ihsanakyrk/Eski-Versionlar-Ve-Siparisler/Movita_3568_AXV_Router_V3.0/MXVR CM3568 Yolların çekilmemiş hali/yollarının çekilmemiş hali/report.txt

Info: Processing symbol 'C1:Capacitor_SMD:C_0201_0603Metric'.
Info: Processing symbol 'C2:Capacitor_SMD:C_0201_0603Metric'.
Info: Processing symbol 'C3:Capacitor_SMD:C_0201_0603Metric'.
Info: Processing symbol 'C4:Capacitor_SMD:C_0201_0603Metric'.
Info: Processing symbol 'C5:SUPERCAP:CAPPRD508W154D1200H850'.
Info: Processing symbol 'C6:Capacitor_SMD:C_0201_0603Metric'.
Info: Processing symbol 'C7:Capacitor_SMD:C_0201_0603Metric'.
Info: Processing symbol 'C8:Capacitor_SMD:C_0402_1005Metric'.
Info: Processing symbol 'C9:Capacitor_SMD:C_0402_1005Metric'.
Info: Processing symbol 'C10:Capacitor_SMD:C_0201_0603Metric'.
Info: Processing symbol 'C11:Capacitor_SMD:C_0402_1005Metric'.
Info: Processing symbol 'C12:Capacitor_SMD:C_0201_0603Metric'.
Info: Processing symbol 'C13:Capacitor_SMD:C_0402_1005Metric'.
Info: Processing symbol 'C14:Capacitor_SMD:C_0402_1005Metric'.
Info: Processing symbol 'C15:Capacitor_SMD:C_0402_1005Metric'.
Info: Processing symbol 'C16:Capacitor_SMD:C_0402_1005Metric'.
Info: Processing symbol 'C17:Capacitor_SMD:C_0402_1005Metric'.
Info: Processing symbol 'C18:Capacitor_SMD:C_0402_1005Metric'.
Info: Processing symbol 'C19:Capacitor_SMD:C_0402_1005Metric'.
Info: Processing symbol 'C20:Capacitor_SMD:C_0402_1005Metric'.
Info: Processing symbol 'C21:Capacitor_SMD:C_0402_1005Metric'.
Info: Processing symbol 'C22:Capacitor_SMD:C_0402_1005Metric'.
Info: Processing symbol 'C23:Capacitor_SMD:C_0402_1005Metric'.
Info: Processing symbol 'C24:Capacitor_SMD:C_0402_1005Metric'.
Info: Processing symbol 'C25:Capacitor_SMD:C_0402_1005Metric'.
Info: Processing symbol 'C26:Capacitor_SMD:C_0402_1005Metric'.
Info: Processing symbol 'C27:Capacitor_SMD:C_0402_1005Metric'.
Info: Processing symbol 'C28:Capacitor_SMD:C_Elec_10x10.2'.
Info: Processing symbol 'C29:Capacitor_SMD:C_0603_1608Metric'.
Info: Processing symbol 'C30:Capacitor_SMD:C_0603_1608Metric'.
Info: Processing symbol 'C31:Capacitor_SMD:C_0201_0603Metric'.
Info: Processing symbol 'C32:Capacitor_SMD:C_Elec_8x10.2'.
Info: Processing symbol 'C35:Capacitor_SMD:C_0603_1608Metric'.
Info: Processing symbol 'C36:Capacitor_SMD:C_0603_1608Metric'.
Info: Processing symbol 'C37:Capacitor_SMD:C_0603_1608Metric'.
Info: Processing symbol 'C38:Capacitor_SMD:C_0603_1608Metric'.
Info: Processing symbol 'C39:Capacitor_SMD:C_0402_1005Metric'.
Info: Processing symbol 'C40:Capacitor_SMD:C_0603_1608Metric'.
Info: Processing symbol 'C41:Capacitor_SMD:C_0603_1608Metric'.
Info: Processing symbol 'C42:Capacitor_SMD:C_0603_1608Metric'.
Info: Processing symbol 'C43:Capacitor_SMD:C_0603_1608Metric'.
Info: Processing symbol 'C44:Capacitor_SMD:C_0603_1608Metric'.
Info: Processing symbol 'C45:Capacitor_SMD:C_0603_1608Metric'.
Info: Processing symbol 'C46:Capacitor_SMD:C_0603_1608Metric'.
Info: Processing symbol 'C47:Capacitor_SMD:C_0603_1608Metric'.
Info: Processing symbol 'C48:Capacitor_SMD:C_0603_1608Metric'.
Info: Processing symbol 'C49:Capacitor_SMD:C_0603_1608Metric'.
Info: Processing symbol 'C50:Capacitor_SMD:C_0603_1608Metric'.
Info: Processing symbol 'C51:Capacitor_SMD:C_0603_1608Metric'.
Info: Processing symbol 'C52:Capacitor_SMD:C_0603_1608Metric'.
Info: Processing symbol 'C53:Capacitor_SMD:C_0402_1005Metric'.
Info: Processing symbol 'C54:Capacitor_SMD:C_0603_1608Metric'.
Info: Processing symbol 'C55:Capacitor_SMD:C_0603_1608Metric'.
Info: Processing symbol 'C56:Capacitor_SMD:C_0603_1608Metric'.
Info: Processing symbol 'C57:Capacitor_SMD:C_0603_1608Metric'.
Info: Processing symbol 'C58:Capacitor_SMD:C_0603_1608Metric'.
Info: Processing symbol 'C59:Capacitor_SMD:C_0603_1608Metric'.
Info: Processing symbol 'C60:Capacitor_SMD:C_0603_1608Metric'.
Info: Processing symbol 'C61:Capacitor_SMD:C_0402_1005Metric'.
Info: Processing symbol 'C62:Capacitor_SMD:C_0402_1005Metric'.
Info: Processing symbol 'C63:Capacitor_SMD:C_0402_1005Metric'.
Info: Processing symbol 'C64:Capacitor_SMD:C_0402_1005Metric'.
Info: Processing symbol 'C65:Capacitor_SMD:C_0402_1005Metric'.
Info: Processing symbol 'C66:Capacitor_SMD:C_0402_1005Metric'.
Info: Processing symbol 'C67:Capacitor_SMD:C_0402_1005Metric'.
Info: Processing symbol 'C68:Capacitor_SMD:C_0402_1005Metric'.
Info: Processing symbol 'C69:Capacitor_SMD:C_0402_1005Metric'.
Info: Processing symbol 'C70:Capacitor_SMD:C_0402_1005Metric'.
Info: Processing symbol 'C71:Capacitor_SMD:C_0402_1005Metric'.
Info: Processing symbol 'C72:Capacitor_SMD:C_0402_1005Metric'.
Info: Processing symbol 'C73:Capacitor_SMD:C_0402_1005Metric'.
Info: Processing symbol 'C74:Capacitor_SMD:C_0603_1608Metric'.
Info: Processing symbol 'C75:Capacitor_SMD:C_0603_1608Metric'.
Info: Processing symbol 'C76:Capacitor_SMD:C_0402_1005Metric'.
Info: Processing symbol 'C77:Capacitor_SMD:C_0603_1608Metric'.
Info: Processing symbol 'C78:Capacitor_SMD:C_0402_1005Metric'.
Info: Processing symbol 'C79:Capacitor_SMD:C_0402_1005Metric'.
Info: Processing symbol 'C80:Capacitor_SMD:C_0402_1005Metric'.
Info: Processing symbol 'C81:Capacitor_SMD:C_0402_1005Metric'.
Info: Processing symbol 'C82:Capacitor_SMD:C_Elec_8x10.2'.
Info: Processing symbol 'C83:Capacitor_SMD:C_Elec_10x10.2'.
Info: Processing symbol 'C84:Capacitor_SMD:C_0603_1608Metric'.
Info: Processing symbol 'C85:Capacitor_SMD:C_0402_1005Metric'.
Info: Processing symbol 'C86:Capacitor_SMD:C_0402_1005Metric'.
Info: Processing symbol 'C87:Capacitor_SMD:C_0402_1005Metric'.
Info: Processing symbol 'C88:Capacitor_SMD:C_0402_1005Metric'.
Info: Processing symbol 'C89:Capacitor_SMD:C_0402_1005Metric'.
Info: Processing symbol 'C90:Capacitor_SMD:C_0402_1005Metric'.
Info: Processing symbol 'C91:Capacitor_SMD:C_0402_1005Metric'.
Info: Processing symbol 'C92:S102K33Y5PP63K5R:S102K33Y5PP63K5R'.
Info: Processing symbol 'Y4:Crystal:Crystal_SMD_3225-4Pin_3.2x2.5mm'.
Info: Processing symbol 'C93:S102K33Y5PP63K5R:S102K33Y5PP63K5R'.
Info: Processing symbol 'Y2:Crystal:Crystal_SMD_3225-4Pin_3.2x2.5mm'.
Info: Processing symbol 'C94:Capacitor_SMD:C_0603_1608Metric'.
Info: Processing symbol 'C95:Capacitor_SMD:C_0603_1608Metric'.
Info: Processing symbol 'C96:Capacitor_SMD:C_0603_1608Metric'.
Info: Processing symbol 'C97:Capacitor_SMD:C_0603_1608Metric'.
Info: Processing symbol 'C98:Capacitor_SMD:C_0603_1608Metric'.
Info: Processing symbol 'C99:Capacitor_SMD:C_0603_1608Metric'.
Info: Processing symbol 'C100:Capacitor_SMD:C_0603_1608Metric'.
Info: Processing symbol 'C101:Capacitor_SMD:C_0603_1608Metric'.
Info: Processing symbol 'C102:Capacitor_SMD:C_0603_1608Metric'.
Info: Processing symbol 'C103:Capacitor_SMD:C_0603_1608Metric'.
Info: Processing symbol 'C104:Capacitor_SMD:C_0603_1608Metric'.
Info: Processing symbol 'C105:Capacitor_SMD:C_0603_1608Metric'.
Info: Processing symbol 'C106:Capacitor_SMD:C_0603_1608Metric'.
Info: Processing symbol 'C107:Capacitor_SMD:C_0603_1608Metric'.
Info: Processing symbol 'C108:Capacitor_SMD:C_0603_1608Metric'.
Info: Processing symbol 'C109:Capacitor_SMD:C_0603_1608Metric'.
Info: Processing symbol 'C110:Capacitor_SMD:C_0603_1608Metric'.
Info: Processing symbol 'C111:Capacitor_SMD:C_0603_1608Metric'.
Info: Processing symbol 'C112:Capacitor_SMD:C_0402_1005Metric'.
Info: Processing symbol 'C113:Capacitor_SMD:C_0402_1005Metric'.
Info: Processing symbol 'C114:Capacitor_SMD:C_0402_1005Metric'.
Info: Processing symbol 'C115:Capacitor_SMD:C_0402_1005Metric'.
Info: Processing symbol 'C116:Capacitor_SMD:C_0603_1608Metric'.
Info: Processing symbol 'C117:Capacitor_SMD:C_0603_1608Metric'.
Info: Processing symbol 'C118:Capacitor_SMD:C_0603_1608Metric'.
Info: Processing symbol 'C119:Capacitor_SMD:C_0603_1608Metric'.
Info: Processing symbol 'C120:Capacitor_SMD:C_0603_1608Metric'.
Info: Processing symbol 'C121:Capacitor_SMD:C_0603_1608Metric'.
Info: Processing symbol 'C122:Capacitor_SMD:C_0603_1608Metric'.
Info: Processing symbol 'C123:Capacitor_SMD:C_0603_1608Metric'.
Info: Processing symbol 'C124:Capacitor_SMD:C_0603_1608Metric'.
Info: Processing symbol 'C125:Capacitor_SMD:C_0603_1608Metric'.
Info: Processing symbol 'C126:Capacitor_SMD:C_0603_1608Metric'.
Info: Processing symbol 'C127:Capacitor_SMD:C_0603_1608Metric'.
Info: Processing symbol 'C128:Capacitor_SMD:C_0402_1005Metric'.
Info: Processing symbol 'C129:Capacitor_SMD:C_0402_1005Metric'.
Info: Processing symbol 'C130:Capacitor_SMD:C_0402_1005Metric'.
Info: Processing symbol 'C131:Capacitor_SMD:C_0402_1005Metric'.
Info: Processing symbol 'C132:Capacitor_SMD:C_0402_1005Metric'.
Info: Processing symbol 'C133:Capacitor_SMD:C_0402_1005Metric'.
Info: Processing symbol 'C134:Capacitor_SMD:C_0402_1005Metric'.
Info: Processing symbol 'C135:Capacitor_SMD:C_0402_1005Metric'.
Info: Processing symbol 'C136:Capacitor_SMD:C_0402_1005Metric'.
Info: Processing symbol 'C137:Capacitor_SMD:C_0402_1005Metric'.
Info: Processing symbol 'C138:Capacitor_SMD:C_0402_1005Metric'.
Info: Processing symbol 'C139:Capacitor_SMD:C_0402_1005Metric'.
Info: Processing symbol 'C140:Capacitor_SMD:C_0402_1005Metric'.
Info: Processing symbol 'C141:Capacitor_SMD:C_0402_1005Metric'.
Info: Processing symbol 'C142:Capacitor_SMD:C_0402_1005Metric'.
Info: Processing symbol 'C143:Capacitor_SMD:C_0603_1608Metric'.
Info: Processing symbol 'C144:Capacitor_SMD:C_0603_1608Metric'.
Info: Processing symbol 'C145:Capacitor_SMD:C_01005_0402Metric'.
Info: Processing symbol 'C146:Capacitor_SMD:C_01005_0402Metric'.
Info: Processing symbol 'C147:Capacitor_SMD:C_01005_0402Metric'.
Info: Processing symbol 'C148:Capacitor_SMD:C_01005_0402Metric'.
Info: Processing symbol 'C149:Capacitor_SMD:C_01005_0402Metric'.
Info: Processing symbol 'C150:Capacitor_SMD:C_01005_0402Metric'.
Info: Processing symbol 'C151:Capacitor_SMD:C_01005_0402Metric'.
Info: Processing symbol 'C152:Capacitor_SMD:C_01005_0402Metric'.
Info: Processing symbol 'C153:Capacitor_SMD:C_01005_0402Metric'.
Info: Processing symbol 'C154:Capacitor_SMD:C_01005_0402Metric'.
Info: Processing symbol 'C155:Capacitor_SMD:C_01005_0402Metric'.
Info: Processing symbol 'C156:Capacitor_SMD:C_01005_0402Metric'.
Info: Processing symbol 'C157:Capacitor_SMD:C_01005_0402Metric'.
Info: Processing symbol 'C158:Capacitor_SMD:C_01005_0402Metric'.
Info: Processing symbol 'C159:Capacitor_SMD:C_01005_0402Metric'.
Info: Processing symbol 'C160:Capacitor_SMD:C_01005_0402Metric'.
Info: Processing symbol 'C161:Capacitor_SMD:C_01005_0402Metric'.
Info: Processing symbol 'C162:Capacitor_SMD:C_01005_0402Metric'.
Info: Processing symbol 'C163:Capacitor_SMD:C_01005_0402Metric'.
Info: Processing symbol 'C164:Capacitor_SMD:C_01005_0402Metric'.
Info: Processing symbol 'C165:Capacitor_SMD:C_01005_0402Metric'.
Info: Processing symbol 'C166:Capacitor_SMD:C_0603_1608Metric'.
Info: Processing symbol 'C169:Capacitor_SMD:C_0603_1608Metric'.
Info: Processing symbol 'C170:Capacitor_SMD:C_0603_1608Metric'.
Info: Processing symbol 'C171:Capacitor_SMD:C_0603_1608Metric'.
Info: Processing symbol 'C172:Capacitor_SMD:C_0603_1608Metric'.
Info: Processing symbol 'C174:Capacitor_SMD:C_0603_1608Metric'.
Info: Processing symbol 'C175:Capacitor_SMD:C_0603_1608Metric'.
Info: Processing symbol 'C176:Capacitor_SMD:C_0603_1608Metric'.
Info: Processing symbol 'C177:Capacitor_SMD:C_0603_1608Metric'.
Info: Processing symbol 'C178:Capacitor_SMD:C_0603_1608Metric'.
Info: Processing symbol 'C179:Capacitor_SMD:C_0603_1608Metric'.
Info: Processing symbol 'C180:Capacitor_SMD:C_0603_1608Metric'.
Info: Processing symbol 'C181:Capacitor_SMD:C_0603_1608Metric'.
Info: Processing symbol 'C182:Capacitor_SMD:C_0603_1608Metric'.
Info: Processing symbol 'C183:Capacitor_SMD:C_0603_1608Metric'.
Info: Processing symbol 'C184:Capacitor_SMD:CP_Elec_6.3x7.7'.
Info: Processing symbol 'D1:2SS100LW'.
Info: Processing symbol 'Y1:Crystal:Crystal_SMD_3225-4Pin_3.2x2.5mm'.
Info: Processing symbol 'D2:2SS100LW'.
Info: Processing symbol 'U19:Transformer_THT:RJ45_Transformer_2_Port'.
Info: Processing symbol 'D3:SS14:DIOM4325X250N'.
Info: Processing symbol 'D4:2SS100L-W:2SS100LW'.
Info: Processing symbol 'D5:2SS100LW'.
Info: Processing symbol 'U18:'.
Info: Processing symbol 'D6:ESD5341N:ESD5341N'.
Info: Processing symbol 'D7:2SS100LW'.
Info: Processing symbol 'U17:'.
Info: Processing symbol 'D8:2SS100LW'.
Info: Processing symbol 'U16:'.
Info: Processing symbol 'D9:2SS100LW'.
Info: Processing symbol 'U15:Package_TO_SOT_SMD:TO-263-5_TabPin3'.
Info: Processing symbol 'D10:DIOM5336X244N'.
Info: Processing symbol 'U13:Transformer_THT:RJ45_Transformer_2_Port'.
Info: Processing symbol 'D11:DIOM5336X244N'.
Info: Processing symbol 'U12:Transformer_THT:RJ45_Transformer_2_Port'.
Info: Processing symbol 'D12:ESD5341N:ESD5341N'.
Info: Processing symbol 'D13:ESD5341N:ESD5341N'.
Info: Processing symbol 'D14:Diode_SMD:D_SOD-123'.
Info: Processing symbol 'D15:Diode_SMD:D_SOD-123'.
Info: Processing symbol 'D16:Diode_SMD:D_SOD-123'.
Info: Processing symbol 'D17:Diode_SMD:D_SOD-123'.
Info: Processing symbol 'D18:Diode_SMD:D_SMA'.
Info: Processing symbol 'D19:Diode_SMD:D_SMA'.
Info: Processing symbol 'D20:Diode_SMD:D_SMA'.
Info: Processing symbol 'D21:Diode_SMD:D_SMA'.
Info: Processing symbol 'D22:ESD5451N:ESD5451N'.
Info: Processing symbol 'D23:DIOM5336X244N'.
Info: Processing symbol 'U11:SensorModules:module_mpu6050'.
Info: Processing symbol 'D24:DIOM5336X244N'.
Info: Processing symbol 'U10:Package_TO_SOT_SMD:TO-263-5_TabPin3'.
Info: Processing symbol 'D25:LED_SMD:LED_0603_1608Metric'.
Info: Processing symbol 'D26:Diode_SMD:D_0603_1608Metric'.
Info: Processing symbol 'D27:Diode_SMD:D_0603_1608Metric'.
Info: Processing symbol 'FB1:HI1206N101R-10:BEADC3216X130N'.
Info: Processing symbol 'FL1:DLW31SN900SQ2L:DLW31SH222SQ2L'.
Info: Processing symbol 'FL3:BLM18PG121SN1D:BLM18AG102BH1D'.
Info: Processing symbol 'FL4:BLM18PG121SN1D:BLM18AG102BH1D'.
Info: Processing symbol 'IC1:SN74LVC125APWR:SN74LVC125APWR'.
Info: Processing symbol 'IC2:Package_DFN_QFN:QFN-48-1EP_7x7mm_P0.5mm_EP5.6x5.6mm'.
Info: Processing symbol 'IC3:QFN50P900X900X90-65N-D'.
Info: Processing symbol 'U9:'.
Info: Processing symbol 'IC5:SOT95P285X100-6N'.
Info: Processing symbol 'U8:NL27WZU04DTT1G:SOP95P275X110-6N'.
Info: Processing symbol 'J1:Connector_PinSocket_2.54mm:PinSocket_2x07_P2.54mm_Vertical_etrafitemiz'.
Info: Processing symbol 'U7:Package_SO:SOIC-8_5.23x5.23mm_P1.27mm'.
Info: Processing symbol 'J2:AV_CONNECTOR:AV_CON'.
Info: Processing symbol 'J3:Connector_PinHeader_2.54mm:PinHeader_2x04_P2.54mm_Vertical_SMD'.
Info: Processing symbol 'J4:Connector_PinSocket_2.00mm:PinSocket_1x05_P2.00mm_Vertical'.
Info: Processing symbol 'J5:Connector_RJ:RJ45_Amphenol_54602-x08_Horizontal_etrafitemiz'.
Info: Processing symbol 'U6B1:Nextchip_N4:N4'.
Info: Processing symbol 'J6:Connector_PinHeader_1.27mm:PinHeader_2x20_P1.27mm_Vertical'.
Info: Processing symbol 'J7:Connector_PinHeader_2.54mm:PinHeader_1x02_P2.54mm_Vertical'.
Info: Processing symbol 'J8:TE_1-2199119-5'.
Info: Processing symbol 'U6A1:'.
Info: Processing symbol 'J9:'.
Info: Processing symbol 'U6:MAX485ESA_T:SOIC127P600X175-8N'.
Info: Processing symbol 'J10:'.
Info: Processing symbol 'U5:RP2040_minimal:RP2040-QFN-56'.
Info: Processing symbol 'J11:'.
Info: Processing symbol 'U4:Oscillator:Oscillator_SMD_EuroQuartz_XO32-4Pin_3.2x2.5mm'.
Info: Processing symbol 'J13:Connector_PinHeader_2.54mm:PinHeader_2x04_P2.54mm_Vertical_SMD'.
Info: Processing symbol 'J15:LED_4:LED_4_Block'.
Info: Processing symbol 'J16:LED_4:LED_4_Block'.
Info: Processing symbol 'J17:Connector_USB:USB_Micro-B_Wuerth_629105150521'.
Info: Processing symbol 'J18:AV_CONNECTOR:AV_CON'.
Info: Processing symbol 'J19:AV_CONNECTOR:AV_CON'.
Info: Processing symbol 'J20:AV_CONNECTOR:AV_CON'.
Info: Processing symbol 'J21:Connector_PinHeader_2.54mm:PinHeader_2x04_P2.54mm_Vertical_SMD'.
Info: Processing symbol 'J22:Connector_PinHeader_2.54mm:PinHeader_2x04_P2.54mm_Vertical_SMD'.
Info: Processing symbol 'J23:KF2EDGH:KF2EDGH-3.81'.
Info: Processing symbol 'J24:'.
Info: Processing symbol 'U3:Package_TO_SOT_SMD:SOT-23'.
Info: Processing symbol 'J25:Connector_PinHeader_2.54mm:PinHeader_2x02_P2.54mm_Vertical'.
Info: Processing symbol 'J26:AV_CONNECTOR:AV_CON'.
Info: Processing symbol 'J27:Connector_PinHeader_1.00mm:PinHeader_1x07_P1.00mm_Vertical'.
Info: Processing symbol 'K1:HF46F_5-HS1:HF46F5HS1'.
Info: Processing symbol 'K3:HF46F_5-HS1:HF46F5HS1'.
Info: Processing symbol 'L2:Inductor_SMD:L_Bourns_SRR1208_12.7x12.7mm'.
Info: Processing symbol 'L3:Inductor_SMD:L_Bourns_SRR1208_12.7x12.7mm'.
Info: Processing symbol 'L4:Inductor_SMD:L_0603_1608Metric'.
Info: Processing symbol 'L5:Inductor_SMD:L_0603_1608Metric'.
Info: Processing symbol 'L6:Inductor_SMD:L_0603_1608Metric'.
Info: Processing symbol 'L7:Inductor_SMD:L_0603_1608Metric'.
Info: Processing symbol 'L8:Inductor_SMD:L_Bourns_SRR1208_12.7x12.7mm'.
Info: Processing symbol 'L9:Inductor_SMD:L_0603_1608Metric'.
Info: Processing symbol 'PS2:RT9013-33gb:SOT94P279X130-5N'.
Info: Processing symbol 'PS3:TLV75712PDBVR:SOT95P280X145-5N'.
Info: Processing symbol 'Q1:Package_TO_SOT_THT:TO-92_Inline'.
Info: Processing symbol 'Q2:Package_TO_SOT_THT:TO-18-3'.
Info: Processing symbol 'Q3:Package_TO_SOT_THT:TO-18-3'.
Info: Processing symbol 'Q4:Package_TO_SOT_THT:TO-18-3'.
Info: Processing symbol 'Q5:Package_TO_SOT_THT:TO-18-3'.
Info: Processing symbol 'R1:Resistor_SMD:R_0603_1608Metric'.
Info: Processing symbol 'R2:Resistor_SMD:R_0603_1608Metric'.
Info: Processing symbol 'R3:Resistor_SMD:R_0603_1608Metric'.
Info: Processing symbol 'R4:Resistor_SMD:R_0603_1608Metric'.
Info: Processing symbol 'R5:Resistor_SMD:R_0603_1608Metric'.
Info: Processing symbol 'R6:Resistor_SMD:R_0603_1608Metric'.
Info: Processing symbol 'R7:Resistor_SMD:R_0603_1608Metric'.
Info: Processing symbol 'R8:Resistor_SMD:R_0603_1608Metric'.
Info: Processing symbol 'R9:Resistor_SMD:R_0603_1608Metric'.
Info: Processing symbol 'R10:Resistor_SMD:R_0603_1608Metric'.
Info: Processing symbol 'R11:Resistor_SMD:R_0603_1608Metric'.
Info: Processing symbol 'R12:Resistor_SMD:R_0603_1608Metric'.
Info: Processing symbol 'R13:Resistor_SMD:R_0603_1608Metric'.
Info: Processing symbol 'R14:Resistor_SMD:R_0603_1608Metric'.
Info: Processing symbol 'R15:Resistor_SMD:R_0603_1608Metric'.
Info: Processing symbol 'R16:Resistor_SMD:R_0603_1608Metric'.
Info: Processing symbol 'R17:Resistor_SMD:R_0603_1608Metric'.
Info: Processing symbol 'R18:Resistor_SMD:R_0603_1608Metric'.
Info: Processing symbol 'R19:Resistor_SMD:R_0603_1608Metric'.
Info: Processing symbol 'R20:Resistor_SMD:R_0603_1608Metric'.
Info: Processing symbol 'R21:Resistor_SMD:R_0603_1608Metric'.
Info: Processing symbol 'R22:Resistor_SMD:R_0603_1608Metric'.
Info: Processing symbol 'R23:Resistor_SMD:R_0603_1608Metric'.
Info: Processing symbol 'R24:Resistor_SMD:R_0603_1608Metric'.
Info: Processing symbol 'R25:Resistor_SMD:R_0603_1608Metric'.
Info: Processing symbol 'R27:Resistor_SMD:R_0603_1608Metric'.
Info: Processing symbol 'R28:Resistor_SMD:R_0603_1608Metric'.
Info: Processing symbol 'R30:Resistor_SMD:R_0402_1005Metric'.
Info: Processing symbol 'R31:Resistor_SMD:R_0402_1005Metric'.
Info: Processing symbol 'R32:Resistor_SMD:R_0402_1005Metric'.
Info: Processing symbol 'R33:Resistor_SMD:R_0402_1005Metric'.
Info: Processing symbol 'R34:Resistor_SMD:R_0402_1005Metric'.
Info: Processing symbol 'R35:Resistor_SMD:R_2512_6332Metric'.
Info: Processing symbol 'R36:Resistor_SMD:R_2512_6332Metric'.
Info: Processing symbol 'R37:Resistor_SMD:R_0603_1608Metric'.
Info: Processing symbol 'R38:Resistor_SMD:R_0603_1608Metric'.
Info: Processing symbol 'R39:Resistor_SMD:R_0603_1608Metric'.
Info: Processing symbol 'R40:Resistor_SMD:R_0603_1608Metric'.
Info: Processing symbol 'R41:Resistor_SMD:R_0603_1608Metric'.
Info: Processing symbol 'R42:Resistor_SMD:R_0603_1608Metric'.
Info: Processing symbol 'R43:Resistor_SMD:R_2512_6332Metric'.
Info: Processing symbol 'R44:Resistor_SMD:R_2512_6332Metric'.
Info: Processing symbol 'R45:Resistor_SMD:R_2512_6332Metric'.
Info: Processing symbol 'R46:Resistor_SMD:R_0603_1608Metric'.
Info: Processing symbol 'R47:Resistor_SMD:R_0603_1608Metric'.
Info: Processing symbol 'R48:Resistor_SMD:R_0603_1608Metric'.
Info: Processing symbol 'R49:Resistor_SMD:R_0603_1608Metric'.
Info: Processing symbol 'R50:Resistor_SMD:R_0603_1608Metric'.
Info: Processing symbol 'R51:Resistor_SMD:R_1206_3216Metric'.
Info: Processing symbol 'R52:Resistor_SMD:R_1206_3216Metric'.
Info: Processing symbol 'R53:Resistor_SMD:R_0603_1608Metric'.
Info: Processing symbol 'R54:Resistor_SMD:R_0603_1608Metric'.
Info: Processing symbol 'R55:Resistor_SMD:R_0603_1608Metric'.
Info: Processing symbol 'R56:Resistor_SMD:R_1206_3216Metric'.
Info: Processing symbol 'R57:Resistor_SMD:R_1206_3216Metric'.
Info: Processing symbol 'R58:Resistor_SMD:R_0603_1608Metric'.
Info: Processing symbol 'R59:Resistor_SMD:R_0603_1608Metric'.
Info: Processing symbol 'R60:Resistor_SMD:R_0603_1608Metric'.
Info: Processing symbol 'R61:Resistor_SMD:R_0603_1608Metric'.
Info: Processing symbol 'R62:Resistor_SMD:R_0603_1608Metric'.
Info: Processing symbol 'R63:Resistor_SMD:R_0603_1608Metric'.
Info: Processing symbol 'R64:Resistor_SMD:R_0603_1608Metric'.
Info: Processing symbol 'R65:Resistor_SMD:R_0603_1608Metric'.
Info: Processing symbol 'R66:Resistor_SMD:R_0603_1608Metric'.
Info: Processing symbol 'R67:Resistor_SMD:R_0603_1608Metric'.
Info: Processing symbol 'R68:Resistor_SMD:R_0603_1608Metric'.
Info: Processing symbol 'R69:Resistor_SMD:R_0603_1608Metric'.
Info: Processing symbol 'R70:Resistor_SMD:R_0603_1608Metric'.
Info: Processing symbol 'R71:Resistor_SMD:R_0603_1608Metric'.
Info: Processing symbol 'R72:Resistor_SMD:R_0603_1608Metric'.
Info: Processing symbol 'R73:Resistor_SMD:R_0603_1608Metric'.
Info: Processing symbol 'R74:Resistor_SMD:R_0603_1608Metric'.
Info: Processing symbol 'R75:Resistor_SMD:R_0603_1608Metric'.
Info: Processing symbol 'R76:Resistor_SMD:R_0603_1608Metric'.
Info: Processing symbol 'R77:Resistor_SMD:R_0603_1608Metric'.
Info: Processing symbol 'R78:Resistor_SMD:R_0603_1608Metric'.
Info: Processing symbol 'R79:Resistor_SMD:R_0603_1608Metric'.
Info: Processing symbol 'R80:Resistor_SMD:R_0603_1608Metric'.
Info: Processing symbol 'R81:Resistor_SMD:R_0603_1608Metric'.
Info: Processing symbol 'R82:Resistor_SMD:R_0603_1608Metric'.
Info: Processing symbol 'R83:Resistor_SMD:R_0603_1608Metric'.
Info: Processing symbol 'R84:Resistor_SMD:R_0603_1608Metric'.
Info: Processing symbol 'R85:Resistor_SMD:R_0603_1608Metric'.
Info: Processing symbol 'R86:Resistor_SMD:R_0603_1608Metric'.
Info: Processing symbol 'R87:Resistor_SMD:R_0603_1608Metric'.
Info: Processing symbol 'R88:Resistor_SMD:R_0603_1608Metric'.
Info: Processing symbol 'R89:Resistor_SMD:R_0603_1608Metric'.
Info: Processing symbol 'R90:Resistor_SMD:R_0603_1608Metric'.
Info: Processing symbol 'R91:Resistor_SMD:R_0603_1608Metric'.
Info: Processing symbol 'R92:Resistor_SMD:R_0603_1608Metric'.
Info: Processing symbol 'R93:Resistor_SMD:R_0603_1608Metric'.
Info: Processing symbol 'R94:Resistor_SMD:R_0603_1608Metric'.
Info: Processing symbol 'R95:Resistor_SMD:R_0603_1608Metric'.
Info: Processing symbol 'R96:Resistor_SMD:R_0603_1608Metric'.
Info: Processing symbol 'R97:Resistor_SMD:R_0603_1608Metric'.
Info: Processing symbol 'R98:Resistor_SMD:R_0603_1608Metric'.
Info: Processing symbol 'R99:Resistor_SMD:R_0603_1608Metric'.
Info: Processing symbol 'R100:Resistor_SMD:R_0603_1608Metric'.
Info: Processing symbol 'R101:Resistor_SMD:R_0603_1608Metric'.
Info: Processing symbol 'R102:Resistor_SMD:R_0603_1608Metric'.
Info: Processing symbol 'R103:Resistor_SMD:R_0603_1608Metric'.
Info: Processing symbol 'R104:Resistor_SMD:R_0603_1608Metric'.
Info: Processing symbol 'R105:Resistor_SMD:R_0603_1608Metric'.
Info: Processing symbol 'R106:Resistor_SMD:R_0603_1608Metric'.
Info: Processing symbol 'R107:Resistor_SMD:R_0603_1608Metric'.
Info: Processing symbol 'R108:Resistor_SMD:R_0603_1608Metric'.
Info: Processing symbol 'R109:Resistor_SMD:R_0603_1608Metric'.
Info: Processing symbol 'R110:Resistor_SMD:R_1206_3216Metric'.
Info: Processing symbol 'R111:Resistor_SMD:R_1206_3216Metric'.
Info: Processing symbol 'R112:Resistor_SMD:R_0603_1608Metric'.
Info: Processing symbol 'R113:Resistor_SMD:R_0603_1608Metric'.
Info: Processing symbol 'R114:Resistor_SMD:R_1206_3216Metric'.
Info: Processing symbol 'R115:Resistor_SMD:R_1206_3216Metric'.
Info: Processing symbol 'R116:Resistor_SMD:R_0603_1608Metric'.
Info: Processing symbol 'R117:Resistor_SMD:R_0402_1005Metric'.
Info: Processing symbol 'R118:Resistor_SMD:R_0402_1005Metric'.
Info: Processing symbol 'R119:Resistor_SMD:R_2512_6332Metric'.
Info: Processing symbol 'R120:Resistor_SMD:R_0402_1005Metric'.
Info: Processing symbol 'R121:Resistor_SMD:R_0402_1005Metric'.
Info: Processing symbol 'R122:Resistor_SMD:R_2512_6332Metric'.
Info: Processing symbol 'R123:Resistor_SMD:R_0603_1608Metric'.
Info: Processing symbol 'R124:Resistor_SMD:R_2512_6332Metric'.
Info: Processing symbol 'R125:Resistor_SMD:R_2512_6332Metric'.
Info: Processing symbol 'R126:Resistor_SMD:R_0603_1608Metric'.
Info: Processing symbol 'R127:Resistor_SMD:R_0603_1608Metric'.
Info: Processing symbol 'R128:Resistor_SMD:R_1206_3216Metric'.
Info: Processing symbol 'R129:Resistor_SMD:R_0402_1005Metric'.
Info: Processing symbol 'R130:Resistor_SMD:R_0402_1005Metric'.
Info: Processing symbol 'R131:Resistor_SMD:R_0402_1005Metric'.
Info: Processing symbol 'R132:Resistor_SMD:R_0402_1005Metric'.
Info: Processing symbol 'R133:Resistor_SMD:R_0402_1005Metric'.
Info: Processing symbol 'R134:Resistor_SMD:R_0402_1005Metric'.
Info: Processing symbol 'R135:Resistor_SMD:R_0402_1005Metric'.
Info: Processing symbol 'R136:Resistor_SMD:R_0402_1005Metric'.
Info: Processing symbol 'R137:Resistor_SMD:R_0402_1005Metric'.
Info: Processing symbol 'R138:Resistor_SMD:R_0402_1005Metric'.
Info: Processing symbol 'R139:Resistor_SMD:R_0402_1005Metric'.
Info: Processing symbol 'R140:Resistor_SMD:R_0603_1608Metric'.
Info: Processing symbol 'R141:Resistor_SMD:R_0603_1608Metric'.
Info: Processing symbol 'R142:Resistor_SMD:R_01005_0402Metric'.
Info: Processing symbol 'R143:Resistor_SMD:R_0402_1005Metric'.
Info: Processing symbol 'R144:Resistor_SMD:R_0603_1608Metric'.
Info: Processing symbol 'R145:Resistor_SMD:R_0603_1608Metric'.
Info: Processing symbol 'R146:Resistor_SMD:R_0603_1608Metric'.
Info: Processing symbol 'R147:Resistor_SMD:R_0603_1608Metric'.
Info: Processing symbol 'R148:Resistor_SMD:R_0603_1608Metric'.
Info: Processing symbol 'R149:Resistor_SMD:R_0603_1608Metric'.
Info: Processing symbol 'R150:Resistor_SMD:R_0603_1608Metric'.
Info: Processing symbol 'R151:Resistor_SMD:R_0603_1608Metric'.
Info: Processing symbol 'R152:Resistor_SMD:R_0603_1608Metric'.
Info: Processing symbol 'R153:Resistor_SMD:R_0603_1608Metric'.
Info: Processing symbol 'R154:Resistor_SMD:R_0603_1608Metric'.
Info: Processing symbol 'R155:Resistor_SMD:R_0603_1608Metric'.
Info: Processing symbol 'R156:Resistor_SMD:R_0603_1608Metric'.
Info: Processing symbol 'R157:Resistor_SMD:R_0603_1608Metric'.
Info: Processing symbol 'R158:Resistor_SMD:R_0603_1608Metric'.
Info: Processing symbol 'R159:Resistor_SMD:R_0603_1608Metric'.
Info: Processing symbol 'R160:Resistor_SMD:R_0603_1608Metric'.
Info: Processing symbol 'R161:Resistor_SMD:R_0603_1608Metric'.
Info: Processing symbol 'R162:Resistor_SMD:R_0603_1608Metric'.
Info: Processing symbol 'R163:Resistor_SMD:R_0603_1608Metric'.
Info: Processing symbol 'R164:Resistor_SMD:R_0603_1608Metric'.
Info: Processing symbol 'R165:Resistor_SMD:R_0603_1608Metric'.
Info: Processing symbol 'R166:Resistor_SMD:R_0603_1608Metric'.
Info: Processing symbol 'R168:Resistor_SMD:R_0603_1608Metric'.
Info: Processing symbol 'R169:Resistor_SMD:R_0603_1608Metric'.
Info: Processing symbol 'R170:Resistor_SMD:R_0603_1608Metric'.
Info: Processing symbol 'R171:Resistor_SMD:R_0603_1608Metric'.
Info: Processing symbol 'R172:Resistor_SMD:R_0603_1608Metric'.
Info: Processing symbol 'R173:Resistor_SMD:R_0603_1608Metric'.
Info: Processing symbol 'S1:SW_TL1015AF160QG'.
Info: Processing symbol 'U2:Package_TO_SOT_SMD:SOT-23'.
Info: Processing symbol 'U1:'.
Change D1 footprint from '2SS100L-W:2SS100LW' to '2SS100LW'.
Update U19 fields.
Change D2 footprint from '2SS100L-W:2SS100LW' to '2SS100LW'.
Change D5 footprint from '2SS100L-W:2SS100LW' to '2SS100LW'.
Change D7 footprint from '2SS100L-W:2SS100LW' to '2SS100LW'.
Change D8 footprint from '2SS100L-W:2SS100LW' to '2SS100LW'.
Change D9 footprint from '2SS100L-W:2SS100LW' to '2SS100LW'.
Update U13 fields.
Change D10 footprint from 'SS54B:DIOM5336X244N' to 'DIOM5336X244N'.
Update U12 fields.
Change D11 footprint from 'SS54B:DIOM5336X244N' to 'DIOM5336X244N'.
Change D23 footprint from 'SS54B:DIOM5336X244N' to 'DIOM5336X244N'.
Change D24 footprint from 'SS54B:DIOM5336X244N' to 'DIOM5336X244N'.
Warning: No net found for component A6 pad U6B1 (no pin A6 in symbol).
Warning: No net found for component A7 pad U6B1 (no pin A7 in symbol).
Warning: No net found for component A8 pad U6B1 (no pin A8 in symbol).
Warning: No net found for component A9 pad U6B1 (no pin A9 in symbol).
Warning: No net found for component A10 pad U6B1 (no pin A10 in symbol).
Warning: No net found for component B1 pad U6B1 (no pin B1 in symbol).
Warning: No net found for component B2 pad U6B1 (no pin B2 in symbol).
Warning: No net found for component B3 pad U6B1 (no pin B3 in symbol).
Warning: No net found for component B4 pad U6B1 (no pin B4 in symbol).
Warning: No net found for component B5 pad U6B1 (no pin B5 in symbol).
Warning: No net found for component B6 pad U6B1 (no pin B6 in symbol).
Warning: No net found for component B7 pad U6B1 (no pin B7 in symbol).
Warning: No net found for component B8 pad U6B1 (no pin B8 in symbol).
Warning: No net found for component B9 pad U6B1 (no pin B9 in symbol).
Warning: No net found for component B10 pad U6B1 (no pin B10 in symbol).
Warning: No net found for component B11 pad U6B1 (no pin B11 in symbol).
Warning: No net found for component C6 pad U6B1 (no pin C6 in symbol).
Warning: No net found for component C7 pad U6B1 (no pin C7 in symbol).
Warning: No net found for component C8 pad U6B1 (no pin C8 in symbol).
Warning: No net found for component C9 pad U6B1 (no pin C9 in symbol).
Warning: No net found for component C10 pad U6B1 (no pin C10 in symbol).
Warning: No net found for component C11 pad U6B1 (no pin C11 in symbol).
Warning: No net found for component D4 pad U6B1 (no pin D4 in symbol).
Warning: No net found for component D9 pad U6B1 (no pin D9 in symbol).
Warning: No net found for component D10 pad U6B1 (no pin D10 in symbol).
Warning: No net found for component 4 pad Y4 (no pin 4 in symbol).
Warning: No net found for component E4 pad U6B1 (no pin E4 in symbol).
Warning: No net found for component E9 pad U6B1 (no pin E9 in symbol).
Warning: No net found for component E10 pad U6B1 (no pin E10 in symbol).
Warning: No net found for component E11 pad U6B1 (no pin E11 in symbol).
Warning: No net found for component F9 pad U6B1 (no pin F9 in symbol).
Warning: No net found for component F10 pad U6B1 (no pin F10 in symbol).
Warning: No net found for component F11 pad U6B1 (no pin F11 in symbol).
Warning: No net found for component G8 pad U6B1 (no pin G8 in symbol).
Warning: No net found for component G9 pad U6B1 (no pin G9 in symbol).
Warning: No net found for component G10 pad U6B1 (no pin G10 in symbol).
Warning: No net found for component G11 pad U6B1 (no pin G11 in symbol).
Warning: No net found for component H9 pad U6B1 (no pin H9 in symbol).
Warning: No net found for component H10 pad U6B1 (no pin H10 in symbol).
Warning: No net found for component H11 pad U6B1 (no pin H11 in symbol).
Warning: No net found for component K10 pad U6B1 (no pin K10 in symbol).
Warning: No net found for component D11 pad U6B1 (no pin D11 in symbol).
Warning: No net found for component A2 pad U6B1 (no pin A2 in symbol).
Warning: No net found for component A3 pad U6B1 (no pin A3 in symbol).
Warning: No net found for component A4 pad U6B1 (no pin A4 in symbol).
Warning: No net found for component A5 pad U6B1 (no pin A5 in symbol).
Error: Cannot add U9 (no footprint assigned).
Error: Cannot add IC3 (footprint 'QFN50P900X900X90-65N-D' not found).
Error: Cannot add IC5 (footprint 'SOT95P285X100-6N' not found).
Error: Cannot add J5 (footprint 'Connector_RJ:RJ45_Amphenol_54602-x08_Horizontal_etrafitemiz' not found).
Error: Cannot add U6A1 (no footprint assigned).
Error: Cannot add J8 (footprint 'TE_1-2199119-5' not found).
Error: Cannot add J9 (no footprint assigned).
Error: Cannot add U16 (no footprint assigned).
Error: Cannot add J10 (no footprint assigned).
Error: Cannot add U17 (no footprint assigned).
Error: Cannot add J11 (no footprint assigned).
Error: Cannot add U18 (no footprint assigned).
Error: Cannot add J24 (no footprint assigned).
Error: Cannot add S1 (footprint 'SW_TL1015AF160QG' not found).
Error: Cannot add J1 (footprint 'Connector_PinSocket_2.54mm:PinSocket_2x07_P2.54mm_Vertical_etrafitemiz' not found).
Error: Cannot add C93 (footprint 'S102K33Y5PP63K5R:S102K33Y5PP63K5R' not found).
Error: Cannot add C92 (footprint 'S102K33Y5PP63K5R:S102K33Y5PP63K5R' not found).
Error: Cannot add U1 (no footprint assigned).

Info: Total warnings: 46, errors: 18.
