ihsanakyrk/Eski-Versionlar-Ve-Siparisler/[04.2025]/KSS_MD_V1.0(Nisan_2025)/KSS_MD_V1.0/3D.jpg

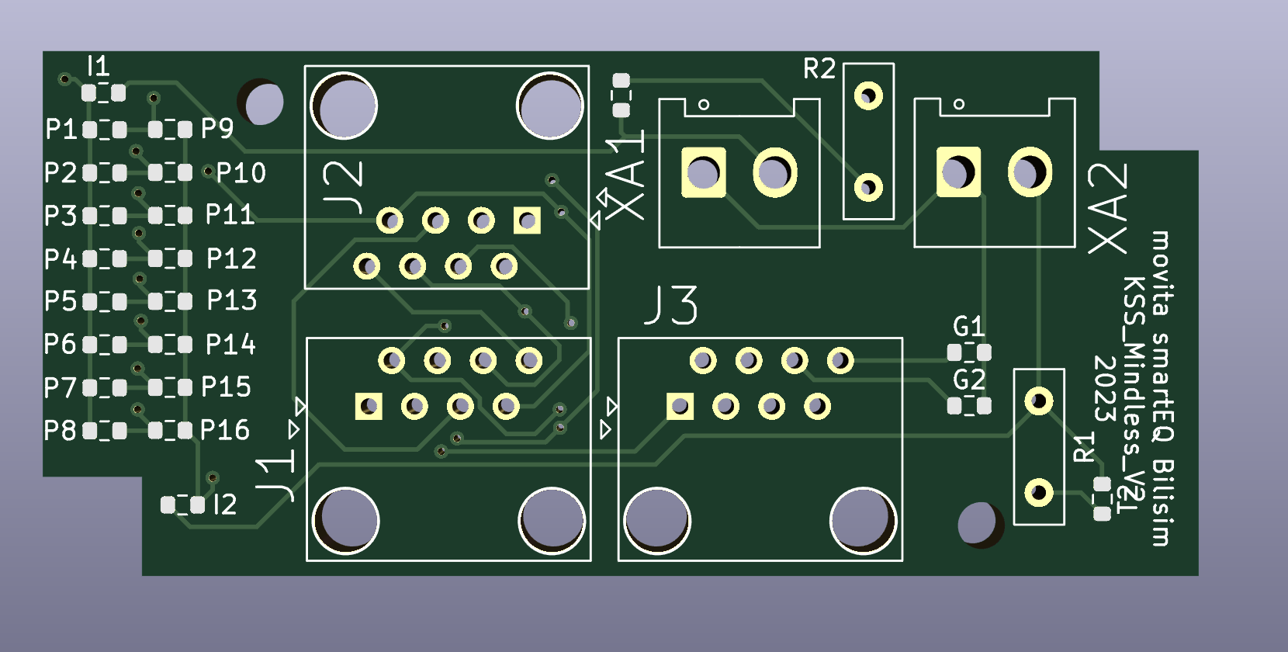
[04.2025]/KSS_MD_V1.0(Nisan_2025)/KSS_MD_V1.0/3D.jpg
