ihsanakyrk/Eski-Versionlar-Ve-Siparisler/Cam Tracker_3566/3566 PCB arka yüz.png

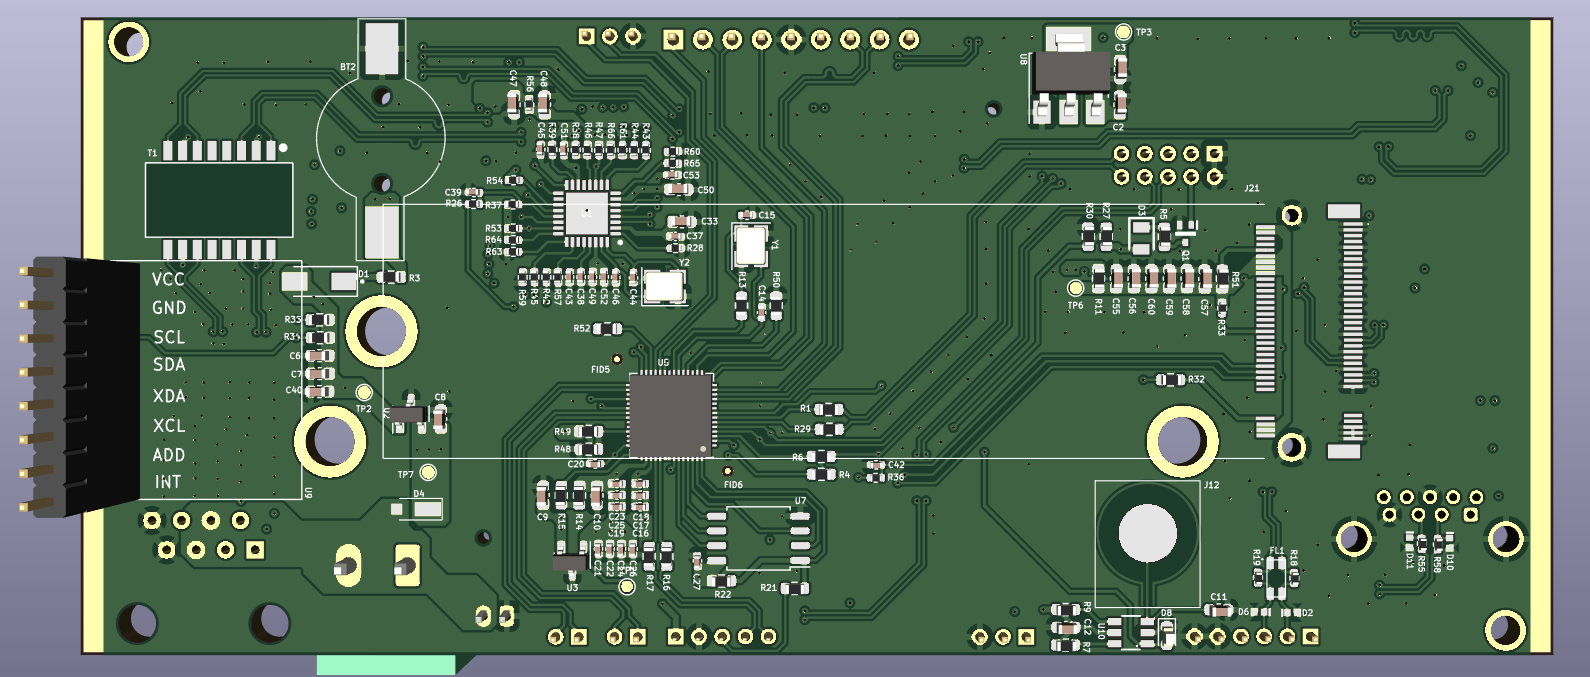
Cam Tracker_3566/3566 PCB arka yüz.png
