ihsanakyrk/Eski-Versionlar-Ve-Siparisler/KSS_Led_Panel_V1.0(Yeni nesil)/Screenshot 2024-08-16 at 16.59.08.png

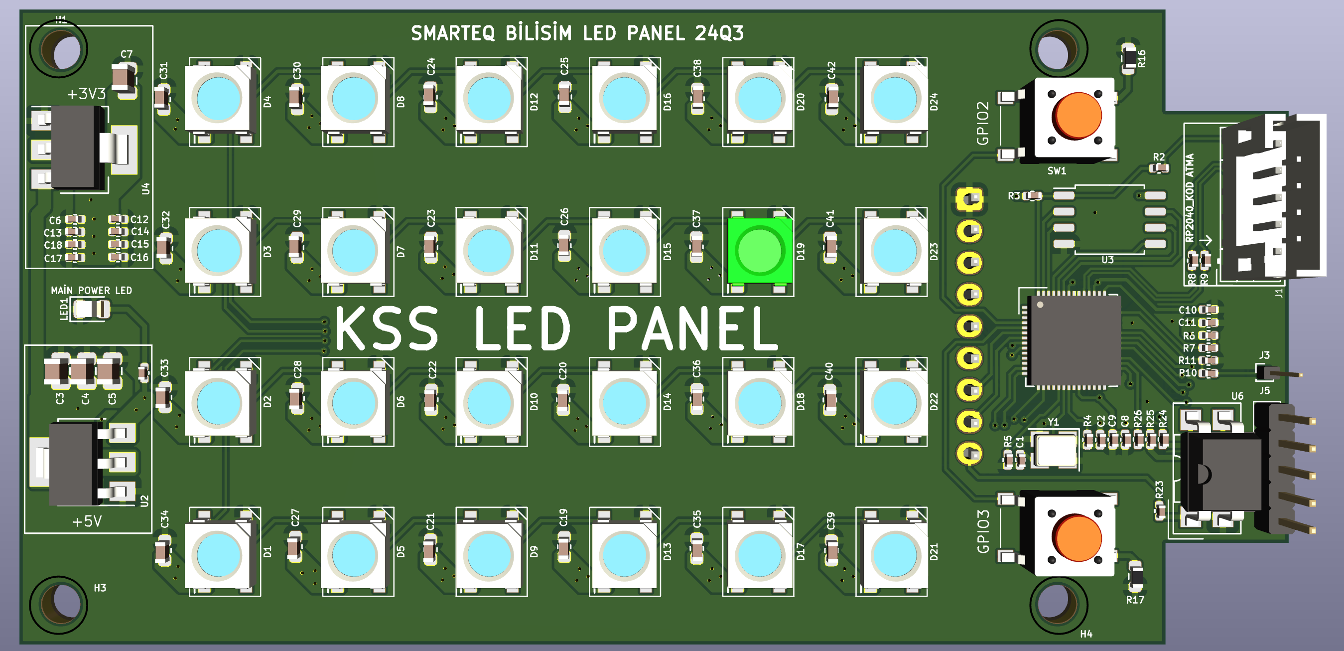
KSS_Led_Panel_V1.0(Yeni nesil)/Screenshot 2024-08-16 at 16.59.08.png
