ihsanakyrk/Eski-Versionlar-Ve-Siparisler/Movita_3566_AXV_Router_V3.1/Movita_3566_AXV_Router_V3.1(Normal_Analoglu)/MXVR_3566_V3.1 değiştirilenler .rtfd/Screen Shot 2024-08-07 at 14.11.45.png

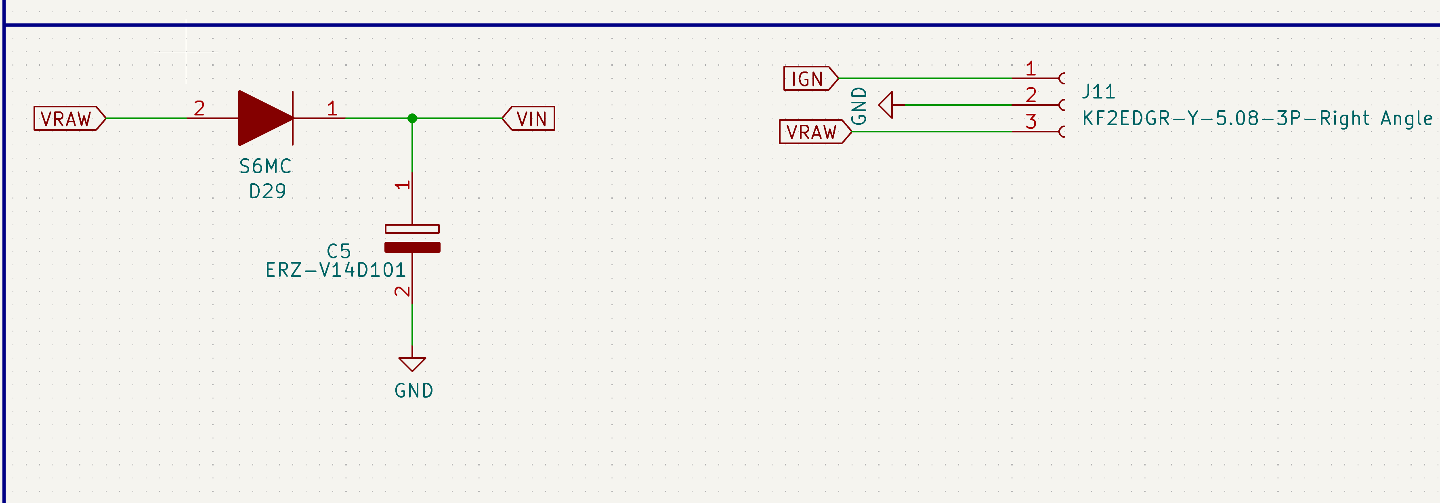
Movita_3566_AXV_Router_V3.1/Movita_3566_AXV_Router_V3.1(Normal_Analoglu)/MXVR_3566_V3.1 değiştirilenler .rtfd/Screen Shot 2024-08-07 at 14.11.45.png
