ihsanakyrk/Eski-Versionlar-Ve-Siparisler/Movita_3566_AXV_Router_V3.1/Movita_3566_AXV_Router_V3.1(Normal_Analoglu)/MXVR_3566_V3.1 değiştirilenler .rtfd/Screen Shot 2024-08-12 at 10.18.26.png

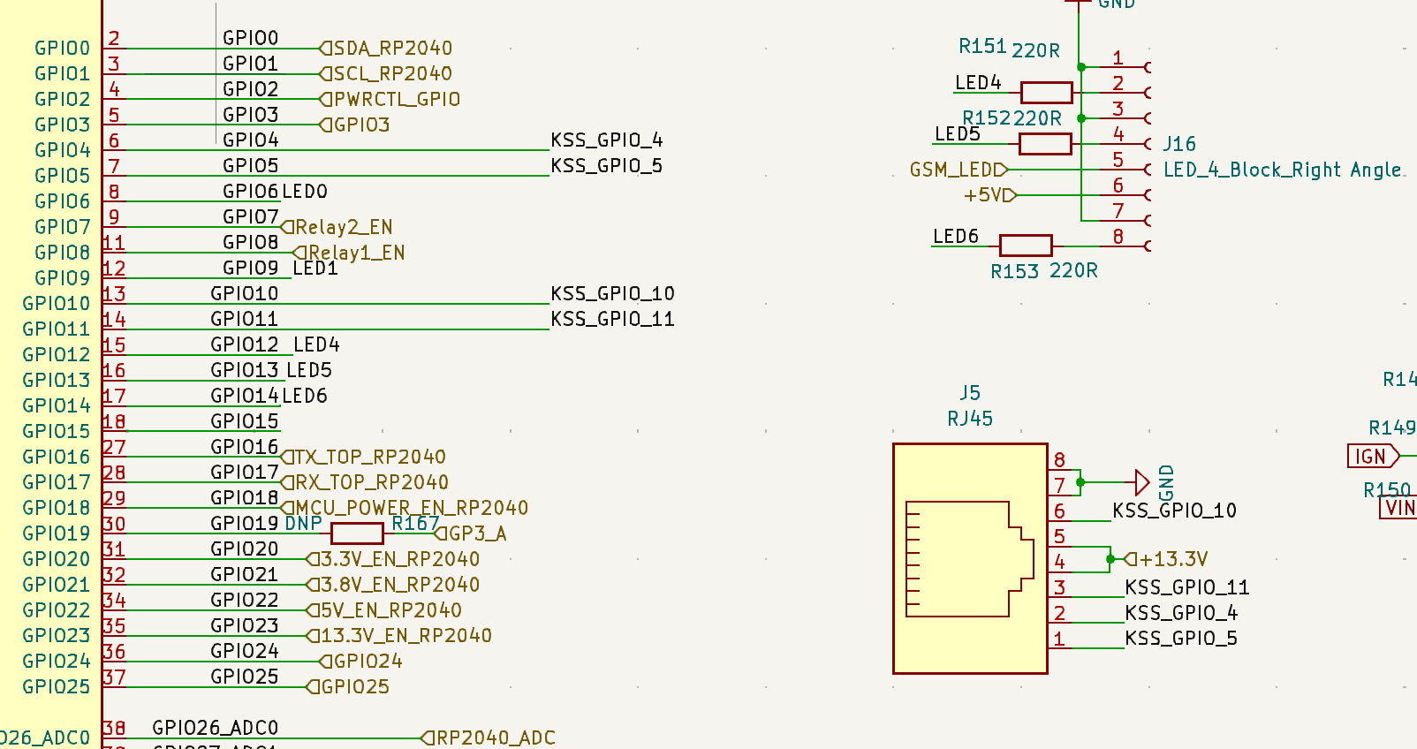
Movita_3566_AXV_Router_V3.1/Movita_3566_AXV_Router_V3.1(Normal_Analoglu)/MXVR_3566_V3.1 değiştirilenler .rtfd/Screen Shot 2024-08-12 at 10.18.26.png
