ihsanakyrk/Eski-Versionlar-Ve-Siparisler/Movita_3568_AXV_Router_V3.0/MXVR CM3568 Yolların çekilmemiş hali/IPEX Dimension.jpg

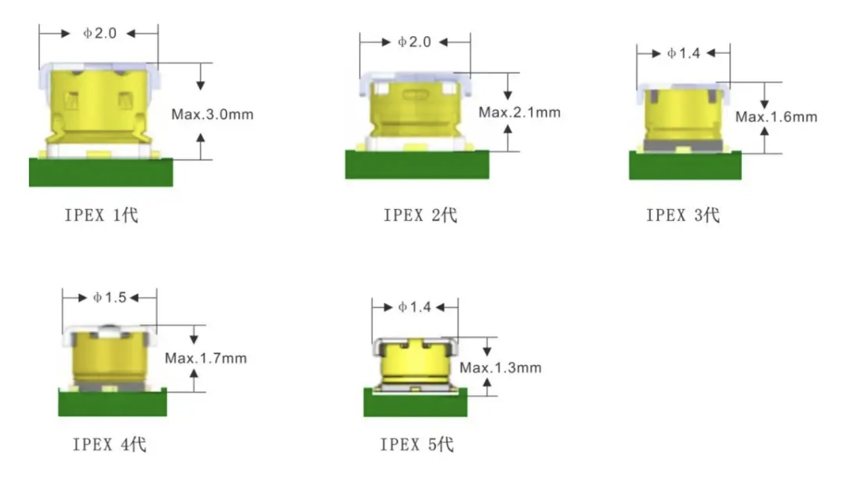
Movita_3568_AXV_Router_V3.0/MXVR CM3568 Yolların çekilmemiş hali/IPEX Dimension.jpg
