ihsanakyrk/Eski-Versionlar-Ve-Siparisler/Movita_3568_AXV_Router_V3.0/MXVR CM3568 Yolların çekilmemiş hali/M2 SSD 2210 delik boyutu.jpeg

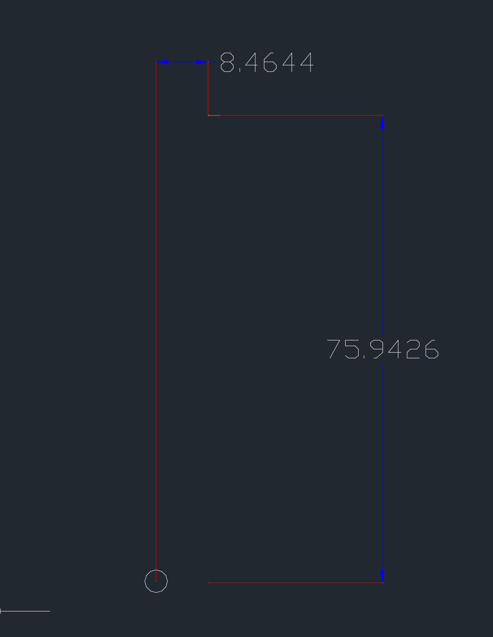
Movita_3568_AXV_Router_V3.0/MXVR CM3568 Yolların çekilmemiş hali/M2 SSD 2210 delik boyutu.jpeg
