ihsanakyrk/Eski-Versionlar-Ve-Siparisler/Movita_3568_AXV_Router_V3.0/MXVR CM3568 Yolların çekilmemiş hali/WhatsApp Image 2023-10-26 at 17.27.36.jpeg

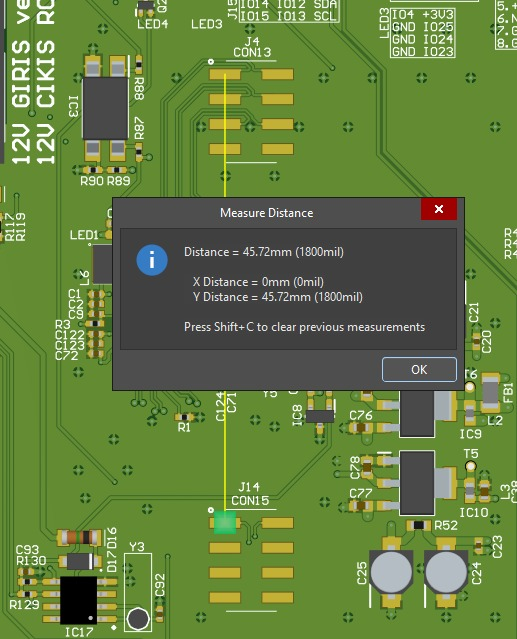
Movita_3568_AXV_Router_V3.0/MXVR CM3568 Yolların çekilmemiş hali/WhatsApp Image 2023-10-26 at 17.27.36.jpeg
