ihsanakyrk/Eski-Versionlar-Ve-Siparisler/Movita_3568_AXV_Router_V3.0/Screenshot 2024-09-03 at 12.05.06.png

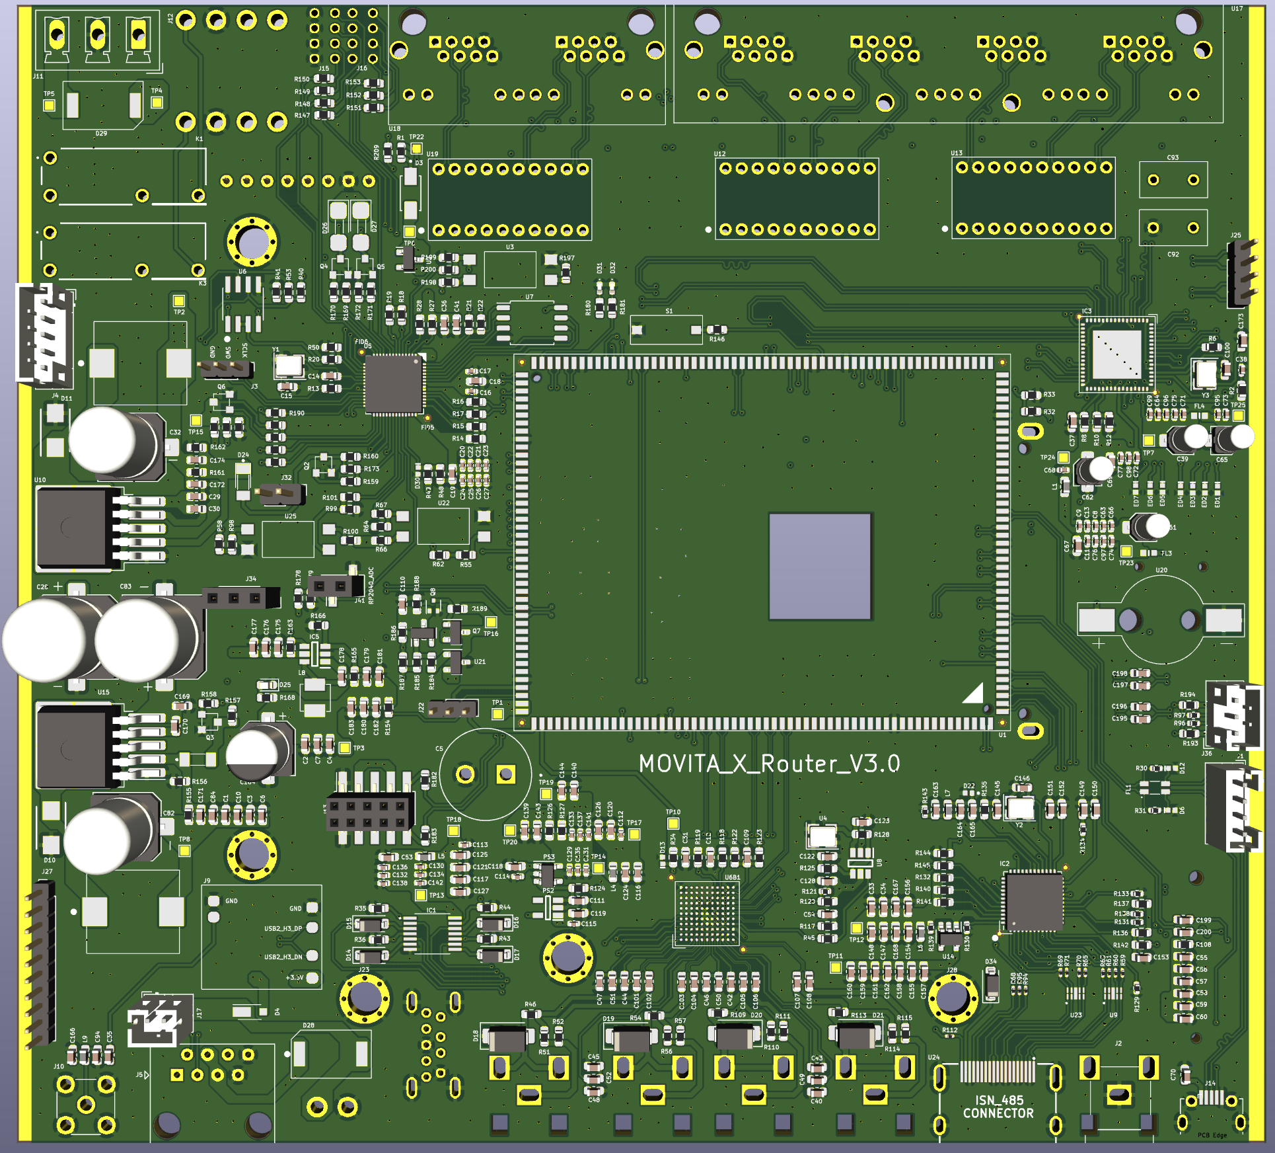
Movita_3568_AXV_Router_V3.0/Screenshot 2024-09-03 at 12.05.06.png
