ihsanakyrk/Eski-Versionlar-Ve-Siparisler/GSM_EC25_Modul_V2.0_Fabrication Outputs/Movita-MNVR Pro EC25-Rev02-BOM-15092021.xlsx

Designator | Comment | Description | Footprint | LibRef | Quantity
C1, C4 | 33pF | 33pF 0402 5% 16V MLCC | CAPC1005X55N | 885012005028 | 2
C2, C5 | 10pF | 10pF 0402 5% 16V MLCC | CAPC1005X55N | 885012005025 | 2
C3, C6, C7 | 0.1uF | 0.1 uF 0402 50V X8L 10%, 0.1uF 0402 20% 16V MLCC | CAPC1005X55N | GCM155L8EH104KE07D, 885012105016 | 3
C8 | 100pF | 100pF 0402 10% 50V MLCC | CAPC1005X55N | 885012205055 | 1
C9, C10, C11, C12, C13, C14 | DNP | Capacitor 0402, Do not populate | CAPC1005X55N | DNP-C | 6
C15, C16 | T490A107M006ATE500 | Capacitor Polarised | CAPPM3216X180N | T490A107M006ATE500 | 2
D1 | TPET05US3 | TVS Diode Array (Uni-directional), 5V, SOT23 | SOT23 | TPET05US3 | 1
FL1 | 90R Common Mode Choke | 90ohm@100MHz Tol 25% Common Mode Chokes / Filters 1206 | DLW31SH222SQ2L | DLW31SN900SQ2L | 1
IC1 | EC25-E | Integrated Circuit | EC21AU | EC25-E | 1
J1, J2 | Header_6Ways_2x54 | Header_6Ways_2x54 | HEADER_6WAYS_2x54 | Header_6Ways_2x54 | 2
J3, J4, J5 | IPEX | IPEX SMD RF Connector Alternatif MPN: 320110048 | RSP12281101 | RSP-122811-01 | 3
J6 | Header_3Ways_2x54 | Header_3Ways_2x54 | HEADER_3WAYS_2x54 | Header_3Ways_2x54 | 1
L1 | 47nH 5% | Fixed Inductors 47nH 5% Hi-Freq | LQG15WH0N7B02D | LQG15HS47NJ02D | 1
R1, R2, R4, R5 | 0R | 0R 0402 %5 | RESC1005X35N | RC0402JR-070RL | 4
R3 | 10R | 10R ohms 1% 0402 | RESC1005X35N | RC0402FR-0710RL | 1
T1 | AP_READY | TESTPOINT_1WAY_0.7x1mm_VIA | TESTPOINT_1WAY_0.7x1mm_VIA | TESTPOINT_1WAY_0.7x1mm_VIA | 1
T2 | RI | TESTPOINT_1WAY_0.7x1mm_VIA | TESTPOINT_1WAY_0.7x1mm_VIA | TESTPOINT_1WAY_0.7x1mm_VIA | 1
T3 | DTR | TESTPOINT_1WAY_0.7x1mm_VIA | TESTPOINT_1WAY_0.7x1mm_VIA | TESTPOINT_1WAY_0.7x1mm_VIA | 1
Z1, Z2 | TDZVTR5.1 | 500mW SOD-323HE TUMD2M Zener Diode | TDZVTR51 | TDZVTR5.1 | 2
