ihsanakyrk/Eski-Versionlar-Ve-Siparisler/MNVR_PRO/Movita-MNVR-Pro-Rev08-BOM-10062023.xlsx

Designator | Comment | Quantity | Description | Footprint | LibRef
BAT1 | CR2032 | 1 | CR2032 Battery Holder Horizontal Pitch: 20mm, Dia: 24.2mm | CR2032 Battery Holder - Horizontal | CR2032 Battery Holder_Horizontal
C1, C2 | 1000PF 2KV | 2 | 1000PF 2KV 10% | S102K33Y5PP63K5R | S102K33Y5PP63K5R
C3, C7, C8, C13, C14, C17, C18, C19, C20 | 0.1uF | 9 | 0.1 uF 0402 50V X8L 10% | CAPC1005X55N | GCM155L8EH104KE07D
C4, C5, C6 | 33pF | 3 | 33pF 0402 50V NPO 5% | CAPC1005X55N | CC0402JRNPO9BN330
C9, C10, C11, C12, C53, C79, C80, C98 | 100nF | 8 | 100nF 0402 25V X7R 10% | CAPC1005X55N | CC0402KRX7R8BB104
C15, C16, C26, C34, C99, C100 | 33pF | 6 | 33pF 0402 5% 16V MLCC | CAPC1005X55N | 885012005028
C21, C28, C35, C41 | 22uF | 4 | 22uF 0603 6.3volts *Derate Voltage/Temp | CAPC1608X90N | GRM188R60J226MEA0D
C22, C23, C24, C27, C29, C30, C31, C38, C39, C40, C43, C44, C47, C83, C84, C85, C86, C87, C88, C89, C90 | 0.1uF | 21 | 0.1uF 0402 20% 16V MLCC | CAPC1005X55N | 885012105016
C25 | 1uF | 1 | 1uF 0402 10V X5R 10% | CAPC1005X55N | CC0402KRX5R6BB105
C32 | 4.7uF | 1 | 4.7uF 0603 6.3V X5R+/-10% Gen Purp | CAPC1608X50N | JMK107BJ475KA-T
C33, C36 | 47uF | 2 | 47uF 0603 6.3volts X5R 20% | CAPC1608X90N | GRM188R60J476ME15D
C37, C42, C57, C101, C102, C103, C104, C106, C107, C108, C109, C110, C111, C112, C113, C116, C118 | 0.1uF | 17 | 0.1uF 0402 20% 10V MLCC | CAPC1005X55N | 885012105010
C45, C46, C48, C51 | 22uF | 4 | 22uF 10V %20 | CAPAE430X610N | EEE-FK1A220R
C49, C73 | 220pF | 2 | 220pF 0402 10% 25V | CAPC1005X55N | 885012205040
C50, C68, C77, C78 | 100uF | 4 | 100uF 10V Polarised Diameter:5 mm Length:5.5 mm Height:5.5 mm | CAPAE660X550N | UWR1A101MCL1GB
C52, C54 | 10uF | 2 | 10uF 0603 10% 10V | CAPC1608X100N | CC0603KRX5R6BB106
C55 | 10uF | 1 | 10uF 0402 6.3volts *Derate Voltage/Temp | CAPC1005X55N | GRM155C80J106ME11D
C56, C81, C82 | 10uF | 3 | 10uF 50V 1206 %10 X5R | CAPC3214X190N | UMK316BBJ106KL-T
C72 | 150pF | 1 | 150pF 0402 16volts X7R 10% | CAPC1005X55N | VJ0402Y151KXJCW1BC
C91 | 220uF/50V | 1 | 220uF 50volts Aluminium Electrolytic Capacitors - SMD AEC-Q200 | CAPAE1030X1050N | UWT1H221MNL1GS
C92 | 330uF/25V | 1 | 330uF 25volts Aluminium Electrolytic Capacitors - SMD AEC-Q200 | CAPAE830X1050N | UWT1E331MNL1GS
C93, C94, C95 | 1uF/50V | 3 | 1uF 0603 50V X5R +/-10% | INDC1608X90N | UMK107BJ105KA-T
C96 | .033uF 16V | 1 | .033uF 16V 10% MLCC - SMD/SMT .033uF X7R 0603 | CAPC1608X90N | 0603YC333KAT2A
C97 | 22pF | 1 | 22pF 0402 5% 16V | CAPC1005X55N | 885012005027
C105 | 22uF 16V | 1 | 22uF 1210 16V 10% 1210 ESR= 2.3 Ohm, Capacitor Polarised | CAPPM3528X210N | TAJB226K016RNJ
C117 | 0.01uF | 1 | 0.01uF 0402 10% 16V WCAP-CSGP | CAPC1005X55N | 885012205031
C119 | 2200pF | 1 | 2200pF 0402 50V X7R 10% | CAPC1005X56N | 04025C222KAT2A
C122 | 10pF | 1 | 10pF 0402 5% 16V MLCC | CAPC1005X55N | 885012005025
C123, C124 | DNP | 2 | Capacitor 0402, Do not populate | CAPC1005X55N | DNP-C
D1 | SMF05C.TCT | 1 | ESD Suppressors / TVS Diodes TVS, 5V, 5 LINE, ESD 6LD SC70 (Uni-directional) | SOT65P210X110-6N | SMF05C.TCT
D2, D5 | MRA4007T3G | 2 | Diode | DIOM5226X220N | MRA4007T3G
D3, D11 | SA6C | 2 | Schottky Diode SA6C Reverse Voltage - 50 to 1000 V Forward Current - 6 A | S6AC | SA6C
D4 | S1N-13-F | 1 | Vr - Reverse Voltage: 1200 V If - Forward Current: 1 A Vf - Forward Voltage: 0.94 V Max Surge Current: 30 A Ir - Reverse Current: 0.23 uA Rectifiers Standard Recovery Rectifier SMA T&R 5K | DIOM5226X240N | S1N-13-F
D6, D9, D10 | SS34FA | 3 | Schottky Diode | SODFL3618X143N | SS34FA
D7 | LXES15AAA1-133 | 1 | TVS Diode (Bi-directional) ESD Suppressors / TVS Diodes 15 VDC | DIONC1005X33N | LXES15AAA1-133
D8 | DA2S10100L | 1 | 80V 100mA, Silicon Junction Diode, 2-Pin SMini2 F5 B, Panasonic | SODFL1608X65N | DA2S10100L
D12 | SS54B | 1 | Rectifier Diode, Schottky, 1 Phase, 1 Element, 5A, 40V V(RRM), Silicon, SMB | DIOM5336X244N | SS54B
D13, D15 | LL4148 | 2 | Diode | FDLL4448 | LL4148
D14 | SS14 | 1 | SS14, Schottky Diode, 40V 1.0A, Vf:05V | SODFL3617X108N | SS14
D16, D19, D20, D21, D22 | 2SS100L-W | 5 | 100V 2A, SOD-123FL-2 SM SCHOTTKY Barrier Rectifier | 2SS100LW | 2SS100L-W
F1 | MF-MSMF125-2 | 1 | PPTC 1.25A 6V - Resettable Fuses - 0.035ohm AEC-Q200 | FUSC4632X85N | MF-MSMF125-2
FB1 | HI1206N101R-10 | 1 | Ferrite Bead | BEADC3216X130N | HI1206N101R-10
FB2 | BLM18EG221SZ1D | 1 | 220ohms 0603 2000mA Ferrite Beads Auto Infotainment | BEADC1608X95N | BLM18EG221SZ1D
FB3, FB4 | BKP1005HM121-T | 2 | Ferrite Bead | BEADC1005X55N | BKP1005HM121-T
H1, H3 | Hole_M3_Plated | 2 | Mounting Hole with many stitching vias 3.4mm x 7mm with vias | MountingHole_3_4mmx7mm_with_vias | MountingHole_3_4mmx7mm_with_vias
IC | PCF8563 | 1 | Real Time Clock _RTC_ IC Clock/Calendar IÂ²C, 2-Wire Serial 8-SOIC _0.154, 3.90mm Width_ | SO8 | PCF8563
IC1, IC20 | ORPC-817S | 2 | Opto-coupler If - Forward Current: 50 mA Vr - Reverse Voltage: 6 V | SOP254P960X420-4N | ORPC-817S
IC2 | TLV76033DBZT | 1 | Power Supply | SOT95P237X95-3N | TLV76033DBZT
IC3 | Raspberry_Pi_Zero_W__v1.3_ | 1 | Integrated Circuit | RASPBERRYPIZEROWV13 | Raspberry_Pi_Zero_W__v1.3_
IC4 | RTL8306E-CG | 1 | SINGLE-CHIP 6-PORT 10/100MBPS ETHERNET SWITCH CONTROLLER WITH DUAL MII/RMII INTERFACES | QFP50P1720X2320X340-128N | RTL8306E-CG
IC5 | LAN9514-JZX | 1 | USB Interface IC USB 4 Port Hub Int 10/100 Ethernet | QFN50P900X900X100-65N-D | LAN9514-JZX
IC6 | MAX485ESA+T | 1 | RS-422/RS-485 Interface IC Low-Power, Slew-Rate-Limited RS-485/RS-422 Transceivers | SOIC127P600X175-8N | MAX485ESA+T
IC7, IC11, IC12 | MP1584EN-LF-Z | 3 | Integrated Circuit | SOIC127P600X170-9N | MP1584EN-LF-Z
IC8 | AMS1117-1.8 | 1 | 1.8V 1A LOW DROPOUT VOLTAGE REGULATOR, SOT223 | SOT229P700X180-4N | AMS1117-1.8
IC10, IC13, IC18 | MMBT2222ALT1G | 3 | Integrated Circuit | SOT96P237X111-3N | MMBT2222ALT1G
IC14 | XL4015 | 1 | The XL4015 is a 180 KHz fixed frequency PWM buck (step-down) DC/DC converter, capable of driving a 5A load with high efficiency, low ripple and excellent line and load regulation. | XL4015 - TO263-5L | XL4015
IC15 | RTL8201CP-VD-LF | 1 | Integrated Circuit | QFP50P900X900X170-48N | RTL8201CP-VD-LF
IC17 | MPU-6050 | 1 | MPU-6050 Input Voltage: 2.3 - 3.4V Chipset: Invensense MPU-6050 Supply :3-5V (internal regulator) Communication modes: I2C Chip built-in 16-bit AD Converter Data Output - 16 Bit Gyroscope range: ± 250 500 1000 2000 ° / s Acceleration range: ± 2 ± 4 ± 8 ± 16g | QFN50P400X400X95-25N | MPU-6050
J1 | KF2EDGR-Y-5.08-03P-1 B | 1 | Connector 3P 5.08 Degson Electronics Co Ltd Description: Strip Terminal Block, 15A, 1 Row(s), 1 Deck(s), | KF2EDGR-Y-5.08-03P-1 B | KF2EDGR-Y-5.08-03P-1 B
J2 | RJ45 4 ports block | 1 | 48 pins RJ45 4 ports block PCB mount through-hole connector with 8 LED's. | RJHSE538504 | RJ45 4 ports
J3 | 15EDGK-3.81 | 1 | 15EDGK-3.81 15EDGRH-3.5_3.81-6P-1Y-00A | 15EDGK-3.81-6P-1Y-00A | 15EDGK-3.81
J4 | BOKTECH-AV | 1 | Phono _RCA_ Jack Mono Connector Solder (Boktech advise) | BOKTECH-AV-SOCKET | BOKTECH-AV
J5, J7 | Header_6Ways_female_2x54 | 2 | Header_6Ways_female_2x54 | HEADER_6WAYS_female_2x54 | Header_6Ways_female_2x54
J6 | RJ45 Molex | 1 | RJ45 PCB Connector, Right angle | MOLEX-95501-2881 | 95501-2881
J8 | KF2EDGR-3.81-02P | 1 | KF2EDGR-3.81-02P or 1803277 from Phoenix Contacts | SHDR2W100P0X381_1X2_910X920X725P | KF2EDGR-3.81-02P
J9 |  | 1 | Jumper pads 2 ways | JumperPads2Ways | Jumper pads 2 ways
J10, J11, J12, J13, J23, J24, J27 | Header_2Ways_2x54 | 7 | Header_2Ways_2x54 | HEADER_2WAYS_2x54 | Header_2Ways_2x54
J14 | Header_1Way_2x54 | 1 | Header_1Way_2x54 | HEADER_1WAY_2x54 | Header_1Way_2x54
J15 | BoardEdgePushButton - 1 | 1 | BoardEdgePushButton | BoardEdgePushButton | BoardEdgePushButton
J16 | 87520-0010BLF | 1 | USB 2.0 Type A receptacle white, Amphenol | 875200010BLF | 87520-0010BLF
J17 | THTPad_2Ways_2x54 | 1 | THTPad_2Ways_2x54 | THTPAD_2WAYS_2x54 | THTPad_2Ways_2x54
J18 | S4B-PH-SM4-TB_LF__SN__1 | 1 | Wire-To-Board Connector, Right Angle, 2 mm, 4 Contacts, Header, PH Series, Surface Mount, 1 Rows | S4B-PH-SM4-TB | S4B-PH-SM4-TB_LF__SN__1
J19 | 91228-3002 | 1 | 2.54mm Pitch ChipSIM Connector with Ejector, 6 Circuits, with Pegs, Black Button | 912283002 | 91228-3002
J21 | KF2EDGV-3.5-3.81 | 1 | Connector | SHDR2W120P0X381_1X2_842X700X920P | KF2EDGV-3.5-3.81
J22 | Header_2Ways_Female_2x54 | 1 | Header_2Ways_Female_2x54 | HEADER_2WAYS_FEMALE_2x54 | Header_2Ways_Female_2x54
J26 | B2B-PH-K-S_LF__SN_ | 1 | Connector Header, PH Series, 2 Position, 2.00mm, Through Hole, Press-Fit, Solder, Natural | SHDR2W50P0X200_1X2_590X450X600P | B2B-PH-K-S_LF__SN_
J28 | JP 2ways | 1 | Jumper pads 2 ways | JumperPads2Ways | Jumper pads 2 ways
J29 | XH-4AWT | 1 | XH-2.5mm Header top entry 4 way 2.5mm Pitch 4 Way 1 Row Straight PCB Header | XH-4AWT | XH-4AWT
J99 | PCB.SMAFRA.HT | 1 | SMA RA PCB MOUNT JACK RF Series: SMA Gender: Jack (Socket) Impedance: 50 Ohms Maximum Frequency: 6 GHz Termination Style: Solder Pin Orientation: Right Angle Polarity: Standard Mounting Style: Through Hole Cable Type: - IP Rating: - Board Thickness: 0.4 mm Body Finish: Gold Body Material: Brass Body Style: Right Angle Brand: Taoglas Contact Material: Brass Contact Plating: Gold Contact Termination: Solder Coupling Mechanism: Threaded Frequency: DC to 6 GHz Insulation Resistance: 1 GOhms Isolation: Non-Isolated | PCBSMAFRAHT | PCB.SMAFRA.HT
L1 | BLM31KN121SZ1L | 1 | Ferrite Beads 1206 120ohms 6A AEC-Q200 Infotainmnt | BEADC3216X180N | BLM31KN121SZ1L
L2, L3, L4, L6 | BLM18PG121SN1D | 4 | Ferrite Beads 0603 120 OHM | BEADC1608X95N | BLM18PG121SN1D
L5 | DNP - BLM18PG121SN1D | 1 | DNP - Ferrite Beads 0603 120 OHM | BEADC1608X95N | BLM18PG121SN1D
L7, L9, L10 | 10uH | 3 | 10uH %20 1.84A 7.5 x 7.5 x 4mm | CDRH74NP100MCB | CDRH74NP-100MC-B
L11 | 47uH 5A | 1 | Fixed Inductors 47uH 5A | INDPM120120X800N | 470MC 5A
L12 | 2.7nH | 1 | 2.7nH +/-0.3 Hi-Freq | LQG15WH0N7B02D | LQG15HS2N7S02D
LED1 | LED GREEN | 1 | LED GREEN 570 nm 40 mcd Water Clear If: 20 mA Vf: 2 V | LEDC2012X80N | 150080VS75000
LED2, LED11 | THT 4x LED | 2 | 4 LED with different colors, Boktech recommends | THT4xLED | THT4xLED
LED3 | Green | 1 | WL-SMCD SMD MonoChip 0603 BrtGrn 575nm | LEDM168X50N | 150060VS55040
Q1 | DTC043ZEBTL | 1 | Pre-Biased NPN Digital Transtr w/built in resistors | SOTFL50P160X85-3N | DTC043ZEBTL
Q3 | 2SB1188 | 1 | PNP 2A 32V SOT-89(SOT-89-3) PNP-Silicon General use Transistors | SOT-89-3 | 2SB1188
Q4, Q8, Q11, Q12 | MMBT3904-7-F | 4 | Transistor BJT NPN | SOT96P240X110-3N | MMBT3904-7-F
R1 | 1.5K 1% | 1 | 1.5 kOhms 62.5mW 0402 1% | RESC1005X40N | RC0402FR-071K5L
R2, R3, R5, R7, R41, R47, R72, R112, R148 | 1K | 9 | 1K OHM 0402 5% | RESC1005X35N | RC0402JR-071KL
R4, R6, R8, R9, R12, R13, R104, R106, R107, R108, R109 | 220R | 11 | 220 Ohms 0402 5% | RESC1005X40N | RC0402JR-13220RL
R10, R33, R37, R40, R52, R53, R90, R91, R93, R95, R96, R97, R98, R99, R143, R149 | 10K | 16 | 10K OHM 0402 5% | RESC1005X35N | RC0402JR-0710KL
R11, R50, R63, R67, R110, R147 | 2.2K | 6 | 2.2K OHM 0402 5%, 2.2K 0402 5% | RESC1005X40N, RESC1005X35N | RC0402JR-072K2L
R14, R15, R16, R17 | 75R | 4 | 75 OHM 0402 `% | RESC1005X35N | RC0402FR-0775RL
R18, R103 | 33R | 2 | 33ohms 0402 1% Commercial Use | RESC1005X35N | CRCW040233R0FKEDC
R19 | 15K | 1 | 15Kohms 1% 0402 | RESC1005X35N | RC0402FR-0715KL
R20 | 51K | 1 | 51Kohms 0402 5% AEC-Q200 | RESC1005X40N | ERJ-2GEJ513X
R21, R42 | 1K | 2 | 1K 0805 5% | RESC2012X50N | CRCW08051K00JNEB
R22, R43 | 10K | 2 | 10K 0805 1% | RESC2012X60N | CRCW080510K0FKEAC
R23, R24, R25, R26, R74, R75, R76, R77, R78, R79, R80, R81, R82, R83, R84, R85, R86, R87, R88, R89, R135, R136, R137, R138 | 49.9R | 24 | 49.9 OHM 0402 1% | RESC1005X40N | RC0402FR-0749R9L
R27 | 1M | 1 | 1 Mohms 0402 1% Commercial Use | RESC1005X35N | CRCW04021M00FKEDC
R28 | 270R | 1 | 270ohms 0402 1% AEC-Q200 | RESC1005X40N | ERJ-2RKF2700X
R29, R113 | 1.69K | 2 | 1.69Kohms 0402 1% AEC-Q200 | RESC1005X40N | ERJ-2RKF1691X
R30, R34 | DNP-470R | 2 | 470 ohm 5% 50V General Purpose | RESC1005X40N | RC0402JR-13470RL
R31 | 0R | 1 | 0R 0402 %5 | RESC1005X35N | RC0402JR-070RL
R32 | 12.4K | 1 | 12.4Kohms 0402 1% AEC-Q200 | RESC1005X35N | ERJ-2RKF1242X
R35, R94 | 12K | 2 | 12Kohms 0402 5% AEC-Q200 | RESC1005X40N | ERJ-2GEJ123X
R36 | 1.24K 1% | 1 | 1.24KOHM 1/16WATT 1% | RESC1005X40N | CR0402-FX-1241GLF
R38 | 10K | 1 | 10K OHM 0603 1% | RESC1608X55N | RC0603FR-0710KL
R39, R54, R105, R114, R115, R116, R118, R119, R120, R121, R122, R123, R124, R125, R126, R127, R128, R129, R130, R139, R140, R141, R150 | 4.7K | 23 | 4.7K OHM 0402 5% | RESC1005X35N | RC0402JR-074K7L
R44 | DNP - 0R | 1 | DNP - 0R 0603 10% | RESC1608X55N | CRCW06030000Z0EAC
R45, R111 | 0R | 2 | 0R 0603 10% | RESC1608X55N | CRCW06030000Z0EAC
R46, R60 | 68.1K | 2 | 68.1K ohm 0402 1% 50V | RESC1005X40N | RC0402FR-1368K1L
R48 | 124K | 1 | 124Kohms 0402 1% | RESC1005X40N | CRCW0402124KFKED
R49, R62, R66 | 40.2K | 3 | 40.2Kohms 0402 1% | RESC1005X35N | RC0402FR-0740K2L
R51, R59, R64, R68, R70 | 100K | 5 | 100Kohms 0402 1% | RESC1005X35N | RC0402FR-07100KL
R55, R71 | 200K | 2 | 200K OHM 0402 1% | RESC1005X40N | RC0402FR-07200KL
R56 | 3.9K | 1 | 3.9KOHM 0402 5% | RESC1005X35N | RC0402JR-073K9L
R57 | 1.5K | 1 | 1.5K 0402 1% | RESC1005X35N | CRCW04021K50FKEDC
R58 | 0R 1/4W | 1 | 0ohm Jumper | RESC3216X75N | CR1206-J_-000ELF
R61 | 210K | 1 | 210Kohms 0402 1% AEC-Q200 | RESC1005X40N | ERJ-2RKF2103X
R65 | 150K | 1 | 150K 0402 1% SMD Resistor | RESC1005X35N | CRGP0402F150K
R69, R92 | 20K | 2 | 20 kOhms 62.5mW 0402 1% | RESC1005X40N | RC0402FR0720KL
R73 | 120R | 1 | 120R 0402 1% | RESC1005X40N | CRG0402F120R
R117 | 2K 1% | 1 | 2Kohms 0402 1% Tol AEC-Q200 | RESC1005X35N | ERJ-2RKF2001X
R131, R132, R133, R134 | 50R 1% | 4 | 50ohms 0603 1% Non Std Qt Req'd | RESC1608X50N | CRCW060350R0FKEA
R142 | 470R | 1 | 470 ohm 5% 50V General Purpose | RESC1005X40N | RC0402JR-13470RL
R144, R145, R146 | 22R | 3 | 22ohms 0402 1% | RESC1005X35N | RC0402FR-0722RL
Relay1, Relay3 | SRD-05VDC-SL-C | 2 | Relay 5V | SRD-05VDC-SL-C | SRD-05VDC-SL-C_1
T1 | H1164NL | 1 | Transformer | H1164NL | H1164NL
T2, T3, T5, T6, T7, T8 | TESTPOINT_1WAY_0.7x1mm_VIA | 6 | TESTPOINT_1WAY_0.7x1mm_VIA | TESTPOINT_1WAY_0.7x1mm_VIA | TESTPOINT_1WAY_0.7x1mm_VIA
U1 | RTL8188EUS | 1 | RTL8188EUS, 150Mbps 802.11 b/g/n Single side WiFi Module Model: UM12BS | RTL8188EUS | RTL8188EUS
Y1, Y2, Y4 | 25MHz | 3 | Crystal 25MHZ 18 pF +/-20ppm | ABM3B | ABM3B-25.000MHZ-B2-T
Y3 | 32.768 KHz | 1 | Crystals 32.768 KHz 12.5pF CYLINDER CRYSTAL | CFS20632768DZFB | CFS-20632768DZFB
Z1 | ZM4735A-GS08 | 1 | Zener Diode | ZMY4V3GS18 | ZM4735A-GS08
