ihsanakyrk/Eski-Versionlar-Ve-Siparisler/EC25_Adapter Panel/EC25_Adapter Panel_Fabrication Outputs/BOM/EC25_module.xlsx

Reference | Qty | Value | Footprint
J1,J2,J3 | 3 | DNP | Footprint Library:Castelled 5
J4 | 1 | DNP | Footprint Library:castelled 6
U1 | 1 | EC25 | EC25:XCVR_EC25
