ihsanakyrk/Eski-Versionlar-Ve-Siparisler/[03.2025]-Entronom/GSM_CT_V1.0/BOM/GSM_CT_V1.0.xlsx

Reference | Qty | Value | MPN | Footprint
C20,C21 | 2 | 0R |  | Capacitor_SMD:C_0603_1608Metric
R1,R15,R16 | 3 | 0R |  | Resistor_SMD:R_0603_1608Metric
R39 | 1 | 0R |  | Resistor_SMD:R_0402_1005Metric
C5,C6 | 2 | 10pF |  | Capacitor_SMD:C_0603_1608Metric
C3,C4,C10,C11,C12 | 5 | 33pF |  | Capacitor_SMD:C_0603_1608Metric
C16,C28 | 2 | 33pF | CL10C330JB8NNNC | Capacitor_SMD:C_0603_1608Metric
C25 | 1 | 100pF |  | Capacitor_SMD:C_0603_1608Metric
C15 | 1 | 220pF |  | Capacitor_SMD:C_0603_1608Metric
C7,C8,C9,C17 | 4 | 0.1uF |  | Capacitor_SMD:C_0603_1608Metric
C14 | 1 | 100nF |  | Capacitor_SMD:C_0603_1608Metric
C29,C35,C38,C39,C40,C41,C42,C43,C44,C45,C46,C47,C48,C49,C50,C51,C52 | 17 | 100nF | CC0402KRX7R7BB104 | Capacitor_SMD:C_0402_1005Metric
C13 | 1 | 10uF |  | Capacitor_SMD:C_1206_3216Metric
L1 | 1 | 10uH | CDRH74NP-100MC-B | Inductor_SMD:L_7.3x7.3_H3.5
C36,C37 | 2 | 22uF | CL10A226MQ8NRNC | Capacitor_SMD:C_0603_1608Metric
C27 | 1 | 100uF | HGC1206R5107M100NSPJ | Capacitor_SMD:C_1206_3216Metric
R2,R3,R6,R13 | 4 | 22R |  | Resistor_SMD:R_0603_1608Metric
R17,R20,R21,R41 | 4 | 470R | 0603WAF4700T5E | Resistor_SMD:R_0603_1608Metric
R14 | 1 | 1K |  | Resistor_SMD:R_0603_1608Metric
R38 | 1 | 1K | 0603WAF1001T5E | Resistor_SMD:R_0603_1608Metric
R36,R40 | 2 | 2.49K | 0603WAF2491T5E | Resistor_SMD:R_0603_1608Metric
R5 | 1 | 15K |  | Resistor_SMD:R_0603_1608Metric
R7 | 1 | 24.9K |  | Resistor_SMD:R_0603_1608Metric
R11 | 1 | 40.2K |  | Resistor_SMD:R_0603_1608Metric
R4 | 1 | 51K |  | Resistor_SMD:R_0603_1608Metric
R10 | 1 | 68.1K |  | Resistor_SMD:R_0603_1608Metric
R8 | 1 | 100K |  | Resistor_SMD:R_0603_1608Metric
R12 | 1 | 150K |  | Resistor_SMD:R_0603_1608Metric
R9 | 1 | 200K |  | Resistor_SMD:R_0603_1608Metric
C30,C31,C32,C33,C34 | 5 | 16V 10uF X5R ±20% | CL10A106MO8NQNC | Capacitor_SMD:C_0603_1608Metric
L2 | 1 | 47nH 5% | SDCL1608C47NJTDF | Inductor_SMD:L_0603_1608Metric
J2 | 1 | 91228-3002 | 91228-3002 | KiCad:912283002
FL1 | 1 | ACM3225-2P-900TF | ACM3225-2P-900TF | Footprint Library:ACM3225-2P-900TF
FL2,FL3 | 2 | BLM18PG121SN1D | BLM18PG121SN1D | Footprint Library:BLM18PG121SN1D
L3 | 1 | CBW160808U101T | CBW160808U101T | Inductor_SMD:L_0603_1608Metric
C18,C19,C22,C23,C24,C26 | 6 | DNP |  | Capacitor_SMD:C_0603_1608Metric
FID1,FID2 | 2 | DNP |  | Fiducial:Fiducial_0.5mm_Mask1mm
H1,H2 | 2 | DNP |  | Footprint Library:Screw Terminal Shinbo
H3,H4,H5,H6 | 4 | DNP |  | Footprint Library:Screw Terminal Shinbo_2
R18,R19,R22,R23,R24,R25,R26,R27,R28,R29,R30,R31,R32,R33,R34,R35,R37 | 17 | DNP |  | Resistor_SMD:R_0603_1608Metric
U2 | 1 | DNP |  | Library:GSM_Castelled
D3 | 1 | ESDA6V1-5SC6 | ESDA6V1-5SC6 | Library:ESDA6V1-5SC6
J3,J4,J5 | 3 | IPEX1-3-TXZ 214 | IPEX1-3-TXZ 214 | Footprint Library:IPEX1-3-TXZ 214
J7,J8,J9 | 3 | JST_1x8-1MP_P1.25mm_Vertical |  | Footprint Library:JST_1x8_1MP_P1.25mm_Vertical
D6,D7,D8,D9 | 4 | LED_YELLOW | 0603 翠绿色 LED | LED_SMD:LED_0603_1608Metric
IC1 | 1 | MP1584EN-LF-Z | MP1584EN-LF-Z | Footprint Library:MP1584EN-LF-Z
J6 | 1 | PinSocket_2x04_P2.00mm_Vertical_SMD_FEMALE | PinHeader_2x04_P2.00mm_Vertical_FEMALE | Connector_PinSocket_2.00mm:PinSocket_2x04_P2.00mm_Vertical_SMD
J1 | 1 | PinSocket_2x05_P2.00mm_Vertical_SMD_FEMALE |  | Connector_PinSocket_2.00mm:PinSocket_2x05_P2.00mm_Vertical_SMD
D5 | 1 | RED LED |  | LED_SMD:LED_0805_2012Metric
IC2 | 1 | RTL8309N-CG | RTL8309N-CG | Footprint Library:RTL8309N
D4 | 1 | SS34FA | SS34FA | Library:SS4FA
C1,C2 | 2 | T490A107M006ATE500 | T490A107M006ATE500 | KiCad:T490A
D1,D2 | 2 | TDZVTR5.1 | TDZVTR5.1 | Library:TDZVTR5.1
U1 | 1 | TPET05US3 | TPET05US3 | Library:TPET05US3
Y1 | 1 | X322525MSB4SI | X322525MSB4SI | Crystal:Crystal_SMD_3225-4Pin_3.2x2.5mm
