ihsanakyrk/Eski-Versionlar-Ve-Siparisler/[03.2025]-Entronom/IMX219_V2.0/BOM/IMX219_V2.0.xlsx

Reference | Qty | Value | MPN | Footprint
R4,R7 | 2 | 0R | RC-02000FT | Resistor_SMD:R_0402_1005Metric
R6,R11 | 2 | 0R |  | Resistor_SMD:R_0402_1005Metric
C8 | 1 | 220nF | 0402B224K160NT | Capacitor_SMD:C_0402_1005Metric
C1,C2,C3,C4,C6,C11 | 6 | 1uF | CL05A105KP5NNNC | Capacitor_SMD:C_0402_1005Metric
C9,C10 | 2 | 2.2uF | CL05A225MQ5NSNC | Capacitor_SMD:C_0402_1005Metric
C5 | 1 | 4.7uF | CL10A475KO8NNNC | Capacitor_SMD:C_0603_1608Metric
C7 | 1 | 10uF | CL21A106KAYNNNE | Capacitor_SMD:C_0805_2012Metric
R3 | 1 | 22R | 0402WGF220JTCE | Resistor_SMD:R_0402_1005Metric
R1,R2 | 2 | 2.2K | 0402WGF2201TCE | Resistor_SMD:R_0402_1005Metric
L1 | 1 | 1.8A 2.2uH | IFSC1008ABER2R2M01 | Inductor_SMD:L_1008_2520Metric
FB1,FB2 | 2 | 600Ω@100MHz 380mΩ | BLM18AG601SN1D | Footprint Library:BLM18SP221SN1B
FL1,FL2,FL3 | 3 | 90Ω@100MHz 1.88Ω | DLP11SN900HL2L | Footprint Library:DLP11SN900HL2L
IC1 | 1 | AP7331-18WG-7 | AP7331-18WG-7 | Footprint Library:AP7331
IC2 | 1 | AP7331-28WG-7 | AP7331-28WG-7 | Footprint Library:AP7331
IC3 | 1 | DMG1024UV - 7 | DMG1024UV - 7 | Package_TO_SOT_SMD:SOT-563
R5,R8,R9,R10 | 4 | DNP | DNP | Resistor_SMD:R_0402_1005Metric
U3,U4,U5,U6,U7,U8 | 6 | DNP | DNP | Footprint Library:Screw Terminal Shinbo_2
J1 | 1 | JST_1x15-1MP_P1.25mm_Vertical | 1.25mm间距 立贴 1*15p | IMX219:JST_1x15-1MP_P1.25mm_Vertical
J2 | 1 | JST_1x2-1MP_P1.25mm_Vertical | p=1.25 1*3p | Footprint Library:Con_2Ways_1.25mm
U1 | 1 | PAM2301CAAB120 | PAM2301CAAB120 | Package_TO_SOT_SMD:SOT-23-5
U2 | 1 | SBP08047 | SBP08047 | IMX219:SBP08047
Y1 | 1 | OT2EL4C4JI-111OLP-24M | OT2EL4C4JI-111OLP-24M | Footprint Library:OT2EL4C4JI-111OLP-24M
