ihsanakyrk/Eski-Versionlar-Ve-Siparisler/[03.2025]-Entronom/KSS_MD_V1.0/BOM/KSS_MD_V1.0_1.xlsx

Reference | Qty | Value | Footprint
B1,B2,B3 | 3 | 74LVC1G125 | Package_TO_SOT_SMD:SOT-353_SC-70-5
C1 | 1 | 10nF | Capacitor_SMD:C_0603_1608Metric
C2 | 1 | 330nF | Capacitor_SMD:C_0603_1608Metric
C3 | 1 | 100nF | Capacitor_SMD:C_0603_1608Metric
C4 | 1 | 1uF | Capacitor_SMD:C_0603_1608Metric
J1,J2 | 2 | RJ45 | Connector_RJ:RJ45_OST_PJ012-8P8CX_Vertical
L1 | 1 | BLM31PG330SN1L | Inductor_SMD:L_1206_3216Metric
LED1 | 1 | GREEN LED | LED_SMD:LED_0805_2012Metric
LED2 | 1 | RED LED | LED_SMD:LED_0805_2012Metric
R1,R3,R5 | 3 | 1K | Resistor_SMD:R_0603_1608Metric
R2,R4,R6,R7,R8,R9 | 6 | 4.7K | Resistor_SMD:R_0603_1608Metric
R10 | 1 | 6.98K | Resistor_SMD:R_0603_1608Metric
U1 | 1 | SN74LS165ADR | Package_SO:SOIC-16_3.9x9.9mm_P1.27mm
U3 | 1 | LM1117-3.3 | Package_TO_SOT_SMD:SOT-223-3_TabPin2
XA1,XA2 | 2 | B2P-VH(LF)(SN) right Angle | Connector_Hirose:Hirose_DF63M-2P-3.96DSA_1x02_P3.96mm_Vertical
XA3,XA4 | 2 | DNP | Connector_Hirose:Hirose_DF63M-2P-3.96DSA_1x02_P3.96mm_Vertical
