ihsanakyrk/Eski-Versionlar-Ve-Siparisler/[03.2025]-Entronom/Movita_CM4_CT_Router_V1.0/BOM/Movita_CM4_CT_Router_V1.0.xlsx

Reference | Qty | MPN | Value | Footprint | Adet fiyatı | kart Fiyatı | STOK | EKLENEN
R11,R12,R40,R51,R54,R55,R60,R61,R62 | 9 |  | 0R | Resistor_SMD:R_0603_1608Metric | 0.0000 | 0.0000 | VAR
R22 | 1 |  | 0R | Resistor_SMD:R_0402_1005Metric | 0.0000 | 0.0000 | VAR
C43,C50 | 2 |  | 22pF | Capacitor_SMD:C_0603_1608Metric | 0.0000 | 0.0000 | VAR
C22,C23 | 2 |  | 27pF | Capacitor_SMD:C_0603_1608Metric | 0.0000 | 0.0000 | VAR
C26,C27 | 2 |  | 27pF | Capacitor_SMD:C_0402_1005Metric | 0.0009 | 0.0019 | YOK
C2 | 1 | CL10C330JB8NNNC | 33pF | Capacitor_SMD:C_0603_1608Metric | 0.0000 | 0.0000 | VAR
C7 | 1 |  | 150pF | Capacitor_SMD:C_0603_1608Metric | 0.0027 | 0.0027 | YOK
C44 | 1 |  | 1000pF | Capacitor_SMD:C_0603_1608Metric | 0.0021 | 0.0021 | YOK
C41,C42 | 2 |  | 0.01uF | Capacitor_SMD:C_0603_1608Metric | 0.0021 | 0.0042 | YOK
C3,C4,C11,C12,C15,C16,C17,C18,C19,C20,C21,C24,C28,C34 | 14 |  | 100nF | Capacitor_SMD:C_0402_1005Metric | 0.0000 | 0.0000 | VAR
C5,C6,C25,C29,C32,C35,C36,C37,C38,C39,C40,C45,C49,C53,C54 | 15 |  | 100nF | Capacitor_SMD:C_0603_1608Metric | 0.0000 | 0.0000 | VAR
C13,C14 | 2 |  | 1uF | Capacitor_SMD:C_0402_1005Metric | 0.0000 | 0.0000 | VAR
C1,C10,C33,C46,C47,C48 | 6 |  | 10uF | Capacitor_SMD:C_0603_1608Metric | 0.0000 | 0.0000 | VAR
C30,C31 | 2 |  | 10uF | Capacitor_SMD:C_0402_1005Metric | 0.0000 | 0.0000 | VAR
C51,C52 | 2 | CL10A226MQ8NRNC | 22uF | Capacitor_SMD:C_0603_1608Metric |  | 0.0000 | YOK
C9 | 1 | HGC1206R5107M100NSPJ | 100uF | Footprint Library:C_1206_3216Metric | 0.0123 | 0.0123 | YOK
C55 | 1 | RVT220UF16V67RV0015 | 220uF | Capacitor_SMD:CP_Elec_6.3x5.4 |  | 0.0000 | YOK
R9,R10,R13,R14,R72,R73,R74,R75 | 8 |  | 10mR | Resistor_SMD:R_1206_3216Metric | 0.0055 | 0.0439 | YOK
R24 | 1 |  | 1R | Resistor_SMD:R_0402_1005Metric | 0.0005 | 0.0005 | YOK
R26,R27 | 2 |  | 27R | Resistor_SMD:R_0603_1608Metric | 0.0000 | 0.0000 | VAR
R4,R42 | 2 |  | 75R | Resistor_SMD:R_0603_1608Metric | 0.0007 | 0.0014 | VAR
R43 | 1 |  | 150R | Resistor_SMD:R_0603_1608Metric | 0.0000 | 0.0000 | VAR
R23 | 1 |  | 200R | Resistor_SMD:R_0402_1005Metric | 0.0004 | 0.0004 | YOK
R38,R39 | 2 |  | 470R | Resistor_SMD:R_0603_1608Metric | 0.0007 | 0.0014 | YOK
R2,R29,R31 | 3 | 0603WAF1001T5E | 1K | Resistor_SMD:R_0603_1608Metric | 0.0000 | 0.0000 | VAR
R25,R41,R57,R65 | 4 |  | 1K | Resistor_SMD:R_0402_1005Metric | 0.0004 | 0.0017 | YOK
R8 | 1 |  | 2.2K | Resistor_SMD:R_0603_1608Metric | 0.0000 | 0.0000 | VAR
R37 | 1 |  | 2.7K | Resistor_SMD:R_0603_1608Metric | 0.0007 | 0.0007 | YOK
R20,R21,R44,R45,R69 | 5 |  | 4.7K | Resistor_SMD:R_0603_1608Metric | 0.0000 | 0.0000 | VAR
R1,R16,R32,R46,R64 | 5 |  | 10K | Resistor_SMD:R_0603_1608Metric | 0.0000 | 0.0000 | VAR
R3,R28 | 2 |  | 10K | Resistor_SMD:R_0402_1005Metric | 0.0000 | 0.0000 | VAR
R5,R18 | 2 |  | 40.2K | Resistor_SMD:R_0603_1608Metric | 0.0010 | 0.0020 | YOK
R33,R36 | 2 |  | 47K | Resistor_SMD:R_0603_1608Metric | 0.0007 | 0.0014 | YOK
R71 | 1 | 0603WAF5102T5E | 51K | Resistor_SMD:R_0603_1608Metric |  | 0.0000 | YOK
R7,R17,R34,R35 | 4 |  | 100K | Resistor_SMD:R_0603_1608Metric | 0.0000 | 0.0000 | VAR
R6 | 1 |  | 124K | Resistor_SMD:R_0603_1608Metric | 0.0010 | 0.0010 | YOK
R15 | 1 |  | 200K | Resistor_SMD:R_0603_1608Metric | 0.0007 | 0.0007 | YOK
R19 | 1 |  | 210K | Resistor_SMD:R_0603_1608Metric | 0.0010 | 0.0010 | YOK
R70 | 1 | FRC0603F2323TS | 232K | Resistor_SMD:R_0603_1608Metric |  | 0.0000 | YOK
R58,R59 | 2 |  | 2.2K 1% | Resistor_SMD:R_0402_1005Metric | 0.0005 | 0.0011 | YOK
D1 | 1 | 2SS100L-W | 2SS100L-W | Footprint Library:2SS100LW | 0.2880 | 0.2880 | YOK
C8 | 1 |  | 4.7uF/50V | Capacitor_SMD:C_0603_1608Metric | 0.0465 | 0.0465 | YOK
U8 | 1 | 74LVC1G07SE-7 | 74LVC1G07SE-7 | Footprint Library:SOT-353_SC-70-5 | 0.0592 | 0.0592 | YOK
J5 | 1 | NGFF 67P连接器 M.2 SSD插槽 4+5 H3.2 | APCI0079-P002A J8900 M.2 M Key | Footprint Library:121992306 | 0.0000 | 0.0000 | VAR
IC1 | 1 | BL9342 | BL9342 | Package_TO_SOT_SMD:SOT-23-6 | 0.1606 | 0.1606 | YOK
FL1 | 1 | BLM21BB050SN1D | BLM21BB050SN1D | Footprint Library:BLM21BB050SH1D | 0.0164 | 0.0164 | YOK
L1 | 1 | CDRH74NP-100MC-B | CDRH74NP-100MC-B | Footprint Library:CDRH74NP100MCB | 0.1132 | 0.1132 | YOK
Y1 | 1 | CF4012M00020001 | CF4012M00020001 | Crystal:Crystal_SMD_3225-4Pin_3.2x2.5mm | 0.0181 | 0.0181 | YOK
Y2 | 1 | CF4012M00020001 | CRYSTAL 12MHz | Crystal:Crystal_SMD_3225-4Pin_3.2x2.5mm | 0.0181 | 0.0181 | YOK
Y3 | 1 | CFS20632768DZFB | CRYSTAL 32.7680KHZ 12.5PF TH | Crystal:Crystal_AT310_D3.0mm_L10.0mm_Horizontal | 0.0376 | 0.0376 | YOK
U9 | 1 | DF40C-100DS-0.4V(51) | DF40C-100DS-0.4V | Footprint Library:MODULE_CM4102008 | 0.0000 | 0.0000 | VAR
J13 | 1 |  | DNP | Connector_PinSocket_2.00mm:PinSocket_1x03_P2.00mm_Vertical | 0.0000 | 0.0000 | DNP
R30,R47,R48,R49,R50,R52,R53,R56,R68 | 9 |  | DNP | Resistor_SMD:R_0603_1608Metric | 0.0000 | 0.0000 | DNP
TP1 | 1 |  | DNP | TestPoint:TestPoint_Pad_1.0x1.0mm | 0.0000 | 0.0000 | DNP
TP2,TP3,TP4,TP5 | 4 |  | DNP | TestPoint:TestPoint_Pad_D1.0mm | 0.0000 | 0.0000 | DNP
Q1 | 1 | DTC043ZEBTL | DTC043ZEBTL | Package_TO_SOT_SMD:SOT-416 | 0.0000 | 0.0000 | VAR
U5 | 1 | FE1.1S-BSOP28BCN | FE1.1s | Package_SO:SSOP-28_3.9x9.9mm_P0.635mm | 0.0000 | 0.0000 | VAR
T1 | 1 | H1102NLT | H1102NL | Footprint Library:H1102NL | 0.0000 | 0.0000 | VAR
L3 | 1 | HA42-4R7MT | HA42-4R7MT | Footprint Library:Inductor_0402_4.7uH |  | 0.0000 | YOK
J10,J11 | 2 |  | JST_1x15-1MP_P1.25mm_Vertical | Footprint Library:JST_1x15-1MP_P1.25mm_Vertical | 0.0000 | 0.0000 | VAR
J15 | 1 |  | JST_1x8-1MP_P1.25mm_Vertical | Footprint Library:JST_1x8_1MP_P1.25mm_Vertical | 0.0256 | 0.0256 | YOK
J1,J2 | 2 | JST_PH_B2B-PH-K_1x02_P2.00mm_Vertical | JST_PH_B2B-PH-K_1x02_P2.00mm_Vertical | Connector_JST:JST_PH_B2B-PH-K_1x02_P2.00mm_Vertical | 0.0256 | 0.0512 | YOK
LED1,LED2,LED3 | 3 | LED Green | LED Green | LED_SMD:LED_0805_2012Metric | 0.0034 | 0.0101 | YOK
D12,D13 | 2 |  | LED Red | LED_SMD:LED_0603_1608Metric | 0.0019 | 0.0038 | YOK
D2,D6,D7,D11 | 4 | 0603 翠绿色 LED | LED_WHITE | LED_SMD:LED_0603_1608Metric | 0.0021 | 0.0085 | YOK
L2 | 1 | LQM21PN2R2MC0D | LQM21PN2R2MC0D | Inductor_SMD:L_0805_2012Metric | 0.0507 | 0.0507 | YOK
J6 | 1 | SMTSO-M3-3ET | M3x*0.5 L=3 | Footprint Library:Screw Terminal Shinbo | 0.0000 | 0.0000 | VAR
J7,J8 | 2 | SMTSO-M3-8ET | M3x*0.5 L=8 | Footprint Library:Screw Terminal Shinbo | 0.0000 | 0.0000 | VAR
Q2 | 1 | MMBT2222A | MMBT2222ALT1G | Footprint Library:MMBT2222ALT1G | 0.0000 | 0.0000 | VAR
IC2 | 1 | MP1584EN | MP1584EN | Footprint Library:MP1584N | 0.0000 | 0.0000 | VAR
U6 | 1 | PCF8563T/5,518 | PCF8563T | Package_SO:SOIC-8_3.9x4.9mm_P1.27mm | 0.0000 | 0.0000 | VAR
J12 | 1 | PinHeader_2x04_P2.00mm_Vertical_MALE | PinHeader_2x04_P2.00mm_Vertical_MALE | Connector_PinHeader_2.00mm:PinHeader_2x04_P2.00mm_Vertical |  |  | YOK
J9 | 1 | PinHeader_2x05_P2.00mm_Vertical_MALE | PinHeader_2x05_P2.00mm_Vertical_MALE | Connector_PinHeader_2.00mm:PinHeader_2x05_P2.00mm_Vertical |  |  | YOK
U3 | 1 | RP2040 | RP2040 | Footprint Library:RP2040-QFN-56 | 0.0000 | 0.0000 | VAR
J3 | 1 | SHOU HAN MICRO XNJ ZB | SHOU HAN MICRO XNJ ZB | Footprint Library:Micro-B SMD | 0.0148 | 0.0148 | YOK
S1 | 1 |  | SKRPANE010 | Footprint Library:SKRPANE010 | 0.0532 | 0.0532 | YOK
D5,D8,D9,D10 | 4 |  | SS14 | Footprint Library:SS14 | 0.0000 | 0.0000 | VAR
D4 | 1 | SS34FA | SS34FA | Footprint Library:SS34FA | 0.0275 | 0.0275 | VAR
IC3 | 1 | SY8113BADC | SY8113B | Footprint Library:SY8113B |  |  | YOK
P1 | 1 |  | TYPE-C 6P(073) | Footprint Library:TYPE-C 6P(073) | 0.0148 | 0.0148 | YOK
J4 | 1 |  | USB-A Female SMD connector | Connector_USB:USB_A_Stewart_SS-52100-001_Horizontal | 0.0121 | 0.0121 | YOK
U4 | 1 | W25Q16JVSIQ | W25Q16JVSIQ | Package_SO:SOIC-8_5.23x5.23mm_P1.27mm | 1.0563 | 1.0563 | YOK
