ihsanakyrk/Eski-Versionlar-Ve-Siparisler/[03.2025]-Entronom/MXVR_3566_V4.1_Fabrication Outputs/BOM/Movita_3566_HXV_Router_V4.1.xlsx

Reference | Qty | Value | MPN | Footprint
R6,R7,R8,R13,R123,R257 | 6 | 0R | 0402WGF0000TCE | Resistor_SMD:R_0402_1005Metric
R35,R84,R91,R93,R94,R96,R100,R104,R133,R239 | 10 | 0R | 0603WAF0000T5E | Resistor_SMD:R_0603_1608Metric
C183,C184,C185 | 3 | 10pF | CC0603JRNPO9BN100 | Capacitor_SMD:C_0603_1608Metric
C120,C204 | 2 | 15pF | 0402CG150J500NT | Capacitor_SMD:C_0402_1005Metric
C1,C2,C38,C67 | 4 | 22pF | CL10C220JB8NNNC | Capacitor_SMD:C_0603_1608Metric
C49,C50 | 2 | 27pF | 0603CG270J500NT | Capacitor_SMD:C_0603_1608Metric
C80,C153,C155 | 3 | 33pF | CL10C330JB8NNNC | Capacitor_SMD:C_0603_1608Metric
C23 | 1 | 100pF | 0603B101K500NT | Capacitor_SMD:C_0603_1608Metric
C25 | 1 | 220pF | CL10B221KB8NNNC | Capacitor_SMD:C_0603_1608Metric
C9 | 1 | 10nF | CC0603KRX7R9BB103 | Capacitor_SMD:C_0603_1608Metric
C119 | 1 | 10nF | CC0402KRX7R9BB103 | Capacitor_SMD:C_0402_1005Metric
C3,C4,C6,C8,C11,C12,C14,C16,C17,C18,C19,C20,C21,C22,C35,C43,C46,C48,C66,C70,C71,C124,C125,C126,C127,C128,C129,C176 | 28 | 100nF | 0603B104K500NT | Capacitor_SMD:C_0603_1608Metric
C51,C52,C55,C56,C57,C58,C59,C60,C61,C62,C121,C122,C130,C135,C139,C140,C141,C142,C143,C144,C145,C146,C147,C148,C149,C150,C151,C152,C154,C157,C158,C159,C160,C202,C210,C211,C213,C214,C215,C216,C217,C218,C219 | 43 | 100nF | CC0402KRX7R7BB104 | Capacitor_SMD:C_0402_1005Metric
C44,C45 | 2 | 330nF | 0603B334K250NT | Capacitor_SMD:C_0603_1608Metric
C53,C54 | 2 | 1uF | CL10A105KB8NNNC | Capacitor_SMD:C_0603_1608Metric
C5,C10,C13,C179,C207,C209,C212 | 7 | 4.7uF | CL10A475KO8NNNC | Capacitor_SMD:C_0603_1608Metric
C7,C15,C26,C27,C30,C63,C64,C65,C81,C131,C181,C201,C208 | 13 | 10uF | CL10A106MO8NQNC | Capacitor_SMD:C_0603_1608Metric
C41,C42,C68,C69,C137,C138 | 6 | 22uF | CL10A226MQ8NRNC | Capacitor_SMD:C_0603_1608Metric
C47,C72 | 2 | 220uF | RVT220UF16V67RV0015 | Capacitor_SMD:CP_Elec_6.3x7.7
R38,R39,R40,R42,R46,R56,R58,R60,R66,R67,R72,R73,R75,R76,R77,R83,R99 | 17 | 10mR |  | Resistor_SMD:R_1206_3216Metric
R52 | 1 | 1R | 0603WAF100KT5E | Resistor_SMD:R_0603_1608Metric
R195,R196 | 2 | 2.2R | 0402WGF220KTCE | Resistor_SMD:R_0402_1005Metric
R205,R206 | 2 | 10R | 0402WGF100JTCE | Resistor_SMD:R_0402_1005Metric
R16,R240,R241,R242,R243,R244,R245,R246 | 8 | 22R | 0603WAF220JT5E | Resistor_SMD:R_0603_1608Metric
R248,R249,R250,R251,R252,R253,R254 | 7 | 22R | 0402WGF220JTCE | Resistor_SMD:R_0402_1005Metric
R53,R54 | 2 | 27R | 0603WAF270JT5E | Resistor_SMD:R_0603_1608Metric
R41,R212,R215 | 3 | 33R | 0603WAF330JT5E | Resistor_SMD:R_0603_1608Metric
R17 | 1 | 75R | 0402WGF750JTCE | Resistor_SMD:R_0402_1005Metric
R157,R158,R159,R160,R161,R162 | 6 | 75R | 0603WAF750JT5E | Resistor_SMD:R_0603_1608Metric
R203 | 1 | 100R | 0603WAF1000T5E | Resistor_SMD:R_0603_1608Metric
R201 | 1 | 150R | 0603WAF1500T5E | Resistor_SMD:R_0603_1608Metric
R51 | 1 | 200R | 0603WAF2000T5E | Resistor_SMD:R_0603_1608Metric
R62,R63,R64,R68,R69,R97 | 6 | 220R | 0603WAF2200T5E | Resistor_SMD:R_0603_1608Metric
R9,R90,R92,R101,R102,R103,R105 | 7 | 330R | 0603WAF3300T5E | Resistor_SMD:R_0603_1608Metric
R24,R26,R112 | 3 | 470R | 0603WAF4700T5E | Resistor_SMD:R_0603_1608Metric
R5,R19,R44,R50,R55,R61,R85,R95,R148,R153,R154,R155,R156,R163,R165,R192,R194,R214,R216 | 19 | 1K | 0603WAF1001T5E | Resistor_SMD:R_0603_1608Metric
R127 | 1 | 1K | 0402WGF1001TCE | Resistor_SMD:R_0402_1005Metric
R255 | 1 | 1.5K | 0402WGF1501TCE | Resistor_SMD:R_0402_1005Metric
R30 | 1 | 1.6K | 0603WAF1601T5E | Resistor_SMD:R_0603_1608Metric
R14,R15,R98 | 3 | 2.2K | 0603WAF2201T5E | Resistor_SMD:R_0603_1608Metric
R128,R144 | 2 | 2.49K | 0603WAF2491T5E | Resistor_SMD:R_0603_1608Metric
R247 | 1 | 2.49K | 0402WGF2491TCE | Resistor_SMD:R_0402_1005Metric
R32,R34,R74,R208,R209 | 5 | 3.3K | 0603WAF3301T5E | Resistor_SMD:R_0603_1608Metric
R33,R47,R81,R111,R197,R198 | 6 | 4.7K | 0603WAF4701T5E | Resistor_SMD:R_0603_1608Metric
R256,R258,R259,R260,R261,R262,R263,R264,R265,R268 | 10 | 4.7K | 0402WGF4701TCE | Resistor_SMD:R_0402_1005Metric
R4,R126,R202,R204 | 4 | 10K |  | Resistor_SMD:R_0402_1005Metric
R10,R11,R20,R22,R23,R31,R36,R43,R48,R57,R59,R70,R71,R82,R107,R108,R109,R110,R191,R193,R211,R213 | 22 | 10K | 0603WAF1002T5E | Resistor_SMD:R_0603_1608Metric
R29 | 1 | 15K | 0603WAF1502T5E | Resistor_SMD:R_0603_1608Metric
R45 | 1 | 40.2K |  | Resistor_SMD:R_0603_1608Metric
R28,R80 | 2 | 51K | 0603WAF5102T5E | Resistor_SMD:R_0603_1608Metric
R18 | 1 | 100K | 0603WAF1003T5E | Resistor_SMD:R_0603_1608Metric
R37 | 1 | 124K |  | Resistor_SMD:R_0603_1608Metric
R27,R79 | 2 | 232K | FRC0603F2323TS | Resistor_SMD:R_0603_1608Metric
C156,C173 | 2 | 1000PF 2KV | Y5P102K2KV16CC0224 | Capacitor_THT:S102K33Y5PP63K5R
C123 | 1 | 100nF X7R 16V | CC0402KRX7R7BB104 | Capacitor_SMD:C_0402_1005Metric
C75,C76,C77,C78,C82,C83,C84,C85 | 8 | 16V 10uF X5R ±20% | CL10A106MO8NQNC | Capacitor_SMD:C_0603_1608Metric
C31,C32,C33,C34,C36,C37 | 6 | 1uF/50V | CL10A105KB8NNNC | Capacitor_SMD:C_0603_1608Metric
C28,C29 | 2 | 220uF/50V | RVT1H221M1010 | Capacitor_SMD:C_Elec_10x10.2
D7,D8,D20,D21,D22,D23,D24,D25 | 8 | 2SS100L-W | 2SS100L-W | 2SS100L-W:2SS100LW
C39,C40 | 2 | 330uF/25V | RVT1E331M0810 | Capacitor_SMD:C_Elec_8x10.2
U21 | 1 | 36-3034-ND | 36-3034-ND | Footprint Library:BatteryHolder_Keystone_3034_1x20mm
C79 | 1 | 4.7uF/50V |  | Capacitor_SMD:C_0603_1608Metric
FL3 | 1 | APCW3216-900P2T | APCW3216-900P2T | DLW31SN900SQ2L:DLW31SH222SQ2L
L15 | 1 | AWL3225FP2R2MTF | AWL3225FP2R2MTF | Footprint Library:AWL3225FP2R2MTF
IC5 | 1 | BL9342 | BL9342 | Package_TO_SOT_SMD:SOT-23-6
FL1,FL2 | 2 | BLM18PG121SN1D | BLM18PG121SN1D | BLM18PG121SN1D:BLM18AG102BH1D
D33 | 1 | BZT52C3V6 | BZT52C3V6 | Diode_SMD:D_SOD-123
L13 | 1 | CBW160808U101T | CBW160808U101T | Inductor_SMD:L_0603_1608Metric
Y2 | 1 | CF4012M00020001 | CF4012M00020001 | Crystal:Crystal_SMD_3225-4Pin_3.2x2.5mm
U22 | 1 | CM3566 | CM3566 | Footprint Library:SMX66
J16 | 1 | DC3-6P MALE Connector | DC3-6P MALE Connector | Footprint Library:Analog power connector
J3 | 1 | DC3-10P MALE Connector | DC3-10P MALE Connector | Footprint Library:GSM connector
J14 | 1 | DC3-14P MALE Connector | DC3-14P MALE Connector | Footprint Library:Analog signal connector
C24 | 1 | DNP |  | Capacitor_SMD:C_0603_1608Metric
C73 | 1 | DNP | ERZV14D270 | Footprint Library:ERZV14D220
C74 | 1 | DNP |  | Footprint Library:SuperCapacitor
C203,C205,C206 | 3 | DNP |  | Capacitor_SMD:C_0402_1005Metric
FID1,FID2,FID5,FID6,FID7,FID8,FID11,FID12 | 8 | DNP |  | Fiducial:Fiducial_0.5mm_Mask1mm
J4 | 1 | DNP | 莲花座AV1-8.4-5A 黑色 | Footprint Library:AV_CON
J8 | 1 | DNP |  | Footprint Library:Screw Terminal Shinbo
J19 | 1 | DNP | NGFF 67P连接器 M.2 SSD插槽 4+5 H3.2 | Library:APCI0079-P002A J8900 M.2 M Key
J22 | 1 | DNP |  | Footprint:Screw Terminal Shinbo
J28 | 1 | DNP |  | Connector_PinSocket_2.00mm:PinSocket_1x03_P2.00mm_Vertical
R1,R2,R21,R25,R49,R65,R78,R86,R87,R88,R89,R106,R125,R129,R130,R131,R132,R134,R135,R136,R137,R138,R139,R140,R141,R142,R143,R145,R146,R147,R149,R150,R151,R152,R164,R166 | 36 | DNP |  | Resistor_SMD:R_0603_1608Metric
R3,R12,R124,R266,R267 | 5 | DNP |  | Resistor_SMD:R_0402_1005Metric
TP1,TP2,TP3,TP5,TP6,TP8,TP18 | 7 | DNP |  | TestPoint:TestPoint_Pad_1.0x1.0mm
TP4,TP7,TP9,TP10,TP11 | 5 | DNP |  | TestPoint:TestPoint_Pad_D1.0mm
TP19,TP20,TP21 | 3 | DNP |  | TestPoint_Pad_1.0x1.0mm
Q3 | 1 | DTC043ZEBTL | DTC043ZEBTL | Package_TO_SOT_SMD:SOT-416
D11,D15,D28,D29,D30 | 5 | ESD5341N | ESD5341N | Footprint Library:ESD5341N
ED1,ED2,ED3,ED4,ED5,ED6,ED7 | 7 | ESD5341N | ESD5341N | Footprint Library:ESD5341N
D1 | 1 | ESD5451N | ESD5451N | ESD5451N:ESD5451N
P1 | 1 | G-Switch GT-USB-7010ASV | G-Switch GT-USB-7010ASV | Footprint Library:G-Switch GT-USB-7010ASV
L5,L6 | 2 | HA42-4R7MT | HA42-4R7MT | Pro V3:Inductor_0402_4.7uH
K1,K2 | 2 | HF46F_5-HS1 | HF46F_5-HS1 | Footprint Library:HF46F5HS1
L3,L4 | 2 | HX CYA1050-47UH | HX CYA1050-47UH | CYA1050-47UH:L_Bourns_SRR1208_12.7x12.7mm
J6 | 1 | JST_PH_B2B-PH-K_1x02_P2.00mm_Vertical | JST_PH_B2B-PH-K_1x02_P2.00mm_Vertical | Connector_JST:JST_PH_B2B-PH-K_1x02_P2.00mm_Vertical
J24 | 1 | JST_PH_B3B-PH-K_1x03_P2.00mm_Vertical | JST_PH_B3B-PH-K_1x03_P2.00mm_Vertical | Connector_JST:JST_PH_B3B-PH-K_1x03_P2.00mm_Vertical
J10,J21 | 2 | JST_PH_S4B-PH-K_1x04_P2.00mm_Horizontal | JST_PH_S4B-PH-K_1x04_P2.00mm_Horizontal | Connector_JST:JST_PH_S4B-PH-K_1x04_P2.00mm_Horizontal
J7 | 1 | KF2EDGH-3.81-2P- Right Angle | KF2EDGV-3.81 2p 直针 | Footprint Library:KF2EDGH-3.81-2P
J27 | 1 | KF2EDGH-3.81_8P-Right Angle | 15EDGK-3.81 双层 2*4p | KF2EDGH:KF2EDGH-3.81_8P
J9 | 1 | KF2EDGR-Y-5.08-3P-Right Angle | KF2EDG -3P 5.08 封口 弯 | KF2EDGH:KF2EDGR-Y-5.08-3P-Right Angle
J11,J13 | 2 | LED_4_Block_Right Angle | 3mm四孔灯座带灯 | LED_4:LED_4_Block
D34 | 1 | LED_RED | 0603 翠绿色 LED | LED_SMD:LED_0603_1608Metric
D6,D12,D13,D14,D18 | 5 | LED_WHITE | 0603 翠绿色 LED | LED_SMD:LED_0603_1608Metric
D40 | 1 | LED_YELLOW | 0603 翠绿色 LED | LED_SMD:LED_0603_1608Metric
D4,D5 | 2 | LL4148 | LL4148 | Pro V3:LL4148
L7 | 1 | LQM21PN2R2MC0D | LQM21PN2R2MC0D | Inductor_SMD:L_0805_2012Metric
J18 | 1 | M3x*0.5 L=3 | SMTSO-M3-3ET | Footprint Library:Screw Terminal Shinbo
J1,J2 | 2 | M3x*0.5 L=6 | SMTSO-M3-6ET | Footprint Library:Screw Terminal Shinbo
J17,J20 | 2 | MICRO XNJ ZB | SHOU HAN MICRO XNJ ZB | Footprint Library:Micro-B SMD
L2 | 1 | MLI1608F-1R2KT | MLI1608F-1R2KT | Inductor_SMD:L_0603_1608Metric
Q1,Q2,Q4,Q6,Q7 | 5 | MMBT2222ALT1G | MMBT2222A | HDMI 2.0 TX:MMBT2222ALT1G
D26,D27 | 2 | MRA4007T3G | MRA4007T3G | Library:MRA4007T3G
IC1 | 1 | MS1836S_QFN48-7x7 | MS1836S | Package_DFN_QFN:QFN-48-1EP_7x7mm_P0.5mm_EP5.6x5.6mm
U5,U23,U24 | 3 | PC817C | PC817C_4PIN_SMD | HDMI 2.0 TX:PC817
J12 | 1 | RJ45 | 黑色 RJ45 8P | Connector_RJ:RJ45_Amphenol_54602-x08_Horizontal
U19 | 1 | RJ45-2-Block | RJ45 56 1*2 带灯 | Connector_RJ:2_Block_RJ45
U15 | 1 | RJ45-4-Block | RJ45 56 1*4 带灯 | Library:4_Block_RJ45
U7 | 1 | RP2040 | RP2040 | RP2040_minimal:RP2040-QFN-56
U1 | 1 | RT9013-12GB | RT9013-12GB | Package_TO_SOT_SMD:SOT-23-5
J25 | 1 | RTL8188EU | RTL8188EUS 模块 | Footprint Library:RTL8188EU
U14 | 1 | RTL8211F-CG | RTL8211F-CG | Footprint Library:RTL8211F-CG
IC3 | 1 | RTL8309N-VB-CG | RTL8309N-VB-CG | RTL8309N:RTL8309N
D9 | 1 | S6MC | S6MC | Diode_SMD:S6MC
U20 | 1 | SAF-8ASC-2132M | SAF-8ASC-2132M | SATA_Connector:SATA_Connector_5622-1200-ML
L14 | 1 | SDCL1608C2N7STDF | SDCL1608C2N7STDF | Inductor_SMD:L_0603_1608Metric
J5 | 1 | SHOU HAN MSS12C02LS-HB2.0 | SHOU HAN MSS12C02LS-HB2.0 | Footprint Library:SHOU HAN MSS12C02LS-HB2.0
S2,S3 | 2 | SKRPANE010 | SKRPANE010 | Footprint Library:SKRPANE010
J26 | 1 | SMA Connetor_inner_pin | SMA-KWE 内针 | Footprint Library:SMA_Connector_inner_pin_right_angle
D10,D16,D17,D19,D31,D32,D35,D36,D37,D38,D39 | 11 | SS14 | SS14 SOD-123FL | Footprint Library:SS14
D2,D3 | 2 | SS54B | SS54B | Library:SS54B
IC2,IC4 | 2 | SY8113B | SY8113BADC | footprint:SY8113B
Y1 | 1 | TAXM27M4RFBCCT2T | TAXM27M4RFBCCT2T | Crystal:Crystal_SMD_3225-4Pin_3.2x2.5mm
U16,U17,U18 | 3 | TF-218DG | TF-218DG | Transformer_THT:RJ45_Transformer_2_Port
J30 | 1 | TF-CARD H1.8 | TF 卡座 铜壳 | HDMI 2.0 TX:TF-CARD H1.8
U4 | 1 | TLV76033DBZT | TLV76033DBZT | Package_TO_SOT_SMD:SOT-23
L1 | 1 | UPZ1608E101-3R0TF | UPZ1608E101-3R0TF | Inductor_SMD:L_0603_1608Metric
U9 | 1 | W25Q16JVSIQ | W25Q16JVSIQ | Package_SO:SOIC-8_5.23x5.23mm_P1.27mm
Y3,Y5 | 2 | X322525MSB4SI | X322525MSB4SI | Crystal:Crystal_SMD_3225-4Pin_3.2x2.5mm
U2,U3 | 2 | XL4015 | XL4015 | Package_TO_SOT_SMD:TO-263-5_TabPin3
FB1 | 1 | YI321611U101-4R0T | YI321611U101-4R0T | HI1206N101R-10:BEADC3216X130N
