ihsanakyrk/Eski-Versionlar-Ve-Siparisler/CamTracker_CM4_V3.1/CamTracker_CM4_Outputs/BOM/CamTracker_CM4.xlsx

Reference | Qty | Value | MPN | Link | Footprint
BT1 | 1 | MYOUNG BS-12-B3AA003 | MYOUNG BS-12-B3AA003 | https://www.lcsc.com/product-detail/Battery-Connectors_span-style-background-color-ff0-MYOUNG-span-BS-12-B3AA003_C964723.html | Camtrack:BS-12-B3AA003
C1,C45 | 2 | 10uF |  |  | Capacitor_SMD:C_0402_1005Metric
C2,C3,C7,C8,C9,C10,C34,C48 | 8 | 10uF |  |  | Capacitor_SMD:C_0603_1608Metric
C4 | 1 | 22pF |  |  | Capacitor_SMD:C_0603_1608Metric
C5,C31 | 2 | 100nF X5R 10V |  |  | Capacitor_SMD:C_0603_1608Metric
C6,C35 | 2 | 100nF |  |  | Capacitor_SMD:C_0603_1608Metric
C11 | 1 | 30pF |  |  | Capacitor_SMD:C_0603_1608Metric
C12 | 1 | 1uF |  |  | Capacitor_SMD:C_0603_1608Metric
C13,C32,C40,C46,C47,C55,C56,C57,C58,C59,C60 | 11 | 0.1uF |  |  | Capacitor_SMD:C_0603_1608Metric
C14,C15,C42,C43 | 4 | 27pF |  |  | Capacitor_SMD:C_0402_1005Metric
C16,C17,C20,C21,C22,C23,C24,C25,C26,C27 | 10 | 100nF |  |  | Capacitor_SMD:C_0402_1005Metric
C18,C19 | 2 | 1uF |  |  | Capacitor_SMD:C_0402_1005Metric
C28,C29 | 2 | 0.01uF |  |  | Capacitor_SMD:C_0603_1608Metric
C30 | 1 | 1000pF |  |  | Capacitor_SMD:C_0603_1608Metric
C33 | 1 | 100nF X5R 16V |  |  | Capacitor_SMD:C_0603_1608Metric
C36 | 1 | 150pF |  |  | Capacitor_SMD:C_0603_1608Metric
C41 | 1 | 100uF |  |  | Cam_Tracker_V3.1:CAPAE660X550N
C44 | 1 | 0.1uF |  |  | Capacitor_SMD:C_0402_1005Metric
D1,D8 | 2 | LED Green | SZYY0603YG | https://www.lcsc.com/product-detail/Light-Emitting-Diodes-span-style-background-color-ff0-LED-span_Yongyu-Photoelectric-SZYY0603YG_C434423.html | LED_SMD:LED_0603_1608Metric
D2 | 1 | LED Red | D-060306R1/SS2/L | https://www.lcsc.com/product-detail/Light-Emitting-Diodes-span-style-background-color-ff0-LED-span_ARKLED-Wuxi-ARK-Tech-Elec-D-060306R1-SS2-L_C118330.html | LED_SMD:LED_0603_1608Metric
D3 | 1 | LED Green | 150080VS75000 | https://www.digikey.com/en/products/detail/würth-elektronik/150080VS75000/4489924 | 150080VS75000:LEDC2012X80N
D4 | 1 | 2SS100L-W | 2SS100L-W | https://www.mouser.com.tr/ProductDetail/Rectron/2SS100L-W?qs=5aG0NVq1C4wsv0OtzLcEnw%3D%3D | 2SS100L-W:2SS100LW
D5 | 1 | SS34FA | SS34FA | https://www.lcsc.com/product-detail/Schottky-Barrier-Diodes-SBD_onsemi-SS34FA_C719833.html | Cam_Tracker_V3.1:SODFL3618X143N
D6 | 1 | SS14 | SS14 | https://www.lcsc.com/product-detail/Schottky-Barrier-Diodes-SBD_MDD-Microdiode-Electronics-SS14_C2480.html | SS14:DIOM4325X250N
FID1,FID2,FID3,FID4,FID5,FID6 | 6 | DNP | Fiducial |  | Fiducial:Fiducial_0.5mm_Mask1mm
FL1 | 1 | BLM21BB050SN1D | BLM21BB050SN1D | https://www.lcsc.com/product-detail/Ferrite-Beads_Murata-Electronics-BLM21BB050SN1D_C113035.html | BLM21BB050SN1D:BLM21BB050SH1D
IC3 | 1 | MP1584EN | MP1584EN |  | Cam_Tracker_V3.1:SOIC127P600X170-9N
J1 | 1 | USB-A Female SMD connector |  |  | Connector_USB:USB_A_CNCTech_1001-011-01101_Horizontal
J2 | 1 | DNP | MSTBA 2,5/ 2-G-5,08 | https://www.phoenixcontact.com/en-pc/products/printed-circuit-board-connector-mstba-25-2-g-508-1757242 | Connector_Phoenix_MSTB:PhoenixContact_MSTBA_2,5_2-G-5,08_1x02_P5.08mm_Horizontal
J3 | 1 | APCI0079-P002A J8900 M.2 M Key | 1-2199230-6 | https://www.lcsc.com/product-detail/Card-Edge-Connectors_TE-Connectivity-1-2199230-6_C4710843.html | Cam_Tracker_V3.1:121992306
J4 | 1 | DNP | MALE 1x05_P2.00mm Through Hole PinHeader |  | Connector_PinSocket_2.00mm:PinSocket_1x05_P2.00mm_Vertical
J6 | 1 | DNP | RJ45_Amphenol_54602-x08_Horizontal |  | Connector_RJ:RJ45_Amphenol_54602-x08_Horizontal
J7 | 1 | JST_PH_B2B-PH-K_1x02_P2.00mm_Vertical | B2B -PH-K-S | https://www.lcsc.com/product-detail/Wire-To-Board-Wire-To-Wire-Connector_JST-Sales-America-B2B-PH-K-S-LF-SN_C131337.html | Connector_JST:JST_PH_B2B-PH-K_1x02_P2.00mm_Vertical
J8,J10 | 2 | M3x*0.5 L=8 | M3x*0.5 L=8 |  | Screw_terminal:Screw_terminal_shinbo
J9 | 1 | JST_GH_BM08B-GHS-TBT_1x08-1MP_P1.25mm_Vertical | BM08B-GHS-TBT | https://www.digikey.com/en/products/detail/jst-sales-america-inc/BM08B-GHS-TBT/807806 | Cam_Tracker_V3.1:JST_GH_BM08B-GHS-TBT_1x08-1MP_P1.25mm_Vertical
J11 | 1 | M3x*0.5 L=3 | M3x*0.5 L=3 |  | Cam_Tracker_V3.1:Screw_terminal_shinbo
J12 | 1 | DNP |  |  | RP2040_minimal:Touch Pad
J13 | 1 | MALE Through Hole PinHeader | MALE 2x05_P2.00mm Through Hole PinHeader |  | Connector_PinHeader_2.00mm:PinHeader_2x05_P2.00mm_Vertical
J16 | 1 | DNP | MALE 1x08_P2.54mm Through Hole PinHeader |  | Connector_PinHeader_2.54mm:PinHeader_1x08_P2.54mm_Vertical
J100,J101 | 2 | JST_1x15-1MP_P1.25mm_Vertical |  |  | Cam_Tracker_V3.1:JST_1x15-1MP_P1.25mm_Vertical
L2 | 1 | CDRH74NP-100MC-B | CDRH74NP-100MC-B | https://www.lcsc.com/product-detail/Power-Inductors_Sumida-CDRH74NP-100MC-B_C879412.html | Cam_Tracker_V3.1:CDRH74NP100MCB
LED1,LED2,LED3 | 3 | LED Green | 150080VS75000 | https://www.digikey.com/en/products/detail/würth-elektronik/150080VS75000/4489924 | 150080VS75000:LEDC2012X80N
Q1 | 1 | DTC043ZEBTL | DTC043ZEBTL | https://www.lcsc.com/product-detail/Digital-Transistors_ROHM-Semicon-DTC043ZEBTL_C96459.html | Cam_Tracker_V3.1:SOTFL50P160X85-3N
R1,R7,R9,R10,R12,R19,R22,R50,R51,R52,R65 | 11 | DNP |  |  | Resistor_SMD:R_0603_1608Metric
R2 | 1 | 150R |  |  | Resistor_SMD:R_0603_1608Metric
R3,R4 | 2 | 4.7K |  |  | Resistor_SMD:R_0603_1608Metric
R5,R75 | 2 | 2.2K |  |  | Resistor_SMD:R_0603_1608Metric
R6,R8,R11,R18,R23,R24,R27,R63,R64 | 9 | 0R |  |  | Resistor_SMD:R_0603_1608Metric
R13,R21,R48 | 3 | 1K |  |  | Resistor_SMD:R_0603_1608Metric
R14 | 1 | 200R |  |  | Resistor_SMD:R_0603_1608Metric
R15 | 1 | 1R |  |  | Resistor_SMD:R_0603_1608Metric
R16,R17 | 2 | 27R |  |  | Resistor_SMD:R_0603_1608Metric
R20,R31,R32,R76,R78 | 5 | 100K |  |  | Resistor_SMD:R_0603_1608Metric
R25,R34,R49 | 3 | 10K |  |  | Resistor_SMD:R_0603_1608Metric
R26 | 1 | 1K 5% |  |  | Resistor_SMD:R_0402_1005Metric
R29,R30 | 2 | 47K |  |  | Resistor_SMD:R_0603_1608Metric
R33 | 1 | 2.7K |  |  | Resistor_SMD:R_0603_1608Metric
R35,R36 | 2 | 470R |  |  | Resistor_SMD:R_0603_1608Metric
R40,R41 | 2 | 75R |  |  | Resistor_SMD:R_0603_1608Metric
R55,R58 | 2 | 2.2K 1% |  |  | Resistor_SMD:R_0402_1005Metric
R62,R73 | 2 | 1K |  |  | Resistor_SMD:R_0402_1005Metric
R77 | 1 | 200K |  |  | Resistor_SMD:R_0603_1608Metric
R79 | 1 | 40.2K |  |  | Resistor_SMD:R_0603_1608Metric
R80 | 1 | 210K |  |  | Resistor_SMD:R_0603_1608Metric
T1 | 1 | H1102NL | H1102NLT | https://www.lcsc.com/product-detail/RJ45-Transformer_Pulse-Elec-H1102NLT_C18584.html | H1102NL:H1102NL
TP1,TP2,TP4 | 3 | DNP | Test Point |  | TestPoint:TestPoint_Pad_D1.0mm
U1 | 1 | DF40C-100DS-0.4V | DF40C-100DS-0.4V(51) | https://www.lcsc.com/product-detail/Mezzanine-Connectors-Board-to-Board_HRS-Hirose-DF40C-100DS-0-4V-51_C597931.html | CM4_UnitB:DF40C-100DS-0.4V_CM4_Unit_B
U2,U3 | 2 | TLV76033DBZT | TLV76033DBZT | https://www.lcsc.com/product-detail/Linear-Voltage-Regulators-LDO_Texas-Instruments-TLV76033DBZT_C133791.html | Package_TO_SOT_SMD:SOT-23
U4 | 1 | FE1.1s | FE1.1S-BSOP28BCN | https://www.lcsc.com/product-detail/USB-ICs_Terminus-Tech-FE1-1S-BSOP28BCN_C9359.html | Package_SO:SSOP-28_3.9x9.9mm_P0.635mm
U5 | 1 | RP2040 | RP2040 | https://www.lcsc.com/product-detail/Microcontroller-Units-MCUs-MPUs-SOCs_Raspberry-Pi-RP2040_C2040.html | RP2040_minimal:RP2040-QFN-56
U6 | 1 | PCF8563T | PCF8563T/5,518 | https://www.lcsc.com/product-detail/Real-time-Clocks-RTC_NXP-Semicon-PCF8563T-5-518_C7440.html | Package_SO:SOIC-8_3.9x4.9mm_P1.27mm
U7 | 1 | W25Q128JVS | W25Q128JVSIQ | https://www.lcsc.com/product-detail/NOR-FLASH_Winbond-Elec-W25Q128JVSIQ_C97521.html | Package_SO:SOIC-8_5.23x5.23mm_P1.27mm
U8 | 1 | AMS1117-3.3 | AMS1117-3.3 | https://www.lcsc.com/product-detail/Linear-Voltage-Regulators-LDO_UMW-Youtai-Semiconductor-Co-Ltd-AMS1117-3-3_C347222.html | Package_TO_SOT_SMD:SOT-223-3_TabPin2
U9 | 1 | DNP | Module_mpu6050 |  | SensorModules:module_mpu6050
U10 | 1 | TTP223 | TTP223E-BA6 | https://www.lcsc.com/product-detail/Touch-Sensors_Tontek-Design-Tech-TTP223E-BA6_C129457.html | RP2040_minimal:TTP223
U11 | 1 | DF40C-100DS-0.4V | DF40C-100DS-0.4V(51) | https://www.lcsc.com/product-detail/Mezzanine-Connectors-Board-to-Board_HRS-Hirose-DF40C-100DS-0-4V-51_C597931.html | CM4_UnitA:DF40C-100DS-0.4V_CM4_Unit_A
U13 | 1 | 74LVC1G07SE-7 | 74LVC1G07SE-7 | https://www.digikey.com/en/products/detail/diodes-incorporated/74LVC1G07SE-7/2356534 | Package_TO_SOT_SMD:SOT-353_SC-70-5
U14,U15 | 2 | INMP441 | INMP441 | https://www.digikey.com/en/products/detail/tdk-invensense/INMP441ACEZ-R7/2793284 | Cam_Tracker_V3.1:INMP441
Y1,Y3 | 2 | CRYSTAL 12MHz | CF4012M00020001 | https://www.lcsc.com/product-detail/Crystals_huaxindianzi-CF4012M00020001_C7294551.html | Crystal:Crystal_SMD_3225-4Pin_3.2x2.5mm
Y2 | 1 | CRYSTAL 32.7680KHZ 12.5PF TH | CFS20632768DZFB | https://www.digikey.com/en/products/detail/citizen-finedevice-co-ltd/CFS-20632768DZFB/283736 | Crystal:Crystal_AT310_D3.0mm_L10.0mm_Horizontal
