ihsanakyrk/Eski-Versionlar-Ve-Siparisler/GSM_A7602E-H_Modul_V1.0/A7602E-H (GSM) Output/BOM/A7602E-H (GSM).xlsx

Id | Designator | Footprint | Quantity | Designation | Supplier and ref
1 | U1 | A7602EH | 1 | A7602E-H
2 | J4 | Castelled Pin Header 1x6 Ways 2.54 | 1 | DNP
3 | J1,J2,J3 | Castelled Pin Header 1x5 Ways 2.54 | 3 | DNP
