ihsanakyrk/Eski-Versionlar-Ve-Siparisler/Movita_3566_XV_Router_V3.2/Movita_3566_XV_Router_V3.2_Fabrication Outputs/BOM/Movita_3566_XV_Router_V3.2.xlsx

Reference | Qty | Value | MPN | Footprint
R204 | 1 | 0R | 0402WGF0000TCE | Resistor_SMD:R_0402_1005Metric
R5 | 1 | 0R |  | Resistor_SMD:R_0603_1608Metric
R29,R241,R242 | 3 | 0R | 0603WAF0000T5E | Resistor_SMD:R_0603_1608Metric
R131,R133,R134,R139,R216 | 5 | 0R | 0402WGF0000TCE | Resistor_SMD:R_0402_1005Metric
C35,C94,C166 | 3 | 10pF | CC0603JRNPO9BN100 | Capacitor_SMD:C_0603_1608Metric
C186,C188 | 2 | 15pF | 0402CG150J500NT | Capacitor_SMD:C_0402_1005Metric
C145,C146,C179 | 3 | 22pF | CL10C220JB8NNNC | Capacitor_SMD:C_0603_1608Metric
C14,C15 | 2 | 27pF | 0603CG270J500NT | Capacitor_SMD:C_0603_1608Metric
C39,C61 | 2 | 33pF | CL10C330JB8NNNC | Capacitor_SMD:C_0603_1608Metric
C163 | 1 | 100pF | 0603B101K500NT | Capacitor_SMD:C_0603_1608Metric
C165 | 1 | 220pF | CL10B221KB8NNNC | Capacitor_SMD:C_0603_1608Metric
C153 | 1 | 10nF | CC0603KRX7R9BB103 | Capacitor_SMD:C_0603_1608Metric
C185 | 1 | 10nF | CC0402KRX7R9BB103 | Capacitor_SMD:C_0402_1005Metric
C195,C198,C199 | 3 | 100nF | CC0402KRX7R7BB104 | Capacitor_SMD:C_0402_1005Metric
C1,C2,C3,C34,C36,C41,C55,C56,C57,C58,C59,C60,C147,C148,C150,C152,C156,C157,C158,C159,C160,C161,C162,C167,C168,C178,C182,C183,C208 | 29 | 100nF | 0603B104K500NT | Capacitor_SMD:C_0603_1608Metric
C197,C207,C210,C211 | 4 | 100nF | CC0402KRX7R7BB104 | Capacitor_SMD:C_0402_1005Metric
C8,C9,C11,C13,C16,C17,C20,C21,C22,C23,C24,C25,C26,C27,C38,C63,C64,C65,C66,C67,C68,C71,C72,C73,C75,C77,C95,C96,C97,C98,C111,C194,C200,C201,C202,C203 | 36 | 100nF | CC0402KRX7R7BB104 | Capacitor_SMD:C_0402_1005Metric
C171,C174 | 2 | 330nF | 0603B334K250NT | Capacitor_SMD:C_0603_1608Metric
C18,C19 | 2 | 1uF | CL10A105KB8NNNC | Capacitor_SMD:C_0603_1608Metric
C4,C6,C33,C149,C154,C191,C193,C196 | 8 | 4.7uF | CL10A475KO8NNNC | Capacitor_SMD:C_0603_1608Metric
C7,C10,C37,C151,C155,C192 | 6 | 10uF | CL10A106MO8NQNC | Capacitor_SMD:C_0603_1608Metric
C206 | 1 | 10uF | CL10A106MO8NQNC | Capacitor_SMD:C_0603_1608Metric
C74,C76,C99,C100 | 4 | 10uF | UWX1C100MCL2GB | Capacitor_SMD:C_Elec_3x5.4
C175,C176,C177 | 3 | 10uF | CL10A106MO8NQNC | Capacitor_SMD:C_0603_1608Metric
C62,C69,C180,C181 | 4 | 22uF | CL10A226MQ8NRNC | Capacitor_SMD:C_0603_1608Metric
C184 | 1 | 220uF | RVT220UF16V67RV0015 | Capacitor_SMD:CP_Elec_6.3x7.7
R15 | 1 | 1R | 0603WAF100KT5E | Resistor_SMD:R_0603_1608Metric
R30,R31 | 2 | 2.2R | 0402WGF220KTCE | Resistor_SMD:R_0402_1005Metric
R202,R203 | 2 | 10R | 0402WGF100JTCE | Resistor_SMD:R_0402_1005Metric
R142,R243,R244,R245,R246,R247,R248,R249 | 8 | 22R | 0603WAF220JT5E | Resistor_SMD:R_0603_1608Metric
R207,R208,R209,R210,R211,R212,R213 | 7 | 22R | 0402WGF220JTCE | Resistor_SMD:R_0402_1005Metric
R16,R17 | 2 | 27R | 0603WAF270JT5E | Resistor_SMD:R_0603_1608Metric
R237,R255,R267 | 3 | 33R | 0603WAF330JT5E | Resistor_SMD:R_0603_1608Metric
R73,R74,R75,R76,R102,R103 | 6 | 75R | 0603WAF750JT5E | Resistor_SMD:R_0603_1608Metric
R143 | 1 | 75R | 0402WGF750JTCE | Resistor_SMD:R_0402_1005Metric
R200 | 1 | 100R | 0603WAF1000T5E | Resistor_SMD:R_0603_1608Metric
R1 | 1 | 150R | 0603WAF1500T5E | Resistor_SMD:R_0603_1608Metric
R179 | 1 | 180R | 0603WAF1800T5E | Resistor_SMD:R_0603_1608Metric
R14 | 1 | 200R | 0603WAF2000T5E | Resistor_SMD:R_0603_1608Metric
R151,R152,R153 | 3 | 220R | 0603WAF2200T5E | Resistor_SMD:R_0603_1608Metric
R135 | 1 | 330R | 0603WAF3300T5E | Resistor_SMD:R_0603_1608Metric
R147,R148 | 2 | 470R | 0603WAF2200T5E | Resistor_SMD:R_0603_1608Metric
R157,R160 | 2 | 470R | 0603WAF4700T5E | Resistor_SMD:R_0603_1608Metric
R4 | 1 | 1K |  | Resistor_SMD:R_0603_1608Metric
R10,R13,R21,R23,R37,R39,R48,R72,R77,R78,R79,R80,R81,R82,R83,R84,R87,R88,R104,R105,R106,R107,R132,R145,R170,R172,R233,R238,R250,R251,R257,R268,R269 | 33 | 1K | 0603WAF1001T5E | Resistor_SMD:R_0603_1608Metric
R263 | 1 | 1K | 0402WGF1001TCE | Resistor_SMD:R_0402_1005Metric
R214 | 1 | 1.5K | 0402WGF1501TCE | Resistor_SMD:R_0402_1005Metric
R162 | 1 | 1.6K | 0603WAF1601T5E | Resistor_SMD:R_0603_1608Metric
R168,R178 | 2 | 2K | 0603WAF2001T5E | Resistor_SMD:R_0603_1608Metric
R140,R141,R228,R264 | 4 | 2.2K | 0603WAF2201T5E | Resistor_SMD:R_0603_1608Metric
R6,R8 | 2 | 2.49K | 0603WAF2491T5E | Resistor_SMD:R_0603_1608Metric
R206 | 1 | 2.49K | 0402WGF2491TCE | Resistor_SMD:R_0402_1005Metric
R156,R254 | 2 | 3.3K | 0603WAF3301T5E | Resistor_SMD:R_0603_1608Metric
R27,R28,R32,R33,R34 | 5 | 4.7K | 0603WAF4701T5E | Resistor_SMD:R_0603_1608Metric
R215,R217,R218,R219,R220,R221,R222,R223,R224,R227 | 10 | 4.7K | 0402WGF4701TCE | Resistor_SMD:R_0402_1005Metric
R149 | 1 | 7K |  | Resistor_SMD:R_0603_1608Metric
R49,R136,R137,R150,R155,R158,R159,R164,R169,R171,R235,R256,R266 | 13 | 10K | 0603WAF1002T5E | Resistor_SMD:R_0603_1608Metric
R130,R199,R201,R262 | 4 | 10K | RC0402FR-0710KL | Resistor_SMD:R_0402_1005Metric
R161 | 1 | 15K | 0603WAF1502T5E | Resistor_SMD:R_0603_1608Metric
R166 | 1 | 51K | 0603WAF5102T5E | Resistor_SMD:R_0603_1608Metric
R144,R252,R253 | 3 | 100K | 0603WAF1003T5E | Resistor_SMD:R_0603_1608Metric
R165 | 1 | 232K | FRC0603F2323TS | Resistor_SMD:R_0603_1608Metric
C92,C93 | 2 | 1000PF 2KV | Y5P102K2KV16CC0224 | Capacitor_THT:S102K33Y5PP63K5R
C209 | 1 | 100nF X7R 16V | CC0402KRX7R7BB104 | Capacitor_SMD:C_0402_1005Metric
C29,C30,C84,C169,C170,C172 | 6 | 1uF/50V | CL10A105KB8NNNC | Capacitor_SMD:C_0603_1608Metric
C28,C83 | 2 | 220uF/50V | RVT1H221M1010 | Capacitor_SMD:C_Elec_10x10.2
D1,D2,D4,D5,D7,D8,D9 | 7 | 2SS100L-W | 2SS100L-W | 2SS100L-W:2SS100LW
C32,C82 | 2 | 330uF/25V | RVT1E331M0810 | Capacitor_SMD:C_Elec_8x10.2
C140 | 1 | 5.5V 0.22F |  | Footprint Library:SuperCapacitor
J8 | 1 | APCI0079-P002A J8900 M.2 M Key | NGFF 67P连接器 M.2 SSD插槽 4+5 H3.2 | Library:APCI0079-P002A J8900 M.2 M Key
FL1 | 1 | APCW3216-900P2T | APCW3216-900P2T | DLW31SN900SQ2L:DLW31SH222SQ2L
L14 | 1 | AWL3225FP2R2MTF | AWL3225FP2R2MTF | Library:AWL3225FP2R2MTF
D31 | 1 | BAT54 | BAT54 | Package_TO_SOT_SMD:SOT-23
FL3,FL4 | 2 | BLM18PG121SN1D | BLM18PG121SN1D | BLM18PG121SN1D:BLM18AG102BH1D
U20 | 1 | BS-2 | MYOUNG BS-02-A1AJ010 | MYOUNG BS-02-A1AJ010:BS-02-A1AJ010
L15 | 1 | CBW160808U101T | CBW160808U101T | Inductor_SMD:L_0603_1608Metric
Y1 | 1 | CF4012M00020001 | CF4012M00020001 | Crystal:Crystal_SMD_3225-4Pin_3.2x2.5mm
U22 | 1 | CM3566 | CM3566 | Library:CM3566
Q9 | 1 | DMG1012T | DMG1012T | Package_TO_SOT_SMD:SOT-523
Q8 | 1 | DMG2305UX | DMG2305UX | Package_TO_SOT_SMD:SOT-23
C70,C78,C79,C80,C81,C85,C86,C87,C88,C89,C90,C91,C187,C189,C190 | 15 | DNP |  | Capacitor_SMD:C_0402_1005Metric
C164 | 1 | DNP |  | Capacitor_SMD:C_0603_1608Metric
FID1,FID2,FID5,FID6,FID7,FID8,FID9,FID10,FID11,FID12 | 10 | DNP |  | Fiducial:Fiducial_0.5mm_Mask1mm
J2 | 1 | DNP | 莲花座AV1-8.4-5A 黑色 | Footprint Library:AV_CON
J25 | 1 | DNP |  | Connector_PinHeader_2.54mm:PinHeader_2x02_P2.54mm_Vertical_SMD
J30 | 1 | DNP | SMTSO-M3-6ET | Footprint:Screw Terminal Shinbo
J34 | 1 | DNP | 1*3p 2.54 贴片排母 | Connector_PinSocket_2.54mm:PinSocket_1x03_P2.54mm_Vertical_SMD_Pin1Left
J37 | 1 | DNP | USB3.0 侧插 | footprint:CP-USB-3015
J40 | 1 | DNP |  | Connector_PinSocket_2.00mm:PinSocket_1x04_P2.00mm_Vertical
J41 | 1 | DNP |  | Connector_PinSocket_2.00mm:PinSocket_1x02_P2.00mm_Vertical
R12,R22,R24,R26,R38,R42,R47,R55,R58,R59,R60,R61,R62,R63,R64,R65,R66,R67,R68,R69,R70,R71,R85,R86,R89,R90,R91,R92,R93,R94,R95,R96,R97,R98,R99,R100,R101,R163,R167,R173,R174,R175,R176,R177,R240,R258,R259,R260,R261,R265 | 50 | DNP |  | Resistor_SMD:R_0603_1608Metric
R129,R138,R205,R225,R226 | 5 | DNP |  | Resistor_SMD:R_0402_1005Metric
TP2,TP21,TP22,TP23,TP24 | 5 | DNP |  | Connector_Pin:Pin_D1.0mm_L10.0mm
TP9,TP11,TP12,TP25,TP26,TP27 | 6 | DNP |  | TestPoint:TestPoint_Pad_1.0x1.0mm
U11 | 1 | DNP |  | SensorModules:module_mpu6050
J32 | 1 | DNP |  | Connector_PinHeader_2.54mm:PinHeader_1x02_P2.54mm_Vertical
Q1 | 1 | DTC043ZEBTL | DTC043ZEBTL | Package_TO_SOT_SMD:SOT-416
C5 | 1 | ERZ-V14D101 | ERZ-V14D101 | Footprint Library:ERZV14D101
D6,D12,D13,D30,D32 | 5 | ESD5341N | ESD5341N | Footprint Library:ESD5341N
ED1,ED2,ED3,ED4,ED5,ED6,ED7 | 7 | ESD5341N | ESD5341N | Footprint Library:ESD5341N
D22 | 1 | ESD5451N | ESD5451N | ESD5451N:ESD5451N
L8 | 1 | HA42-4R7MT | HA42-4R7MT | Pro V3:Inductor_0402_4.7uH
K1,K3 | 2 | HF46F_5-HS1 | HF46F_5-HS1 | Footprint Library:HF46F5HS1
L2,L3 | 2 | HX CYA1050-47UH | HX CYA1050-47UH | CYA1050-47UH:L_Bourns_SRR1208_12.7x12.7mm
J3 | 1 | JST_PH_B4B-PH-K_1x04_P2.00mm_Vertical |  | Connector_JST:JST_PH_B4B-PH-K_1x04_P2.00mm_Vertical
J4 | 1 | JST_PH_B5B-PH-K_1x05_P2.00mm_Vertical |  | Connector_JST:JST_PH_B5B-PH-K_1x05_P2.00mm_Vertical
J1 | 1 | KF2EDGH-3.81-2P- Vertical |  | Library:KF2EDGH-3.81-2P-Vertical
J7 | 1 | KF2EDGH-3.81-2P- Right Angle | KF2EDGV-3.81 2p 直针 | KF2EDGH:KF2EDGH-3.81-2P
J12 | 1 | KF2EDGH-3.81_8P-Right Angle | 15EDGK-3.81 双层 2*4p | KF2EDGH:KF2EDGH-3.81_8P
J11 | 1 | KF2EDGR-Y-5.08-3P-Right Angle | KF2EDG -3P 5.08 封口 弯 | KF2EDGH:KF2EDGR-Y-5.08-3P-Right Angle
J15,J16 | 2 | LED_4_Block_Right Angle | 3mm四孔灯座带灯 | LED_4:LED_4_Block
D25 | 1 | LED_GREEN | 0603 翠绿色 LED | LED_SMD:LED_0603_1608Metric
D23,D24 | 2 | LL4148 | LL4148 | Pro V3:LL4148
J35 | 1 | M3x*0.5 L=3 | SMTSO-M3-3ET | Footprint:Screw Terminal Shinbo
J23,J28 | 2 | M3x*0.5 L=6 | SMTSO-M3-6ET | Footprint:Screw Terminal Shinbo
J13 | 1 | MALE SMD Pin Header | 2.0mm 2*5p 贴片排针 | Connector_PinSocket_2.00mm:PinSocket_2x05_P2.00mm_Vertical_SMD
J43 | 1 | MALE Through Hole Pin Header | 1*3p 2.0 排针 | Connector_PinHeader_2.00mm:PinHeader_1x03_P2.00mm_Vertical
L7 | 1 | MLI1608F-1R2KT | MLI1608F-1R2KT | Inductor_SMD:L_0603_1608Metric
Q2,Q3,Q4,Q5,Q6 | 5 | MMBT2222ALT1G | MMBT2222A | HDMI 2.0 TX:MMBT2222ALT1G
D26,D27 | 2 | MRA4007T3G | MRA4007T3G | Library:MRA4007T3G
IC2 | 1 | MS1836S_QFN48-7x7 | MS1836S | Package_DFN_QFN:QFN-48-1EP_7x7mm_P0.5mm_EP5.6x5.6mm
U24,U25,U26 | 3 | PC817C | PC817C_4PIN_SMD | HDMI 2.0 TX:PC817
J5 | 1 | RJ45 | 黑色 RJ45 8P | Connector_RJ:RJ45_Amphenol_54602-x08_Horizontal
U18 | 1 | RJ45-2-Block | RJ45 56 1*2 带灯 | Connector_RJ:2_Block_RJ45
U17 | 1 | RJ45-4-Block | RJ45 56 1*4 带灯 | Library:4_Block_RJ45
U5 | 1 | RP2040 | RP2040 | RP2040_minimal:RP2040-QFN-56
U14 | 1 | RT9013-12GB | RT9013-12GB | Package_TO_SOT_SMD:SOT-23-5
J9 | 1 | RTL8188EU | RTL8188EUS 模块 | RTL8188EU:RTL8188EU
U23 | 1 | RTL8211F-CG | RTL8211F-CG | Library:RTL8211F-CG
IC3 | 1 | RTL8309N | RTL8309N-VB-CG | RTL8309N:RTL8309N
D28,D29 | 2 | S6MC | S6MC | Diode_SMD:S6MC
U16 | 1 | SAF-8ASC-2132M | SAF-8ASC-2132M | SATA_Connector:SATA_Connector_5622-1200-ML
L9 | 1 | SDCL1608C2N7STDF | SDCL1608C2N7STDF | Inductor_SMD:L_0603_1608Metric
J10 | 1 | SMA Connetor_inner_pin | SMA-KWE 内针 | Connector_Coaxial:SMA_Connector_inner_pin_right_angle
D3 | 1 | SS14 | SS14 SOD-123FL | SS14:DIOM4325X250N
D10,D11 | 2 | SS54B | SS54B | Library:SS54B
IC5 | 1 | SY8113B | SY8113BADC | Library:SY8113B
Y2 | 1 | TAXM27M4RFBCCT2T | TAXM27M4RFBCCT2T | Crystal:Crystal_SMD_3225-4Pin_3.2x2.5mm
U12,U13,U19 | 3 | TF-218DG | TF-218DG | Transformer_THT:RJ45_Transformer_2_Port
J24 | 1 | TF-CARD H1.8 | TF 卡座 铜壳 | HDMI 2.0 TX:TF-CARD H1.8
U2,U3 | 2 | TLV76033DBZT | TLV76033DBZT | Package_TO_SOT_SMD:SOT-23
S1 | 1 | TS-1101-C-W | 6*3.6*2.5mm 立贴 轻触开关 | Library:TS-1101-C-W
L6 | 1 | UPZ1608E101-3R0TF | UPZ1608E101-3R0TF | Inductor_SMD:L_0603_1608Metric
U7 | 1 | W25Q128JVSIQ | W25Q128JVSIQ | Package_SO:SOIC-8_5.23x5.23mm_P1.27mm
Y3,Y4 | 2 | X322525MSB4SI | X322525MSB4SI | Crystal:Crystal_SMD_3225-4Pin_3.2x2.5mm
U10,U15 | 2 | XL4015 | XL4015 | Package_TO_SOT_SMD:TO-263-5_TabPin3
FB1 | 1 | YI321611U101-4R0T | YI321611U101-4R0T | HI1206N101R-10:BEADC3216X130N
