ihsanakyrk/Eski-Versionlar-Ve-Siparisler/Movita_3568_AXV_Router_V3.0/MXVR_3568_V3.0_Fabrication_Outputs/BOM/MNVR_3.0_.xlsx

Reference | Qty | Value | MPN | Footprint | Important
C1,C2,C3,C31,C34,C40,C41,C42,C43,C44,C45,C46,C47,C48,C49,C50,C51,C52,C54,C55,C56,C57,C58,C59,C60,C101,C102,C103,C104,C105,C106,C107,C108,C109,C110,C116,C117,C118,C119,C120,C121,C124,C125,C126,C127,C143,C144,C147,C148,C150,C152,C156,C157,C158,C159,C160,C161,C162,C167,C168,C182,C183,C199,C200 | 64 | 0.1uF |  | Capacitor_SMD:C_0603_1608Metric
C4,C6,C12,C33,C149,C154 | 6 | 4.7uF | CL10A475KO8NNNC | Capacitor_SMD:C_0603_1608Metric
C5 | 1 | DNP |  | RP2040_minimal:FYD0H473ZF
C7,C10,C37,C70,C151,C155,C175,C176,C177 | 9 | 10uF | CL10A106MO8NQNC | Capacitor_SMD:C_0603_1608Metric
C8,C9,C11,C13,C16,C17,C20,C21,C22,C23,C24,C25,C26,C27 | 14 | 100nF | CC0402KRX7R7BB104 | Capacitor_SMD:C_0402_1005Metric
C14,C15 | 2 | 27pF | 0603CG270J500NT | Capacitor_SMD:C_0603_1608Metric
C18,C19,C29,C30,C53,C84,C128,C139,C140,C169,C170,C172 | 12 | 1uF | CL10A105KB8NNNC | Capacitor_SMD:C_0603_1608Metric
C28,C83 | 2 | 220uF | RVT1H221M1010 | Capacitor_SMD:C_Elec_10x10.2
C32,C82 | 2 | 330uF | RVT1E331M0810 | Capacitor_SMD:C_Elec_8x10.2
C35,C94,C166 | 3 | 10pF | CC0603JRNPO9BN100 | Capacitor_SMD:C_0603_1608Metric
C36,C111,C178 | 3 | 100nF | 0603B104K500NT | Capacitor_SMD:C_0603_1608Metric
C38,C63,C64,C66,C68,C71,C72,C73,C74,C75,C76,C77,C95,C96,C97,C98,C99 | 17 | 0.1uF |  | Capacitor_SMD:C_0402_1005Metric
C39,C61,C62,C65 | 4 | 10uF | UWX1C100MCL2GB | Capacitor_SMD:C_Elec_3x5.4
C67,C69,C180,C181 | 4 | 22uF | CL10A226MQ8NRNC | Capacitor_SMD:C_0603_1608Metric
C92,C93 | 2 | 1000PF 2KV | Y5P102K2KV16CC0224 | Capacitor_THT:S102K33Y5PP63K5R
C100,C173 | 2 | 33pF | CL10C330JB8NNNC | Capacitor_SMD:C_0603_1608Metric
C112,C113,C129,C130,C131,C132,C133,C134,C135,C136,C137,C138,C141,C142 | 14 | 10uF | CL05A106MQ5NUNC | Capacitor_SMD:C_0402_1005Metric
C114,C115 | 2 | 4.7uF | CL05A475KP5NRNC | Capacitor_SMD:C_0402_1005Metric
C122,C123 | 2 | 8pF | 0603CG8R0C500NT | Capacitor_SMD:C_0603_1608Metric
C145,C146,C179 | 3 | 22pF | CL10C220JB8NNNC | Capacitor_SMD:C_0603_1608Metric
C153,C195,C196,C197,C198 | 5 | 10nF | CL10C220JB8NNNC | Capacitor_SMD:C_0603_1608Metric
C163 | 1 | 100pF | 0603B101K500NT | Capacitor_SMD:C_0603_1608Metric
C164 | 1 | DNP |  | Capacitor_SMD:C_0603_1608Metric
C165 | 1 | 220pF | CL10B221KB8NNNC | Capacitor_SMD:C_0603_1608Metric
C171,C174 | 2 | 0.33uF |  | Capacitor_SMD:C_0603_1608Metric
C184 | 1 | 220uF | RVT220UF16V67RV0015 | Capacitor_SMD:CP_Elec_6.3x7.7
C185 | 1 | 10uF | CL10A106MO8NQNC | Capacitor_SMD:C_0603_1608Metric
C186 | 1 | 100nF | CC0402KRX7R7BB104 | Capacitor_SMD:C_0402_1005Metric
D1,D2,D5,D7,D8,D9 | 6 | 2SS100L-W | 2SS100L-W | Footprint:2SS100LW
D3 | 1 | SS14 | SS14 SOD-123FL | SS14:DIOM4325X250N
D4 | 1 | 2SS100L-W | 2SS100L-W | 2SS100L-W:2SS100LW
D6,D12,D13,D30 | 4 | ESD5341N | ESD5341N | ESD5341N:ESD5341N
D10,D11 | 2 | SS54B | SS54B | Library:SS54B
D14,D15,D16,D17,D34 | 5 | B5819W | B5819W | Footprint:D_SOD-123
D18,D19,D20,D21 | 4 | SMAJ30CA | SMAJ30CA | Diode_SMD:D_SMA
D22 | 1 | ESD5451N | ESD5451N | Footprint:ESD5451N
D23,D24 | 2 | LL4148 | LL4148 | Pro V3:LL4148
D25 | 1 | LED | 0603 翠绿色 LED | LED_SMD:LED_0603_1608Metric
D26,D27 | 2 | MRA4007T3G | MRA4007T3G | Library:MRA4007T3G
D28,D29 | 2 | S6MC | S6MC | Diode_SMD:S6MC
D31,D32 | 2 | LED |  | LED_SMD:LED_0402_1005Metric
D33 | 1 | BAT54 | BAT54 | Package_TO_SOT_SMD:SOT-23
ED1,ED2,ED3,ED4,ED5,ED6,ED7 | 7 | ESD5341N | ESD5341N | Footprint:ESD5341N
FB1 | 1 | HI1206N101R-10 | HI1206N101R-10 | HI1206N101R-10:BEADC3216X130N
FID1,FID2,FID5,FID6,FID9,FID10,FID13,FID14,FID17,FID18,FID19,FID20 | 12 | DNP |  | Fiducial:Fiducial_0.5mm_Mask1mm
FL1 | 1 | APV APCW3216-900P2T | APV APCW3216-900P2T | DLW31SN900SQ2L:DLW31SH222SQ2L
FL3,FL4 | 2 | BLM18PG121SN1D | BLM18PG121SN1D | Footprint:BLM18PG121SN1D
IC1 | 1 | SN74LVC125APWR | SN74LVC125APWR | SN74LVC125APWR:SN74LVC125APWR
IC2 | 1 | MS1836S_QFN48-7x7 | MS1836S_QFN48-7x7 | Package_DFN_QFN:QFN-48-1EP_7x7mm_P0.5mm_EP5.6x5.6mm
IC3 | 1 | RTL8309N | RTL8309N-VB-CG | RTL8309N:RTL8309N
IC5 | 1 | SY8113B | SY8113B | Library:SY8113B
J1 | 1 | JST_PH_B4B-PH-K_1x04_P2.00mm_Vertical | JST_PH_B4B-PH-K_1x04_P2.00mm_Vertical | Connector_JST:JST_PH_B4B-PH-K_1x04_P2.00mm_Vertical
J2,J18,J19,J20,J26 | 5 | DNP |  | AV_CONNECTOR:AV_CON | Will not be assembled. It will be sent separately by ship.
J3,J22 | 2 | DNP |  | Connector_PinHeader_2.00mm:PinHeader_1x03_P2.00mm_Vertical
J4 | 1 | JST_PH_B5B-PH-K_1x05_P2.00mm_Vertical | JST_PH_B5B-PH-K_1x05_P2.00mm_Vertical | Connector_JST:JST_PH_B5B-PH-K_1x05_P2.00mm_Vertical
J5 | 1 | RJ45 | 黑色 RJ45 8P | Connector_RJ:RJ45_Amphenol_54602-x08_Horizontal
J6 | 1 | TF-CARD H1.8 | TF 卡座 铜壳 | Footprint:TF-CARD H1.8
J7 | 1 | KF2EDGH-3.81-2P- Right Angle | KF2EDGV-3.81 2p 直针 | KF2EDGH:KF2EDGH-3.81-2P
J8 | 1 | APCI0079-P002A J8900 M.2 M Key | APCI0079-P002A J8900 M.2 M Key | Library:APCI0079-P002A J8900 M.2 M Key
J9 | 1 | RTL8188EU | RTL8188EUS 模块 | RTL8188EU:RTL8188EU
J10 | 1 | SMA Connetor_inner_pin | SMA-KWE 内针 | Connector_Coaxial:SMA_Connector_inner_pin_right_angle
J11 | 1 | KF2EDGR-Y-5.08-3P-Right Angle | KF2EDG -3P 5.08 封口 弯 | Footprint:KF2EDGR-Y-5.08-3P-Right Angle
J12 | 1 | KF2EDGH-3.81_8P-Right Angle | 15EDGK-3.81 双层 2*4p | KF2EDGH:KF2EDGH-3.81_8P
J13 | 1 | MALE SMD Pin Header | 2.0mm 2*5p 贴片排针 | Connector_PinSocket_2.00mm:PinSocket_2x05_P2.00mm_Vertical_SMD
J14 | 1 | SHOU HAN MICRO XNJ ZB | SHOU HAN MICRO XNJ ZB | footprint:Micro-B SMD
J15,J16 | 2 | LED_4_Block | 3mm四孔灯座带灯 | LED_4:LED_4_Block
J17 | 1 | JST_PH_B2B-PH-K_1x02_P2.00mm_Vertical | PH2.0 2P 直针 | Connector_JST:JST_PH_B2B-PH-K_1x02_P2.00mm_Vertical
J23,J28 | 2 | M3x*0.5 L=8 | SMTSO-M3-8ET | Footprint:Screw Terminal Shinbo
J24 | 1 | USB 3.0 AF | USB3.0 侧插 | Connector_USB:CP-USB-3015
J25 | 1 | DNP |  | Connector_PinHeader_2.00mm:PinHeader_1x04_P2.00mm_Vertical
J27 | 1 | DNP |  | Connector_PinHeader_2.00mm:PinHeader_1x10_P2.00mm_Vertical
J29,J30 | 2 | M3x*0.5 L=6 | SMTSO-M3-6ET | Footprint:Screw Terminal Shinbo
J32 | 1 | DNP |  | Connector_PinHeader_2.54mm:PinHeader_1x02_P2.54mm_Vertical
J34 | 1 | FEMALE SMD Pin Header | 1*3p 2.54 贴片排母 | Connector_PinSocket_2.54mm:PinSocket_1x03_P2.54mm_Vertical
J35 | 1 | M3x*0.5 L=3 | SMTSO-M3-3ET | Footprint:Screw Terminal Shinbo
J36 | 1 | JST_PH_B2B-PH-K_1x03_P2.00mm_Vertical | JST_PH_B2B-PH-K_1x03_P2.00mm_Vertical | Connector_JST:JST_PH_B3B-PH-K_1x03_P2.00mm_Vertical
J41 | 1 | DNP |  | Connector_PinSocket_2.54mm:PinSocket_1x02_P2.54mm_Vertical_SMD_Pin1Left
K1,K3 | 2 | HF46F_5-HS1 | HF46F_5-HS1 | HF46F_5-HS1:HF46F5HS1
L1 | 1 | 100ohm@100MHZ | CBW160808U101T | Inductor_SMD:L_0603_1608Metric
L2,L3 | 2 | FXL1040-470-M | HX CYA1050-47UH | CYA1050-47UH:L_Bourns_SRR1208_12.7x12.7mm
L4,L5 | 2 | FB/100R | CBW160808U101T | Inductor_SMD:L_0603_1608Metric
L6 | 1 | UPZ1608E101-3R0TF | UPZ1608E101-3R0TF | Inductor_SMD:L_0603_1608Metric
L7 | 1 | MLI1608F-1R2KT | MLI1608F-1R2KT | Inductor_SMD:L_0603_1608Metric
L8 | 1 | HA42-4R7MT | HA42-4R7MT | Pro V3:Inductor_0402_4.7uH
L9 | 1 | 2.7nH | SDCL1608C2N7STDF | Inductor_SMD:L_0603_1608Metric
PS2 | 1 | RT9013-33GB | RT9013-33GB | RT9013-33gb:SOT94P279X130-5N
PS3 | 1 | RT9013-12GB | RT9013-12GB | Package_TO_SOT_SMD:SOT-23-5
Q2,Q3,Q4,Q5,Q6 | 5 | MMBT2222ALT1G | MMBT2222A | Pro V3:MMBT2222ALT1G
Q7 | 1 | DMG2305UX | DMG2305UX | Package_TO_SOT_SMD:SOT-23
Q8 | 1 | DMG1012T | DMG1012T | Package_TO_SOT_SMD:SOT-523
R1 | 1 | 150R | 0603WAF1500T5E | Resistor_SMD:R_0603_1608Metric
R2,R3,R46,R54,R58,R62,R109,R113,R123,R126,R127,R175 | 12 | 0R | 0603WAF0000T5E | Resistor_SMD:R_0603_1608Metric
R4,R5,R7,R9,R11,R13,R25,R45,R142,R196 | 10 | 22R | 0603WAF220JT5E | Resistor_SMD:R_0603_1608Metric
R6 | 1 | 2.49K | 0603WAF2491T5E | Resistor_SMD:R_0603_1608Metric
R8,R18,R19,R20,R35,R36,R40,R41,R43,R44,R49,R64,R99,R119,R122,R124,R136,R137,R155,R158,R159,R164,R169,R171,R193,R194,R199 | 27 | 10K | 0603WAF1002T5E | Resistor_SMD:R_0603_1608Metric
R10,R21,R23,R37,R39,R48,R67,R72,R77,R78,R79,R80,R81,R82,R83,R84,R87,R88,R101,R104,R105,R106,R107,R132,R145,R170,R172,R184,R186,R200 | 30 | 1K | 0603WAF1001T5E | Resistor_SMD:R_0603_1608Metric
R12,R22,R24,R26,R29,R38,R42,R47,R50,R53,R85,R86,R89,R90,R91,R92,R93,R108,R154,R163,R167,R173,R174,R176,R182,R183,R185,R187,R190 | 29 | DNP |  | Resistor_SMD:R_0603_1608Metric
R14 | 1 | 200R | 0603WAF2000T5E | Resistor_SMD:R_0603_1608Metric
R15 | 1 | 1R | 0603WAF100KT5E | Resistor_SMD:R_0603_1608Metric
R16,R17 | 2 | 27R | 0603WAF270JT5E | Resistor_SMD:R_0603_1608Metric
R27,R28,R32,R33,R34,R117,R118,R120 | 8 | 4.7K | 0603WAF270JT5E | Resistor_SMD:R_0603_1608Metric
R30,R31 | 2 | 2.2R | 0402WGF220KTCE | Resistor_SMD:R_0402_1005Metric
R51,R52,R56,R57,R73,R74,R75,R76,R102,R103,R110,R111,R114,R115 | 14 | 75R | 0603WAF750JT5E | Resistor_SMD:R_0603_1608Metric
R55,R98,R156,R197 | 4 | 3.3K | 0603WAF3301T5E | Resistor_SMD:R_0603_1608Metric
R59,R60,R61,R63,R65,R68,R69,R70,R71,R94,R95,R112 | 12 | DNP |  | Resistor_SMD:R_0201_0603Metric
R66,R100,R198 | 3 | 33R | 0603WAF330JT5E | Resistor_SMD:R_0603_1608Metric
R96,R97 | 2 | 10R | 0402WGF100JTCE | Resistor_SMD:R_0402_1005Metric
R121,R129,R138 | 3 | DNP |  | Resistor_SMD:R_0402_1005Metric
R125,R146,R180,R181 | 4 | 100R | 0603WAF1000T5E | Resistor_SMD:R_0603_1608Metric
R128 | 1 | 560K | 0603WAF5603T5E | Resistor_SMD:R_0603_1608Metric
R130 | 1 | 10K | RC0402FR-0710KL | Resistor_SMD:R_0402_1005Metric
R131,R133,R134,R139 | 4 | 0R |  | Resistor_SMD:R_0402_1005Metric
R135 | 1 | 330R | 0603WAF3300T5E | Resistor_SMD:R_0603_1608Metric
R140,R141 | 2 | 2.2K | 0603WAF2201T5E | Resistor_SMD:R_0603_1608Metric
R143 | 1 | 75R | 0603WAF750JT5E | Resistor_SMD:R_0402_1005Metric
R144,R188,R189 | 3 | 100K | 0603WAF1003T5E | Resistor_SMD:R_0603_1608Metric
R147,R148,R149,R150,R151,R152,R153,R209 | 8 | 220R | 0603WAF2200T5E | Resistor_SMD:R_0603_1608Metric
R157,R160 | 2 | 470R | 0603WAF4700T5E | Resistor_SMD:R_0603_1608Metric
R161 | 1 | 15K | 0603WAF1502T5E | Resistor_SMD:R_0603_1608Metric
R162 | 1 | 1.6K | 0603WAF1601T5E | Resistor_SMD:R_0603_1608Metric
R165 | 1 | 232K | FRC0603F2323TS | Resistor_SMD:R_0603_1608Metric
R166 | 1 | 51K | 0603WAF5102T5E | Resistor_SMD:R_0603_1608Metric
R168 | 1 | 2K | 0603WAF2001T5E | Resistor_SMD:R_0603_1608Metric
R178 | 1 | 1.5K | 0603WAF1501T5E | Resistor_SMD:R_0603_1608Metric
R179 | 1 | 180R | 0603WAF1800T5E | Resistor_SMD:R_0603_1608Metric
S1 | 1 | TS-1101-C-W | 6*3.6*2.5mm 立贴 轻触开关 | Button_Switch_SMD:TS-1101-C-W
TP1,TP2,TP3,TP4,TP5,TP6,TP7,TP8,TP10,TP11,TP12,TP13,TP14,TP15,TP16,TP17,TP18,TP19,TP20,TP22,TP23,TP24,TP25 | 23 | DNP |  | TestPoint:TestPoint_Pad_1.0x1.0mm
U1 | 1 | CM3568 | CM3568 | Rockchip:CM3568
U2,U21 | 2 | TLV76033DBZT | TLV76033DBZT | Package_TO_SOT_SMD:SOT-23
U3,U22,U25 | 3 | PC817C | PC817C_4PIN_SMD | Footprint:PC817
U4 | 1 | X322527MSB4SI | X322527MSB4SI | Crystal:Crystal_SMD_3225-4Pin_3.2x2.5mm
U5 | 1 | RP2040 | RP2040 | RP2040_minimal:RP2040-QFN-56
U6 | 1 | MAX485E | MAX485ESA | MAX485ESA_T:SOIC127P600X175-8N
U6B1 | 1 | Nextchip N4 | Nextchip N4 | Nextchip_N4:N4
U7 | 1 | W25Q128JVS | W25Q128JVSIQ | Package_SO:SOIC-8_5.23x5.23mm_P1.27mm
U8 | 1 | NL27WZU04DTT1G | NL27WZU04DTT1G | NL27WZU04DTT1G:SOP95P275X110-6N
U9,U23 | 2 | ESD5344D | ESD5344D | HDMI 2.0 TX:ESD5344D
U10,U15 | 2 | XL4015 | XL4015 | Package_TO_SOT_SMD:TO-263-5_TabPin3
U11 | 1 | DNP |  | SensorModules:module_mpu6050
U12,U13,U19 | 3 | TF-218DG | TF-218DG | Transformer_THT:RJ45_Transformer_2_Port
U14 | 1 | RT9013-12GB | RT9013-12GB | Package_TO_SOT_SMD:SOT-23-5
U16 | 1 | SAF-8ASC-2132M | SAF-8ASC-2132M | Footprint:SATA_Connector_5622-1200-ML
U17 | 1 | RJ45-4-Block | RJ45 56 1*4 带灯 | Library:4_Block_RJ45
U18 | 1 | RJ45-2-Block | RJ45 56 1*2 带灯 | Connector_RJ:2_Block_RJ45
U20 | 1 | MYOUNG BS-12-B3AA003 | MYOUNG BS-12-B3AA003 | footprint:BS-12-B3AA003
U24 | 1 | DNP |  | HDMI 2.0 TX:HDMI 19PIN | Will not be assembled. It will be sent separately by ship.
Y1 | 1 | X322512MSB4SI | X322512MSB4SI | Crystal:Crystal_SMD_3225-4Pin_3.2x2.5mm
Y2 | 1 | X322527MSB4SI | X322527MSB4SI | Crystal:Crystal_SMD_3225-4Pin_3.2x2.5mm
Y3 | 1 | X322525MSB4SI | X322525MSB4SI | Crystal:Crystal_SMD_3225-4Pin_3.2x2.5mm
