ihsanakyrk/Eski-Versionlar-Ve-Siparisler/Movita_CM4_CT_Router_V3.1/Movita_CM4_CT_Router_V3.1_Fabrication_Outputs/BOM/Movita_CM4_CT_Router_V3.1.xlsx

Reference | Qty | Value | MPN | Footprint
C1 | 1 | SE-5R5 D224VYV (C-Type) |  | Footprint Library:SuperCapacitor
C2 | 1 | 10u |  | Capacitor_SMD:C_0805_2012Metric
C4 | 1 | 22pF |  | Capacitor_SMD:C_0603_1608Metric
C6,C35 | 2 | 100nF |  | Capacitor_SMD:C_0603_1608Metric
C7,C8,C9,C10,C34 | 5 | 10uF |  | Capacitor_SMD:C_0603_1608Metric
C14,C15 | 2 | 27pF |  | Capacitor_SMD:C_0402_1005Metric
C16,C17,C20,C21,C22,C23,C24,C25,C26,C27 | 10 | 100nF |  | Capacitor_SMD:C_0402_1005Metric
C18,C19 | 2 | 1uF |  | Capacitor_SMD:C_0402_1005Metric
C28,C29 | 2 | 0.01uF |  | Capacitor_SMD:C_0603_1608Metric
C30 | 1 | 1000pF |  | Capacitor_SMD:C_0603_1608Metric
C36 | 1 | 150pF |  | Capacitor_SMD:C_0603_1608Metric
C41 | 1 | 100uF |  | Footprint Library:CAPAE660X550N
D1 | 1 | LED Green | SZYY0603YG | LED_SMD:LED_0603_1608Metric
D2 | 1 | LED Red | D-060306R1/SS2/L | LED_SMD:LED_0603_1608Metric
D4 | 1 | 2SS100L-W | 2SS100L-W | Footprint Library:2SS100LW
D5 | 1 | SS34FA | SS34FA | Footprint Library:SS34FA
D6 | 1 | SS14 | SS14 | Footprint Library:SS14
IC3 | 1 | MP1584EN | MP1584EN | Footprint Library:MP1584N
J1 | 1 | JST_PH_S4B-PH-SM4-TB_1x04-1MP_P2.00mm_Horizontal_Right Angle |  | Connector_JST:JST_PH_S4B-PH-SM4-TB_1x04-1MP_P2.00mm_Horizontal
J2 | 1 | Micro_SD_Card_Det |  | Footprint Library:SDCARD_MOLEX_503398-1892
J4 | 1 | JST_PH_B5B-PH-K_1x05_P2.00mm_Vertical |  | Connector_JST:JST_PH_B5B-PH-K_1x05_P2.00mm_Vertical
J9 | 1 | JST_1x15-1MP_P1.25mm_Vertical |  | Footprint Library:JST_1x8-1MP_P1.25mm_Horizontal
J100,J101 | 2 | JST_1x15-1MP_P1.25mm_Vertical |  | Cam_Tracker_V3.1:JST_1x15-1MP_P1.25mm_Horizontal
L2 | 1 | CDRH74NP-100MC-B | CDRH74NP-100MC-B | Footprint Library:CDRH74NP100MCB
P1 | 1 | TYPE-C 6P(073) |  | Footprint Library:TYPE-C 6P(073)
R1,R6,R8,R11,R18,R20,R24,R64 | 8 | 0R |  | Resistor_SMD:R_0603_1608Metric
R2 | 1 | 150R |  | Resistor_SMD:R_0603_1608Metric
R3,R4 | 2 | 4.7K |  | Resistor_SMD:R_0603_1608Metric
R5,R9,R19,R22,R23,R25,R65 | 7 | DNP |  | Resistor_SMD:R_0603_1608Metric
R7,R10 | 2 | DNP |  | Resistor_SMD:R_0402_1005Metric
R12 | 1 | 12K 1% |  | Resistor_SMD:R_0402_1005Metric
R13,R21,R48 | 3 | 1K |  | Resistor_SMD:R_0603_1608Metric
R14 | 1 | 200R |  | Resistor_SMD:R_0603_1608Metric
R15 | 1 | 1R |  | Resistor_SMD:R_0603_1608Metric
R16,R17 | 2 | 27R |  | Resistor_SMD:R_0603_1608Metric
R40,R41 | 2 | 75R |  | Resistor_SMD:R_0603_1608Metric
R49 | 1 | 10K |  | Resistor_SMD:R_0603_1608Metric
R55,R58 | 2 | 2.2K 1% |  | Resistor_SMD:R_0402_1005Metric
R62,R73 | 2 | 1K |  | Resistor_SMD:R_0402_1005Metric
R75 | 1 | 2.2K |  | Resistor_SMD:R_0603_1608Metric
R76,R78 | 2 | 100K |  | Resistor_SMD:R_0603_1608Metric
R77 | 1 | 200K |  | Resistor_SMD:R_0603_1608Metric
R79 | 1 | 40.2K |  | Resistor_SMD:R_0603_1608Metric
R80 | 1 | 210K |  | Resistor_SMD:R_0603_1608Metric
T1 | 1 | H1102NL | H1102NLT | H1102NL:H1102NL
U1 | 1 | DF40C-100DS-0.4V | DF40C-100DS-0.4V(51) | CM4_UnitB:DF40C-100DS-0.4V_CM4_Unit_B
U2,U3 | 2 | TLV76033DBZT | TLV76033DBZT | Package_TO_SOT_SMD:SOT-23
U4 | 1 | RT9742GGJ5 |  | Package_TO_SOT_SMD:SOT-23-5
U5 | 1 | RP2040 | RP2040 | RP2040_minimal:RP2040-QFN-56
U6 | 1 | PCF8563T | PCF8563T/5,518 | Package_SO:SOIC-8_3.9x4.9mm_P1.27mm
U7 | 1 | W25Q128JVS | W25Q128JVSIQ | Package_SO:SOIC-8_5.23x5.23mm_P1.27mm
U11 | 1 | DF40C-100DS-0.4V | DF40C-100DS-0.4V(51) | CM4_UnitA:DF40C-100DS-0.4V_CM4_Unit_A
U13 | 1 | 74LVC1G07SE-7 | 74LVC1G07SE-7 | Package_TO_SOT_SMD:SOT-353_SC-70-5
Y1 | 1 | CRYSTAL 12MHz | CF4012M00020001 | Crystal:Crystal_SMD_3225-4Pin_3.2x2.5mm
Y2 | 1 | CRYSTAL 32.7680KHZ 12.5PF TH | CFS20632768DZFB | Crystal:Crystal_AT310_D3.0mm_L10.0mm_Horizontal
