ihsanakyrk/Eski-Versionlar-Ve-Siparisler/[09.2025]_ÇİN/GSM_SMA_V1.0/GSM_SMA_V1.0_FB/BOM/GSM_PCBSMAFRAHT.xlsx

Reference | Qty | Value | MPN | Footprint
C3,C4,C10,C11,C12 | 5 | 33pF |  | Capacitor_SMD:C_0603_1608Metric
C5,C6 | 2 | 10pF |  | Capacitor_SMD:C_0603_1608Metric
C7,C8,C9,C17 | 4 | 0.1uF |  | Capacitor_SMD:C_0603_1608Metric
C14 | 1 | 100nF |  | Capacitor_SMD:C_0603_1608Metric
C15 | 1 | 220pF |  | Capacitor_SMD:C_0603_1608Metric
C18,C19,C22,C23,C24,C26 | 6 | DNP |  | Capacitor_SMD:C_0603_1608Metric
C25 | 1 | 100pF |  | Capacitor_SMD:C_0603_1608Metric
C13 | 1 | 10uF |  | Capacitor_SMD:C_1206_3216Metric
C16 | 1 | 100uF ±20% 10V SMD | KNSCHA 189RV188 | Capacitor_SMD:CP_Elec_5x4.5
J1 | 1 | FEMALE Through Hole Pin Header |  | Connector_PinHeader_2.00mm:PinHeader_2x05_P2.00mm_Vertical
FID1,FID2,FID3,FID4 | 4 | DNP |  | Fiducial:Fiducial_0.5mm_Mask1.5mm
U2 | 1 | DNP |  | Footprint Library:GSM_Castelled
H1,H2 | 2 | DNP |  | footprint:Screw_Terminal_1x1
L2 | 1 | 47nH 5% | LQG15HS47NJ02D | Inductor_SMD:L_0402_1005Metric
L1 | 1 | 10uH | CDRH74NP-100MC-B | Inductor_SMD:L_7.3x7.3_H3.5
J2 | 1 | 91228-3002 | 91228-3002 | KiCad:912283002
C1,C2 | 2 | T490A107M006ATE500 | T490A107M006ATE500 | KiCad:T490A
D5 | 1 | RED LED |  | LED_SMD:LED_0805_2012Metric
FL1 | 1 | ACM2012-900-2P-T002 | ACM2012-900-2P-T002 | Library:ACM2012-900-2P-T002
D3 | 1 | ESDA6V1-5SC6 | ESDA6V1-5SC6 | Library:ESDA6V1-5SC6
IC1 | 1 | MP1584EN-LF-Z | MP1584EN-LF-Z | Library:MP1584EN-LF-Z
J3,J4,J5 | 3 | PCB.SMAFRA.HT | Right angle SMA inner Hole | Library:PCB.SMAFRA.HT
D4 | 1 | SS34FA | SS34FA | Library:SS4FA
D1,D2 | 2 | TDZVTR5.1 | TDZVTR5.1 | Library:TDZVTR5.1
U1 | 1 | TPET05US3 | TPET05US3 | Library:TPET05US3
R1,R14,R15 | 3 | 0R |  | Resistor_SMD:R_0603_1608Metric
R2,R3,R6 | 3 | 22R |  | Resistor_SMD:R_0603_1608Metric
R4 | 1 | 51K |  | Resistor_SMD:R_0603_1608Metric
R5 | 1 | 15K |  | Resistor_SMD:R_0603_1608Metric
R7 | 1 | 24.9K |  | Resistor_SMD:R_0603_1608Metric
R8 | 1 | 100K |  | Resistor_SMD:R_0603_1608Metric
R9 | 1 | 200K |  | Resistor_SMD:R_0603_1608Metric
R10 | 1 | 68.1K |  | Resistor_SMD:R_0603_1608Metric
R11 | 1 | 40.2K |  | Resistor_SMD:R_0603_1608Metric
R12 | 1 | 150K |  | Resistor_SMD:R_0603_1608Metric
R13 | 1 | 10R |  | Resistor_SMD:R_0603_1608Metric
R16,R17 | 2 | DNP |  | Resistor_SMD:R_0603_1608Metric
R18 | 1 | 1K |  | Resistor_SMD:R_0603_1608Metric
