ihsanakyrk/Eski-Versionlar-Ve-Siparisler/[09.2025]_ÇİN/OV24_RV_V1.0/OV24-RV_V1.0_FB/BOM/OV24-RV_V1.0.xlsx

Reference | Qty | Value | MPN | Footprint
R10,R58,R59,R60 | 4 | 0R |  | Resistor_SMD:R_0603_1608Metric
C1,C2,C3,C4,C5,C6 | 6 | 10uF |  | Capacitor_SMD:C_0805_2012Metric
R1,R2,R3 | 3 | 5K |  | Resistor_SMD:R_0603_1608Metric
J18 | 1 | DNP | DNP | Connector_PinHeader_2.00mm:PinHeader_2x04_P2.00mm_Vertical
J61 | 1 | FFC SOCKET DR_BOTTOM 0.5MM -24P | F32R-1A7H1-11024 | Footprint Library:F32R1A7H111024
J39 | 1 | FFC SOCKET DR_TOP 0.5MM -20P | SAMTEC_ZF5S-20-02-T-WT | Footprint Library:SAMTEC_ZF5S-20-02-T-WT
U1 | 1 | RT9080-12GJ5 | RT9080-12GJ5 | Package_TO_SOT_SMD:SOT-23-5
U2 | 1 | RT9080-18GJ5 | RT9080-18GJ5 | Package_TO_SOT_SMD:SOT-23-5
U3 | 1 | RT9080-28GJ5 | RT9080-28GJ5 | Package_TO_SOT_SMD:SOT-23-5
