ihsanakyrk/Eski-Versionlar-Ve-Siparisler/[04.2025]/SMX_66_V1.00 (Nisan_2025)/SMX66_V1.0_Fab/BOM/SMX66_V1.0.xlsx

Reference | Qty | Value | Footprint
C1,C2,C5 | 3 | 100nF | C0402
Y2200 | 1 | 32.768KHz | Crystal:Crystal_SMD_3215-2Pin_3.2x1.5mm
C1005,C1012,C1017,C1100,C1101,C1102,C1105,C1106,C1107,C1203,C1205,C1207,C1209,C1210,C1212,C1213,C1300,C1301,C1401,C1402,C1403,C1404,C1405,C1406,C1407,C1408,C1508,C1509,C1510,C1517,C1600,C1601,C1604,C1700,C1701,C1704,C1705,C1716,C1717,C1718,C1721,C1722,C1800,C1900 | 44 | 100nF | Footprint Library:C0201
C3,C4,C7,C8,C9,C13,C1001,C1004,C1011,C1016,C1020,C2253,C3801,C3828 | 14 | 22uF | Footprint Library:C0402
C10,C18,C35,C1010,C1015,C1019,C1104,C2250,C3802,C3803,C3823,C3829,C3830 | 13 | 10uF | Footprint Library:C0402
C11,C14,C21,C25,C30,C34,C36,C37,C40,C41,C1200,C1400,C2206,C2251,C2254,C3805,C3806,C3807,C3808,C3809,C3810,C3811,C3812,C3813,C3814,C3815,C3816,C3817,C3818,C3819,C3820,C3821,C3822,C3824,C3825,C3826,C3832,C3833,C3834,C3835,C3836,C3837,C3838,C3839,C3840,C3841,C3842,C3843,C3844,C3845,C3846,C3854,C4000,C4001,C4002,C4003,C4004,C4006,C4007 | 59 | 100nF | Footprint Library:C0402
C12,C2252 | 2 | 100pF | Footprint Library:C0402
C17,C24,C1204,C1206,C1208,C1211,C1214,C1602,C1603,C1702,C1703,C1706,C1707,C1719,C1720,C3804,C3827,C3831 | 18 | 1uF | Footprint Library:C0402
C19 | 1 | 10nF | Footprint Library:C0402
C20,C29,C1000,C1002,C1006,C1007,C1008,C1013,C1103,C1108,C1109,C1409,C1410,C1723,C1724,C3847,C4009 | 17 | 4.7uF | Footprint Library:C0402
C31,C38 | 2 | 47pF | Footprint Library:C0402
C1201,C1202 | 2 | 18pF | Footprint Library:C0402
C1500,C3800 | 2 | 1nF | Footprint Library:C0402
C2200 | 1 | 12pF | Footprint Library:C0402
C2201,C3852 | 2 | DNP | Footprint Library:C0402
C6 | 1 | 47uF | Footprint Library:C0603
C15,C16,C22,C23,C32,C39,C1003,C1009,C1014,C1018 | 10 | 22uF | Footprint Library:C0603
C33,C42 | 2 | 10uF | Footprint Library:C0603
C2301,C4005,C4008 | 3 | 4.7uF | Footprint Library:C0603
U1 | 1 | DNP | Footprint Library:CM3566_1
Y1200 | 1 | 24MHz | Footprint Library:CRY-3225
U4000 | 1 | EMMC_B153_2L | Footprint Library:EMMC
U2201 | 1 | HYM8563TS | Footprint Library:HYM8563TS
L1 | 1 | 0.24uH | Footprint Library:IND_252012
L2,L2210 | 2 | 2.2uH | Footprint Library:IND_404026
L3 | 1 | 1uH | Footprint Library:IND_404026
U3800 | 1 | LPDDR4_200p | Footprint Library:LPDDR
R1713 | 1 | 1.62K | Footprint Library:R0201
R1,R2,R1205,R1206,R1213,R1214 | 6 | 2.2K | Footprint Library:R0402
R3 | 1 | 9K | Footprint Library:R0402
R4 | 1 | 51K | Footprint Library:R0402
R5,R6,R7,R1200 | 4 | 22R | Footprint Library:R0402
R8,R12 | 2 | 1.3K | Footprint Library:R0402
R9 | 1 | 100R | Footprint Library:R0402
R10,R1209 | 2 | 0R | Footprint Library:R0402
R11 | 1 | 0.01R | Footprint Library:R0402
R13 | 1 | 1K | Footprint Library:R0402
R14,R18,R19,R23,R29,R1500,R2205,R2206,R2250,R2251,R2252,R2301,R3802,R4003,R4004,R4005 | 16 | 10K | Footprint Library:R0402
R15 | 1 | 2K | Footprint Library:R0402
R16,R25,R31 | 3 | 100K | Footprint Library:R0402
R17 | 1 | 7.87K | Footprint Library:R0402
R24,R30 | 2 | 50K | Footprint Library:R0402
R1100 | 1 | 120R | Footprint Library:R0402
R1201,R1669 | 2 | DNP | Footprint Library:R0402
R1202 | 1 | 1M | Footprint Library:R0402
R1670 | 1 | 0.1R | Footprint Library:R0402
R2302,R2305 | 2 | 0.05R | Footprint Library:R0402
R2303 | 1 | 4.7K | Footprint Library:R0402
R3800,R3801 | 2 | 240R | Footprint Library:R0402
R4006 | 1 | 47K | Footprint Library:R0402
U1000 | 1 | RK3566 | Footprint Library:RK3566
U2 | 1 | TCS4525 | Footprint Library:TCS4525
L4 | 1 | 1uH | IND_404026
D1 | 1 | LED_RED | LED_SMD:LED_0603_1608Metric
U3,U2210 | 2 | SY8089AAAC | Package_TO_SOT_SMD:SOT-23-5
U4,U3801 | 2 | PT5108E23E-18 | Package_TO_SOT_SMD:SOT-23-5
U5,U6 | 2 | ETA3448S2F | Package_TO_SOT_SMD:SOT-23-5
U7 | 1 | TLV75509PDBVR | Package_TO_SOT_SMD:SOT-23-5
