ihsanakyrk/Eski-Versionlar-Ve-Siparisler/KSS_mindless_v3(Eski akılsız)/KSS/gerber/Production/BOM_5.xlsx

KSS
Id | Designator | Footprint | Quantity | Designation | Supplier and ref
1 | J1, J2 | RJ45_OST_PJ012-8P8CX_Right_angle | 2 | RJ45
2 | G2, P16, P8 | R_0603_1608Metric | 3 | 0R
3 | I2 | R_0603_1608Metric | 1 | 47K
4 | I1 | R_0603_1608Metric | 1 | 22K
5 | XA1,XA2 | Hirose_DF63M-2P-3.96DSA_1x02_P3.96mm_Right Angle | 2 | B2P-VH(LF)(SN) right Angle
