ihsanakyrk/Eski-Versionlar-Ve-Siparisler/[01.2024]/MXVR_3566_V1.0_(Ocak_2024)/MXVR_3566_V1.0_(18.01.2024)/MXVR_3566_V1.0_Fabrication Outputs/BOM/MXVR_3566_V1.0_BOM.xlsx

Reference | Qty | Value | MPN | Footprint
Y3,Y4 | 2 | X322525MSB4SI | X322525MSB4SI | Crystal:Crystal_SMD_3225-4Pin_3.2x2.5mm
Y2 | 1 | TAXM27M4RFBCCT2T | TAXM27M4RFBCCT2T | Crystal:Crystal_SMD_3225-4Pin_3.2x2.5mm
Y1 | 1 | CF4012M00020001 | CF4012M00020001 | Crystal:Crystal_SMD_3225-4Pin_3.2x2.5mm
U24,U25 | 2 | PC817C_4PIN_SMD | PC817C | HDMI 2.0 TX:PC817
U23 | 1 | RTL8211F-CG | RTL8211F-CG | Library:RTL8211F-CG
U22 | 1 | CM3566 | CM3566 | Library:CM3566
U21 | 1 | TP5108E23E-18 | TP5108E23E-18 | SOT-23-5
U20 | 1 | BS-2 | MYOUNG BS-02-A1AJ010 | MYOUNG BS-02-A1AJ010:BS-02-A1AJ010
U18 | 1 | RJ45-2-Block | RJ45 56 1*2 带灯 | Connector_RJ:2_Block_RJ45
U17 | 1 | RJ45-4-Block | RJ45 56 1*4 带灯 | Library:4_Block_RJ45
U16 | 1 | SAF-8ASC-2132M | SAF-8ASC-2132M | SATA_Connector:SATA_Connector_5622-1200-ML
U14 | 1 | RT9013-12GB | RT9013-12GB | Package_TO_SOT_SMD:SOT-23-5
U12,U13,U19 | 3 | TF-218DG | TF-218DG | Transformer_THT:RJ45_Transformer_2_Port
U11 | 1 | DNP |  | SensorModules:module_mpu6050
U10,U15 | 2 | XL4015 | XL4015 | Package_TO_SOT_SMD:TO-263-5_TabPin3
U9 | 1 | DNP |  | HDMI 2.0 TX:HDMI
U8 | 1 | NL27WZU04DTT1G | NL27WZU04DTT1G | Library:NL27WZU04DTT1G
U7 | 1 | W25Q128JVSIQ | W25Q128JVSIQ | Package_SO:SOIC-8_5.23x5.23mm_P1.27mm
U6 | 1 | MAX485ESA | MAX485ESA | MAX485ESA_T:SOIC127P600X175-8N
U5 | 1 | RP2040 | RP2040 | RP2040_minimal:RP2040-QFN-56
U4 | 1 | CF4027M00010 | CF4027M00010 | Crystal:Crystal_SMD_3225-4Pin_3.2x2.5mm
U2,U3 | 2 | TLV76033DBZT | TLV76033DBZT | Package_TO_SOT_SMD:SOT-23
U1 | 1 | TP2855 | TP2855 | Library:TP2815
TP6,TP7,TP25,TP26,TP27 | 5 | DNP |  | TestPoint:TestPoint_Pad_1.0x1.0mm
TP1,TP2,TP3,TP4,TP5,TP8,TP9,TP10,TP11,TP12,TP13,TP14,TP15,TP16,TP17,TP18,TP19,TP20,TP21,TP22,TP23,TP24 | 22 | DNP |  | Connector_Pin:Pin_D1.0mm_L10.0mm
S1 | 1 | TS-1101-C-W | 6*3.6*2.5mm 立贴 轻触开关 | Library:TS-1101-C-W
R263 | 1 | 1K | 0402WGF1001TCE | Resistor_SMD:R_0402_1005Metric
R237,R255 | 2 | 33R | 0603WAF330JT5E | Resistor_SMD:R_0603_1608Metric
R232,R234 | 2 | DNP |  | Resistor_THT:R_Axial_DIN0204_L3.6mm_D1.6mm_P1.90mm_Vertical
R215,R217,R218,R219,R220,R221,R222,R223,R224,R227 | 10 | 4.7K | 0402WGF4701TCE | Resistor_SMD:R_0402_1005Metric
R214 | 1 | 1.5K | 0402WGF1501TCE | Resistor_SMD:R_0402_1005Metric
R206 | 1 | 2.49K | 0402WGF2491TCE | Resistor_SMD:R_0402_1005Metric
R204 | 1 | 0R | 0402WGF0000TCE | Resistor_SMD:R_0402_1005Metric
R202,R203 | 2 | 10R | 0402WGF100JTCE | Resistor_SMD:R_0402_1005Metric
R197,R198 | 2 | 100K | 0402WGF1003TCE | Resistor_SMD:R_0402_1005Metric
R196 | 1 | 51K | 0402WGF5102TCE | Resistor_SMD:R_0402_1005Metric
R193,R194 | 2 | 2.2K | 0402WGF2201TCE | Resistor_SMD:R_0402_1005Metric
R181,R182,R183,R184 | 4 | 47R | 0603WAF470JT5E | Resistor_SMD:R_0603_1608Metric
R179 | 1 | 180R | 0603WAF1800T5E | Resistor_SMD:R_0603_1608Metric
R178 | 1 | 1.5K | 0603WAF1501T5E | Resistor_SMD:R_0603_1608Metric
R166 | 1 | 51K | 0603WAF5102T5E | Resistor_SMD:R_0603_1608Metric
R165 | 1 | 232K | FRC0603F2323TS | Resistor_SMD:R_0603_1608Metric
R162 | 1 | 1.6K | 0603WAF1601T5E | Resistor_SMD:R_0603_1608Metric
R161 | 1 | 15K | 0603WAF1502T5E | Resistor_SMD:R_0603_1608Metric
R157,R160 | 2 | 470R | 0603WAF4700T5E | Resistor_SMD:R_0603_1608Metric
R156,R254 | 2 | 3.3K | 0603WAF3301T5E | Resistor_SMD:R_0603_1608Metric
R154,R180 | 2 | 150K | 0603WAF1503T5E | Resistor_SMD:R_0603_1608Metric
R147,R148,R149,R150,R151,R152,R153 | 7 | 220R | 0603WAF2200T5E | Resistor_SMD:R_0603_1608Metric
R144,R252,R253 | 3 | 100K | 0603WAF1003T5E | Resistor_SMD:R_0603_1608Metric
R143 | 1 | 75R | 0402WGF750JTCE | Resistor_SMD:R_0402_1005Metric
R140,R141,R228 | 3 | 2.2K | 0603WAF2201T5E | Resistor_SMD:R_0603_1608Metric
R135 | 1 | 330R | 0603WAF3300T5E | Resistor_SMD:R_0603_1608Metric
R131,R133,R134,R139,R216 | 5 | 0R | 0402WGF0000TCE | Resistor_SMD:R_0402_1005Metric
R130,R195,R199,R201,R262 | 5 | 10K | RC0402FR-0710KL | Resistor_SMD:R_0402_1005Metric
R129,R138,R205,R225,R226 | 5 | DNP |  | Resistor_SMD:R_0402_1005Metric
R128 | 1 | 560K | 0603WAF5603T5E | Resistor_SMD:R_0603_1608Metric
R117,R118,R119,R120,R121,R122,R123,R126,R127,R146,R207,R208,R209,R210,R211,R212,R213 | 17 | 22R | 0402WGF220JTCE | Resistor_SMD:R_0402_1005Metric
R113,R114,R168 | 3 | 2K | 0603WAF2001T5E | Resistor_SMD:R_0603_1608Metric
R112,R142,R185,R186,R187,R188,R243,R244,R245,R246,R247,R248,R249 | 13 | 22R | 0603WAF220JT5E | Resistor_SMD:R_0603_1608Metric
R73,R74,R75,R76,R102,R103,R189,R190,R191,R192 | 10 | 75R | 0603WAF750JT5E | Resistor_SMD:R_0603_1608Metric
R51,R110,R111,R125,R200,R231,R236 | 7 | 100R | 0603WAF1000T5E | Resistor_SMD:R_0603_1608Metric
R47,R55,R58,R59,R60,R61,R62,R63,R64,R65,R66,R67,R68,R69,R70,R71,R94,R95,R96,R97,R98,R99,R100,R101 | 24 | DNP | 0603WAF1002T5E | Resistor_SMD:R_0603_1608Metric | ilk 5 adet baskı için DNP (test edilecek)
R30,R31 | 2 | 2.2R | 0402WGF220KTCE | Resistor_SMD:R_0402_1005Metric
R27,R28,R32,R33,R34,R56,R108 | 7 | 4.7K | 0603WAF4701T5E | Resistor_SMD:R_0603_1608Metric
R18,R19,R20,R40,R41,R49,R124,R136,R137,R155,R158,R159,R164,R169,R171,R235,R239,R256 | 18 | 10K | 0603WAF1002T5E | Resistor_SMD:R_0603_1608Metric
R16,R17 | 2 | 27R | 0603WAF270JT5E | Resistor_SMD:R_0603_1608Metric
R15 | 1 | 1R | 0603WAF100KT5E | Resistor_SMD:R_0603_1608Metric
R14 | 1 | 200R | 0603WAF2000T5E | Resistor_SMD:R_0603_1608Metric
R12,R24,R38,R42,R85,R87,R89,R90,R91,R92,R93 | 11 | DNP | 0603WAF1001T5E | Resistor_SMD:R_0603_1608Metric | ilk 5 adet baskı için DNP (test edilecek)
R11,R22,R26,R50,R52,R57,R109,R116,R163,R167,R173,R174,R175,R176,R177,R240,R258,R259,R260 | 19 | DNP |  | Resistor_SMD:R_0603_1608Metric
R10,R13,R21,R23,R37,R39,R48,R72,R77,R78,R79,R80,R81,R82,R83,R84,R86,R88,R104,R105,R106,R107,R132,R145,R170,R172,R238,R250,R251,R257 | 30 | 1K | 0603WAF1001T5E | Resistor_SMD:R_0603_1608Metric
R6,R8 | 2 | 2.49K | 0603WAF2491T5E | Resistor_SMD:R_0603_1608Metric
R4,R5,R7,R9,R25,R29,R53,R54,R115,R229,R230,R233,R241,R242,R261 | 15 | 0R | 0603WAF0000T5E | Resistor_SMD:R_0603_1608Metric
R3,R36,R44,R46 | 4 | 510K | 0402WGF5103TCE | Resistor_SMD:R_0402_1005Metric
R2,R35,R43,R45 | 4 | 1M | 0402WGF1004TCE | Resistor_SMD:R_0402_1005Metric
R1 | 1 | 150R | 0603WAF1500T5E | Resistor_SMD:R_0603_1608Metric
Q9 | 1 | DMG1012T | DMG1012T | Package_TO_SOT_SMD:SOT-523
Q8 | 1 | DMG2305UX | DMG2305UX | Package_TO_SOT_SMD:SOT-23
Q7 | 1 | SI2305 | SI2305 | Package_TO_SOT_SMD:SOT-23
Q2,Q3,Q4,Q5,Q6 | 5 | MMBT2222ALT1G | MMBT2222A | HDMI 2.0 TX:MMBT2222ALT1G
Q1 | 1 | S8050 | S8050 | Package_TO_SOT_SMD:SOT-23
PS3 | 1 | ETA3448S2F | ETA3448S2F | Package_TO_SOT_SMD:SOT-23-5
PS2 | 1 | RT9013-33GB | RT9013-33GB | SOT-23-5
L14 | 1 | AWL3225FP2R2MTF | AWL3225FP2R2MTF | Library:AWL3225FP2R2MTF
L11,L15 | 2 | CBW160808U101T | CBW160808U101T | Inductor_SMD:L_0603_1608Metric
L10,L12,L13 | 3 | YI201209U101-3R0T | YI201209U101-3R0T | Inductor_SMD:L_0805_2012Metric
L9 | 1 | SDCL1608C2N7STDF | SDCL1608C2N7STDF | Inductor_SMD:L_0603_1608Metric
L8 | 1 | HA42-4R7MT | HA42-4R7MT | Pro V3:Inductor_0402_4.7uH
L7 | 1 | MLI1608F-1R2KT | MLI1608F-1R2KT | Inductor_SMD:L_0603_1608Metric
L6 | 1 | UPZ1608E101-3R0TF | UPZ1608E101-3R0TF | Inductor_SMD:L_0603_1608Metric
L5 | 1 | YSPI0420-1R0M | YSPI0420-1R0M | HDMI 2.0 TX:HCM0420-1R0M
L2,L3 | 2 | HX CYA1050-47UH | HX CYA1050-47UH | CYA1050-47UH:L_Bourns_SRR1208_12.7x12.7mm
L1,L4 | 2 | 742792651 | 742792651 | Inductor_SMD:L_0603_1608Metric
K1,K3 | 2 | HF46F_5-HS1 | HF46F_5-HS1 | HF46F_5-HS1:HF46F5HS1
J43 | 1 | MALE Through Hole Pin Header | 1*3p 2.0 排针 | Connector_PinHeader_2.00mm:PinHeader_1x03_P2.00mm_Vertical
J41 | 1 | DNP |  | Connector_PinSocket_2.00mm:PinSocket_1x02_P2.00mm_Vertical
J40 | 1 | DNP |  | Connector_PinSocket_2.00mm:PinSocket_1x04_P2.00mm_Vertical
J37 | 1 | USB 3.0 AF | USB3.0 侧插 | footprint:CP-USB-3015
J36 | 1 | JST_1x15-1MP_P1.25mm_Vertical | 1.25 1*15P 立贴 | Library:JST_1x15-1MP_P1.25mm_Vertical
J35,J38,J39 | 3 | M3x*0.5 L=3 | SMTSO-M3-3ET | HDMI 2.0 TX:Screw Terminal Shinbo
J34 | 1 | FEMALE SMD Pin Header | 1*3p 2.54 贴片排母 | Connector_PinSocket_2.54mm:PinSocket_1x03_P2.54mm_Vertical_SMD_Pin1Left
J33 | 1 | FEMALE SMD Pin Header | 2.54 2*2p 贴片排母 | Connector_PinSocket_2.54mm:PinSocket_2x02_P2.54mm_Vertical_SMD
J32 | 1 | DNP |  | Connector_PinHeader_2.54mm:PinHeader_1x02_P2.54mm_Vertical
J31 | 1 | FEMALE Through Hole Pin Header | 2.54 2*2p 插件排母 | Connector_PinSocket_2.54mm:PinSocket_2x02_P2.54mm_Vertical
J29,J30 | 2 | M3x*0.5 L=6 | SMTSO-M3-6ET | HDMI 2.0 TX:Screw Terminal Shinbo
J27 | 1 | DNP |  | Connector_PinHeader_1.00mm:PinHeader_1x07_P1.00mm_Vertical
J25 | 1 | DNP |  | Connector_PinHeader_2.54mm:PinHeader_2x02_P2.54mm_Vertical_SMD
J24 | 1 | TF-CARD H1.8 | TF 卡座 铜壳 | HDMI 2.0 TX:TF-CARD H1.8
J23,J28 | 2 | M3x*0.5 L=8 | SMTSO-M3-8ET | HDMI 2.0 TX:Screw Terminal Shinbo
J18,J19,J20,J26 | 4 | Phono RCA Jack Mono Connector Solder (Boktech advise) | 莲花座AV1-8.4-5A 黑色 | Library:AV_CON
J17 | 1 | JST_PH_B2B-PH-K_1x02_P2.00mm_Vertical | PH2.0 2P 直针 | Connector_JST:JST_PH_B2B-PH-K_1x02_P2.00mm_Vertical
J15,J16 | 2 | LED_4_Block_Right Angle | 3mm四孔灯座带灯 | LED_4:LED_4_Block
J14 | 1 | DNP |  | Connector_PinSocket_2.00mm:PinSocket_1x06_P2.00mm_Vertical
J13 | 1 | MALE SMD Pin Header | 2.0mm 2*5p 贴片排针 | Connector_PinSocket_2.00mm:PinSocket_2x05_P2.00mm_Vertical_SMD
J12 | 1 | KF2EDGH-3.81_8P-Right Angle | 15EDGK-3.81 双层 2*4p | KF2EDGH:KF2EDGH-3.81_8P
J11 | 1 | KF2EDGR-Y-5.08-3P-Right Angle | KF2EDG -3P 5.08 封口 弯 | KF2EDGH:KF2EDGR-Y-5.08-3P-Right Angle
J10 | 1 | SMA Connetor_inner_pin | SMA-KWE 内针 | Connector_Coaxial:SMA_Connector_inner_pin_right_angle
J9 | 1 | RTL8188EU | RTL8188EUS 模块 | RTL8188EU:RTL8188EU
J8 | 1 | APCI0079-P002A J8900 M.2 M Key | NGFF 67P连接器 M.2 SSD插槽 4+5 H3.2 | Library:APCI0079-P002A J8900 M.2 M Key
J7 | 1 | KF2EDGH-3.81-2P- Right Angle | KF2EDGV-3.81 2p 直针 | KF2EDGH:KF2EDGH-3.81-2P
J6 | 1 | MALE SMD Pin Header | 2*20 1.27mm 插件排针 | Connector_PinHeader_1.27mm:PinHeader_2x20_P1.27mm_Vertical
J5 | 1 | RJ45 | 黑色 RJ45 8P | Connector_RJ:RJ45_Amphenol_54602-x08_Horizontal
J4 | 1 | DNP |  | Connector_PinSocket_2.00mm:PinSocket_1x05_P2.00mm_Vertical
J3,J21,J22 | 3 | FEMALE SMD Pin Header | 贴片排母 2.54 2*4p | Connector_PinSocket_2.54mm:PinSocket_2x04_P2.54mm_Vertical_SMD
J2 | 1 | Phono RCA Jack Mono Connector Solder (Boktech advise) | 莲花座AV1-8.4-5A 黑色 | AV_CONNECTOR:AV_CON
J1 | 1 | FEMALE Through Hole Pin Header | 2.54 2*7p 插件排针 | Connector_PinSocket_2.54mm:PinSocket_2x07_P2.54mm_Vertical
IC5 | 1 | SY8113B | SY8113BADC | Library:SY8113B
IC3 | 1 | RTL8309N | RTL8309N-VB-CG | RTL8309N:RTL8309N
IC2 | 1 | MS1836S_QFN48-7x7 | MS1836S | Package_DFN_QFN:QFN-48-1EP_7x7mm_P0.5mm_EP5.6x5.6mm
FL3,FL4 | 2 | BLM18PG121SN1D | BLM18PG121SN1D | BLM18PG121SN1D:BLM18AG102BH1D
FL1 | 1 | APCW3216-900P2T | APCW3216-900P2T | DLW31SN900SQ2L:DLW31SH222SQ2L
FID1,FID2,FID3,FID4,FID5,FID6,FID7,FID8,FID9,FID10,FID11,FID12 | 12 | DNP | Fiducial Marker | Fiducial:Fiducial_0.5mm_Mask1mm
FB1 | 1 | YI321611U101-4R0T | YI321611U101-4R0T | HI1206N101R-10:BEADC3216X130N
ED1,ED2,ED3,ED4,ED5,ED6,ED7 | 7 | ESD5341N | ESD5341N | HDMI 2.0 TX:ESD5341N
D31 | 1 | BAT54 | BAT54 | Package_TO_SOT_SMD:SOT-23
D28,D29 | 2 | S6MC | S6MC | Diode_SMD:S6MC
D26,D27 | 2 | MRA4007T3G | MRA4007T3G | Library:MRA4007T3G
D25 | 1 | LED_GREEN | 0603 翠绿色 LED | LED_SMD:LED_0603_1608Metric
D23,D24 | 2 | LL4148 | LL4148 | Pro V3:LL4148
D22 | 1 | ESD5451N | ESD5451N | ESD5451N:ESD5451N
D18,D19,D20,D21 | 4 | SMAJ30CA | SMAJ30CA | Diode_SMD:D_SMA
D14,D15,D16,D17 | 4 | EZJZ800AA | EZJZ800AA | Diode_SMD:D_0402_1005Metric
D10,D11 | 2 | SS54B | SS54B | Library:SS54B
D6,D12,D13,D30 | 4 | ESD5341N | ESD5341N | ESD5341N:ESD5341N
D3 | 1 | SS14 | SS14 SOD-123FL | SS14:DIOM4325X250N
D1,D2,D4,D5,D7,D8,D9 | 7 | 2SS100L-W | 2SS100L-W | 2SS100L-W:2SS100LW
C206 | 1 | 10uF | CL10A106MO8NQNC | Capacitor_SMD:C_0603_1608Metric
C204 | 1 | 10uF | CL21A106KAYNNNE | Capacitor_SMD:C_0805_2012Metric
C197,C207,C210,C211 | 4 | 100nF | CC0402KRX7R7BB104 | Capacitor_SMD:C_0402_1005Metric
C195,C198,C199 | 3 | 100nF | CC0402KRX7R7BB104 | Capacitor_SMD:C_0402_1005Metric
C187,C189,C190 | 3 | DNP |  | Capacitor_SMD:C_0402_1005Metric
C186,C188 | 2 | 15pF | 0402CG150J500NT | Capacitor_SMD:C_0402_1005Metric
C185 | 1 | 10nF | CC0402KRX7R9BB103 | Capacitor_SMD:C_0402_1005Metric
C184 | 1 | 220uF | RVT220UF16V67RV0015 | Capacitor_SMD:CP_Elec_6.3x7.7
C175,C176,C177 | 3 | 10uF | CL10A106MO8NQNC | Capacitor_SMD:C_0603_1608Metric
C171,C174 | 2 | 330nF | 0603B334K250NT | Capacitor_SMD:C_0603_1608Metric
C165 | 1 | 220pF | CL10B221KB8NNNC | Capacitor_SMD:C_0603_1608Metric
C164 | 1 | DNP |  | Capacitor_SMD:C_0603_1608Metric
C163 | 1 | 100pF | 0603B101K500NT | Capacitor_SMD:C_0603_1608Metric
C153 | 1 | 10nF | CC0603KRX7R9BB103 | Capacitor_SMD:C_0603_1608Metric
C145,C146,C179 | 3 | 22pF | CL10C220JB8NNNC | Capacitor_SMD:C_0603_1608Metric
C144 | 1 | 10uF X5R 6.3V | CL05A106MQ5NUNC | Capacitor_SMD:C_0402_1005Metric
C143,C173,C209 | 3 | 100nF X7R 16V | CC0402KRX7R7BB104 | Capacitor_SMD:C_0402_1005Metric
C140 | 1 | 1uF X5R 10V | CL05A105KP5NNNC | Capacitor_SMD:C_0402_1005Metric
C130,C131,C133 | 3 | 10uF | CL05A106MQ5NUNC | Capacitor_SMD:C_0402_1005Metric
C129 | 1 | 100pF | 0402CG101J500NT | Capacitor_SMD:C_0402_1005Metric
C122,C123 | 2 | 8pF | 0603CG8R0C500NT | Capacitor_SMD:C_0603_1608Metric
C102,C132,C135 | 3 | 4.7uF | CL05A475KP5NRNC | Capacitor_SMD:C_0402_1005Metric
C92,C93 | 2 | 1000PF 2KV | Y5P102K2KV16CC0224 | Capacitor_THT:S102K33Y5PP63K5R
C74,C76,C99,C100 | 4 | 10uF | UWX1C100MCL2GB | Capacitor_SMD:C_Elec_3x5.4
C70,C78,C79,C80,C81,C85,C86,C87,C88,C89,C90,C91 | 12 | DNP | CC0402KRX7R7BB104 | Capacitor_SMD:C_0402_1005Metric | ilk 5 adet için basılıp test edilecek switch
C62,C69,C180,C181 | 4 | 22uF | CL10A226MQ8NRNC | Capacitor_SMD:C_0603_1608Metric
C46 | 1 | 56pF | 0402CG560J500NT | Capacitor_SMD:C_0402_1005Metric
C44 | 1 | 1nF | CC0603KRX7R9BB102 | Capacitor_SMD:C_0603_1608Metric
C39,C61 | 2 | 33pF | CL10C330JB8NNNC | Capacitor_SMD:C_0603_1608Metric
C35,C94,C166 | 3 | 10pF | CC0603JRNPO9BN100 | Capacitor_SMD:C_0603_1608Metric
C32,C82 | 2 | 330uF/25V | RVT1E331M0810 | Capacitor_SMD:C_Elec_8x10.2
C29,C30,C84,C169,C170,C172 | 6 | 1uF/50V | CL10A105KB8NNNC | Capacitor_SMD:C_0603_1608Metric
C28,C83 | 2 | 220uF/50V | RVT1H221M1010 | Capacitor_SMD:C_Elec_10x10.2
C18,C19,C128 | 3 | 1uF | CL10A105KB8NNNC | Capacitor_SMD:C_0603_1608Metric
C14,C15 | 2 | 27pF | 0603CG270J500NT | Capacitor_SMD:C_0603_1608Metric
C8,C9,C11,C13,C16,C17,C20,C21,C22,C23,C24,C25,C26,C27,C38,C40,C42,C43,C45,C47,C48,C49,C50,C51,C52,C53,C54,C63,C64,C65,C66,C67,C68,C71,C72,C73,C75,C77,C95,C96,C97,C98,C101,C103,C104,C105,C106,C107,C108,C109,C110,C111,C112,C113,C116,C117,C120,C121,C124,C125,C126,C127,C134,C136,C137,C138,C139,C141,C142,C194,C200,C201,C202,C203,C205 | 75 | 100nF | CC0402KRX7R7BB104 | Capacitor_SMD:C_0402_1005Metric
C7,C10,C37,C114,C115,C151,C155,C192 | 8 | 10uF | CL10A106MO8NQNC | Capacitor_SMD:C_0603_1608Metric
C5 | 1 | DNP |  | RP2040_minimal:FYD0H473ZF
C4,C6,C12,C33,C149,C154,C191,C193,C196 | 9 | 4.7uF | CL10A475KO8NNNC | Capacitor_SMD:C_0603_1608Metric
C1,C2,C3,C31,C34,C36,C41,C55,C56,C57,C58,C59,C60,C118,C119,C147,C148,C150,C152,C156,C157,C158,C159,C160,C161,C162,C167,C168,C178,C182,C183,C208 | 32 | 100nF | 0603B104K500NT | Capacitor_SMD:C_0603_1608Metric
