ihsanakyrk/Eski-Versionlar-Ve-Siparisler/[04.2025]/ST_Board_V1.0 (Nisan_2025)/ST_Board_V1.0_Fab/ST_Board_V1.0/BOM/ST_Board_V1.0.xlsx

Reference | Qty | Value | MPN | Footprint
C1,C2,C3,C4,C5 | 5 | GRC-2R7-Y505A | GRC-2R7-Y505A | Footprint Library:GRC-2R7-Y505A
J1 | 1 | JST_PH_B2B-PH-K_1x02_P2.00mm_Vertical_MALE | B2B-PH-K-S(LF)(SN) | Connector_JST:JST_PH_B2B-PH-K_1x02_P2.00mm_Vertical
J2 | 1 | DNP | DNP | Footprint Library:Screw Terminal Shinbo
