ihsanakyrk/Eski-Versionlar-Ve-Siparisler/CamTracker_CM4_V3.1/CamTracker_CM4_V3.0_Outputs Price/CamTracker - BokTech quote 20231123.xlsx

Id | Designator | Footprint | Quantity | Designation | 10pcs |  | 490pcs
1 | J6 | RJ45_Amphenol_54602-x08_Horizontal | 1 | DNP
2 | R64,R6,R11,R8,R27,R63 | R_0603_1608Metric | 6 | 0R | 0.0007352941176 | 0.004411764706 | 0.0007352941176 | 0.004411764706
3 | U6 | SOIC-8_3.9x4.9mm_P1.27mm | 1 | PCF8563T | 0.3264705882 | 0.3264705882 | 0.3264705882 | 0.3264705882
4 | R10,R12,R65,R7,R51,R22,R1,R52,R9,R50,R18,R19 | R_0603_1608Metric | 12 | DNP | 0 | 0 | 0 | 0
5 | C29,C28 | C_0603_1608Metric | 2 | 0.01uF | 0.002941176471 | 0.005882352941 | 0.002941176471 | 0.005882352941
6 | C30,C31 | C_0603_1608Metric | 2 | 1000pF | 0.002941176471 | 0.005882352941 | 0.002941176471 | 0.005882352941
7 | D6 | DIOM4325X250N | 1 | SS14 | 0.01029411765 | 0.01029411765 | 0.01029411765 | 0.01029411765
8 | R40,R41 | R_0603_1608Metric | 2 | 75R | 0.001176470588 | 0.002352941176 | 0.001176470588 | 0.002352941176
9 | Y2 | Crystal_AT310_D3.0mm_L10.0mm_Horizontal | 1 | 32.768 KHz | 0.07352941176 | 0.07352941176 | 0.07352941176 | 0.07352941176
10 | R75,R5 | R_0603_1608Metric | 2 | 2.2K | 0.0007352941176 | 0.001470588235 | 0.0007352941176 | 0.001470588235
11 | C41 | CAPAE660X550N | 1 | 100uF | 0.02205882353 | 0.02205882353 | 0.02205882353 | 0.02205882353
12 | T1 | H1102NL | 1 | H1102NL | 0.2735294118 | 0.2735294118 | 0.2735294118 | 0.2735294118
13 | D1 | LED_0603_1608Metric | 1 | LED Green | 0.01470588235 | 0.01470588235 | 0.01470588235 | 0.01470588235
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
 |  | 4 layer board of 50x127mm ENIG | 1 |  | 0.6617647059 | 0.6617647059 | 0.6617647059 | 0.6617647059
 |  |  |  |  |  | 11.9005 |  | 8.665205882
 |  |  |  |  | #20231123
 |  |  |  |  | Product | CamTracker PCBA (ENIG)
 |  |  |  |  | QTY | 10 | 490
 |  |  |  |  | Material cost | 11.9005 | 8.665205882
 |  |  |  |  | Assemby fee | 1.058823529 | 1.058823529
 |  |  |  |  | Overhead | 0.6479661765 | 0.4862014706
 |  |  |  |  | Profit | 1.943898529 | 1.458604412
 |  |  |  |  | Total USD/pcs | 15.55118824 | 11.66883529
 |  |  |  |  | NOTE | Including U14,U15 | Not Included U14,U15
 |  |  |  |  | #20231123
 |  |  |  |  | Product | CamTracker PCBA (ENIG)
 |  |  |  |  | QTY | 10 | 490
 |  |  |  |  | Unit price | 15.55 | 11.66
 |  |  |  |  | Set up fee | 30
 |  |  |  |  | Total USD | 5898.9
 |  |  |  |  | Lead time | 4~5wks
 |  |  |  |  | NOTE | Including U14,U15 | Not Included U14,U15
 |  |  |  |  | NOTE | Order 500pcs PCBs together and do 10pcs FA sample to check firstly.
