ihsanakyrk/Eski-Versionlar-Ve-Siparisler/IO_Board/IO_Board_Outputs Price/IO_Board - BokTech Quote 20231220.xlsx

Reference | Qty | DNP | Value | MPN | Footprint | Datasheet | 300PCS
R5,R6,R53 | 3 |  | 0R |  | Resistor_SMD:R_0603_1608Metric |  | 0.001176470588 | 0.003529411765
R41,R42,R49,R50 | 4 |  | 0R |  | Resistor_SMD:R_0805_2012Metric |  | 0.001176470588 | 0.004705882353
C23 | 1 |  | 22pF |  | Capacitor_SMD:C_0603_1608Metric |  | 0.007352941176 | 0.007352941176
C10,C11 | 2 |  | 27pF |  | Capacitor_SMD:C_0603_1608Metric |  | 0.007352941176 | 0.01470588235
C4 | 1 |  | 150pF |  | Capacitor_SMD:C_0603_1608Metric |  | 0.007352941176 | 0.007352941176
C26,C27 | 2 |  | 1000pF |  | Capacitor_SMD:C_0603_1608Metric |  | 0.007352941176 | 0.01470588235
C9 | 1 |  | 1nF |  | Capacitor_SMD:C_0603_1608Metric |  | 0.007352941176 | 0.007352941176
C24,C25 | 2 |  | 0.01uF |  | Capacitor_SMD:C_0603_1608Metric |  | 0.007352941176 | 0.01470588235
C8 | 1 |  | s |  | Capacitor_SMD:C_0603_1608Metric |  | 0.007352941176 | 0.007352941176
C3,C12,C13,C16,C17,C18,C19,C20,C21,C22 | 10 |  | 100nF |  | Capacitor_SMD:C_0603_1608Metric |  | 0.007352941176 | 0.07352941176
C14,C15 | 2 |  | 1uF |  | Capacitor_SMD:C_0603_1608Metric |  | 0.007352941176 | 0.01470588235
L1 | 1 |  | 10uH | YPRH0704-100M | Inductor_SMD:L_7.3x7.3_H3.5 |  | 0.1279411765 | 0.1279411765
C1,C2 | 2 |  | 10uF |  | Capacitor_SMD:C_0603_1608Metric |  | 0.007352941176 | 0.01470588235
C7 | 1 |  | 22uF |  | Capacitor_SMD:C_0603_1608Metric |  | 0.007352941176 | 0.007352941176
C6 | 1 |  | 100uF |  | Capacitor_SMD:CP_Elec_5x5.4 |  | 0.007352941176 | 0.007352941176
R32 | 1 |  | 1R |  | Resistor_SMD:R_0603_1608Metric |  | 0.001176470588 | 0.001176470588
R26,R27,R28,R29,R30,R33,R34 | 7 |  | 27R |  | Resistor_SMD:R_0603_1608Metric |  | 0.001176470588 | 0.008235294118
R58,R60 | 2 |  | 75R |  | Resistor_SMD:R_0603_1608Metric |  | 0.001176470588 | 0.002352941176
R9,R10,R15,R16 | 4 |  | 100R |  | Resistor_SMD:R_0603_1608Metric |  | 0.001176470588 | 0.004705882353
R31 | 1 |  | 200R |  | Resistor_SMD:R_0603_1608Metric |  | 0.001176470588 | 0.001176470588
R12,R14 | 2 |  | 220R |  | Resistor_SMD:R_0603_1608Metric |  | 0.001176470588 | 0.002352941176
R57 | 1 |  | 275R |  | Resistor_SMD:R_0603_1608Metric |  | 0.001176470588 | 0.001176470588
R56 | 1 |  | 725R |  | Resistor_SMD:R_0603_1608Metric |  | 0.001176470588 | 0.001176470588
R1,R2,R3,R4,R25 | 5 |  | 1K |  | Resistor_SMD:R_0603_1608Metric |  | 0.001176470588 | 0.005882352941
R43,R62 | 2 |  | 1K |  | Resistor_SMD:R_0402_1005Metric | https://fscdn.rohm.com/en/products/databook/datasheet/passive/resistor/chip_resistor/mcr-e.pdf | 0.001176470588 | 0.002352941176
R47,R52 | 2 |  | 1K |  | Resistor_SMD:R_0805_2012Metric |  | 0.001176470588 | 0.002352941176
R11,R13 | 2 |  | 1.78K |  | Resistor_SMD:R_0603_1608Metric |  | 0.001176470588 | 0.002352941176
R17 | 1 |  | 2.2K |  | Resistor_SMD:R_0603_1608Metric |  | 0.001176470588 | 0.001176470588
R35 | 1 |  | 4.7K |  | Resistor_SMD:R_0603_1608Metric |  | 0.001176470588 | 0.001176470588
R24 | 1 |  | 10K |  | Resistor_SMD:R_0603_1608Metric |  | 0.001176470588 | 0.001176470588
R46,R51 | 2 |  | 10K |  | Resistor_SMD:R_0805_2012Metric |  | 0.001176470588 | 0.002352941176
R21 | 1 |  | 40.2K |  | Resistor_SMD:R_0603_1608Metric |  | 0.001176470588 | 0.001176470588
R18,R19,R20 | 3 |  | 100K |  | Resistor_SMD:R_0603_1608Metric |  | 0.001176470588 | 0.003529411765
R22 | 1 |  | 210K |  | Resistor_SMD:R_0603_1608Metric |  | 0.001176470588 | 0.001176470588
R59,R61 | 2 |  | 2.2K 1% |  | Resistor_SMD:R_0402_1005Metric | https://fscdn.rohm.com/en/products/databook/datasheet/passive/resistor/chip_resistor/mcr-e.pdf | 0.001176470588 | 0.002352941176
R36,R37 | 2 |  | 4.7K %5 |  | Resistor_SMD:R_0603_1608Metric |  | 0.001176470588 | 0.002352941176
U8 | 1 |  | 74LVC1G07SE-7 | 74LVC1G07SE-7 | Package_TO_SOT_SMD:SOT-353_SC-70-5 | https://www.diodes.com/assets/Datasheets/74LVC1G07.pdf | 0.03382352941 | 0.03382352941
C5 | 1 | DNP | DNP |  | Capacitor_SMD:C_0603_1608Metric |  | 0 | 0
J1 | 1 |  | FEMALE Through Hole Pin Header | FEMALE Through Hole Pin Header | Library:PinHeader_2x20_P2.54mm_Vertical |  | 0.04411764706 | 0.04411764706
J2,J3 | 2 | DNP | DNP |  | Connector_PinHeader_2.54mm:PinHeader_1x02_P2.54mm_Vertical |  | 0 | 0
J7 | 1 | DNP | DNP |  | Connector_PinHeader_2.54mm:PinHeader_1x06_P2.54mm_Vertical |  | 0 | 0
R7,R8,R23,R55 | 4 | DNP | DNP |  | Resistor_SMD:R_0603_1608Metric |  | 0 | 0
R38,R39,R44,R45 | 4 | DNP | DNP |  | Resistor_THT:R_Axial_DIN0204_L3.6mm_D1.6mm_P1.90mm_Vertical |  | 0 | 0
R40,R48 | 2 | DNP | DNP |  | Resistor_SMD:R_0805_2012Metric |  | 0 | 0
R54,R63,R64 | 3 | DNP | DNP |  | Resistor_SMD:R_0402_1005Metric | https://fscdn.rohm.com/en/products/databook/datasheet/passive/resistor/chip_resistor/mcr-e.pdf | 0 | 0
U7 | 1 | DNP | DNP | CM4 | Library:Raspberry-Pi-4-Compute-Module |  | 0 | 0
Y2 | 1 |  | ECS-3X8X | ECS-3X8X | Library:ECS-3X8X |  | 0.1073529412 | 0.1073529412
J5 | 1 |  | FEMALE Through Hole Pin Header | FEMALE Through Hole Pin Header | Connector_PinHeader_2.54mm:PinHeader_1x02_P2.54mm_Vertical |  | 0.01470588235 | 0.01470588235
J12 | 1 |  | FEMALE Through Hole Pin Header | FEMALE Through Hole Pin Header | Connector_PinSocket_2.00mm:PinSocket_2x04_P2.00mm_Vertical |  | 0.02205882353 | 0.02205882353
J13 | 1 |  | FEMALE Through Hole Pin Header | FEMALE Through Hole Pin Header | Connector_PinHeader_2.54mm:PinHeader_1x05_P2.54mm_Vertical |  | 0.01470588235 | 0.01470588235
T1 | 1 |  | H1102NL | H1102NL | Library:H1102NL |  | 0.2720588235 | 0.2720588235
K1,K2 | 2 | DNP | DNP | HF46F_5-HS1 | Library:HF46F_5-HS1 |  | 0 | 0
J4 | 1 |  | JST_PH_B2B-PH-K_1x02_P2.00mm_Vertical | JST_PH_B2B-PH-K_1x02_P2.00mm_Vertical | Connector_JST:JST_PH_B2B-PH-K_1x02_P2.00mm_Vertical |  | 0.02205882353 | 0.02205882353
J6,J8,J14,J15 | 4 |  | KF2EDGR-Y-5.08-2P-Right Angle | KF2EDGR-Y-5.08-2P-Right Angle | Library:KF2EDGR-Y-5.08-2P-Right Angle |  | 0.05147058824 | 0.2058823529
D5 | 1 |  | LED Green |  | LED_SMD:LED_0603_1608Metric | http://optoelectronics.liteon.com/upload/download/DS22-2000-226/LTST-S270KGKT.pdf | 0.01470588235 | 0.01470588235
D7 | 1 |  | LED Red |  | LED_SMD:LED_0603_1608Metric | http://optoelectronics.liteon.com/upload/download/DS22-2000-210/LTST-S270KRKT.pdf | 0.01470588235 | 0.01470588235
U3 | 1 |  | LM1117S-3.3 | LM1117S-3.3 | Package_TO_SOT_SMD:SOT-223 | http://www.ti.com/lit/ds/symlink/lm317.pdf | 0.09705882353 | 0.09705882353
J10,J11 | 2 |  | M3x*0.5 L=8 | M3x*0.5 L=8 | Library:Screw_terminal_shinbo |  | 0.07352941176 | 0.1470588235
Q1,Q2 | 2 |  | MMBT2222ALT1G | MMBT2222ALT1G | Library:MMBT2222ALT1G | http://www.onsemi.com/pub_link/Collateral/2N3055-D.PDF | 0.01926470588 | 0.03852941176
IC1 | 1 |  | MP1584EN | MP1584EN | Library:MP1584 |  | 0.2941176471 | 0.2941176471
D3,D4 | 2 |  | MRA4007T3G | MRA4007T3G | Library:MRA4007T3G | http://www.mouser.com/ds/2/149/1N4148WT-461550.pdf | 0.06911764706 | 0.1382352941
J9 | 1 |  | MYOUNG BS-02-A1AJ010 | MYOUNG BS-02-A1AJ010 | Library:MYOUNG BS-02-A1AJ010 |  | 0.04117647059 | 0.04117647059
U1,U2 | 2 |  | PC817C_4PIN_SMD | PC817C_4PIN_SMD | Library:PC817C SMD 4pin |  | 0.02205882353 | 0.04411764706
U6 | 1 |  | PCF8563 | PCF8563 | Library:PCF8563 |  | 0.3911764706 | 0.3911764706
J16 | 1 |  | RJ45 | RJ45 | Connector_RJ:RJ45_Amphenol_54602-x08_Horizontal |  | 0.07352941176 | 0.07352941176
U5 | 1 |  | RP2040 | RP2040 | Library:RP20400 |  | 0.6897058824 | 0.6897058824
D6 | 1 |  | S6MC | S6MC | Library:S6MC |  | 0.03382352941 | 0.03382352941
D2 | 1 |  | SS14 | SS14 | Library:DIOM4325X250N |  | 0.01323529412 | 0.01323529412
D1 | 1 |  | SS34FA | SS34FA | Library:SS34FA |  | 0.2 | 0.2
Y1 | 1 |  | TAXM12M4RLBDDT2T | TAXM12M4RLBDDT2T | Library:TAXM12M4RLBDDT2T |  | 0.03529411765 | 0.03529411765
U4 | 1 |  | W25Q128JVSIQ | W25Q128JVSIQ | Library:W25Q128JVS |  | 0.3632352941 | 0.3632352941
 | 1 |  | PCB 2 layer board of 103.11x156mm |  |  |  | 0.8676470588 | 0.8676470588
 |  |  |  |  |  |  |  | 4.613235294
 |  |  |  |  |  |  | #20231220
 |  |  |  |  |  |  | Product | IO_Board PCBA
 |  |  |  |  |  |  | QTY | 300
 |  |  |  |  |  |  | Materials cost | 4.613235294
 |  |  |  |  |  |  | Assembly cost | 0.8823529412
 |  |  |  |  |  |  | Overhead | 0.2857705882
 |  |  |  |  |  |  | Profit | 0.8233470588
 |  |  |  |  |  |  | Total Unit price USD/pcs | 6.604705882
 |  |  |  |  |  |  | PCB specification | Blue, 1.0mm thickness, HASL-RoHS, 1oz.
 |  |  |  |  |  |  | #20231220
 |  |  |  |  |  |  | Product | IO_Board PCBA
 |  |  |  |  |  |  | QTY | 300
 |  |  |  |  |  |  | Unit price | 6.6
 |  |  |  |  |  |  | Set up fee | 30
 |  |  |  |  |  |  | Total USD | 2010
 |  |  |  |  |  |  | PCB specification | Blue, 1.0mm thickness, HASL-RoHS, 1oz.
