ihsanakyrk/Eski-Versionlar-Ve-Siparisler/KSS_Bağlantı kutusu_V2.0(Eski nesil hub)/Production/RP2040_minimal.xlsx

RP2040_minimal
Id | Designator | Footprint | Quantity | Designation | Supplier and ref
1 | R1,R2,R4,R5 | R_0603_1608Metric | 4 | 10K
2 | J3,J2 | KF2EDGR-Y-5.08-03P-1 B | 2 | Conn_01x03_Pin
3 | D1,D2 | D_SMA | 2 | MRA4007T3G
4 | IC1,IC2 | SOT96P237X111-3N | 2 | MMBT2222ALT1G
5 | R7 | R_0603_1608Metric | 1 | 3.3K
6 | J1 | JST_XH_S8B-XH-A_1x08_P2.50mm_Horizontal | 1 | Conn_01x08_Socket
7 | K2,K1 | RELAY_SRD-05VDC-SL-C | 2 | SRD-12VDC-SL-C
8 | J7 | RJ45_Amphenol_54602-x08_Horizontal | 1 | 8P8C
9 | J4 | PinHeader_1x01_P1.00mm_Horizontal | 1 | DNP
10 | LED1 | LED_0805_2012Metric | 1 | NCD0805R1
11 | R3,R6 | R_0603_1608Metric | 2 | 0R
