ihsanakyrk/Eski-Versionlar-Ve-Siparisler/MXVR_3566_V2.0/MXVR_3566_V2.0_(15.04.2024)/Document/ssd_connector.dxf

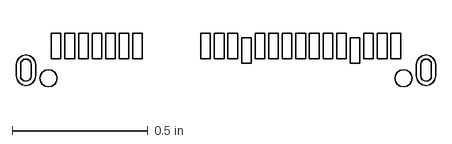
[picture p20: CAD file, 2025-09-01, an earlier design]
MXVR_3566_V2.0/MXVR_3566_V2.0_(15.04.2024)/Document/ssd_connector.dxf
1.54 x 0.197 in
