ihsanakyrk/Eski-Versionlar-Ve-Siparisler/GSM_A7602E-H_Modul_V1.0/GSM.pdf

# J1 CastellatedHoles_5Ways_2_54mm 1

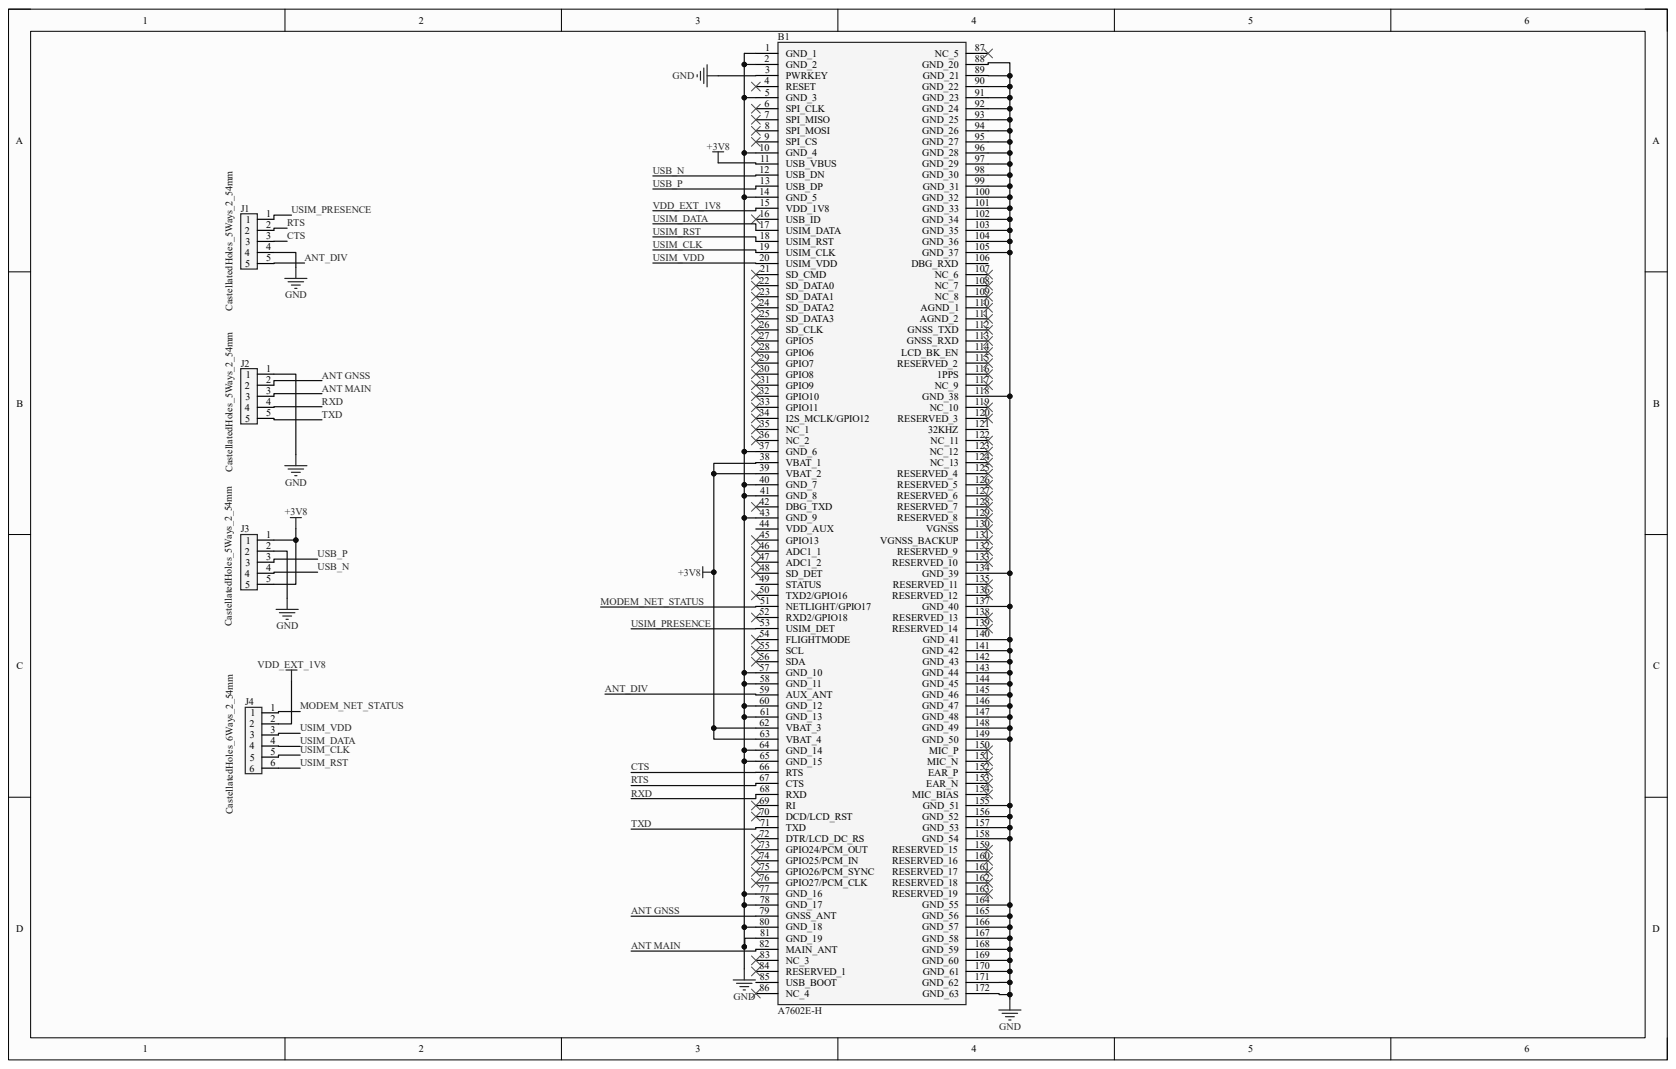
[picture p21: page 1]
GND_1; GND_2; PWRKEY; RESET; GND_3; SPI_CLK; SPI_MISO; SPI_MOSI; SPI_CS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

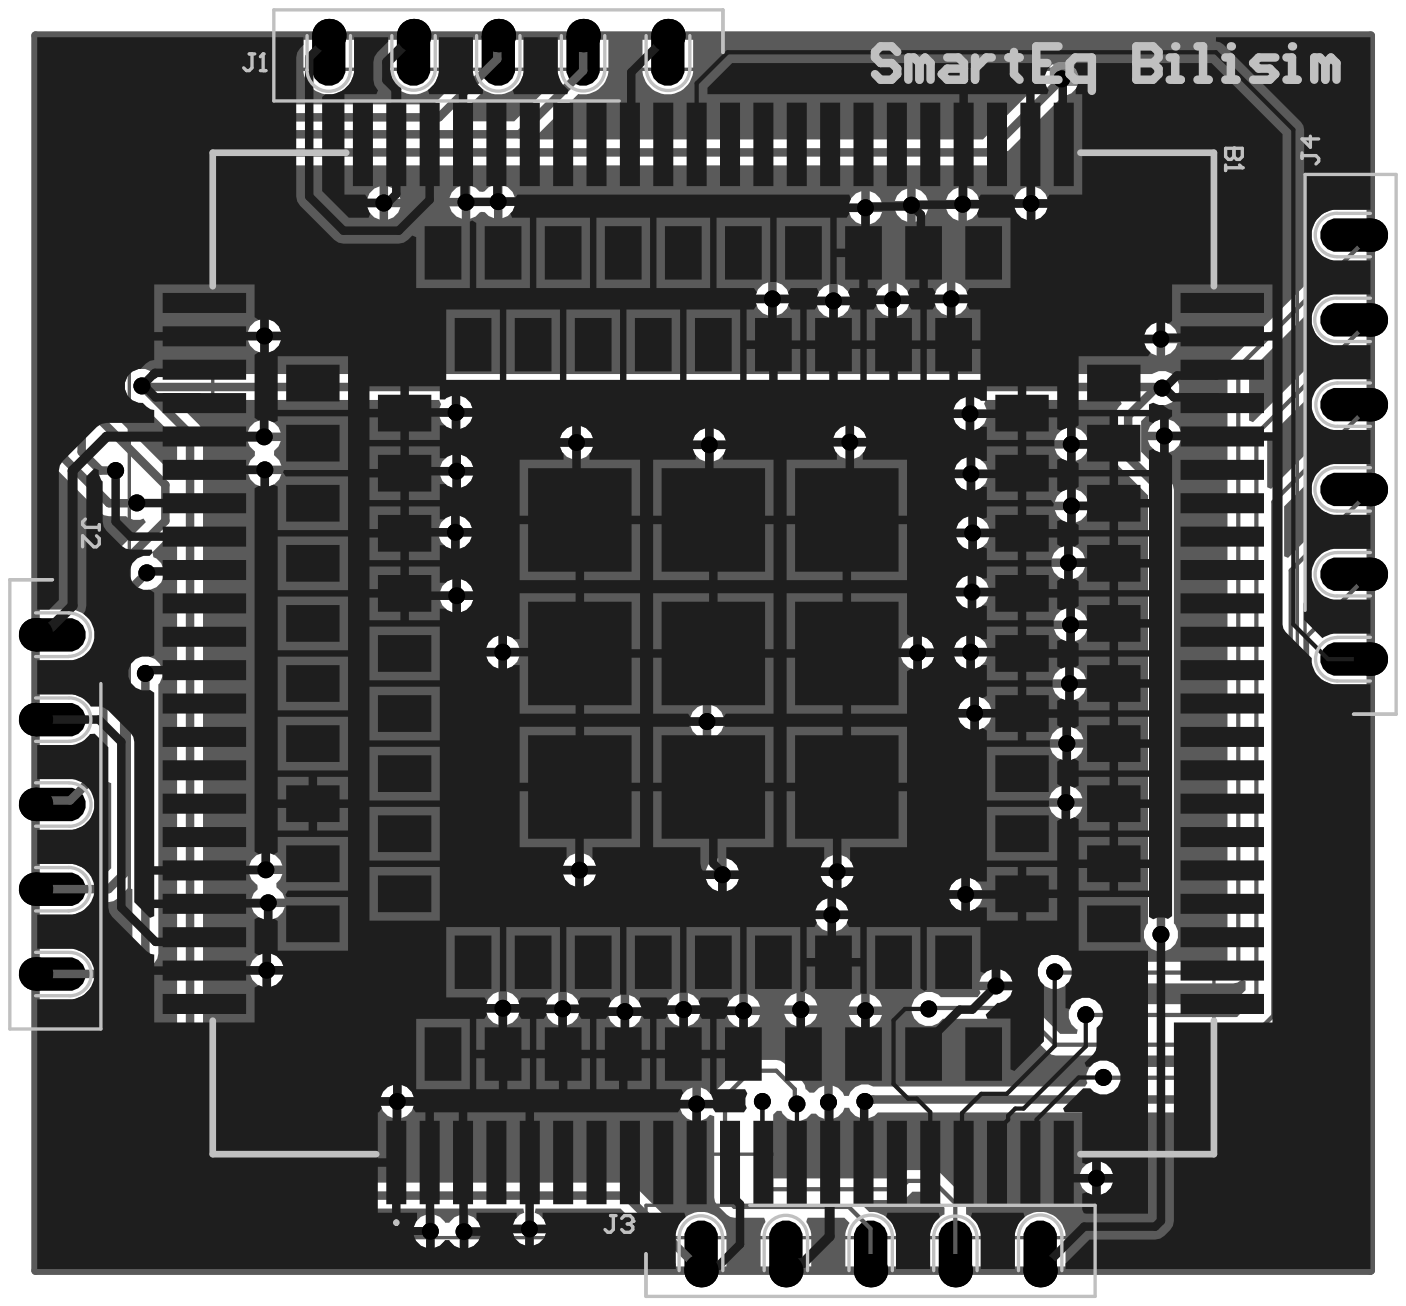
[picture p22: page 2]

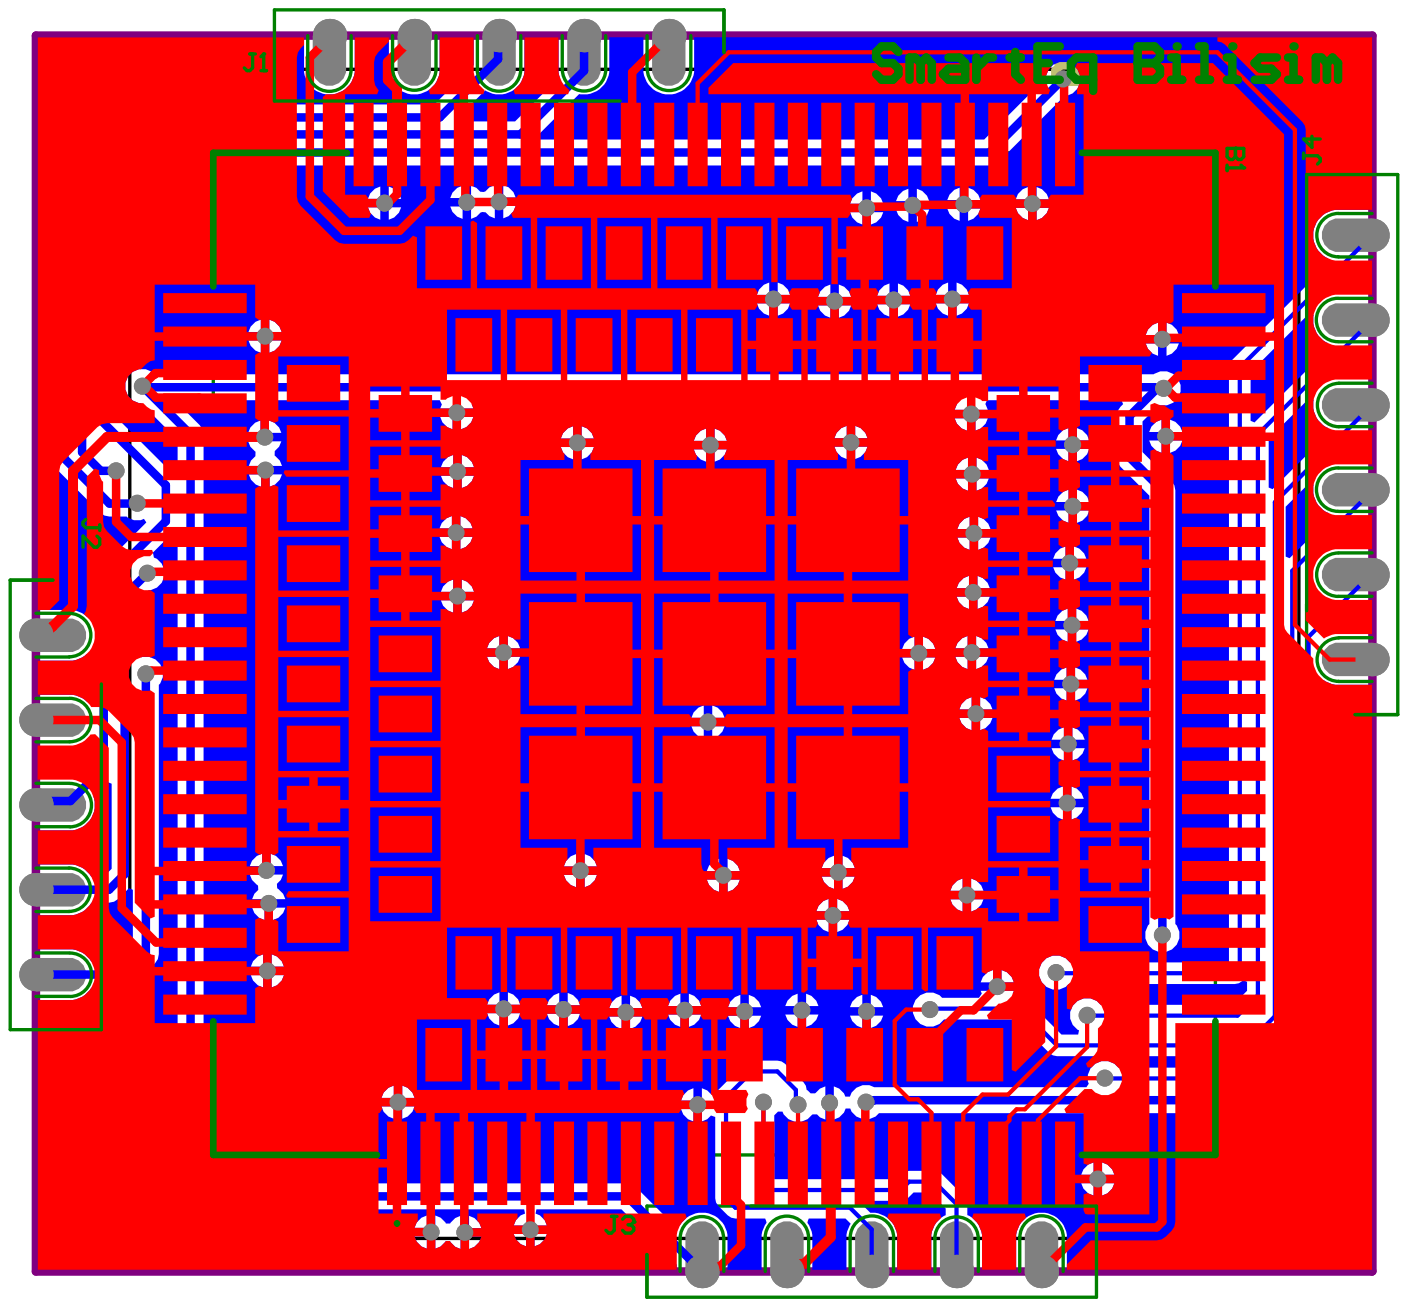
[picture p23: page 3]

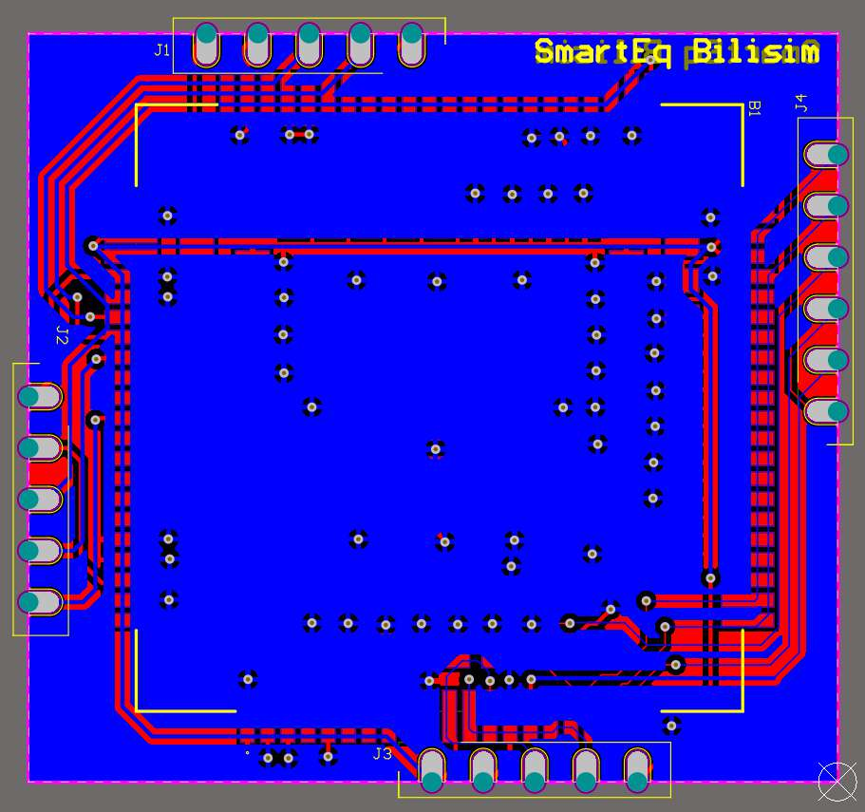
[picture p24: page 4]
