ihsanakyrk/Eski-Versionlar-Ve-Siparisler/Movita_3568_AXV_Router_V3.0/Document/EM3568-TU_RV1SCH.pdf

D | D
Version | Date | By | Change Dsecription | Approved

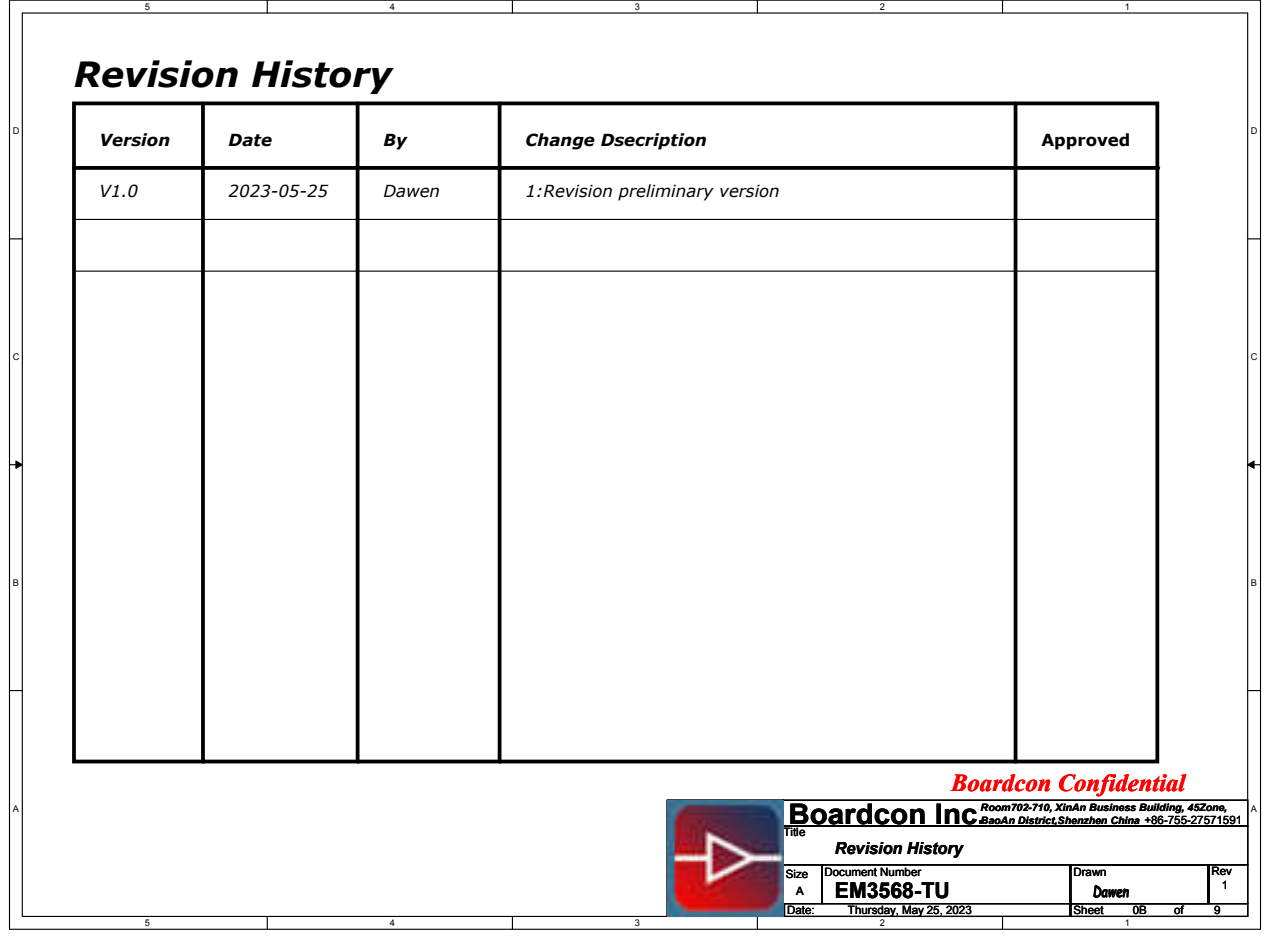
[picture p25: page 1]
Dawen; Revision History; 1:Revision preliminary version; Title; Size; Document Number; Rev; Date:; Sheet; Drawn; Thursday, May 25, 2023; Boardcon Confidential

Boardcon Inc.BaoAn District,Shenzhen China

Room702-710, XinAn Business Building, 45Zone,

# EM3568-TU Block Diagram

# ETHERNET0

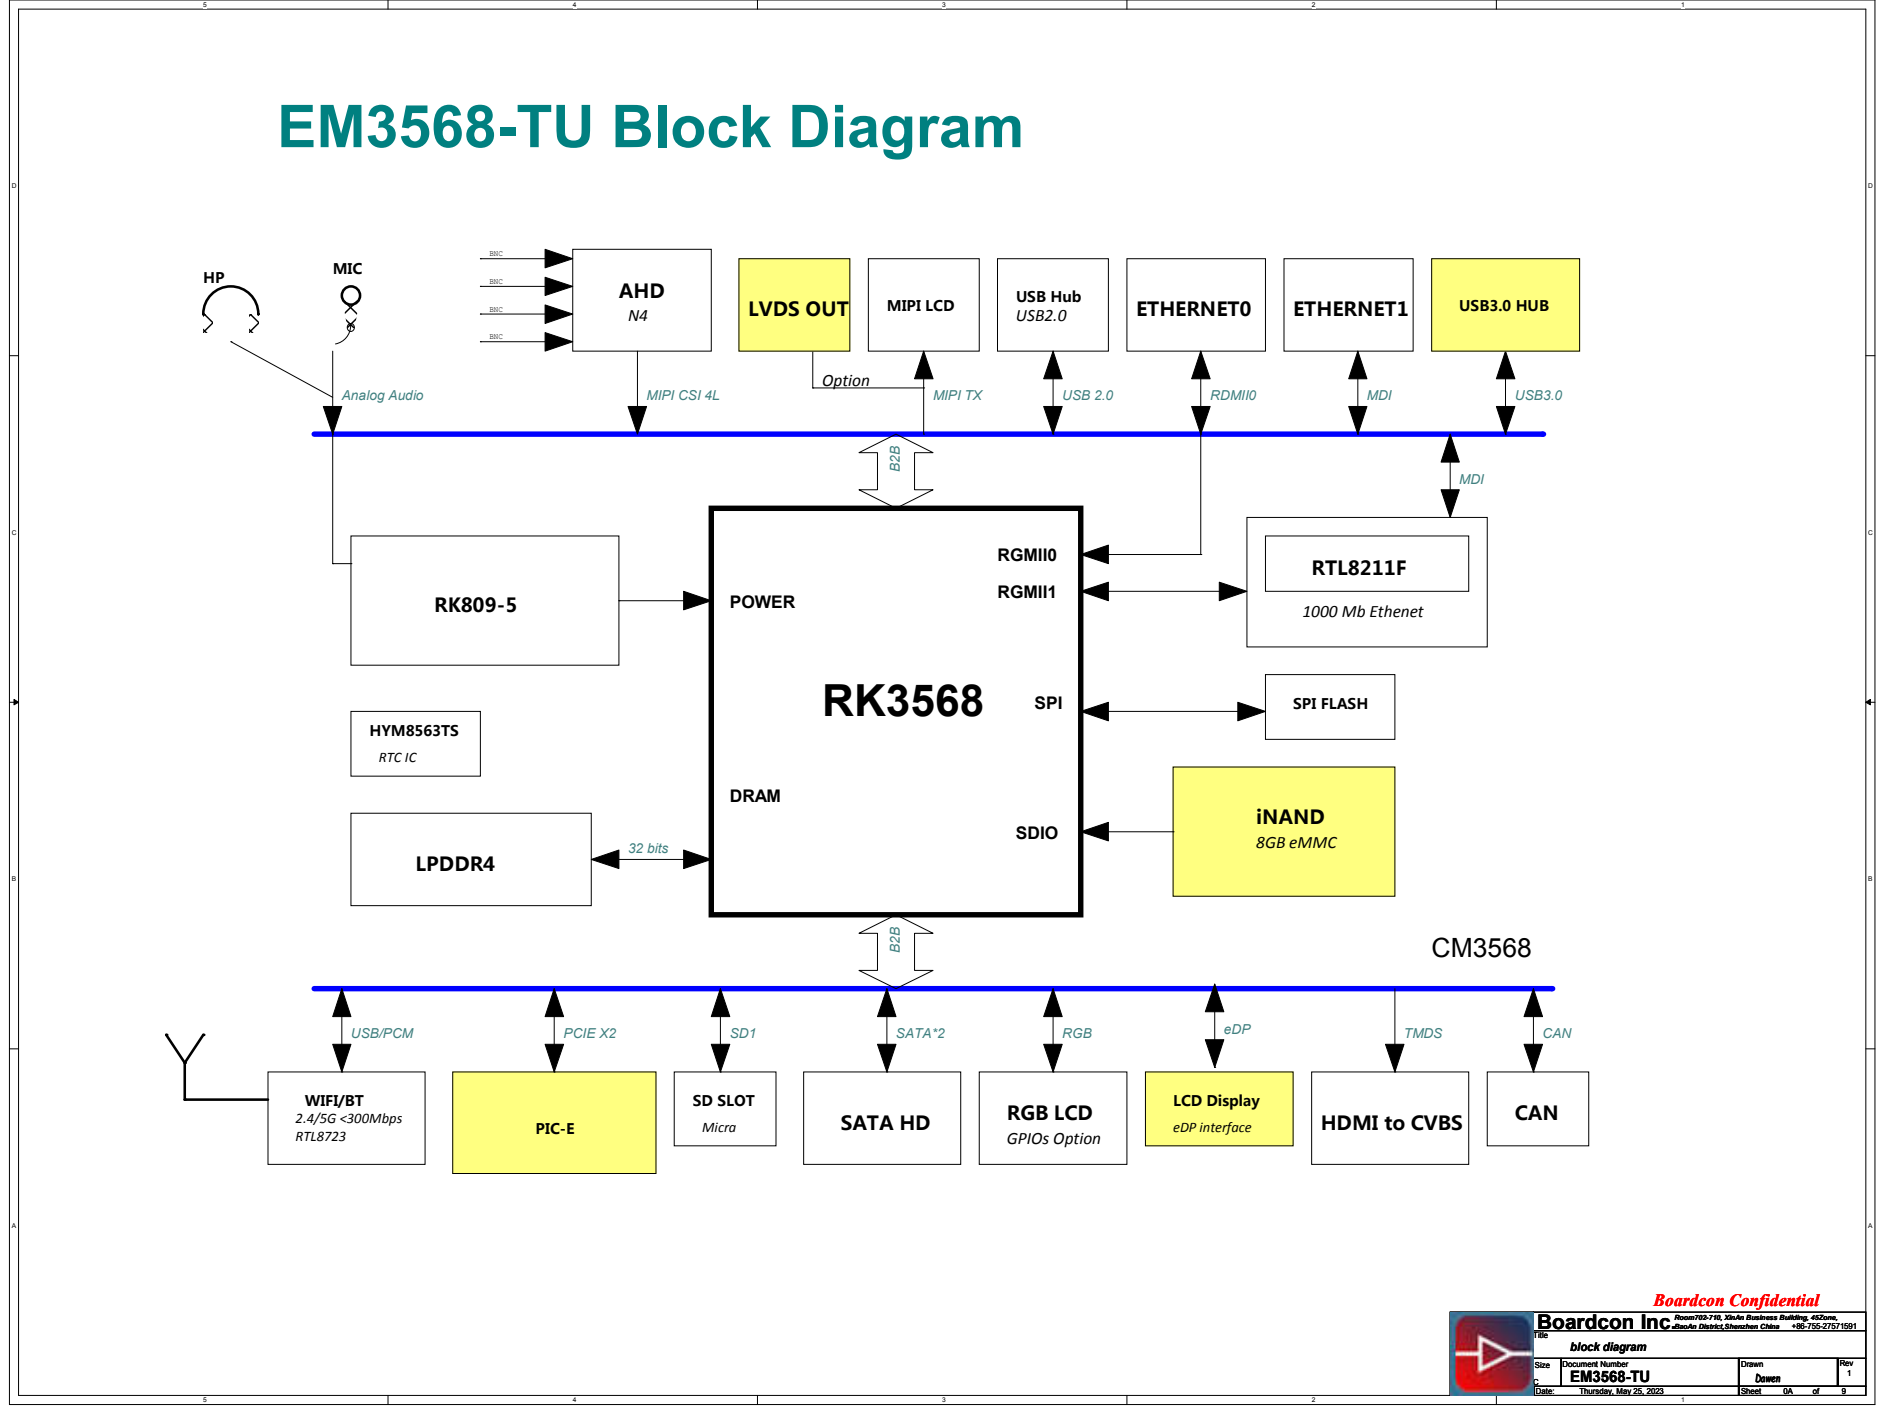
[picture p26: page 2]
POWER; DRAM; RGMII1; RTL8211F; SATA HD; RGB LCD; GPIOs Option; MIC; WIFI/BT; RTL8723; LCD Display; eDP interface; USB3.0 HUB; LPDDR4; MIPI LCD; USB Hub; PIC-E; SD SLOT; Micra; MIPI CSI 4L; MIPI TX; USB 2.0; RDMII0; USB3.0; USB/PCM; PCIE X2; SATA*2; RGB; eDP; 32 bits; 1000 Mb Ethenet; 8GB eMMC; iNAND; SDIO; USB2.0; TMDS; 2.4/5G <300Mbps; LVDS OUT; Option; MDI; RGMII0; Analog Audio; ETHERNET1; AHD; HYM8563TS; RTC IC; SPI; SPI FLASH; CAN; BNC; Title; Thursday, May 25, 2023; block diagram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

HDMI to CVBS

Boardcon Inc.BaoAn District,Shenzhen China

Room702-710, XinAn Business Building, 45Zone,

# SOM Connector

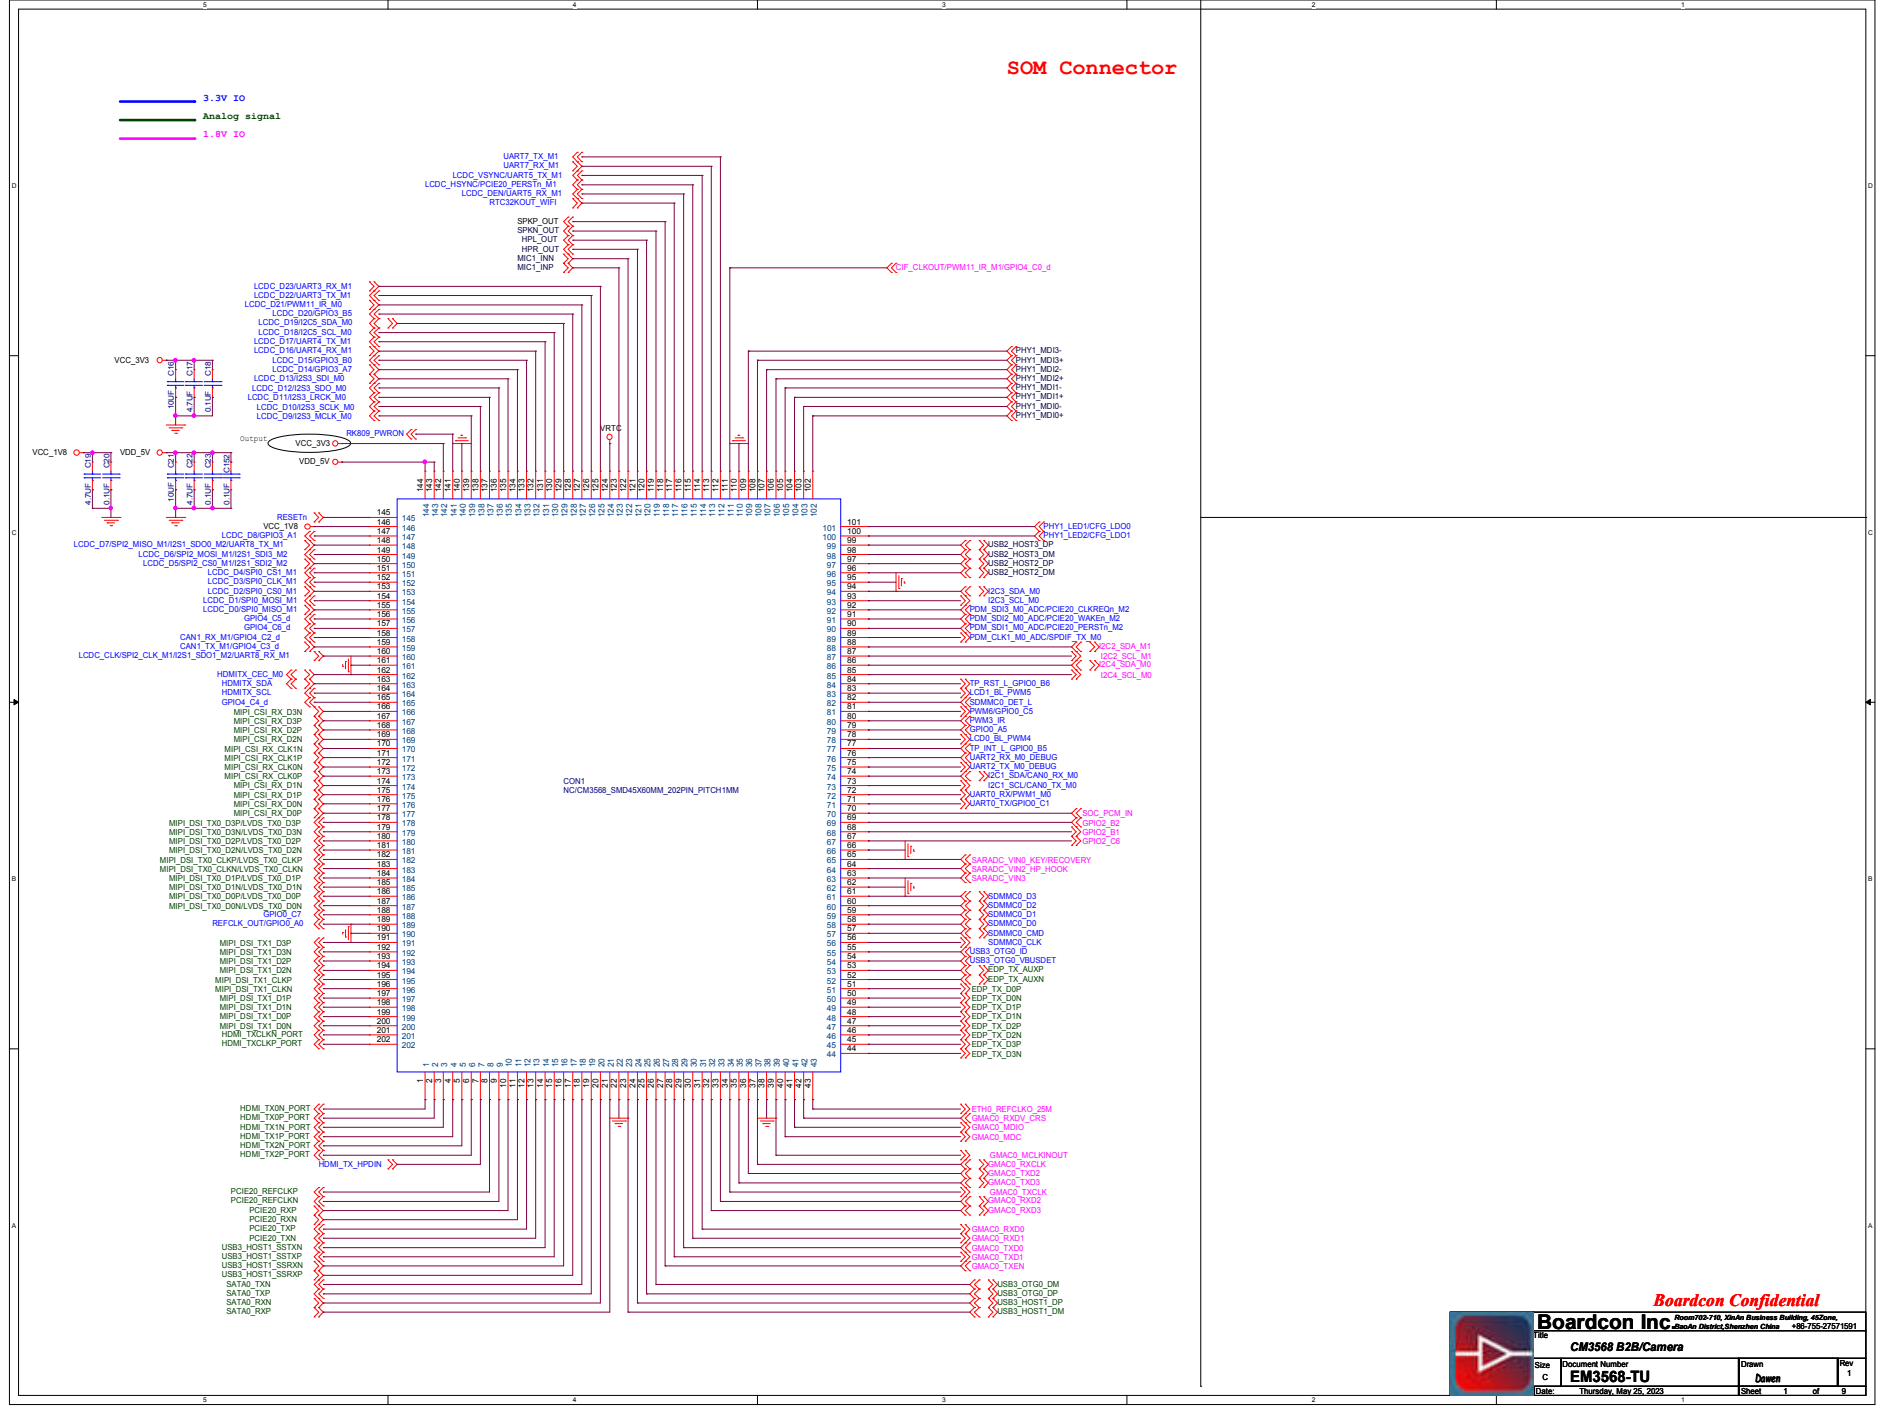
[picture p27: page 3]

# MAIN 3.3V

# MAIN 5V

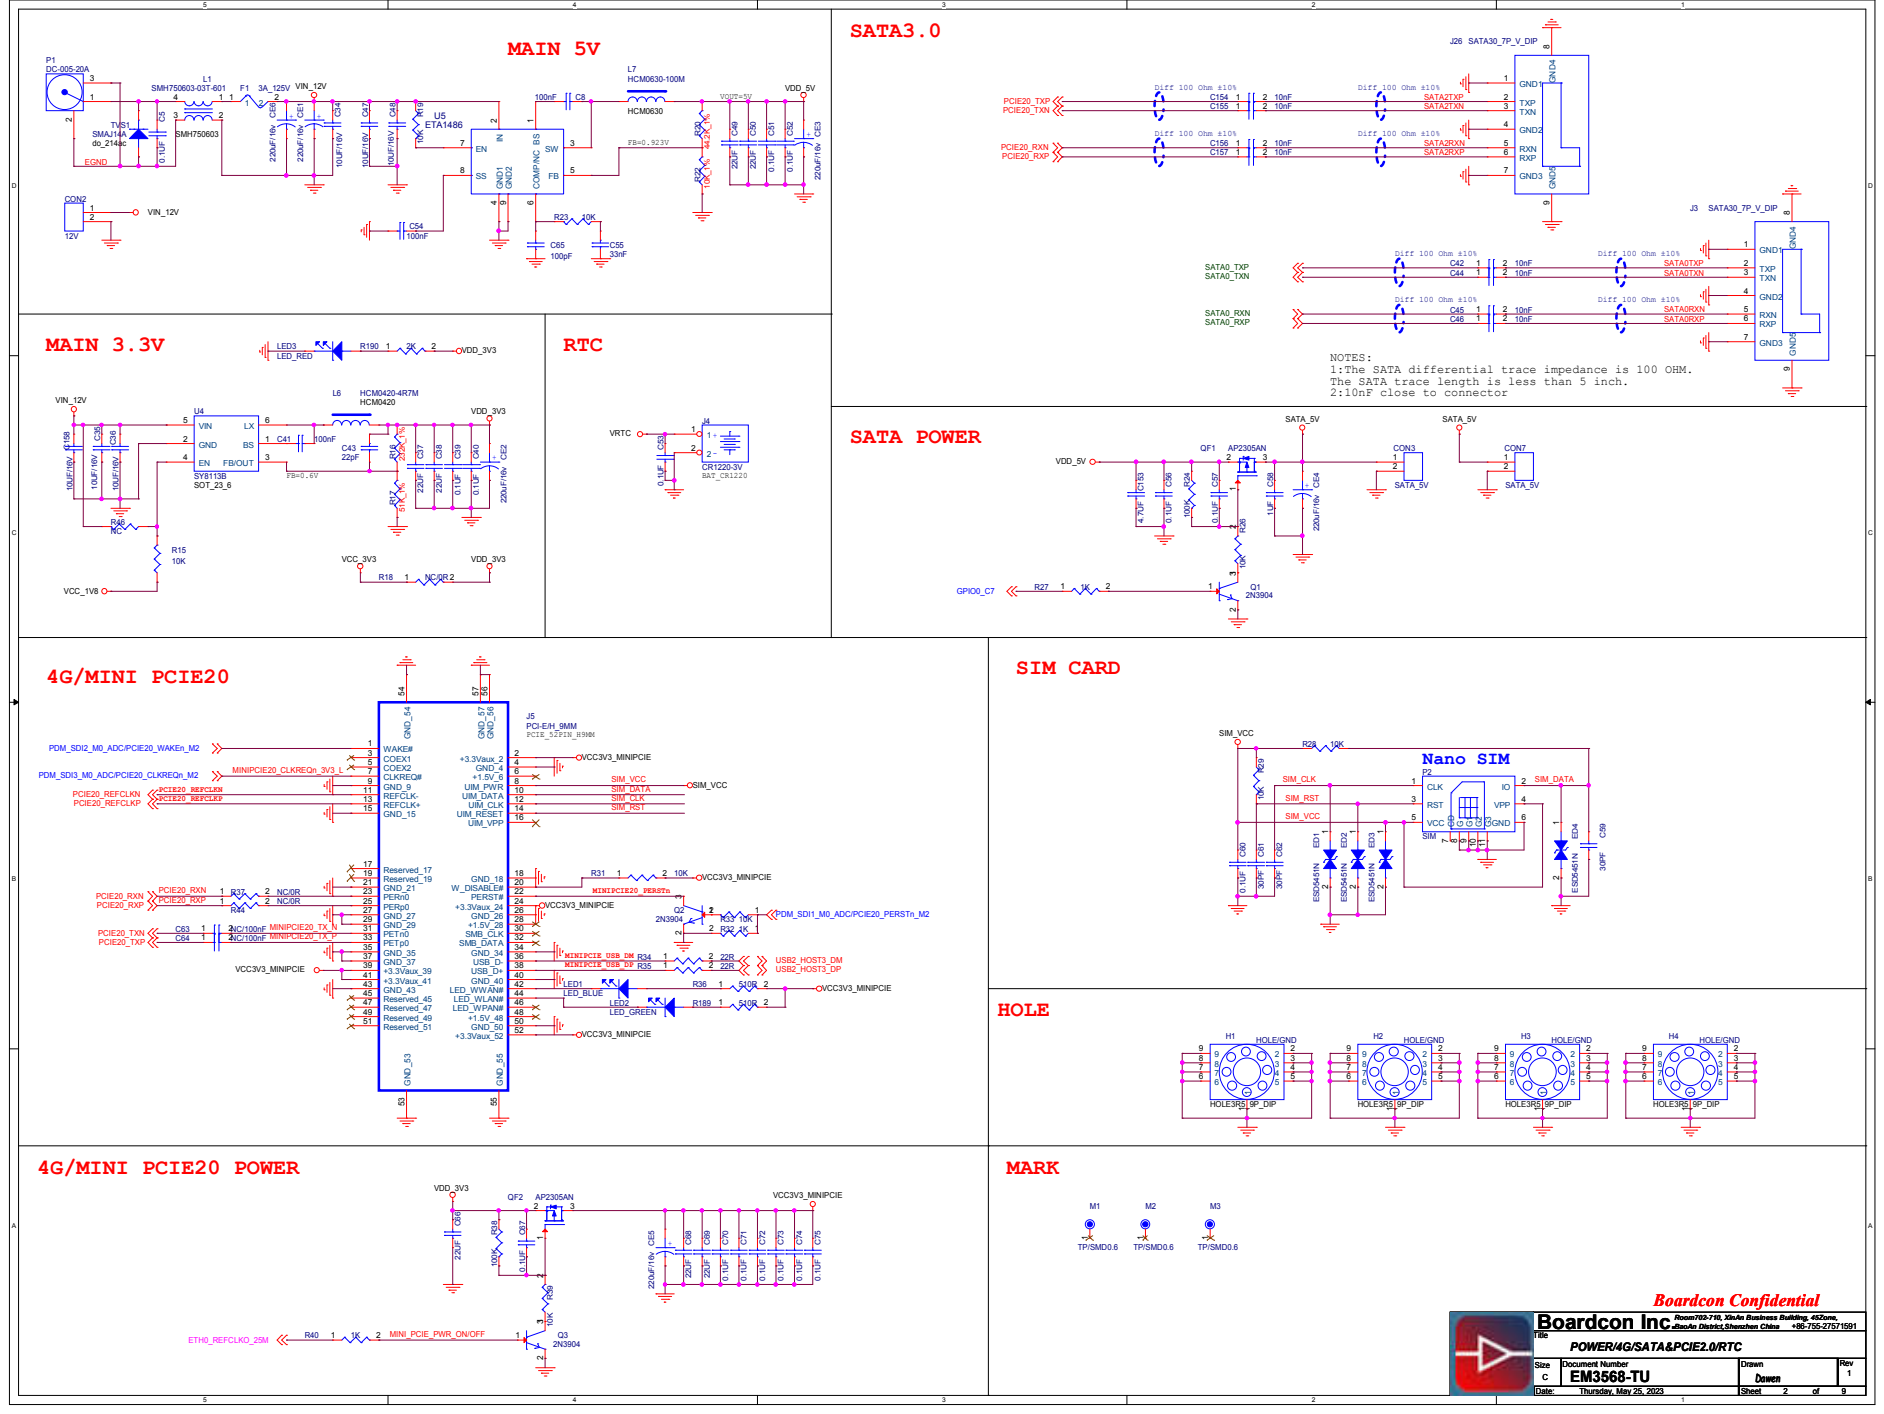
[picture p28: page 4]

NOTES:
1:The SATA differential trace impedance is 100 OHM.
The SATA trace length is less than 5 inch.
2:10nF close to connector

Debug UART2 | RECOVER KEY

# PowerOn/OFF_Key

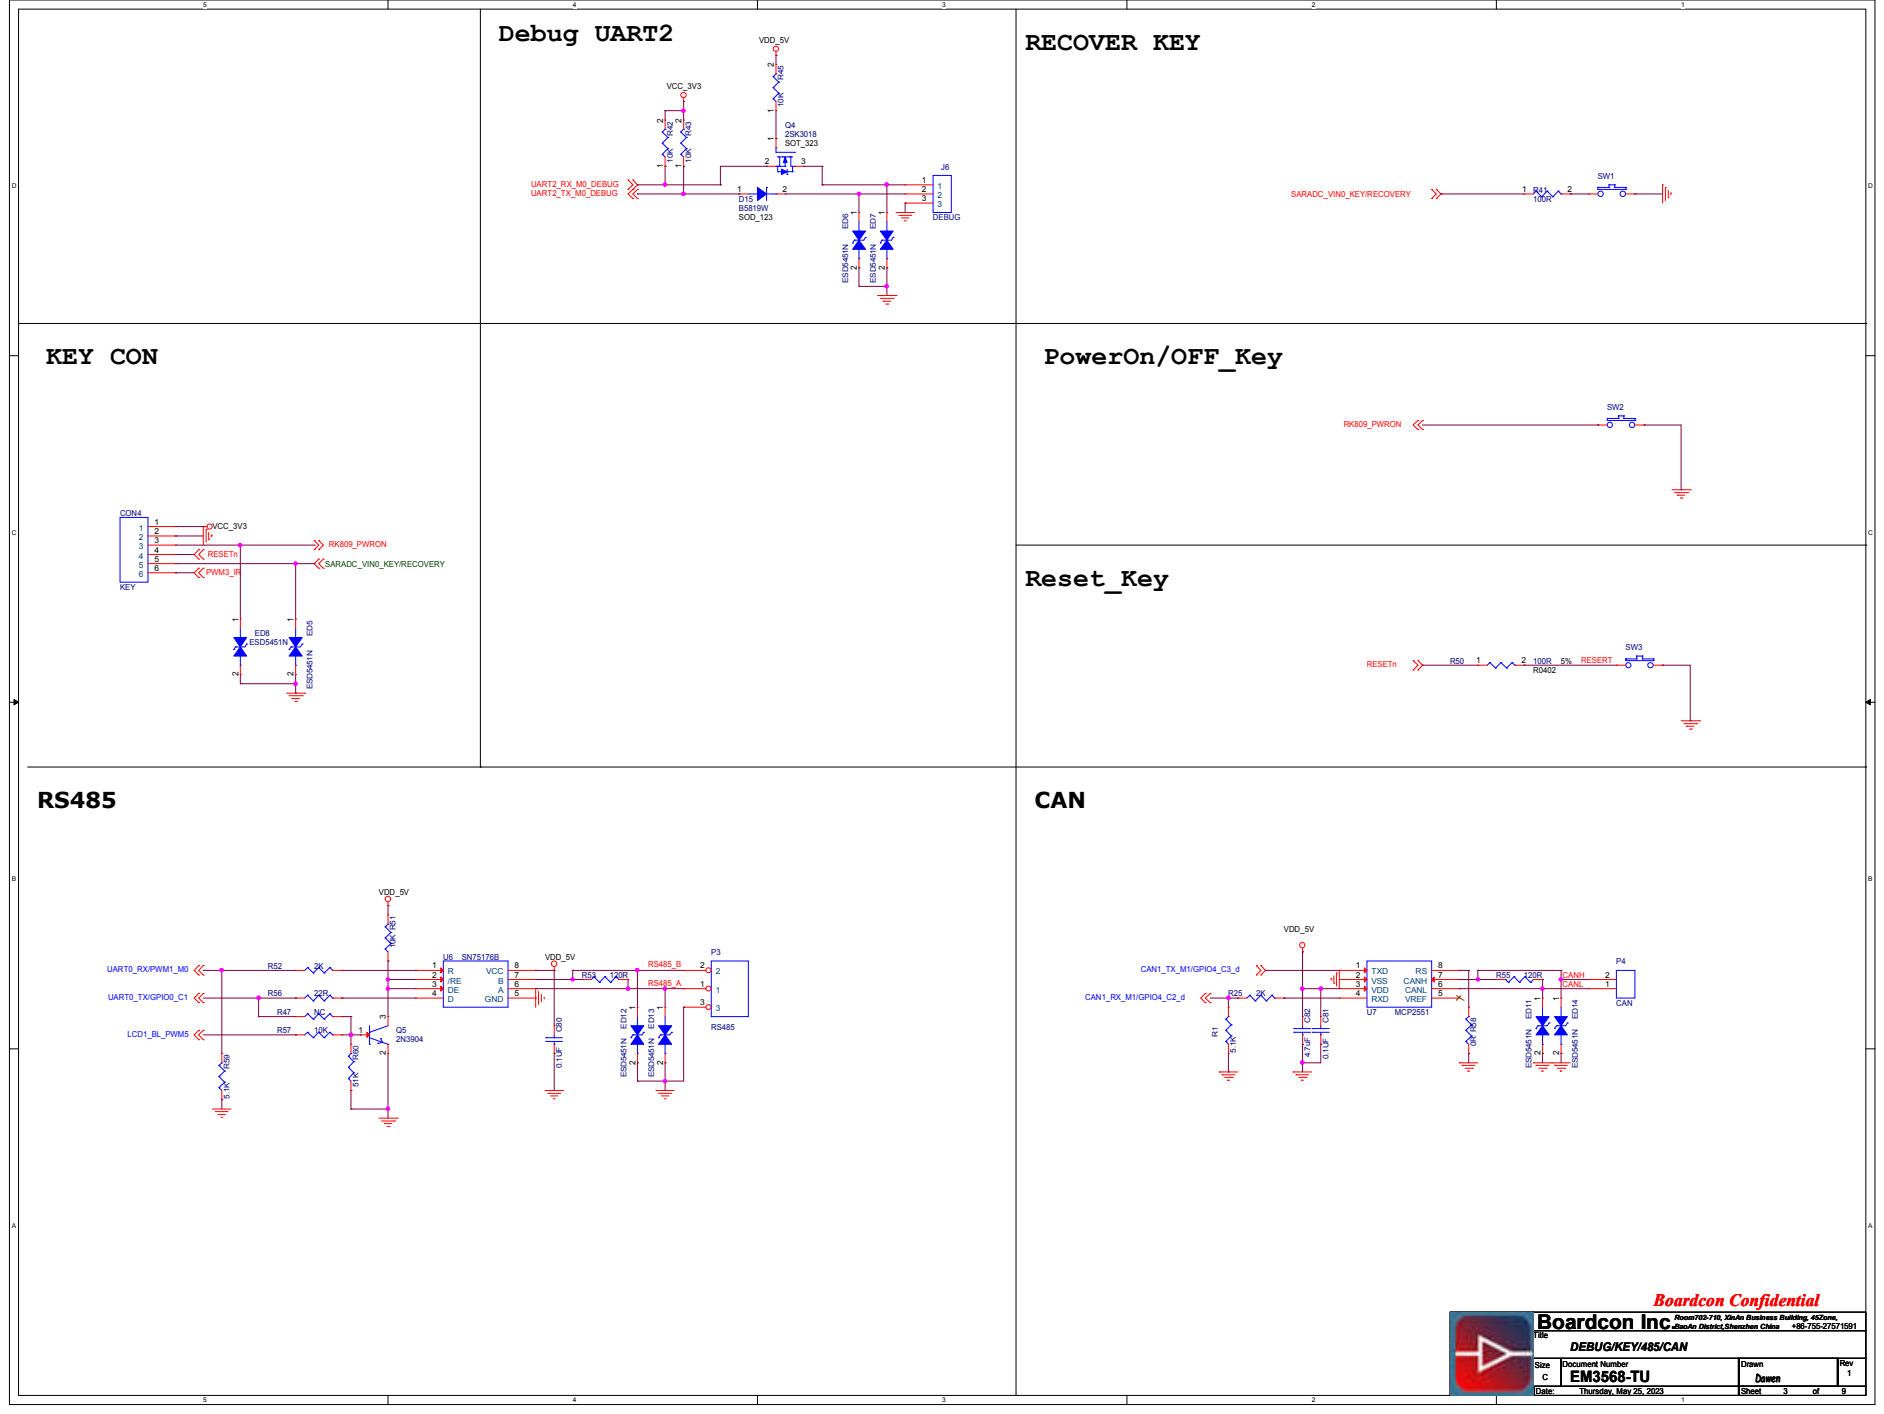
[picture p29: page 5]

# MicroSD Card

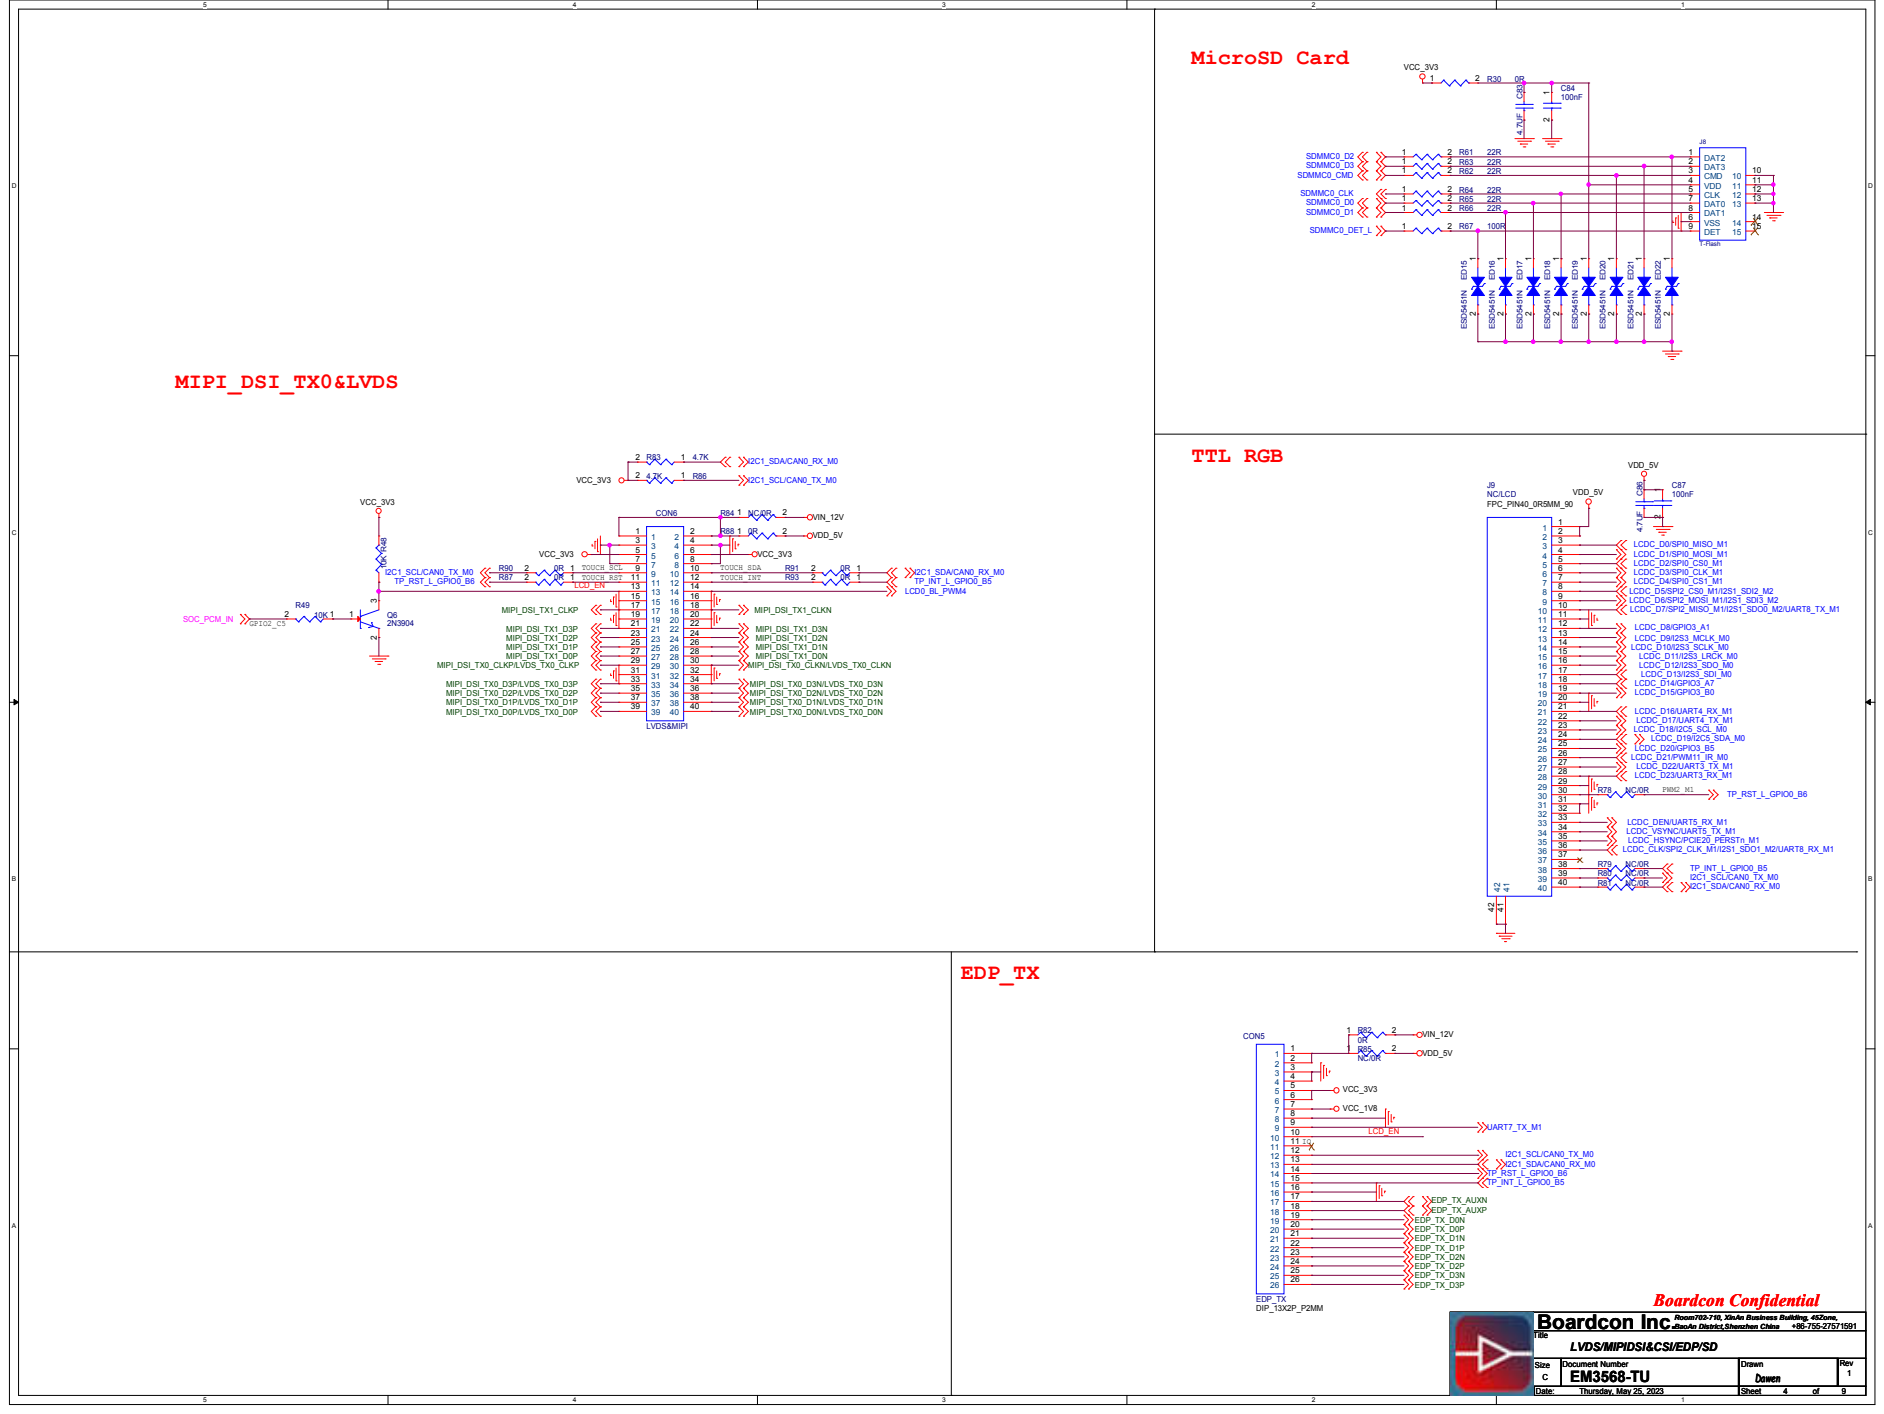
[picture p30: page 6]

LVDS/MIPIDSI&CSI/EDP/SD

# USB2.0 OTG

## Note:

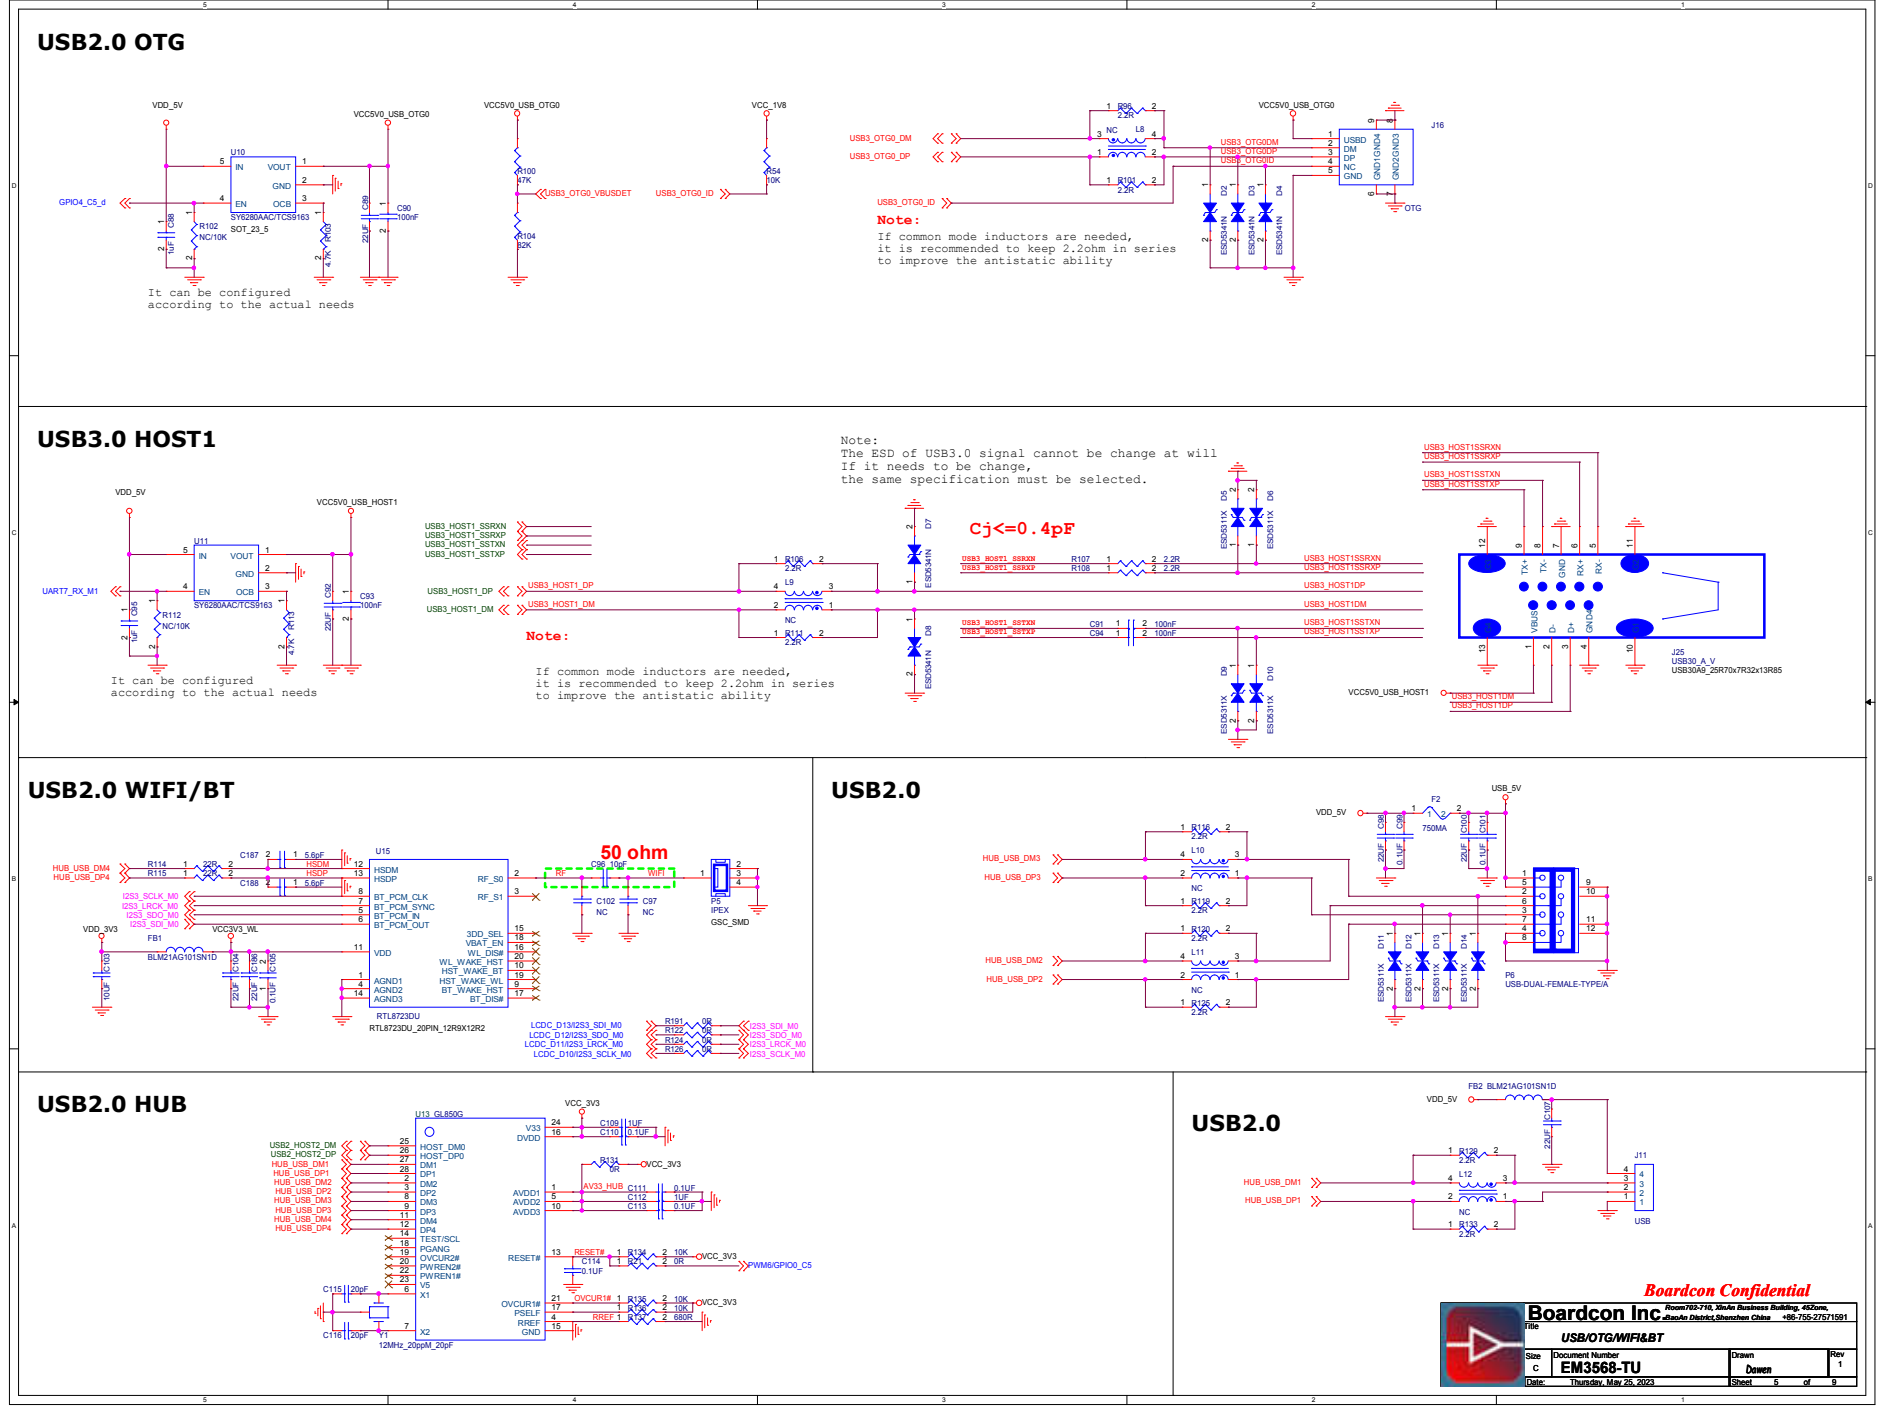
[picture p31: page 7]

If common mode inductors are needed,
it is recommended to keep 2.2ohm in series
to improve the antistatic ability

It can be configured
according to the actual needs

Note:
The ESD of USB3.0 signal cannot be change at will
If it needs to be change,
the same specification must be selected.

6 | 11
4 | 12

USB-DUAL-FEMALE-TYPE/A

USB/OTG/WIFI&BT

Giga PHY0 GMAC0_TXD0 GMAC0_TXD1 GMAC0_TXD2 GMAC0_TXD3 GMAC0_TXEN GMAC0_TXCLK GMAC0_RXD0 GMAC0_RXD1 GMAC0_RXD2 GMAC0_RXD3 GMAC0_RXDV_CRS GMAC0_RXCLK GMAC0_MCLKINOUT GMAC0_MDC GMAC0_MDIO GMAC0_RSTn GPIO0_A5 GMAC0_INT/PMEB REFCLK_OUT/GPIO0_A0 | Y2 | JP2 HR911130C PHY0_MDI1+ MDI1+ 4 PHY0_MDI1-MDI1- 7 PHY0_MDI2+ MDI2+ 5 PHY0_MDI2-MDI2- 6 PHY0_MDI3+ MDI3+ 8 12 LINK0 PHY0_MDI3-R142 510R PHY0_LED2/CFG_LDO1 MDI3- 9 GLEDK 11 GLEDA VDD_3V3

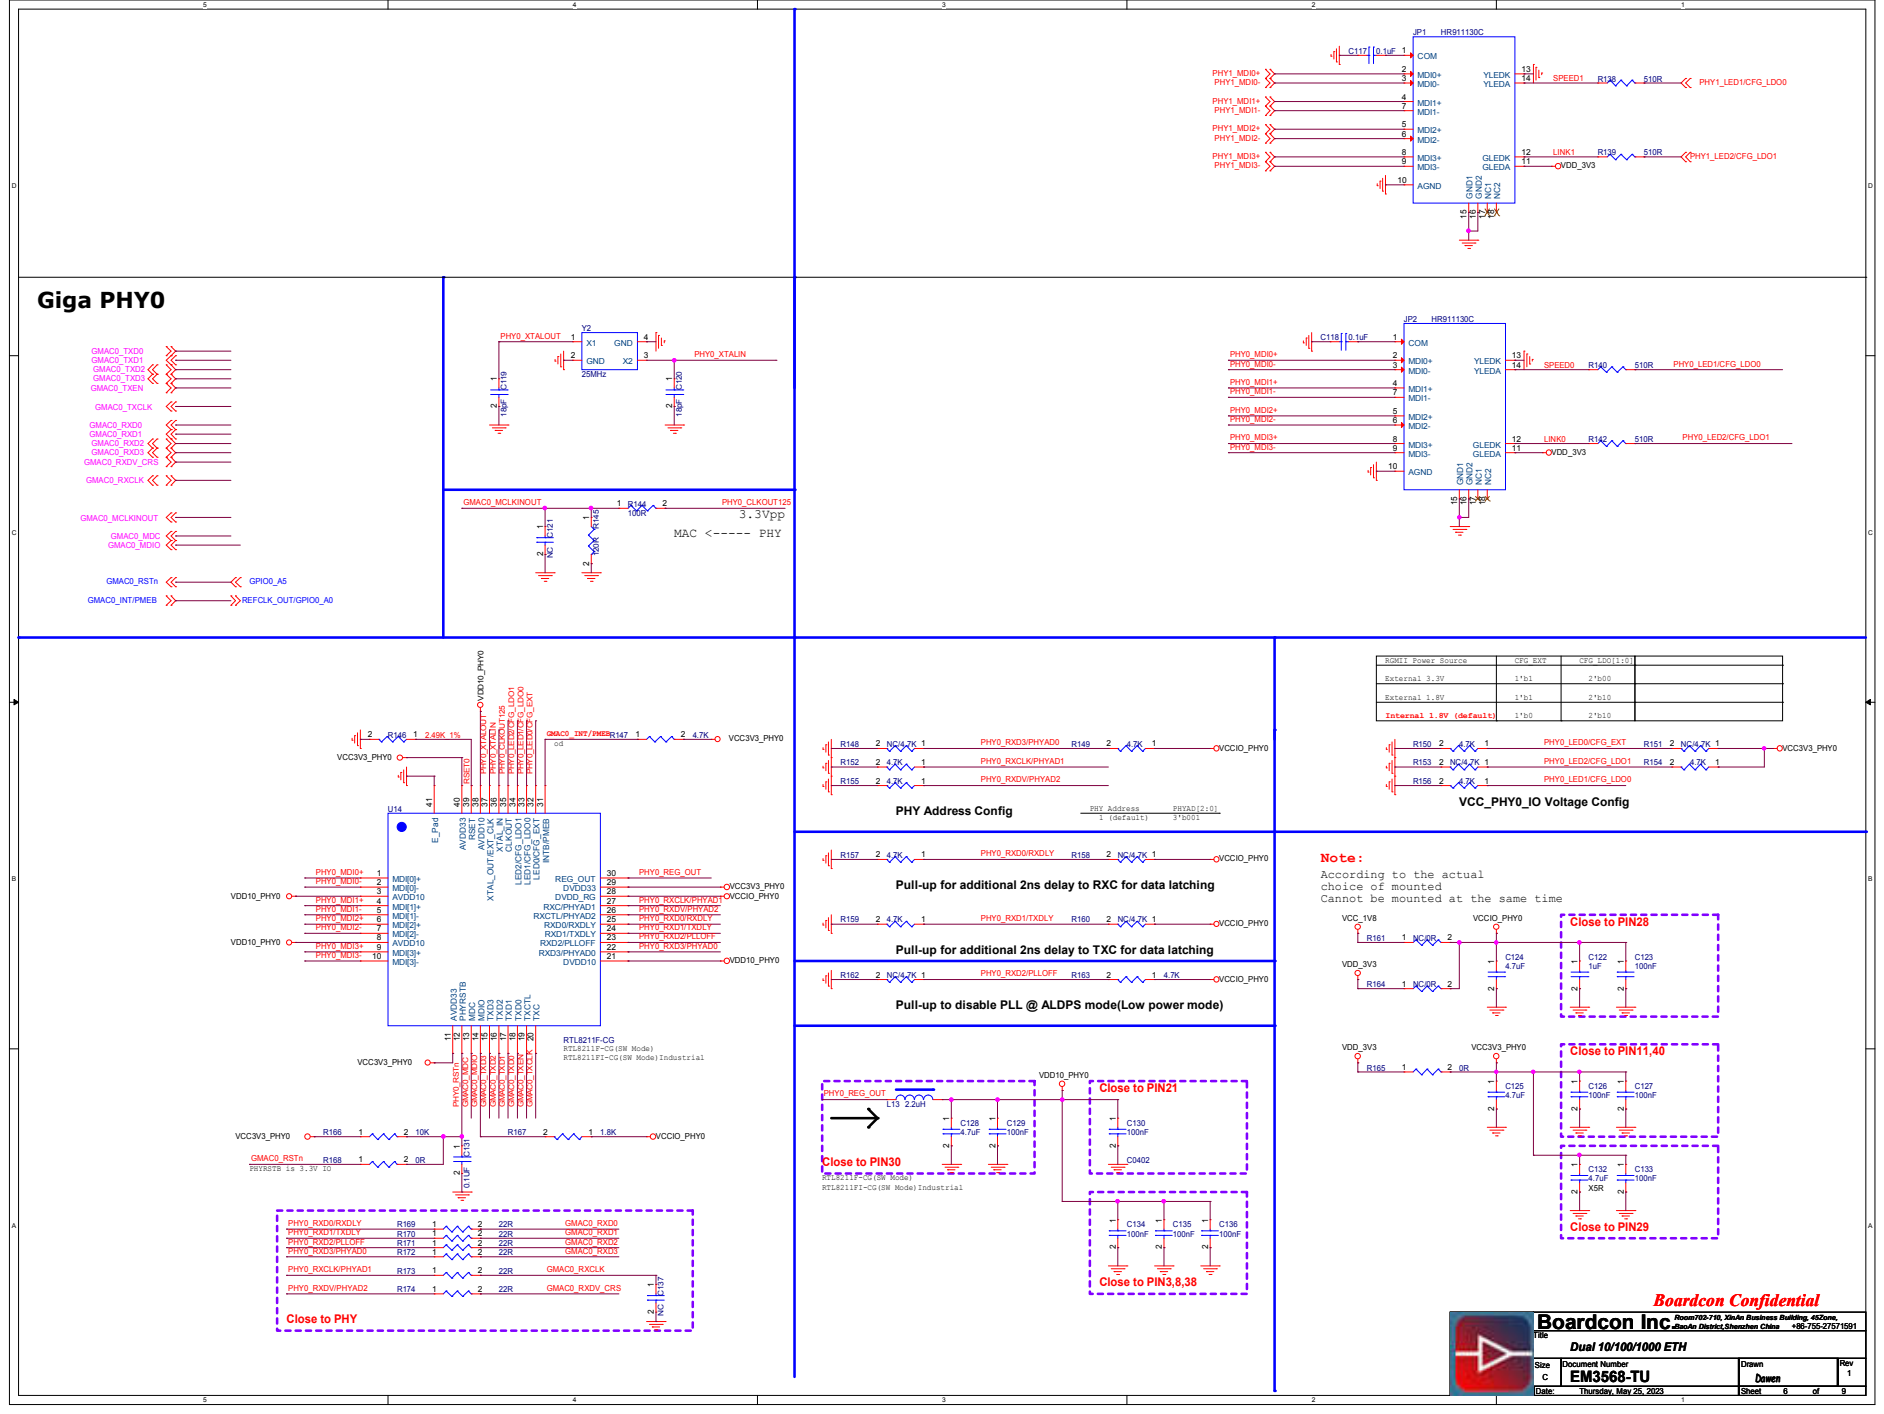
[picture p32: page 8]

GMAC0_MCLKINOUT | 1 R144 2 PHY0_CLKOUT125 MAC <----- PHY

PHY Address Config PHY Address PHYAD[2:0] 1 (default) 3'b001 | VCC_PHY0_IO Voltage Config

Note:
According to the actual
choice of mounted
Cannot be mounted at the same time

Pull-up for additional 2ns delay to RXC for data latching Pull-up for additional 2ns delay to TXC for data latching | Close to PIN28

Pull-up to disable PLL @ ALDPS mode(Low power mode)

RTL8211F-CG
RTL8211F-CG(SW Mode)
RTL8211FI-CG(SW Mode)Industrial

### L+R+G+V

# Headphone

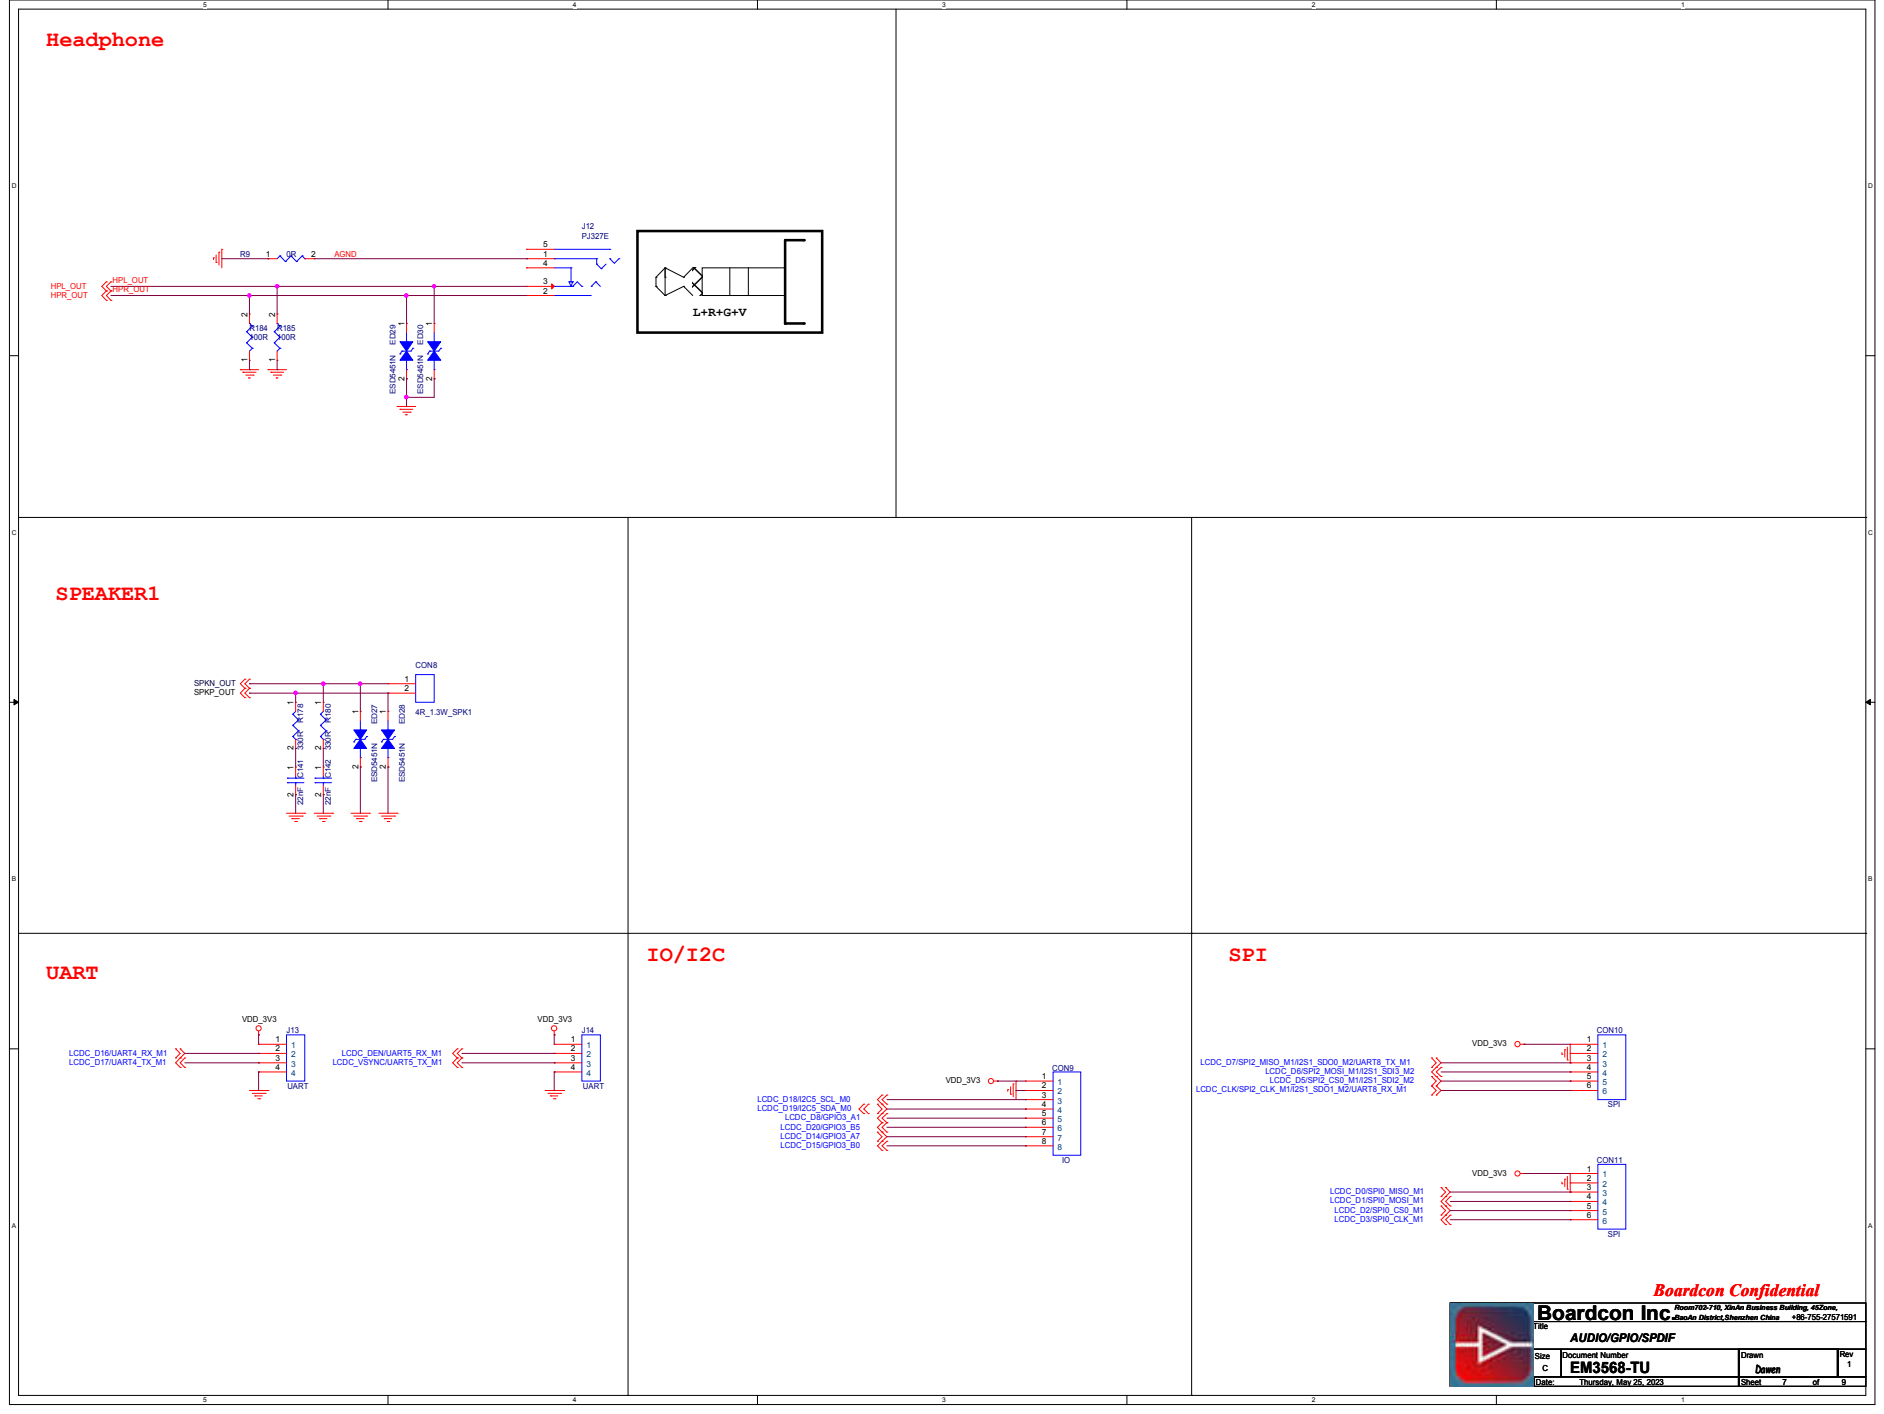
[picture p33: page 9]

### XIN 1

GND2 2 | XOUT | 3

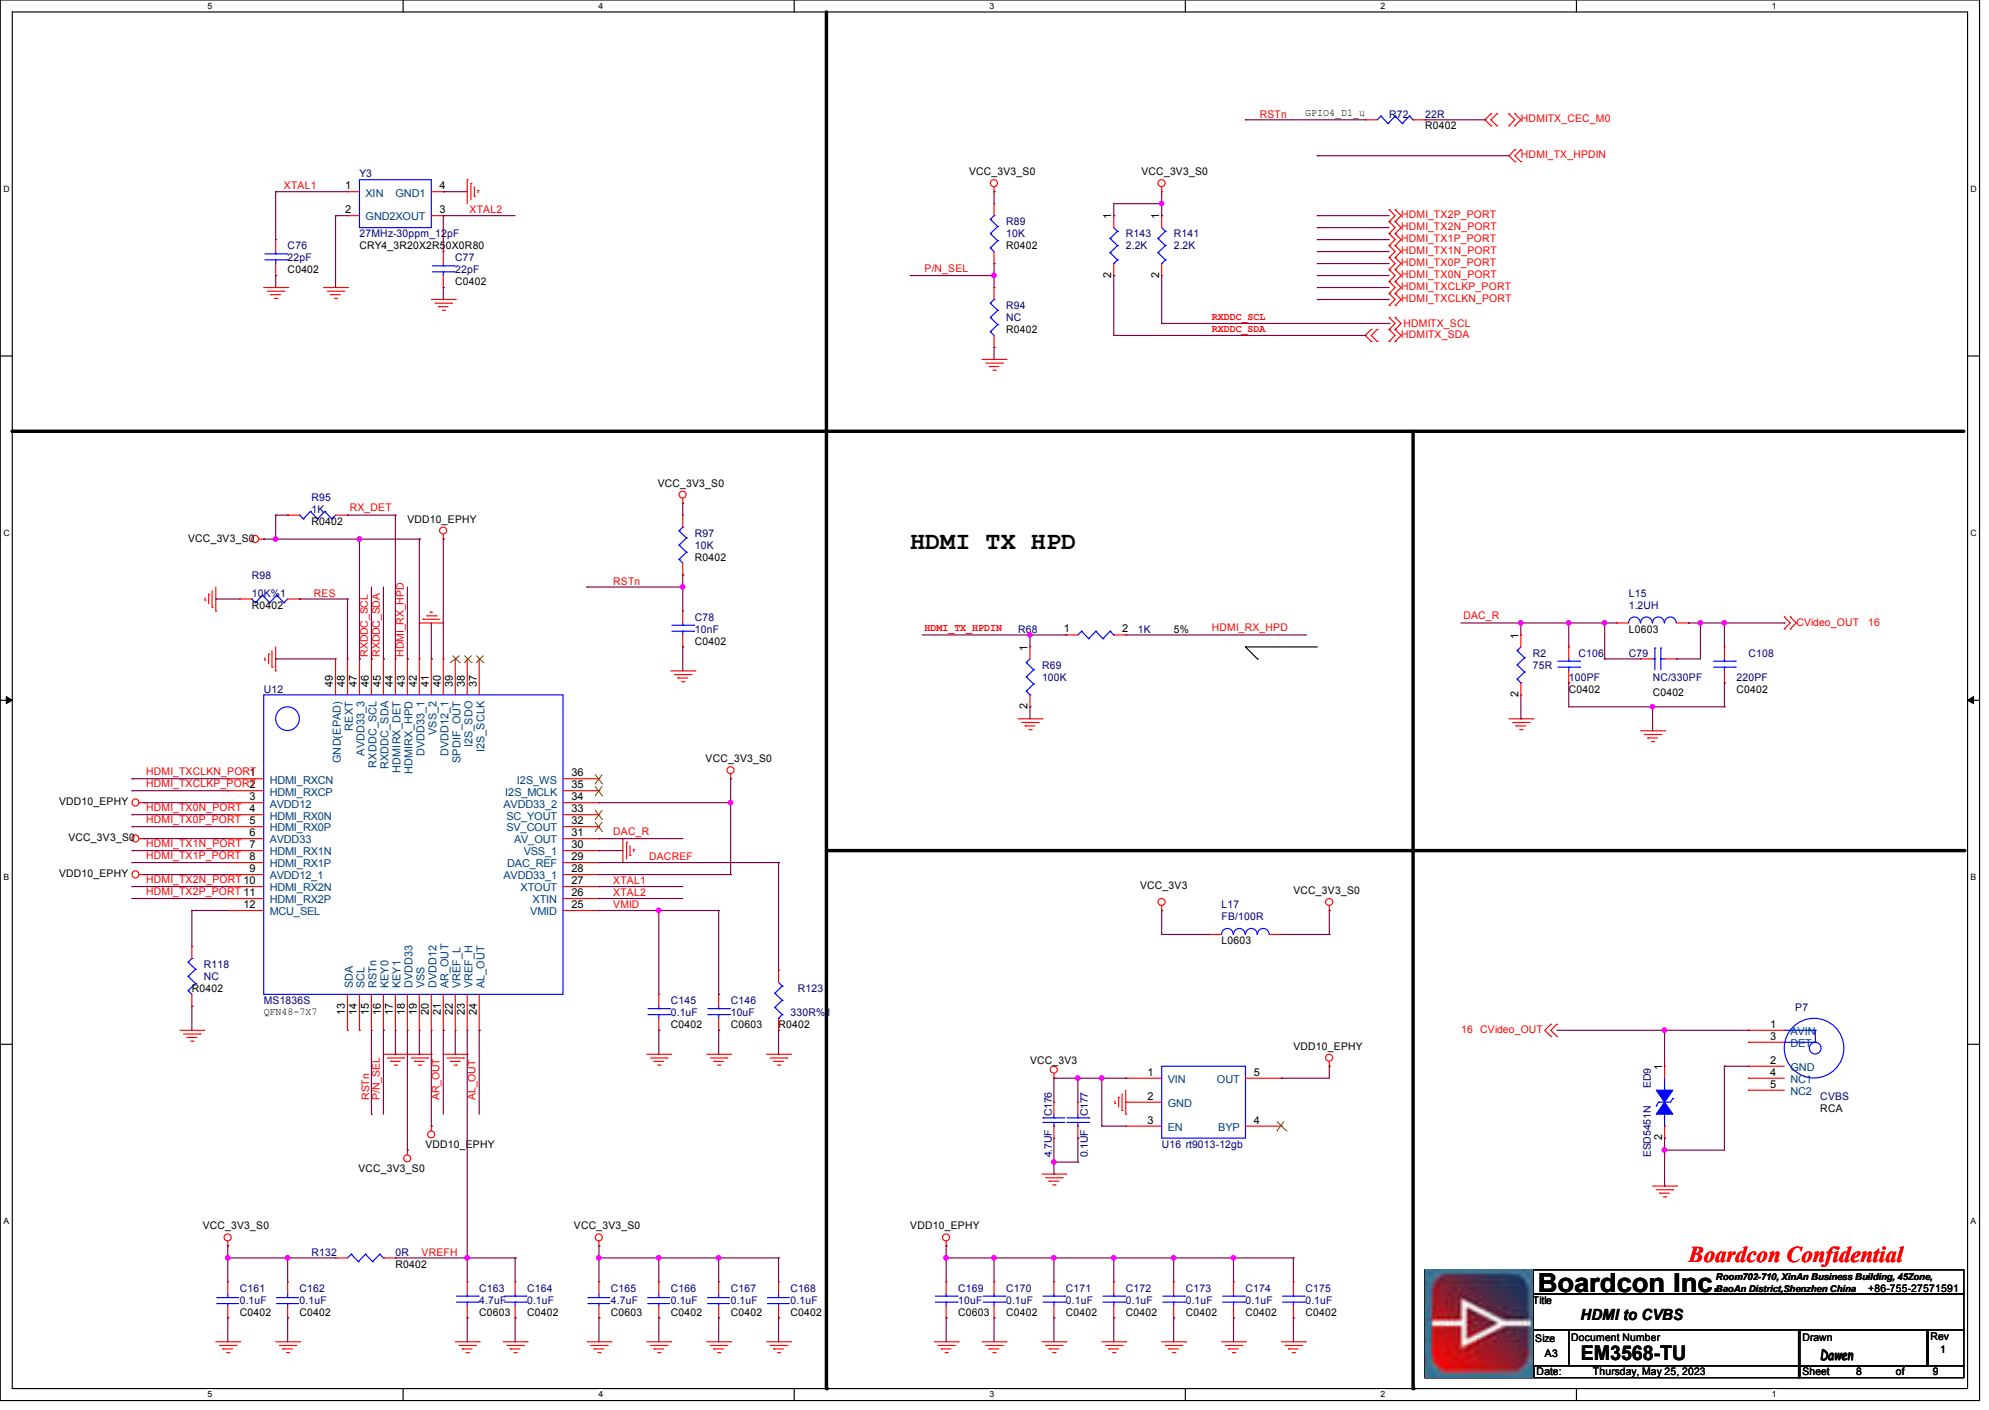
[picture p34: page 10]

Y3 | VCC_3V3_S0 10K R0402 | VCC_3V3_S0 | RSTn GPIO4_D1_u R72 22R HDMITX_CEC_M0 R0402 HDMI_TX_HPDIN R141 HDMI_TX1P_PORT 2.2K

R95 | HDMI TX HPD HDMI_TX_HPDIN HDMI_RX_HPD R68 1 2 1K 5% R69 100K | L15 1.2UH DAC_R

Boardcon Inc.BaoAn District,Shenzhen China

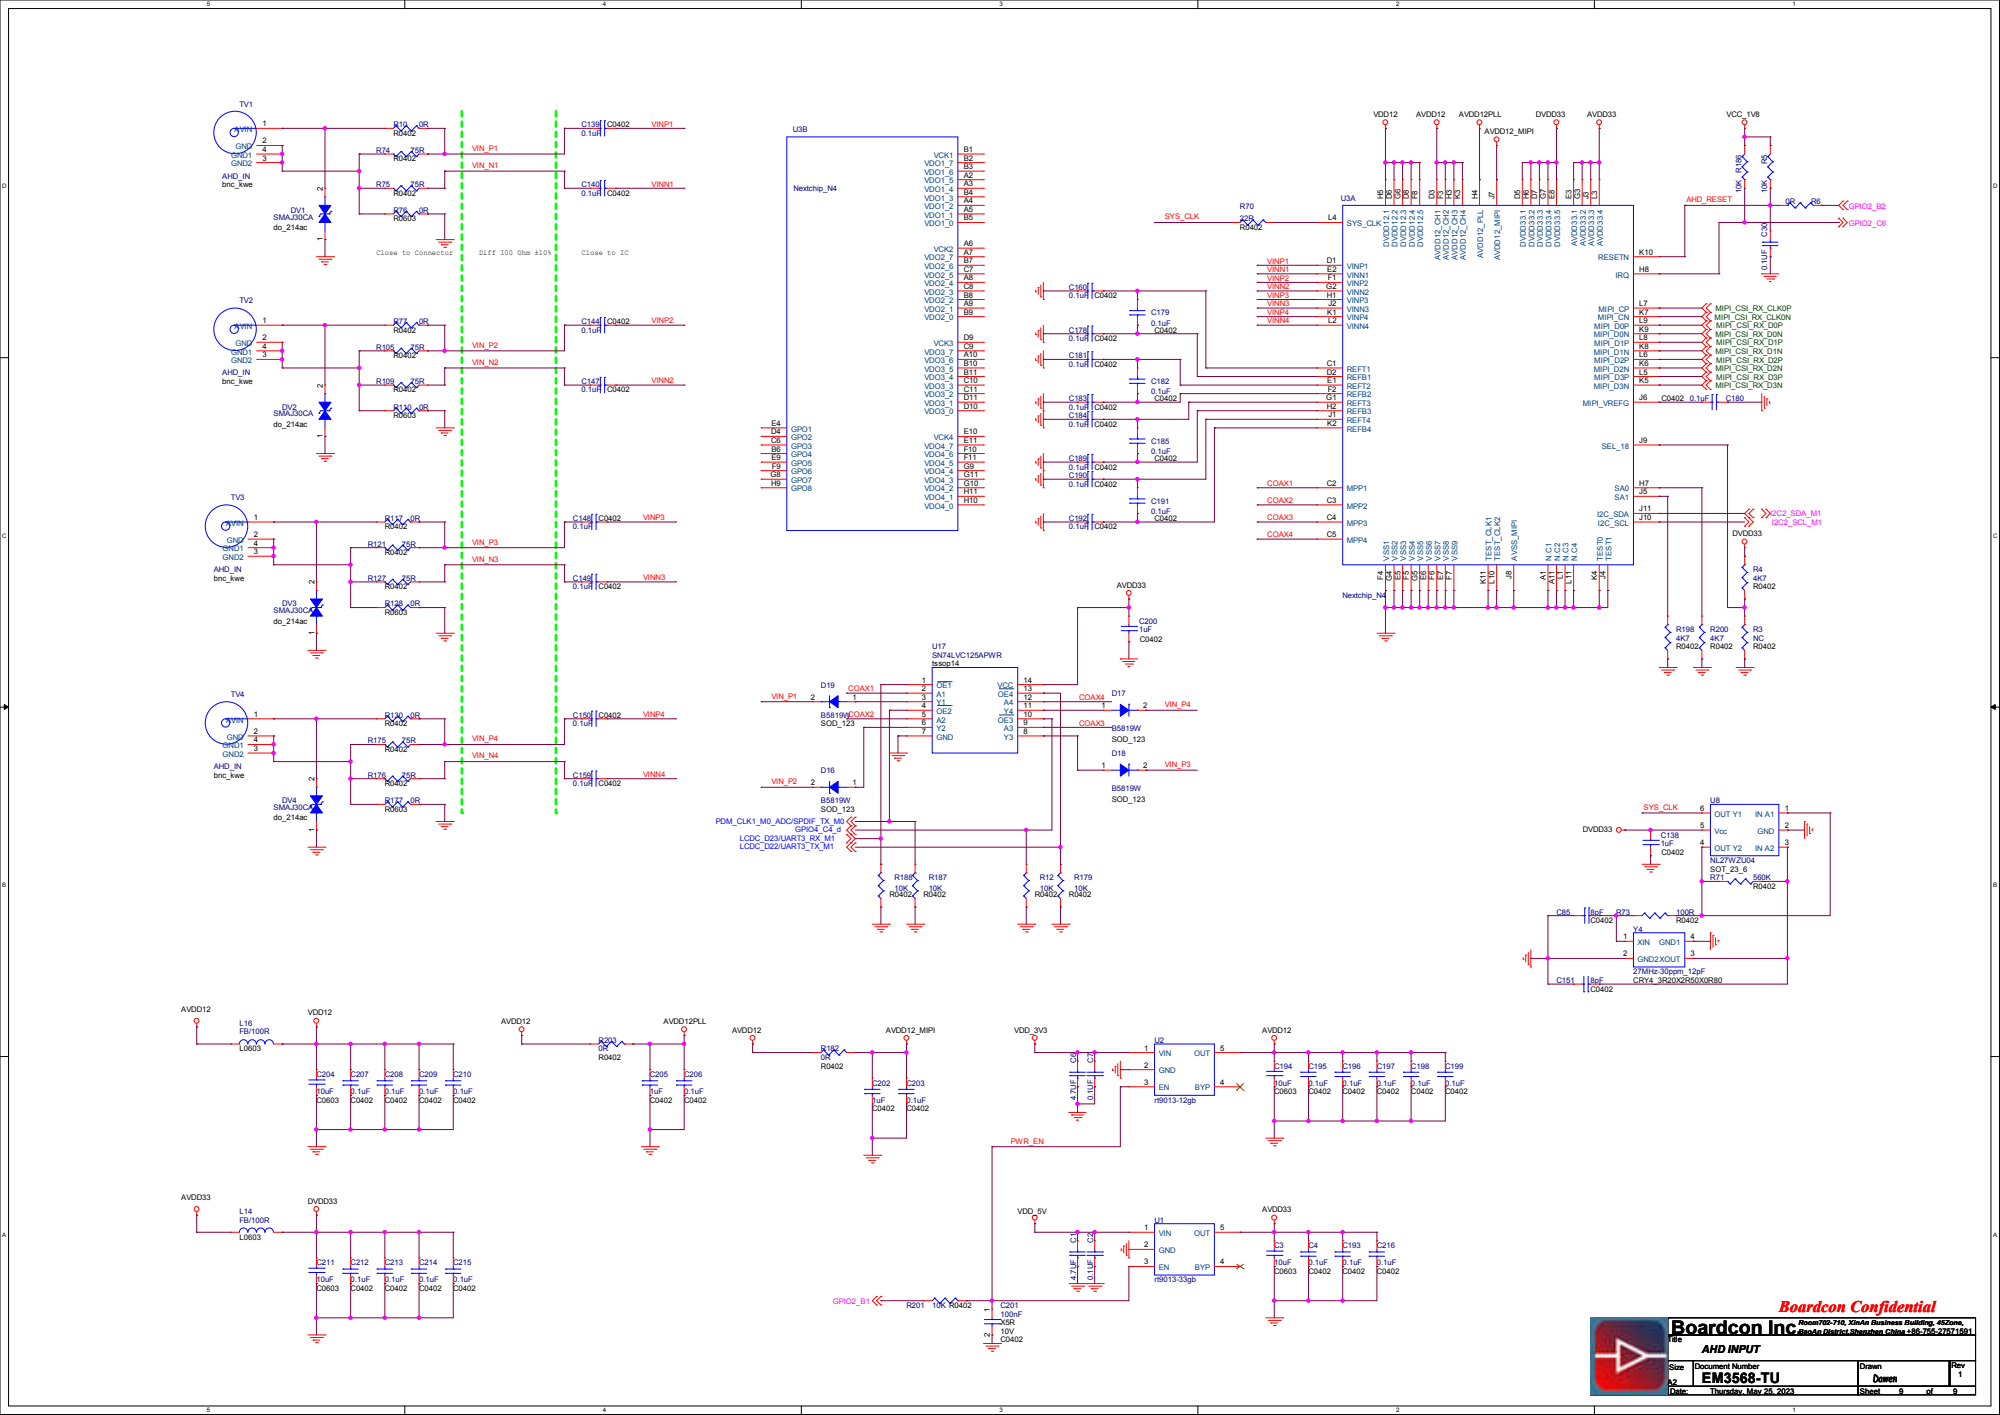
[picture p35: page 11]
