ihsanakyrk/Eski-Versionlar-Ve-Siparisler/RK3566/Document/em3566_v3sch.pdf

# EM3566 Block Diagram

# OTG

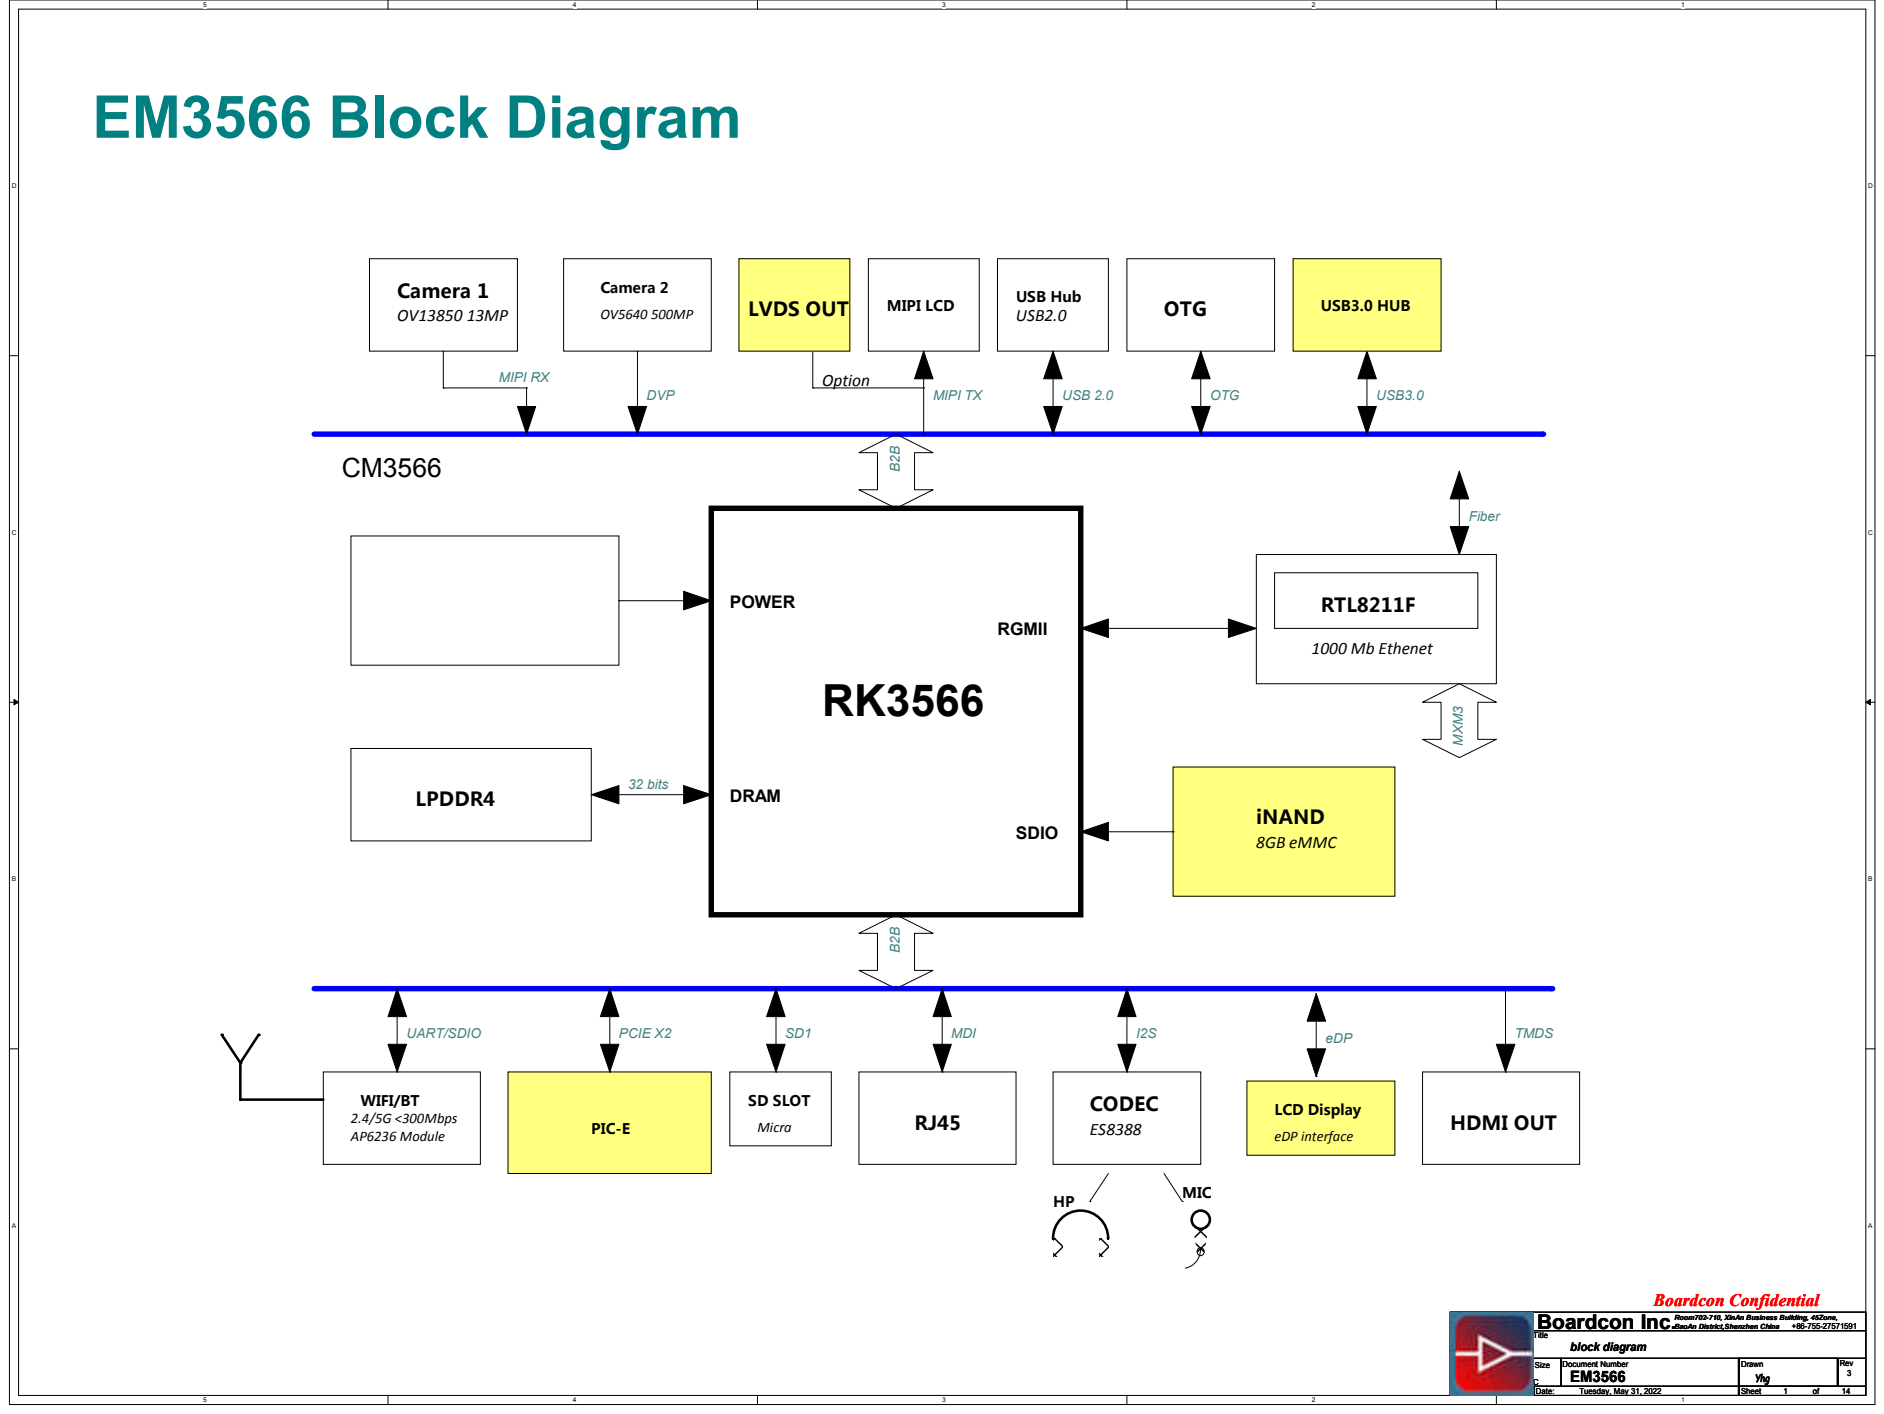
[picture p36: page 1]
POWER; DRAM; RGMII; RTL8211F; CODEC ES8388; MIC; WIFI/BT; AP6236 Module; LCD Display; eDP interface; USB3.0 HUB; Camera 1 OV13850 13MP; LPDDR4; Camera 2; MIPI LCD; USB Hub; PIC-E; SD SLOT; Micra; MIPI RX; DVP; MIPI TX; USB 2.0; OTG; USB3.0; UART/SDIO; PCIE X2; MDI; eDP; 32 bits; 1000 Mb Ethenet; 8GB eMMC; iNAND; SDIO; USB2.0; MXM3; HDMI OUT; TMDS; 2.4/5G <300Mbps; LVDS OUT; Option; Fiber; Title; Size; Document Number; Rev; Date:; Sheet; Drawn; Tuesday, May 31, 2022; block diagram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

Boardcon Inc.BaoAn District,Shenzhen China

Room702-710, XinAn Business Building, 45Zone,

D | D
Port | Pin name | Domain | Bus name | Pull-up

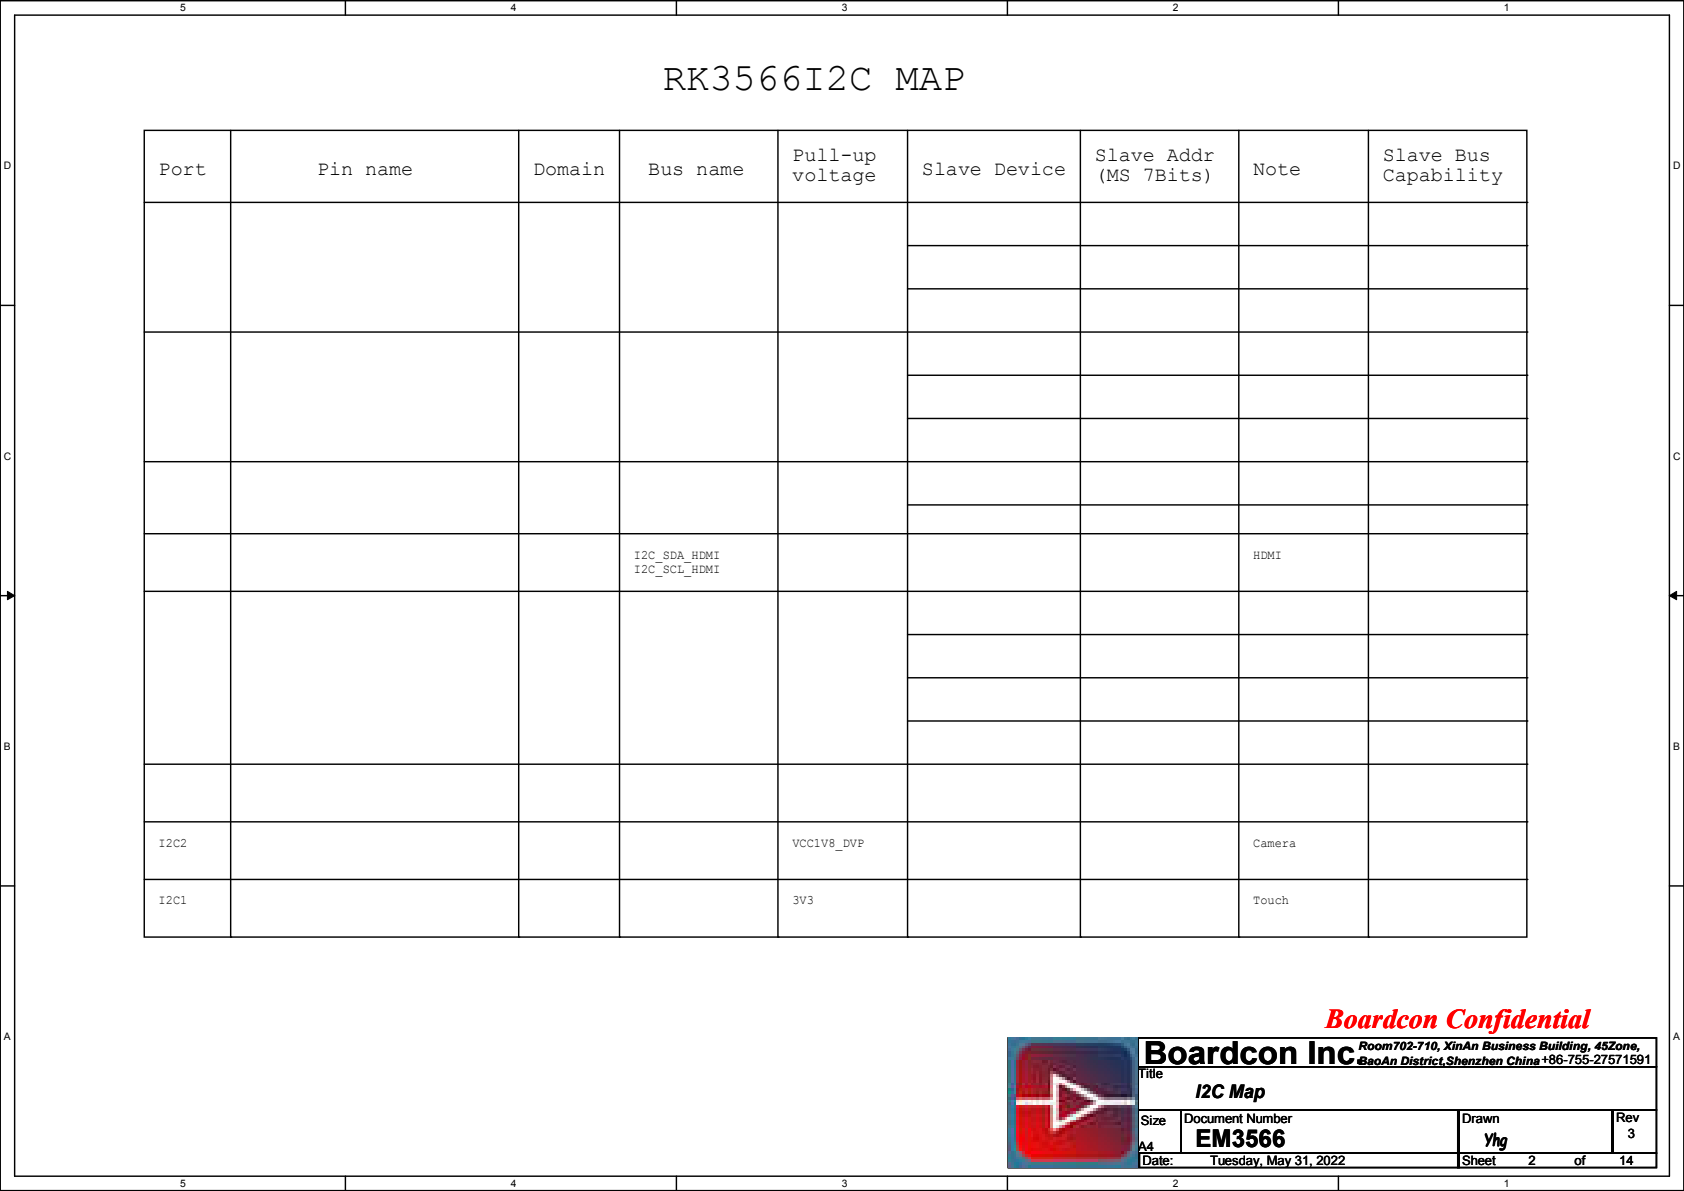
[picture p37: page 2]
voltage; Slave Device; I2C_SCL_HDMI; I2C_SDA_HDMI; Slave Addr; (MS 7Bits); Note; Slave Bus Capability; RK3566I2C MAP; VCC1V8_DVP; Camera; HDMI; Touch; Title; Tuesday, May 31, 2022; I2C Map; Boardcon Confidential

Boardcon Inc.BaoAn District,Shenzhen China

Room702-710, XinAn Business Building, 45Zone,

# Main Power

# DC=12V 3A

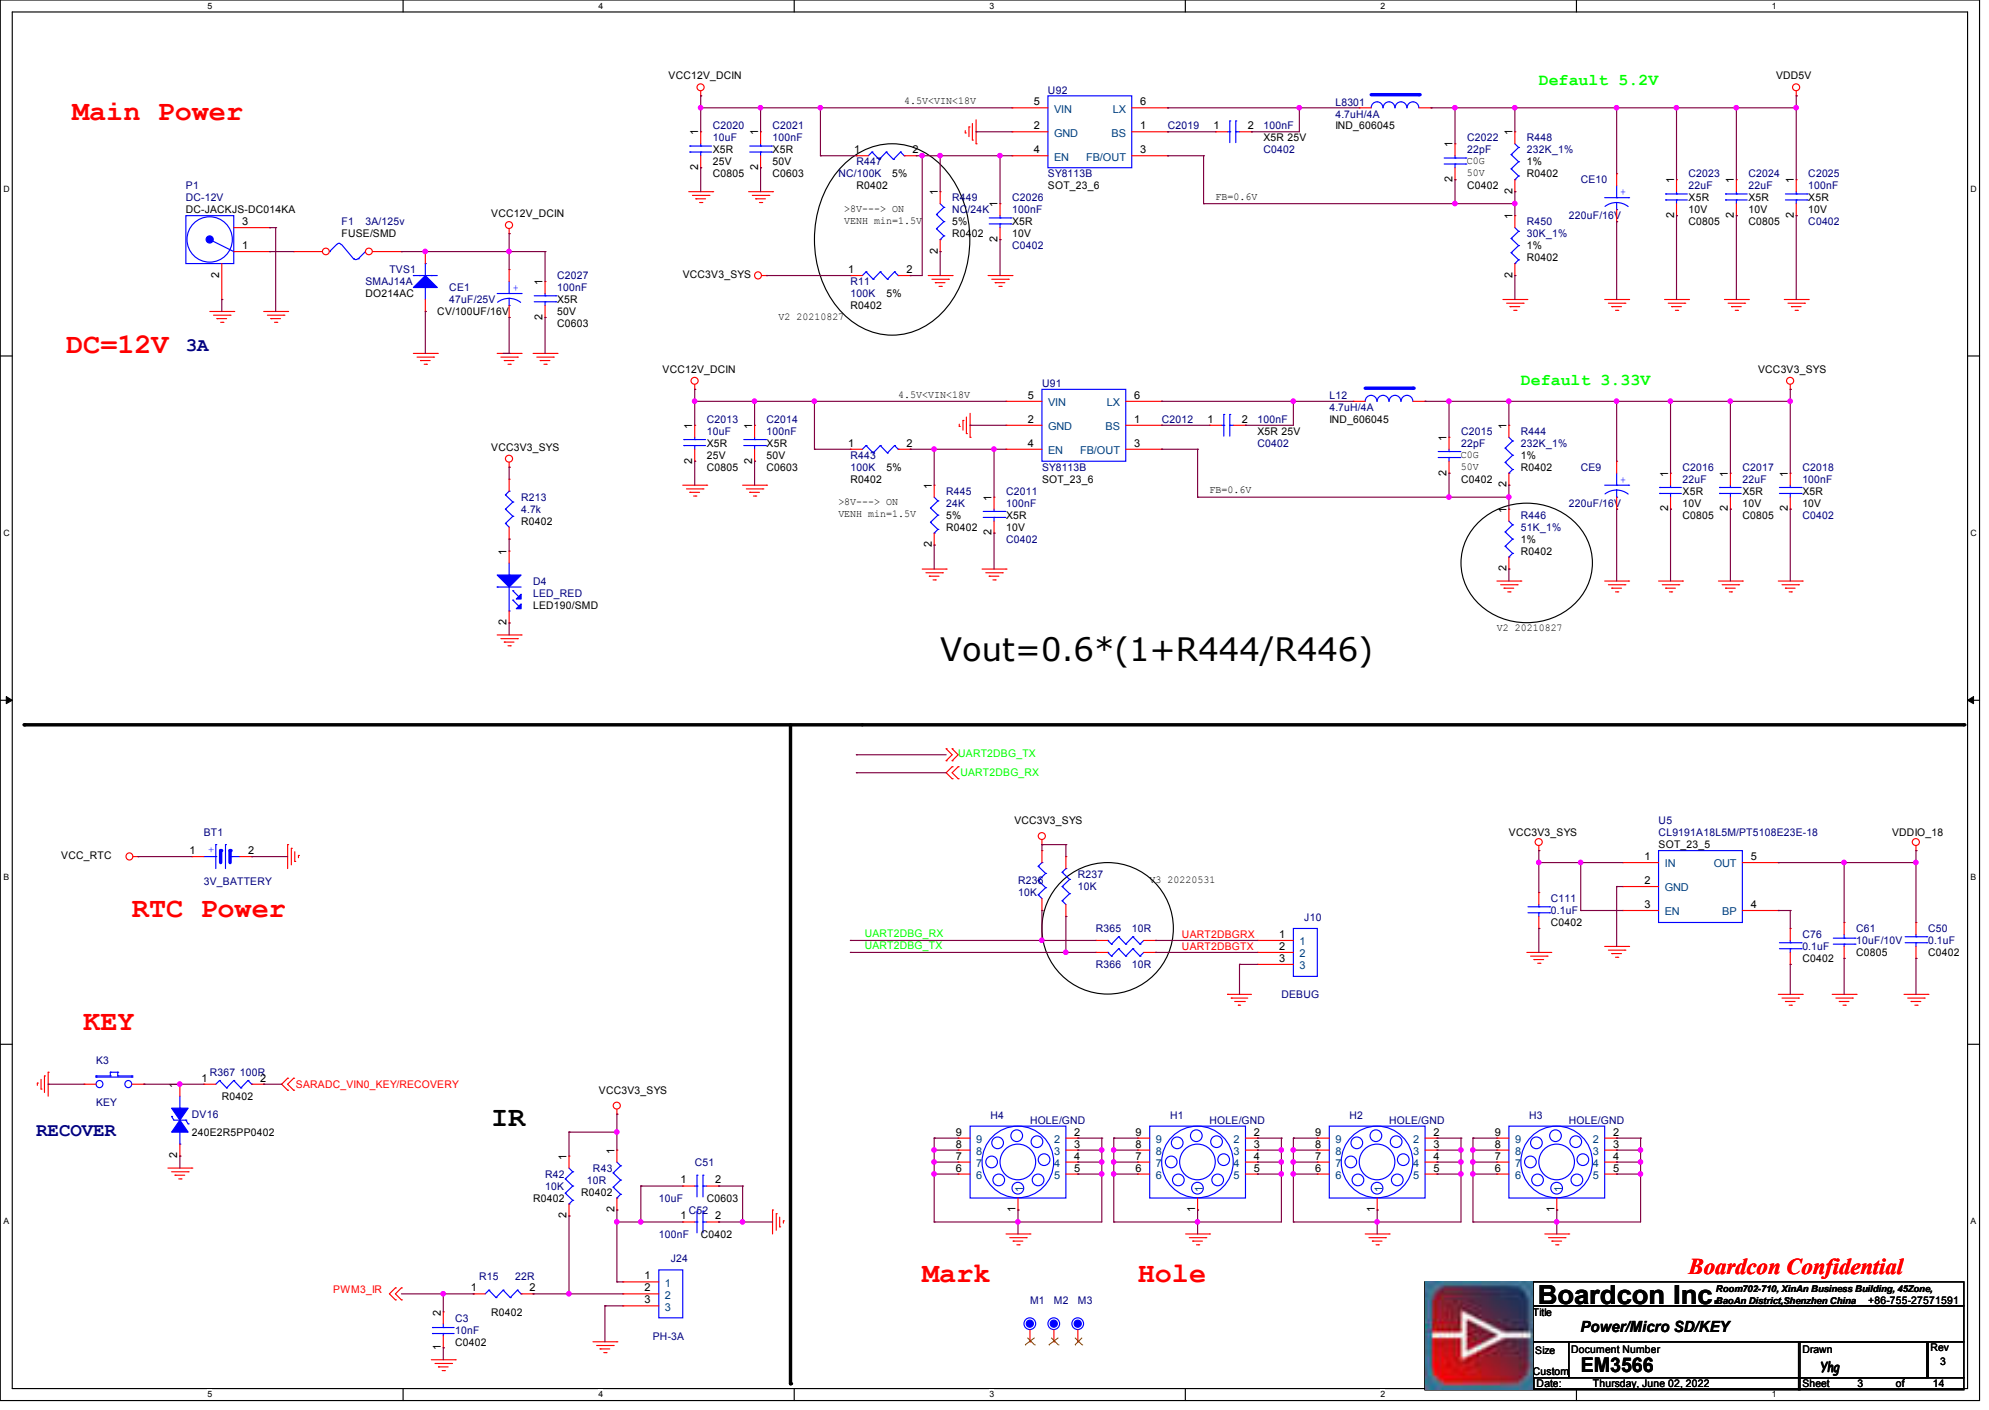
[picture p38: page 3]

Boardcon Inc.BaoAn District,Shenzhen China

Power/Micro SD/KEY

## IO 1.8V

## eDP

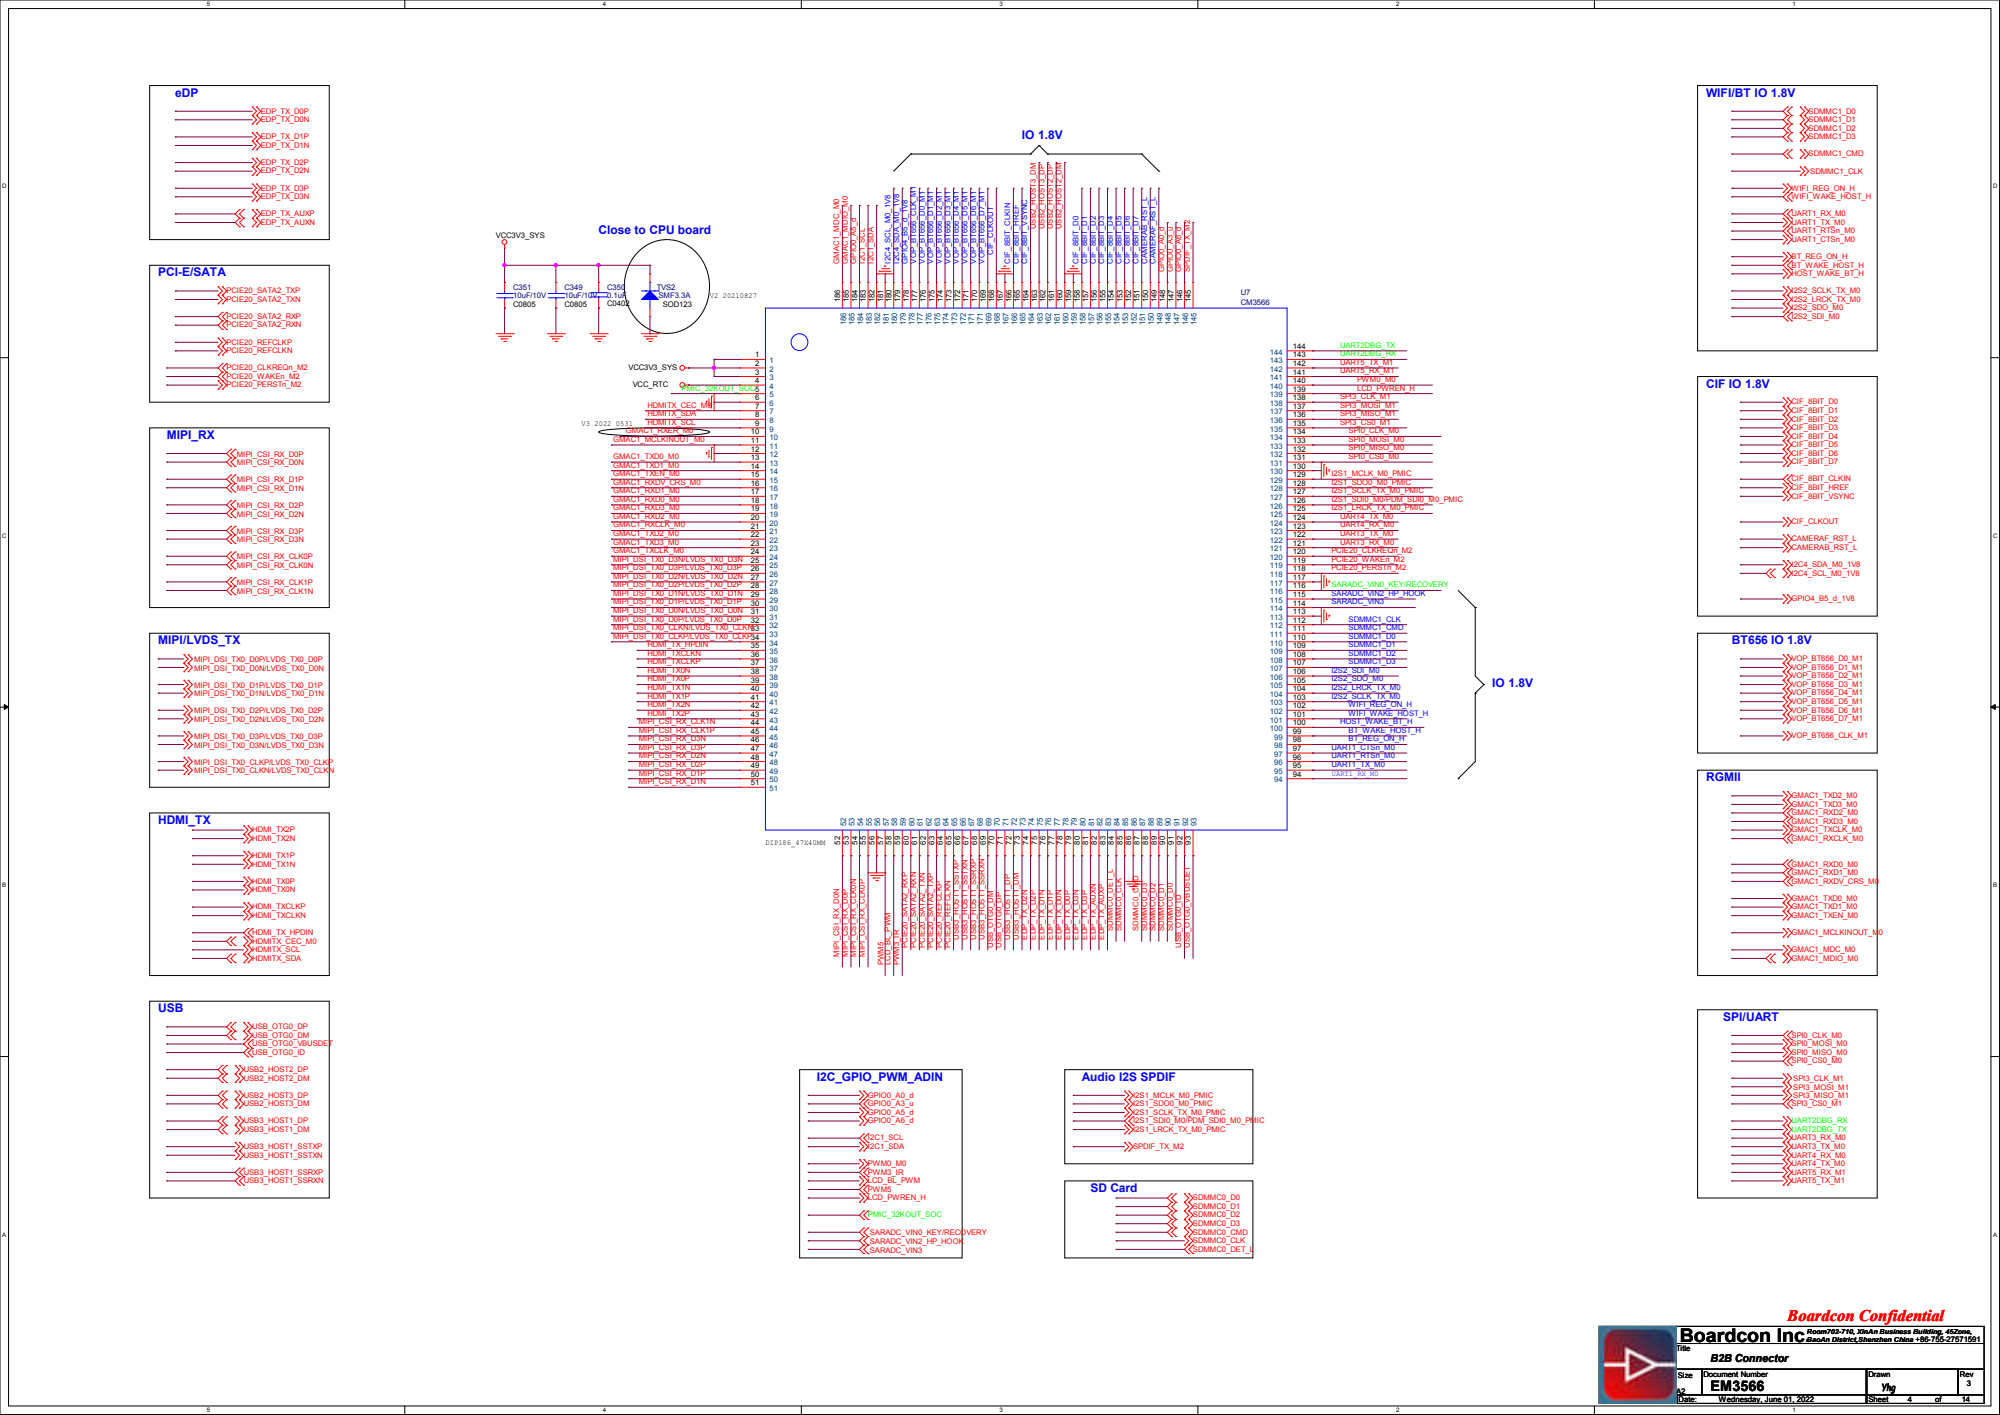
[picture p39: page 4]
MIPI_RX; MIPI/LVDS_TX; CIF IO 1.8V; RGMII; SPI/UART; SD Card; I2C_GPIO_PWM_ADIN; PCI-E/SATA; Audio I2S SPDIF; HDMI_TX; USB; VCC3V3_SYS; VCC_RTC; USB_OTG0_DP USB_OTG0_DM; USB_OTG0_ID; USB3_HOST1_DP USB3_HOST1_DM; USB3_HOST1_SSTXP USB3_HOST1_SSTXN; USB3_HOST1_SSRXP USB3_HOST1_SSRXN; PCIE20_SATA2_TXP PCIE20_SATA2_TXN; PCIE20_SATA2_RXP PCIE20_SATA2_RXN; PCIE20_REFCLKP PCIE20_REFCLKN; USB2_HOST2_DP USB2_HOST2_DM; USB2_HOST3_DP USB2_HOST3_DM; SARADC_VIN0_KEY/RECOVERY SARADC_VIN2_HP_HOOK SARADC_VIN3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

WIFI/BT IO 1.8V

Close to CPU board

# HDMI

## HDMI_VCC

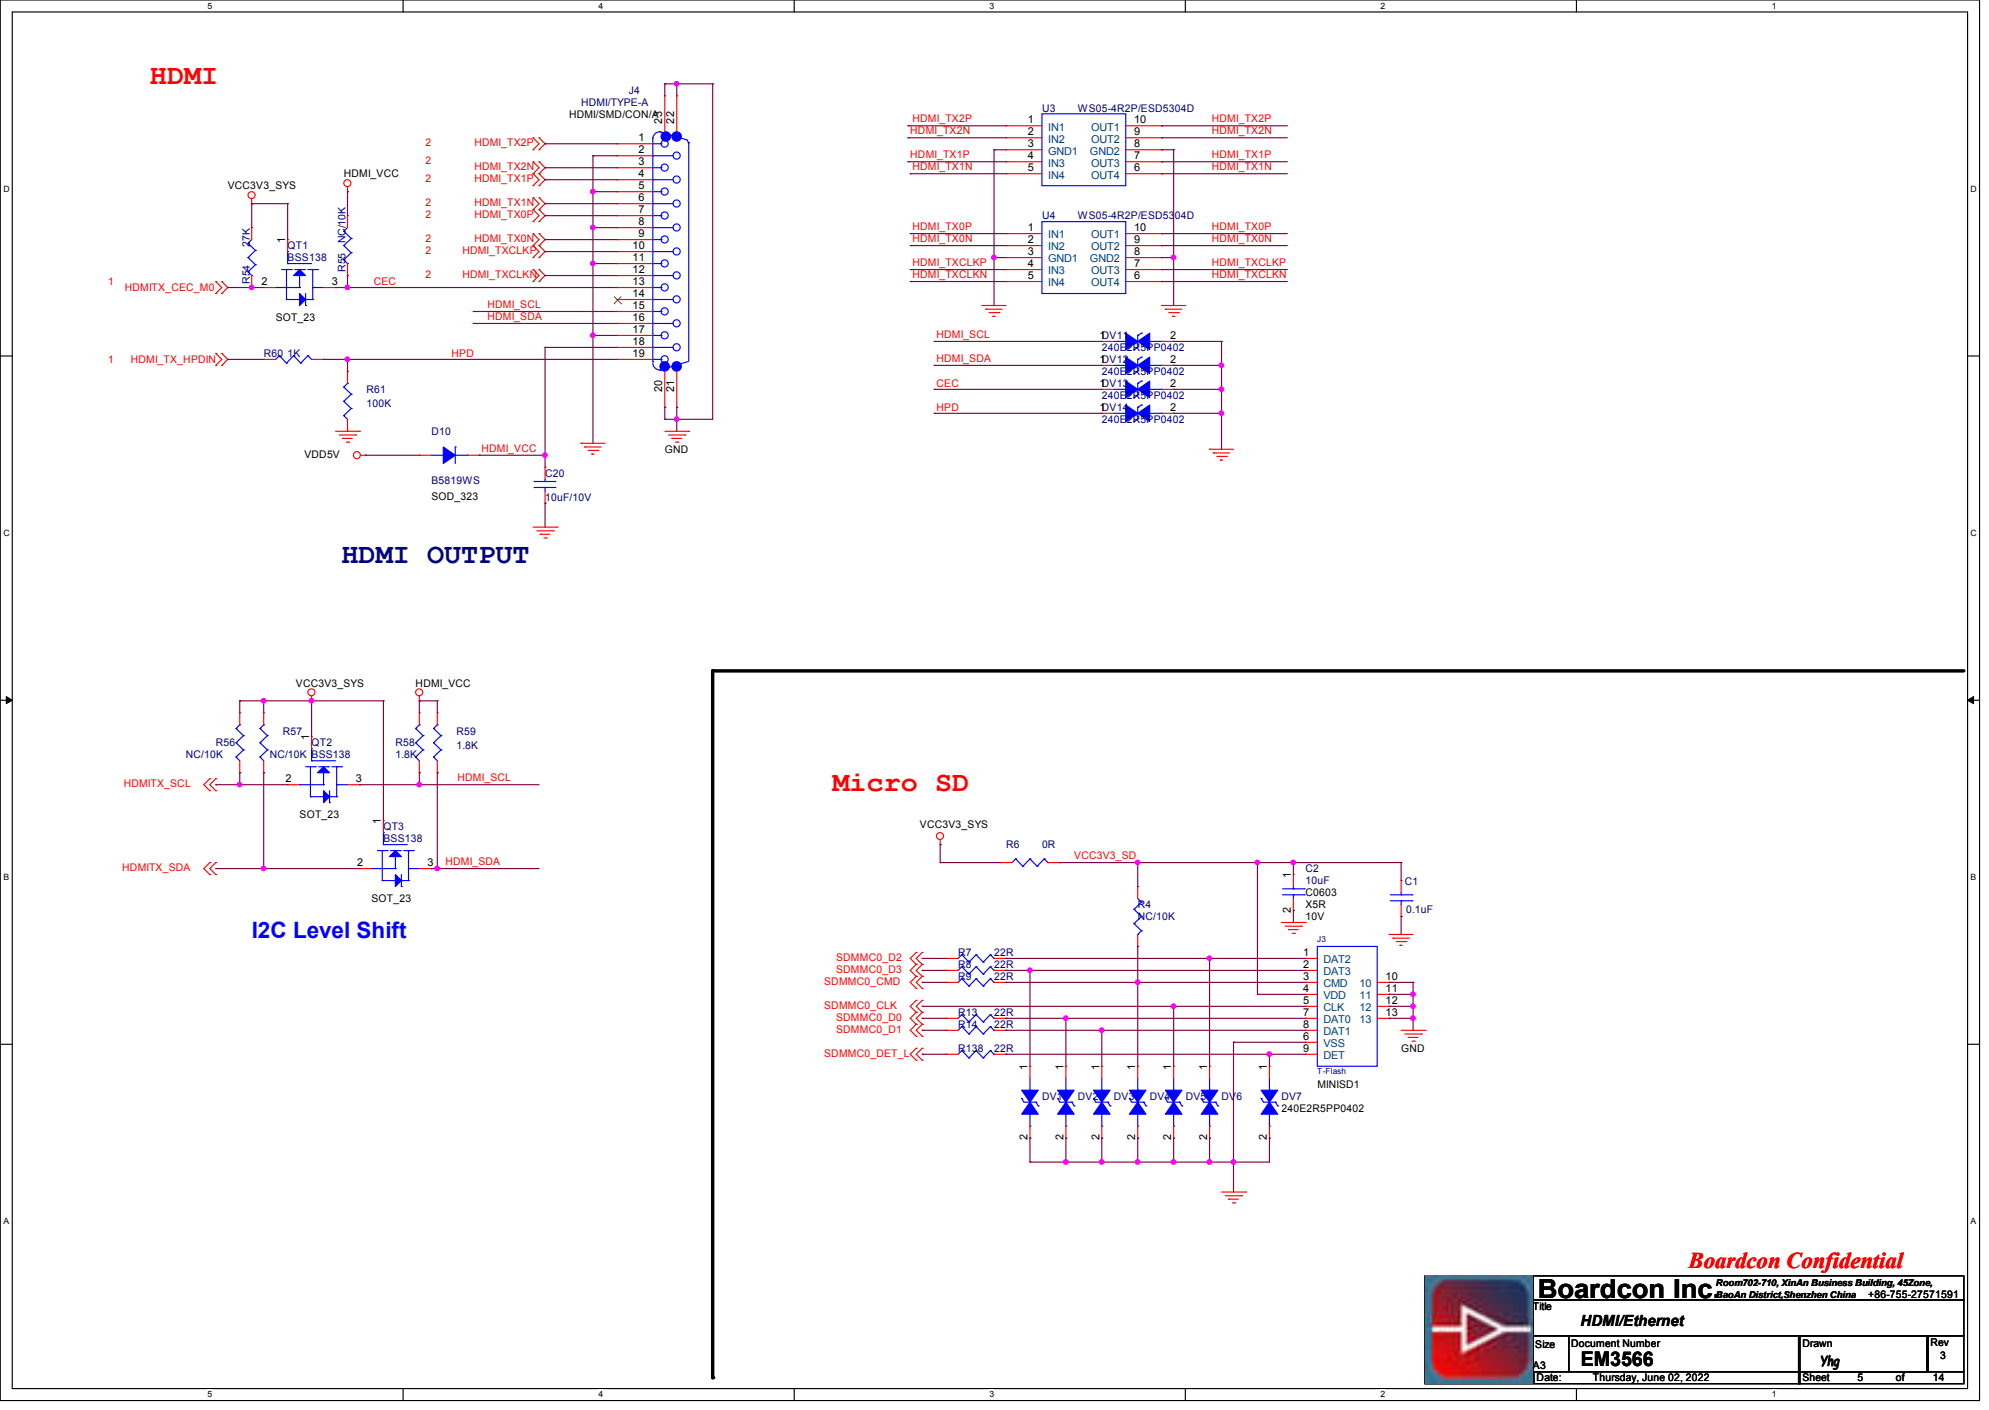
[picture p40: page 5]

C | HDMI OUTPUT | C

Boardcon Inc.BaoAn District,Shenzhen China

# WIFI/BT MODULE

## VCCIO_WL

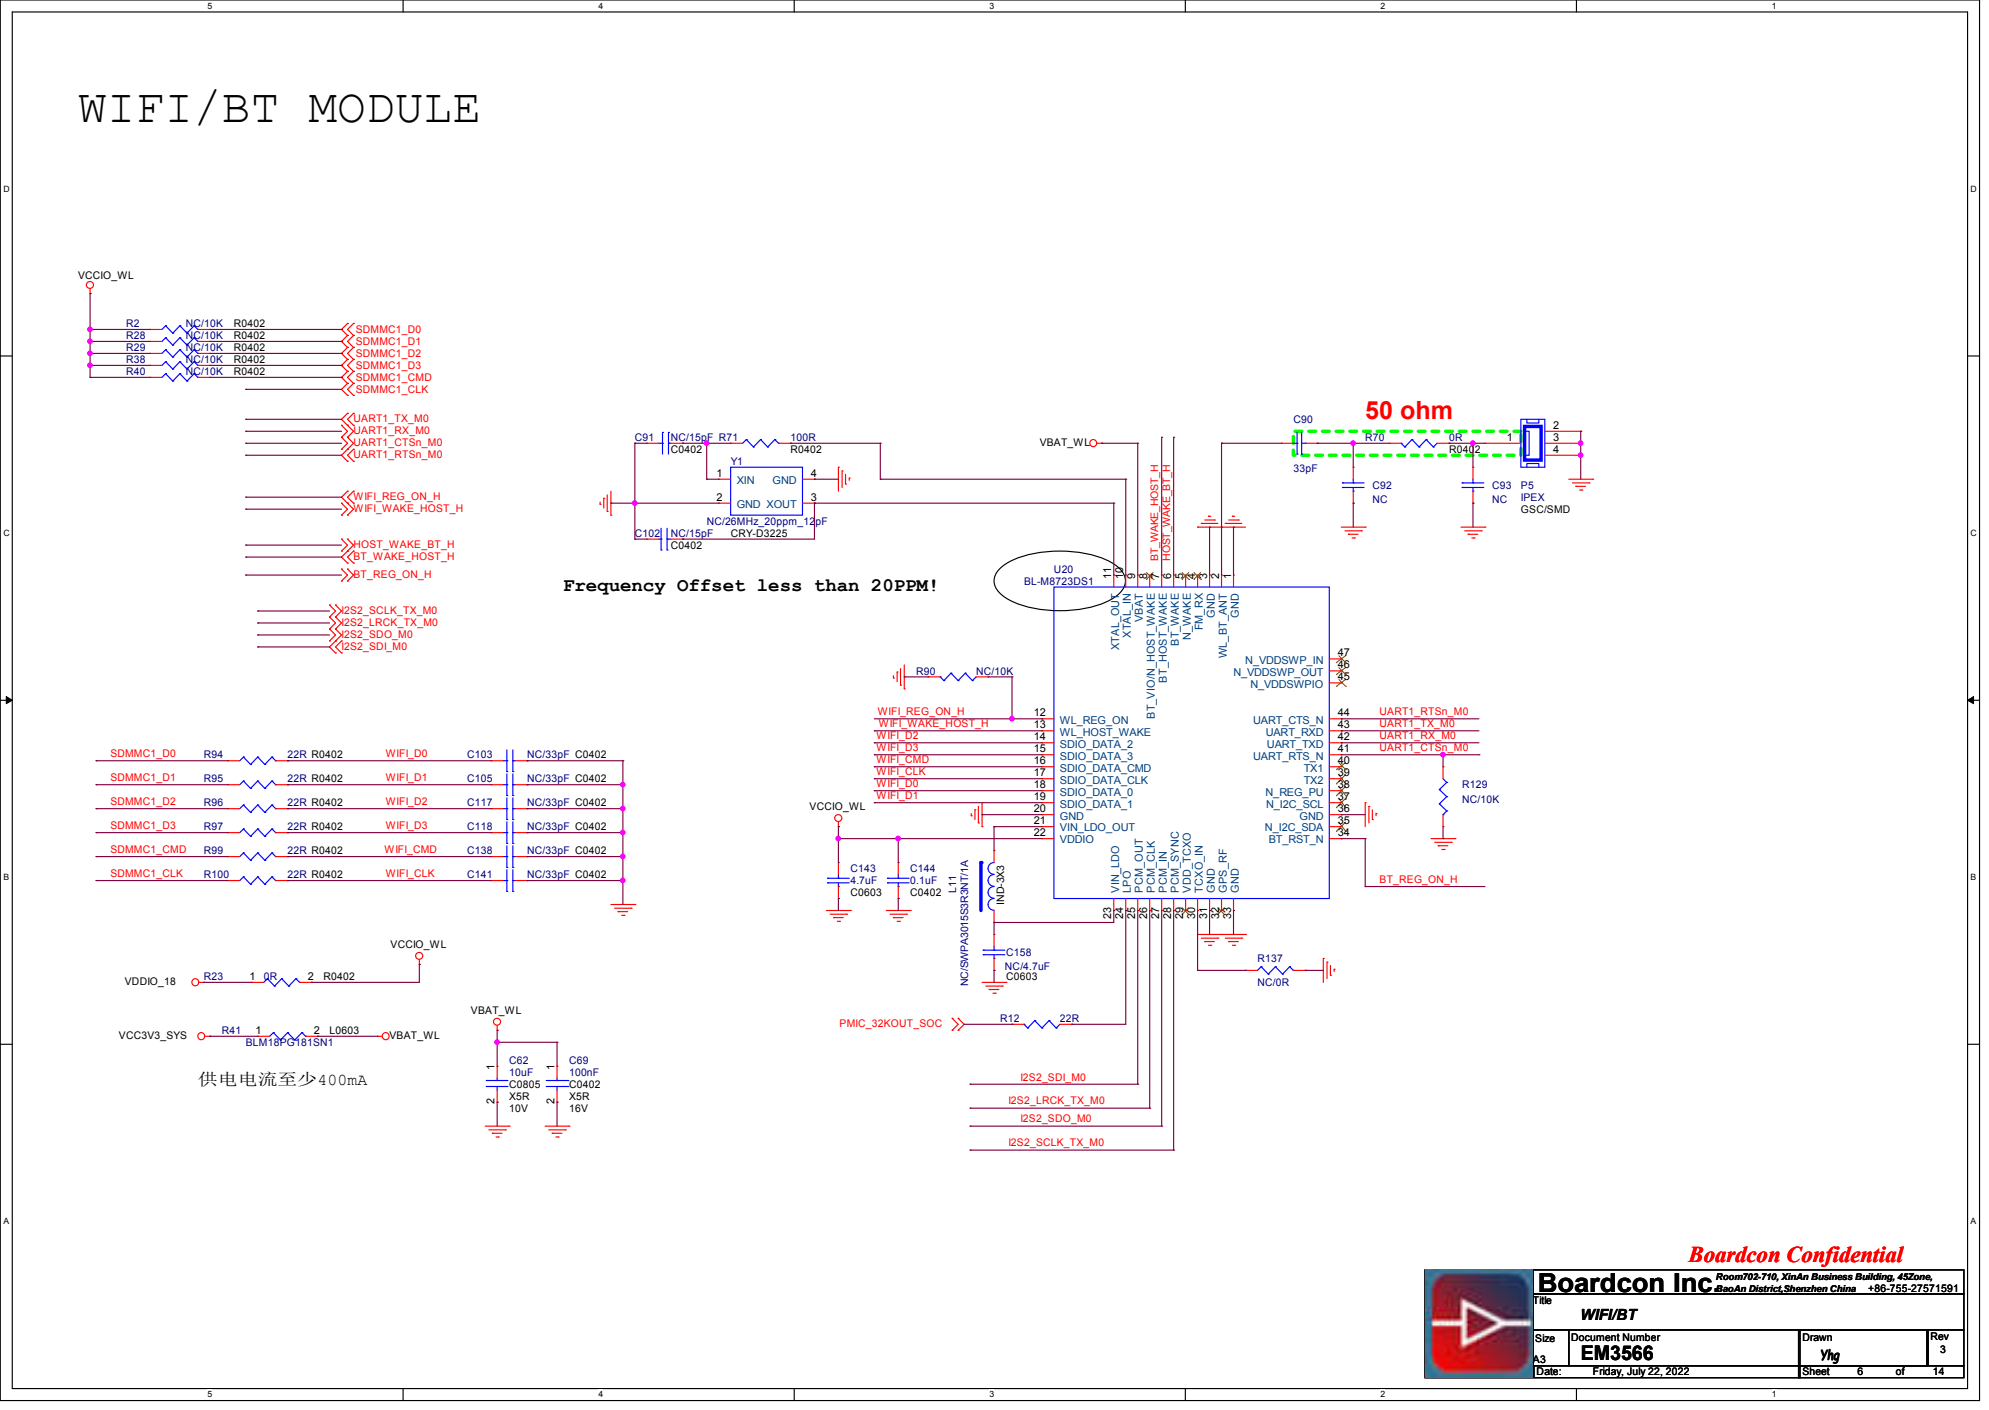
[picture p41: page 6]

Frequency Offset less than 20PPM!

Boardcon Inc.BaoAn District,Shenzhen China

# Audio Codec EARPHONE

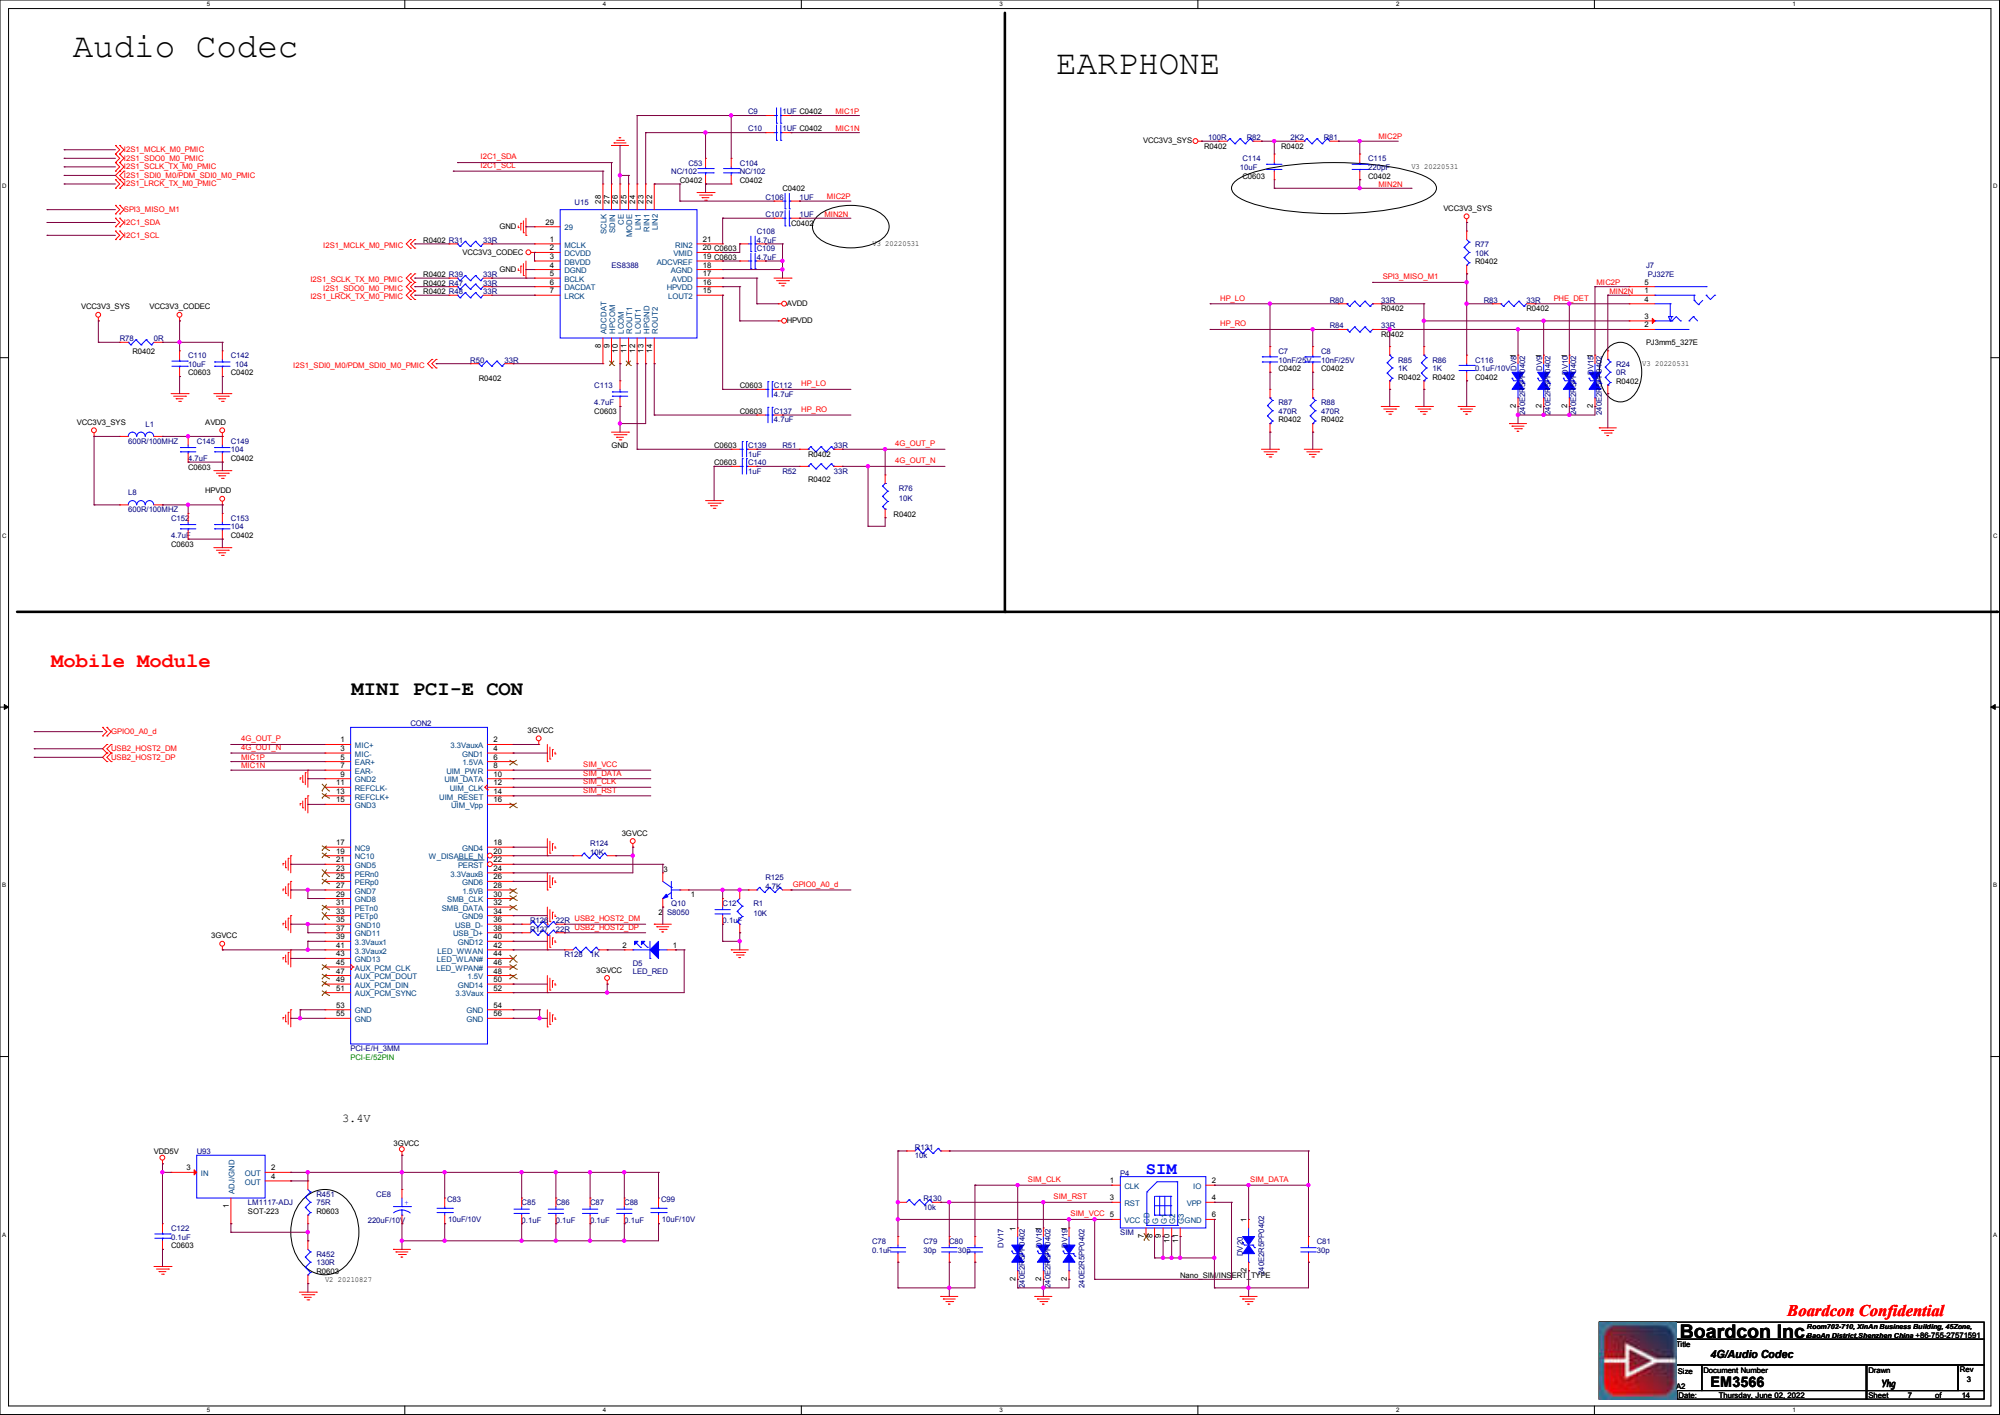
[picture p42: page 7]

24 MODE 25 CE 26 SDIN 27 SCLK 28

# PCI.Express

## PCIE_3V3

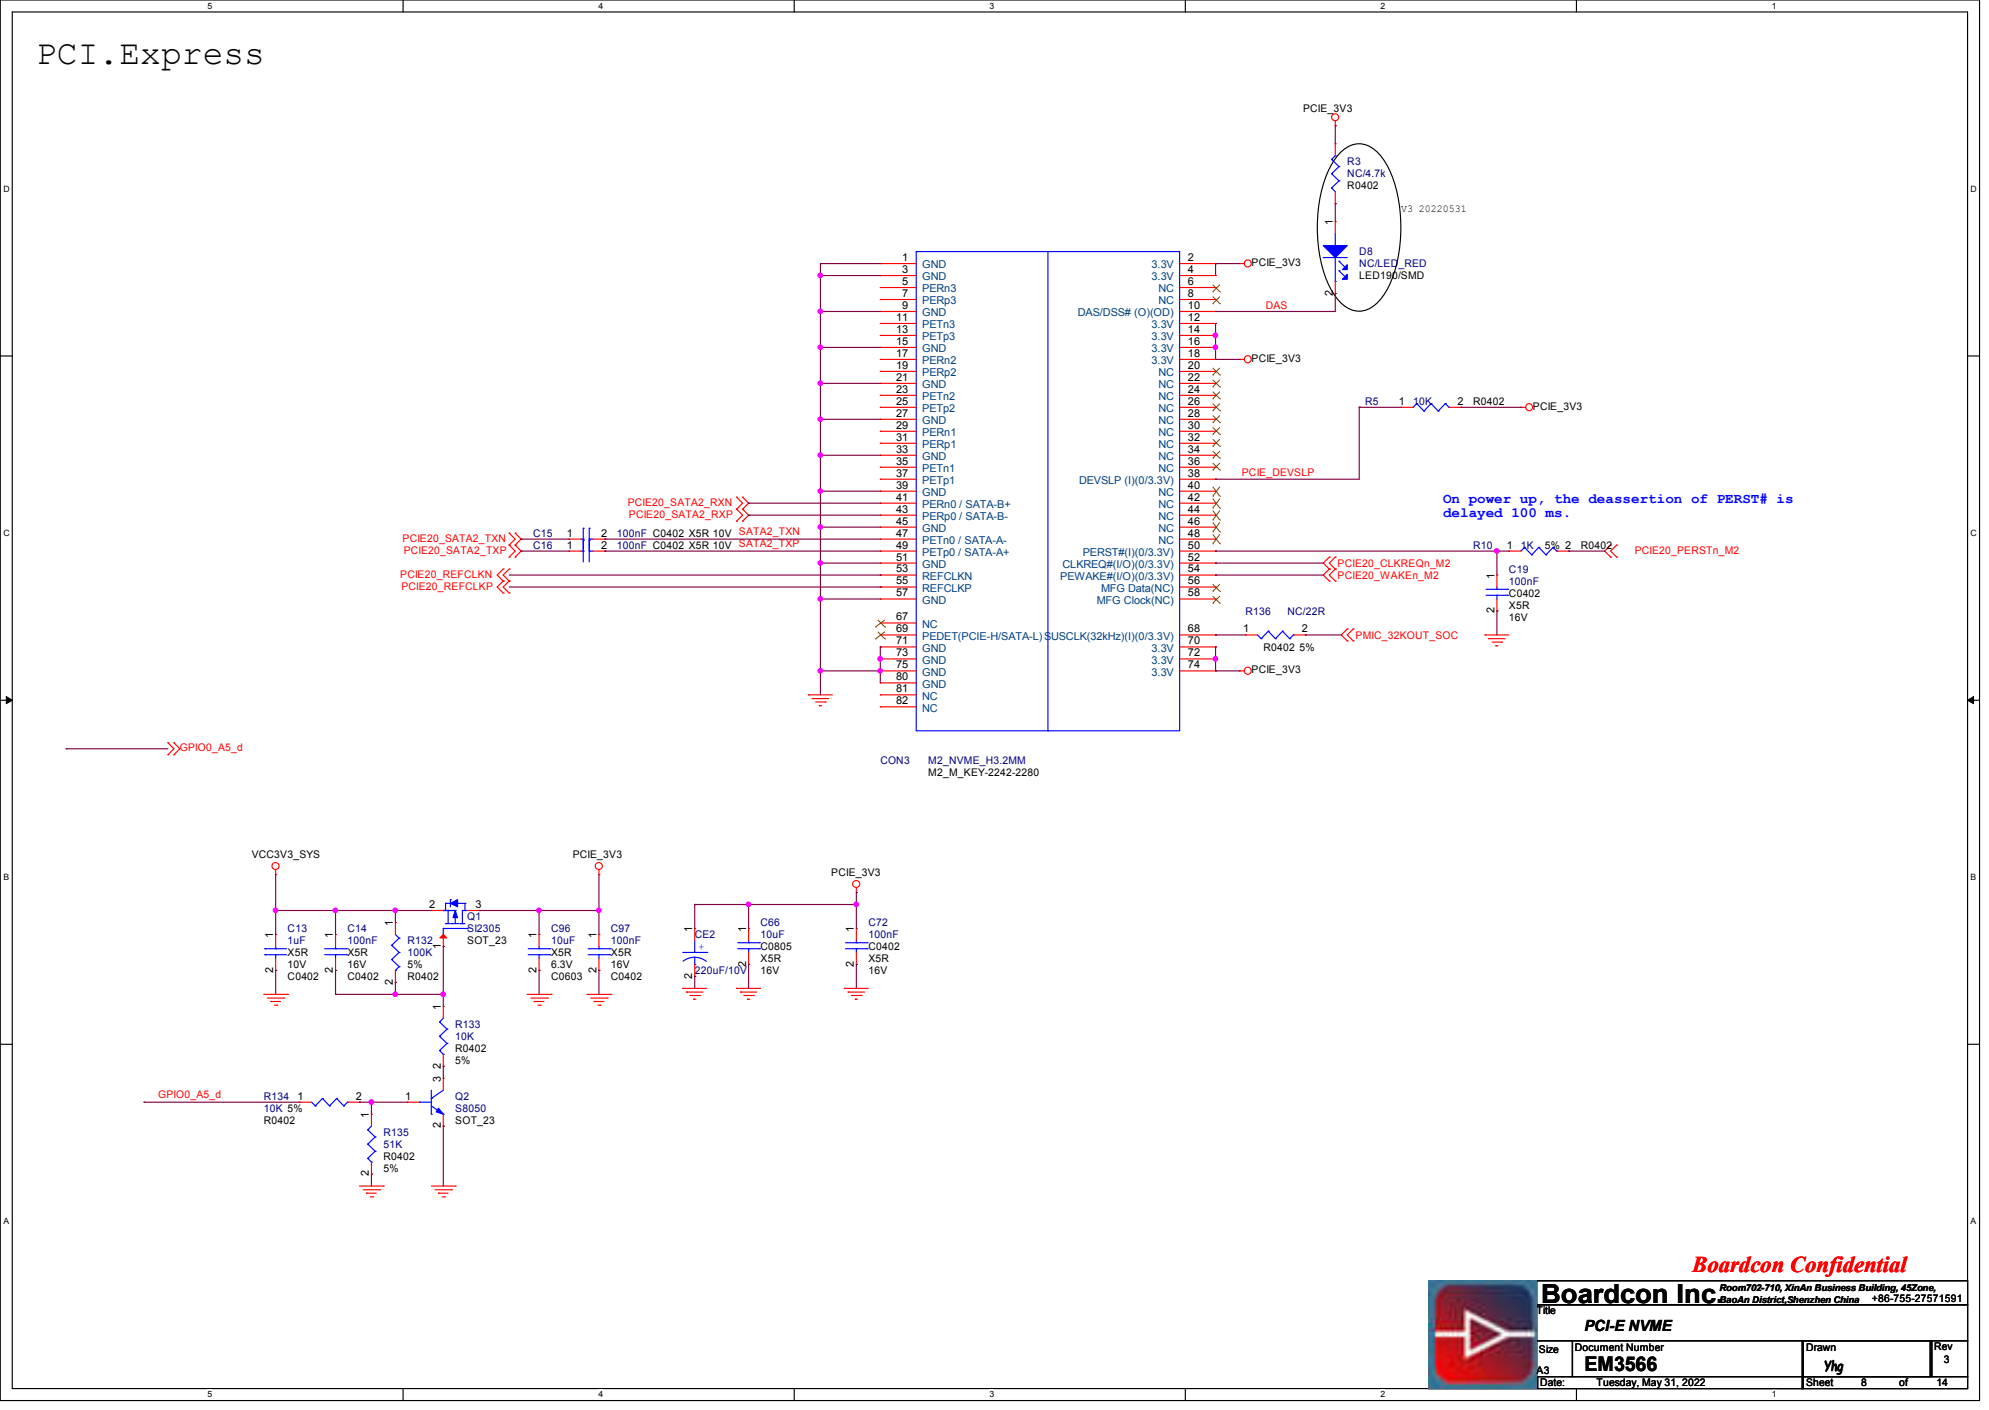
[picture p43: page 8]

On power up, the deassertion of PERST# is
delayed 100 ms.

Boardcon Inc.BaoAn District,Shenzhen China

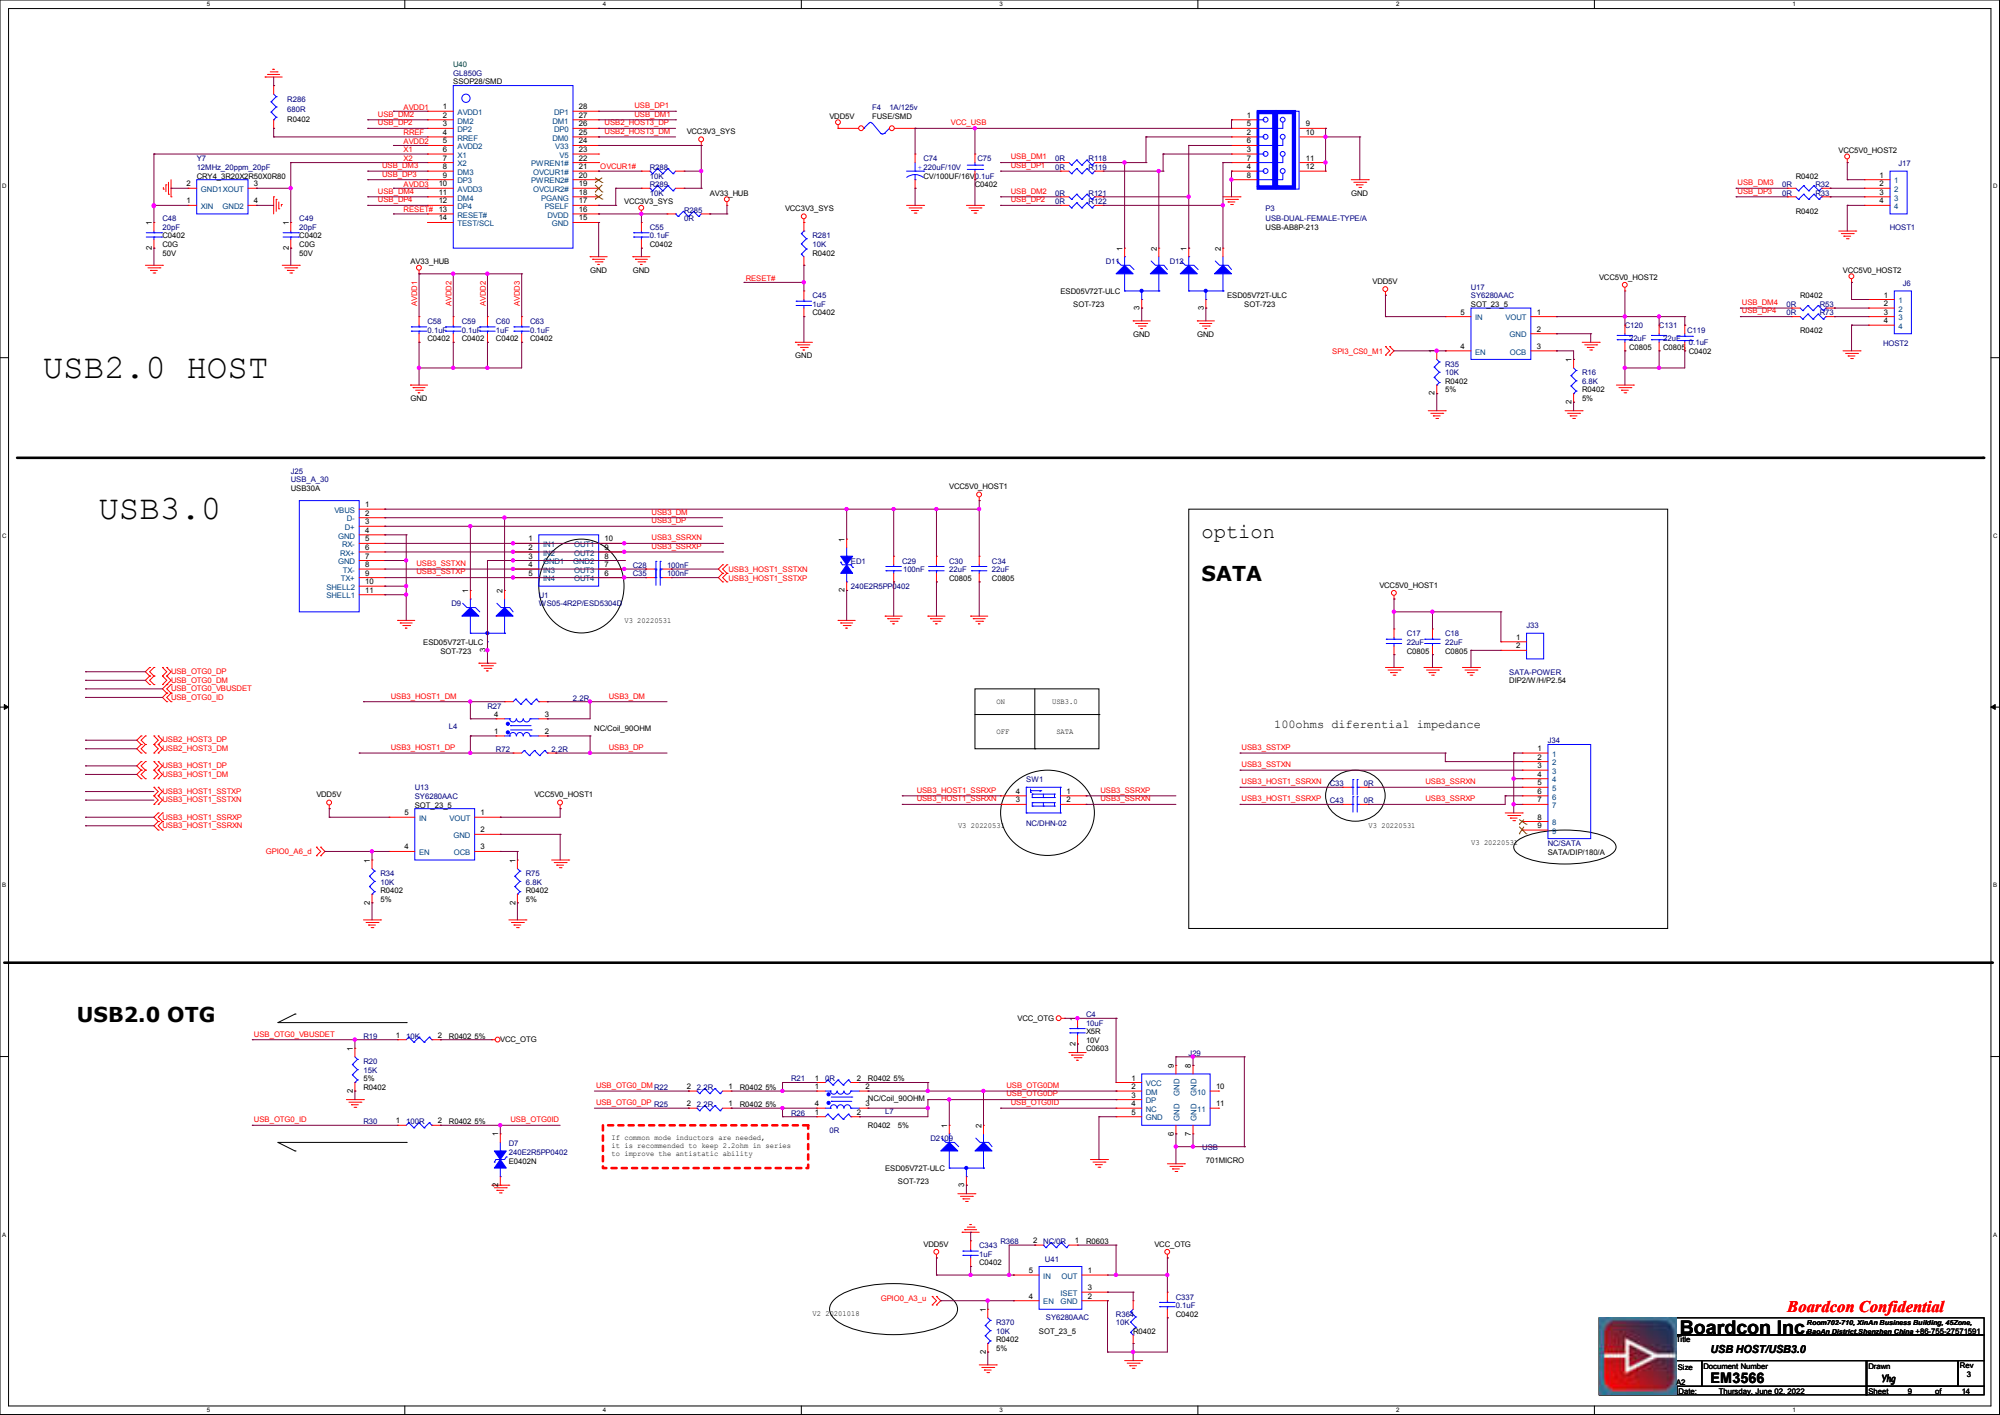
[picture p44: page 9]

If common mode inductors are needed,
it is recommended to keep 2.2ohm in series
to improve the antistatic ability

# MIPI Camera

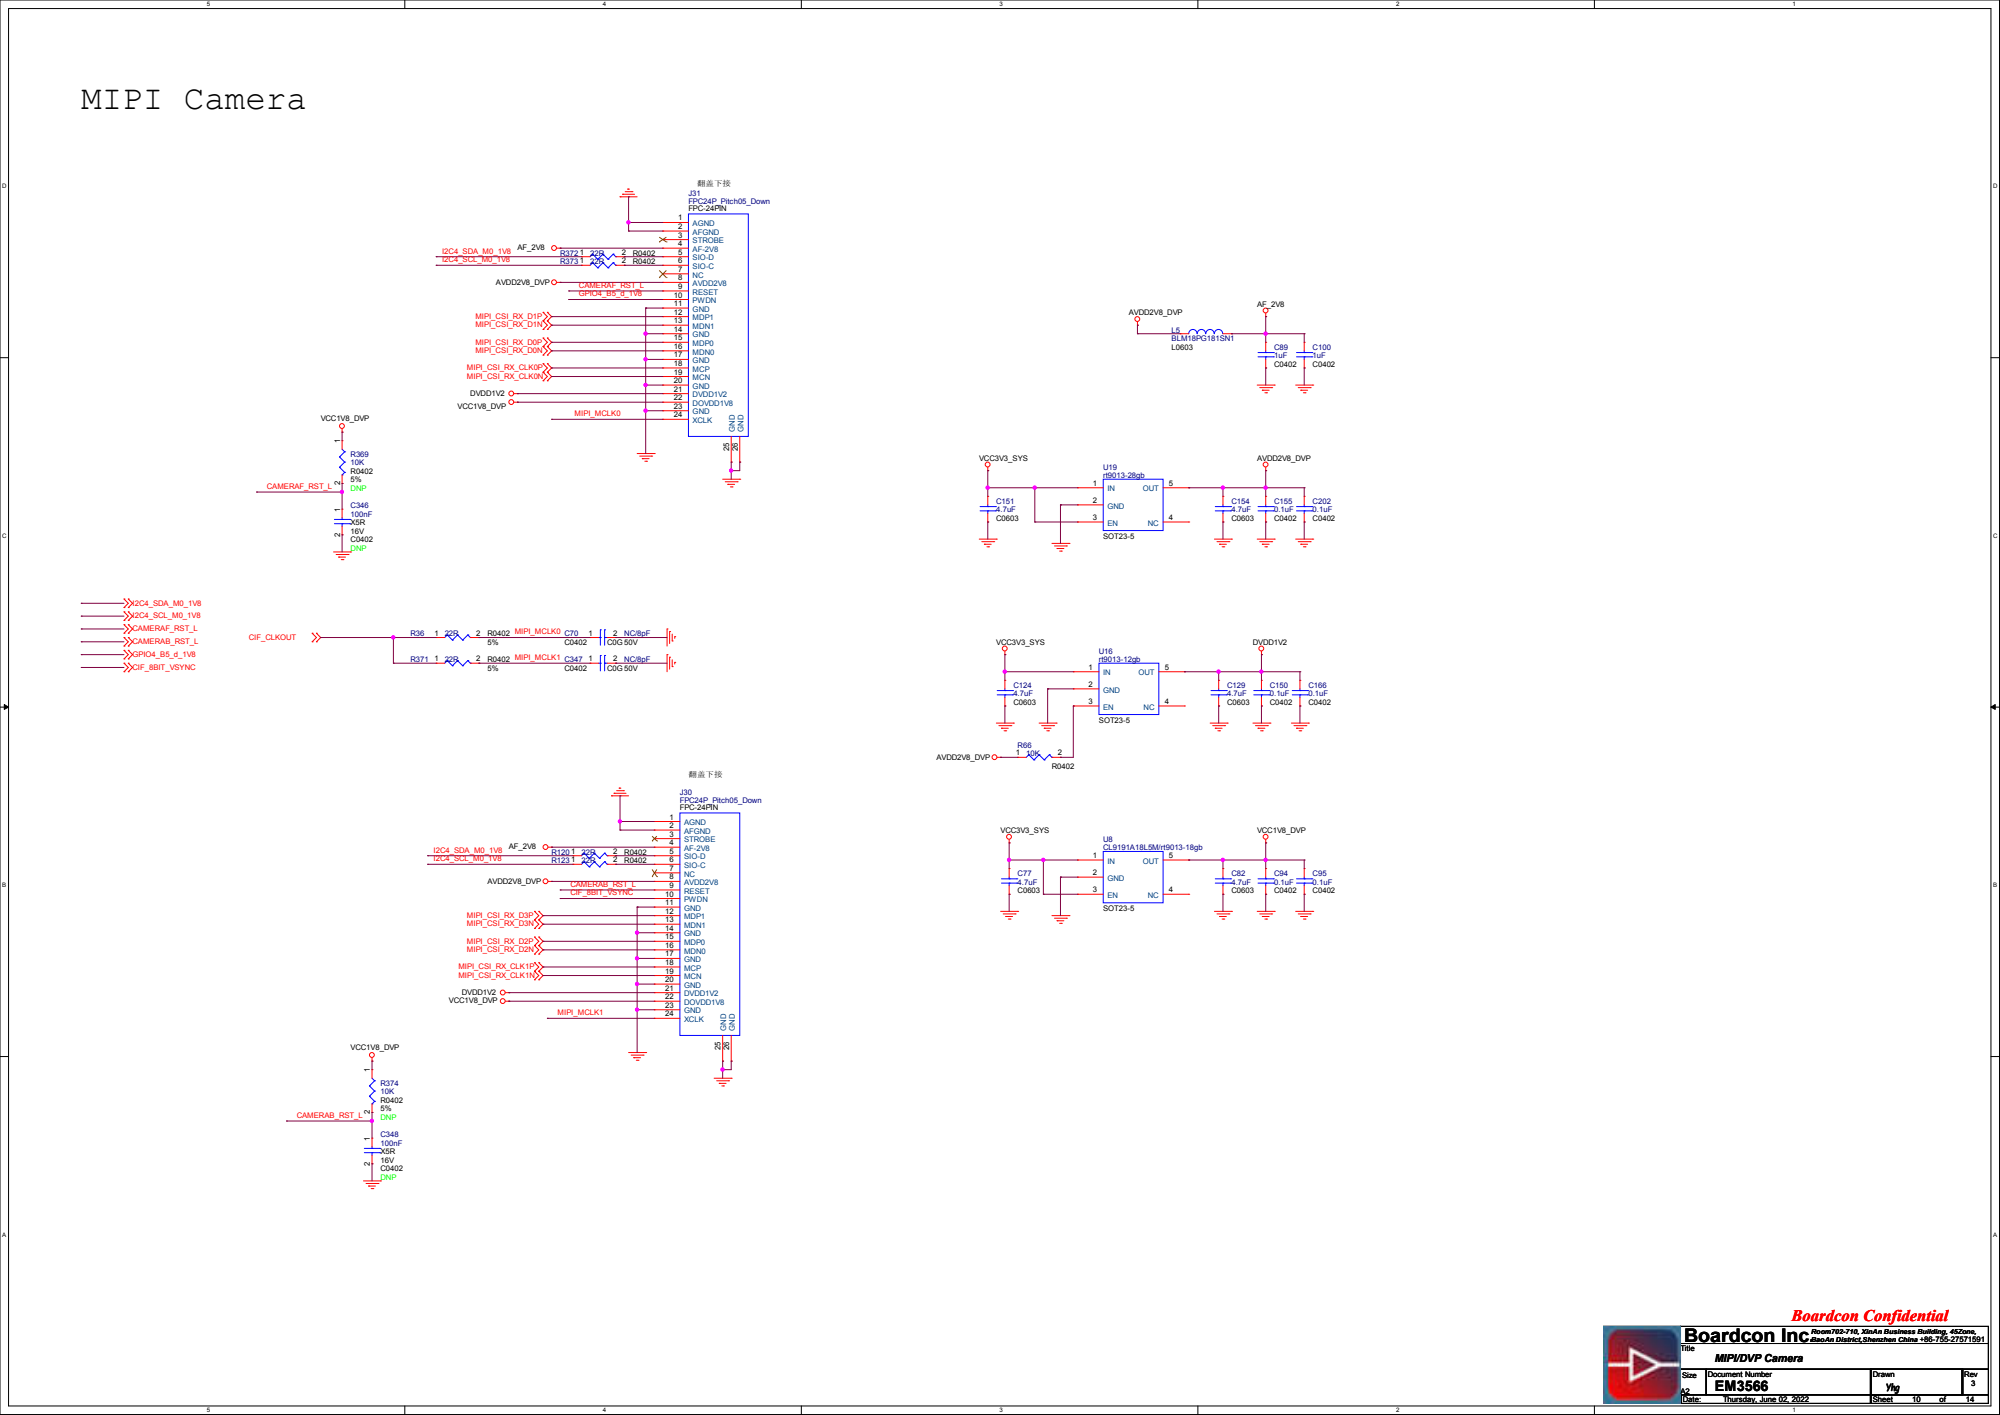
[picture p45: page 10]

VDD5V | VDD5V

## VDD5V

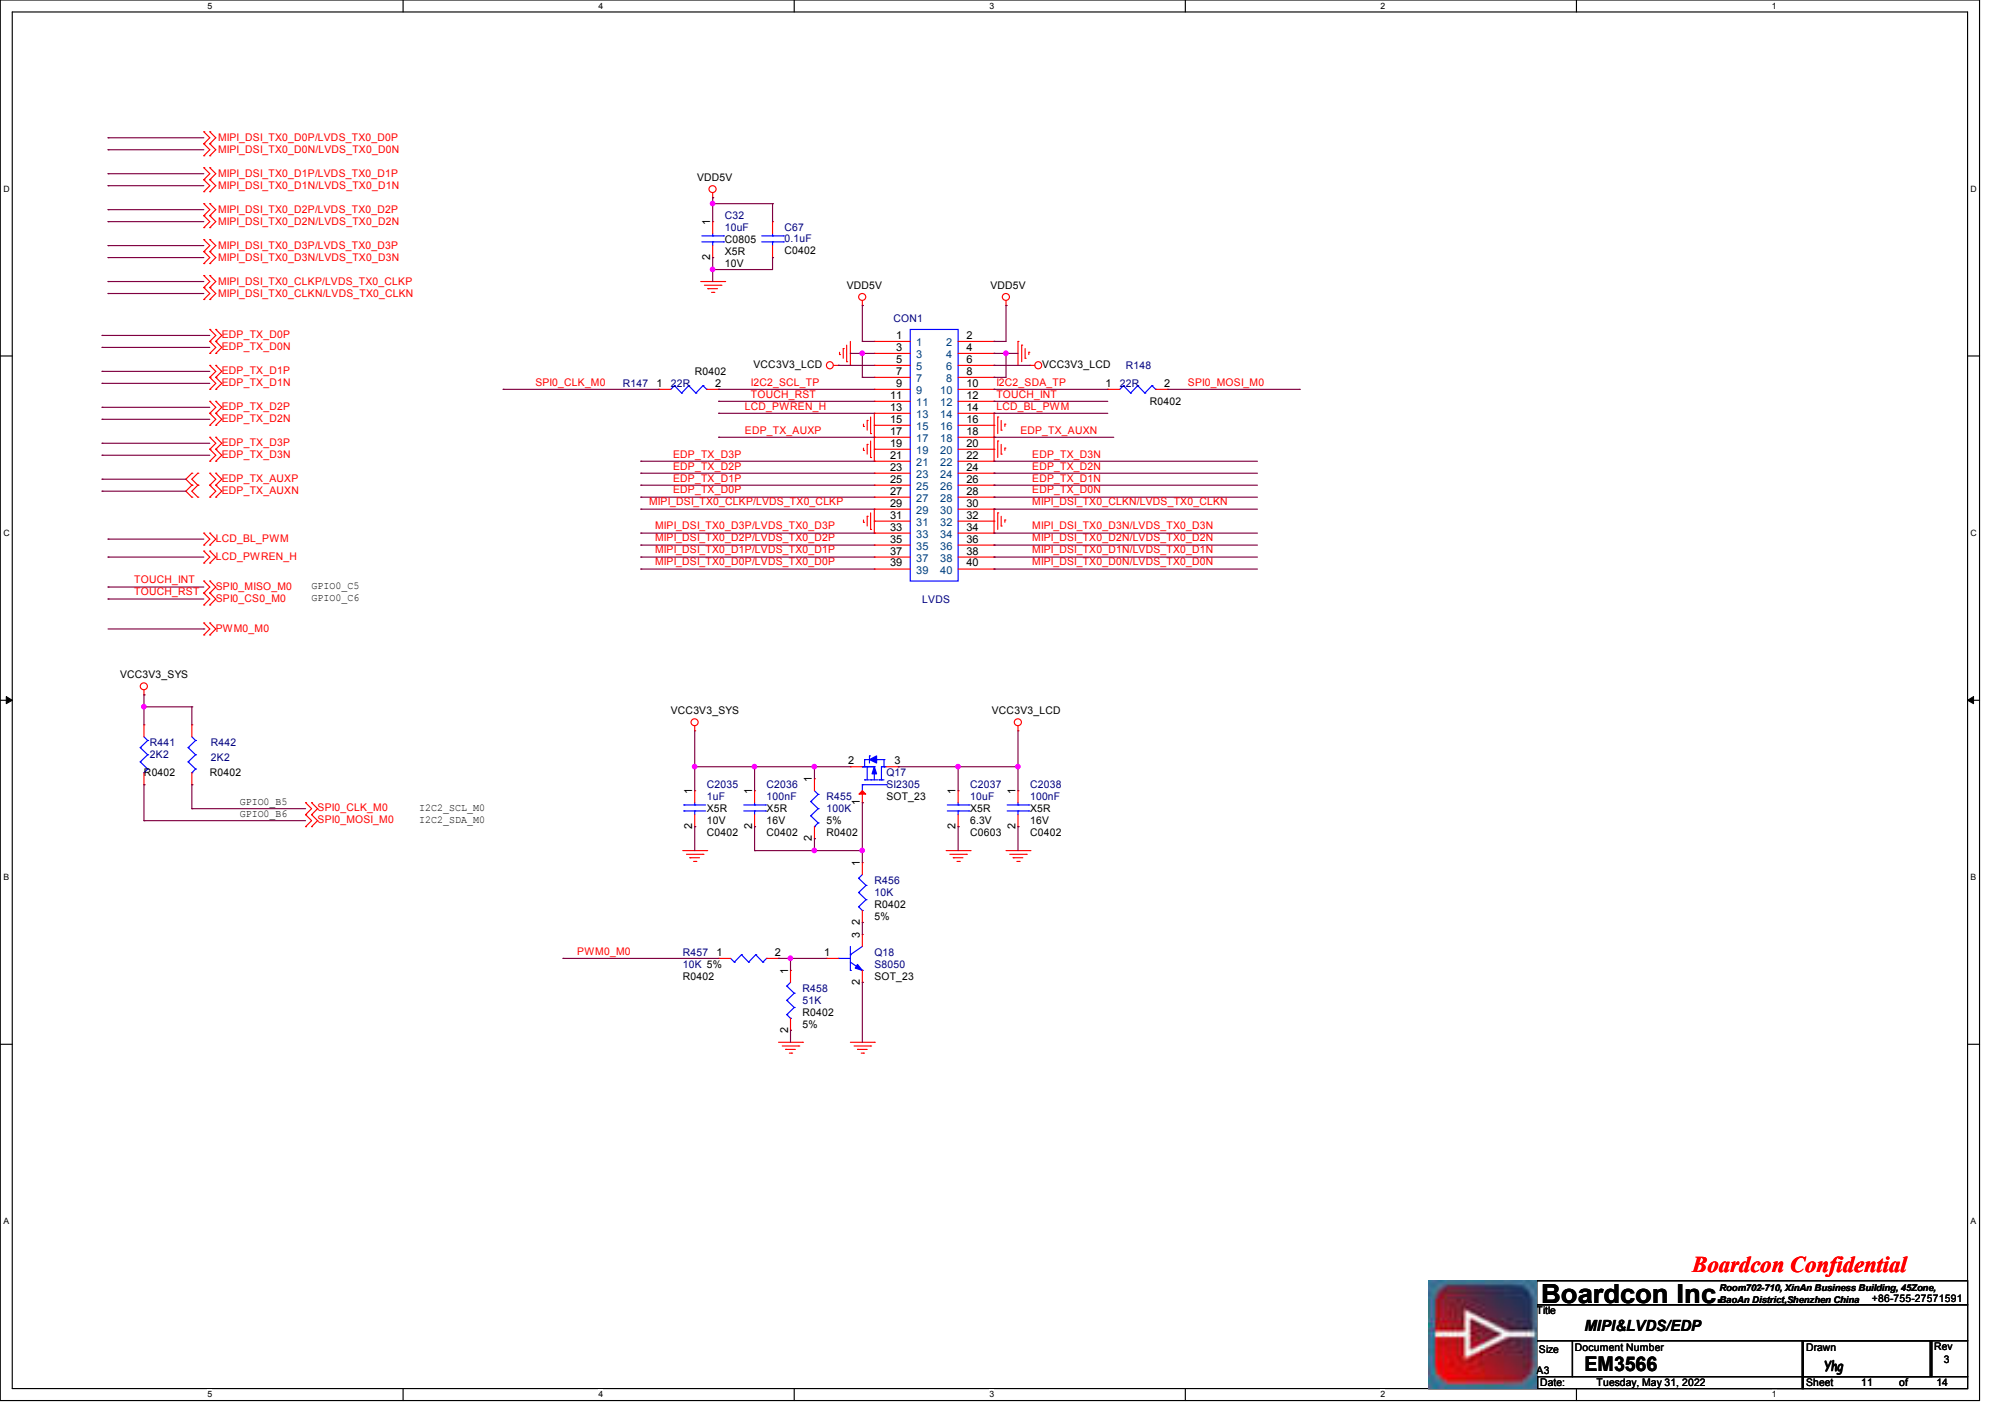
[picture p46: page 11]

Boardcon Inc.BaoAn District,Shenzhen China

# ADC

# 1V8 GPIO

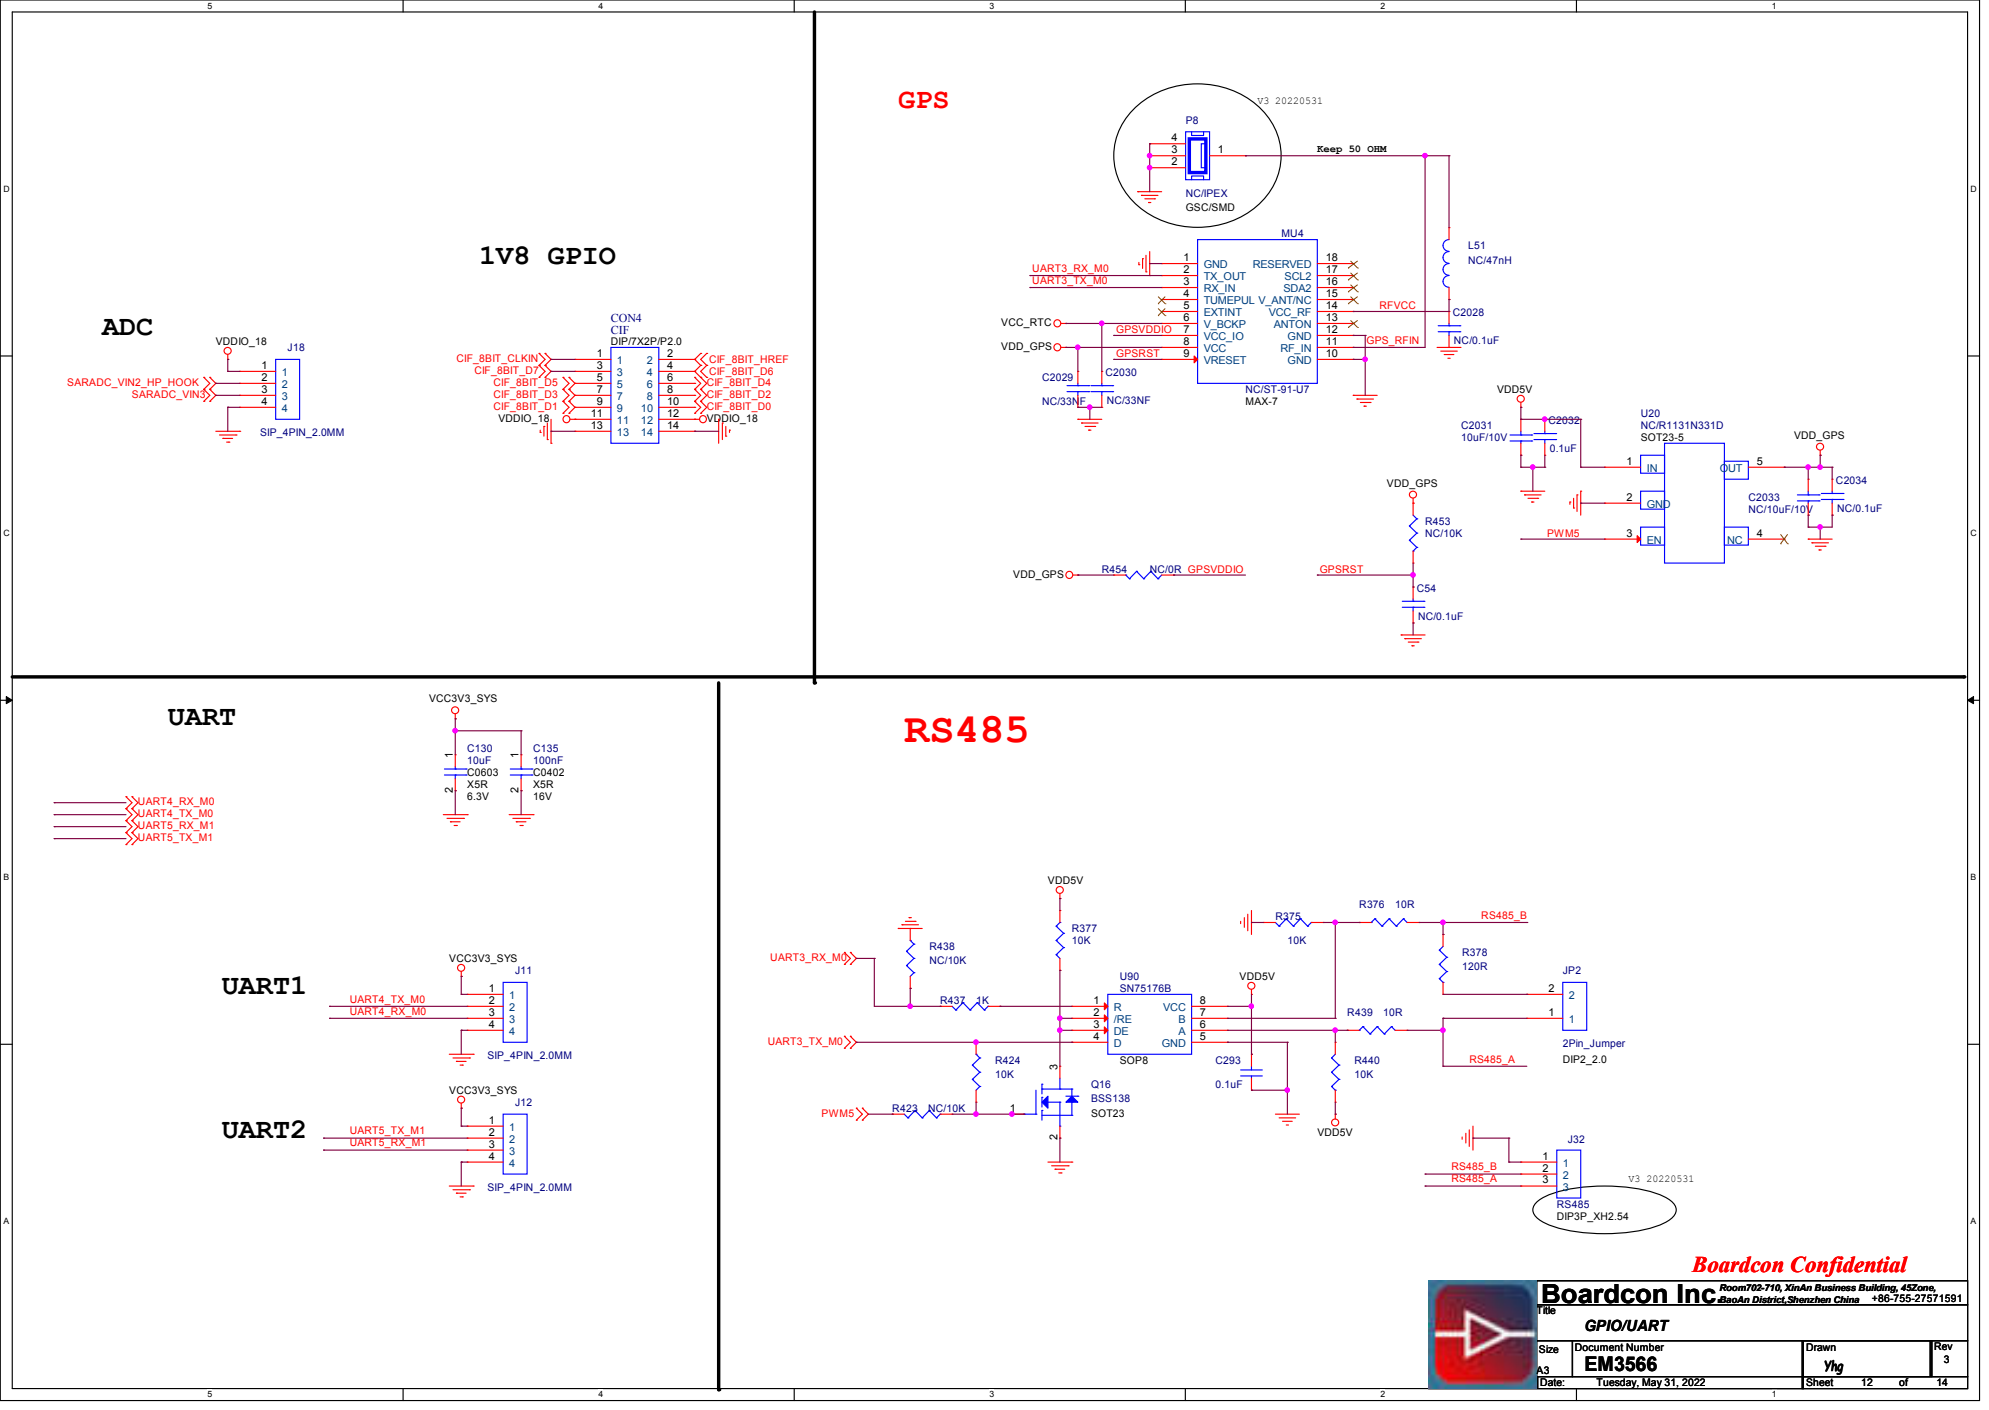
[picture p47: page 12]

Boardcon Inc.BaoAn District,Shenzhen China

## If use external clock then the XTAL2 need

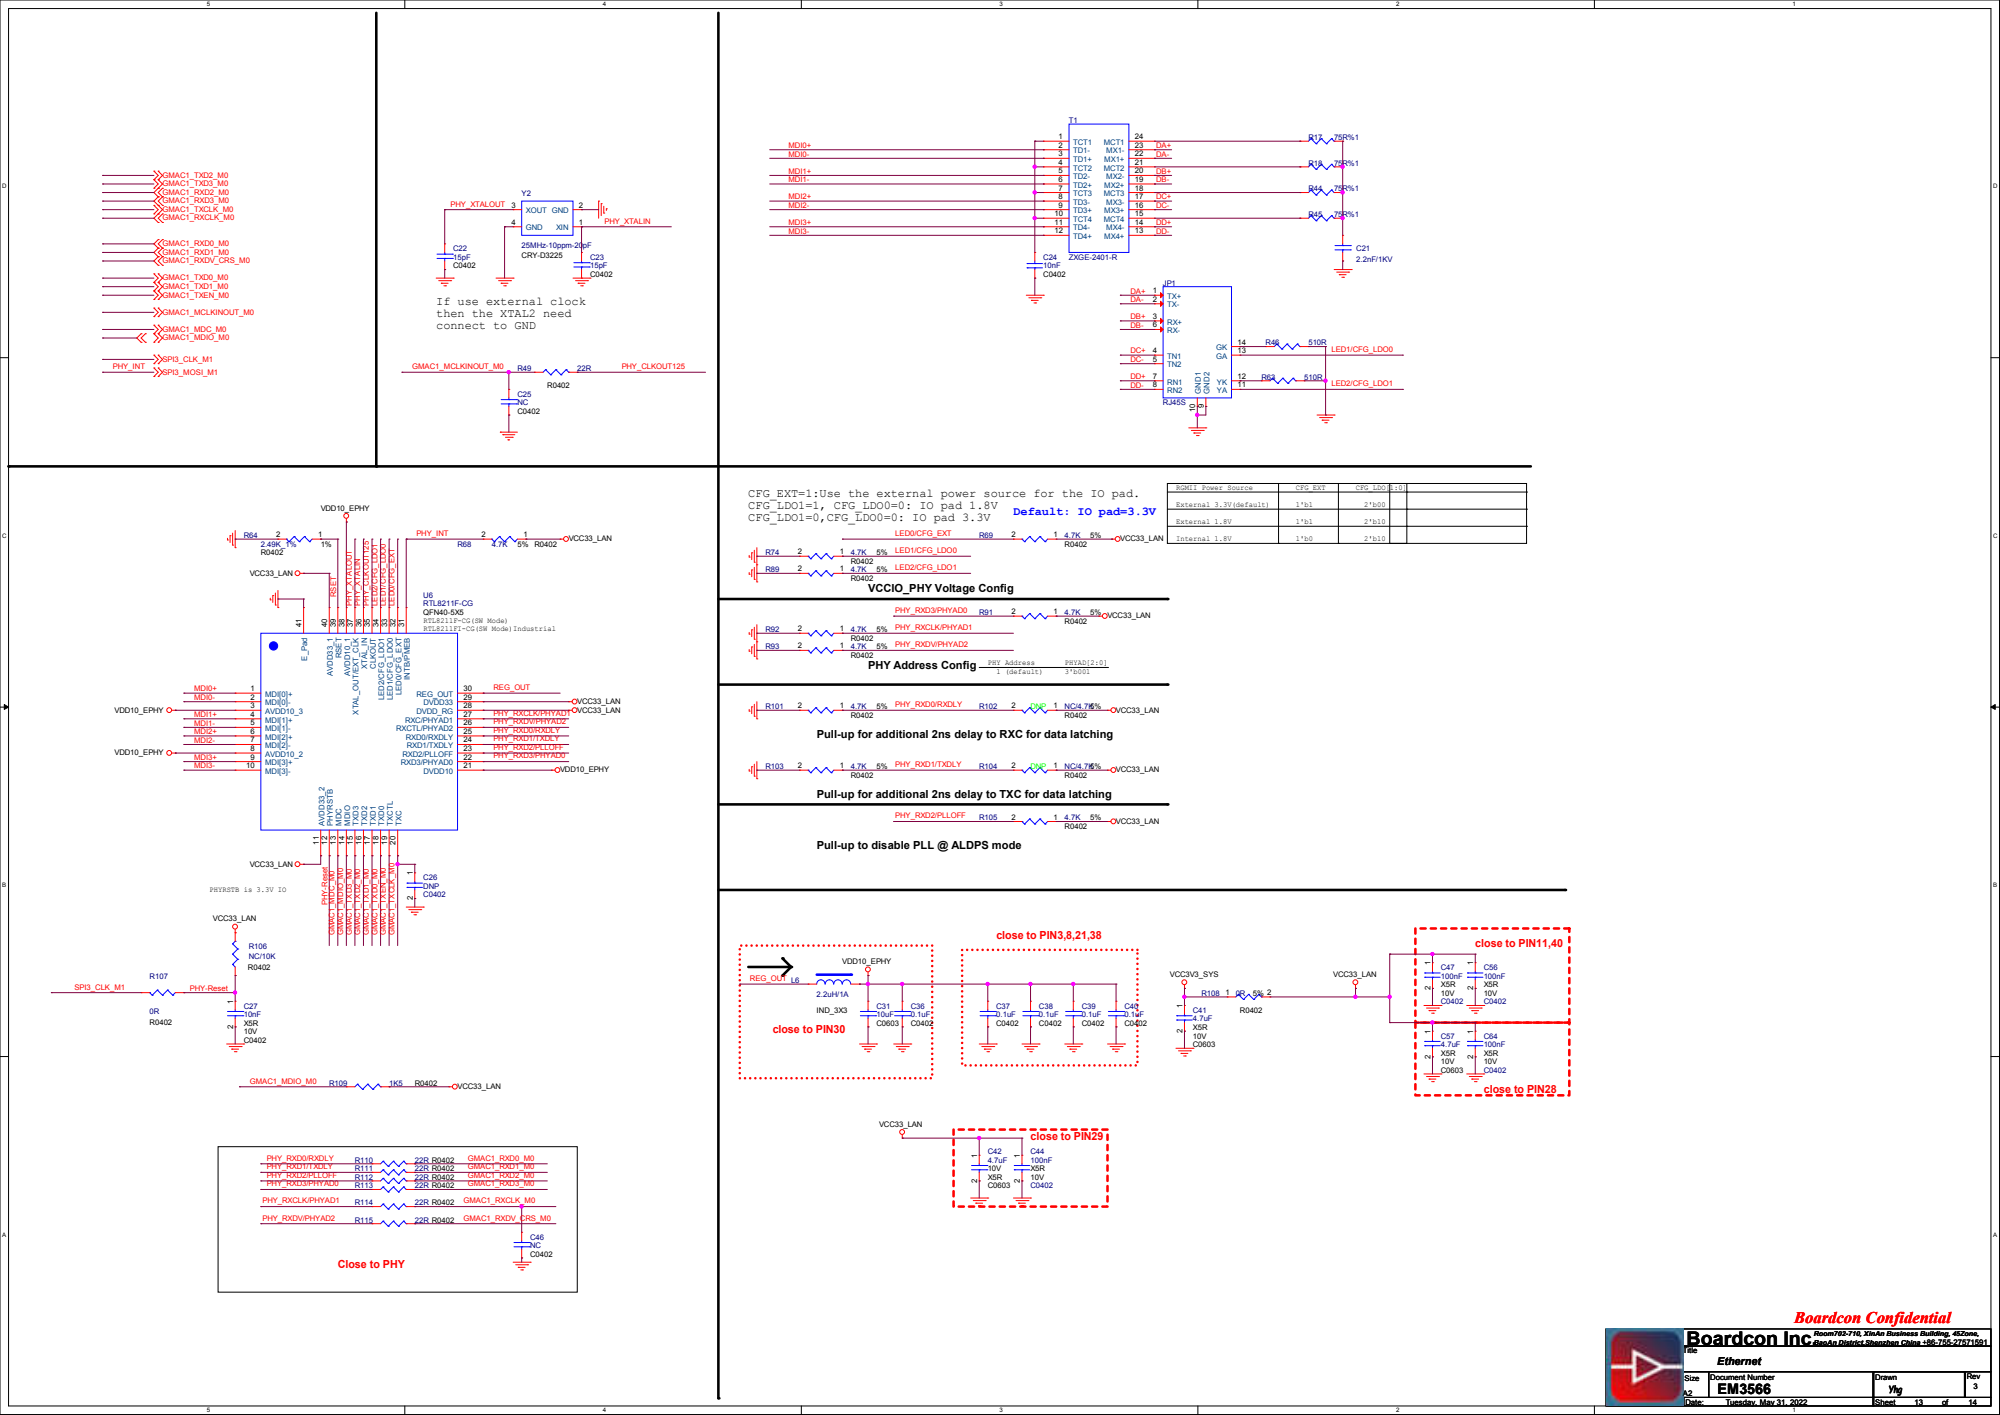
[picture p48: page 13]

CFG_EXT=1:Use the external power source for the IO pad.
CFG_LDO1=1, CFG_LDO0=0: IO pad 1.8V

Pull-up for additional 2ns delay to RXC for data latching

Pull-up for additional 2ns delay to TXC for data latching

Pull-up to disable PLL @ ALDPS mode

# SPDIF-OUT

## SPDIF_TX_M2

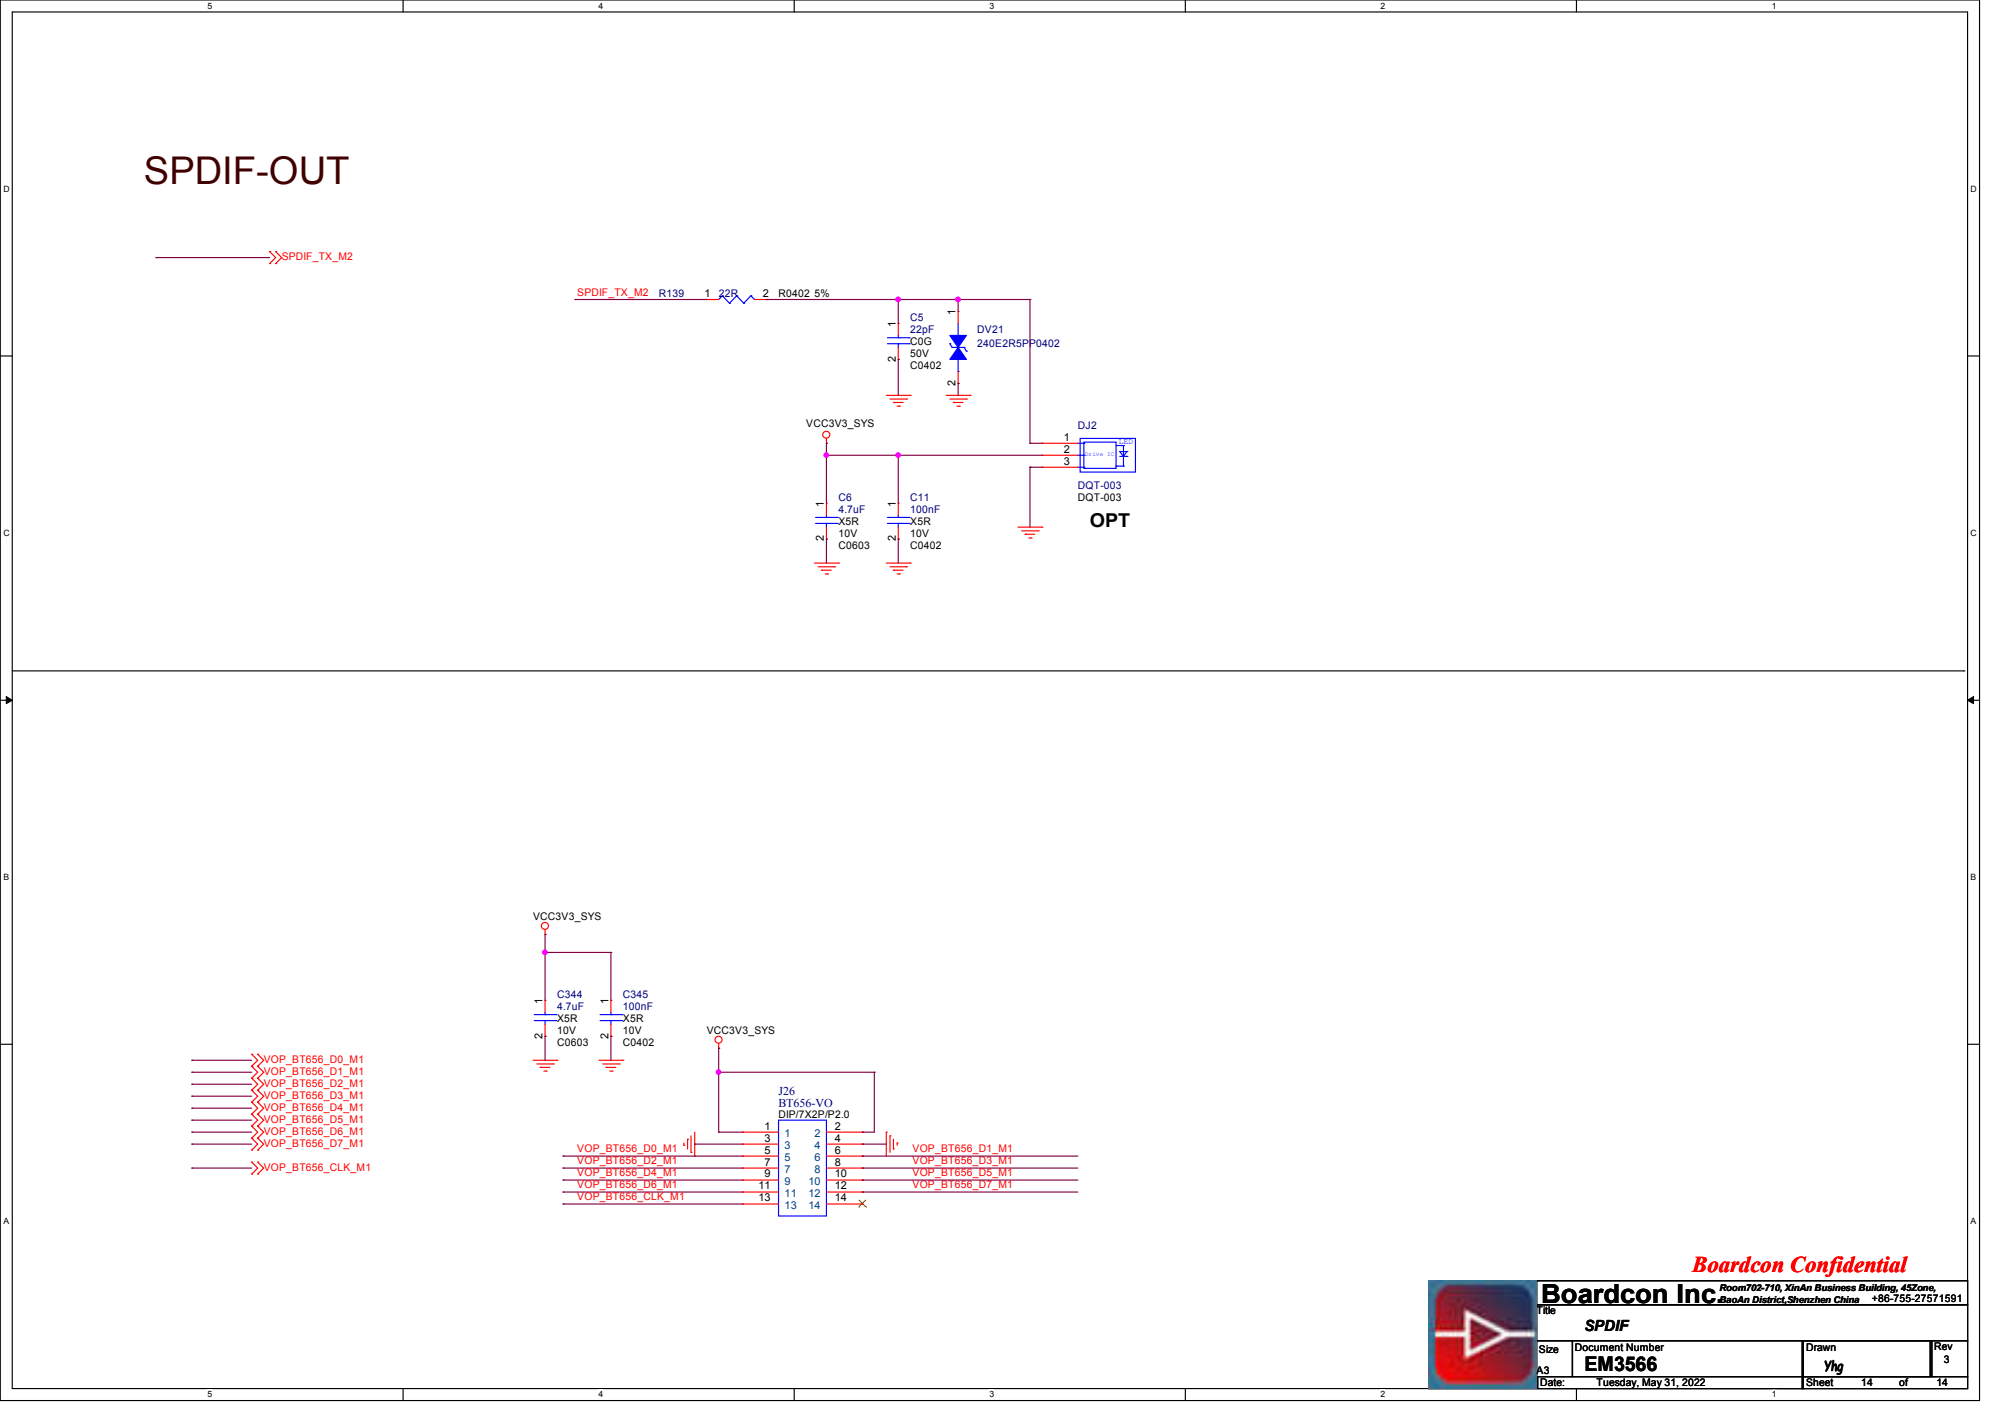
[picture p49: page 14]

Boardcon Inc.BaoAn District,Shenzhen China
