ihsanakyrk/Eski-Versionlar-Ve-Siparisler/[04.2025]/IMX_219_V2.0(Nisan_2025)/IMX_219_V2.0/IMX219_V2.0.pdf

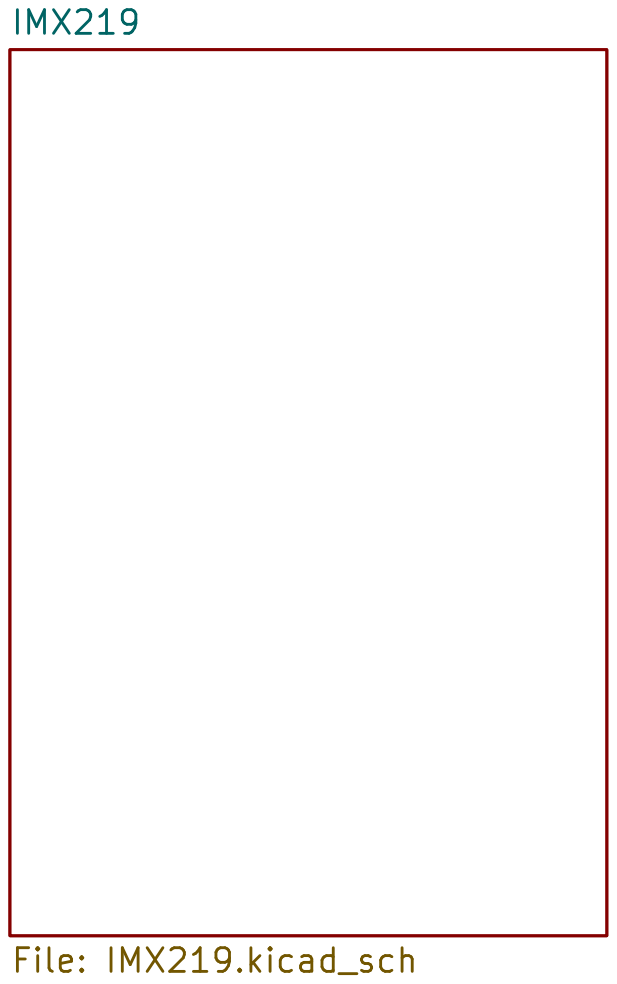
[picture p50: page 1]

Id: 1/2 Title: File: IMX219_V2.0.kicad_sch Sheet: /

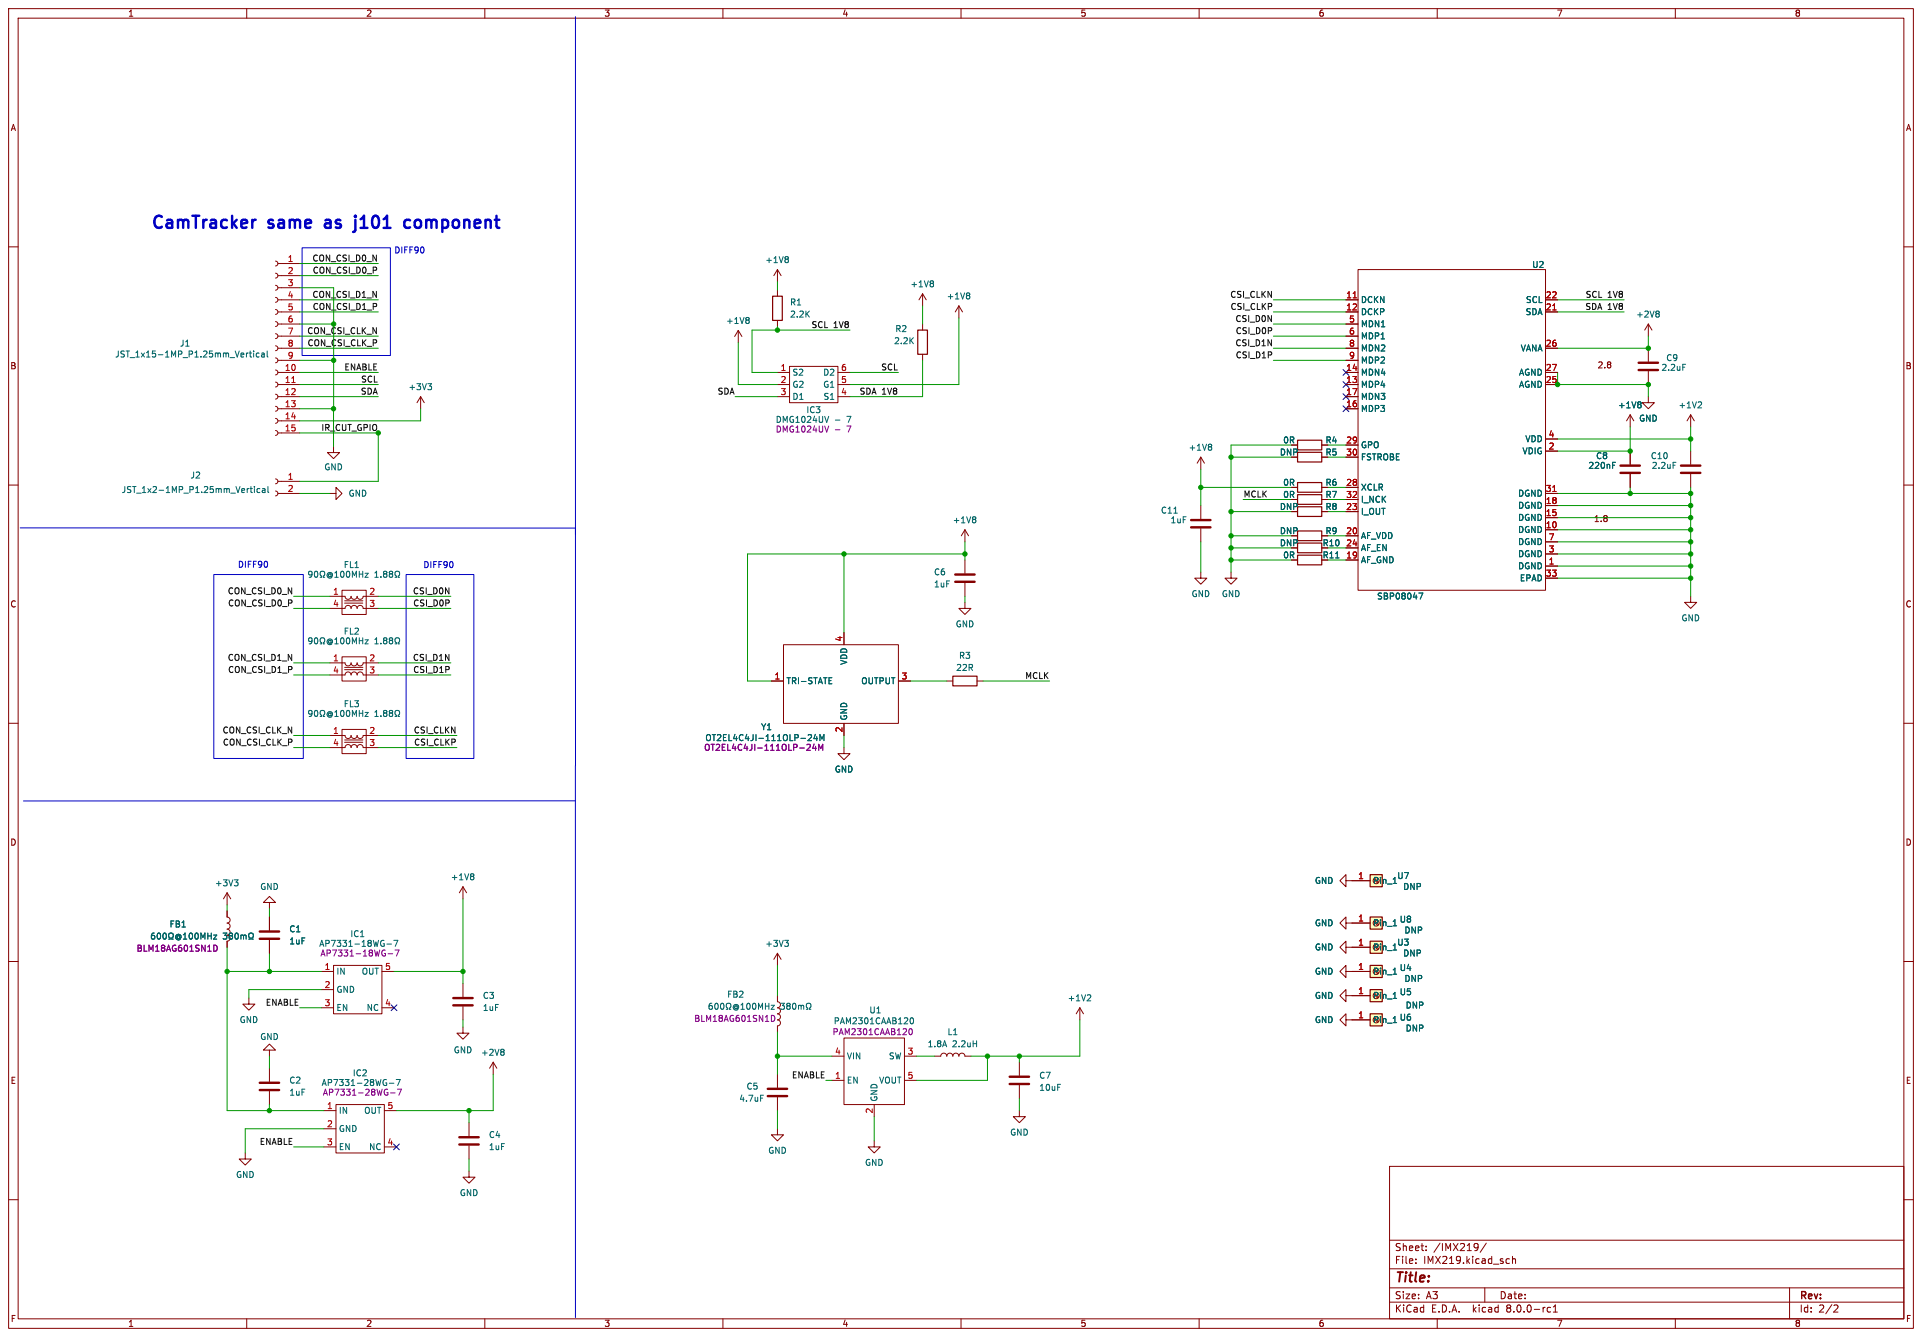
[picture p51: page 2]
