ihsanakyrk/Eski-Versionlar-Ve-Siparisler/GSM_A7602E-H_Modul_V1.0/Movita-Pro-V2_1-GSM-EC25-Schematic-12012023 (8).pdf

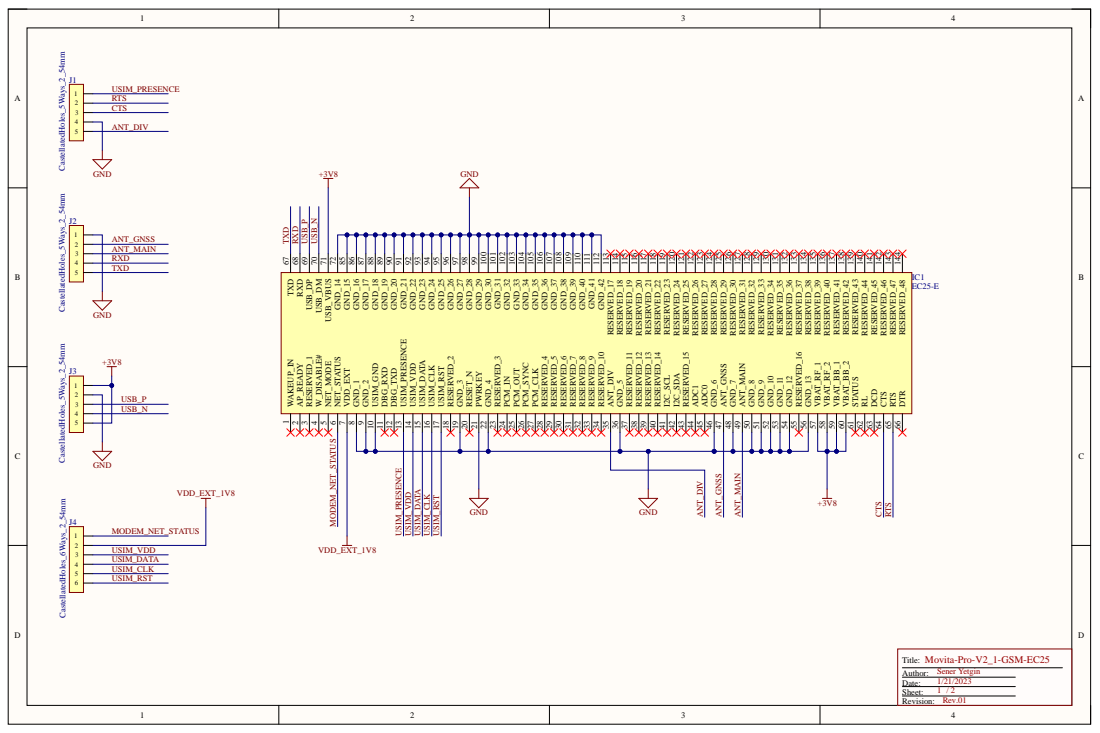
[picture p52: page 1]

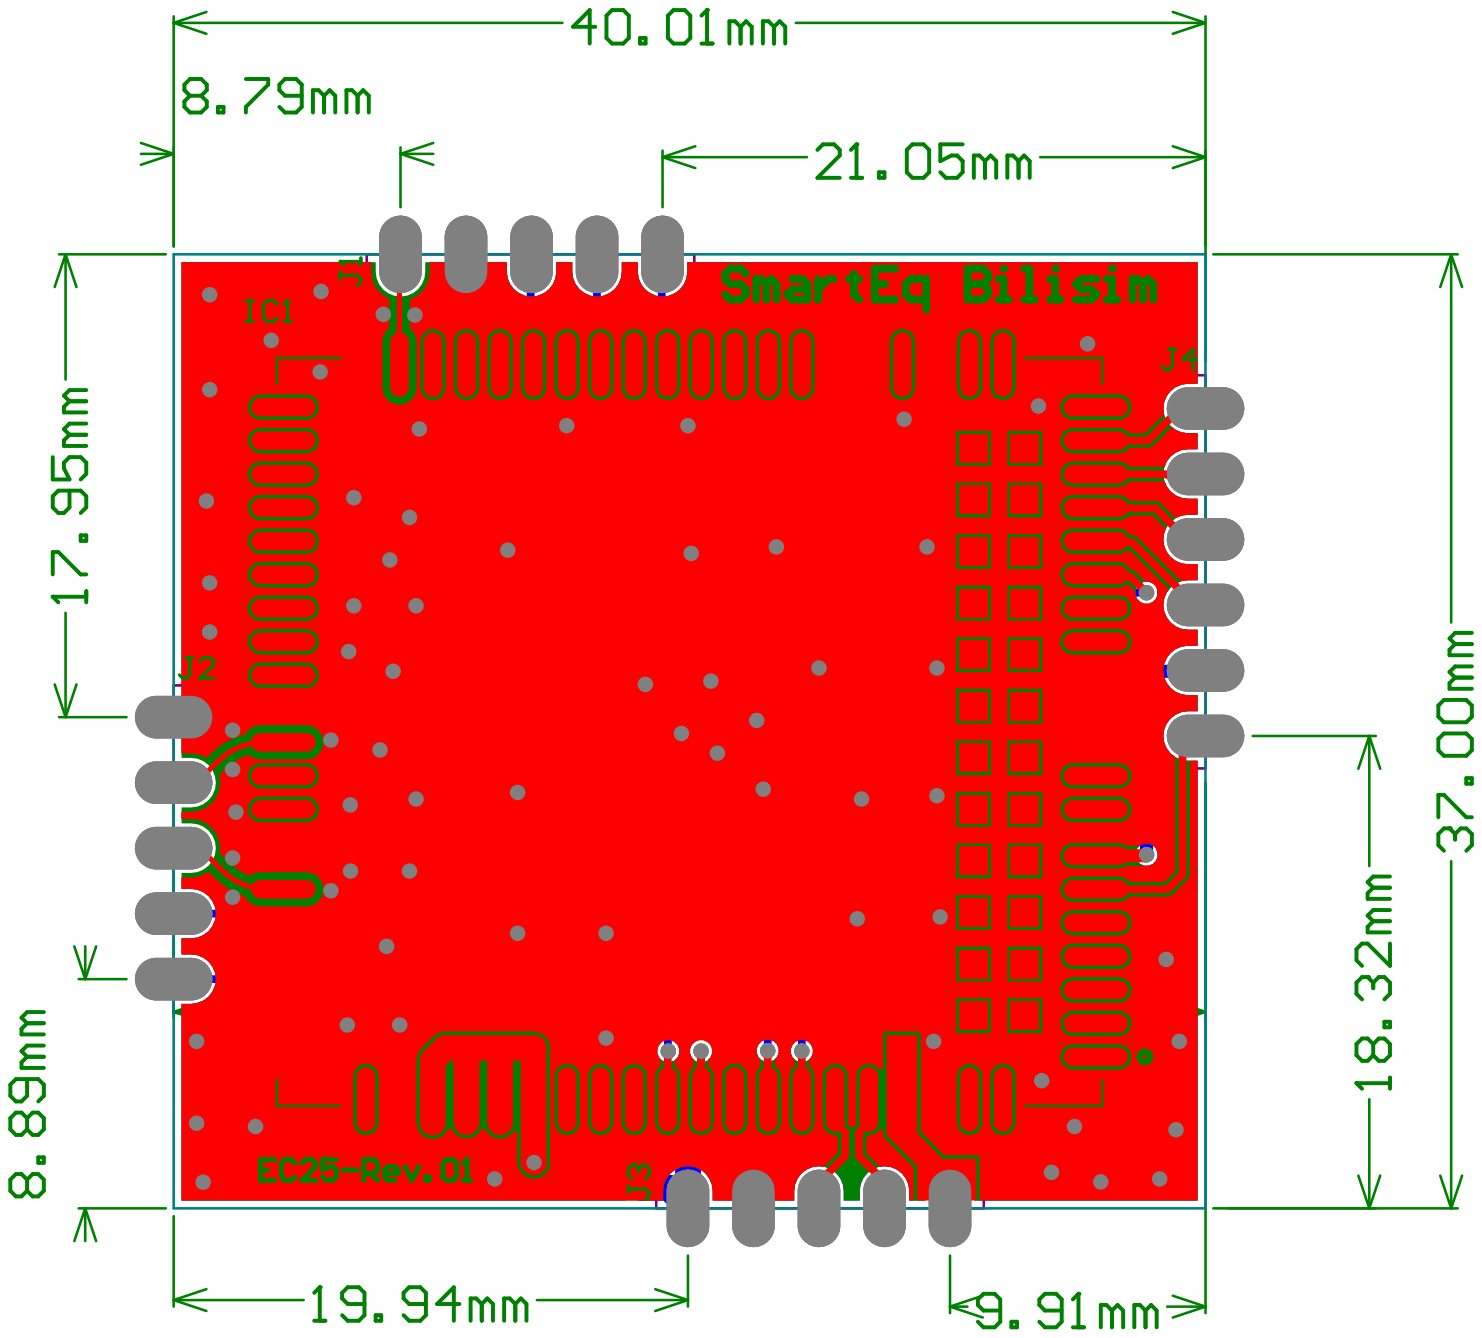
[picture p53: page 2]
