ihsanakyrk/Eski-Versionlar-Ve-Siparisler/[11.2023]/Anchor(Kasım_2023)/Anchor_V1.0_(28.11.2023)/Schematic pdf.pdf

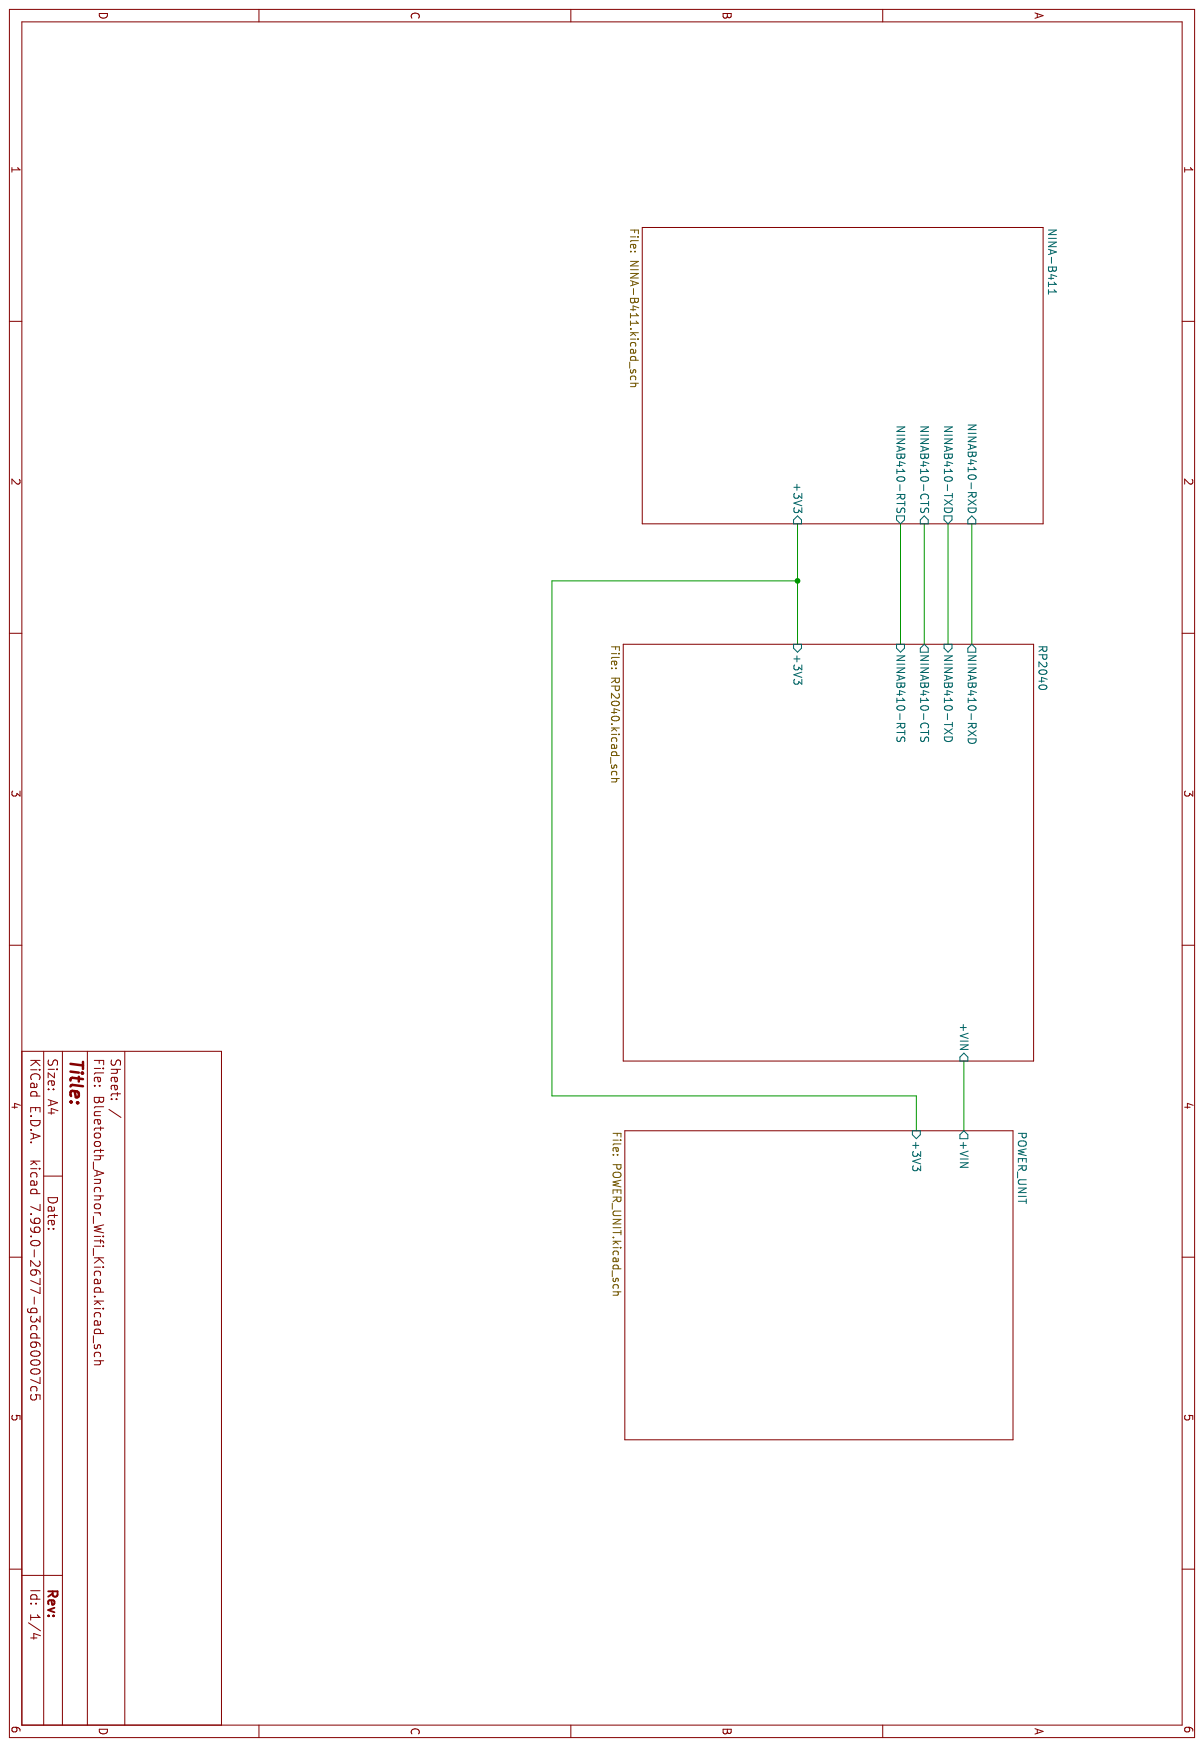
[picture p54: page 1]

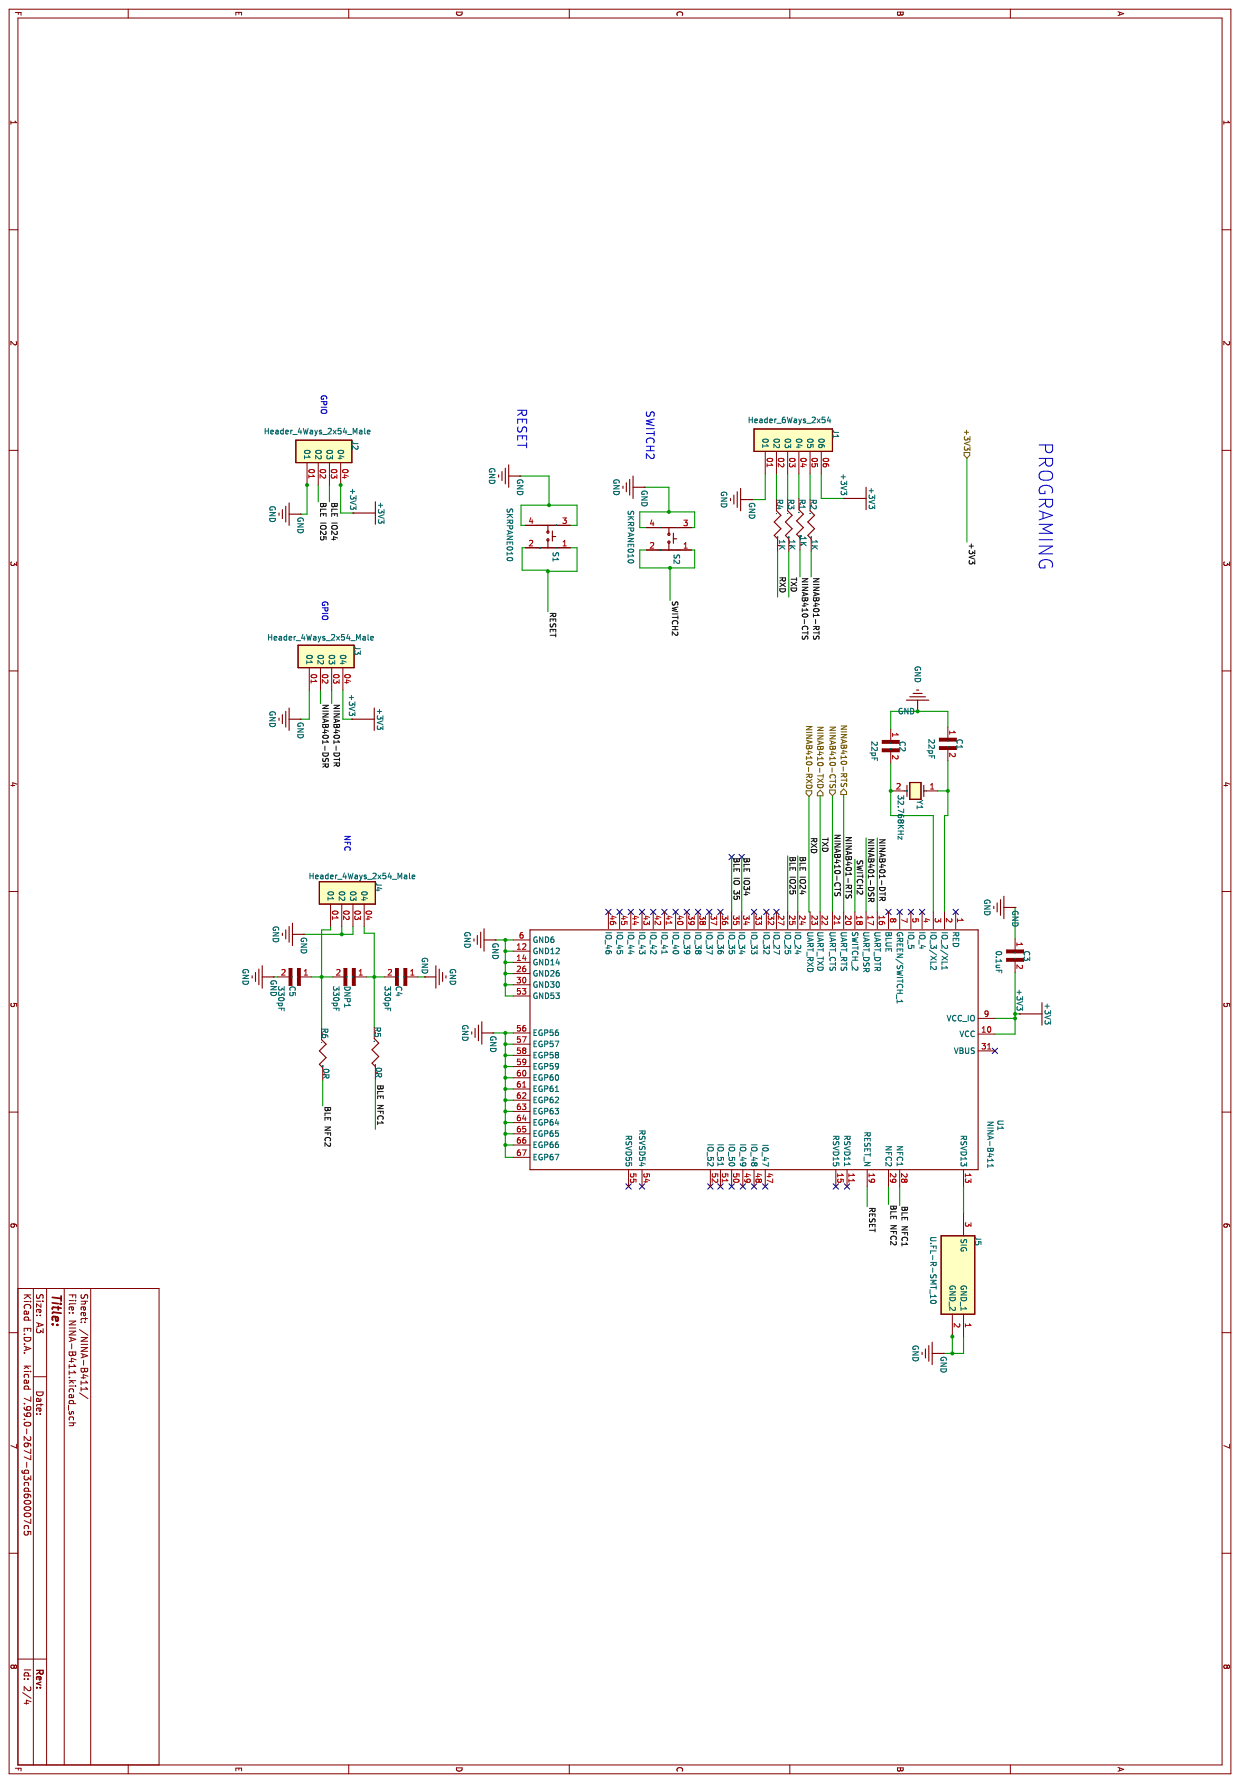
[picture p55: page 2]

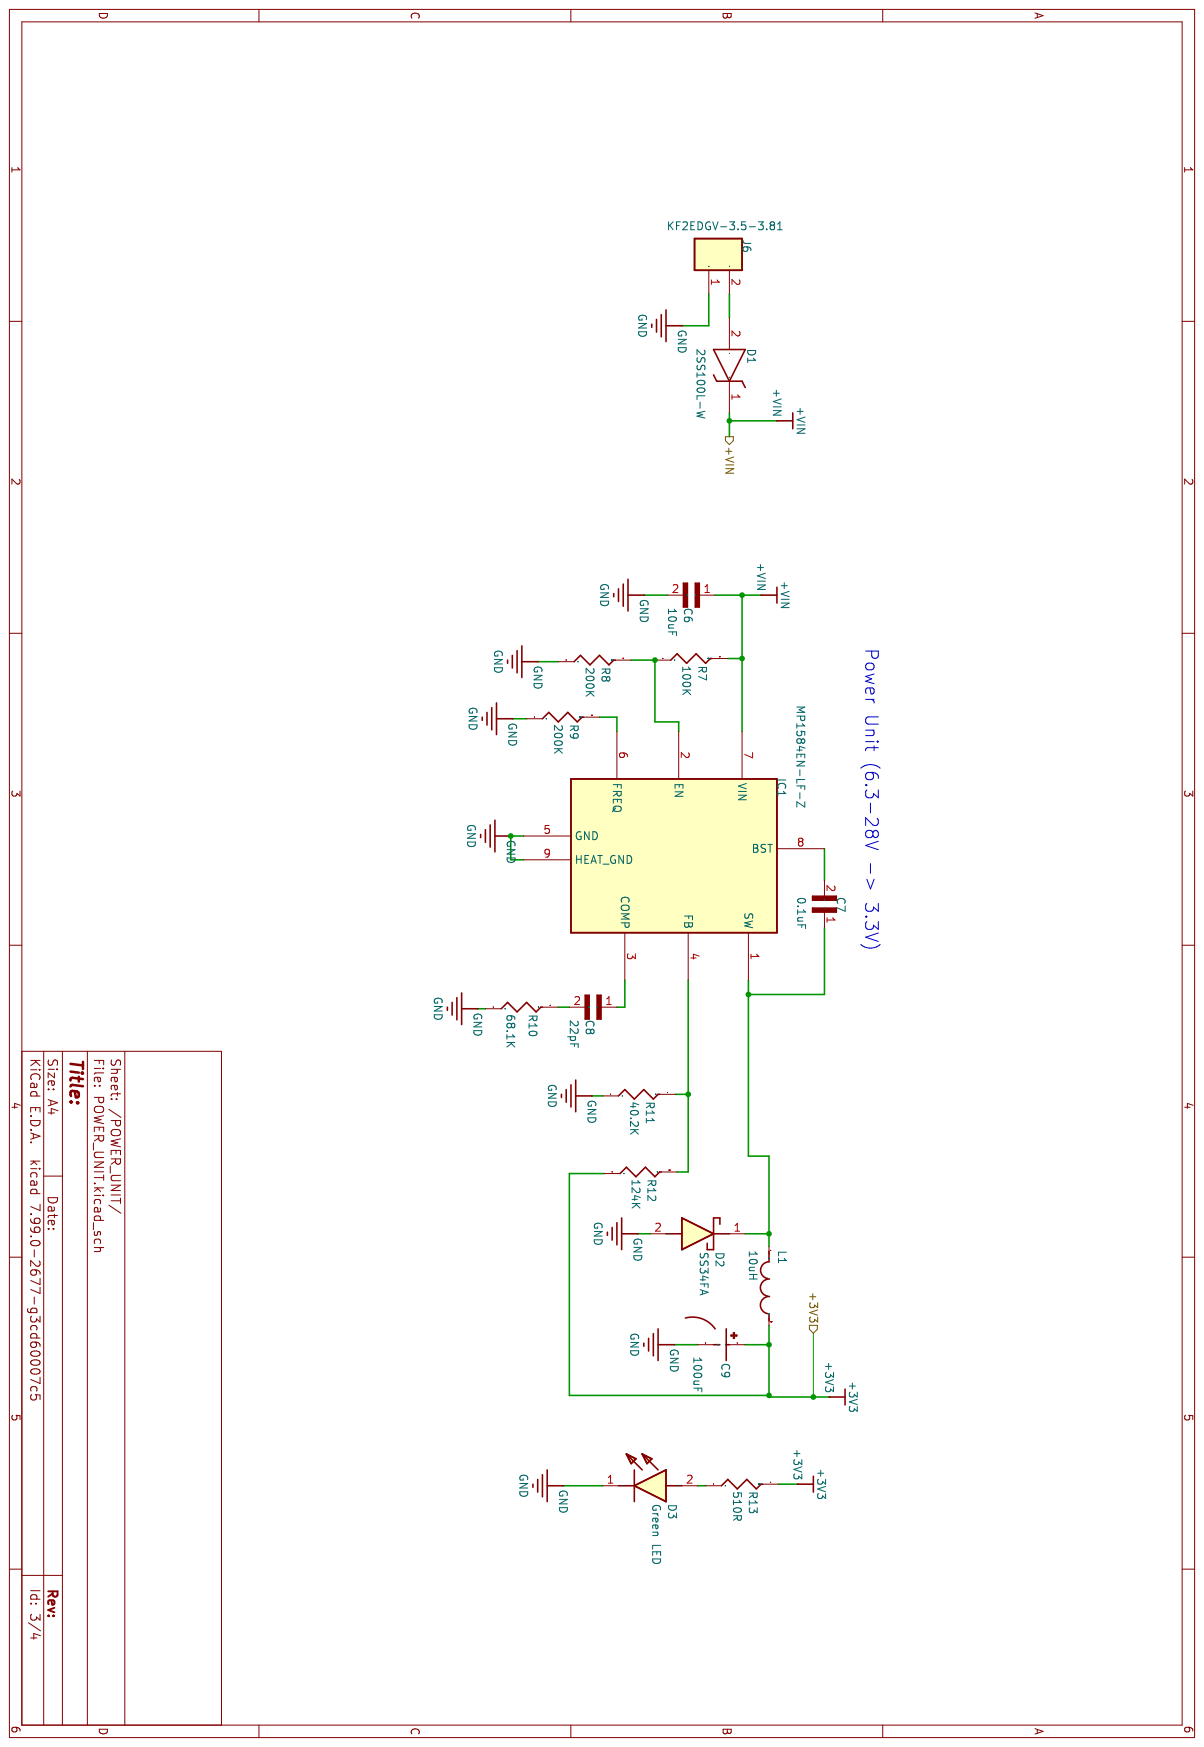
[picture p56: page 3]

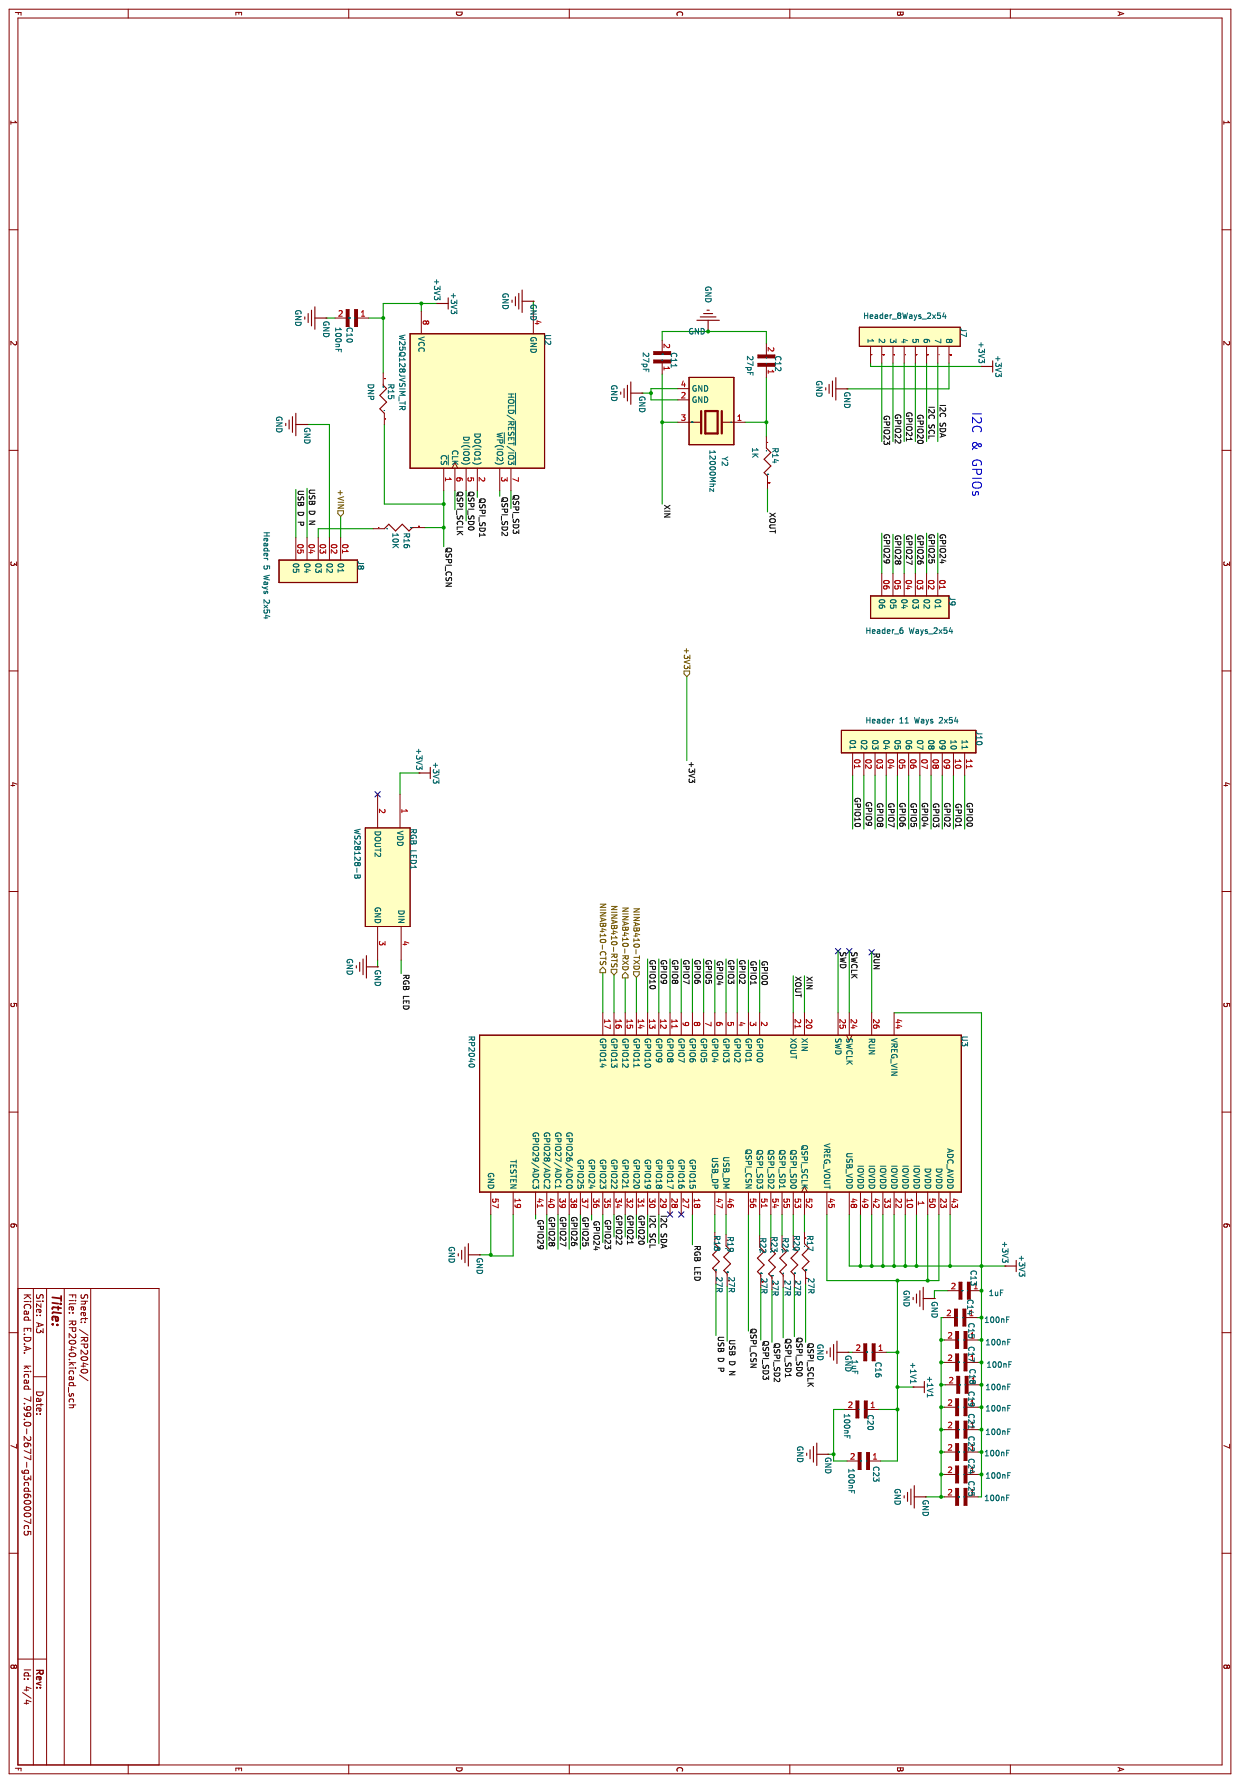
[picture p57: page 4]
