ihsanakyrk/Eski-Versionlar-Ve-Siparisler/KSS_Led_Panel_V1.0(Yeni nesil)/KSS_LP_V1.0.pdf

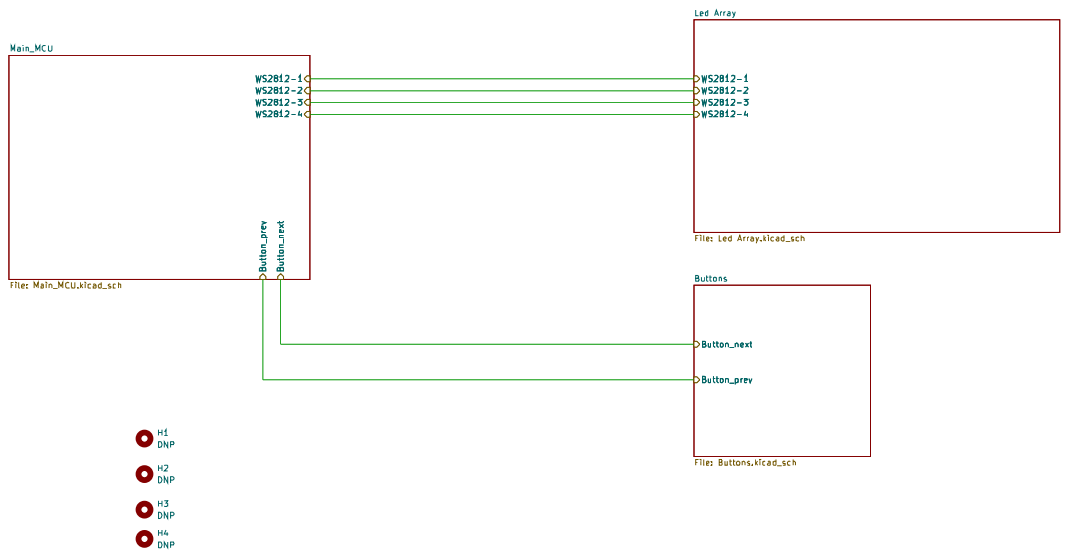
[picture p58: page 1]

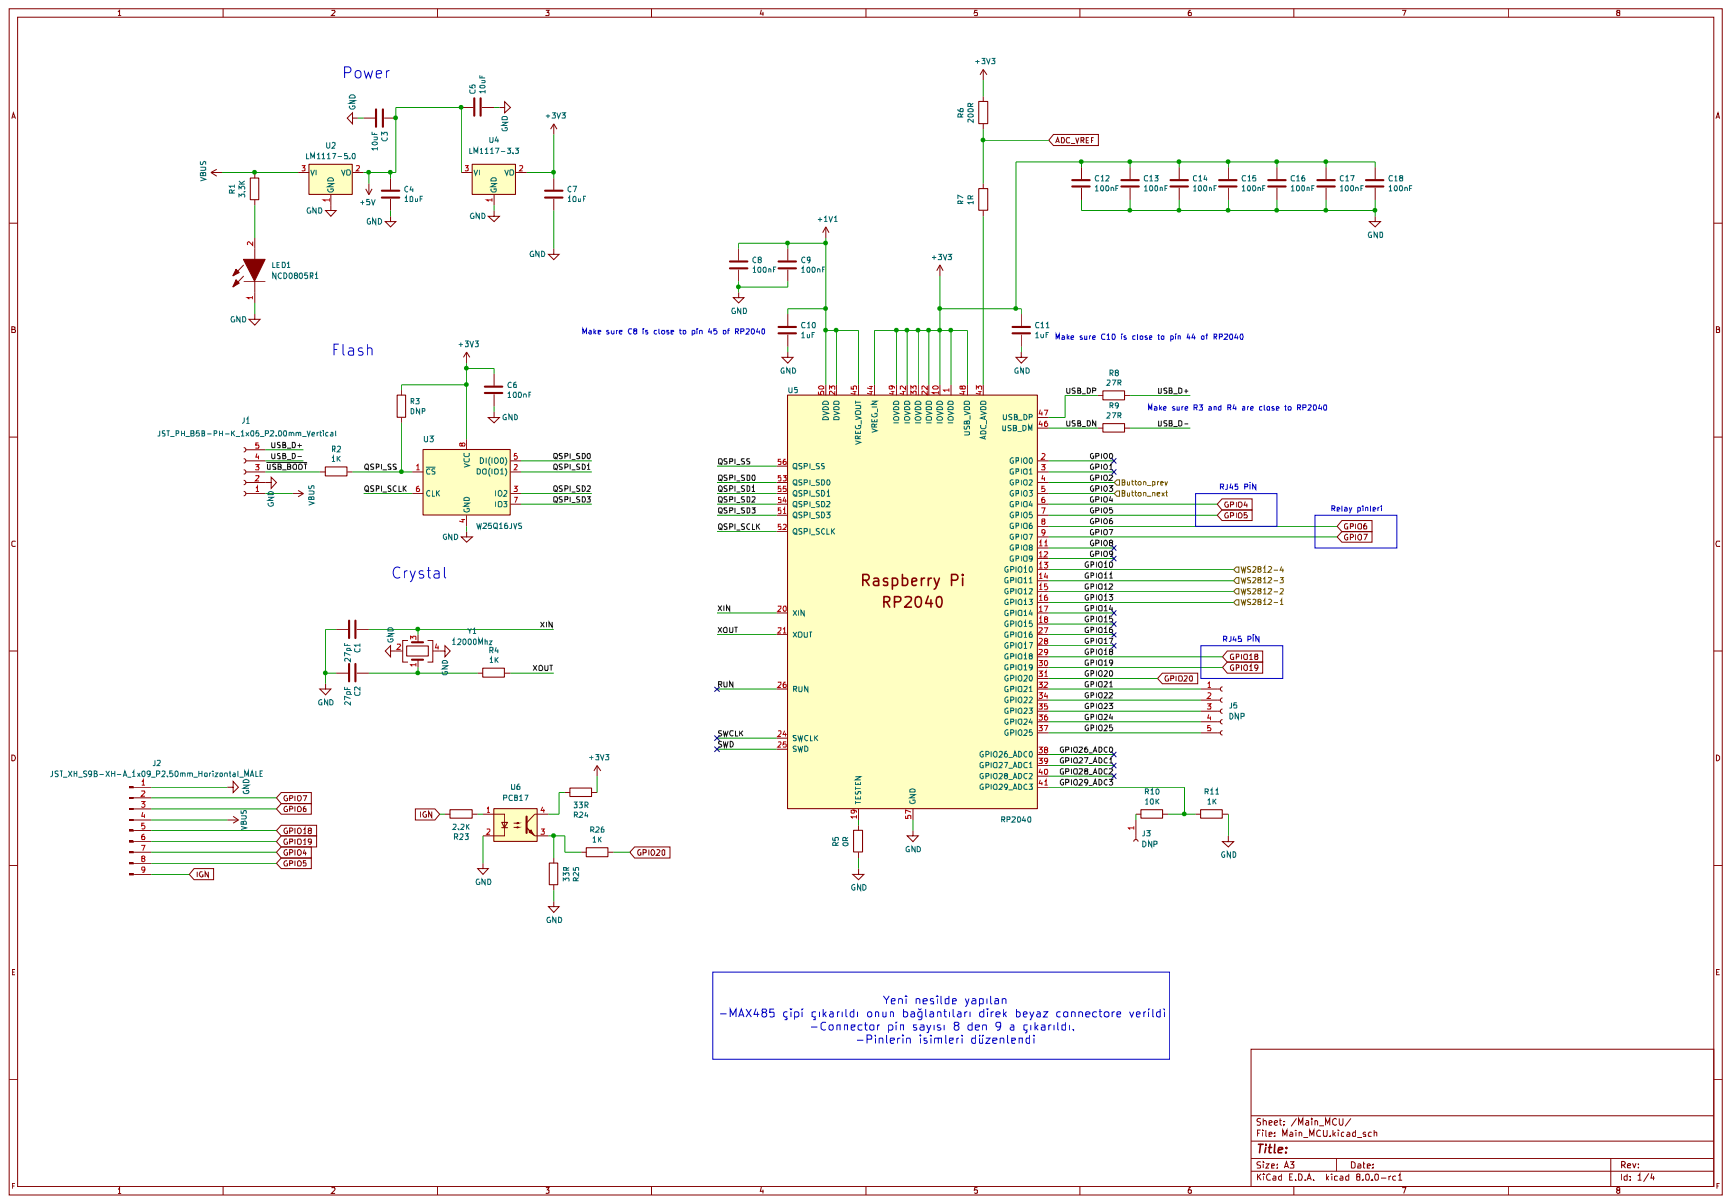
[picture p59: page 2]

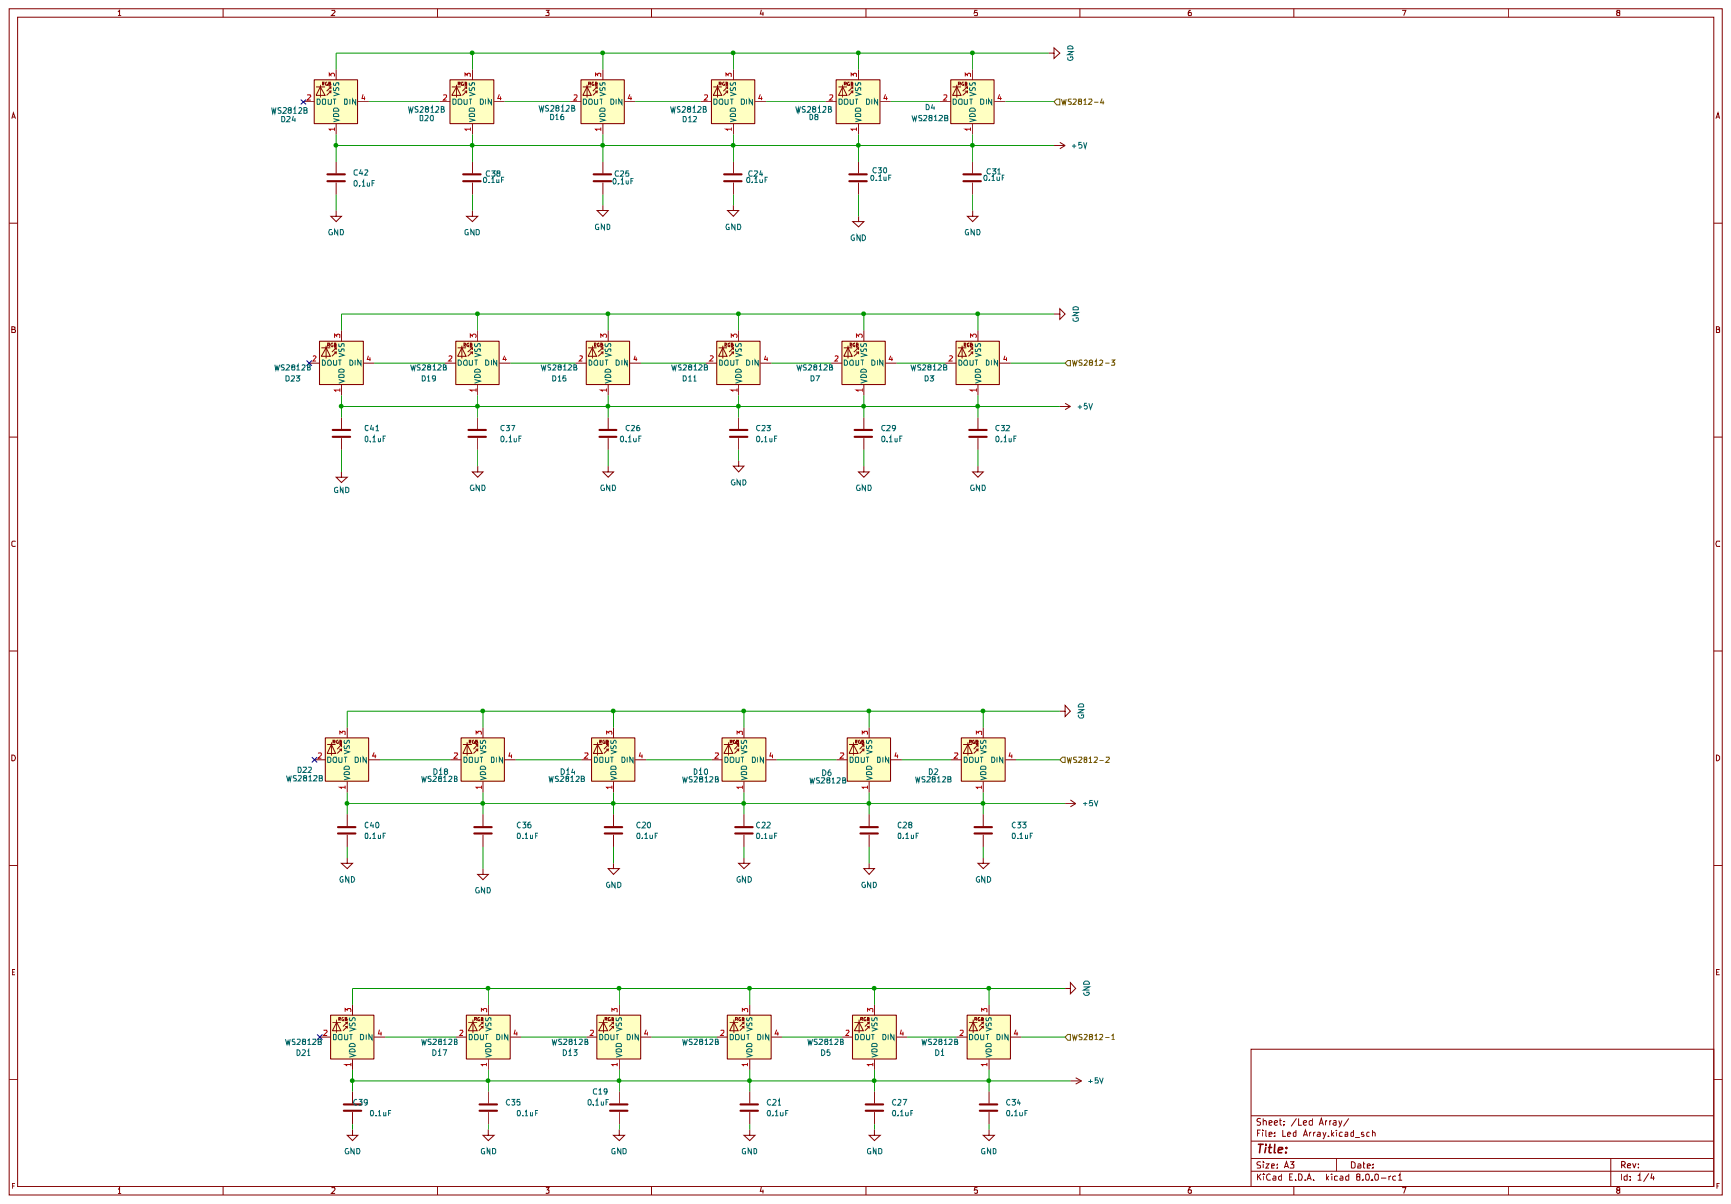
[picture p60: page 3]

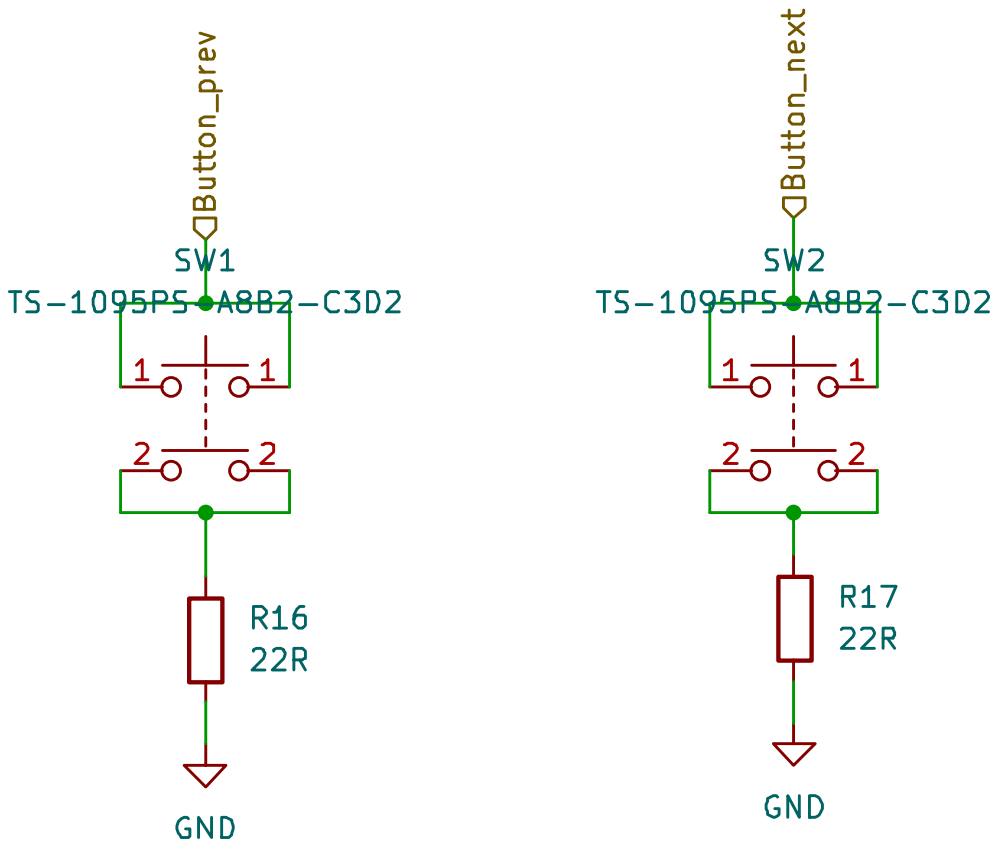
[picture p61: page 4]
