ihsanakyrk/Eski-Versionlar-Ve-Siparisler/Movita_3568_AXV_Router_V3.0/MXVR_3568_V3.0.pdf

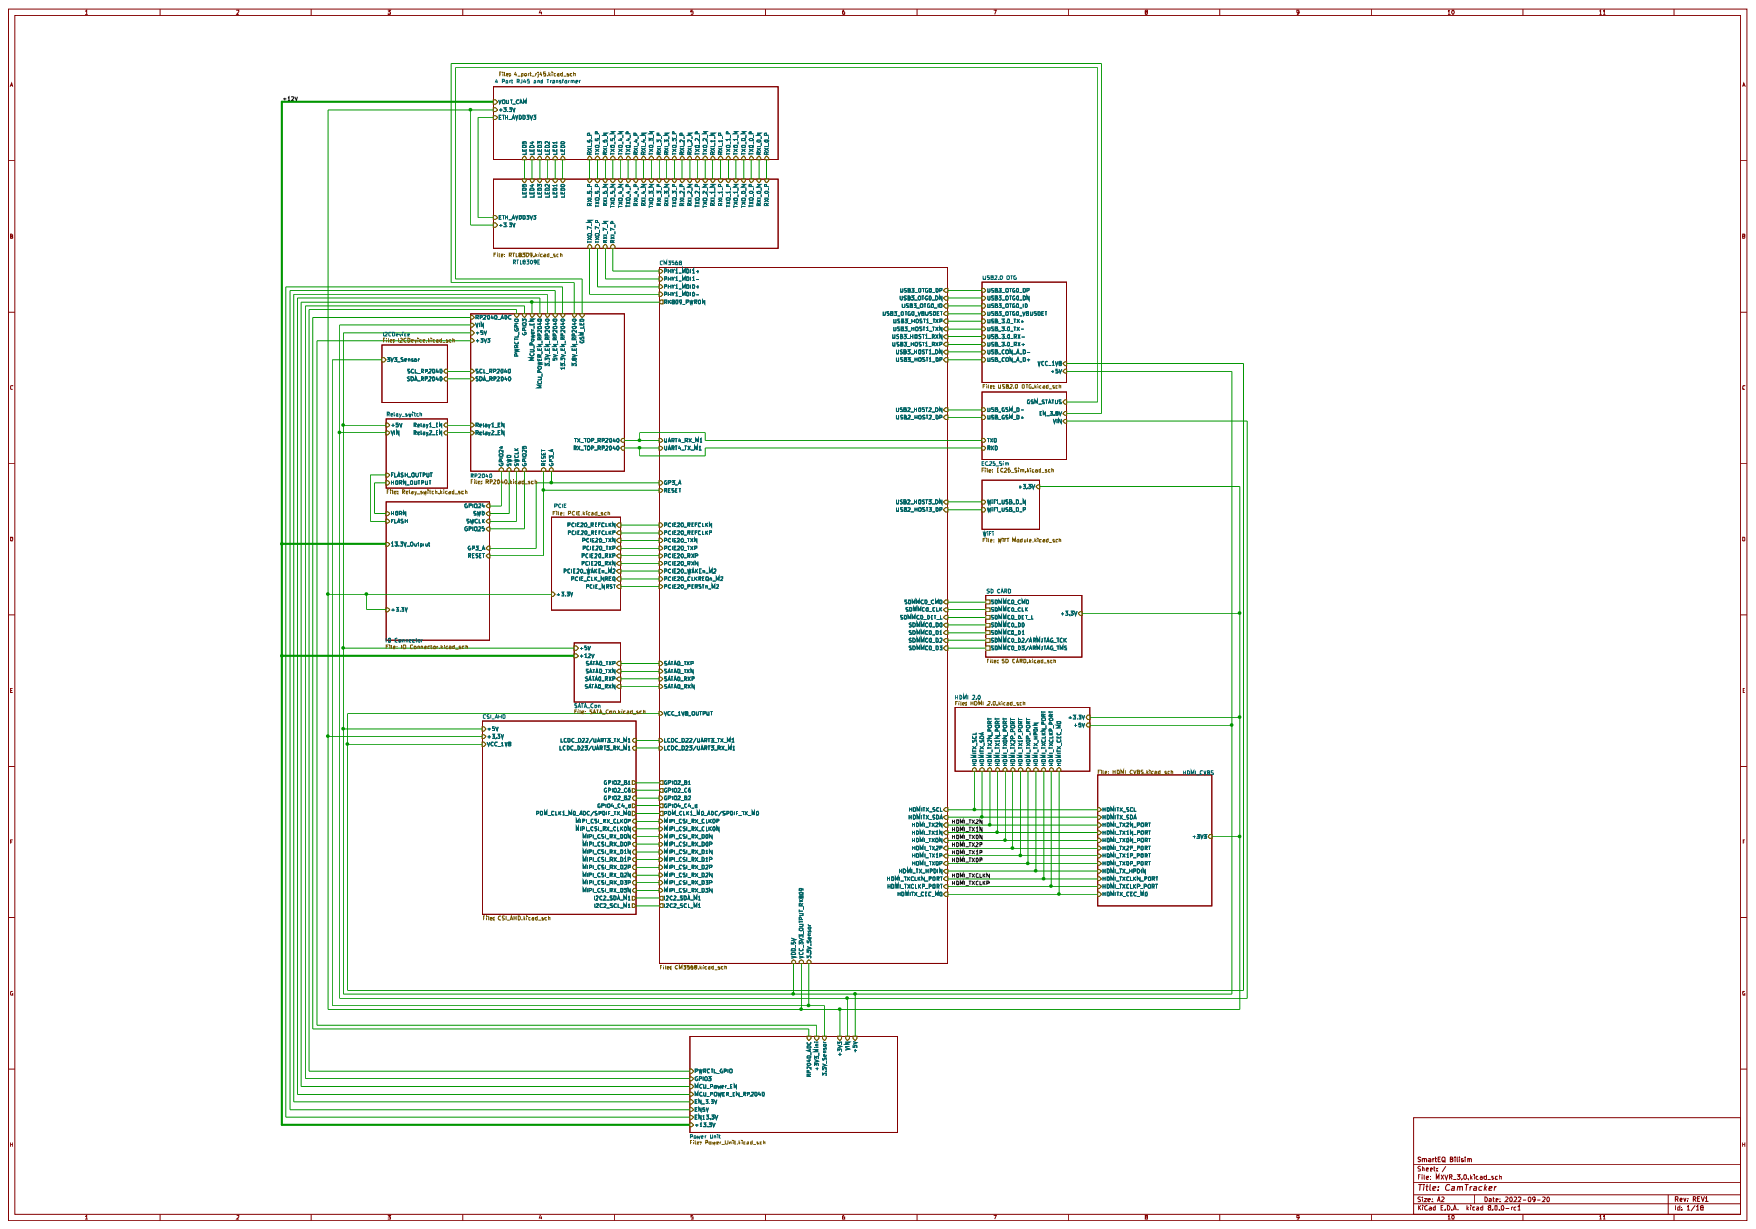
[picture p62: page 1]

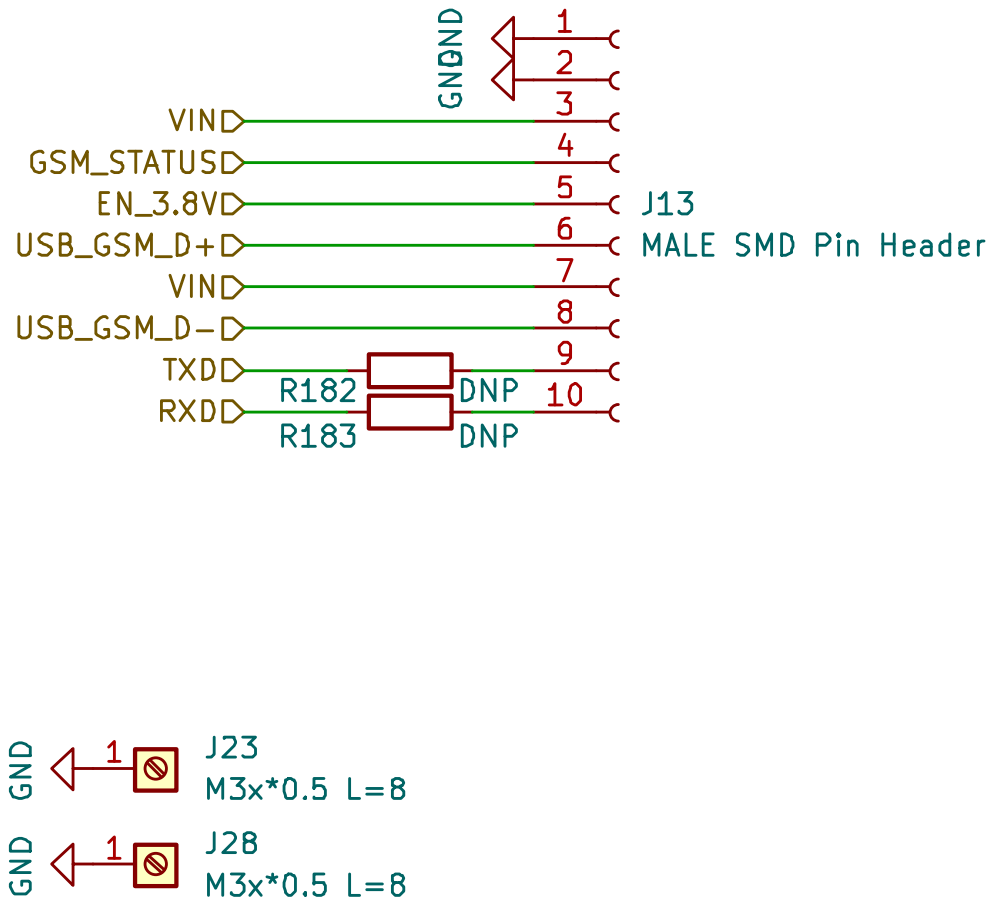
[picture p63: page 2]

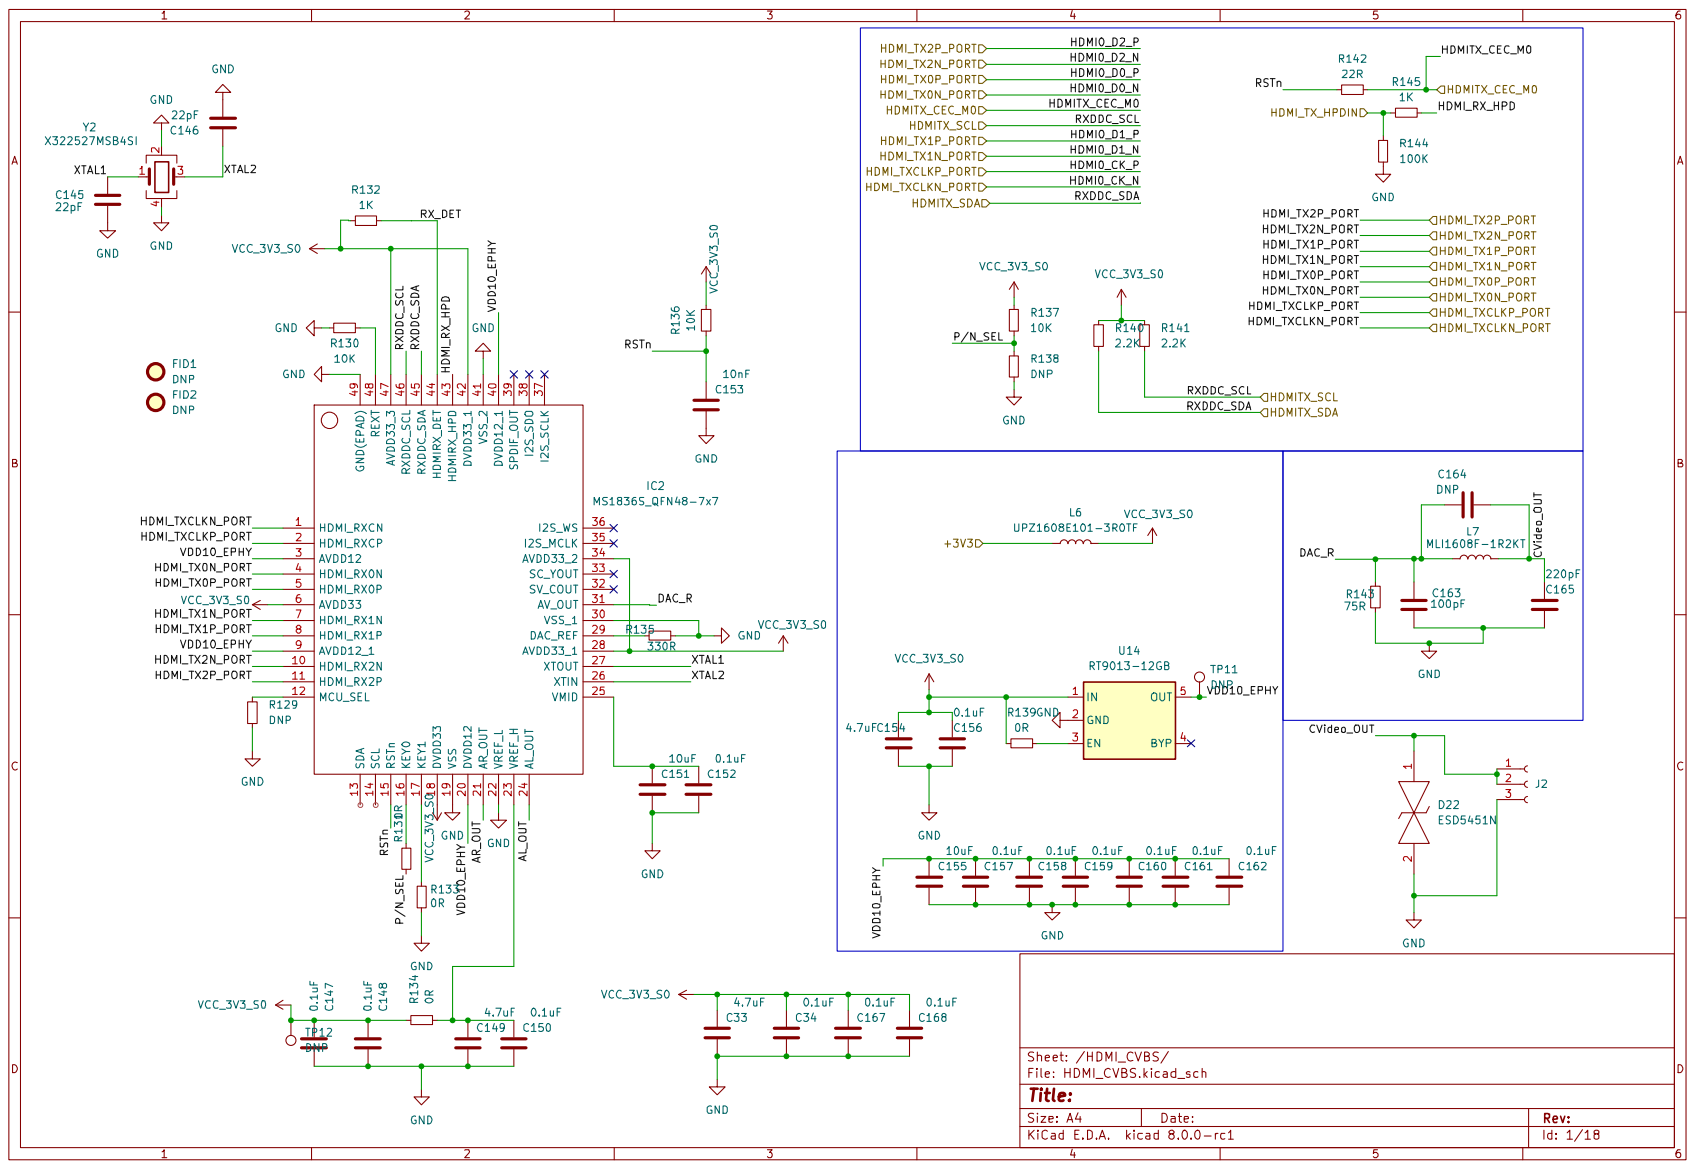
[picture p64: page 3]

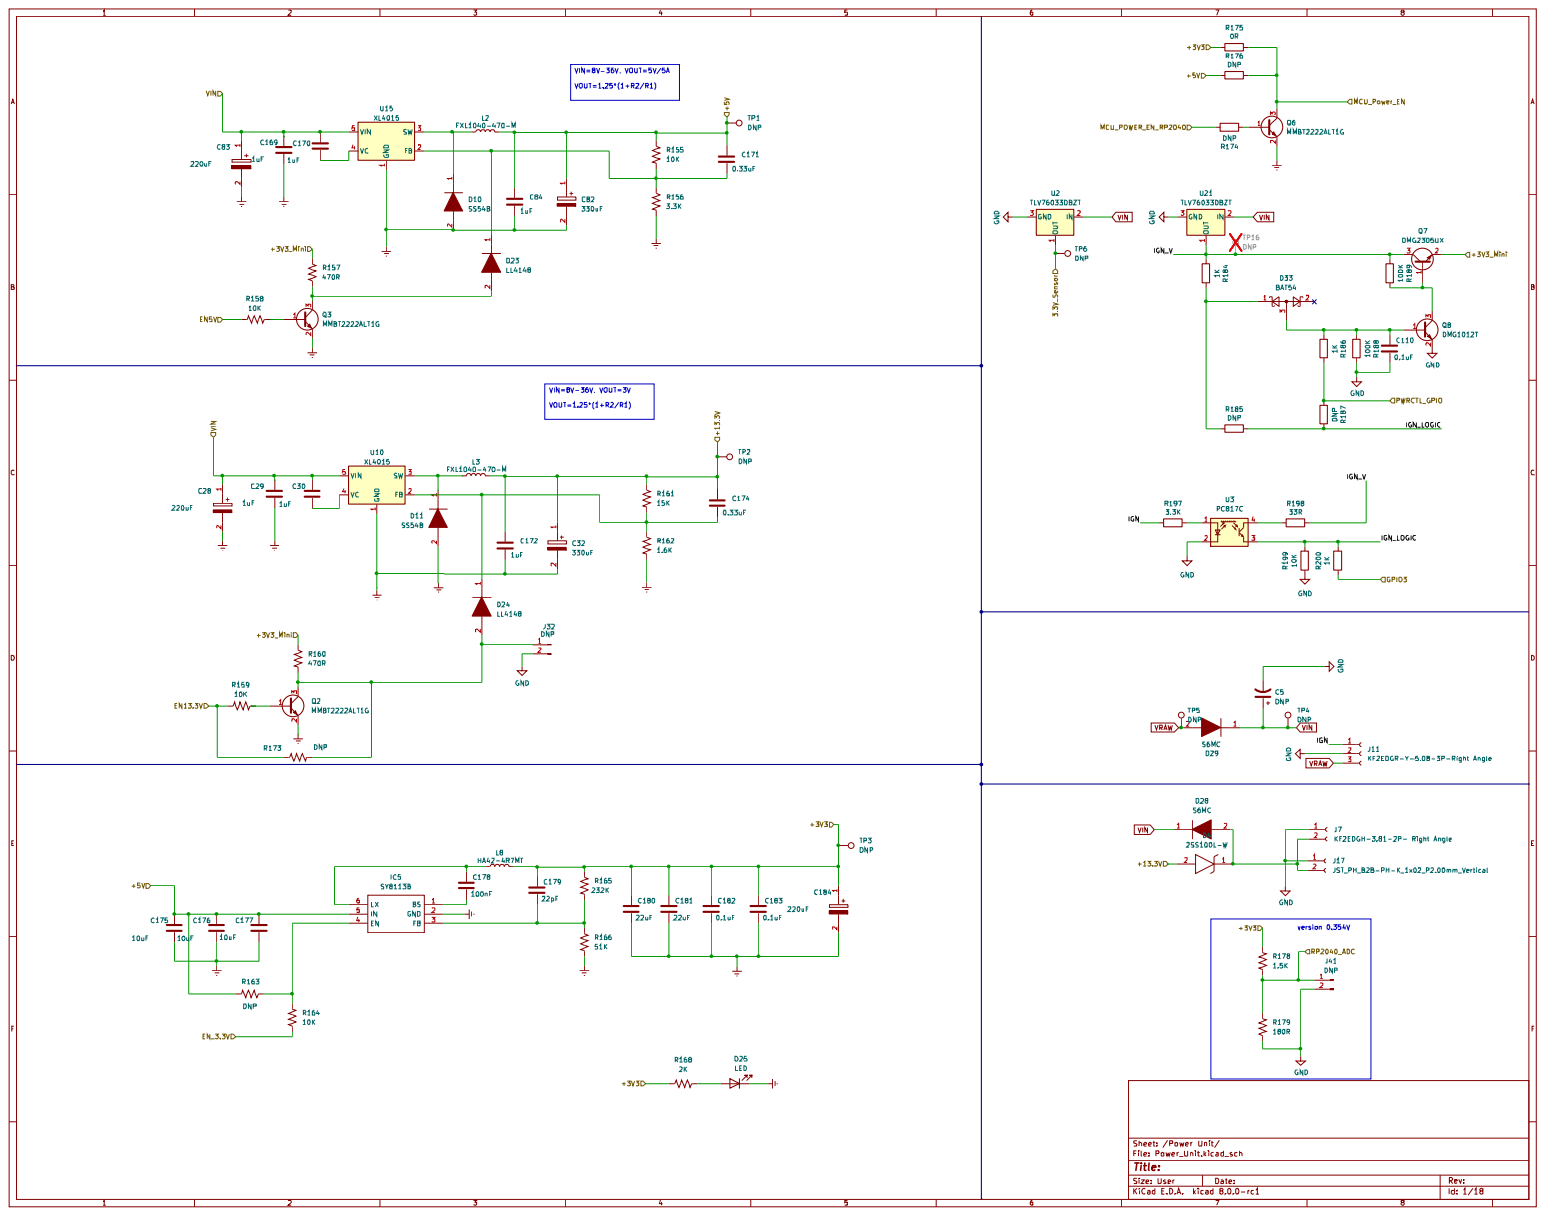
[picture p65: page 4]

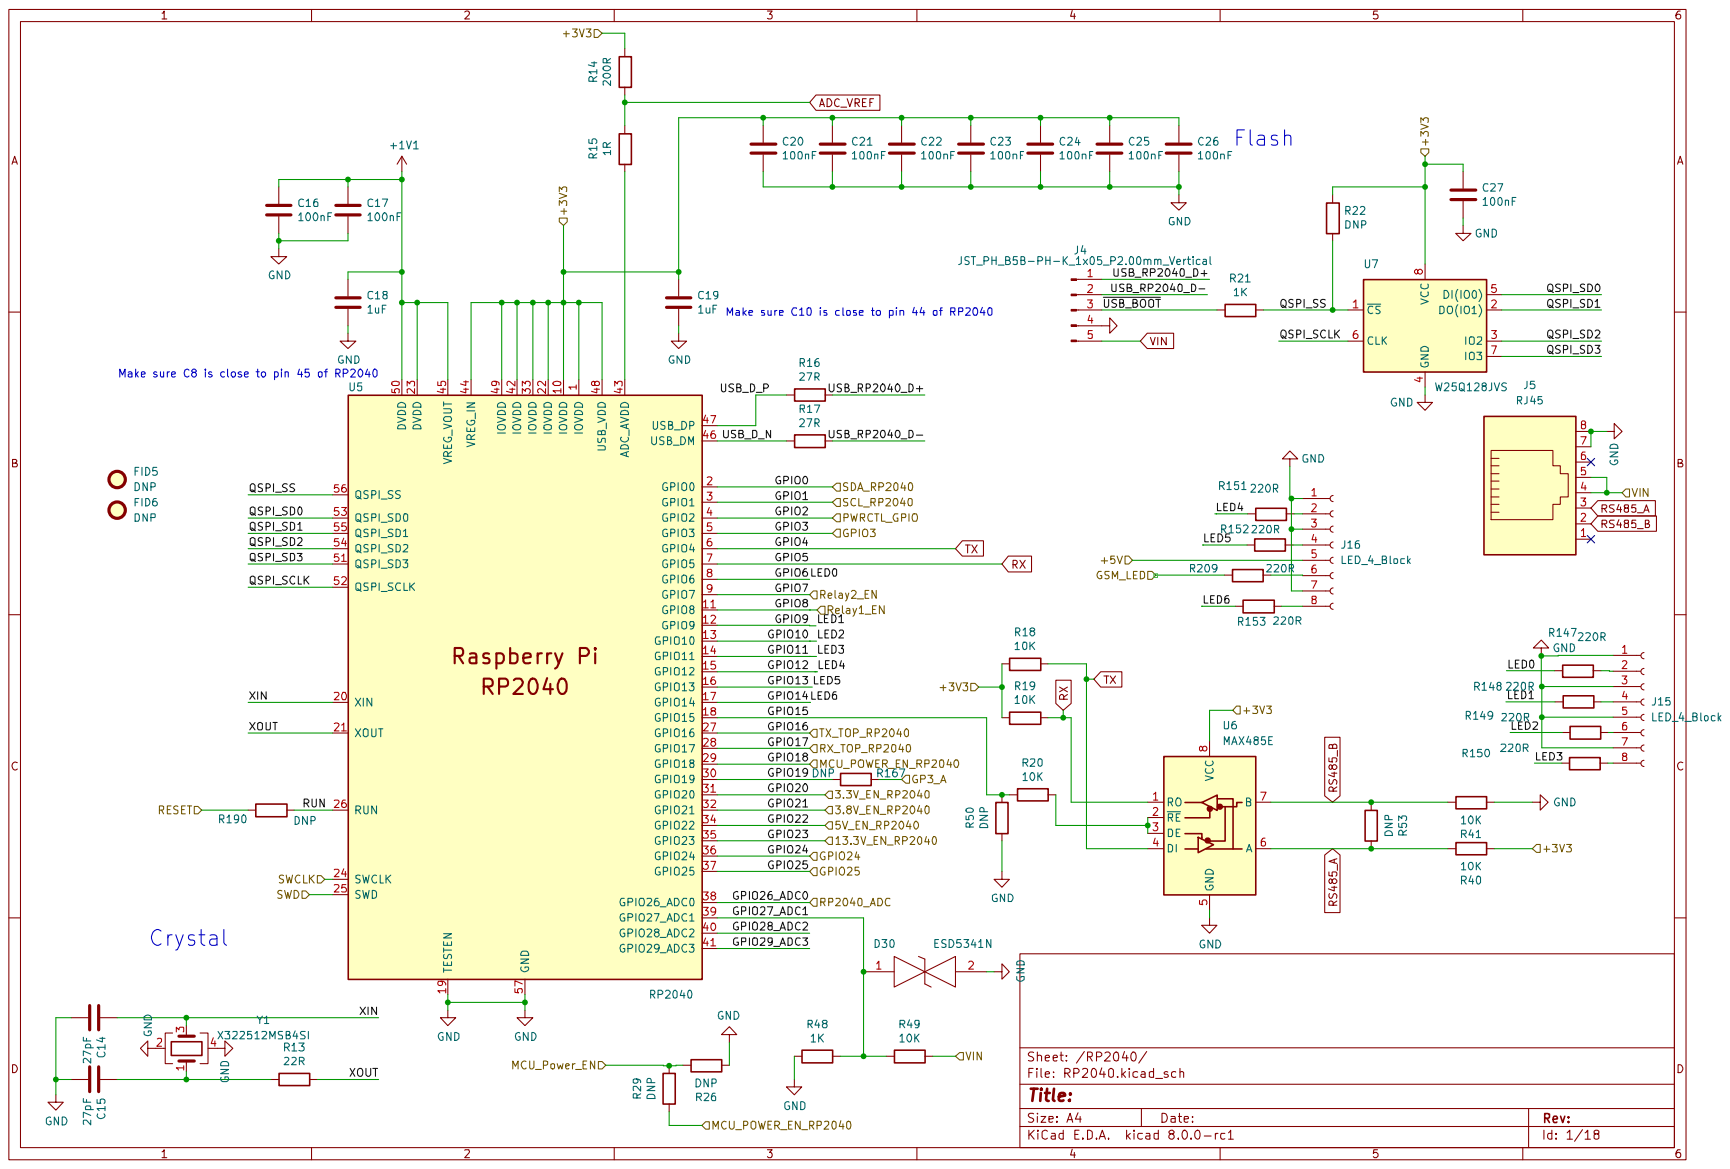
[picture p66: page 5]

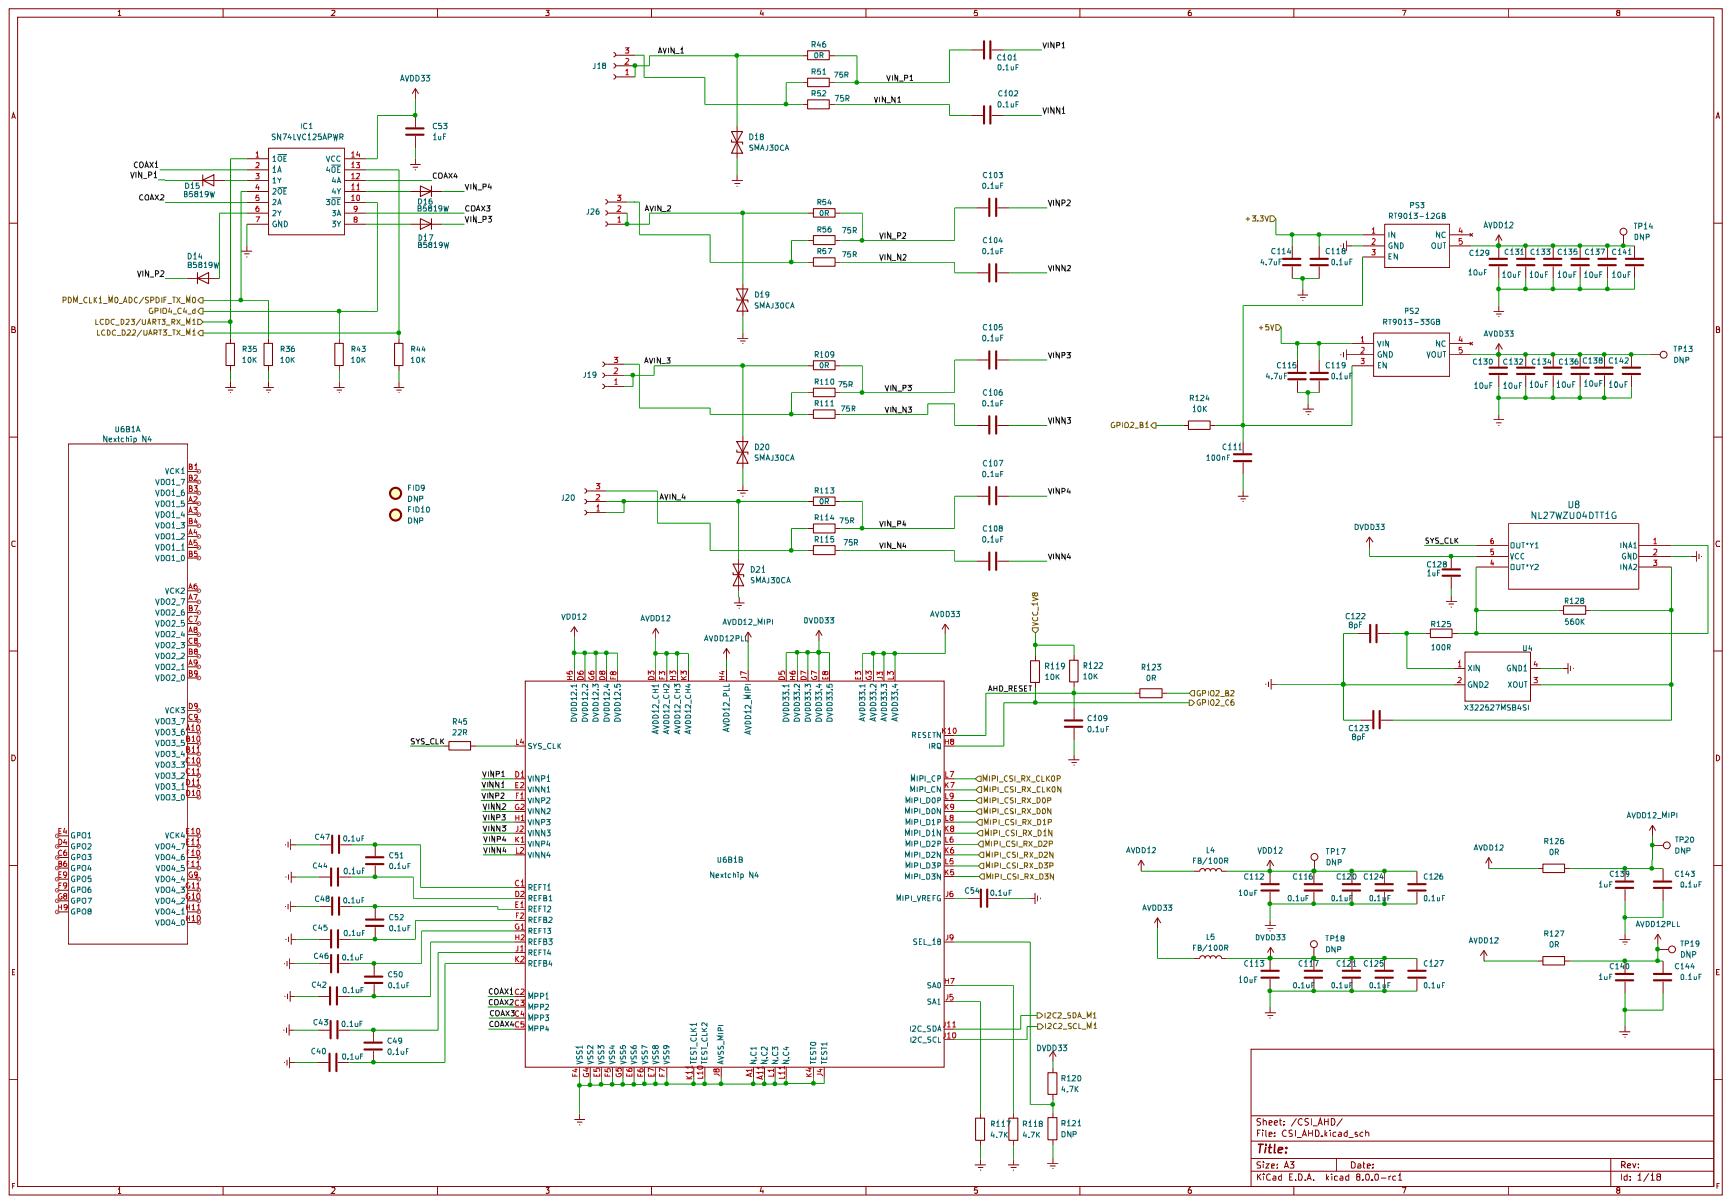
[picture p67: page 6]

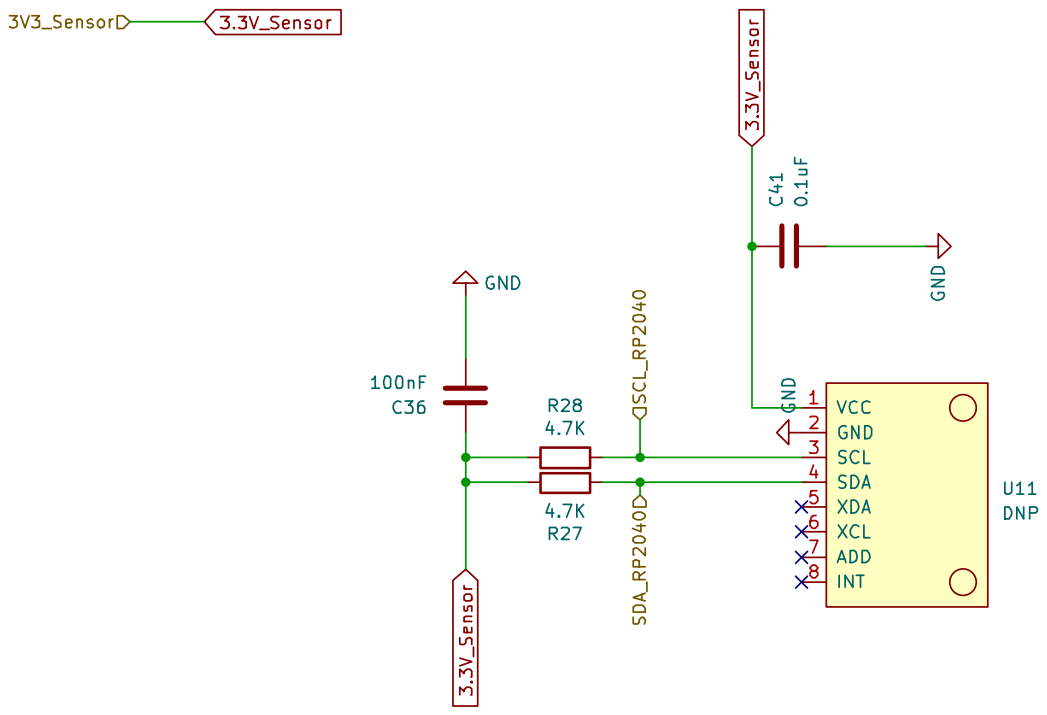
[picture p68: page 7]

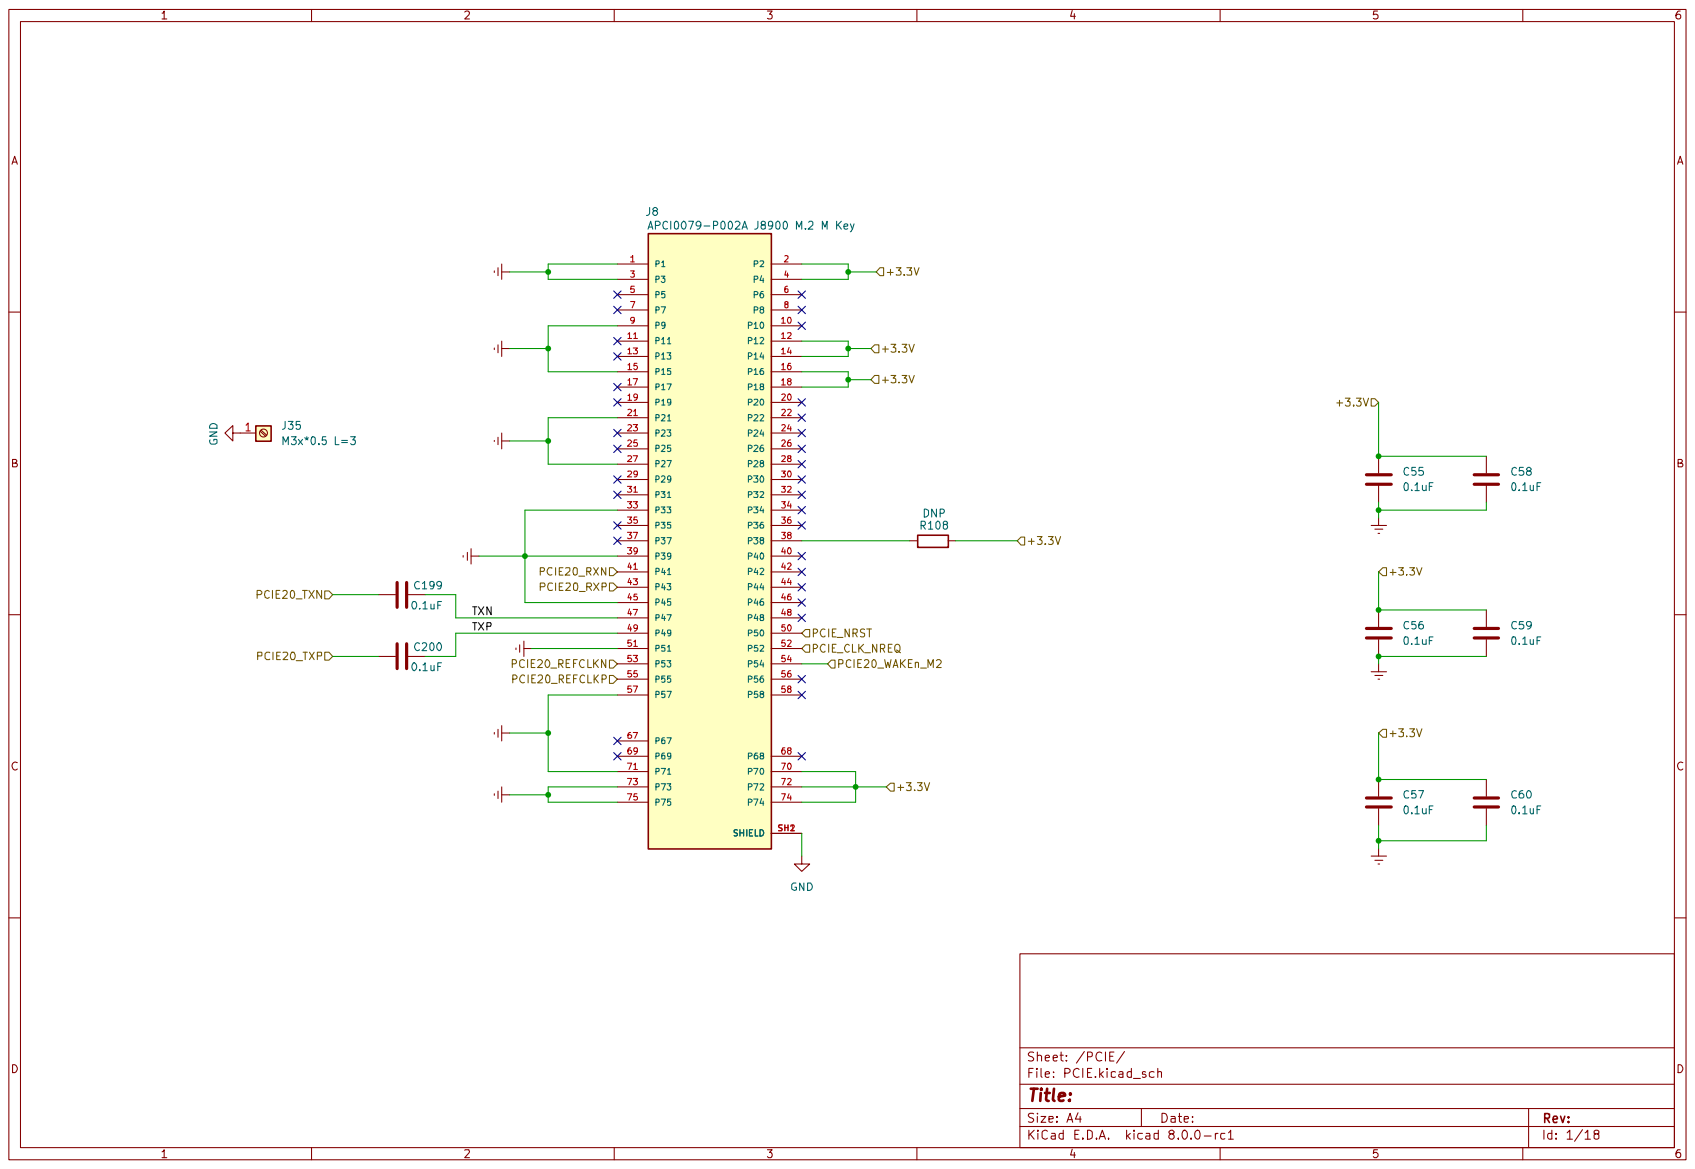
[picture p69: page 8]

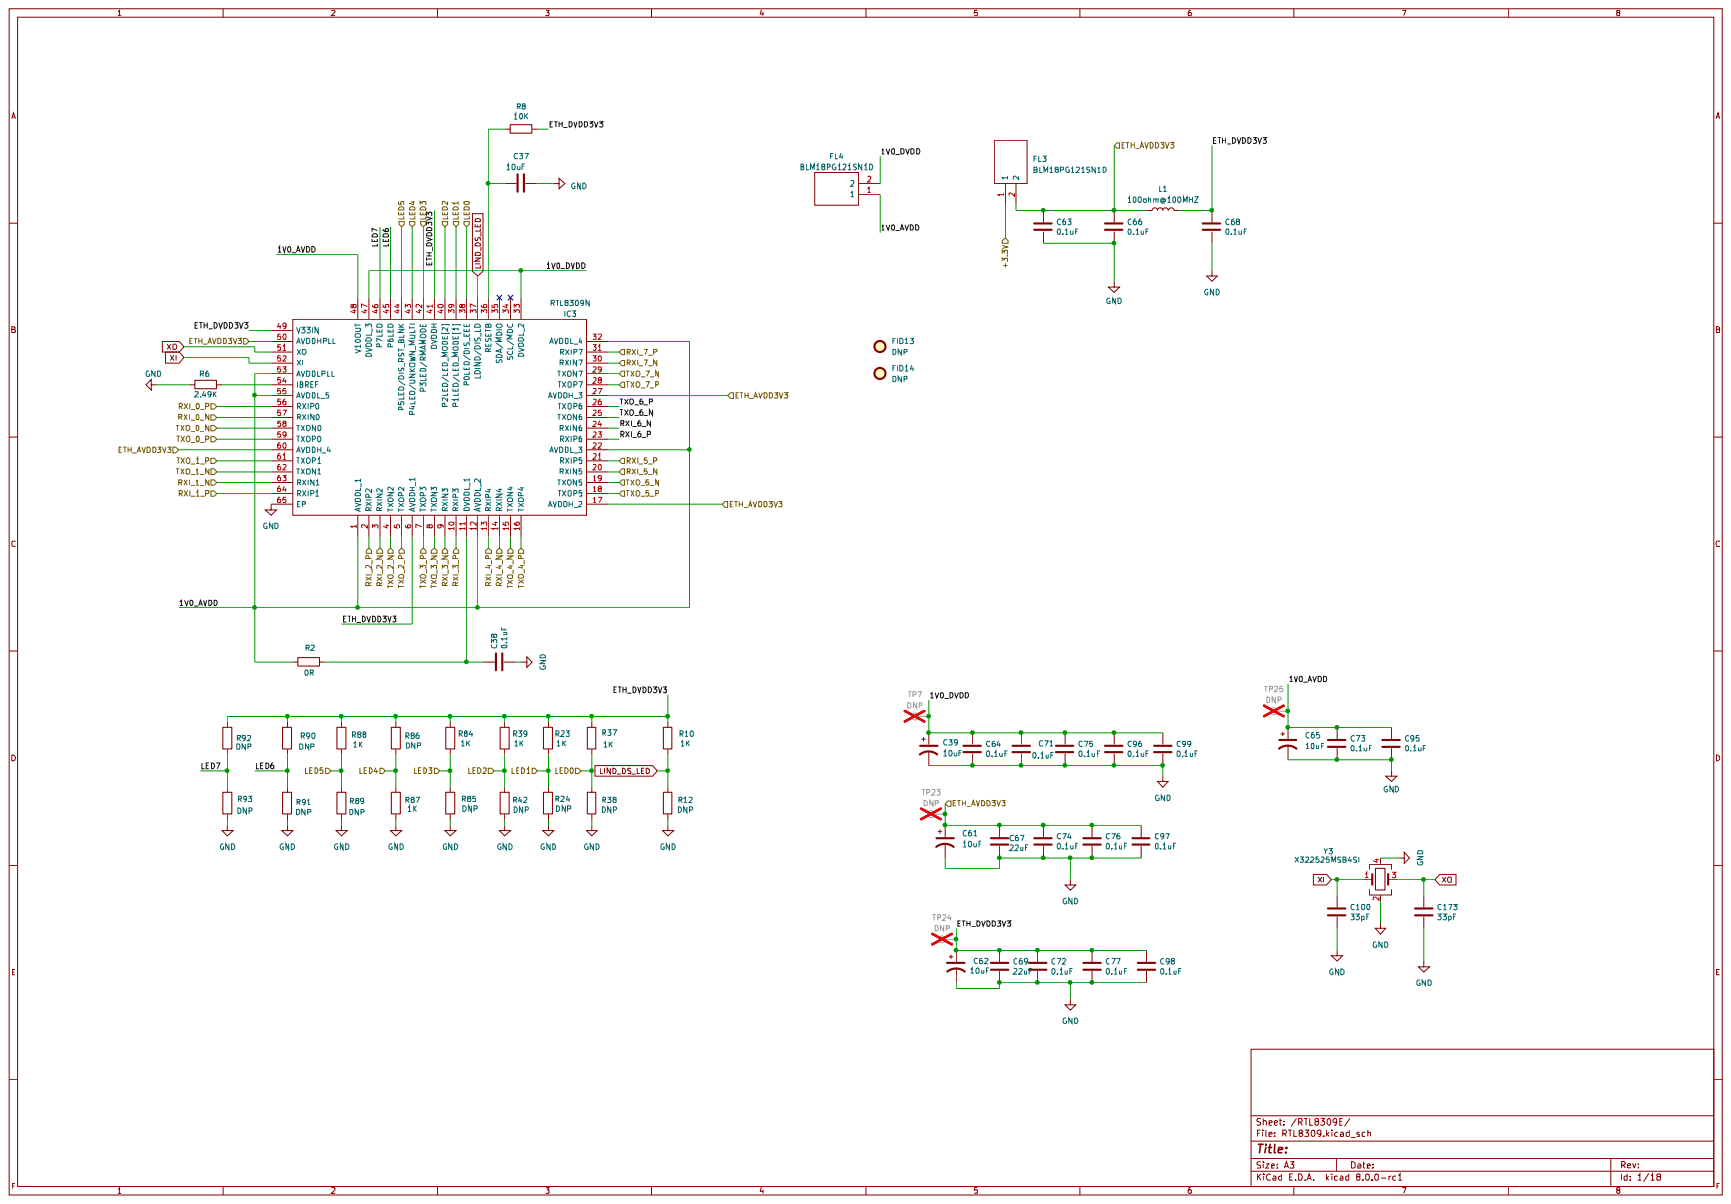
[picture p70: page 9]

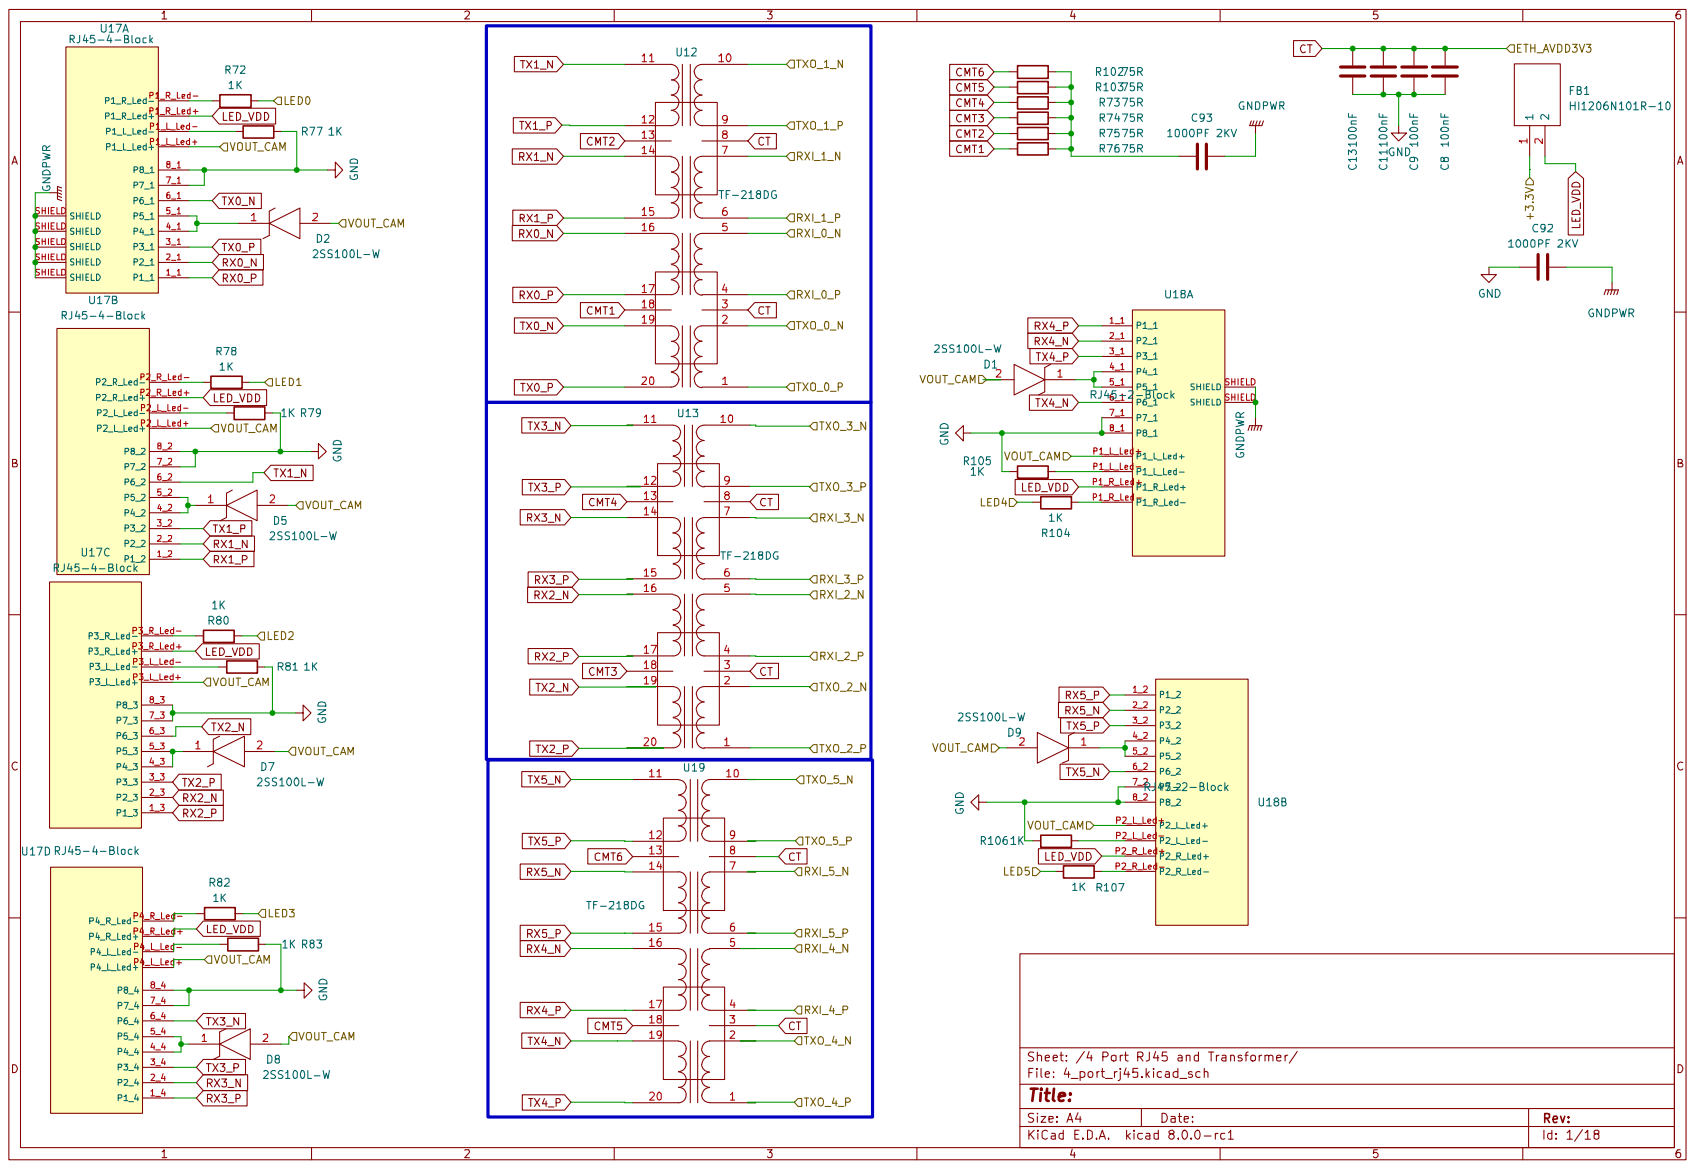
[picture p71: page 10]

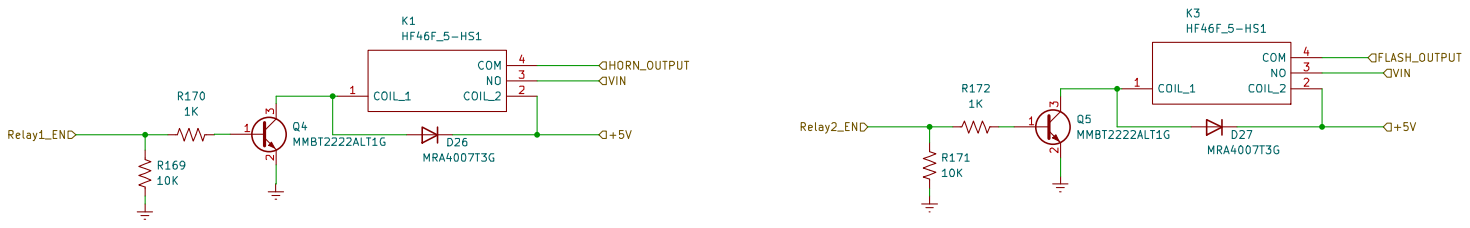
[picture p72: page 11]

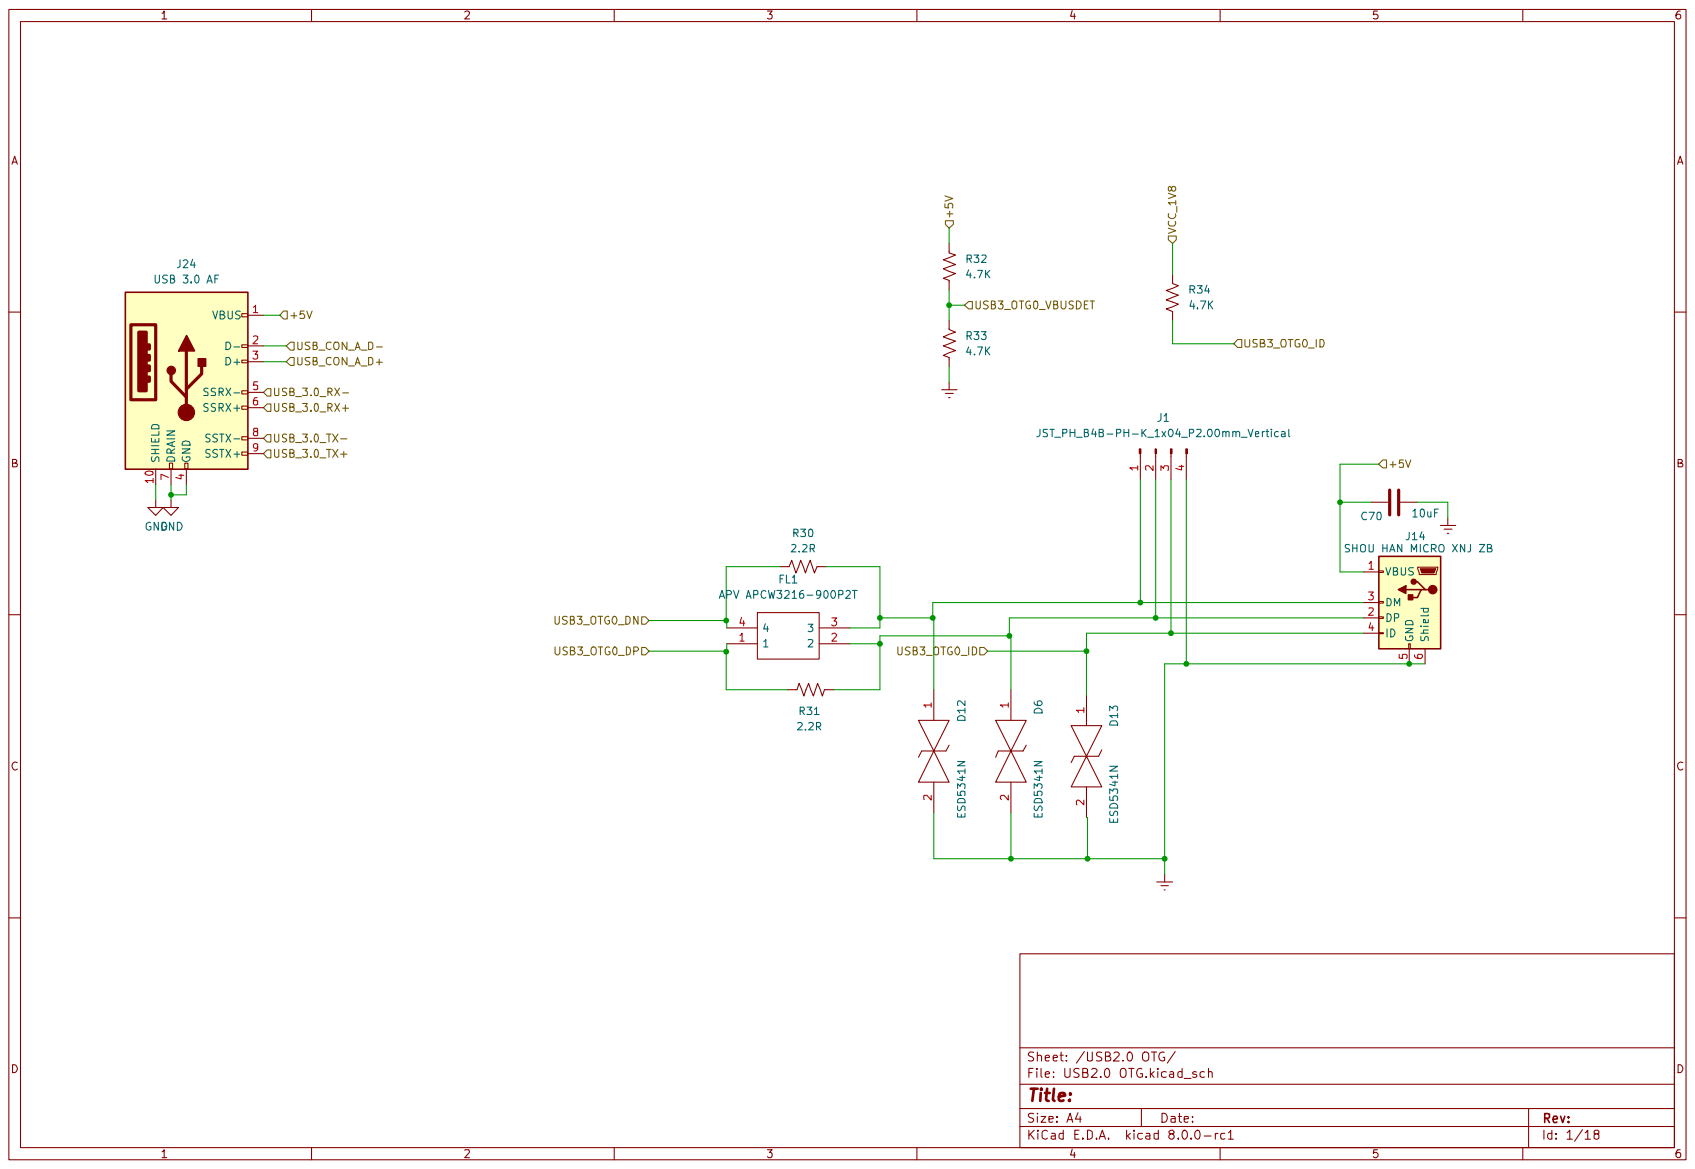
[picture p73: page 12]

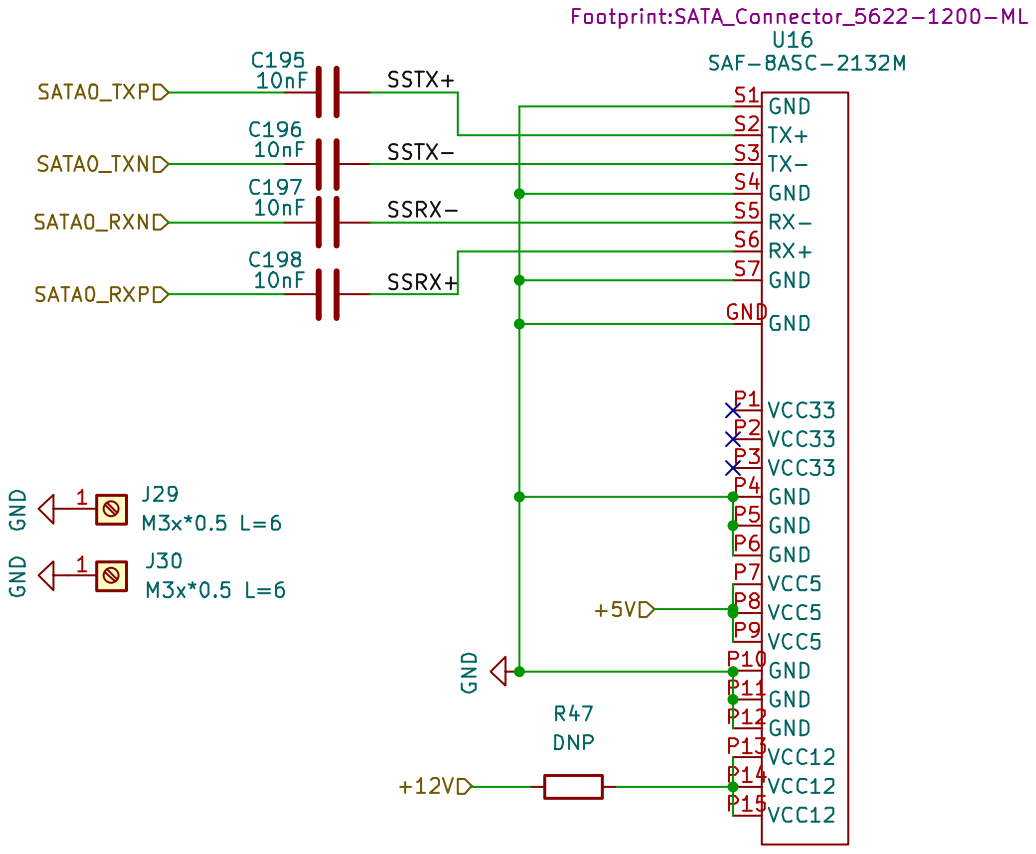
[picture p74: page 13]

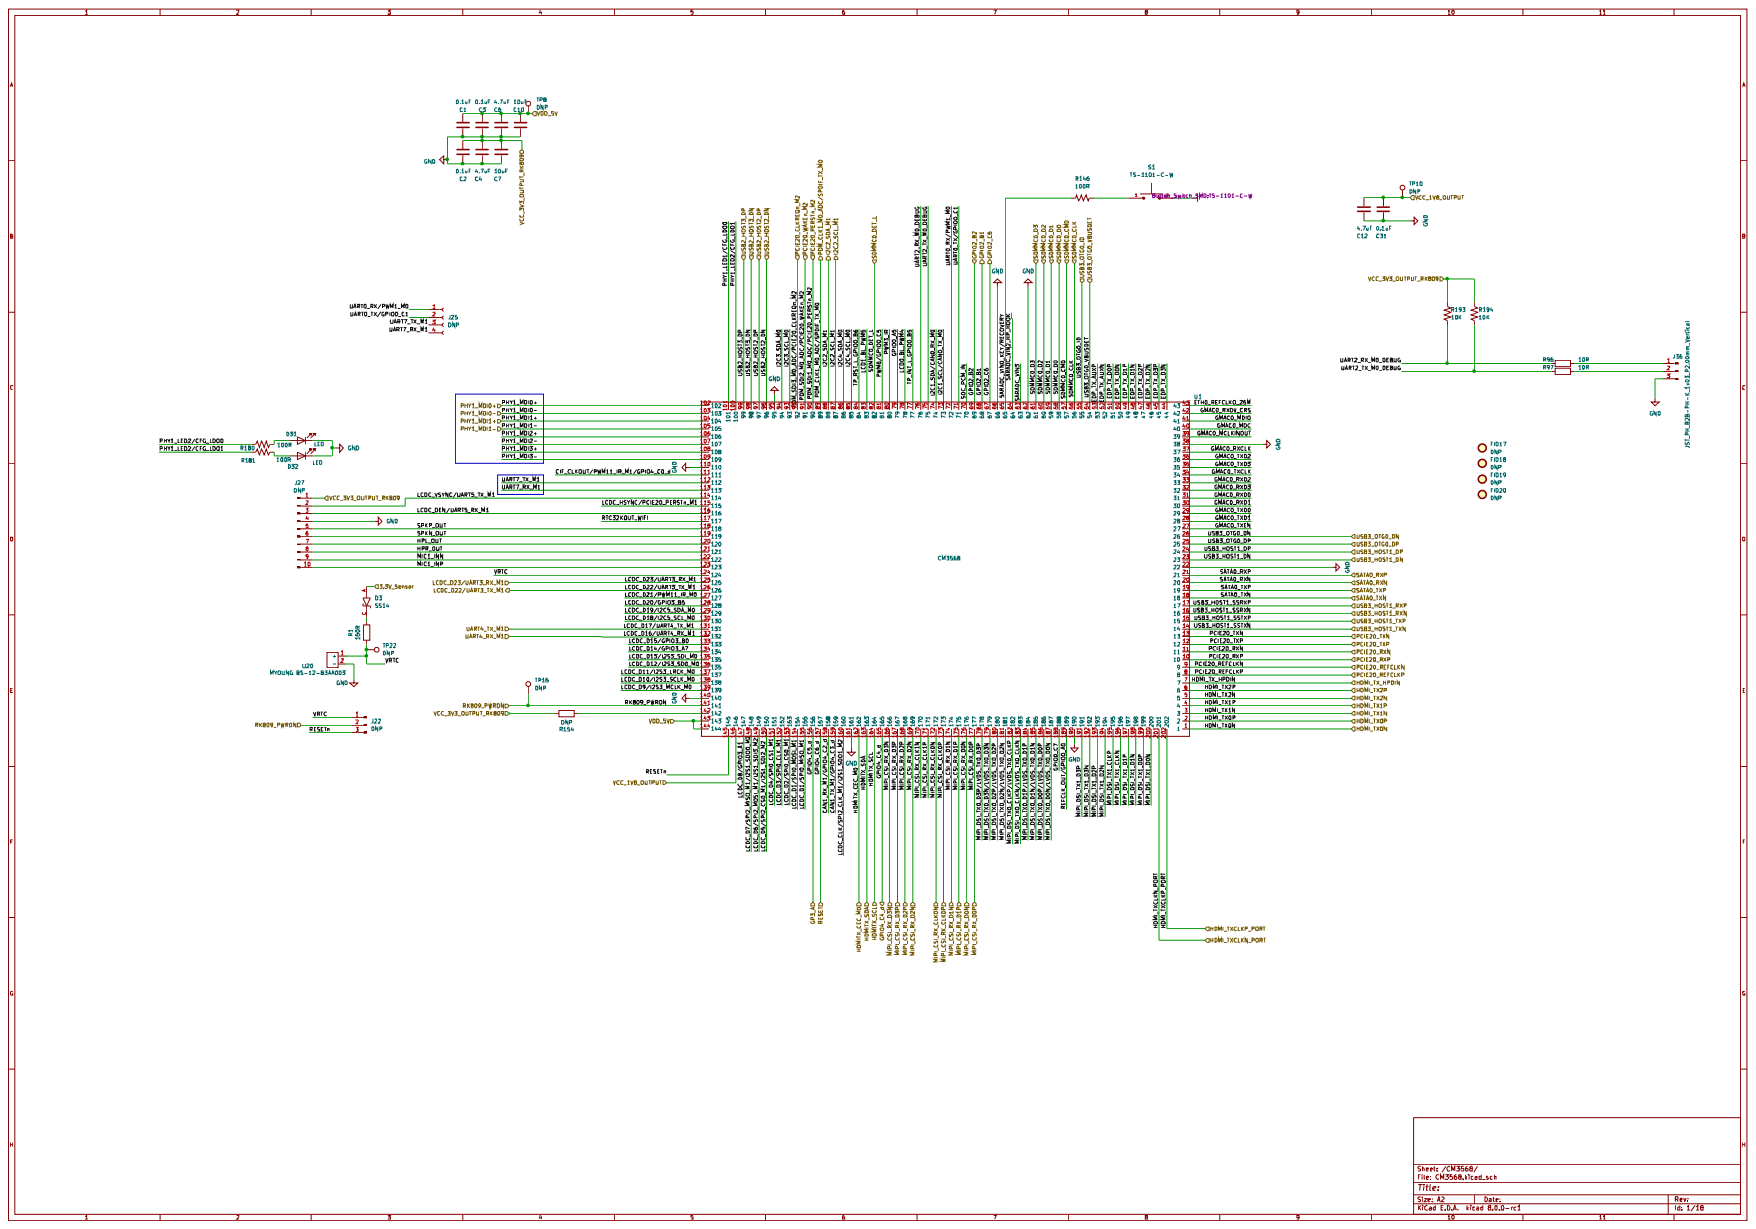
[picture p75: page 14]

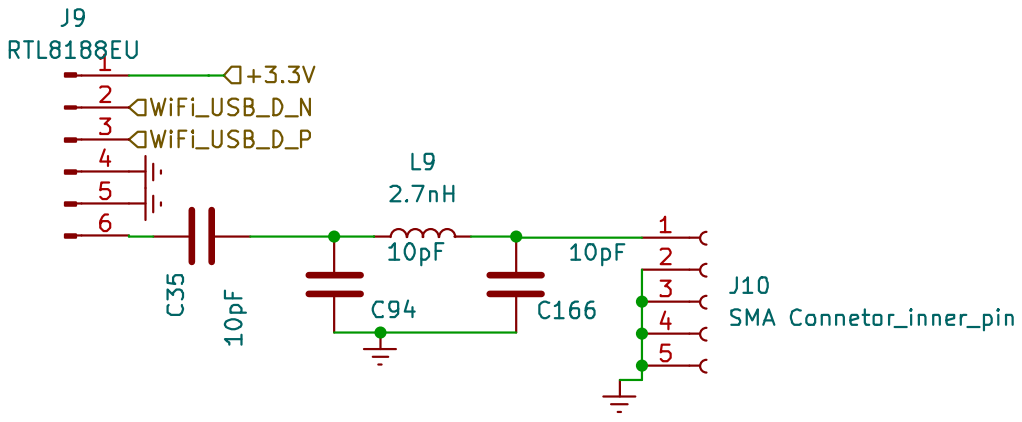
[picture p76: page 15]

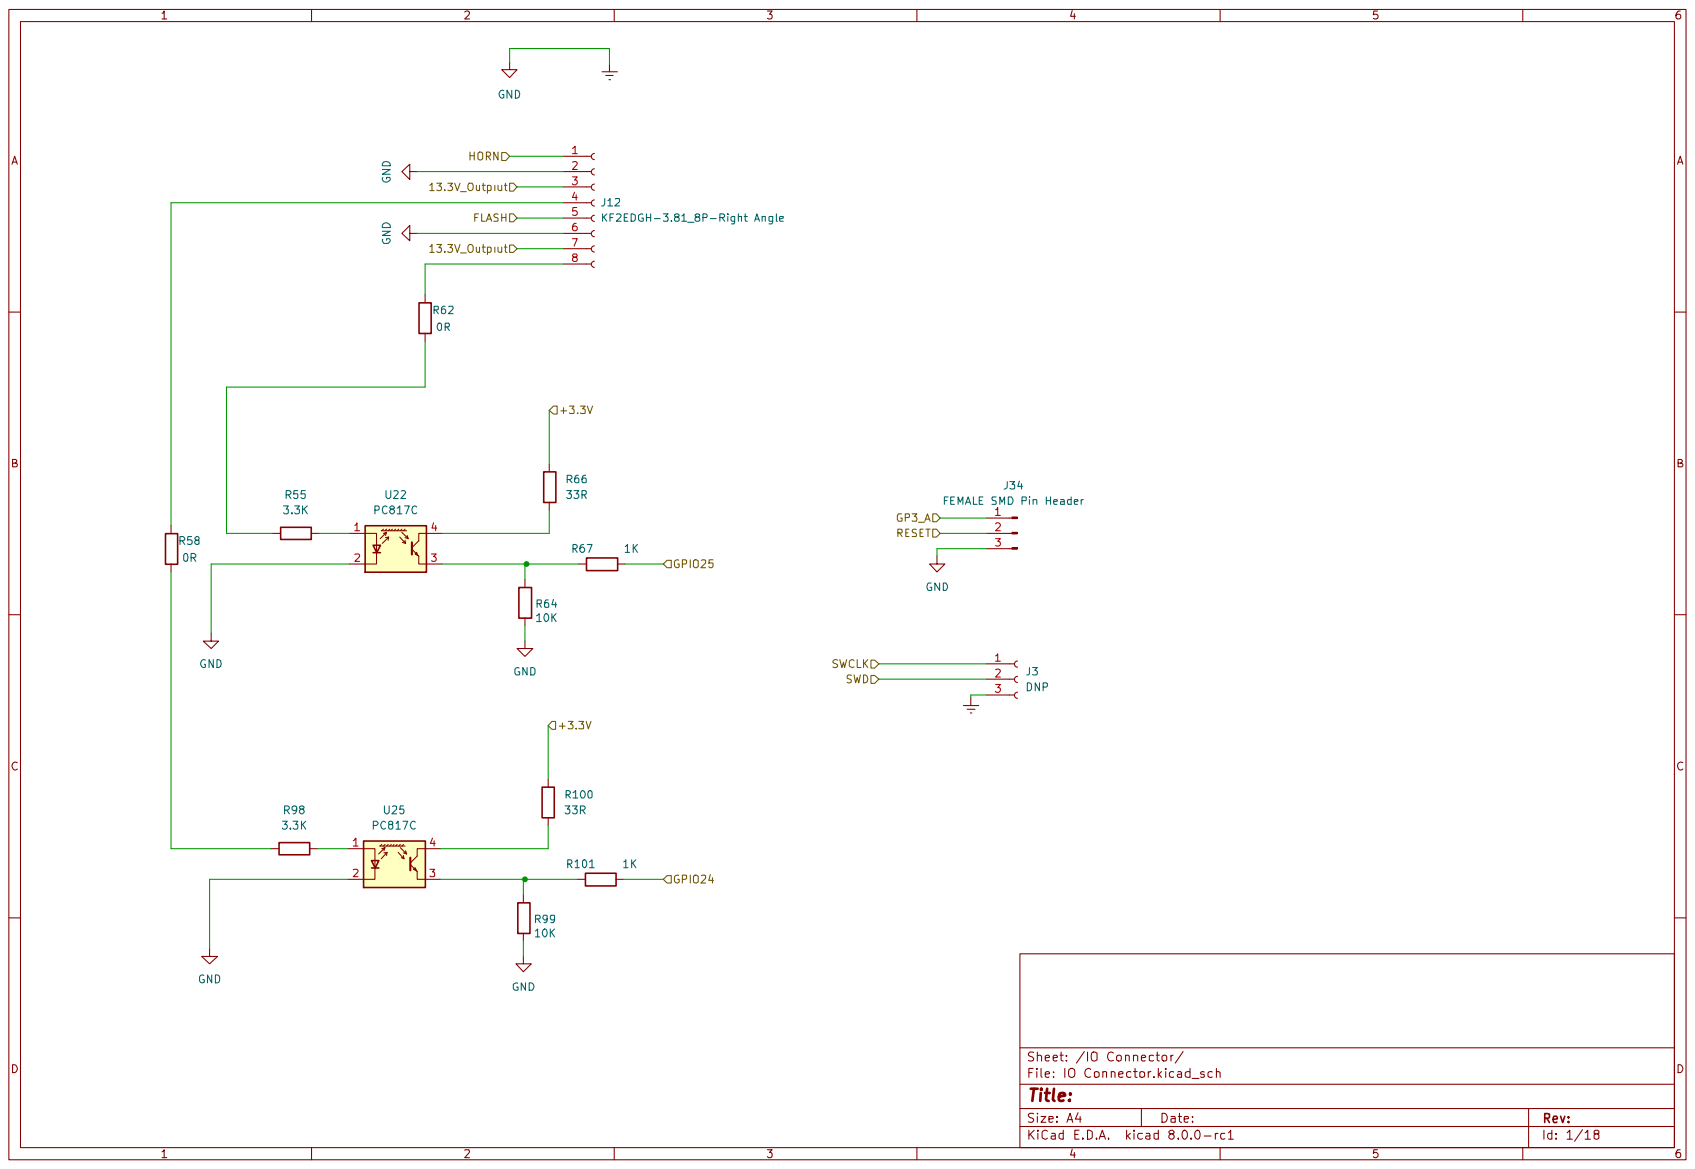
[picture p77: page 16]

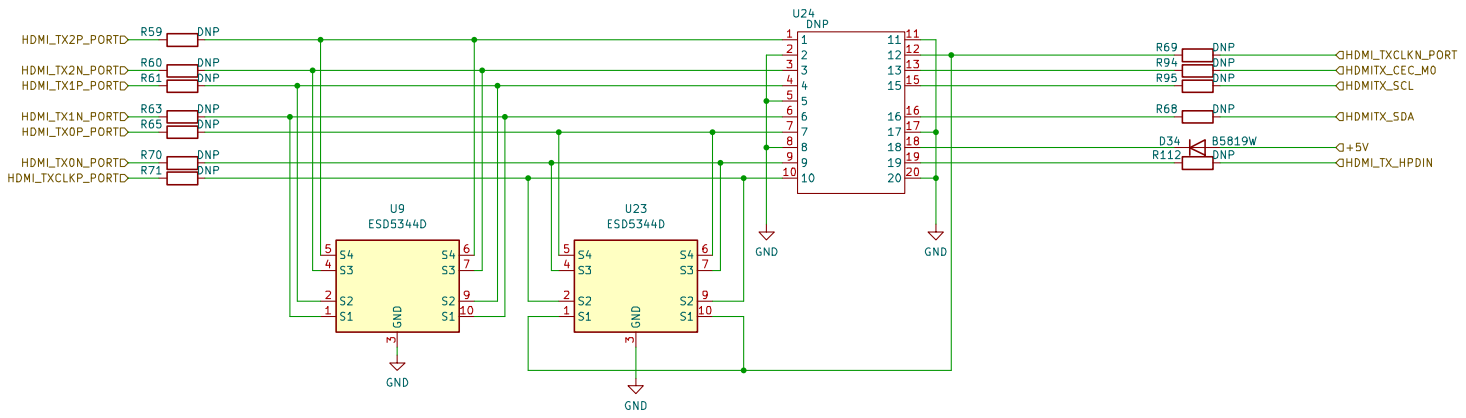
[picture p78: page 17]

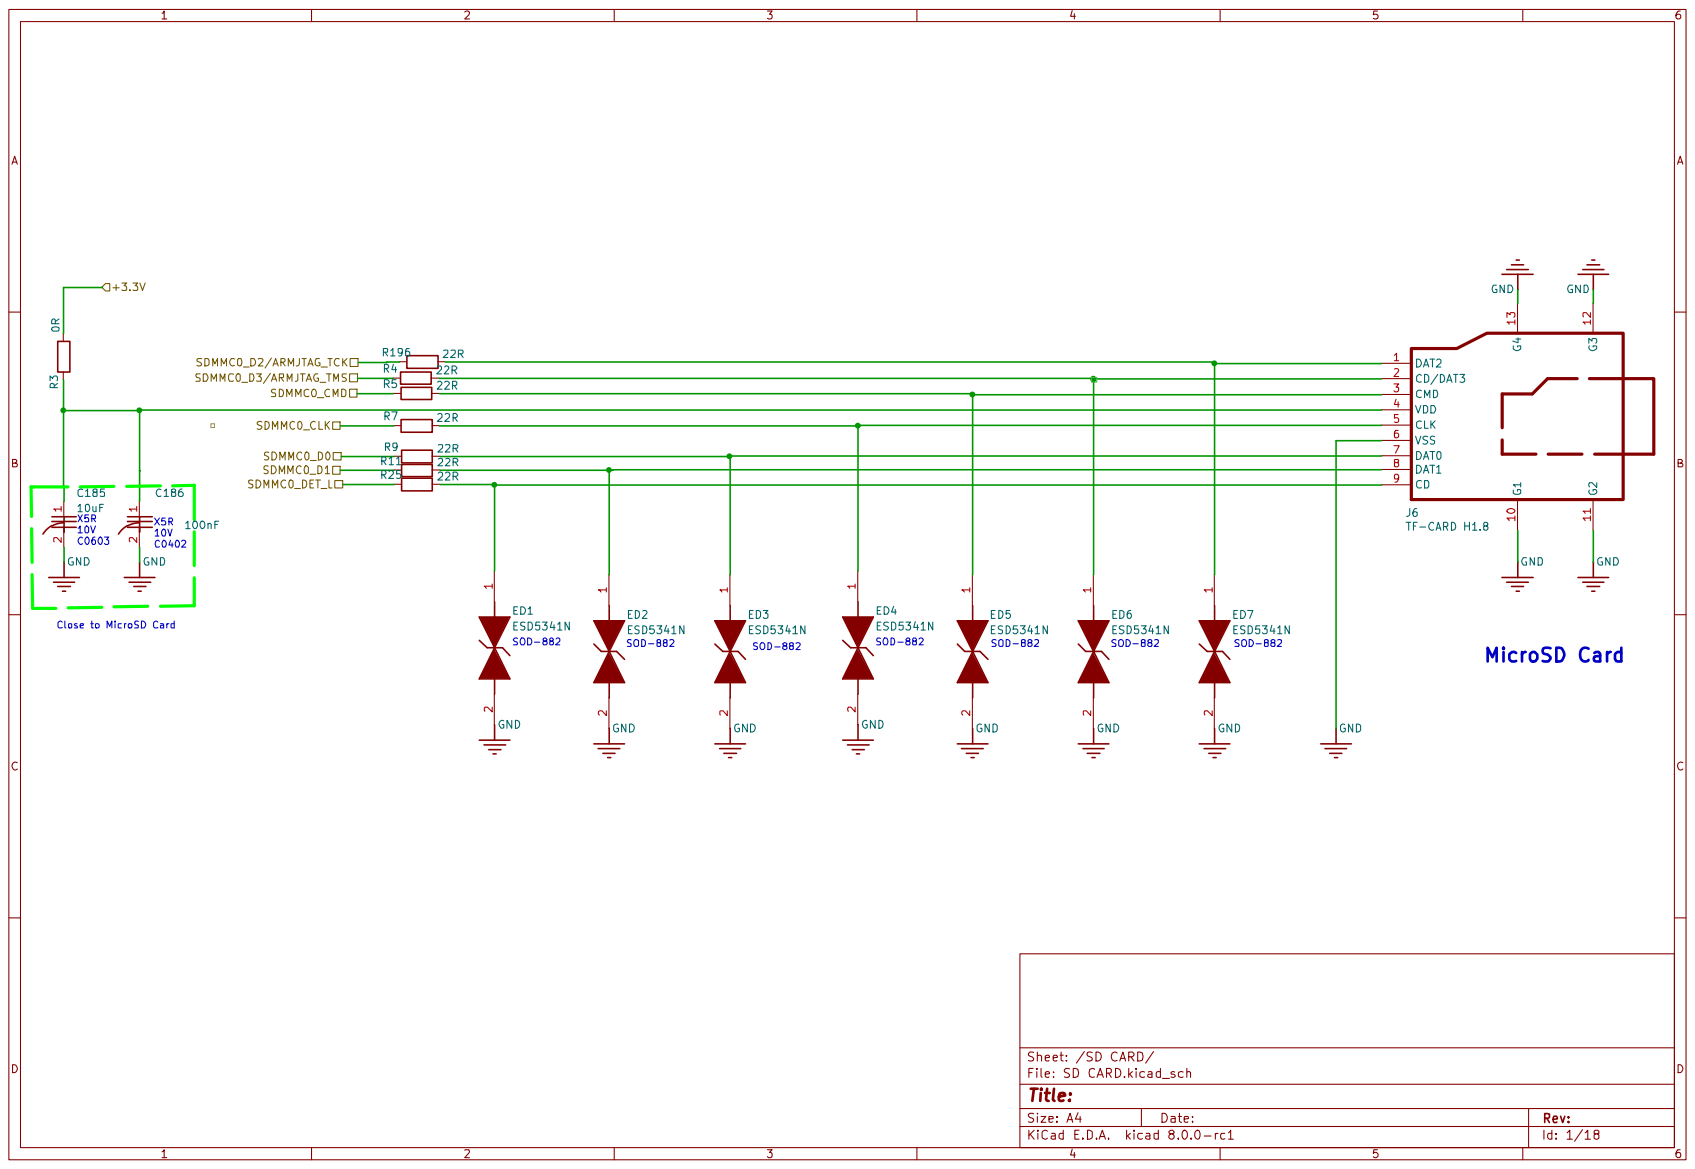
[picture p79: page 18]
