ihsanakyrk/Eski-Versionlar-Ve-Siparisler/Movita_3566_AXV_Router_V3.1/Movita_3566_AXV_Router_V3.1(Normal_Analoglu)/Movita_3566_AXV_Router_V3.1.pdf

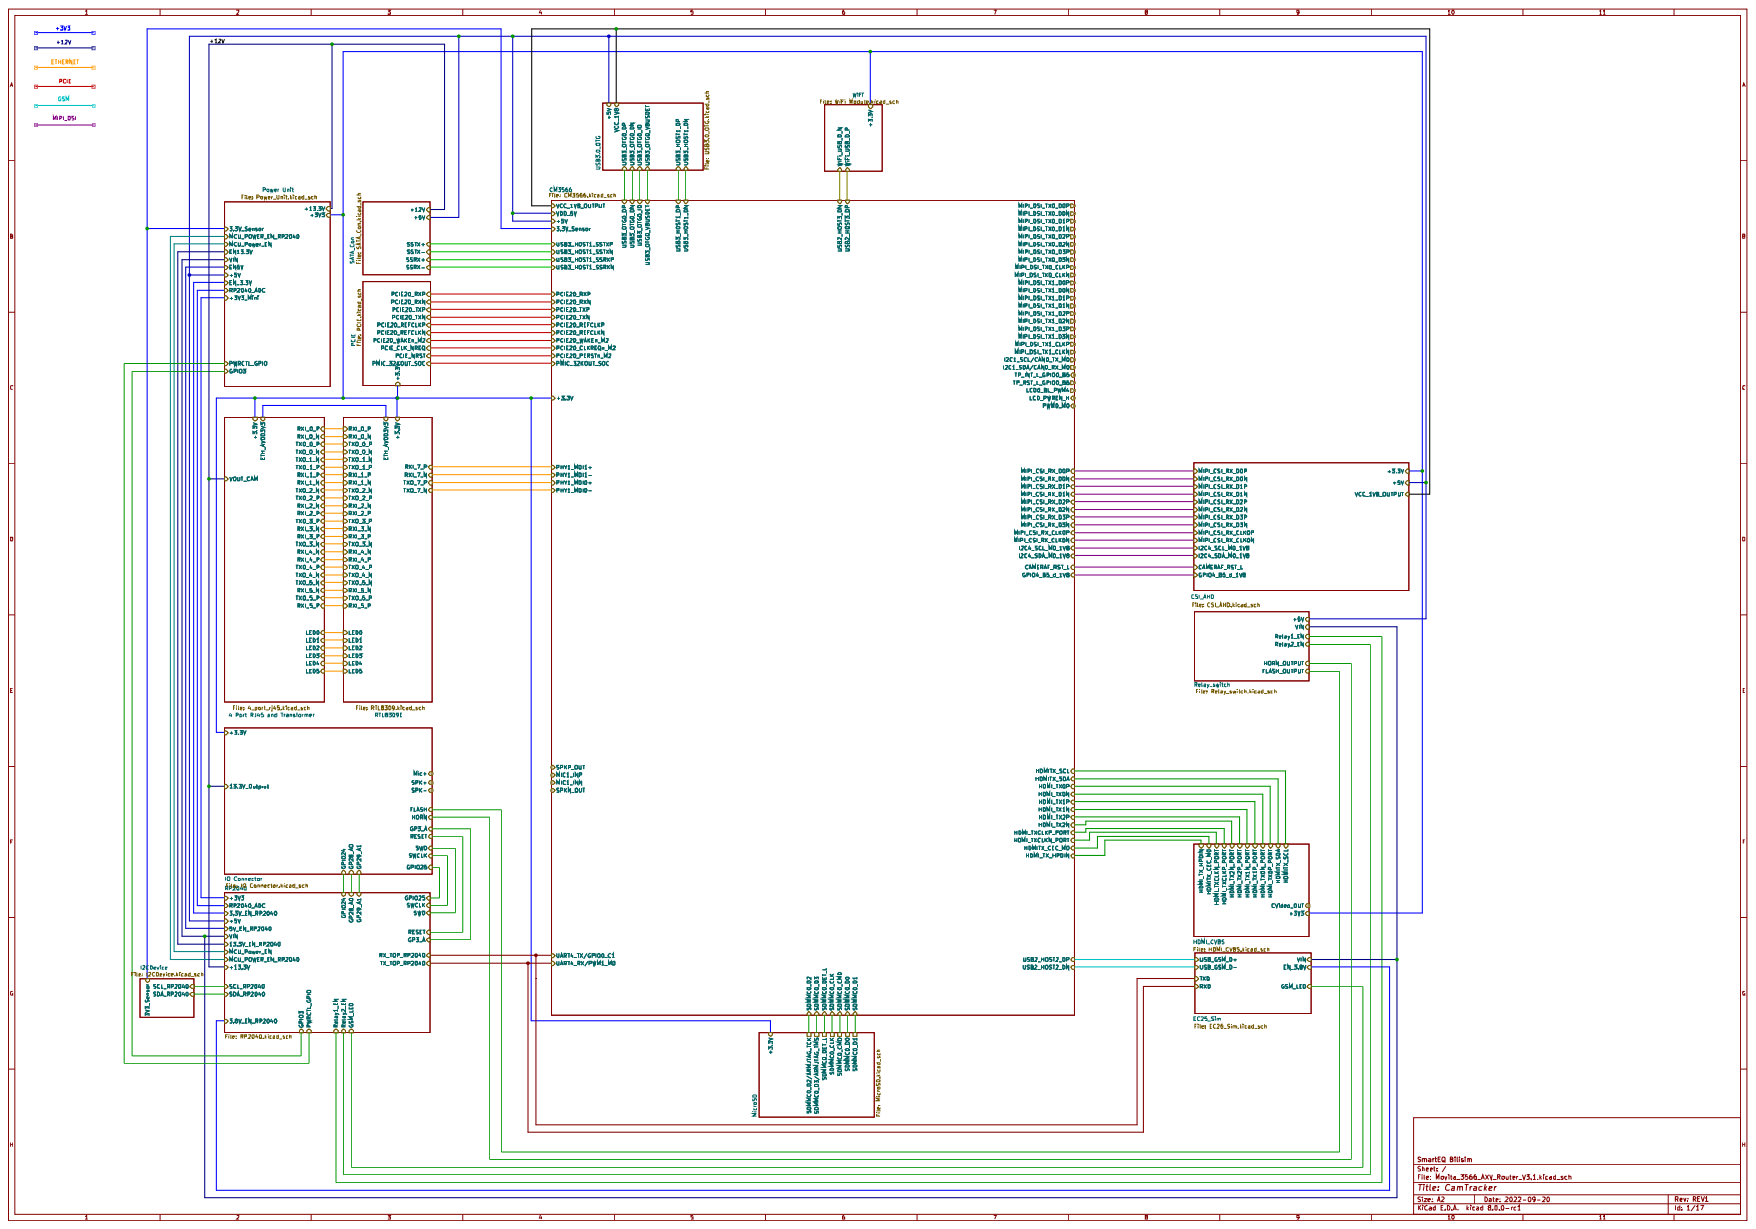
[picture p80: page 1]

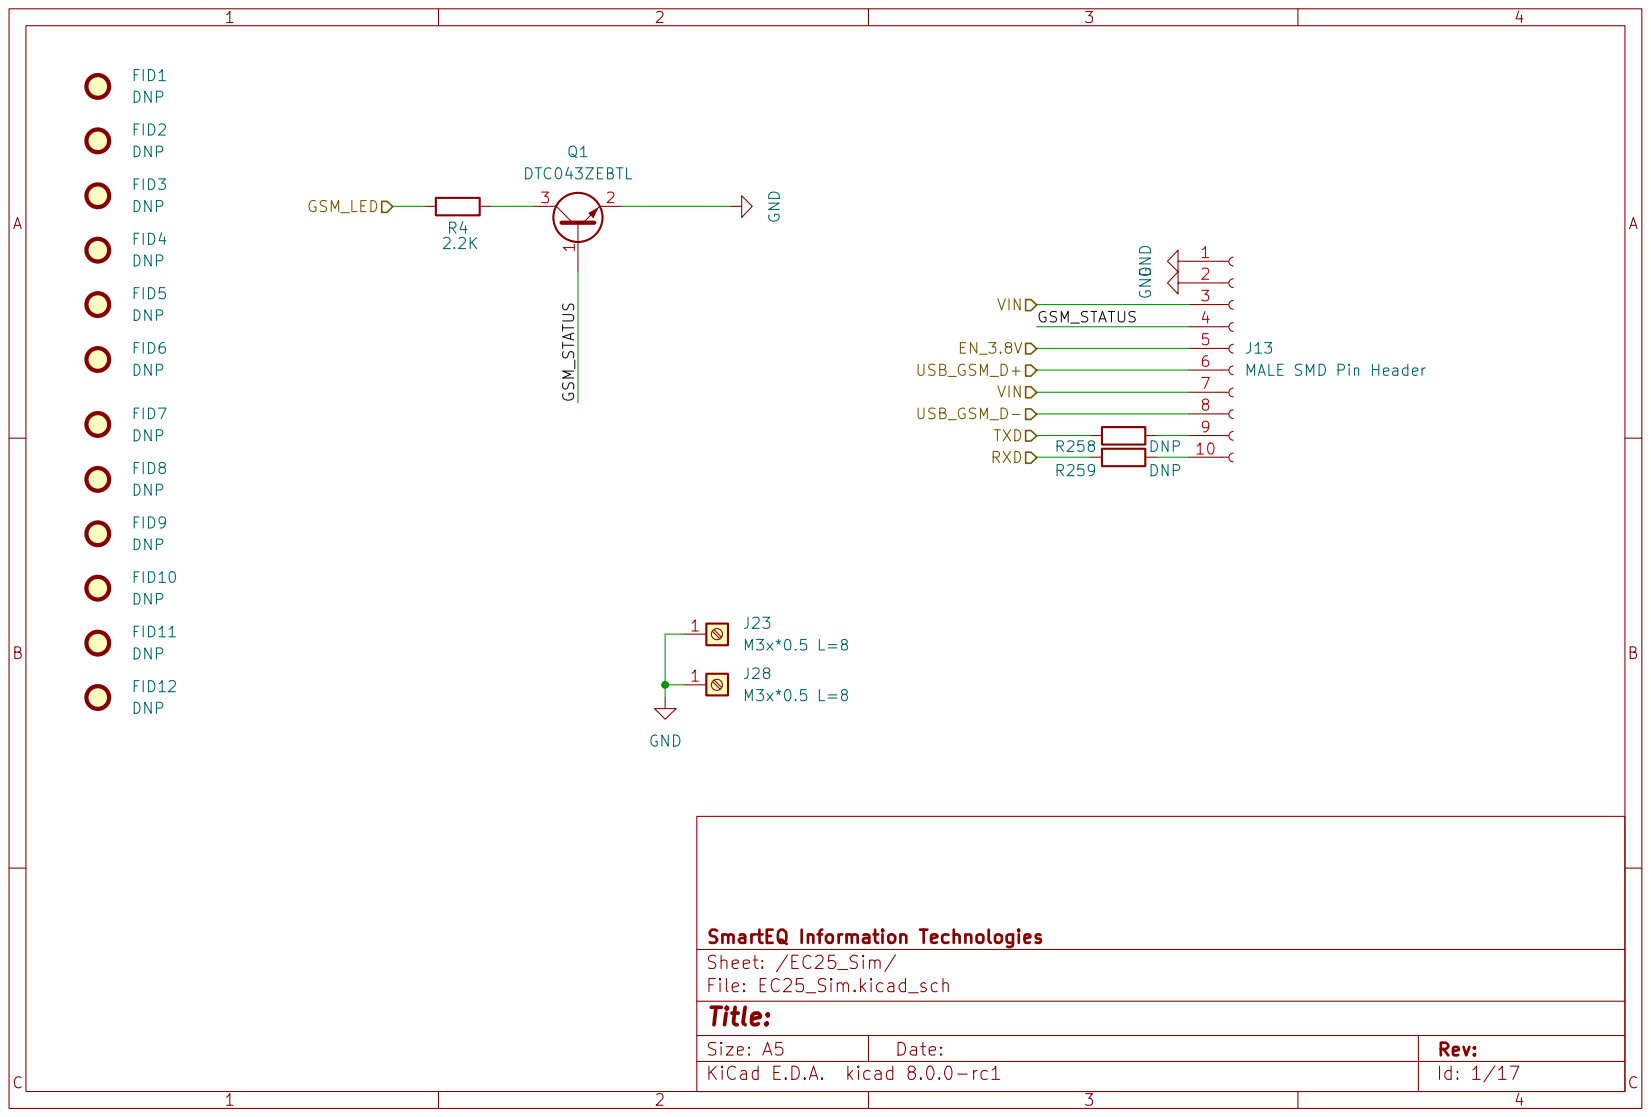
[picture p81: page 2]

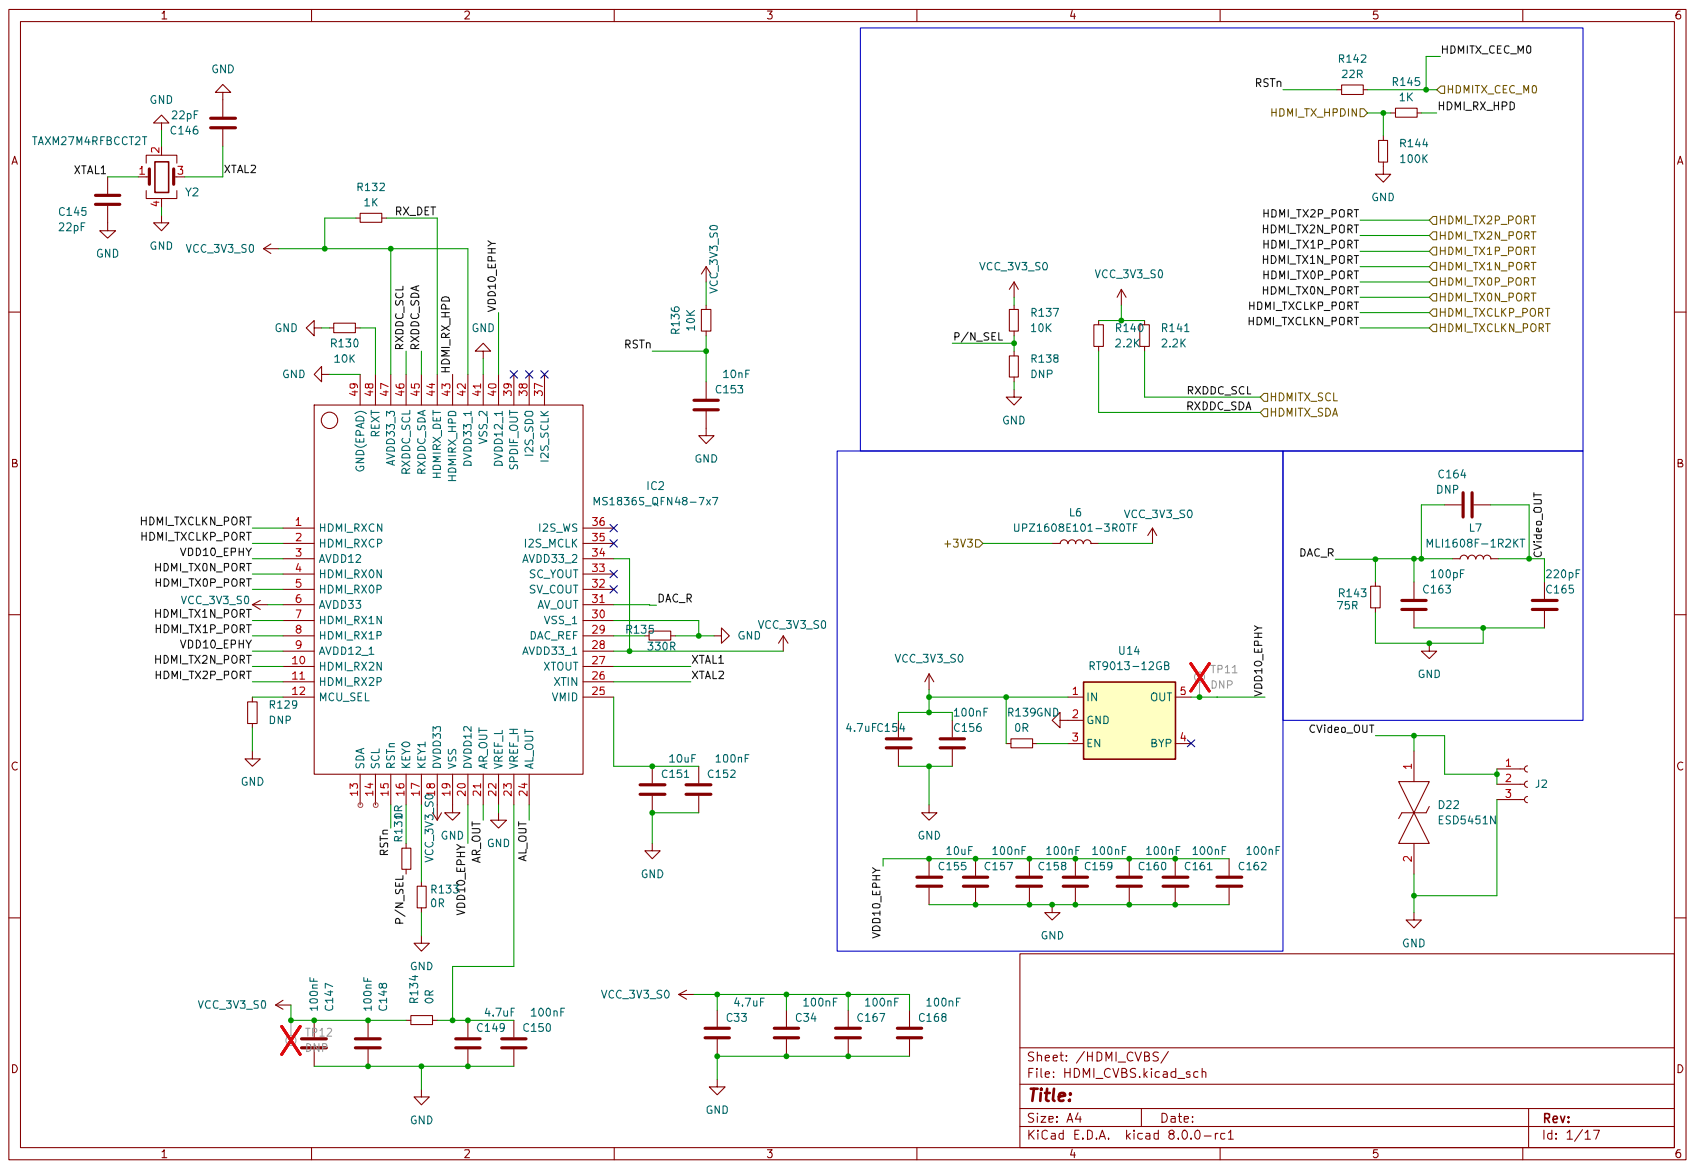
[picture p82: page 3]

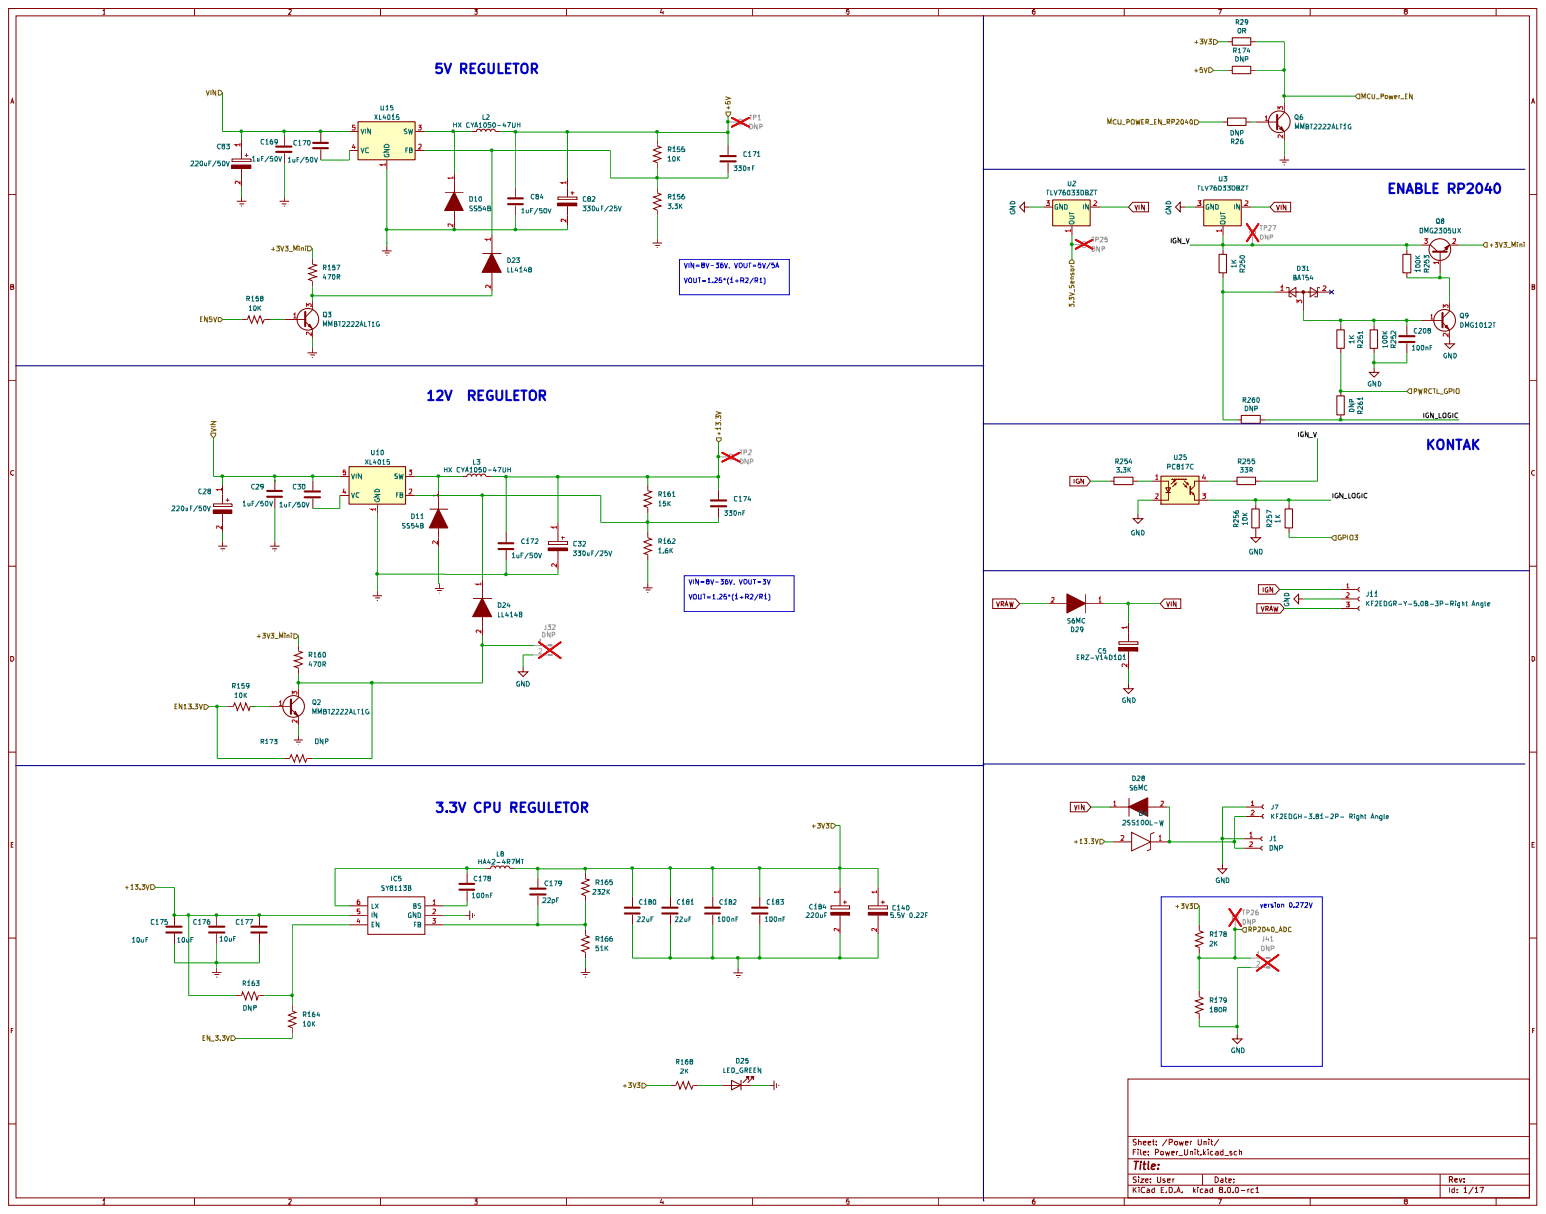
[picture p83: page 4]

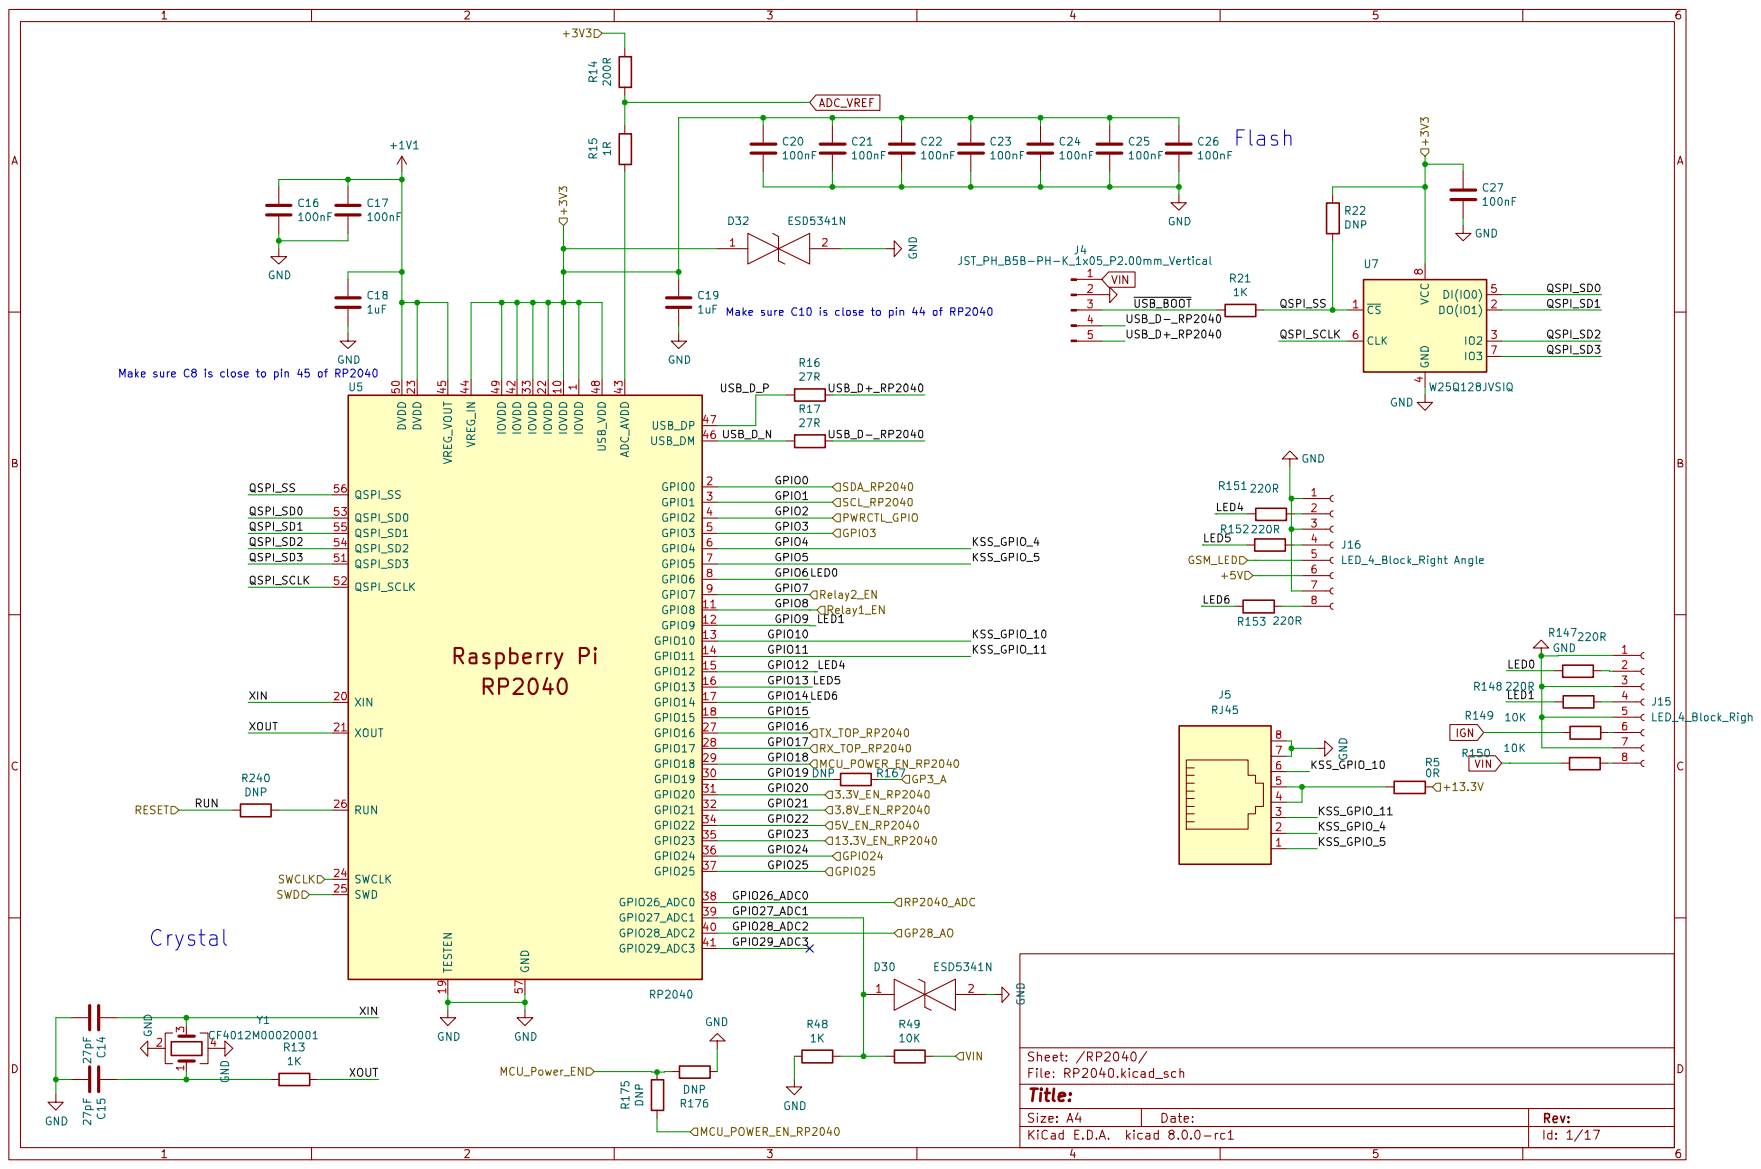
[picture p84: page 5]

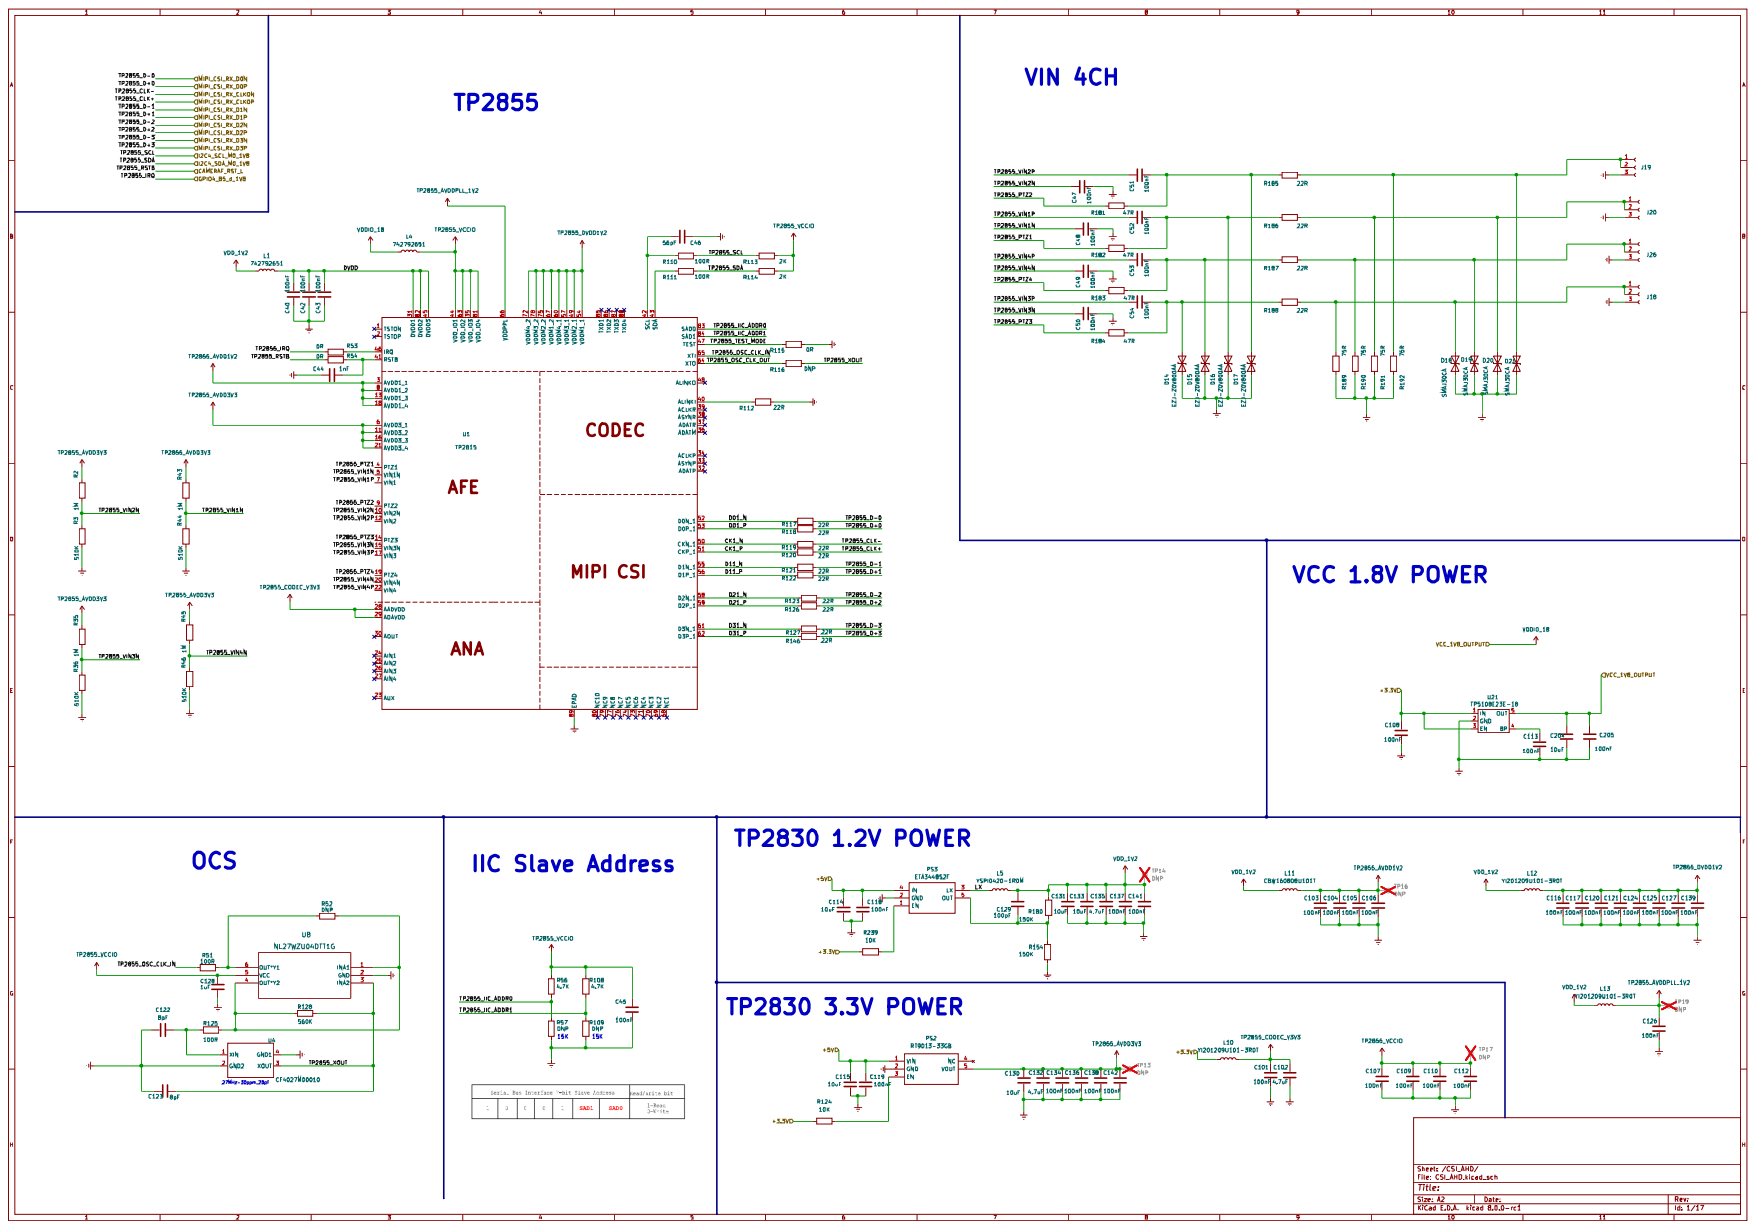
[picture p85: page 6]

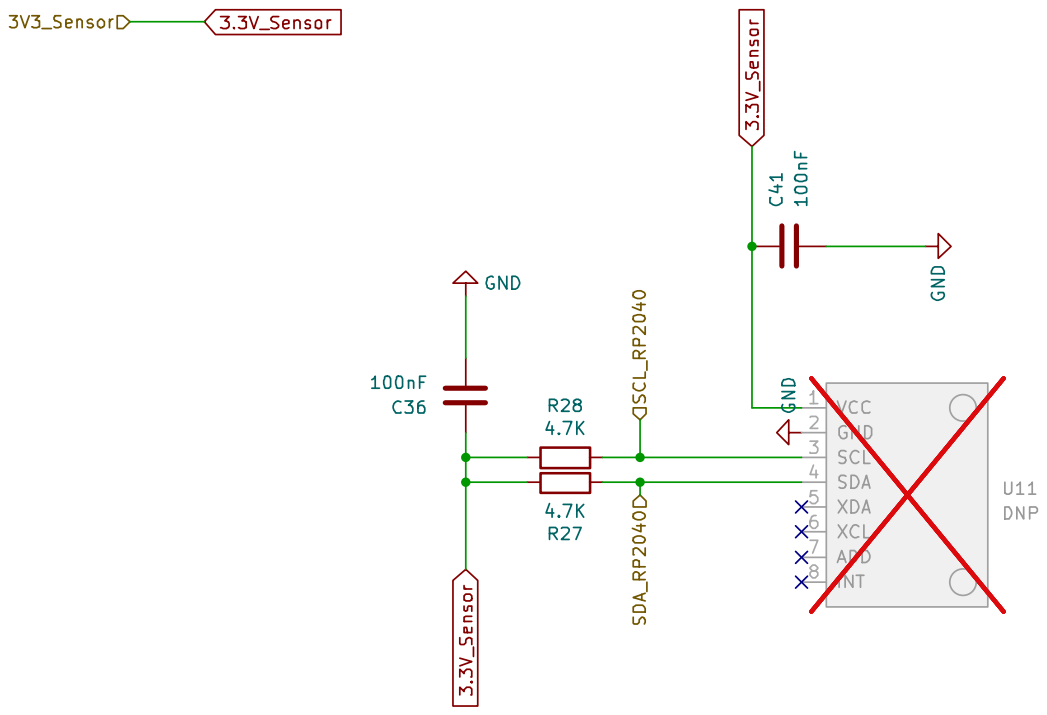
[picture p86: page 7]

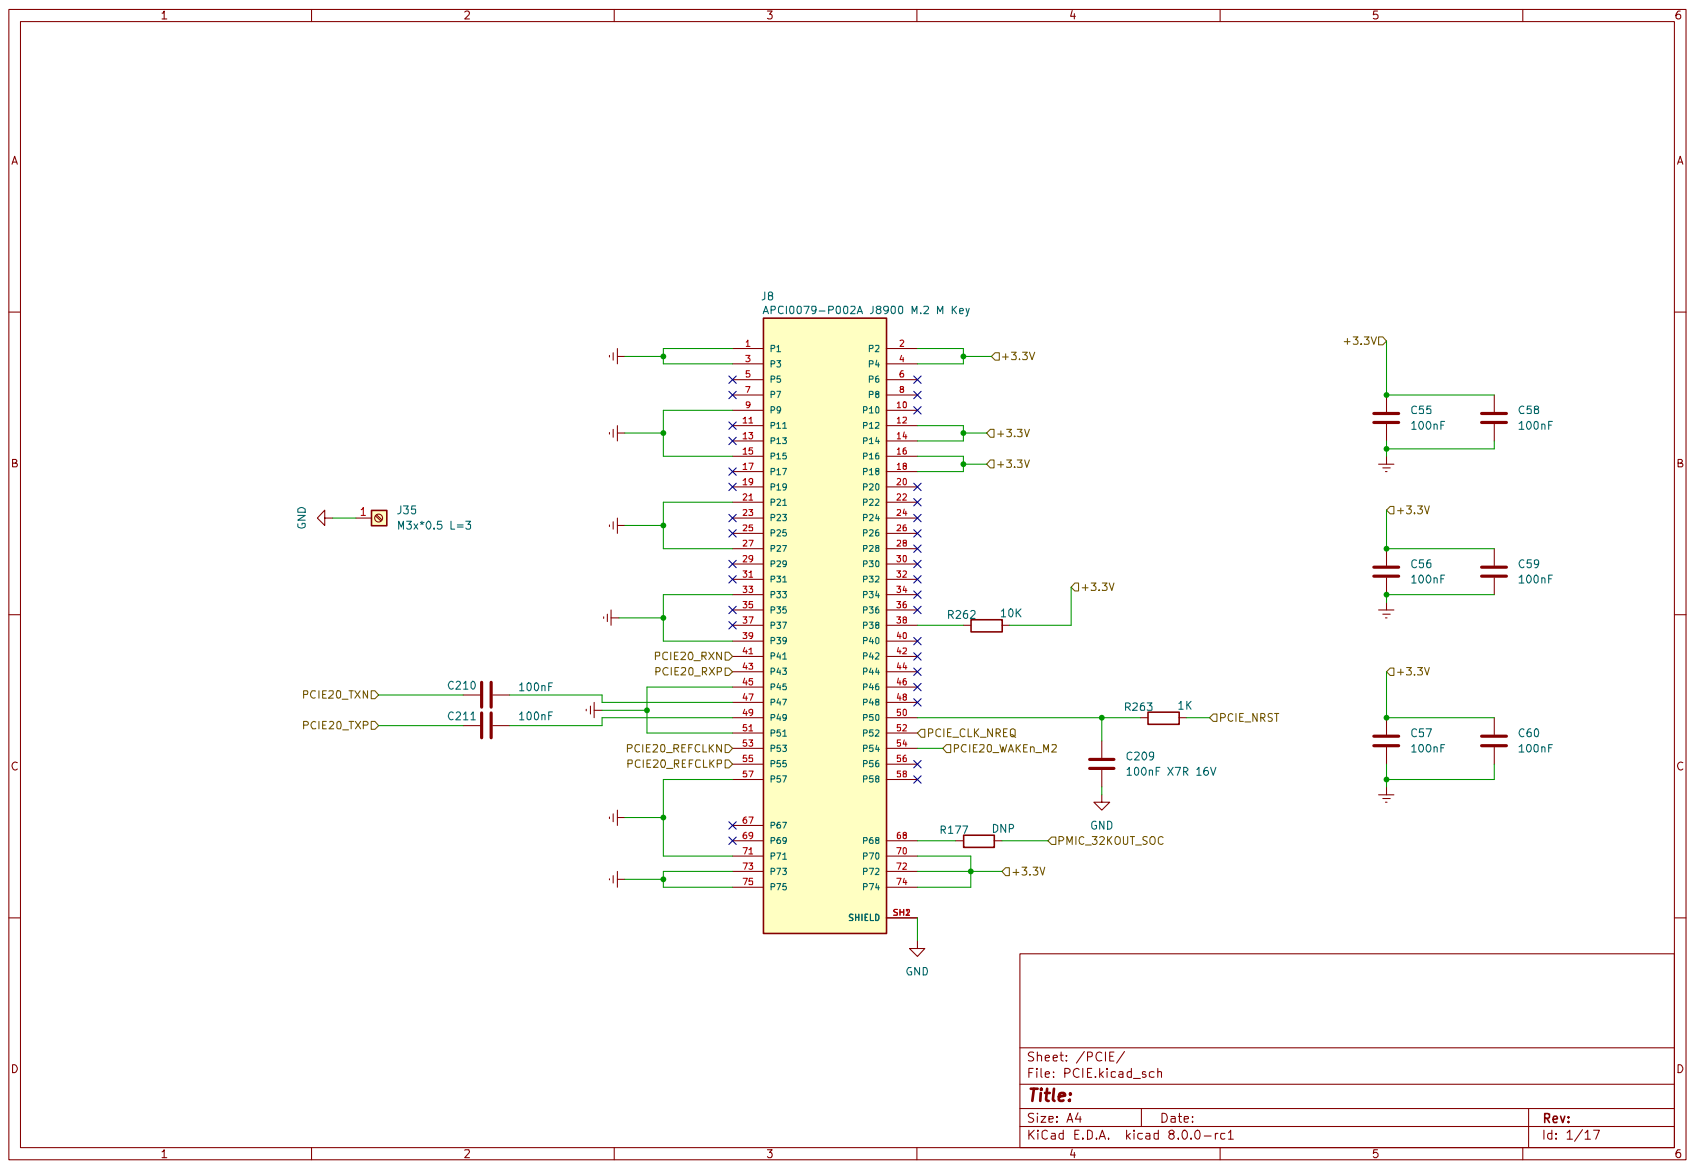
[picture p87: page 8]

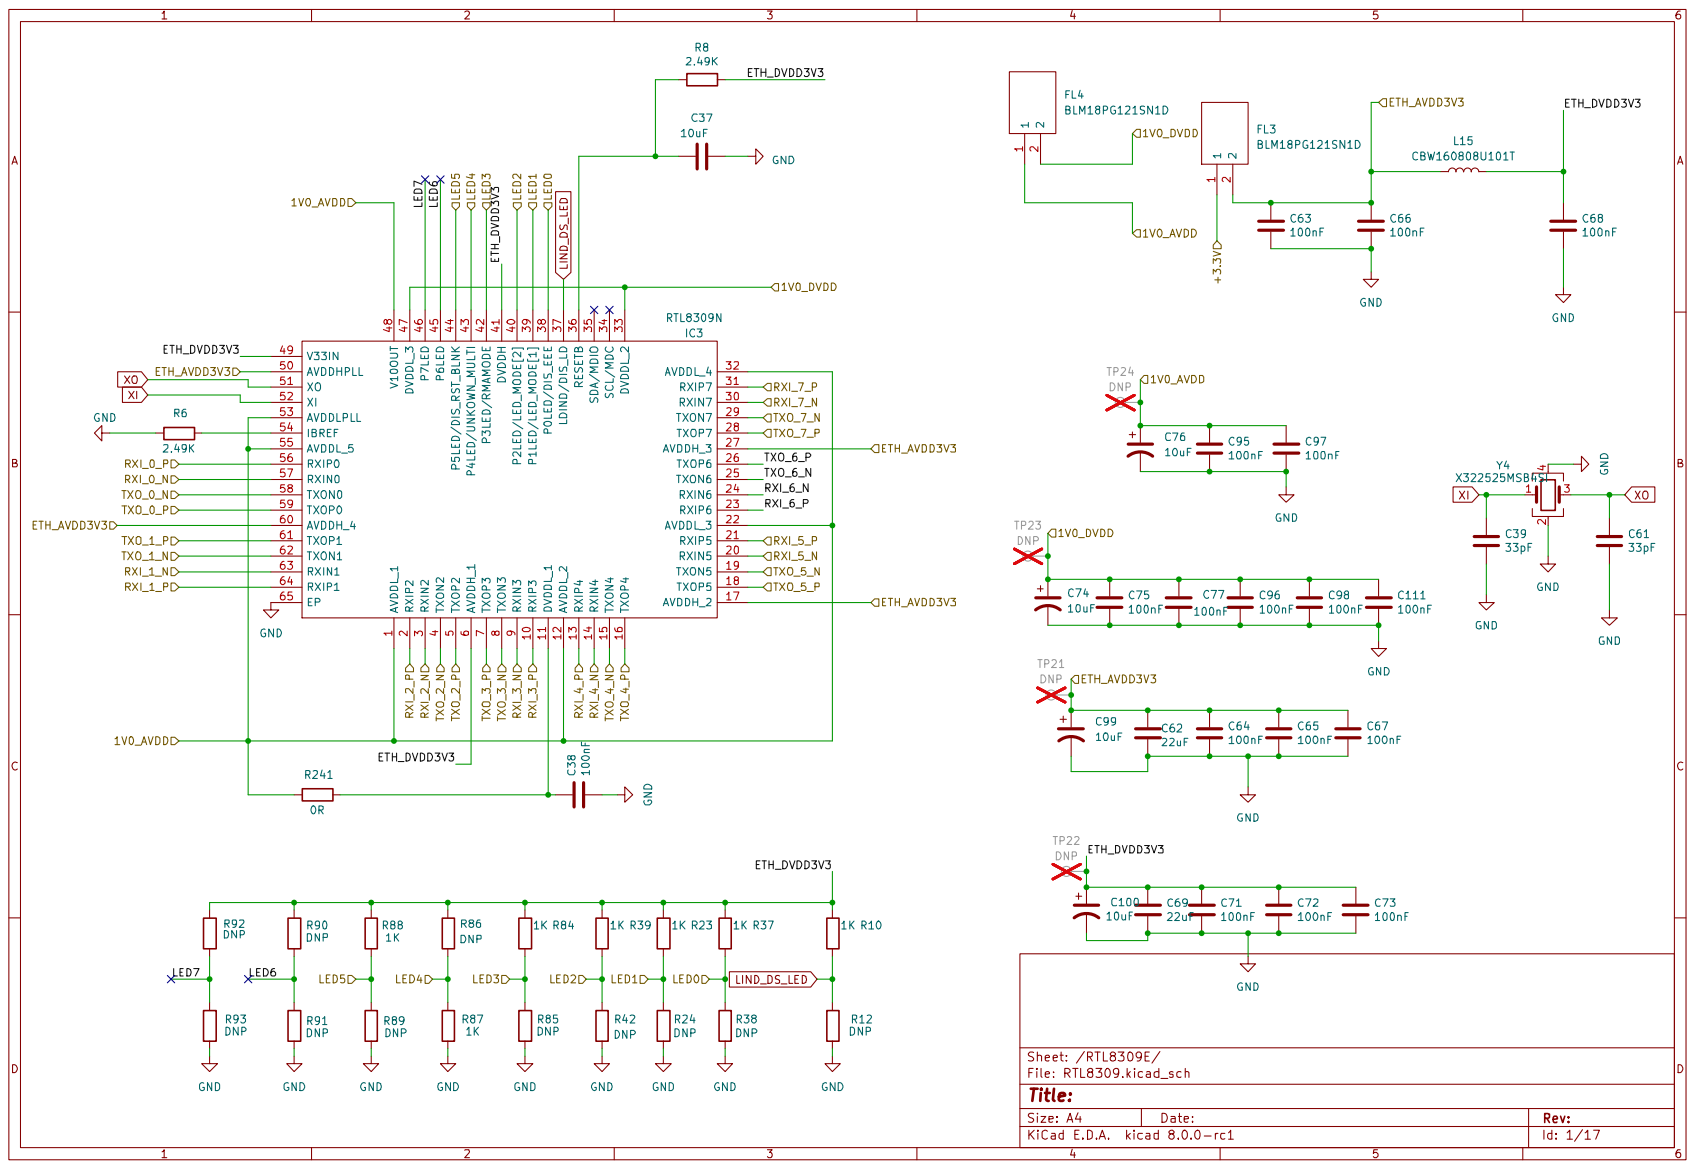
[picture p88: page 9]

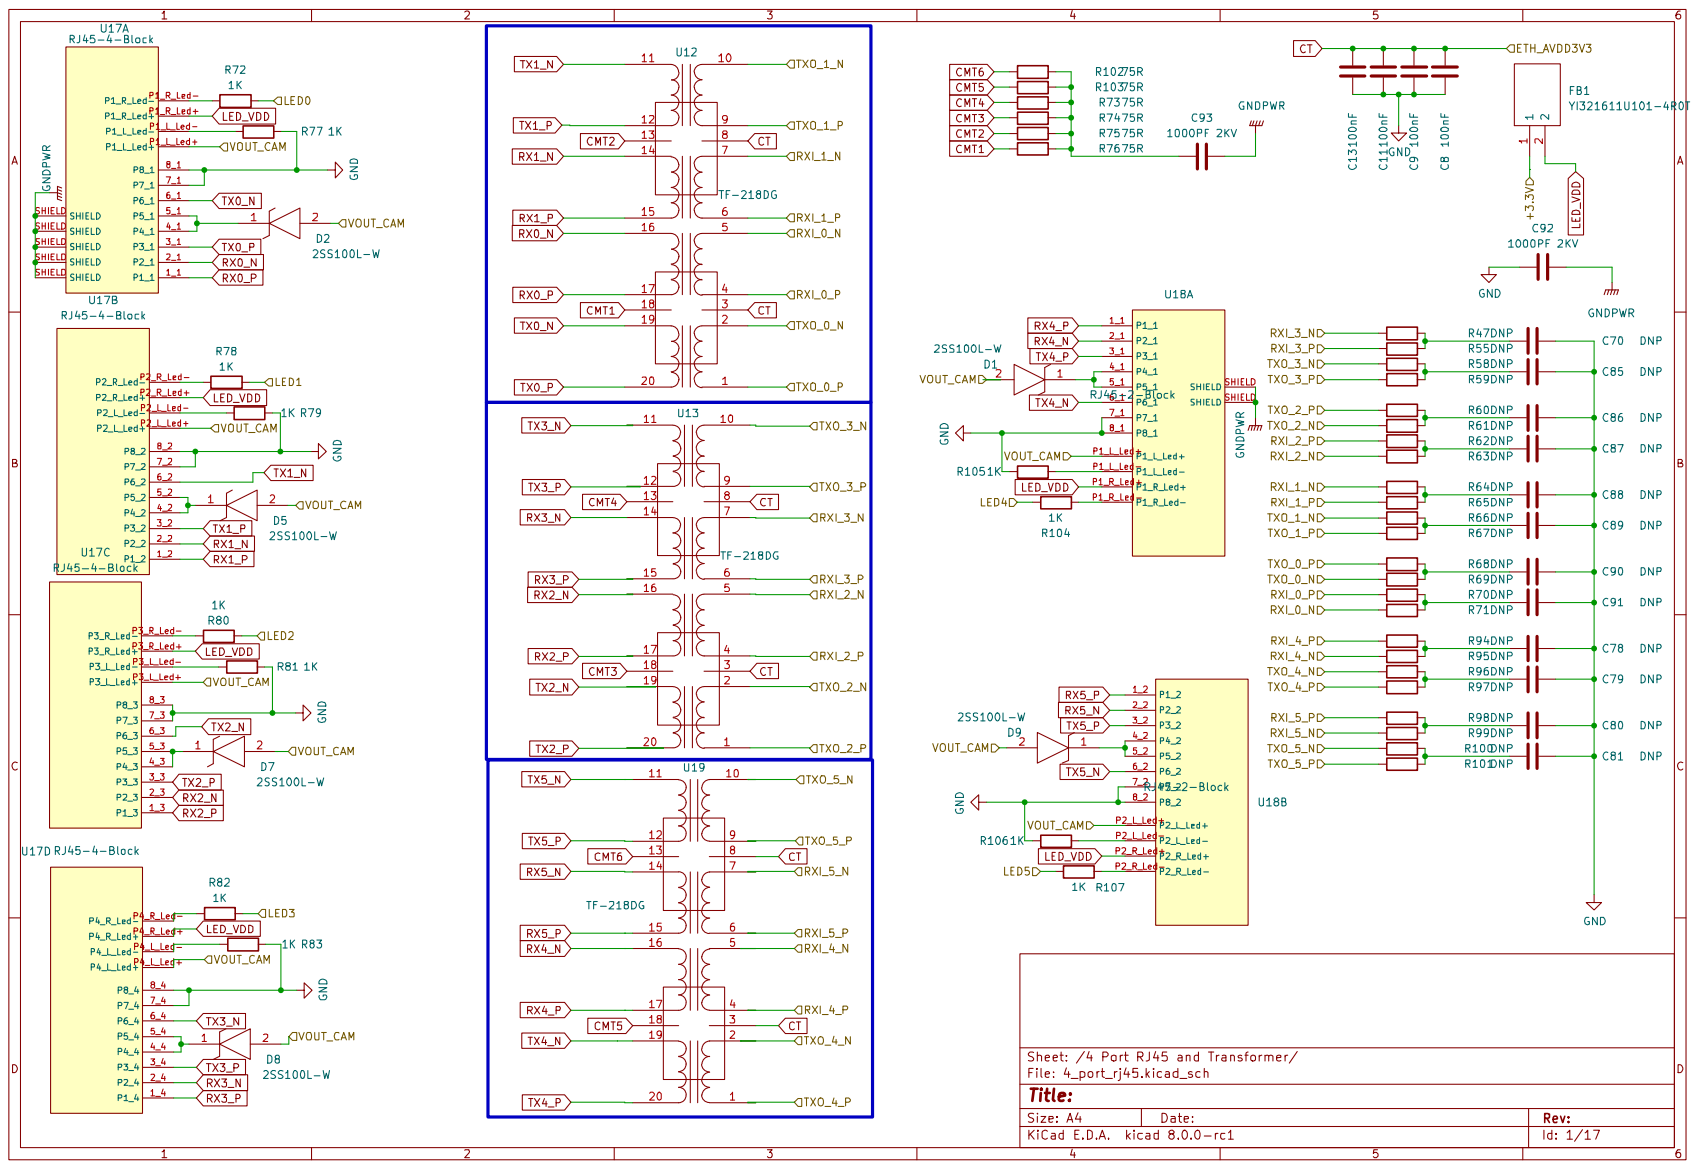
[picture p89: page 10]


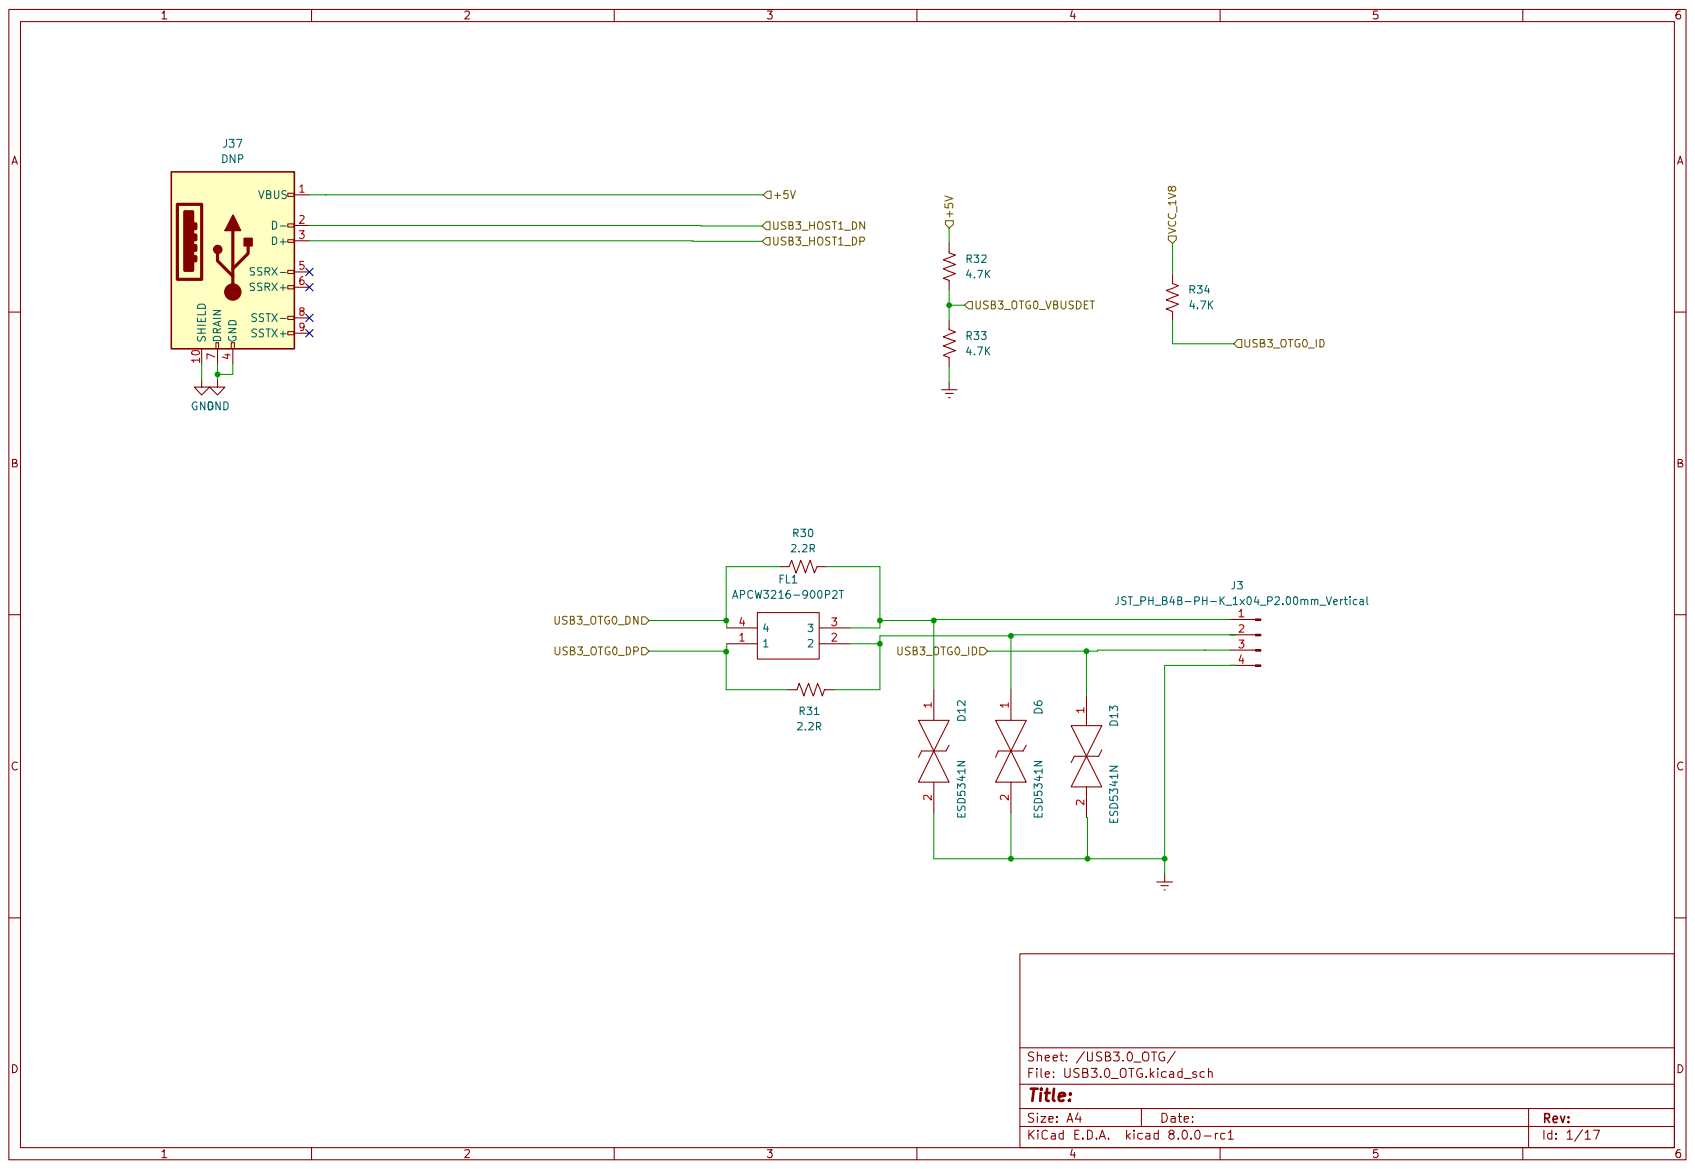
[picture p90: page 12]

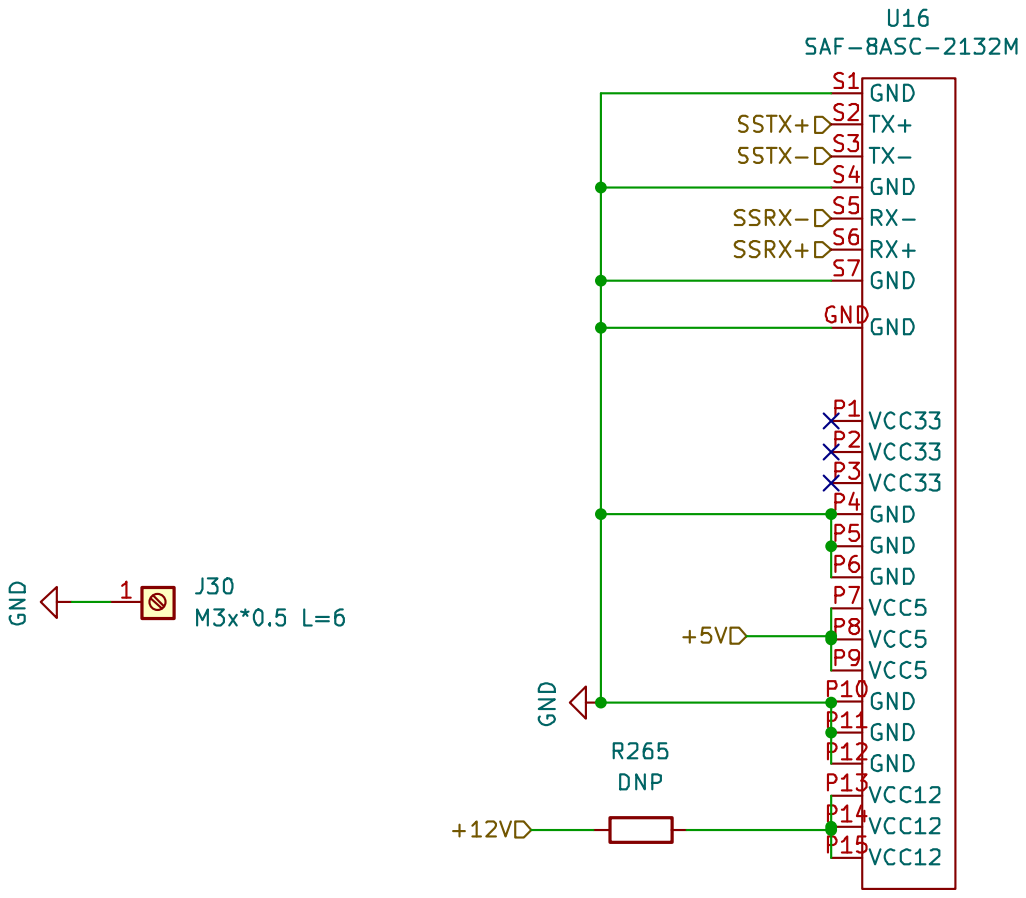
[picture p91: page 13]

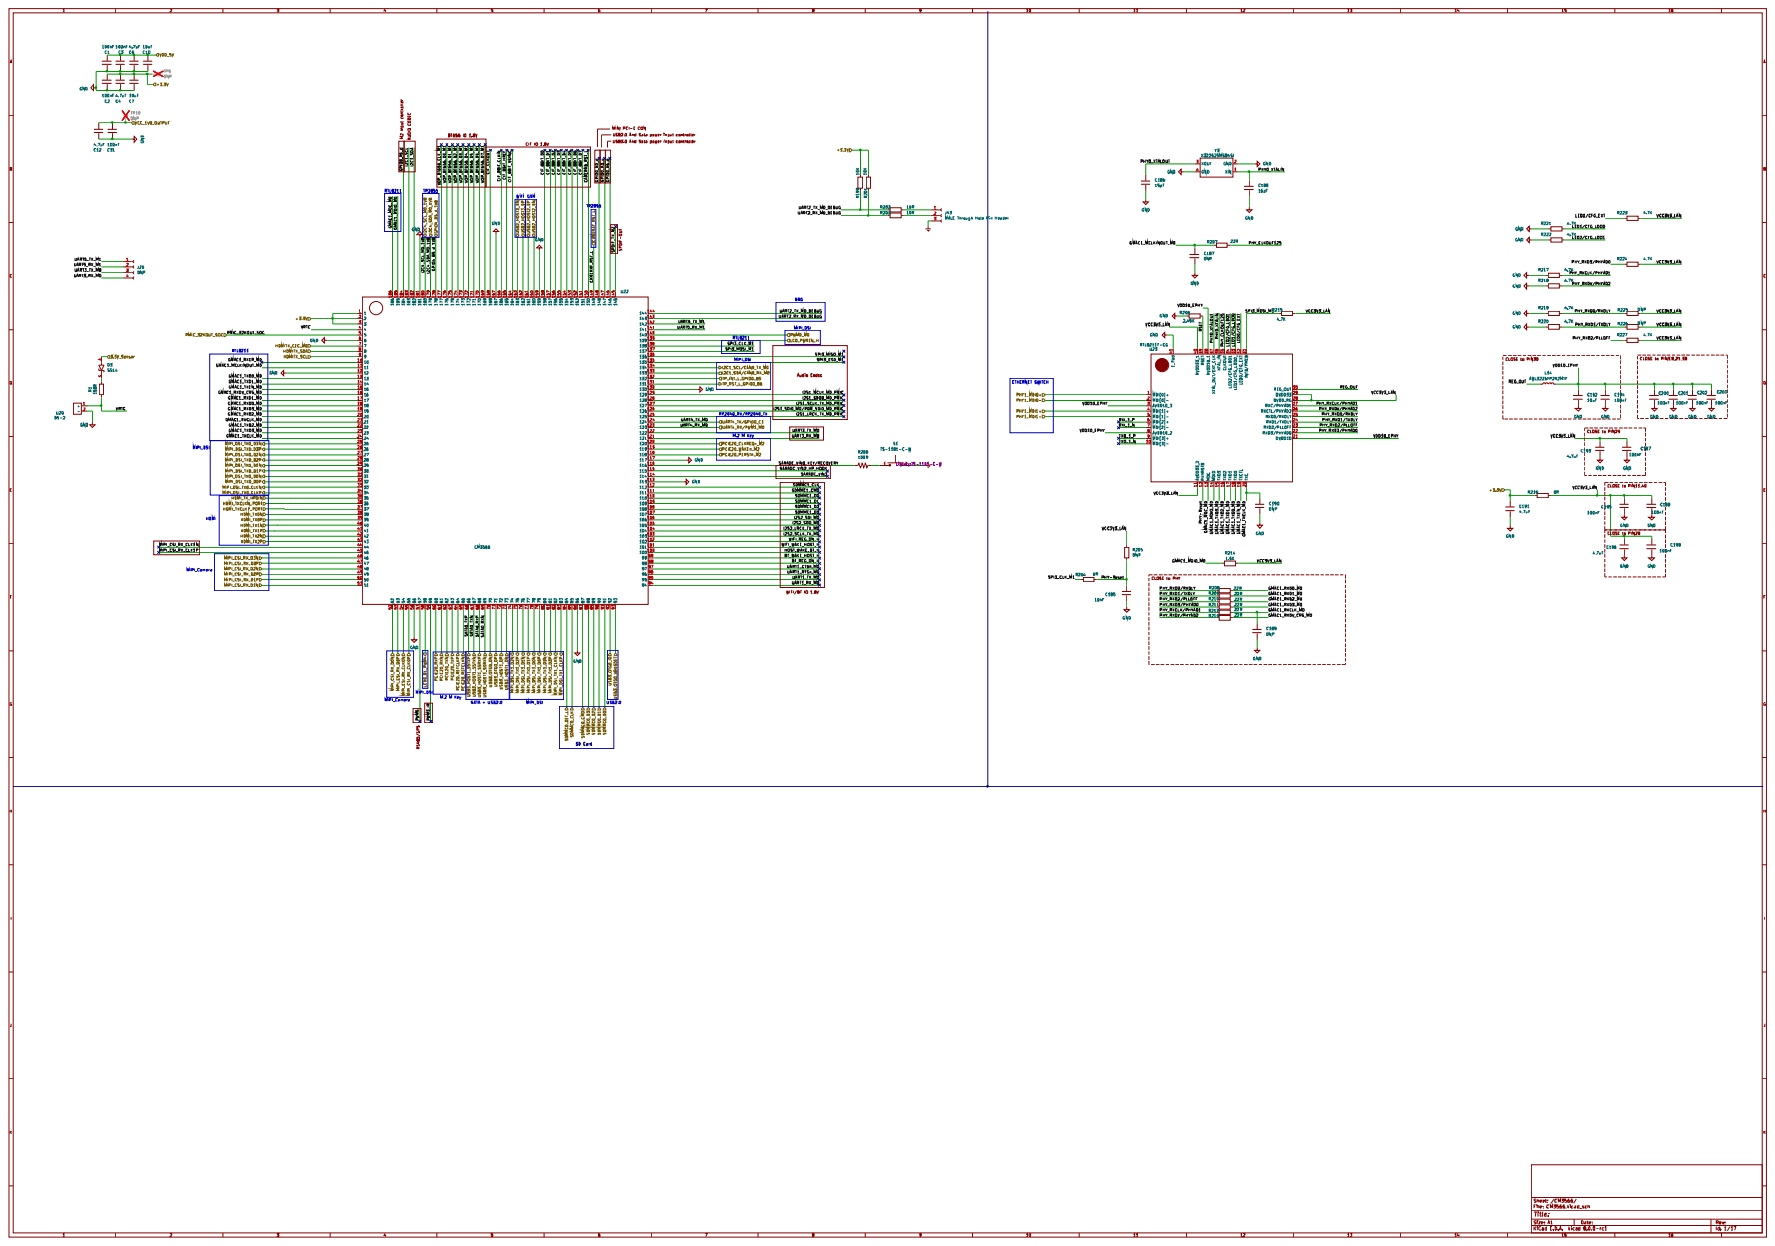
[picture p92: page 14]

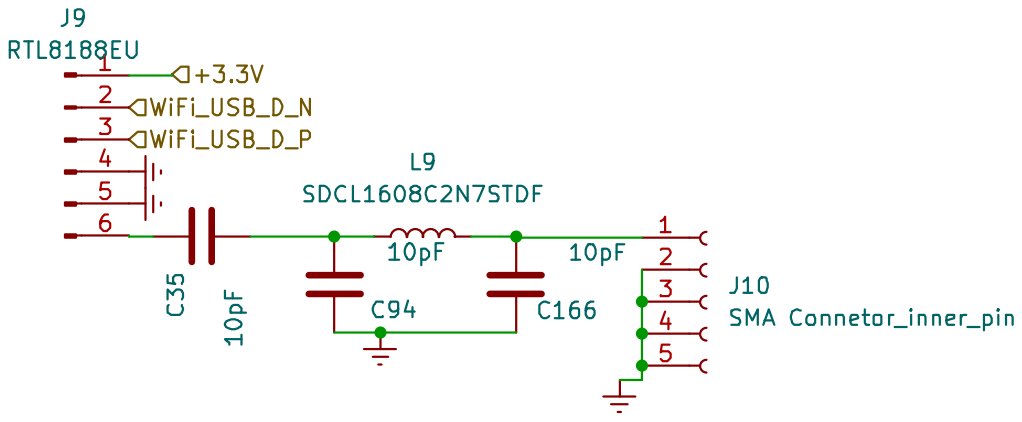
[picture p93: page 15]

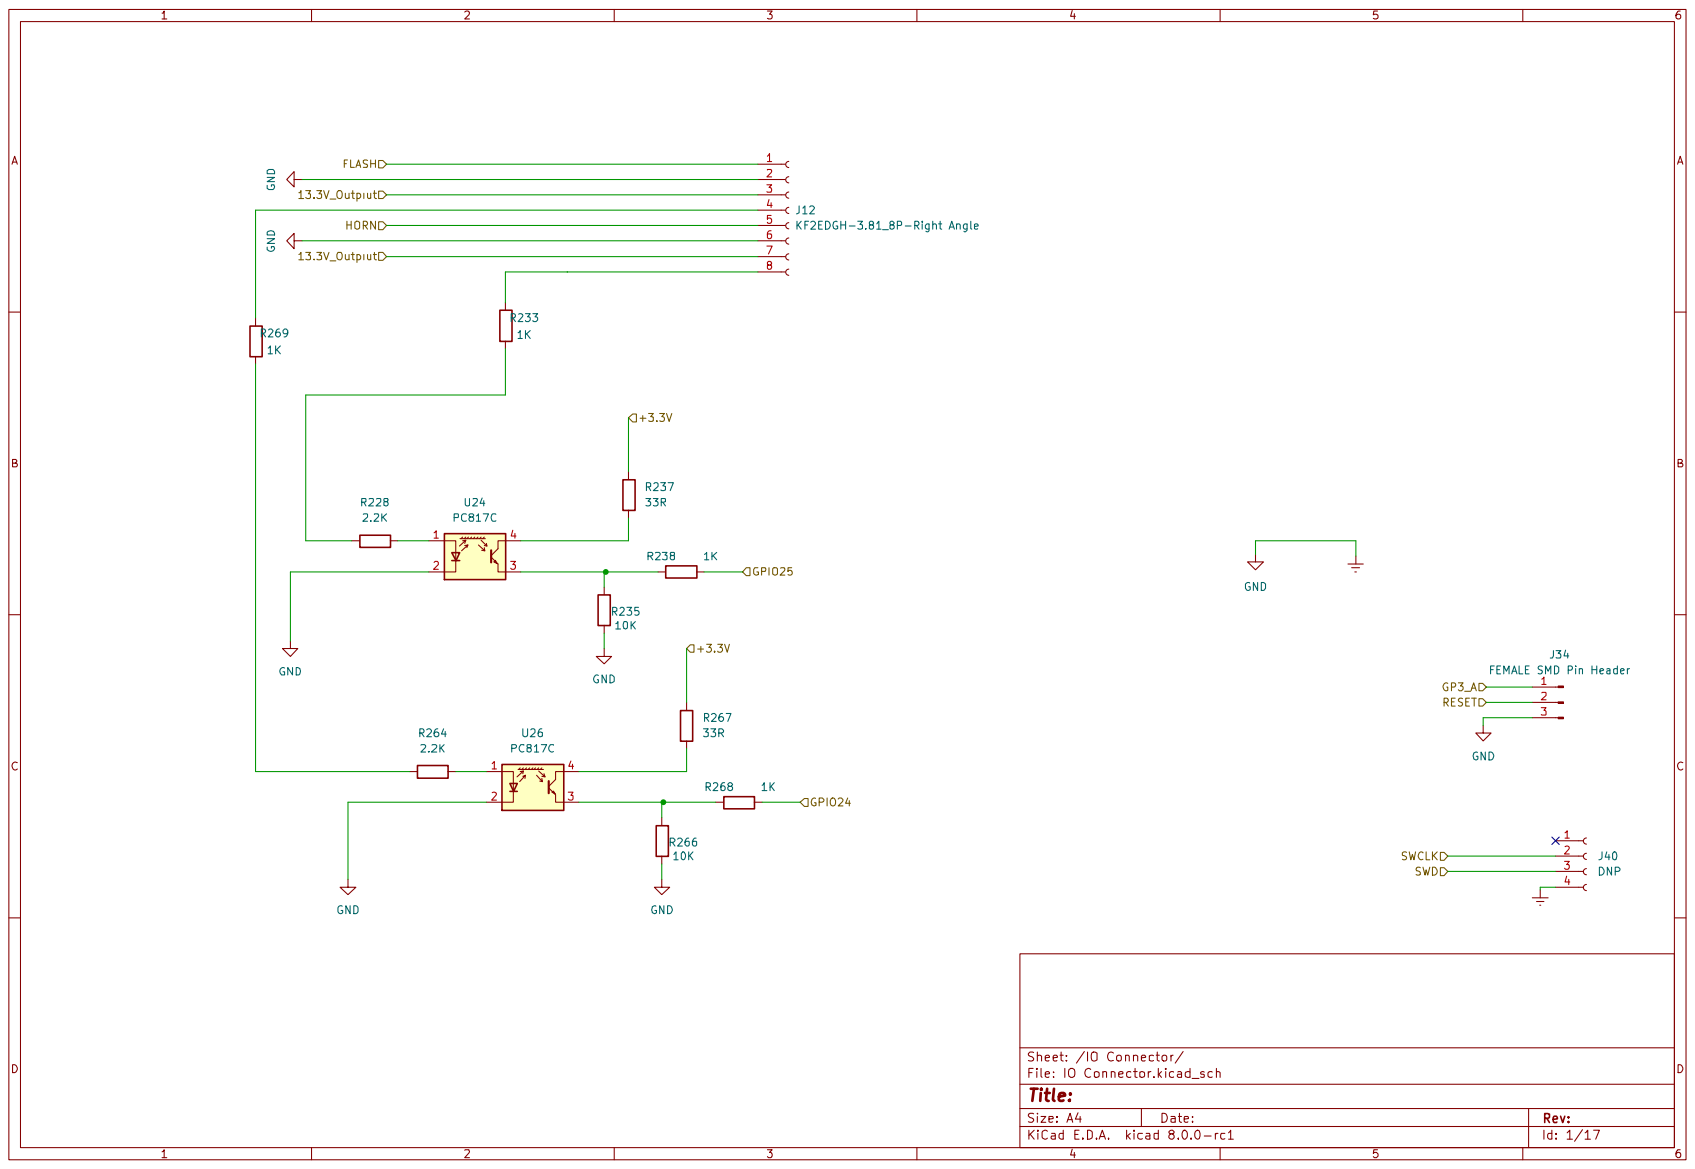
[picture p94: page 16]

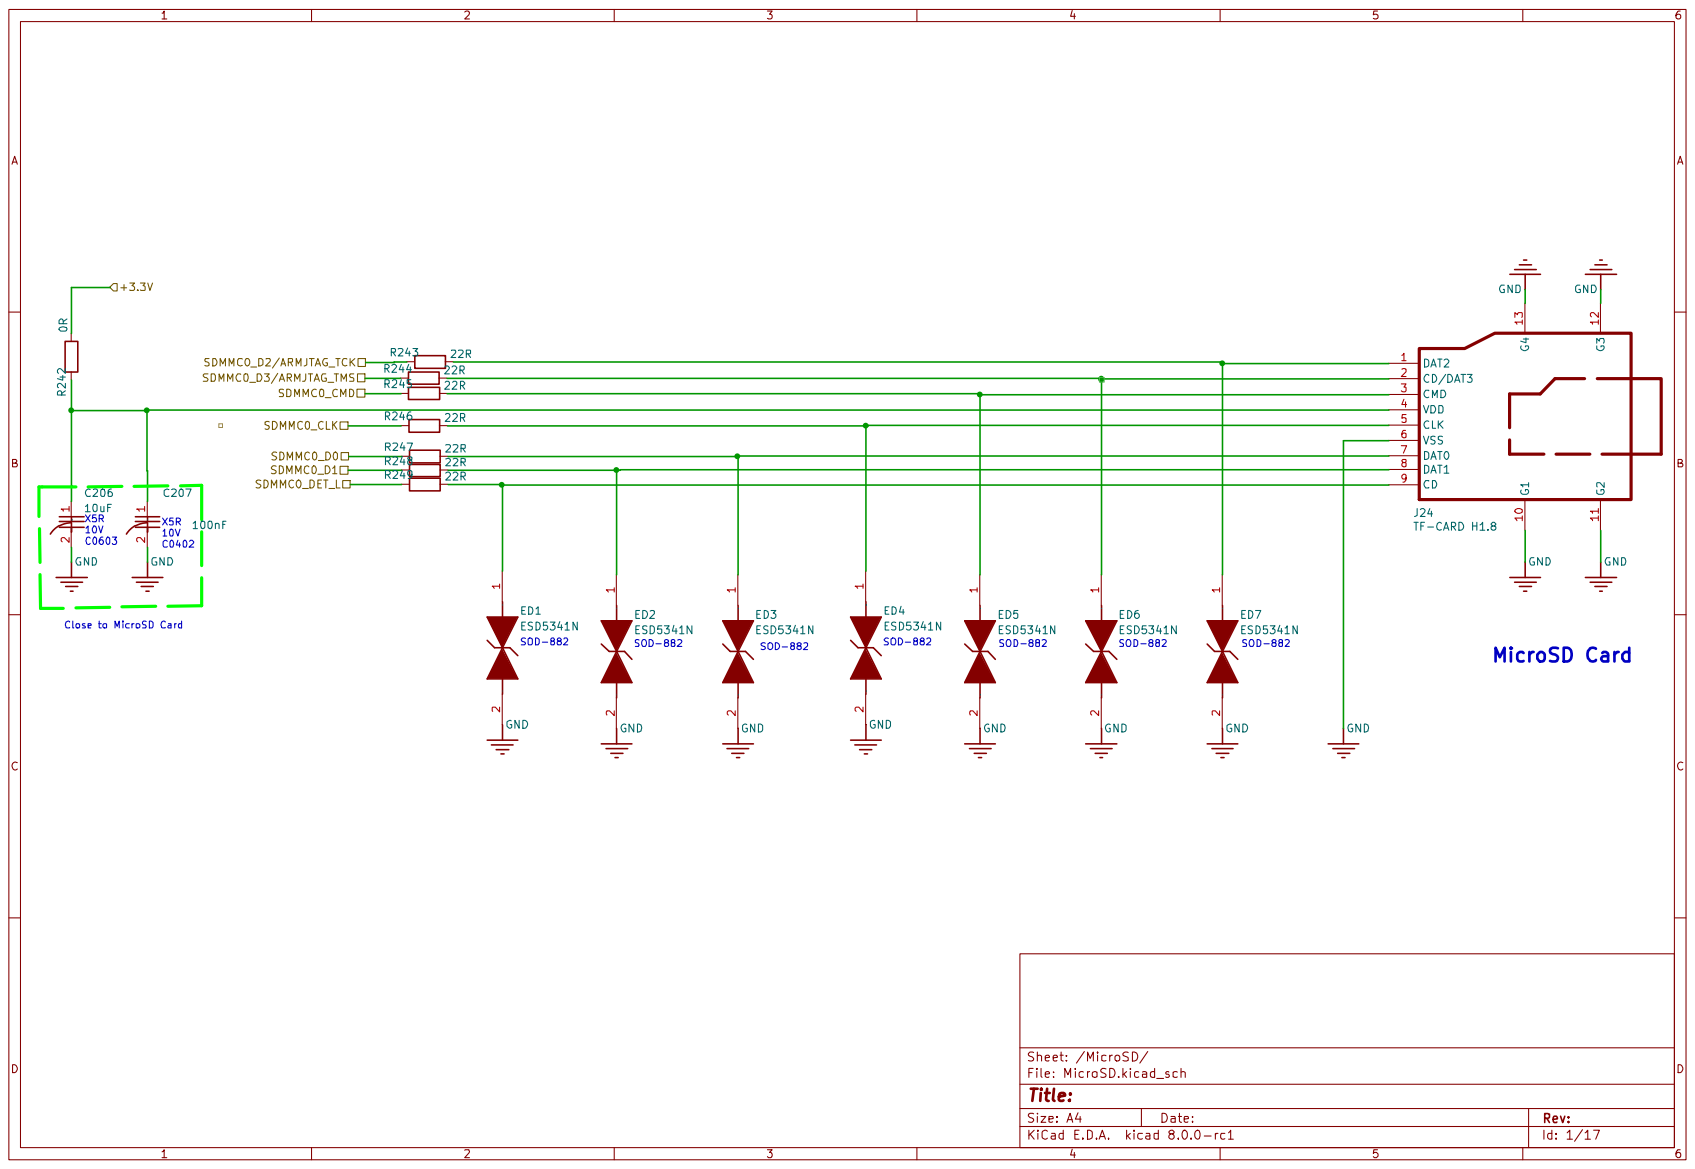
[picture p95: page 17]
