ihsanakyrk/Eski-Versionlar-Ve-Siparisler/Movita_3566_XV_Router_V3.1/Movita_3566_XV_Router_V3.1.pdf

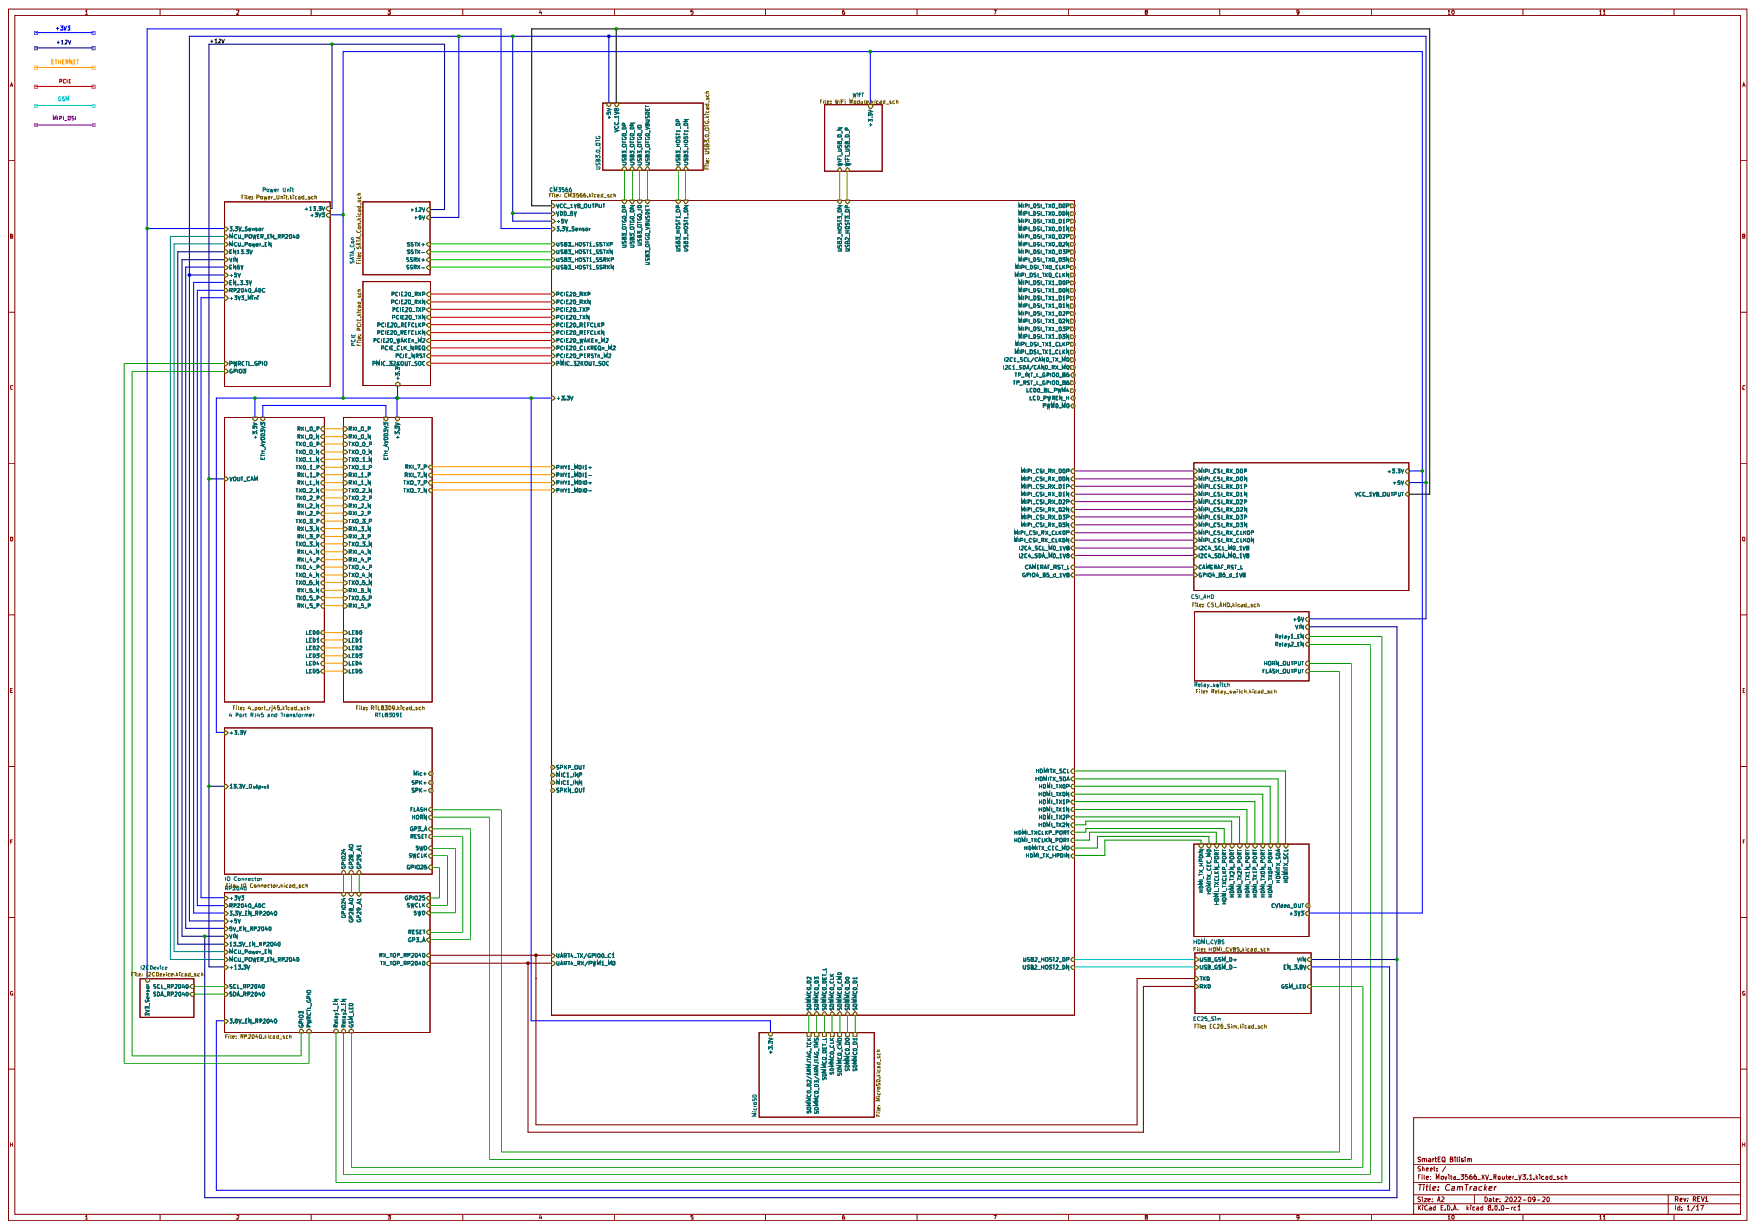
[picture p96: page 1]

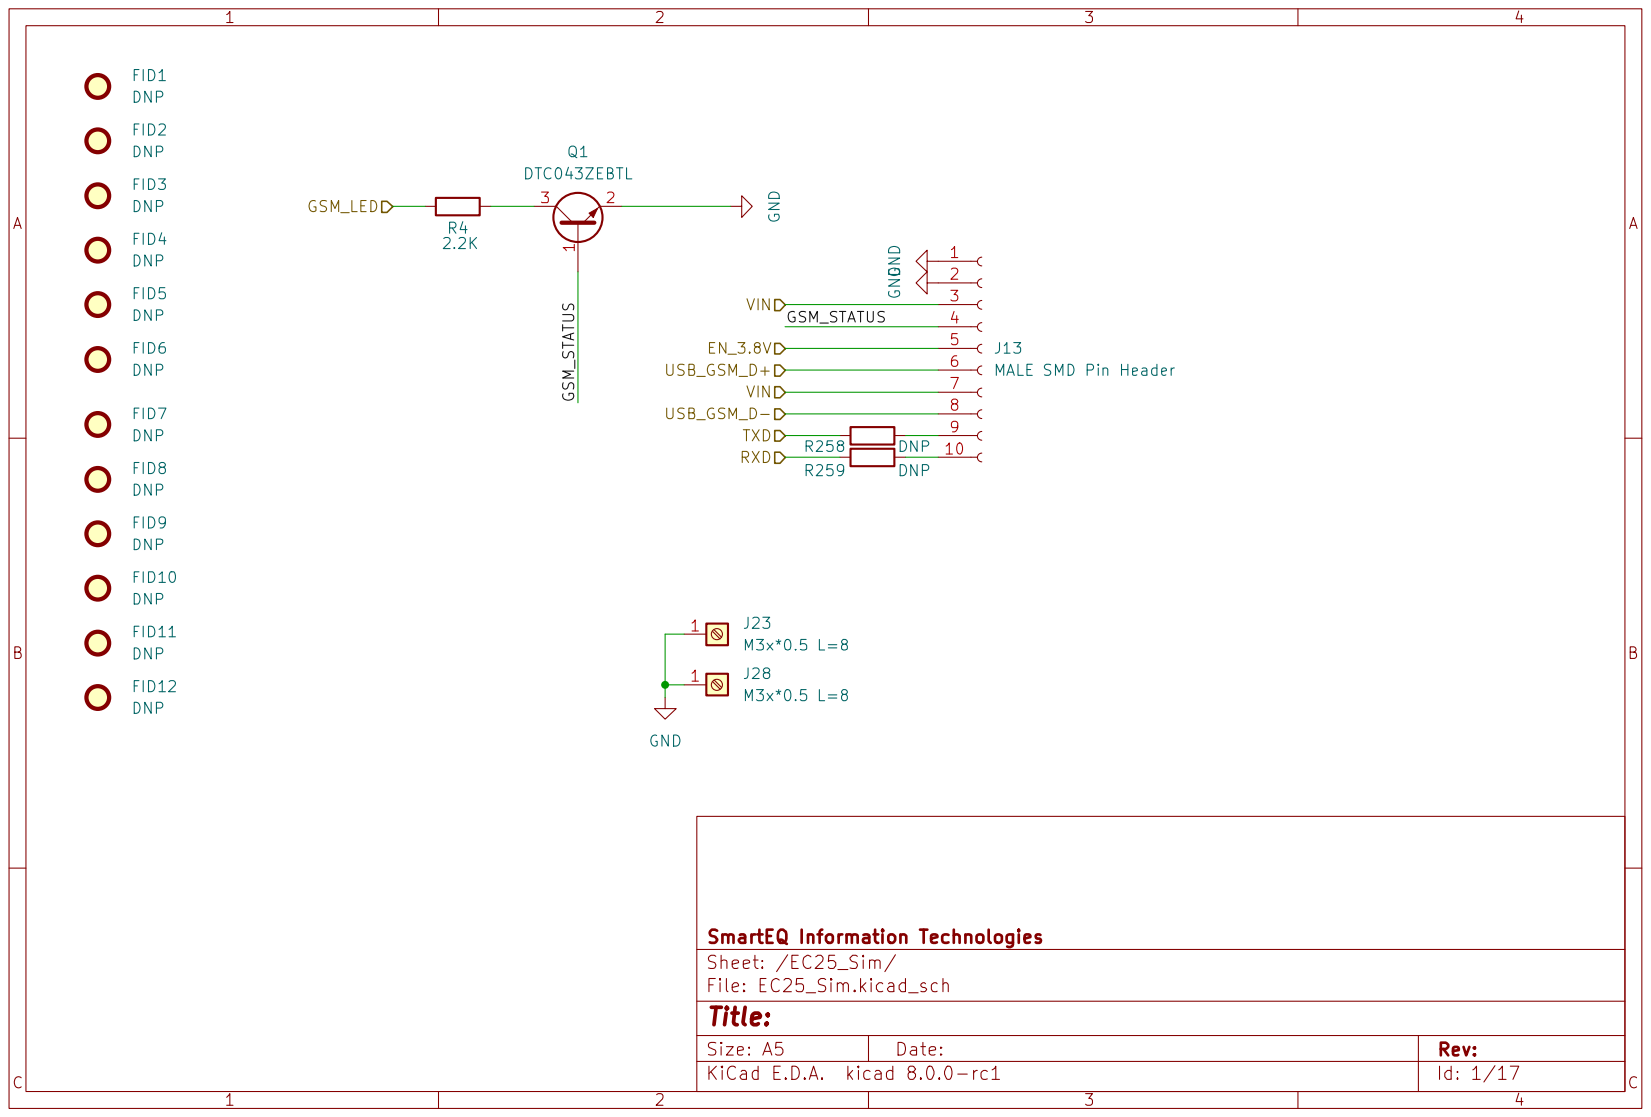
[picture p97: page 2]


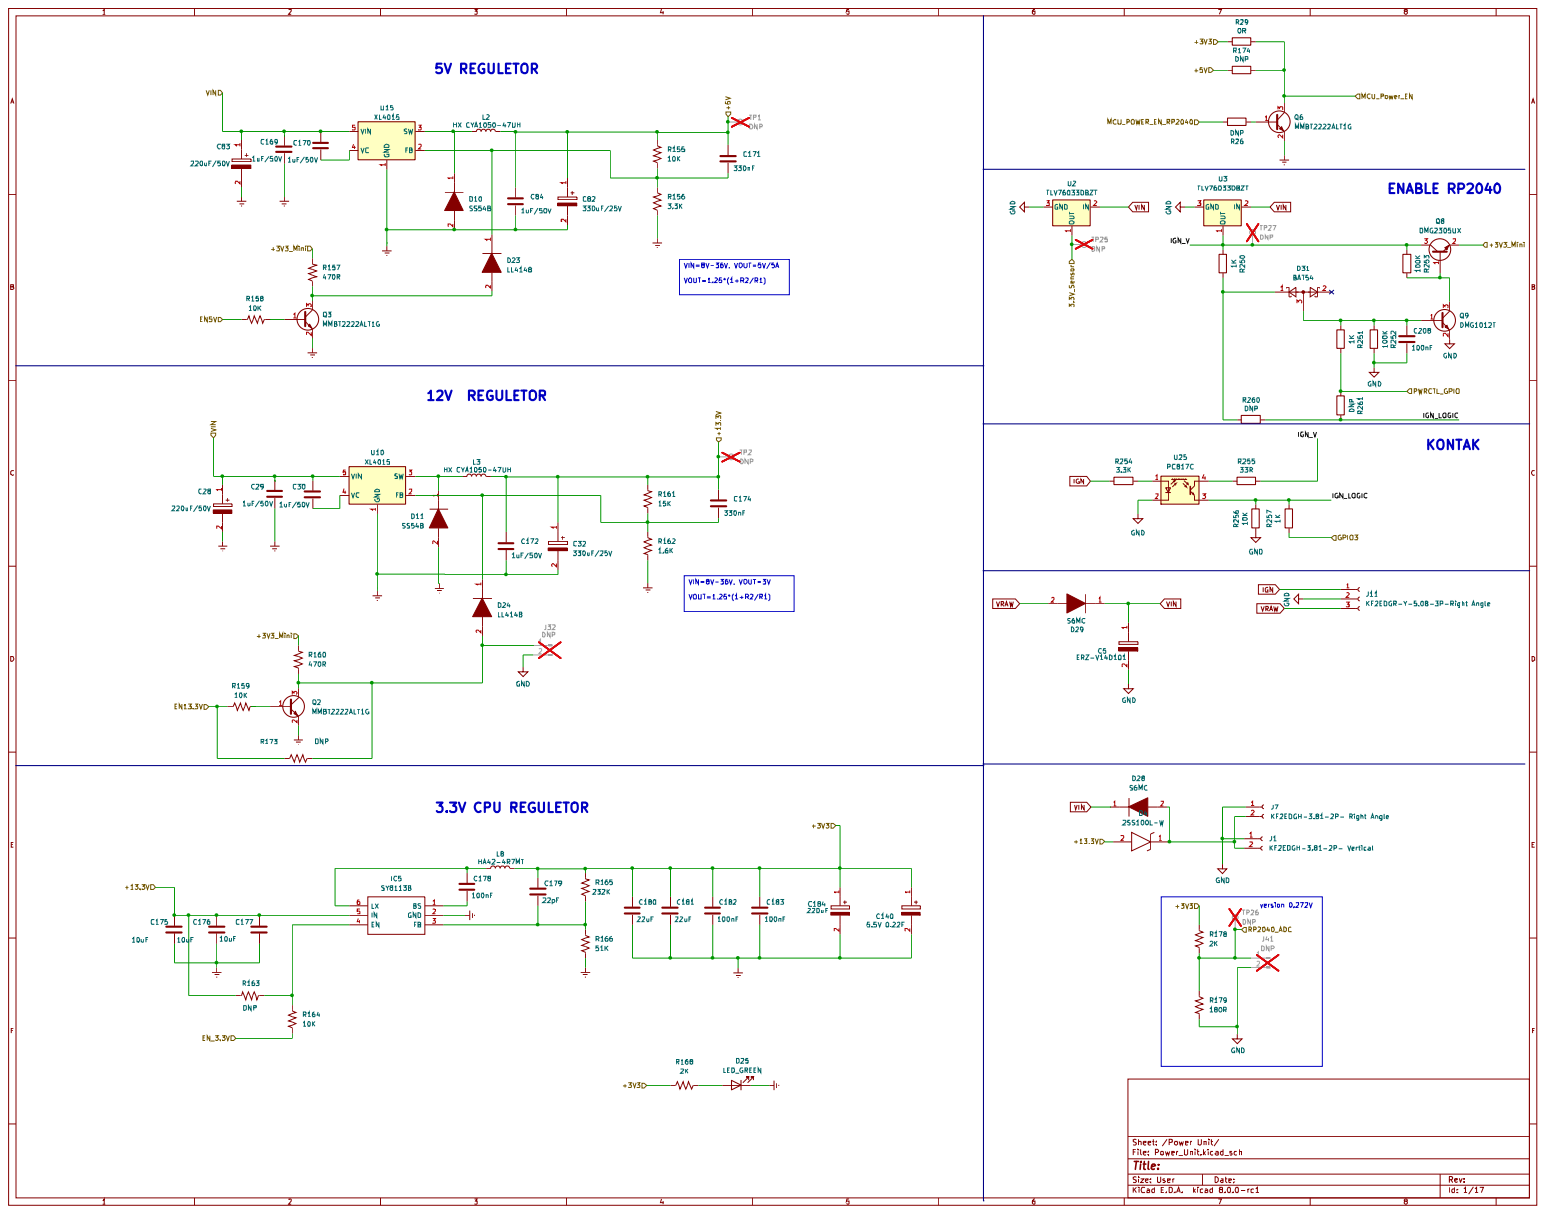
[picture p98: page 4]

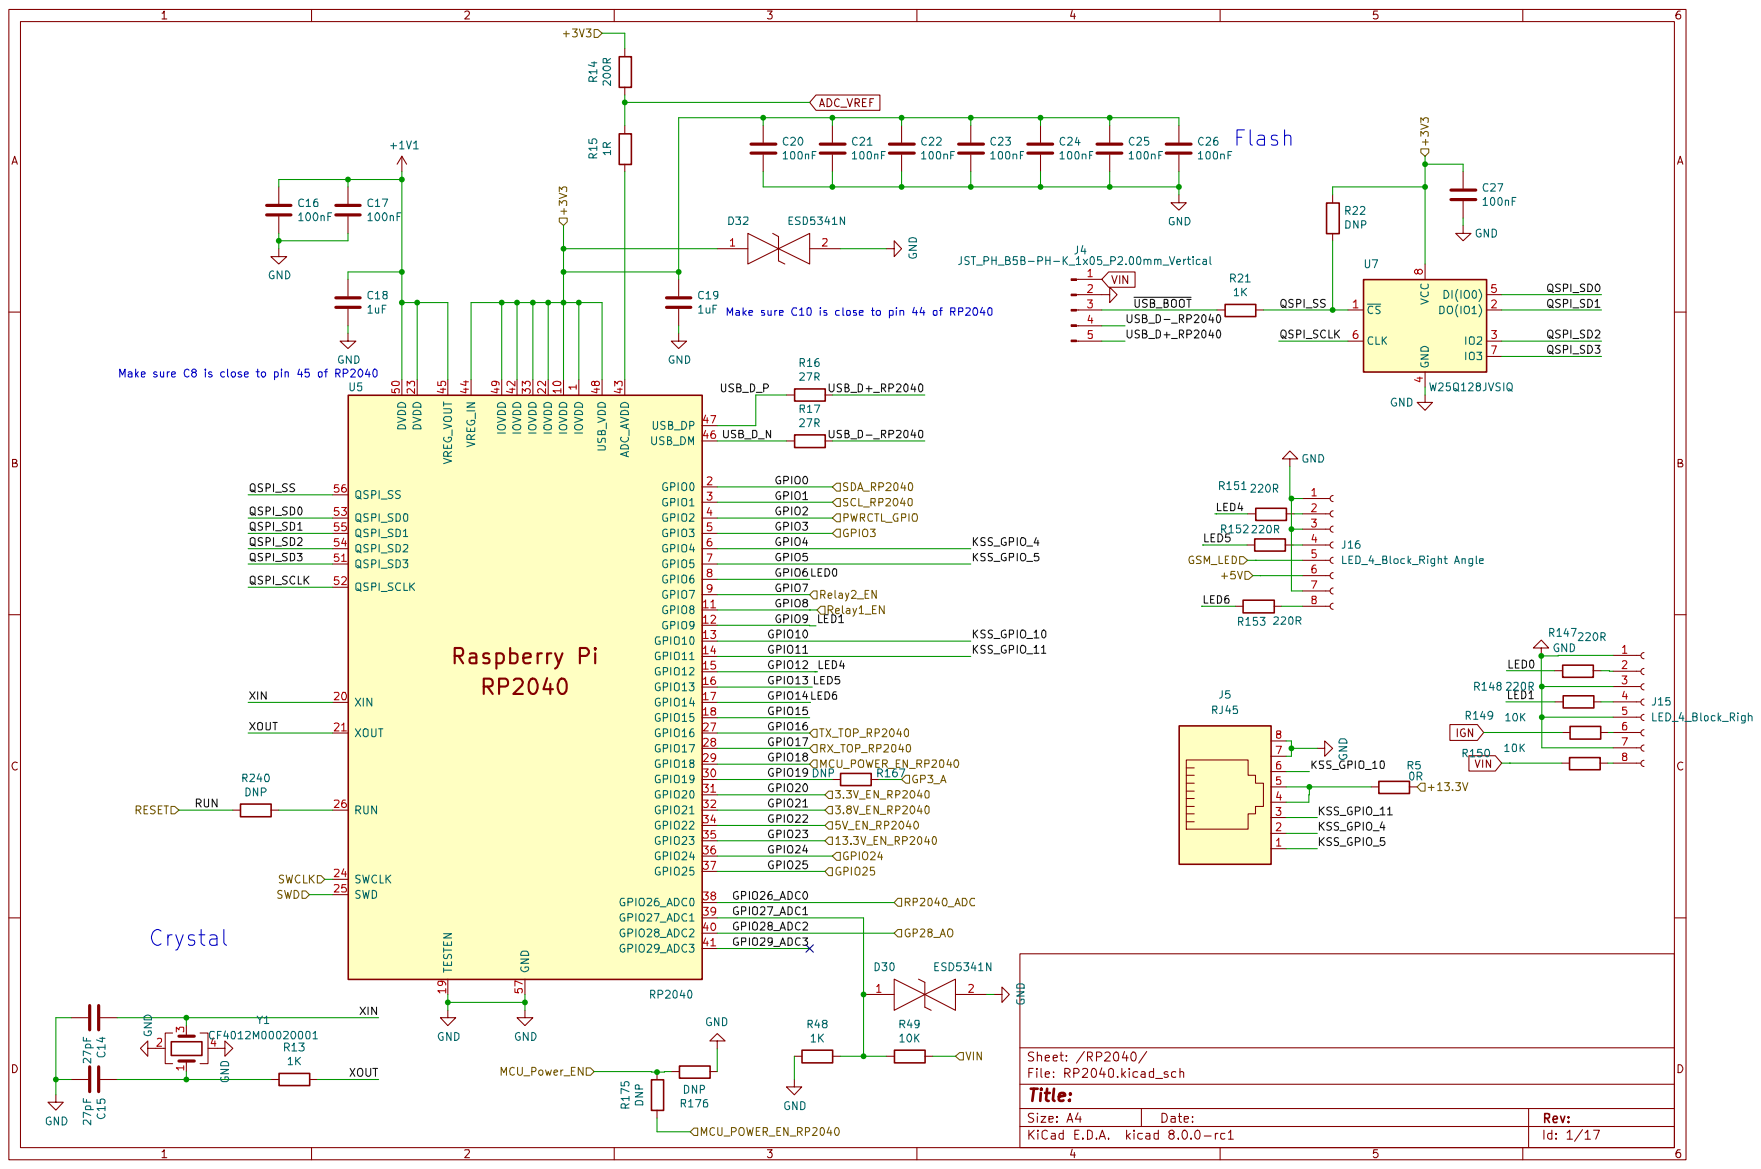
[picture p99: page 5]

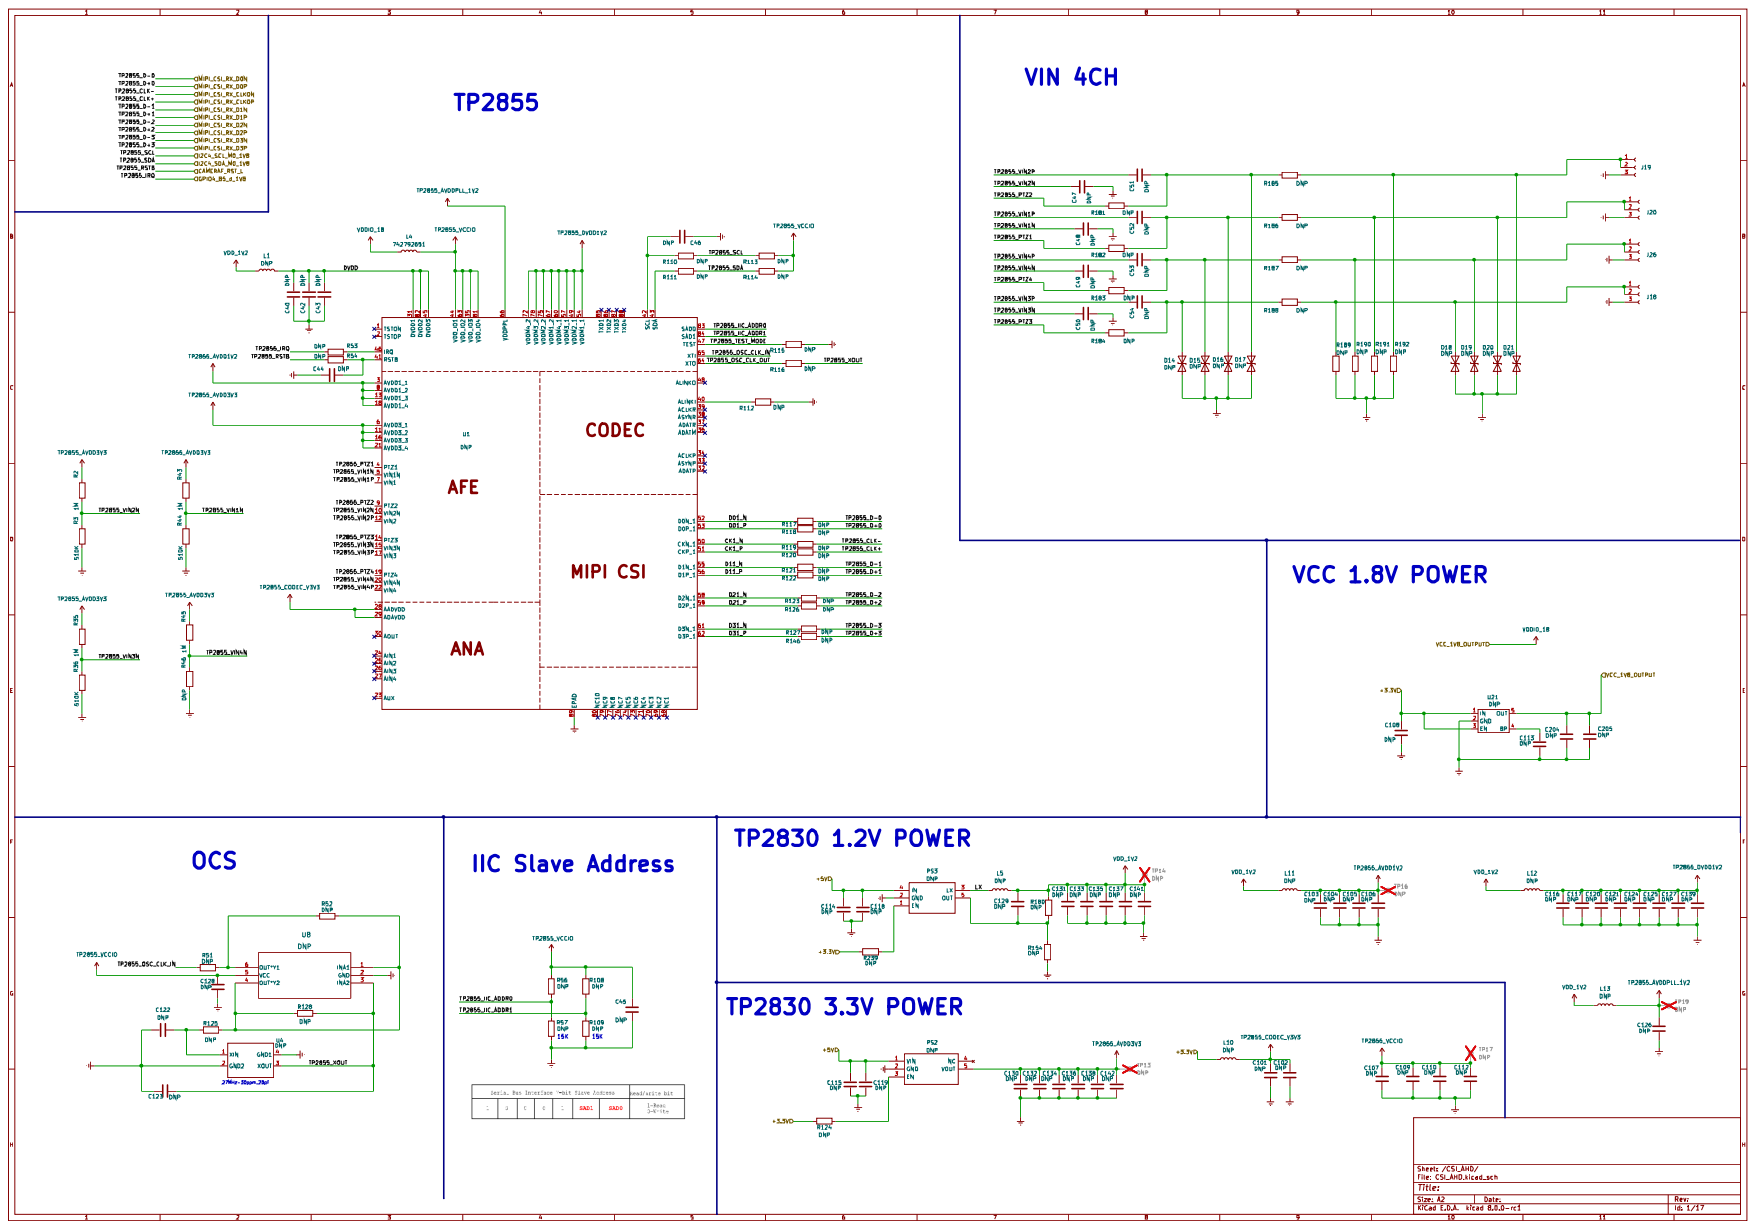
[picture p100: page 6]
