ihsanakyrk/Eski-Versionlar-Ve-Siparisler/(list of files, drawings)

Other design files:
RK3566/Document/EM3566-AV V1.pcb
