ihsanakyrk/Eski-Versionlar-Ve-Siparisler/[09.2025]_ÇİN/OV24_RV_V1.0/OV24-RV_V1.0/OV24-RV_V1.0.kicad_pcb

## KiCad design [09.2025]_ÇİN/OV24_RV_V1.0/OV24-RV_V1.0/OV24-RV_V1.0.kicad_pcb (2025-09-02)

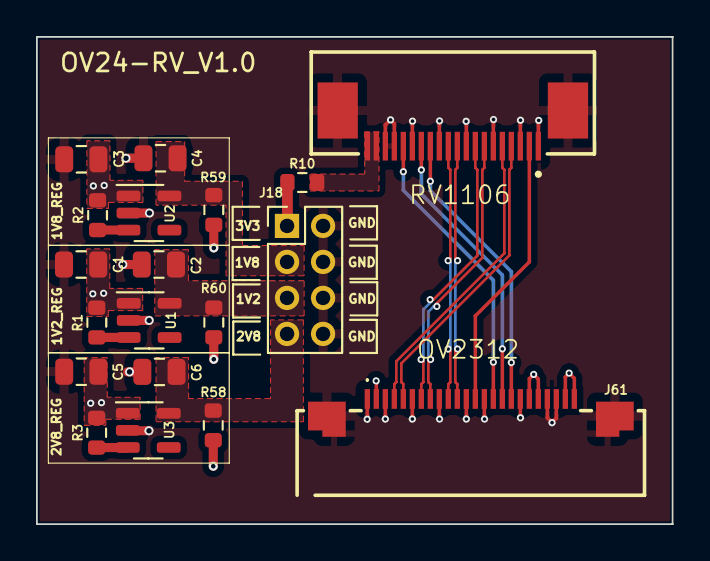
[picture p101: board OV24-RV_V1.0.kicad_pcb from above]

Board: 2 copper layers, 35.3 x 27.1 mm, 19 parts (0 on the bottom side), 22 nets.

Parts:
C1, C2, C3, C4, C5, C6: 10uF; C_0805_2012Metric
J18: DNP; PinHeader_2x04_P2.00mm_Vertical
J39: FFC SOCKET DR_TOP 0.5MM -20P; SAMTEC_ZF5S-20-02-T-WT
J61: FFC SOCKET DR_BOTTOM 0.5MM -24P; F32R1A7H111024
R1, R2, R3: 5K; R_0603_1608Metric
R10, R58, R59, R60: 0R; R_0603_1608Metric
U1: RT9080-12GJ5; SOT-23-5
U2: RT9080-18GJ5; SOT-23-5
U3: RT9080-28GJ5; SOT-23-5

Connections:
/+3V3: J39.19, J39.20, R10.2
/MIPI_I2C_SCL: J39.13, J61.17
/MIPI_I2C_SDA: J39.14, J61.16
/MIPI_LVDS_CLK_N: J39.08 (Pin_8), J61.7
/MIPI_LVDS_CLK_P: J39.07 (Pin_7), J61.8
/MIPI_LVDS_D0_N: J39.05 (Pin_5), J61.4
/MIPI_LVDS_D0_P: J39.04 (Pin_4), J61.5
/MIPI_LVDS_D1_N: J39.11, J61.10
/MIPI_LVDS_D1_P: J39.10, J61.11
/MIPI_LVDS_MCLK0: J39.02 (Pin_2), J61.13
/MIPI_LVDS_RST: J39.16, J61.15
AVDD2V8: C6.1, J18.7, R58.1, U3.5 (OUT)
DOVDD1V8: C4.1, J18.3, R59.1, U2.5 (OUT)
DVDD1V2: C2.1, J18.5, R60.1, U1.5 (OUT)
GND: C1.2, C2.2, C3.2, C4.2, C5.2, C6.2, J18.2, J18.4, J18.6, J18.8, J39.01 (Pin_1), J39.03 (Pin_3), J39.06 (Pin_6), J39.09 (Pin_9), J39.12, J39.15, J39.17, J39.18, J39.S1 (Pin_22), J39.S2 (Pin_21), J61.1, J61.3, J61.6, J61.9, J61.12, J61.14, J61.18, J61.21, J61.22, J61.25, J61.26, U1.2 (GND), U2.2 (GND), U3.2 (GND)
unnamed: J61.2, R59.2
unnamed: J61.19, J61.20, R60.2
unnamed: J61.23, J61.24, R58.2
unnamed: R1.2, U1.3 (EN)
unnamed: R2.2, U2.3 (EN)
unnamed: R3.2, U3.3 (EN)
VCC_3V3: C1.1, C3.1, C5.1, J18.1, R1.1, R2.1, R3.1, R10.1, U1.1 (IN), U2.1 (IN), U3.1 (IN)
