ihsanakyrk/Eski-Versionlar-Ve-Siparisler/[09.2025]_ÇİN/GSM_Adapter_Board_V1.0/GSM_Adapter_Board_V1.0/GSM_Adapter_Board_V1.0.kicad_pcb

## KiCad design [09.2025]_ÇİN/GSM_Adapter_Board_V1.0/GSM_Adapter_Board_V1.0/GSM_Adapter_Board_V1.0.kicad_pcb (2025-09-02)

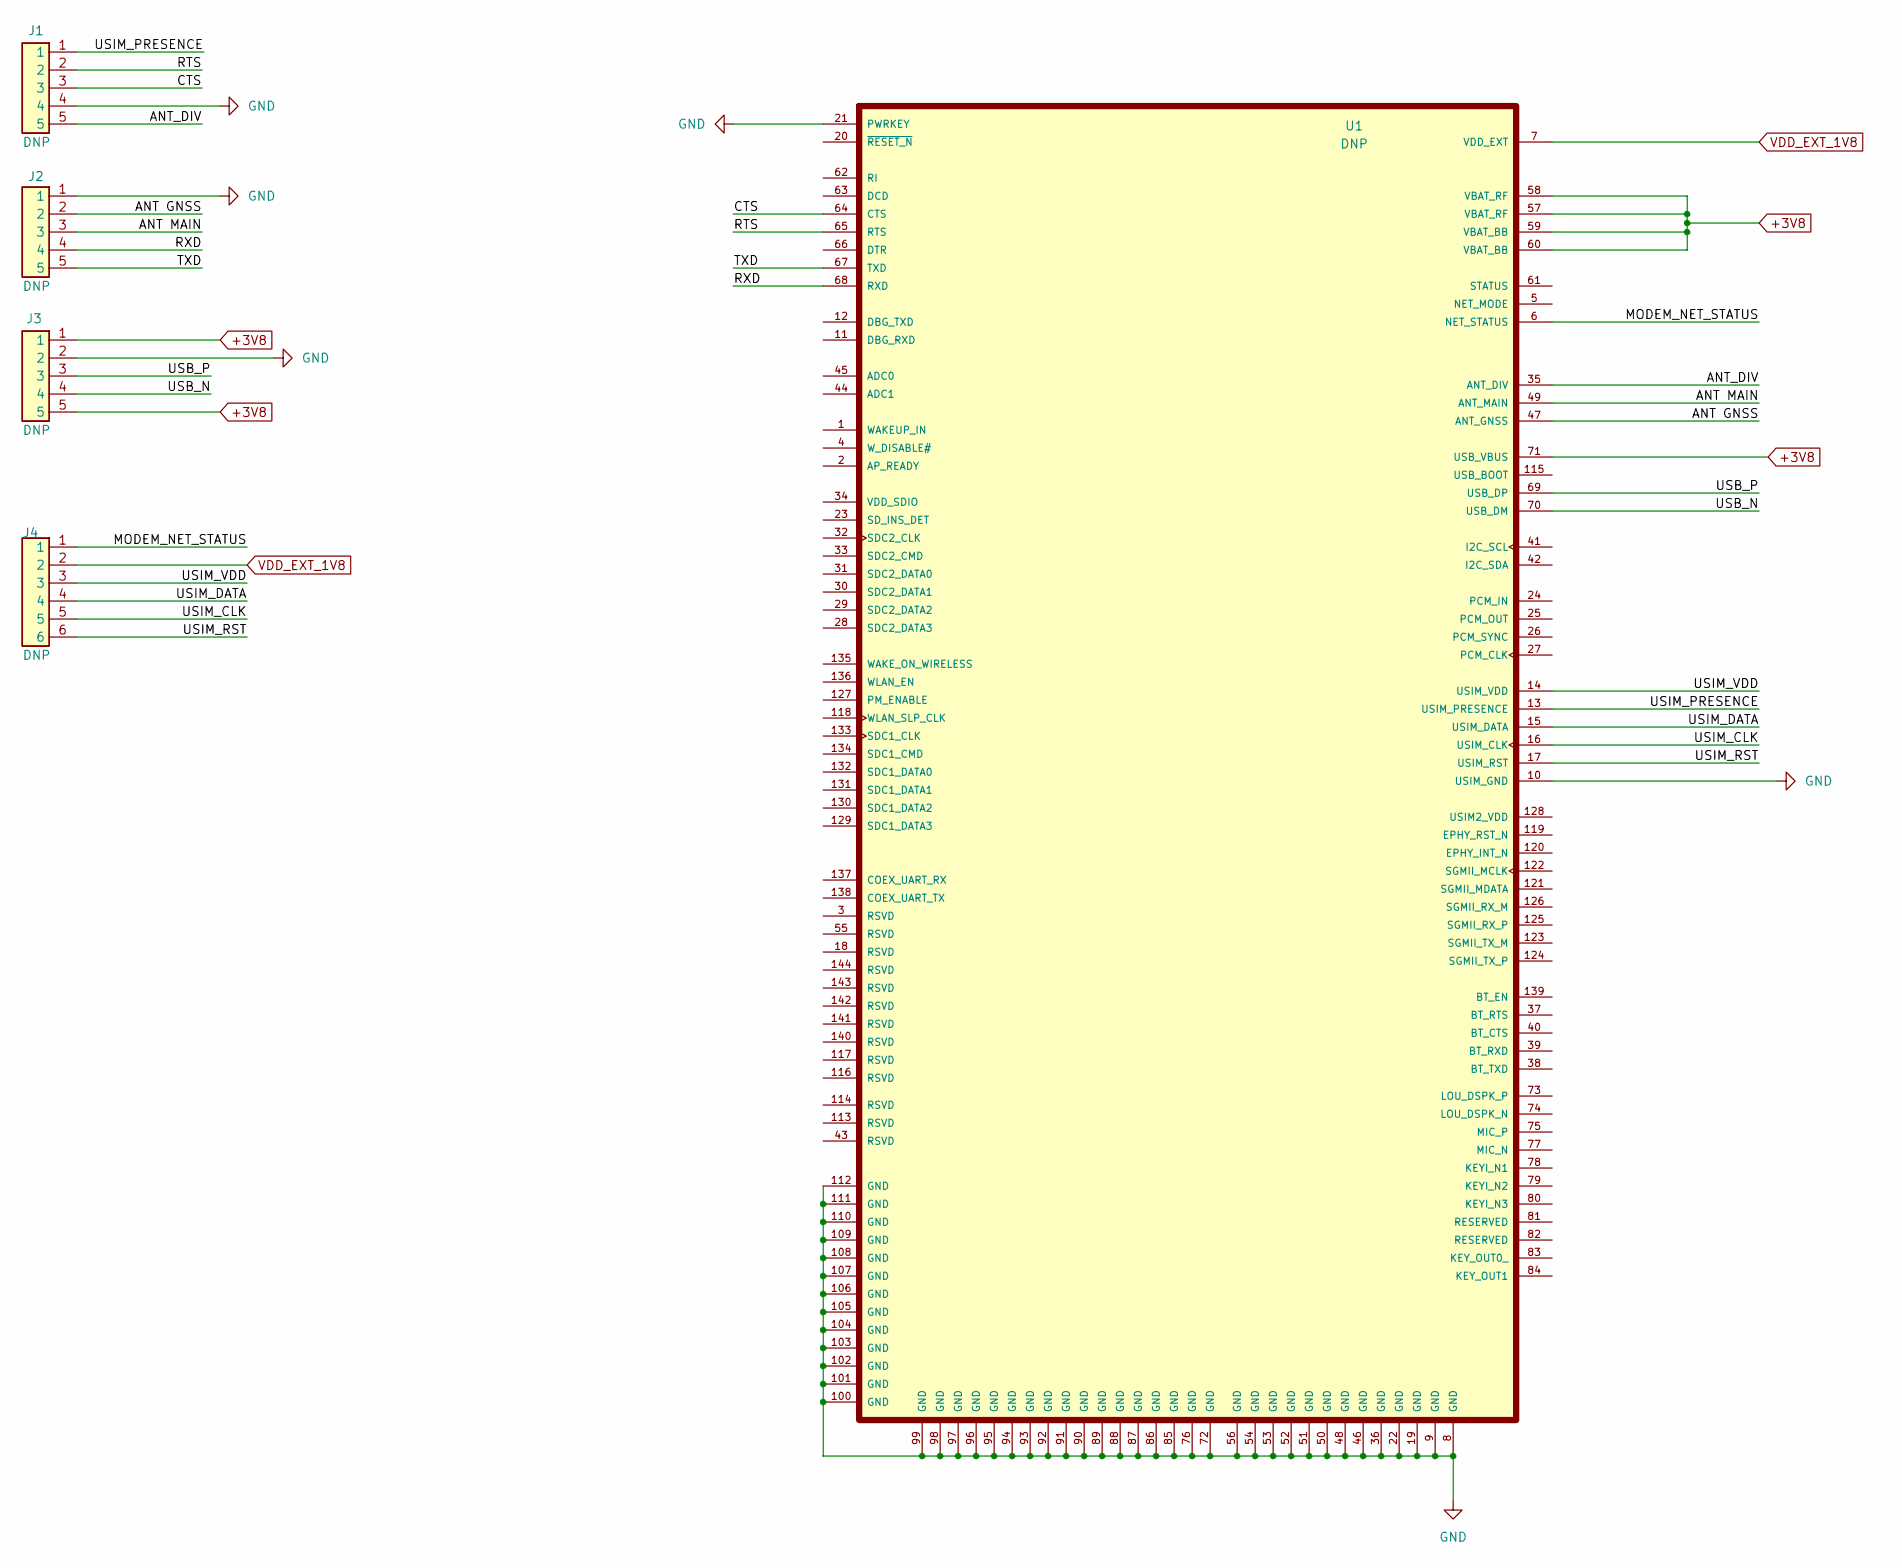
[picture p102: schematic GSM_Adapter_Board_V1.0.kicad_sch]

Parts:
J1, J2, J3: DNP; Castelled 5
J4: DNP; castelled 6
U1: DNP; GSM

Connections:
+3V8: J3.1, J3.5, U1.57 (VBAT_RF), U1.58 (VBAT_RF), U1.59 (VBAT_BB), U1.60 (VBAT_BB), U1.71 (USB_VBUS)
/ANT GNSS: J2.2, U1.47 (ANT_GNSS)
/ANT MAIN: J2.3, U1.49 (ANT_MAIN)
/ANT_DIV: J1.5, U1.35 (ANT_DIV)
/CTS: J1.3, U1.64 (CTS)
/MODEM_NET_STATUS: J4.1, U1.6 (NET_STATUS)
/RTS: J1.2, U1.65 (RTS)
/RXD: J2.4, U1.68 (RXD)
/TXD: J2.5, U1.67 (TXD)
/USB_N: J3.4, U1.70 (USB_DM)
/USB_P: J3.3, U1.69 (USB_DP)
/USIM_CLK: J4.5, U1.16 (USIM_CLK)
/USIM_DATA: J4.4, U1.15 (USIM_DATA)
/USIM_PRESENCE: J1.1, U1.13 (USIM_PRESENCE)
/USIM_RST: J4.6, U1.17 (USIM_RST)
/USIM_VDD: J4.3, U1.14 (USIM_VDD)
GND: J1.4, J2.1, J3.2, U1.8 (GND), U1.9 (GND), U1.10 (USIM_GND), U1.19 (GND), U1.21 (PWRKEY), U1.22 (GND), U1.36 (GND), U1.46 (GND), U1.48 (GND), U1.50 (GND), U1.51 (GND), U1.52 (GND), U1.53 (GND), U1.54 (GND), U1.56 (GND), U1.72 (GND), U1.76 (GND), U1.85 (GND), U1.86 (GND), U1.87 (GND), U1.88 (GND), U1.89 (GND), U1.90 (GND), U1.91 (GND), U1.92 (GND), U1.93 (GND), U1.94 (GND), U1.95 (GND), U1.96 (GND), U1.97 (GND), U1.98 (GND), U1.99 (GND), U1.100 (GND), U1.101 (GND), U1.102 (GND), U1.103 (GND), U1.104 (GND), U1.105 (GND), U1.106 (GND), U1.107 (GND), U1.108 (GND), U1.109 (GND), U1.110 (GND), U1.111 (GND), U1.112 (GND)
VDD_EXT_1V8: J4.2, U1.7 (VDD_EXT)

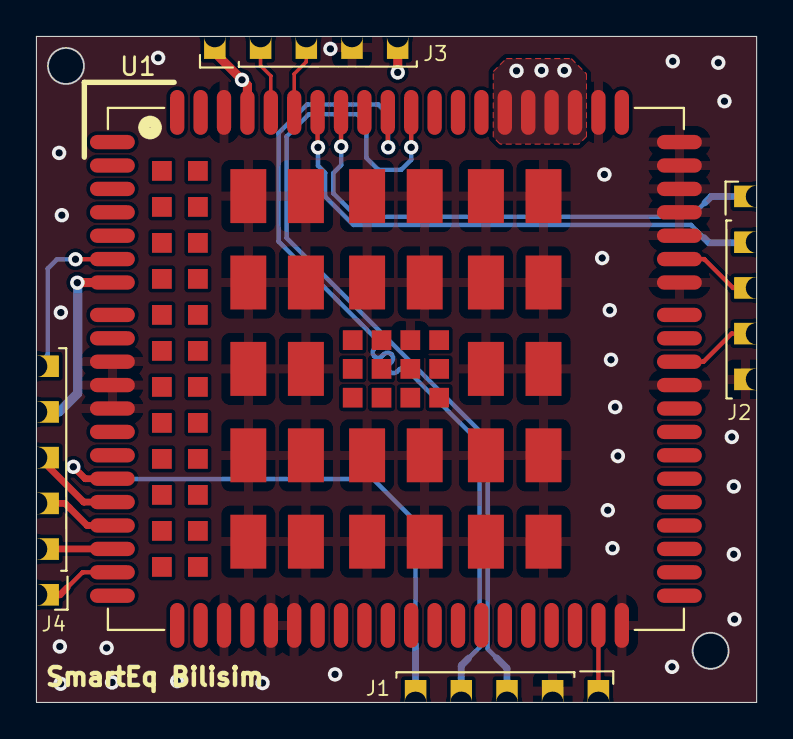
[picture p103: board GSM_Adapter_Board_V1.0.kicad_pcb from above]

Board: 2 copper layers, 40.0 x 37.0 mm, 5 parts (0 on the bottom side), 18 nets.
