ihsanakyrk/Eski-Versionlar-Ve-Siparisler/[01.2024]/GSM_SMA_V1.0_(Ocak_2024)/GSM_PCBSMAFRAHT.kicad_pcb

## KiCad design [01.2024]/GSM_SMA_V1.0_(Ocak_2024)/GSM_PCBSMAFRAHT.kicad_pcb (2025-09-02)

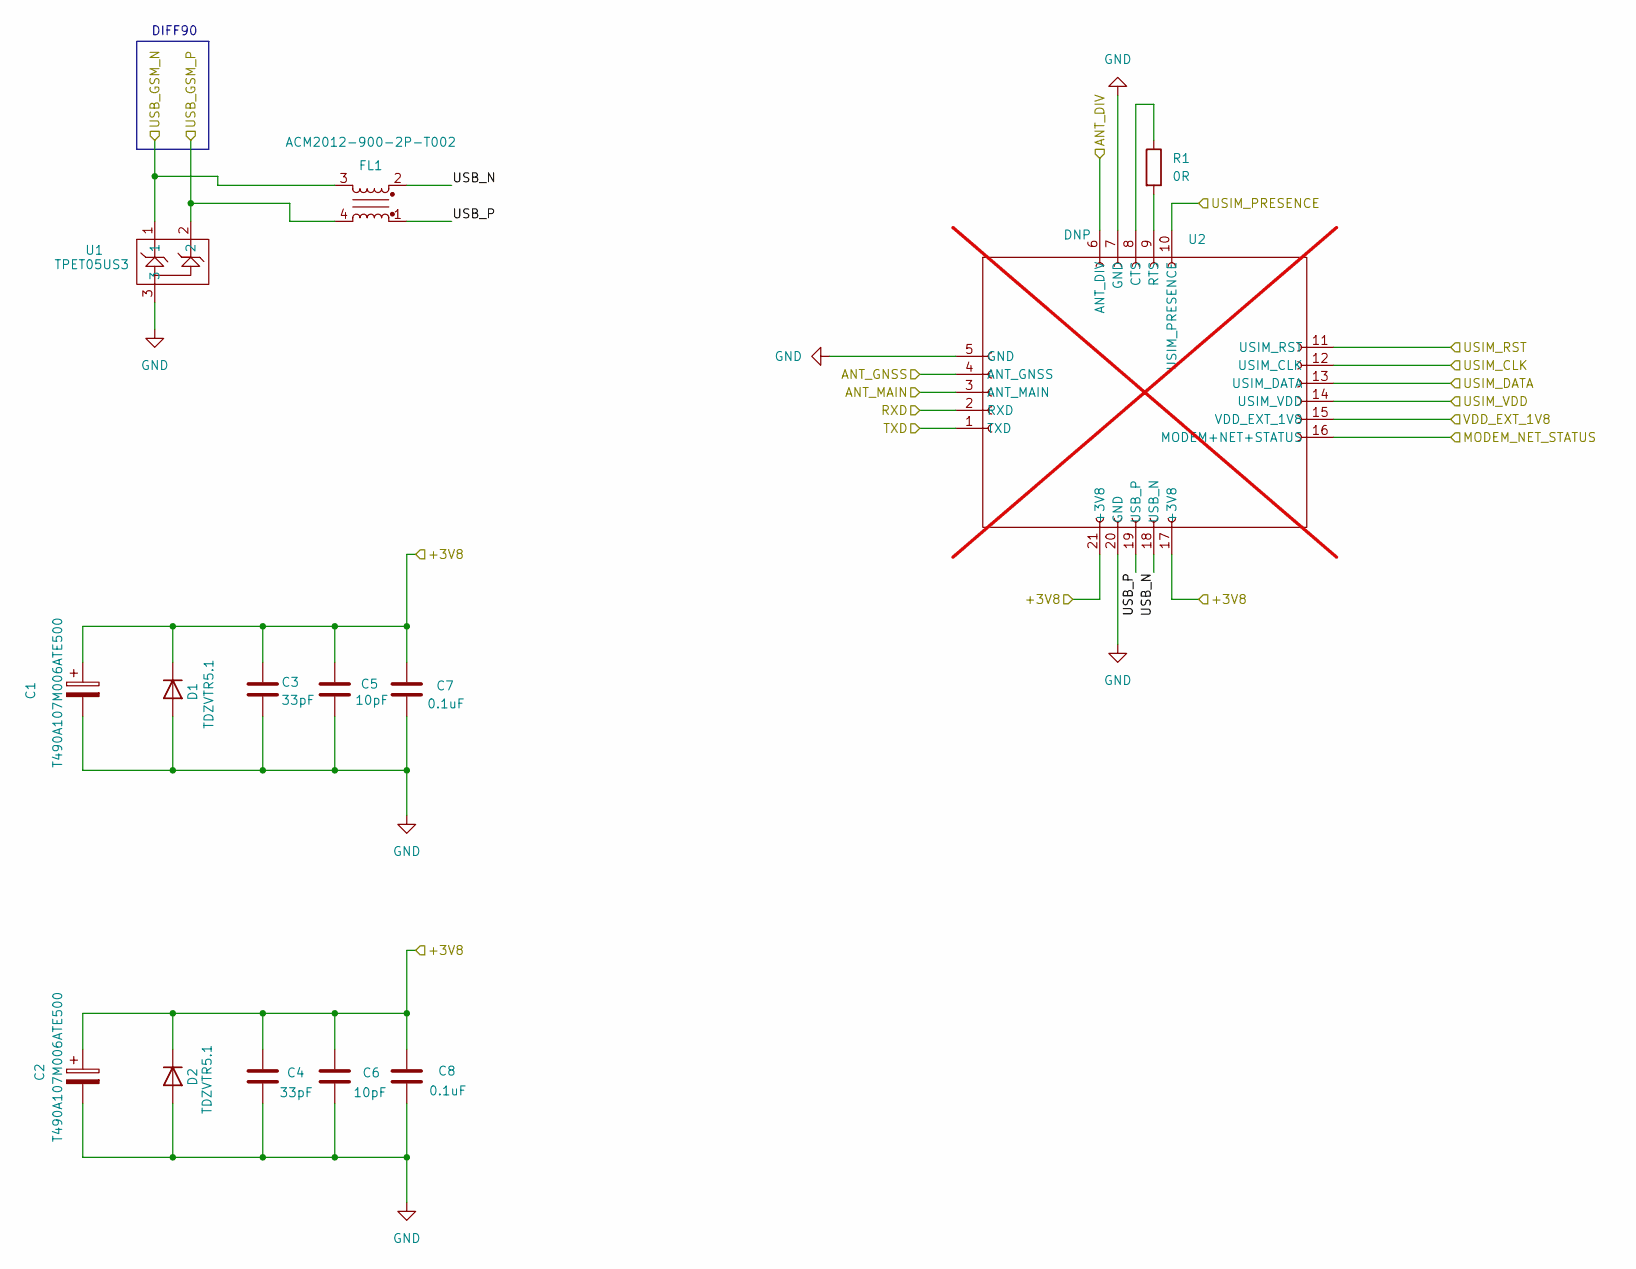
[picture p104: schematic GSM_Castelled.kicad_sch]

Parts:
C1, C2: T490A107M006ATE500; T490A; MPN T490A107M006ATE500
C3, C4: 33pF; C_0603_1608Metric
C5, C6: 10pF; C_0603_1608Metric
C7, C8: 0.1uF; C_0603_1608Metric
D1, D2: TDZVTR5.1; MPN TDZVTR5.1
FL1: ACM2012-900-2P-T002; MPN ACM2012-900-2P-T002
R1: 0R; R_0603_1608Metric
U1: TPET05US3; MPN TPET05US3
U2: DNP; GSM_Castelled; not fitted

Connections:
/91228-3002/MODEM_NET_STATUS: U2.16 (MODEM+NET+STATUS); also elsewhere on the board
/91228-3002/RXD: U2.2 (RXD); also elsewhere on the board
/91228-3002/TXD: U2.1 (TXD); also elsewhere on the board
/91228-3002/USB_GSM_N: FL1.3, U1.1; also elsewhere on the board
/91228-3002/USB_GSM_P: FL1.4, U1.2; also elsewhere on the board
/91228-3002/USIM_CLK: U2.12 (USIM_CLK); also elsewhere on the board
/91228-3002/USIM_DATA: U2.13 (USIM_DATA); also elsewhere on the board
/91228-3002/USIM_PRESENCE: U2.10 (USIM_PRESENCE); also elsewhere on the board
/91228-3002/USIM_RST: U2.11 (USIM_RST); also elsewhere on the board
/91228-3002/USIM_VDD: U2.14 (USIM_VDD); also elsewhere on the board
/91228-3002/VDD_EXT_1V8: U2.15 (VDD_EXT_1V8); also elsewhere on the board
/GSM_Castelled/+3V8: C1.1, C2.1, C3.1, C4.1, C5.1, C6.1, C7.1, C8.1, D1.1 (K), D2.1 (K), U2.17 (+3V8), U2.21 (+3V8); also elsewhere on the board
/GSM_Castelled/ANT_DIV: U2.6 (ANT_DIV); also elsewhere on the board
/GSM_Castelled/ANT_GNSS: U2.4 (ANT_GNSS); also elsewhere on the board
/GSM_Castelled/ANT_MAIN: U2.3 (ANT_MAIN); also elsewhere on the board
/GSM_Castelled/USB_N: FL1.2, U2.18 (USB_N)
/GSM_Castelled/USB_P: FL1.1, U2.19 (USB_P)
GND: C1.2, C2.2, C3.2, C4.2, C5.2, C6.2, C7.2, C8.2, D1.2 (A), D2.2 (A), U1.3, U2.5 (GND), U2.7 (GND), U2.20 (GND); also elsewhere on the board
unnamed: R1.1, U2.8 (CTS)
unnamed: R1.2, U2.9 (RTS)

Notes on the sheet:
DIFF90

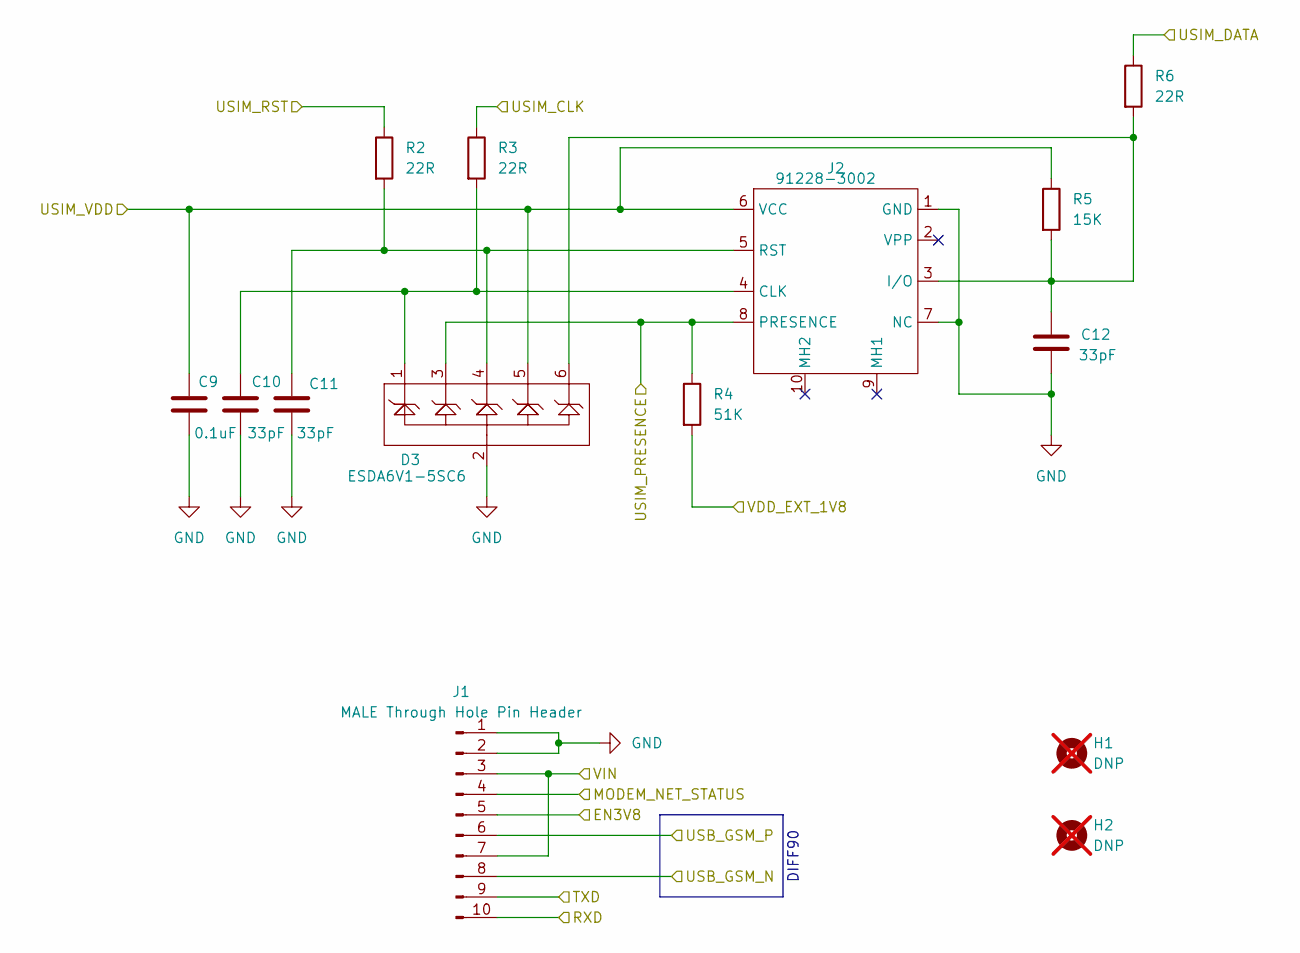
[picture p105: schematic 91228-3002.kicad_sch]

Parts:
C9: 0.1uF; C_0603_1608Metric
C10, C11, C12: 33pF; C_0603_1608Metric
D3: ESDA6V1-5SC6; MPN ESDA6V1-5SC6
H1, H2: DNP; Screw_Terminal_1x1; not fitted
J1: MALE Through Hole Pin Header; PinHeader_2x05_P2.00mm_Vertical
J2: 91228-3002; 912283002; MPN 91228-3002
R2, R3, R6: 22R; R_0603_1608Metric
R4: 51K; R_0603_1608Metric
R5: 15K; R_0603_1608Metric

Connections:
/91228-3002/EN3V8: J1.5; also elsewhere on the board
/91228-3002/MODEM_NET_STATUS: J1.4; also elsewhere on the board
/91228-3002/RXD: J1.10; also elsewhere on the board
/91228-3002/TXD: J1.9; also elsewhere on the board
/91228-3002/USB_GSM_N: J1.8; also elsewhere on the board
/91228-3002/USB_GSM_P: J1.6; also elsewhere on the board
/91228-3002/USIM_CLK: R3.1; also elsewhere on the board
/91228-3002/USIM_DATA: R6.1; also elsewhere on the board
/91228-3002/USIM_PRESENCE: D3.3, J2.8 (PRESENCE), R4.1; also elsewhere on the board
/91228-3002/USIM_RST: R2.1; also elsewhere on the board
/91228-3002/USIM_VDD: C9.1, D3.5, J2.6 (VCC), R5.1; also elsewhere on the board
/91228-3002/VDD_EXT_1V8: R4.2; also elsewhere on the board
/91228-3002/VIN: J1.3, J1.7; also elsewhere on the board
GND: C9.2, C10.2, C11.2, C12.2, D3.2, J1.1, J1.2, J2.1 (GND), J2.7 (NC); also elsewhere on the board
unnamed: C10.1, D3.1, J2.4 (CLK), R3.2
unnamed: C12.1, D3.6, J2.3 (I/O), R5.2, R6.2
unnamed: C11.1, D3.4, J2.5 (RST), R2.2

Notes on the sheet:
DIFF90

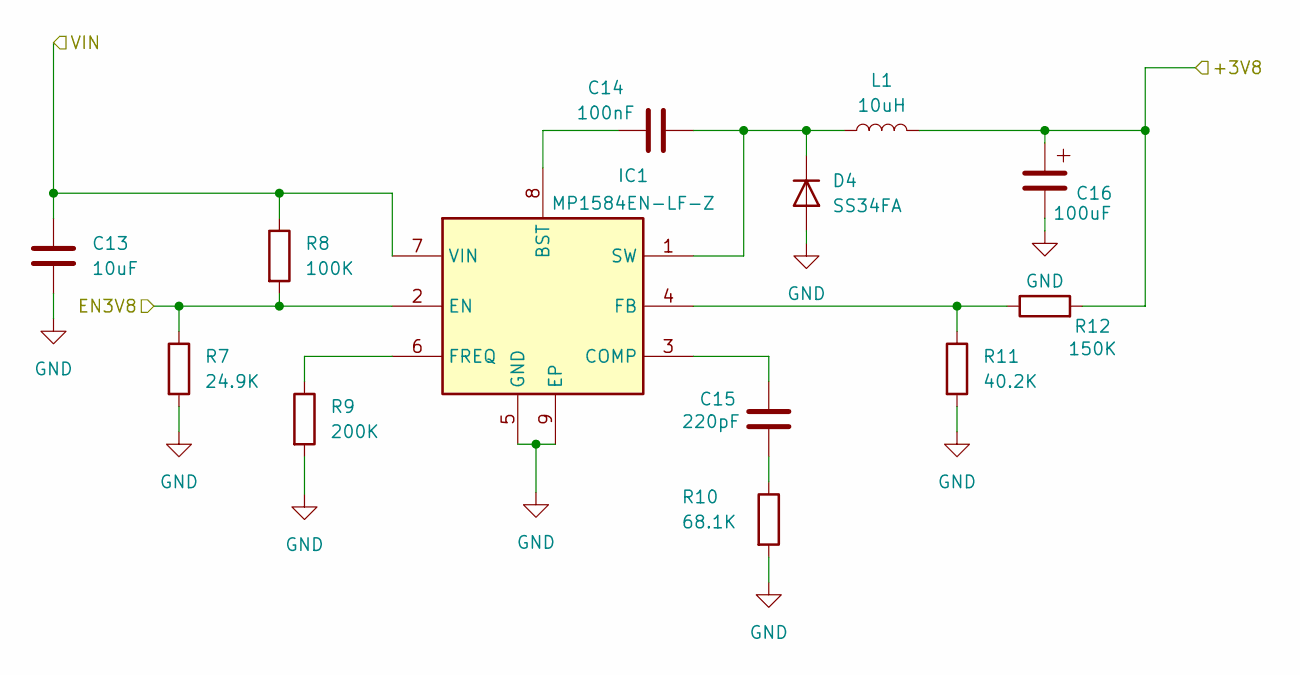
[picture p106: schematic Power Unıt.kicad_sch]

Parts:
C13: 10uF; C_1206_3216Metric
C14: 100nF; C_0603_1608Metric
C15: 220pF; C_0603_1608Metric
C16: 100uF; CP_Elec_5x5.4; MPN UWR1A101MCL1GB
D4: SS34FA; SS4FA; MPN SS34FA
IC1: MP1584EN-LF-Z; Manufacturer_Part_Number MP1584EN
L1: 10uH; L_7.3x7.3_H3.5; MPN CDRH74NP-100MC-B
R7: 24.9K; R_0603_1608Metric
R8: 100K; R_0603_1608Metric
R9: 200K; R_0603_1608Metric
R10: 68.1K; R_0603_1608Metric
R11: 40.2K; R_0603_1608Metric
R12: 150K; R_0603_1608Metric

Connections:
/91228-3002/EN3V8: IC1.2 (EN), R7.1, R8.2; also elsewhere on the board
/91228-3002/VIN: C13.1, IC1.7 (VIN), R8.1; also elsewhere on the board
/GSM_Castelled/+3V8: C16.1, L1.2, R12.2; also elsewhere on the board
GND: C13.2, C16.2, D4.2 (A), IC1.5 (GND), IC1.9 (EP), R7.2, R9.2, R10.2, R11.2; also elsewhere on the board
unnamed: C15.2, R10.1
unnamed: C14.2, D4.1 (K), IC1.1 (SW), L1.1
unnamed: C14.1, IC1.8 (BST)
unnamed: C15.1, IC1.3 (COMP)
unnamed: IC1.4 (FB), R11.1, R12.1
unnamed: IC1.6 (FREQ), R9.1

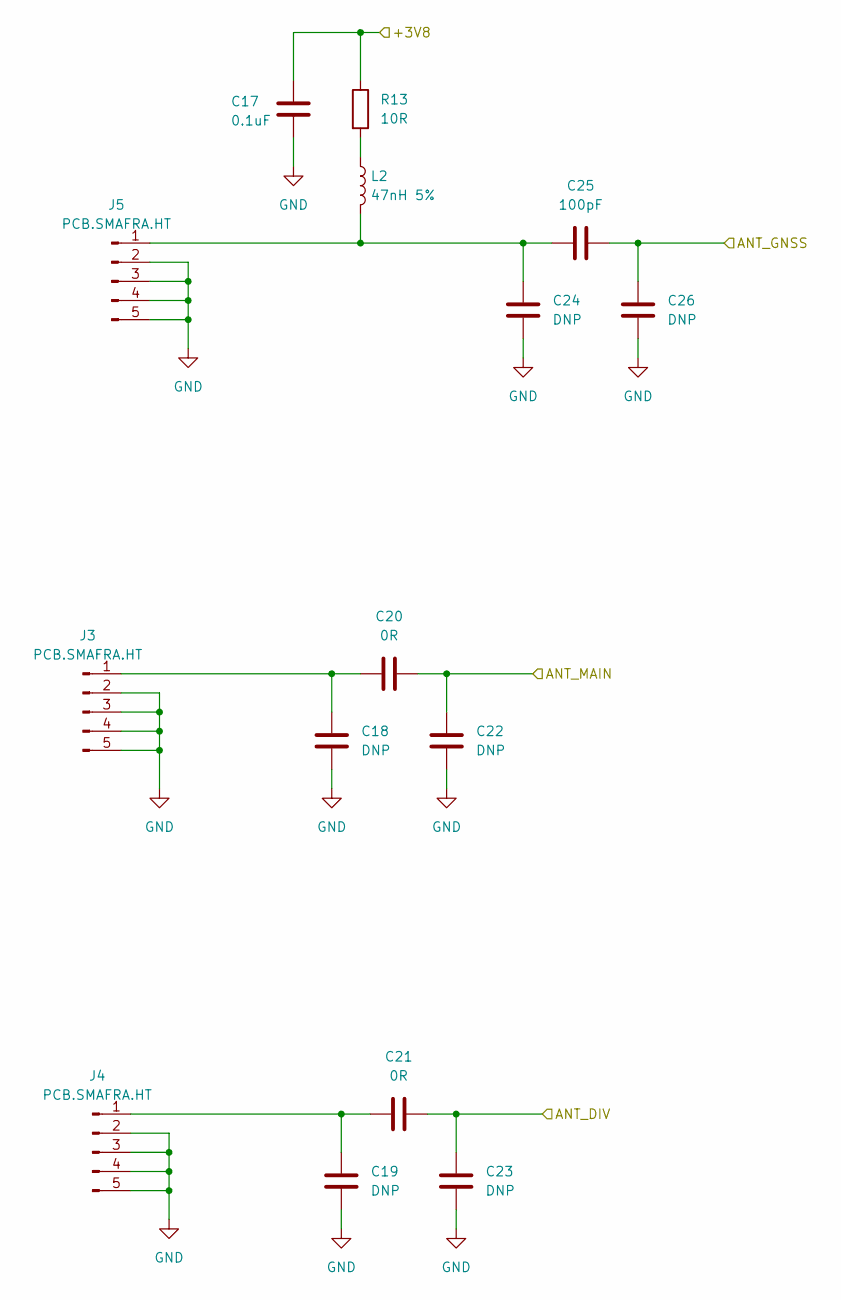
[picture p107: schematic RF Antenna Connector.kicad_sch]

Parts:
C17: 0.1uF; C_0603_1608Metric
C18, C19, C22, C23, C24, C26: DNP; C_0603_1608Metric
C20, C21: 0R; C_0603_1608Metric
C25: 100pF; C_0603_1608Metric
J3, J4, J5: PCB.SMAFRA.HT
L2: 47nH 5%; L_0402_1005Metric; MPN LQG15HS47NJ02D
R13: 10R; R_0603_1608Metric

Connections:
/GSM_Castelled/+3V8: C17.1, R13.1; also elsewhere on the board
/GSM_Castelled/ANT_DIV: C20.2, C22.1; also elsewhere on the board
/GSM_Castelled/ANT_GNSS: C25.2, C26.1; also elsewhere on the board
/GSM_Castelled/ANT_MAIN: C21.2, C23.1; also elsewhere on the board
GND: C17.2, C18.1, C19.1, C22.2, C23.2, C24.1, C26.2, J3.2, J3.3, J3.4, J3.5, J4.2, J4.3, J4.4, J4.5, J5.2, J5.3, J5.4, J5.5; also elsewhere on the board
unnamed: C18.2, C20.1, J3.1
unnamed: C19.2, C21.1, J4.1
unnamed: C24.2, C25.1, J5.1, L2.2
unnamed: L2.1, R13.2

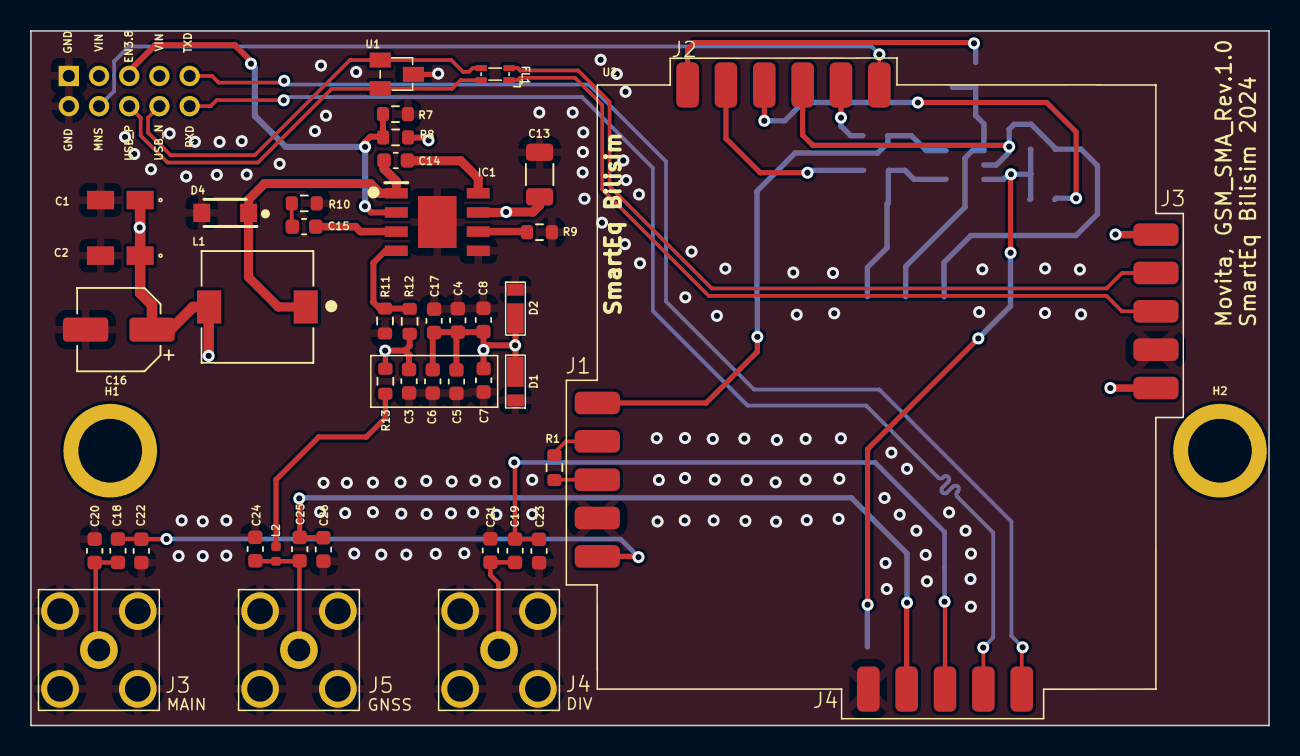
[picture p108: board GSM_PCBSMAFRAHT.kicad_pcb from above]

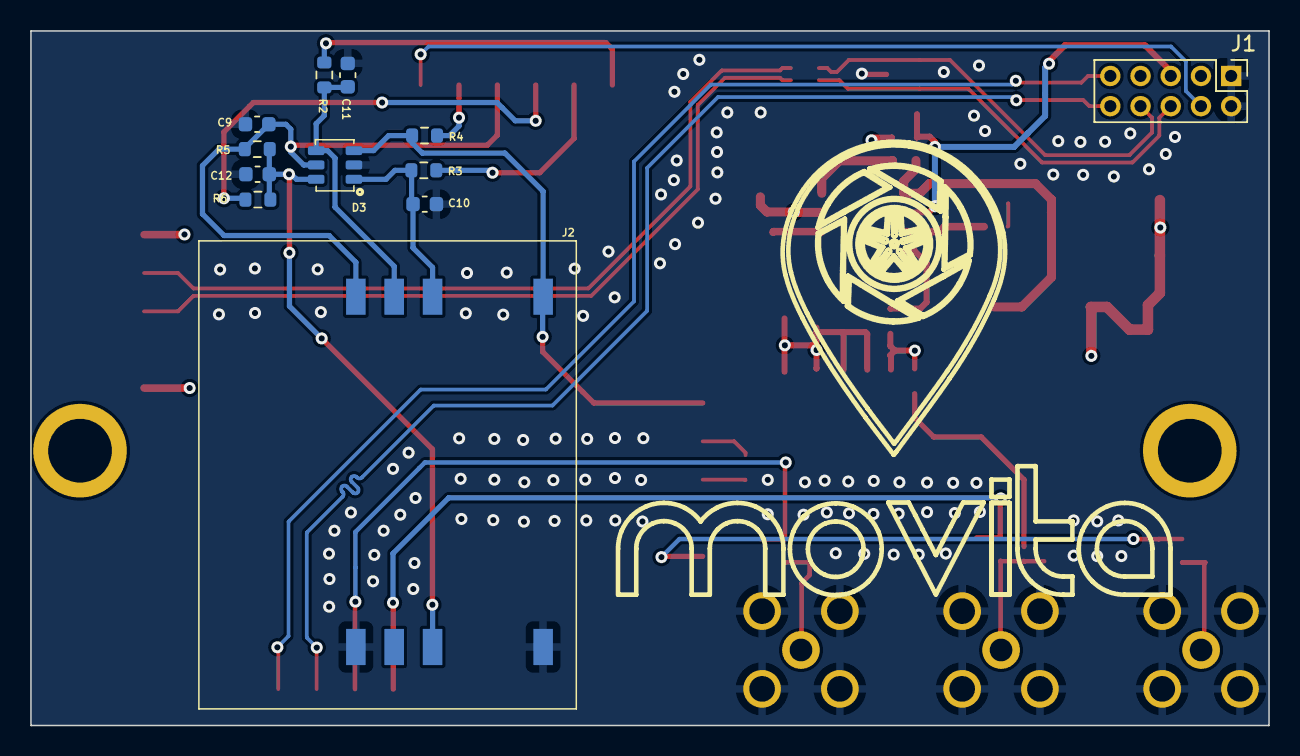
[picture p109: board GSM_PCBSMAFRAHT.kicad_pcb from below]

Board: 4 copper layers, 82.0 x 46.0 mm, 56 parts (12 on the bottom side), 35 nets.
