ihsanakyrk/Eski-Versionlar-Ve-Siparisler/[11.2023]/IMX415_V1.0_(Kasım_2023)/IMX415_V1.0/Camera IMX_415.kicad_pcb

## KiCad design [11.2023]/IMX415_V1.0_(Kasım_2023)/IMX415_V1.0/Camera IMX_415.kicad_pcb (2025-09-01)

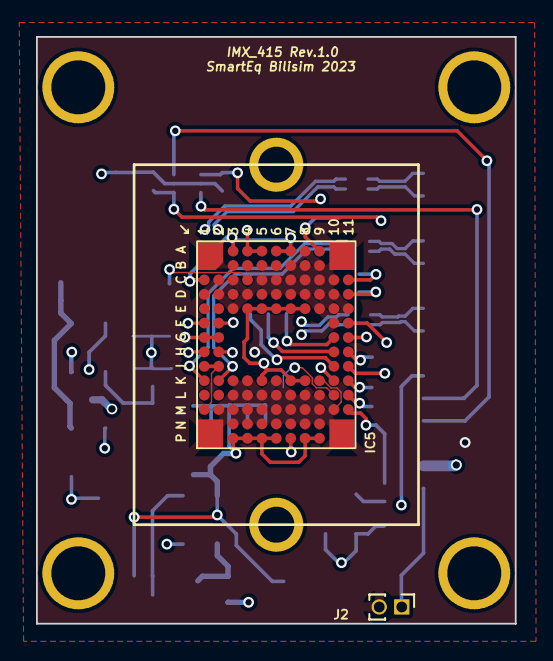
[picture p110: board Camera IMX_415.kicad_pcb from above]

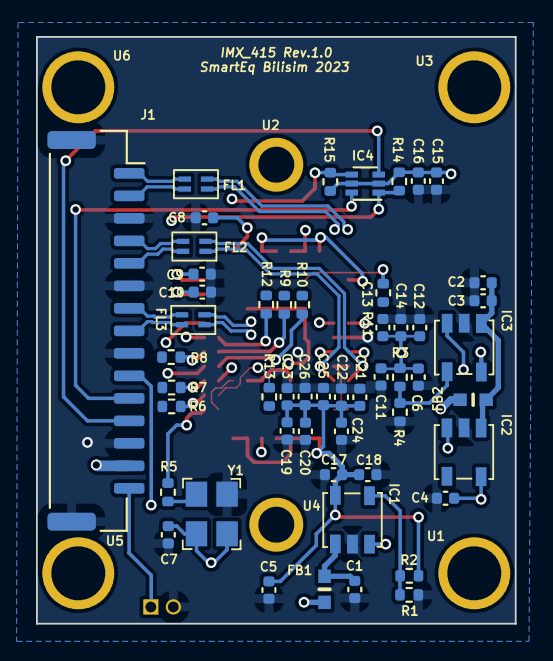
[picture p111: board Camera IMX_415.kicad_pcb from below]

Board: 4 copper layers, 26.6 x 32.6 mm, 60 parts (52 on the bottom side), 40 nets.

Parts:
C1, C2, C3, C4, C5, C6, C7, C8, C12, C16, C22, C24, C26: 1uF; C_0402_1005Metric
C9: 10uF; C_0402_1005Metric
C10, C14, C18, C20: 4.7uF; C_0402_1005Metric
C11, C13, C17, C19, C23, C25: 0.1uF; C_0402_1005Metric
C15, C21: 0.01uF; C_0402_1005Metric
FB1, FB2: 600@100MHz; BLM18AG601SN1D
FL1, FL2, FL3: DLP11SN900HL2L
IC1, IC2, IC3: SOT-25-5; AP7331
IC4: SOT-563; DMG1024UV - 7
IC5: IMX_415
J1: Con_15Ways_1.25mm; JST_1x15-1MP_P1.25mm_Horizontal
J2: Con_2Ways_1.25mm
R1: 1.75K; R_0402_1005Metric
R2, R4: 1K; R_0402_1005Metric
R3: 6.25K; R_0402_1005Metric
R5: 22R; R_0402_1005Metric
R6, R7, R8, R9, R10, R11, R12, R13: DNP; R_0402_1005Metric
R14, R15: 2.2K; R_0402_1005Metric
U1, U2, U3, U4, U5, U6: DNP; Screw_Terminal_1x1
Y1: 24MHz; X322524MOB4SI

Connections:
+1V1: C5.1, C17.2, C18.2, C19.2, C20.2, C21.2, C22.2, C23.2, C24.2, C25.2, C26.2, IC1.5 (OUT), IC5.A3 (VDDLSC), IC5.A6 (VDDLSC), IC5.A7 (VDDLCN), IC5.C1 (VDDLIF), IC5.F11 (VDDLSC), IC5.P3 (VDDLIF), IC5.P4 (VDDLPL2), IC5.P5 (VDDLPL1), IC5.P6 (VDDLSC), IC5.P8 (VDDLSC), IC5.P9 (VDDLCN), R1.1
+1V8: C4.1, C7.1, C15.2, C16.2, IC2.5 (OUT), IC4.2 (G2), IC4.5 (G1), IC5.A4 (VDDMIO), IC5.A5 (VDDMIO), IC5.G11 (VDDMIO), IC5.P7 (VDDMIO), R14.1, R15.1, Y1.1 (TRI-STATE), Y1.4 (VDD)
+2V9: C6.1, C11.2, C12.2, C13.2, C14.2, IC3.5 (OUT), IC5.E4 (VDDHAN), IC5.E5 (VDDHAN), IC5.E6 (VDDHPX), IC5.E7 (VDDHPX), IC5.E8 (VDDHPX), IC5.K5 (VDDHAN), IC5.K7 (VDDHPX), IC5.K8 (VDDHPX), R3.1
+3V3: FB1.1, FB2.1, J1.14
/IMX415/CON_CSI_CLK_N: FL3.1, J1.7
/IMX415/CON_CSI_CLK_P: FL3.4, J1.8
/IMX415/CON_CSI_D0_N: FL1.1, J1.1
/IMX415/CON_CSI_D0_P: FL1.4, J1.2
/IMX415/CON_CSI_D1_N: FL2.1, J1.4
/IMX415/CON_CSI_D1_P: FL2.4, J1.5
/IMX415/CSI_CLKN: FL3.2, IC5.H1 (DCKN)
/IMX415/CSI_CLKP: FL3.3, IC5.H2 (DCKP)
/IMX415/CSI_D0N: FL1.2, IC5.F1 (DMO1N)
/IMX415/CSI_D0P: FL1.3, IC5.F2 (DMO1P)
/IMX415/CSI_D1N: FL2.2, IC5.K1 (DMO2N)
/IMX415/CSI_D1P: FL2.3, IC5.K2 (DMO2P)
/IMX415/ENABLE: IC1.3 (EN), IC2.3 (EN), IC3.3 (EN), J1.10
/IMX415/IR_CUT_GPIO: J1.15, J2.1
/IMX415/MCLK: IC5.M11 (INCK), R5.2
/IMX415/SCL: IC4.6 (D2), J1.11
/IMX415/SCL 1V8: IC4.1 (S2), IC5.K10 (SCL), R14.2
/IMX415/SDA: IC4.3 (D1), J1.12
/IMX415/SDA 1V8: IC4.4 (S1), IC5.J11 (SDA), R15.2
GND: C1.2, C2.1, C3.1, C4.2, C5.2, C6.2, C7.2, C8.2, C9.2, C10.2, C11.1, C12.1, C13.1, C14.1, C15.1, C16.1, C17.1, C18.1, C19.1, C20.1, C21.1, C22.1, C23.1, C24.1, C25.1, C26.1, IC1.2 (GND), IC2.2 (GND), IC3.2 (GND), IC5.A1 (GND), IC5.A8 (GND), IC5.A11 (GND), IC5.B3 (VSSLSC), IC5.B4 (VSSLSC), IC5.B5 (VSSLSC), IC5.B6 (VSSLSC), IC5.B7 (VSSLCN), IC5.B8 (GND), IC5.B9 (VSSHPX), IC5.C2 (VSSLSC), IC5.C3 (GND), IC5.C5 (GND), IC5.C6 (GND), IC5.C7 (GND), IC5.C8 (GND), IC5.C9 (GND), IC5.C10 (VSSHPX), IC5.D1 (VSSLSC), IC5.D2 (VSSLSC), IC5.D3 (GND), IC5.D4 (VSSHAN), IC5.D5 (VSSHPX), IC5.D6 (VSSHPX), IC5.D7 (VSSHPX), IC5.D8 (VSSHPX), IC5.D9 (GND), IC5.D10 (VSSHPX), IC5.E3 (GND), IC5.E9 (GND), IC5.E10 (GND), IC5.E11 (GND), IC5.F10 (VSSLSC), IC5.G1 (VSSLSC), IC5.G2 (VSSLSC), IC5.J1 (VSSLSC), IC5.J2 (VSSLSC), IC5.K3 (GND), IC5.K4 (GND), IC5.K6 (GND), IC5.K9 (GND), IC5.L3 (GND), IC5.L4 (GND), IC5.L5 (VSSHPX), IC5.L6 (GND), IC5.L7 (VSSHPX), IC5.L8 (VSSHPX), IC5.L9 (GND), IC5.M1 (VSSLSC), IC5.M2 (VSSLSC), IC5.M3 (GND), IC5.M4 (GND), IC5.M5 (GND), IC5.M6 (GND), IC5.M7 (GND), IC5.M8 (GND), IC5.M9 (GND), IC5.M10 (VSSLSC), IC5.N3 (VSSLSC), IC5.N4 (VSSLPL2), IC5.N5 (VSSLPL1), IC5.N6 (VSSLSC), IC5.N7 (VSSLSC), IC5.N8 (VSSLSC), IC5.N9 (VSSLCN), IC5.P1 (GND), IC5.P11 (GND), J1.3, J1.6, J1.9, J1.13, J2.2, R2.2, R4.2, Y1.2 (GND)
unnamed: IC1.4 (ADJ), R1.2, R2.1
unnamed: C1.1, FB1.2, IC1.1 (IN)
unnamed: C2.2, C3.2, FB2.2, IC2.1 (IN), IC3.1 (IN)
unnamed: IC3.4 (ADJ), R3.2, R4.1
unnamed: IC5.H10 (SLAMODE0), R9.2
unnamed: IC5.J10 (SLAMODE1), R10.2
unnamed: IC5.G10 (TENABLE), R12.1
unnamed: IC5.L10 (TOUT), R13.2
unnamed: IC5.C4 (TVMON), R11.2
unnamed: C8.1, IC5.A9 (VRHT)
unnamed: C9.1, IC5.C11 (VRLRS)
unnamed: C10.1, IC5.D11 (VRLT)
unnamed: IC5.H11 (XCLR), R8.2
unnamed: IC5.L11 (XHS), R6.2
unnamed: IC5.K11 (XVS), R7.2
unnamed: R5.1, Y1.3 (OUTPUT)
