ihsanakyrk/Eski-Versionlar-Ve-Siparisler/[11.2023]/Anchor_Wifi(Kasım_2023)/Anchor_Wifi_V1.0_(28.11.2023)/Bluetooth-Anchor _Wifi KİCAD.kicad_pcb

## KiCad design [11.2023]/Anchor_Wifi(Kasım_2023)/Anchor_Wifi_V1.0_(28.11.2023)/Bluetooth-Anchor _Wifi KİCAD.kicad_pcb (2025-09-01)

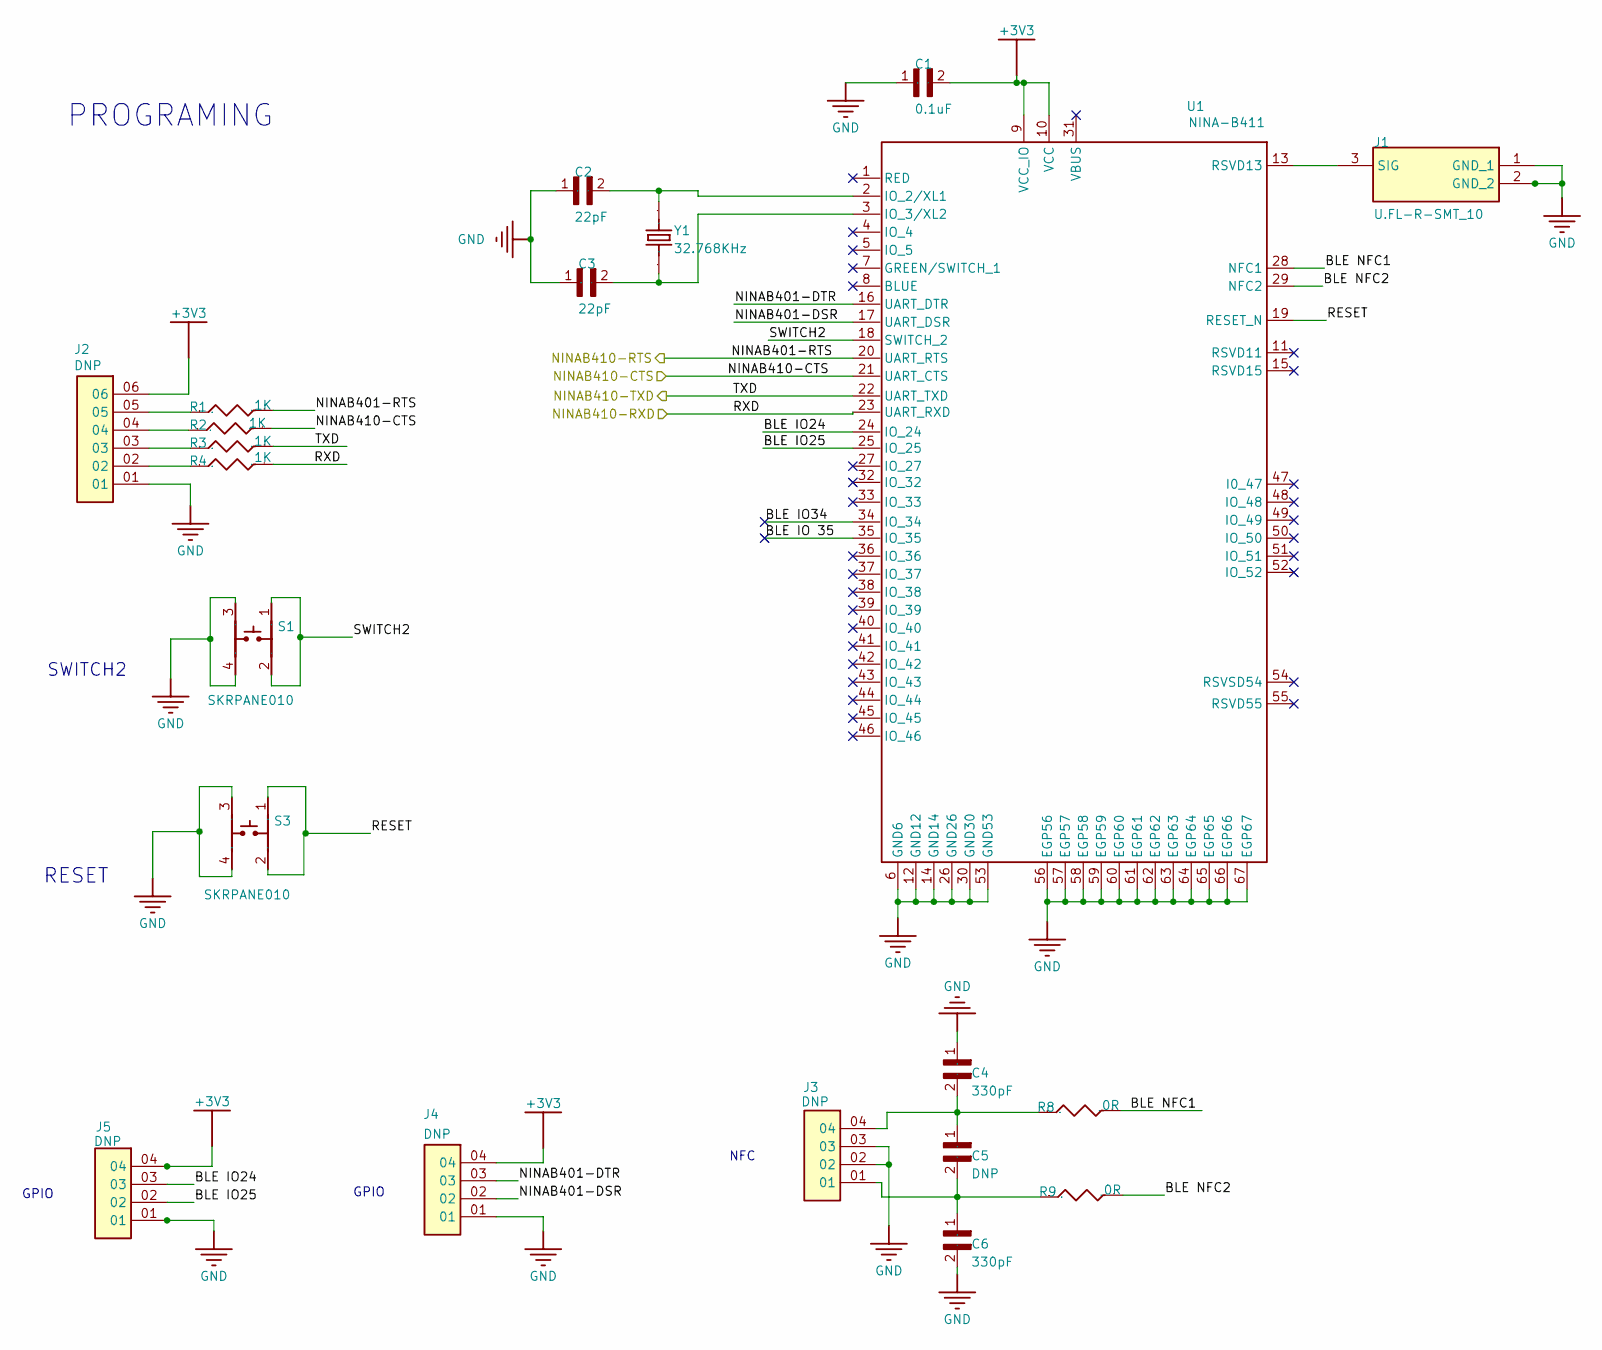
[picture p112: schematic NINA-B410.kicad_sch]

Parts:
C1: 0.1uF; C_0402
C2, C3: 22pF; C_0402
C4, C6: 330pF; C_0402
C5: DNP; C_0402
J1: U.FL-R-SMT_10; UFLRSMT10; MANUFACTURER_PART_NUMBER U.FL-R-SMT(10); MOUSER PART NUMBER 798-U.FL-R-SMT10
J2: DNP; Header_6Ways_2x54
J3, J4, J5: DNP; Header_4Ways_2x54_Male
R1, R2, R3, R4: 1K; Res_0402
R8, R9: 0R; Res_0402
S1, S3: SKRPANE010
U1: NINA-B411; NINA_LGA67R_1160X1000X223_PIN - duplicate
Y1: 32.768KHz; XTAL_ECS-3X8X

Connections:
+3V3: C1.2, J2.06, J4.04, J5.04, U1.9 (VCC_IO), U1.10 (VCC); also elsewhere on the board
BLE IO24: J5.03, U1.24 (IO_24)
BLE IO25: J5.02, U1.25 (IO_25)
BLE IO34: U1.34 (IO_34)
BLE IO 35: U1.35 (IO_35)
BLE NFC1: R8.2, U1.28 (NFC1)
BLE NFC2: R9.2, U1.29 (NFC2)
GND: C1.1, C2.1, C3.1, C4.1, C6.2, J1.1 (GND_1), J1.2 (GND_2), J2.01, J3.02, J3.03, J4.01, J5.01, S1.3, S1.4, S3.3, S3.4, U1.6 (GND6), U1.12 (GND12), U1.14 (GND14), U1.26 (GND26), U1.30 (GND30), U1.53 (GND53), U1.56 (EGP56), U1.57 (EGP57), U1.58 (EGP58), U1.59 (EGP59), U1.60 (EGP60), U1.61 (EGP61), U1.62 (EGP62), U1.63 (EGP63), U1.64 (EGP64), U1.65 (EGP65), U1.66 (EGP66), U1.67 (EGP67); also elsewhere on the board
NINAB401-DSR: J4.02, U1.17 (UART_DSR)
NINAB401-DTR: J4.03, U1.16 (UART_DTR)
NINAB401-RTS: R1.2, U1.20 (UART_RTS); also elsewhere on the board
NINAB410-CTS: R2.2, U1.21 (UART_CTS); also elsewhere on the board
NetC2_2: C2.2, U1.2 (IO_2/XL1), Y1.2
NetC3_2: C3.2, U1.3 (IO_3/XL2), Y1.1
NetC4_2: C4.2, C5.1, J3.04, R8.1
NetC6_1: C5.2, C6.1, J3.01, R9.1
NetJ1_3: J1.3 (SIG), U1.13 (RSVD13)
NetJ2_02: J2.02, R4.1
NetJ2_03: J2.03, R3.1
NetJ2_04: J2.04, R2.1
NetJ2_05: J2.05, R1.1
RESET: S3.1, S3.2, U1.19 (RESET_N)
RXD: R4.2, U1.23 (UART_RXD); also elsewhere on the board
SWITCH2: S1.1, S1.2, U1.18 (SWITCH_2)
TXD: R3.2, U1.22 (UART_TXD); also elsewhere on the board

Notes on the sheet:
GPIO
RESET
NFC
SWITCH2
PROGRAMING
