ihsanakyrk/Eski-Versionlar-Ve-Siparisler/[11.2023]/Anchor_Wifi(Kasım_2023)/Anchor_Wifi_V1.0_(28.11.2023)/Bluetooth-Anchor _Wifi KİCAD.kicad_pcb

## KiCad design [11.2023]/Anchor_Wifi(Kasım_2023)/Anchor_Wifi_V1.0_(28.11.2023)/Bluetooth-Anchor _Wifi KİCAD.kicad_pcb (continued)

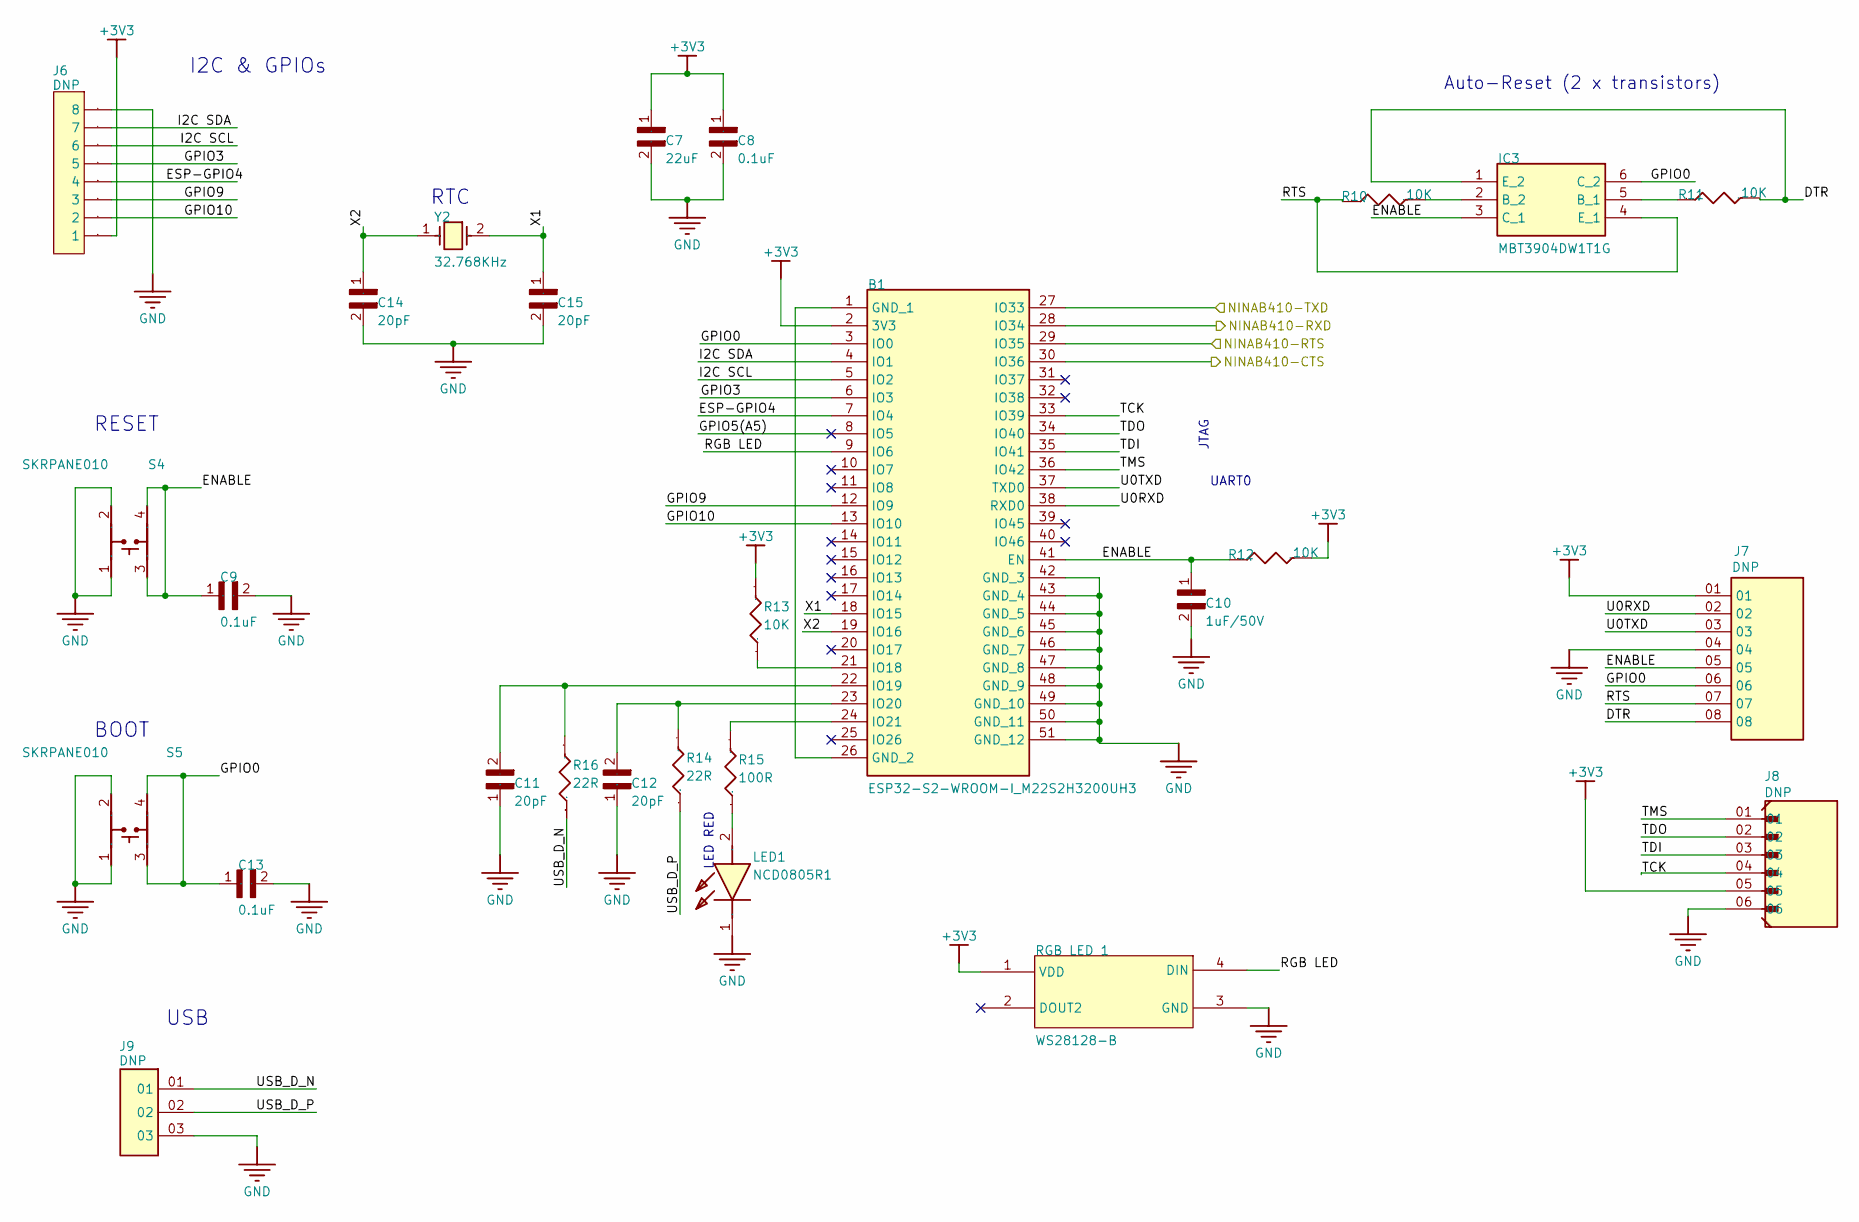
[picture p113: schematic ESP32.kicad_sch]

Parts:
B1: ESP32-S2-WROOM-I_M22S2H3200UH3; ESP32S2WROOMIM22S2H3200UH3Q0; MANUFACTURER_PART_NUMBER ESP32-S2-WROOM-I(M22S2H3200UH3Q0); MOUSER PART NUMBER 356-ESP32S2WRMI320UH
C7: 22uF; C_0402
C8, C9, C13: 0.1uF; C_0402
C10: 1uF/50V; C_0402
C11, C12, C14, C15: 20pF; C_0402
IC3: MBT3904DW1T1G; MANUFACTURER_PART_NUMBER MBT3904DW1T1G; MOUSER PART NUMBER 863-MBT3904DW1T1G
J6: DNP; Header_8ways_2x54
J7: DNP; 2x54 Header 8 pin
J8: DNP; Header_1x6_2_54
J9: DNP; Header_3Ways_2x54
LED1: NCD0805R1; MANUFACTURER_PART_NUMBER NCD0805R1; MOUSER PART NUMBER *
R10, R11, R12, R13: 10K; Res_0402
R14, R16: 22R; Res_0402
R15: 100R; Res_0402
RGB LED 1: WS28128-B
S4, S5: SKRPANE010
Y2: 32.768KHz; XTAL_ECS-3X8X

Connections:
+3V3: B1.2 (3V3), C7.1, C8.1, J6.1, J7.01, J8.05, R12.2, R13.2, RGB LED 1.1 (VDD); also elsewhere on the board
DTR: IC3.1 (E_2), J7.08, R11.2
ENABLE: B1.41 (EN), C9.1, C10.1, IC3.3 (C_1), J7.05, R12.1, S4.3, S4.4
ESP-GPIO4: B1.7 (IO4), J6.4
GND: B1.42 (GND_3), B1.43 (GND_4), B1.44 (GND_5), B1.45 (GND_6), B1.46 (GND_7), B1.47 (GND_8), B1.48 (GND_9), B1.49 (GND_10), B1.50 (GND_11), B1.51 (GND_12), C7.2, C8.2, C9.2, C10.2, C11.1, C12.1, C13.2, C14.2, C15.2, J6.8, J7.04, J8.06, J9.03, LED1.1 (K), RGB LED 1.3 (GND), S4.1, S4.2, S5.1, S5.2; also elsewhere on the board
GPIO0: B1.3 (IO0), C13.1, IC3.6 (C_2), J7.06, S5.3, S5.4
GPIO3: B1.6 (IO3), J6.5
GPIO5(A5): B1.8 (IO5)
GPIO9: B1.12 (IO9), J6.3
GPIO10: B1.13 (IO10), J6.2
I2C SCL: B1.5 (IO2), J6.6
I2C SDA: B1.4 (IO1), J6.7
NINAB401-RTS: B1.29 (IO35); also elsewhere on the board
NINAB410-CTS: B1.30 (IO36); also elsewhere on the board
NetB1_1: B1.1 (GND_1), B1.26 (GND_2)
NetB1_21: B1.21 (IO18), R13.1
NetB1_22: B1.22 (IO19), C11.2, R16.2
NetB1_23: B1.23 (IO20), C12.2, R14.2
NetB1_24: B1.24 (IO21), R15.2
NetD1_2: LED1.2 (A), R15.1
NetR10_2: IC3.2 (B_2), R10.2
NetR11_1: IC3.5 (B_1), R11.1
RGB LED: B1.9 (IO6), RGB LED 1.4 (DIN)
RTS: IC3.4 (E_1), J7.07, R10.1
RXD: B1.28 (IO34); also elsewhere on the board
TCK: B1.33 (IO39), J8.04
TDI: B1.35 (IO41), J8.03
TDO: B1.34 (IO40), J8.02
TMS: B1.36 (IO42), J8.01
TXD: B1.27 (IO33); also elsewhere on the board
U0RXD: B1.38 (RXD0), J7.02
U0TXD: B1.37 (TXD0), J7.03
USB_D_N: J9.01, R16.1
USB_D_P: J9.02, R14.1
X1: B1.18 (IO15), C15.1, Y2.2
X2: B1.19 (IO16), C14.1, Y2.1

Notes on the sheet:
RESET
USB
Auto-Reset (2 x transistors)
LED RED
UART0
RTC
I2C & GPIOs
JTAG
BOOT

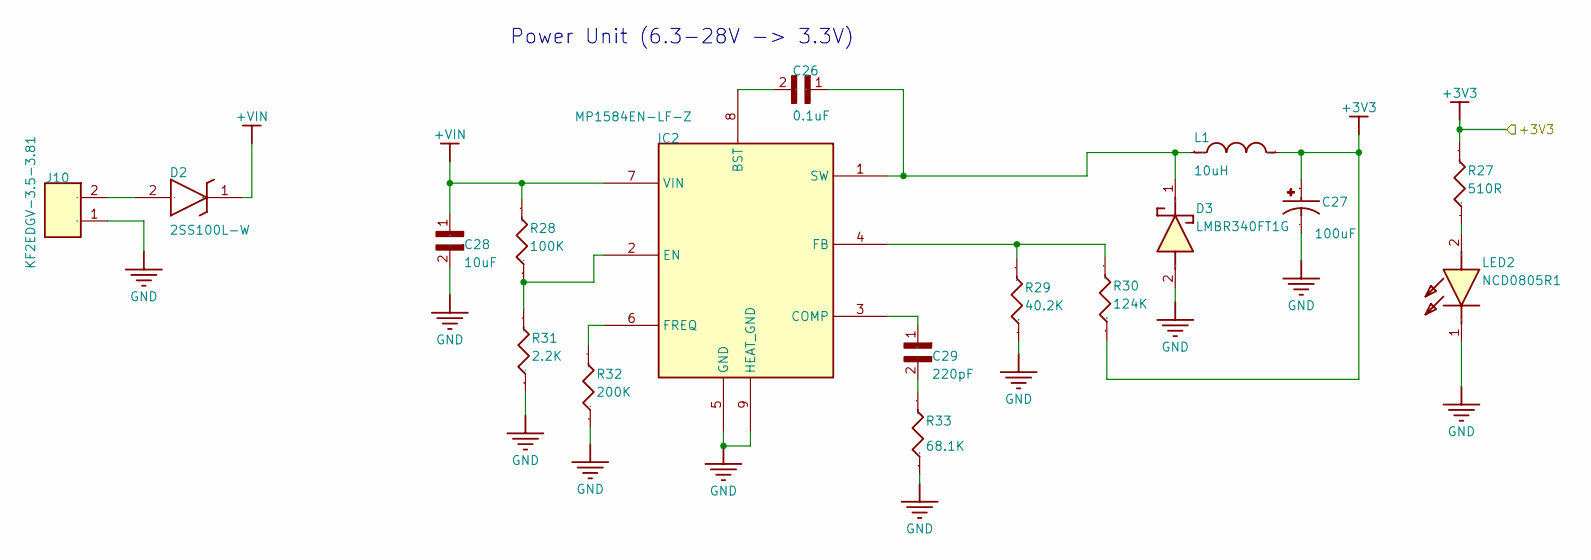
[picture p114: schematic POWER UNIT.kicad_sch]

Parts:
C26: 0.1uF; C_0402
C27: 100uF; XT100UF10V90RV0060
C28: 10uF; C_0402
C29: 220pF; C_0402
D2: 2SS100L-W; 2SS100LW; MANUFACTURER_PART_NUMBER 2SS100L-W; MOUSER PART NUMBER 583-2SS100L-W
D3: LMBR340FT1G; SODFL3618X143N; MANUFACTURER_PART_NUMBER SS34FA; MOUSER PART NUMBER 512-SS34FA
IC2: MP1584EN-LF-Z; SOIC127P600X170-9N
J10: KF2EDGV-3.5-3.81; SHDR2W80P0X381_1X2_862X700X920P
L1: 10uH; YSPI0530-100M
LED2: NCD0805R1; MANUFACTURER_PART_NUMBER NCD0805R1; MOUSER PART NUMBER *
R27: 510R; Res_0402
R28: 100K; Res_0402
R29: 40.2K; Res_0402
R30: 124K; Res_0402
R31: 2.2K; Res_0402
R32: 200K; Res_0402
R33: 68.1K; Res_0402

Connections:
+3V3: C27.1, L1.2, R27.2, R30.1; also elsewhere on the board
+VIN: C28.1, D2.1 (K), IC2.7 (VIN), R28.2
GND: C27.2, C28.2, D3.2 (A), IC2.5 (GND), IC2.9 (HEAT_GND), J10.1, LED2.1 (K), R29.1, R31.1, R32.1, R33.1; also elsewhere on the board
NetC26_1: C26.1, D3.1 (K), IC2.1 (SW), L1.1
NetC26_2: C26.2, IC2.8 (BST)
NetC29_1: C29.1, IC2.3 (COMP)
NetC29_2: C29.2, R33.2
NetD2_2: D2.2 (A), J10.2
NetD4_2: LED2.2 (A), R27.1
NetR28_1: IC2.2 (EN), R28.1, R31.2
NetR29_2: IC2.4 (FB), R29.2, R30.2
NetR32_2: IC2.6 (FREQ), R32.2

Notes on the sheet:
Power Unit (6.3-28V -> 3.3V)

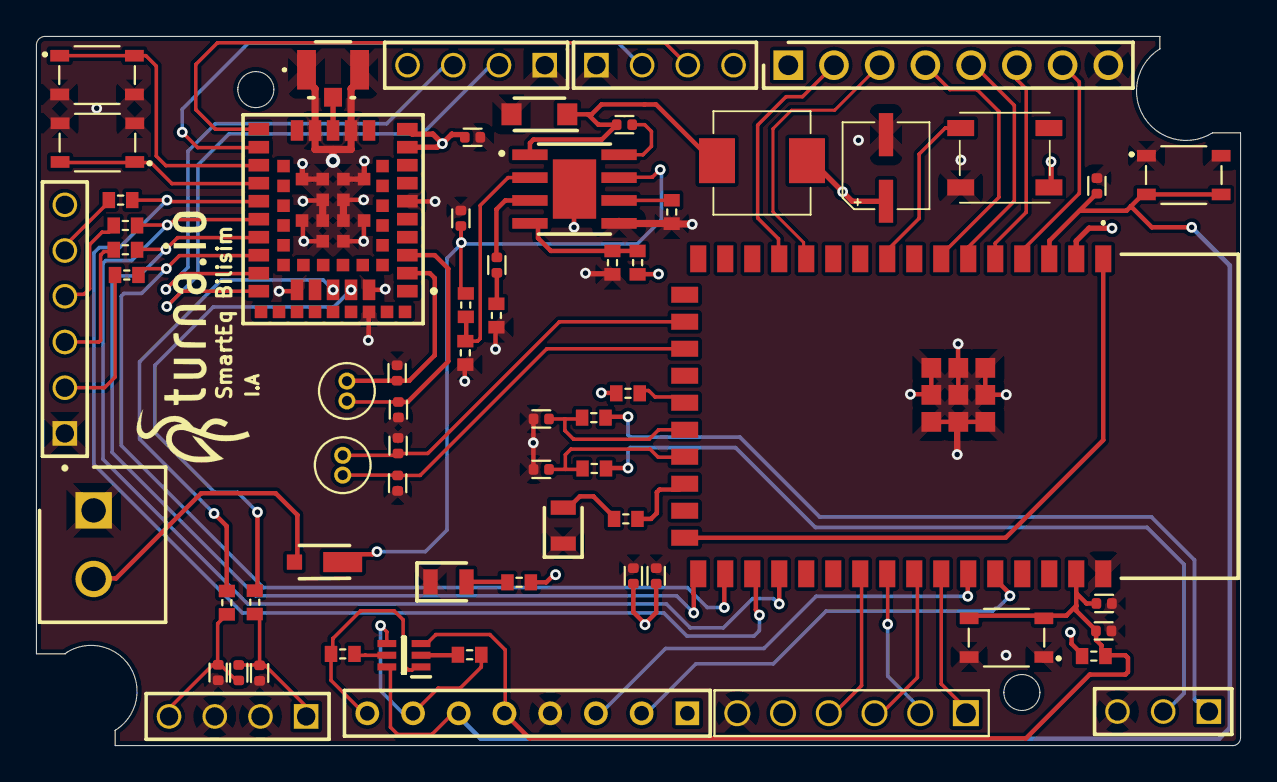
[picture p115: board Bluetooth-Anchor _Wifi KİCAD.kicad_pcb from above]

Board: 4 copper layers, 66.9 x 39.4 mm, 65 parts (0 on the bottom side), 62 nets.
