ihsanakyrk/Eski-Versionlar-Ve-Siparisler/Movita_3568_AXV_Router_V3.0/MXVR CM3568 Yolların çekilmemiş hali/yollarının çekilmemiş hali/RP2040_minimal.kicad_pcb

## KiCad design Movita_3568_AXV_Router_V3.0/MXVR CM3568 Yolların çekilmemiş hali/yollarının çekilmemiş hali/RP2040_minimal.kicad_pcb (2025-09-01)

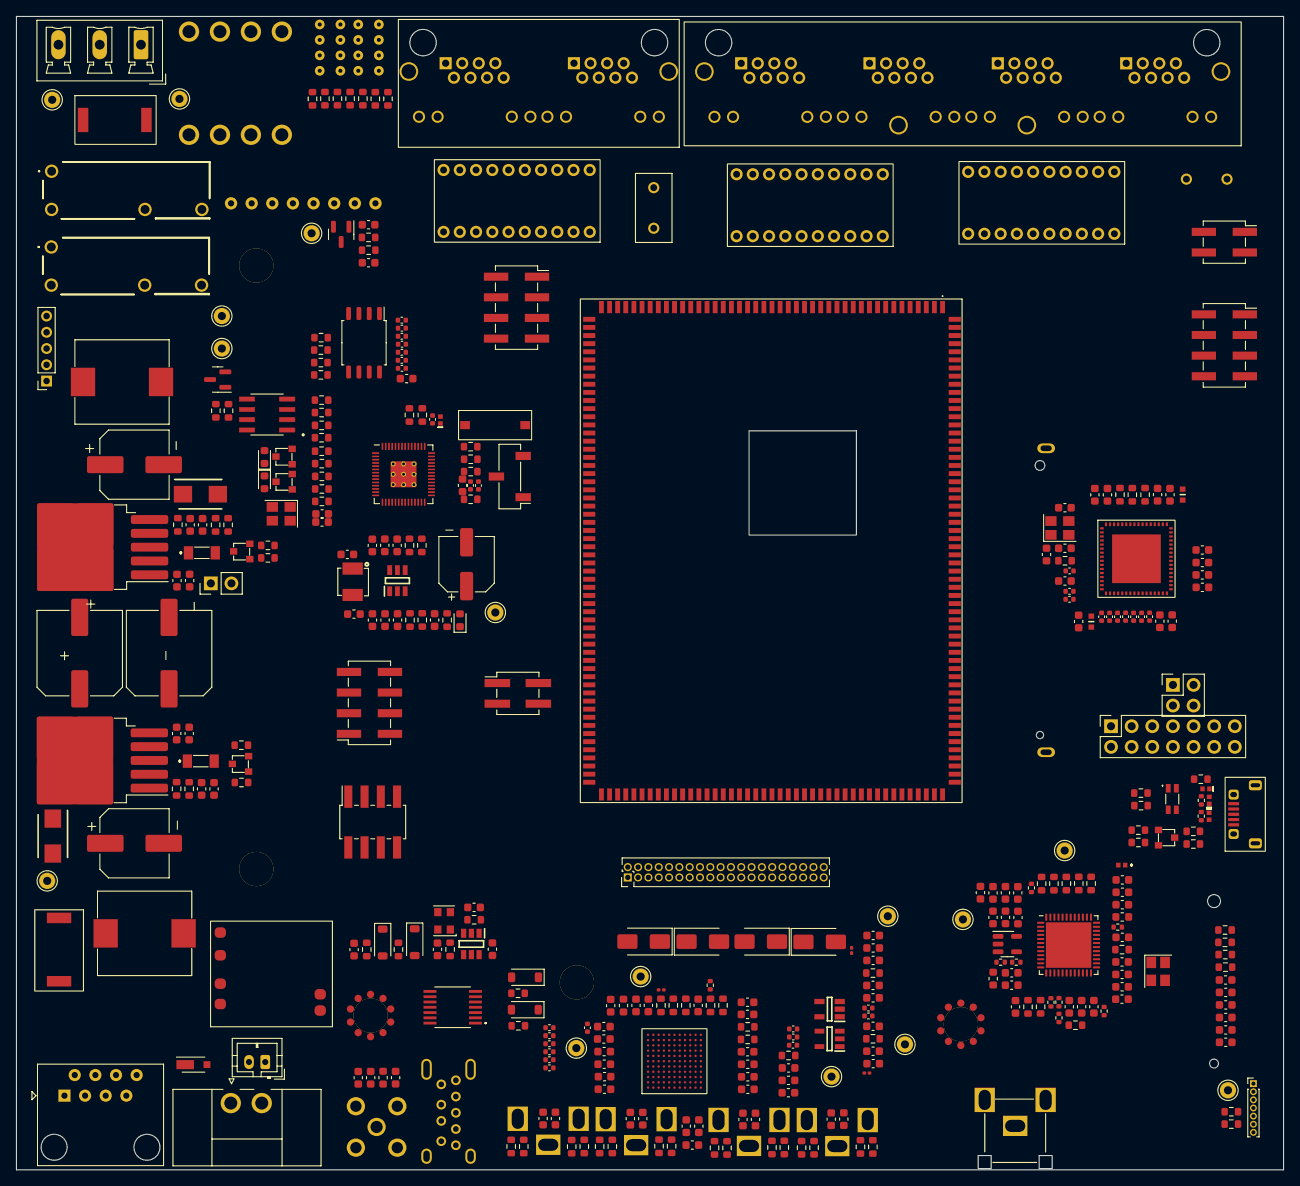
[picture p116: board Movita_3568_AXV_Router_V3.0/MXVR CM3568 Yolların çekilmemiş hali/yoll… from above]

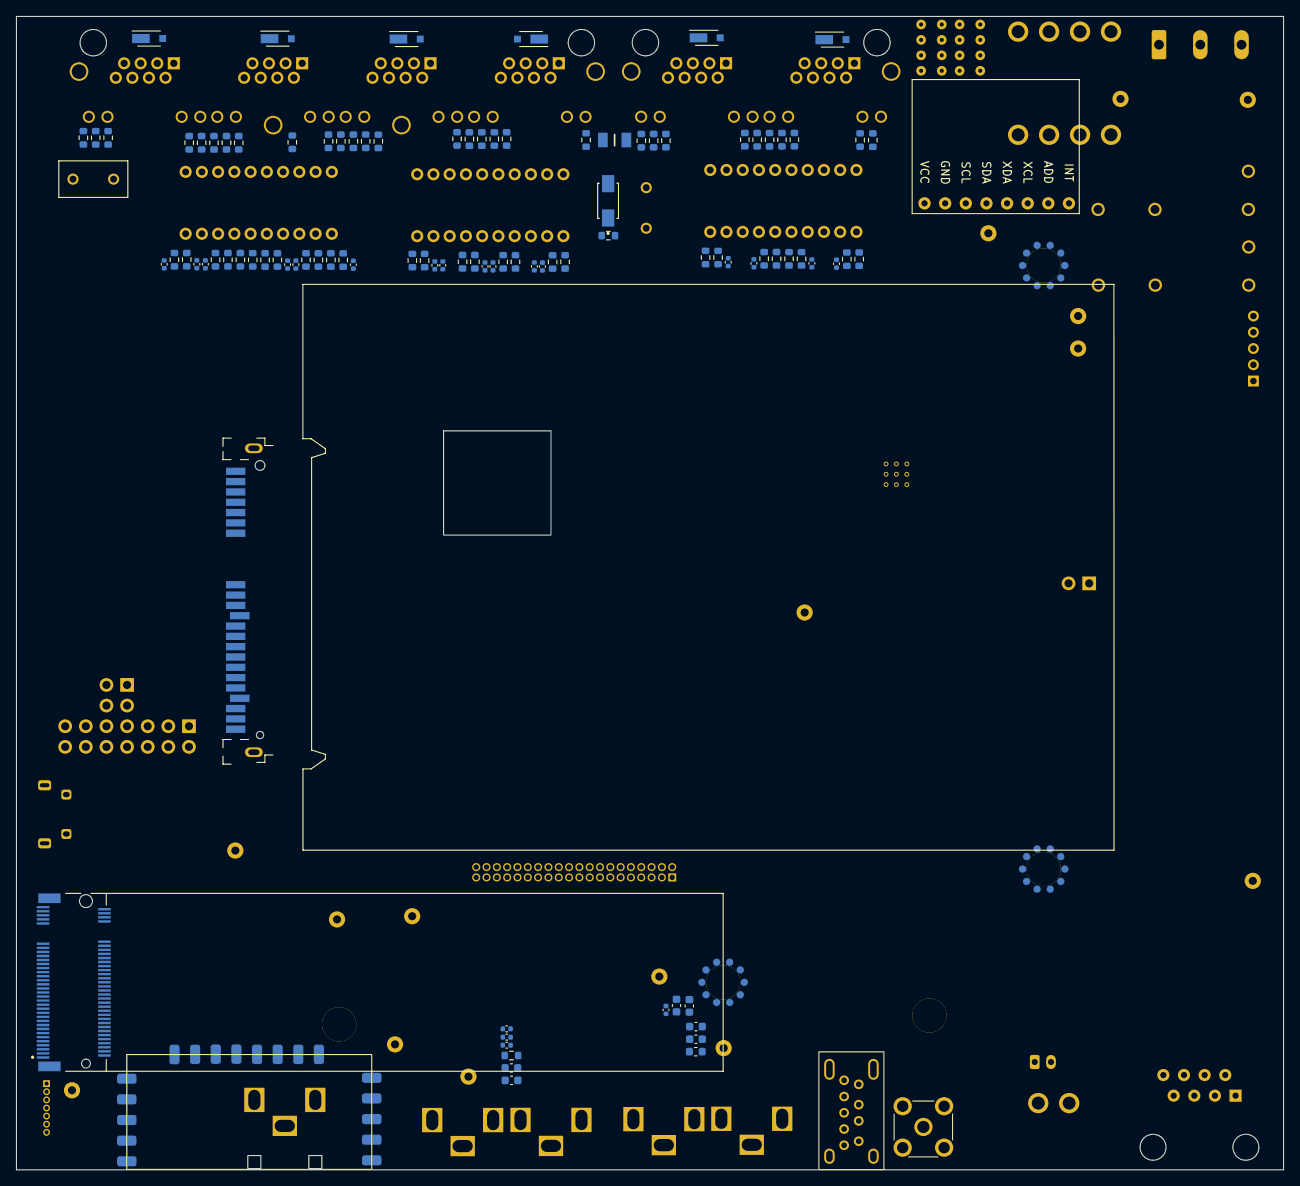
[picture p117: board Movita_3568_AXV_Router_V3.0/MXVR CM3568 Yolların çekilmemiş hali/yoll… from below]

Board: 4 copper layers, 156.0 x 142.0 mm, 480 parts (108 on the bottom side), 341 nets, no tracks yet.

Parts:
C1, C2, C3, C31, C40, C41, C42, C43, C44, C45, C46, C47, C48, C49, C50, C51, C52, C54, C55, C56, C57, C58, C59, C60, C101, C102, C103, C104, C105, C106, C107, C108, C109, C110, C116, C117, C118, C119, C120, C121, C124, C125, C126, C127, C143, C144, C147, C148, C150, C152, C156, C157, C158, C159, C160, C161, C162, C163, C165, C182, C183: 0.1uF; C_0603_1608Metric
C4, C6, C12: 4.7uF; C_0201_0603Metric
C7, C10, C37, C151, C155: 10uF; C_0603_1608Metric
C8, C9, C11, C13, C16, C17, C20, C21, C22, C23, C24, C25, C26, C27: 100nF; C_0402_1005Metric
C14, C15: 27pF; C_0603_1608Metric
C18, C19, C53, C128, C139, C140: 1uF; C_0603_1608Metric
C28, C83: 220uF/50V; C_Elec_10x10.2
C29, C30, C84, C169, C170, C172: 1uF/50V; C_0603_1608Metric
C32, C82: 330uF/25V; C_Elec_8x10.2
C35, C94, C166: 10pF; C_0603_1608Metric
C36, C38, C74, C75, C77, C95, C96, C97, C98, C99, C100, C111, C178: 100nF; C_0603_1608Metric
C39, C61: 33pF; C_0603_1608Metric
C62, C69, C180, C181: 22uF; C_0603_1608Metric
C63, C64, C65, C66, C67, C68, C70, C71, C72, C73, C76, C78, C79, C80, C81, C85, C86, C87, C88, C89, C90, C91: 0.1uF; C_0402_1005Metric
C92, C93: 1000PF 2KV; S102K33Y5PP63K5R
C112, C113, C129, C130, C131, C132, C133, C134, C135, C136, C137, C138, C141, C142: 10uF; C_0402_1005Metric
C114, C115: 4.7uF; C_0402_1005Metric
C122, C123: 8pF; C_0603_1608Metric
C145, C146, C179: 22pF; C_0603_1608Metric
C149, C154: 4.7uF; C_0603_1608Metric
C153: 10nF; C_0603_1608Metric
C164: DNP; C_0603_1608Metric
C171, C174: 0.33uF 16V; C_0603_1608Metric
C175, C176, C177: 10uF /16V; C_0603_1608Metric
C184: 220uF/16V; CP_Elec_6.3x7.7
D1, D2, D4, D5, D7, D8, D9: 2SS100L-W; 2SS100LW
D3: SS14; DIOM4325X250N
D6, D12, D13, D30: ESD5341N
D10, D11: SS54B; DIOM5336X244N
D14, D15, D16, D17: B5819W; D_SOD-123
D18, D19, D20, D21: SMAJ30CA; D_SMA
D22: ESD5451N
D23, D24: LL4148
D25: LED; LED_0603_1608Metric
D26, D27: MRA4007T3G; D_0603_1608Metric
D28, D29: S6MC
FB1: HI1206N101R-10; BEADC3216X130N
FL1: DLW31SN900SQ2L; DLW31SH222SQ2L
FL3, FL4: BLM18PG121SN1D; BLM18AG102BH1D
IC1: SN74LVC125APWR
IC2: MS1836S_QFN48-7x7; QFN-48-1EP_7x7mm_P0.5mm_EP5.6x5.6mm
IC3: RTL8309N
IC5: SY8113B; SOT95P285X100-6N
J1: FEMALE SMD Pin Header; PinSocket_2x07_P2.54mm_Vertical
J2, J18, J19, J20, J26: Phono RCA Jack Mono Connector Solder (Boktech adv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; AV_CON
J3: DNP; PinSocket_2x04_P2.54mm_Vertical_SMD
J4: DNP; PinSocket_1x05_P2.00mm_Vertical
J5: RJ45; RJ45_Amphenol_54602-x08_Horizontal
J6: MALE SMD Pin Header; PinHeader_2x20_P1.27mm_Vertical
J7: Conn_01x02_Socket; KF2EDGH-3.81-2P
J8: APCI0079-P002A J8900 M.2 M Key; TE_1-2199119-5
J9: Conn_01x06_Pin; RTL8188EU
J10: SMA Connetor_inner_hole; SMA_Connector_inner_pin_right_angle
J11: Conn_01x03_Socket; KF2EDGR-Y-5.08-3P-Right Angle
J12: Conn_01x08_Socket; KF2EDGH-3.81_8P
J13: FEMALE SMD Pin Header; PinSocket_2x04_P2.00mm_Vertical_SMD
J14: KH-MICRO5P-JN
J15, J16: Conn_01x08_Socket; LED_4_Block
J17: Conn_01x02_Socket; JST_PH_B2B-PH-K_1x02_P2.00mm_Vertical
J21, J22: FEMALE SMD Pin Header; PinSocket_2x04_P2.54mm_Vertical_SMD
J23, J28: M3x*0.5 L=10; Screw_terminal_shinbo
J24: USB 3.0 AF; CP-USB-3015
J25: DNP; PinHeader_2x02_P2.54mm_Vertical_SMD
J27: DNP; PinHeader_1x07_P1.00mm_Vertical
J29, J30: M3x*0.5 L=6; Screw_terminal_shinbo
J31: Conn_01x04_Socket; PinSocket_2x02_P2.54mm_Vertical
J32: DNP; PinHeader_1x02_P2.54mm_Vertical
J33: Conn_01x04_Socket; PinSocket_2x02_P2.54mm_Vertical_SMD
J34: FEMALE SMD Pin Header; PinSocket_1x03_P2.54mm_Vertical_SMD_Pin1Left
J35: M3x*0.5 L=3; Screw_terminal_shinbo
K1, K3: HF46F_5-HS1; HF46F5HS1
L2, L3: 47uH 5A; L_Bourns_SRR1208_12.7x12.7mm
L4, L5: FB/100R; L_0603_1608Metric
L6: UPZ1608E101-3R0TF; L_0603_1608Metric
L7: MLI1608F-1R2KT; L_0603_1608Metric
L8: HA42-4R7MT; Inductor_0402_4.7uH
L9: 2.7nH; L_0603_1608Metric
PS2: RT9013-33GB; SOT94P279X130-5N
PS3: TLV75712PDBVR; SOT95P280X145-5N
Q1: 2N3904S-RTK/PS; 2N3904S-RTKPS
Q2, Q3, Q4, Q5: MMBT2222ALT1G
R1: 150R; R_0603_1608Metric
R2, R3, R18, R19, R20, R35, R36, R40, R41, R43, R44, R47, R49, R55, R58, R59, R60, R61, R62, R63, R64, R65, R66, R67, R68, R69, R70, R71, R72, R78, R80, R82, R94, R95, R96, R97, R98, R99, R100, R101, R104, R107, R119, R122, R124, R136, R137, R155, R158, R159, R164, R169, R171: 10K; R_0603_1608Metric
R4, R5, R7, R9, R11, R25, R46, R54, R109, R113, R123, R126, R127: 0R; R_0603_1608Metric
R6, R8: 2.49K 1%; R_0603_1608Metric
R10, R12, R13, R21, R23, R24, R37, R38, R39, R42, R48, R77, R79, R81, R83, R84, R85, R86, R87, R88, R89, R90, R91, R92, R93, R105, R106, R132, R170, R172: 1K; R_0603_1608Metric
R14: 200R; R_0603_1608Metric
R15: 1R; R_0603_1608Metric
R16, R17: 27R; R_0603_1608Metric
R22, R26, R29, R50, R154, R163, R167, R173: DNP; R_0603_1608Metric
R27, R28, R32, R33, R34, R117, R118, R120: 4.7K; R_0603_1608Metric
R30, R31: 2.2R; R_0402_1005Metric
R45, R53, R108, R112, R116, R125, R146: 100R; R_0603_1608Metric
R51, R52, R56, R57, R73, R74, R75, R76, R102, R103, R110, R111, R114, R115: 75R; R_0603_1608Metric
R121, R129, R138: DNP; R_0402_1005Metric
R128: 560K; R_0603_1608Metric
R130: 10K %1; R_0402_1005Metric
R131, R133, R134, R139: 0R; R_0402_1005Metric
R135: 330R %1; R_0603_1608Metric
R140, R141: 2.2K; R_0603_1608Metric
R142: 22R; R_0603_1608Metric
R143: 75R; R_0402_1005Metric
R144: 100K; R_0603_1608Metric
R145: 1K %5; R_0603_1608Metric
R147, R148, R149, R150, R151, R152, R153: 220R; R_0603_1608Metric
R156: 3.3K 1%; R_0603_1608Metric
R157, R160: 470R; R_0603_1608Metric
R161: 15K; R_0603_1608Metric
R162: 1.6K; R_0603_1608Metric
R165: 232K_1%; R_0603_1608Metric
R166: 51K_1%; R_0603_1608Metric
R168: 2K; R_0603_1608Metric
S1: TS-1101-C-W
TP1, TP2, TP3, TP4, TP5, TP6, TP7, TP8, TP9, TP10, TP11, TP12, TP13, TP14, TP15: TestPoint; Pin_D1.0mm_L10.0mm
U1: CM3568
U2, U3: TLV76033DBZT; SOT-23
U4: 3N27000G33YC; Oscillator_SMD_EuroQuartz_XO32-4Pin_3.2x2.5mm
U5: RP2040; RP2040-QFN-56
U6: MAX485E; SOIC127P600X175-8N
U6B1: Nextchip N4; N4
U7: W25Q128JVS; SOIC-8_5.23x5.23mm_P1.27mm
U8: NL27WZU04DTT1G; SOP95P275X110-6N
U9: DNP; HDMI
U10, U15: XL4015; TO-263-5_TabPin3
U11: DNP; module_mpu6050
U12, U13, U19: UTH20T29 2220X; RJ45_Transformer_2_Port
U14: RT9013-12GB; SOT-23-5
U16: 5622-1200-ML; SATA_Connector_5622-1200-ML
U17: RJ45-4-Block; 4_Block_RJ45
U18: 2_Block_RJ45
Y1: 12000Mhz; Crystal_SMD_3225-4Pin_3.2x2.5mm
Y2: X322527MSB4SI; Crystal_SMD_3225-4Pin_3.2x2.5mm
Y4: 25MHz; Crystal_SMD_3225-4Pin_3.2x2.5mm

Connections:
1V0: C38.2, C74.2, C75.2, C95.2, C97.2, FL4.2, IC3.33 (DVDDL_2)
1V0PLL: C99.2, C100.2, FL4.1
3.3V_Sensor: C36.1, C41.1, D3.A, R27.1, R28.2, U2.1 (OUT), U11.1 (VCC)
3V3: C96.2, C98.2
+1V1: C16.1, C17.1, C18.1, U5.23 (DVDD), U5.45 (VREG_VOUT), U5.50 (DVDD)
/4 Port RJ45 and Transformer/+3.3V: C2.1, C4.1, C7.1, C55.1, C56.1, C57.1, C58.1, C59.1, C60.1, C114.1, C118.1, C179.2, C180.2, C181.2, C182.2, C183.2, C184.1, FB1.1, FL3.1, J6.5, J6.6, J8.2, J8.4, J8.12, J8.14, J8.16, J8.18, J8.70, J8.72, J8.74, J9.1, J21.1, L6.1, L8.2, PS3.1 (IN), R3.2, R154.1, R165.1, R168.1, TP3.1, TP9.1
/4 Port RJ45 and Transformer/LED0: IC3.38 (P0LED/DIS_EEE), R37.1, R38.2, R72.2
/4 Port RJ45 and Transformer/LED1: IC3.39 (P1LED/LED_MODE[1]), R23.1, R24.2, R78.2
/4 Port RJ45 and Transformer/LED2: IC3.40 (P2LED/LED_MODE[2]), R39.1, R42.2, R80.2
/4 Port RJ45 and Transformer/LED3: IC3.42 (P3LED/RMAMODE), R82.2, R84.1, R85.2
/4 Port RJ45 and Transformer/LED4: IC3.43 (P4LED/UNKOWN_MULTI), R86.1, R87.2, R104.2
/4 Port RJ45 and Transformer/LED5: IC3.44 (P5LED/DIS_RST_BLNK), R88.1, R89.2, R107.2
/4 Port RJ45 and Transformer/RXI_0_N: IC3.57 (RXIN0), R71.2, U13.9
/4 Port RJ45 and Transformer/RXI_0_P: IC3.56 (RXIP0), R70.2, U13.10
/4 Port RJ45 and Transformer/RXI_1_N: IC3.63 (RXIN1), R64.2, U13.2
/4 Port RJ45 and Transformer/RXI_1_P: IC3.64 (RXIP1), R65.2, U13.1
/4 Port RJ45 and Transformer/RXI_2_N: IC3.3 (RXIN2), R63.2, U12.9
/4 Port RJ45 and Transformer/RXI_2_P: IC3.2 (RXIP2), R62.2, U12.10
/4 Port RJ45 and Transformer/RXI_3_N: IC3.9 (RXIN3), R47.2, U12.2
/4 Port RJ45 and Transformer/RXI_3_P: IC3.10 (RXIP3), R55.2, U12.1
/4 Port RJ45 and Transformer/RXI_4_N: IC3.14 (RXIN4), R95.2, U19.9
/4 Port RJ45 and Transformer/RXI_4_P: IC3.13 (RXIP4), R94.2, U19.10
/4 Port RJ45 and Transformer/RXI_5_N: IC3.20 (RXIN5), R99.2, U19.2
/4 Port RJ45 and Transformer/RXI_5_P: IC3.21 (RXIP5), R98.2, U19.1
/4 Port RJ45 and Transformer/TXO_0_N: IC3.58 (TXON0), R69.2, U13.7
/4 Port RJ45 and Transformer/TXO_0_P: IC3.59 (TXOP0), R68.2, U13.6
/4 Port RJ45 and Transformer/TXO_1_N: IC3.62 (TXON1), R66.2, U13.4
/4 Port RJ45 and Transformer/TXO_1_P: IC3.61 (TXOP1), R67.2, U13.5
/4 Port RJ45 and Transformer/TXO_2_N: IC3.4 (TXON2), R61.2, U12.7
/4 Port RJ45 and Transformer/TXO_2_P: IC3.5 (TXOP2), R60.2, U12.6
/4 Port RJ45 and Transformer/TXO_3_N: IC3.8 (TXON3), R58.2, U12.4
/4 Port RJ45 and Transformer/TXO_3_P: IC3.7 (TXOP3), R59.2, U12.5
/4 Port RJ45 and Transformer/TXO_4_N: IC3.15 (TXON4), R96.2, U19.7
/4 Port RJ45 and Transformer/TXO_4_P: IC3.16 (TXOP4), R97.2, U19.6
/4 Port RJ45 and Transformer/TXO_5_N: IC3.19 (TXON5), R100.2, U19.4
/4 Port RJ45 and Transformer/TXO_5_P: IC3.18 (TXOP5), R101.2, U19.5
/+12V: C32.1, C172.2, C174.2, C175.2, C176.2, C177.2, D1.2, D2.2, D4.2, D5.2, D7.2, D8.2, D9.2, IC5.5 (IN), J12.4, L3.2, R11.2, R161.1, R163.1, TP2.1, U16.P13 (VCC12), U16.P14 (VCC12), U16.P15 (VCC12), U17.P1_L_Led+, U17.P2_L_Led+, U17.P3_L_Led+, U17.P4_L_Led+, U18.P1_L_Led+, U18.P2_L_Led+
/CM3568/+5V: C1.1, C3.1, C6.1, C10.1, C82.1, C84.2, C115.1, C119.1, C171.2, D26.1 (K), D27.1 (K), J16.5, J21.2, J21.4, J24.1 (VBUS), K1.2 (COIL_2), K3.2 (COIL_2), L2.2, PS2.1 (VIN), R25.2, R32.1, R155.1, TP1.1, TP8.1, U1.143, U1.144, U16.P7 (VCC5), U16.P8 (VCC5), U16.P9 (VCC5)
/CM3568/GPIO4_C5_d: J34.1, R167.2, U1.156
/CM3568/GPIO4_C6_d: J34.2, U1.157, U5.26 (RUN)
/CM3568/HDMITX_CEC_M0: R142.1, U1.162, U9.17
/CM3568/HDMITX_SCL: IC2.46 (RXDDC_SCL), R141.1, U1.164, U9.20
/CM3568/HDMITX_SDA: IC2.45 (RXDDC_SDA), R140.1, U1.163, U9.19
/CM3568/HDMI_TX0N: IC2.4 (HDMI_RX0N), U1.1, U9.8
/CM3568/HDMI_TX0P: IC2.5 (HDMI_RX0P), U1.2, U9.7
/CM3568/HDMI_TX1N: IC2.7 (HDMI_RX1N), U1.3, U9.6
/CM3568/HDMI_TX1P: IC2.8 (HDMI_RX1P), U1.4, U9.5
/CM3568/HDMI_TX2N: IC2.10 (HDMI_RX2N), U1.5, U9.3
/CM3568/HDMI_TX2P: IC2.11 (HDMI_RX2P), U1.6, U9.2
/CM3568/HDMI_TXCLKN_PORT: IC2.1 (HDMI_RXCN), U1.201, U9.11
/CM3568/HDMI_TXCLKP_PORT: IC2.2 (HDMI_RXCP), U1.202, U9.10
/CM3568/HDMI_TX_HPDIN: R144.1, R145.2, U1.7, U9.16
/CM3568/MIC1_INN: J27.5, U1.122
/CM3568/PCIE20_REFCLKN: J3.6, J8.53, U1.9
/CM3568/PCIE20_REFCLKP: J3.5, J8.55, U1.8
/CM3568/PCIE20_RXN: J3.3, J8.43, U1.11
/CM3568/PCIE20_RXP: J3.4, J8.41, U1.10
/CM3568/PCIE20_TXN: J3.2, J8.47, U1.13
/CM3568/PCIE20_TXP: J3.1, J8.49, U1.12
/CM3568/PDM_SDI2_M0_ADC/PCIE20_WAKEn_M2: J8.54, U1.91
/CM3568/PHY1_MDI0+: IC3.28 (TXOP7), J33.1, U1.102
/CM3568/PHY1_MDI0-: IC3.29 (TXON7), J33.2, U1.103
/CM3568/PHY1_MDI1+: IC3.31 (RXIP7), J33.3, U1.104
/CM3568/PHY1_MDI1-: IC3.30 (RXIN7), J33.4, U1.105
/CM3568/RESETn: J27.1, U1.145
/CM3568/RK809_PWRON: J27.6, R26.1, R29.1, TP15.1, U1.141
/CM3568/SARADC_VIN0_KEY/RECOVERY: R146.1, U1.65
/CM3568/SATA0_RXN: U1.20, U16.S5 (RX-)
/CM3568/SATA0_RXP: U1.21, U16.S6 (RX+)
/CM3568/SATA0_TXN: U1.18, U16.S3 (TX-)
/CM3568/SATA0_TXP: U1.19, U16.S2 (TX+)
/CM3568/UART0_RX/PWM1_M0: U1.72, U5.27 (GPIO16)
/CM3568/UART0_TX/GPIO0_C1: U1.71, U5.28 (GPIO17)
/CM3568/USB2_HOST2_DM: J13.7, J22.4, U1.96
/CM3568/USB2_HOST2_DP: J13.5, J22.3, U1.97
/CM3568/USB2_HOST3_DM: J9.2, J22.6, U1.98
/CM3568/USB2_HOST3_DP: J9.3, J22.5, U1.99
/CM3568/USB3_HOST1_DM: J22.2, J24.2 (D-), U1.23
/CM3568/USB3_HOST1_DP: J22.1, J24.3 (D+), U1.24
/CM3568/USB3_HOST1_SSRXN: J24.5 (SSRX-), U1.16
/CM3568/USB3_HOST1_SSRXP: J24.6 (SSRX+), U1.17
/CM3568/USB3_HOST1_SSTXN: J24.8 (SSTX-), U1.14
/CM3568/USB3_HOST1_SSTXP: J24.9 (SSTX+), U1.15
/CM3568/USB3_OTG0_DM: FL1.4, R30.1, U1.26
/CM3568/USB3_OTG0_DP: FL1.1, R31.1, U1.25
/CM3568/USB3_OTG0_ID: D13.1, J14.4 (ID), R34.2, U1.55
/CM3568/USB3_OTG0_VBUSDET: R32.2, R33.1, U1.54
/CM3568/VCC_1V8_OUTPUT: C12.1, C31.1, R119.1, R122.1, TP10.1, U1.146
/CM3568/VRTC: J27.7, R1.2, U1.124
/CSI_AHD/AHD_RESET: C109.1, R122.2, R123.1, U6B1.K10 (RESETN)
/CSI_AHD/AVIN: D18.2 (A2), D19.2 (A2), D20.2 (A2), D21.2 (A2), J18.1, J18.2, J19.1, J19.2, J20.1, J20.2, J26.1, J26.2, R46.1, R54.1, R109.1, R113.1
/CSI_AHD/COAX1: IC1.2 (1A), U6B1.C2 (MPP1)
/CSI_AHD/COAX2: IC1.5 (2A), U6B1.C3 (MPP2)
/CSI_AHD/COAX3: IC1.9 (3A), U6B1.C4 (MPP3)
/CSI_AHD/COAX4: IC1.12 (4A), U6B1.C5 (MPP4)
/CSI_AHD/GPIO2_C6: R119.2, U6B1.H8 (IRQ)
/CSI_AHD/GPIO4_C4_d: IC1.10 (3~OE), R43.1
/CSI_AHD/LCDC_D22/UART3_TX_M1: IC1.13 (4~OE), R44.1
/CSI_AHD/LCDC_D23/UART3_RX_M1: IC1.1 (1~OE), R35.1
/CSI_AHD/PDM_CLK1_M0_ADC/SPDIF_TX_M0: IC1.4 (2~OE), R36.1
/CSI_AHD/SYS_CLK: R45.1, U8.6 (OUT*Y1)
/CSI_AHD/VINN1: C102.2, U6B1.E2 (VINN1)
/CSI_AHD/VINN2: C104.2, U6B1.G2 (VINN2)
/CSI_AHD/VINN3: C106.2, U6B1.J2 (VINN3)
/CSI_AHD/VINN4: C108.2, U6B1.L2 (VINN4)
/CSI_AHD/VINP1: C101.2, U6B1.D1 (VINP1)
/CSI_AHD/VINP2: C103.2, U6B1.F1 (VINP2)
/CSI_AHD/VINP3: C105.2, U6B1.H1 (VINP3)
/CSI_AHD/VINP4: C107.2, U6B1.K1 (VINP4)
/CSI_AHD/VIN_N1: C102.1, R52.2
/CSI_AHD/VIN_N2: C104.1, R57.2
/CSI_AHD/VIN_N3: C106.1, R111.2
/CSI_AHD/VIN_N4: C108.1, R115.2
/CSI_AHD/VIN_P1: C101.1, D15.1 (K), R46.2, R51.2
/CSI_AHD/VIN_P2: C103.1, D14.1 (K), R54.2, R56.2
/CSI_AHD/VIN_P3: C105.1, D17.1 (K), R109.2, R110.2
/CSI_AHD/VIN_P4: C107.1, D16.1 (K), R113.2, R114.2
/EC25_Sim/GSM_STATUS: J13.3, J16.6
/HDMI_CVBS/CVideo_OUT: C164.2, C165.1, D22.1, J2.1, J2.2, J31.1, L7.2
/HDMI_CVBS/DAC_R: C163.1, C164.1, IC2.31 (AV_OUT), L7.1, R143.2
/HDMI_CVBS/HDMI_RX_HPD: IC2.43 (HDMIRX_HPD), R145.1
/HDMI_CVBS/P/N_SEL: R131.1, R137.2, R138.1
/HDMI_CVBS/RSTn: C153.1, IC2.15 (RSTn), R136.1, R142.2
/HDMI_CVBS/RX_DET: IC2.42 (DVDD33_1), IC2.44 (HDMIRX_DET), R132.2
/HDMI_CVBS/VDD10_EPHY: C155.1, C157.1, C158.1, C159.1, C160.1, C161.1, C162.1, IC2.3 (AVDD12), IC2.9 (AVDD12_1), IC2.20 (DVDD12), IC2.40 (DVDD12_1), TP11.1, U14.5 (OUT)
/HDMI_CVBS/XTAL1: C145.1, IC2.27 (XTOUT), Y2.1
/HDMI_CVBS/XTAL2: C146.1, IC2.26 (XTIN), Y2.3
/IO Connector/FLASH: J12.5, K3.4 (COM)
/IO Connector/HORN: J12.6, K1.4 (COM)
/MIC+: J12.1, J27.4, U1.123
/Power Unit/+3V3_Mini: C19.1, C20.1, C21.1, C22.1, C23.1, C24.1, C25.1, C26.1, C27.1, R14.1, R18.2, R19.2, R22.1, R40.2, R41.2, R157.1, R160.1, U3.1 (OUT), U5.1 (IOVDD), U5.10 (IOVDD), U5.22 (IOVDD), U5.33 (IOVDD), U5.42 (IOVDD), U5.44 (VREG_IN), U5.48 (USB_VDD), U5.49 (IOVDD), U6.8 (VCC), U7.8 (VCC)
/RP2040/GPIO0: R27.2, U5.2 (GPIO0), U11.4 (SDA)
/RP2040/GPIO1: R28.1, U5.3 (GPIO1), U11.3 (SCL)
/RP2040/GPIO6: R147.1, U5.8 (GPIO6)
/RP2040/GPIO7: R171.1, R172.1, U5.9 (GPIO7)
/RP2040/GPIO8: R169.1, R170.1, U5.11 (GPIO8)
/RP2040/GPIO9: R148.1, U5.12 (GPIO9)
/RP2040/GPIO10: R149.1, U5.13 (GPIO10)
/RP2040/GPIO11: R150.1, U5.14 (GPIO11)
/RP2040/GPIO12: R151.1, U5.15 (GPIO12)
/RP2040/GPIO13: R152.1, U5.16 (GPIO13)
/RP2040/GPIO14: R153.1, U5.17 (GPIO14)
/RP2040/GPIO15: R20.2, R50.1, U5.18 (GPIO15)
/RP2040/GPIO19: R167.1, U5.30 (GPIO19)
/RP2040/GPIO20: R164.2, U5.31 (GPIO20)
/RP2040/GPIO21: J13.6, U5.32 (GPIO21)
/RP2040/GPIO22: R158.1, U5.34 (GPIO22)
/RP2040/GPIO23: R159.1, R173.1, U5.35 (GPIO23)
/RP2040/GPIO27_ADC1: D30.1, R48.1, R49.2, U5.39 (GPIO27_ADC1)
/RP2040/QSPI_SCLK: U5.52 (QSPI_SCLK), U7.6 (CLK)
/RP2040/QSPI_SD0: U5.53 (QSPI_SD0), U7.5 (DI(IO0))
/RP2040/QSPI_SD1: U5.55 (QSPI_SD1), U7.2 (DO(IO1))
/RP2040/QSPI_SD2: U5.54 (QSPI_SD2), U7.3 (IO2)
/RP2040/QSPI_SD3: U5.51 (QSPI_SD3), U7.7 (IO3)
/RP2040/QSPI_SS: R21.1, R22.2, U5.56 (QSPI_SS), U7.1 (~CS)
/RP2040/XIN: C14.1, U5.20 (XIN), Y1.3
/RP2040/XOUT: R13.1, U5.21 (XOUT)
/RP2040/~USB_BOOT: J4.3, R21.2
/RTL8309E/LED6: IC3.45 (P6LED), R90.1, R91.2
/RTL8309E/LED7: IC3.46 (P7LED), R92.1, R93.2
/SPK+: J12.3, J27.3, U1.118
/SPK-: J12.2, J27.2, U1.119
ADC_VREF: R14.2, R15.1
AVDD12: C129.1, C131.1, C133.1, C135.1, C137.1, C141.1, L4.1, PS3.5 (OUT), R126.1, R127.1, TP14.1, U6B1.D3 (AVDD12_CH1), U6B1.F3 (AVDD12_CH2), U6B1.H3 (AVDD12_CH3), U6B1.K3 (AVDD12_CH4)
AVDD12PLL: C140.1, C144.1, R127.2, U6B1.H4 (AVDD12_PLL)
AVDD12_MIPI: C139.1, C143.1, R126.2, U6B1.J7 (AVDD12_MIPI)
AVDD33: C53.1, C110.1, C130.1, C132.1, C134.1, C136.1, C138.1, C142.1, IC1.14 (VCC), L5.2, PS2.5 (VOUT), TP13.1, U6B1.E3 (AVDD33.1), U6B1.G3 (AVDD33.2), U6B1.J3 (AVDD33.3), U6B1.L3 (AVDD33.4)
CMT1: R76.2, U13.13
CMT2: R75.2, U13.18
CMT3: R74.2, U12.13
CMT4: R73.2, U12.18
CMT5: R103.2, U19.13
CMT6: R102.2, U19.18
CT: C8.1, C9.1, C11.1, C13.1, C62.1, C63.1, C64.1, C65.1, C66.1, C67.1, C68.1, C69.1, C71.1, C72.1, C73.1, C76.2, FL3.2, IC3.41 (DVDDH), IC3.49 (V33IN), IC3.50 (AVDDHPLL), IC3.60 (AVDDH_4), R8.1, R10.2, R23.2, R37.2, R39.2, R84.2, R86.2, R88.2, R90.2, R92.2, U12.3, U12.8, U13.3, U13.8, U19.3, U19.8
DVDD33: R120.1, U6B1.D5 (DVDD33.1), U6B1.D7 (DVDD33.3), U6B1.E8 (DVDD33.5), U6B1.G7 (DVDD33.4), U6B1.H6 (DVDD33.2)
Earth: C1.2, C2.2, C3.2, C4.2, C6.2, C7.2, C8.2, C9.2, C10.2, C11.2, C12.2, C13.2, C14.2, C15.2, C16.2, C17.2, C18.2, C19.2, C20.2, C21.2, C22.2, C23.2, C24.2, C25.2, C26.2, C27.2, C28.2, C29.1, C31.2, C32.2, C36.2, C37.2, C39.2, C40.1, C41.2, C42.1, C43.1, C44.1, C45.1, C46.1, C47.1, C48.1, C53.2, C54.2, C55.2, C56.2, C57.2, C58.2, C59.2, C60.2, C61.2, C62.2, C63.2, C64.2, C65.2, C66.2, C67.2, C68.2, C69.2, C70.2, C71.2, C72.2, C73.2, C77.2, C78.2, C79.2, C80.2, C81.2, C82.2, C83.2, C84.1, C85.2, C86.2, C87.2, C88.2, C89.2, C90.2, C91.2, C92.1, C94.2, C109.2, C110.2, C111.2, C112.2, C113.2, C114.2, C115.2, C116.2, C117.2, C118.2, C119.2, C120.2, C121.2, C122.1, C123.1, C124.2, C125.2, C126.2, C127.2, C128.2, C129.2, C130.2, C131.2, C132.2, C133.2, C134.2, C135.2, C136.2, C137.2, C138.2, C139.2, C140.2, C141.2, C142.2, C143.2, C144.2, C145.2, C146.2, C147.2, C148.2, C149.2, C150.2, C151.2, C152.2, C153.2, C154.2, C155.2, C156.2, C157.2, C158.2, C159.2, C160.2, C161.2, C162.2, C163.2, C165.2, C166.2, C169.1, C172.1, C175.1, C176.1, C177.1, C180.1, C181.1, C182.1, C183.1, C184.2, D6.2, D10.2, D11.2, D12.2, D13.2, D18.1 (A1), D19.1 (A1), D20.1 (A1), D21.1 (A1), D22.2, D25.1 (K), D30.2, IC1.7 (GND), IC2.19 (VSS), IC2.22 (VREF_L), IC2.30 (VSS_1), IC2.41 (VSS_2), IC2.49 (GND(EPAD)), IC3.65 (EP), IC5.2 (GND), J2.3, J4.4, J5.7, J5.8, J6.3, J6.4, J6.7, J6.8, J6.15, J6.16, J6.19, J6.20, J6.31, J6.32, J7.1, J8.1, J8.3, J8.9, J8.15, J8.21, J8.27, J8.33, J8.39, J8.45, J8.51, J8.57, J8.71, J8.73, J8.75, J8.SH1 (SHIELD), J8.SH2 (SHIELD), J9.4, J9.5, J10.2, J10.3, J10.4, J10.5, J11.2, J13.1, J13.2, J14.5 (GND), J14.SHIELD, J15.1, J15.3, J15.5, J15.7, J16.1, J16.3, J16.7, J17.1, J21.5, J21.6, J24.4 (GND), J24.7 (DRAIN), J24.10 (SHIELD), J31.2, J32.2, J34.3, PS2.2 (GND), PS3.2 (GND), Q1.2 (E), Q2.2 (E), Q3.2 (E), Q4.2 (E), Q5.2 (E), R6.2, R12.1, R24.1, R26.2, R33.2, R35.2, R36.2, R38.1, R42.1, R43.2, R44.2, R48.2, R50.2, R53.2, R77.2, R79.2, R81.2, R83.2, R85.1, R87.1, R89.1, R91.1, R93.1, R105.2, R106.2, R108.2, R112.1, R116.2, R117.2, R118.2, R121.2, R129.1, R130.1, R133.1, R135.1, R138.2, R143.1, R144.2, R156.2, R162.2, R166.2, R169.2, R171.2, S1.2, U1.22, U1.38, U1.62, U1.66, U1.95, U1.110, U1.140, U1.161, U1.190, U2.3 (GND), U3.3 (GND), U4.2 (GND2), U4.4 (GND1), U5.19 (TESTEN), U5.57 (GND), U6.5 (GND), U6B1.A1 (N.C1), U6B1.A11 (N.C2), U6B1.E5 (VSS3), U6B1.E6 (VSS6), U6B1.E7 (VSS8), U6B1.F4 (VSS1), U6B1.F5 (VSS4), U6B1.F6 (VSS7), U6B1.F7 (VSS9), U6B1.G4 (VSS2), U6B1.G5 (VSS5), U6B1.J4 (TEST1), U6B1.J8 (AVSS_MIPI), U6B1.K4 (TEST0), U6B1.K11 (TEST_CLK1), U6B1.L1 (N.C3), U6B1.L10 (TEST_CLK2), U6B1.L11 (N.C4), U7.4 (GND), U8.2 (GND), U9.4, U9.9, U9.12, U9.18, U10.1 (GND), U11.2 (GND), U14.2 (GND), U15.1 (GND), U16.GND, U16.P4 (GND), U16.P5 (GND), U16.P6 (GND), U16.P10 (GND), U16.P11 (GND), U16.P12 (GND), U16.S1 (GND), U16.S4 (GND), U16.S7 (GND), U17.7_1, U17.7_2, U17.7_3, U17.7_4, U17.8_1, U17.8_2, U17.8_3, U17.8_4, U18.7_1, U18.7_2, U18.8_1, U18.8_2, U18.SHIELD, Y1.2, Y1.4, Y2.2, Y2.4, Y4.2, Y4.4
GNDPWR: C92.2, C93.2, U17.SHIELD
LED_VDD: FB1.2, U17.P1_R_Led+, U17.P2_R_Led+, U17.P3_R_Led+, U17.P4_R_Led+, U18.P1_R_Led+, U18.P2_R_Led+
LIND_DS_LED: IC3.37 (LDIND/DIS_LD), R10.1, R12.2
unnamed: C15.1, R13.2, Y1.1
unnamed: C35.1, C94.1, L9.1
unnamed: C70.1, R47.1, R55.1
unnamed: C78.1, R94.1, R95.1
unnamed: C79.1, R96.1, R97.1
unnamed: C80.1, R98.1, R99.1
unnamed: C81.1, R100.1, R101.1
unnamed: C85.1, R58.1, R59.1
unnamed: C86.1, R60.1, R61.1
unnamed: C87.1, R62.1, R63.1
unnamed: C88.1, R64.1, R65.1
unnamed: C89.1, R66.1, R67.1
unnamed: C90.1, R68.1, R69.1
unnamed: C91.1, R70.1, R71.1
unnamed: C93.1, R73.1, R74.1, R75.1, R76.1, R102.1, R103.1
unnamed: C113.1, C117.1, C121.1, C125.1, C127.1, L5.1
unnamed: D3.C, R1.1
unnamed: D14.2 (A), IC1.6 (2Y)
unnamed: D15.2 (A), IC1.3 (1Y)
unnamed: D16.2 (A), IC1.11 (4Y)
unnamed: D17.2 (A), IC1.8 (3Y)
unnamed: D25.2 (A), R168.2
unnamed: D26.2 (A), K1.1 (COIL_1), Q4.3 (C)
unnamed: D27.2 (A), K3.1 (COIL_1), Q5.3 (C)
unnamed: IC2.29 (DAC_REF), R135.2
unnamed: IC2.16 (KEY0), R131.2
unnamed: IC2.17 (KEY1), R133.2
unnamed: IC2.12 (MCU_SEL), R129.2
unnamed: IC2.48 (REXT), R130.2
unnamed: C151.1, C152.1, IC2.25 (VMID)
unnamed: C149.1, C150.1, IC2.23 (VREF_H), R134.1
unnamed: C76.1, IC3.6 (AVDDH_1)
unnamed: C98.1, IC3.17 (AVDDH_2)
unnamed: C96.1, IC3.27 (AVDDH_3)
unnamed: C99.1, IC3.53 (AVDDLPLL)
unnamed: C74.1, IC3.1 (AVDDL_1)
unnamed: C75.1, IC3.11 (DVDDL_1), IC3.12 (AVDDL_2)
unnamed: C95.1, IC3.22 (AVDDL_3)
unnamed: C97.1, IC3.32 (AVDDL_4)
unnamed: C100.1, IC3.55 (AVDDL_5)
unnamed: C77.1, IC3.47 (DVDDL_3)
unnamed: IC3.54 (IBREF), R6.1
unnamed: C37.1, IC3.36 (RESETB), R8.2
unnamed: C38.1, IC3.48 (V10OUT)
unnamed: C178.1, IC5.1 (BS)
unnamed: IC5.4 (EN), R163.2, R164.1
unnamed: C179.1, IC5.3 (FB), R165.2, R166.1
unnamed: C178.2, IC5.6 (LX), L8.1
unnamed: J6.1, J6.2, R11.1, R25.1
unnamed: J6.9, R4.2
unnamed: J6.10, R7.1
unnamed: J6.11, R5.2
unnamed: J6.12, R9.1
unnamed: J6.13, Q1.3 (C), R3.1
unnamed: C35.2, J9.6
unnamed: C166.1, J10.1, L9.2
unnamed: D6.1, FL1.2, J14.3 (D+), R31.2
unnamed: D12.1, FL1.3, J14.2 (D-), R30.2
unnamed: J15.2, R147.2
unnamed: J15.4, R148.2
unnamed: J15.6, R149.2
unnamed: J15.8, R150.2
unnamed: J16.2, R151.2
unnamed: J16.4, R152.2
unnamed: J16.8, R153.2
unnamed: D4.1, D28.2, J7.2, J17.2
unnamed: J18.3, R51.1, R52.1, R53.1
unnamed: J19.3, R110.1, R111.1, R112.2
unnamed: J20.3, R114.1, R115.1, R116.1
unnamed: J26.3, R56.1, R57.1, R108.1
unnamed: D24.2, J32.1, Q2.3 (C), R160.2, R173.2
unnamed: C111.1, PS2.3 (EN), PS3.3 (EN), R124.2
unnamed: Q1.1 (B), R2.2
unnamed: Q2.1 (B), R159.2
unnamed: Q3.1 (B), R158.2
unnamed: D23.2, Q3.3 (C), R157.2
unnamed: Q4.1 (B), R170.2
unnamed: Q5.1 (B), R172.2
unnamed: R72.1, U17.P1_R_Led-
unnamed: R77.1, U17.P1_L_Led-
unnamed: R78.1, U17.P2_R_Led-
unnamed: R79.1, U17.P2_L_Led-
unnamed: R80.1, U17.P3_R_Led-
unnamed: R81.1, U17.P3_L_Led-
unnamed: R82.1, U17.P4_R_Led-
unnamed: R83.1, U17.P4_L_Led-
unnamed: R104.1, U18.P1_R_Led-
unnamed: R105.1, U18.P1_L_Led-
unnamed: R106.1, U18.P2_L_Led-
unnamed: R107.1, U18.P2_R_Led-
unnamed: R146.2, S1.1
unnamed: R154.2, U1.142
unnamed: C122.2, R125.1, U4.1 (XIN)
unnamed: C123.2, R128.2, U4.3 (XOUT), U8.3 (INA2)
unnamed: R15.2, U5.43 (ADC_AVDD)
unnamed: R17.2, U5.46 (USB_DM)
unnamed: R16.2, U5.47 (USB_DP)
unnamed: R20.1, U6.2 (~RE), U6.3 (DE)
unnamed: C54.1, U6B1.J6 (MIPI_VREFG)
unnamed: C44.2, C51.2, U6B1.D2 (REFB1)
unnamed: C45.2, C52.2, U6B1.F2 (REFB2)
unnamed: C42.2, C50.2, U6B1.H2 (REFB3)
unnamed: C40.2, C49.2, U6B1.K2 (REFB4)
unnamed: C47.2, C51.1, U6B1.C1 (REFT1)
unnamed: C48.2, C52.1, U6B1.E1 (REFT2)
unnamed: C46.2, C50.1, U6B1.G1 (REFT3)
unnamed: C43.2, C49.1, U6B1.J1 (REFT4)
unnamed: R118.1, U6B1.H7 (SA0)
unnamed: R117.1, U6B1.J5 (SA1)
unnamed: R120.2, R121.1, U6B1.J9 (SEL_18)
unnamed: R45.2, U6B1.L4 (SYS_CLK)
unnamed: R125.2, R128.1, U8.1 (INA1), U8.4 (OUT*Y2)
unnamed: C128.1, U8.5 (VCC)
unnamed: C30.1, U10.2 (FB)
unnamed: C174.1, D24.1, R161.2, R162.1, U10.4 (VC)
unnamed: D11.1, L3.1, U10.5 (VIN)
unnamed: R139.2, U14.3 (EN)
unnamed: C171.1, D23.1, R155.2, R156.1, U15.2 (FB)
unnamed: D10.1, L2.1, U15.3 (SW)
unnamed: C170.1, U15.4 (VC)
unnamed: D2.1, U17.4_1, U17.5_1
unnamed: D5.1, U17.4_2, U17.5_2
unnamed: D7.1, U17.4_3, U17.5_3
unnamed: D8.1, U17.4_4, U17.5_4
unnamed: D1.1, U18.4_1, U18.5_1
unnamed: D9.1, U18.4_2, U18.5_2
PCIE_CLK_NREQ: J3.7, J8.52, U1.92
PCIE_NRST: J3.8, J8.50, U1.90
RS485_A: J5.3, R40.1, U6.6 (A)
RS485_B: J5.2, R41.1, U6.7 (B)
RX: R19.1, U5.7 (GPIO5), U6.1 (RO)
RX0_N: U13.12, U17.2_1
RX0_P: U13.11, U17.1_1
RX1_N: U13.19, U17.2_2
RX1_P: U13.20, U17.1_2
RX2_N: U12.12, U17.2_3
RX2_P: U12.11, U17.1_3
RX3_N: U12.19, U17.2_4
RX3_P: U12.20, U17.1_4
RX4_N: U18.2_1, U19.12
RX4_P: U18.1_1, U19.11
RX5_N: U18.2_2, U19.19
RX5_P: U18.1_2, U19.20
TX: R18.1, U5.6 (GPIO4), U6.4 (DI)
TX0_N: U13.14, U17.6_1
TX0_P: U13.15, U17.3_1
TX1_N: U13.17, U17.6_2
TX1_P: U13.16, U17.3_2
TX2_N: U12.14, U17.6_3
TX2_P: U12.15, U17.3_3
TX3_N: U12.17, U17.6_4
TX3_P: U12.16, U17.3_4
TX4_N: U18.6_1, U19.14
TX4_P: U18.3_1, U19.15
TX5_N: U18.6_2, U19.17
TX5_P: U18.3_2, U19.16
VCC_3V3_S0: C147.1, C148.1, C154.1, C156.1, IC2.6 (AVDD33), IC2.18 (DVDD33), IC2.28 (AVDD33_1), IC2.34 (AVDD33_2), IC2.47 (AVDD33_3), L6.2, R132.1, R134.2, R136.2, R137.1, R139.1, R140.2, R141.2, TP12.1, U14.1 (IN)
VDD12: C112.1, C116.1, C120.1, C124.1, C126.1, L4.2, U6B1.D6 (DVDD12.2), U6B1.D8 (DVDD12.4), U6B1.F8 (DVDD12.5), U6B1.G6 (DVDD12.3), U6B1.H5 (DVDD12.1)
VIN: C28.1, C29.2, C30.2, C83.1, C169.2, C170.2, D28.1, D29.1, J4.5, J5.4, J5.5, J13.4, J13.8, K1.3 (NO), K3.3 (NO), R49.1, TP4.1, TP6.1, TP7.1, U2.2 (IN), U3.2 (IN), U10.3 (SW), U15.5 (VIN)
VRAW: D29.2, J11.1, TP5.1
XI: C39.1, IC3.52 (XI), Y4.1
XO: C61.1, IC3.51 (XO), Y4.3
