ihsanakyrk/Eski-Versionlar-Ve-Siparisler/CamTracker_CM4_V3.1/CamTracker_CM4_V3.1/CamTracker_CM4_V3.1.kicad_pcb

## KiCad design CamTracker_CM4_V3.1/CamTracker_CM4_V3.1/CamTracker_CM4_V3.1.kicad_pcb (2025-09-01)

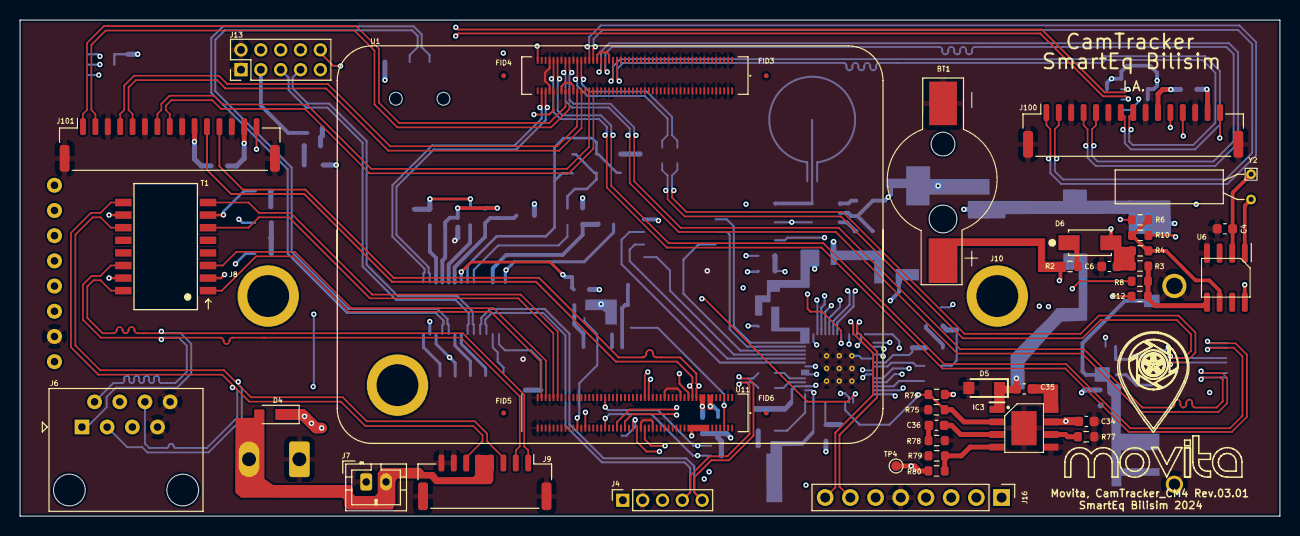
[picture p118: board CamTracker_CM4_V3.1.kicad_pcb from above]

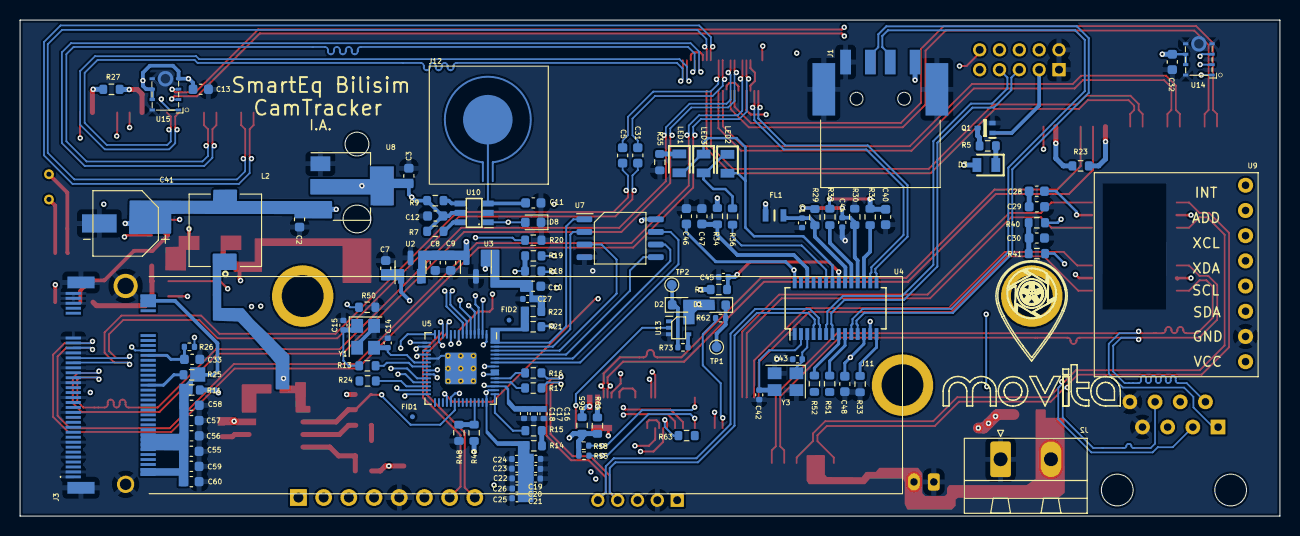
[picture p119: board CamTracker_CM4_V3.1.kicad_pcb from below]

Board: 6 copper layers, 127.0 x 50.0 mm, 163 parts (120 on the bottom side), 144 nets.

Parts:
BT1: MYOUNG MY-1220-01; BS-12-B3AA003
C1, C45: 10uF; C_0402_1005Metric
C2, C3, C7, C8, C9, C10, C34, C48: 10uF; C_0603_1608Metric
C4: 22pF; C_0603_1608Metric
C5, C31: 100nF X5R 10V; C_0603_1608Metric
C6, C35: 100nF; C_0603_1608Metric
C11: 30pF; C_0603_1608Metric
C12: 1uF; C_0603_1608Metric
C13, C32, C40, C46, C47, C55, C56, C57, C58, C59, C60: 0.1uF; C_0603_1608Metric
C14, C15, C42, C43: 27pF; C_0402_1005Metric
C16, C17, C20, C21, C22, C23, C24, C25, C26, C27: 100nF; C_0402_1005Metric
C18, C19: 1uF; C_0402_1005Metric
C28, C29: 0.01uF; C_0603_1608Metric
C30: 1000pF; C_0603_1608Metric
C33: 100nF X5R 16V; C_0603_1608Metric
C36: 150pF; C_0603_1608Metric
C41: 100uF; CAPAE660X550N
C44: 0.1uF; C_0402_1005Metric
D1: LED Green; LED_0603_1608Metric
D2: LED Red; LED_0603_1608Metric
D3: LED; LEDC2012X80N
D4: 2SS100L-W; 2SS100LW
D5: SS34FA; SODFL3618X143N
D6: SS14; DIOM4325X250N
D8: LED; LED_0603_1608Metric
FID1, FID2, FID3, FID4, FID5, FID6: Fiducial; Fiducial_0.5mm_Mask1mm
FL1: BLM21BB050SN1D; BLM21BB050SH1D
IC3: MP1584EN; SOIC127P600X170-9N
J1: USB-A Female SMD connector; USB_A_CNCTech_1001-011-01101_Horizontal
J2: DNP; PhoenixContact_MSTBA_2,5_2-G-5,08_1x02_P5.08mm_Horizontal
J3: APCI0079-P002A J8900 M.2 M Key; 121992306
J4: Conn_01x05_Male; PinSocket_1x05_P2.00mm_Vertical
J6: DNP; RJ45_Amphenol_54602-x08_Horizontal
J7: Conn_01x02_Female; JST_PH_B2B-PH-K_1x02_P2.00mm_Vertical
J8, J10: Screw_Terminal_01x01; Screw_terminal_shinbo
J9: JST_GH_BM08B-GHS-TBT_1x08-1MP_P1.25mm_Vertical
J11: M3x*0.5 L=3; Screw_terminal_shinbo
J12: DNP; Touch Pad
J13: MALE Through Hole PinHeader; PinHeader_2x05_P2.00mm_Vertical
J16: DNP; PinHeader_1x08_P2.54mm_Vertical
J100, J101: Conn_01x15_Female; JST_1x15-1MP_P1.25mm_Horizontal
L2: CDRH74NP-100MC-B; CDRH74NP100MCB
LED1, LED2, LED3: 150080VS75000; LEDC2012X80N
Q1: DTC043ZEBTL; SOTFL50P160X85-3N
R1, R7, R9, R10, R12, R19, R22, R50, R51, R52, R65: DNP; R_0603_1608Metric
R2: 150R; R_0603_1608Metric
R3, R4: 4.7K; R_0603_1608Metric
R5, R75: 2.2K; R_0603_1608Metric
R6, R8, R11, R18, R23, R24, R27, R63, R64: 0R; R_0603_1608Metric
R13, R21, R48: 1K; R_0603_1608Metric
R14: 200R; R_0603_1608Metric
R15: 1R; R_0603_1608Metric
R16, R17: 27R; R_0603_1608Metric
R20, R31, R32, R76, R78: 100K; R_0603_1608Metric
R25, R34, R49: 10K; R_0603_1608Metric
R26: 1K 5%; R_0402_1005Metric
R29, R30: 47K; R_0603_1608Metric
R33: 2.7K; R_0603_1608Metric
R35, R36: 470R; R_0603_1608Metric
R40, R41: 75R; R_0603_1608Metric
R55, R58: 2.2K 1%; R_0402_1005Metric
R62, R73: 1K; R_0402_1005Metric
R77: 200K; R_0603_1608Metric
R79: 40.2K; R_0603_1608Metric
R80: 210K; R_0603_1608Metric
T1: H1102NL
TP1, TP2, TP4: TestPoint; TestPoint_Pad_D1.0mm
U1: DF40C-100DS-0.4V; DF40C-100DS-0.4V_CM4_Unit_B
U2, U3: TLV76033DBZT; SOT-23
U4: FE1.1s; SSOP-28_3.9x9.9mm_P0.635mm
U5: RP2040; RP2040-QFN-56
U6: PCF8563T; SOIC-8_3.9x4.9mm_P1.27mm
U7: W25Q128JVS; SOIC-8_5.23x5.23mm_P1.27mm
U8: AMS1117-3.3; SOT-223-3_TabPin2
U9: DNP; module_mpu6050
U10: TTP223
U11: DF40C-100DS-0.4V; DF40C-100DS-0.4V_CM4_Unit_A
U13: 74LVC1G07SE-7; SOT-353_SC-70-5
U14, U15: INMP441
Y1, Y3: Crystal_GND12Mhz; Crystal_SMD_3225-4Pin_3.2x2.5mm
Y2: 32.768 KHz; Crystal_AT310_D3.0mm_L10.0mm_Horizontal

Connections:
3.3V_HUB: C40.1, C45.2, R1.1, R31.2, R32.2, U4.13 (VD33), U4.21 (VD33_O)
5V_A: C1.2, FL1.2, R29.2, U4.20 (VDD5)
+1V1: C16.1, C17.1, C18.1, U5.23 (DVDD), U5.45 (VREG_VOUT), U5.50 (DVDD)
/CM4/+1.8v: R65.1, U11.88 (+1.8v_(Output)), U11.90 (+1.8v_(Output))
/CM4/+5v: C2.2, C41.1, D3.2 (A), FL1.1, J1.1 (VBUS), L2.2, R34.2, R80.2, TP4.1, U8.3 (VI), U11.77 (+5v_(Input)), U11.79 (+5v_(Input)), U11.81 (+5v_(Input)), U11.83 (+5v_(Input)), U11.85 (+5v_(Input)), U11.87 (+5v_(Input))
/CM4/CAM0_C_N: J100.7, U1.140 (CAM0_C_N)
/CM4/CAM0_C_P: J100.8, U1.142 (CAM0_C_P)
/CM4/CAM0_D0_N: J100.1, U1.128 (CAM0_D0_N)
/CM4/CAM0_D0_P: J100.2, U1.130 (CAM0_D0_P)
/CM4/CAM0_D1_N: J100.4, U1.134 (CAM0_D1_N)
/CM4/CAM0_D1_P: J100.5, U1.136 (CAM0_D1_P)
/CM4/CAM1_C_N: J101.7, U1.127 (CAM1_C_N)
/CM4/CAM1_C_P: J101.8, U1.129 (CAM1_C_P)
/CM4/CAM1_D0_N: J101.1, U1.115 (CAM1_D0_N)
/CM4/CAM1_D0_P: J101.2, U1.117 (CAM1_D0_P)
/CM4/CAM1_D1_N: J101.4, U1.121 (CAM1_D1_N)
/CM4/CAM1_D1_P: J101.5, U1.123 (CAM1_D1_P)
/CM4/CM4_+3.3v: D1.2 (A), D2.2 (A), J100.14, J101.14, R23.1, R27.1, R64.1, U11.84 (+3.3v_(Output)), U11.86 (+3.3v_(Output)), U13.5 (VCC)
/CM4/CM4_PCF_SCL: R4.2, R6.1, R10.1, U6.6 (SCL)
/CM4/CM4_PCF_SDA: R3.2, R8.1, R12.1, U6.5 (SDA)
/CM4/GPIO2: R8.2, U11.58 (GPIO2)
/CM4/GPIO3: R6.2, U11.56 (GPIO3)
/CM4/GPIO14: U5.28 (GPIO17), U11.55 (GPIO14)
/CM4/GPIO15: U5.27 (GPIO16), U11.51 (GPIO15)
/CM4/GPIO18: R63.1, U11.49 (GPIO18)
/CM4/GPIO21: J100.15, J101.15, U11.25 (GPIO21)
/CM4/GPIO24: U5.25 (SWD), U11.45 (GPIO24)
/CM4/GPIO25: U5.24 (SWCLK), U11.41 (GPIO25)
/CM4/GPIO_VREF: R55.1, R58.1, R64.2, R65.2, U11.78 (GPIO_VREF(1.8v/3.3v_Input))
/CM4/ID_SC: J100.11, R55.2, U11.35 (ID_SC)
/CM4/ID_SD: J100.12, R58.2, U11.36 (ID_SD)
/CM4/PCIE_CLK_N: J3.53, U1.112 (PCIe_CLK_N)
/CM4/PCIE_CLK_P: J3.55, U1.110 (PCIe_CLK_P)
/CM4/PCIE_CLK_nREQ: J3.52, U1.102 (PCIe_CLK_nREQ)
/CM4/PCIE_RX_N: J3.41, U1.118 (PCIe_RX_N)
/CM4/PCIE_RX_P: J3.43, U1.116 (PCIe_RX_P)
/CM4/PCIE_TX_N: C5.2, U1.124 (PCIe_TX_N)
/CM4/PCIE_TX_P: C31.2, U1.122 (PCIe_TX_P)
/CM4/PCIE_nRST: R26.2, U1.109 (PCIe_nRST)
/CM4/SCL0: J101.11, R10.2, U11.80 (SCL0)
/CM4/SDA0: J101.12, R12.2, U11.82 (SDA0)
/CM4/USB2_N: U1.103 (USB2_N), U4.15 (DMU)
/CM4/USB2_P: U1.105 (USB2_P), U4.16 (DPU)
/CM4/nPWR_LED: U11.95 (nPI_LED_PWR), U13.2
/I2C/3V3_Sensor: C6.1, C7.2, D6.2, R3.1, R4.1, U2.1 (OUT), U9.1 (VCC)
/I2C/SCL_RP2040: R18.1, U9.3 (SCL)
/INMP441/+3.3V: C3.2, C12.1, C13.1, C32.1, R1.2, R7.1, R9.1, R11.1, U8.2 (VO), U10.5 (VDD), U14.7 (VDD), U14.8 (CHIEN), U15.4 (L/R), U15.7 (VDD), U15.8 (CHIEN)
/INMP441/SCK: R19.1, U14.1 (SCK), U15.1 (SCK)
/PCIE/3.3V_XL: C55.1, C56.1, C57.1, C58.1, C59.1, C60.1, J3.2, J3.4, J3.12, J3.14, J3.16, J3.18, J3.70, J3.72, J3.74, R11.2, R25.2
/PCIE/TX_N: C5.1, J3.47
/PCIE/TX_P: C31.1, J3.49
/Power Unit/+3V3: C10.2, C19.1, C20.1, C21.1, C22.1, C23.1, C24.1, C25.1, C26.1, C27.1, J16.6, R14.1, R22.1, U3.1 (OUT), U5.1 (IOVDD), U5.10 (IOVDD), U5.22 (IOVDD), U5.33 (IOVDD), U5.42 (IOVDD), U5.44 (VREG_IN), U5.48 (USB_VDD), U5.49 (IOVDD), U7.8 (VCC)
/RP2040/GPIO0: U5.2 (GPIO0), U9.4 (SDA)
/RP2040/GPIO1: R18.2, R19.2, U5.3 (GPIO1)
/RP2040/GPIO2: R20.1, U5.4 (GPIO2), U14.2 (SD), U15.2 (SD)
/RP2040/GPIO3: U5.5 (GPIO3), U14.3 (WS), U15.3 (WS)
/RP2040/GPIO4_TX: J13.10, U5.6 (GPIO4)
/RP2040/GPIO5_RX: J13.9, U5.7 (GPIO5)
/RP2040/GPIO6: D8.2 (A), U5.8 (GPIO6), U10.1 (Q)
/RP2040/GPIO15: R50.1, U5.18 (GPIO15)
/RP2040/GPIO21: J13.6, U5.32 (GPIO21)
/RP2040/GPIO22: IC3.2 (EN), R75.1, R76.2, U5.34 (GPIO22)
/RP2040/GPIO27_ADC1: R48.1, R49.2, U5.39 (GPIO27_ADC1)
/RP2040/QSPI_SCLK: U5.52 (QSPI_SCLK), U7.6 (CLK)
/RP2040/QSPI_SD0: U5.53 (QSPI_SD0), U7.5 (DI(IO0))
/RP2040/QSPI_SD1: U5.55 (QSPI_SD1), U7.2 (DO(IO1))
/RP2040/QSPI_SD2: U5.54 (QSPI_SD2), U7.3 (IO2)
/RP2040/QSPI_SD3: U5.51 (QSPI_SD3), U7.7 (IO3)
/RP2040/QSPI_SS: R21.1, R22.2, U5.56 (QSPI_SS), U7.1 (~CS)
/RP2040/USB_RP2040_D+: J4.5, R16.1, U4.5 (DP4)
/RP2040/USB_RP2040_D-: J4.4, R17.1, U4.4 (DM4)
/RP2040/XIN: C14.1, U5.20 (XIN), Y1.3
/RP2040/XOUT: R13.1, U5.21 (XOUT)
/RP2040/~USB_BOOT: J4.3, R21.2
/TopBoard_Connection/USB_GSM_D+: J13.5, U4.7 (DP3)
/TopBoard_Connection/USB_GSM_D-: J13.7, U4.6 (DM3)
ADC_VREF: R14.2, R15.1
DRV1: LED1.2, LED2.2, LED3.1, U4.22 (DRV)
GND: BT1.2 (-), C1.1, C2.1, C3.1, C4.2, C6.2, C7.1, C8.1, C9.1, C10.1, C11.2, C12.2, C13.2, C14.2, C15.2, C16.2, C17.2, C18.2, C19.2, C20.2, C21.2, C22.2, C23.2, C24.2, C25.2, C26.2, C27.2, C29.2, C30.2, C32.2, C33.1, C34.1, C40.2, C41.2, C42.2, C43.2, C44.2, C45.1, C46.2, C47.2, C48.2, C55.2, C56.2, C57.2, C58.2, C59.2, C60.2, D5.2, D8.1 (K), IC3.5 (GND), IC3.9 (EP), J1.4 (GND), J1.5 (Shield), J2.1, J3.1, J3.3, J3.9, J3.15, J3.21, J3.27, J3.33, J3.39, J3.45, J3.51, J3.57, J3.71, J3.73, J3.75, J3.MH1, J3.MH2, J3.MP1, J3.MP2, J4.2, J6.7, J6.8, J7.1, J9.7, J9.8, J9.MP, J13.1, J13.2, J16.5, J100.3, J100.6, J100.9, J100.13, J101.3, J101.6, J101.9, J101.13, Q1.2, R20.2, R30.2, R33.2, R35.2, R48.2, R50.2, R75.2, R77.2, R78.2, R79.2, U1.107 (GND), U1.108 (GND), U1.113 (GND), U1.114 (GND), U1.119 (GND), U1.120 (GND), U1.125 (GND), U1.126 (GND), U1.131 (GND), U1.132 (GND), U1.137 (GND), U1.138 (GND), U1.144 (GND), U1.150 (GND), U1.155 (GND), U1.156 (GND), U1.161 (GND), U1.162 (GND), U1.167 (GND), U1.168 (GND), U1.173 (GND), U1.174 (GND), U1.179 (GND), U1.180 (GND), U1.185 (GND), U1.186 (GND), U1.191 (GND), U1.192 (GND), U1.197 (GND), U1.198 (GND), U2.3 (GND), U3.3 (GND), U4.1 (VSS), U5.19 (TESTEN), U5.57 (GND), U6.4 (VSS), U7.4 (GND), U8.1 (GND), U9.2 (GND), U10.2 (VSS), U11.1 (GND), U11.2 (GND), U11.7 (GND), U11.8 (GND), U11.13 (GND), U11.14 (GND), U11.22 (GND), U11.23 (GND), U11.32 (GND), U11.33 (GND), U11.42 (GND), U11.43 (GND), U11.52 (GND), U11.53 (GND), U11.59 (GND), U11.60 (GND), U11.65 (GND), U11.66 (GND), U11.71 (GND), U11.74 (GND), U11.98 (GND), U13.3 (GND), U14.4 (L/R), U14.5 (GND), U14.6 (GND), U14.9 (GND), U15.5 (GND), U15.6 (GND), U15.9 (GND), Y1.2, Y1.4, Y3.2, Y3.4
LED1: R36.2, U4.23 (LED1/EESCL)
unnamed: BT1.1 (+), R2.2, U6.8 (VDD)
unnamed: C15.1, R13.2, Y1.1
unnamed: C28.2, C29.1
unnamed: C30.1, R40.1, R41.1
unnamed: C33.2, J3.50, R26.1
unnamed: C36.1, R78.1
unnamed: D1.1 (K), R62.1, TP1.1
unnamed: D2.1 (K), R73.1, TP2.1
unnamed: D3.1 (K), R5.1
unnamed: D6.1, R2.1
unnamed: C35.2, IC3.8 (BST)
unnamed: C36.2, IC3.3 (COMP)
unnamed: IC3.4 (FB), R79.1, R80.1
unnamed: IC3.6 (FREQ), R77.1
unnamed: C35.1, D5.1, IC3.1 (SW), L2.1
unnamed: J3.38, R25.1
unnamed: J13.3, Q1.1
unnamed: J100.10, R27.2
unnamed: J101.10, R23.2
unnamed: LED1.1, R35.1
unnamed: LED2.1, LED3.2, R36.1
unnamed: Q1.3, R5.2
unnamed: R73.2, U13.4
unnamed: C28.1, T1.2 (CT1), T1.7 (CT2)
unnamed: R40.2, T1.10 (CT3)
unnamed: R41.2, T1.15 (CT4)
unnamed: R32.1, U4.19 (BUSJ)
unnamed: R52.2, U4.8 (DM2)
unnamed: R51.2, U4.9 (DP2)
unnamed: R33.1, U4.14 (REXT)
unnamed: C44.1, R29.1, R30.1, U4.18 (VBUSM)
unnamed: C46.1, C48.1, U4.12 (VD18_O), U4.28 (VD18)
unnamed: C43.1, U4.3 (XIN), Y3.1
unnamed: C42.1, U4.2 (XOUT), Y3.3
unnamed: R31.1, U4.17 (~XRSTJ)
unnamed: R15.2, U5.43 (ADC_AVDD)
unnamed: R24.1, U5.26 (RUN)
unnamed: R17.2, U5.46 (USB_DM)
unnamed: R16.2, U5.47 (USB_DP)
unnamed: U6.1 (OSCI), Y2.2
unnamed: C4.1, U6.2 (OSCO), Y2.1
unnamed: R9.2, U10.4 (AHLB)
unnamed: C11.1, J12.1, U10.3 (I)
unnamed: R7.2, U10.6 (TOG)
unnamed: R62.2, U11.21 (PI_nLED_Activity)
OVCJ: C47.1, R34.1, U4.26 (OVCJ)
RX_N: T1.8 (RD-), U11.12 (Ethernet_Pair0_P)
RX_P: T1.6 (RD+), U11.10 (Ethernet_Pair0_N)
SCL_9: J16.7, U5.12 (GPIO9)
SDA_8: J16.8, U5.11 (GPIO8)
SPI_CS_13: J16.1, U5.16 (GPIO13)
SPI_RX_12: J16.2, U5.15 (GPIO12)
SPI_SCK_10: J16.4, U5.13 (GPIO10)
SPI_TX_11: J16.3, U5.14 (GPIO11)
TRD0_N: J6.2, J9.2, T1.14 (TX-)
TRD0_P: J6.1, J9.1, T1.16 (TX+)
TRD1_N: J6.6, J9.6, T1.9 (RX-)
TRD1_P: J6.3, J9.3, T1.11 (RX+)
TX_N: T1.3 (TD-), U11.6 (Ethernet_Pair1_N)
TX_P: T1.1 (TD+), U11.4 (Ethernet_Pair1_P)
USB_CON_A_D+: J1.3 (D+), U4.11 (DP1)
USB_CON_A_D-: J1.2 (D-), U4.10 (DM1)
VIN: C8.2, C9.2, C34.2, D4.1, IC3.7 (VIN), J4.1, J13.4, J13.8, R49.1, R76.1, U2.2 (IN), U3.2 (IN)
VRAW: D4.2, J2.2, J6.4, J6.5, J7.2, J9.4, J9.5
