ihsanakyrk/Eski-Versionlar-Ve-Siparisler/KSS_Bağlantı kutusu_V2.0(Eski nesil hub)/RP2040_minimal.kicad_pcb

## KiCad design KSS_Bağlantı kutusu_V2.0(Eski nesil hub)/RP2040_minimal.kicad_pcb (2025-09-01)

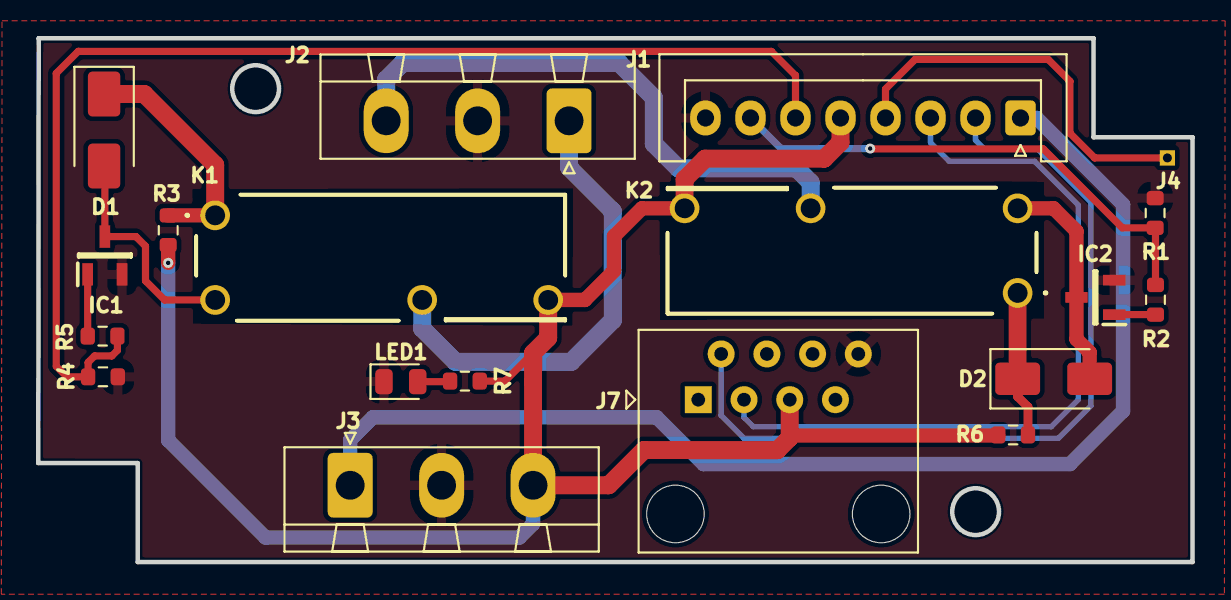
[picture p120: board KSS_Bağlantı kutusu_V2.0(Eski nesil hub)/RP2040_minimal.kicad_pcb from above]

Board: 2 copper layers, 64.1 x 29.1 mm, 19 parts (0 on the bottom side), 17 nets.

Parts:
D1, D2: MRA4007T3G; D_SMA
IC1, IC2: MMBT2222ALT1G; SOT96P237X111-3N
J1: Conn_01x08_Socket; JST_XH_S8B-XH-A_1x08_P2.50mm_Horizontal
J2, J3: Conn_01x03_Pin; KF2EDGR-Y-5.08-03P-1 B
J4: DNP; PinHeader_1x01_P1.00mm_Horizontal
J7: 8P8C; RJ45_Amphenol_54602-x08_Horizontal
K1, K2: HF46F5HS1
LED1: NCD0805R1; LED_0805_2012Metric
R1, R2, R4, R5: 10K; R_0603_1608Metric
R3, R6: 0R; R_0603_1608Metric
R7: 3.3K; R_0603_1608Metric

Connections:
/Flash: J2.3, K2.3
/GPIO6: J1.6, R4.2, R5.2
/GPIO7: J1.7, R1.2, R2.2
/GPIO19: J1.4, J4.1
/HORN: J2.1, K1.3
/IGN: J1.1, J3.1
GND: IC1.2 (E), IC2.2 (E), J1.8, J2.2, J3.2, J7.8, LED1.1, R1.1, R4.1
unnamed: D1.2 (A), IC1.3 (C), K1.2
unnamed: D1.1 (K), K1.1, R3.1
unnamed: D2.2 (A), IC2.3 (C), K2.2
unnamed: D2.1 (K), K2.1, R6.1
unnamed: IC1.1 (B), R5.1
unnamed: IC2.1 (B), R2.1
unnamed: LED1.2, R7.2
RS485_A: J1.3, J7.3
RS485_B: J1.2, J7.2
VBUS: J1.5, J3.3, J7.5, K1.4, K2.4, R3.2, R6.2, R7.1
