ihsanakyrk/Eski-Versionlar-Ve-Siparisler/KSS_Led_Panel_V1.0(Yeni nesil)/KSS_LP_V1.0/KSS_LP_V1.0.kicad_pcb

## KiCad design KSS_Led_Panel_V1.0(Yeni nesil)/KSS_LP_V1.0/KSS_LP_V1.0.kicad_pcb (2025-09-01)

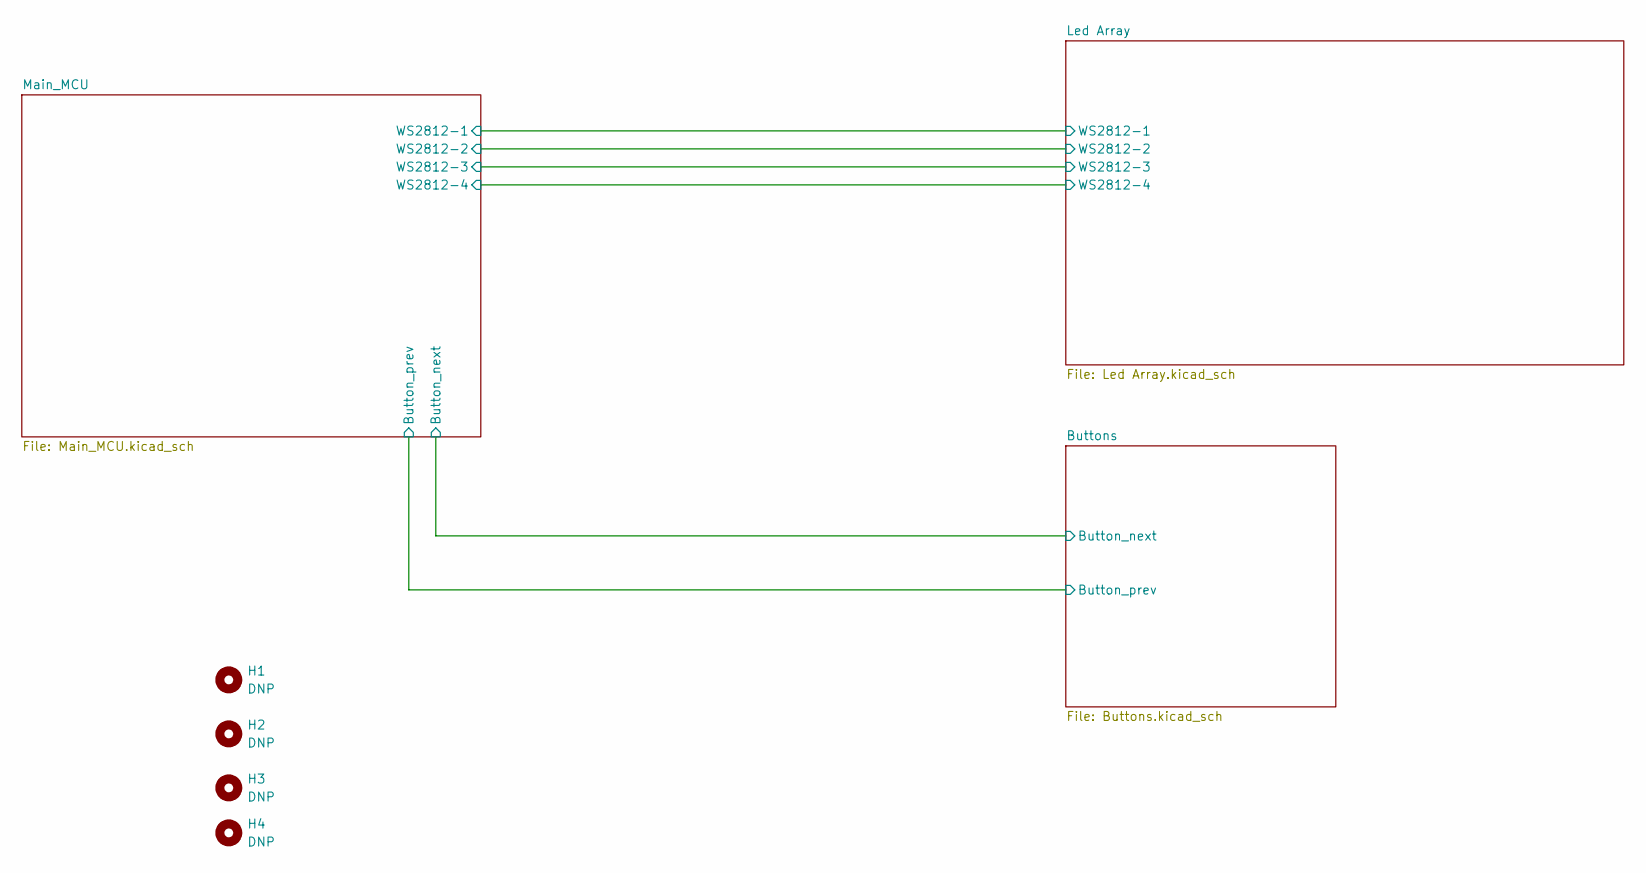
[picture p121: schematic KSS_LP_V1.0.kicad_sch, KSS-E]

Parts:
H1, H2, H3, H4: DNP; MountingHole_3mm

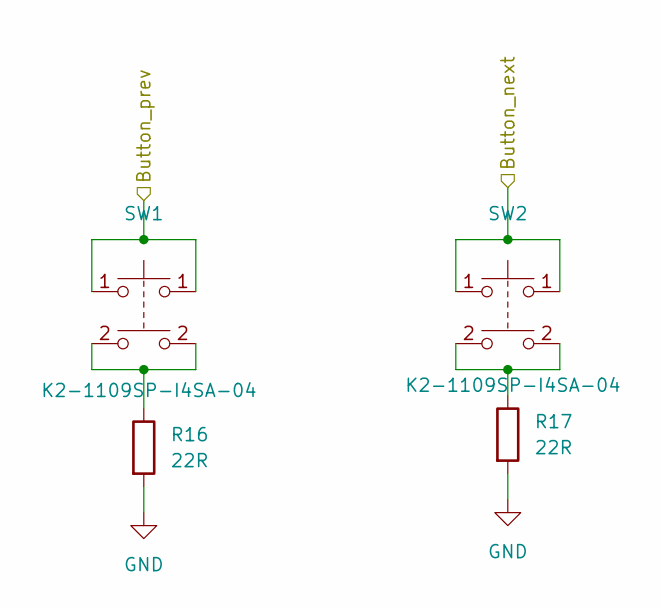
[picture p122: schematic Buttons.kicad_sch]

Parts:
R16, R17: 22R; R_0603_1608Metric
SW1, SW2: K2-1109SP-I4SA-04

Connections:
/Main_MCU/GPIO2: SW1.1; also elsewhere on the board
/Main_MCU/GPIO3: SW2.1; also elsewhere on the board
GND: R16.2, R17.2; also elsewhere on the board
unnamed: R16.1, SW1.2
unnamed: R17.1, SW2.2

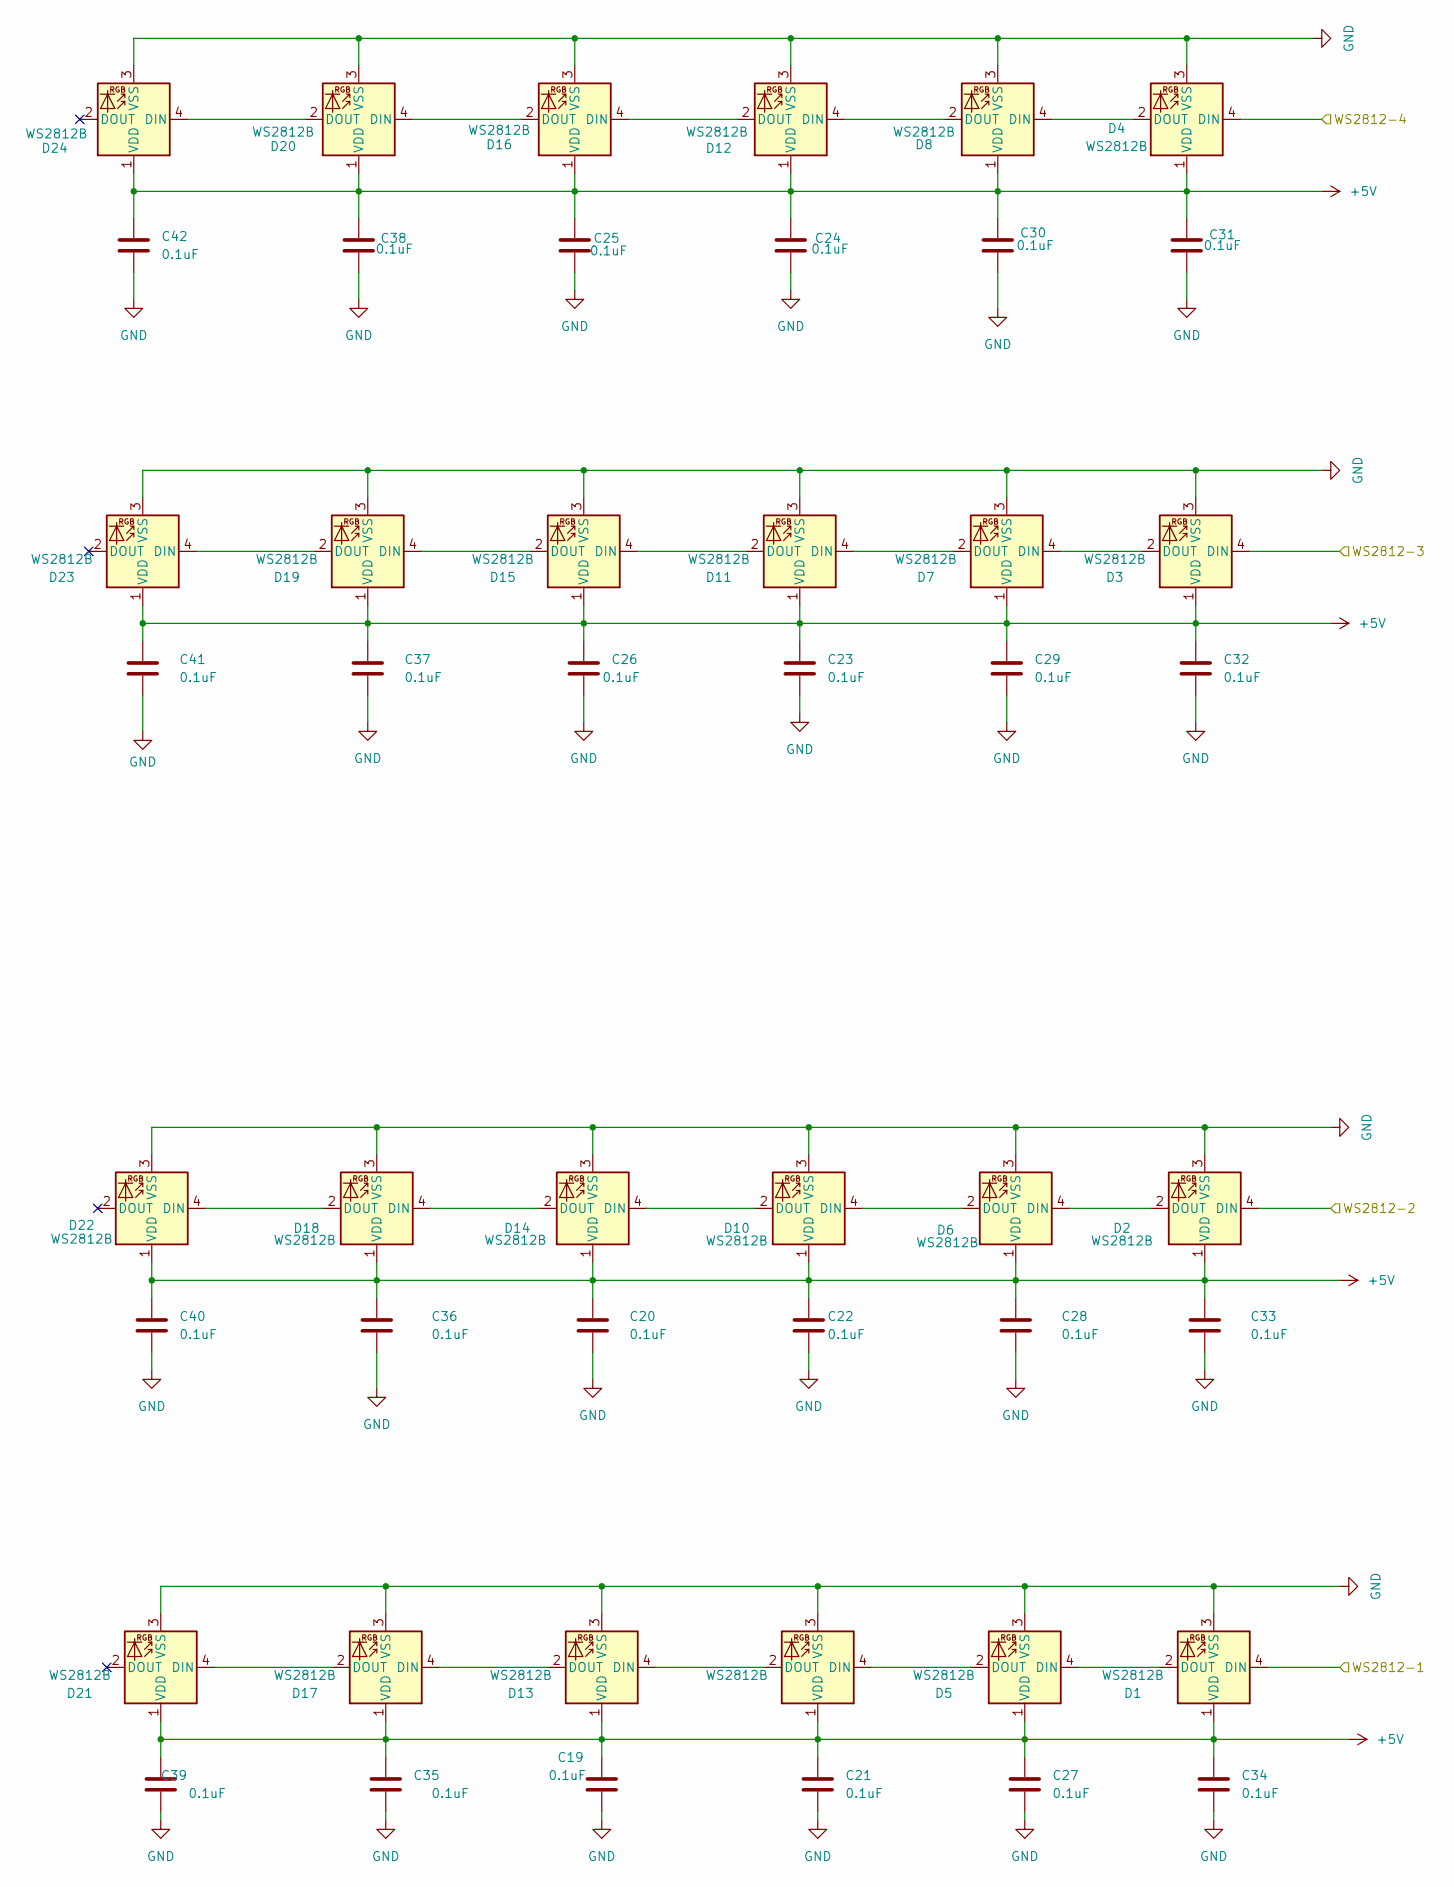
[picture p123: schematic Led Array.kicad_sch]

Parts:
C19, C20, C21, C22, C23, C24, C25, C26, C27, C28, C29, C30, C31, C32, C33, C34, C35, C36, C37, C38, C39, C40, C41, C42: 0.1uF; C_0603_1608Metric
D1, D2, D3, D4, D5, D6, D7, D8, D9, D10, D11, D12, D13, D14, D15, D16, D17, D18, D19, D20, D21, D22, D23, D24: WS2812B; LED_WS2812B_PLCC4_5.0x5.0mm_P3.2mm

Connections:
+5V: C19.1, C20.1, C21.1, C22.1, C23.1, C24.1, C25.1, C26.1, C27.1, C28.1, C29.1, C30.1, C31.1, C32.1, C33.1, C34.1, C35.1, C36.1, C37.1, C38.1, C39.1, C40.1, C41.1, C42.1, D1.1 (VDD), D2.1 (VDD), D3.1 (VDD), D4.1 (VDD), D5.1 (VDD), D6.1 (VDD), D7.1 (VDD), D8.1 (VDD), D9.1 (VDD), D10.1 (VDD), D11.1 (VDD), D12.1 (VDD), D13.1 (VDD), D14.1 (VDD), D15.1 (VDD), D16.1 (VDD), D17.1 (VDD), D18.1 (VDD), D19.1 (VDD), D20.1 (VDD), D21.1 (VDD), D22.1 (VDD), D23.1 (VDD), D24.1 (VDD); also elsewhere on the board
/Main_MCU/GPIO10: D4.4 (DIN); also elsewhere on the board
/Main_MCU/GPIO11: D3.4 (DIN); also elsewhere on the board
/Main_MCU/GPIO12: D2.4 (DIN); also elsewhere on the board
/Main_MCU/GPIO13: D1.4 (DIN); also elsewhere on the board
GND: C19.2, C20.2, C21.2, C22.2, C23.2, C24.2, C25.2, C26.2, C27.2, C28.2, C29.2, C30.2, C31.2, C32.2, C33.2, C34.2, C35.2, C36.2, C37.2, C38.2, C39.2, C40.2, C41.2, C42.2, D1.3 (VSS), D2.3 (VSS), D3.3 (VSS), D4.3 (VSS), D5.3 (VSS), D6.3 (VSS), D7.3 (VSS), D8.3 (VSS), D9.3 (VSS), D10.3 (VSS), D11.3 (VSS), D12.3 (VSS), D13.3 (VSS), D14.3 (VSS), D15.3 (VSS), D16.3 (VSS), D17.3 (VSS), D18.3 (VSS), D19.3 (VSS), D20.3 (VSS), D21.3 (VSS), D22.3 (VSS), D23.3 (VSS), D24.3 (VSS); also elsewhere on the board
unnamed: D1.2 (DOUT), D5.4 (DIN)
unnamed: D2.2 (DOUT), D6.4 (DIN)
unnamed: D3.2 (DOUT), D7.4 (DIN)
unnamed: D4.2 (DOUT), D8.4 (DIN)
unnamed: D5.2 (DOUT), D9.4 (DIN)
unnamed: D6.2 (DOUT), D10.4 (DIN)
unnamed: D10.2 (DOUT), D14.4 (DIN)
unnamed: D7.2 (DOUT), D11.4 (DIN)
unnamed: D11.2 (DOUT), D15.4 (DIN)
unnamed: D8.2 (DOUT), D12.4 (DIN)
unnamed: D12.2 (DOUT), D16.4 (DIN)
unnamed: D9.2 (DOUT), D13.4 (DIN)
unnamed: D13.2 (DOUT), D17.4 (DIN)
unnamed: D14.2 (DOUT), D18.4 (DIN)
unnamed: D15.2 (DOUT), D19.4 (DIN)
unnamed: D16.2 (DOUT), D20.4 (DIN)
unnamed: D17.2 (DOUT), D21.4 (DIN)
unnamed: D18.2 (DOUT), D22.4 (DIN)
unnamed: D19.2 (DOUT), D23.4 (DIN)
unnamed: D20.2 (DOUT), D24.4 (DIN)
