ihsanakyrk/Eski-Versionlar-Ve-Siparisler/KSS_Led_Panel_V1.0(Yeni nesil)/KSS_LP_V1.0/KSS_LP_V1.0.kicad_pcb

## KiCad design KSS_Led_Panel_V1.0(Yeni nesil)/KSS_LP_V1.0/KSS_LP_V1.0.kicad_pcb (continued)

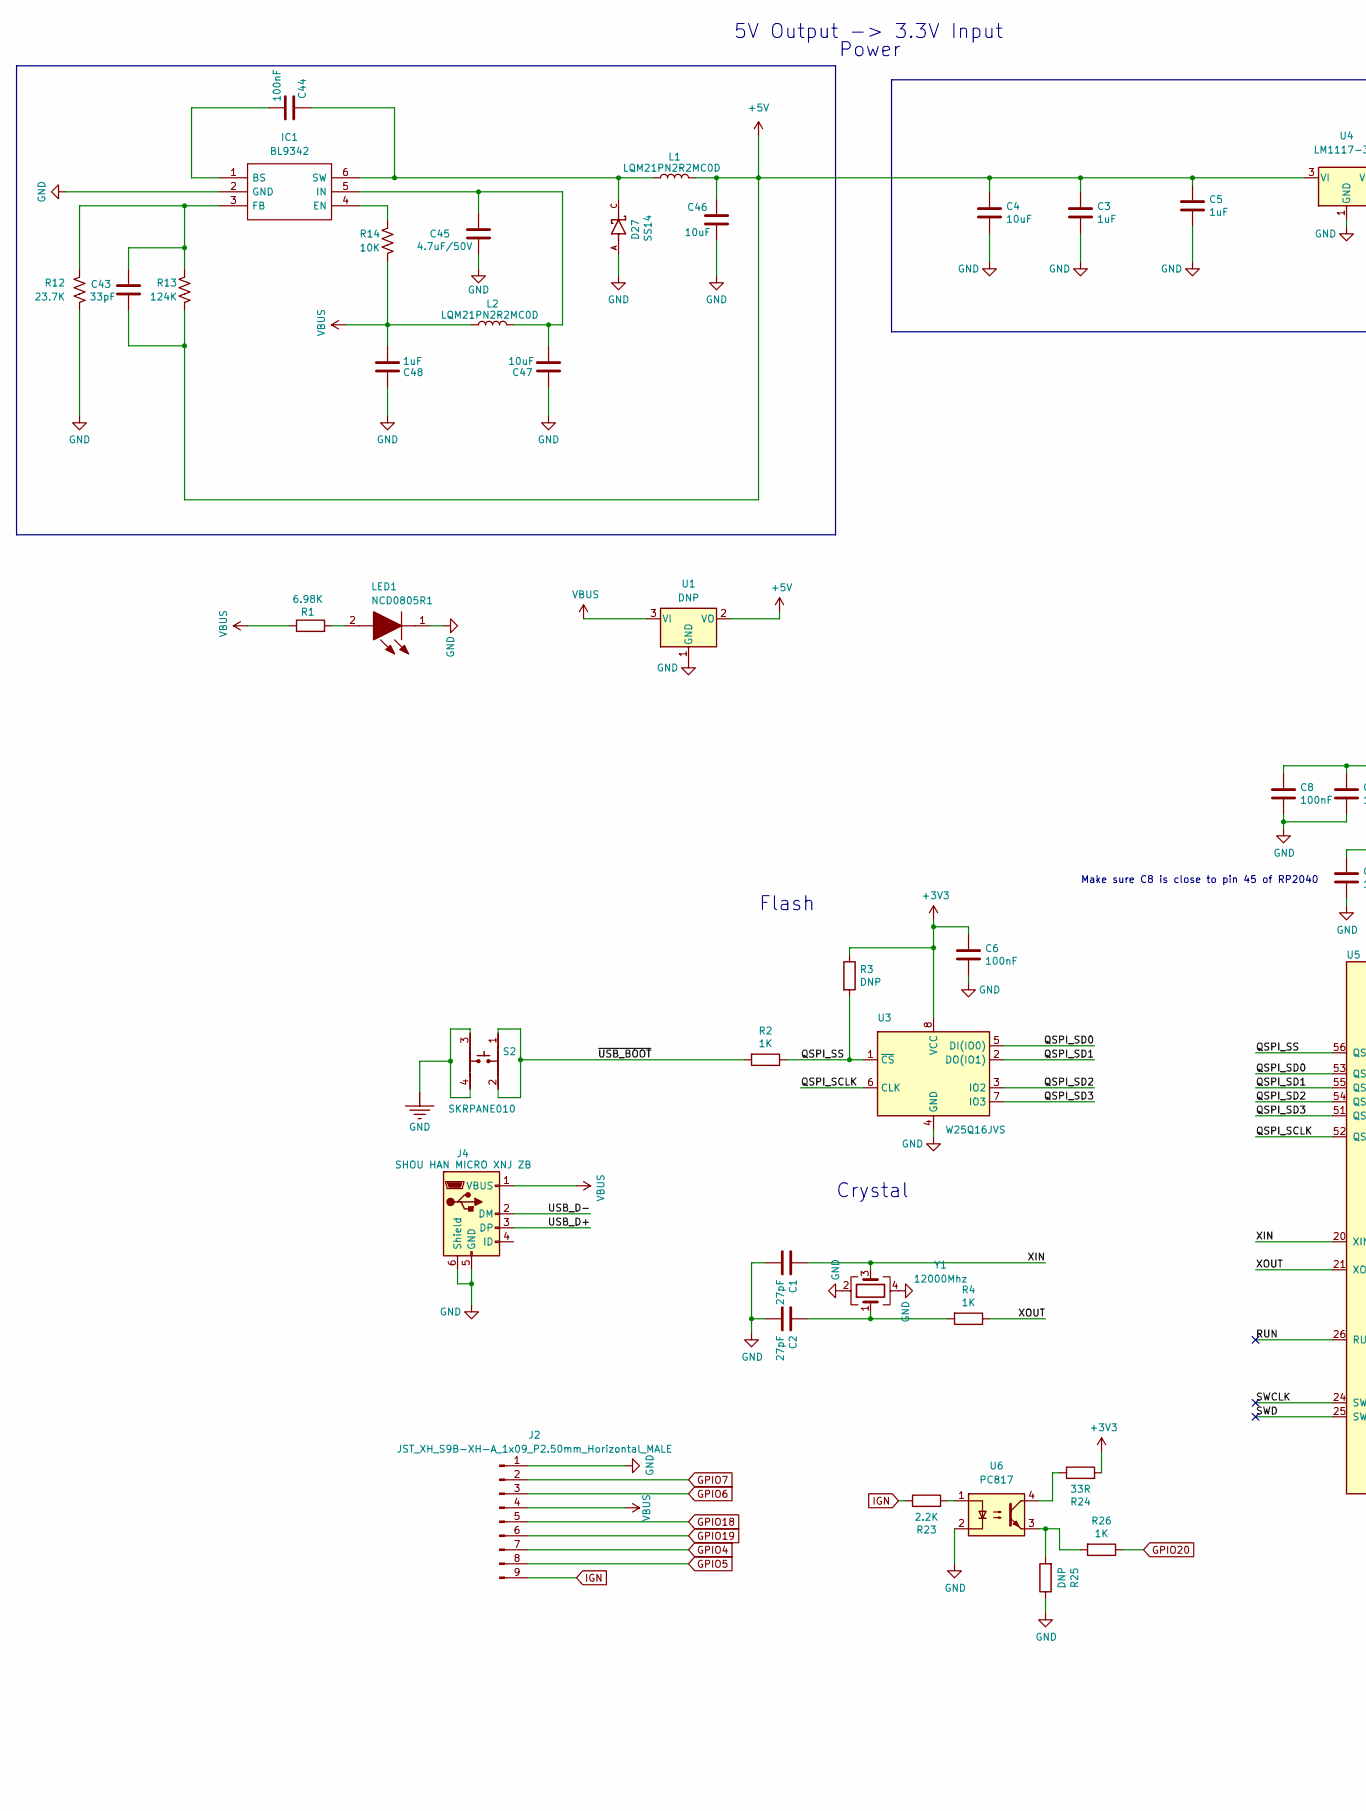
[picture p124: schematic Main_MCU.kicad_sch, part in row 1, column 1]

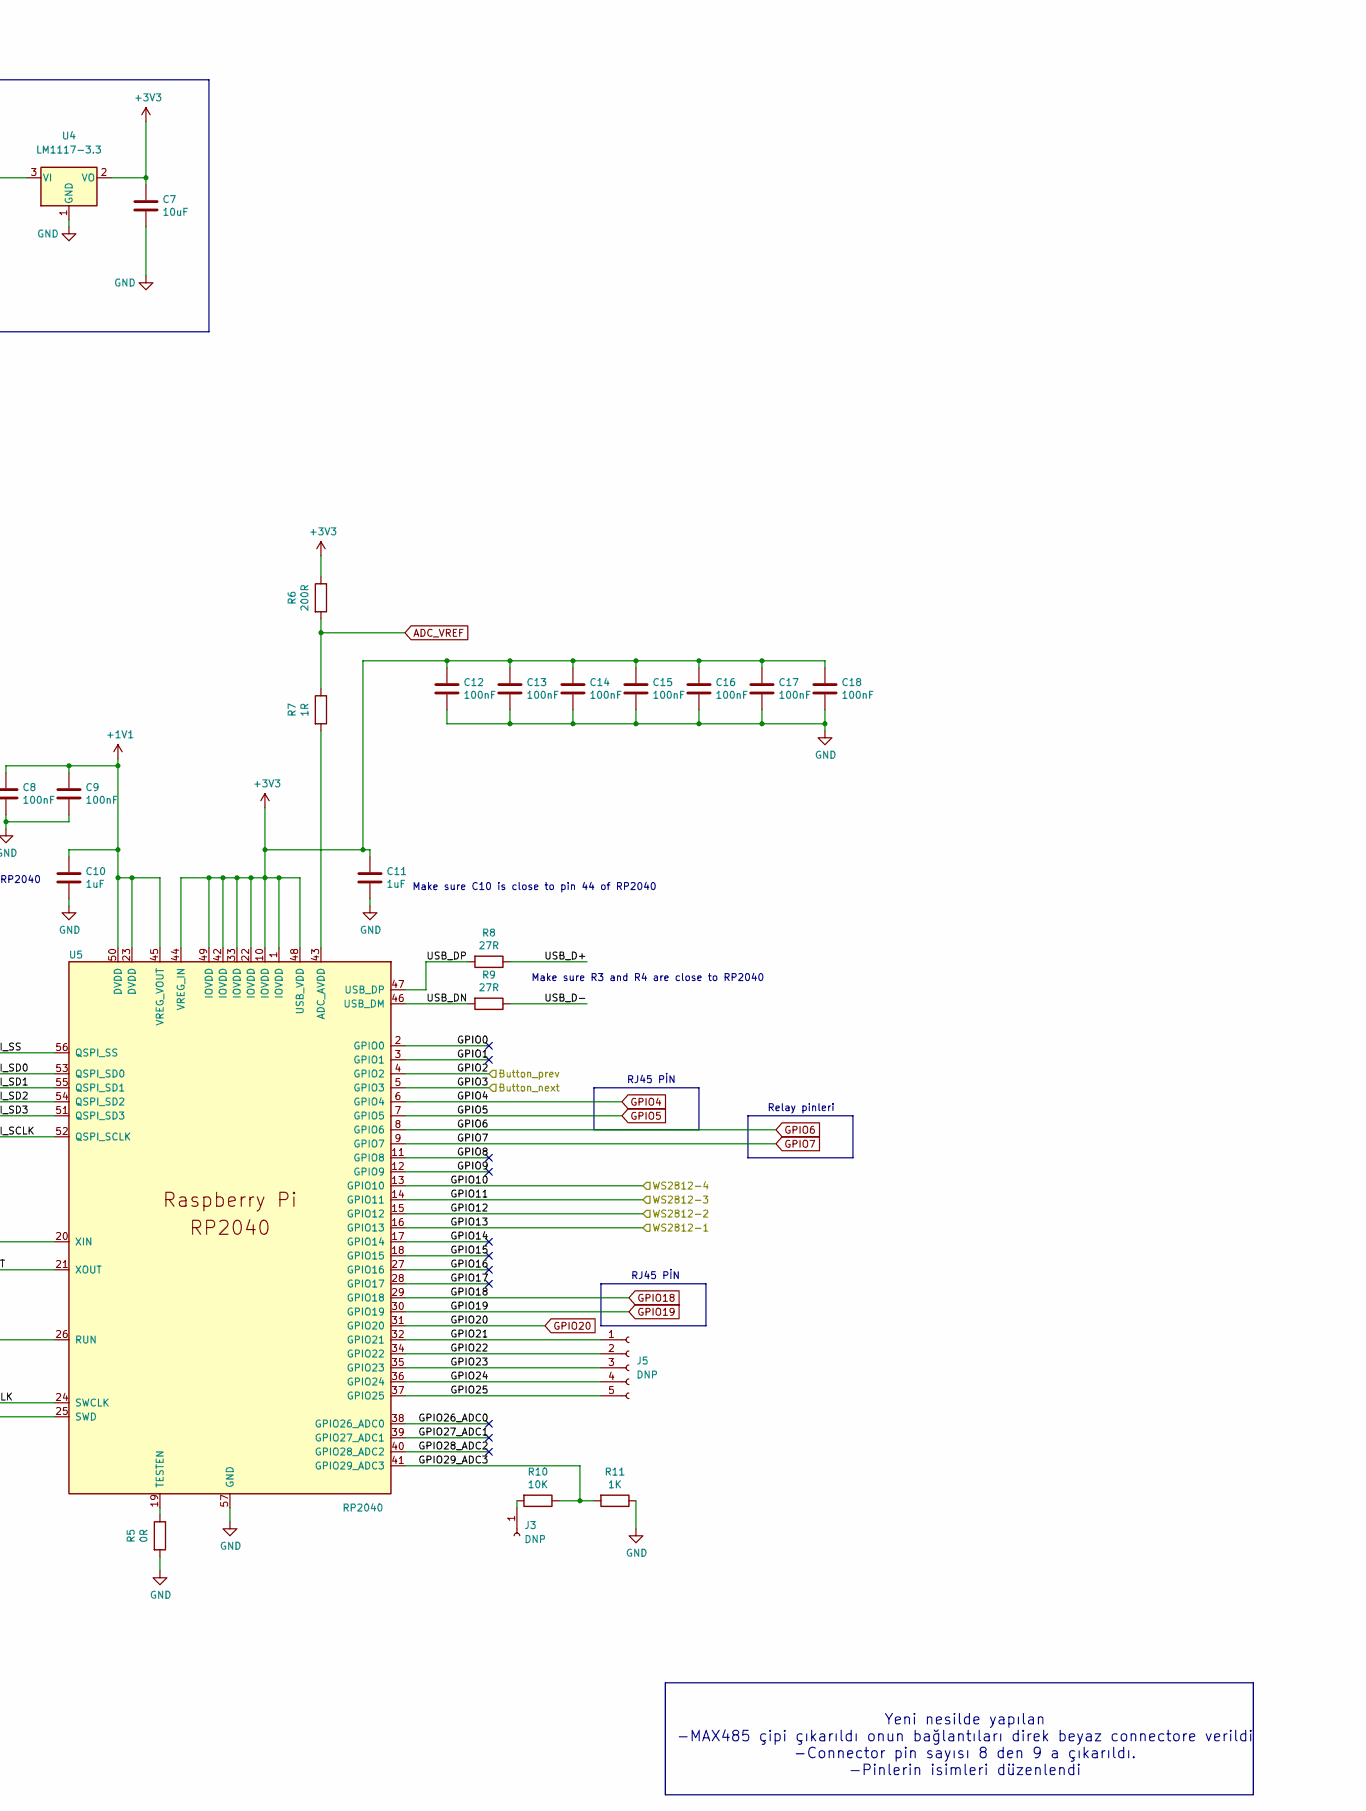
[picture p125: schematic Main_MCU.kicad_sch, part in row 1, column 2]

Parts:
C1, C2: 27pF; C_0402_1005Metric
C3, C5: 1uF; C_0805_2012Metric
C4, C7: 10uF; C_0805_2012Metric
C6, C8, C9, C12, C13, C14, C15, C16, C17, C18: 100nF; C_0402_1005Metric
C10, C11: 1uF; C_0402_1005Metric
C43: 33pF; C_0603_1608Metric; MPN CL10C330JB8NNNC
C44: 100nF; C_0603_1608Metric; MPN 0603B104K500NT
C45: 4.7uF/50V; C_0603_1608Metric
C46, C47: 10uF; C_0603_1608Metric; MPN CL10A106MO8NQNC
C48: 1uF; C_0603_1608Metric
D27: SS14; MPN SS14 SOD-123FL
IC1: BL9342; SOT-23-6; MPN BL9342
J2: JST_XH_S9B-XH-A_1x09_P2.50mm_Horizontal_MALE; JST_XH_S9B-XH-A_1x09_P2.50mm_Horizontal
J3: DNP; PinHeader_1x01_P1.00mm_Vertical
J4: SHOU HAN MICRO XNJ ZB; Micro-B SMD; MPN SHOU HAN MICRO XNJ ZB
J5: DNP; PinHeader_1x05_P2.00mm_Vertical
L1, L2: LQM21PN2R2MC0D; L_0805_2012Metric; MPN LQM21PN2R2MC0D
LED1: NCD0805R1; LED_0805_2012Metric; Manufacturer_Part_Number 150080VS75000; Mouser Part Number 710-150080VS75000
R1: 6.98K; C_0402_1005Metric
R2, R4, R11, R26: 1K; C_0402_1005Metric
R3, R25: DNP; C_0402_1005Metric
R5: 0R; C_0402_1005Metric
R6: 200R; C_0402_1005Metric
R7: 1R; C_0402_1005Metric
R8, R9: 27R; C_0402_1005Metric
R10: 10K; C_0402_1005Metric
R12: 23.7K; R_0603_1608Metric
R13: 124K; R_0603_1608Metric
R14: 10K; R_0603_1608Metric; MPN 0603WAF1002T5E
R23: 2.2K; C_0402_1005Metric
R24: 33R; C_0402_1005Metric
S2: SKRPANE010
U1: DNP; SOT-223-3_TabPin2
U3: W25Q16JVS; SOIC-8_5.23x5.23mm_P1.27mm
U4: LM1117-3.3; SOT-223-3_TabPin2
U5: RP2040; RP2040-QFN-56
U6: PC817; DIP-4_W7.62mm_SMDSocket_SmallPads
Y1: 12000Mhz; Crystal_SMD_3225-4Pin_3.2x2.5mm

Connections:
+1V1: C8.1, C9.1, C10.1, U5.23 (DVDD), U5.45 (VREG_VOUT), U5.50 (DVDD)
+3V3: C6.1, C7.1, C11.1, C12.1, C13.1, C14.1, C15.1, C16.1, C17.1, C18.1, R3.1, R6.1, R24.2, U3.8 (VCC), U4.2 (VO), U5.1 (IOVDD), U5.10 (IOVDD), U5.22 (IOVDD), U5.33 (IOVDD), U5.42 (IOVDD), U5.44 (VREG_IN), U5.48 (USB_VDD), U5.49 (IOVDD)
+5V: C3.1, C4.1, C5.1, C43.1, C46.2, L1.1, R13.2, U1.2 (VO), U4.3 (VI); also elsewhere on the board
/Main_MCU/GPIO0: U5.2 (GPIO0)
/Main_MCU/GPIO1: U5.3 (GPIO1)
/Main_MCU/GPIO2: U5.4 (GPIO2); also elsewhere on the board
/Main_MCU/GPIO3: U5.5 (GPIO3); also elsewhere on the board
/Main_MCU/GPIO8: U5.11 (GPIO8)
/Main_MCU/GPIO9: U5.12 (GPIO9)
/Main_MCU/GPIO10: U5.13 (GPIO10); also elsewhere on the board
/Main_MCU/GPIO11: U5.14 (GPIO11); also elsewhere on the board
/Main_MCU/GPIO12: U5.15 (GPIO12); also elsewhere on the board
/Main_MCU/GPIO13: U5.16 (GPIO13); also elsewhere on the board
/Main_MCU/GPIO14: U5.17 (GPIO14)
/Main_MCU/GPIO15: U5.18 (GPIO15)
/Main_MCU/GPIO16: U5.27 (GPIO16)
/Main_MCU/GPIO17: U5.28 (GPIO17)
/Main_MCU/GPIO21: J5.1, U5.32 (GPIO21)
/Main_MCU/GPIO22: J5.2, U5.34 (GPIO22)
/Main_MCU/GPIO23: J5.3, U5.35 (GPIO23)
/Main_MCU/GPIO24: J5.4, U5.36 (GPIO24)
/Main_MCU/GPIO25: J5.5, U5.37 (GPIO25)
/Main_MCU/GPIO26_ADC0: U5.38 (GPIO26_ADC0)
/Main_MCU/GPIO27_ADC1: U5.39 (GPIO27_ADC1)
/Main_MCU/GPIO28_ADC2: U5.40 (GPIO28_ADC2)
/Main_MCU/GPIO29_ADC3: R10.1, R11.2, U5.41 (GPIO29_ADC3)
/Main_MCU/QSPI_SCLK: U3.6 (CLK), U5.52 (QSPI_SCLK)
/Main_MCU/QSPI_SD0: U3.5 (DI(IO0)), U5.53 (QSPI_SD0)
/Main_MCU/QSPI_SD1: U3.2 (DO(IO1)), U5.55 (QSPI_SD1)
/Main_MCU/QSPI_SD2: U3.3 (IO2), U5.54 (QSPI_SD2)
/Main_MCU/QSPI_SD3: U3.7 (IO3), U5.51 (QSPI_SD3)
/Main_MCU/QSPI_SS: R2.1, R3.2, U3.1 (~CS), U5.56 (QSPI_SS)
/Main_MCU/RUN: U5.26 (RUN)
/Main_MCU/SWCLK: U5.24 (SWCLK)
/Main_MCU/SWD: U5.25 (SWD)
/Main_MCU/USB_D+: J4.3 (DP), R8.1
/Main_MCU/USB_D-: J4.2 (DM), R9.1
/Main_MCU/USB_DN: R9.2, U5.46 (USB_DM)
/Main_MCU/USB_DP: R8.2, U5.47 (USB_DP)
/Main_MCU/XIN: C1.1, U5.20 (XIN), Y1.3
/Main_MCU/XOUT: R4.1, U5.21 (XOUT)
/Main_MCU/~USB_BOOT: R2.2, S2.1, S2.2
ADC_VREF: R6.2, R7.1
GND: C1.2, C2.2, C3.2, C4.2, C5.2, C6.2, C7.2, C8.2, C9.2, C10.2, C11.2, C12.2, C13.2, C14.2, C15.2, C16.2, C17.2, C18.2, C45.1, C46.1, C47.1, C48.1, D27.A, IC1.2 (GND), J2.1, J4.5 (GND), J4.6 (Shield), LED1.1, R5.2, R11.1, R12.2, R25.1, S2.3, S2.4, U1.1 (GND), U3.4 (GND), U4.1 (GND), U5.57 (GND), U6.2, Y1.2, Y1.4; also elsewhere on the board
GPIO4: J2.7, U5.6 (GPIO4)
GPIO5: J2.8, U5.7 (GPIO5)
GPIO6: J2.3, U5.8 (GPIO6)
GPIO7: J2.2, U5.9 (GPIO7)
GPIO18: J2.5, U5.29 (GPIO18)
GPIO19: J2.6, U5.30 (GPIO19)
GPIO20: R26.1, U5.31 (GPIO20)
IGN: J2.9, R23.1
unnamed: C2.1, R4.2, Y1.1
unnamed: C44.1, IC1.1 (BS)
unnamed: IC1.4 (EN), R14.1
unnamed: C43.2, IC1.3 (FB), R12.1, R13.1
unnamed: C45.2, C47.2, IC1.5 (IN), L2.1
unnamed: C44.2, D27.C, IC1.6 (SW), L1.2
unnamed: J3.1, R10.2
unnamed: LED1.2, R1.2
unnamed: R23.2, U6.1
unnamed: R24.1, U6.4
unnamed: R25.2, R26.2, U6.3
unnamed: R7.2, U5.43 (ADC_AVDD)
unnamed: R5.1, U5.19 (TESTEN)
VBUS: C48.2, J2.4, J4.1 (VBUS), L2.2, R1.1, R14.2, U1.3 (VI)

Notes on the sheet:
RJ45 PİN
Flash
Make sure C10 is close to pin 44 of RP2040
Relay pinleri
Power
Make sure C8 is close to pin 45 of RP2040
Crystal
5V Output -> 3.3V Input
Make sure R3 and R4 are close to RP2040
Yeni nesilde yapılan -MAX485 çipi çıkarıldı onun bağlantıları direk beyaz connectore verildi -Connector pin sayısı 8 den 9 a çıkarıldı. -Pinlerin isimleri düzenlendi

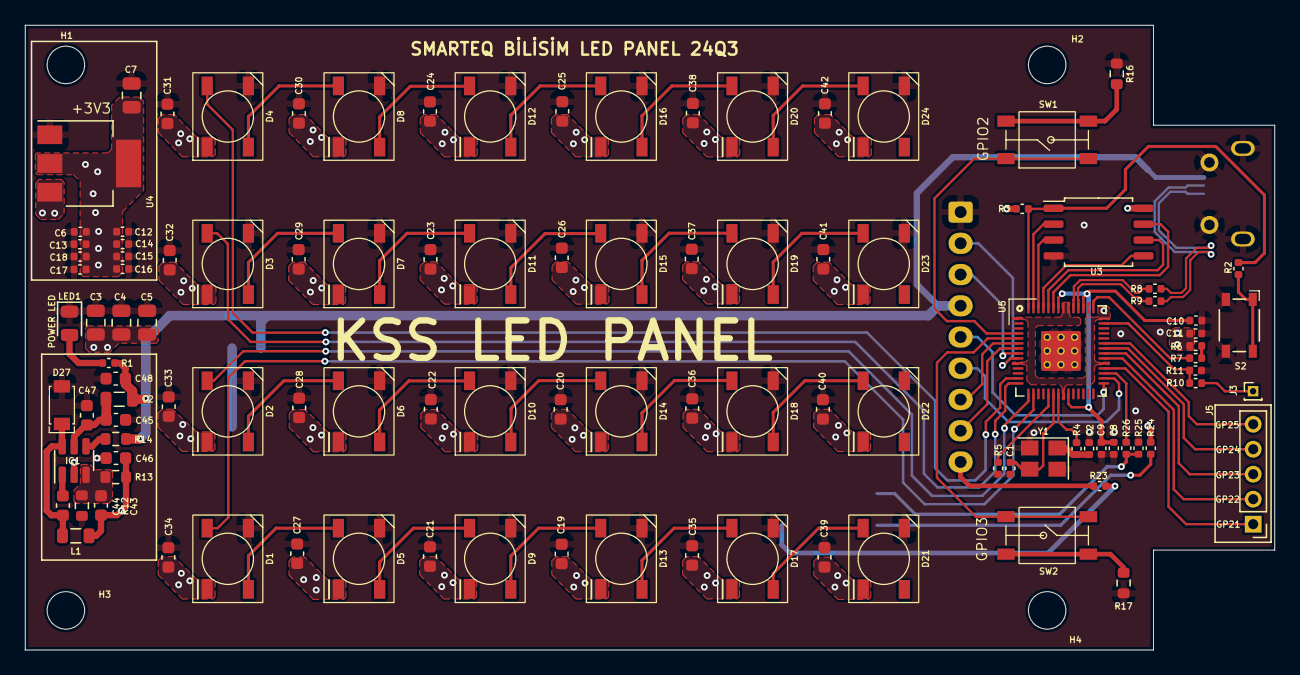
[picture p126: board KSS_LP_V1.0.kicad_pcb from above]

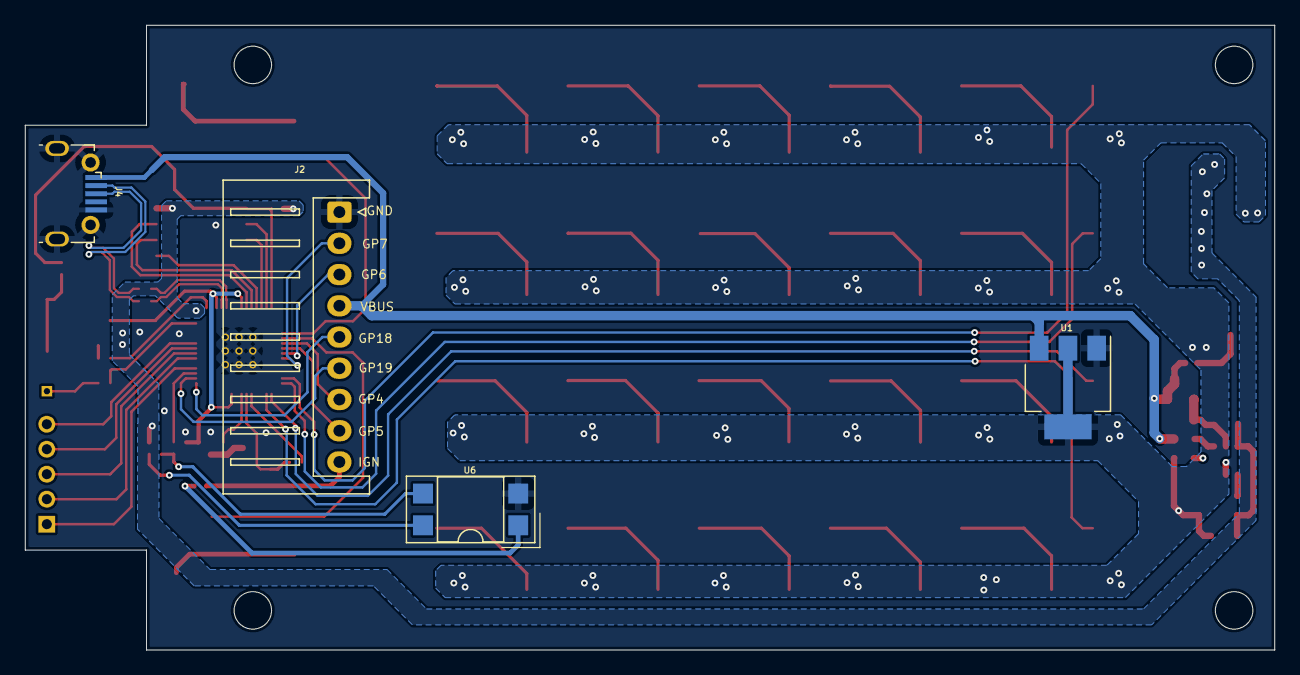
[picture p127: board KSS_LP_V1.0.kicad_pcb from below]

Board: 2 copper layers, 100.0 x 50.0 mm, 114 parts (4 on the bottom side), 74 nets.
