ihsanakyrk/Eski-Versionlar-Ve-Siparisler/IO_Board/IO_Board/IO_Board.kicad_pcb

## KiCad design IO_Board/IO_Board/IO_Board.kicad_pcb (2025-09-01)

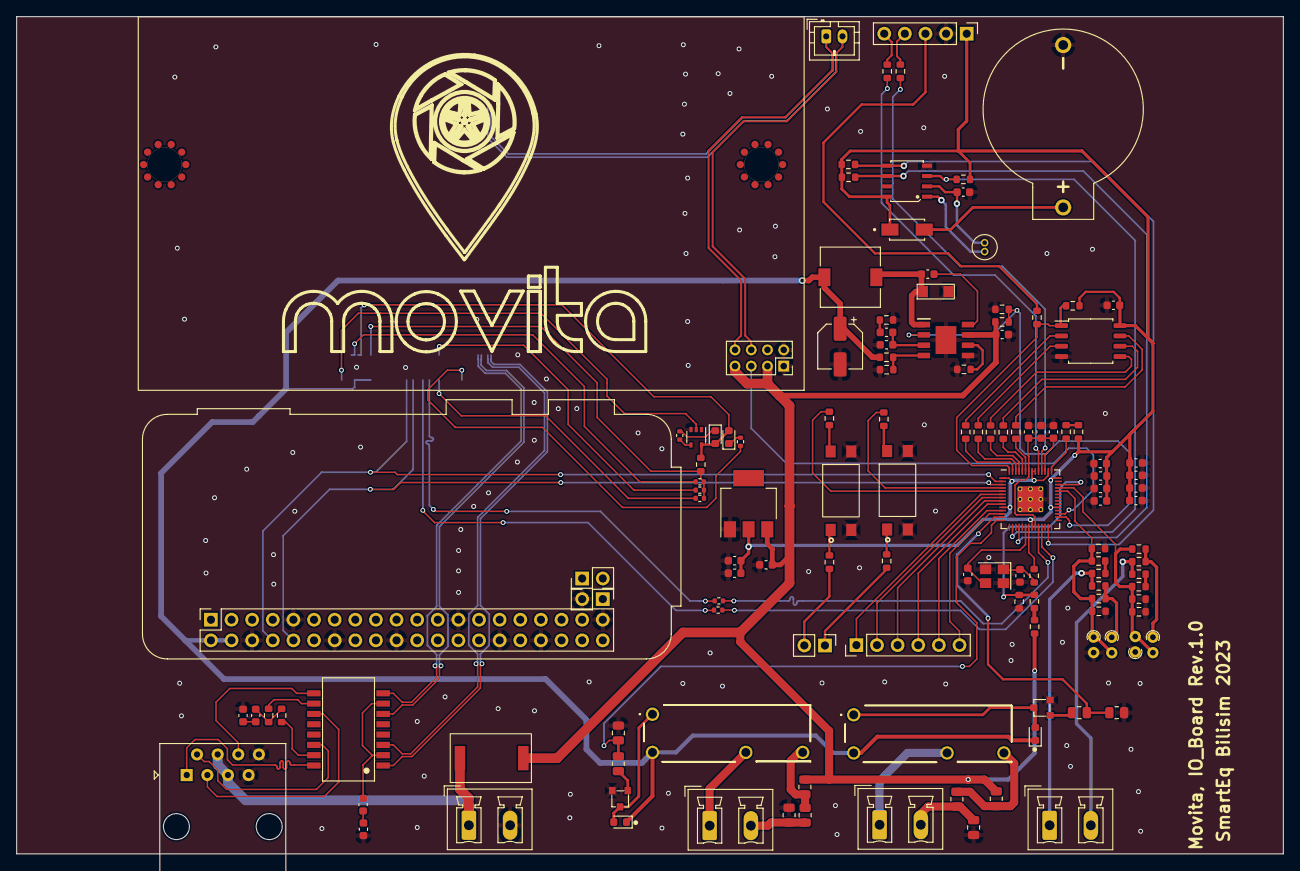
[picture p128: board IO_Board.kicad_pcb from above]

Board: 2 copper layers, 156.0 x 103.1 mm, 131 parts (1 on the bottom side), 109 nets.

Parts:
C1, C2: 10uF; C_0603_1608Metric
C3, C12, C13, C16, C17, C18, C19, C20, C21, C22: 100nF; C_0603_1608Metric
C4: 150pF; C_0603_1608Metric
C5: DNP; C_0603_1608Metric
C6: 100uF; CP_Elec_5x5.4
C7: 22uF; C_0603_1608Metric
C8: 0.1uF; C_0603_1608Metric
C9: 1nF; C_0603_1608Metric
C10, C11: 27pF; C_0603_1608Metric
C14, C15: 1uF; C_0603_1608Metric
C23: 22pF; C_0603_1608Metric
C24, C25: 0.01uF; C_0603_1608Metric
C26, C27: 1000pF; C_0603_1608Metric
D1: SS34FA
D2: SS14; DIOM4325X250N
D3, D4: MRA4007T3G
D5: LED Green; LED_0603_1608Metric
D6: S6MC
D7: LED Red; LED_0603_1608Metric
IC1: MP1584EN; MP1584
J1: FEMALE Through Hole Pin Header; PinHeader_2x20_P2.54mm_Vertical
J2, J3: DNP; PinHeader_1x02_P2.54mm_Vertical
J4: JST_PH_B2B-PH-K_1x02_P2.00mm_Vertical
J5: FEMALE Through Hole Pin Header; PinHeader_1x02_P2.54mm_Vertical
J6, J8, J14, J15: KF2EDGR-Y-5.08-2P-Right Angle
J7: DNP; PinHeader_1x06_P2.54mm_Vertical
J9: MYOUNG BS-02-A1AJ010
J10, J11: M3x*0.5 L=8; Screw_terminal_shinbo
J12: FEMALE Through Hole Pin Header; PinSocket_2x04_P2.00mm_Vertical
J13: FEMALE Through Hole Pin Header; PinHeader_1x05_P2.54mm_Vertical
J16: RJ45; RJ45_Amphenol_54602-x08_Horizontal
K1, K2: DNP; HF46F_5-HS1
L1: 10uH; L_7.3x7.3_H3.5
Q1, Q2: MMBT2222ALT1G
R1, R2, R3, R4, R25: 1K; R_0603_1608Metric
R5, R6, R53: 0R; R_0603_1608Metric
R7, R8, R23, R55: DNP; R_0603_1608Metric
R9, R10, R15, R16: 100R; R_0603_1608Metric
R11, R13: 1.78K; R_0603_1608Metric
R12, R14: 220R; R_0603_1608Metric
R17: 2.2K; R_0603_1608Metric
R18, R19, R20: 100K; R_0603_1608Metric
R21: 40.2K; R_0603_1608Metric
R22: 210K; R_0603_1608Metric
R24: 10K; R_0603_1608Metric
R26, R27, R28, R29, R30, R33, R34: 27R; R_0603_1608Metric
R31: 200R; R_0603_1608Metric
R32: 1R; R_0603_1608Metric
R35: 4.7K; R_0603_1608Metric
R36, R37: 4.7K %5; R_0603_1608Metric
R38, R39, R44, R45: DNP; R_Axial_DIN0204_L3.6mm_D1.6mm_P1.90mm_Vertical
R40, R48: DNP; R_0805_2012Metric
R41, R42, R49, R50: 0R; R_0805_2012Metric
R43, R62: 1K; R_0402_1005Metric
R46, R51: 10K; R_0805_2012Metric
R47, R52: 1K; R_0805_2012Metric
R54, R63, R64: DNP; R_0402_1005Metric
R56: 725R; R_0603_1608Metric
R57: 275R; R_0603_1608Metric
R58, R60: 75R; R_0603_1608Metric
R59, R61: 2.2K 1%; R_0402_1005Metric
T1: H1102NL
U1, U2: PC817C_4PIN_SMD; PC817C SMD 4pin
U3: LM1117S-3.3; SOT-223
U4: W25Q128JVSIQ; W25Q128JVS
U5: RP2040; RP20400
U6: PCF8563
U7: DNP; Raspberry-Pi-4-Compute-Module
U8: 74LVC1G07SE-7; SOT-353_SC-70-5
Y1: TAXM12M4RLBDDT2T
Y2: ECS-3X8X

Connections:
3.3V: C7.1, C8.1, C9.1, C15.1, C16.1, C17.1, C18.1, C19.1, C20.1, C21.1, C22.1, D2.C, J13.1, R23.1, R31.1, R35.2, R36.2, R37.2, U3.2 (VO), U4.8 (VCC), U5.1 (IOVDD), U5.10 (IOVDD), U5.22 (IOVDD), U5.33 (IOVDD), U5.42 (IOVDD), U5.44 (VREG_IN), U5.48 (USB_VDD), U5.49 (IOVDD), U6.8 (VDD)
5V: C6.1, D3.1 (K), D4.1 (K), J1.2, J1.4, K1.2 (COIL_2), K2.2 (COIL_2), L1.2, R22.2, U7.77 (+5v_(Input)), U7.79 (+5v_(Input)), U7.81 (+5v_(Input)), U7.83 (+5v_(Input)), U7.85 (+5v_(Input)), U7.87 (+5v_(Input))
+1V1: C12.1, C13.1, C14.1, U5.23 (DVDD), U5.45 (VREG_VOUT), U5.50 (DVDD)
/CM4_GPIO/+1.8V: R54.1, U7.88 (+1.8v_(Output)), U7.90 (+1.8v_(Output))
/CM4_GPIO/+3.3v: D5.2 (A), D7.2 (A), R53.2, U7.84 (+3.3v_(Output)), U7.86 (+3.3v_(Output)), U8.5 (VCC)
/CM4_GPIO/CM4_SWCLK: R63.2, U5.24 (SWCLK)
/CM4_GPIO/CM4_SWDIO: R64.2, U5.25 (SWD)
/CM4_GPIO/GPIO_VREF: R53.1, R54.2, R59.1, R61.1, U7.78 (GPIO_VREF(1.8v/3.3v_Input))
/CM4_GPIO/ID_SC: R59.2, U7.35 (ID_SC)
/CM4_GPIO/ID_SD: R61.2, U7.36 (ID_SD)
/CM4_GPIO/USB2_N: J4.1, J12.8, U7.103 (USB2_N)
/CM4_GPIO/USB2_P: J4.2, J12.6, U7.105 (USB2_P)
/CM4_GPIO/VOUT_CAM: D6.2 (A), J8.1, J16.4, J16.5
/CM4_GPIO/nPWR_LED: U7.95 (nPI_LED_PWR), U8.2
/Connectors/Analog_Input1: J6.1, R5.2, R7.2
/Connectors/Analog_Input2: J6.2, R6.2, R8.2
/Connectors/GP4: J7.1, U5.6 (GPIO4)
/Connectors/GP5: J7.2, U5.7 (GPIO5)
/Connectors/GP6: J7.3, U5.8 (GPIO6)
/Connectors/GP7: J7.4, U5.9 (GPIO7)
/Connectors/GP8: J7.5, U5.11 (GPIO8)
/Connectors/GP9: J7.6, U5.12 (GPIO9)
/Connectors/GP26_AO: R9.1, R11.1, R12.1, R15.2, R38.2, R44.1, U5.38 (GPIO26_ADC0)
/Connectors/GP27_AO: R10.1, R13.1, R14.1, R16.2, R39.2, R45.2, U5.39 (GPIO27_ADC1)
/Connectors/GP28_AO: R56.1, R57.1, U5.40 (GPIO28_ADC2)
/Connectors/GP_2: R3.1, U5.4 (GPIO2)
/Connectors/GP_3: R4.1, U5.5 (GPIO3)
/GSM/EN_3.8V: J12.5, U5.31 (GPIO20)
/POWER/EN: IC1.2 (EN), R17.1, R18.2, U5.30 (GPIO19)
/POWER/RTCL 3V3: D2.A, J9.1 (+)
/RP2040/I2C3_SCL_M0: R37.1, U5.18 (GPIO15), U6.6 (SCL)
/RP2040/I2C3_SDA_M0: R36.1, U5.27 (GPIO16), U6.5 (SDA)
/RP2040/QSPI_CSN: R23.2, R24.1, U4.1 (~CS~{}), U5.56 (QSPI_SS)
/RP2040/QSPI_SCLK: R30.2, U4.6 (CLK)
/RP2040/QSPI_SD0: R26.2, U4.5 (DI(IO0))
/RP2040/QSPI_SD1: R27.2, U4.2 (DO(IO1))
/RP2040/QSPI_SD2: R28.2, U4.3 (~WP~{}(IO2))
/RP2040/QSPI_SD3: R29.2, U4.7 (~HOLD~{}/~RESET/~IO3)
/RP2040/RTCIC_INT_L: R35.1, U5.16 (GPIO13), U6.3 (INT)
/RP2040/Relay1_EN: R46.1, R47.2, U5.13 (GPIO10)
/RP2040/Relay2_EN: R51.1, R52.2, U5.14 (GPIO11)
/RP2040/USB D N: J13.4, R34.1
/RP2040/USB D P: J13.5, R33.1
/RP2040/XIN: C10.1, U5.20 (XIN), Y1.3
/RP2040/XOUT: R25.1, U5.21 (XOUT)
/Raspberry Pi Zero/GPIO14: J1.8, U5.2 (GPIO0), U7.55 (GPIO14)
/Raspberry Pi Zero/GPIO15: J1.10, U5.3 (GPIO1), U7.51 (GPIO15)
/Relay/relay output 1: J14.1, K1.3 (NO)
/Relay/relay output 2: J15.1, K2.3 (NO)
ADC_VREF: R31.2, R32.1
GND: C1.2, C2.2, C5.2, C6.2, C7.2, C8.2, C9.2, C10.2, C11.2, C12.2, C13.2, C14.2, C15.2, C16.2, C17.2, C18.2, C19.2, C20.2, C21.2, C22.2, C23.2, C25.2, C27.2, D1.2 (A), IC1.5 (GND), IC1.9 (EP), J1.6, J1.9, J1.14, J1.20, J1.25, J1.30, J1.34, J1.39, J3.2, J8.2, J9.2 (-), J12.1, J12.2, J13.2, J16.7, J16.8, Q1.2 (E), Q2.2 (E), R12.2, R14.2, R15.1, R16.1, R17.2, R19.2, R20.2, R21.2, R41.1, R44.2, R45.1, R46.2, R50.1, R51.2, R57.2, U1.2 (K), U1.3 (E), U2.2 (K), U2.3 (E), U3.1 (ADJ), U4.4 (GND), U5.19 (TESTEN), U5.57 (GND), U6.4 (VSS), U7.1 (GND), U7.2 (GND), U7.7 (GND), U7.8 (GND), U7.13 (GND), U7.14 (GND), U7.22 (GND), U7.23 (GND), U7.32 (GND), U7.33 (GND), U7.42 (GND), U7.43 (GND), U7.52 (GND), U7.53 (GND), U7.59 (GND), U7.60 (GND), U7.65 (GND), U7.66 (GND), U7.71 (GND), U7.74 (GND), U7.98 (GND), U7.107 (GND), U7.108 (GND), U7.113 (GND), U7.114 (GND), U7.119 (GND), U7.120 (GND), U7.125 (GND), U7.126 (GND), U7.131 (GND), U7.132 (GND), U7.137 (GND), U7.138 (GND), U7.144 (GND), U7.150 (GND), U7.155 (GND), U7.156 (GND), U7.161 (GND), U7.162 (GND), U7.167 (GND), U7.168 (GND), U7.173 (GND), U7.174 (GND), U7.179 (GND), U7.180 (GND), U7.185 (GND), U7.186 (GND), U7.191 (GND), U7.192 (GND), U7.197 (GND), U7.198 (GND), U8.3 (GND), Y1.2, Y1.4
unnamed: C4.2, R20.1
unnamed: C11.1, R25.2, Y1.1
unnamed: C24.2, C25.1
unnamed: C26.1, R58.1, R60.1
unnamed: C26.2, C27.1
unnamed: C3.2, D1.1 (K), IC1.1 (SW), L1.1
unnamed: D3.2 (A), K1.1 (COIL_1), Q1.3 (C)
unnamed: D4.2 (A), K2.1 (COIL_1), Q2.3 (C)
unnamed: D5.1 (K), R43.1
unnamed: D7.1 (K), R62.1
unnamed: C3.1, IC1.8 (BST)
unnamed: C4.1, C5.1, IC1.3 (COMP)
unnamed: IC1.4 (FB), R21.1, R22.1
unnamed: IC1.6 (FREQ), R19.1
unnamed: J5.1, R1.1
unnamed: J5.2, R2.1
unnamed: J13.3, R24.2
unnamed: J14.2, R48.1, R50.2
unnamed: J15.2, R40.2, R41.2
unnamed: K1.4 (COM), R48.2, R49.2
unnamed: K2.4 (COM), R40.1, R42.1
unnamed: Q1.1 (B), R47.1
unnamed: Q2.1 (B), R52.1
unnamed: R6.1, R10.2, R39.1
unnamed: R7.1, R11.2
unnamed: R8.1, R13.2
unnamed: R5.1, R9.2, R38.1
unnamed: R55.2, R56.2
unnamed: R62.2, U8.4
unnamed: C24.1, T1.2 (CT1), T1.7 (CT2)
unnamed: R58.2, T1.10 (CT3)
unnamed: R60.2, T1.15 (CT4)
unnamed: R1.2, U1.1 (A)
unnamed: R3.2, U1.4 (C)
unnamed: R2.2, U2.1 (A)
unnamed: R4.2, U2.4 (C)
unnamed: R32.2, U5.43 (ADC_AVDD)
unnamed: R30.1, U5.52 (QSPI_SCLK)
unnamed: R26.1, U5.53 (QSPI_SD0)
unnamed: R27.1, U5.55 (QSPI_SD1)
unnamed: R28.1, U5.54 (QSPI_SD2)
unnamed: R29.1, U5.51 (QSPI_SD3)
unnamed: R34.2, U5.46 (USB_DM)
unnamed: R33.2, U5.47 (USB_DP)
unnamed: U6.1 (OSCI), Y2.1
unnamed: C23.1, U6.2 (OSCO), Y2.2
unnamed: R64.1, U7.45 (GPIO24)
unnamed: R63.1, U7.41 (GPIO25)
unnamed: R43.2, U7.21 (PI_nLED_Activity)
RX_N: T1.8 (RD-), U7.12 (Ethernet_Pair0_P)
RX_P: T1.6 (RD+), U7.10 (Ethernet_Pair0_N)
TRD0_N: J16.2, T1.14 (TX-)
TRD0_P: J16.1, T1.16 (TX+)
TRD1_N: J16.6, T1.9 (RX-)
TRD1_P: J16.3, T1.11 (RX+)
TX_N: T1.3 (TD-), U7.6 (Ethernet_Pair1_N)
TX_P: T1.1 (TD+), U7.4 (Ethernet_Pair1_P)
VIN: C1.1, C2.1, D6.1 (K), IC1.7 (VIN), J12.3, J12.7, R18.1, R42.2, R49.1, R55.1, U3.3 (VI)
