ihsanakyrk/Eski-Versionlar-Ve-Siparisler/KSS_main_RP2040_V3(Eski akıllı)/RP2040_minimal.kicad_pcb

## KiCad design KSS_main_RP2040_V3(Eski akıllı)/RP2040_minimal.kicad_pcb (2025-09-01)

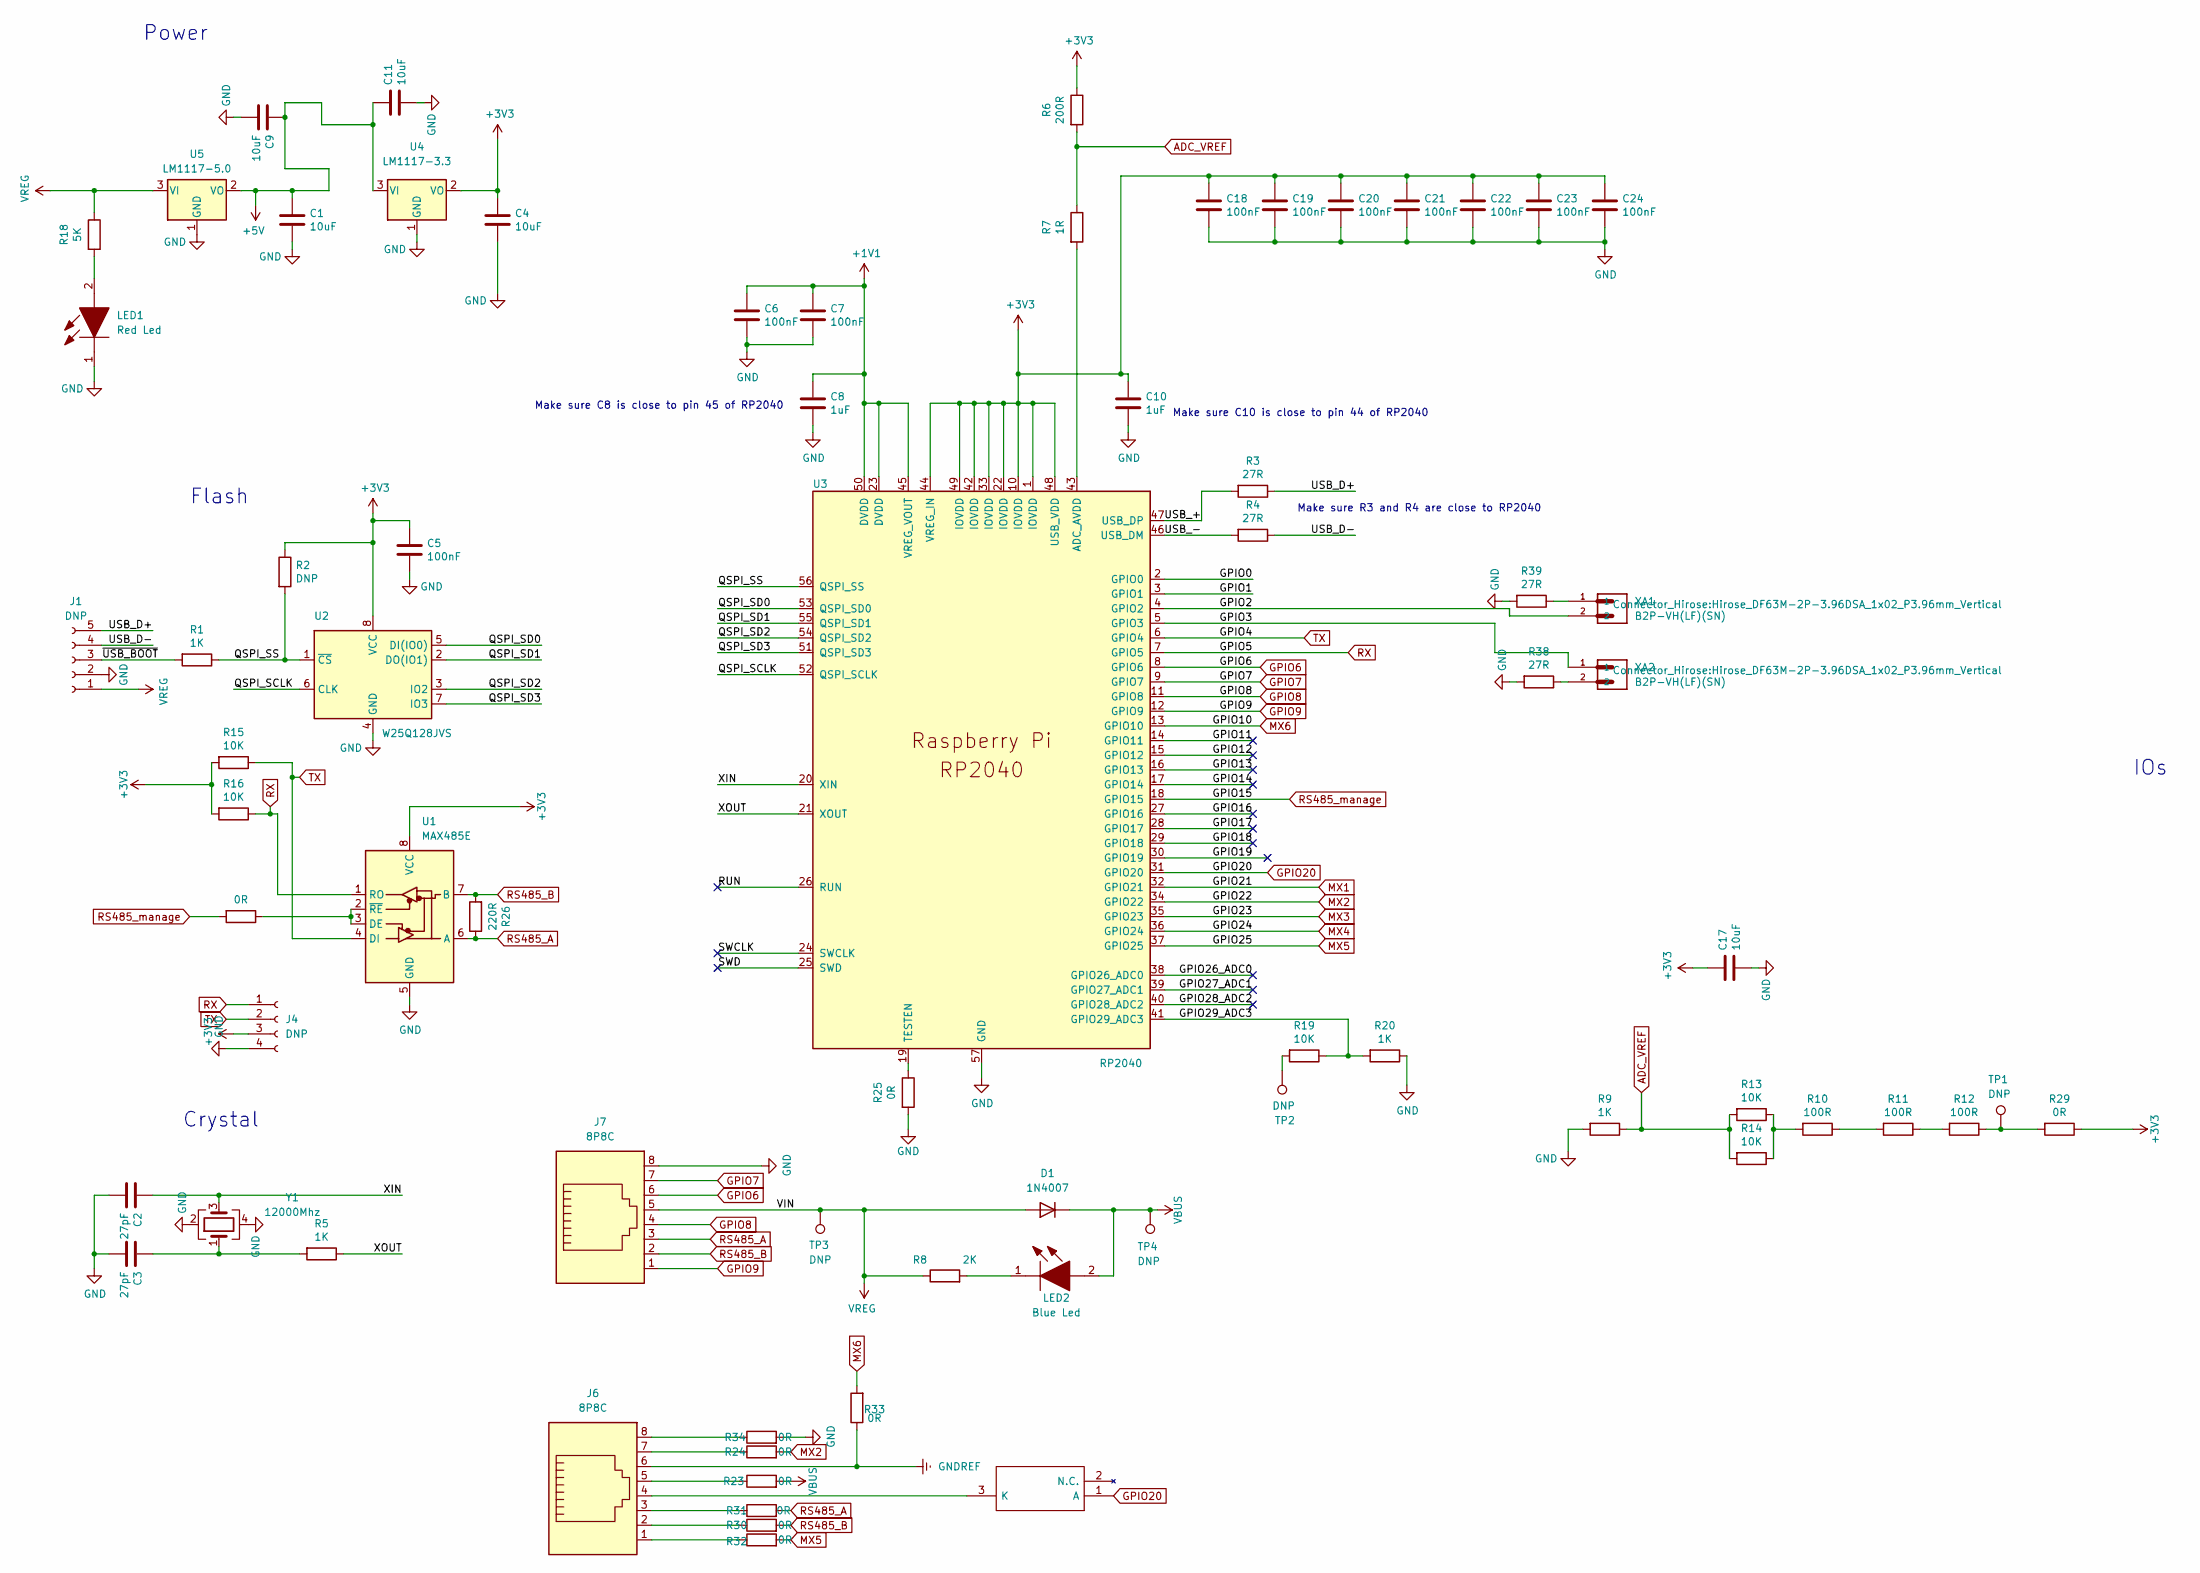
[picture p129: schematic RP2040_minimal.kicad_sch, KSS-E]

Parts:
C1, C4, C9, C11, C17: 10uF; C_0805_2012Metric
C2, C3: 27pF; C_0402_1005Metric
C5, C6, C7, C18, C19, C20, C21, C22, C23, C24: 100nF; C_0402_1005Metric
C8, C10: 1uF; C_0402_1005Metric
D1: 1N4007; D_SOD-123F; MPN 1N4007 (SOD-123FL)
D3: BAT854W; SOT65P210X110-3N; Manufacturer_Part_Number BAT854W; Mouser Part Number N/A
J1: DNP; PinHeader_1x05_P2.00mm_Vertical
J4: DNP; PinSocket_1x04_P2.00mm_Vertical
J6, J7: 8P8C; RJ45_Amphenol_54602-x08_Horizontal
LED1: Red Led; LED_0805_2012Metric
LED2: Blue Led; LED_0805_2012Metric
R1, R5, R9, R20: 1K; C_0402_1005Metric
R2: DNP; C_0402_1005Metric
R3, R4, R38, R39: 27R; C_0402_1005Metric
R6: 200R; C_0402_1005Metric
R7: 1R; C_0402_1005Metric
R8: 2K; C_0402_1005Metric
R10, R11, R12: 100R; C_0402_1005Metric
R13, R14, R15, R16, R19: 10K; C_0402_1005Metric
R18: 5K; C_0402_1005Metric
R23, R24, R25, R28, R29, R30, R31, R32, R33, R34: 0R; C_0402_1005Metric
R26: 220R; C_0402_1005Metric
TP1, TP2, TP3, TP4: DNP; TestPoint_Pad_1.0x1.0mm
U1: MAX485E; SOIC127P600X175-8N
U2: W25Q128JVS; SOIC-8_5.23x5.23mm_P1.27mm
U3: RP2040; RP2040-QFN-56
U4: LM1117-3.3; SOT-223-3_TabPin2
U5: LM1117-5.0; SOT-223-3_TabPin2
XA1, XA2: B2P-VH(LF)(SN); Hirose_DF63M-2P-3.96DSA_1x02_P3.96mm_Vertical
Y1: 12000Mhz; Crystal_SMD_3225-4Pin_3.2x2.5mm

Connections:
+1V1: C6.1, C7.1, C8.1, U3.23 (DVDD), U3.45 (VREG_VOUT), U3.50 (DVDD)
+3V3: C4.1, C5.1, C10.1, C17.1, C18.1, C19.1, C20.1, C21.1, C22.1, C23.1, C24.1, J4.3, R2.1, R6.1, R15.2, R16.2, R29.1, U1.8 (VCC), U2.8 (VCC), U3.1 (IOVDD), U3.10 (IOVDD), U3.22 (IOVDD), U3.33 (IOVDD), U3.42 (IOVDD), U3.44 (VREG_IN), U3.48 (USB_VDD), U3.49 (IOVDD), U4.2 (VO)
+5V: C1.1, C9.1, C11.1, U4.3 (VI), U5.2 (VO)
/GPIO0: U3.2 (GPIO0)
/GPIO1: U3.3 (GPIO1)
/GPIO2: U3.4 (GPIO2), XA1.2
/GPIO3: U3.5 (GPIO3), XA2.1
/GPIO11: U3.14 (GPIO11)
/GPIO12: U3.15 (GPIO12)
/GPIO13: U3.16 (GPIO13)
/GPIO14: U3.17 (GPIO14)
/GPIO16: U3.27 (GPIO16)
/GPIO17: U3.28 (GPIO17)
/GPIO18: U3.29 (GPIO18)
/GPIO19: U3.30 (GPIO19)
/GPIO26_ADC0: U3.38 (GPIO26_ADC0)
/GPIO27_ADC1: U3.39 (GPIO27_ADC1)
/GPIO28_ADC2: U3.40 (GPIO28_ADC2)
/GPIO29_ADC3: R19.1, R20.2, U3.41 (GPIO29_ADC3)
/QSPI_SCLK: U2.6 (CLK), U3.52 (QSPI_SCLK)
/QSPI_SD0: U2.5 (DI(IO0)), U3.53 (QSPI_SD0)
/QSPI_SD1: U2.2 (DO(IO1)), U3.55 (QSPI_SD1)
/QSPI_SD2: U2.3 (IO2), U3.54 (QSPI_SD2)
/QSPI_SD3: U2.7 (IO3), U3.51 (QSPI_SD3)
/QSPI_SS: R1.1, R2.2, U2.1 (~CS), U3.56 (QSPI_SS)
/RUN: U3.26 (RUN)
/SWCLK: U3.24 (SWCLK)
/SWD: U3.25 (SWD)
/USB_+: R3.2, U3.47 (USB_DP)
/USB_-: R4.2, U3.46 (USB_DM)
/USB_D+: J1.5, R3.1
/USB_D-: J1.4, R4.1
/XIN: C2.1, U3.20 (XIN), Y1.3
/XOUT: R5.1, U3.21 (XOUT)
/~USB_BOOT: J1.3, R1.2
ADC_VREF: R6.2, R7.1, R9.1, R13.2, R14.2
GND: C1.2, C2.2, C3.2, C4.2, C5.2, C6.2, C7.2, C8.2, C9.2, C10.2, C11.2, C17.2, C18.2, C19.2, C20.2, C21.2, C22.2, C23.2, C24.2, J1.2, J4.4, J7.8, LED1.1, R9.2, R20.1, R25.2, R34.2, R38.2, R39.2, U1.5 (GND), U2.4 (GND), U3.57 (GND), U4.1 (GND), U5.1 (GND), Y1.2, Y1.4
GNDREF: J6.6, R33.1
GPIO6: J7.6, U3.8 (GPIO6)
GPIO7: J7.7, U3.9 (GPIO7)
GPIO8: J7.4, U3.11 (GPIO8)
GPIO9: J7.1, U3.12 (GPIO9)
GPIO20: D3.1 (A), U3.31 (GPIO20)
MX1: U3.32 (GPIO21)
MX2: R24.2, U3.34 (GPIO22)
MX3: U3.35 (GPIO23)
MX4: U3.36 (GPIO24)
MX5: R32.2, U3.37 (GPIO25)
MX6: R33.2, U3.13 (GPIO10)
unnamed: C3.1, R5.2, Y1.1
unnamed: D3.3 (K), J6.4
unnamed: J6.1, R32.1
unnamed: J6.2, R30.1
unnamed: J6.3, R31.1
unnamed: J6.5, R23.1
unnamed: J6.7, R24.1
unnamed: J6.8, R34.1
unnamed: LED1.2, R18.2
unnamed: LED2.1, R8.2
unnamed: R10.1, R11.2
unnamed: R10.2, R13.1, R14.1
unnamed: R11.1, R12.2
unnamed: R12.1, R29.2, TP1.1
unnamed: R19.2, TP2.1
unnamed: R38.1, XA2.2
unnamed: R39.1, XA1.1
unnamed: R28.1, U1.2 (~RE), U1.3 (DE)
unnamed: R7.2, U3.43 (ADC_AVDD)
unnamed: R25.1, U3.19 (TESTEN)
RS485_A: J7.3, R26.1, R31.2, U1.6 (A)
RS485_B: J7.2, R26.2, R30.2, U1.7 (B)
RS485_manage: R28.2, U3.18 (GPIO15)
RX: J4.1, R16.1, U1.1 (RO), U3.7 (GPIO5)
TX: J4.2, R15.1, U1.4 (DI), U3.6 (GPIO4)
VBUS: D1.1 (K), LED2.2, R23.2, TP4.1
VREG: D1.2 (A), J1.1, J7.5, R8.1, R18.1, TP3.1, U5.3 (VI)

Notes on the sheet:
Make sure C8 is close to pin 45 of RP2040
Power
Flash
Make sure R3 and R4 are close to RP2040
Make sure C10 is close to pin 44 of RP2040
Crystal
IOs

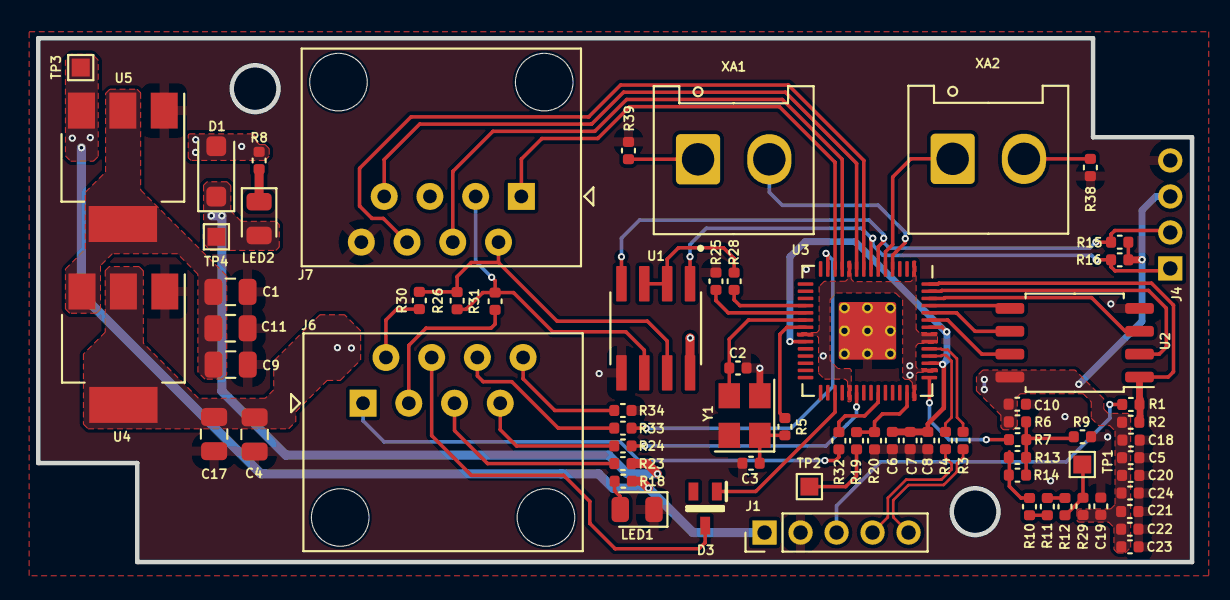
[picture p130: board KSS_main_RP2040_V3(Eski akıllı)/RP2040_minimal.kicad_pcb from above]

Board: 2 copper layers, 64.1 x 29.1 mm, 71 parts (0 on the bottom side), 57 nets.
