ihsanakyrk/Eski-Versionlar-Ve-Siparisler/[04.2025]/KSS_MD_V1.0(Nisan_2025)/KSS_MD_V1.0/KSS_MD_V1.0.kicad_pcb

## KiCad design [04.2025]/KSS_MD_V1.0(Nisan_2025)/KSS_MD_V1.0/KSS_MD_V1.0.kicad_pcb (2025-09-01)

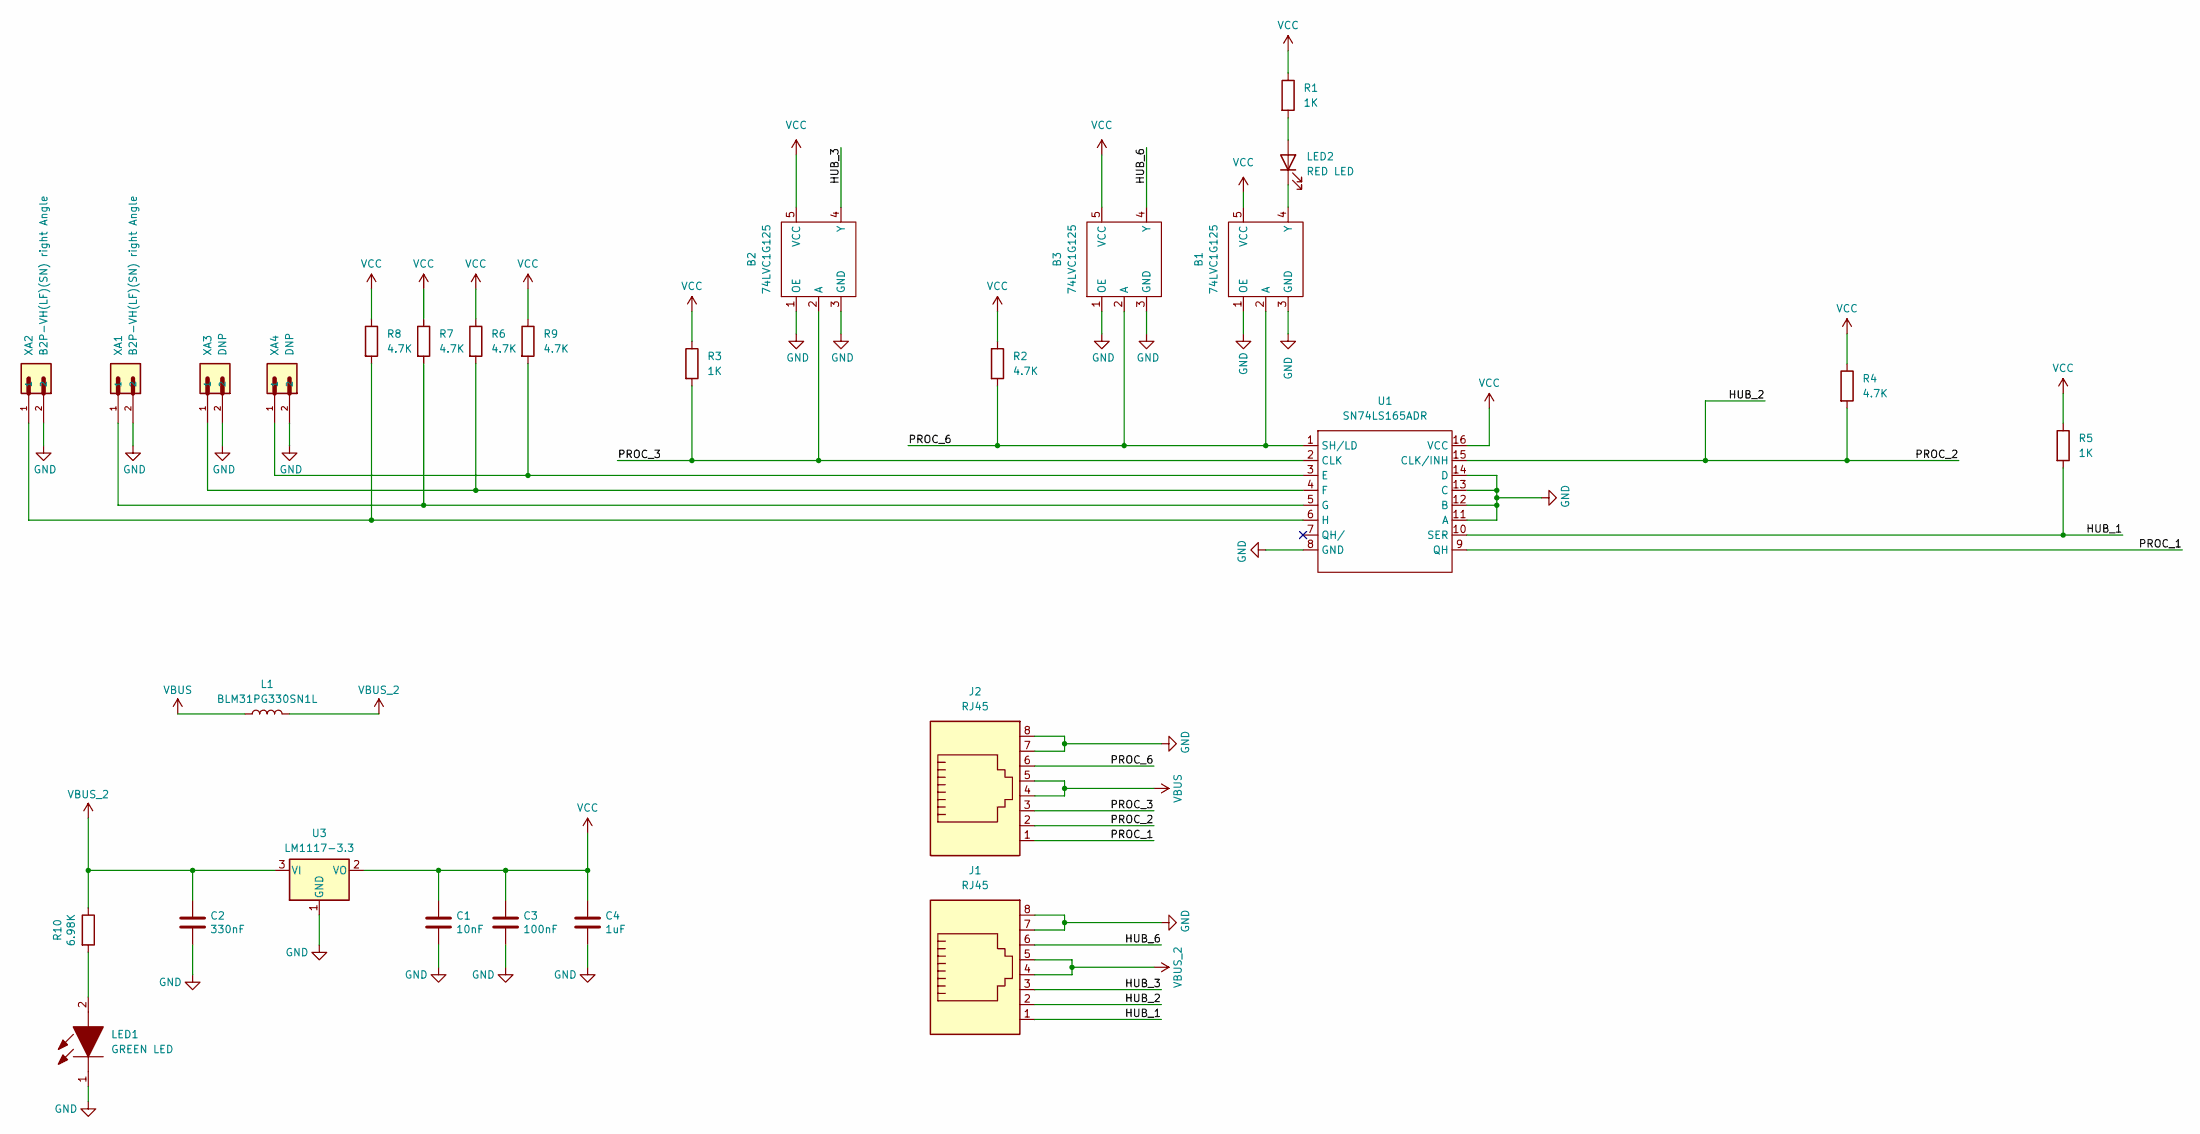
[picture p131: schematic KSS_MD_V1.0.kicad_sch]

Parts:
B1, B2, B3: 74LVC1G125; SOT-353_SC-70-5
C1: 10nF; C_0603_1608Metric
C2: 330nF; C_0603_1608Metric
C3: 100nF; C_0603_1608Metric
C4: 1uF; C_0603_1608Metric
J1, J2: RJ45; RJ45_OST_PJ012-8P8CX_Vertical
L1: BLM31PG330SN1L; L_1206_3216Metric; MPN BLM31PG330SN1L
LED1: GREEN LED; LED_0805_2012Metric
LED2: RED LED; LED_0805_2012Metric
R1, R3, R5: 1K; R_0603_1608Metric
R2, R4, R6, R7, R8, R9: 4.7K; R_0603_1608Metric
R10: 6.98K; R_0603_1608Metric
U1: SN74LS165ADR; SOIC-16_3.9x9.9mm_P1.27mm
U3: LM1117-3.3; SOT-223-3_TabPin2
XA1, XA2: B2P-VH(LF)(SN) right Angle; Hirose_DF63M-2P-3.96DSA_1x02_P3.96mm_Vertical
XA3, XA4: DNP; Hirose_DF63M-2P-3.96DSA_1x02_P3.96mm_Vertical

Connections:
/HUB_1: J1.1, R5.2, U1.10 (SER)
/HUB_2: J1.2, J2.2, R4.2, U1.15 (CLK/INH)
/HUB_3: B2.4 (Y), J1.3
/HUB_6: B3.4 (Y), J1.6
/PROC_1: J2.1, U1.9 (QH)
/PROC_3: B2.2 (A), J2.3, R3.2, U1.2 (CLK)
/PROC_6: B1.2 (A), B3.2 (A), J2.6, R2.2, U1.1 (SH/LD)
GND: B1.1 (OE), B1.3 (GND), B2.1 (OE), B2.3 (GND), B3.1 (OE), B3.3 (GND), C1.2, C2.2, C3.2, C4.2, J1.7, J1.8, J2.7, J2.8, LED1.1, U1.8 (GND), U1.11 (A), U1.12 (B), U1.13 (C), U1.14 (D), U3.1 (GND), XA1.2, XA2.2, XA3.2, XA4.2
unnamed: B1.4 (Y), LED2.1 (K)
unnamed: LED1.2, R10.2
unnamed: LED2.2 (A), R1.2
unnamed: R9.2, U1.3 (E), XA4.1
unnamed: R6.2, U1.4 (F), XA3.1
unnamed: R7.2, U1.5 (G), XA1.1
unnamed: R8.2, U1.6 (H), XA2.1
VBUS: J2.4, J2.5, L1.1
VBUS_2: C2.1, J1.4, J1.5, L1.2, R10.1, U3.3 (VI)
VCC: B1.5 (VCC), B2.5 (VCC), B3.5 (VCC), C1.1, C3.1, C4.1, R1.1, R2.1, R3.1, R4.1, R5.1, R6.1, R7.1, R8.1, R9.1, U1.16 (VCC), U3.2 (VO)

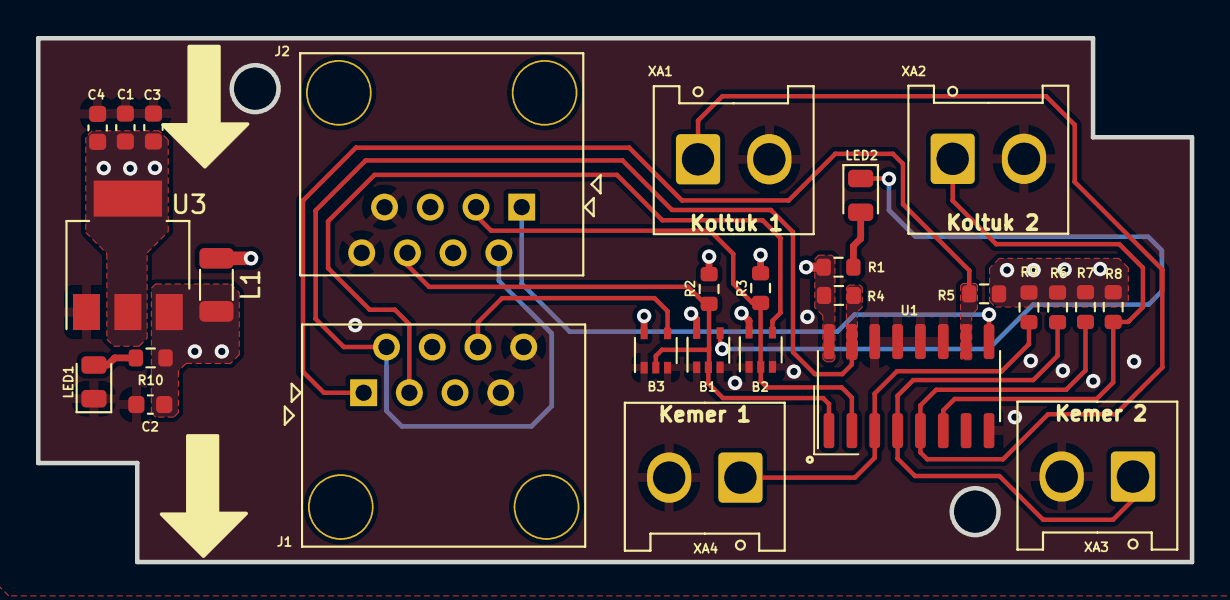
[picture p132: board KSS_MD_V1.0.kicad_pcb from above]

Board: 2 copper layers, 64.1 x 29.1 mm, 28 parts (0 on the bottom side), 18 nets.
