ihsanakyrk/Eski-Versionlar-Ve-Siparisler/[11.2023]/IMX219_V1.0_(Kasım_2023)/IMX219_V1.0/CameraModule_IMX219.kicad_pcb

## KiCad design [11.2023]/IMX219_V1.0_(Kasım_2023)/IMX219_V1.0/CameraModule_IMX219.kicad_pcb (2025-09-01)

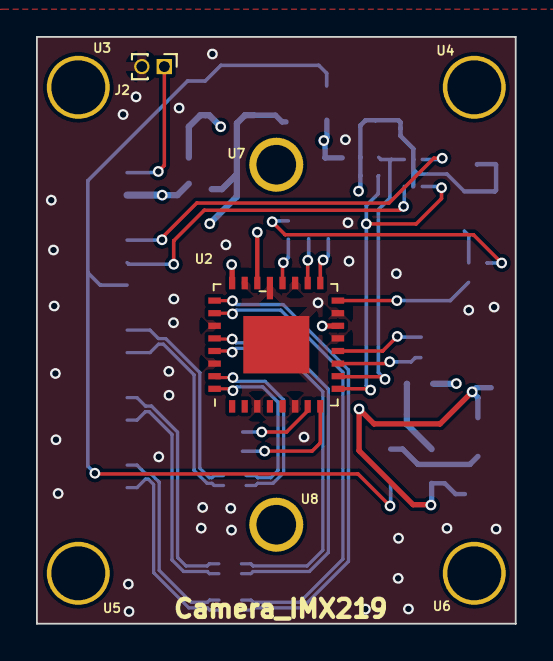
[picture p133: board CameraModule_IMX219.kicad_pcb from above]

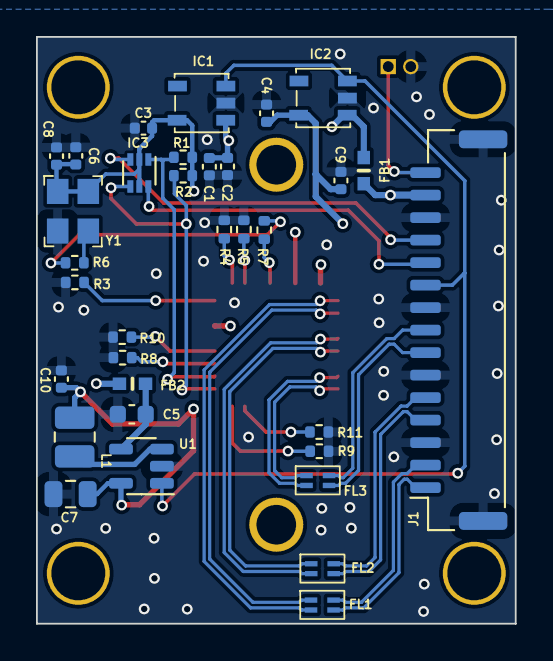
[picture p134: board CameraModule_IMX219.kicad_pcb from below]

Board: 4 copper layers, 26.6 x 32.6 mm, 41 parts (33 on the bottom side), 36 nets.

Parts:
C1, C2, C3, C4, C6: 1uF; C_0402_1005Metric
C5: 4.7uF; C_0603_1608Metric
C7: 10uF; C_0805_2012Metric
C8: 0.22uF; C_0402_1005Metric
C9, C10: 2.2uF; C_0402_1005Metric
FB1, FB2: 600@100MHz; BLM18SP221SN1B
FL1, FL2, FL3: 0504; DLP11SN900HL2L
IC1, IC2: SOT-25-5; AP7331
IC3: SOT-563
J1: Con_15Ways_1.25mm; JST_1x15-1MP_P1.25mm_Horizontal
J2: Con_2Ways_1.25mm
L1: 2520 2.2uH; L_1008_2520Metric
R1, R2: 2.2K; R_0402_1005Metric
R3: 22R; R_0402_1005Metric
R4, R7: 0R; R_0402_1005Metric
R5, R6, R8, R9, R10, R11: DNP; R_0402_1005Metric
U1: SOT-23-5
U2: SBP08047
U3, U4, U5, U6, U7, U8: Screw_Terminal_01x01
Y1: 24MHz; X322524MOB4SI

Connections:
+1V2: C7.1, C10.2, L1.2, U1.5 (VOUT), U2.4 (VDD)
+1V8: C3.1, C6.1, C8.2, IC1.5 (OUT), IC3.2 (G2), IC3.5 (G1), R1.1, R2.1, U2.2 (VDIG), Y1.1 (TRI-STATE), Y1.4 (VDD)
+2V8: C4.1, C9.2, IC2.5 (OUT), U2.26 (VANA)
+3V3: FB1.1, FB2.1, J1.14
/IMX219/CON_CSI_CLK_N: FL3.1, J1.7
/IMX219/CON_CSI_CLK_P: FL3.4, J1.8
/IMX219/CON_CSI_D0_N: FL1.1, J1.1
/IMX219/CON_CSI_D0_P: FL1.4, J1.2
/IMX219/CON_CSI_D1_N: FL2.1, J1.4
/IMX219/CON_CSI_D1_P: FL2.4, J1.5
/IMX219/CSI_CLKN: FL3.2, U2.11 (DCKN)
/IMX219/CSI_CLKP: FL3.3, U2.12 (DCKP)
/IMX219/CSI_D0N: FL1.2, U2.5 (MDN1)
/IMX219/CSI_D0P: FL1.3, U2.6 (MDP1)
/IMX219/CSI_D1N: FL2.2, U2.8 (MDN2)
/IMX219/CSI_D1P: FL2.3, U2.9 (MDP2)
/IMX219/ENABLE: IC1.3 (EN), IC2.3 (EN), J1.10, U1.1 (EN)
/IMX219/IR_CUT_GPIO: J1.15, J2.1
/IMX219/MCLK: R3.2, R7.1
/IMX219/SCL: IC3.6 (D2), J1.11
/IMX219/SCL 1V8: IC3.1 (S2), R1.2, U2.22 (SCL)
/IMX219/SDA: IC3.3 (D1), J1.12
/IMX219/SDA 1V8: IC3.4 (S1), R2.2, U2.21 (SDA)
GND: C1.1, C2.1, C3.2, C4.2, C5.2, C6.2, C7.2, C8.1, C9.1, C10.1, IC1.2 (GND), IC2.2 (GND), J1.3, J1.6, J1.9, J1.13, J2.2, R4.1, R5.1, R6.1, R8.1, R9.1, R10.1, R11.1, U1.2 (GND), U2.1 (DGND), U2.3 (DGND), U2.7 (DGND), U2.10 (DGND), U2.15 (DGND), U2.18 (DGND), U2.25 (AGND), U2.27 (AGND), U2.31 (DGND), U2.33 (EPAD), Y1.2 (GND)
unnamed: C1.2, C2.2, FB1.2, IC1.1 (IN), IC2.1 (IN)
unnamed: L1.1, U1.3 (SW)
unnamed: C5.1, FB2.2, U1.4 (VIN)
unnamed: R10.2, U2.24 (AF_EN)
unnamed: R9.2, U2.20 (AF_VDD)
unnamed: R5.2, U2.30 (FSTROBE)
unnamed: R4.2, U2.29 (GPO)
unnamed: R7.2, U2.32 (I_NCK)
unnamed: R8.2, U2.23 (I_OUT)
unnamed: R11.2, U2.19 (VSS_AF)
unnamed: R6.2, U2.28 (XCLR)
unnamed: R3.1, Y1.3 (OUTPUT)
