ihsanakyrk/Eski-Versionlar-Ve-Siparisler/[11.2023]/Beacon(Kasım_2023)/Beacon_V1.0_(28.11.2023)/Bluetooth_Beacon_Kicad.kicad_pcb

## KiCad design [11.2023]/Beacon(Kasım_2023)/Beacon_V1.0_(28.11.2023)/Bluetooth_Beacon_Kicad.kicad_pcb (2025-09-01)

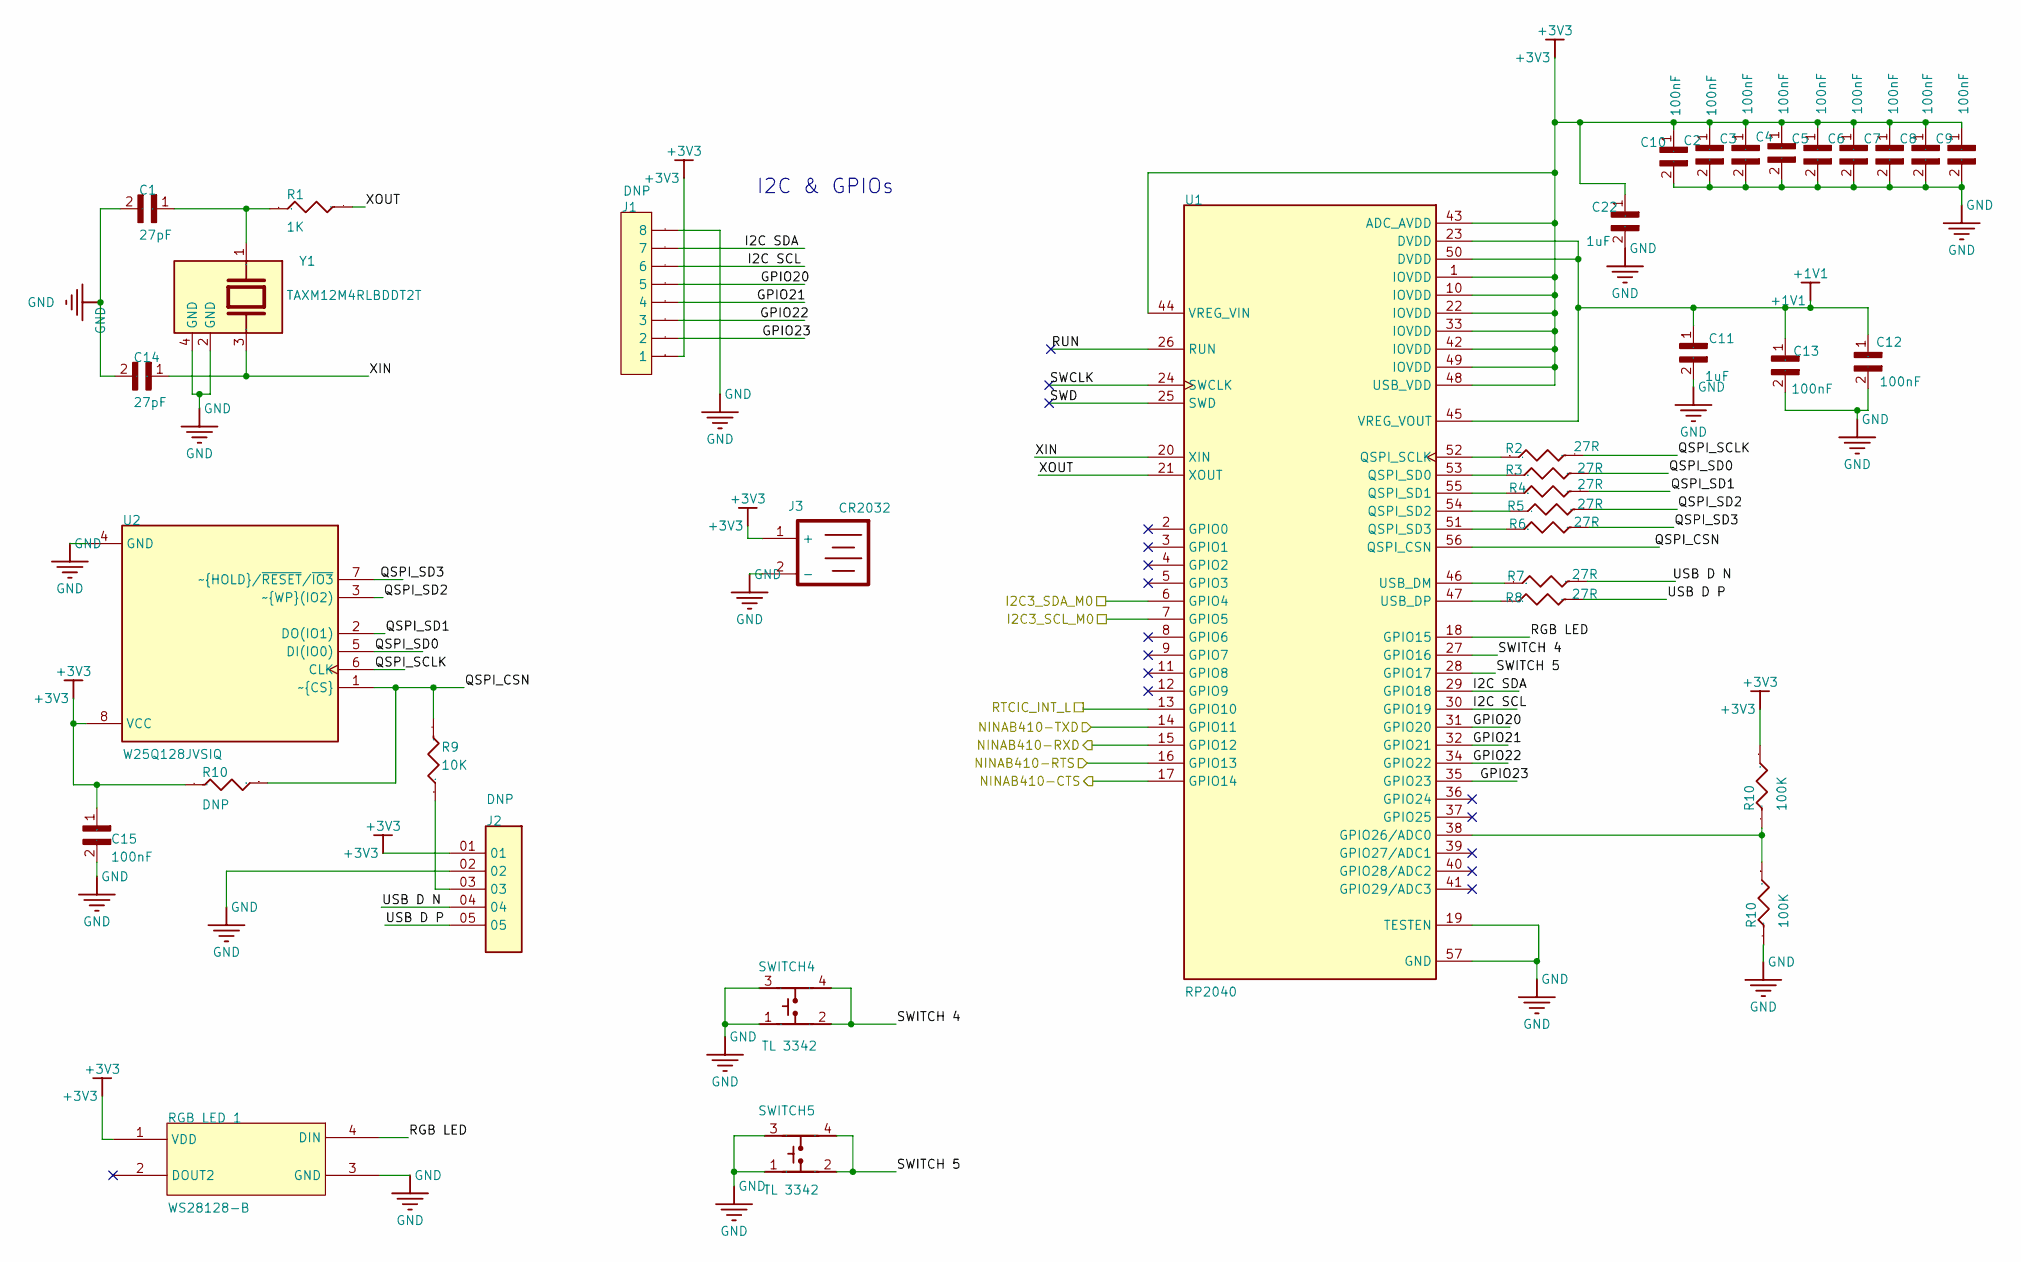
[picture p135: schematic RP2040.kicad_sch]

Parts:
C1, C14: 27pF; C_0402
C2, C3, C4, C5, C6, C7, C8, C9, C12, C13: 100nF; c_0402
C10: 100nF; CAPC1005X55N
C11, C22: 1uF; c_0402
C15: 100nF; C_0402
J1: DNP; Header_8Ways_2x54
J2: DNP; Header 5 Ways 2x54
J3: CR2032; Coin Cell Battery Holder
R1: 1K; Res_0402
R2, R3, R4, R5, R6, R7, R8: 27R; Res_0402
R9: 10K; Res_0402
R10: 100K; R_0402_1005Metric
RGB LED 1: WS28128-B
SWITCH4, SWITCH5: TL 3342
U1: RP2040; QFN40P700X700X90-57N
U2: W25Q128JVSIQ
Y1: TAXM12M4RLBDDT2T; Crystal_SMD_3225-4Pin_3.2x2.5mm

Connections:
+1V1: C11.1, C12.1, C13.1, U1.23 (DVDD), U1.45 (VREG_VOUT), U1.50 (DVDD)
GPIO20: J1.5, U1.31 (GPIO20)
GPIO21: J1.4, U1.32 (GPIO21)
GPIO22: J1.3, U1.34 (GPIO22)
GPIO23: J1.2, U1.35 (GPIO23)
I2C SCL: J1.6, U1.30 (GPIO19)
I2C SDA: J1.7, U1.29 (GPIO18)
NINAB401-RTS: U1.16 (GPIO13); also elsewhere on the board
NINAB410-CTS: U1.17 (GPIO14); also elsewhere on the board
NetC1_1: C1.1, R1.1, Y1.1
NetJ2_03: J2.03, R9.1
NetR2_1: R2.1, U1.52 (QSPI_SCLK)
NetR3_1: R3.1, U1.53 (QSPI_SD0)
NetR4_1: R4.1, U1.55 (QSPI_SD1)
NetR5_1: R5.1, U1.54 (QSPI_SD2)
NetR6_1: R6.1, U1.51 (QSPI_SD3)
NetR7_1: R7.1, U1.46 (USB_DM)
NetR8_1: R8.1, U1.47 (USB_DP)
NetR15_1: U1.13 (GPIO10); also elsewhere on the board
NetR16_2: U1.6 (GPIO4); also elsewhere on the board
NetR17_2: U1.7 (GPIO5); also elsewhere on the board
NetR20_1: U1.39 (GPIO27/ADC1); also elsewhere on the board
QSPI_SCLK: R2.2, U2.6 (CLK)
QSPI_SD0: R3.2, U2.5 (DI(IO0))
QSPI_SD1: R4.2, U2.2 (DO(IO1))
QSPI_SD2: R5.2, U2.3 (~WP~{}(IO2))
QSPI_SD3: R6.2, U2.7 (~HOLD~{}/~RESET/~IO3)
RGB LED: RGB LED 1.4 (DIN), U1.18 (GPIO15)
RUN: U1.26 (RUN)
RXD: U1.15 (GPIO12); also elsewhere on the board
SWCLK: U1.24 (SWCLK)
SWD: U1.25 (SWD)
SWITCH 4: SWITCH4.2, SWITCH4.4, U1.27 (GPIO16)
SWITCH 5: SWITCH5.2, SWITCH5.4, U1.28 (GPIO17)
TXD: U1.14 (GPIO11); also elsewhere on the board
USB D N: J2.04, R7.2
USB D P: J2.05, R8.2
XIN: C14.1, U1.20 (XIN), Y1.3 (2)
XOUT: R1.2, U1.21 (XOUT)

Notes on the sheet:
I2C & GPIOs

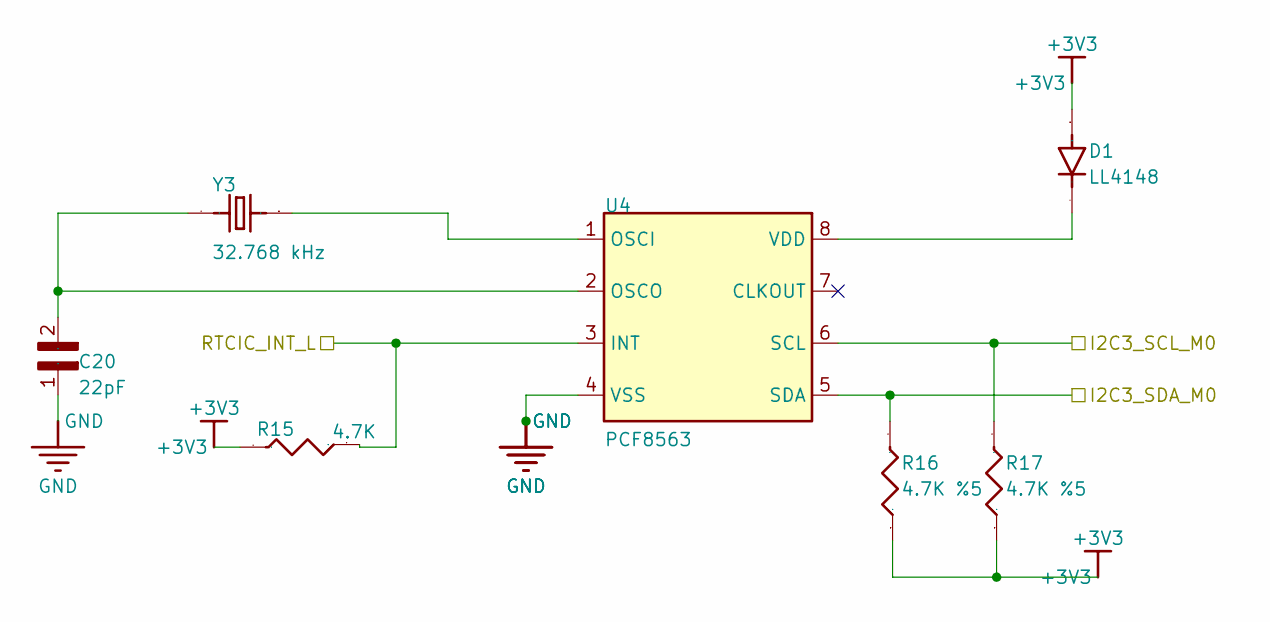
[picture p136: schematic RTCL.kicad_sch]

Parts:
C20: 22pF; c_0402
D1: LL4148; DIO_LL4148
R15: 4.7K; Res_0402
R16, R17: 4.7K %5; Res_0402
U4: PCF8563
Y3: 32.768 kHz; XTAL_ECS-3X8X

Connections:
NetC20_2: C20.2, U4.2 (OSCO), Y3.2
NetD1_C: D1.C, U4.8 (VDD)
NetR15_1: R15.1, U4.3 (INT); also elsewhere on the board
NetR16_2: R16.2, U4.5 (SDA); also elsewhere on the board
NetR17_2: R17.2, U4.6 (SCL); also elsewhere on the board
NetU4_1: U4.1 (OSCI), Y3.1

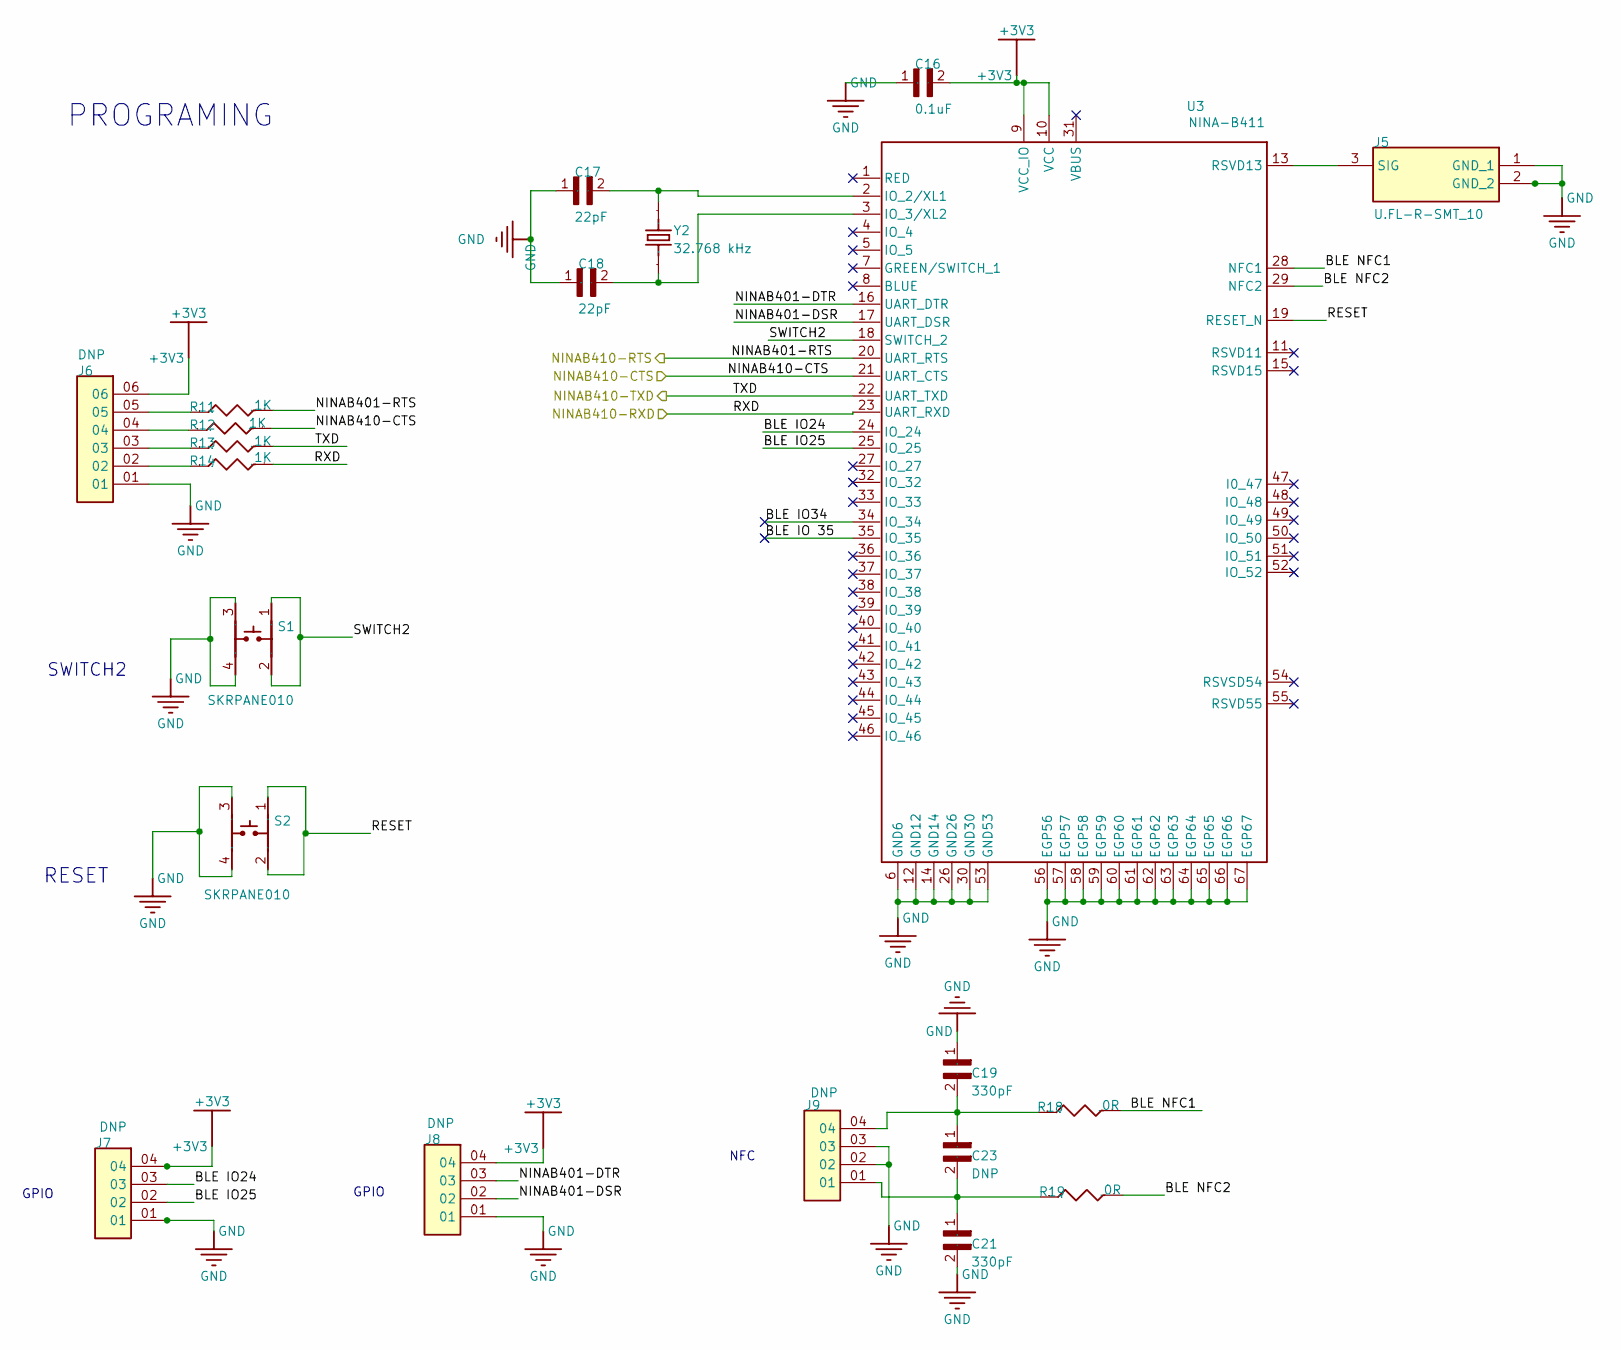
[picture p137: schematic NINA-B411.kicad_sch]

Parts:
C16: 0.1uF; C_0402
C17, C18: 22pF; C_0402
C19, C21: 330pF; C_0402
C23: DNP; C_0402
J5: U.FL-R-SMT_10; UFLRSMT10; MANUFACTURER_PART_NUMBER U.FL-R-SMT(10); MOUSER PART NUMBER 798-U.FL-R-SMT10
J6: DNP; Header_6Ways_2x54
J7, J8, J9: DNP; Header_4Ways_2x54_Male
R11, R12, R13, R14: 1K; Res_0402
R18, R19: 0R; Res_0402
S1, S2: SKRPANE010
U3: NINA-B411; NINA_LGA67R_1160X1000X223_PIN - duplicate
Y2: 32.768 kHz; XTAL_ECS-3X8X

Connections:
BLE IO24: J7.03, U3.24 (IO_24)
BLE IO25: J7.02, U3.25 (IO_25)
BLE IO34: U3.34 (IO_34)
BLE IO 35: U3.35 (IO_35)
BLE NFC1: R18.2, U3.28 (NFC1)
BLE NFC2: R19.2, U3.29 (NFC2)
NINAB401-DSR: J8.02, U3.17 (UART_DSR)
NINAB401-DTR: J8.03, U3.16 (UART_DTR)
NINAB401-RTS: R11.2, U3.20 (UART_RTS); also elsewhere on the board
NINAB410-CTS: R12.2, U3.21 (UART_CTS); also elsewhere on the board
NetC17_2: C17.2, U3.2 (IO_2/XL1), Y2.2
NetC18_2: C18.2, U3.3 (IO_3/XL2), Y2.1
NetC19_2: C19.2, C23.1, J9.04, R18.1
NetC21_1: C21.1, C23.2, J9.01, R19.1
NetJ5_3: J5.3 (SIG), U3.13 (RSVD13)
NetJ6_02: J6.02, R14.1
NetJ6_03: J6.03, R13.1
NetJ6_04: J6.04, R12.1
NetJ6_05: J6.05, R11.1
RESET: S2.1, S2.2, U3.19 (RESET_N)
RXD: R14.2, U3.23 (UART_RXD); also elsewhere on the board
SWITCH2: S1.1, S1.2, U3.18 (SWITCH_2)
TXD: R13.2, U3.22 (UART_TXD); also elsewhere on the board

Notes on the sheet:
NFC
GPIO
SWITCH2
PROGRAMING
RESET

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
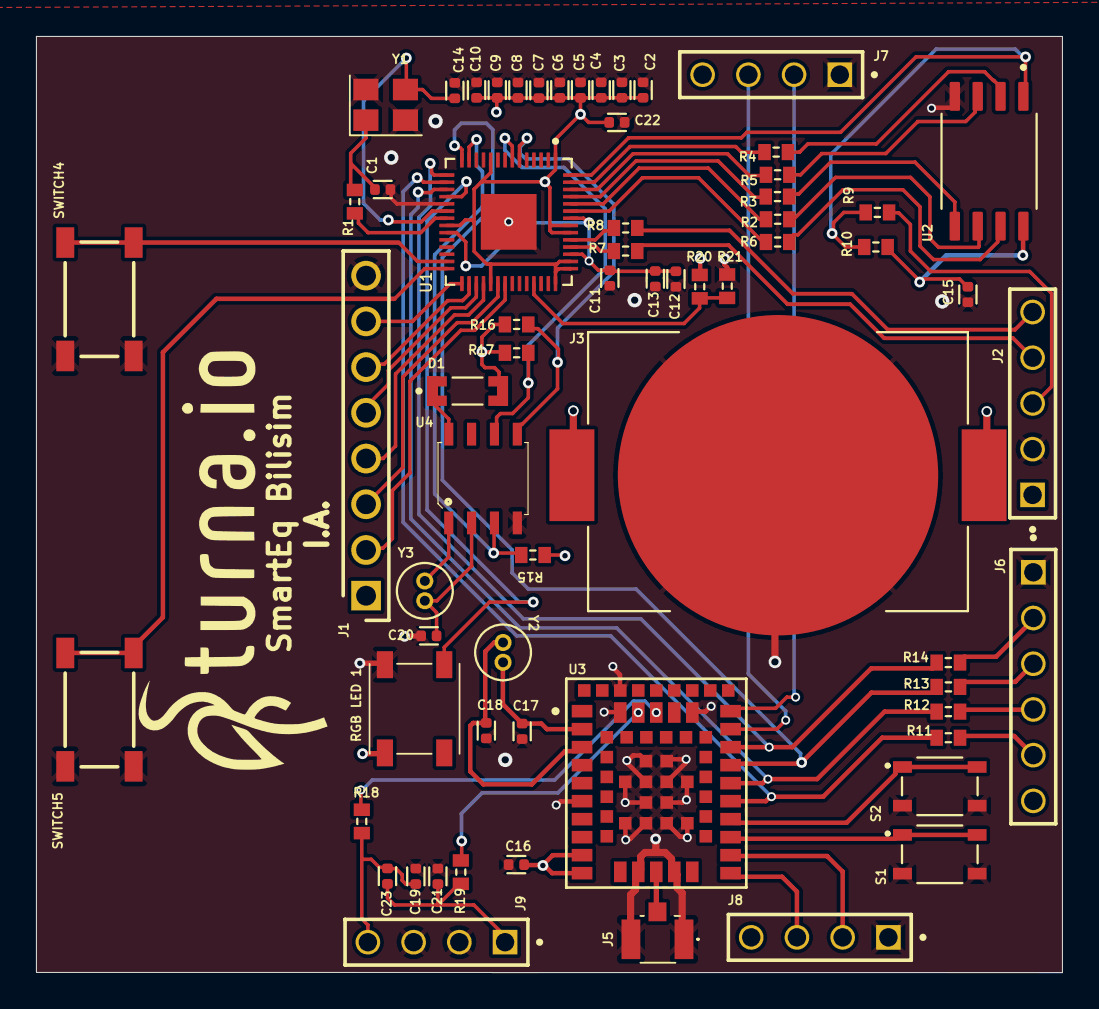
[picture p138: board Bluetooth_Beacon_Kicad.kicad_pcb from above]

Board: 4 copper layers, 57.0 x 52.0 mm, 65 parts (0 on the bottom side), 59 nets.

Other parts of the board:
R20, R21: 100K; Res_0402

Their connections:
NetR20_1: R20.1, R21.2; also elsewhere on the board
