ihsanakyrk/Eski-Versionlar-Ve-Siparisler/Movita_3566_XV_Router_V3.1/Movita_3566_XV_Router_V3.1/Movita_3566_XV_Router_V3.1.kicad_pcb

## KiCad design Movita_3566_XV_Router_V3.1/Movita_3566_XV_Router_V3.1/Movita_3566_XV_Router_V3.1.kicad_pcb (2025-09-01, an earlier design)

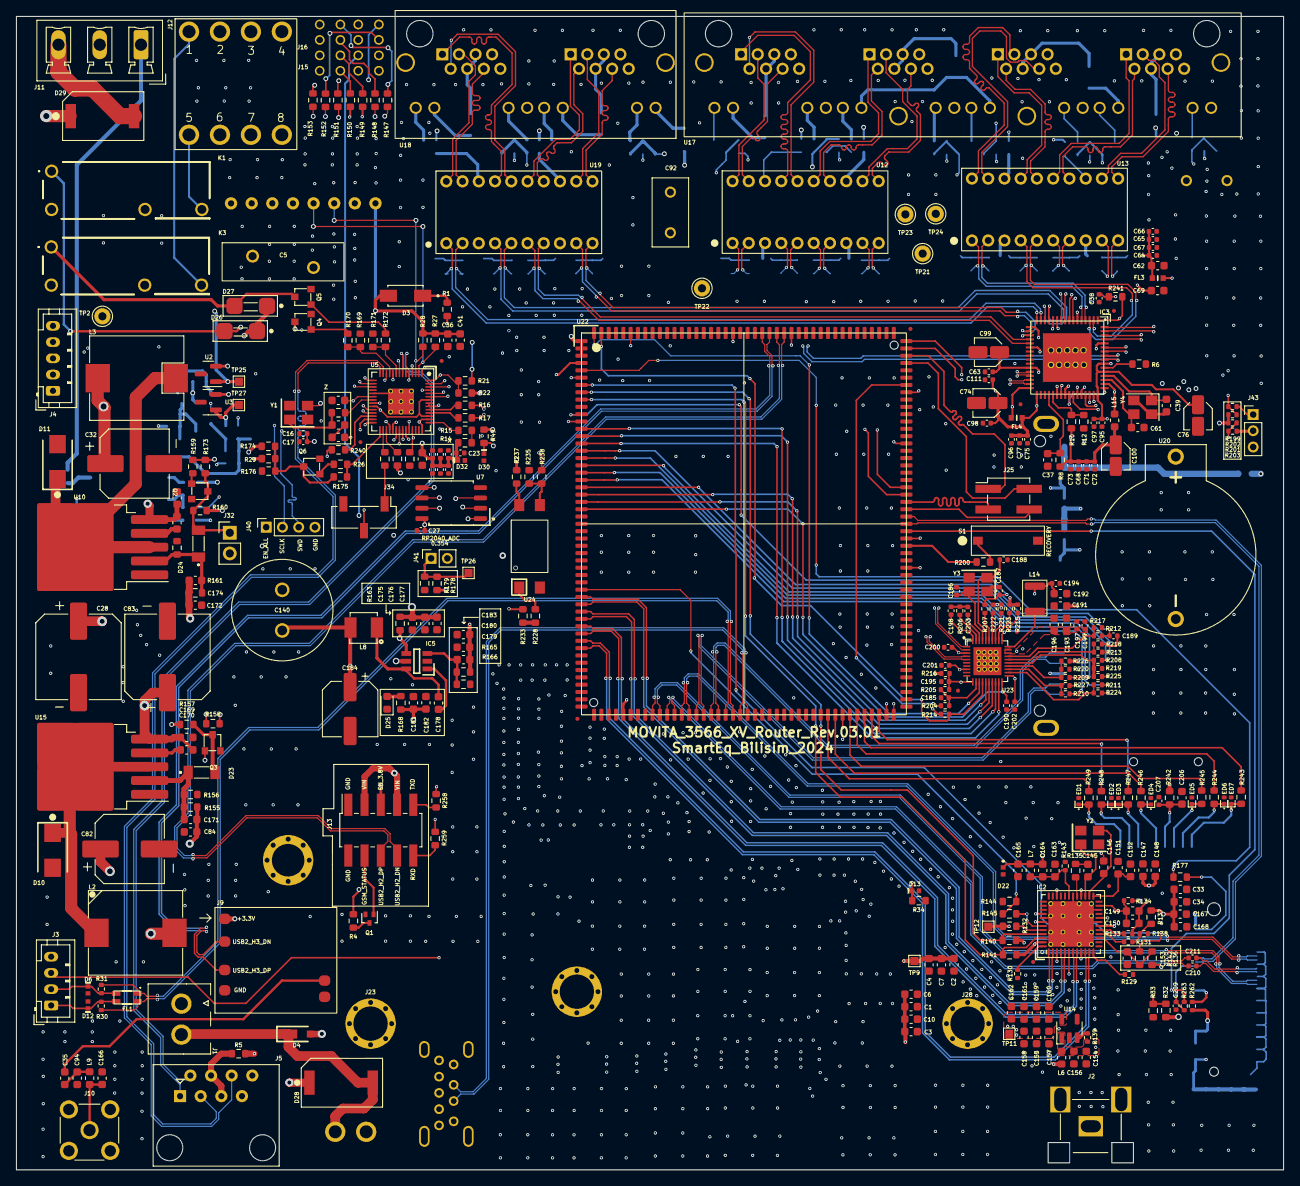
[picture p139: board Movita_3566_XV_Router_V3.1.kicad_pcb from above]

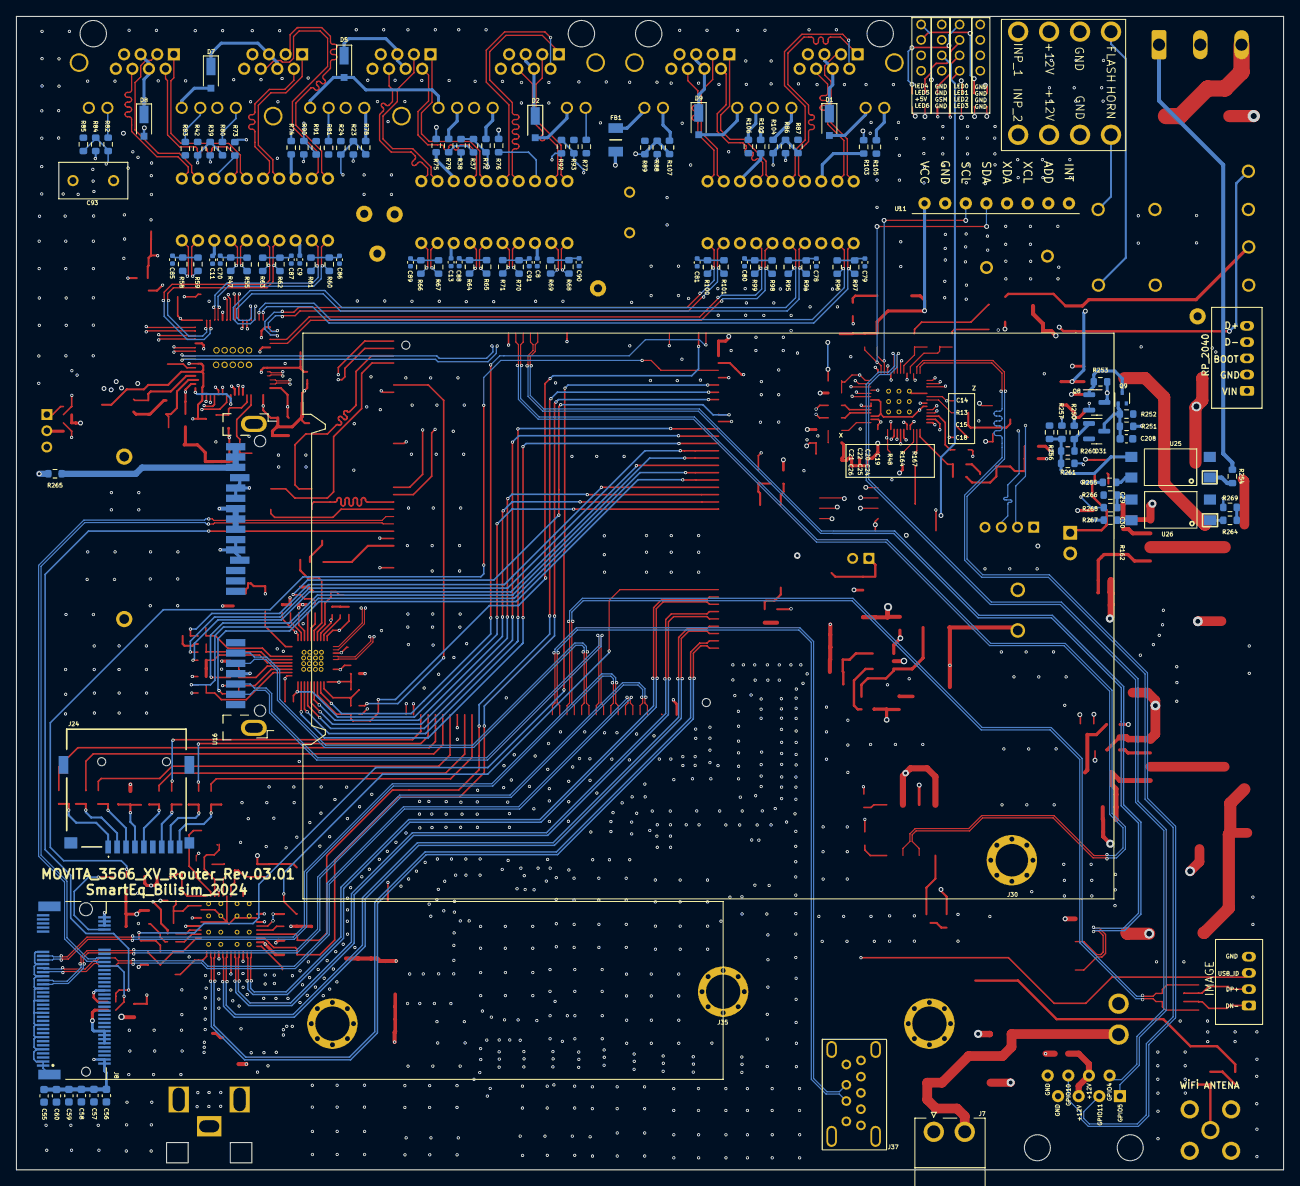
[picture p140: board Movita_3566_XV_Router_V3.1.kicad_pcb from below]

Board: 6 copper layers, 156.0 x 142.0 mm, 474 parts (118 on the bottom side), 347 nets.

Parts:
C1, C2, C3, C34, C36, C41, C55, C56, C57, C58, C59, C60, C147, C148, C150, C152, C156, C157, C158, C159, C160, C161, C162, C167, C168, C178, C182, C183, C208: 100nF; C_0603_1608Metric
C4, C6, C33, C149, C154, C191, C193, C196: 4.7uF; C_0603_1608Metric
C5: ERZ-V14D101; ERZV14D101
C7, C10, C37, C151, C155, C175, C176, C177, C192, C206: 10uF; C_0603_1608Metric
C8, C9, C11, C13, C16, C17, C20, C21, C22, C23, C24, C25, C26, C27, C38, C63, C64, C65, C66, C67, C68, C71, C72, C73, C75, C77, C95, C96, C97, C98, C111, C194, C195, C197, C198, C199, C200, C201, C202, C203, C207, C210, C211: 100nF; C_0402_1005Metric
C14, C15: 27pF; C_0603_1608Metric
C18, C19: 1uF; C_0603_1608Metric
C28, C83: 220uF/50V; C_Elec_10x10.2
C29, C30, C84, C169, C170, C172: 1uF/50V; C_0603_1608Metric
C32, C82: 330uF/25V; C_Elec_8x10.2
C35, C94, C166: 10pF; C_0603_1608Metric
C39, C61: 33pF; C_0603_1608Metric
C62, C69, C180, C181: 22uF; C_0603_1608Metric
C70, C78, C79, C80, C81, C85, C86, C87, C88, C89, C90, C91, C187, C189, C190: DNP; C_0402_1005Metric
C74, C76, C99, C100: 10uF; C_Elec_3x5.4
C92, C93: 1000PF 2KV; S102K33Y5PP63K5R
C140: 5.5V 0.22F; SuperCapacitor
C145, C146, C179: 22pF; C_0603_1608Metric
C153: 10nF; C_0603_1608Metric
C163: 100pF; C_0603_1608Metric
C164: DNP; C_0603_1608Metric
C165: 220pF; C_0603_1608Metric
C171, C174: 330nF; C_0603_1608Metric
C184: 220uF; CP_Elec_6.3x7.7
C185: 10nF; C_0402_1005Metric
C186, C188: 15pF; C_0402_1005Metric
C209: 100nF X7R 16V; C_0402_1005Metric
D1, D2, D4, D5, D7, D8, D9: 2SS100L-W; 2SS100LW
D3: SS14; DIOM4325X250N
D6, D12, D13, D30, D32: ESD5341N
D10, D11: SS54B
D22: ESD5451N
D23, D24: LL4148
D25: LED_GREEN; LED_0603_1608Metric
D26, D27: MRA4007T3G
D28, D29: S6MC
D31: BAT54; SOT-23
ED1, ED2, ED3, ED4, ED5, ED6, ED7: ESD5341N
FB1: YI321611U101-4R0T; BEADC3216X130N
FID1, FID2, FID5, FID6, FID7, FID8, FID9, FID10, FID11, FID12: DNP; Fiducial_0.5mm_Mask1mm
FL1: APCW3216-900P2T; DLW31SH222SQ2L
FL3, FL4: BLM18PG121SN1D; BLM18AG102BH1D
IC2: MS1836S_QFN48-7x7; QFN-48-1EP_7x7mm_P0.5mm_EP5.6x5.6mm
IC3: RTL8309N
IC5: SY8113B
J1: KF2EDGH-3.81-2P- Vertical; KF2EDGH-3.81-2P-Vertical
J2: DNP; AV_CON
J3: JST_PH_B4B-PH-K_1x04_P2.00mm_Vertical
J4: JST_PH_B5B-PH-K_1x05_P2.00mm_Vertical
J5: RJ45; RJ45_Amphenol_54602-x08_Horizontal
J7: KF2EDGH-3.81-2P- Right Angle; KF2EDGH-3.81-2P
J8: APCI0079-P002A J8900 M.2 M Key
J9: RTL8188EU
J10: SMA Connetor_inner_pin; SMA_Connector_inner_pin_right_angle
J11: KF2EDGR-Y-5.08-3P-Right Angle
J12: KF2EDGH-3.81_8P-Right Angle; KF2EDGH-3.81_8P
J13: MALE SMD Pin Header; PinSocket_2x05_P2.00mm_Vertical_SMD
J15, J16: LED_4_Block_Right Angle; LED_4_Block
J23, J28, J30: M3x*0.5 L=6; Screw Terminal Shinbo
J24: TF-CARD H1.8
J25: DNP; PinHeader_2x02_P2.54mm_Vertical_SMD
J32: DNP; PinHeader_1x02_P2.54mm_Vertical
J34: FEMALE SMD Pin Header; PinSocket_1x03_P2.54mm_Vertical_SMD_Pin1Left
J35: M3x*0.5 L=3; Screw Terminal Shinbo
J37: DNP; CP-USB-3015
J40: DNP; PinSocket_1x04_P2.00mm_Vertical
J41: DNP; PinSocket_1x02_P2.00mm_Vertical
J43: MALE Through Hole Pin Header; PinHeader_1x03_P2.00mm_Vertical
K1, K3: HF46F_5-HS1; HF46F5HS1
L2, L3: HX CYA1050-47UH; L_Bourns_SRR1208_12.7x12.7mm
L6: UPZ1608E101-3R0TF; L_0603_1608Metric
L7: MLI1608F-1R2KT; L_0603_1608Metric
L8: HA42-4R7MT; Inductor_0402_4.7uH
L9: SDCL1608C2N7STDF; L_0603_1608Metric
L14: AWL3225FP2R2MTF
L15: CBW160808U101T; L_0603_1608Metric
Q1: DTC043ZEBTL; SOT-416
Q2, Q3, Q4, Q5, Q6: MMBT2222ALT1G
Q8: DMG2305UX; SOT-23
Q9: DMG1012T; SOT-523
R1: 150R; R_0603_1608Metric
R4, R140, R141, R228, R264: 2.2K; R_0603_1608Metric
R5, R29, R241, R242: 0R; R_0603_1608Metric
R6, R8: 2.49K; R_0603_1608Metric
R10, R13, R21, R23, R37, R39, R48, R72, R77, R78, R79, R80, R81, R82, R83, R84, R87, R88, R104, R105, R106, R107, R132, R145, R170, R172, R233, R238, R250, R251, R257, R268, R269: 1K; R_0603_1608Metric
R12, R22, R24, R26, R38, R42, R47, R55, R58, R59, R60, R61, R62, R63, R64, R65, R66, R67, R68, R69, R70, R71, R85, R86, R89, R90, R91, R92, R93, R94, R95, R96, R97, R98, R99, R100, R101, R163, R167, R173, R174, R175, R176, R177, R240, R258, R259, R260, R261, R265: DNP; R_0603_1608Metric
R14: 200R; R_0603_1608Metric
R15: 1R; R_0603_1608Metric
R16, R17: 27R; R_0603_1608Metric
R27, R28, R32, R33, R34: 4.7K; R_0603_1608Metric
R30, R31: 2.2R; R_0402_1005Metric
R49, R136, R137, R149, R150, R155, R158, R159, R164, R169, R171, R235, R256, R266: 10K; R_0603_1608Metric
R73, R74, R75, R76, R102, R103: 75R; R_0603_1608Metric
R129, R138, R205, R225, R226: DNP; R_0402_1005Metric
R130, R199, R201, R262: 10K; R_0402_1005Metric
R131, R133, R134, R139, R204, R216: 0R; R_0402_1005Metric
R135: 330R; R_0603_1608Metric
R142, R243, R244, R245, R246, R247, R248, R249: 22R; R_0603_1608Metric
R143: 75R; R_0402_1005Metric
R144, R252, R253: 100K; R_0603_1608Metric
R147, R148, R151, R152, R153: 220R; R_0603_1608Metric
R156, R254: 3.3K; R_0603_1608Metric
R157, R160: 470R; R_0603_1608Metric
R161: 15K; R_0603_1608Metric
R162: 1.6K; R_0603_1608Metric
R165: 232K; R_0603_1608Metric
R166: 51K; R_0603_1608Metric
R168, R178: 2K; R_0603_1608Metric
R179: 180R; R_0603_1608Metric
R200: 100R; R_0603_1608Metric
R202, R203: 10R; R_0402_1005Metric
R206: 2.49K; R_0402_1005Metric
R207, R208, R209, R210, R211, R212, R213: 22R; R_0402_1005Metric
R214: 1.5K; R_0402_1005Metric
R215, R217, R218, R219, R220, R221, R222, R223, R224, R227: 4.7K; R_0402_1005Metric
R237, R255, R267: 33R; R_0603_1608Metric
R263: 1K; R_0402_1005Metric
S1: TS-1101-C-W
TP2, TP21, TP22, TP23, TP24: DNP; Pin_D1.0mm_L10.0mm
TP9, TP11, TP12, TP25, TP26, TP27: DNP; TestPoint_Pad_1.0x1.0mm
U2, U3: TLV76033DBZT; SOT-23
U5: RP2040; RP2040-QFN-56
U7: W25Q128JVSIQ; SOIC-8_5.23x5.23mm_P1.27mm
U10, U15: XL4015; TO-263-5_TabPin3
U11: DNP; module_mpu6050
U12, U13, U19: TF-218DG; RJ45_Transformer_2_Port
U14: RT9013-12GB; SOT-23-5
U16: SAF-8ASC-2132M; SATA_Connector_5622-1200-ML
U17: RJ45-4-Block; 4_Block_RJ45
U18: RJ45-2-Block; 2_Block_RJ45
U20: BS-2; BS-02-A1AJ010
U22: CM3566
U23: RTL8211F-CG
U24, U25, U26: PC817C; PC817
Y1: CF4012M00020001; Crystal_SMD_3225-4Pin_3.2x2.5mm
Y2: TAXM27M4RFBCCT2T; Crystal_SMD_3225-4Pin_3.2x2.5mm
Y3, Y4: X322525MSB4SI; Crystal_SMD_3225-4Pin_3.2x2.5mm

Connections:
3.3V_Sensor: C36.1, C41.1, D3.A, R27.1, R28.2, TP25.1, U2.1 (OUT), U11.1 (VCC)
+1V1: C16.1, C17.1, C18.1, U5.23 (DVDD), U5.45 (VREG_VOUT), U5.50 (DVDD)
/4 Port RJ45 and Transformer/+3.3V: C2.1, C4.1, C7.1, C55.1, C56.1, C57.1, C58.1, C59.1, C60.1, C140.1, C179.2, C180.2, C181.2, C182.2, C183.2, C184.1, C191.1, FB1.1, FL3.1, J8.2, J8.4, J8.12, J8.14, J8.16, J8.18, J8.70, J8.72, J8.74, J9.1, L6.1, L8.2, R29.2, R165.1, R168.1, R178.1, R199.1, R201.1, R216.1, R237.1, R242.2, R262.1, R267.1, TP9.1, U22.1, U22.2, U22.3
/4 Port RJ45 and Transformer/LED0: IC3.38 (P0LED/DIS_EEE), R37.1, R38.2, R72.1
/4 Port RJ45 and Transformer/LED1: IC3.39 (P1LED/LED_MODE[1]), R23.1, R24.2, R78.2
/4 Port RJ45 and Transformer/LED2: IC3.40 (P2LED/LED_MODE[2]), R39.1, R42.2, R80.2
/4 Port RJ45 and Transformer/LED3: IC3.42 (P3LED/RMAMODE), R82.2, R84.1, R85.2
/4 Port RJ45 and Transformer/LED4: IC3.43 (P4LED/UNKOWN_MULTI), R86.1, R87.2, R104.2
/4 Port RJ45 and Transformer/LED5: IC3.44 (P5LED/DIS_RST_BLNK), R88.1, R89.2, R107.2
/4 Port RJ45 and Transformer/RXI_0_N: IC3.57 (RXIN0), R71.2, U12.5
/4 Port RJ45 and Transformer/RXI_0_P: IC3.56 (RXIP0), R70.2, U12.4
/4 Port RJ45 and Transformer/RXI_1_N: IC3.63 (RXIN1), R64.2, U12.7
/4 Port RJ45 and Transformer/RXI_1_P: IC3.64 (RXIP1), R65.2, U12.6
/4 Port RJ45 and Transformer/RXI_2_N: IC3.3 (RXIN2), R63.2, U13.5
/4 Port RJ45 and Transformer/RXI_2_P: IC3.2 (RXIP2), R62.2, U13.4
/4 Port RJ45 and Transformer/RXI_3_N: IC3.9 (RXIN3), R47.2, U13.7
/4 Port RJ45 and Transformer/RXI_3_P: IC3.10 (RXIP3), R55.2, U13.6
/4 Port RJ45 and Transformer/RXI_4_N: IC3.14 (RXIN4), R95.2, U19.5
/4 Port RJ45 and Transformer/RXI_4_P: IC3.13 (RXIP4), R94.2, U19.4
/4 Port RJ45 and Transformer/RXI_5_N: IC3.20 (RXIN5), R99.2, U19.7
/4 Port RJ45 and Transformer/RXI_5_P: IC3.21 (RXIP5), R98.2, U19.6
/4 Port RJ45 and Transformer/TXO_0_N: IC3.58 (TXON0), R69.2, U12.2
/4 Port RJ45 and Transformer/TXO_0_P: IC3.59 (TXOP0), R68.2, U12.1
/4 Port RJ45 and Transformer/TXO_1_N: IC3.62 (TXON1), R66.2, U12.10
/4 Port RJ45 and Transformer/TXO_1_P: IC3.61 (TXOP1), R67.2, U12.9
/4 Port RJ45 and Transformer/TXO_2_N: IC3.4 (TXON2), R61.2, U13.2
/4 Port RJ45 and Transformer/TXO_2_P: IC3.5 (TXOP2), R60.2, U13.1
/4 Port RJ45 and Transformer/TXO_3_N: IC3.8 (TXON3), R58.2, U13.10
/4 Port RJ45 and Transformer/TXO_3_P: IC3.7 (TXOP3), R59.2, U13.9
/4 Port RJ45 and Transformer/TXO_4_N: IC3.15 (TXON4), R96.2, U19.2
/4 Port RJ45 and Transformer/TXO_4_P: IC3.16 (TXOP4), R97.2, U19.1
/4 Port RJ45 and Transformer/TXO_5_N: IC3.19 (TXON5), R100.2, U19.10
/4 Port RJ45 and Transformer/TXO_5_P: IC3.18 (TXOP5), R101.2, U19.9
/+12V: C32.1, C172.2, C174.2, C175.2, C176.2, C177.2, D1.2, D2.2, D4.2, D5.2, D7.2, D8.2, D9.2, IC5.5 (IN), J12.3, J12.7, L3.2, R5.1, R161.1, R163.1, R265.2, TP2.1, U17.P1_L_Led+, U17.P2_L_Led+, U17.P3_L_Led+, U17.P4_L_Led+, U18.P1_L_Led+, U18.P2_L_Led+
/CM3566/GMAC1_MCLKINOUT_M0: C187.1, R207.1, U22.11
/CM3566/GMAC1_MDC_M0: U22.186, U23.13 (MDC)
/CM3566/GMAC1_MDIO_M0: R214.2, U22.185, U23.14 (MDIO)
/CM3566/GMAC1_RXCLK_M0: C189.1, R212.1, U22.21
/CM3566/GMAC1_RXD0_M0: R208.1, U22.18
/CM3566/GMAC1_RXD1_M0: R209.1, U22.17
/CM3566/GMAC1_RXD2_M0: R210.1, U22.20
/CM3566/GMAC1_RXD3_M0: R211.1, U22.19
/CM3566/GMAC1_RXDV_CRS_M0: R213.1, U22.16
/CM3566/GMAC1_TXCLK_M0: C190.1, U22.24, U23.20 (TXC)
/CM3566/GMAC1_TXD0_M0: U22.13, U23.18 (TXD0)
/CM3566/GMAC1_TXD1_M0: U22.14, U23.17 (TXD1)
/CM3566/GMAC1_TXD2_M0: U22.22, U23.16 (TXD2)
/CM3566/GMAC1_TXD3_M0: U22.23, U23.15 (TXD3)
/CM3566/GMAC1_TXEN_M0: U22.15, U23.19 (TXCTL)
/CM3566/HDMI_TX_HPDIN: R144.1, R145.2, U22.35
/CM3566/LED0/CFG_EXT: R223.1, U23.32 (LED0/CFG_EXT)
/CM3566/LED1/CFG_LDO0: R221.2, U23.33 (LED1/CFG_LDO0_)
/CM3566/LED2/CFG_LDO1: R222.2, U23.34 (LED2/CFG_LDO1)
/CM3566/PCIE20_CLKREQn_M2: J8.52, U22.120
/CM3566/PCIE20_PERSTn_M2: R263.1, U22.118
/CM3566/PCIE20_REFCLKN: J8.53, U22.65
/CM3566/PCIE20_REFCLKP: J8.55, U22.64
/CM3566/PCIE20_RXN: J8.41, U22.61
/CM3566/PCIE20_RXP: J8.43, U22.60
/CM3566/PCIE20_TXN: C210.1, U22.62
/CM3566/PCIE20_TXP: C211.1, U22.63
/CM3566/PCIE20_WAKEn_M2: J8.54, U22.119
/CM3566/PHY0_XTALIN: C188.1, U23.36 (XTAL_IN), Y3.1 (XIN)
/CM3566/PHY0_XTALOUT: C186.1, U23.37 (XTAL_OUT/EXT_CLK), Y3.3 (XOUT)
/CM3566/PHY1_MDI0+: IC3.28 (TXOP7), U23.1 (MDI[0]+)
/CM3566/PHY1_MDI0-: IC3.29 (TXON7), U23.2 (MDI[0]-)
/CM3566/PHY1_MDI1+: IC3.31 (RXIP7), U23.4 (MDI[1]+)
/CM3566/PHY1_MDI1-: IC3.30 (RXIN7), U23.5 (MDI[1]-)
/CM3566/PHY-Reset: C185.1, R204.2, R205.1, U23.12 (PHYRSTB)
/CM3566/PHY_CLKOUT125: R207.2, U23.35 (CLKOUT)
/CM3566/PHY_RXCLK/PHYAD1: R212.2, R217.2, U23.27 (RXC/PHYAD1)
/CM3566/PHY_RXD0/RXDLY: R208.2, R219.2, R225.1, U23.25 (RXD0/RXDLY)
/CM3566/PHY_RXD1/TXDLY: R209.2, R220.2, R226.1, U23.24 (RXD1/TXDLY)
/CM3566/PHY_RXD2/PLLOFF: R210.2, R227.1, U23.23 (RXD2/PLLOFF)
/CM3566/PHY_RXD3/PHYAD0: R211.2, R224.1, U23.22 (RXD3/PHYAD0)
/CM3566/PHY_RXDV/PHYAD2: R213.2, R218.2, U23.26 (RXCTL/PHYAD2)
/CM3566/PMIC_32KOUT_SOC: R177.1, U22.5
/CM3566/REG_OUT: L14.1, U23.30 (REG_OUT)
/CM3566/RSET: R206.2, U23.39 (RSET)
/CM3566/SARADC_VIN0_KEY/RECOVERY: R200.1, U22.116
/CM3566/SATA0_RXN: U16.S5 (RX-), U22.69
/CM3566/SATA0_RXP: U16.S6 (RX+), U22.68
/CM3566/SATA0_TXN: U16.S3 (TX-), U22.67
/CM3566/SATA0_TXP: U16.S2 (TX+), U22.66
/CM3566/SDMMC0_CLK: R246.1, U22.85
/CM3566/SDMMC0_CMD: R245.1, U22.87
/CM3566/SDMMC0_D0: R247.1, U22.91
/CM3566/SDMMC0_D1: R248.1, U22.90
/CM3566/SDMMC0_D2: R243.1, U22.89
/CM3566/SDMMC0_D3: R244.1, U22.88
/CM3566/SDMMC0_DET_L: R249.1, U22.84
/CM3566/SPI3_CLK_M1: R204.1, U22.138
/CM3566/SPI3_MOSI_M1: R215.1, U22.137, U23.31 (INTB/PMEB)
/CM3566/UART2_RX_M0_DEBUG: R201.2, R203.2, U22.143
/CM3566/UART2_TX_M0_DEBUG: R199.2, R202.2, U22.144
/CM3566/UART3_RX_M0: J25.4, U22.121
/CM3566/UART3_TX_M0: J25.3, U22.122
/CM3566/UART4_RX_M0: R259.2, U5.27 (GPIO16), U22.123
/CM3566/UART4_TX_M0: R258.2, U5.28 (GPIO17), U22.124
/CM3566/UART5_RX_M1: J25.2, U22.141
/CM3566/UART5_TX_M1: J25.1, U22.142
/CM3566/USB2_HOST2_DN: J13.8, U22.160
/CM3566/USB2_HOST2_DP: J13.6, U22.161
/CM3566/USB2_HOST3_DN: J9.2, U22.163
/CM3566/USB2_HOST3_DP: J9.3, U22.162
/CM3566/USB3_HOST1_DN: J37.2 (D-), U22.73
/CM3566/USB3_HOST1_DP: J37.3 (D+), U22.72
/CM3566/USB3_OTG0_DN: FL1.4, R30.1, U22.70
/CM3566/USB3_OTG0_DP: FL1.1, R31.1, U22.71
/CM3566/USB3_OTG0_ID: D13.1, J3.3, R34.2, U22.92
/CM3566/USB3_OTG0_VBUSDET: R32.2, R33.1, U22.93
/CM3566/VCC3V3_LAN: C193.1, C195.1, C196.1, C197.1, C198.1, C199.1, R205.2, R214.1, R215.2, R216.2, R223.2, R224.2, R225.2, R226.2, R227.2, U23.11 (AVDD33_2), U23.28 (DVDD_RG), U23.29 (DVDD33), U23.40 (AVDD33_1)
/CM3566/VDD10_EPHY: C192.1, C194.1, C200.1, C201.1, C202.1, C203.1, L14.2, U23.3 (AVDD10_3), U23.8 (AVDD10_2), U23.21 (DVDD10), U23.38 (AVDD10_1)
/CM3566/VDD_5V: C1.1, C3.1, C6.1, C10.1, C82.1, C84.2, C171.2, D26.1 (K), D27.1 (K), J16.6, J37.1 (VBUS), K1.2 (COIL_2), K3.2 (COIL_2), L2.2, R32.1, R155.1, R174.2, U16.P7 (VCC5), U16.P8 (VCC5), U16.P9 (VCC5)
/CM3566/VRTC: R1.2, U20.1 (+), U22.4
/EC25_Sim/GSM_LED: J16.5, R4.2
/EC25_Sim/GSM_STATUS: J13.4, Q1.1 (B)
/HDMI_CVBS/CVideo_OUT: C164.2, C165.1, D22.1, J2.1, J2.2, L7.2
/HDMI_CVBS/DAC_R: C163.1, C164.1, IC2.31 (AV_OUT), L7.1, R143.2
/HDMI_CVBS/HDMITX_CEC_M0: R142.1, U22.7
/HDMI_CVBS/HDMI_RX_HPD: IC2.43 (HDMIRX_HPD), R145.1
/HDMI_CVBS/HDMI_TX0N_PORT: IC2.4 (HDMI_RX0N), U22.38
/HDMI_CVBS/HDMI_TX0P_PORT: IC2.5 (HDMI_RX0P), U22.39
/HDMI_CVBS/HDMI_TX1N_PORT: IC2.7 (HDMI_RX1N), U22.40
/HDMI_CVBS/HDMI_TX1P_PORT: IC2.8 (HDMI_RX1P), U22.41
/HDMI_CVBS/HDMI_TX2N_PORT: IC2.10 (HDMI_RX2N), U22.42
/HDMI_CVBS/HDMI_TX2P_PORT: IC2.11 (HDMI_RX2P), U22.43
/HDMI_CVBS/HDMI_TXCLKN_PORT: IC2.1 (HDMI_RXCN), U22.36
/HDMI_CVBS/HDMI_TXCLKP_PORT: IC2.2 (HDMI_RXCP), U22.37
/HDMI_CVBS/P/N_SEL: R131.1, R137.2, R138.1
/HDMI_CVBS/RSTn: C153.1, IC2.15 (RSTn), R136.1, R142.2
/HDMI_CVBS/RXDDC_SCL: IC2.46 (RXDDC_SCL), R141.1, U22.9
/HDMI_CVBS/RXDDC_SDA: IC2.45 (RXDDC_SDA), R140.1, U22.8
/HDMI_CVBS/RX_DET: IC2.44 (HDMIRX_DET), R132.2
/HDMI_CVBS/VDD10_EPHY: C155.1, C157.1, C158.1, C159.1, C160.1, C161.1, C162.1, IC2.3 (AVDD12), IC2.9 (AVDD12_1), IC2.20 (DVDD12), IC2.40 (DVDD12_1), TP11.1, U14.5 (OUT)
/HDMI_CVBS/XTAL1: C145.1, IC2.27 (XTOUT), Y2.1
/HDMI_CVBS/XTAL2: C146.1, IC2.26 (XTIN), Y2.3
/IO Connector/FLASH: J12.1, K3.4 (COM)
/IO Connector/GP3_A: J34.1, R167.2
/IO Connector/HORN: J12.5, K1.4 (COM)
/IO Connector/SWCLK: J40.2, U5.24 (SWCLK)
/IO Connector/SWD: J40.3, U5.25 (SWD)
/Power Unit/+3V3_Mini: C19.1, C20.1, C21.1, C22.1, C23.1, C24.1, C25.1, C26.1, C27.1, D32.1, Q8.2 (S), R14.1, R22.1, R157.1, R160.1, U5.1 (IOVDD), U5.10 (IOVDD), U5.22 (IOVDD), U5.33 (IOVDD), U5.42 (IOVDD), U5.44 (VREG_IN), U5.48 (USB_VDD), U5.49 (IOVDD), U7.8 (VCC)
/Power Unit/IGN_LOGIC: R256.1, R257.1, R260.1, R261.1, U25.3 (E)
/Power Unit/IGN_V: Q8.3 (D), R250.2, R253.2, R255.1, TP27.1, U3.1 (OUT)
/Power Unit/MCU_Power_EN: Q6.3 (C), R29.1, R174.1, R175.1, R176.1
/RP2040/GPIO0: R27.2, U5.2 (GPIO0), U11.4 (SDA)
/RP2040/GPIO1: R28.1, U5.3 (GPIO1), U11.3 (SCL)
/RP2040/GPIO2: R251.1, R261.2, U5.4 (GPIO2)
/RP2040/GPIO3: R257.2, U5.5 (GPIO3)
/RP2040/GPIO4: J5.2, U5.6 (GPIO4)
/RP2040/GPIO5: J5.1, U5.7 (GPIO5)
/RP2040/GPIO6: R147.1, U5.8 (GPIO6)
/RP2040/GPIO7: R171.1, R172.1, U5.9 (GPIO7)
/RP2040/GPIO8: R169.1, R170.1, U5.11 (GPIO8)
/RP2040/GPIO9: R148.1, U5.12 (GPIO9)
/RP2040/GPIO10: J5.6, U5.13 (GPIO10)
/RP2040/GPIO11: J5.3, U5.14 (GPIO11)
/RP2040/GPIO12: R151.1, U5.15 (GPIO12)
/RP2040/GPIO13: R152.1, U5.16 (GPIO13)
/RP2040/GPIO14: R153.1, U5.17 (GPIO14)
/RP2040/GPIO18: R26.1, R175.2, U5.29 (GPIO18)
/RP2040/GPIO19: R167.1, U5.30 (GPIO19)
/RP2040/GPIO20: R164.2, U5.31 (GPIO20)
/RP2040/GPIO21: J13.5, U5.32 (GPIO21)
/RP2040/GPIO22: R158.1, U5.34 (GPIO22)
/RP2040/GPIO23: R159.1, R173.1, U5.35 (GPIO23)
/RP2040/GPIO24: R268.2, U5.36 (GPIO24)
/RP2040/GPIO25: R238.2, U5.37 (GPIO25)
/RP2040/GPIO26_ADC0: J41.1, R178.2, R179.1, TP26.1, U5.38 (GPIO26_ADC0)
/RP2040/GPIO27_ADC1: D30.1, R48.1, R49.2, U5.39 (GPIO27_ADC1)
/RP2040/QSPI_SCLK: U5.52 (QSPI_SCLK), U7.6 (CLK)
/RP2040/QSPI_SD0: U5.53 (QSPI_SD0), U7.5 (DI(IO0))
/RP2040/QSPI_SD1: U5.55 (QSPI_SD1), U7.2 (DO(IO1))
/RP2040/QSPI_SD2: U5.54 (QSPI_SD2), U7.3 (IO2)
/RP2040/QSPI_SD3: U5.51 (QSPI_SD3), U7.7 (IO3)
/RP2040/QSPI_SS: R21.1, R22.2, U5.56 (QSPI_SS), U7.1 (~CS)
/RP2040/RUN: J34.2, R240.2
/RP2040/USB_D+_RP2040: J4.5, R16.1
/RP2040/USB_D-_RP2040: J4.4, R17.1
/RP2040/USB_D_N: R17.2, U5.46 (USB_DM)
/RP2040/USB_D_P: R16.2, U5.47 (USB_DP)
/RP2040/XIN: C14.1, U5.20 (XIN), Y1.3
/RP2040/XOUT: R13.1, U5.21 (XOUT)
/RP2040/~USB_BOOT: J4.3, R21.2
/RTL8309E/1V0_AVDD: C76.1, C95.1, C97.1, FL4.1, IC3.1 (AVDDL_1), IC3.12 (AVDDL_2), IC3.22 (AVDDL_3), IC3.32 (AVDDL_4), IC3.48 (V10OUT), IC3.53 (AVDDLPLL), IC3.55 (AVDDL_5), R241.2, TP24.1
/RTL8309E/1V0_DVDD: C74.1, C75.1, C77.1, C96.1, C98.1, C111.1, FL4.2, IC3.33 (DVDDL_2), IC3.47 (DVDDL_3), TP23.1
/RTL8309E/ETH_DVDD3V3: C68.1, C69.1, C71.1, C72.1, C73.1, C100.1, IC3.6 (AVDDH_1), IC3.41 (DVDDH), IC3.49 (V33IN), L15.2, R8.1, R10.2, R23.2, R37.2, R39.2, R84.2, R86.2, R88.2, R90.2, R92.2, TP22.1
/RTL8309E/LED6: IC3.45 (P6LED), R90.1, R91.2
/RTL8309E/LED7: IC3.46 (P7LED), R92.1, R93.2
ADC_VREF: R14.2, R15.1
CMT1: R76.2, U12.18
CMT2: R75.2, U12.13
CMT3: R74.2, U13.18
CMT4: R73.2, U13.13
CMT5: R103.2, U19.18
CMT6: R102.2, U19.13
CT: C8.1, C9.1, C11.1, C13.1, C62.1, C63.1, C64.1, C65.1, C66.1, C67.1, C99.1, FL3.2, IC3.17 (AVDDH_2), IC3.27 (AVDDH_3), IC3.50 (AVDDHPLL), IC3.60 (AVDDH_4), L15.1, TP21.1, U12.3, U12.8, U13.3, U13.8, U19.3, U19.8
Earth: C1.2, C2.2, C3.2, C4.2, C5.2, C6.2, C7.2, C8.2, C9.2, C10.2, C11.2, C13.2, C14.2, C15.2, C16.2, C17.2, C18.2, C19.2, C20.2, C21.2, C22.2, C23.2, C24.2, C25.2, C26.2, C27.2, C28.2, C29.1, C32.2, C33.2, C34.2, C36.2, C37.2, C38.2, C39.2, C41.2, C55.2, C56.2, C57.2, C58.2, C59.2, C60.2, C61.2, C62.2, C63.2, C64.2, C65.2, C66.2, C67.2, C68.2, C69.2, C70.2, C71.2, C72.2, C73.2, C74.2, C75.2, C76.2, C77.2, C78.2, C79.2, C80.2, C81.2, C82.2, C83.2, C84.1, C85.2, C86.2, C87.2, C88.2, C89.2, C90.2, C91.2, C92.1, C94.2, C95.2, C96.2, C97.2, C98.2, C99.2, C100.2, C111.2, C140.2, C145.2, C146.2, C147.2, C148.2, C149.2, C150.2, C151.2, C152.2, C153.2, C154.2, C155.2, C156.2, C157.2, C158.2, C159.2, C160.2, C161.2, C162.2, C163.2, C165.2, C166.2, C167.2, C168.2, C169.1, C172.1, C175.1, C176.1, C177.1, C180.1, C181.1, C182.1, C183.1, C184.2, C185.2, C186.2, C187.2, C188.2, C189.2, C190.2, C191.2, C192.2, C193.2, C194.2, C195.2, C196.2, C197.2, C198.2, C199.2, C200.2, C201.2, C202.2, C203.2, C206.2, C207.2, C208.1, C209.2, D6.2, D10.2, D11.2, D12.2, D13.2, D22.2, D25.1 (K), D30.2, D32.2, ED1.2, ED2.2, ED3.2, ED4.2, ED5.2, ED6.2, ED7.2, IC2.19 (VSS), IC2.22 (VREF_L), IC2.30 (VSS_1), IC2.41 (VSS_2), IC2.49 (GND(EPAD)), IC3.65 (EP), IC5.2 (GND), J1.1, J2.3, J3.4, J4.2, J5.7, J5.8, J7.1, J8.1, J8.3, J8.9, J8.15, J8.21, J8.27, J8.33, J8.39, J8.45, J8.51, J8.57, J8.71, J8.73, J8.75, J8.SH1 (SHIELD), J8.SH2 (SHIELD), J9.4, J9.5, J10.2, J10.3, J10.4, J10.5, J11.2, J12.2, J12.6, J13.1, J13.2, J15.1, J15.3, J15.5, J15.7, J16.1, J16.3, J16.7, J23.1, J24.6 (VSS), J24.10 (G1), J24.11 (G2), J24.12 (G3), J24.13 (G4), J28.1, J30.1, J32.2, J34.3, J35.1, J37.4 (GND), J37.7 (DRAIN), J37.10 (SHIELD), J40.4, J41.2, J43.3, Q1.2 (E), Q2.2 (E), Q3.2 (E), Q4.2 (E), Q5.2 (E), Q6.2 (E), Q9.2 (S), R6.2, R12.1, R24.1, R33.2, R38.1, R42.1, R48.2, R77.2, R79.2, R81.2, R83.2, R85.1, R87.1, R89.1, R91.1, R93.1, R105.2, R106.2, R129.1, R130.1, R133.1, R135.1, R138.2, R143.1, R144.2, R156.2, R162.2, R166.2, R169.2, R171.2, R176.2, R179.2, R206.1, R217.1, R218.1, R219.1, R220.1, R221.1, R222.1, R235.1, R252.1, R256.2, R266.1, S1.2, U2.3 (GND), U3.3 (GND), U5.19 (TESTEN), U5.57 (GND), U7.4 (GND), U10.1 (GND), U11.2 (GND), U14.2 (GND), U15.1 (GND), U16.GND, U16.P4 (GND), U16.P5 (GND), U16.P6 (GND), U16.P10 (GND), U16.P11 (GND), U16.P12 (GND), U16.S1 (GND), U16.S4 (GND), U16.S7 (GND), U17.7_1, U17.7_2, U17.7_3, U17.7_4, U17.8_1, U17.8_2, U17.8_3, U17.8_4, U18.7_1, U18.7_2, U18.8_1, U18.8_2, U20.2 (-), U22.6, U22.12, U22.56, U22.86, U22.113, U22.117, U22.130, U22.159, U22.167, U22.181, U23.41 (E_Pad), U24.2 (K), U25.2 (K), U26.2 (K), Y1.2, Y1.4, Y2.2, Y2.4, Y3.2 (GND), Y3.4 (GND), Y4.2, Y4.4
GNDPWR: C92.2, C93.2, U17.SHIELD, U18.SHIELD
IGN: J11.1, R149.1, R254.2
LED_VDD: FB1.2, U17.P1_R_Led+, U17.P2_R_Led+, U17.P3_R_Led+, U17.P4_R_Led+, U18.P1_R_Led+, U18.P2_R_Led+
LIND_DS_LED: IC3.37 (LDIND/DIS_LD), R10.1, R12.2
unnamed: C15.1, R13.2, Y1.1
unnamed: C35.1, C94.1, L9.1
unnamed: C70.1, R47.1, R55.1
unnamed: C78.1, R94.1, R95.1
unnamed: C79.1, R96.1, R97.1
unnamed: C80.1, R98.1, R99.1
unnamed: C81.1, R100.1, R101.1
unnamed: C85.1, R58.1, R59.1
unnamed: C86.1, R60.1, R61.1
unnamed: C87.1, R62.1, R63.1
unnamed: C88.1, R64.1, R65.1
unnamed: C89.1, R66.1, R67.1
unnamed: C90.1, R68.1, R69.1
unnamed: C91.1, R70.1, R71.1
unnamed: C93.1, R73.1, R74.1, R75.1, R76.1, R102.1, R103.1
unnamed: D3.C, R1.1
unnamed: D25.2 (A), R168.2
unnamed: D26.2 (A), K1.1 (COIL_1), Q4.3 (C)
unnamed: D27.2 (A), K3.1 (COIL_1), Q5.3 (C)
unnamed: D31.1, R250.1, R260.2
unnamed: IC2.29 (DAC_REF), R135.2
unnamed: IC2.16 (KEY0), R131.2
unnamed: IC2.17 (KEY1), R133.2
unnamed: IC2.12 (MCU_SEL), R129.2
unnamed: IC2.48 (REXT), R130.2
unnamed: C151.1, C152.1, IC2.25 (VMID)
unnamed: C149.1, C150.1, IC2.23 (VREF_H), R134.1
unnamed: C38.1, IC3.11 (DVDDL_1), R241.1
unnamed: IC3.54 (IBREF), R6.1
unnamed: C37.1, IC3.36 (RESETB), R8.2
unnamed: C178.1, IC5.1 (BS)
unnamed: IC5.4 (EN), R163.2, R164.1
unnamed: C179.1, IC5.3 (FB), R165.2, R166.1
unnamed: C178.2, IC5.6 (LX), L8.1
unnamed: D4.1, D28.2, J1.2, J7.2
unnamed: D12.1, FL1.3, J3.1, R30.2
unnamed: D6.1, FL1.2, J3.2, R31.2
unnamed: J5.4, J5.5, R5.2
unnamed: J8.38, R262.2
unnamed: C210.2, J8.47
unnamed: C211.2, J8.49
unnamed: C209.1, J8.50, R263.2
unnamed: J8.68, R177.2
unnamed: C35.2, J9.6
unnamed: C166.1, J10.1, L9.2
unnamed: J12.4, R269.1
unnamed: J12.8, R233.1
unnamed: J13.9, R258.1
unnamed: J13.10, R259.1
unnamed: J15.2, R147.2
unnamed: J15.4, R148.2
unnamed: J15.6, R149.2
unnamed: J15.8, R150.2
unnamed: J16.2, R151.2
unnamed: J16.4, R152.2
unnamed: J16.8, R153.2
unnamed: ED1.1, J24.9 (CD), R249.2
unnamed: ED6.1, J24.2 (CD/DAT3), R244.2
unnamed: ED4.1, J24.5 (CLK), R246.2
unnamed: ED5.1, J24.3 (CMD), R245.2
unnamed: ED3.1, J24.7 (DAT0), R247.2
unnamed: ED2.1, J24.8 (DAT1), R248.2
unnamed: ED7.1, J24.1 (DAT2), R243.2
unnamed: C206.1, C207.1, J24.4 (VDD), R242.1
unnamed: D24.2, J32.1, Q2.3 (C), R160.2, R173.2
unnamed: J43.1, R202.1
unnamed: J43.2, R203.1
unnamed: Q1.3 (C), R4.1
unnamed: Q2.1 (B), R159.2
unnamed: Q3.1 (B), R158.2
unnamed: D23.2, Q3.3 (C), R157.2
unnamed: Q4.1 (B), R170.2
unnamed: Q5.1 (B), R172.2
unnamed: Q6.1 (B), R26.2
unnamed: Q8.1 (G), Q9.3 (D), R253.1
unnamed: C208.2, D31.3, Q9.1 (G), R251.2, R252.2
unnamed: R72.2, U17.P1_R_Led-
unnamed: R77.1, U17.P1_L_Led-
unnamed: R78.1, U17.P2_R_Led-
unnamed: R79.1, U17.P2_L_Led-
unnamed: R80.1, U17.P3_R_Led-
unnamed: R81.1, U17.P3_L_Led-
unnamed: R82.1, U17.P4_R_Led-
unnamed: R83.1, U17.P4_L_Led-
unnamed: R104.1, U18.P1_R_Led-
unnamed: R105.1, U18.P1_L_Led-
unnamed: R106.1, U18.P2_L_Led-
unnamed: R107.1, U18.P2_R_Led-
unnamed: R200.2, S1.1
unnamed: R228.1, R233.2
unnamed: R264.1, R269.2
unnamed: R265.1, U16.P13 (VCC12), U16.P14 (VCC12), U16.P15 (VCC12)
unnamed: R15.2, U5.43 (ADC_AVDD)
unnamed: R240.1, U5.26 (RUN)
unnamed: C174.1, D24.1, R161.2, R162.1, U10.2 (FB)
unnamed: D11.1, L3.1, U10.3 (SW)
unnamed: C30.1, U10.4 (VC)
unnamed: R139.2, U14.3 (EN)
unnamed: C171.1, D23.1, R155.2, R156.1, U15.2 (FB)
unnamed: D10.1, L2.1, U15.3 (SW)
unnamed: C170.1, U15.4 (VC)
unnamed: D2.1, U17.4_1, U17.5_1
unnamed: D5.1, U17.4_2, U17.5_2
unnamed: D7.1, U17.4_3, U17.5_3
unnamed: D8.1, U17.4_4, U17.5_4
unnamed: D1.1, U18.4_1, U18.5_1
unnamed: D9.1, U18.4_2, U18.5_2
unnamed: R228.2, U24.1 (A)
unnamed: R237.2, U24.4 (C)
unnamed: R235.2, R238.1, U24.3 (E)
unnamed: R254.1, U25.1 (A)
unnamed: R255.2, U25.4 (C)
unnamed: R264.2, U26.1 (A)
unnamed: R267.2, U26.4 (C)
unnamed: R266.2, R268.1, U26.3 (E)
RX0_N: U12.16, U17.2_1
RX0_P: U12.17, U17.1_1
RX1_N: U12.14, U17.2_2
RX1_P: U12.15, U17.1_2
RX2_N: U13.16, U17.2_3
RX2_P: U13.17, U17.1_3
RX3_N: U13.14, U17.2_4
RX3_P: U13.15, U17.1_4
RX4_N: U18.2_1, U19.16
RX4_P: U18.1_1, U19.17
RX5_N: U18.2_2, U19.14
RX5_P: U18.1_2, U19.15
TX0_N: U12.19, U17.6_1
TX0_P: U12.20, U17.3_1
TX1_N: U12.11, U17.6_2
TX1_P: U12.12, U17.3_2
TX2_N: U13.19, U17.6_3
TX2_P: U13.20, U17.3_3
TX3_N: U13.11, U17.6_4
TX3_P: U13.12, U17.3_4
TX4_N: U18.6_1, U19.19
TX4_P: U18.3_1, U19.20
TX5_N: U18.6_2, U19.11
TX5_P: U18.3_2, U19.12
VCC_3V3_S0: C33.1, C34.1, C147.1, C148.1, C154.1, C156.1, C167.1, C168.1, IC2.6 (AVDD33), IC2.18 (DVDD33), IC2.28 (AVDD33_1), IC2.34 (AVDD33_2), IC2.42 (DVDD33_1), IC2.47 (AVDD33_3), L6.2, R132.1, R134.2, R136.2, R137.1, R139.1, R140.2, R141.2, TP12.1, U14.1 (IN)
VIN: C5.1, C28.1, C29.2, C30.2, C83.1, C169.2, C170.2, D28.1, D29.1, J4.1, J13.3, J13.7, K1.3 (NO), K3.3 (NO), R49.1, R150.1, U2.2 (IN), U3.2 (IN), U10.5 (VIN), U15.5 (VIN)
VRAW: D29.2, J11.3
XI: C39.1, IC3.52 (XI), Y4.1
XO: C61.1, IC3.51 (XO), Y4.3
