ihsanakyrk/Eski-Versionlar-Ve-Siparisler/[04.2025]/ST_Board_V1.0 (Nisan_2025)/ST_Board_V1.0/ST_Board_V1.0.kicad_pcb

## KiCad design [04.2025]/ST_Board_V1.0 (Nisan_2025)/ST_Board_V1.0/ST_Board_V1.0.kicad_pcb (2025-09-01)

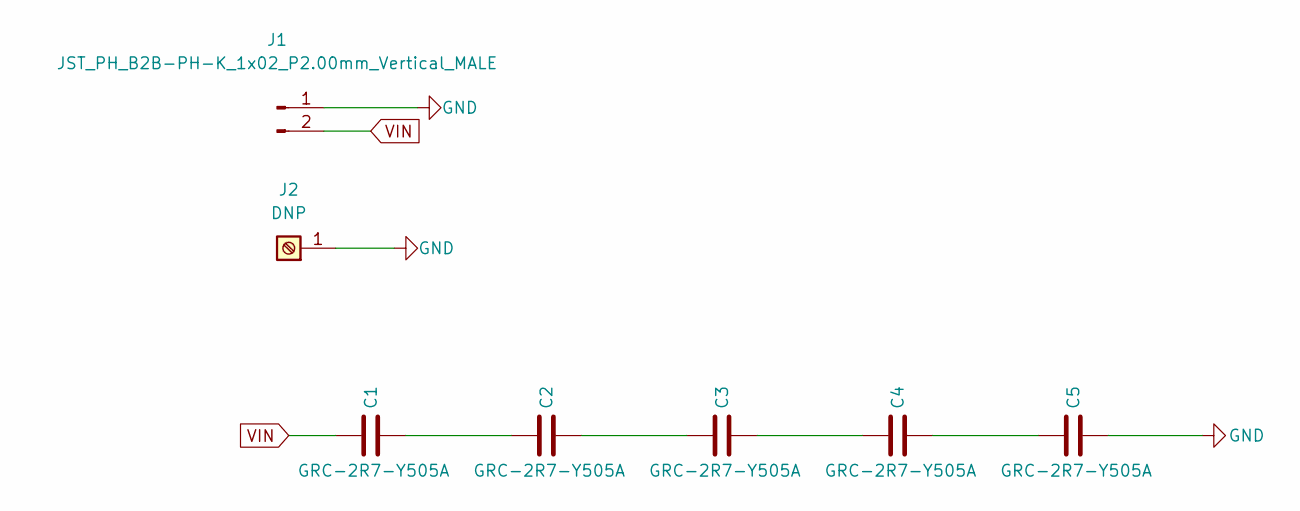
[picture p141: schematic ST_Board_V1.0.kicad_sch]

Parts:
C1, C2, C3, C4, C5: GRC-2R7-Y505A
J1: JST_PH_B2B-PH-K_1x02_P2.00mm_Vertical_MALE; JST_PH_B2B-PH-K_1x02_P2.00mm_Vertical
J2: DNP; Screw Terminal Shinbo

Connections:
GND: C5.2, J1.1, J2.1
unnamed: C1.2, C2.1
unnamed: C2.2, C3.1
unnamed: C3.2, C4.1
unnamed: C4.2, C5.1
VIN: C1.1, J1.2

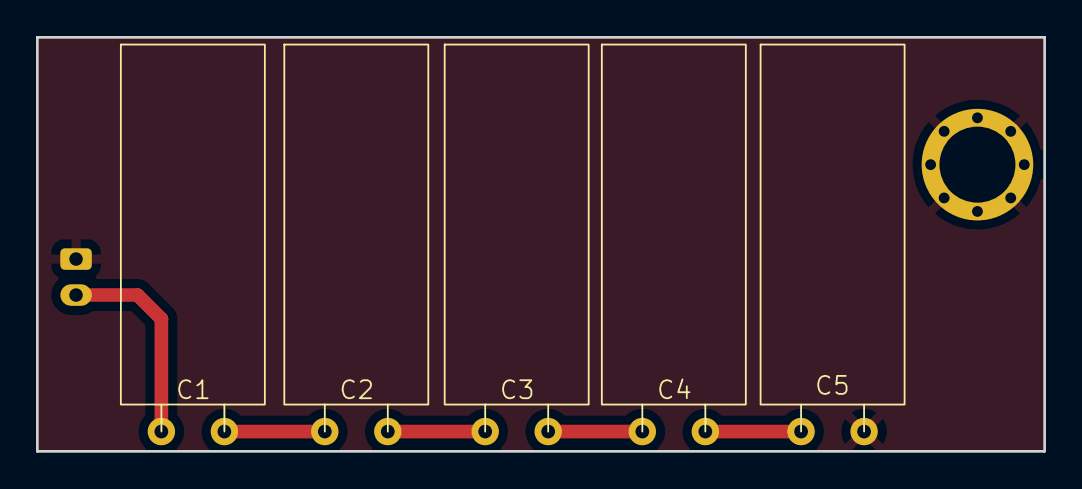
[picture p142: board ST_Board_V1.0.kicad_pcb from above]

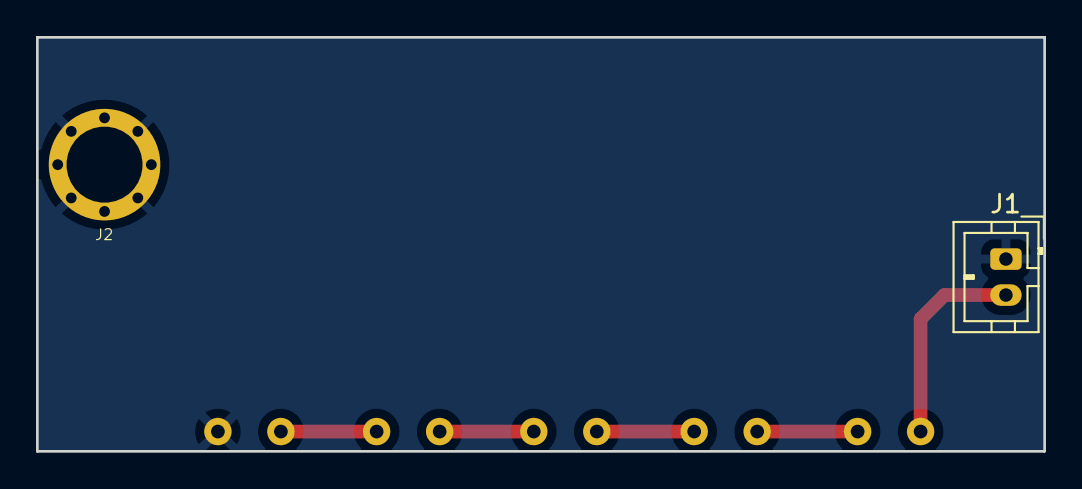
[picture p143: board ST_Board_V1.0.kicad_pcb from below]

Board: 2 copper layers, 56.0 x 23.0 mm, 7 parts (2 on the bottom side), 6 nets.
