ihsanakyrk/Eski-Versionlar-Ve-Siparisler/KSS_mindless_v3(Eski akılsız)/KSS/KSS.kicad_pcb

## KiCad design KSS_mindless_v3(Eski akılsız)/KSS/KSS.kicad_pcb (2025-09-01)

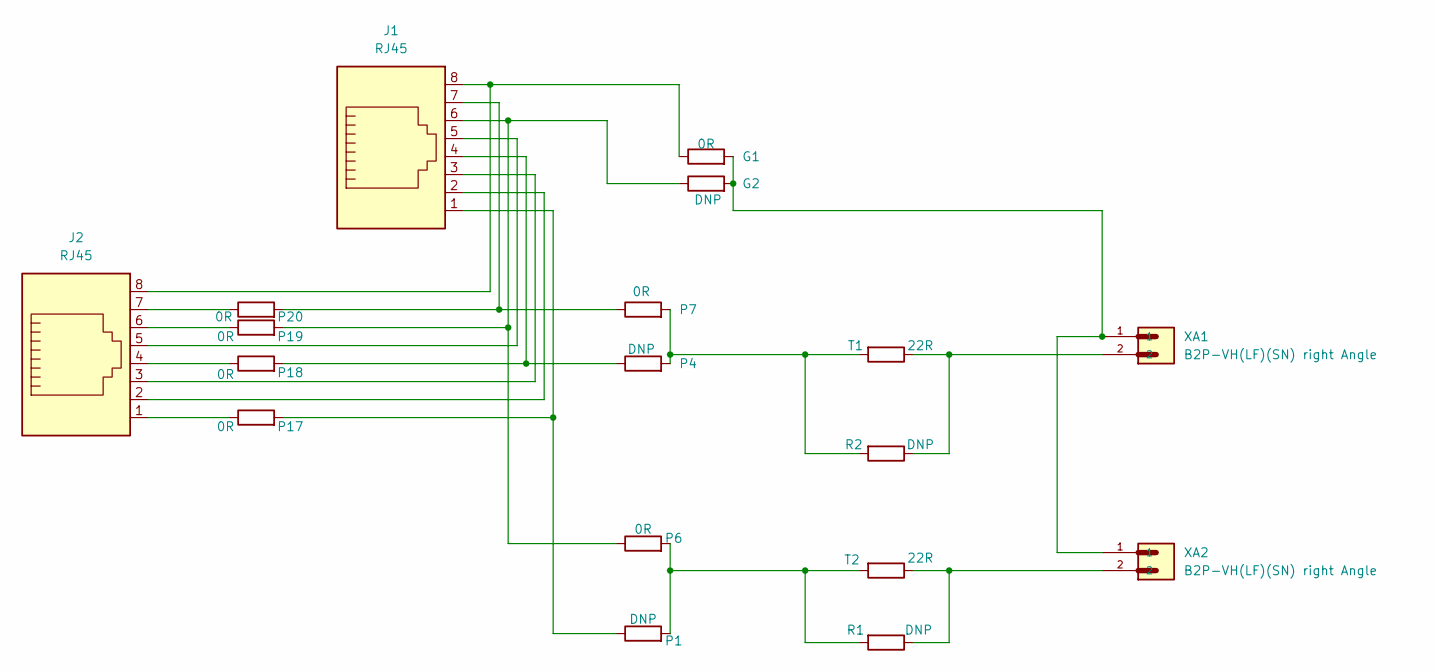
[picture p144: schematic KSS.kicad_sch]

Parts:
G1: 0R; R_0603_1608Metric
G2: DNP; R_0603_1608Metric
J1, J2: RJ45; RJ45_OST_PJ012-8P8CX_Vertical
P1, P4: DNP; R_0603_1608Metric
P6, P7: 0R; R_0603_1608Metric
P17, P18, P19, P20: 0R; R_0805_2012Metric
R1, R2: DNP; R_Box_L8.4mm_W2.5mm_P5.08mm
T1, T2: 22R; R_0603_1608Metric
XA1, XA2: B2P-VH(LF)(SN) right Angle; Hirose_DF63M-2P-3.96DSA_1x02_P3.96mm_Vertical

Connections:
unnamed: G1.1, J1.8, J2.8
unnamed: G1.2, G2.2, XA1.1, XA2.1
unnamed: G2.1, J1.6, P6.1, P19.2
unnamed: J1.1, P1.1, P17.2
unnamed: J1.2, J2.2
unnamed: J1.3, J2.3
unnamed: J1.4, P4.1, P18.2
unnamed: J1.5, J2.5
unnamed: J1.7, P7.1, P20.2
unnamed: J2.1, P17.1
unnamed: J2.4, P18.1
unnamed: J2.6, P19.1
unnamed: J2.7, P20.1
unnamed: P1.2, P6.2, R1.2, T2.2
unnamed: P4.2, P7.2, R2.2, T1.2
unnamed: R1.1, T2.1, XA2.2
unnamed: R2.1, T1.1, XA1.2

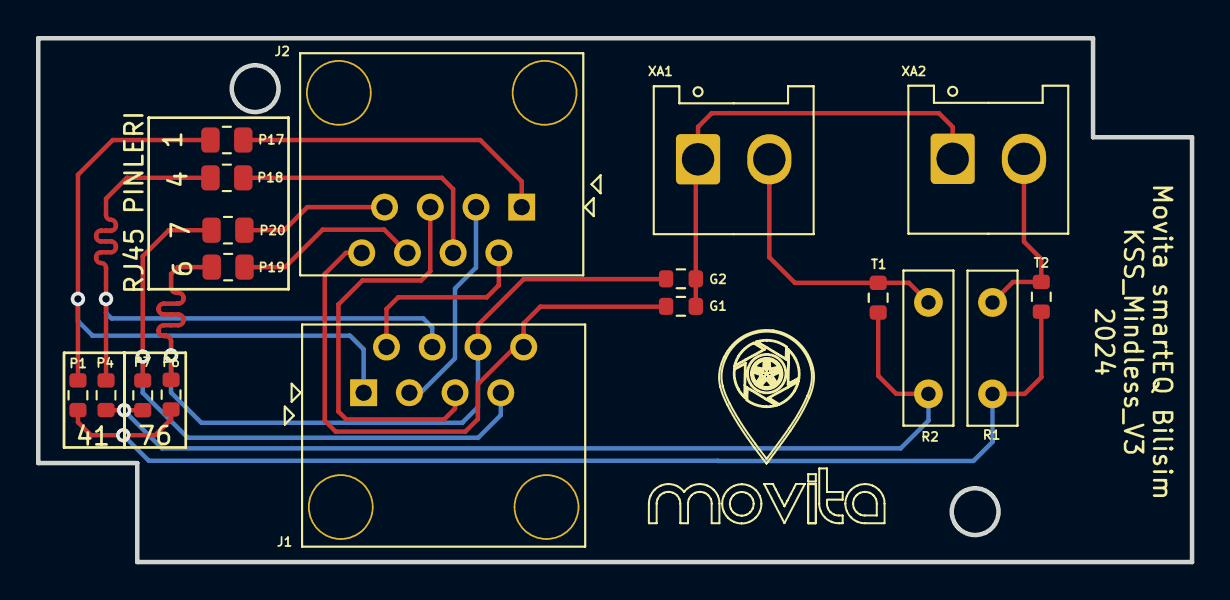
[picture p145: board KSS.kicad_pcb from above]

Board: 2 copper layers, 64.1 x 29.1 mm, 18 parts (0 on the bottom side), 17 nets.
