ihsanakyrk/Eski-Versionlar-Ve-Siparisler/[04.2025]/Movita_IO-Expansion_Board_V2.0(Nisan_2025)/Movita_IO_Expansion_Board_V2.0/Movita_IO_Expansion_Board_V2.0.kicad_pcb

## KiCad design [04.2025]/Movita_IO-Expansion_Board_V2.0(Nisan_2025)/Movita_IO_Expansion_Board_V2.0/Movita_IO_Expansion_Board_V2.0.kicad_pcb (2025-09-01)

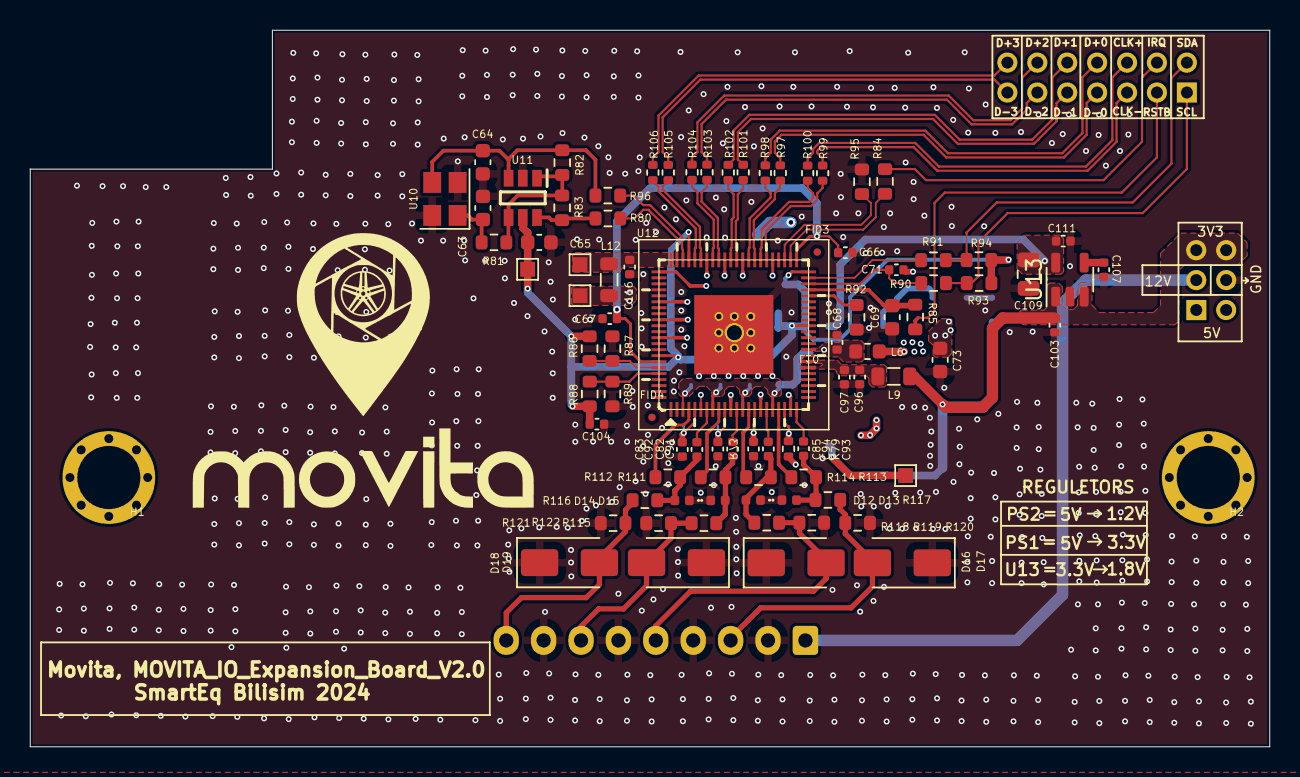
[picture p146: board Movita_IO_Expansion_Board_V2.0.kicad_pcb from above]

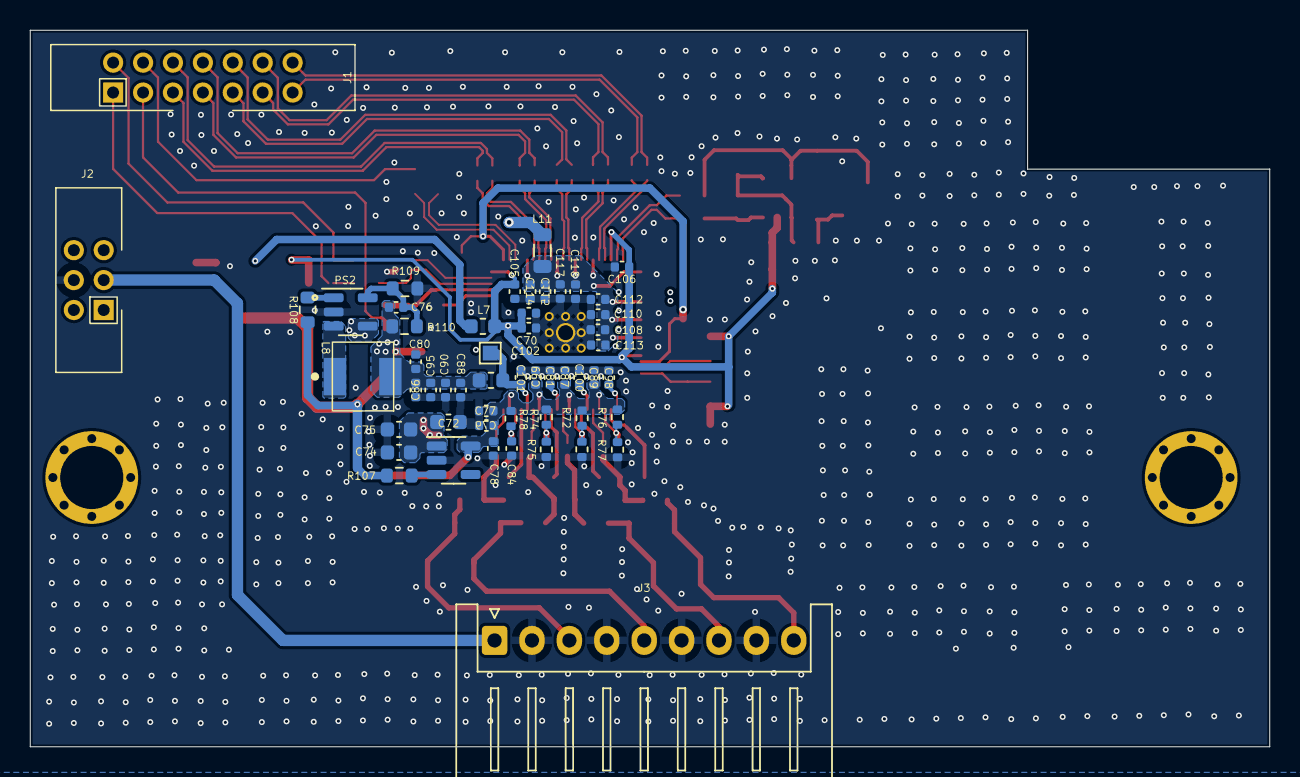
[picture p147: board Movita_IO_Expansion_Board_V2.0.kicad_pcb from below]

Board: 4 copper layers, 82.9 x 47.9 mm, 140 parts (53 on the bottom side), 76 nets.

Parts:
C63, C64: 8pF; C_0603_1608Metric
C65: 1uF; C_0603_1608Metric
C66, C67, C68, C70, C79, C81, C82, C83, C84, C85, C87, C89, C90, C91, C92, C93, C94, C95, C96, C98, C99, C100, C101, C102, C103, C104, C105, C106, C107, C108, C110, C111, C112, C113, C114, C115, C116, C117, C118: 100nF; C_0402_1005Metric
C69: 1nF; C_0603_1608Metric
C71: 56pF; C_0402_1005Metric
C72, C73: 10uF; C_0603_1608Metric
C74, C75: 100nF; C_0603_1608Metric
C76: 100pF; C_0402_1005Metric
C77, C80, C86: 10uF; C_0402_1005Metric
C78, C88, C97: 4.7uF; C_0402_1005Metric
C109: 10uF; C_0805_2012Metric
D12, D13, D14, D15: EZJ-Z0V800AA; D_0402_1005Metric
D16, D17, D18, D19: SMAJ30CA; D_SMA
FID3, FID4: Fiducial; Fiducial_0.5mm_Mask1mm
H1, H2: M3x*0.5 L=6; Screw Terminal Shinbo
J1: Conn_01x14_Pin; Analog signal connector
J2: Conn_01x06_Pin; Analog power connector
J3: :JST_XH_S9B-XH-A_1x09_P2.50mm_MALE_Horizontal; JST_XH_S9B-XH-A_1x09_P2.50mm_Horizontal
L6, L7: 742792651; L_0603_1608Metric
L8: YSPI0420-1R0M; HCM0420-1R0M
L9, L11, L12: YI201209U101-3R0T; L_0805_2012Metric
L10: CBW160808U101T; L_0603_1608Metric
PS1: RT9013-33GB; SOT-23-5
PS2: ETA3448S2F; SOT-23-5
R72, R74, R76, R78: 1M; R_0402_1005Metric
R73, R75, R77, R79: 510K; R_0402_1005Metric
R80, R81, R90, R91: 100R; R_0603_1608Metric
R82: 560K; R_0603_1608Metric
R83, R87, R89, R96: DNP; R_0603_1608Metric
R84, R85, R95: 0R; R_0603_1608Metric
R86, R88: 4.7K; R_0603_1608Metric
R92, R115, R116, R117, R118: 22R; R_0603_1608Metric
R93, R94: 2K; R_0603_1608Metric
R97, R98, R99, R100, R101, R102, R103, R104, R105, R106: 22R; R_0402_1005Metric
R107, R108: 10K; R_0603_1608Metric
R109, R110: 150K; R_0603_1608Metric
R111, R112, R113, R114: 47R; R_0603_1608Metric
R119, R120, R121, R122: 75R; R_0603_1608Metric
TP13, TP14, TP15, TP16, TP17: DNP; TestPoint_Pad_1.0x1.0mm
U10: CF4027M00010; Crystal_SMD_3225-4Pin_3.2x2.5mm
U11: NL27WZU04DTT1G
U12: TP2815; EPQFN_88L_10X10
U13: TP5108E23E-18; SOT-23-5

Connections:
/CSI_AHD/+3.3V: C103.1, J2.5, J2.6, L9.1, R107.1, R108.1, U13.1 (IN), U13.3 (EN)
/CSI_AHD/+5V: C72.1, C73.1, C74.1, C75.1, J2.1, J2.2, PS1.1 (VIN), PS2.4 (IN)
/CSI_AHD/CK1_N: R99.2, U12.50 (CKN_1)
/CSI_AHD/CK1_P: R100.2, U12.51 (CKP_1)
/CSI_AHD/D01_N: R97.2, U12.52 (D0N_1)
/CSI_AHD/D01_P: R98.2, U12.53 (D0P_1)
/CSI_AHD/D11_N: R101.2, U12.55 (D1N_1)
/CSI_AHD/D11_P: R102.2, U12.56 (D1P_1)
/CSI_AHD/D21_N: R103.2, U12.58 (D2N_1)
/CSI_AHD/D21_P: R104.2, U12.59 (D2P_1)
/CSI_AHD/D31_N: R105.2, U12.61 (D3N_1)
/CSI_AHD/D31_P: R106.2, U12.62 (D3P_1)
/CSI_AHD/DVDD: C66.2, C67.2, C68.2, L6.2, U12.31 (DVDD1), U12.45 (DVDD3), U12.82 (DVDD2)
/CSI_AHD/LX: L8.1, PS2.3 (LX)
/CSI_AHD/TP2855_CLK+: J1.6, R100.1
/CSI_AHD/TP2855_CLK-: J1.5, R99.1
/CSI_AHD/TP2855_D+0: J1.8, R98.1
/CSI_AHD/TP2855_D+1: J1.10, R102.1
/CSI_AHD/TP2855_D+2: J1.12, R104.1
/CSI_AHD/TP2855_D+3: J1.14, R106.1
/CSI_AHD/TP2855_D-0: J1.7, R97.1
/CSI_AHD/TP2855_D-1: J1.9, R101.1
/CSI_AHD/TP2855_D-2: J1.11, R103.1
/CSI_AHD/TP2855_D-3: J1.13, R105.1
/CSI_AHD/TP2855_IIC_ADDR0: R86.1, R87.2, U12.83 (SAD0)
/CSI_AHD/TP2855_IIC_ADDR1: R88.1, R89.2, U12.84 (SAD1)
/CSI_AHD/TP2855_IRQ: J1.4, R84.1
/CSI_AHD/TP2855_OSC_CLK_IN: R80.1, U12.65 (XTI)
/CSI_AHD/TP2855_OSC_CLK_OUT: R96.2, U12.64 (XTO)
/CSI_AHD/TP2855_PTZ1: R112.2, U12.4 (PTZ1)
/CSI_AHD/TP2855_PTZ2: R111.2, U12.9 (PTZ2)
/CSI_AHD/TP2855_PTZ3: R114.2, U12.14 (PTZ3)
/CSI_AHD/TP2855_PTZ4: R113.2, U12.19 (PTZ4)
/CSI_AHD/TP2855_RSTB: J1.3, R85.1
/CSI_AHD/TP2855_SCL: J1.1, R90.1, R93.2
/CSI_AHD/TP2855_SDA: J1.2, R91.1, R94.2
/CSI_AHD/TP2855_TEST_MODE: R95.2, U12.47 (TEST)
/CSI_AHD/TP2855_VIN1N: C83.1, R76.1, R77.2, U12.5 (VIN1N)
/CSI_AHD/TP2855_VIN1P: C92.1, U12.7 (VIN1)
/CSI_AHD/TP2855_VIN2N: C82.1, R72.1, R73.2, U12.10 (VIN2N)
/CSI_AHD/TP2855_VIN2P: C91.1, U12.12 (VIN2)
/CSI_AHD/TP2855_VIN3N: C85.1, R74.1, R75.2, U12.15 (VIN3N)
/CSI_AHD/TP2855_VIN3P: C94.1, U12.17 (VIN3)
/CSI_AHD/TP2855_VIN4N: C84.1, R78.1, R79.2, U12.20 (VIN4N)
/CSI_AHD/TP2855_VIN4P: C93.1, U12.22 (VIN4)
/CSI_AHD/TP2855_XOUT: C64.2, R82.2, R96.1, U10.3 (XOUT), U11.3 (INA2)
/CSI_AHD/VBUS: J2.3, J3.1
Earth: C63.1, C64.1, C65.2, C66.1, C67.1, C68.1, C69.1, C70.2, C71.1, C72.2, C73.2, C74.2, C75.2, C77.2, C78.2, C79.2, C80.2, C81.2, C82.2, C83.2, C84.2, C85.2, C86.2, C87.2, C88.2, C89.2, C90.2, C95.2, C96.2, C97.2, C98.2, C99.2, C100.2, C101.2, C102.2, C103.2, C104.2, C105.2, C106.2, C107.2, C108.2, C109.2, C110.2, C111.2, C112.2, C113.2, C114.2, C115.2, C116.2, C117.2, C118.2, D12.1 (A1), D13.1 (A1), D14.1 (A1), D15.1 (A1), D16.1 (A1), D17.1 (A1), D18.1 (A1), D19.1 (A1), J2.4, J3.2, J3.4, J3.6, J3.8, PS1.2 (GND), PS2.2 (GND), R73.1, R75.1, R77.1, R79.1, R87.1, R89.1, R92.1, R95.1, R109.1, R119.2, R120.2, R121.2, R122.2, U10.2 (GND2), U10.4 (GND1), U11.2 (GND), U12.89 (EPAD), U13.2 (GND)
unnamed: C94.2, D12.2 (A2), R114.1, R118.2
unnamed: C93.2, D13.2 (A2), R113.1, R117.2
unnamed: C92.2, D14.2 (A2), R112.1, R116.2
unnamed: C91.2, D15.2 (A2), R111.1, R115.2
unnamed: D16.2 (A2), J3.5, R118.1, R119.1
unnamed: D17.2 (A2), J3.3, R117.1, R120.1
unnamed: D18.2 (A2), J3.9, R116.1, R121.1
unnamed: D19.2 (A2), J3.7, R115.1, R122.1
unnamed: PS1.3 (EN), R107.2
unnamed: PS2.1 (EN), R108.2
unnamed: C76.2, PS2.5 (OUT), R109.2, R110.1
unnamed: C63.2, R81.1, U10.1 (XIN)
unnamed: R81.2, R82.1, R83.2, U11.1 (INA1), U11.4 (OUT*Y2)
unnamed: R80.2, R83.1, U11.6 (OUT*Y1)
unnamed: R92.2, U12.40 (ALINKI)
unnamed: R84.2, U12.46 (IRQ)
unnamed: C69.2, R85.2, U12.41 (RSTB)
unnamed: C71.2, R90.2, U12.42 (SCL)
unnamed: R91.2, U12.43 (SDA)
unnamed: C107.1, U13.4 (BP)
TP2855_AVDD1V2: C98.1, C99.1, C100.1, C101.1, L10.2, TP15.1, U12.3 (AVDD1_1), U12.8 (AVDD1_2), U12.13 (AVDD1_3), U12.18 (AVDD1_4)
TP2855_AVDD3V3: C77.1, C78.1, C79.1, C81.1, C87.1, C89.1, PS1.5 (VOUT), R72.2, R74.2, R76.2, R78.2, TP13.1, U12.6 (AVDD3_1), U12.11 (AVDD3_2), U12.16 (AVDD3_3), U12.21 (AVDD3_4)
TP2855_AVDDPLL_1V2: C116.1, L12.2, TP17.1, U12.66 (VDDPPL)
TP2855_CODEC_V3V3: C96.1, C97.1, L9.2, U12.28 (AADVDD), U12.29 (ADAVDD)
TP2855_DVDD1V2: C108.1, C110.1, C112.1, C113.1, C114.1, C115.1, C117.1, C118.1, L11.2, U12.49 (VDDM2_1), U12.54 (VDDM1_1), U12.57 (VDDM3_1), U12.60 (VDDM4_1), U12.67 (VDDM1_2), U12.72 (VDDM4_2), U12.75 (VDDM2_2), U12.78 (VDDM3_2)
TP2855_VCCIO: C65.1, C70.1, C102.1, C104.1, C105.1, C106.1, L7.2, R86.2, R88.2, R93.1, R94.1, TP16.1, U11.5 (VCC), U12.35 (VDD_IO3), U12.44 (VDD_IO1), U12.63 (VDD_IO2), U12.81 (VDD_IO4)
VDDIO_18: C109.1, C111.1, L7.1, U13.5 (OUT)
VDD_1V2: C76.1, C80.1, C86.1, C88.1, C90.1, C95.1, L6.1, L8.2, L10.1, L11.1, L12.1, R110.2, TP14.1
