ihsanakyrk/Eski-Versionlar-Ve-Siparisler/[11.2023]/HDMI 2.0 TX_V1.0_(Kasım_2023)/HDMI 2.0 TX_V1.0/HDMI 2.0 TX.kicad_pcb

## KiCad design [11.2023]/HDMI 2.0 TX_V1.0_(Kasım_2023)/HDMI 2.0 TX_V1.0/HDMI 2.0 TX.kicad_pcb (2025-09-01)

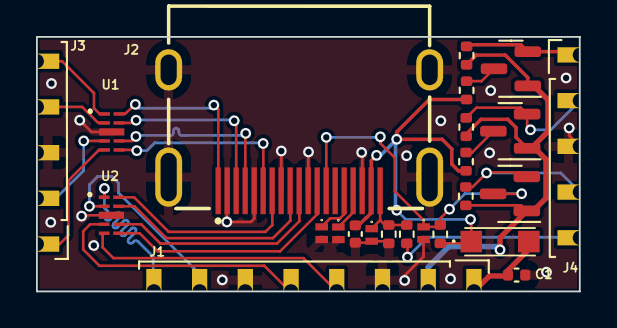
[picture p148: board HDMI 2.0 TX.kicad_pcb from above]

Board: 2 copper layers, 30.2 x 14.1 mm, 24 parts (0 on the bottom side), 30 nets.

Parts:
C1: 22uF; C_0402_1005Metric
C2: 0.1uF; C_0402_1005Metric
D1: B5819W
ED1, ED2, ED3, ED4: ED5451N; ESD5451N
J1: Conn_01x08_Socket; castelled 8
J2: SHOU HAN HDMI 19 PIN 043; HDMI 19PIN
J3, J4: Conn_01x05_Socket; Castelled 5
Q1, Q2, Q3: BSS138; SOT-23
R1, R2: 10K; R_0402_1005Metric
R3: 27K; R_0402_1005Metric
R4: 1K %5; R_0402_1005Metric
R5, R6, R7: 1.8K; R_0402_1005Metric
R8: 100K; R_0402_1005Metric
U1, U2: ESD5344D

Connections:
+3V3: J1.2, Q1.1 (G), Q2.1 (G), Q3.1 (G), R1.1, R2.1, R3.1
/HDMI 2.0 /HDMITXDDC_SCL_PORT: Q2.3 (D), R6.2
/HDMI 2.0 /HDMITXDDC_SDA_PORT: Q1.3 (D), R5.2
/HDMI 2.0 /HDMITX_CEC_M0: J4.4, Q3.2 (S), R3.2
/HDMI 2.0 /HDMITX_SCL: J4.1, Q2.2 (S), R2.2
/HDMI 2.0 /HDMITX_SDA: J4.2, Q1.2 (S), R1.2
/HDMI 2.0 /HDMI_TX0N_PORT: J1.7, U2.2 (IO2)
/HDMI 2.0 /HDMI_TX0P_PORT: J1.8, U2.1 (IO1)
/HDMI 2.0 /HDMI_TX1N_PORT: J3.1, U1.5 (IO4)
/HDMI 2.0 /HDMI_TX1P_PORT: J3.2, U1.4 (IO3)
/HDMI 2.0 /HDMI_TX2N_PORT: J3.4, U1.2 (IO2)
/HDMI 2.0 /HDMI_TX2P_PORT: J3.5, U1.1 (IO1)
/HDMI 2.0 /HDMI_TXCLKN_PORT: J1.4, U2.5 (IO4)
/HDMI 2.0 /HDMI_TXCLKP_PORT: J1.5, U2.4 (IO3)
/HDMI 2.0 /HDMI_TXDDC_SCL_PORT: ED2.1, J2.15 (SCL)
/HDMI 2.0 /HDMI_TXDDC_SDA_PORT: ED3.1, J2.16 (SDA)
/HDMI 2.0 /HDMI_TX_CEC_PORT: ED1.1, J2.13 (CEC), Q3.3 (D), R7.2
/HDMI 2.0 /HDMI_TX_HPDIN: J4.5, R4.1
/HDMI 2.0 /HDMI_TX_HPD_PORT: ED4.1, J2.19 (HPD), R4.2, R8.2
GND: C1.2, C2.2, ED1.2, ED2.2, ED3.2, ED4.2, J1.3, J1.6, J2.2 (D2S), J2.5 (D1S), J2.8 (D0S), J2.11 (CKS), J2.17 (GND), J2.SH, J3.3, J4.3, R8.1, U1.3 (GND), U2.3 (GND)
unnamed: J2.10 (CK+), U2.7 (NC_07)
unnamed: J2.12 (CK-), U2.6 (NC_6)
unnamed: J2.7 (D0+), U2.10 (NC_10)
unnamed: J2.9 (D0-), U2.9 (NC_9)
unnamed: J2.4 (D1+), U1.7 (NC_07)
unnamed: J2.6 (D1-), U1.6 (NC_6)
unnamed: J2.1 (D2+), U1.10 (NC_10)
unnamed: J2.3 (D2-), U1.9 (NC_9)
VCC5V__HDMI_TX: C2.1, D1.1 (K), J2.18 (+5V), R5.1, R6.1, R7.1
VDD_5V: C1.1, D1.2 (A), J1.1
