ihsanakyrk/Eski-Versionlar-Ve-Siparisler/[11.2023]/A7602E-H(GSM)_V1.0_(Kasım_2023)/A7602E-H (GSM)_V1.0/Movita Pro V2_1.kicad_pcb

## KiCad design [11.2023]/A7602E-H(GSM)_V1.0_(Kasım_2023)/A7602E-H (GSM)_V1.0/Movita Pro V2_1.kicad_pcb (2025-09-01)

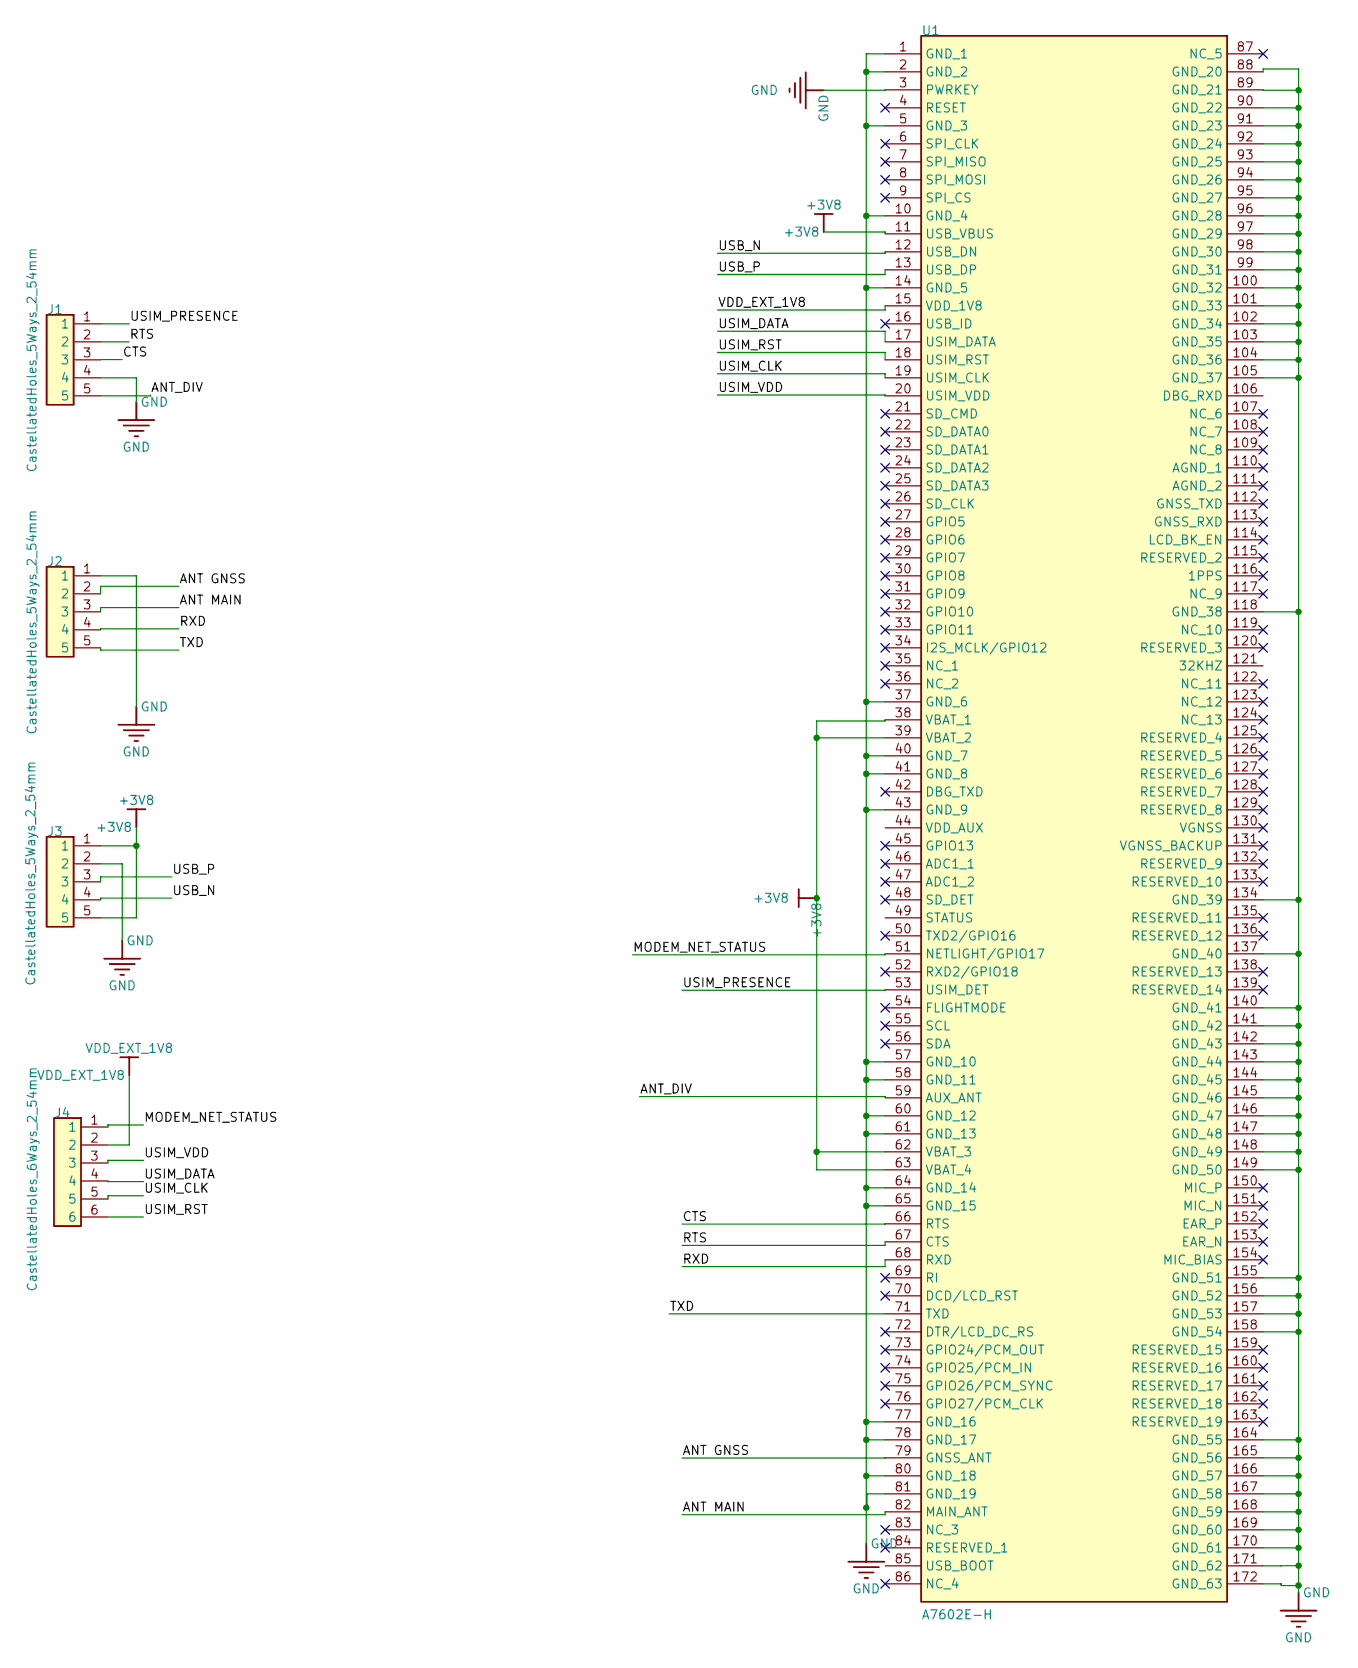
[picture p149: schematic Movita Pro V2_1.kicad_sch]

Parts:
J1, J2, J3: CastellatedHoles_5Ways_2_54mm; Castelled Pin Header 1x5 Ways 2.54
J4: CastellatedHoles_6Ways_2_54mm; Castelled Pin Header 1x6 Ways 2.54
U1: A7602E-H; A7602EH; MANUFACTURER_PART_NUMBER A7602E-H; MOUSER PART NUMBER *

Connections:
+3V8: J3.1, J3.5, U1.11 (USB_VBUS), U1.38 (VBAT_1), U1.39 (VBAT_2), U1.62 (VBAT_3), U1.63 (VBAT_4)
/ANT GNSS: J2.2, U1.79 (GNSS_ANT)
/ANT MAIN: J2.3, U1.82 (MAIN_ANT)
/ANT_DIV: J1.5, U1.59 (AUX_ANT)
/CTS: J1.3, U1.66 (RTS)
/MODEM_NET_STATUS: J4.1, U1.51 (NETLIGHT/GPIO17)
/RTS: J1.2, U1.67 (CTS)
/RXD: J2.4, U1.68 (RXD)
/TXD: J2.5, U1.71 (TXD)
/USB_N: J3.4, U1.12 (USB_DN)
/USB_P: J3.3, U1.13 (USB_DP)
/USIM_CLK: J4.5, U1.19 (USIM_CLK)
/USIM_DATA: J4.4, U1.17 (USIM_DATA)
/USIM_PRESENCE: J1.1, U1.53 (USIM_DET)
/USIM_RST: J4.6, U1.18 (USIM_RST)
/USIM_VDD: J4.3, U1.20 (USIM_VDD)
GND: J1.4, J2.1, J3.2, U1.1 (GND_1), U1.2 (GND_2), U1.3 (PWRKEY), U1.5 (GND_3), U1.10 (GND_4), U1.14 (GND_5), U1.37 (GND_6), U1.40 (GND_7), U1.41 (GND_8), U1.43 (GND_9), U1.57 (GND_10), U1.58 (GND_11), U1.60 (GND_12), U1.61 (GND_13), U1.64 (GND_14), U1.65 (GND_15), U1.77 (GND_16), U1.78 (GND_17), U1.80 (GND_18), U1.81 (GND_19), U1.88 (GND_20), U1.89 (GND_21), U1.90 (GND_22), U1.91 (GND_23), U1.92 (GND_24), U1.93 (GND_25), U1.94 (GND_26), U1.95 (GND_27), U1.96 (GND_28), U1.97 (GND_29), U1.98 (GND_30), U1.99 (GND_31), U1.100 (GND_32), U1.101 (GND_33), U1.102 (GND_34), U1.103 (GND_35), U1.104 (GND_36), U1.105 (GND_37), U1.118 (GND_38), U1.134 (GND_39), U1.137 (GND_40), U1.140 (GND_41), U1.141 (GND_42), U1.142 (GND_43), U1.143 (GND_44), U1.144 (GND_45), U1.145 (GND_46), U1.146 (GND_47), U1.147 (GND_48), U1.148 (GND_49), U1.149 (GND_50), U1.155 (GND_51), U1.156 (GND_52), U1.157 (GND_53), U1.158 (GND_54), U1.164 (GND_55), U1.165 (GND_56), U1.166 (GND_57), U1.167 (GND_58), U1.168 (GND_59), U1.169 (GND_60), U1.170 (GND_61), U1.171 (GND_62), U1.172 (GND_63)
VDD_EXT_1V8: J4.2, U1.15 (VDD_1V8)

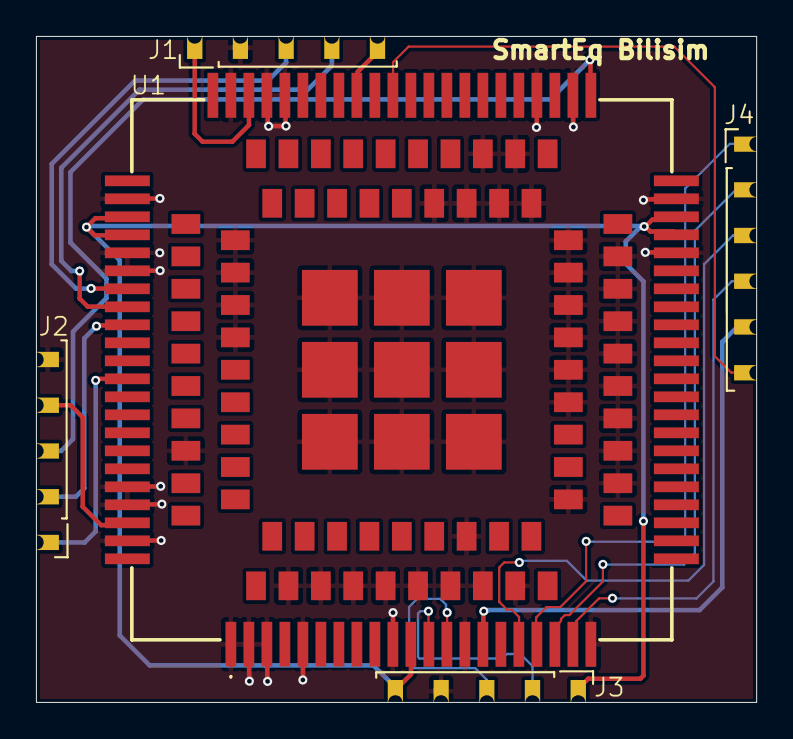
[picture p150: board Movita Pro V2_1.kicad_pcb from above]

Board: 2 copper layers, 40.0 x 37.0 mm, 5 parts (0 on the bottom side), 18 nets.
