ihsanakyrk/Eski-Versionlar-Ve-Siparisler/Movita_3566_HXV_Router_V4.0/4_port_rj45.kicad_sch

## KiCad design Movita_3566_HXV_Router_V4.0/4_port_rj45.kicad_sch (2025-09-01)

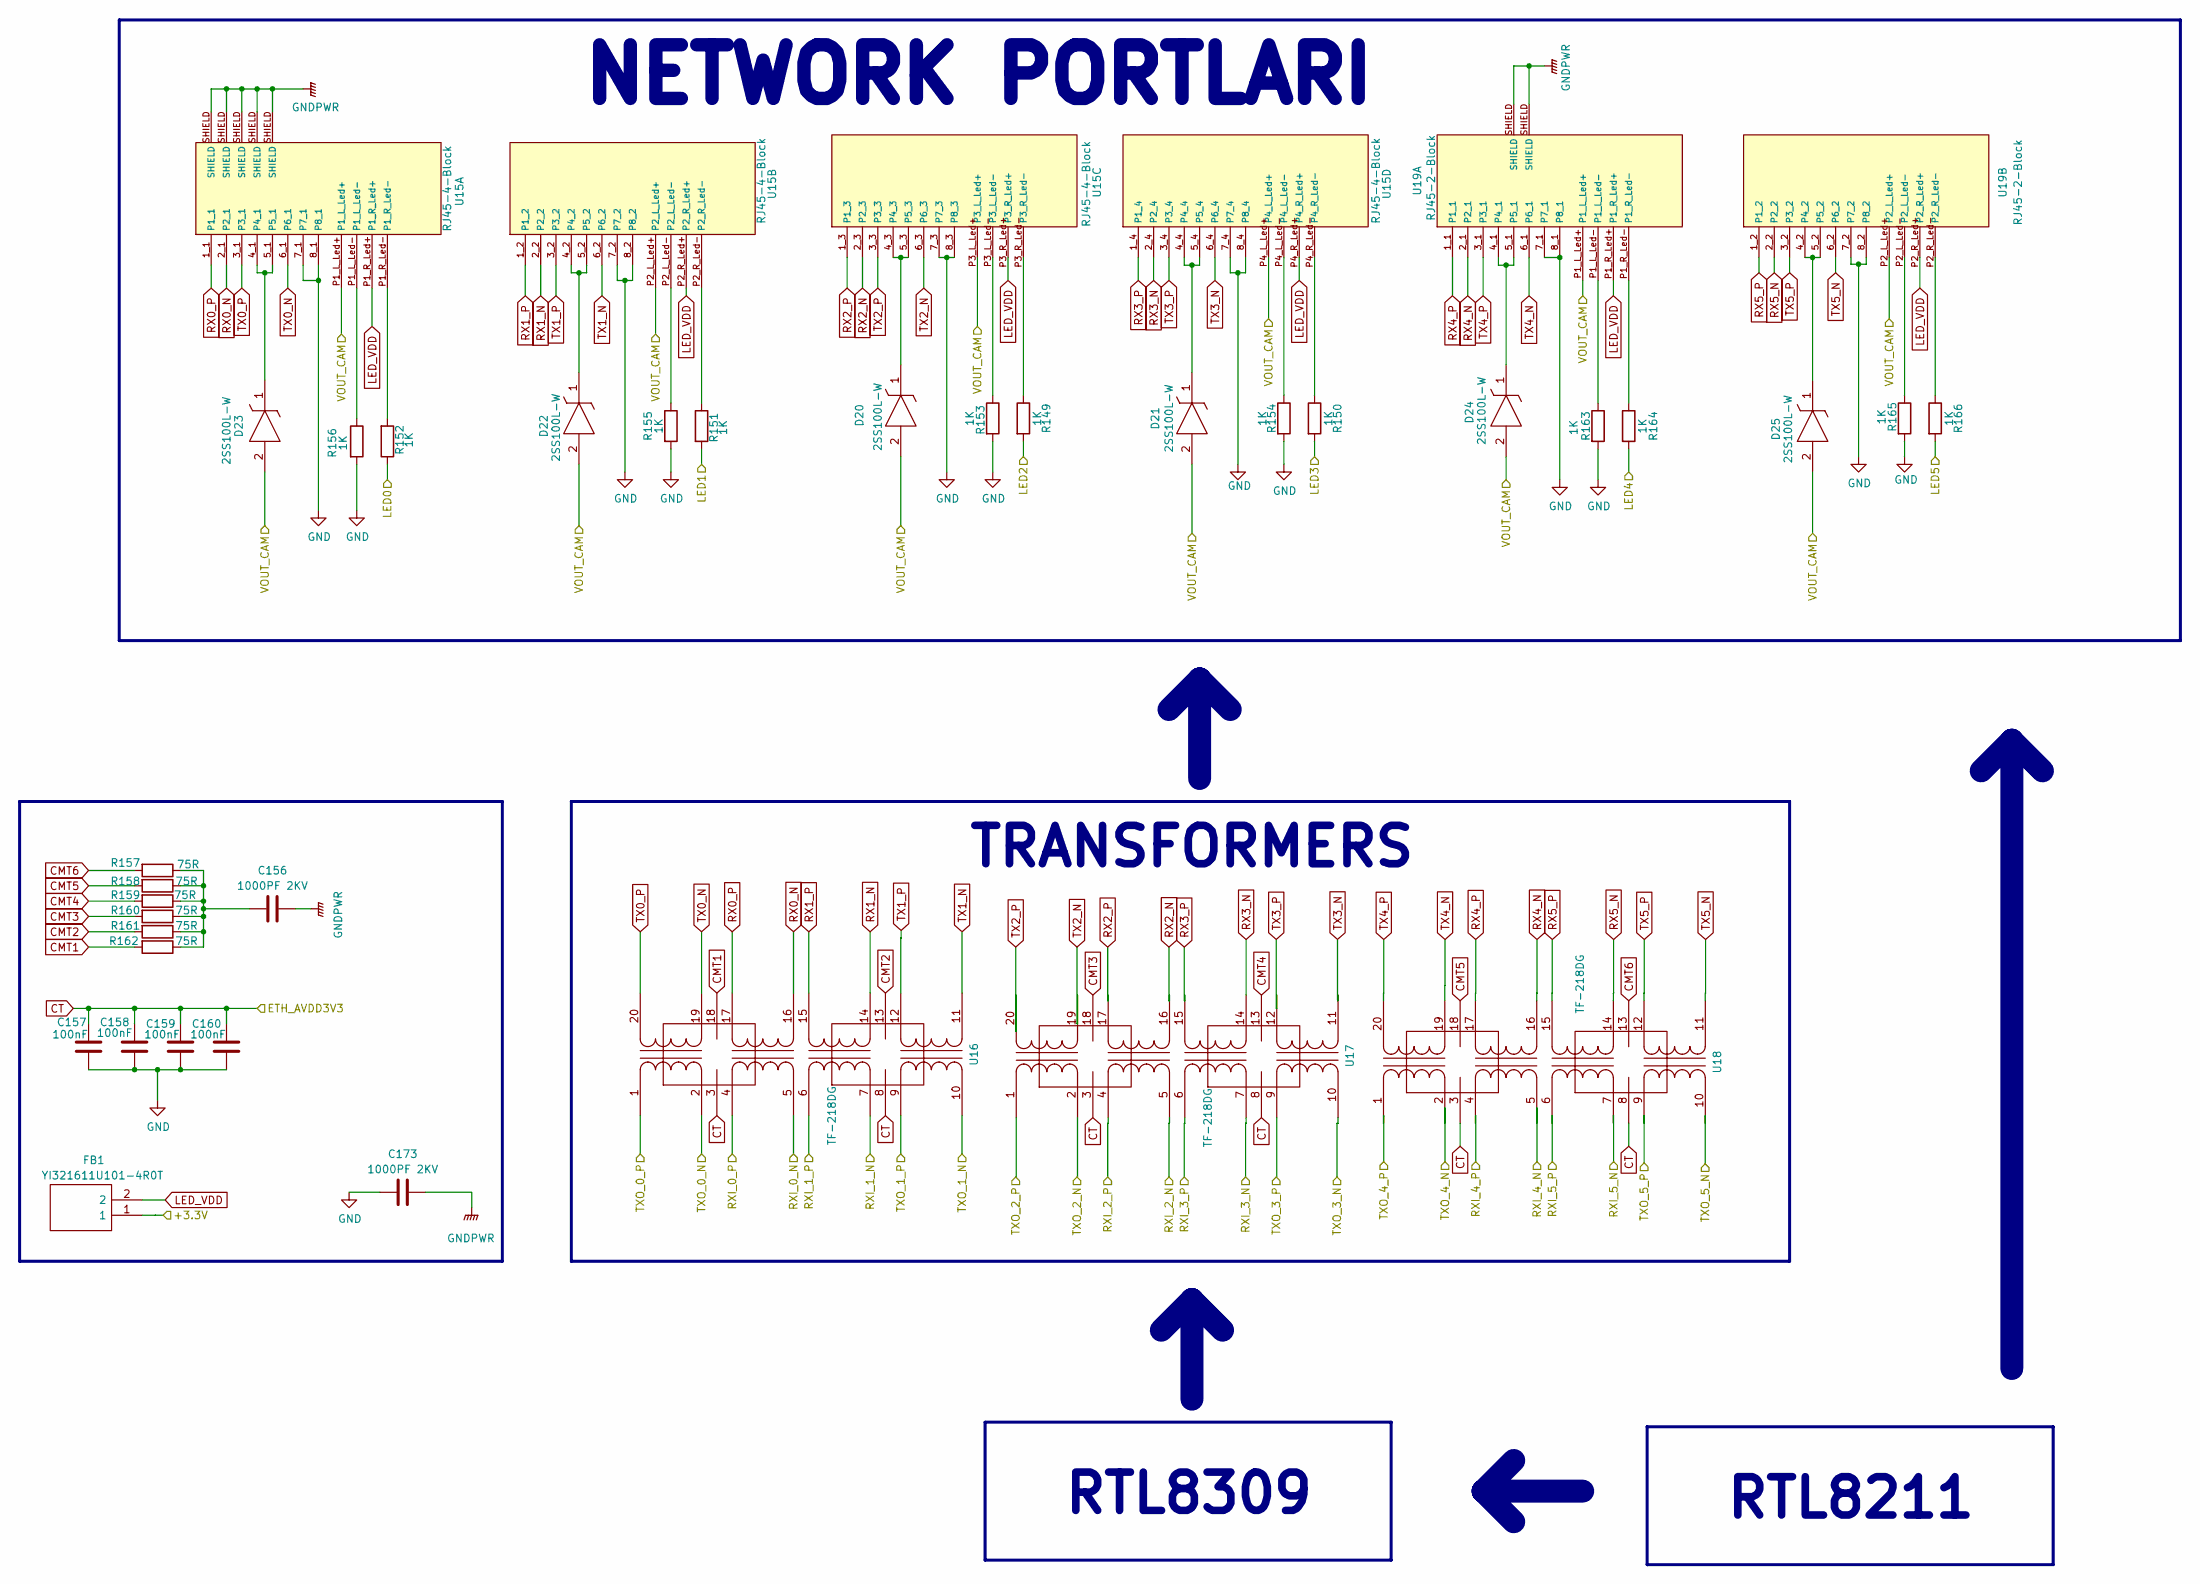
[picture p151: schematic 4_port_rj45.kicad_sch]

Parts:
C156, C173: 1000PF 2KV; S102K33Y5PP63K5R; MPN Y5P102K2KV16CC0224
C157, C158, C159, C160: 100nF; C_0402_1005Metric; MPN CC0402KRX7R7BB104
D20, D21, D22, D23, D24, D25: 2SS100L-W; 2SS100LW; Manufacturer_Part_Number 2SS100L-W; Mouser Part Number 583-2SS100L-W
FB1: YI321611U101-4R0T; BEADC3216X130N; Manufacturer_Part_Number HI1206N101R-10; Mouser Part Number N/A
R149, R150, R151, R152, R153, R154, R155, R156, R163, R164, R165, R166: 1K; R_0603_1608Metric; MPN 0603WAF1001T5E
R157, R158, R159, R160, R161, R162: 75R; R_0603_1608Metric; MPN 0603WAF750JT5E
U15: RJ45-4-Block; 4_Block_RJ45; MPN RJ45 56 1*4 带灯
U16, U17, U18: TF-218DG; RJ45_Transformer_2_Port; MPN TF-218DG
U19: RJ45-2-Block; 2_Block_RJ45; MPN RJ45 56 1*2 带灯

Connections:
+3.3V: FB1.1
CMT1: R162.2, U16.18
CMT2: R161.2, U16.13
CMT3: R160.2, U17.18
CMT4: R159.2, U17.13
CMT5: R158.2, U18.18
CMT6: R157.2, U18.13
CT: C157.1, C158.1, C159.1, C160.1, U16.3, U16.8, U17.3, U17.8, U18.3, U18.8
GND: C157.2, C158.2, C159.2, C160.2, C173.1, R153.2, R154.2, R155.2, R156.2, R163.2, R165.2, U15.7_1, U15.7_2, U15.7_3, U15.7_4, U15.8_1, U15.8_2, U15.8_3, U15.8_4, U19.7_1, U19.7_2, U19.8_1, U19.8_2
GNDPWR: C156.2, C173.2, U15.SHIELD, U19.SHIELD
LED0: R152.1
LED1: R151.2
LED2: R149.2
LED3: R150.2
LED4: R164.2
LED5: R166.2
LED_VDD: FB1.2, U15.P1_R_Led+, U15.P2_R_Led+, U15.P3_R_Led+, U15.P4_R_Led+, U19.P1_R_Led+, U19.P2_R_Led+
unnamed: C156.1, R157.1, R158.1, R159.1, R160.1, R161.1, R162.1
unnamed: D20.1, U15.4_3, U15.5_3
unnamed: D21.1, U15.4_4, U15.5_4
unnamed: D22.1, U15.4_2, U15.5_2
unnamed: D23.1, U15.4_1, U15.5_1
unnamed: D24.1, U19.4_1, U19.5_1
unnamed: D25.1, U19.4_2, U19.5_2
unnamed: R149.1, U15.P3_R_Led-
unnamed: R150.1, U15.P4_R_Led-
unnamed: R151.1, U15.P2_R_Led-
unnamed: R152.2, U15.P1_R_Led-
unnamed: R153.1, U15.P3_L_Led-
unnamed: R154.1, U15.P4_L_Led-
unnamed: R155.1, U15.P2_L_Led-
unnamed: R156.1, U15.P1_L_Led-
unnamed: R163.1, U19.P1_L_Led-
unnamed: R164.1, U19.P1_R_Led-
unnamed: R165.1, U19.P2_L_Led-
unnamed: R166.1, U19.P2_R_Led-
RX0_N: U15.2_1, U16.16
RX0_P: U15.1_1, U16.17
RX1_N: U15.2_2, U16.14
RX1_P: U15.1_2, U16.15
RX2_N: U15.2_3, U17.16
RX2_P: U15.1_3, U17.17
RX3_N: U15.2_4, U17.14
RX3_P: U15.1_4, U17.15
RX4_N: U18.16, U19.2_1
RX4_P: U18.17, U19.1_1
RX5_N: U18.14, U19.2_2
RX5_P: U18.15, U19.1_2
RXI_0_N: U16.5
RXI_0_P: U16.4
RXI_1_N: U16.7
RXI_1_P: U16.6
RXI_2_N: U17.5
RXI_2_P: U17.4
RXI_3_N: U17.7
RXI_3_P: U17.6
RXI_4_N: U18.5
RXI_4_P: U18.4
RXI_5_N: U18.7
RXI_5_P: U18.6
TX0_N: U15.6_1, U16.19
TX0_P: U15.3_1, U16.20
TX1_N: U15.6_2, U16.11
TX1_P: U15.3_2, U16.12
TX2_N: U15.6_3, U17.19
TX2_P: U15.3_3, U17.20
TX3_N: U15.6_4, U17.11
TX3_P: U15.3_4, U17.12
TX4_N: U18.19, U19.6_1
TX4_P: U18.20, U19.3_1
TX5_N: U18.11, U19.6_2
TX5_P: U18.12, U19.3_2
TXO_0_N: U16.2
TXO_0_P: U16.1
TXO_1_N: U16.10
TXO_1_P: U16.9
TXO_2_N: U17.2
TXO_2_P: U17.1
TXO_3_N: U17.10
TXO_3_P: U17.9
TXO_4_N: U18.2
TXO_4_P: U18.1
TXO_5_N: U18.10
TXO_5_P: U18.9
VOUT_CAM: D20.2, D21.2, D22.2, D23.2, D24.2, D25.2, U15.P1_L_Led+, U15.P2_L_Led+, U15.P3_L_Led+, U15.P4_L_Led+, U19.P1_L_Led+, U19.P2_L_Led+

Notes on the sheet:
NETWORK PORTLARI
TRANSFORMERS
RTL8309
RTL8211
