ihsanakyrk/Eski-Versionlar-Ve-Siparisler/Movita_3566_HXV_Router_V4.0/CM3566.kicad_sch

## KiCad design Movita_3566_HXV_Router_V4.0/CM3566.kicad_sch (2025-09-01)

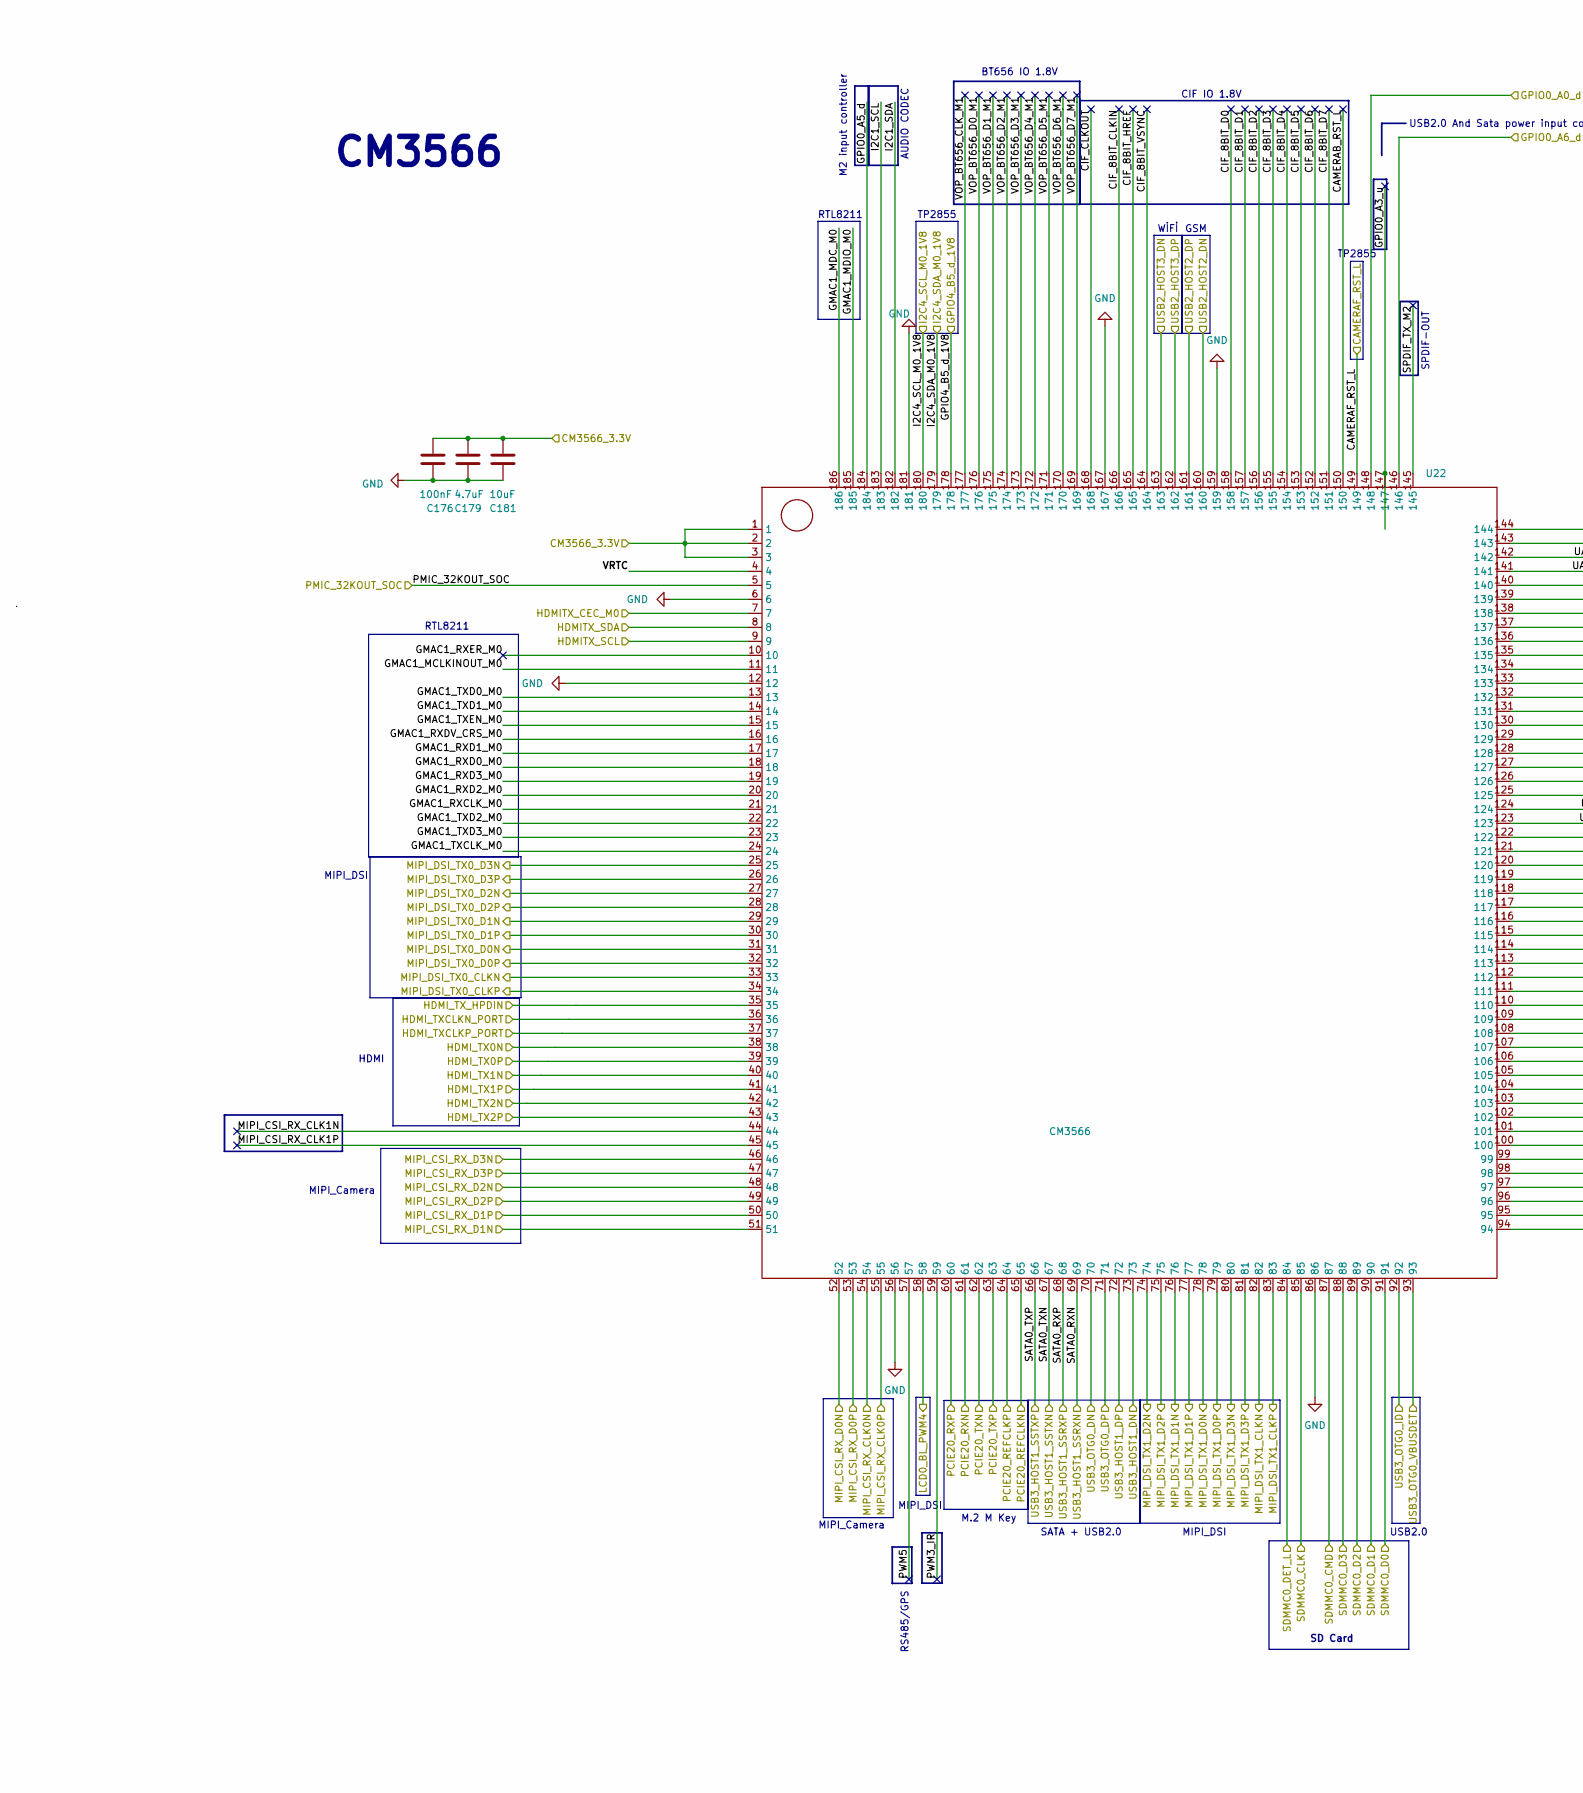
[picture p152: schematic CM3566.kicad_sch, part in row 1, column 1]

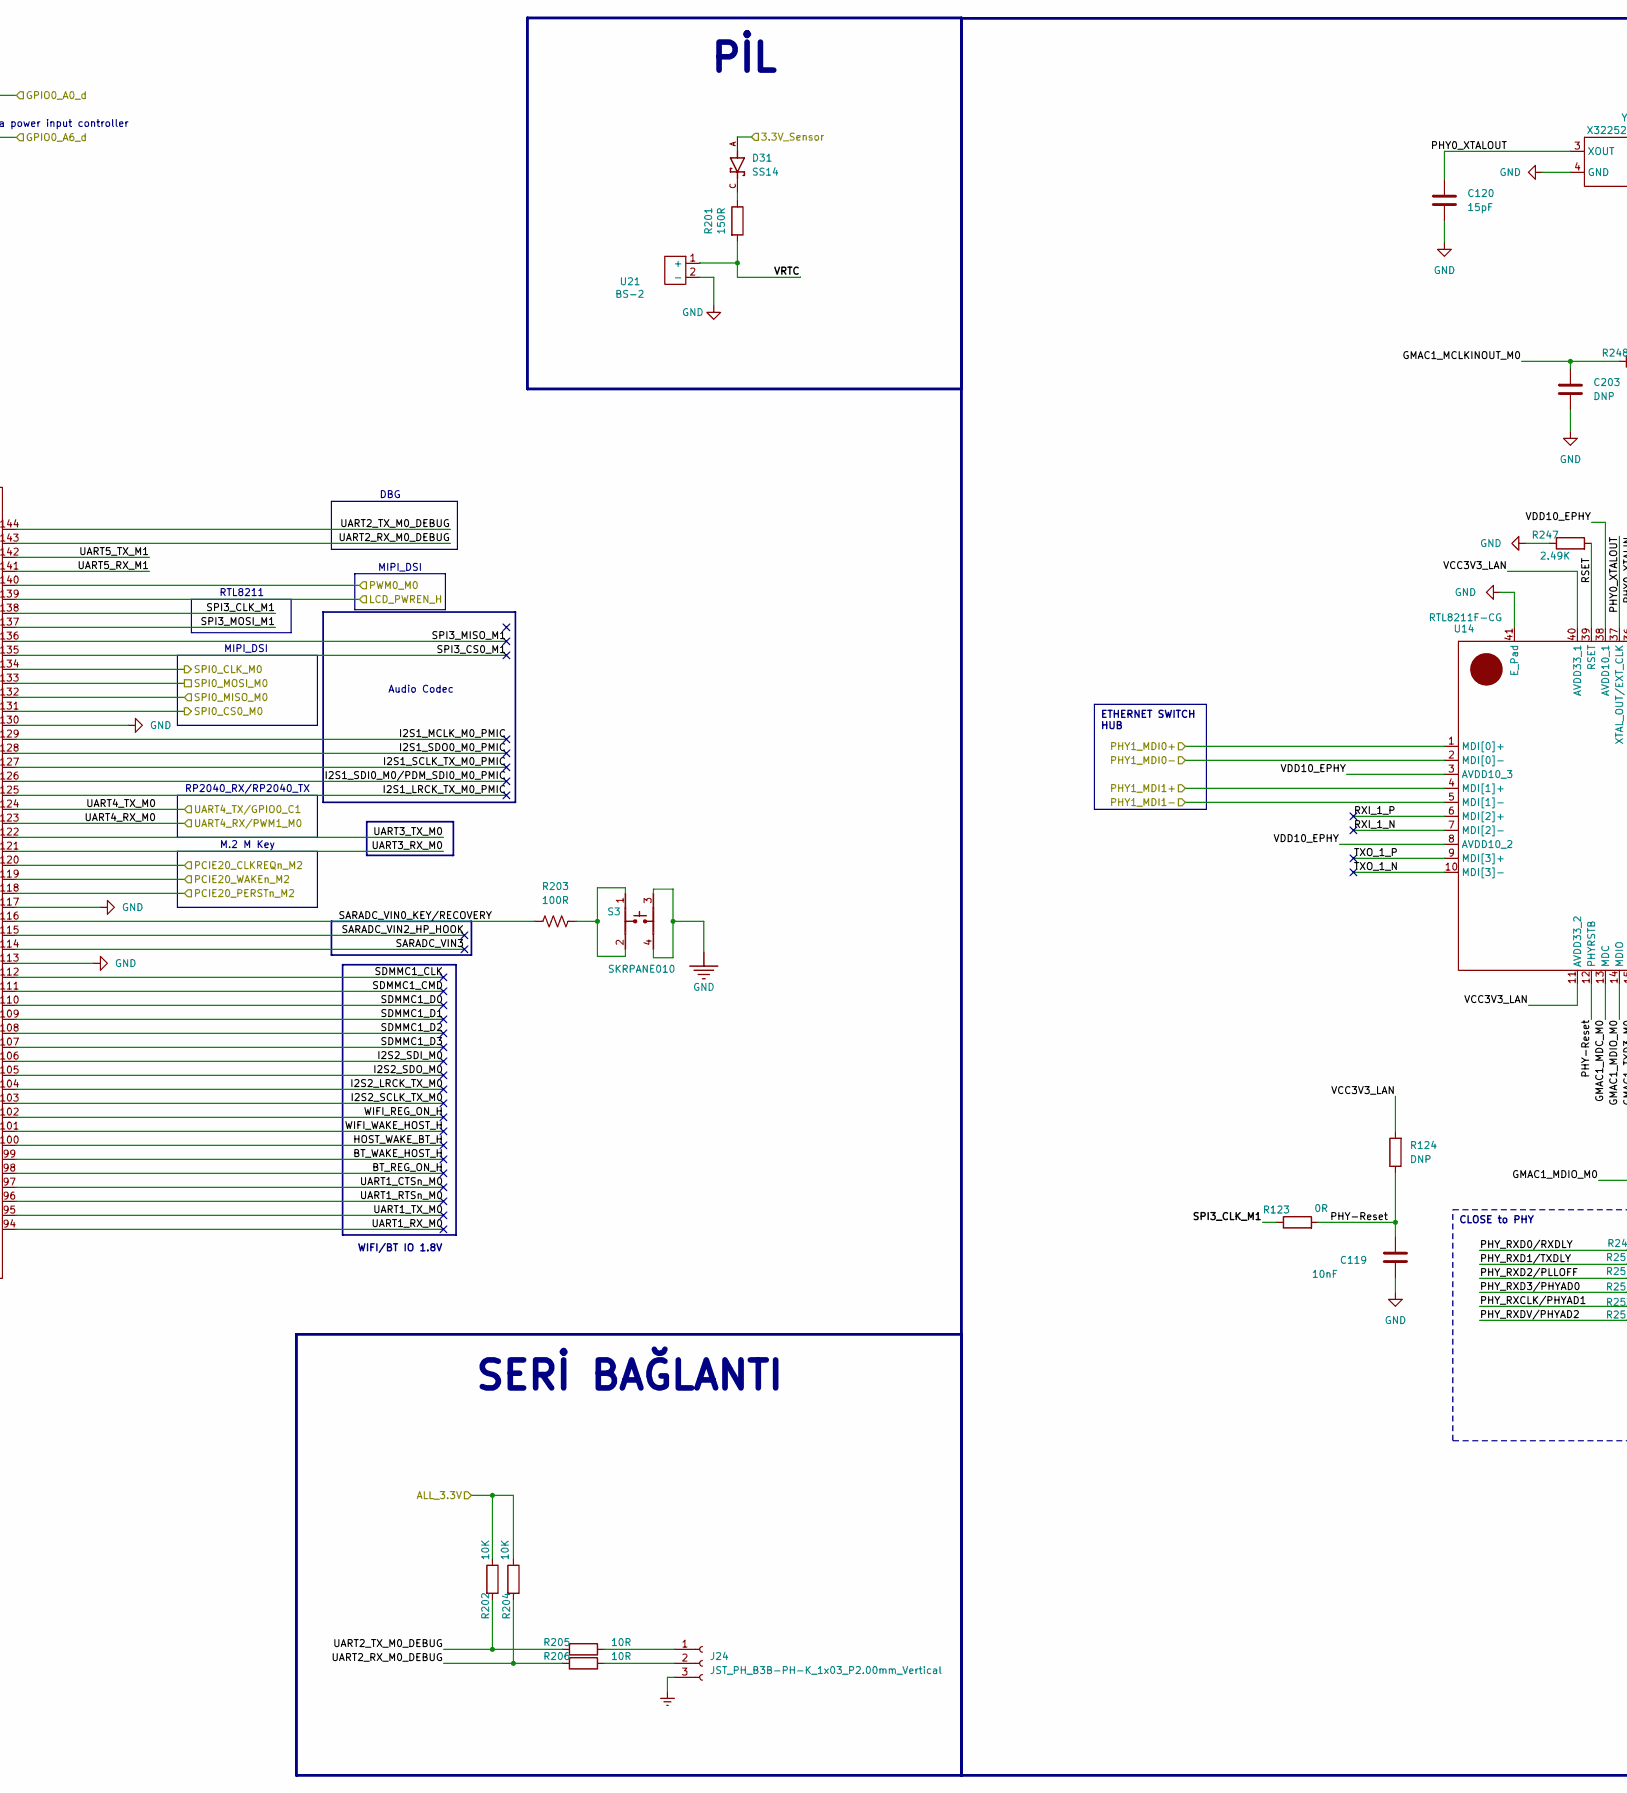
[picture p153: schematic CM3566.kicad_sch, part in row 1, column 2]

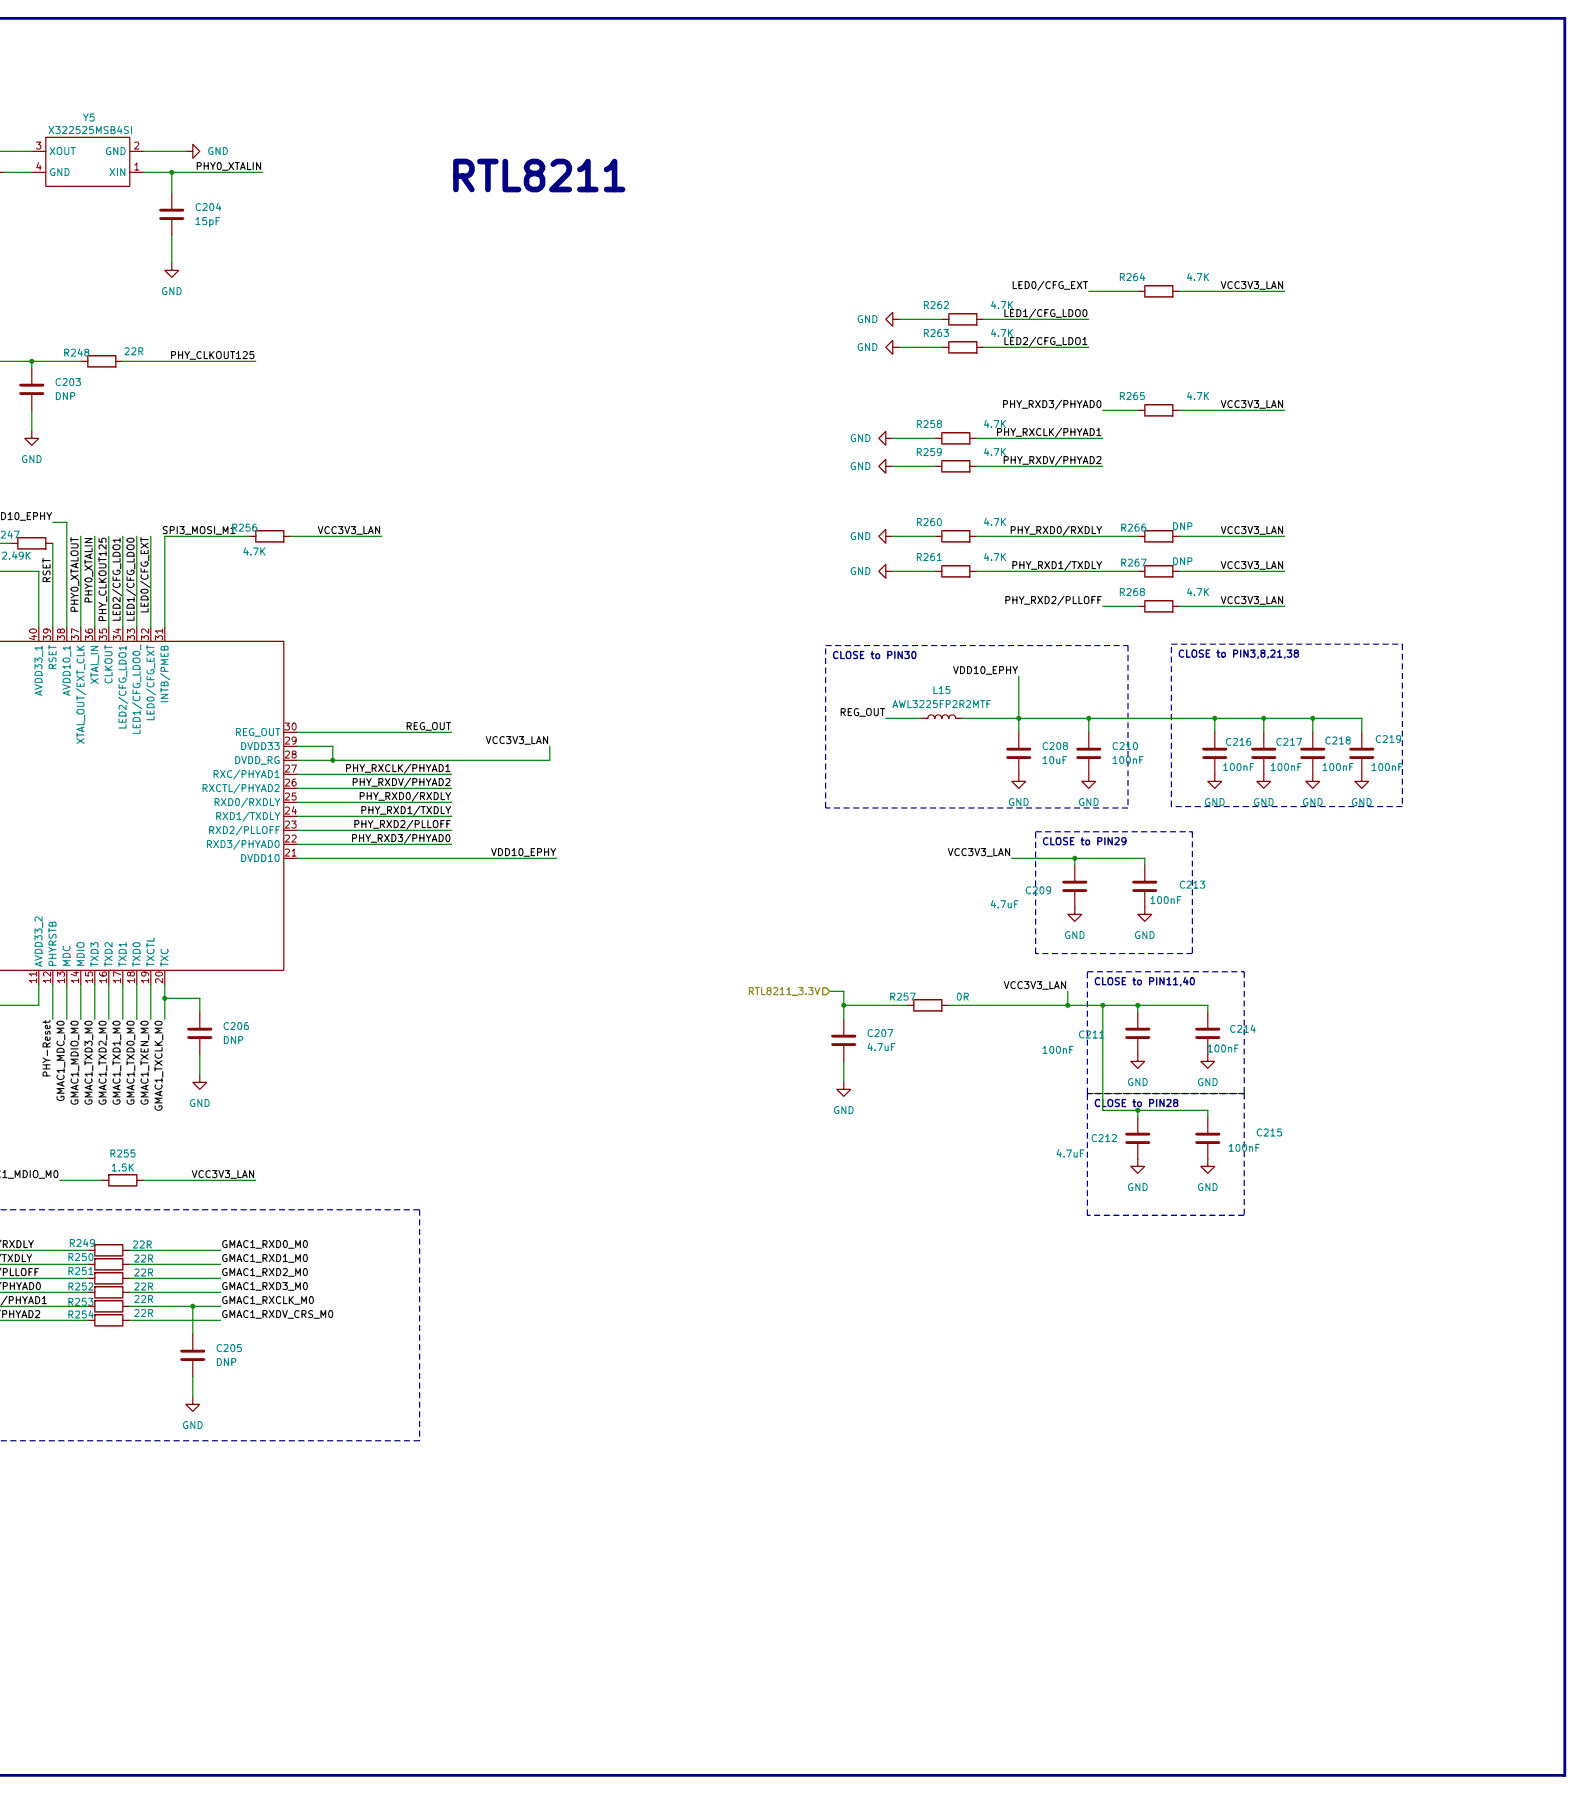
[picture p154: schematic CM3566.kicad_sch, part in row 1, column 3]

Parts:
C119: 10nF; C_0402_1005Metric; MPN CC0402KRX7R9BB103
C120, C204: 15pF; C_0402_1005Metric; MPN 0402CG150J500NT
C176: 100nF; C_0603_1608Metric; MPN 0603B104K500NT
C179, C207, C209, C212: 4.7uF; C_0603_1608Metric; MPN CL10A475KO8NNNC
C181, C208: 10uF; C_0603_1608Metric; MPN CL10A106MO8NQNC
C203, C205, C206: DNP; C_0402_1005Metric
C210, C211, C213, C214, C215, C216, C217, C218, C219: 100nF; C_0402_1005Metric; MPN CC0402KRX7R7BB104
D31: SS14; MPN SS14 SOD-123FL
J24: JST_PH_B3B-PH-K_1x03_P2.00mm_Vertical; MPN JST_PH_B3B-PH-K_1x03_P2.00mm_Vertical
L15: AWL3225FP2R2MTF; MPN AWL3225FP2R2MTF
R123, R257: 0R; R_0402_1005Metric; MPN 0402WGF0000TCE
R124, R266, R267: DNP; R_0402_1005Metric
R201: 150R; R_0603_1608Metric; MPN 0603WAF1500T5E
R202, R204: 10K; R_0402_1005Metric
R203: 100R; R_0603_1608Metric; MPN 0603WAF1000T5E
R205, R206: 10R; R_0402_1005Metric; MPN 0402WGF100JTCE
R247: 2.49K; R_0402_1005Metric; MPN 0402WGF2491TCE
R248, R249, R250, R251, R252, R253, R254: 22R; R_0402_1005Metric; MPN 0402WGF220JTCE
R255: 1.5K; R_0402_1005Metric; MPN 0402WGF1501TCE
R256, R258, R259, R260, R261, R262, R263, R264, R265, R268: 4.7K; R_0402_1005Metric; MPN 0402WGF4701TCE
S3: SKRPANE010
U14: RTL8211F-CG; MPN RTL8211F-CG
U21: BS-2; BS-02-A1AJ010; MPN MYOUNG BS-02-A1AJ010
U22: CM3566; MPN CM3566
Y5: X322525MSB4SI; Crystal_SMD_3225-4Pin_3.2x2.5mm; MPN X322525MSB4SI

Connections:
3.3V_Sensor: D31.A
ALL_3.3V: R202.1, R204.1
BT_REG_ON_H: U22.98
BT_WAKE_HOST_H: U22.99
CAMERAB_RST_L: U22.150
CAMERAF_RST_L: U22.149
CIF_8BIT_CLKIN: U22.166
CIF_8BIT_D0: U22.158
CIF_8BIT_D1: U22.157
CIF_8BIT_D2: U22.156
CIF_8BIT_D3: U22.155
CIF_8BIT_D4: U22.154
CIF_8BIT_D5: U22.153
CIF_8BIT_D6: U22.152
CIF_8BIT_D7: U22.151
CIF_8BIT_HREF: U22.165
CIF_8BIT_VSYNC: U22.164
CIF_CLKOUT: U22.168
CM3566_3.3V: C176.1, C179.1, C181.1, U22.1, U22.2, U22.3
Earth: J24.3
GMAC1_MCLKINOUT_M0: C203.1, R248.1, U22.11
GMAC1_MDC_M0: U14.13 (MDC), U22.186
GMAC1_MDIO_M0: R255.2, U14.14 (MDIO), U22.185
GMAC1_RXCLK_M0: C205.1, R253.1, U22.21
GMAC1_RXD0_M0: R249.1, U22.18
GMAC1_RXD1_M0: R250.1, U22.17
GMAC1_RXD2_M0: R251.1, U22.20
GMAC1_RXD3_M0: R252.1, U22.19
GMAC1_RXDV_CRS_M0: R254.1, U22.16
GMAC1_RXER_M0: U22.10
GMAC1_TXCLK_M0: C206.1, U14.20 (TXC), U22.24
GMAC1_TXD0_M0: U14.18 (TXD0), U22.13
GMAC1_TXD1_M0: U14.17 (TXD1), U22.14
GMAC1_TXD2_M0: U14.16 (TXD2), U22.22
GMAC1_TXD3_M0: U14.15 (TXD3), U22.23
GMAC1_TXEN_M0: U14.19 (TXCTL), U22.15
GND: C119.2, C120.2, C176.2, C179.2, C181.2, C203.2, C204.2, C205.2, C206.2, C207.2, C208.2, C209.2, C210.2, C211.2, C212.2, C213.2, C214.2, C215.2, C216.2, C217.2, C218.2, C219.2, R247.1, R258.1, R259.1, R260.1, R261.1, R262.1, R263.1, S3.3, S3.4, U14.41 (E_Pad), U21.2 (-), U22.6, U22.12, U22.56, U22.86, U22.113, U22.117, U22.130, U22.159, U22.167, U22.181, Y5.2 (GND), Y5.4 (GND)
GPIO0_A0_d: U22.148
GPIO0_A3_u: U22.147
GPIO0_A5_d: U22.184
GPIO0_A6_d: U22.146
GPIO4_B5_d_1V8: U22.178
HDMITX_CEC_M0: U22.7
HDMITX_SCL: U22.9
HDMITX_SDA: U22.8
HDMI_TX0N: U22.38
HDMI_TX0P: U22.39
HDMI_TX1N: U22.40
HDMI_TX1P: U22.41
HDMI_TX2N: U22.42
HDMI_TX2P: U22.43
HDMI_TXCLKN_PORT: U22.36
HDMI_TXCLKP_PORT: U22.37
HDMI_TX_HPDIN: U22.35
HOST_WAKE_BT_H: U22.100
I2C1_SCL: U22.183
I2C1_SDA: U22.182
I2C4_SCL_M0_1V8: U22.180
I2C4_SDA_M0_1V8: U22.179
I2S1_LRCK_TX_M0_PMIC: U22.125
I2S1_MCLK_M0_PMIC: U22.129
I2S1_SCLK_TX_M0_PMIC: U22.127
I2S1_SDI0_M0/PDM_SDI0_M0_PMIC: U22.126
I2S1_SDO0_M0_PMIC: U22.128
I2S2_LRCK_TX_M0: U22.104
I2S2_SCLK_TX_M0: U22.103
I2S2_SDI_M0: U22.106
I2S2_SDO_M0: U22.105
LCD0_BL_PWM4: U22.58
LCD_PWREN_H: U22.139
LED0/CFG_EXT: R264.1, U14.32 (LED0/CFG_EXT)
LED1/CFG_LDO0: R262.2, U14.33 (LED1/CFG_LDO0_)
LED2/CFG_LDO1: R263.2, U14.34 (LED2/CFG_LDO1)
MIPI_CSI_RX_CLK0N: U22.54
MIPI_CSI_RX_CLK0P: U22.55
MIPI_CSI_RX_CLK1N: U22.44
MIPI_CSI_RX_CLK1P: U22.45
MIPI_CSI_RX_D0N: U22.52
MIPI_CSI_RX_D0P: U22.53
MIPI_CSI_RX_D1N: U22.51
MIPI_CSI_RX_D1P: U22.50
MIPI_CSI_RX_D2N: U22.48
MIPI_CSI_RX_D2P: U22.49
MIPI_CSI_RX_D3N: U22.46
MIPI_CSI_RX_D3P: U22.47
MIPI_DSI_TX0_CLKN: U22.33
MIPI_DSI_TX0_CLKP: U22.34
MIPI_DSI_TX0_D0N: U22.31
MIPI_DSI_TX0_D0P: U22.32
MIPI_DSI_TX0_D1N: U22.29
MIPI_DSI_TX0_D1P: U22.30
MIPI_DSI_TX0_D2N: U22.27
MIPI_DSI_TX0_D2P: U22.28
MIPI_DSI_TX0_D3N: U22.25
MIPI_DSI_TX0_D3P: U22.26
MIPI_DSI_TX1_CLKN: U22.82
MIPI_DSI_TX1_CLKP: U22.83
MIPI_DSI_TX1_D0N: U22.78
MIPI_DSI_TX1_D0P: U22.79
MIPI_DSI_TX1_D1N: U22.76
MIPI_DSI_TX1_D1P: U22.77
MIPI_DSI_TX1_D2N: U22.74
MIPI_DSI_TX1_D2P: U22.75
MIPI_DSI_TX1_D3N: U22.80
MIPI_DSI_TX1_D3P: U22.81
unnamed: D31.C, R201.1
unnamed: J24.1, R205.1
unnamed: J24.2, R206.1
unnamed: R203.2, S3.1, S3.2
PCIE20_CLKREQn_M2: U22.120
PCIE20_PERSTn_M2: U22.118
PCIE20_REFCLKN: U22.65
PCIE20_REFCLKP: U22.64
PCIE20_RXN: U22.61
PCIE20_RXP: U22.60
PCIE20_TXN: U22.62
PCIE20_TXP: U22.63
PCIE20_WAKEn_M2: U22.119
PHY0_XTALIN: C204.1, U14.36 (XTAL_IN), Y5.1 (XIN)
PHY0_XTALOUT: C120.1, U14.37 (XTAL_OUT/EXT_CLK), Y5.3 (XOUT)
PHY1_MDI0+: U14.1 (MDI[0]+)
PHY1_MDI0-: U14.2 (MDI[0]-)
PHY1_MDI1+: U14.4 (MDI[1]+)
PHY1_MDI1-: U14.5 (MDI[1]-)
PHY-Reset: C119.1, R123.2, R124.1, U14.12 (PHYRSTB)
PHY_CLKOUT125: R248.2, U14.35 (CLKOUT)
PHY_RXCLK/PHYAD1: R253.2, R258.2, U14.27 (RXC/PHYAD1)
PHY_RXD0/RXDLY: R249.2, R260.2, R266.1, U14.25 (RXD0/RXDLY)
PHY_RXD1/TXDLY: R250.2, R261.2, R267.1, U14.24 (RXD1/TXDLY)
PHY_RXD2/PLLOFF: R251.2, R268.1, U14.23 (RXD2/PLLOFF)
PHY_RXD3/PHYAD0: R252.2, R265.1, U14.22 (RXD3/PHYAD0)
PHY_RXDV/PHYAD2: R254.2, R259.2, U14.26 (RXCTL/PHYAD2)
PMIC_32KOUT_SOC: U22.5
PWM0_M0: U22.140
PWM3_IR: U22.59
PWM5: U22.57
REG_OUT: L15.1, U14.30 (REG_OUT)
RSET: R247.2, U14.39 (RSET)
RTL8211_3.3V: C207.1, R257.1
RXI_1_N: U14.7 (MDI[2]-)
RXI_1_P: U14.6 (MDI[2]+)
SARADC_VIN0_KEY/RECOVERY: R203.1, U22.116
SARADC_VIN2_HP_HOOK: U22.115
SARADC_VIN3: U22.114
SATA0_RXN: U22.69
SATA0_RXP: U22.68
SATA0_TXN: U22.67
SATA0_TXP: U22.66
SDMMC0_CLK: U22.85
SDMMC0_CMD: U22.87
SDMMC0_D0: U22.91
SDMMC0_D1: U22.90
SDMMC0_D2: U22.89
SDMMC0_D3: U22.88
SDMMC0_DET_L: U22.84
SDMMC1_CLK: U22.112
SDMMC1_CMD: U22.111
SDMMC1_D0: U22.110
SDMMC1_D1: U22.109
SDMMC1_D2: U22.108
SDMMC1_D3: U22.107
SPDIF_TX_M2: U22.145
SPI0_CLK_M0: U22.134
SPI0_CS0_M0: U22.131
SPI0_MISO_M0: U22.132
SPI0_MOSI_M0: U22.133
SPI3_CLK_M1: R123.1, U22.138
SPI3_CS0_M1: U22.135
SPI3_MISO_M1: U22.136
SPI3_MOSI_M1: R256.1, U14.31 (INTB/PMEB), U22.137
TXO_1_N: U14.10 (MDI[3]-)
TXO_1_P: U14.9 (MDI[3]+)
UART1_CTSn_M0: U22.97
UART1_RTSn_M0: U22.96
UART1_RX_M0: U22.94
UART1_TX_M0: U22.95
UART2_RX_M0_DEBUG: R204.2, R206.2, U22.143
UART2_TX_M0_DEBUG: R202.2, R205.2, U22.144
UART3_RX_M0: U22.121
UART3_TX_M0: U22.122
UART4_RX_M0: U22.123
UART4_TX_M0: U22.124
UART5_RX_M1: U22.141
UART5_TX_M1: U22.142
USB2_HOST2_DN: U22.160
USB2_HOST2_DP: U22.161
USB2_HOST3_DN: U22.163
USB2_HOST3_DP: U22.162
USB3_HOST1_DN: U22.73
USB3_HOST1_DP: U22.72
USB3_OTG0_DN: U22.70
USB3_OTG0_DP: U22.71
USB3_OTG0_ID: U22.92
USB3_OTG0_VBUSDET: U22.93
VCC3V3_LAN: C209.1, C211.1, C212.1, C213.1, C214.1, C215.1, R124.2, R255.1, R256.2, R257.2, R264.2, R265.2, R266.2, R267.2, R268.2, U14.11 (AVDD33_2), U14.28 (DVDD_RG), U14.29 (DVDD33), U14.40 (AVDD33_1)
VDD10_EPHY: C208.1, C210.1, C216.1, C217.1, C218.1, C219.1, L15.2, U14.3 (AVDD10_3), U14.8 (AVDD10_2), U14.21 (DVDD10), U14.38 (AVDD10_1)
VOP_BT656_CLK_M1: U22.177
VOP_BT656_D0_M1: U22.176
VOP_BT656_D1_M1: U22.175
VOP_BT656_D2_M1: U22.174
VOP_BT656_D3_M1: U22.173
VOP_BT656_D4_M1: U22.172
VOP_BT656_D5_M1: U22.171
VOP_BT656_D6_M1: U22.170
VOP_BT656_D7_M1: U22.169
VRTC: R201.2, U21.1 (+), U22.4
WIFI_REG_ON_H: U22.102
WIFI_WAKE_HOST_H: U22.101

Notes on the sheet:
ETHERNET SWITCH HUB
CLOSE to PIN30
CLOSE to PIN3,8,21,38
CLOSE to PIN28
CLOSE to PIN11,40
CLOSE to PHY
CLOSE to PIN29
MIPI_DSI
RP2040_RX/RP2040_TX
PİL
RTL8211
RTL8211
MIPI_Camera
BT656 IO 1.8V
AUDIO CODEC
CIF IO 1.8V
DBG
SATA + USB2.0
M2 input controller
TP2855
CM3566
TP2855
M.2 M Key
Audio Codec
MIPI_DSI
WIFI/BT IO 1.8V
SERİ BAĞLANTI
SD Card
SPDIF-OUT
USB2.0
USB2.0 And Sata power input controller
HDMI
GSM
WİFİ
RS485/GPS
