ihsanakyrk/Eski-Versionlar-Ve-Siparisler/Movita_3566_HXV_Router_V4.0/CSI_AHD.kicad_sch

## KiCad design Movita_3566_HXV_Router_V4.0/CSI_AHD.kicad_sch (2025-09-01)

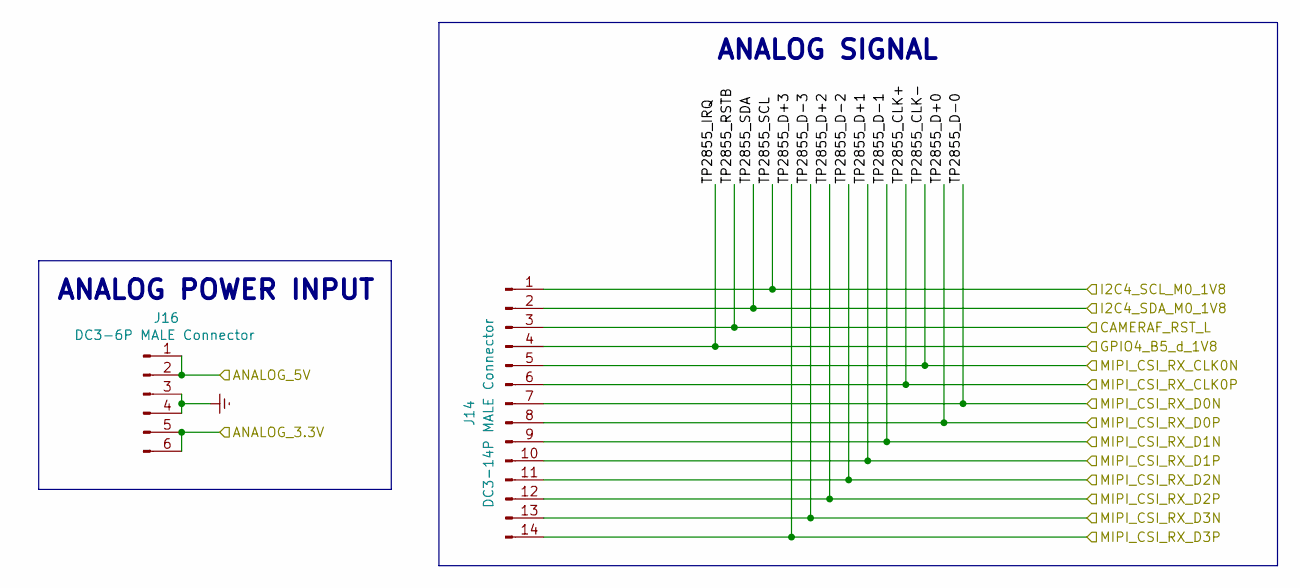
[picture p155: schematic CSI_AHD.kicad_sch]

Parts:
J14: DC3-14P MALE Connector; Analog signal connector; MPN DC3-14P MALE Connector
J16: DC3-6P MALE Connector; Analog power connector; MPN DC3-6P MALE Connector

Connections:
ANALOG_3.3V: J16.5, J16.6
ANALOG_5V: J16.1, J16.2
CAMERAF_RST_L: J14.3
Earth: J16.3, J16.4
GPIO4_B5_d_1V8: J14.4
I2C4_SCL_M0_1V8: J14.1
I2C4_SDA_M0_1V8: J14.2
MIPI_CSI_RX_CLK0N: J14.5
MIPI_CSI_RX_CLK0P: J14.6
MIPI_CSI_RX_D0N: J14.7
MIPI_CSI_RX_D0P: J14.8
MIPI_CSI_RX_D1N: J14.9
MIPI_CSI_RX_D1P: J14.10
MIPI_CSI_RX_D2N: J14.11
MIPI_CSI_RX_D2P: J14.12
MIPI_CSI_RX_D3N: J14.13
MIPI_CSI_RX_D3P: J14.14

Notes on the sheet:
ANALOG SIGNAL
ANALOG POWER INPUT
