ihsanakyrk/Eski-Versionlar-Ve-Siparisler/Movita_3566_HXV_Router_V4.0/EC25_Sim.kicad_sch

## KiCad design Movita_3566_HXV_Router_V4.0/EC25_Sim.kicad_sch (2025-09-01)

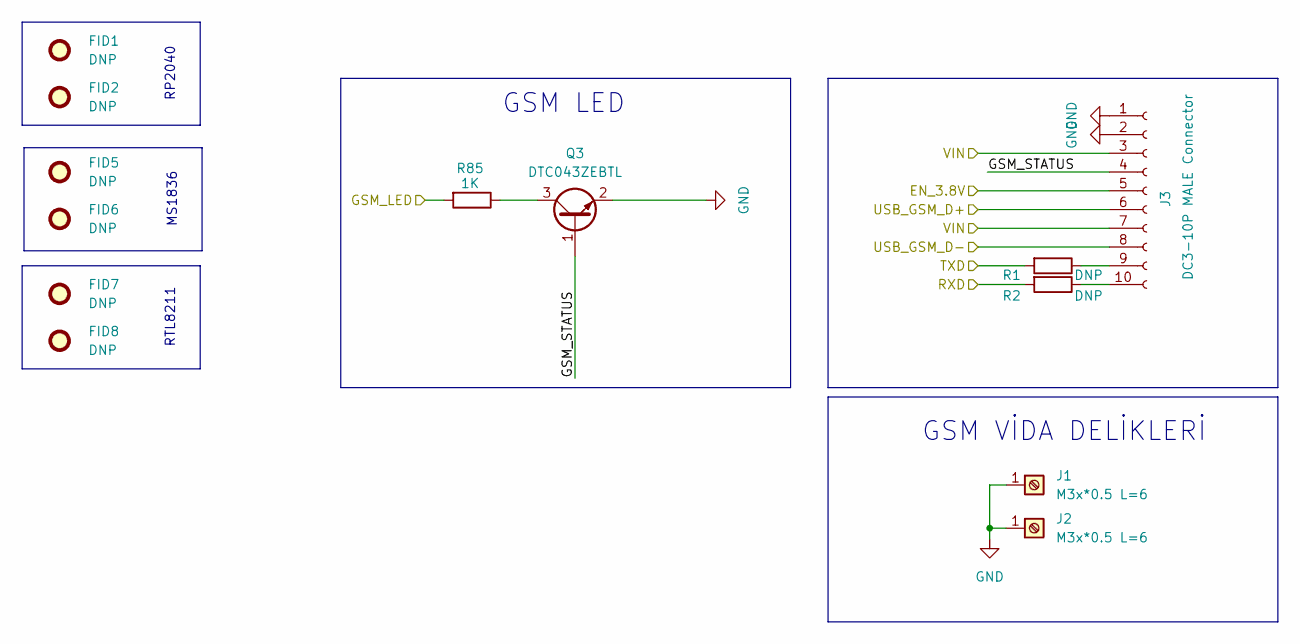
[picture p156: schematic EC25_Sim.kicad_sch]

Parts:
FID1, FID2, FID5, FID6, FID7, FID8: DNP; Fiducial_0.5mm_Mask1mm
J1, J2: M3x*0.5 L=6; Screw Terminal Shinbo; MPN SMTSO-M3-6ET
J3: DC3-10P MALE Connector; GSM connector; MPN DC3-10P MALE Connector
Q3: DTC043ZEBTL; SOT-416; MPN DTC043ZEBTL
R1, R2: DNP; R_0603_1608Metric
R85: 1K; R_0603_1608Metric; MPN 0603WAF1001T5E

Connections:
EN_3.8V: J3.5
GND: J1.1, J2.1, J3.1, J3.2, Q3.2 (E)
GSM_LED: R85.2
GSM_STATUS: J3.4, Q3.1 (B)
unnamed: J3.9, R1.1
unnamed: J3.10, R2.1
unnamed: Q3.3 (C), R85.1
RXD: R2.2
TXD: R1.2
USB_GSM_D+: J3.6
USB_GSM_D-: J3.8
VIN: J3.3, J3.7

Notes on the sheet:
MS1836
RP2040
GSM VİDA DELİKLERİ
RTL8211
GSM LED
