ihsanakyrk/Eski-Versionlar-Ve-Siparisler/Movita_3566_HXV_Router_V4.0/HDMI_CVBS.kicad_sch

## KiCad design Movita_3566_HXV_Router_V4.0/HDMI_CVBS.kicad_sch (2025-09-01)

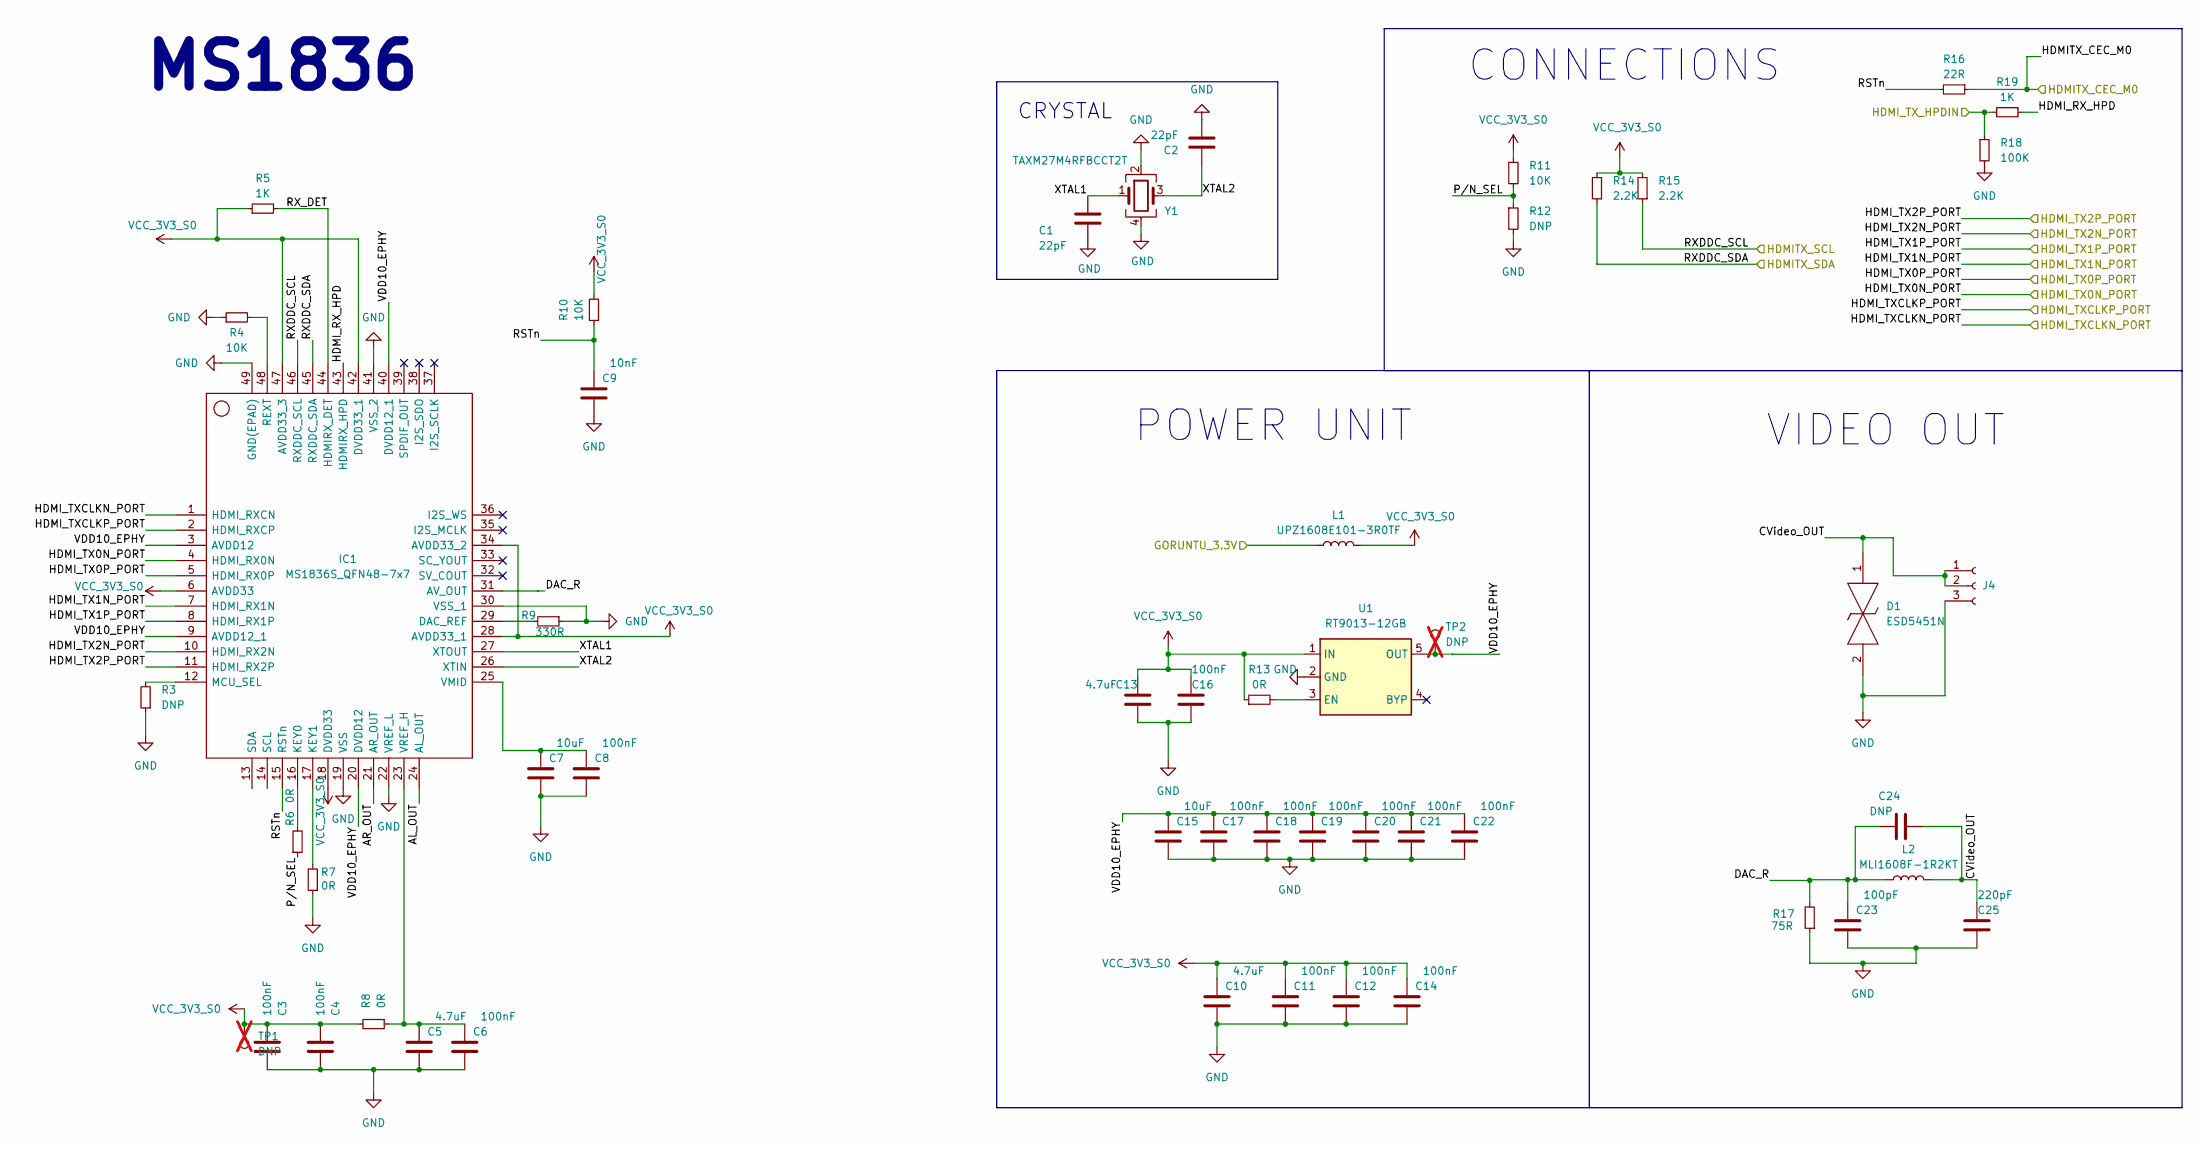
[picture p157: schematic HDMI_CVBS.kicad_sch]

Parts:
C1, C2: 22pF; C_0603_1608Metric; MPN CL10C220JB8NNNC
C3, C4, C6, C8, C11, C12, C14, C16, C17, C18, C19, C20, C21, C22: 100nF; C_0603_1608Metric; MPN 0603B104K500NT
C5, C10, C13: 4.7uF; C_0603_1608Metric; MPN CL10A475KO8NNNC
C7, C15: 10uF; C_0603_1608Metric; MPN CL10A106MO8NQNC
C9: 10nF; C_0603_1608Metric; MPN CC0603KRX7R9BB103
C23: 100pF; C_0603_1608Metric; MPN 0603B101K500NT
C24: DNP; C_0603_1608Metric
C25: 220pF; C_0603_1608Metric; MPN CL10B221KB8NNNC
D1: ESD5451N; Manufacturer_Part_Number ESD5451N
IC1: MS1836S_QFN48-7x7; QFN-48-1EP_7x7mm_P0.5mm_EP5.6x5.6mm; MPN MS1836S
J4: DNP; AV_CON; MPN 莲花座AV1-8.4-5A 黑色
L1: UPZ1608E101-3R0TF; L_0603_1608Metric; MPN UPZ1608E101-3R0TF
L2: MLI1608F-1R2KT; L_0603_1608Metric; MPN MLI1608F-1R2KT
R3, R12: DNP; R_0402_1005Metric
R4: 10K; R_0402_1005Metric
R5, R19: 1K; R_0603_1608Metric; MPN 0603WAF1001T5E
R6, R7, R8, R13: 0R; R_0402_1005Metric; MPN 0402WGF0000TCE
R9: 330R; R_0603_1608Metric; MPN 0603WAF3300T5E
R10, R11: 10K; R_0603_1608Metric; MPN 0603WAF1002T5E
R14, R15: 2.2K; R_0603_1608Metric; MPN 0603WAF2201T5E
R16: 22R; R_0603_1608Metric; MPN 0603WAF220JT5E
R17: 75R; R_0402_1005Metric; MPN 0402WGF750JTCE
R18: 100K; R_0603_1608Metric; MPN 0603WAF1003T5E
TP1, TP2: DNP; TestPoint_Pad_1.0x1.0mm; not fitted
U1: RT9013-12GB; SOT-23-5; MPN RT9013-12GB
Y1: TAXM27M4RFBCCT2T; Crystal_SMD_3225-4Pin_3.2x2.5mm; MPN TAXM27M4RFBCCT2T

Connections:
AL_OUT: IC1.24 (AL_OUT)
AR_OUT: IC1.21 (AR_OUT)
CVideo_OUT: C24.2, C25.1, D1.1, J4.1, J4.2, L2.2
DAC_R: C23.1, C24.1, IC1.31 (AV_OUT), L2.1, R17.2
GND: C1.2, C2.2, C3.2, C4.2, C5.2, C6.2, C7.2, C8.2, C9.2, C10.2, C11.2, C12.2, C13.2, C14.2, C15.2, C16.2, C17.2, C18.2, C19.2, C20.2, C21.2, C22.2, C23.2, C25.2, D1.2, IC1.19 (VSS), IC1.22 (VREF_L), IC1.30 (VSS_1), IC1.41 (VSS_2), IC1.49 (GND(EPAD)), J4.3, R3.1, R4.1, R7.1, R9.1, R12.2, R17.1, R18.2, U1.2 (GND), Y1.2, Y1.4
GORUNTU_3.3V: L1.1
HDMITX_CEC_M0: R16.1
HDMITX_SCL: IC1.46 (RXDDC_SCL), R15.1
HDMITX_SDA: IC1.45 (RXDDC_SDA), R14.1
HDMI_RX_HPD: IC1.43 (HDMIRX_HPD), R19.1
HDMI_TX0N_PORT: IC1.4 (HDMI_RX0N)
HDMI_TX0P_PORT: IC1.5 (HDMI_RX0P)
HDMI_TX1N_PORT: IC1.7 (HDMI_RX1N)
HDMI_TX1P_PORT: IC1.8 (HDMI_RX1P)
HDMI_TX2N_PORT: IC1.10 (HDMI_RX2N)
HDMI_TX2P_PORT: IC1.11 (HDMI_RX2P)
HDMI_TXCLKN_PORT: IC1.1 (HDMI_RXCN)
HDMI_TXCLKP_PORT: IC1.2 (HDMI_RXCP)
HDMI_TX_HPDIN: R18.1, R19.2
unnamed: C5.1, C6.1, IC1.23 (VREF_H), R8.1
unnamed: C7.1, C8.1, IC1.25 (VMID)
unnamed: IC1.12 (MCU_SEL), R3.2
unnamed: IC1.16 (KEY0), R6.2
unnamed: IC1.17 (KEY1), R7.2
unnamed: IC1.29 (DAC_REF), R9.2
unnamed: IC1.48 (REXT), R4.2
unnamed: R13.2, U1.3 (EN)
P/N_SEL: R6.1, R11.2, R12.1
RSTn: C9.1, IC1.15 (RSTn), R10.1, R16.2
RX_DET: IC1.44 (HDMIRX_DET), R5.2
VCC_3V3_S0: C3.1, C4.1, C10.1, C11.1, C12.1, C13.1, C14.1, C16.1, IC1.6 (AVDD33), IC1.18 (DVDD33), IC1.28 (AVDD33_1), IC1.34 (AVDD33_2), IC1.42 (DVDD33_1), IC1.47 (AVDD33_3), L1.2, R5.1, R8.2, R10.2, R11.1, R13.1, R14.2, R15.2, TP1.1, U1.1 (IN)
VDD10_EPHY: C15.1, C17.1, C18.1, C19.1, C20.1, C21.1, C22.1, IC1.3 (AVDD12), IC1.9 (AVDD12_1), IC1.20 (DVDD12), IC1.40 (DVDD12_1), TP2.1, U1.5 (OUT)
XTAL1: C1.1, IC1.27 (XTOUT), Y1.1
XTAL2: C2.1, IC1.26 (XTIN), Y1.3

Notes on the sheet:
MS1836
VIDEO OUT
CONNECTIONS
CRYSTAL
POWER UNIT
