ihsanakyrk/Eski-Versionlar-Ve-Siparisler/Movita_3566_HXV_Router_V4.0/I2CDevice.kicad_sch

## KiCad design Movita_3566_HXV_Router_V4.0/I2CDevice.kicad_sch (2025-09-01)

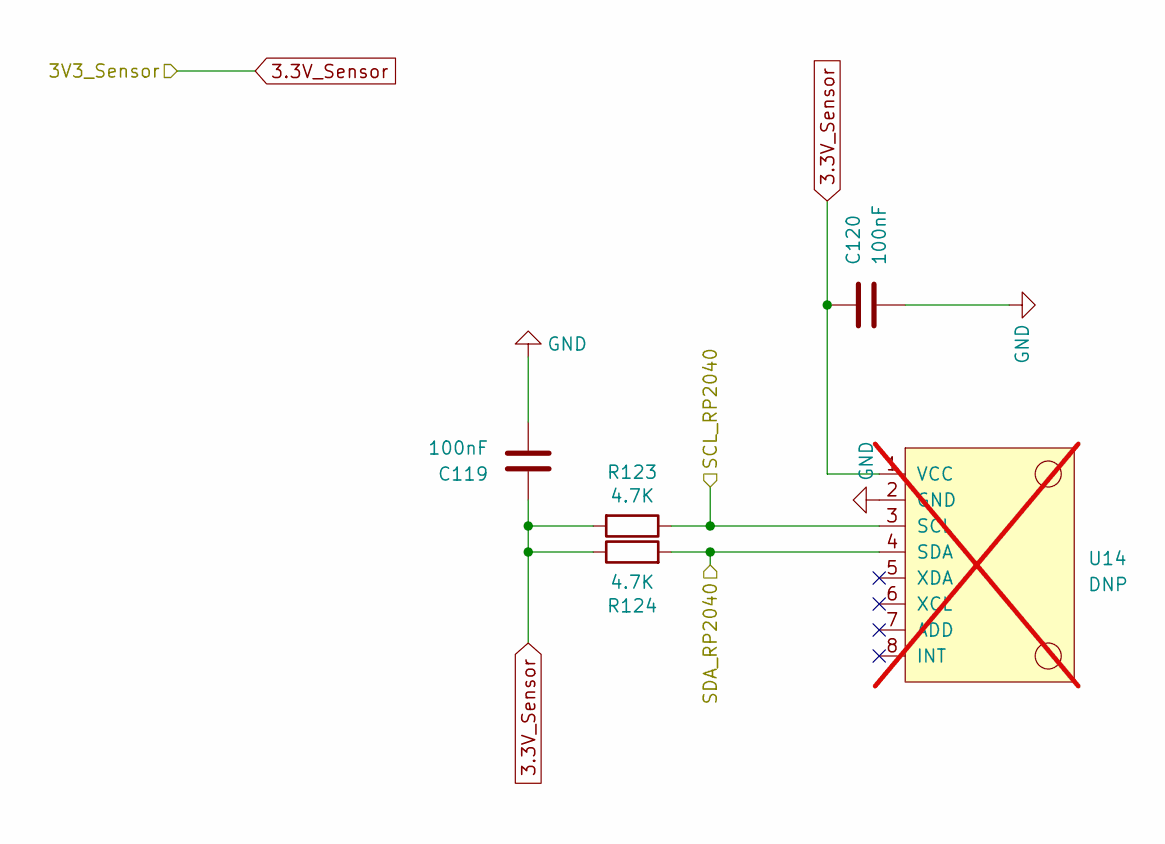
[picture p158: schematic I2CDevice.kicad_sch]

Parts:
C119, C120: 100nF; C_0603_1608Metric; MPN 0603B104K500NT
R123, R124: 4.7K; R_0603_1608Metric; MPN 0603WAF4701T5E
U14: DNP; module_mpu6050; not fitted

Connections:
3.3V_Sensor: C119.1, C120.1, R123.2, R124.1, U14.1 (VCC)
GND: C119.2, C120.2, U14.2 (GND)
SCL_RP2040: R123.1, U14.3 (SCL)
SDA_RP2040: R124.2, U14.4 (SDA)
