ihsanakyrk/Eski-Versionlar-Ve-Siparisler/Movita_3566_HXV_Router_V4.0/IO Connector.kicad_sch

## KiCad design Movita_3566_HXV_Router_V4.0/IO Connector.kicad_sch (2025-09-01)

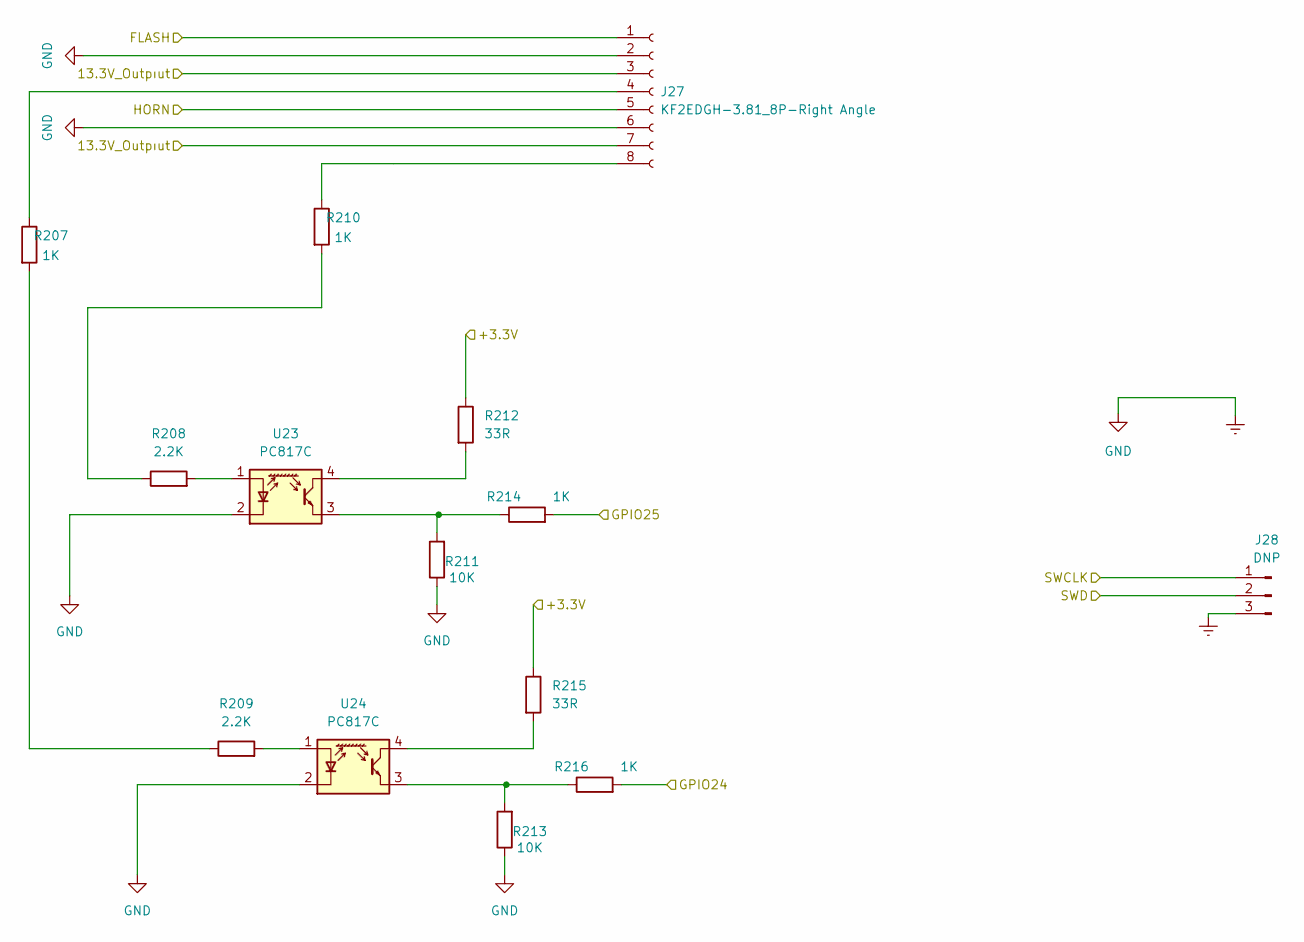
[picture p159: schematic IO Connector.kicad_sch]

Parts:
J27: KF2EDGH-3.81_8P-Right Angle; KF2EDGH-3.81_8P; MPN 15EDGK-3.81 双层 2*4p
J28: DNP; PinSocket_1x03_P2.00mm_Vertical
R207, R210, R214, R216: 1K; R_0603_1608Metric; MPN 0603WAF1001T5E
R208, R209: 2.2K; R_0603_1608Metric; MPN 0603WAF2201T5E
R211, R213: 10K; R_0603_1608Metric; MPN 0603WAF1002T5E
R212, R215: 33R; R_0603_1608Metric; MPN 0603WAF330JT5E
U23, U24: PC817C; PC817; MPN PC817C_4PIN_SMD

Connections:
13.3V_Outpıut: J27.3, J27.7
+3.3V: R212.1, R215.1
Earth: J27.2, J27.6, J28.3, R211.1, R213.1, U23.2 (K), U24.2 (K)
FLASH: J27.1
GPIO24: R216.2
GPIO25: R214.2
HORN: J27.5
unnamed: J27.4, R207.1
unnamed: J27.8, R210.1
unnamed: R207.2, R209.1
unnamed: R208.1, R210.2
unnamed: R208.2, U23.1 (A)
unnamed: R209.2, U24.1 (A)
unnamed: R211.2, R214.1, U23.3 (E)
unnamed: R212.2, U23.4 (C)
unnamed: R213.2, R216.1, U24.3 (E)
unnamed: R215.2, U24.4 (C)
SWCLK: J28.1
SWD: J28.2
