ihsanakyrk/Eski-Versionlar-Ve-Siparisler/Movita_3566_HXV_Router_V4.0/MIPI_DSI.kicad_sch

## KiCad design Movita_3566_HXV_Router_V4.0/MIPI_DSI.kicad_sch (2025-09-01)

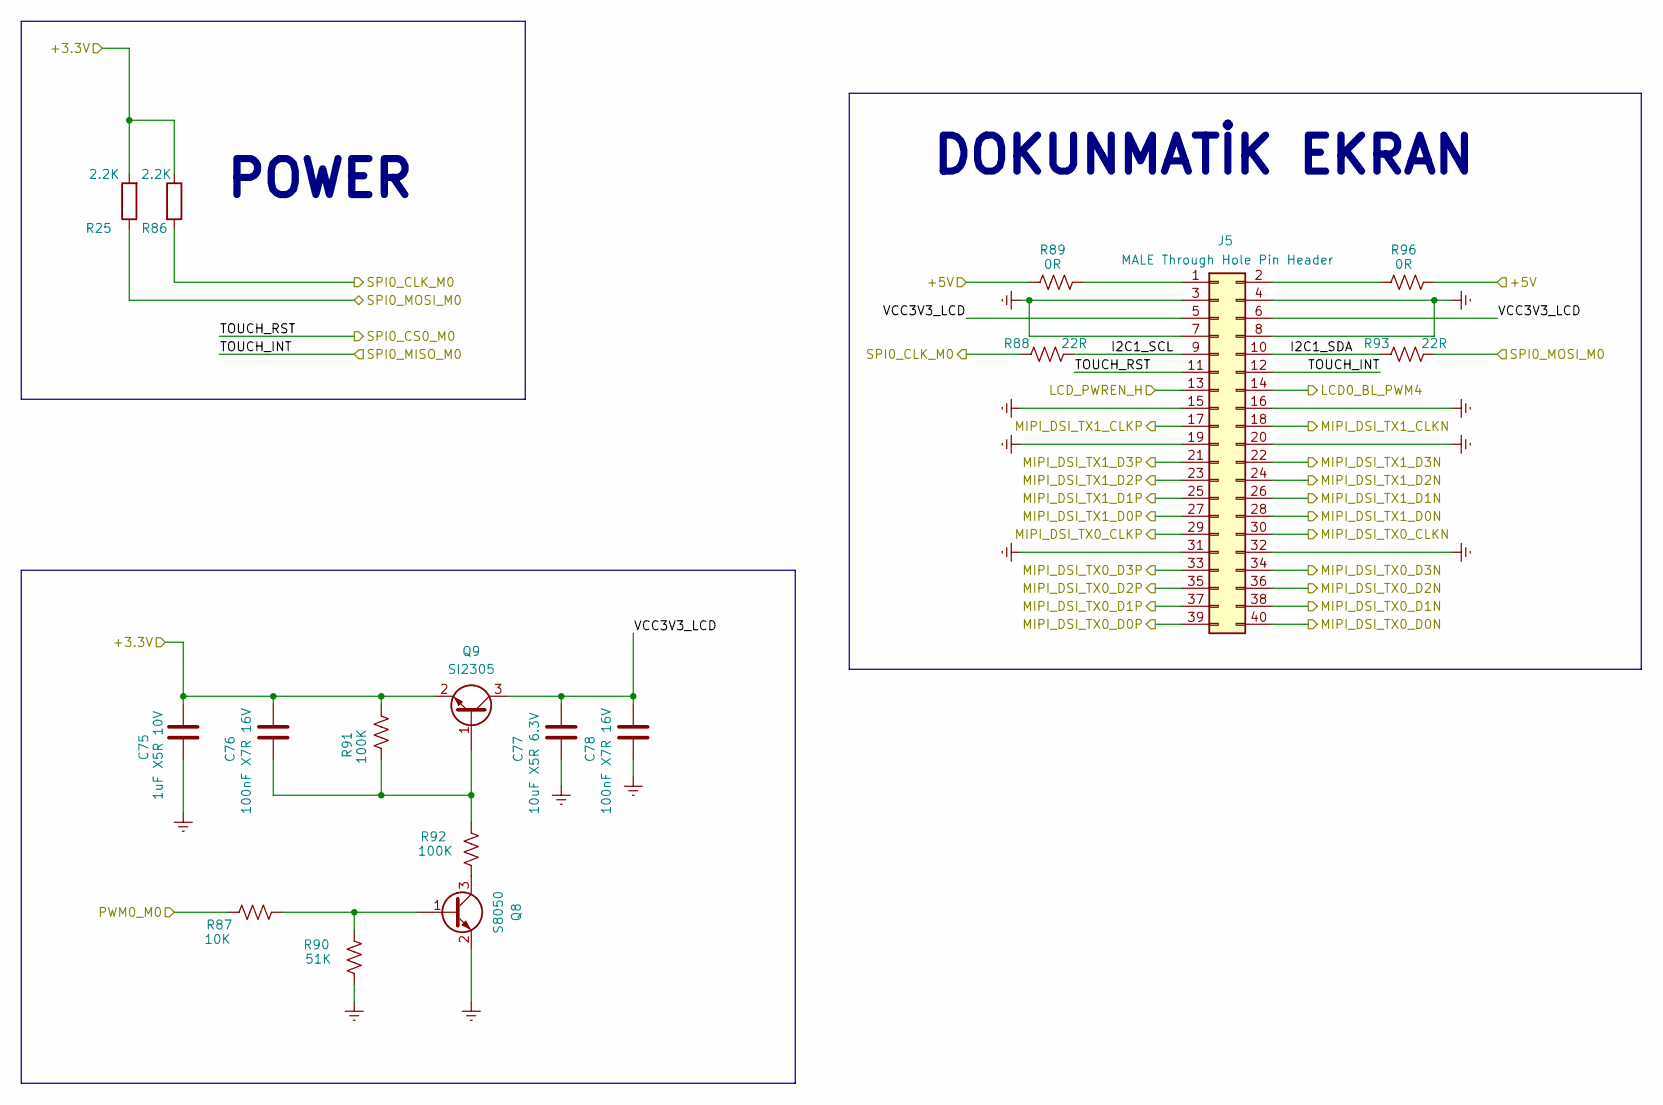
[picture p160: schematic MIPI_DSI.kicad_sch]

Parts:
C75: 1uF X5R 10V; C_0402_1005Metric; MPN CL05A105KP5NNNC
C76, C78: 100nF X7R 16V; C_0402_1005Metric; MPN CC0402KRX7R7BB104
C77: 10uF X5R 6.3V; C_0402_1005Metric; MPN CL05A106MQ5NUNC
J5: MALE Through Hole Pin Header; PinHeader_2x20_P2.00mm_Vertical
Q8: S8050; SOT-23; MPN S8050
Q9: SI2305; SOT-23; MPN SI2305
R25, R86: 2.2K; R_0402_1005Metric; MPN 0402WGF2201TCE
R87: 10K; R_0402_1005Metric
R88, R93: 22R; R_0603_1608Metric; MPN 0603WAF220JT5E
R89, R96: 0R; R_0603_1608Metric; MPN 0603WAF0000T5E
R90: 51K; R_0402_1005Metric; MPN 0402WGF5102TCE
R91, R92: 100K; R_0402_1005Metric; MPN 0402WGF1003TCE

Connections:
+3.3V: C75.1, C76.1, Q9.2 (S), R25.2, R86.1, R91.2
+5V: R89.1, R96.2
Earth: C75.2, C77.2, C78.2, J5.3, J5.4, J5.7, J5.8, J5.15, J5.16, J5.19, J5.20, J5.31, J5.32, Q8.2 (S), R90.1
I2C1_SCL: J5.9, R88.2
I2C1_SDA: J5.10, R93.1
LCD0_BL_PWM4: J5.14
LCD_PWREN_H: J5.13
MIPI_DSI_TX0_CLKN: J5.30
MIPI_DSI_TX0_CLKP: J5.29
MIPI_DSI_TX0_D0N: J5.40
MIPI_DSI_TX0_D0P: J5.39
MIPI_DSI_TX0_D1N: J5.38
MIPI_DSI_TX0_D1P: J5.37
MIPI_DSI_TX0_D2N: J5.36
MIPI_DSI_TX0_D2P: J5.35
MIPI_DSI_TX0_D3N: J5.34
MIPI_DSI_TX0_D3P: J5.33
MIPI_DSI_TX1_CLKN: J5.18
MIPI_DSI_TX1_CLKP: J5.17
MIPI_DSI_TX1_D0N: J5.28
MIPI_DSI_TX1_D0P: J5.27
MIPI_DSI_TX1_D1N: J5.26
MIPI_DSI_TX1_D1P: J5.25
MIPI_DSI_TX1_D2N: J5.24
MIPI_DSI_TX1_D2P: J5.23
MIPI_DSI_TX1_D3N: J5.22
MIPI_DSI_TX1_D3P: J5.21
unnamed: C76.2, Q9.1 (B), R91.1, R92.2
unnamed: J5.1, R89.2
unnamed: J5.2, R96.1
unnamed: Q8.1 (B), R87.1, R90.2
unnamed: Q8.3 (D), R92.1
PWM0_M0: R87.2
SPI0_CLK_M0: R86.2, R88.1
SPI0_CS0_M0: J5.11
SPI0_MISO_M0: J5.12
SPI0_MOSI_M0: R25.1, R93.2
VCC3V3_LCD: C77.1, C78.1, J5.5, J5.6, Q9.3 (D)

Notes on the sheet:
DOKUNMATİK EKRAN
POWER
