ihsanakyrk/Eski-Versionlar-Ve-Siparisler/Movita_3566_HXV_Router_V4.0/MicroSD.kicad_sch

## KiCad design Movita_3566_HXV_Router_V4.0/MicroSD.kicad_sch (2025-09-01)

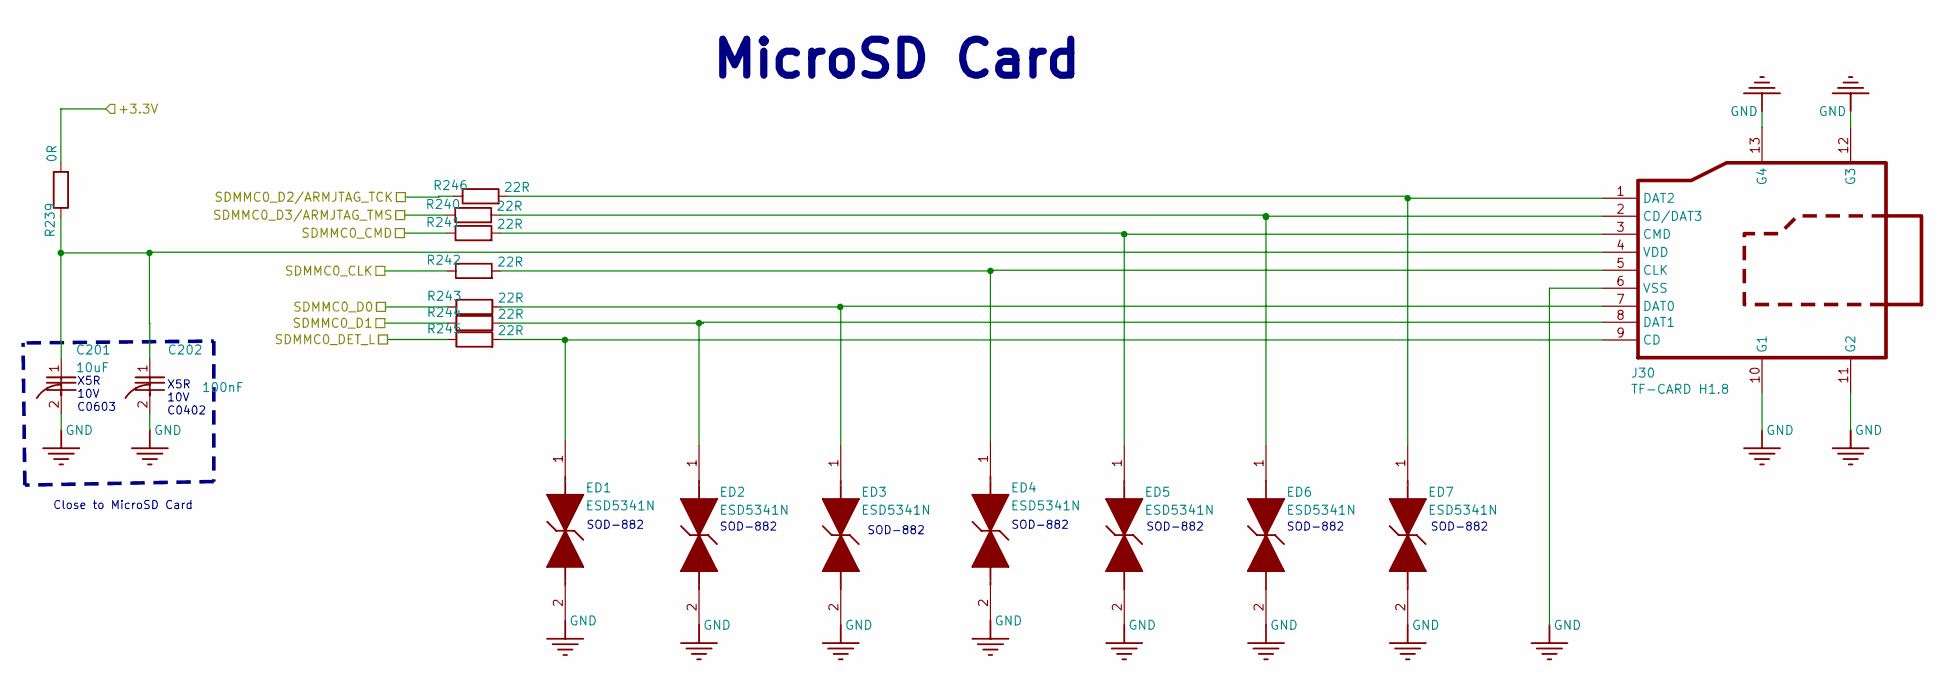
[picture p161: schematic MicroSD.kicad_sch]

Parts:
C201: 10uF; C_0603_1608Metric; MPN CL10A106MO8NQNC
C202: 100nF; C_0402_1005Metric; MPN CC0402KRX7R7BB104
ED1, ED2, ED3, ED4, ED5, ED6, ED7: ESD5341N; MPN ESD5341N
J30: TF-CARD H1.8; MANUFACTURER_PART_NUMBER TFP09-2-12B
R239: 0R; R_0603_1608Metric; MPN 0603WAF0000T5E
R240, R241, R242, R243, R244, R245, R246: 22R; R_0603_1608Metric; MPN 0603WAF220JT5E

Connections:
+3.3V: R239.2
GND: C201.2, C202.2, ED1.2, ED2.2, ED3.2, ED4.2, ED5.2, ED6.2, ED7.2, J30.6 (VSS), J30.10 (G1), J30.11 (G2), J30.12 (G3), J30.13 (G4)
unnamed: C201.1, C202.1, J30.4 (VDD), R239.1
unnamed: ED1.1, J30.9 (CD), R245.2
unnamed: ED2.1, J30.8 (DAT1), R244.2
unnamed: ED3.1, J30.7 (DAT0), R243.2
unnamed: ED4.1, J30.5 (CLK), R242.2
unnamed: ED5.1, J30.3 (CMD), R241.2
unnamed: ED6.1, J30.2 (CD/DAT3), R240.2
unnamed: ED7.1, J30.1 (DAT2), R246.2
SDMMC0_CLK: R242.1
SDMMC0_CMD: R241.1
SDMMC0_D0: R243.1
SDMMC0_D1: R244.1
SDMMC0_D2/ARMJTAG_TCK: R246.1
SDMMC0_D3/ARMJTAG_TMS: R240.1
SDMMC0_DET_L: R245.1

Notes on the sheet:
SOD-882
MicroSD Card
X5R 10V C0402
X5R 10V C0603
Close to MicroSD Card
