ihsanakyrk/Eski-Versionlar-Ve-Siparisler/Movita_3566_HXV_Router_V4.0/PCIE.kicad_sch

## KiCad design Movita_3566_HXV_Router_V4.0/PCIE.kicad_sch (2025-09-01)

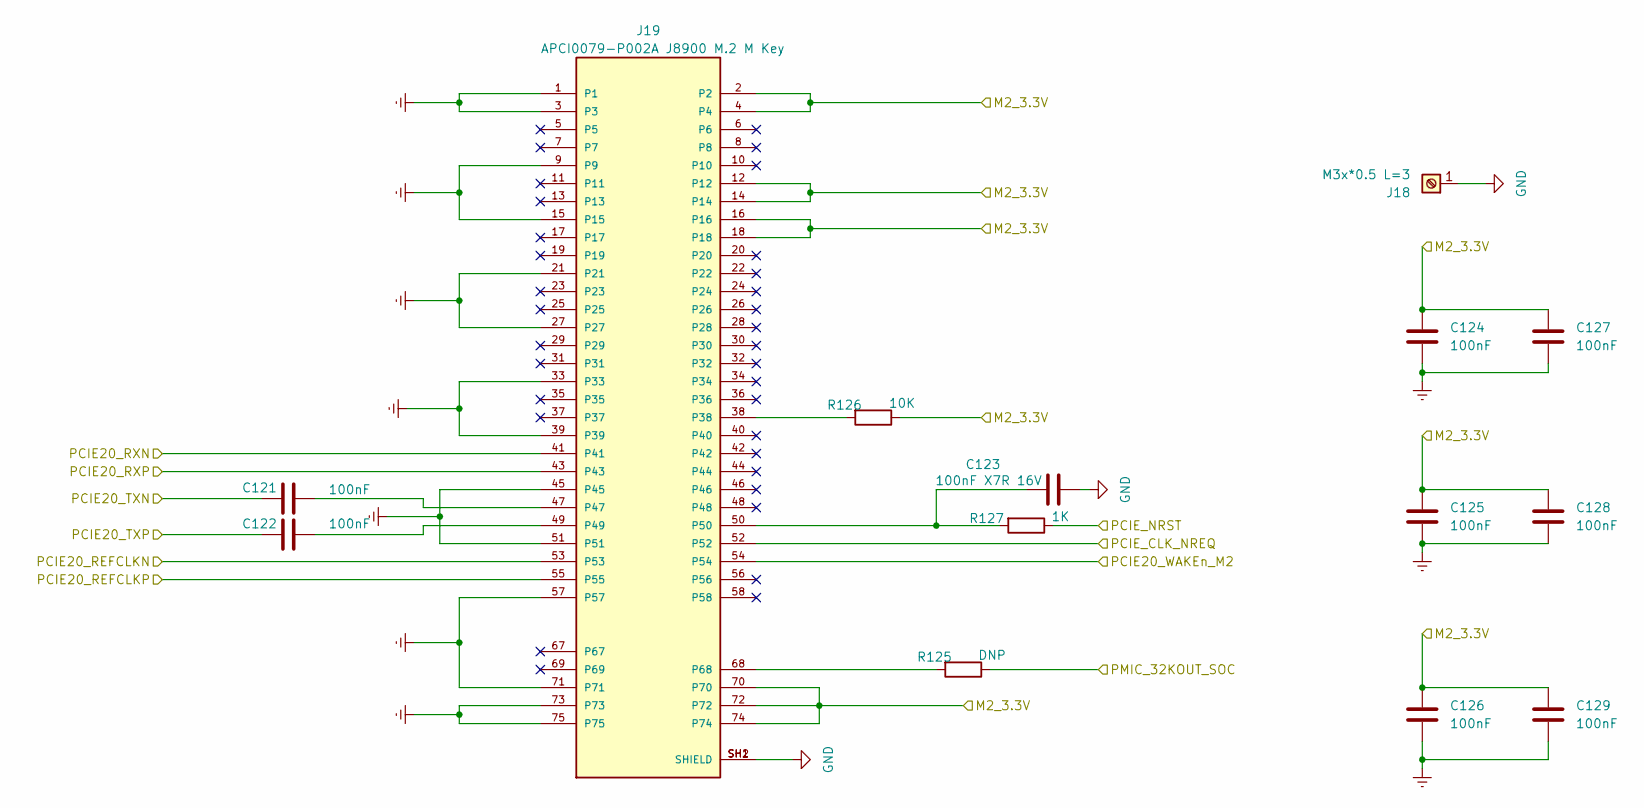
[picture p162: schematic PCIE.kicad_sch]

Parts:
C121, C122: 100nF; C_0402_1005Metric; MPN CC0402KRX7R7BB104
C123: 100nF X7R 16V; C_0402_1005Metric; MPN CC0402KRX7R7BB104
C124, C125, C126, C127, C128, C129: 100nF; C_0603_1608Metric; MPN 0603B104K500NT
J18: M3x*0.5 L=3; Screw Terminal Shinbo; MPN SMTSO-M3-3ET
J19: APCI0079-P002A J8900 M.2 M Key; MPN NGFF 67P连接器 M.2 SSD插槽 4+5 H3.2
R125: DNP; R_0603_1608Metric
R126: 10K; R_0402_1005Metric
R127: 1K; R_0402_1005Metric; MPN 0402WGF1001TCE

Connections:
Earth: C124.2, C125.2, C126.2, C127.2, C128.2, C129.2, J19.1, J19.3, J19.9, J19.15, J19.21, J19.27, J19.33, J19.39, J19.45, J19.51, J19.57, J19.71, J19.73, J19.75
GND: C123.2, J18.1, J19.SH1 (SHIELD), J19.SH2 (SHIELD)
M2_3.3V: C124.1, C125.1, C126.1, C127.1, C128.1, C129.1, J19.2, J19.4, J19.12, J19.14, J19.16, J19.18, J19.70, J19.72, J19.74, R126.1
unnamed: C121.2, J19.47
unnamed: C122.2, J19.49
unnamed: C123.1, J19.50, R127.2
unnamed: J19.38, R126.2
unnamed: J19.68, R125.2
PCIE20_REFCLKN: J19.53
PCIE20_REFCLKP: J19.55
PCIE20_RXN: J19.41
PCIE20_RXP: J19.43
PCIE20_TXN: C121.1
PCIE20_TXP: C122.1
PCIE20_WAKEn_M2: J19.54
PCIE_CLK_NREQ: J19.52
PCIE_NRST: R127.1
PMIC_32KOUT_SOC: R125.1
