ihsanakyrk/Eski-Versionlar-Ve-Siparisler/Movita_3566_HXV_Router_V4.0/Power_Unit.kicad_sch

## KiCad design Movita_3566_HXV_Router_V4.0/Power_Unit.kicad_sch (2025-09-01)

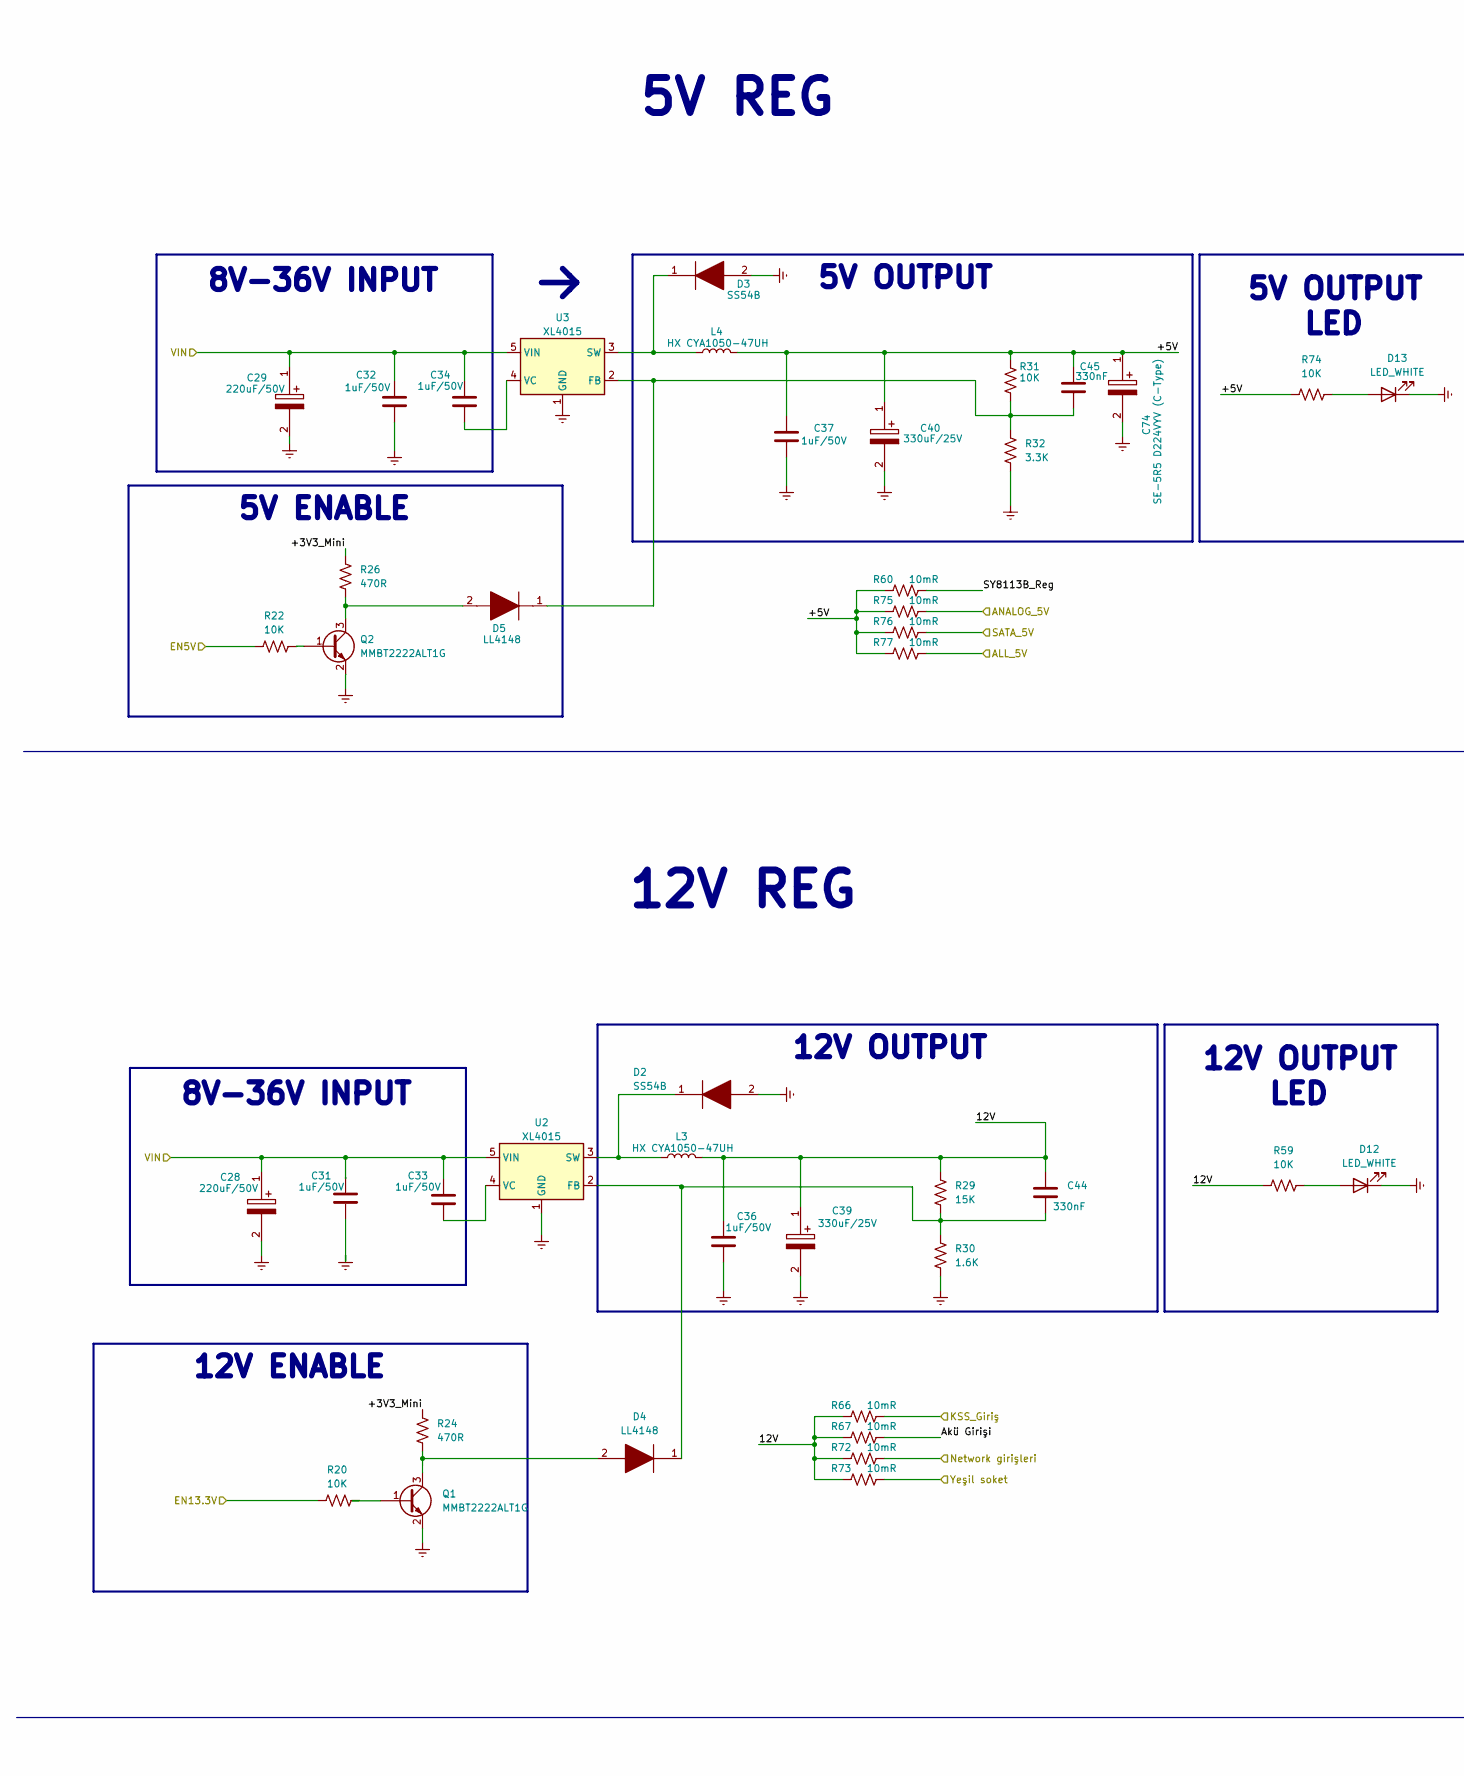
[picture p163: schematic Power_Unit.kicad_sch, part in row 1, column 1]

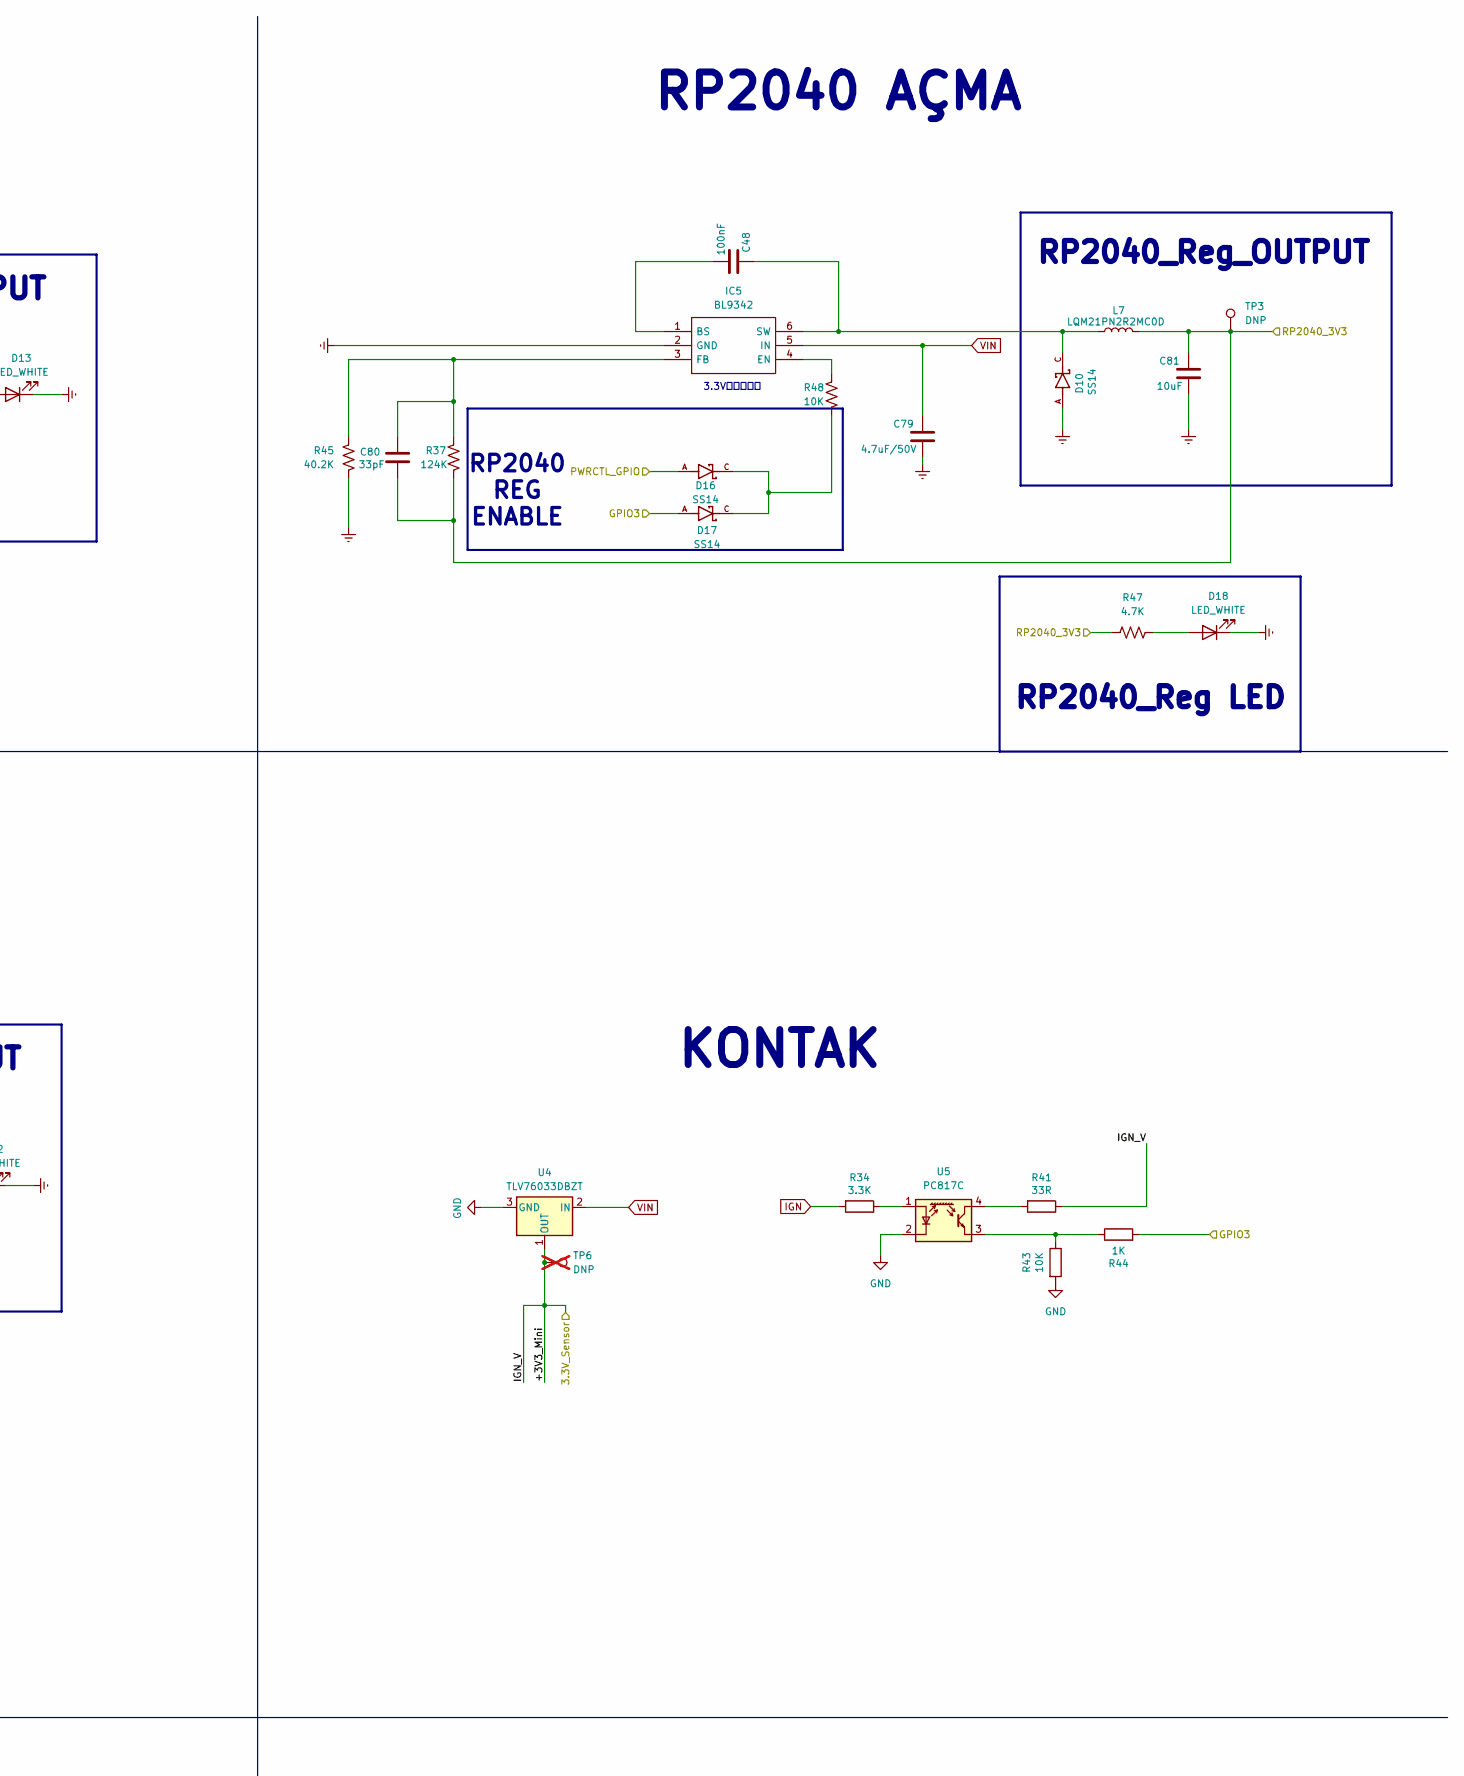
[picture p164: schematic Power_Unit.kicad_sch, part in row 1, column 2]

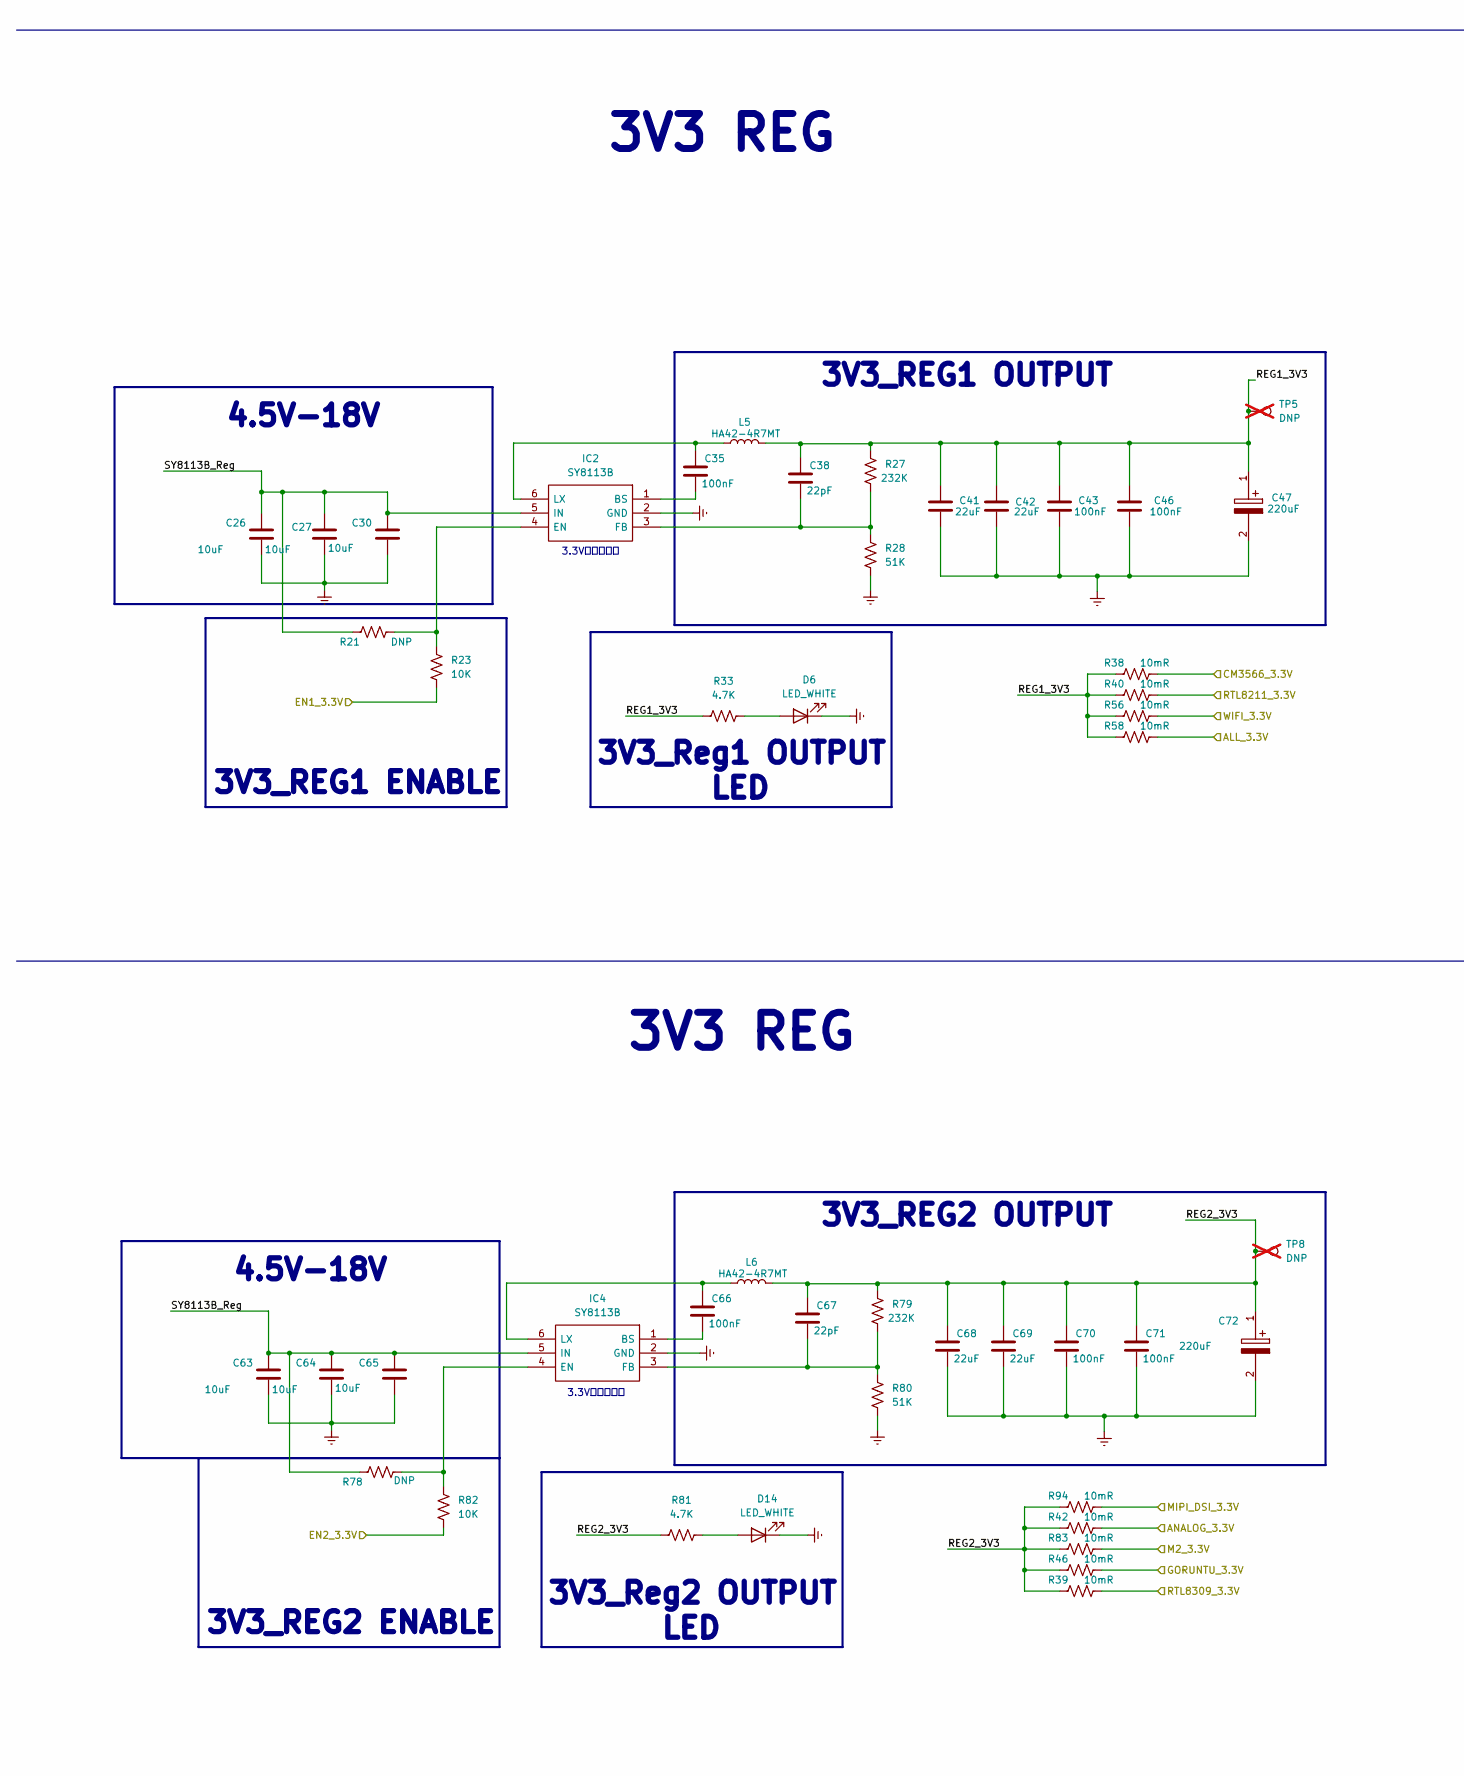
[picture p165: schematic Power_Unit.kicad_sch, part in row 2, column 1]

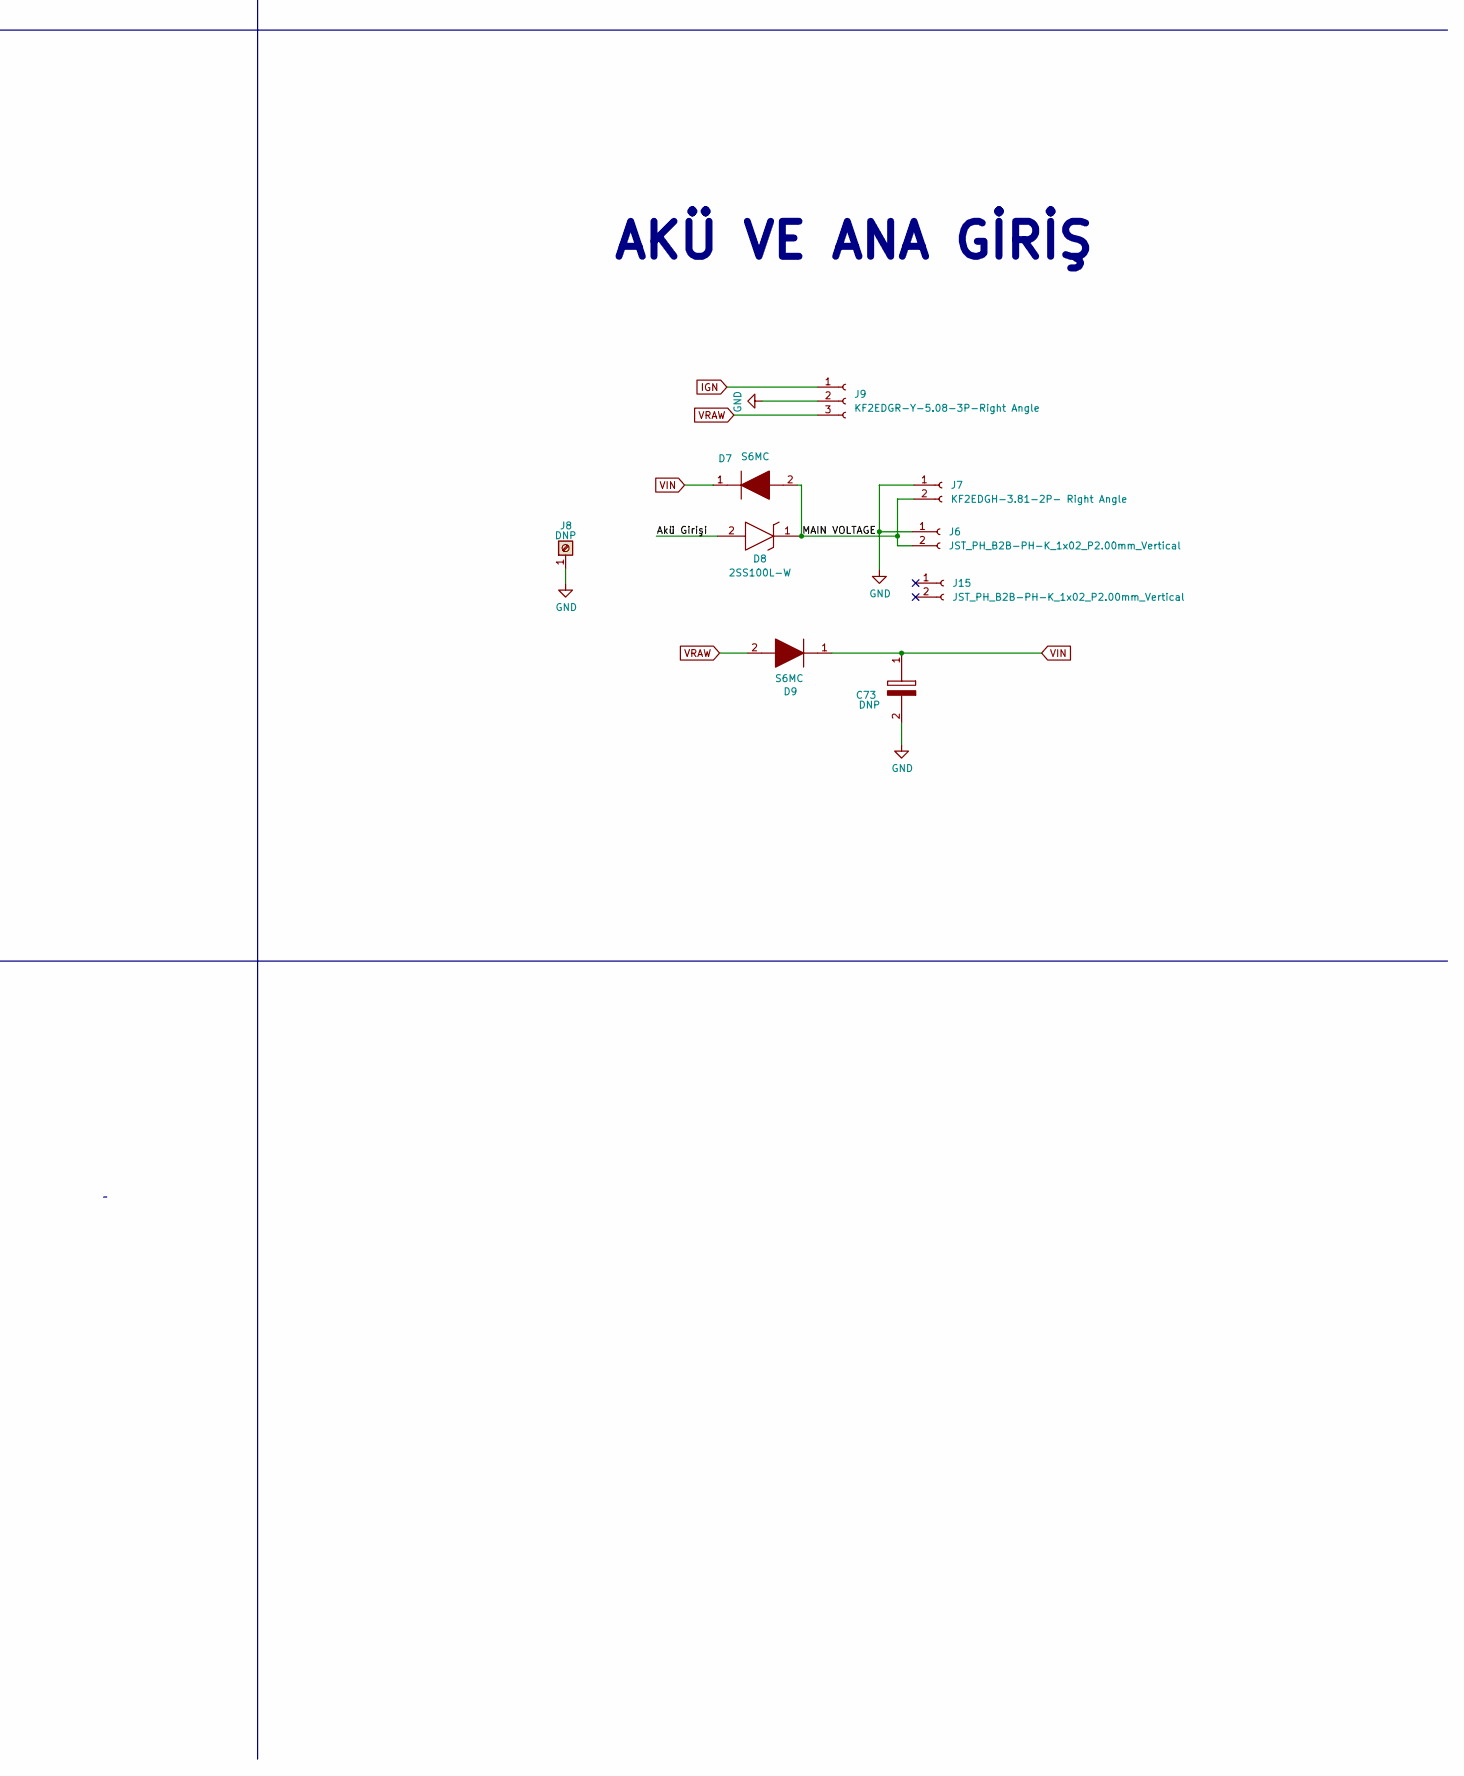
[picture p166: schematic Power_Unit.kicad_sch, part in row 2, column 2]

Parts:
C26, C27, C30, C63, C64, C65, C81: 10uF; C_0603_1608Metric; MPN CL10A106MO8NQNC
C28, C29: 220uF/50V; C_Elec_10x10.2; Manufacturer_Part_Number RVT220UF50V67RV0021
C31, C32, C33, C34, C36, C37: 1uF/50V; C_0603_1608Metric; MPN CL10A105KB8NNNC
C35, C43, C46, C48, C66, C70, C71: 100nF; C_0603_1608Metric; MPN 0603B104K500NT
C38, C67: 22pF; C_0603_1608Metric; MPN CL10C220JB8NNNC
C39, C40: 330uF/25V; C_Elec_8x10.2; Manufacturer_Part_Number RVT330UF25V167RV0055
C41, C42, C68, C69: 22uF; C_0603_1608Metric; MPN CL10A226MQ8NRNC
C44, C45: 330nF; C_0603_1608Metric; MPN 0603B334K250NT
C47, C72: 220uF; CP_Elec_6.3x7.7; Manufacturer_Part_Number RVT220UF16V67RV0015
C73: DNP; ERZV14D220; MPN ERZV14D220
C74: SE-5R5 D224VYV (C-Type); SuperCapacitor
C79: 4.7uF/50V; C_0603_1608Metric
C80: 33pF; C_0603_1608Metric; MPN CL10C330JB8NNNC
D2, D3: SS54B; Manufacturer_Part_Number SS54B
D4, D5: LL4148; MPN LL4148
D6, D12, D13, D14, D18: LED_WHITE; LED_0603_1608Metric; MPN 0603 翠绿色 LED
D7, D9: S6MC; Manufacturer_Part_Number SS54B; Mouser Part Number S6MC
D8: 2SS100L-W; 2SS100LW; Manufacturer_Part_Number 2SS100L-W; Mouser Part Number 583-2SS100L-W
D10, D16, D17: SS14; MPN SS14 SOD-123FL
IC2, IC4: SY8113B; Manufacturer_Part_Number SY8113B
IC5: BL9342; SOT-23-6; MPN BL9342
J6, J15: JST_PH_B2B-PH-K_1x02_P2.00mm_Vertical; MPN JST_PH_B2B-PH-K_1x02_P2.00mm_Vertical
J7: KF2EDGH-3.81-2P- Right Angle; KF2EDGH-3.81-2P; MPN KF2EDGV-3.81 2p 直针
J8: DNP; Screw Terminal Shinbo
J9: KF2EDGR-Y-5.08-3P-Right Angle; MPN KF2EDG -3P 5.08 封口 弯
L3, L4: HX CYA1050-47UH; L_Bourns_SRR1208_12.7x12.7mm; MPN HX CYA1050-47UH
L5, L6: HA42-4R7MT; Inductor_0402_4.7uH; MPN HA42-4R7MT
L7: LQM21PN2R2MC0D; L_0805_2012Metric; MPN LQM21PN2R2MC0D
Q1, Q2: MMBT2222ALT1G; MPN MMBT2222A
R20, R22, R23, R31, R43, R48, R59, R74, R82: 10K; R_0603_1608Metric; MPN 0603WAF1002T5E
R21, R78: DNP; R_0603_1608Metric
R24, R26: 470R; R_0603_1608Metric; MPN 0603WAF4700T5E
R27, R79: 232K; R_0603_1608Metric; MPN FRC0603F2323TS
R28, R80: 51K; R_0603_1608Metric; MPN 0603WAF5102T5E
R29: 15K; R_0603_1608Metric; MPN 0603WAF1502T5E
R30: 1.6K; R_0603_1608Metric; MPN 0603WAF1601T5E
R32, R34: 3.3K; R_0603_1608Metric; MPN 0603WAF3301T5E
R33, R47, R81: 4.7K; R_0603_1608Metric; MPN 0603WAF4701T5E
R37: 124K; R_0603_1608Metric
R38, R39, R40, R42, R46, R56, R58, R60, R66, R67, R72, R73, R75, R76, R77, R83, R94: 10mR; R_1206_3216Metric
R41: 33R; R_0603_1608Metric; MPN 0603WAF330JT5E
R44: 1K; R_0603_1608Metric; MPN 0603WAF1001T5E
R45: 40.2K; R_0603_1608Metric
TP3: DNP; TestPoint_Pad_1.0x1.0mm
TP5, TP6, TP8: DNP; TestPoint_Pad_1.0x1.0mm; not fitted
U2, U3: XL4015; TO-263-5_TabPin3; MPN XL4015
U4: TLV76033DBZT; SOT-23; MPN TLV76033DBZT
U5: PC817C; PC817; MPN PC817C_4PIN_SMD

Connections:
12V: C36.2, C39.1, C44.2, L3.2, R29.1, R59.1, R66.1, R67.1, R72.1, R73.1
+3V3_Mini: R24.1, R26.1, R41.1, TP6.1, U4.1 (OUT)
+5V: C37.2, C40.1, C45.2, C74.1, L4.2, R31.1, R60.1, R74.1, R75.1, R76.1, R77.1
ALL_3.3V: R58.2
ALL_5V: R77.2
ANALOG_3.3V: R42.2
ANALOG_5V: R75.2
Akü Girişi: D8.2, R67.2
CM3566_3.3V: R38.2
EN1_3.3V: R23.2
EN2_3.3V: R82.2
EN5V: R22.1
EN13.3V: R20.1
Earth: C26.1, C27.1, C28.2, C29.2, C30.1, C31.1, C32.1, C36.1, C37.1, C39.2, C40.2, C41.1, C42.1, C43.1, C46.1, C47.2, C63.1, C64.1, C65.1, C68.1, C69.1, C70.1, C71.1, C72.2, C74.2, C79.1, C81.1, D2.2, D3.2, D6.1 (K), D10.A, D12.1 (K), D13.1 (K), D14.1 (K), D18.1 (K), IC2.2 (GND), IC4.2 (GND), IC5.2 (GND), Q1.2 (E), Q2.2 (E), R28.2, R30.2, R32.2, R45.2, R80.2, U2.1 (GND), U3.1 (GND)
GND: C73.2, J6.1, J7.1, J8.1, J9.2, R43.2, U4.3 (GND), U5.2 (K)
GORUNTU_3.3V: R46.2
GPIO3: D17.A, R44.2
IGN: J9.1, R34.2
KSS_Giriş: R66.2
M2_3.3V: R83.2
MAIN VOLTAGE: D7.2, D8.1, J6.2, J7.2
MIPI_DSI_3.3V: R94.2
unnamed: C33.1, U2.4 (VC)
unnamed: C34.1, U3.4 (VC)
unnamed: C35.1, IC2.1 (BS)
unnamed: C35.2, IC2.6 (LX), L5.1
unnamed: C38.1, IC2.3 (FB), R27.2, R28.1
unnamed: C44.1, D4.1, R29.2, R30.1, U2.2 (FB)
unnamed: C45.1, D5.1, R31.2, R32.1, U3.2 (FB)
unnamed: C48.1, IC5.1 (BS)
unnamed: C48.2, D10.C, IC5.6 (SW), L7.2
unnamed: C66.1, IC4.1 (BS)
unnamed: C66.2, IC4.6 (LX), L6.1
unnamed: C67.1, IC4.3 (FB), R79.2, R80.1
unnamed: C80.2, IC5.3 (FB), R37.1, R45.1
unnamed: D2.1, L3.1, U2.3 (SW)
unnamed: D3.1, L4.1, U3.3 (SW)
unnamed: D4.2, Q1.3 (C), R24.2
unnamed: D5.2, Q2.3 (C), R26.2
unnamed: D6.2 (A), R33.2
unnamed: D12.2 (A), R59.2
unnamed: D13.2 (A), R74.2
unnamed: D14.2 (A), R81.2
unnamed: D16.C, D17.C, R48.2
unnamed: D18.2 (A), R47.2
unnamed: IC2.4 (EN), R21.2, R23.1
unnamed: IC4.4 (EN), R78.2, R82.1
unnamed: IC5.4 (EN), R48.1
unnamed: Q1.1 (B), R20.2
unnamed: Q2.1 (B), R22.2
unnamed: R34.1, U5.1 (A)
unnamed: R41.2, U5.4 (C)
unnamed: R43.1, R44.1, U5.3 (E)
Network girişleri: R72.2
PWRCTL_GPIO: D16.A
REG1_3V3: C38.2, C41.2, C42.2, C43.2, C46.2, C47.1, L5.2, R27.1, R33.1, R38.1, R40.1, R56.1, R58.1, TP5.1
REG2_3V3: C67.2, C68.2, C69.2, C70.2, C71.2, C72.1, L6.2, R39.1, R42.1, R46.1, R79.1, R81.1, R83.1, R94.1, TP8.1
RP2040_3V3: C80.1, C81.2, L7.1, R37.2, R47.1, TP3.1
RTL8211_3.3V: R40.2
RTL8309_3.3V: R39.2
SATA_5V: R76.2
SY8113B_Reg: C26.2, C27.2, C30.2, C63.2, C64.2, C65.2, IC2.5 (IN), IC4.5 (IN), R21.1, R60.2, R78.1
VIN: C28.1, C29.1, C31.2, C32.2, C33.2, C34.2, C73.1, C79.2, D7.1, D9.1, IC5.5 (IN), U2.5 (VIN), U3.5 (VIN), U4.2 (IN)
VRAW: D9.2, J9.3
WIFI_3.3V: R56.2
Yeşil soket: R73.2

Notes on the sheet:
3.3V输出应用图
RP2040 AÇMA
5V REG
4.5V-18V
KONTAK
3V3_Reg1 OUTPUT
12V OUTPUT
12V REG
3V3 REG
12V ENABLE
3V3_REG2 ENABLE
3V3_REG1 OUTPUT
LED
3V3_Reg2 OUTPUT
3V3_REG2 OUTPUT
8V-36V INPUT
5V OUTPUT
5V ENABLE
AKÜ VE ANA GİRİŞ
3V3_REG1 ENABLE
RP2040_Reg_OUTPUT
RP2040_Reg LED
RP2040 REG ENABLE
