ihsanakyrk/Eski-Versionlar-Ve-Siparisler/Movita_3566_HXV_Router_V4.0/RP2040.kicad_sch

## KiCad design Movita_3566_HXV_Router_V4.0/RP2040.kicad_sch (2025-09-01)

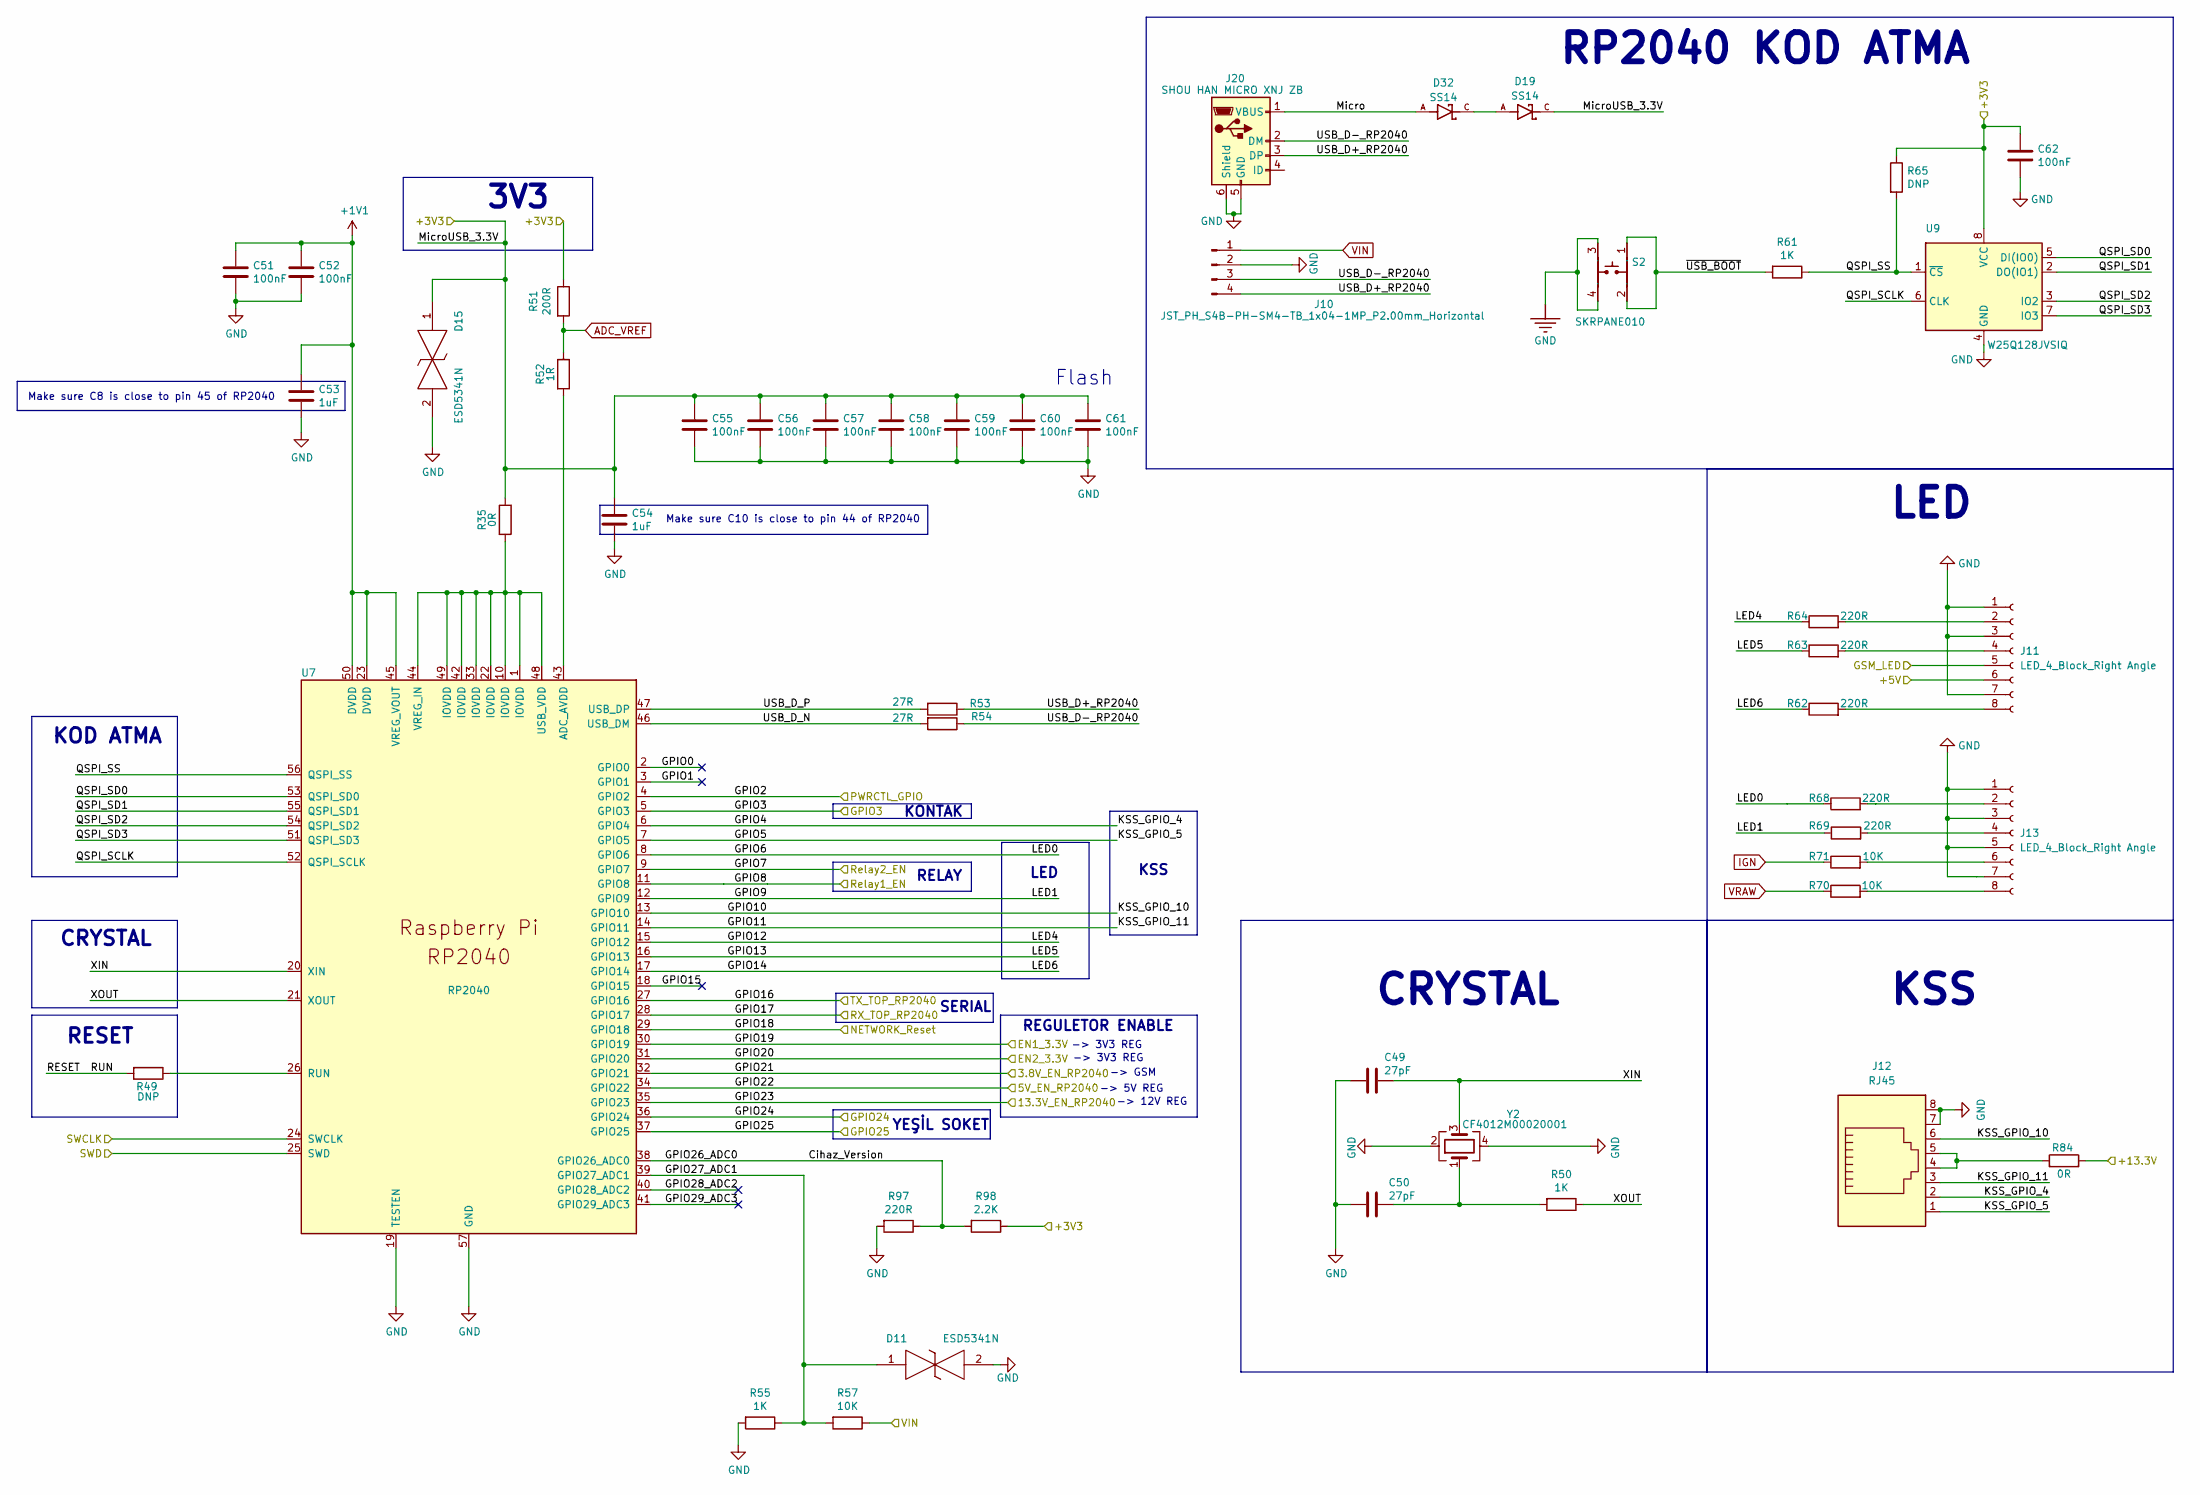
[picture p167: schematic RP2040.kicad_sch]

Parts:
C49, C50: 27pF; C_0603_1608Metric; MPN 0603CG270J500NT
C51, C52, C55, C56, C57, C58, C59, C60, C61, C62: 100nF; C_0402_1005Metric; MPN CC0402KRX7R7BB104
C53, C54: 1uF; C_0603_1608Metric; MPN CL10A105KB8NNNC
D11, D15: ESD5341N; Manufacturer_Part_Number SP0402B-ULC-01ETG; Mouser Part Number 576-SP0402BULC-01ETG
D19, D32: SS14; MPN SS14 SOD-123FL
J10: JST_PH_S4B-PH-SM4-TB_1x04-1MP_P2.00mm_Horizontal
J11, J13: LED_4_Block_Right Angle; LED_4_Block; MPN 3mm四孔灯座带灯
J12: RJ45; RJ45_Amphenol_54602-x08_Horizontal; MPN 黑色 RJ45 8P
J20: SHOU HAN MICRO XNJ ZB; Micro-B SMD; MPN SHOU HAN MICRO XNJ ZB
R35: 0R; R_0603_1608Metric; MPN 0603WAF100KT5E
R49, R65: DNP; R_0603_1608Metric
R50, R55, R61: 1K; R_0603_1608Metric; MPN 0603WAF1001T5E
R51: 200R; R_0603_1608Metric; MPN 0603WAF2000T5E
R52: 1R; R_0603_1608Metric; MPN 0603WAF100KT5E
R53, R54: 27R; R_0603_1608Metric; MPN 0603WAF270JT5E
R57, R70, R71: 10K; R_0603_1608Metric; MPN 0603WAF1002T5E
R62, R63, R64, R68, R69, R97: 220R; R_0603_1608Metric; MPN 0603WAF2200T5E
R84: 0R; R_0603_1608Metric; MPN 0603WAF0000T5E
R98: 2.2K; R_0603_1608Metric; MPN 0603WAF2201T5E
S2: SKRPANE010
U7: RP2040; RP2040-QFN-56; MPN RP2040
U9: W25Q128JVSIQ; SOIC-8_5.23x5.23mm_P1.27mm; MPN W25Q128JVSIQ
Y2: CF4012M00020001; Crystal_SMD_3225-4Pin_3.2x2.5mm; MPN CF4012M00020001

Connections:
3.8V_EN_RP2040: U7.32 (GPIO21)
5V_EN_RP2040: U7.34 (GPIO22)
13.3V_EN_RP2040: U7.35 (GPIO23)
+1V1: C51.1, C52.1, C53.1, U7.23 (DVDD), U7.45 (VREG_VOUT), U7.50 (DVDD)
+3V3: C54.1, C55.1, C56.1, C57.1, C58.1, C59.1, C60.1, C61.1, C62.1, D15.1, D19.C, R35.1, R51.1, R65.1, R98.1, U9.8 (VCC)
+5V: J11.6
+13.3V: R84.2
ADC_VREF: R51.2, R52.1
Cihaz_Version: R97.1, R98.2, U7.38 (GPIO26_ADC0)
EN1_3.3V: U7.30 (GPIO19)
EN2_3.3V: U7.31 (GPIO20)
GND: C49.2, C50.2, C51.2, C52.2, C53.2, C54.2, C55.2, C56.2, C57.2, C58.2, C59.2, C60.2, C61.2, C62.2, D11.2, D15.2, J10.2, J11.1, J11.3, J11.7, J12.7, J12.8, J13.1, J13.3, J13.5, J13.7, J20.5 (GND), J20.6 (Shield), R55.2, R97.2, S2.3, S2.4, U7.19 (TESTEN), U7.57 (GND), U9.4 (GND), Y2.2, Y2.4
GPIO0: U7.2 (GPIO0)
GPIO1: U7.3 (GPIO1)
GPIO2: U7.4 (GPIO2)
GPIO3: U7.5 (GPIO3)
GPIO4: J12.2, U7.6 (GPIO4)
GPIO5: J12.1, U7.7 (GPIO5)
GPIO6: R68.1, U7.8 (GPIO6)
GPIO7: U7.9 (GPIO7)
GPIO8: U7.11 (GPIO8)
GPIO9: R69.1, U7.12 (GPIO9)
GPIO10: J12.6, U7.13 (GPIO10)
GPIO11: J12.3, U7.14 (GPIO11)
GPIO12: R64.1, U7.15 (GPIO12)
GPIO13: R63.1, U7.16 (GPIO13)
GPIO14: R62.1, U7.17 (GPIO14)
GPIO15: U7.18 (GPIO15)
GPIO16: U7.27 (GPIO16)
GPIO17: U7.28 (GPIO17)
GPIO18: U7.29 (GPIO18)
GPIO24: U7.36 (GPIO24)
GPIO25: U7.37 (GPIO25)
GPIO27_ADC1: D11.1, R55.1, R57.2, U7.39 (GPIO27_ADC1)
GPIO28_ADC2: U7.40 (GPIO28_ADC2)
GPIO29_ADC3: U7.41 (GPIO29_ADC3)
GSM_LED: J11.5
IGN: R71.1
Micro: D32.A, J20.1 (VBUS)
unnamed: C50.1, R50.2, Y2.1
unnamed: D19.A, D32.C
unnamed: J11.2, R64.2
unnamed: J11.4, R63.2
unnamed: J11.8, R62.2
unnamed: J12.4, J12.5, R84.1
unnamed: J13.2, R68.2
unnamed: J13.4, R69.2
unnamed: J13.6, R71.2
unnamed: J13.8, R70.2
unnamed: R35.2, U7.1 (IOVDD), U7.10 (IOVDD), U7.22 (IOVDD), U7.33 (IOVDD), U7.42 (IOVDD), U7.44 (VREG_IN), U7.48 (USB_VDD), U7.49 (IOVDD)
unnamed: R49.1, U7.26 (RUN)
unnamed: R52.2, U7.43 (ADC_AVDD)
QSPI_SCLK: U7.52 (QSPI_SCLK), U9.6 (CLK)
QSPI_SD0: U7.53 (QSPI_SD0), U9.5 (DI(IO0))
QSPI_SD1: U7.55 (QSPI_SD1), U9.2 (DO(IO1))
QSPI_SD2: U7.54 (QSPI_SD2), U9.3 (IO2)
QSPI_SD3: U7.51 (QSPI_SD3), U9.7 (IO3)
QSPI_SS: R61.1, R65.2, U7.56 (QSPI_SS), U9.1 (~CS)
RESET: R49.2
SWCLK: U7.24 (SWCLK)
SWD: U7.25 (SWD)
USB_D+_RP2040: J10.4, J20.3 (DP), R53.1
USB_D-_RP2040: J10.3, J20.2 (DM), R54.1
USB_D_N: R54.2, U7.46 (USB_DM)
USB_D_P: R53.2, U7.47 (USB_DP)
VIN: J10.1, R57.1
VRAW: R70.1
XIN: C49.1, U7.20 (XIN), Y2.3
XOUT: R50.1, U7.21 (XOUT)
~USB_BOOT: R61.2, S2.1, S2.2

Notes on the sheet:
KONTAK
KOD ATMA
LED
YEŞİL SOKET
Make sure C8 is close to pin 45 of RP2040
-> 12V REG
Make sure C10 is close to pin 44 of RP2040
CRYSTAL
KSS
Flash
-> 3V3 REG
RESET
RELAY
3V3
RP2040 KOD ATMA
REGULETOR ENABLE
-> 5V REG
-> GSM
SERIAL
