ihsanakyrk/Eski-Versionlar-Ve-Siparisler/Movita_3566_HXV_Router_V4.0/RTL8201.kicad_sch

## KiCad design Movita_3566_HXV_Router_V4.0/RTL8201.kicad_sch (2025-09-01)

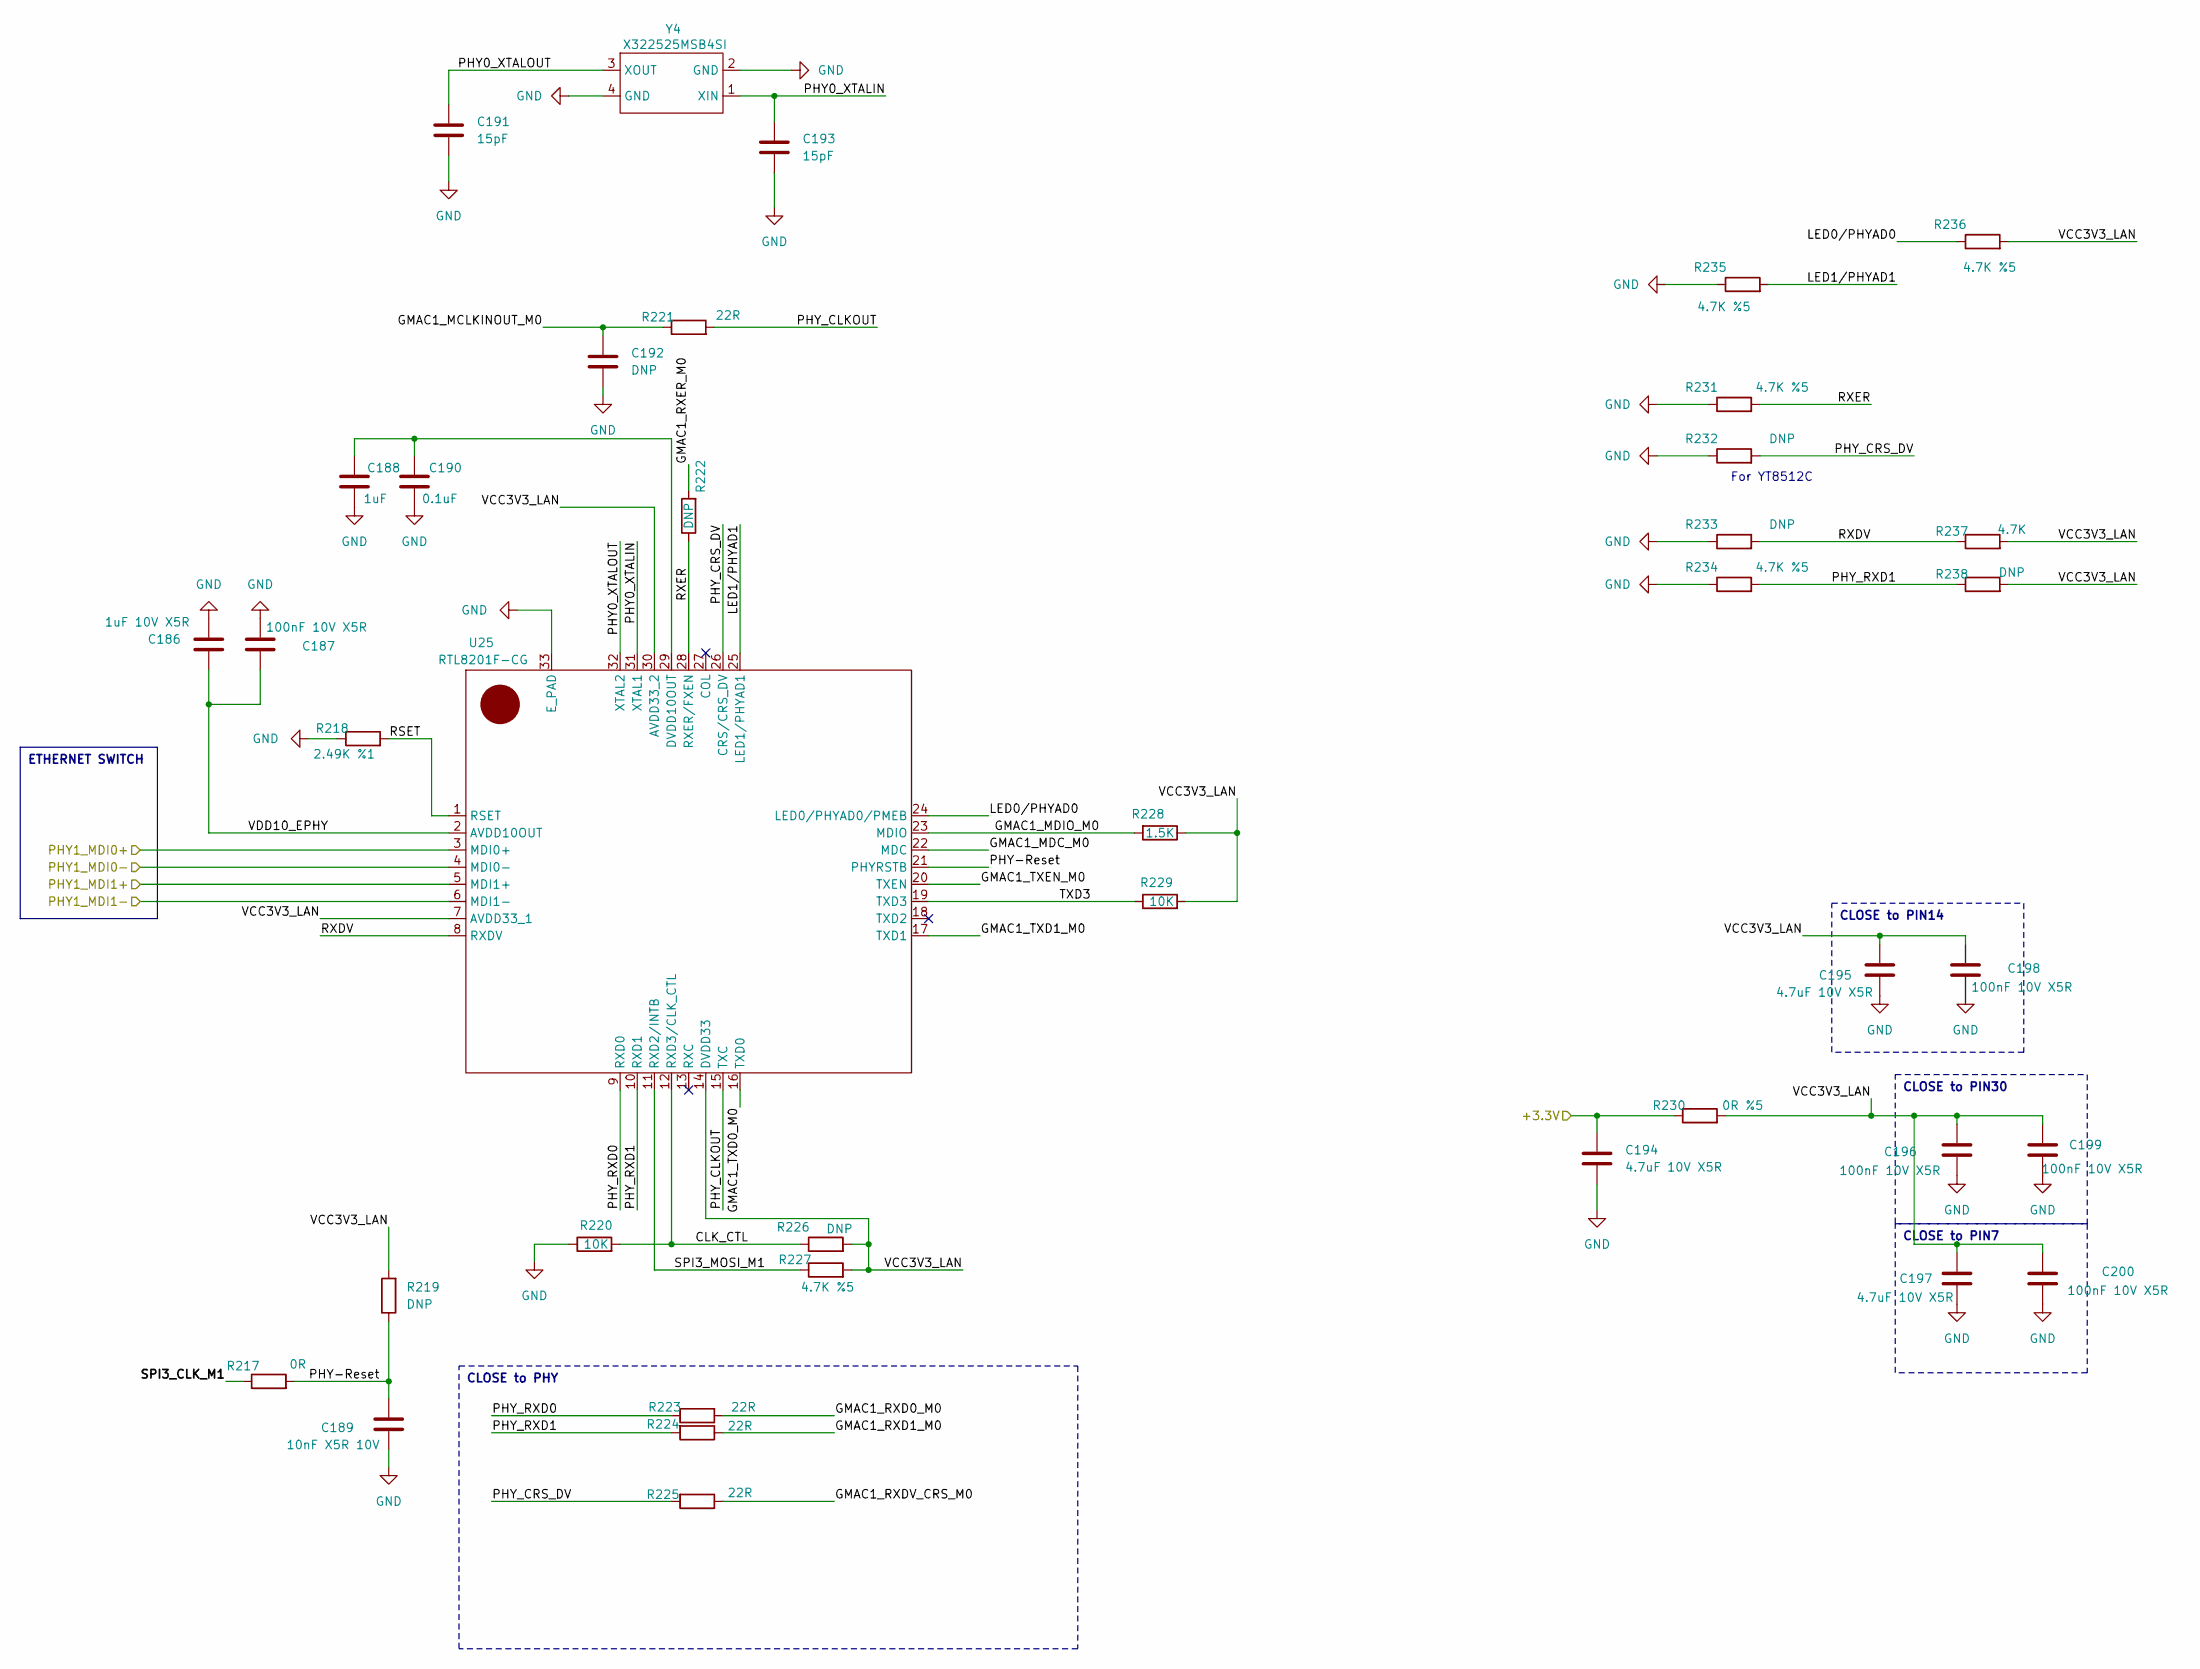
[picture p168: schematic RTL8201.kicad_sch]

Parts:
C186: 1uF 10V X5R; C_0603_1608Metric
C187, C196, C198, C199, C200: 100nF 10V X5R; C_0402_1005Metric
C188: 1uF; C_0402_1005Metric
C189: 10nF X5R 10V; C_0402_1005Metric
C190: 0.1uF; C_0402_1005Metric
C191, C193: 15pF; C_0402_1005Metric
C192: DNP; C_0402_1005Metric
C194, C195, C197: 4.7uF 10V X5R; C_0603_1608Metric
R217: 0R; R_0402_1005Metric
R218: 2.49K %1; R_0402_1005Metric
R219, R222, R226, R232, R233, R238: DNP; R_0402_1005Metric
R220, R229: 10K; R_0402_1005Metric
R221, R223, R224, R225: 22R; R_0402_1005Metric
R227, R231, R234, R235, R236: 4.7K %5; R_0402_1005Metric
R228: 1.5K; R_0402_1005Metric
R230: 0R %5; R_0402_1005Metric
R237: 4.7K; R_0402_1005Metric
U25: RTL8201F-CG; QFN32_5x5; MPN RTL8211F-CG
Y4: X322525MSB4SI; Crystal_SMD_3225-4Pin_3.2x2.5mm; MPN TZ1669D

Connections:
+3.3V: C194.1, R230.1
CLK_CTL: R220.2, R226.1, U25.12 (RXD3/CLK_CTL)
GMAC1_MCLKINOUT_M0: C192.1, R221.1
GMAC1_MDC_M0: U25.22 (MDC)
GMAC1_MDIO_M0: R228.2, U25.23 (MDIO)
GMAC1_RXD0_M0: R223.1
GMAC1_RXD1_M0: R224.1
GMAC1_RXDV_CRS_M0: R225.1
GMAC1_RXER_M0: R222.2
GMAC1_TXD0_M0: U25.16 (TXD0)
GMAC1_TXD1_M0: U25.17 (TXD1)
GMAC1_TXEN_M0: U25.20 (TXEN)
GND: C186.2, C187.2, C188.2, C189.2, C190.2, C191.2, C192.2, C193.2, C194.2, C195.2, C196.2, C197.2, C198.2, C199.2, C200.2, R218.1, R220.1, R231.1, R232.1, R233.1, R234.1, R235.1, U25.33 (E_PAD), Y4.2 (GND), Y4.4 (GND)
LED0/PHYAD0: R236.1, U25.24 (LED0/PHYAD0/PMEB)
LED1/PHYAD1: R235.2, U25.25 (LED1/PHYAD1)
unnamed: C188.1, C190.1, U25.29 (DVDD10OUT)
PHY0_XTALIN: C193.1, U25.31 (XTAL1), Y4.1 (XIN)
PHY0_XTALOUT: C191.1, U25.32 (XTAL2), Y4.3 (XOUT)
PHY1_MDI0+: U25.3 (MDI0+)
PHY1_MDI0-: U25.4 (MDI0-)
PHY1_MDI1+: U25.5 (MDI1+)
PHY1_MDI1-: U25.6 (MDI1-)
PHY-Reset: C189.1, R217.2, R219.1, U25.21 (PHYRSTB)
PHY_CLKOUT: R221.2, U25.15 (TXC)
PHY_CRS_DV: R225.2, R232.2, U25.26 (CRS/CRS_DV)
PHY_RXD0: R223.2, U25.9 (RXD0)
PHY_RXD1: R224.2, R234.2, R238.1, U25.10 (RXD1)
RSET: R218.2, U25.1 (RSET)
RXDV: R233.2, R237.1, U25.8 (RXDV)
RXER: R222.1, R231.2, U25.28 (RXER/FXEN)
SPI3_CLK_M1: R217.1
SPI3_MOSI_M1: R227.1, U25.11 (RXD2/INTB)
TXD3: R229.1, U25.19 (TXD3)
VCC3V3_LAN: C195.1, C196.1, C197.1, C198.1, C199.1, C200.1, R219.2, R226.2, R227.2, R228.1, R229.2, R230.2, R236.2, R237.2, R238.2, U25.7 (AVDD33_1), U25.14 (DVDD33), U25.30 (AVDD33_2)
VDD10_EPHY: C186.1, C187.1, U25.2 (AVDD10OUT)

Notes on the sheet:
CLOSE to PIN30
CLOSE to PIN7
CLOSE to PHY
ETHERNET SWITCH
CLOSE to PIN14
For YT8512C
