ihsanakyrk/Eski-Versionlar-Ve-Siparisler/Movita_3566_HXV_Router_V4.0/RTL8306E.kicad_sch

## KiCad design Movita_3566_HXV_Router_V4.0/RTL8306E.kicad_sch (2025-09-01)

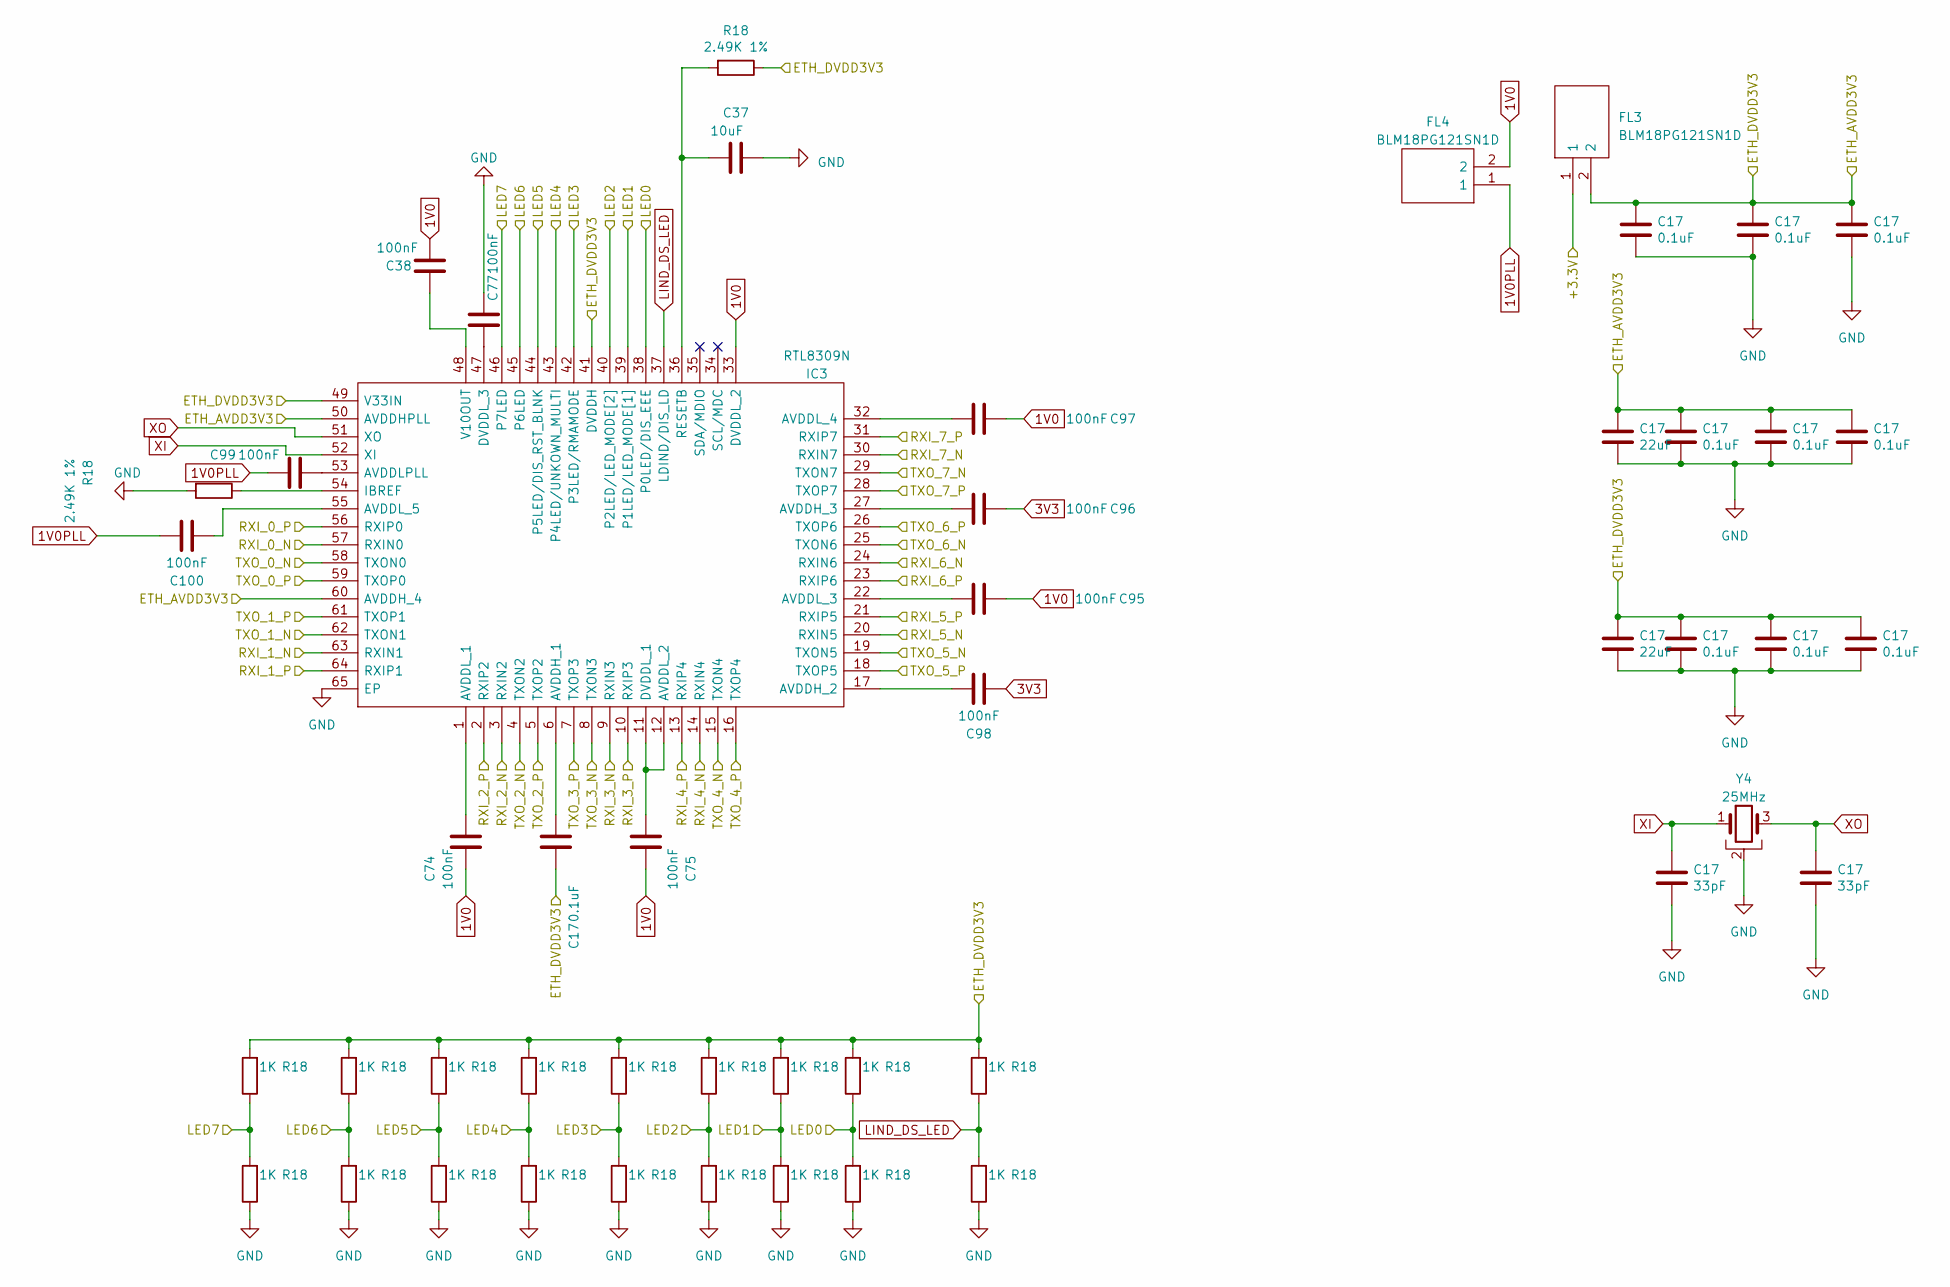
[picture p169: schematic RTL8306E.kicad_sch]

Parts:
C17: 33pF; C_0402_1005Metric
C37: 10uF; C_0603_1608Metric
C38, C74, C75, C77, C95, C96, C97, C98, C99, C100: 100nF; C_0603_1608Metric
FL3, FL4: BLM18PG121SN1D; BLM18AG102BH1D; Manufacturer_Part_Number BLM18PG121SN1D; Mouser Part Number 81-BLM18PG121SN1D
IC3: RTL8309N; QFN50P900X900X90-65N-D; Manufacturer_Part_Number RTL8309N
R18: 1K; R_0603_1608Metric
Y4: 25MHz; Crystal_SMD_3225-4Pin_3.2x2.5mm

Connections:
1V0: C38.2, C74.2, C75.2, C95.2, C97.2, FL4.2, IC3.33 (DVDDL_2)
1V0PLL: C99.2, C100.2, FL4.1
3V3: C96.2, C98.2
+3.3V: FL3.1
ETH_AVDD3V3: C17.1, C17.2, FL3.2, IC3.41 (DVDDH), IC3.49 (V33IN), IC3.50 (AVDDHPLL), IC3.60 (AVDDH_4), R18.1, R18.2
GND: C17.2, C37.2, C77.2, IC3.65 (EP), R18.1, R18.2, Y4.2
LED0: IC3.38 (P0LED/DIS_EEE), R18.1, R18.2
LED1: IC3.39 (P1LED/LED_MODE[1]), R18.1, R18.2
LED2: IC3.40 (P2LED/LED_MODE[2]), R18.1, R18.2
LED3: IC3.42 (P3LED/RMAMODE), R18.1, R18.2
LED4: IC3.43 (P4LED/UNKOWN_MULTI), R18.1, R18.2
LED5: IC3.44 (P5LED/DIS_RST_BLNK), R18.1, R18.2
LED6: IC3.45 (P6LED), R18.1, R18.2
LED7: IC3.46 (P7LED), R18.1, R18.2
LIND_DS_LED: IC3.37 (LDIND/DIS_LD), R18.1, R18.2
unnamed: C17.1, IC3.6 (AVDDH_1)
unnamed: C37.1, IC3.36 (RESETB), R18.2
unnamed: C38.1, IC3.48 (V10OUT)
unnamed: C74.1, IC3.1 (AVDDL_1)
unnamed: C75.1, IC3.11 (DVDDL_1), IC3.12 (AVDDL_2)
unnamed: C77.1, IC3.47 (DVDDL_3)
unnamed: C95.1, IC3.22 (AVDDL_3)
unnamed: C96.1, IC3.27 (AVDDH_3)
unnamed: C97.1, IC3.32 (AVDDL_4)
unnamed: C98.1, IC3.17 (AVDDH_2)
unnamed: C99.1, IC3.53 (AVDDLPLL)
unnamed: C100.1, IC3.55 (AVDDL_5)
unnamed: IC3.54 (IBREF), R18.1
RXI_0_N: IC3.57 (RXIN0)
RXI_0_P: IC3.56 (RXIP0)
RXI_1_N: IC3.63 (RXIN1)
RXI_1_P: IC3.64 (RXIP1)
RXI_2_N: IC3.3 (RXIN2)
RXI_2_P: IC3.2 (RXIP2)
RXI_3_N: IC3.9 (RXIN3)
RXI_3_P: IC3.10 (RXIP3)
RXI_4_N: IC3.14 (RXIN4)
RXI_4_P: IC3.13 (RXIP4)
RXI_5_N: IC3.20 (RXIN5)
RXI_5_P: IC3.21 (RXIP5)
RXI_6_N: IC3.24 (RXIN6)
RXI_6_P: IC3.23 (RXIP6)
RXI_7_N: IC3.30 (RXIN7)
RXI_7_P: IC3.31 (RXIP7)
TXO_0_N: IC3.58 (TXON0)
TXO_0_P: IC3.59 (TXOP0)
TXO_1_N: IC3.62 (TXON1)
TXO_1_P: IC3.61 (TXOP1)
TXO_2_N: IC3.4 (TXON2)
TXO_2_P: IC3.5 (TXOP2)
TXO_3_N: IC3.8 (TXON3)
TXO_3_P: IC3.7 (TXOP3)
TXO_4_N: IC3.15 (TXON4)
TXO_4_P: IC3.16 (TXOP4)
TXO_5_N: IC3.19 (TXON5)
TXO_5_P: IC3.18 (TXOP5)
TXO_6_N: IC3.25 (TXON6)
TXO_6_P: IC3.26 (TXOP6)
TXO_7_N: IC3.29 (TXON7)
TXO_7_P: IC3.28 (TXOP7)
XI: C17.1, IC3.52 (XI), Y4.1
XO: C17.1, IC3.51 (XO), Y4.3
