ihsanakyrk/Eski-Versionlar-Ve-Siparisler/Movita_3566_HXV_Router_V4.0/RTL8309.kicad_sch

## KiCad design Movita_3566_HXV_Router_V4.0/RTL8309.kicad_sch (2025-09-01)

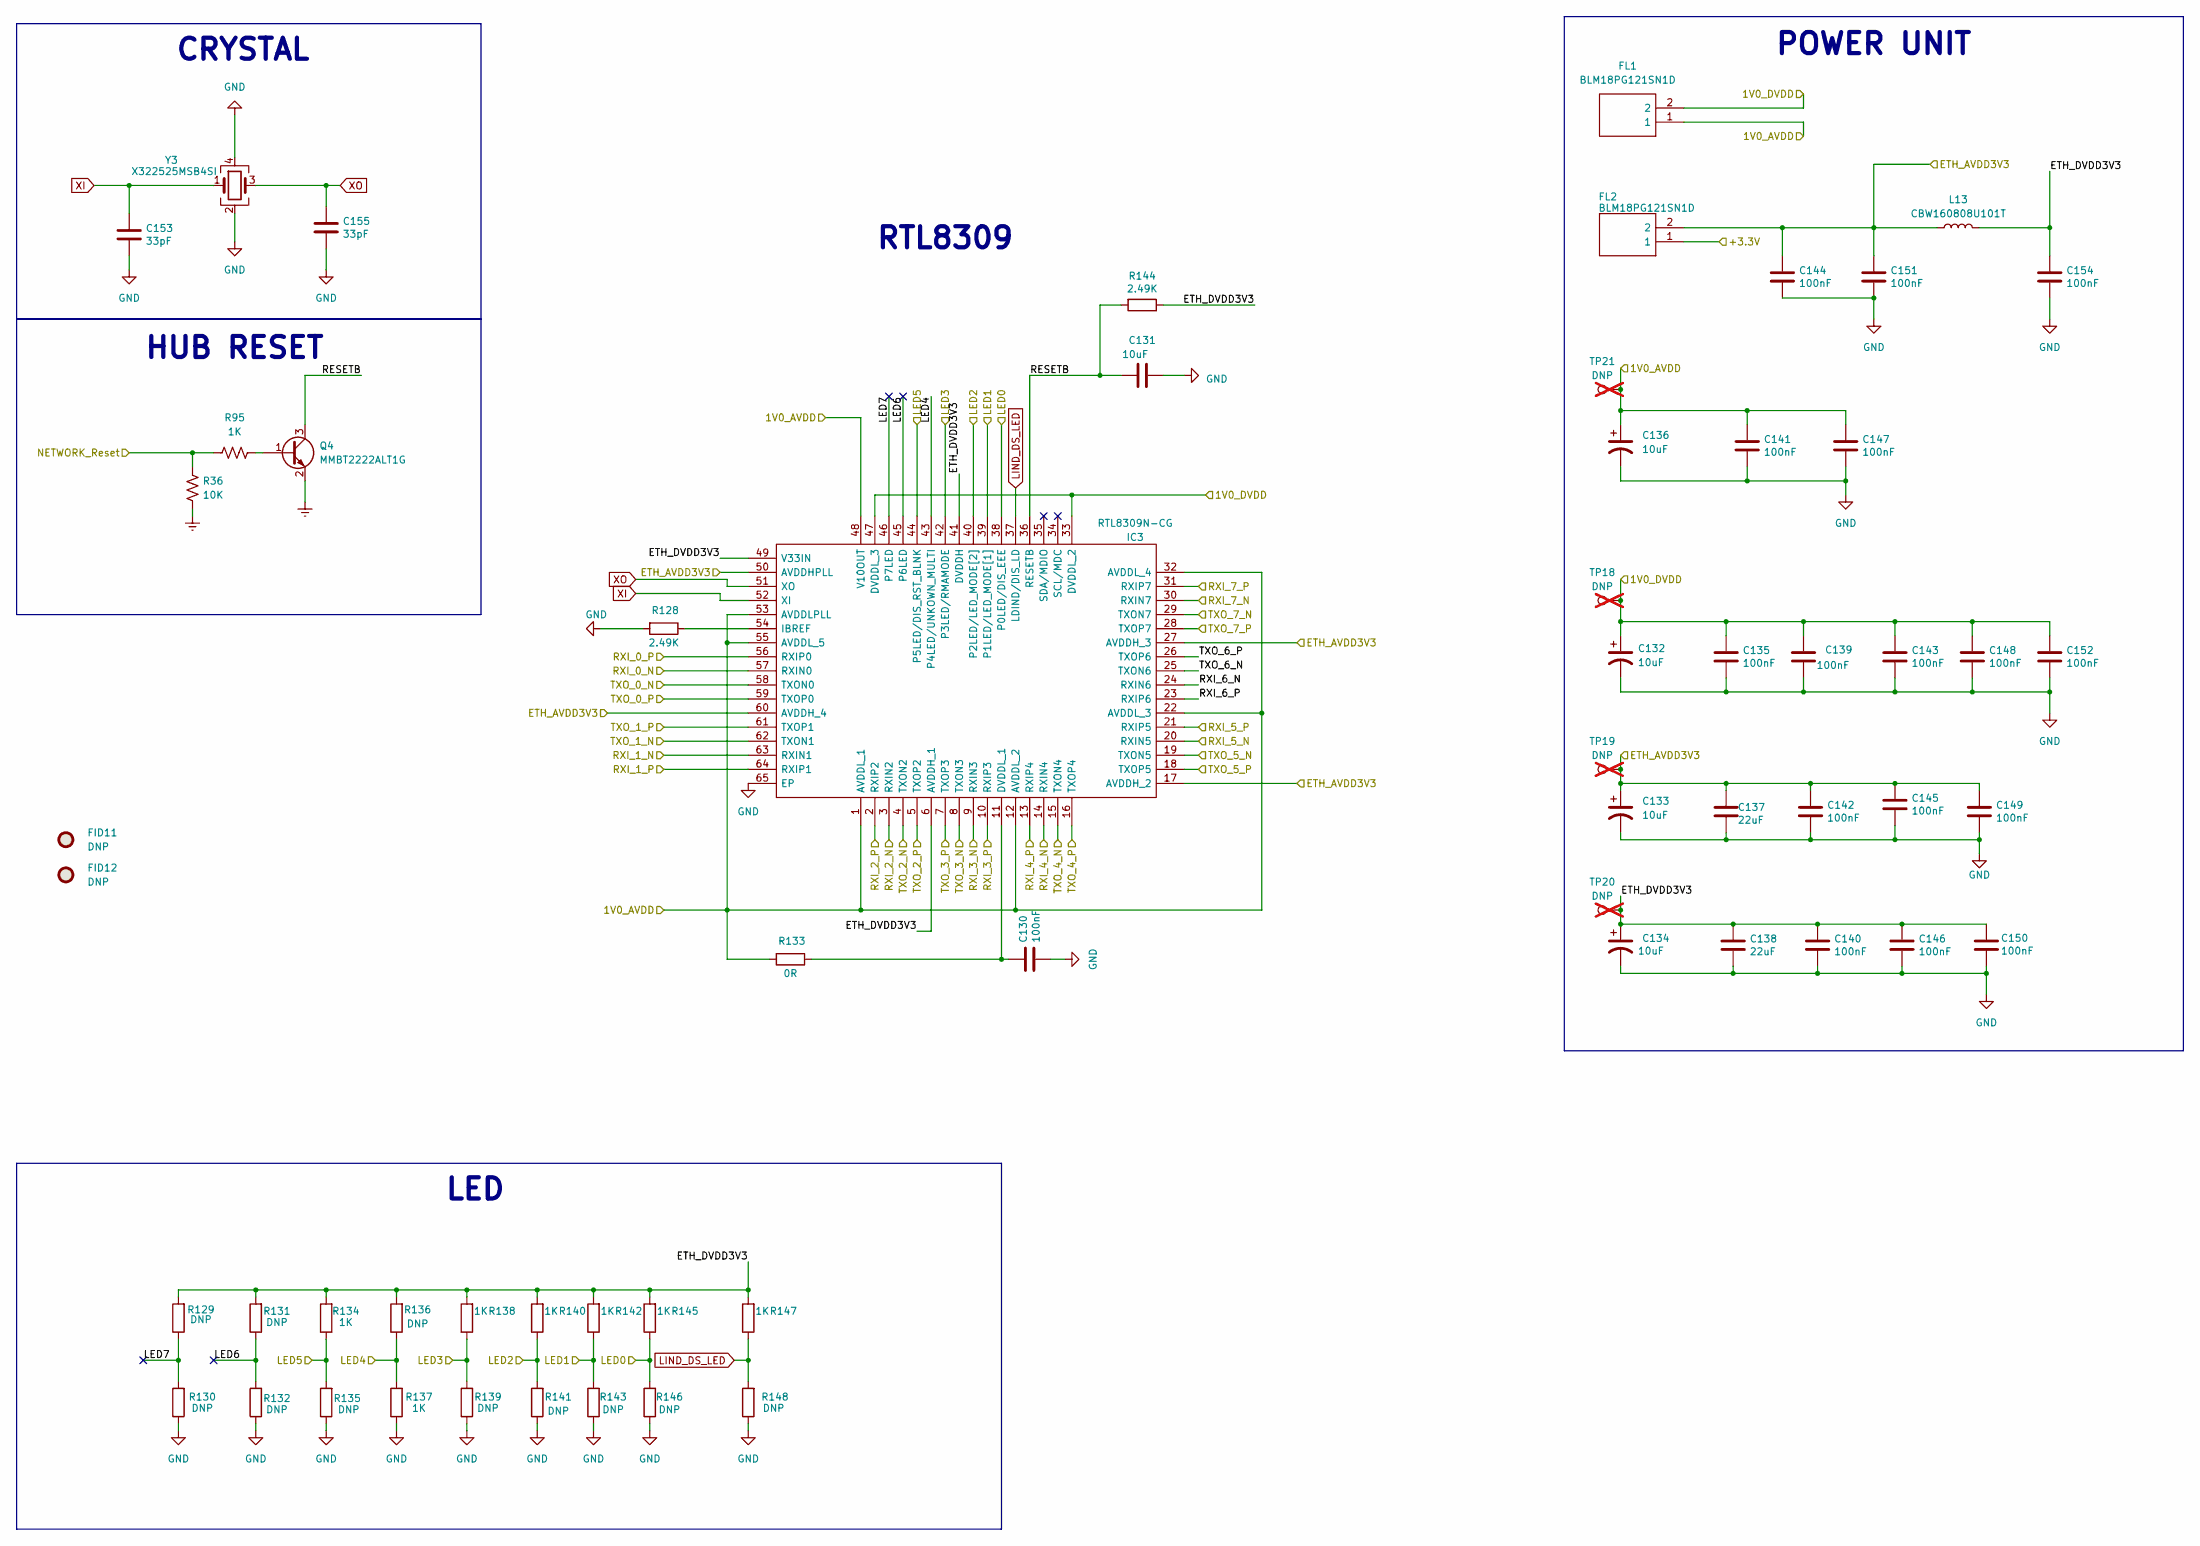
[picture p170: schematic RTL8309.kicad_sch]

Parts:
C130, C135, C139, C140, C141, C142, C143, C144, C145, C146, C147, C148, C149, C150, C151, C152, C154: 100nF; C_0402_1005Metric; MPN CC0402KRX7R7BB104
C131: 10uF; C_0603_1608Metric; MPN CL10A106MO8NQNC
C132, C133, C134, C136: 10uF; C_Elec_3x5.4; MPN UWX1C100MCL2GB
C137, C138: 22uF; C_0603_1608Metric; MPN CL10A226MQ8NRNC
C153, C155: 33pF; C_0603_1608Metric; MPN CL10C330JB8NNNC
FID11, FID12: DNP; Fiducial_0.5mm_Mask1mm
FL1, FL2: BLM18PG121SN1D; BLM18AG102BH1D; Manufacturer_Part_Number BLM18PG121SN1D; Mouser Part Number 81-BLM18PG121SN1D
IC3: RTL8309N-CG; RTL8309N; Manufacturer_Part_Number RTL8309N
L13: CBW160808U101T; L_0603_1608Metric; MPN CBW160808U101T
Q4: MMBT2222ALT1G; MPN MMBT2222A
R36: 10K; R_0603_1608Metric; MPN 0603WAF1002T5E
R95, R134, R137, R138, R140, R142, R145, R147: 1K; R_0603_1608Metric; MPN 0603WAF1001T5E
R128, R144: 2.49K; R_0603_1608Metric; MPN 0603WAF2491T5E
R129, R130, R131, R132, R135, R136, R139, R141, R143, R146, R148: DNP; R_0603_1608Metric
R133: 0R; R_0603_1608Metric; MPN 0603WAF0000T5E
TP18, TP19, TP20, TP21: DNP; TestPoint_Pad_1.0x1.0mm; not fitted
Y3: X322525MSB4SI; Crystal_SMD_3225-4Pin_3.2x2.5mm; MPN X322525MSB4SI

Connections:
1V0_AVDD: C136.1, C141.1, C147.1, FL1.1, IC3.1 (AVDDL_1), IC3.12 (AVDDL_2), IC3.22 (AVDDL_3), IC3.32 (AVDDL_4), IC3.48 (V10OUT), IC3.53 (AVDDLPLL), IC3.55 (AVDDL_5), R133.2, TP21.1
1V0_DVDD: C132.1, C135.1, C139.1, C143.1, C148.1, C152.1, FL1.2, IC3.33 (DVDDL_2), IC3.47 (DVDDL_3), TP18.1
+3.3V: FL2.1
ETH_AVDD3V3: C133.1, C137.1, C142.1, C144.1, C145.1, C149.1, C151.1, FL2.2, IC3.17 (AVDDH_2), IC3.27 (AVDDH_3), IC3.50 (AVDDHPLL), IC3.60 (AVDDH_4), L13.1, TP19.1
ETH_DVDD3V3: C134.1, C138.1, C140.1, C146.1, C150.1, C154.1, IC3.6 (AVDDH_1), IC3.41 (DVDDH), IC3.49 (V33IN), L13.2, R129.2, R131.2, R134.2, R136.2, R138.2, R140.2, R142.2, R144.1, R145.2, R147.2, TP20.1
Earth: Q4.2 (E), R36.2
GND: C130.2, C131.2, C132.2, C133.2, C134.2, C135.2, C136.2, C137.2, C138.2, C139.2, C140.2, C141.2, C142.2, C143.2, C144.2, C145.2, C146.2, C147.2, C148.2, C149.2, C150.2, C151.2, C152.2, C153.2, C154.2, C155.2, IC3.65 (EP), R128.2, R130.1, R132.1, R135.1, R137.1, R139.1, R141.1, R143.1, R146.1, R148.1, Y3.2, Y3.4
LED0: IC3.38 (P0LED/DIS_EEE), R145.1, R146.2
LED1: IC3.39 (P1LED/LED_MODE[1]), R142.1, R143.2
LED2: IC3.40 (P2LED/LED_MODE[2]), R140.1, R141.2
LED3: IC3.42 (P3LED/RMAMODE), R138.1, R139.2
LED4: IC3.43 (P4LED/UNKOWN_MULTI), R136.1, R137.2
LED5: IC3.44 (P5LED/DIS_RST_BLNK), R134.1, R135.2
LED6: IC3.45 (P6LED), R131.1, R132.2
LED7: IC3.46 (P7LED), R129.1, R130.2
LIND_DS_LED: IC3.37 (LDIND/DIS_LD), R147.1, R148.2
NETWORK_Reset: R36.1, R95.1
unnamed: C130.1, IC3.11 (DVDDL_1), R133.1
unnamed: IC3.54 (IBREF), R128.1
unnamed: Q4.1 (B), R95.2
RESETB: C131.1, IC3.36 (RESETB), Q4.3 (C), R144.2
RXI_0_N: IC3.57 (RXIN0)
RXI_0_P: IC3.56 (RXIP0)
RXI_1_N: IC3.63 (RXIN1)
RXI_1_P: IC3.64 (RXIP1)
RXI_2_N: IC3.3 (RXIN2)
RXI_2_P: IC3.2 (RXIP2)
RXI_3_N: IC3.9 (RXIN3)
RXI_3_P: IC3.10 (RXIP3)
RXI_4_N: IC3.14 (RXIN4)
RXI_4_P: IC3.13 (RXIP4)
RXI_5_N: IC3.20 (RXIN5)
RXI_5_P: IC3.21 (RXIP5)
RXI_6_N: IC3.24 (RXIN6)
RXI_6_P: IC3.23 (RXIP6)
RXI_7_N: IC3.30 (RXIN7)
RXI_7_P: IC3.31 (RXIP7)
TXO_0_N: IC3.58 (TXON0)
TXO_0_P: IC3.59 (TXOP0)
TXO_1_N: IC3.62 (TXON1)
TXO_1_P: IC3.61 (TXOP1)
TXO_2_N: IC3.4 (TXON2)
TXO_2_P: IC3.5 (TXOP2)
TXO_3_N: IC3.8 (TXON3)
TXO_3_P: IC3.7 (TXOP3)
TXO_4_N: IC3.15 (TXON4)
TXO_4_P: IC3.16 (TXOP4)
TXO_5_N: IC3.19 (TXON5)
TXO_5_P: IC3.18 (TXOP5)
TXO_6_N: IC3.25 (TXON6)
TXO_6_P: IC3.26 (TXOP6)
TXO_7_N: IC3.29 (TXON7)
TXO_7_P: IC3.28 (TXOP7)
XI: C153.1, IC3.52 (XI), Y3.1
XO: C155.1, IC3.51 (XO), Y3.3

Notes on the sheet:
RTL8309
LED
POWER UNIT
CRYSTAL
HUB RESET
