ihsanakyrk/Eski-Versionlar-Ve-Siparisler/Movita_3566_HXV_Router_V4.0/Relay_switch.kicad_sch

## KiCad design Movita_3566_HXV_Router_V4.0/Relay_switch.kicad_sch (2025-09-01)

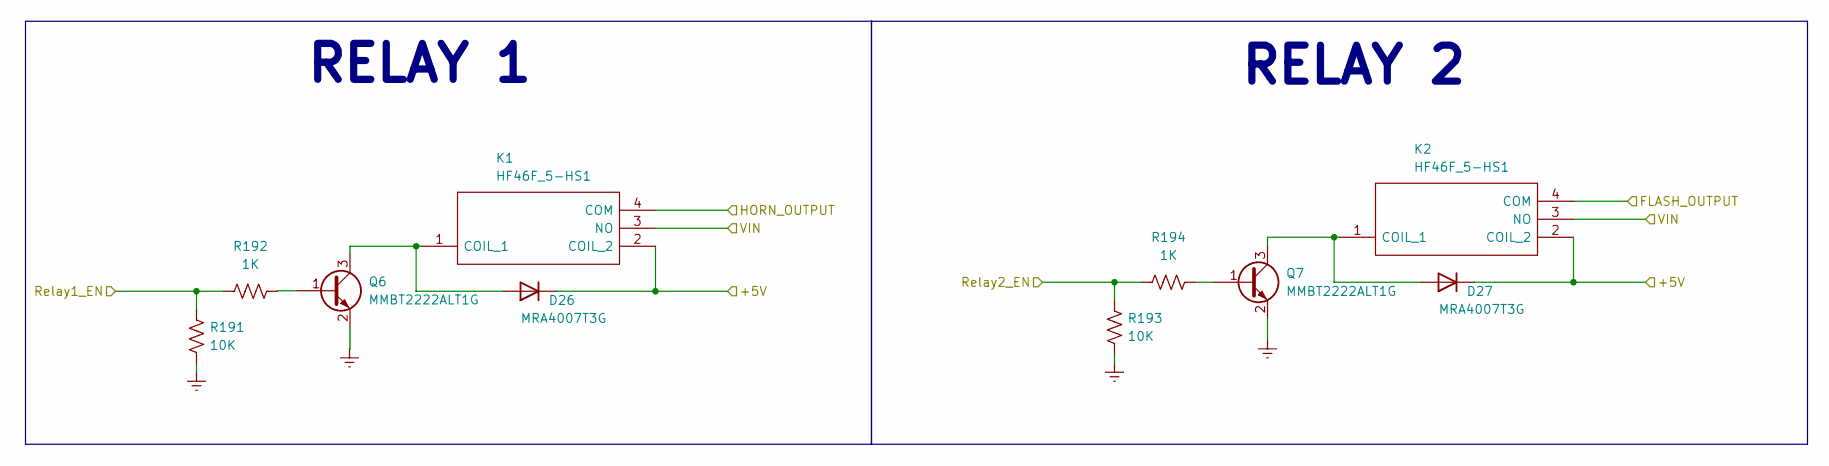
[picture p171: schematic Relay_switch.kicad_sch]

Parts:
D26, D27: MRA4007T3G; MPN MRA4007T3G
K1, K2: HF46F_5-HS1; HF46F5HS1; Manufacturer_Part_Number HF46F/5-HS1
Q6, Q7: MMBT2222ALT1G; MPN MMBT2222A
R191, R193: 10K; R_0603_1608Metric; MPN 0603WAF1002T5E
R192, R194: 1K; R_0603_1608Metric; MPN 0603WAF1001T5E

Connections:
+5V: D26.1 (K), D27.1 (K), K1.2 (COIL_2), K2.2 (COIL_2)
Earth: Q6.2 (E), Q7.2 (E), R191.2, R193.2
FLASH_OUTPUT: K2.4 (COM)
HORN_OUTPUT: K1.4 (COM)
unnamed: D26.2 (A), K1.1 (COIL_1), Q6.3 (C)
unnamed: D27.2 (A), K2.1 (COIL_1), Q7.3 (C)
unnamed: Q6.1 (B), R192.2
unnamed: Q7.1 (B), R194.2
Relay1_EN: R191.1, R192.1
Relay2_EN: R193.1, R194.1
VIN: K1.3 (NO), K2.3 (NO)

Notes on the sheet:
RELAY 2
RELAY 1
