ihsanakyrk/Eski-Versionlar-Ve-Siparisler/Movita_3566_HXV_Router_V4.0/SATA_Con.kicad_sch

## KiCad design Movita_3566_HXV_Router_V4.0/SATA_Con.kicad_sch (2025-09-01)

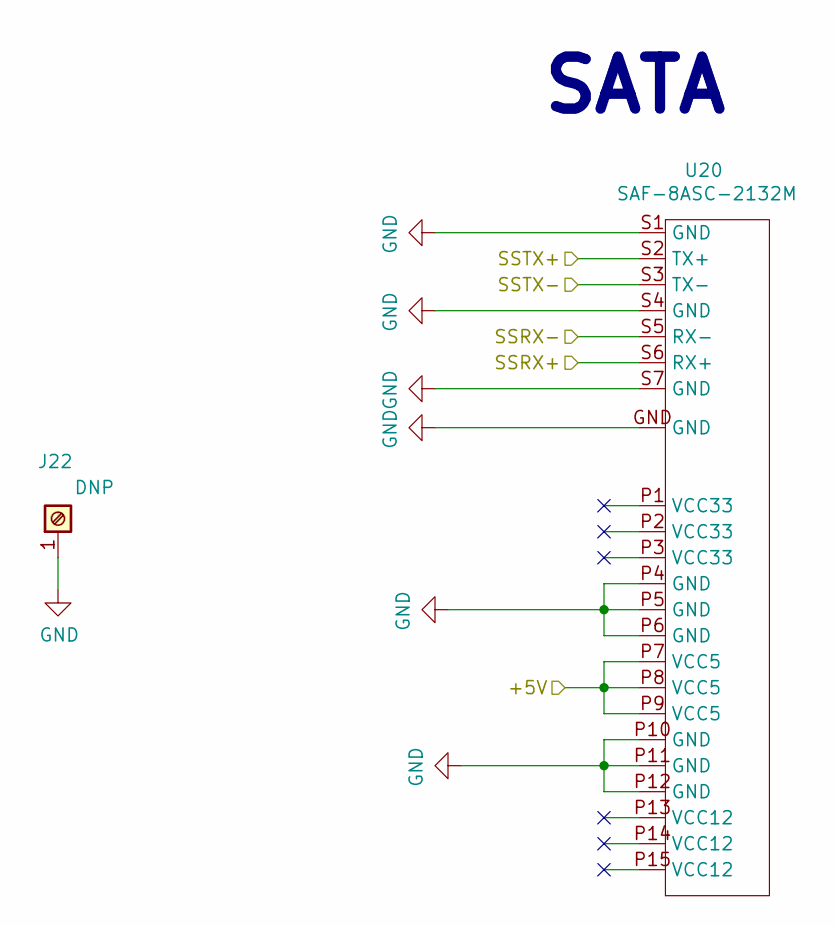
[picture p172: schematic SATA_Con.kicad_sch]

Parts:
J22: DNP; Screw Terminal Shinbo; MPN SMTSO-M3-6ET
U20: SAF-8ASC-2132M; SATA_Connector_5622-1200-ML; MPN SAF-8ASC-2132M

Connections:
+5V: U20.P7 (VCC5), U20.P8 (VCC5), U20.P9 (VCC5)
GND: J22.1, U20.GND, U20.P4 (GND), U20.P5 (GND), U20.P6 (GND), U20.P10 (GND), U20.P11 (GND), U20.P12 (GND), U20.S1 (GND), U20.S4 (GND), U20.S7 (GND)
SSRX+: U20.S6 (RX+)
SSRX-: U20.S5 (RX-)
SSTX+: U20.S2 (TX+)
SSTX-: U20.S3 (TX-)

Notes on the sheet:
SATA
