ihsanakyrk/Eski-Versionlar-Ve-Siparisler/Movita_3566_HXV_Router_V4.0/USB3.0_OTG.kicad_sch

## KiCad design Movita_3566_HXV_Router_V4.0/USB3.0_OTG.kicad_sch (2025-09-01)

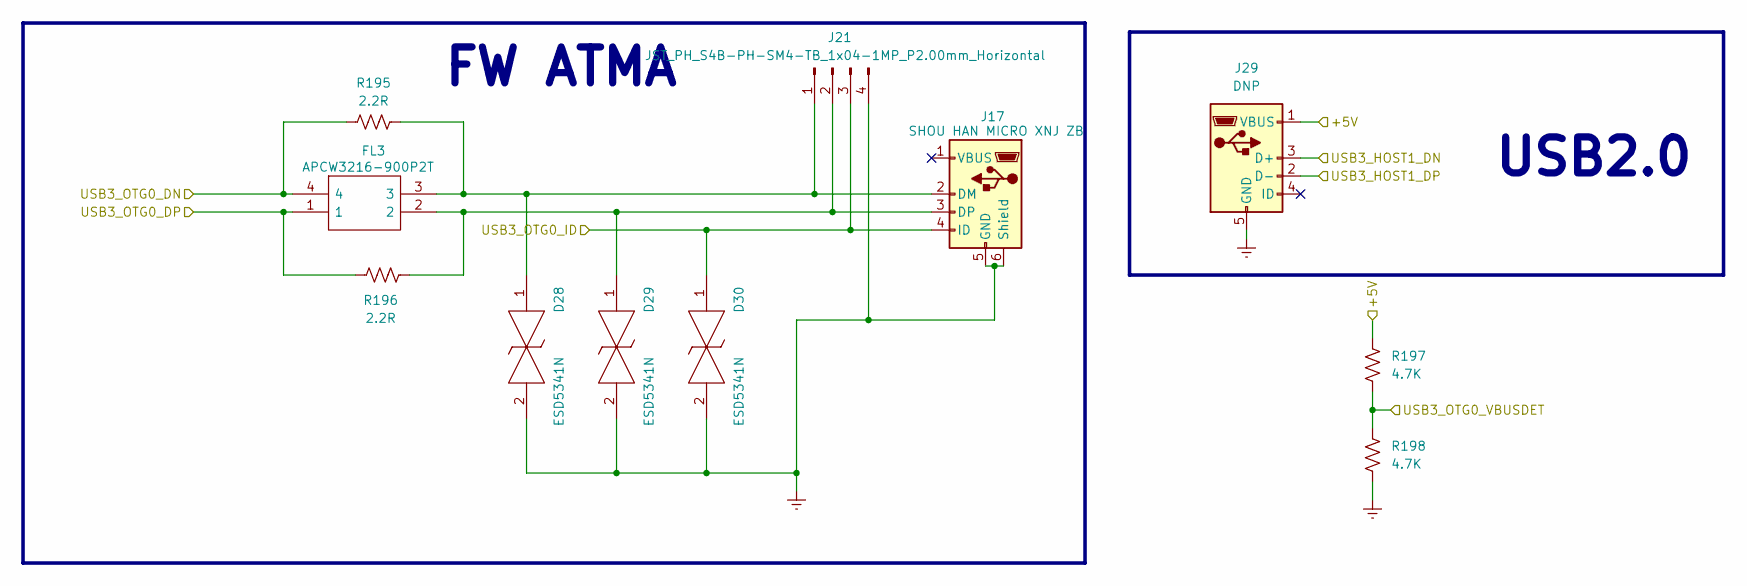
[picture p173: schematic USB3.0_OTG.kicad_sch]

Parts:
D28, D29, D30: ESD5341N; Manufacturer_Part_Number SP0402B-ULC-01ETG; Mouser Part Number 576-SP0402BULC-01ETG
FL3: APCW3216-900P2T; DLW31SH222SQ2L; Manufacturer_Part_Number DLW31SN900SQ2L; Mouser Part Number 81-DLW31SN900SQ2L
J17: SHOU HAN MICRO XNJ ZB; Micro-B SMD; MPN SHOU HAN MICRO XNJ ZB
J21: JST_PH_S4B-PH-SM4-TB_1x04-1MP_P2.00mm_Horizontal
J29: DNP; USB_A_Molex_67643_Horizontal
R195, R196: 2.2R; R_0402_1005Metric; MPN 0402WGF220KTCE
R197, R198: 4.7K; R_0603_1608Metric; MPN 0603WAF4701T5E

Connections:
+5V: J29.1 (VBUS), R197.1
Earth: D28.2, D29.2, D30.2, J17.5 (GND), J17.6 (Shield), J21.4, J29.5 (GND), R198.2
unnamed: D28.1, FL3.3, J17.2 (DM), J21.1, R195.2
unnamed: D29.1, FL3.2, J17.3 (DP), J21.2, R196.2
USB3_HOST1_DN: J29.3 (D+)
USB3_HOST1_DP: J29.2 (D-)
USB3_OTG0_DN: FL3.4, R195.1
USB3_OTG0_DP: FL3.1, R196.1
USB3_OTG0_ID: D30.1, J17.4 (ID), J21.3
USB3_OTG0_VBUSDET: R197.2, R198.1

Notes on the sheet:
FW ATMA
USB2.0
