ihsanakyrk/Eski-Versionlar-Ve-Siparisler/Movita_3566_HXV_Router_V4.0/WiFi Module.kicad_sch

## KiCad design Movita_3566_HXV_Router_V4.0/WiFi Module.kicad_sch (2025-09-01)

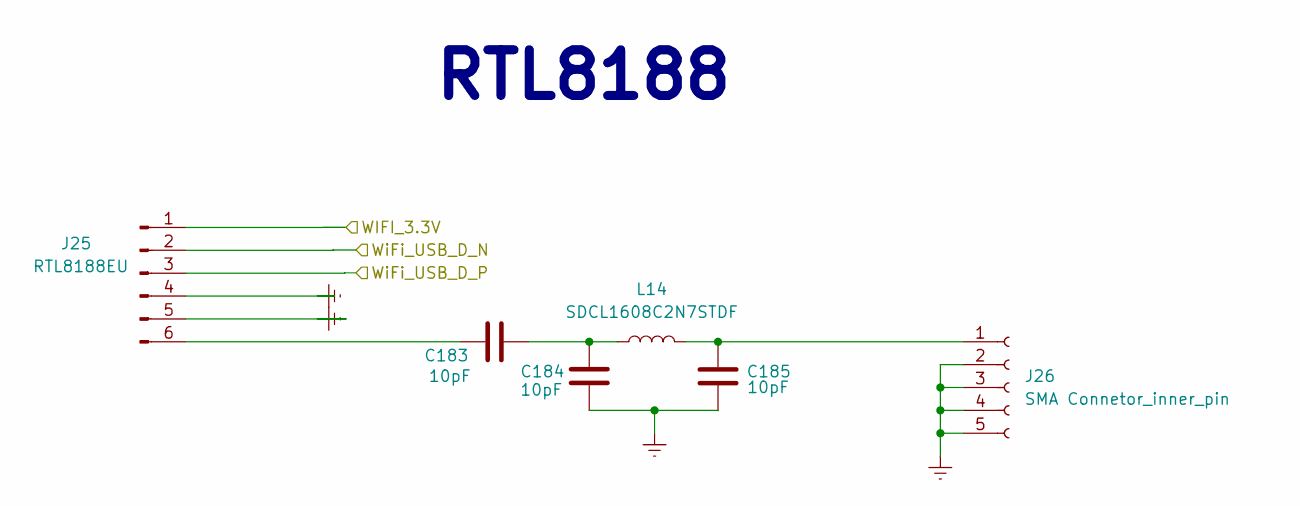
[picture p174: schematic WiFi Module.kicad_sch]

Parts:
C183, C184, C185: 10pF; C_0603_1608Metric; MPN CC0603JRNPO9BN100
J25: RTL8188EU; MPN RTL8188EUS 模块
J26: SMA Connetor_inner_pin; SMA_Connector_inner_pin_right_angle; MPN SMA-KWE 内针
L14: SDCL1608C2N7STDF; L_0603_1608Metric; MPN SDCL1608C2N7STDF

Connections:
Earth: C184.2, C185.2, J25.4, J25.5, J26.2, J26.3, J26.4, J26.5
unnamed: C183.1, C184.1, L14.1
unnamed: C183.2, J25.6
unnamed: C185.1, J26.1, L14.2
WIFI_3.3V: J25.1
WiFi_USB_D_N: J25.2
WiFi_USB_D_P: J25.3

Notes on the sheet:
RTL8188
