ihsanakyrk/Eski-Versionlar-Ve-Siparisler/Movita_XV500_Router_V4.0/4_port_rj45.kicad_sch

## KiCad design Movita_XV500_Router_V4.0/4_port_rj45.kicad_sch (2025-09-01)

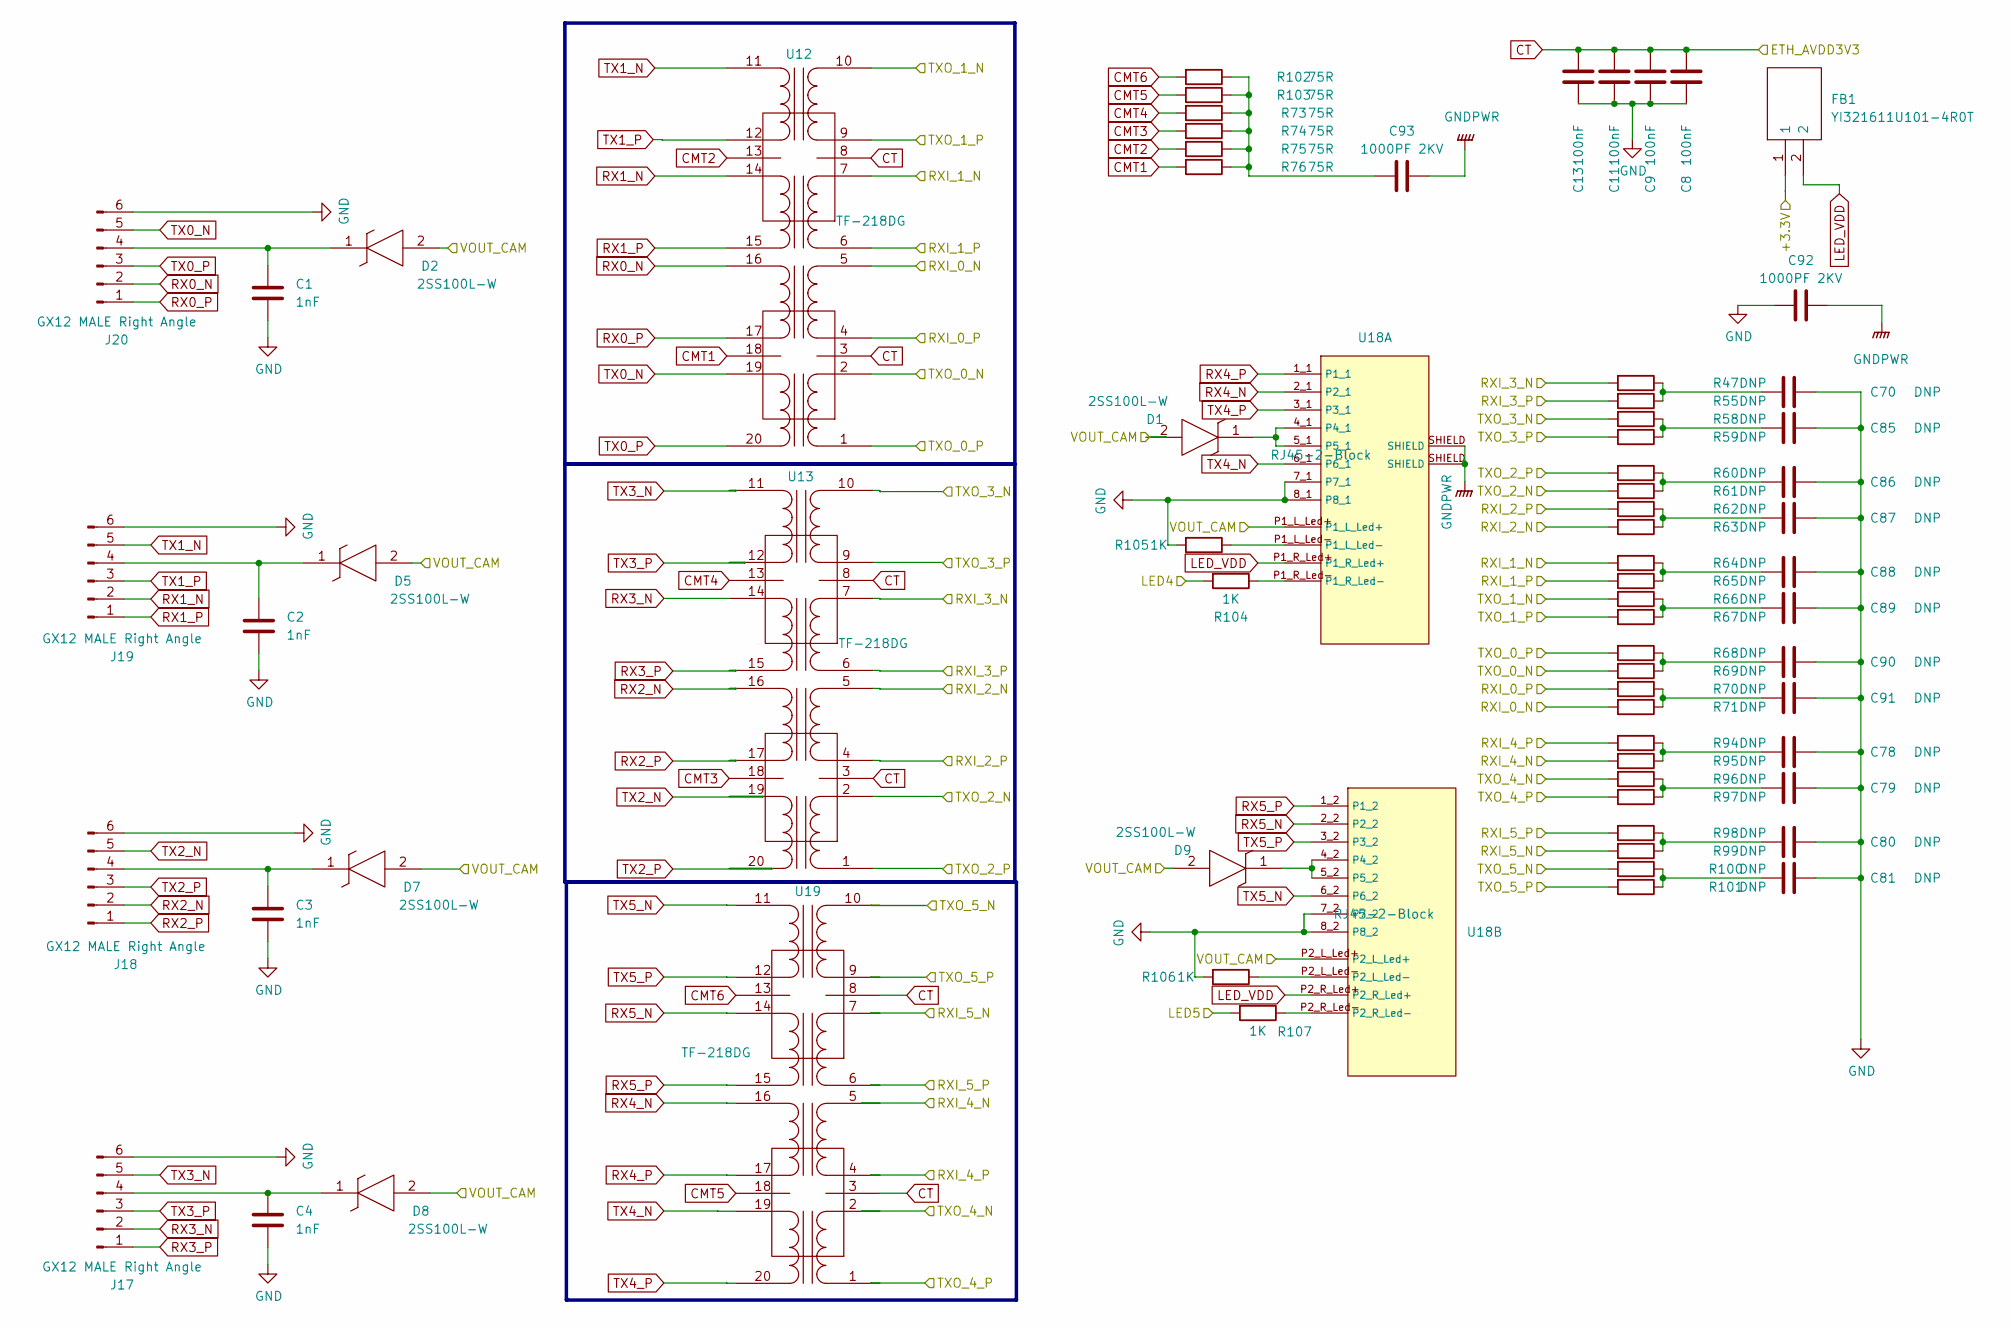
[picture p175: schematic 4_port_rj45.kicad_sch]

Parts:
C1, C2, C3, C4: 1nF; C_0603_1608Metric
C8, C9, C11, C13: 100nF; C_0402_1005Metric; MPN CC0402KRX7R7BB104
C70, C78, C79, C80, C81, C85, C86, C87, C88, C89, C90, C91: DNP; C_0402_1005Metric
C92, C93: 1000PF 2KV; S102K33Y5PP63K5R; MPN Y5P102K2KV16CC0224
D1, D2, D5, D7, D8, D9: 2SS100L-W; 2SS100LW; Manufacturer_Part_Number 2SS100L-W; Mouser Part Number 583-2SS100L-W
FB1: YI321611U101-4R0T; BEADC3216X130N; Manufacturer_Part_Number HI1206N101R-10; Mouser Part Number N/A
J17, J18, J19, J20: GX12 MALE Right Angle; GX12 6pin Aviation socket; MPN GX12 MALE Right Angle
R47, R55, R58, R59, R60, R61, R62, R63, R64, R65, R66, R67, R68, R69, R70, R71, R94, R95, R96, R97, R98, R99, R100, R101: DNP; R_0603_1608Metric
R73, R74, R75, R76, R102, R103: 75R; R_0603_1608Metric; MPN 0603WAF750JT5E
R104, R105, R106, R107: 1K; R_0603_1608Metric; MPN 0603WAF1001T5E
U12, U13, U19: TF-218DG; RJ45_Transformer_2_Port; MPN TF-218DG
U18: RJ45-2-Block; 2_Block_RJ45; MPN RJ45 56 1*2 带灯

Connections:
+3.3V: FB1.1
CMT1: R76.2, U12.18
CMT2: R75.2, U12.13
CMT3: R74.2, U13.18
CMT4: R73.2, U13.13
CMT5: R103.2, U19.18
CMT6: R102.2, U19.13
CT: C8.1, C9.1, C11.1, C13.1, U12.3, U12.8, U13.3, U13.8, U19.3, U19.8
GND: C1.1, C2.1, C3.1, C4.1, C8.2, C9.2, C11.2, C13.2, C70.2, C78.2, C79.2, C80.2, C81.2, C85.2, C86.2, C87.2, C88.2, C89.2, C90.2, C91.2, C92.1, J17.6, J18.6, J19.6, J20.6, R105.2, R106.2, U18.7_1, U18.7_2, U18.8_1, U18.8_2
GNDPWR: C92.2, C93.2, U18.SHIELD
LED4: R104.2
LED5: R107.2
LED_VDD: FB1.2, U18.P1_R_Led+, U18.P2_R_Led+
unnamed: C1.2, D2.1, J20.4
unnamed: C2.2, D5.1, J19.4
unnamed: C3.2, D7.1, J18.4
unnamed: C4.2, D8.1, J17.4
unnamed: C70.1, R47.1, R55.1
unnamed: C78.1, R94.1, R95.1
unnamed: C79.1, R96.1, R97.1
unnamed: C80.1, R98.1, R99.1
unnamed: C81.1, R100.1, R101.1
unnamed: C85.1, R58.1, R59.1
unnamed: C86.1, R60.1, R61.1
unnamed: C87.1, R62.1, R63.1
unnamed: C88.1, R64.1, R65.1
unnamed: C89.1, R66.1, R67.1
unnamed: C90.1, R68.1, R69.1
unnamed: C91.1, R70.1, R71.1
unnamed: C93.1, R73.1, R74.1, R75.1, R76.1, R102.1, R103.1
unnamed: D1.1, U18.4_1, U18.5_1
unnamed: D9.1, U18.4_2, U18.5_2
unnamed: R104.1, U18.P1_R_Led-
unnamed: R105.1, U18.P1_L_Led-
unnamed: R106.1, U18.P2_L_Led-
unnamed: R107.1, U18.P2_R_Led-
RX0_N: J20.2, U12.16
RX0_P: J20.1, U12.17
RX1_N: J19.2, U12.14
RX1_P: J19.1, U12.15
RX2_N: J18.2, U13.16
RX2_P: J18.1, U13.17
RX3_N: J17.2, U13.14
RX3_P: J17.1, U13.15
RX4_N: U18.2_1, U19.16
RX4_P: U18.1_1, U19.17
RX5_N: U18.2_2, U19.14
RX5_P: U18.1_2, U19.15
RXI_0_N: R71.2, U12.5
RXI_0_P: R70.2, U12.4
RXI_1_N: R64.2, U12.7
RXI_1_P: R65.2, U12.6
RXI_2_N: R63.2, U13.5
RXI_2_P: R62.2, U13.4
RXI_3_N: R47.2, U13.7
RXI_3_P: R55.2, U13.6
RXI_4_N: R95.2, U19.5
RXI_4_P: R94.2, U19.4
RXI_5_N: R99.2, U19.7
RXI_5_P: R98.2, U19.6
TX0_N: J20.5, U12.19
TX0_P: J20.3, U12.20
TX1_N: J19.5, U12.11
TX1_P: J19.3, U12.12
TX2_N: J18.5, U13.19
TX2_P: J18.3, U13.20
TX3_N: J17.5, U13.11
TX3_P: J17.3, U13.12
TX4_N: U18.6_1, U19.19
TX4_P: U18.3_1, U19.20
TX5_N: U18.6_2, U19.11
TX5_P: U18.3_2, U19.12
TXO_0_N: R69.2, U12.2
TXO_0_P: R68.2, U12.1
TXO_1_N: R66.2, U12.10
TXO_1_P: R67.2, U12.9
TXO_2_N: R61.2, U13.2
TXO_2_P: R60.2, U13.1
TXO_3_N: R58.2, U13.10
TXO_3_P: R59.2, U13.9
TXO_4_N: R96.2, U19.2
TXO_4_P: R97.2, U19.1
TXO_5_N: R100.2, U19.10
TXO_5_P: R101.2, U19.9
VOUT_CAM: D1.2, D2.2, D5.2, D7.2, D8.2, D9.2, U18.P1_L_Led+, U18.P2_L_Led+
