ihsanakyrk/Eski-Versionlar-Ve-Siparisler/Movita_XV500_Router_V4.0/CM3566.kicad_sch

## KiCad design Movita_XV500_Router_V4.0/CM3566.kicad_sch (2025-09-01)

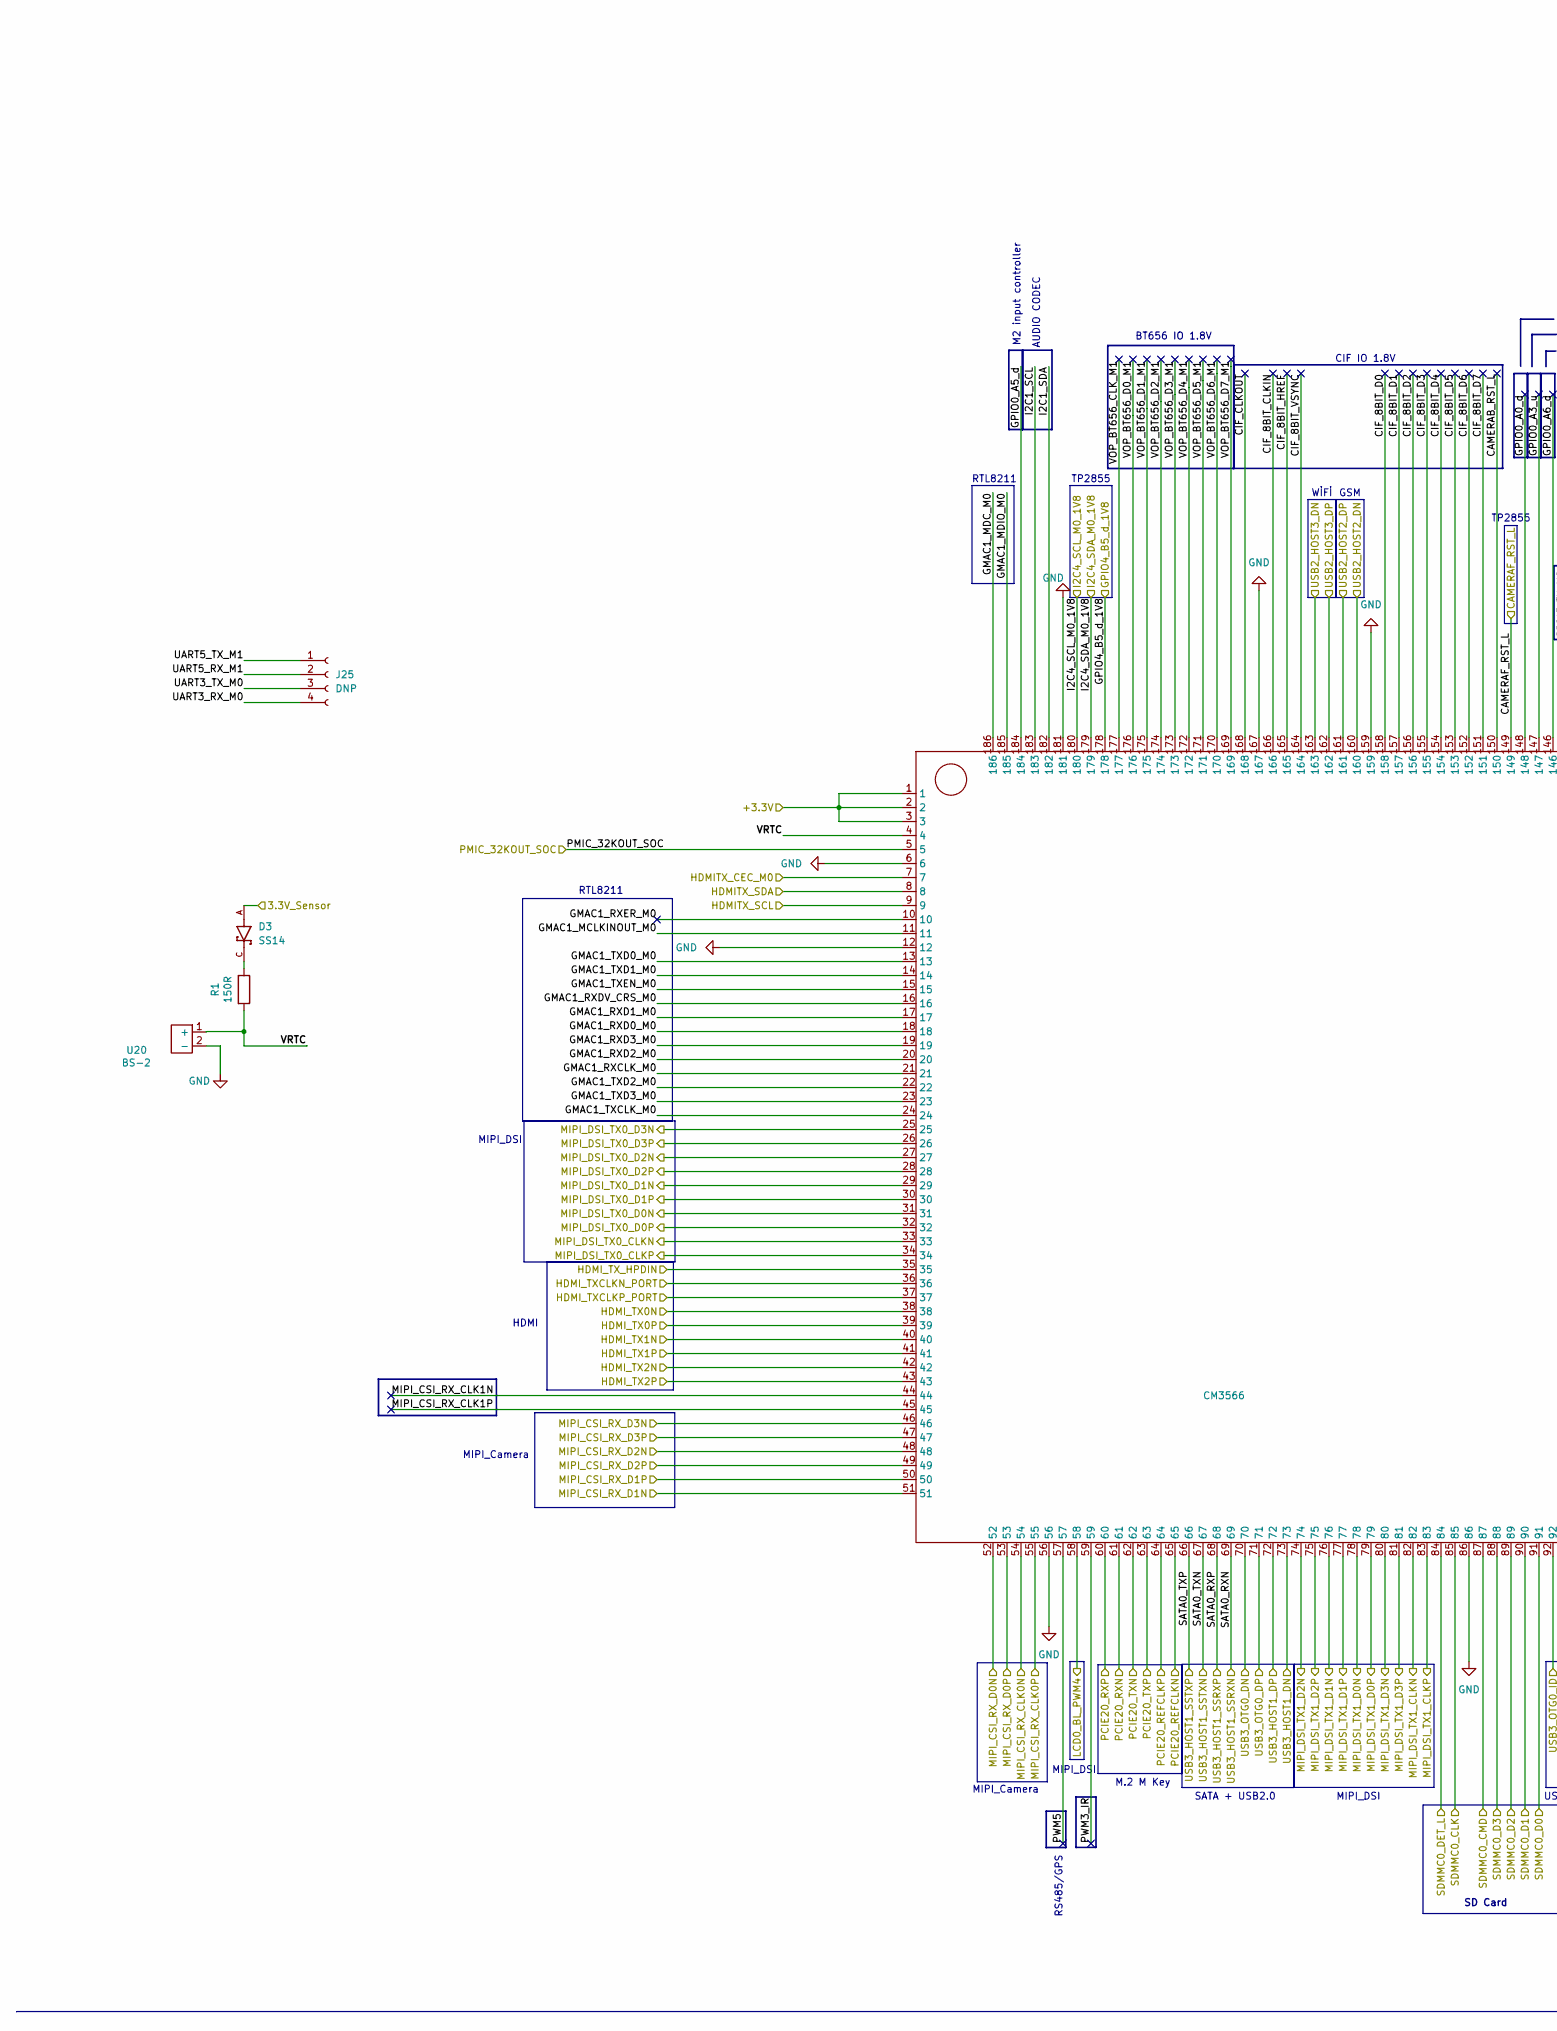
[picture p176: schematic CM3566.kicad_sch, part in row 1, column 1]

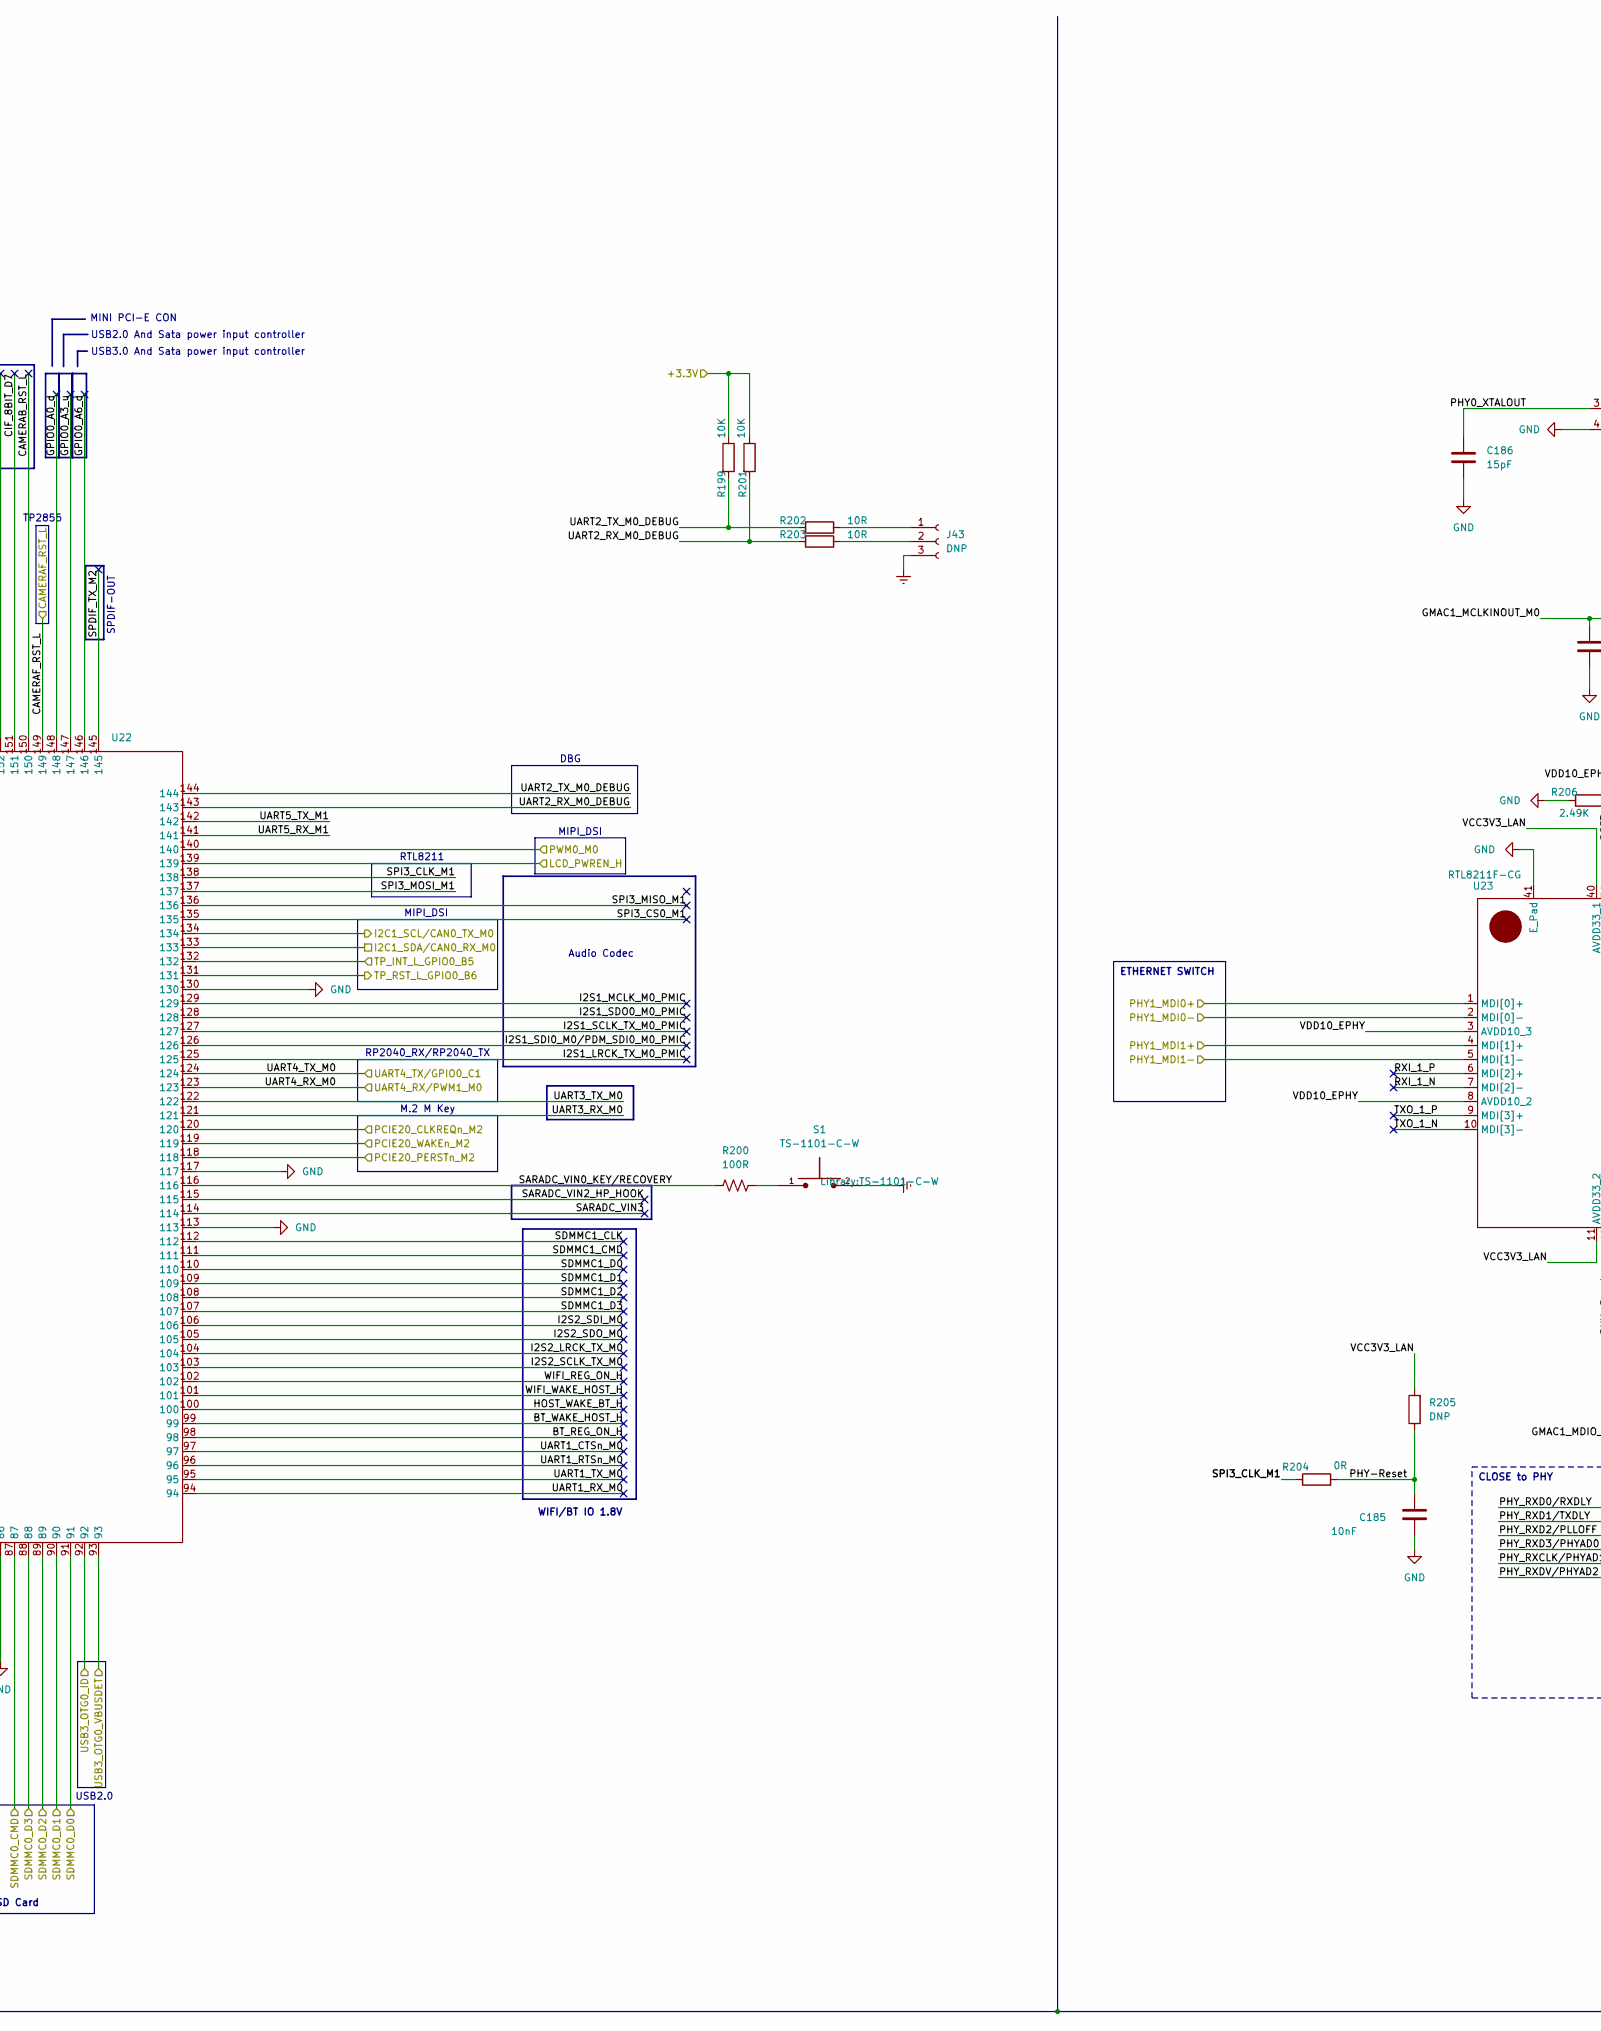
[picture p177: schematic CM3566.kicad_sch, part in row 1, column 2]

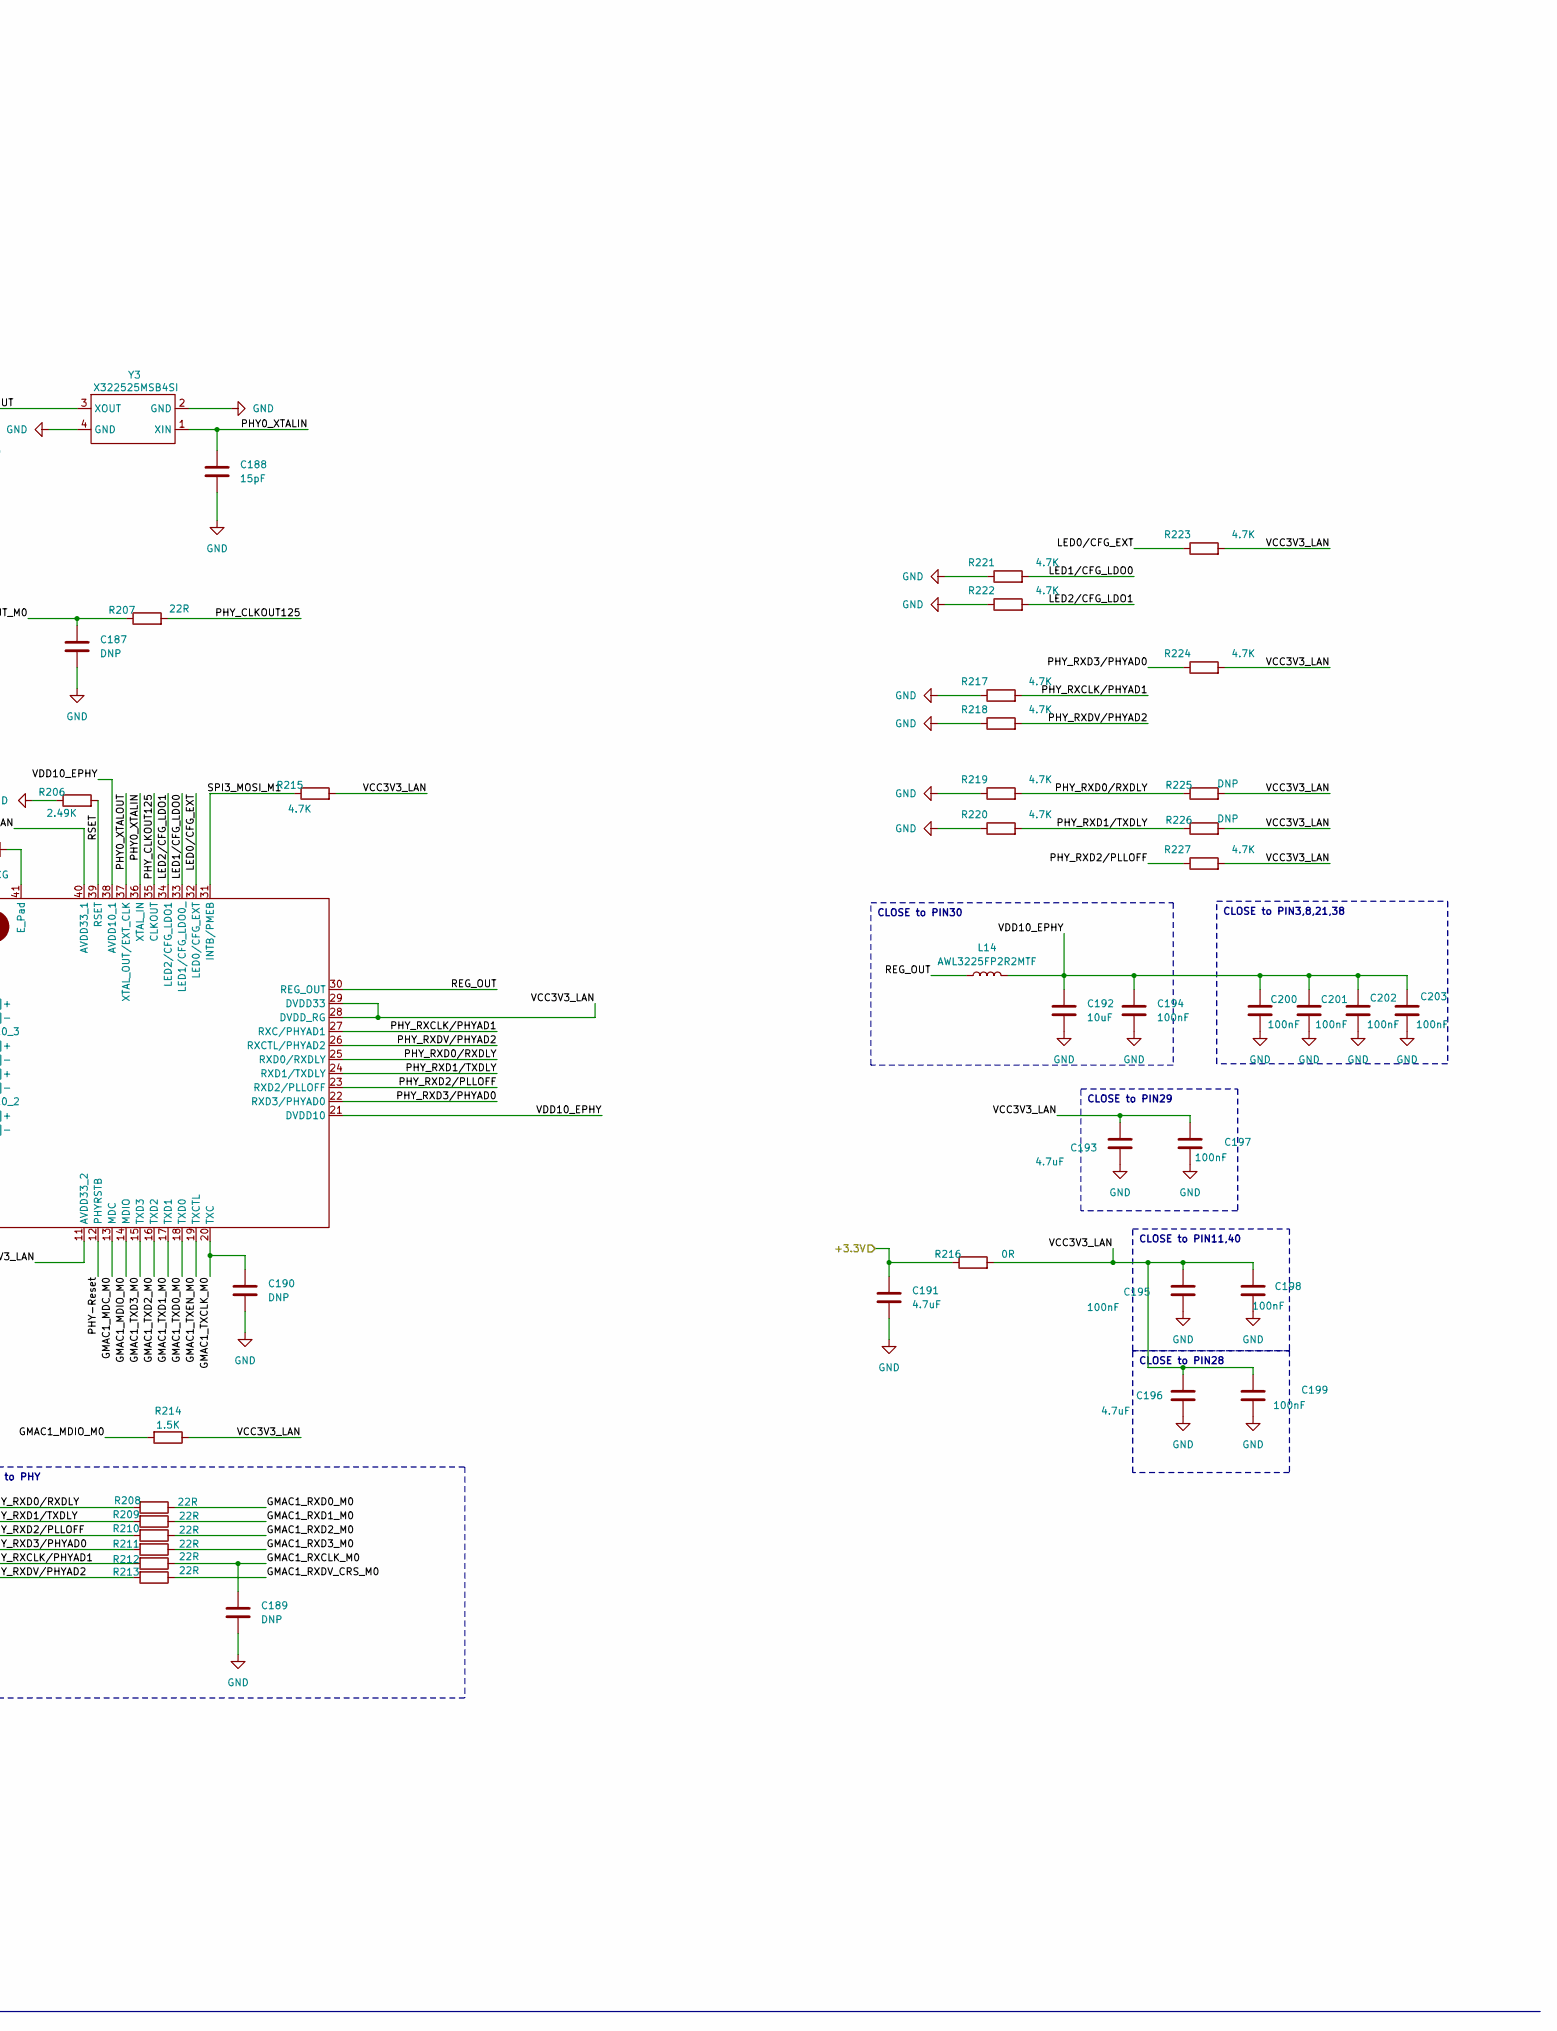
[picture p178: schematic CM3566.kicad_sch, part in row 1, column 3]

Parts:
C185: 10nF; C_0402_1005Metric; MPN CC0402KRX7R9BB103
C186, C188: 15pF; C_0402_1005Metric; MPN 0402CG150J500NT
C187, C189, C190: DNP; C_0402_1005Metric
C191, C193, C196: 4.7uF; C_0603_1608Metric; MPN CL10A475KO8NNNC
C192: 10uF; C_0603_1608Metric; MPN CL10A106MO8NQNC
C194, C195, C197, C198, C199, C200, C201, C202, C203: 100nF; C_0402_1005Metric; MPN CC0402KRX7R7BB104
D3: SS14; DIOM4325X250N; PARTREV O2102
J25: DNP; PinHeader_2x02_P2.54mm_Vertical_SMD
J43: DNP; PinHeader_1x03_P2.00mm_Vertical; MPN 1*3p 2.0 排针
L14: AWL3225FP2R2MTF; MPN AWL3225FP2R2MTF
R1: 150R; R_0603_1608Metric; MPN 0603WAF1500T5E
R199, R201: 10K; R_0402_1005Metric; MPN RC0402FR-0710KL
R200: 100R; R_0603_1608Metric; MPN 0603WAF1000T5E
R202, R203: 10R; R_0402_1005Metric; MPN 0402WGF100JTCE
R204, R216: 0R; R_0402_1005Metric; MPN 0402WGF0000TCE
R205, R225, R226: DNP; R_0402_1005Metric
R206: 2.49K; R_0402_1005Metric; MPN 0402WGF2491TCE
R207, R208, R209, R210, R211, R212, R213: 22R; R_0402_1005Metric; MPN 0402WGF220JTCE
R214: 1.5K; R_0402_1005Metric; MPN 0402WGF1501TCE
R215, R217, R218, R219, R220, R221, R222, R223, R224, R227: 4.7K; R_0402_1005Metric; MPN 0402WGF4701TCE
S1: TS-1101-C-W; PARTREV F
U20: BS-2; BS-02-A1AJ010; MPN MYOUNG BS-02-A1AJ010
U22: CM3566; MPN CM3566
U23: RTL8211F-CG; MPN RTL8211F-CG
Y3: X322525MSB4SI; Crystal_SMD_3225-4Pin_3.2x2.5mm; MPN X322525MSB4SI

Connections:
3.3V_Sensor: D3.A
+3.3V: C191.1, R199.1, R201.1, R216.1, U22.1, U22.2, U22.3
BT_REG_ON_H: U22.98
BT_WAKE_HOST_H: U22.99
CAMERAB_RST_L: U22.150
CAMERAF_RST_L: U22.149
CIF_8BIT_CLKIN: U22.166
CIF_8BIT_D0: U22.158
CIF_8BIT_D1: U22.157
CIF_8BIT_D2: U22.156
CIF_8BIT_D3: U22.155
CIF_8BIT_D4: U22.154
CIF_8BIT_D5: U22.153
CIF_8BIT_D6: U22.152
CIF_8BIT_D7: U22.151
CIF_8BIT_HREF: U22.165
CIF_8BIT_VSYNC: U22.164
CIF_CLKOUT: U22.168
Earth: J43.3, S1.2
GMAC1_MCLKINOUT_M0: C187.1, R207.1, U22.11
GMAC1_MDC_M0: U22.186, U23.13 (MDC)
GMAC1_MDIO_M0: R214.2, U22.185, U23.14 (MDIO)
GMAC1_RXCLK_M0: C189.1, R212.1, U22.21
GMAC1_RXD0_M0: R208.1, U22.18
GMAC1_RXD1_M0: R209.1, U22.17
GMAC1_RXD2_M0: R210.1, U22.20
GMAC1_RXD3_M0: R211.1, U22.19
GMAC1_RXDV_CRS_M0: R213.1, U22.16
GMAC1_RXER_M0: U22.10
GMAC1_TXCLK_M0: C190.1, U22.24, U23.20 (TXC)
GMAC1_TXD0_M0: U22.13, U23.18 (TXD0)
GMAC1_TXD1_M0: U22.14, U23.17 (TXD1)
GMAC1_TXD2_M0: U22.22, U23.16 (TXD2)
GMAC1_TXD3_M0: U22.23, U23.15 (TXD3)
GMAC1_TXEN_M0: U22.15, U23.19 (TXCTL)
GND: C185.2, C186.2, C187.2, C188.2, C189.2, C190.2, C191.2, C192.2, C193.2, C194.2, C195.2, C196.2, C197.2, C198.2, C199.2, C200.2, C201.2, C202.2, C203.2, R206.1, R217.1, R218.1, R219.1, R220.1, R221.1, R222.1, U20.2 (-), U22.6, U22.12, U22.56, U22.86, U22.113, U22.117, U22.130, U22.159, U22.167, U22.181, U23.41 (E_Pad), Y3.2 (GND), Y3.4 (GND)
GPIO0_A0_d: U22.148
GPIO0_A3_u: U22.147
GPIO0_A5_d: U22.184
GPIO0_A6_d: U22.146
GPIO4_B5_d_1V8: U22.178
HDMITX_CEC_M0: U22.7
HDMITX_SCL: U22.9
HDMITX_SDA: U22.8
HDMI_TX0N: U22.38
HDMI_TX0P: U22.39
HDMI_TX1N: U22.40
HDMI_TX1P: U22.41
HDMI_TX2N: U22.42
HDMI_TX2P: U22.43
HDMI_TXCLKN_PORT: U22.36
HDMI_TXCLKP_PORT: U22.37
HDMI_TX_HPDIN: U22.35
HOST_WAKE_BT_H: U22.100
I2C1_SCL: U22.183
I2C1_SCL/CAN0_TX_M0: U22.134
I2C1_SDA: U22.182
I2C1_SDA/CAN0_RX_M0: U22.133
I2C4_SCL_M0_1V8: U22.180
I2C4_SDA_M0_1V8: U22.179
I2S1_LRCK_TX_M0_PMIC: U22.125
I2S1_MCLK_M0_PMIC: U22.129
I2S1_SCLK_TX_M0_PMIC: U22.127
I2S1_SDI0_M0/PDM_SDI0_M0_PMIC: U22.126
I2S1_SDO0_M0_PMIC: U22.128
I2S2_LRCK_TX_M0: U22.104
I2S2_SCLK_TX_M0: U22.103
I2S2_SDI_M0: U22.106
I2S2_SDO_M0: U22.105
LCD0_BL_PWM4: U22.58
LCD_PWREN_H: U22.139
LED0/CFG_EXT: R223.1, U23.32 (LED0/CFG_EXT)
LED1/CFG_LDO0: R221.2, U23.33 (LED1/CFG_LDO0_)
LED2/CFG_LDO1: R222.2, U23.34 (LED2/CFG_LDO1)
MIPI_CSI_RX_CLK0N: U22.54
MIPI_CSI_RX_CLK0P: U22.55
MIPI_CSI_RX_CLK1N: U22.44
MIPI_CSI_RX_CLK1P: U22.45
MIPI_CSI_RX_D0N: U22.52
MIPI_CSI_RX_D0P: U22.53
MIPI_CSI_RX_D1N: U22.51
MIPI_CSI_RX_D1P: U22.50
MIPI_CSI_RX_D2N: U22.48
MIPI_CSI_RX_D2P: U22.49
MIPI_CSI_RX_D3N: U22.46
MIPI_CSI_RX_D3P: U22.47
MIPI_DSI_TX0_CLKN: U22.33
MIPI_DSI_TX0_CLKP: U22.34
MIPI_DSI_TX0_D0N: U22.31
MIPI_DSI_TX0_D0P: U22.32
MIPI_DSI_TX0_D1N: U22.29
MIPI_DSI_TX0_D1P: U22.30
MIPI_DSI_TX0_D2N: U22.27
MIPI_DSI_TX0_D2P: U22.28
MIPI_DSI_TX0_D3N: U22.25
MIPI_DSI_TX0_D3P: U22.26
MIPI_DSI_TX1_CLKN: U22.82
MIPI_DSI_TX1_CLKP: U22.83
MIPI_DSI_TX1_D0N: U22.78
MIPI_DSI_TX1_D0P: U22.79
MIPI_DSI_TX1_D1N: U22.76
MIPI_DSI_TX1_D1P: U22.77
MIPI_DSI_TX1_D2N: U22.74
MIPI_DSI_TX1_D2P: U22.75
MIPI_DSI_TX1_D3N: U22.80
MIPI_DSI_TX1_D3P: U22.81
unnamed: D3.C, R1.1
unnamed: J43.1, R202.1
unnamed: J43.2, R203.1
unnamed: R200.2, S1.1
PCIE20_CLKREQn_M2: U22.120
PCIE20_PERSTn_M2: U22.118
PCIE20_REFCLKN: U22.65
PCIE20_REFCLKP: U22.64
PCIE20_RXN: U22.61
PCIE20_RXP: U22.60
PCIE20_TXN: U22.62
PCIE20_TXP: U22.63
PCIE20_WAKEn_M2: U22.119
PHY0_XTALIN: C188.1, U23.36 (XTAL_IN), Y3.1 (XIN)
PHY0_XTALOUT: C186.1, U23.37 (XTAL_OUT/EXT_CLK), Y3.3 (XOUT)
PHY1_MDI0+: U23.1 (MDI[0]+)
PHY1_MDI0-: U23.2 (MDI[0]-)
PHY1_MDI1+: U23.4 (MDI[1]+)
PHY1_MDI1-: U23.5 (MDI[1]-)
PHY-Reset: C185.1, R204.2, R205.1, U23.12 (PHYRSTB)
PHY_CLKOUT125: R207.2, U23.35 (CLKOUT)
PHY_RXCLK/PHYAD1: R212.2, R217.2, U23.27 (RXC/PHYAD1)
PHY_RXD0/RXDLY: R208.2, R219.2, R225.1, U23.25 (RXD0/RXDLY)
PHY_RXD1/TXDLY: R209.2, R220.2, R226.1, U23.24 (RXD1/TXDLY)
PHY_RXD2/PLLOFF: R210.2, R227.1, U23.23 (RXD2/PLLOFF)
PHY_RXD3/PHYAD0: R211.2, R224.1, U23.22 (RXD3/PHYAD0)
PHY_RXDV/PHYAD2: R213.2, R218.2, U23.26 (RXCTL/PHYAD2)
PMIC_32KOUT_SOC: U22.5
PWM0_M0: U22.140
PWM3_IR: U22.59
PWM5: U22.57
REG_OUT: L14.1, U23.30 (REG_OUT)
RSET: R206.2, U23.39 (RSET)
RXI_1_N: U23.7 (MDI[2]-)
RXI_1_P: U23.6 (MDI[2]+)
SARADC_VIN0_KEY/RECOVERY: R200.1, U22.116
SARADC_VIN2_HP_HOOK: U22.115
SARADC_VIN3: U22.114
SATA0_RXN: U22.69
SATA0_RXP: U22.68
SATA0_TXN: U22.67
SATA0_TXP: U22.66
SDMMC0_CLK: U22.85
SDMMC0_CMD: U22.87
SDMMC0_D0: U22.91
SDMMC0_D1: U22.90
SDMMC0_D2: U22.89
SDMMC0_D3: U22.88
SDMMC0_DET_L: U22.84
SDMMC1_CLK: U22.112
SDMMC1_CMD: U22.111
SDMMC1_D0: U22.110
SDMMC1_D1: U22.109
SDMMC1_D2: U22.108
SDMMC1_D3: U22.107
SPDIF_TX_M2: U22.145
SPI3_CLK_M1: R204.1, U22.138
SPI3_CS0_M1: U22.135
SPI3_MISO_M1: U22.136
SPI3_MOSI_M1: R215.1, U22.137, U23.31 (INTB/PMEB)
TP_INT_L_GPIO0_B5: U22.132
TP_RST_L_GPIO0_B6: U22.131
TXO_1_N: U23.10 (MDI[3]-)
TXO_1_P: U23.9 (MDI[3]+)
UART1_CTSn_M0: U22.97
UART1_RTSn_M0: U22.96
UART1_RX_M0: U22.94
UART1_TX_M0: U22.95
UART2_RX_M0_DEBUG: R201.2, R203.2, U22.143
UART2_TX_M0_DEBUG: R199.2, R202.2, U22.144
UART3_RX_M0: J25.4, U22.121
UART3_TX_M0: J25.3, U22.122
UART4_RX_M0: U22.123
UART4_TX_M0: U22.124
UART5_RX_M1: J25.2, U22.141
UART5_TX_M1: J25.1, U22.142
USB2_HOST2_DN: U22.160
USB2_HOST2_DP: U22.161
USB2_HOST3_DN: U22.163
USB2_HOST3_DP: U22.162
USB3_HOST1_DN: U22.73
USB3_HOST1_DP: U22.72
USB3_OTG0_DN: U22.70
USB3_OTG0_DP: U22.71
USB3_OTG0_ID: U22.92
USB3_OTG0_VBUSDET: U22.93
VCC3V3_LAN: C193.1, C195.1, C196.1, C197.1, C198.1, C199.1, R205.2, R214.1, R215.2, R216.2, R223.2, R224.2, R225.2, R226.2, R227.2, U23.11 (AVDD33_2), U23.28 (DVDD_RG), U23.29 (DVDD33), U23.40 (AVDD33_1)
VDD10_EPHY: C192.1, C194.1, C200.1, C201.1, C202.1, C203.1, L14.2, U23.3 (AVDD10_3), U23.8 (AVDD10_2), U23.21 (DVDD10), U23.38 (AVDD10_1)
VOP_BT656_CLK_M1: U22.177
VOP_BT656_D0_M1: U22.176
VOP_BT656_D1_M1: U22.175
VOP_BT656_D2_M1: U22.174
VOP_BT656_D3_M1: U22.173
VOP_BT656_D4_M1: U22.172
VOP_BT656_D5_M1: U22.171
VOP_BT656_D6_M1: U22.170
VOP_BT656_D7_M1: U22.169
VRTC: R1.2, U20.1 (+), U22.4
WIFI_REG_ON_H: U22.102
WIFI_WAKE_HOST_H: U22.101

Notes on the sheet:
CLOSE to PIN30
CLOSE to PIN11,40
CLOSE to PIN3,8,21,38
CLOSE to PIN28
CLOSE to PHY
ETHERNET SWITCH
CLOSE to PIN29
MIPI_DSI
MINI PCI-E CON
RP2040_RX/RP2040_TX
RTL8211
MIPI_Camera
BT656 IO 1.8V
RTL8211
AUDIO CODEC
CIF IO 1.8V
DBG
SATA + USB2.0
M2 input controller
TP2855
TP2855
M.2 M Key
Audio Codec
MIPI_DSI
WIFI/BT IO 1.8V
SD Card
SPDIF-OUT
USB2.0
USB3.0 And Sata power input controller
USB2.0 And Sata power input controller
HDMI
GSM
WİFİ
RS485/GPS
