ihsanakyrk/Eski-Versionlar-Ve-Siparisler/Movita_XV500_Router_V4.0/CM3568.kicad_sch

## KiCad design Movita_XV500_Router_V4.0/CM3568.kicad_sch (2025-09-01)

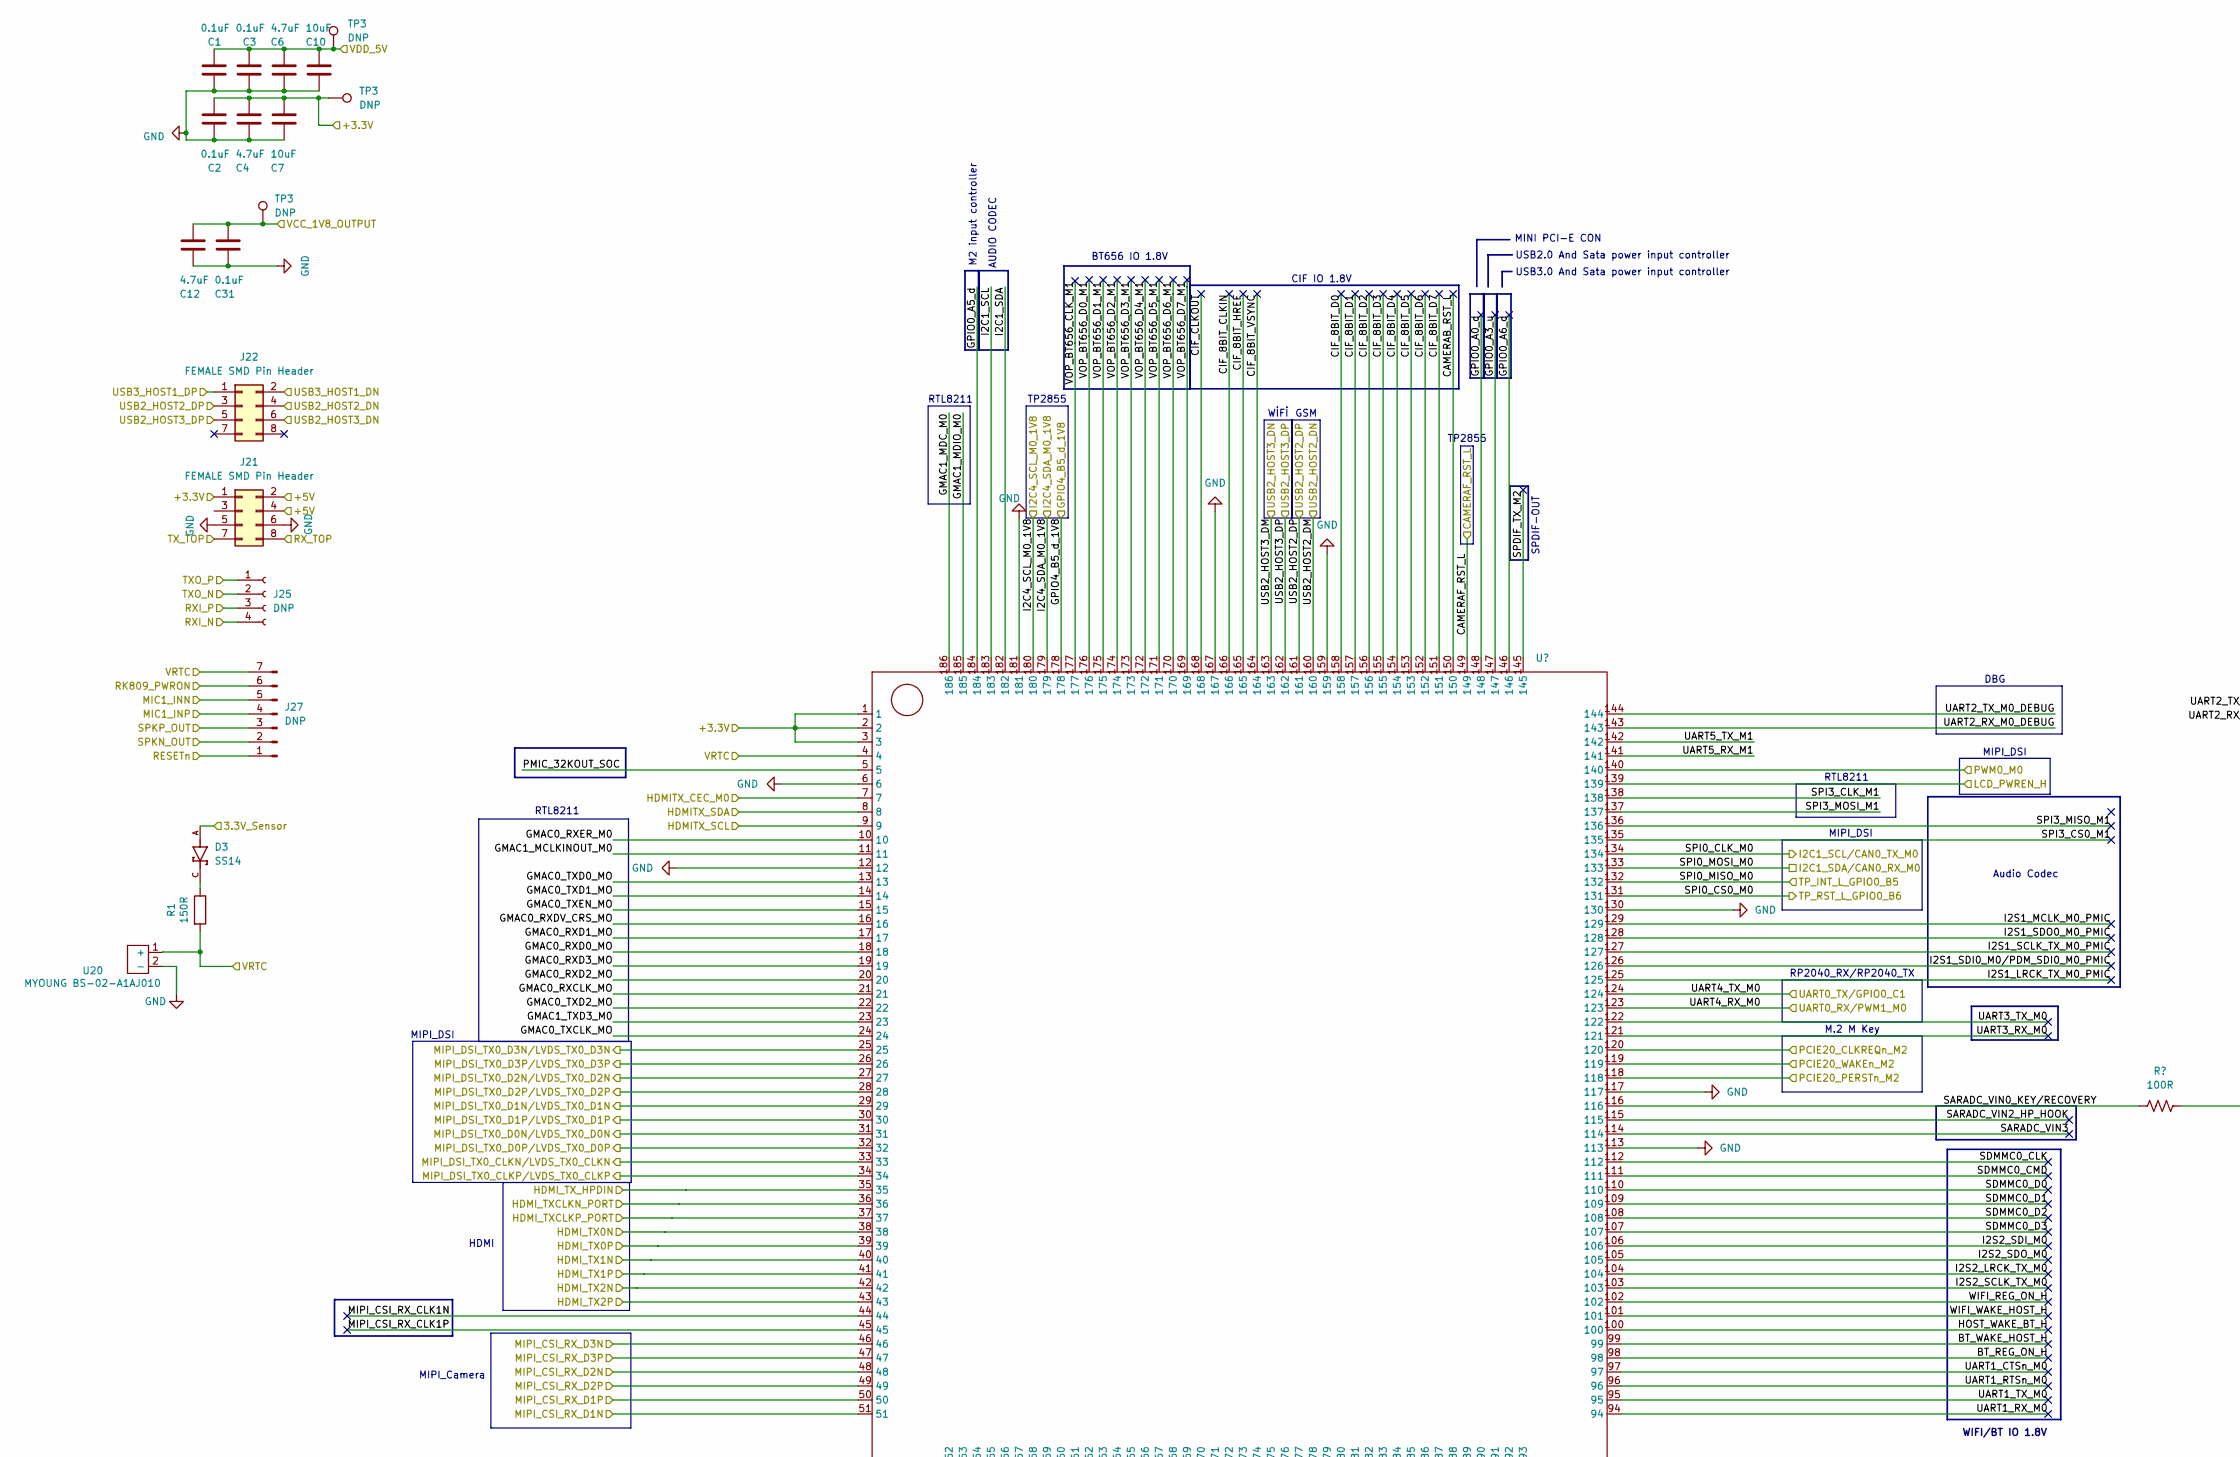
[picture p179: schematic CM3568.kicad_sch, part in row 1, column 1]

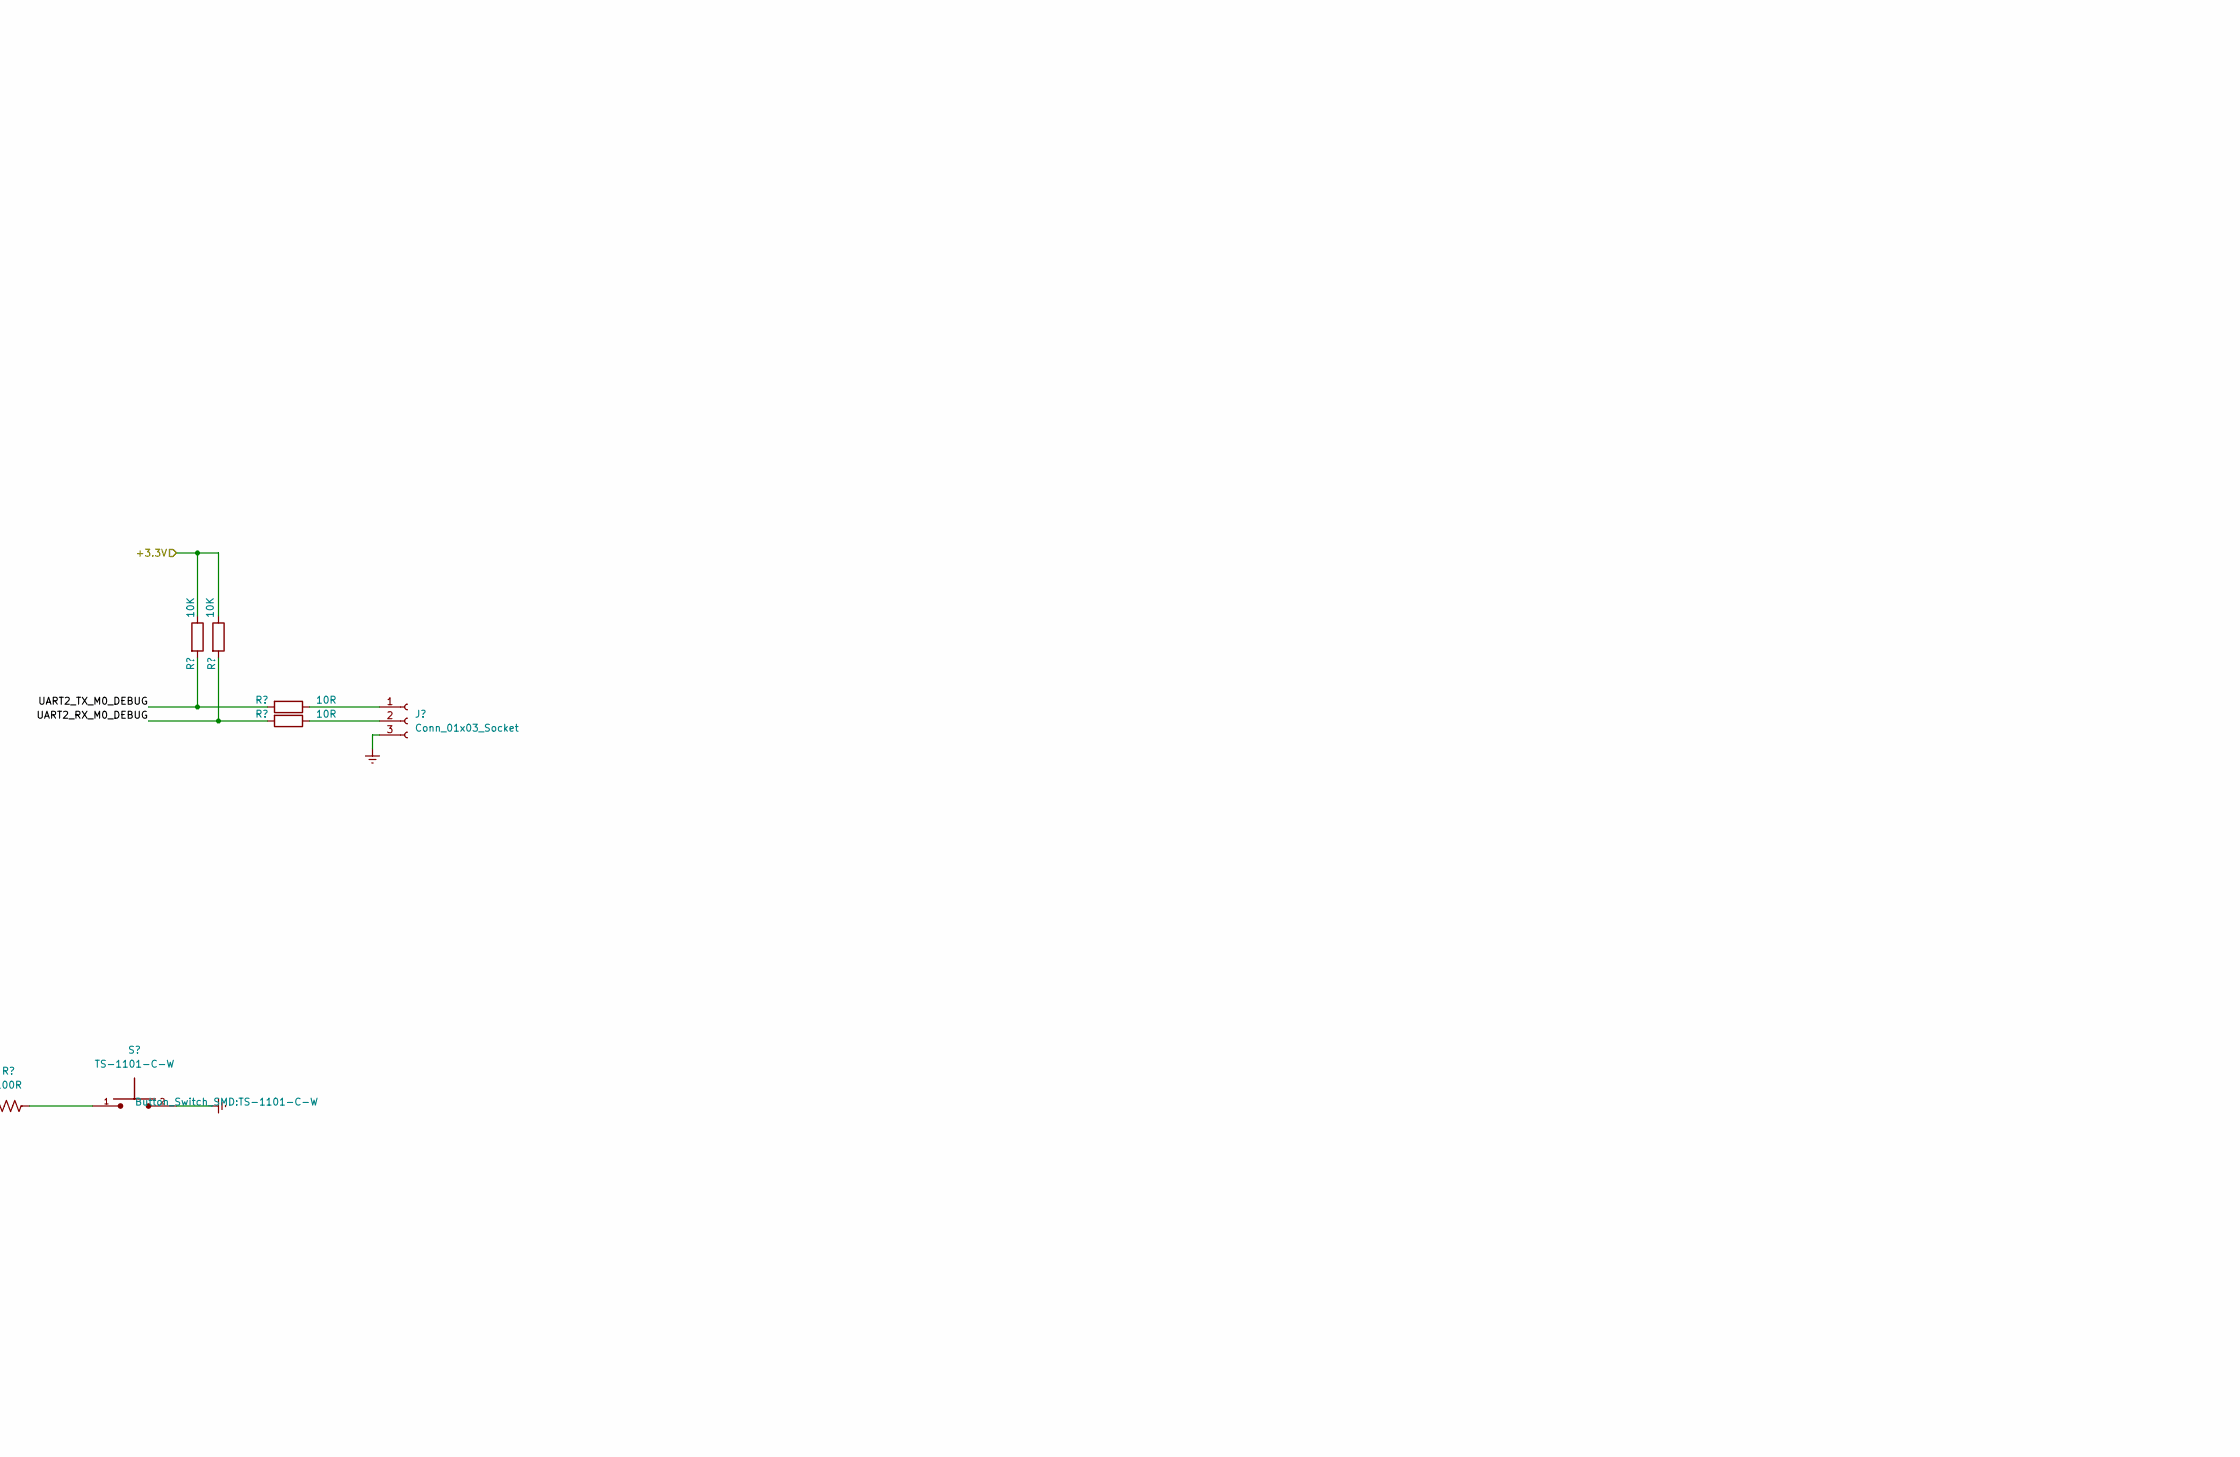
[picture p180: schematic CM3568.kicad_sch, part in row 1, column 2]

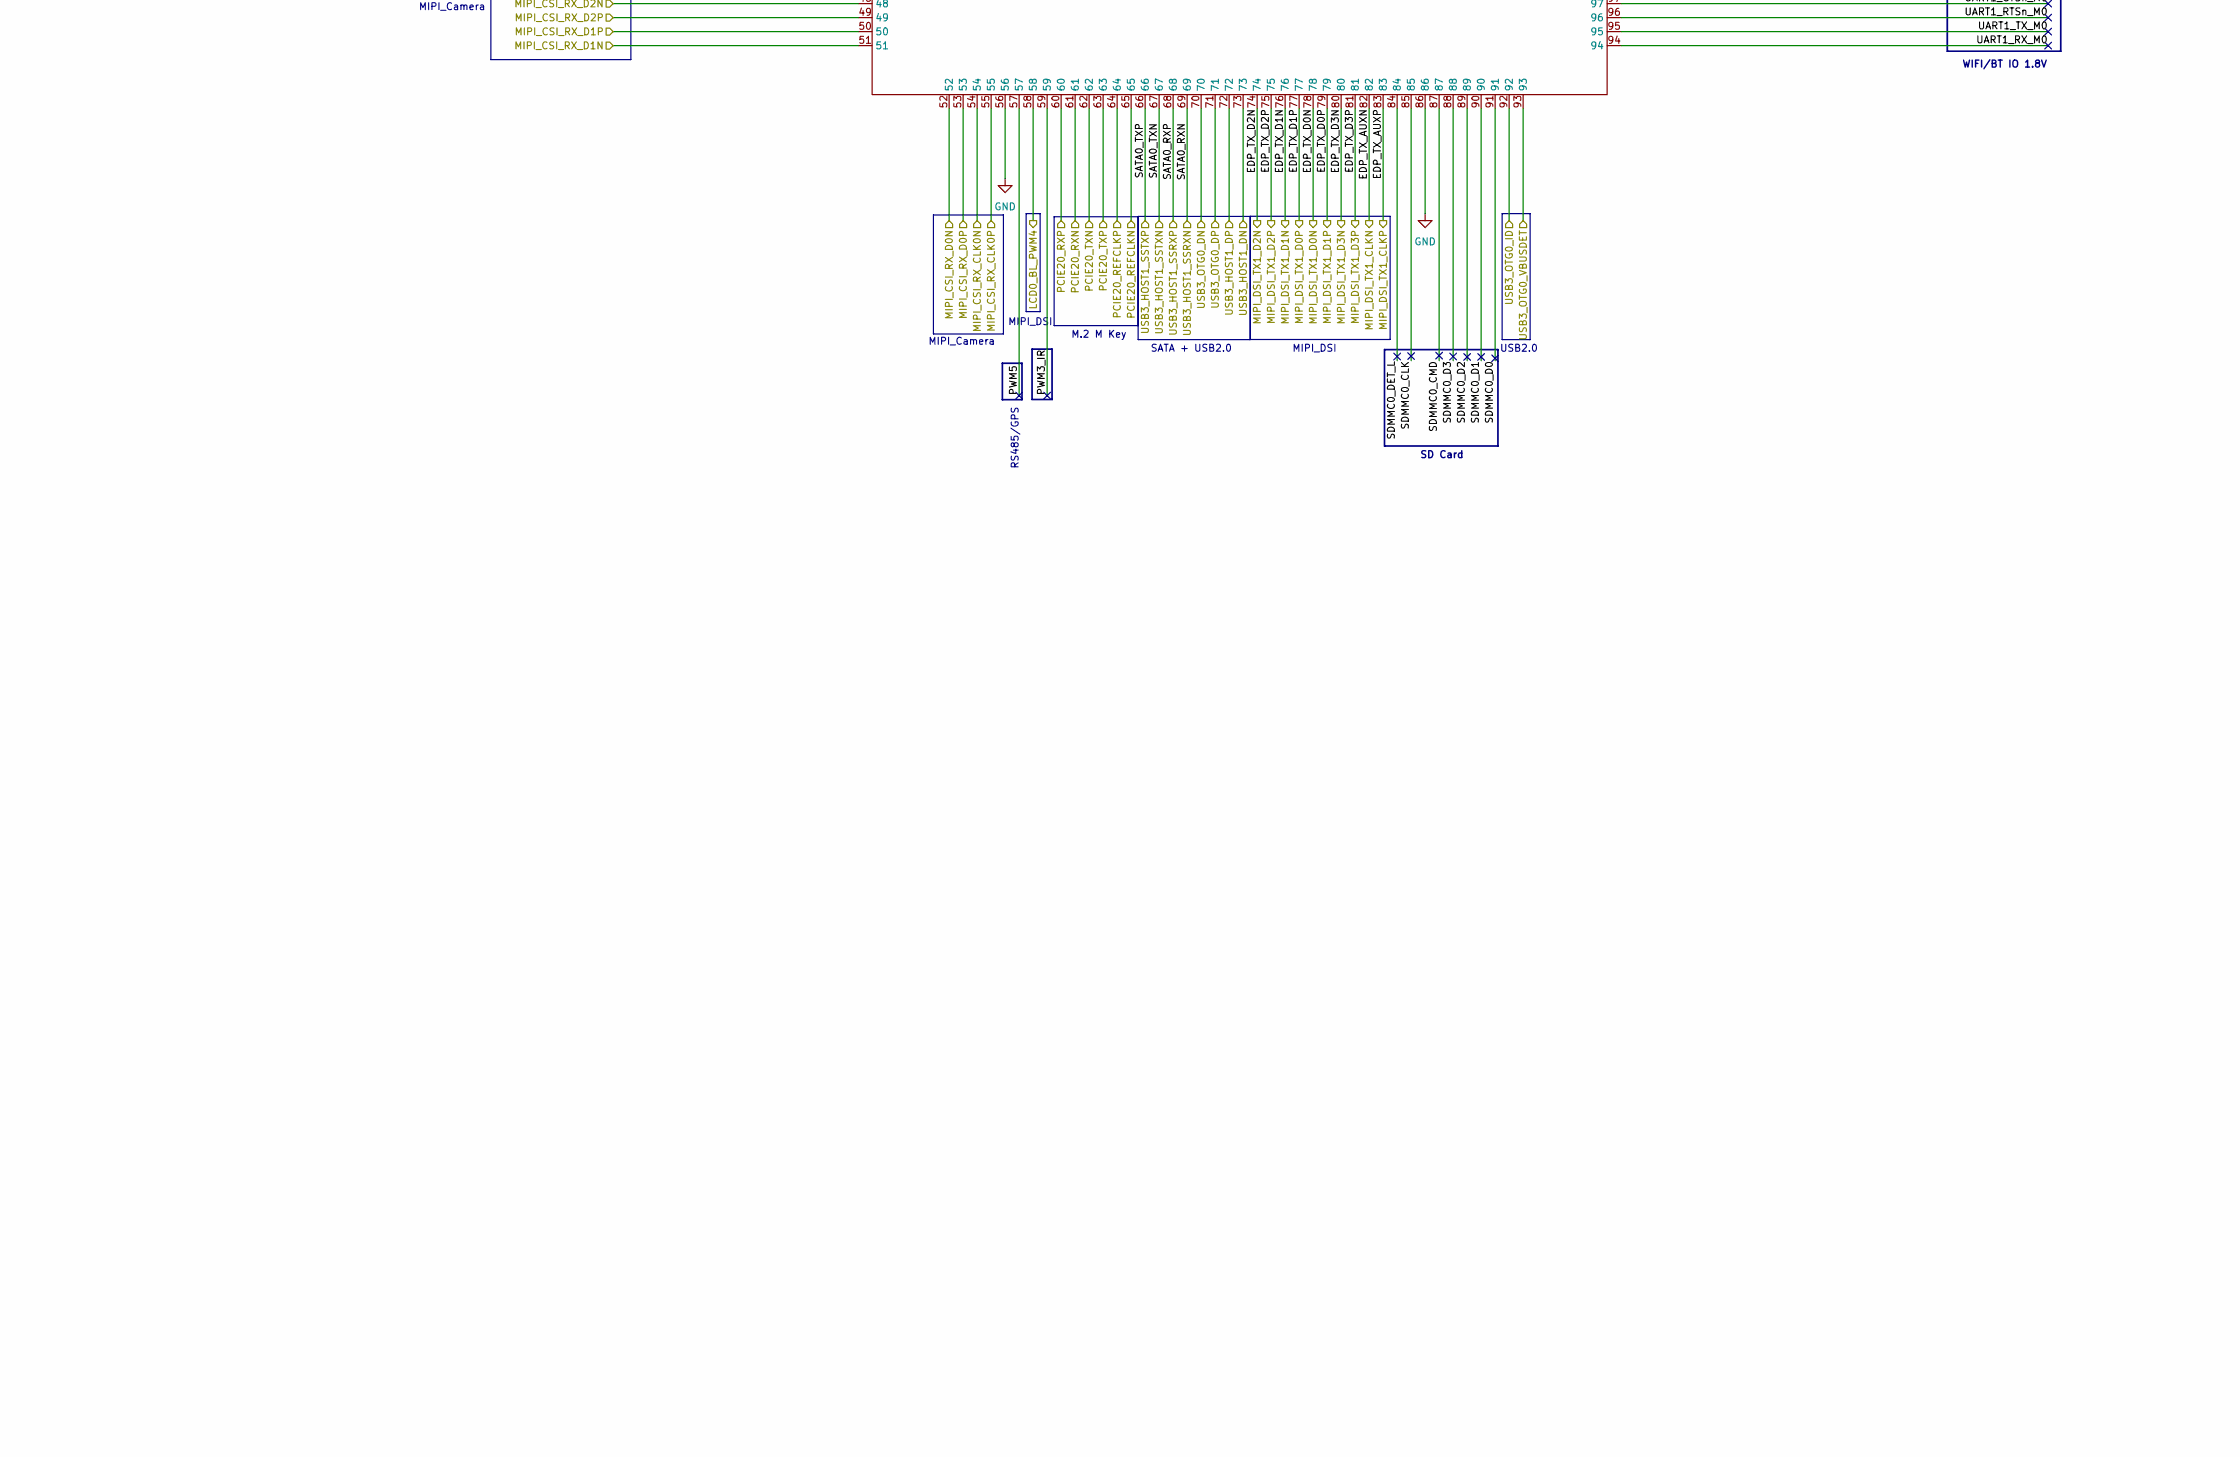
[picture p181: schematic CM3568.kicad_sch, part in row 2, column 1]

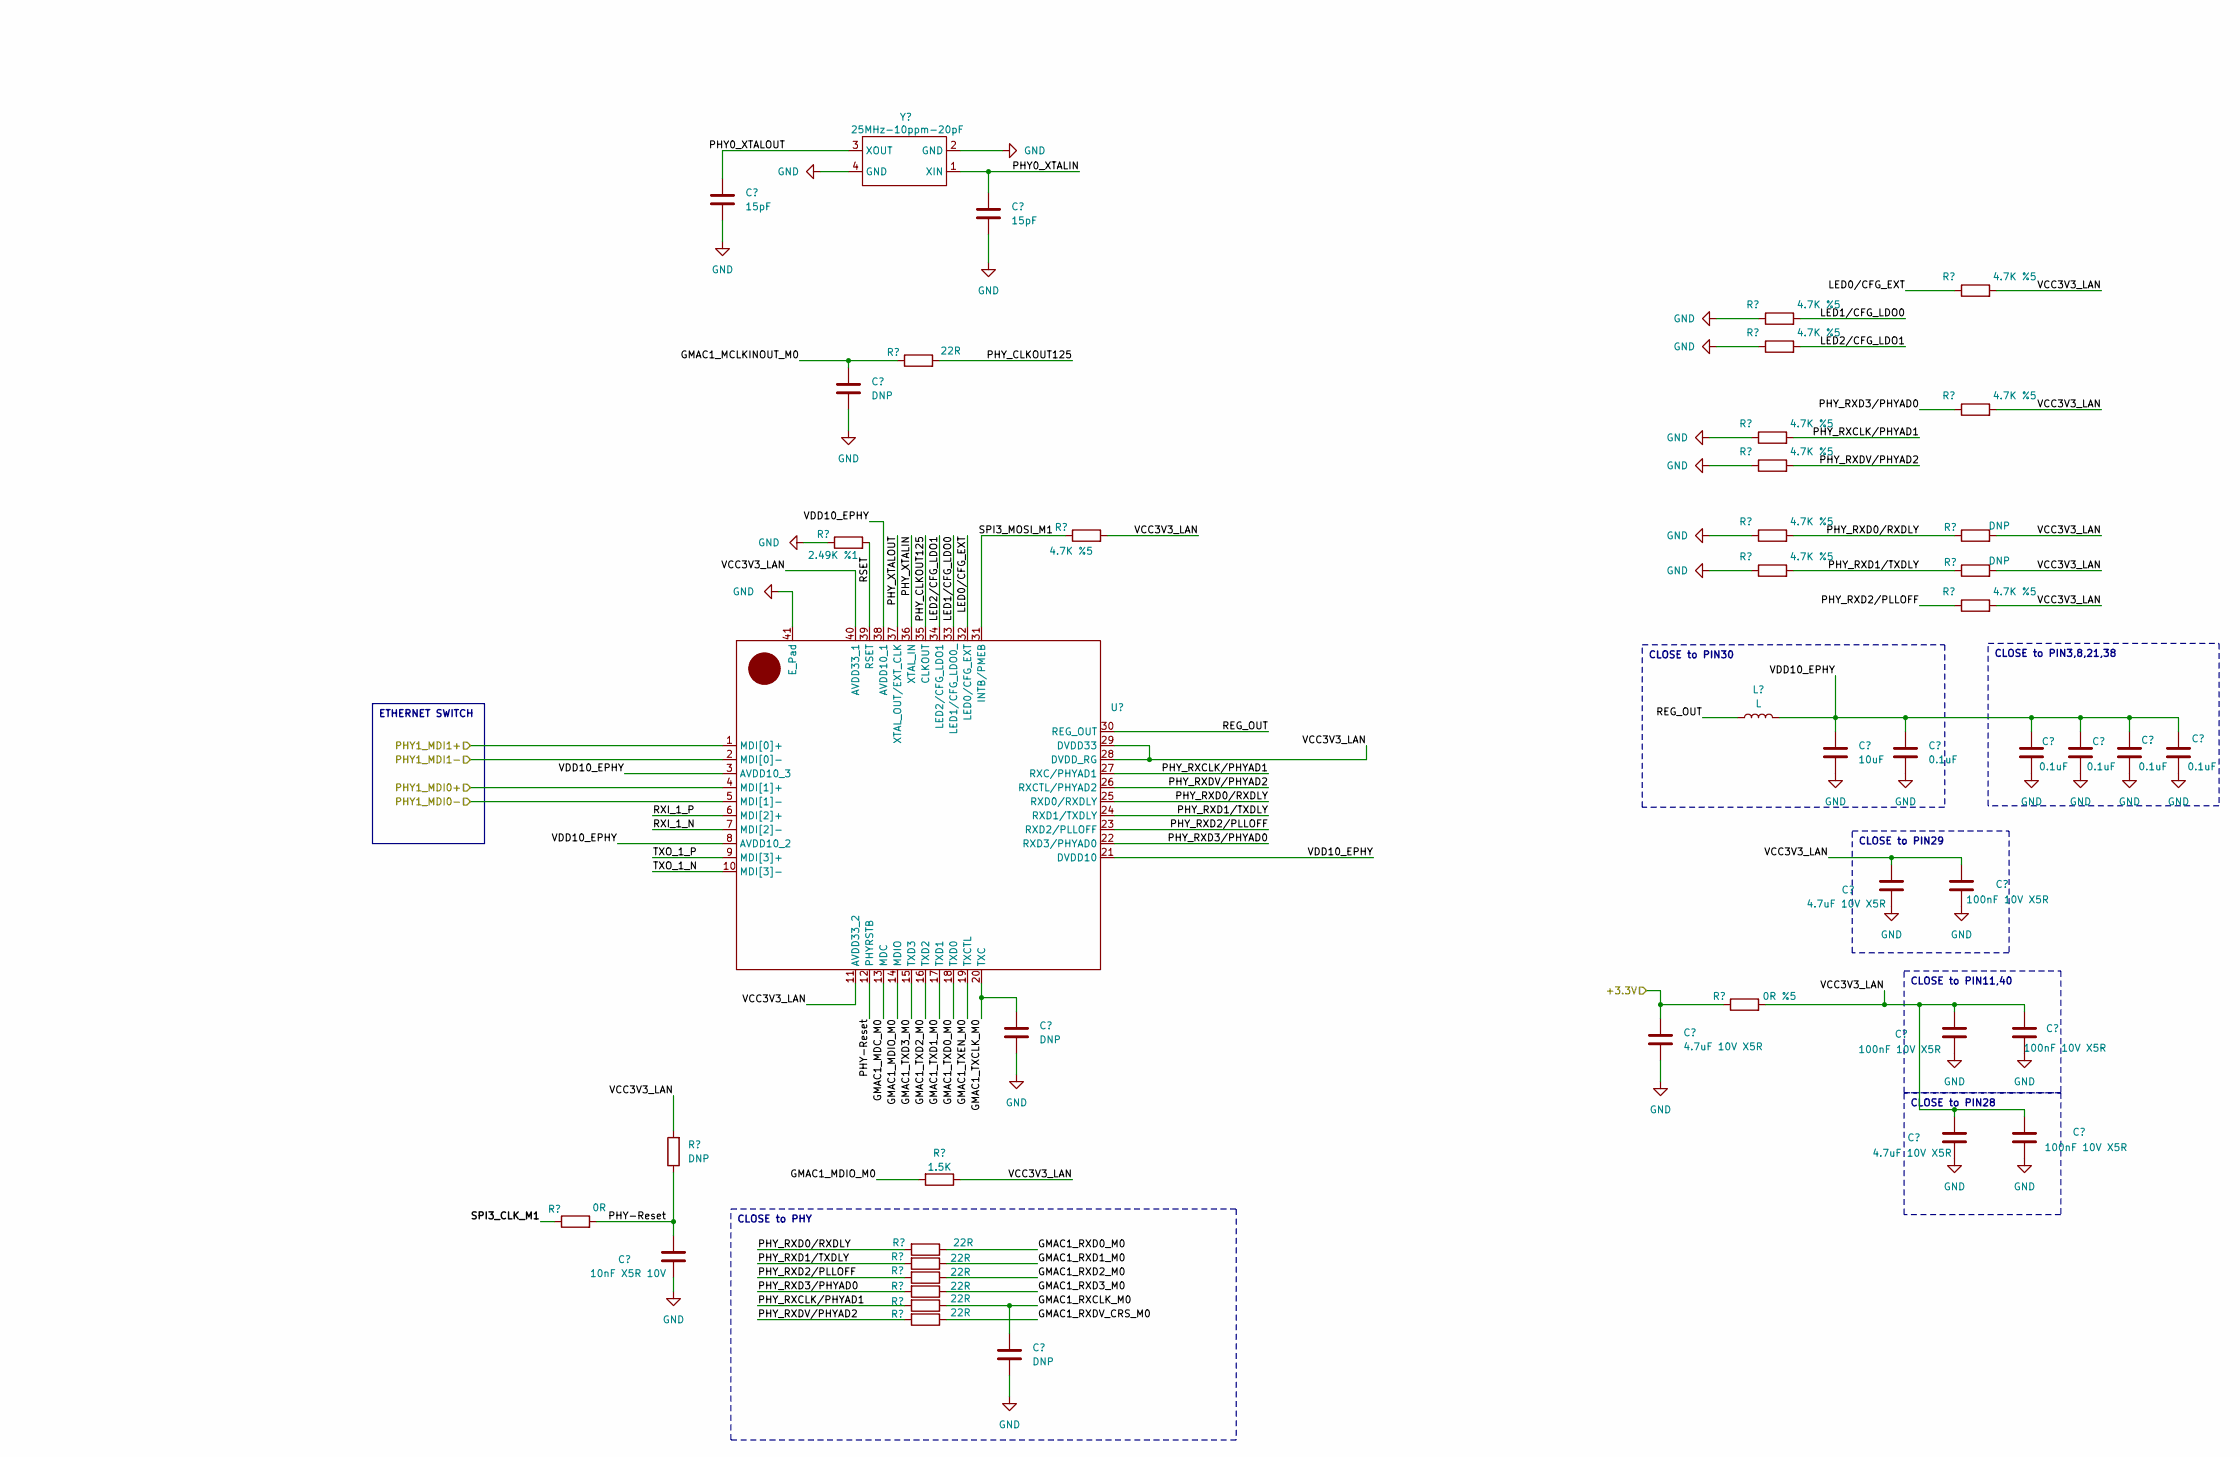
[picture p182: schematic CM3568.kicad_sch, part in row 2, column 2]

Parts:
C1, C2, C3, C31: 0.1uF; C_0603_1608Metric
C4, C6, C12: 4.7uF; C_0603_1608Metric
C7, C10: 10uF; C_0603_1608Metric
D3: SS14; DIOM4325X250N; PARTREV O2102
J21, J22: FEMALE SMD Pin Header; PinSocket_2x04_P2.54mm_Vertical_SMD
J25: DNP; PinHeader_2x02_P2.54mm_Vertical_SMD
J27: DNP; PinHeader_1x07_P1.00mm_Vertical
R1: 150R; R_0603_1608Metric
TP3: DNP; Pin_D1.0mm_L10.0mm
U20: MYOUNG BS-02-A1AJ010; BS-02-A1AJ010

Connections:
3.3V_Sensor: D3.A
+3.3V: C2.1, C4.1, C7.1, J21.1, TP3.1
+5V: J21.2, J21.4
GND: C1.2, C2.2, C3.2, C4.2, C6.2, C7.2, C10.2, C12.2, C31.2, J21.5, J21.6, U20.2 (-)
MIC1_INN: J27.5
MIC1_INP: J27.4
unnamed: D3.C, R1.1
RESETn: J27.1
RK809_PWRON: J27.6
RXI_N: J25.4
RXI_P: J25.3
RX_TOP: J21.8
SPKN_OUT: J27.2
SPKP_OUT: J27.3
TXO_N: J25.2
TXO_P: J25.1
TX_TOP: J21.7
USB2_HOST2_DM: J22.4
USB2_HOST2_DP: J22.3
USB2_HOST3_DM: J22.6
USB2_HOST3_DP: J22.5
USB3_HOST1_DN: J22.2
USB3_HOST1_DP: J22.1
VCC_1V8_OUTPUT: C12.1, C31.1, TP3.1
VDD_5V: C1.1, C3.1, C6.1, C10.1, TP3.1
VRTC: J27.7, R1.2, U20.1 (+)

Notes on the sheet:
CLOSE to PIN30
CLOSE to PIN11,40
CLOSE to PIN3,8,21,38
CLOSE to PIN28
CLOSE to PHY
ETHERNET SWITCH
CLOSE to PIN29
MIPI_DSI
MINI PCI-E CON
RP2040_RX/RP2040_TX
RTL8211
MIPI_Camera
BT656 IO 1.8V
RTL8211
AUDIO CODEC
CIF IO 1.8V
DBG
SATA + USB2.0
M2 input controller
TP2855
TP2855
M.2 M Key
Audio Codec
MIPI_DSI
WIFI/BT IO 1.8V
SD Card
SPDIF-OUT
USB2.0
USB3.0 And Sata power input controller
USB2.0 And Sata power input controller
HDMI
GSM
WİFİ
RS485/GPS
