ihsanakyrk/Eski-Versionlar-Ve-Siparisler/Movita_XV500_Router_V4.0/CSI_AHD.kicad_sch

## KiCad design Movita_XV500_Router_V4.0/CSI_AHD.kicad_sch (2025-09-01)

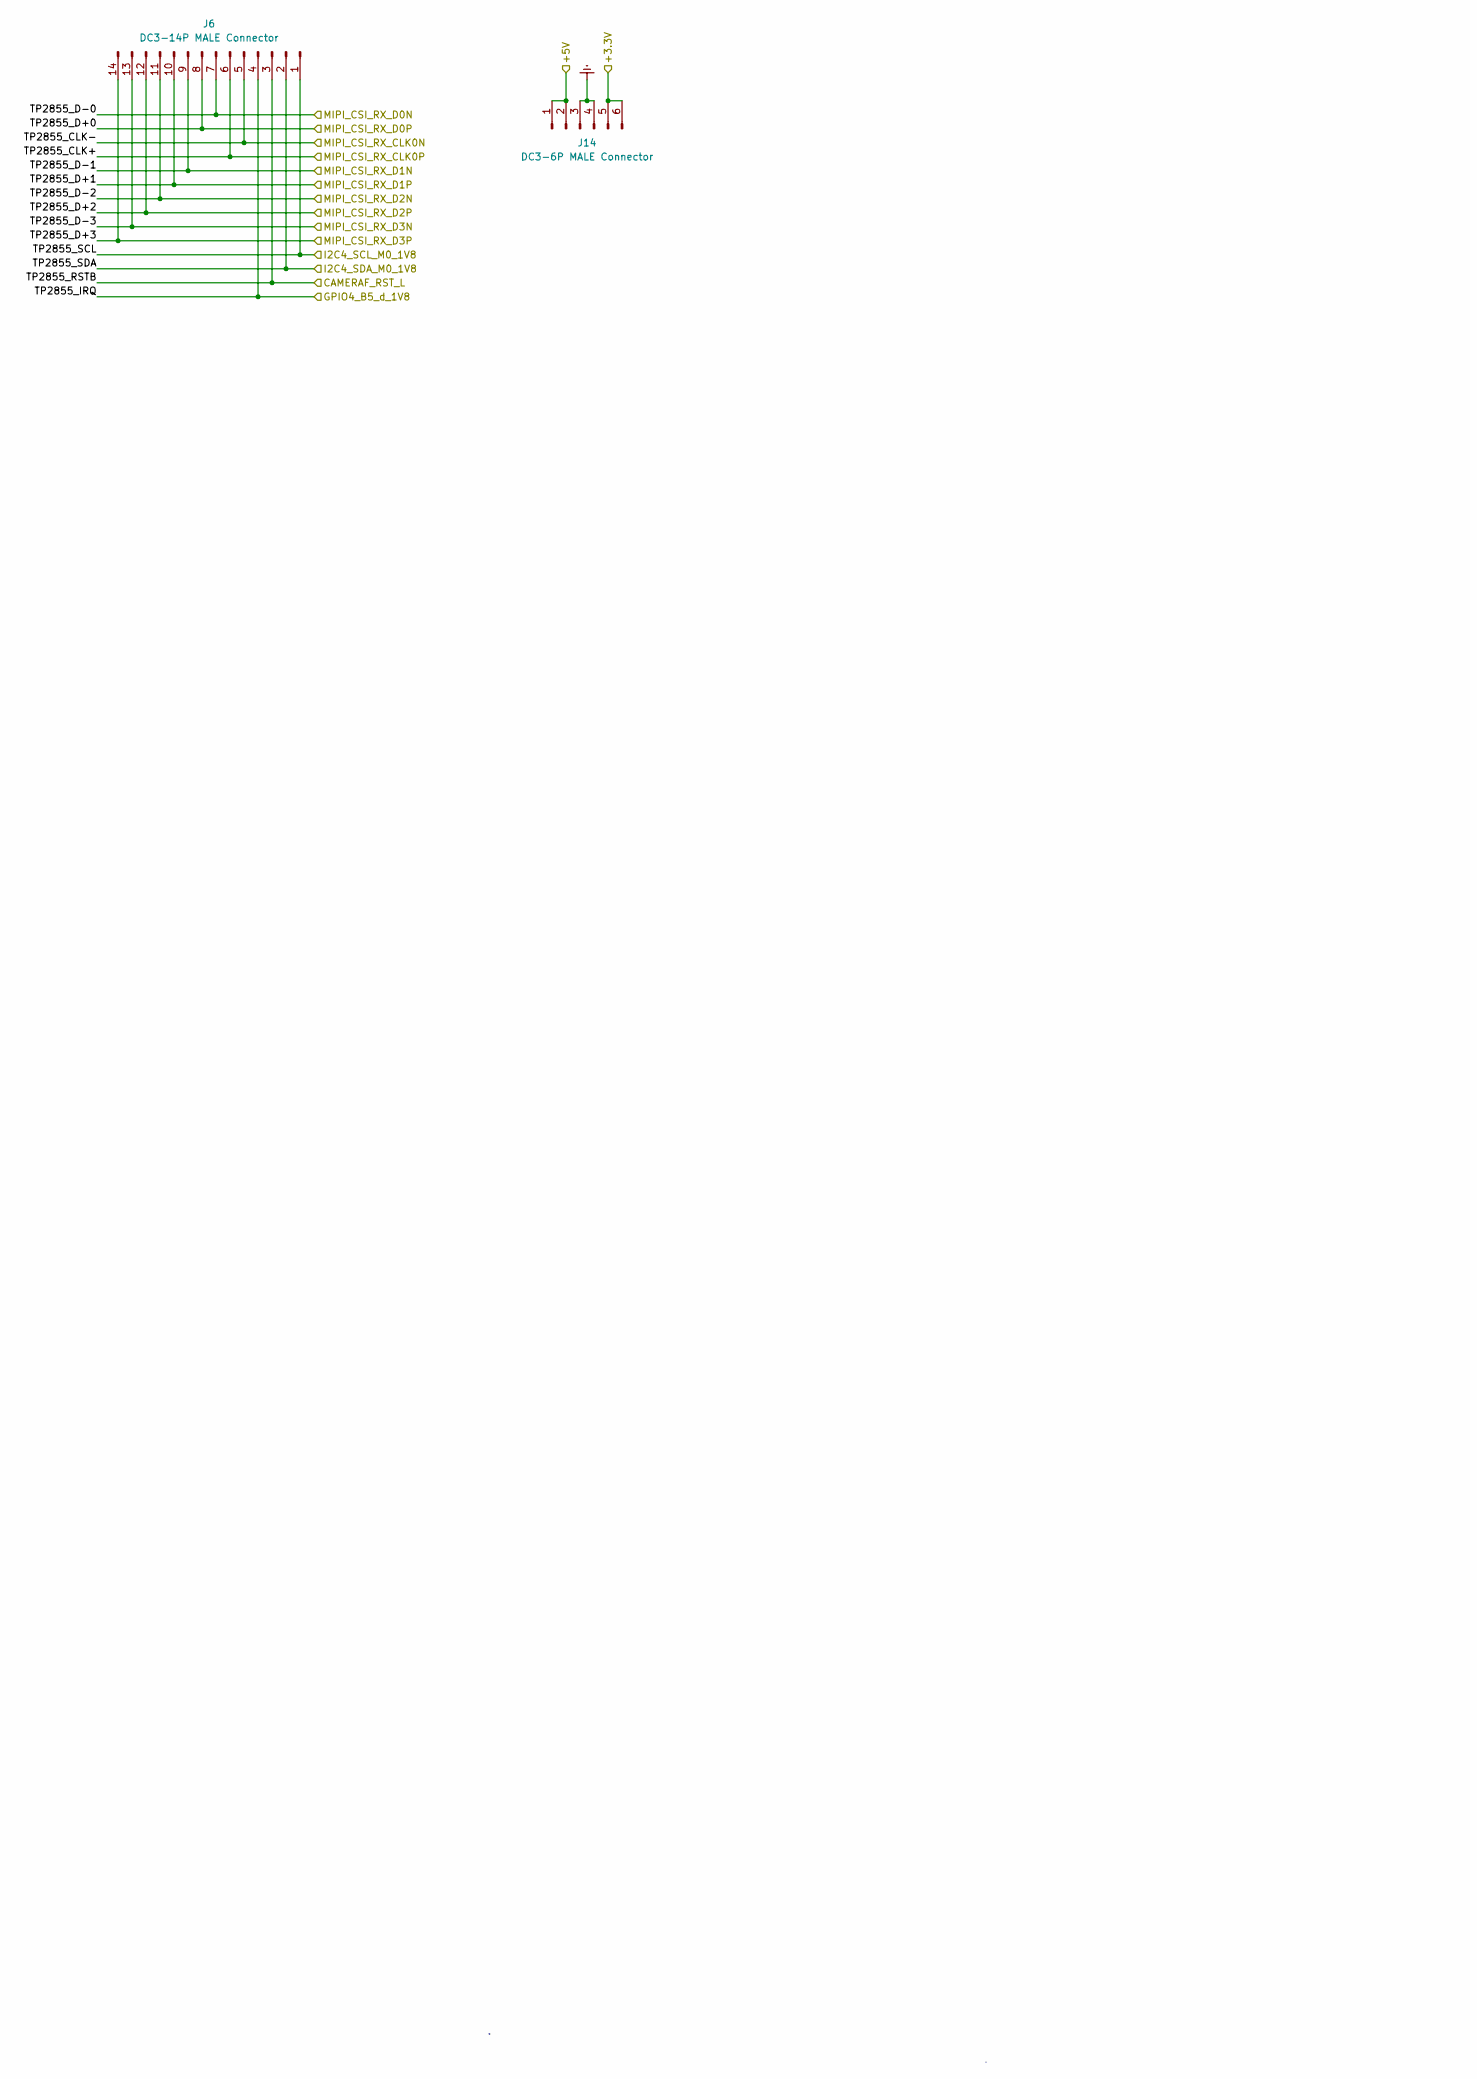
[picture p183: schematic CSI_AHD.kicad_sch, part in row 1, column 1]

Parts:
J6: DC3-14P MALE Connector; Analog connector; MPN DC3-14P MALE Connector
J14: DC3-6P MALE Connector; Analog power connector

Connections:
+3.3V: J14.5, J14.6
+5V: J14.1, J14.2
CAMERAF_RST_L: J6.3
Earth: J14.3, J14.4
GPIO4_B5_d_1V8: J6.4
I2C4_SCL_M0_1V8: J6.1
I2C4_SDA_M0_1V8: J6.2
MIPI_CSI_RX_CLK0N: J6.5
MIPI_CSI_RX_CLK0P: J6.6
MIPI_CSI_RX_D0N: J6.7
MIPI_CSI_RX_D0P: J6.8
MIPI_CSI_RX_D1N: J6.9
MIPI_CSI_RX_D1P: J6.10
MIPI_CSI_RX_D2N: J6.11
MIPI_CSI_RX_D2P: J6.12
MIPI_CSI_RX_D3N: J6.13
MIPI_CSI_RX_D3P: J6.14
