ihsanakyrk/Eski-Versionlar-Ve-Siparisler/Movita_XV500_Router_V4.0/Connectors.kicad_sch

## KiCad design Movita_XV500_Router_V4.0/Connectors.kicad_sch (2025-09-01)

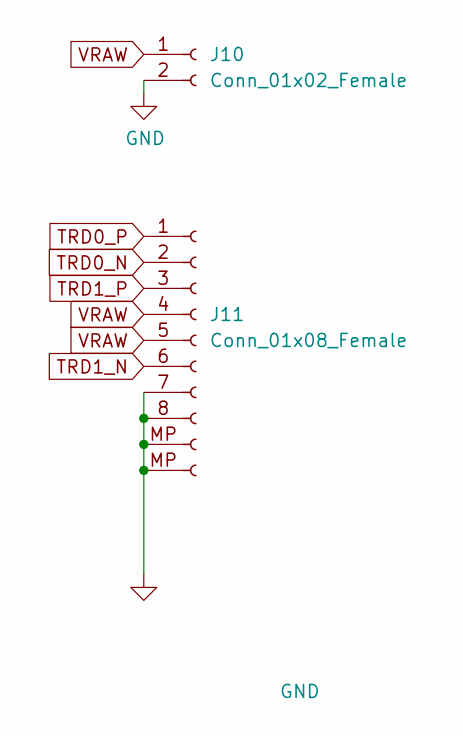
[picture p184: schematic Connectors.kicad_sch]

Parts:
J10: Conn_01x02_Female; JST_PH_B2B-PH-K_1x02_P2.00mm_Vertical
J11: Conn_01x08_Female; JST_SH_BM08B-SRSS-TB_1x08-1MP_P1.00mm_Vertical

Connections:
GND: J10.2, J11.7, J11.8, J11.MP
TRD0_N: J11.2
TRD0_P: J11.1
TRD1_N: J11.6
TRD1_P: J11.3
VRAW: J10.1, J11.4, J11.5
