ihsanakyrk/Eski-Versionlar-Ve-Siparisler/Movita_XV500_Router_V4.0/EC25_Sim.kicad_sch

## KiCad design Movita_XV500_Router_V4.0/EC25_Sim.kicad_sch (2025-09-01)

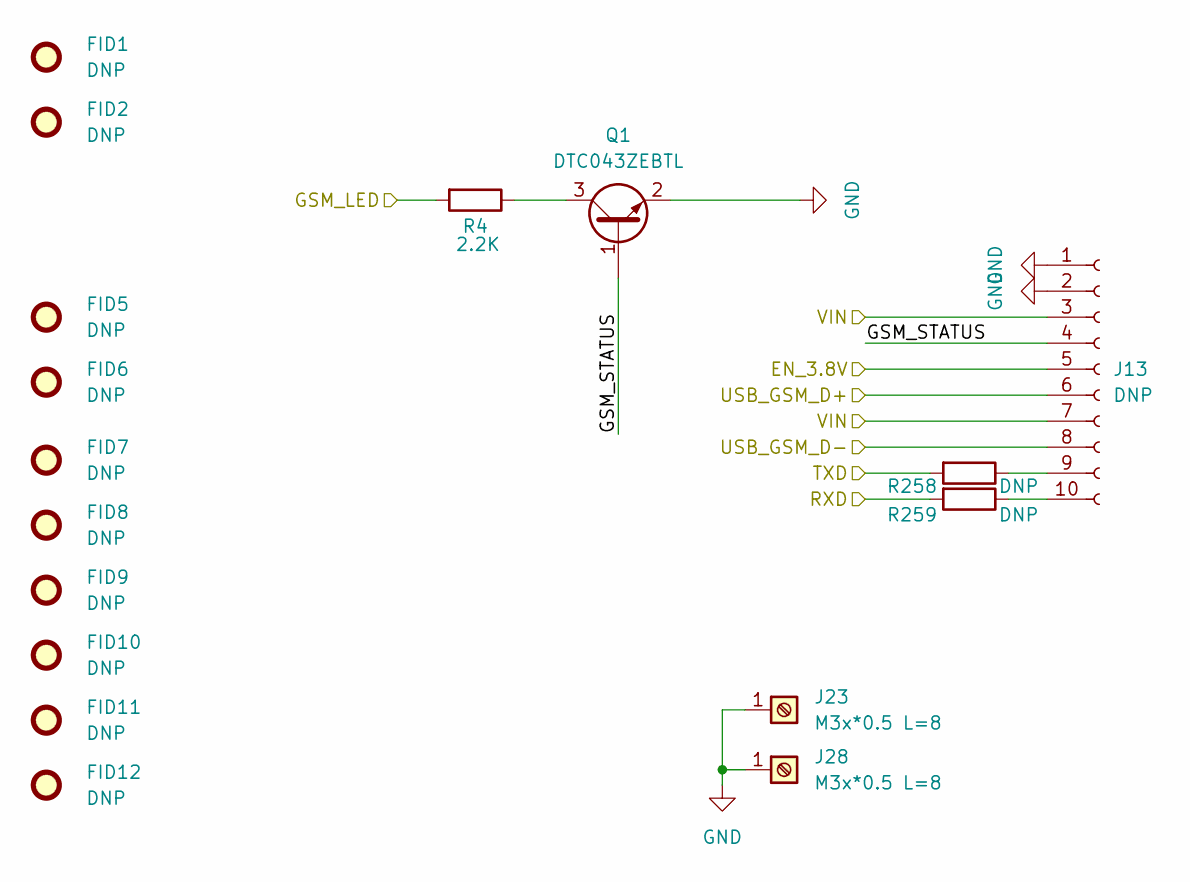
[picture p185: schematic EC25_Sim.kicad_sch]

Parts:
FID1, FID2, FID5, FID6, FID7, FID8, FID9, FID10, FID11, FID12: DNP; Fiducial_0.5mm_Mask1mm
J13: DNP; PinSocket_2x05_P2.00mm_Vertical_SMD; MPN 2.0mm 2*5p 贴片排针
J23, J28: M3x*0.5 L=8; Screw Terminal Shinbo; MPN SMTSO-M3-8ET
Q1: DTC043ZEBTL; SOT-416; MPN DTC043ZEBTL
R4: 2.2K; R_0603_1608Metric; MPN 0603WAF2201T5E
R258, R259: DNP; R_0603_1608Metric

Connections:
EN_3.8V: J13.5
GND: J13.1, J13.2, J23.1, J28.1, Q1.2 (E)
GSM_LED: R4.2
GSM_STATUS: J13.4, Q1.1 (B)
unnamed: J13.9, R258.1
unnamed: J13.10, R259.1
unnamed: Q1.3 (C), R4.1
RXD: R259.2
TXD: R258.2
USB_GSM_D+: J13.6
USB_GSM_D-: J13.8
VIN: J13.3, J13.7
