ihsanakyrk/Eski-Versionlar-Ve-Siparisler/Movita_XV500_Router_V4.0/GPIO_Manager.kicad_sch

## KiCad design Movita_XV500_Router_V4.0/GPIO_Manager.kicad_sch (2025-09-01)

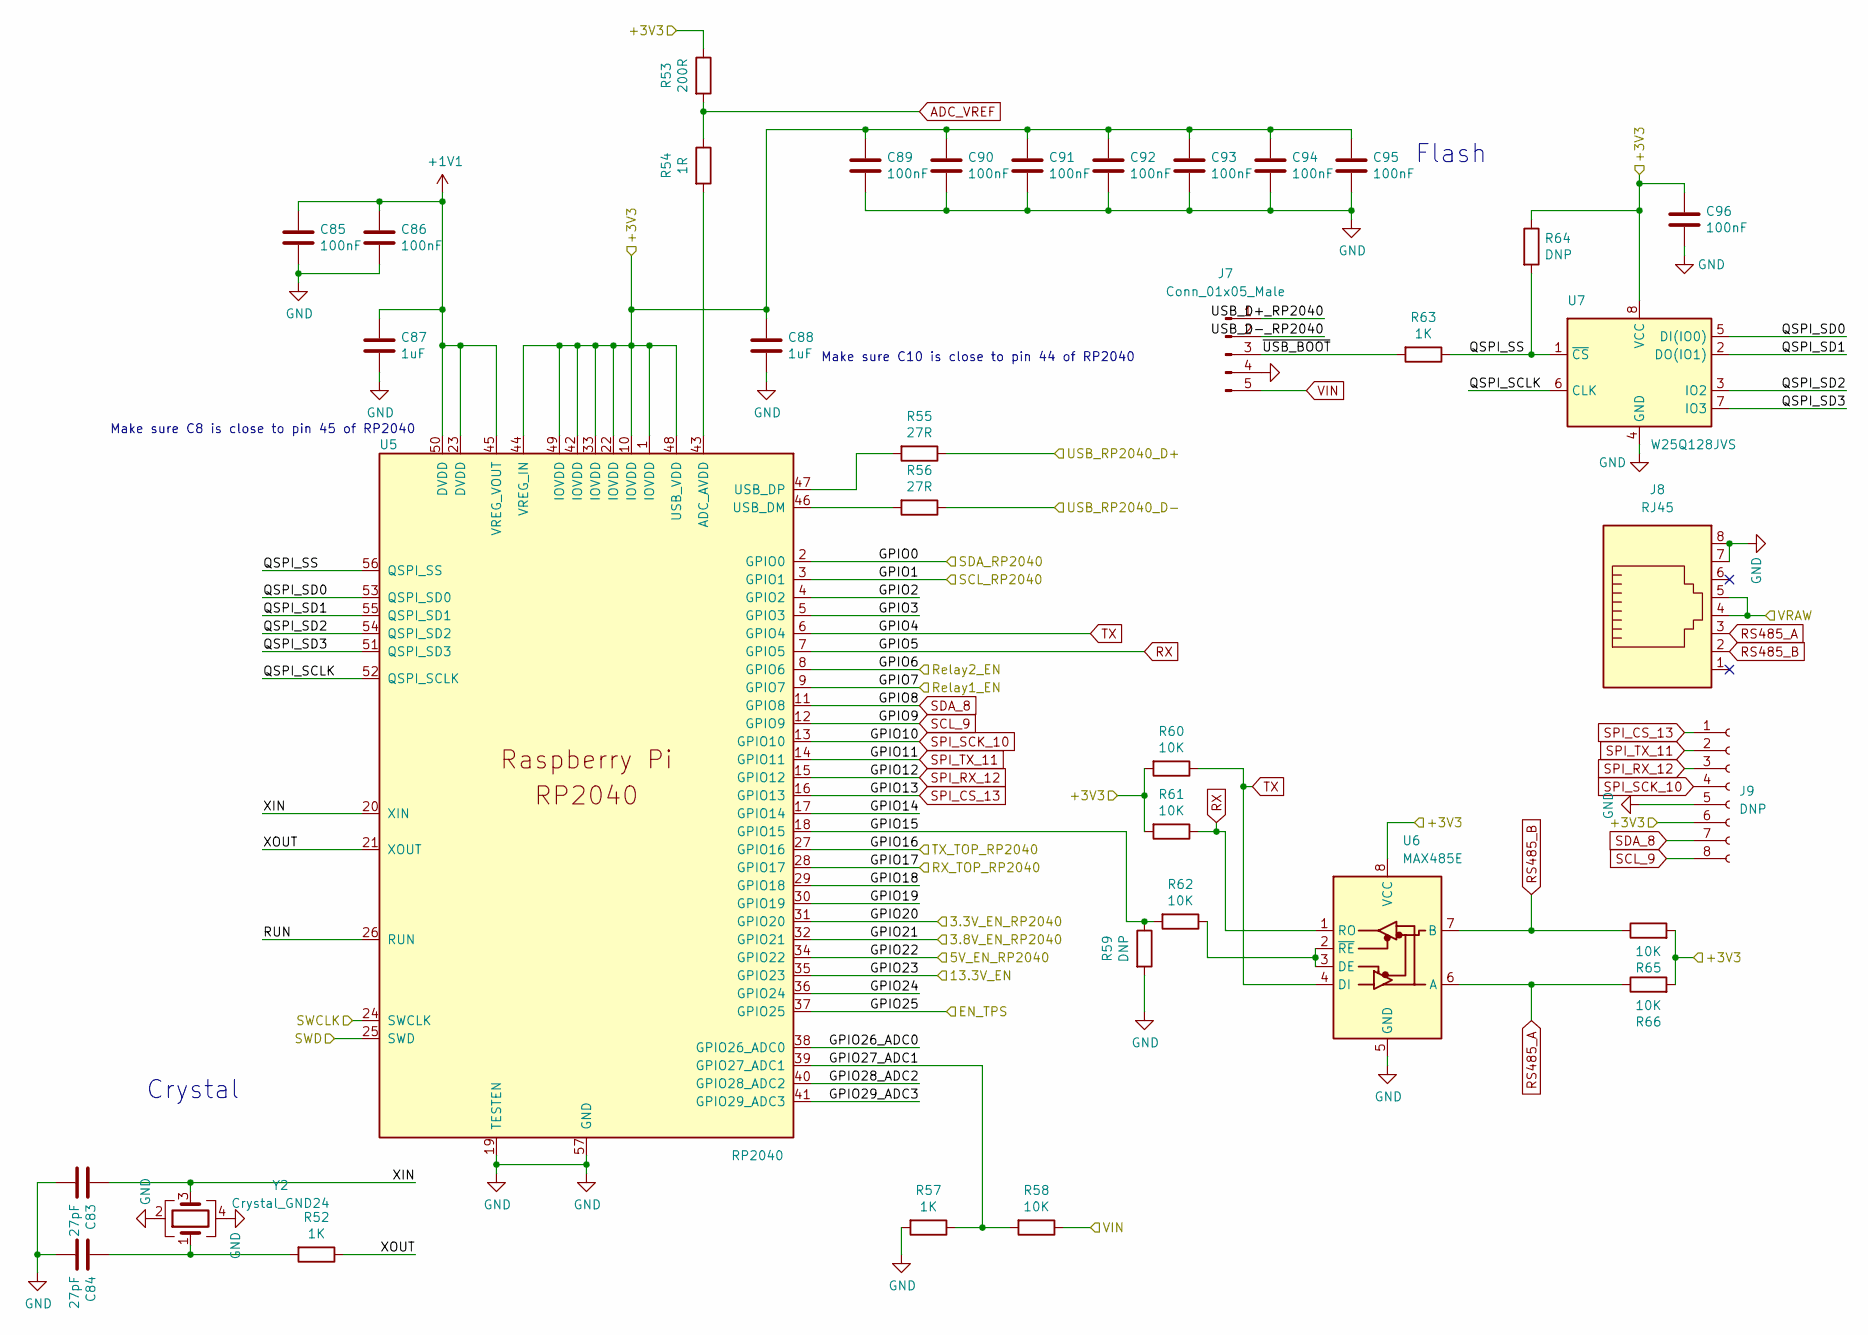
[picture p186: schematic GPIO_Manager.kicad_sch]

Parts:
C83, C84: 27pF; C_0402_1005Metric
C85, C86, C89, C90, C91, C92, C93, C94, C95, C96: 100nF; C_0402_1005Metric
C87, C88: 1uF; C_0402_1005Metric
J7: Conn_01x05_Male; PinSocket_1x05_P2.00mm_Vertical
J8: RJ45; RJ45_Amphenol_54602-x08_Horizontal_etrafitemiz
J9: DNP; PinHeader_1x08_P2.54mm_Vertical_SMD_Pin1Right
R52, R57, R63: 1K; R_0603_1608Metric
R53: 200R; R_0603_1608Metric
R54: 1R; R_0603_1608Metric
R55, R56: 27R; R_0603_1608Metric
R58, R60, R61, R62, R65, R66: 10K; R_0603_1608Metric
R59, R64: DNP; R_0603_1608Metric
U5: RP2040; RP2040-QFN-56
U6: MAX485E; SOIC127P600X175-8N
U7: W25Q128JVS; SOIC-8_5.23x5.23mm_P1.27mm
Y2: Crystal_GND24; Crystal_SMD_3225-4Pin_3.2x2.5mm

Connections:
3.3V_EN_RP2040: U5.31 (GPIO20)
3.8V_EN_RP2040: U5.32 (GPIO21)
5V_EN_RP2040: U5.34 (GPIO22)
13.3V_EN: U5.35 (GPIO23)
+1V1: C85.1, C86.1, C87.1, U5.23 (DVDD), U5.45 (VREG_VOUT), U5.50 (DVDD)
+3V3: C88.1, C89.1, C90.1, C91.1, C92.1, C93.1, C94.1, C95.1, C96.1, J9.6, R53.1, R60.2, R61.2, R64.1, R65.2, R66.2, U5.1 (IOVDD), U5.10 (IOVDD), U5.22 (IOVDD), U5.33 (IOVDD), U5.42 (IOVDD), U5.44 (VREG_IN), U5.48 (USB_VDD), U5.49 (IOVDD), U6.8 (VCC), U7.8 (VCC)
ADC_VREF: R53.2, R54.1
EN_TPS: U5.37 (GPIO25)
GND: C83.2, C84.2, C85.2, C86.2, C87.2, C88.2, C89.2, C90.2, C91.2, C92.2, C93.2, C94.2, C95.2, C96.2, J7.4, J8.7, J8.8, J9.5, R57.2, R59.2, U5.19 (TESTEN), U5.57 (GND), U6.5 (GND), U7.4 (GND), Y2.2, Y2.4
GPIO0: U5.2 (GPIO0)
GPIO1: U5.3 (GPIO1)
GPIO2: U5.4 (GPIO2)
GPIO3: U5.5 (GPIO3)
GPIO6: U5.8 (GPIO6)
GPIO7: U5.9 (GPIO7)
GPIO14: U5.17 (GPIO14)
GPIO15: R59.1, R62.2, U5.18 (GPIO15)
GPIO16: U5.27 (GPIO16)
GPIO17: U5.28 (GPIO17)
GPIO18: U5.29 (GPIO18)
GPIO19: U5.30 (GPIO19)
GPIO24: U5.36 (GPIO24)
GPIO26_ADC0: U5.38 (GPIO26_ADC0)
GPIO27_ADC1: R57.1, R58.2, U5.39 (GPIO27_ADC1)
GPIO28_ADC2: U5.40 (GPIO28_ADC2)
GPIO29_ADC3: U5.41 (GPIO29_ADC3)
unnamed: C84.1, R52.2, Y2.1
unnamed: R54.2, U5.43 (ADC_AVDD)
unnamed: R55.2, U5.47 (USB_DP)
unnamed: R56.2, U5.46 (USB_DM)
unnamed: R62.1, U6.2 (~RE), U6.3 (DE)
QSPI_SCLK: U5.52 (QSPI_SCLK), U7.6 (CLK)
QSPI_SD0: U5.53 (QSPI_SD0), U7.5 (DI(IO0))
QSPI_SD1: U5.55 (QSPI_SD1), U7.2 (DO(IO1))
QSPI_SD2: U5.54 (QSPI_SD2), U7.3 (IO2)
QSPI_SD3: U5.51 (QSPI_SD3), U7.7 (IO3)
QSPI_SS: R63.1, R64.2, U5.56 (QSPI_SS), U7.1 (~CS)
RS485_A: J8.3, R66.1, U6.6 (A)
RS485_B: J8.2, R65.1, U6.7 (B)
RUN: U5.26 (RUN)
RX: R61.1, U5.7 (GPIO5), U6.1 (RO)
SCL_9: J9.8, U5.12 (GPIO9)
SDA_8: J9.7, U5.11 (GPIO8)
SPI_CS_13: J9.1, U5.16 (GPIO13)
SPI_RX_12: J9.3, U5.15 (GPIO12)
SPI_SCK_10: J9.4, U5.13 (GPIO10)
SPI_TX_11: J9.2, U5.14 (GPIO11)
SWCLK: U5.24 (SWCLK)
SWD: U5.25 (SWD)
TX: R60.1, U5.6 (GPIO4), U6.4 (DI)
USB_D+_RP2040: J7.1
USB_D-_RP2040: J7.2
USB_RP2040_D+: R55.1
USB_RP2040_D-: R56.1
VIN: J7.5, R58.1
VRAW: J8.4, J8.5
XIN: C83.1, U5.20 (XIN), Y2.3
XOUT: R52.1, U5.21 (XOUT)
~USB_BOOT: J7.3, R63.2

Notes on the sheet:
Make sure C10 is close to pin 44 of RP2040
Make sure C8 is close to pin 45 of RP2040
Flash
Crystal
