ihsanakyrk/Eski-Versionlar-Ve-Siparisler/Movita_XV500_Router_V4.0/HDMI 2.0 TX.kicad_sch

## KiCad design Movita_XV500_Router_V4.0/HDMI 2.0 TX.kicad_sch (2025-09-01)

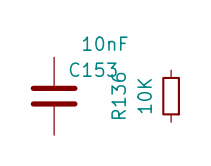
[picture p187: schematic HDMI 2.0 TX.kicad_sch]

Parts:
C153: 10nF; C_01005_0402Metric
R136: 10K; R_0402_1005Metric
