ihsanakyrk/Eski-Versionlar-Ve-Siparisler/Movita_XV500_Router_V4.0/HDMI_CVBS.kicad_sch

## KiCad design Movita_XV500_Router_V4.0/HDMI_CVBS.kicad_sch (2025-09-01)

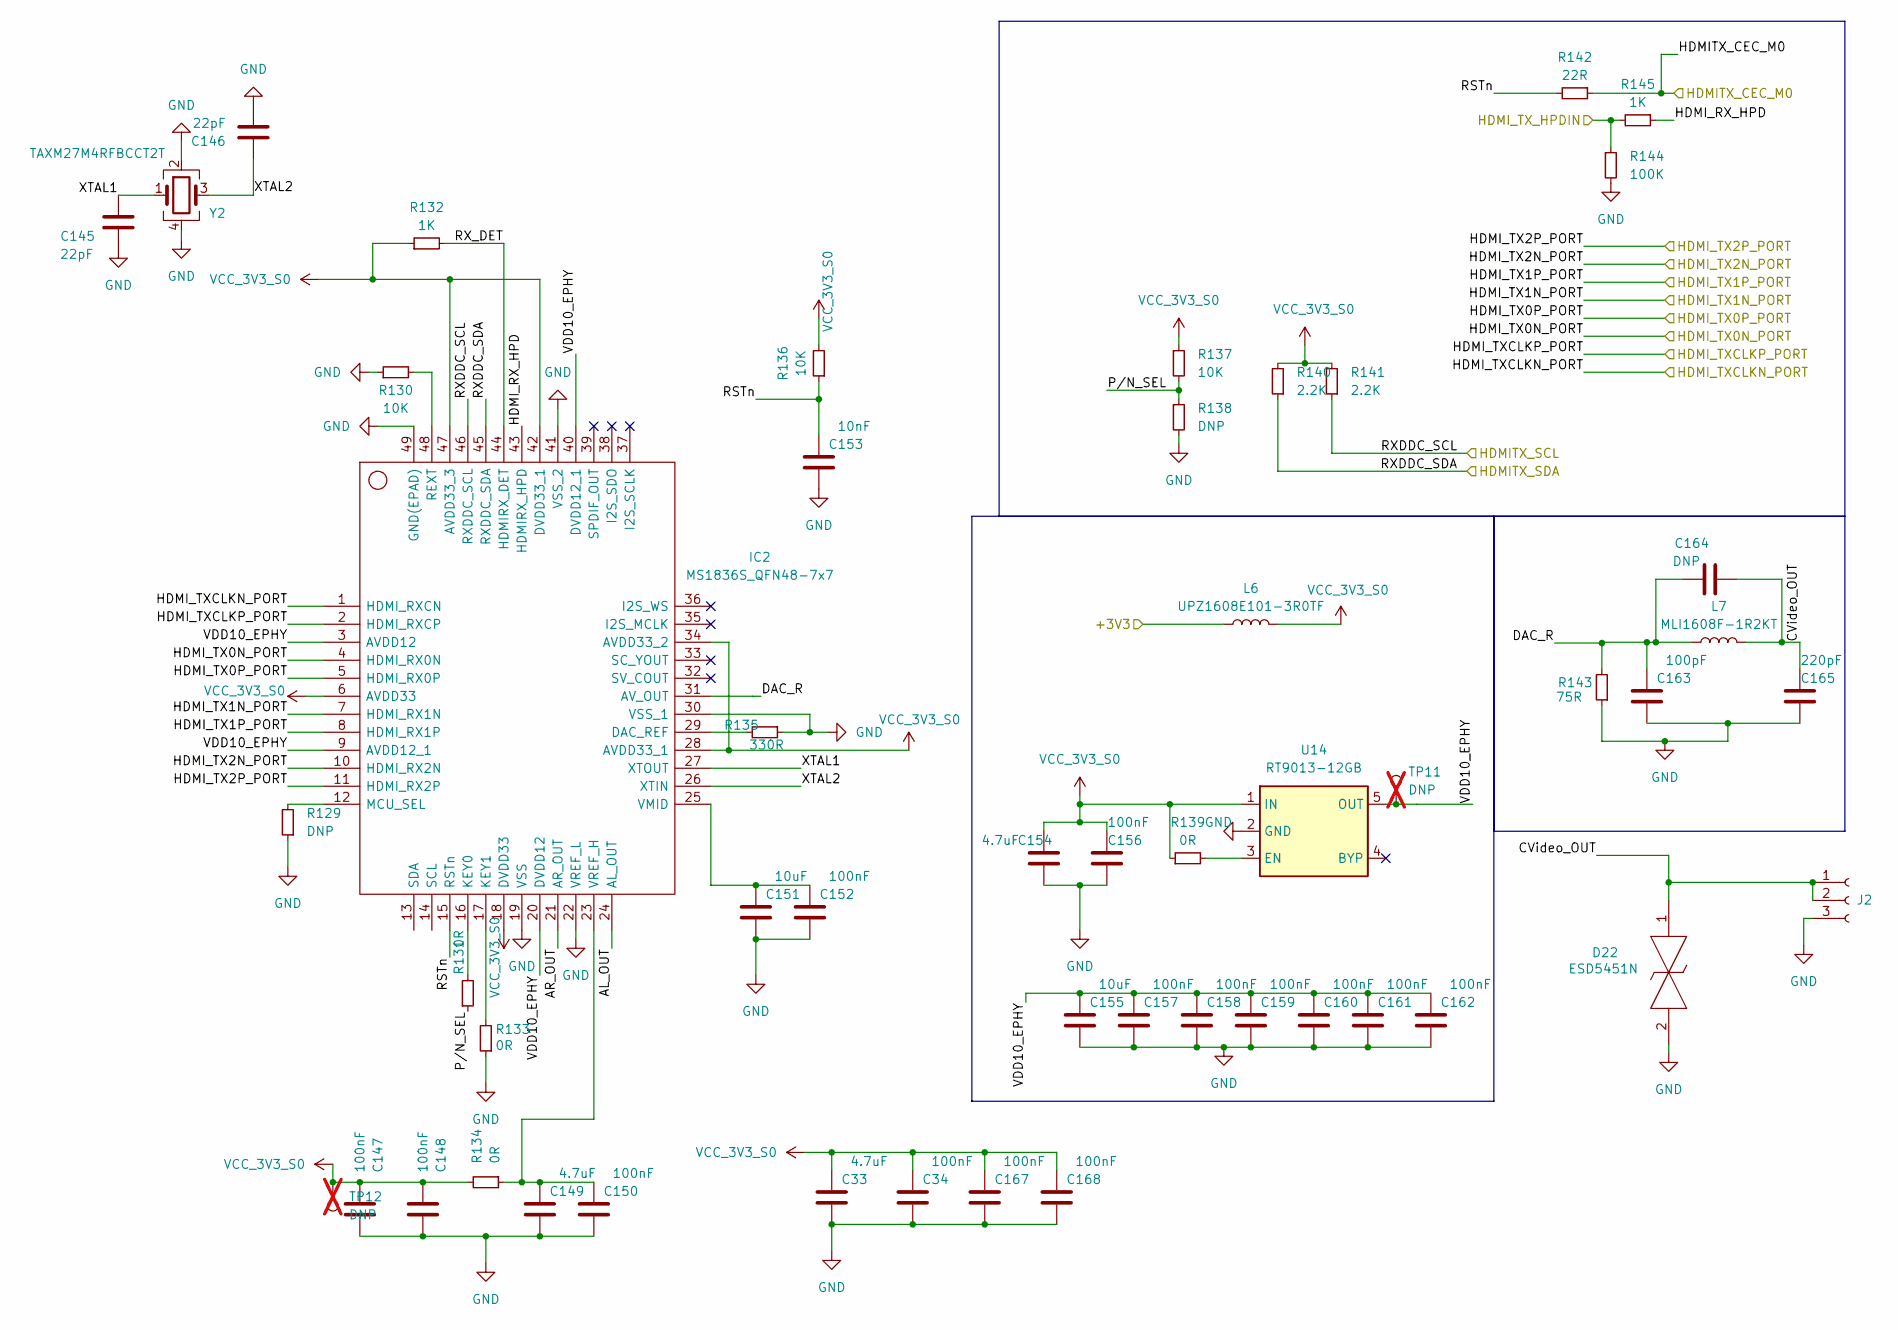
[picture p188: schematic HDMI_CVBS.kicad_sch]

Parts:
C33, C149, C154: 4.7uF; C_0603_1608Metric; MPN CL10A475KO8NNNC
C34, C147, C148, C150, C152, C156, C157, C158, C159, C160, C161, C162, C167, C168: 100nF; C_0603_1608Metric; MPN 0603B104K500NT
C145, C146: 22pF; C_0603_1608Metric; MPN CL10C220JB8NNNC
C151, C155: 10uF; C_0603_1608Metric; MPN CL10A106MO8NQNC
C153: 10nF; C_0603_1608Metric; MPN CC0603KRX7R9BB103
C163: 100pF; C_0603_1608Metric; MPN 0603B101K500NT
C164: DNP; C_0603_1608Metric
C165: 220pF; C_0603_1608Metric; MPN CL10B221KB8NNNC
D22: ESD5451N; Manufacturer_Part_Number ESD5451N
IC2: MS1836S_QFN48-7x7; QFN-48-1EP_7x7mm_P0.5mm_EP5.6x5.6mm; MPN MS1836S
J2: DNP; AV_CON; MPN 莲花座AV1-8.4-5A 黑色
L6: UPZ1608E101-3R0TF; L_0603_1608Metric; MPN UPZ1608E101-3R0TF
L7: MLI1608F-1R2KT; L_0603_1608Metric; MPN MLI1608F-1R2KT
R129, R138: DNP; R_0402_1005Metric
R130: 10K; R_0402_1005Metric; MPN RC0402FR-0710KL
R131, R133, R134, R139: 0R; R_0402_1005Metric; MPN 0402WGF0000TCE
R132, R145: 1K; R_0603_1608Metric; MPN 0603WAF1001T5E
R135: 330R; R_0603_1608Metric; MPN 0603WAF3300T5E
R136, R137: 10K; R_0603_1608Metric; MPN 0603WAF1002T5E
R140, R141: 2.2K; R_0603_1608Metric; MPN 0603WAF2201T5E
R142: 22R; R_0603_1608Metric; MPN 0603WAF220JT5E
R143: 75R; R_0402_1005Metric; MPN 0402WGF750JTCE
R144: 100K; R_0603_1608Metric; MPN 0603WAF1003T5E
TP11, TP12: DNP; TestPoint_Pad_1.0x1.0mm; not fitted
U14: RT9013-12GB; SOT-23-5; MPN RT9013-12GB
Y2: TAXM27M4RFBCCT2T; Crystal_SMD_3225-4Pin_3.2x2.5mm; MPN TAXM27M4RFBCCT2T

Connections:
+3V3: L6.1
AL_OUT: IC2.24 (AL_OUT)
AR_OUT: IC2.21 (AR_OUT)
CVideo_OUT: C164.2, C165.1, D22.1, J2.1, J2.2, L7.2
DAC_R: C163.1, C164.1, IC2.31 (AV_OUT), L7.1, R143.2
GND: C33.2, C34.2, C145.2, C146.2, C147.2, C148.2, C149.2, C150.2, C151.2, C152.2, C153.2, C154.2, C155.2, C156.2, C157.2, C158.2, C159.2, C160.2, C161.2, C162.2, C163.2, C165.2, C167.2, C168.2, D22.2, IC2.19 (VSS), IC2.22 (VREF_L), IC2.30 (VSS_1), IC2.41 (VSS_2), IC2.49 (GND(EPAD)), J2.3, R129.1, R130.1, R133.1, R135.1, R138.2, R143.1, R144.2, U14.2 (GND), Y2.2, Y2.4
HDMITX_CEC_M0: R142.1
HDMITX_SCL: IC2.46 (RXDDC_SCL), R141.1
HDMITX_SDA: IC2.45 (RXDDC_SDA), R140.1
HDMI_RX_HPD: IC2.43 (HDMIRX_HPD), R145.1
HDMI_TX0N_PORT: IC2.4 (HDMI_RX0N)
HDMI_TX0P_PORT: IC2.5 (HDMI_RX0P)
HDMI_TX1N_PORT: IC2.7 (HDMI_RX1N)
HDMI_TX1P_PORT: IC2.8 (HDMI_RX1P)
HDMI_TX2N_PORT: IC2.10 (HDMI_RX2N)
HDMI_TX2P_PORT: IC2.11 (HDMI_RX2P)
HDMI_TXCLKN_PORT: IC2.1 (HDMI_RXCN)
HDMI_TXCLKP_PORT: IC2.2 (HDMI_RXCP)
HDMI_TX_HPDIN: R144.1, R145.2
unnamed: C149.1, C150.1, IC2.23 (VREF_H), R134.1
unnamed: C151.1, C152.1, IC2.25 (VMID)
unnamed: IC2.12 (MCU_SEL), R129.2
unnamed: IC2.16 (KEY0), R131.2
unnamed: IC2.17 (KEY1), R133.2
unnamed: IC2.29 (DAC_REF), R135.2
unnamed: IC2.48 (REXT), R130.2
unnamed: R139.2, U14.3 (EN)
P/N_SEL: R131.1, R137.2, R138.1
RSTn: C153.1, IC2.15 (RSTn), R136.1, R142.2
RX_DET: IC2.44 (HDMIRX_DET), R132.2
VCC_3V3_S0: C33.1, C34.1, C147.1, C148.1, C154.1, C156.1, C167.1, C168.1, IC2.6 (AVDD33), IC2.18 (DVDD33), IC2.28 (AVDD33_1), IC2.34 (AVDD33_2), IC2.42 (DVDD33_1), IC2.47 (AVDD33_3), L6.2, R132.1, R134.2, R136.2, R137.1, R139.1, R140.2, R141.2, TP12.1, U14.1 (IN)
VDD10_EPHY: C155.1, C157.1, C158.1, C159.1, C160.1, C161.1, C162.1, IC2.3 (AVDD12), IC2.9 (AVDD12_1), IC2.20 (DVDD12), IC2.40 (DVDD12_1), TP11.1, U14.5 (OUT)
XTAL1: C145.1, IC2.27 (XTOUT), Y2.1
XTAL2: C146.1, IC2.26 (XTIN), Y2.3
