ihsanakyrk/Eski-Versionlar-Ve-Siparisler/Movita_XV500_Router_V4.0/I2CDevice.kicad_sch

## KiCad design Movita_XV500_Router_V4.0/I2CDevice.kicad_sch (2025-09-01)

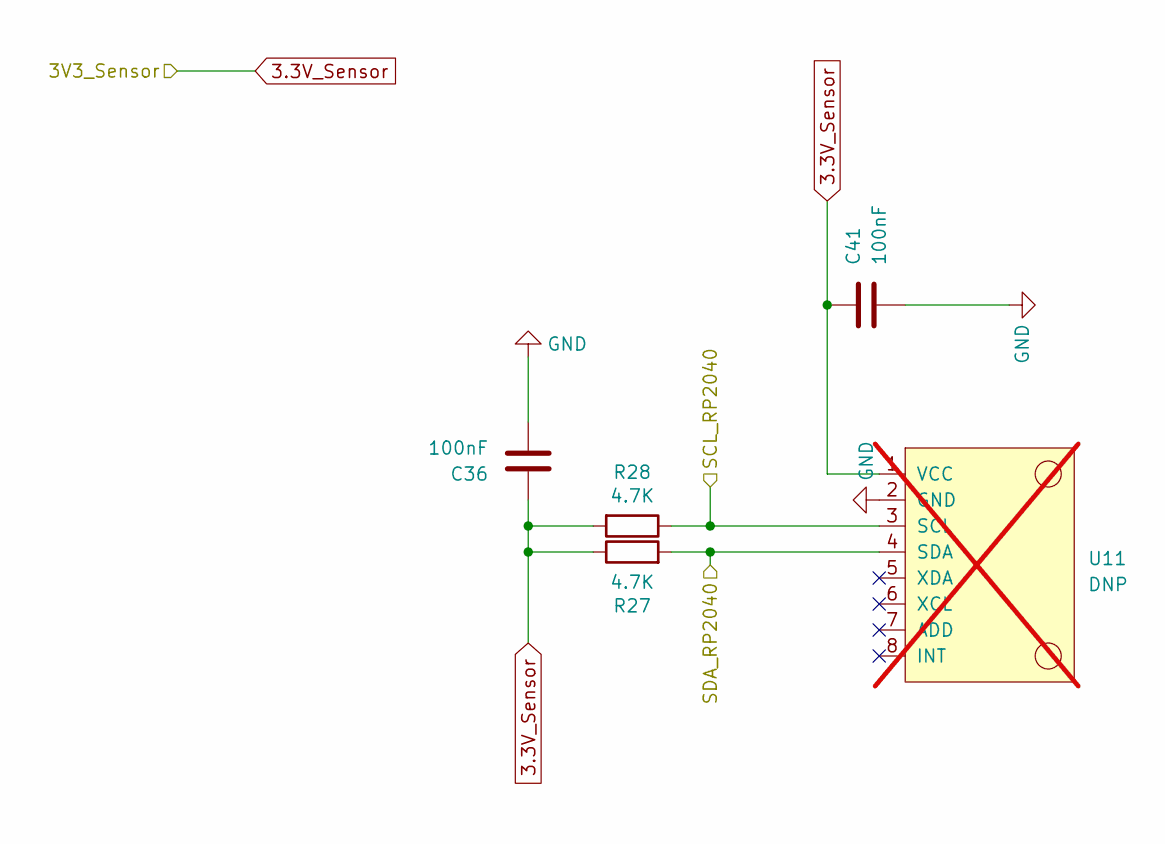
[picture p189: schematic I2CDevice.kicad_sch]

Parts:
C36, C41: 100nF; C_0603_1608Metric; MPN 0603B104K500NT
R27, R28: 4.7K; R_0603_1608Metric; MPN 0603WAF4701T5E
U11: DNP; module_mpu6050; not fitted

Connections:
3.3V_Sensor: C36.1, C41.1, R27.1, R28.2, U11.1 (VCC)
GND: C36.2, C41.2, U11.2 (GND)
SCL_RP2040: R28.1, U11.3 (SCL)
SDA_RP2040: R27.2, U11.4 (SDA)
