ihsanakyrk/Eski-Versionlar-Ve-Siparisler/Movita_XV500_Router_V4.0/IO Connector.kicad_sch

## KiCad design Movita_XV500_Router_V4.0/IO Connector.kicad_sch (2025-09-01)

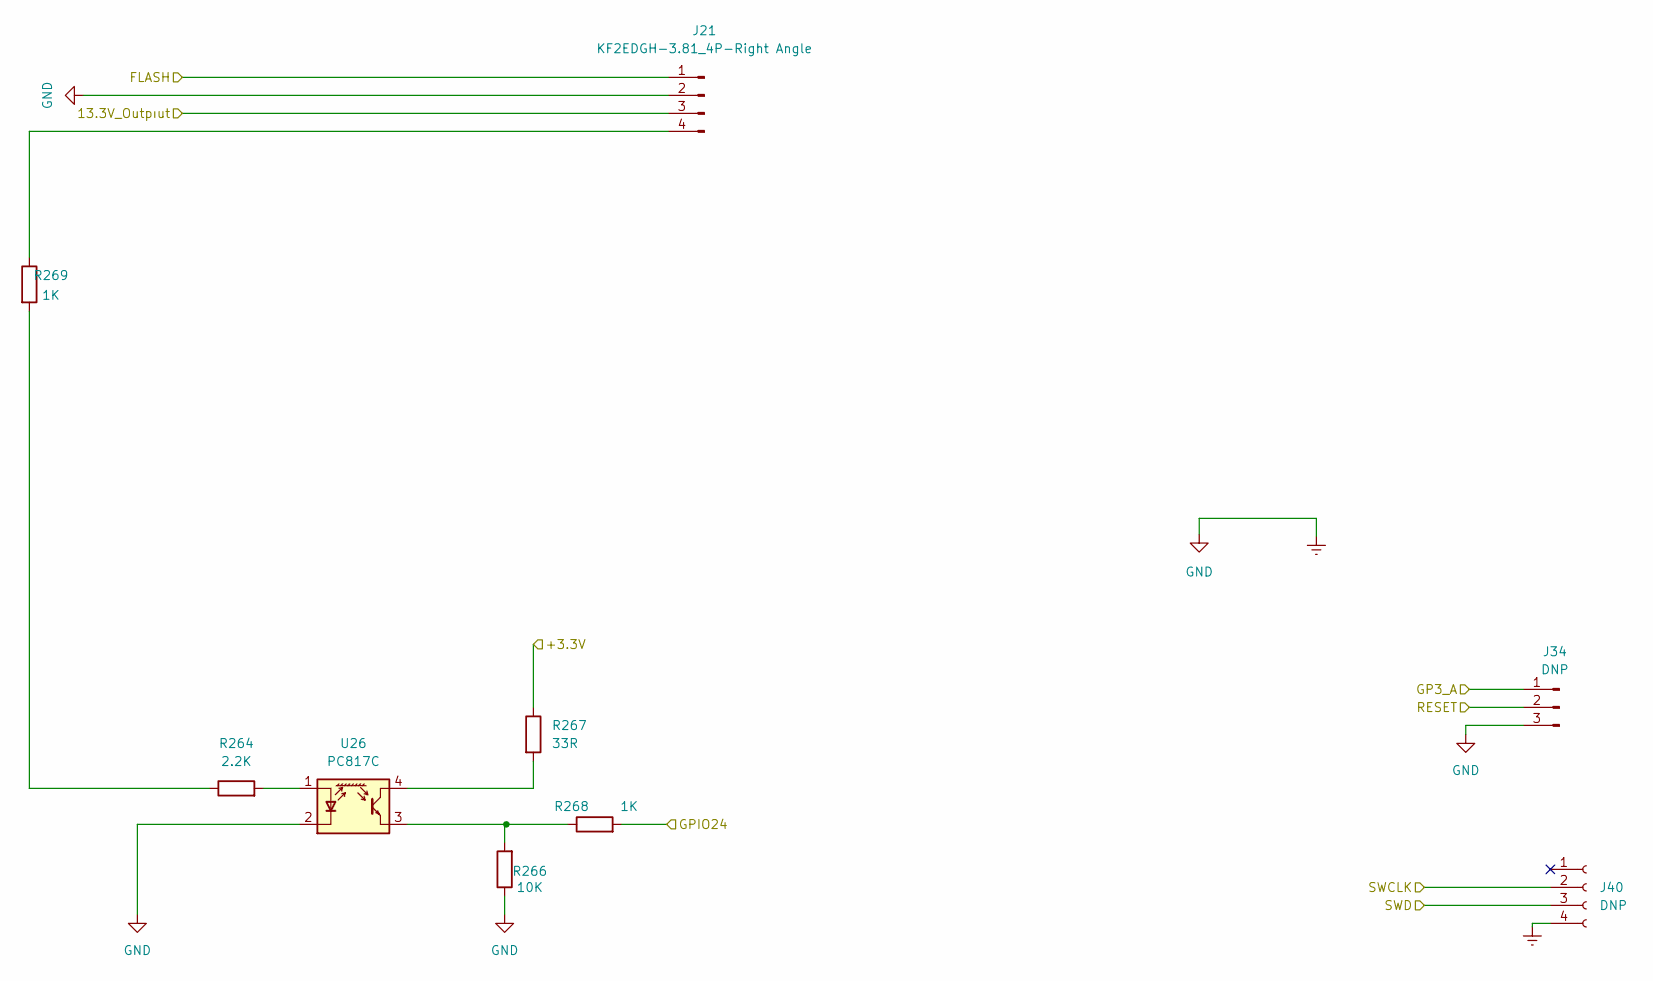
[picture p190: schematic IO Connector.kicad_sch]

Parts:
J21: KF2EDGH-3.81_4P-Right Angle; KF2EDGH-3.81_4P
J34: DNP; PinSocket_1x03_P2.54mm_Vertical_SMD_Pin1Left; MPN 1*3p 2.54 贴片排母
J40: DNP; PinSocket_1x04_P2.00mm_Vertical
R264: 2.2K; R_0603_1608Metric; MPN 0603WAF2201T5E
R266: 10K; R_0603_1608Metric; MPN 0603WAF1002T5E
R267: 33R; R_0603_1608Metric; MPN 0603WAF330JT5E
R268, R269: 1K; R_0603_1608Metric; MPN 0603WAF1001T5E
U26: PC817C; PC817; MPN PC817C_4PIN_SMD

Connections:
13.3V_Outpıut: J21.3
+3.3V: R267.1
Earth: J21.2, J34.3, J40.4, R266.1, U26.2 (K)
FLASH: J21.1
GP3_A: J34.1
GPIO24: R268.2
unnamed: J21.4, R269.1
unnamed: R264.1, R269.2
unnamed: R264.2, U26.1 (A)
unnamed: R266.2, R268.1, U26.3 (E)
unnamed: R267.2, U26.4 (C)
RESET: J34.2
SWCLK: J40.2
SWD: J40.3
