ihsanakyrk/Eski-Versionlar-Ve-Siparisler/Movita_XV500_Router_V4.0/MIPI_DSI_TX0&LVDS .kicad_sch

## KiCad design Movita_XV500_Router_V4.0/MIPI_DSI_TX0&LVDS .kicad_sch (2025-09-01)

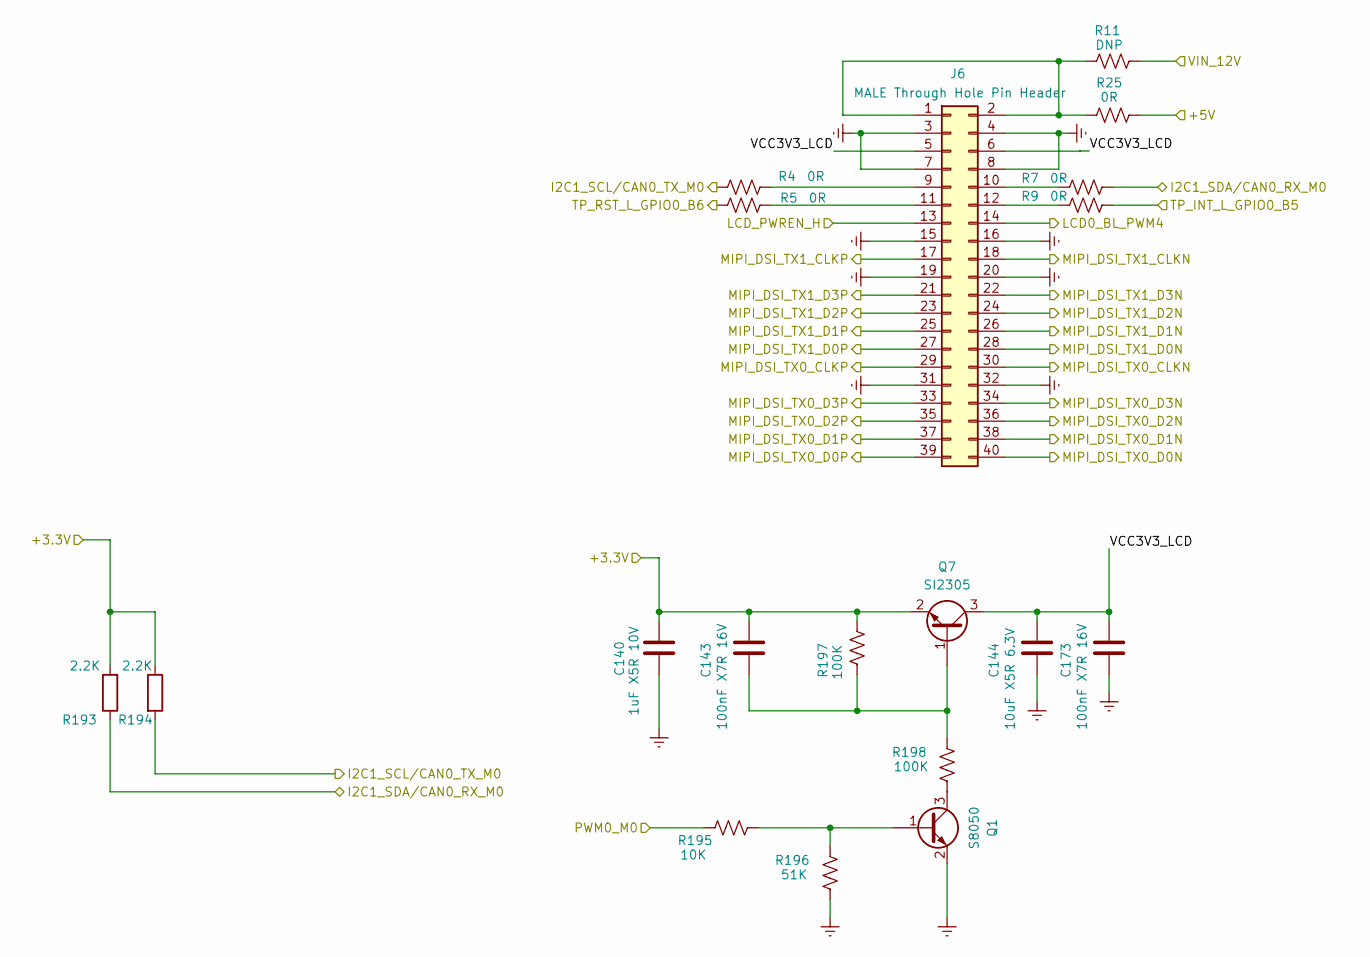
[picture p191: schematic MIPI_DSI_TX0&LVDS .kicad_sch]

Parts:
C140: 1uF X5R 10V; C_0402_1005Metric; MPN CL05A105KP5NNNC
C143, C173: 100nF X7R 16V; C_0402_1005Metric; MPN CC0402KRX7R7BB104
C144: 10uF X5R 6.3V; C_0402_1005Metric; MPN CL05A106MQ5NUNC
J6: MALE Through Hole Pin Header; PinHeader_2x20_P1.27mm_Vertical; MPN 2*20 1.27mm 插件排针
Q1: S8050; SOT-23; MPN S8050
Q7: SI2305; SOT-23; MPN SI2305
R4, R5, R7, R9, R25: 0R; R_0603_1608Metric; MPN 0603WAF0000T5E
R11: DNP; R_0603_1608Metric
R193, R194: 2.2K; R_0402_1005Metric; MPN 0402WGF2201TCE
R195: 10K; R_0402_1005Metric; MPN RC0402FR-0710KL
R196: 51K; R_0402_1005Metric; MPN 0402WGF5102TCE
R197, R198: 100K; R_0402_1005Metric; MPN 0402WGF1003TCE

Connections:
+3.3V: C140.1, C143.1, Q7.2 (S), R193.2, R194.1, R197.2
+5V: R25.2
Earth: C140.2, C144.2, C173.2, J6.3, J6.4, J6.7, J6.8, J6.15, J6.16, J6.19, J6.20, J6.31, J6.32, Q1.2 (S), R196.1
I2C1_SCL/CAN0_TX_M0: R4.1, R194.2
I2C1_SDA/CAN0_RX_M0: R7.2, R193.1
LCD0_BL_PWM4: J6.14
LCD_PWREN_H: J6.13
MIPI_DSI_TX0_CLKN: J6.30
MIPI_DSI_TX0_CLKP: J6.29
MIPI_DSI_TX0_D0N: J6.40
MIPI_DSI_TX0_D0P: J6.39
MIPI_DSI_TX0_D1N: J6.38
MIPI_DSI_TX0_D1P: J6.37
MIPI_DSI_TX0_D2N: J6.36
MIPI_DSI_TX0_D2P: J6.35
MIPI_DSI_TX0_D3N: J6.34
MIPI_DSI_TX0_D3P: J6.33
MIPI_DSI_TX1_CLKN: J6.18
MIPI_DSI_TX1_CLKP: J6.17
MIPI_DSI_TX1_D0N: J6.28
MIPI_DSI_TX1_D0P: J6.27
MIPI_DSI_TX1_D1N: J6.26
MIPI_DSI_TX1_D1P: J6.25
MIPI_DSI_TX1_D2N: J6.24
MIPI_DSI_TX1_D2P: J6.23
MIPI_DSI_TX1_D3N: J6.22
MIPI_DSI_TX1_D3P: J6.21
unnamed: C143.2, Q7.1 (B), R197.1, R198.2
unnamed: J6.1, J6.2, R11.1, R25.1
unnamed: J6.9, R4.2
unnamed: J6.10, R7.1
unnamed: J6.11, R5.2
unnamed: J6.12, R9.1
unnamed: Q1.1 (B), R195.1, R196.2
unnamed: Q1.3 (D), R198.1
PWM0_M0: R195.2
TP_INT_L_GPIO0_B5: R9.2
TP_RST_L_GPIO0_B6: R5.1
VCC3V3_LCD: C144.1, C173.1, J6.5, J6.6, Q7.3 (D)
VIN_12V: R11.2
