ihsanakyrk/Eski-Versionlar-Ve-Siparisler/Movita_XV500_Router_V4.0/MicroSD.kicad_sch

## KiCad design Movita_XV500_Router_V4.0/MicroSD.kicad_sch (2025-09-01)

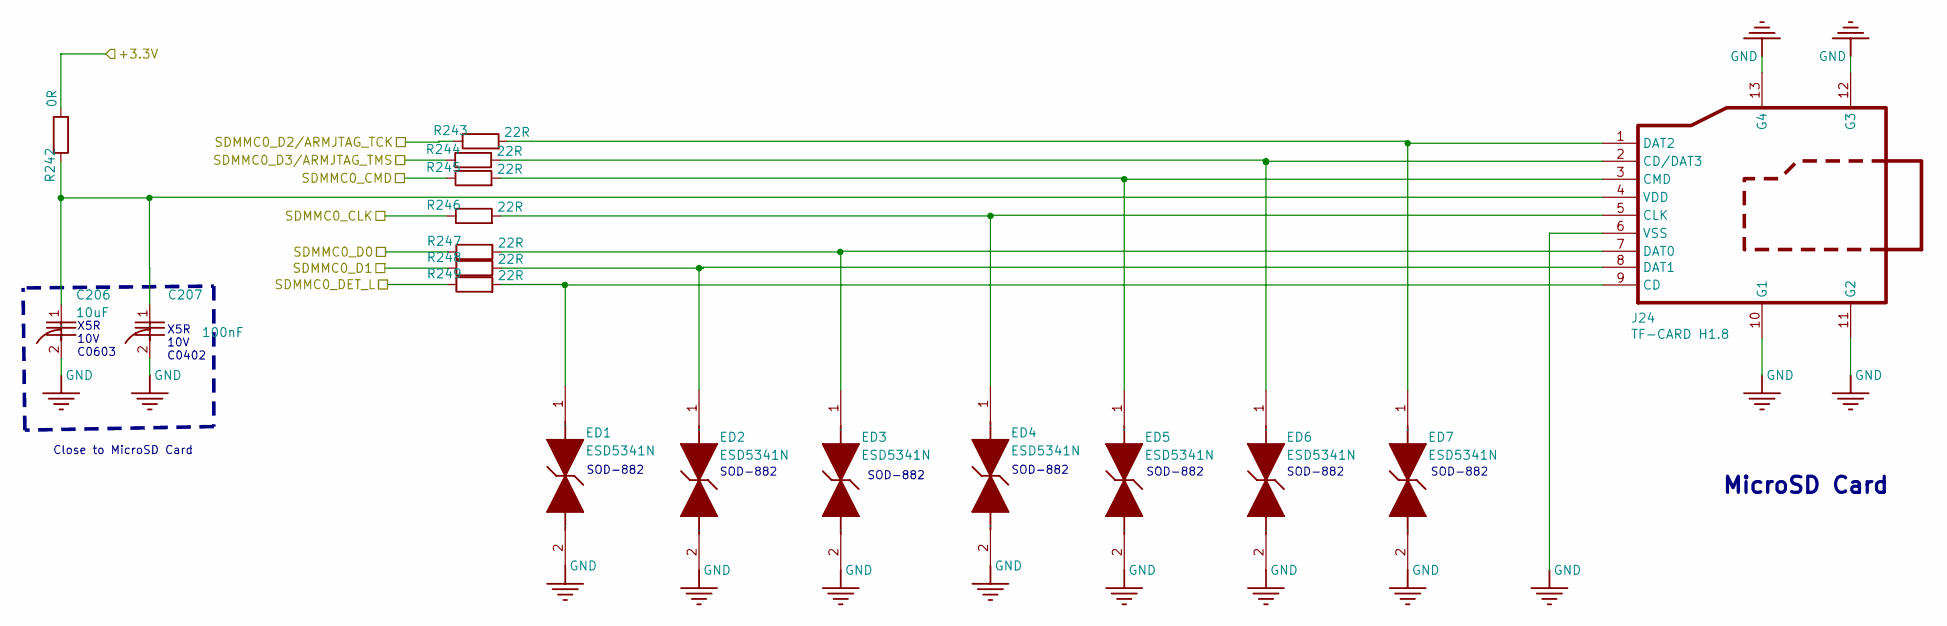
[picture p192: schematic MicroSD.kicad_sch]

Parts:
C206: 10uF; C_0603_1608Metric; MPN CL10A106MO8NQNC
C207: 100nF; C_0402_1005Metric; MPN CC0402KRX7R7BB104
ED1, ED2, ED3, ED4, ED5, ED6, ED7: ESD5341N; MPN ESD5341N
J24: TF-CARD H1.8; MANUFACTURER_PART_NUMBER TFP09-2-12B
R242: 0R; R_0603_1608Metric; MPN 0603WAF0000T5E
R243, R244, R245, R246, R247, R248, R249: 22R; R_0603_1608Metric; MPN 0603WAF220JT5E

Connections:
+3.3V: R242.2
GND: C206.2, C207.2, ED1.2, ED2.2, ED3.2, ED4.2, ED5.2, ED6.2, ED7.2, J24.6 (VSS), J24.10 (G1), J24.11 (G2), J24.12 (G3), J24.13 (G4)
unnamed: C206.1, C207.1, J24.4 (VDD), R242.1
unnamed: ED1.1, J24.9 (CD), R249.2
unnamed: ED2.1, J24.8 (DAT1), R248.2
unnamed: ED3.1, J24.7 (DAT0), R247.2
unnamed: ED4.1, J24.5 (CLK), R246.2
unnamed: ED5.1, J24.3 (CMD), R245.2
unnamed: ED6.1, J24.2 (CD/DAT3), R244.2
unnamed: ED7.1, J24.1 (DAT2), R243.2
SDMMC0_CLK: R246.1
SDMMC0_CMD: R245.1
SDMMC0_D0: R247.1
SDMMC0_D1: R248.1
SDMMC0_D2/ARMJTAG_TCK: R243.1
SDMMC0_D3/ARMJTAG_TMS: R244.1
SDMMC0_DET_L: R249.1

Notes on the sheet:
SOD-882
MicroSD Card
X5R 10V C0402
X5R 10V C0603
Close to MicroSD Card
