ihsanakyrk/Eski-Versionlar-Ve-Siparisler/Movita_XV500_Router_V4.0/PCIE.kicad_sch

## KiCad design Movita_XV500_Router_V4.0/PCIE.kicad_sch (2025-09-01)

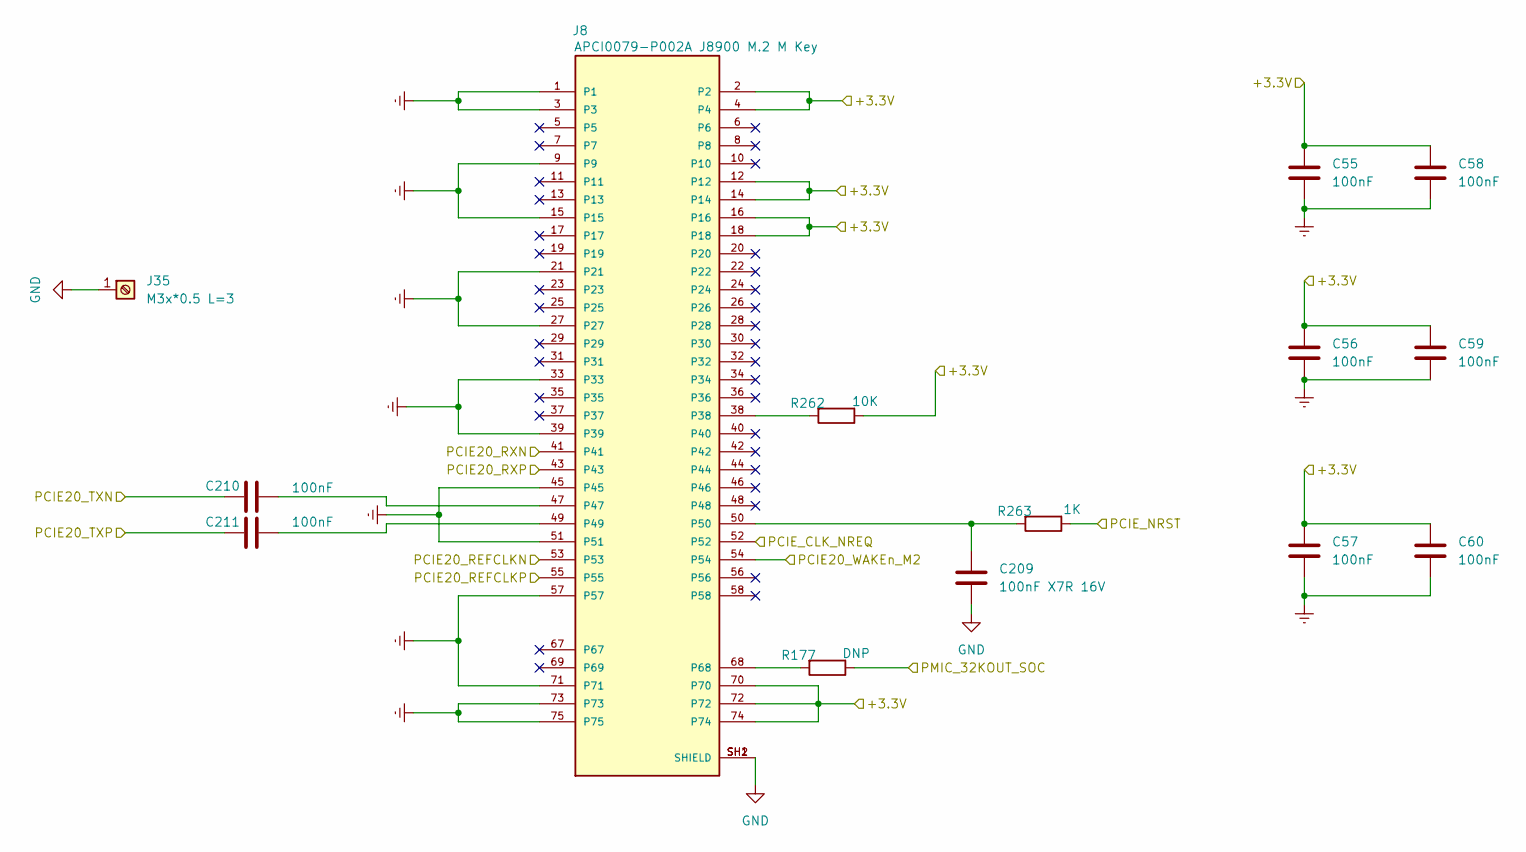
[picture p193: schematic PCIE.kicad_sch]

Parts:
C55, C56, C57, C58, C59, C60: 100nF; C_0603_1608Metric; MPN 0603B104K500NT
C209: 100nF X7R 16V; C_0402_1005Metric; MPN CC0402KRX7R7BB104
C210, C211: 100nF; C_0402_1005Metric; MPN CC0402KRX7R7BB104
J8: APCI0079-P002A J8900 M.2 M Key; MPN NGFF 67P连接器 M.2 SSD插槽 4+5 H3.2
J35: M3x*0.5 L=3; Screw Terminal Shinbo; MPN SMTSO-M3-3ET
R177: DNP; R_0603_1608Metric
R262: 10K; R_0402_1005Metric; MPN RC0402FR-0710KL
R263: 1K; R_0402_1005Metric; MPN 0402WGF1001TCE

Connections:
+3.3V: C55.1, C56.1, C57.1, C58.1, C59.1, C60.1, J8.2, J8.4, J8.12, J8.14, J8.16, J8.18, J8.70, J8.72, J8.74, R262.1
Earth: C55.2, C56.2, C57.2, C58.2, C59.2, C60.2, J8.1, J8.3, J8.9, J8.15, J8.21, J8.27, J8.33, J8.39, J8.45, J8.51, J8.57, J8.71, J8.73, J8.75
GND: C209.2, J8.SH1 (SHIELD), J8.SH2 (SHIELD), J35.1
unnamed: C209.1, J8.50, R263.2
unnamed: C210.2, J8.47
unnamed: C211.2, J8.49
unnamed: J8.38, R262.2
unnamed: J8.68, R177.2
PCIE20_REFCLKN: J8.53
PCIE20_REFCLKP: J8.55
PCIE20_RXN: J8.41
PCIE20_RXP: J8.43
PCIE20_TXN: C210.1
PCIE20_TXP: C211.1
PCIE20_WAKEn_M2: J8.54
PCIE_CLK_NREQ: J8.52
PCIE_NRST: R263.1
PMIC_32KOUT_SOC: R177.1
