ihsanakyrk/Eski-Versionlar-Ve-Siparisler/Movita_XV500_Router_V4.0/RP2040.kicad_sch

## KiCad design Movita_XV500_Router_V4.0/RP2040.kicad_sch (2025-09-01)

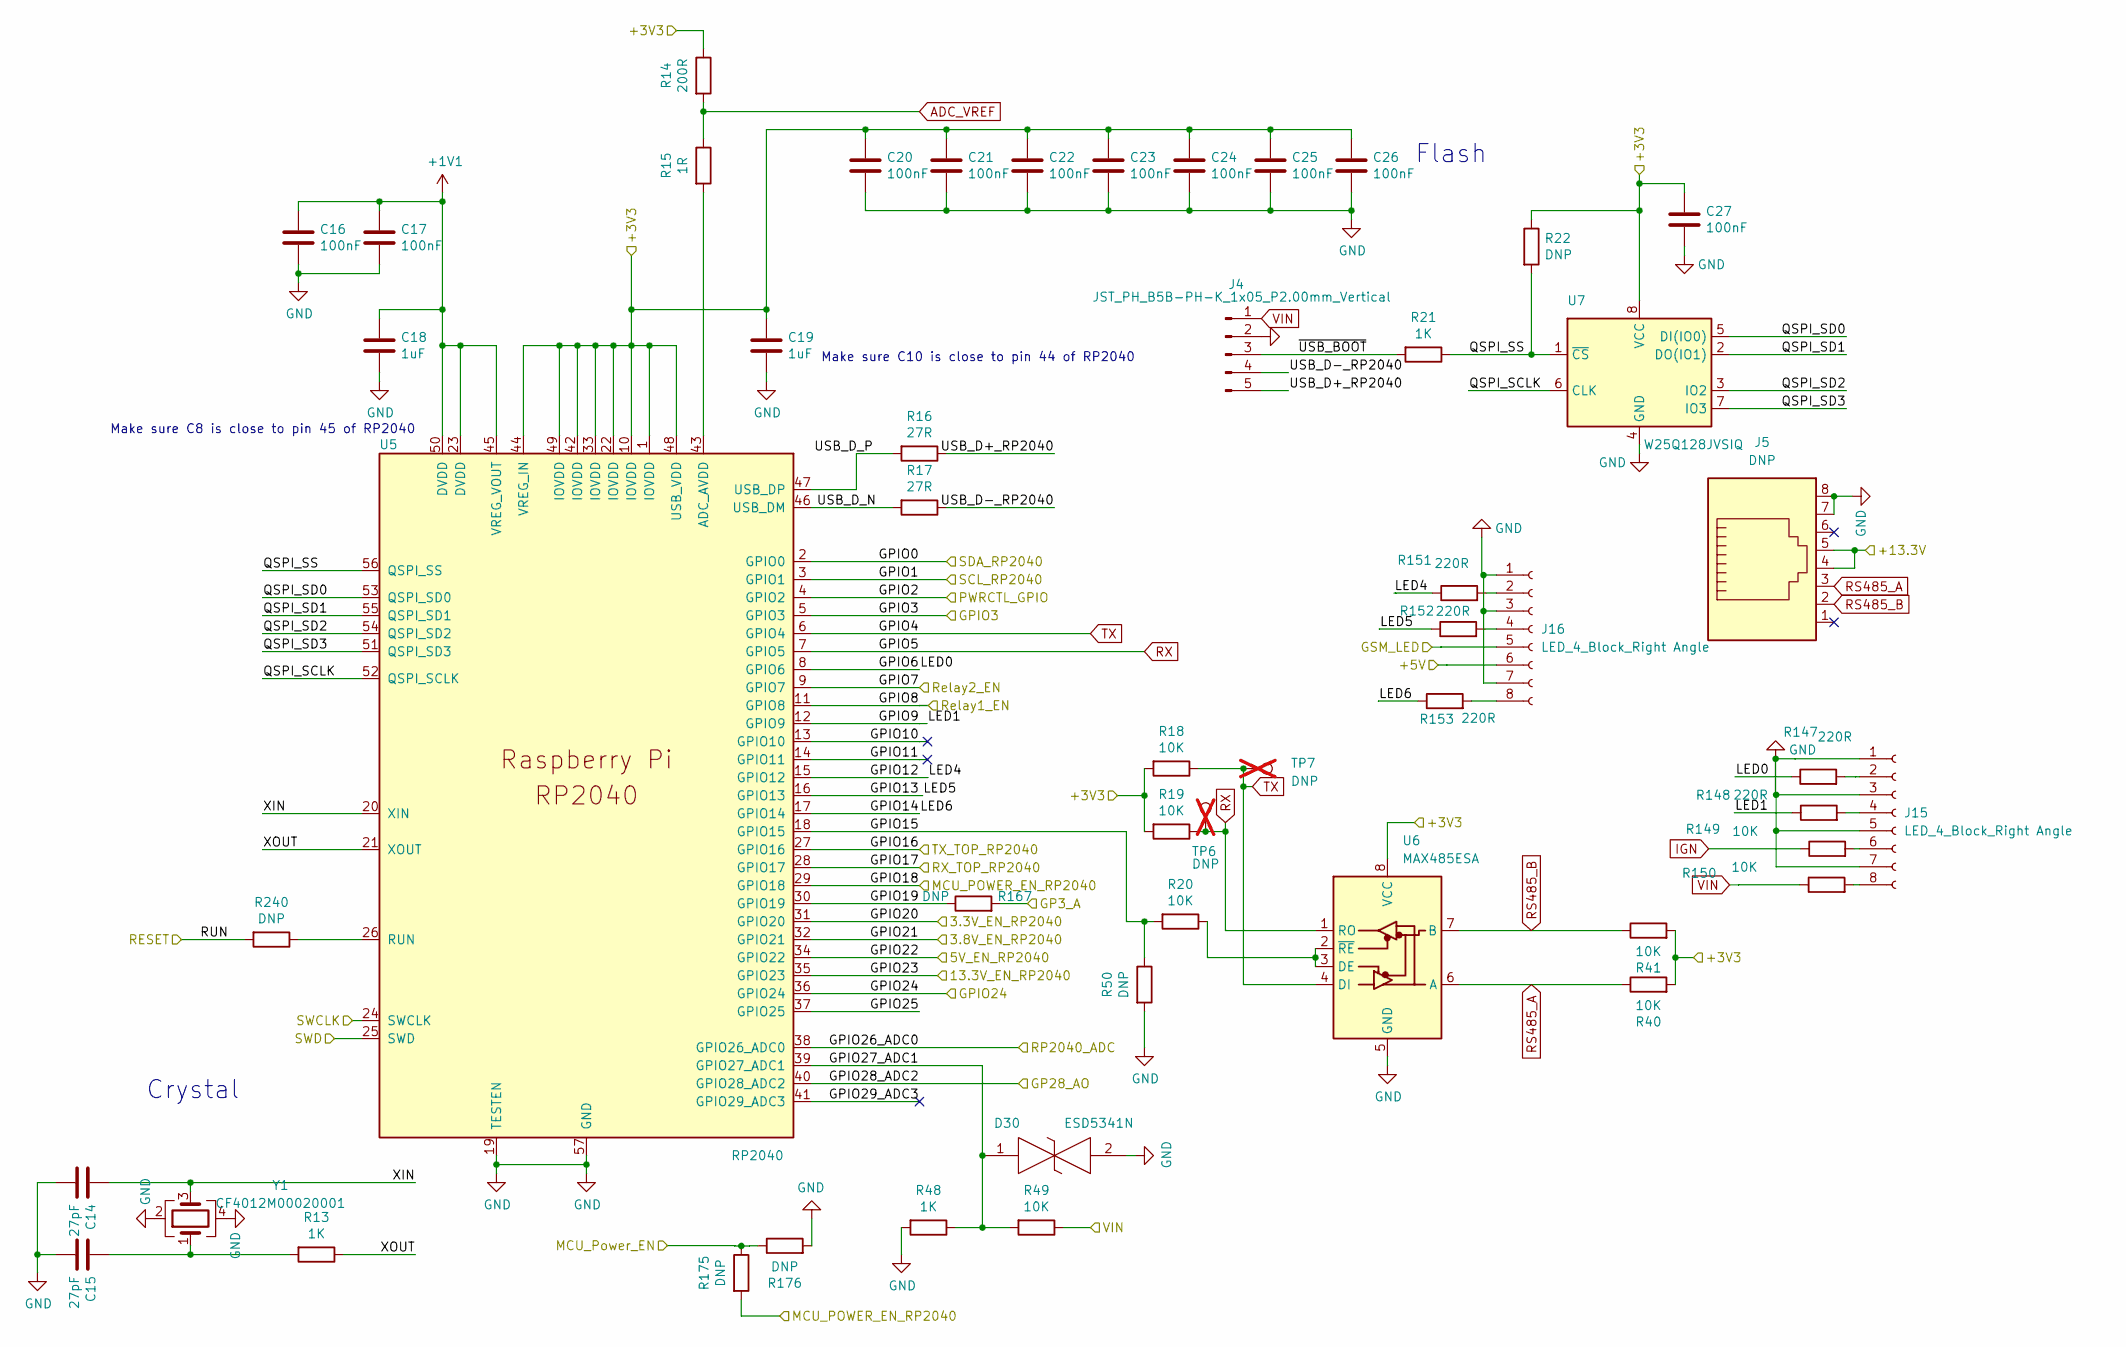
[picture p195: schematic RP2040.kicad_sch]

Parts:
C14, C15: 27pF; C_0603_1608Metric; MPN 0603CG270J500NT
C16, C17, C20, C21, C22, C23, C24, C25, C26, C27: 100nF; C_0402_1005Metric; MPN CC0402KRX7R7BB104
C18, C19: 1uF; C_0603_1608Metric; MPN CL10A105KB8NNNC
D30: ESD5341N; Manufacturer_Part_Number SP0402B-ULC-01ETG; Mouser Part Number 576-SP0402BULC-01ETG
J4: JST_PH_B5B-PH-K_1x05_P2.00mm_Vertical
J5: DNP; RJ45_Amphenol_54602-x08_Horizontal; MPN 黑色 RJ45 8P
J15, J16: LED_4_Block_Right Angle; LED_4_Block; MPN 3mm四孔灯座带灯
R13, R21, R48: 1K; R_0603_1608Metric; MPN 0603WAF1001T5E
R14: 200R; R_0603_1608Metric; MPN 0603WAF2000T5E
R15: 1R; R_0603_1608Metric; MPN 0603WAF100KT5E
R16, R17: 27R; R_0603_1608Metric; MPN 0603WAF270JT5E
R18, R19, R20, R40, R41, R49, R149, R150: 10K; R_0603_1608Metric; MPN 0603WAF1002T5E
R22, R50, R167, R175, R176, R240: DNP; R_0603_1608Metric
R147, R148, R151, R152, R153: 220R; R_0603_1608Metric; MPN 0603WAF2200T5E
TP6, TP7: DNP; TestPoint_Pad_1.0x1.0mm; not fitted
U5: RP2040; RP2040-QFN-56; MPN RP2040
U6: MAX485ESA; SOIC127P600X175-8N; MPN MAX485ESA
U7: W25Q128JVSIQ; SOIC-8_5.23x5.23mm_P1.27mm; MPN W25Q128JVSIQ
Y1: CF4012M00020001; Crystal_SMD_3225-4Pin_3.2x2.5mm; MPN CF4012M00020001

Connections:
3.3V_EN_RP2040: U5.31 (GPIO20)
3.8V_EN_RP2040: U5.32 (GPIO21)
5V_EN_RP2040: U5.34 (GPIO22)
13.3V_EN_RP2040: U5.35 (GPIO23)
+1V1: C16.1, C17.1, C18.1, U5.23 (DVDD), U5.45 (VREG_VOUT), U5.50 (DVDD)
+3V3: C19.1, C20.1, C21.1, C22.1, C23.1, C24.1, C25.1, C26.1, C27.1, R14.1, R18.2, R19.2, R22.1, R40.2, R41.2, U5.1 (IOVDD), U5.10 (IOVDD), U5.22 (IOVDD), U5.33 (IOVDD), U5.42 (IOVDD), U5.44 (VREG_IN), U5.48 (USB_VDD), U5.49 (IOVDD), U6.8 (VCC), U7.8 (VCC)
+5V: J16.6
+13.3V: J5.4, J5.5
ADC_VREF: R14.2, R15.1
GND: C14.2, C15.2, C16.2, C17.2, C18.2, C19.2, C20.2, C21.2, C22.2, C23.2, C24.2, C25.2, C26.2, C27.2, D30.2, J4.2, J5.7, J5.8, J15.1, J15.3, J15.5, J15.7, J16.1, J16.3, J16.7, R48.2, R50.2, R176.2, U5.19 (TESTEN), U5.57 (GND), U6.5 (GND), U7.4 (GND), Y1.2, Y1.4
GP3_A: R167.2
GP28_AO: U5.40 (GPIO28_ADC2)
GPIO0: U5.2 (GPIO0)
GPIO1: U5.3 (GPIO1)
GPIO2: U5.4 (GPIO2)
GPIO3: U5.5 (GPIO3)
GPIO6: R147.1, U5.8 (GPIO6)
GPIO7: U5.9 (GPIO7)
GPIO8: U5.11 (GPIO8)
GPIO9: R148.1, U5.12 (GPIO9)
GPIO10: U5.13 (GPIO10)
GPIO11: U5.14 (GPIO11)
GPIO12: R151.1, U5.15 (GPIO12)
GPIO13: R152.1, U5.16 (GPIO13)
GPIO14: R153.1, U5.17 (GPIO14)
GPIO15: R20.2, R50.1, U5.18 (GPIO15)
GPIO16: U5.27 (GPIO16)
GPIO17: U5.28 (GPIO17)
GPIO18: R175.2, U5.29 (GPIO18)
GPIO19: R167.1, U5.30 (GPIO19)
GPIO24: U5.36 (GPIO24)
GPIO25: U5.37 (GPIO25)
GPIO26_ADC0: U5.38 (GPIO26_ADC0)
GPIO27_ADC1: D30.1, R48.1, R49.2, U5.39 (GPIO27_ADC1)
GPIO29_ADC3: U5.41 (GPIO29_ADC3)
GSM_LED: J16.5
IGN: R149.1
MCU_Power_EN: R175.1, R176.1
unnamed: C15.1, R13.2, Y1.1
unnamed: J15.2, R147.2
unnamed: J15.4, R148.2
unnamed: J15.6, R149.2
unnamed: J15.8, R150.2
unnamed: J16.2, R151.2
unnamed: J16.4, R152.2
unnamed: J16.8, R153.2
unnamed: R15.2, U5.43 (ADC_AVDD)
unnamed: R20.1, U6.2 (~RE), U6.3 (DE)
unnamed: R240.1, U5.26 (RUN)
QSPI_SCLK: U5.52 (QSPI_SCLK), U7.6 (CLK)
QSPI_SD0: U5.53 (QSPI_SD0), U7.5 (DI(IO0))
QSPI_SD1: U5.55 (QSPI_SD1), U7.2 (DO(IO1))
QSPI_SD2: U5.54 (QSPI_SD2), U7.3 (IO2)
QSPI_SD3: U5.51 (QSPI_SD3), U7.7 (IO3)
QSPI_SS: R21.1, R22.2, U5.56 (QSPI_SS), U7.1 (~CS)
RESET: R240.2
RS485_A: J5.3, R40.1, U6.6 (A)
RS485_B: J5.2, R41.1, U6.7 (B)
RX: R19.1, TP6.1, U5.7 (GPIO5), U6.1 (RO)
SWCLK: U5.24 (SWCLK)
SWD: U5.25 (SWD)
TX: R18.1, TP7.1, U5.6 (GPIO4), U6.4 (DI)
USB_D+_RP2040: J4.5, R16.1
USB_D-_RP2040: J4.4, R17.1
USB_D_N: R17.2, U5.46 (USB_DM)
USB_D_P: R16.2, U5.47 (USB_DP)
VIN: J4.1, R49.1, R150.1
XIN: C14.1, U5.20 (XIN), Y1.3
XOUT: R13.1, U5.21 (XOUT)
~USB_BOOT: J4.3, R21.2

Notes on the sheet:
Make sure C8 is close to pin 45 of RP2040
Make sure C10 is close to pin 44 of RP2040
Flash
Crystal
