ihsanakyrk/Eski-Versionlar-Ve-Siparisler/Movita_XV500_Router_V4.0/Relay_switch.kicad_sch

## KiCad design Movita_XV500_Router_V4.0/Relay_switch.kicad_sch (2025-09-01)

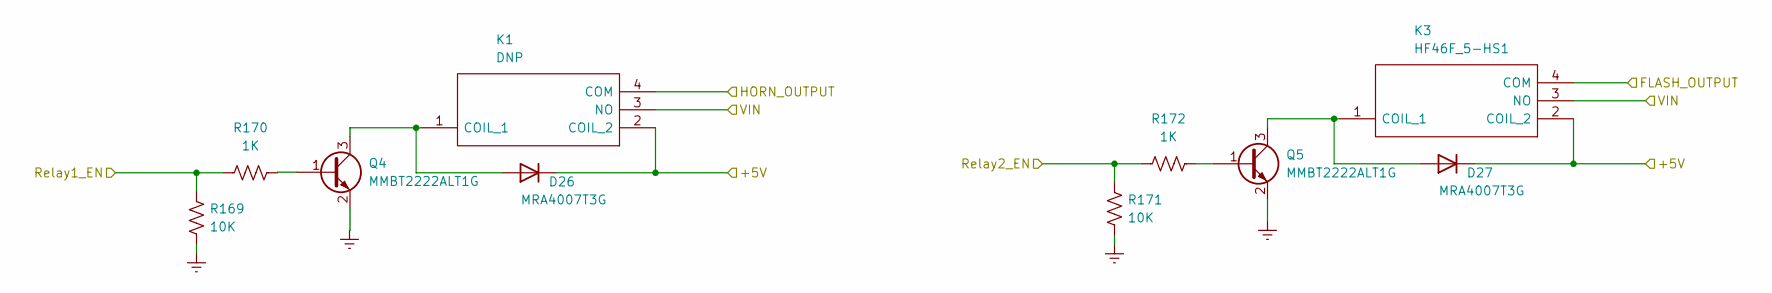
[picture p197: schematic Relay_switch.kicad_sch]

Parts:
D26, D27: MRA4007T3G; MPN MRA4007T3G
K1: DNP; HF46F5HS1; Manufacturer_Part_Number HF46F/5-HS1
K3: HF46F_5-HS1; HF46F5HS1; Manufacturer_Part_Number HF46F/5-HS1
Q4, Q5: MMBT2222ALT1G; MPN MMBT2222A
R169, R171: 10K; R_0603_1608Metric; MPN 0603WAF1002T5E
R170, R172: 1K; R_0603_1608Metric; MPN 0603WAF1001T5E

Connections:
+5V: D26.1 (K), D27.1 (K), K1.2 (COIL_2), K3.2 (COIL_2)
Earth: Q4.2 (E), Q5.2 (E), R169.2, R171.2
FLASH_OUTPUT: K3.4 (COM)
HORN_OUTPUT: K1.4 (COM)
unnamed: D26.2 (A), K1.1 (COIL_1), Q4.3 (C)
unnamed: D27.2 (A), K3.1 (COIL_1), Q5.3 (C)
unnamed: Q4.1 (B), R170.2
unnamed: Q5.1 (B), R172.2
Relay1_EN: R169.1, R170.1
Relay2_EN: R171.1, R172.1
VIN: K1.3 (NO), K3.3 (NO)
