ihsanakyrk/Eski-Versionlar-Ve-Siparisler/Movita_XV500_Router_V4.0/SATA_Con.kicad_sch

## KiCad design Movita_XV500_Router_V4.0/SATA_Con.kicad_sch (2025-09-01)

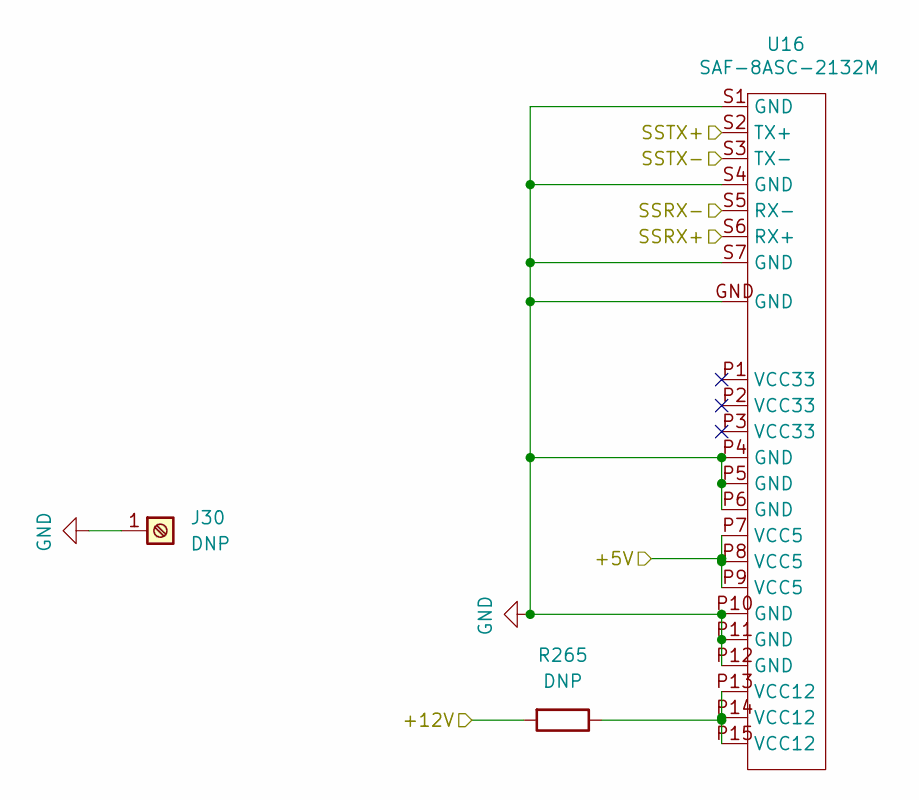
[picture p198: schematic SATA_Con.kicad_sch]

Parts:
J30: DNP; Screw Terminal Shinbo; MPN SMTSO-M3-6ET
R265: DNP; R_0603_1608Metric
U16: SAF-8ASC-2132M; SATA_Connector_5622-1200-ML; MPN SAF-8ASC-2132M

Connections:
+5V: U16.P7 (VCC5), U16.P8 (VCC5), U16.P9 (VCC5)
+12V: R265.2
GND: J30.1, U16.GND, U16.P4 (GND), U16.P5 (GND), U16.P6 (GND), U16.P10 (GND), U16.P11 (GND), U16.P12 (GND), U16.S1 (GND), U16.S4 (GND), U16.S7 (GND)
unnamed: R265.1, U16.P13 (VCC12), U16.P14 (VCC12), U16.P15 (VCC12)
SSRX+: U16.S6 (RX+)
SSRX-: U16.S5 (RX-)
SSTX+: U16.S2 (TX+)
SSTX-: U16.S3 (TX-)
