ihsanakyrk/Eski-Versionlar-Ve-Siparisler/Movita_XV500_Router_V4.0/Switch_Power.kicad_sch

## KiCad design Movita_XV500_Router_V4.0/Switch_Power.kicad_sch (2025-09-01)

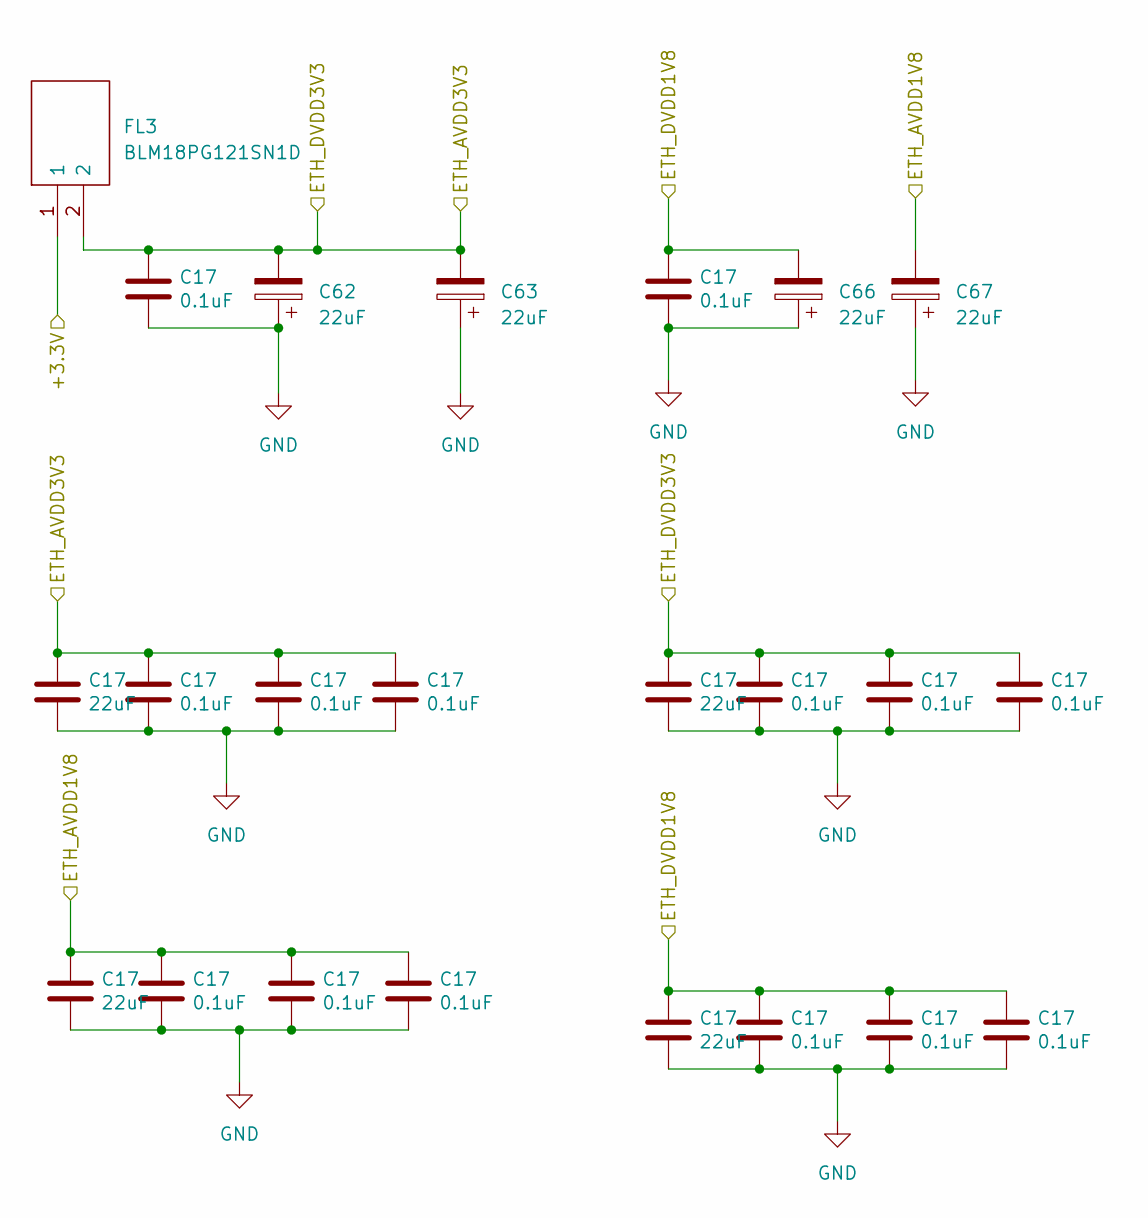
[picture p199: schematic Switch_Power.kicad_sch]

Parts:
C17: 22uF; C_0402_1005Metric
C62, C63, C66, C67: 22uF; EEE1AA220WR
FL3: BLM18PG121SN1D; BLM18AG102BH1D; Manufacturer_Part_Number BLM18PG121SN1D; Mouser Part Number 81-BLM18PG121SN1D

Connections:
+3.3V: FL3.1
ETH_AVDD1V8: C17.1, C67.2
ETH_AVDD3V3: C17.1, C62.2, C63.2, FL3.2
ETH_DVDD1V8: C17.1, C66.2
GND: C17.2, C62.1, C63.1, C66.1, C67.1
