ihsanakyrk/Eski-Versionlar-Ve-Siparisler/Movita_XV500_Router_V4.0/TopBoard.kicad_sch

## KiCad design Movita_XV500_Router_V4.0/TopBoard.kicad_sch (2025-09-01)

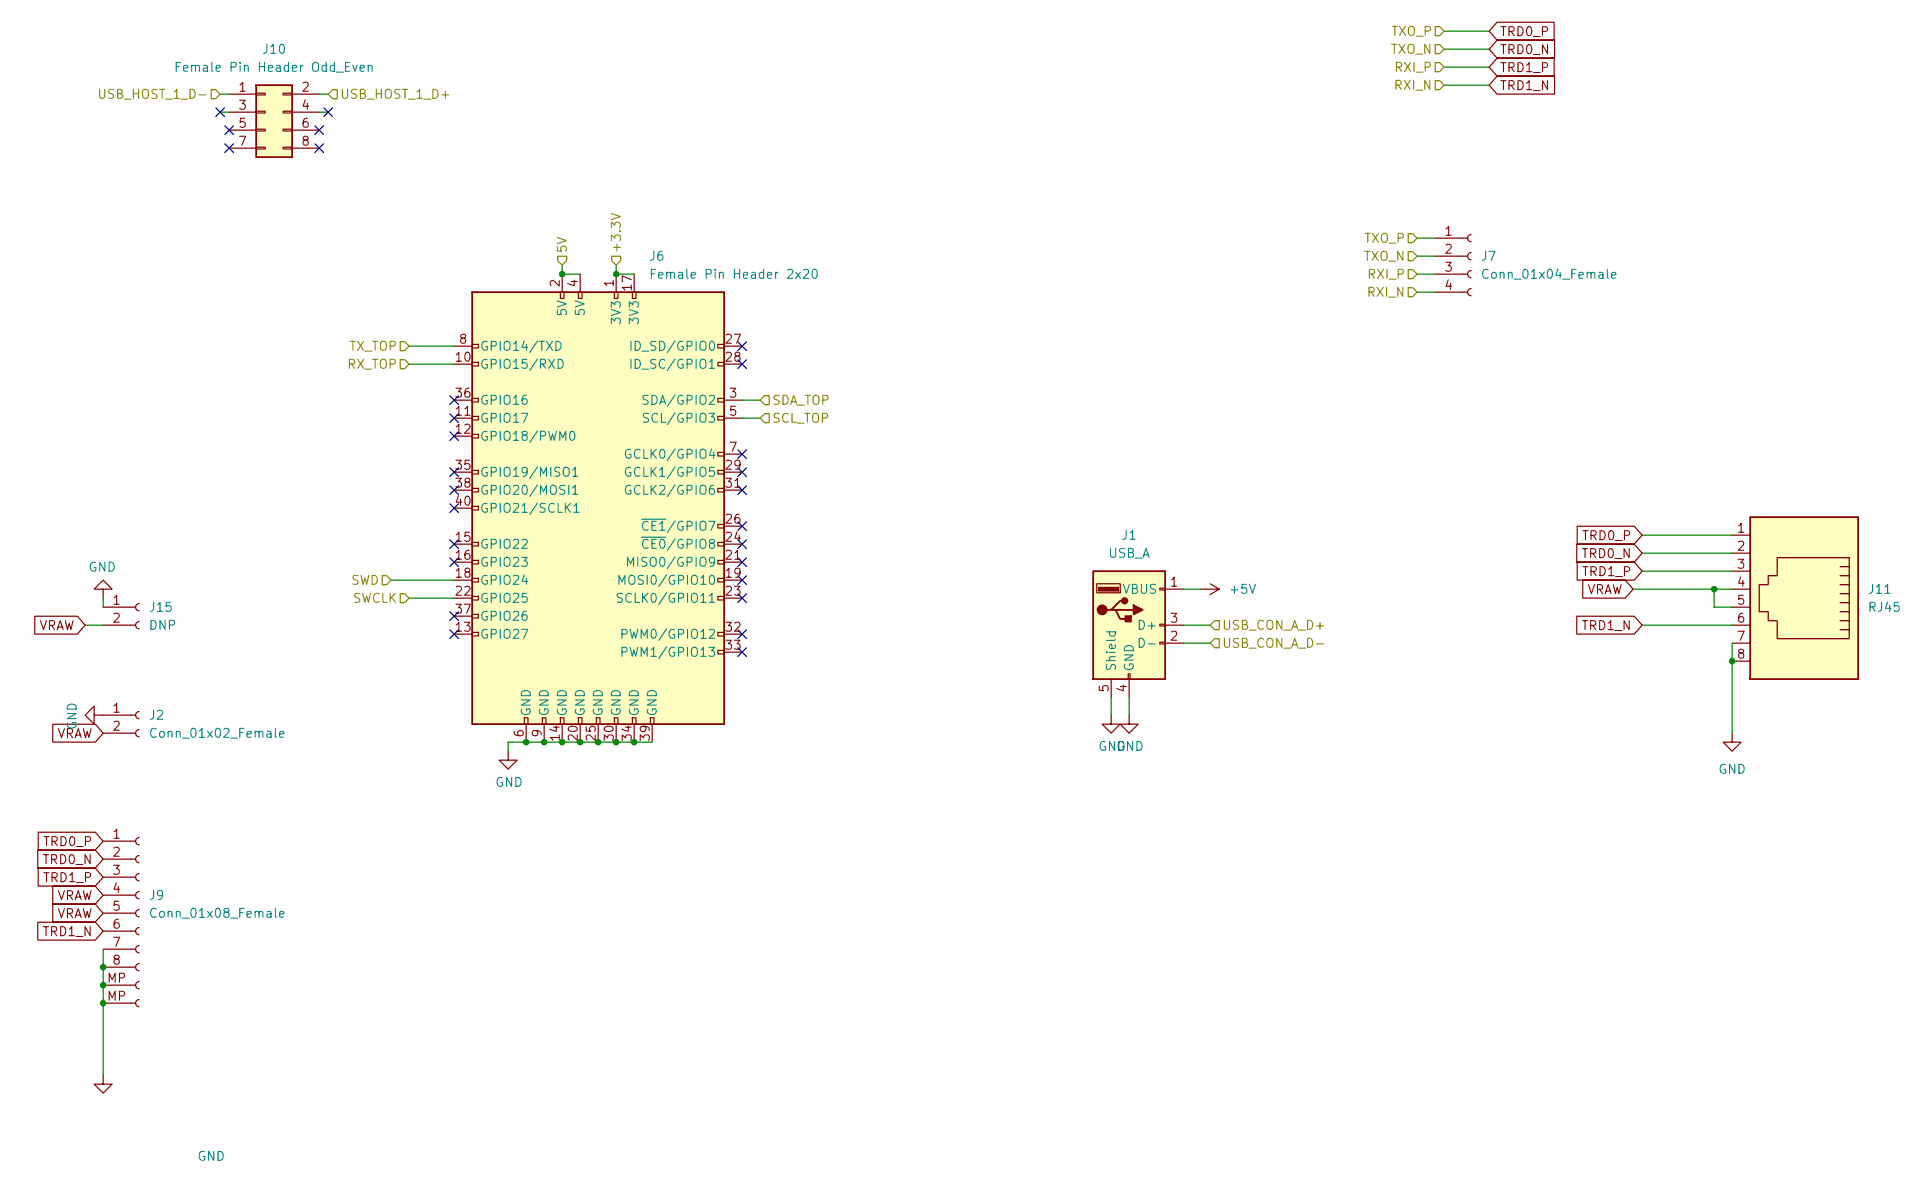
[picture p200: schematic TopBoard.kicad_sch]

Parts:
J1: USB_A; USB_A_CNCTech_1001-011-01101_Horizontal
J2: Conn_01x02_Female; JST_PH_B2B-PH-K_1x02_P2.00mm_Vertical
J6: Female Pin Header 2x20; PinHeader_2x20_P2.54mm_Vertical
J7: Conn_01x04_Female; PinHeader_2x02_P2.54mm_Vertical
J9: Conn_01x08_Female; JST_SH_BM08B-SRSS-TB_1x08-1MP_P1.00mm_Vertical
J10: Female Pin Header Odd_Even; PinHeader_2x04_P2.54mm_Vertical_SMD
J11: RJ45; RJ45_Amphenol_54602-x08_Horizontal_etrafitemiz
J15: DNP; PhoenixContact_MSTBA_2,5_2-G-5,08_1x02_P5.08mm_Horizontal

Connections:
5V: J6.2 (5V), J6.4 (5V)
+3.3V: J6.1 (3V3), J6.17 (3V3)
+5V: J1.1 (VBUS)
GND: J1.4 (GND), J1.5 (Shield), J2.1, J6.6 (GND), J6.9 (GND), J6.14 (GND), J6.20 (GND), J6.25 (GND), J6.30 (GND), J6.34 (GND), J6.39 (GND), J9.7, J9.8, J9.MP, J11.7, J11.8, J15.1
RX_TOP: J6.10 (GPIO15/RXD)
SCL_TOP: J6.5 (SCL/GPIO3)
SDA_TOP: J6.3 (SDA/GPIO2)
SWCLK: J6.22 (GPIO25)
SWD: J6.18 (GPIO24)
TRD0_N: J7.2, J9.2, J11.2
TRD0_P: J7.1, J9.1, J11.1
TRD1_N: J7.4, J9.6, J11.6
TRD1_P: J7.3, J9.3, J11.3
TX_TOP: J6.8 (GPIO14/TXD)
USB_CON_A_D+: J1.3 (D+)
USB_CON_A_D-: J1.2 (D-)
USB_HOST_1_D+: J10.2
USB_HOST_1_D-: J10.1
VRAW: J2.2, J9.4, J9.5, J11.4, J11.5, J15.2
