ihsanakyrk/Eski-Versionlar-Ve-Siparisler/Movita_XV500_Router_V4.0/USB2.0 OTG.kicad_sch

## KiCad design Movita_XV500_Router_V4.0/USB2.0 OTG.kicad_sch (2025-09-01)

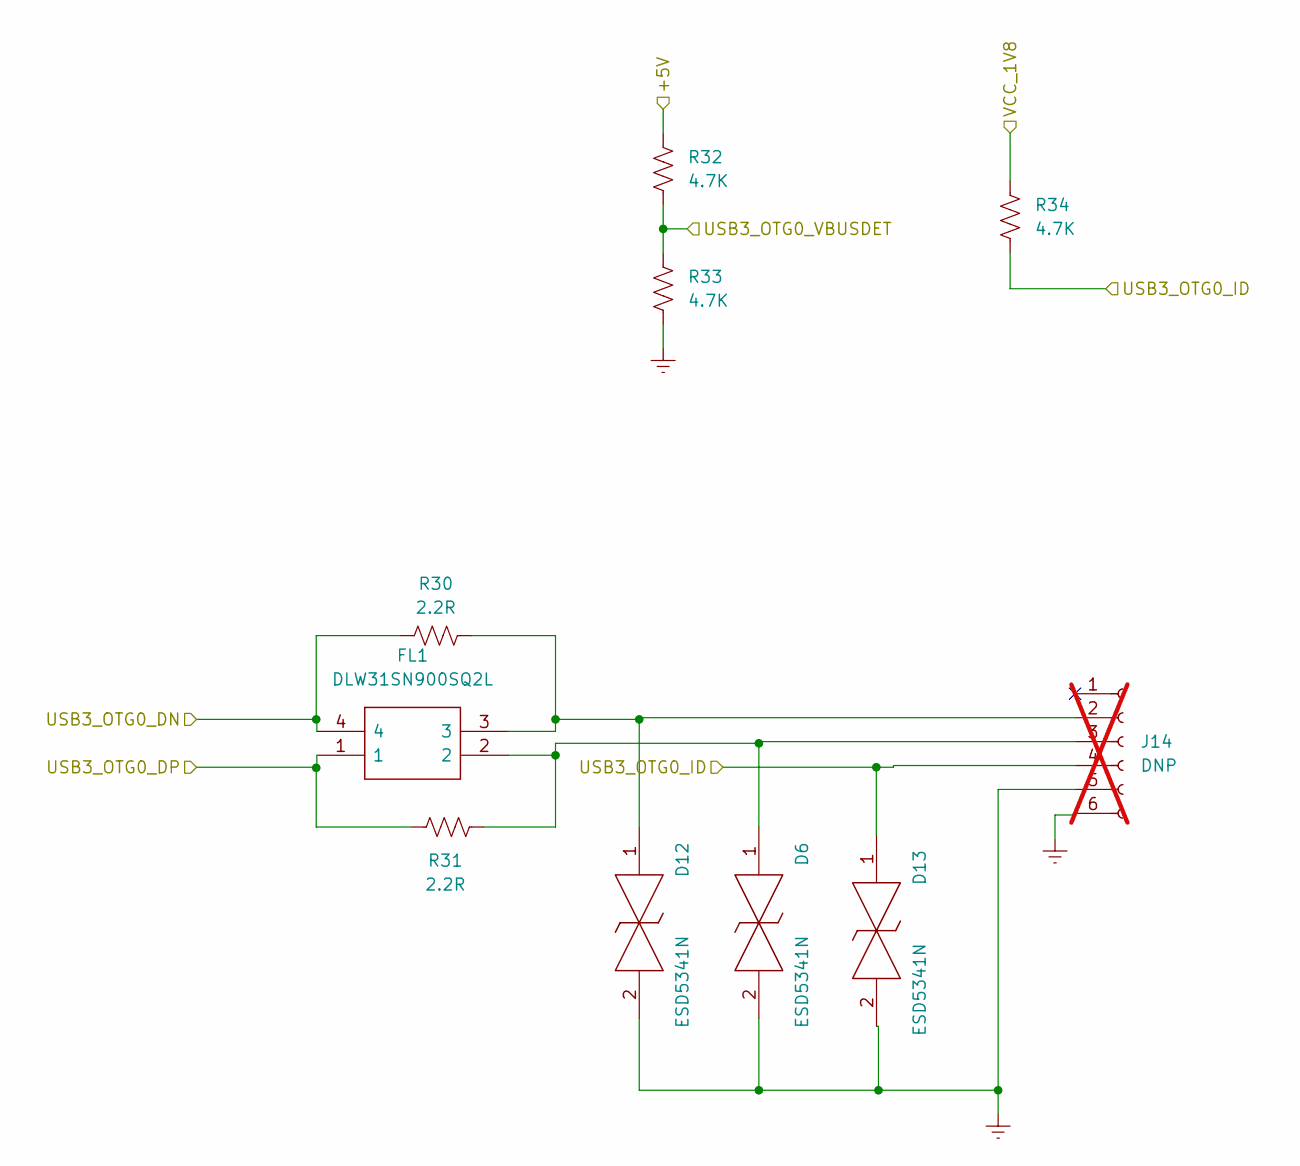
[picture p201: schematic USB2.0 OTG.kicad_sch]

Parts:
D6, D12, D13: ESD5341N; Manufacturer_Part_Number SP0402B-ULC-01ETG; Mouser Part Number 576-SP0402BULC-01ETG
FL1: DLW31SN900SQ2L; DLW31SH222SQ2L; Manufacturer_Part_Number DLW31SN900SQ2L; Mouser Part Number 81-DLW31SN900SQ2L
J14: DNP; PinSocket_1x06_P2.00mm_Vertical; not fitted
R30, R31: 2.2R; R_0402_1005Metric
R32, R33, R34: 4.7K; R_0603_1608Metric

Connections:
+5V: R32.1
Earth: D6.2, D12.2, D13.2, J14.5, J14.6, R33.2
unnamed: D6.1, FL1.2, J14.3, R31.2
unnamed: D12.1, FL1.3, J14.2, R30.2
USB3_OTG0_DN: FL1.4, R30.1
USB3_OTG0_DP: FL1.1, R31.1
USB3_OTG0_ID: D13.1, J14.4, R34.2
USB3_OTG0_VBUSDET: R32.2, R33.1
VCC_1V8: R34.1
