ihsanakyrk/Eski-Versionlar-Ve-Siparisler/Movita_XV500_Router_V4.0/USB3.0_OTG.kicad_sch

## KiCad design Movita_XV500_Router_V4.0/USB3.0_OTG.kicad_sch (2025-09-01)

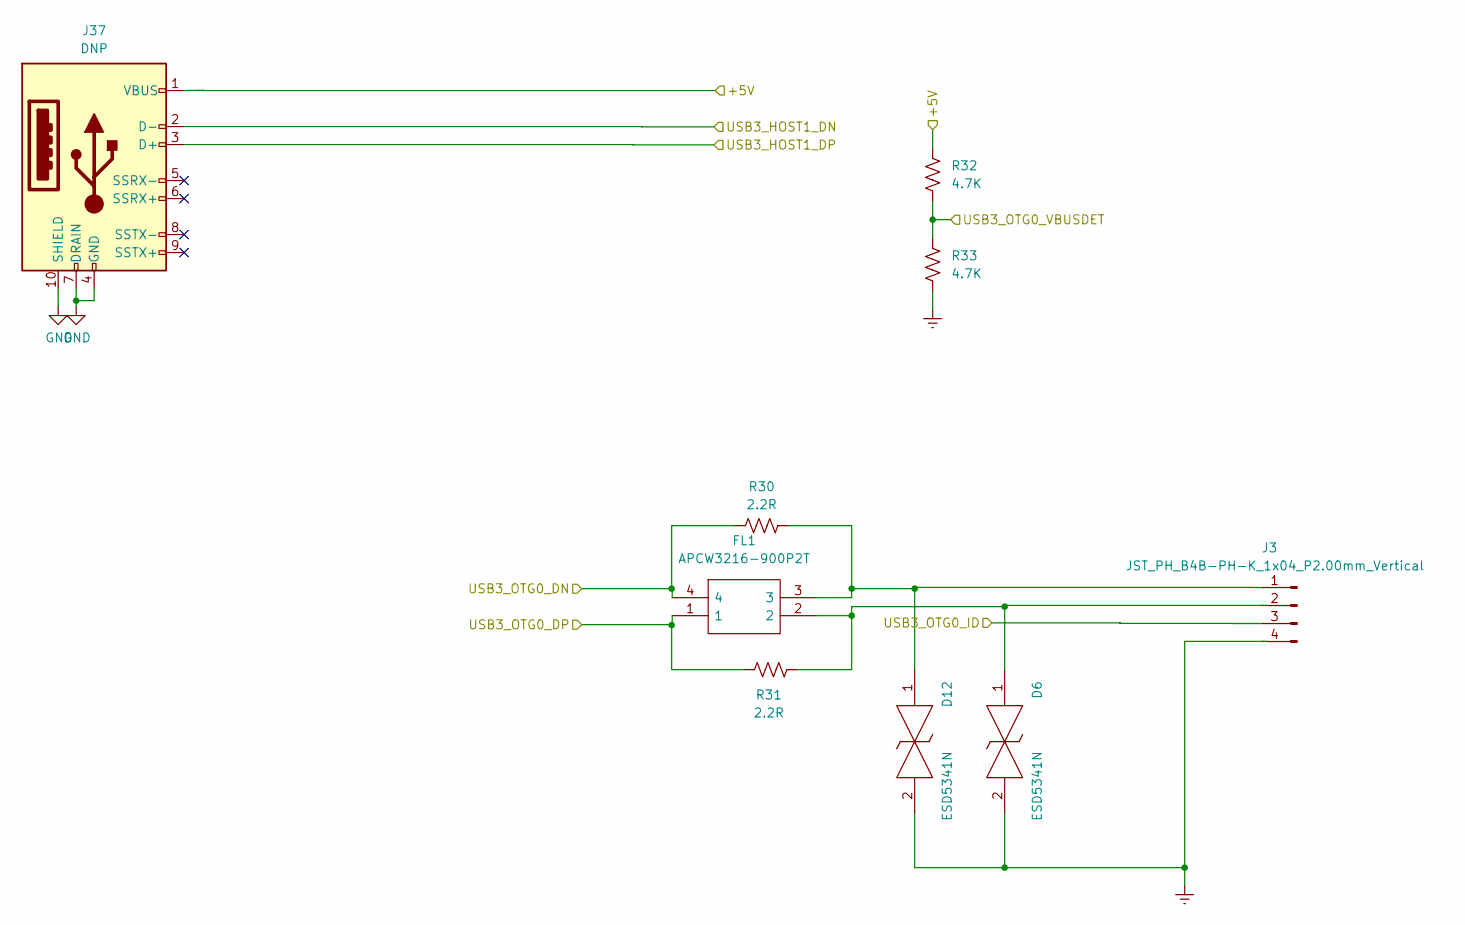
[picture p202: schematic USB3.0_OTG.kicad_sch]

Parts:
D6, D12: ESD5341N; Manufacturer_Part_Number SP0402B-ULC-01ETG; Mouser Part Number 576-SP0402BULC-01ETG
FL1: APCW3216-900P2T; DLW31SH222SQ2L; Manufacturer_Part_Number DLW31SN900SQ2L; Mouser Part Number 81-DLW31SN900SQ2L
J3: JST_PH_B4B-PH-K_1x04_P2.00mm_Vertical
J37: DNP; CP-USB-3015; MPN USB3.0 侧插
R30, R31: 2.2R; R_0402_1005Metric; MPN 0402WGF220KTCE
R32, R33: 4.7K; R_0603_1608Metric; MPN 0603WAF4701T5E

Connections:
+5V: J37.1 (VBUS), R32.1
Earth: D6.2, D12.2, J3.4, R33.2
GND: J37.4 (GND), J37.7 (DRAIN), J37.10 (SHIELD)
unnamed: D6.1, FL1.2, J3.2, R31.2
unnamed: D12.1, FL1.3, J3.1, R30.2
USB3_HOST1_DN: J37.2 (D-)
USB3_HOST1_DP: J37.3 (D+)
USB3_OTG0_DN: FL1.4, R30.1
USB3_OTG0_DP: FL1.1, R31.1
USB3_OTG0_ID: J3.3
USB3_OTG0_VBUSDET: R32.2, R33.1
