ihsanakyrk/Eski-Versionlar-Ve-Siparisler/Movita_XV500_Router_V4.0/WiFi Module.kicad_sch

## KiCad design Movita_XV500_Router_V4.0/WiFi Module.kicad_sch (2025-09-01)

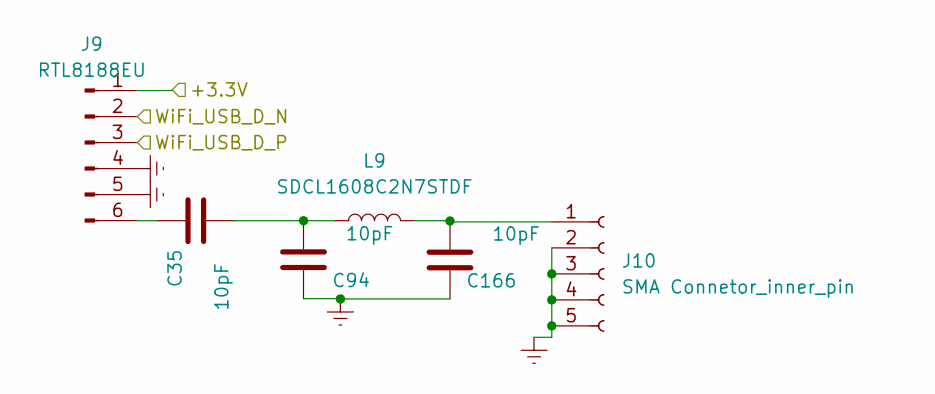
[picture p203: schematic WiFi Module.kicad_sch]

Parts:
C35, C94, C166: 10pF; C_0603_1608Metric; MPN CC0603JRNPO9BN100
J9: RTL8188EU; MPN RTL8188EUS 模块
J10: SMA Connetor_inner_pin; SMA_Connector_inner_pin_right_angle; MPN SMA-KWE 内针
L9: SDCL1608C2N7STDF; L_0603_1608Metric; MPN SDCL1608C2N7STDF

Connections:
+3.3V: J9.1
Earth: C94.2, C166.2, J9.4, J9.5, J10.2, J10.3, J10.4, J10.5
unnamed: C35.1, C94.1, L9.1
unnamed: C35.2, J9.6
unnamed: C166.1, J10.1, L9.2
WiFi_USB_D_N: J9.2
WiFi_USB_D_P: J9.3
