ihsanakyrk/Eski-Versionlar-Ve-Siparisler/Cam Tracker_3566/CamTracker_3566_V1.0-2024-01-22_131521/3566.kicad_sch

## KiCad design Cam Tracker_3566/CamTracker_3566_V1.0-2024-01-22_131521/3566.kicad_sch (2025-09-01)

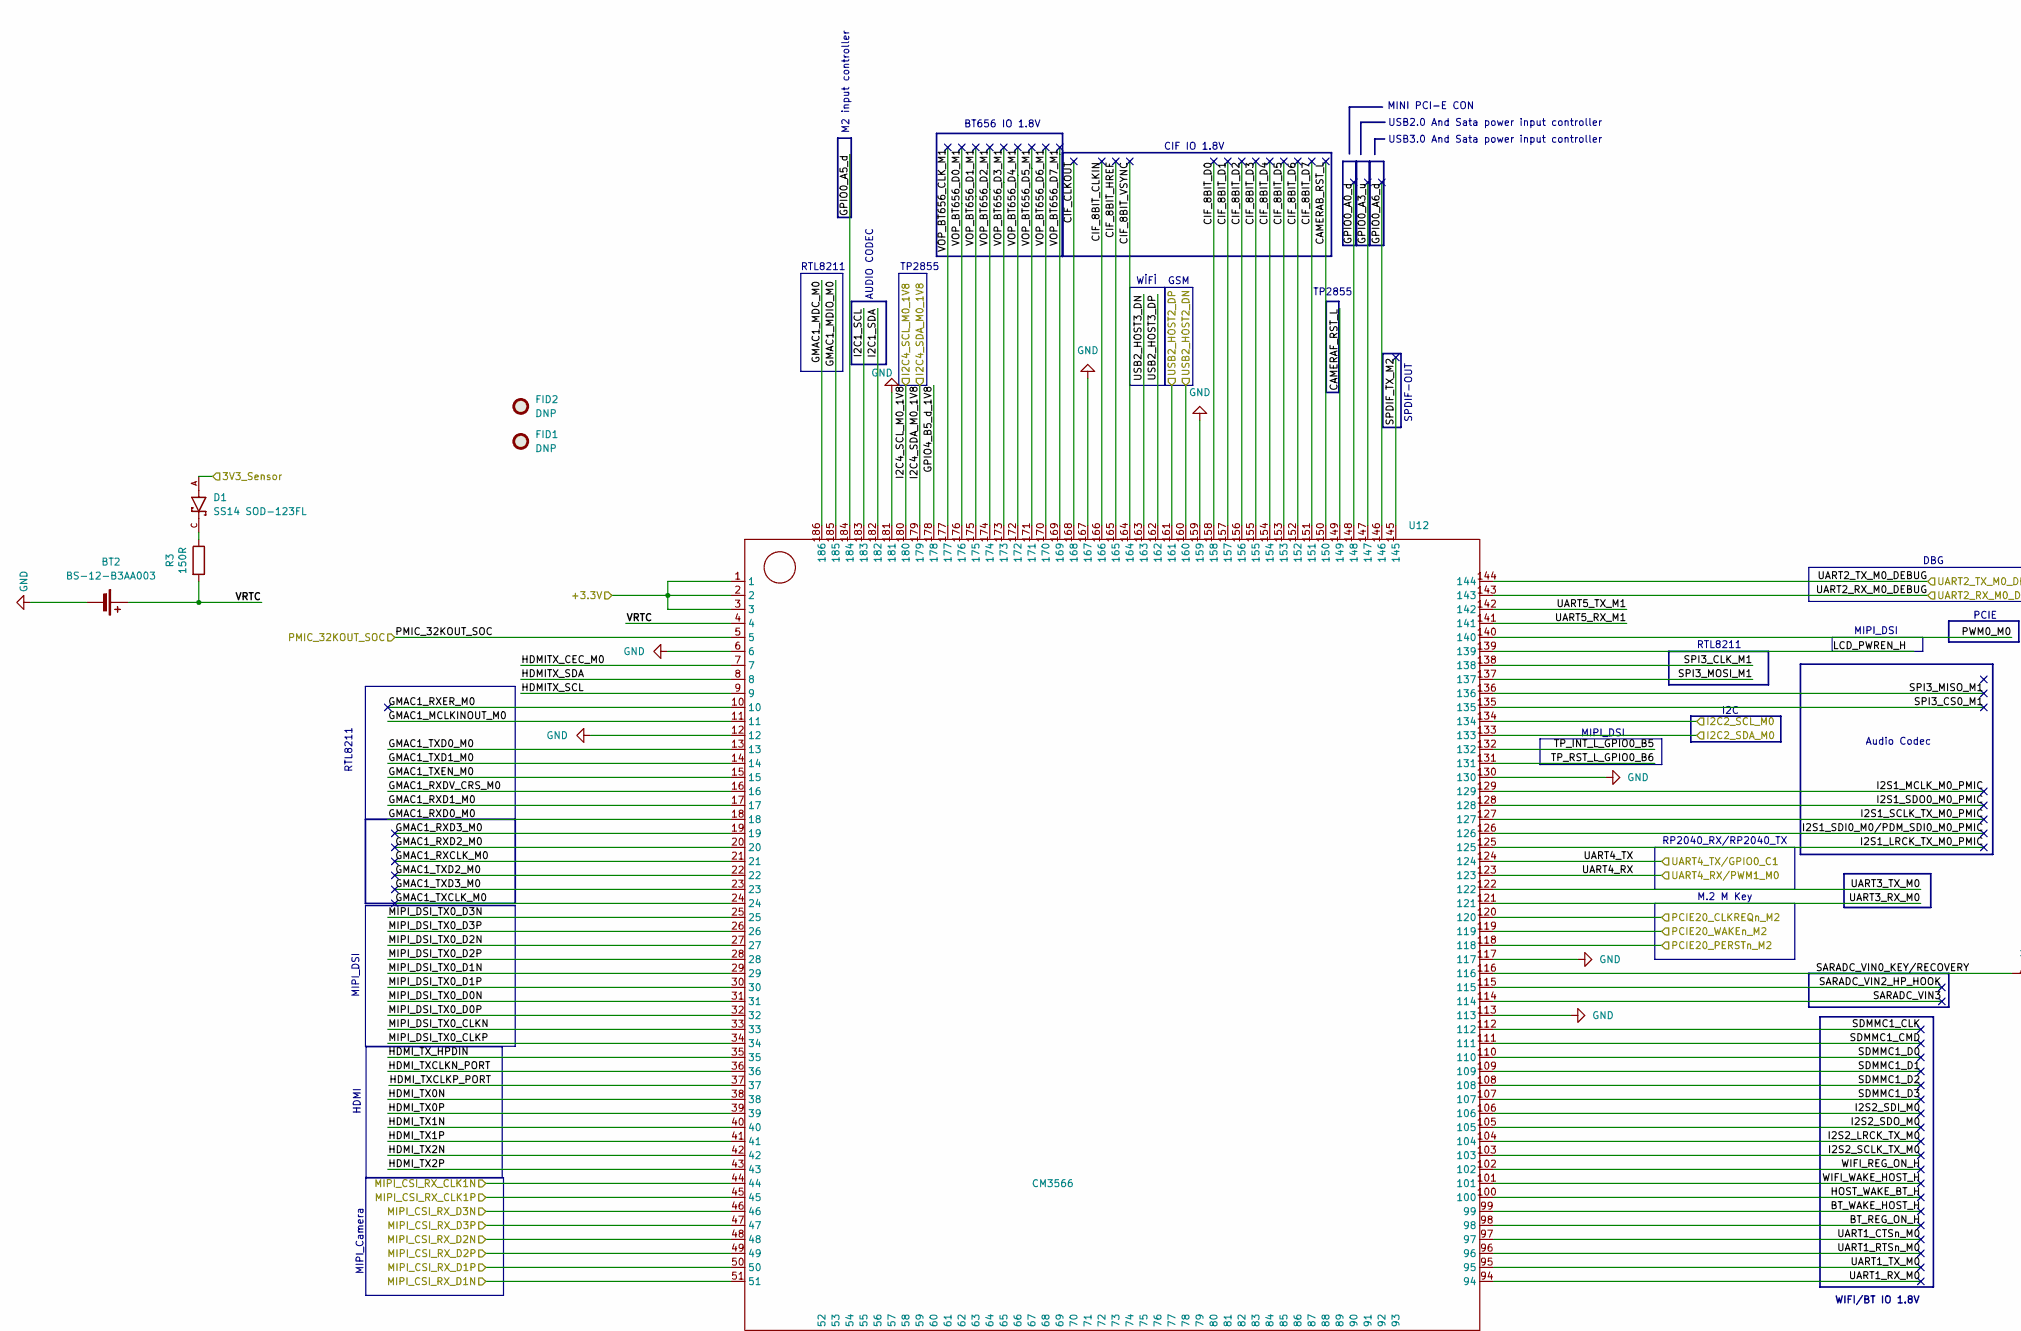
[picture p205: schematic 3566.kicad_sch, part in row 1, column 1]

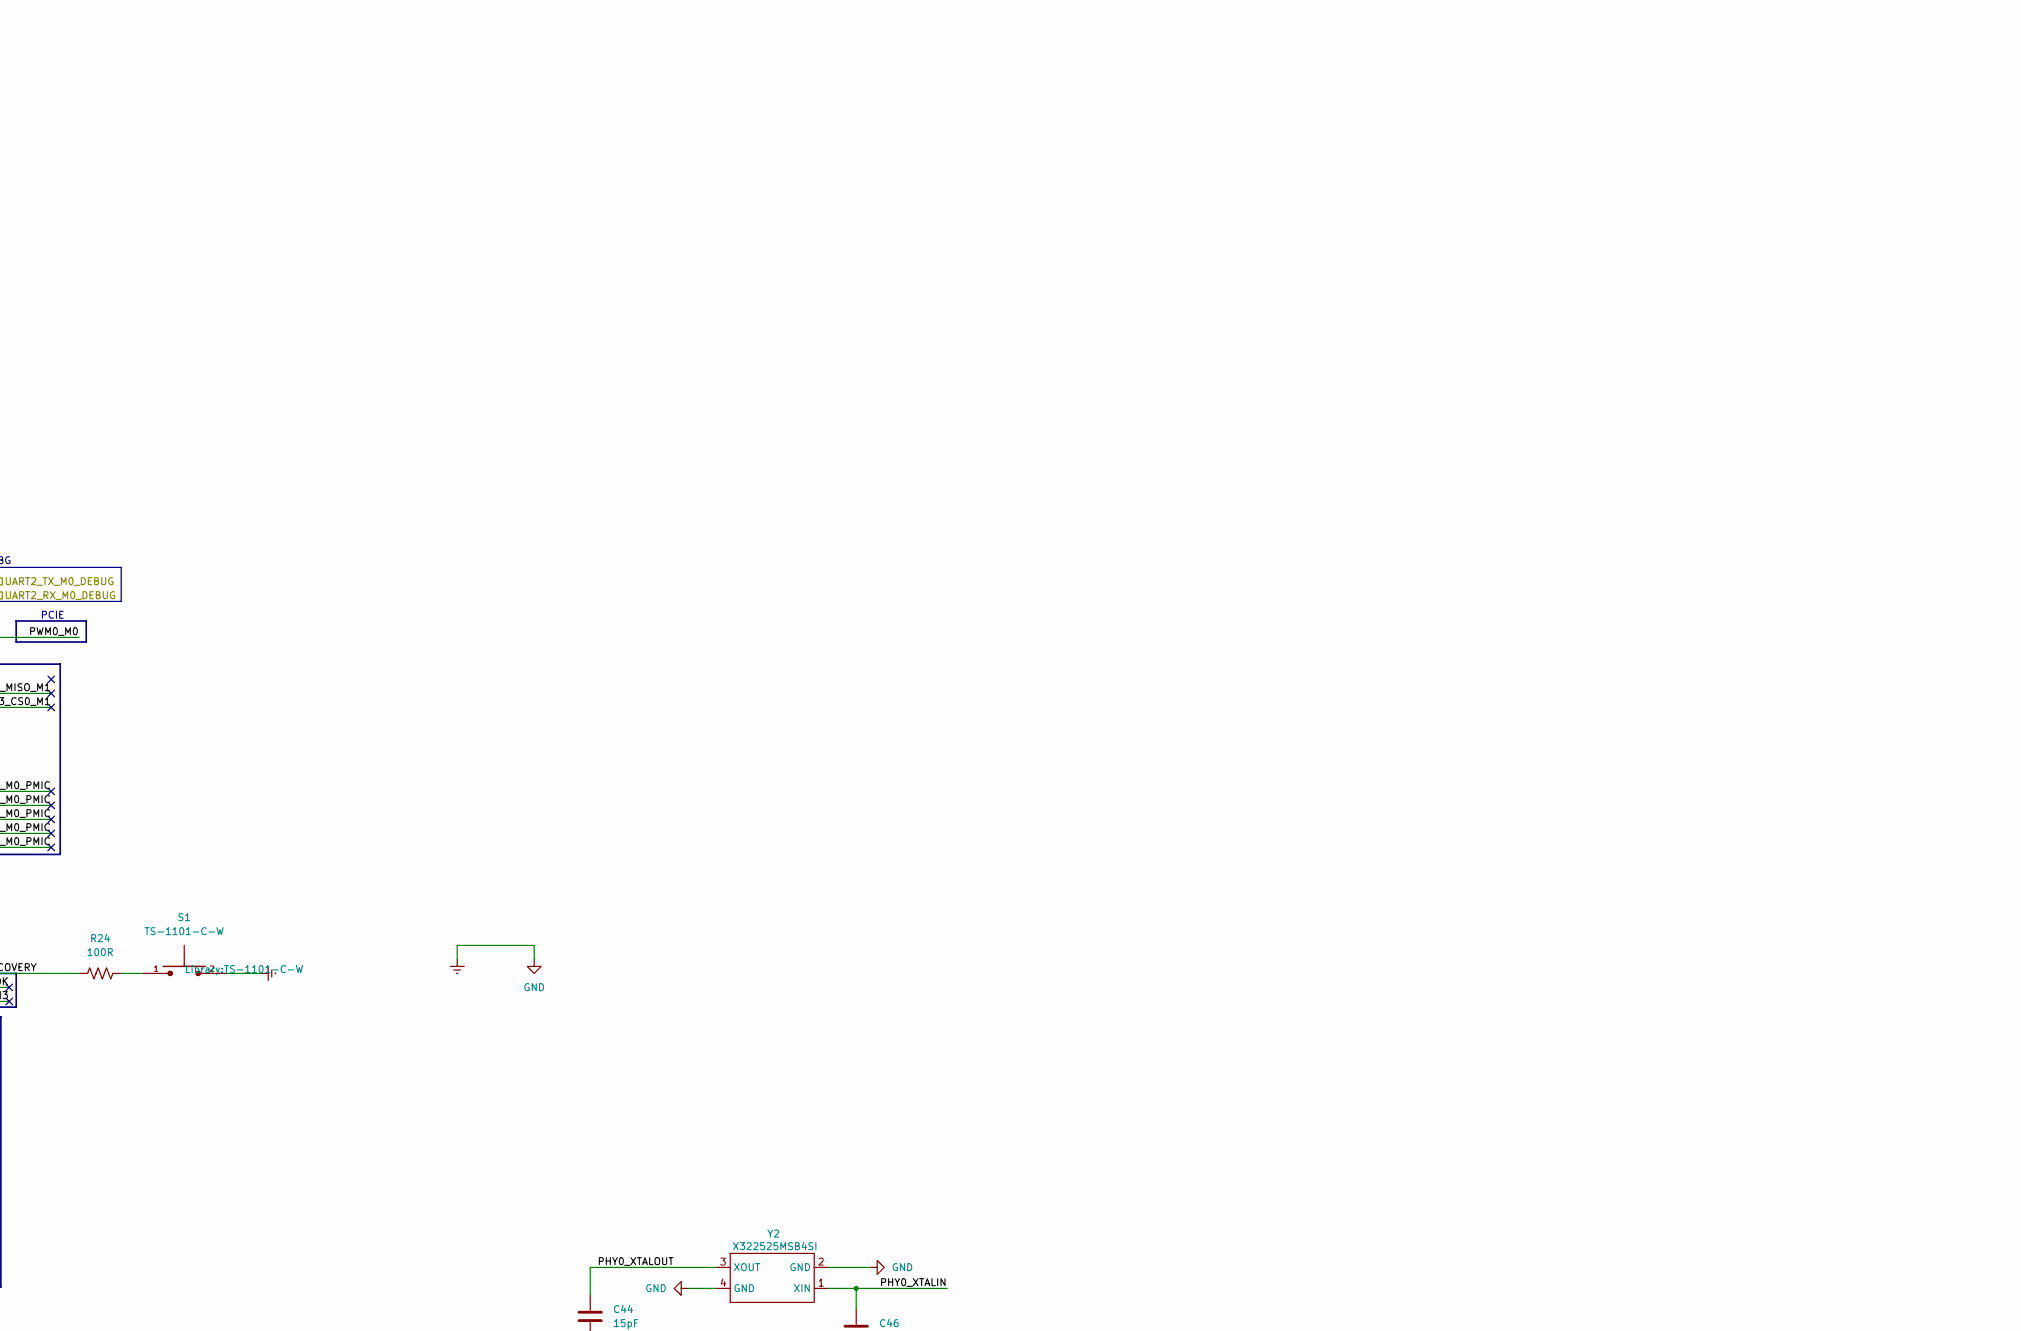
[picture p206: schematic 3566.kicad_sch, part in row 1, column 2]

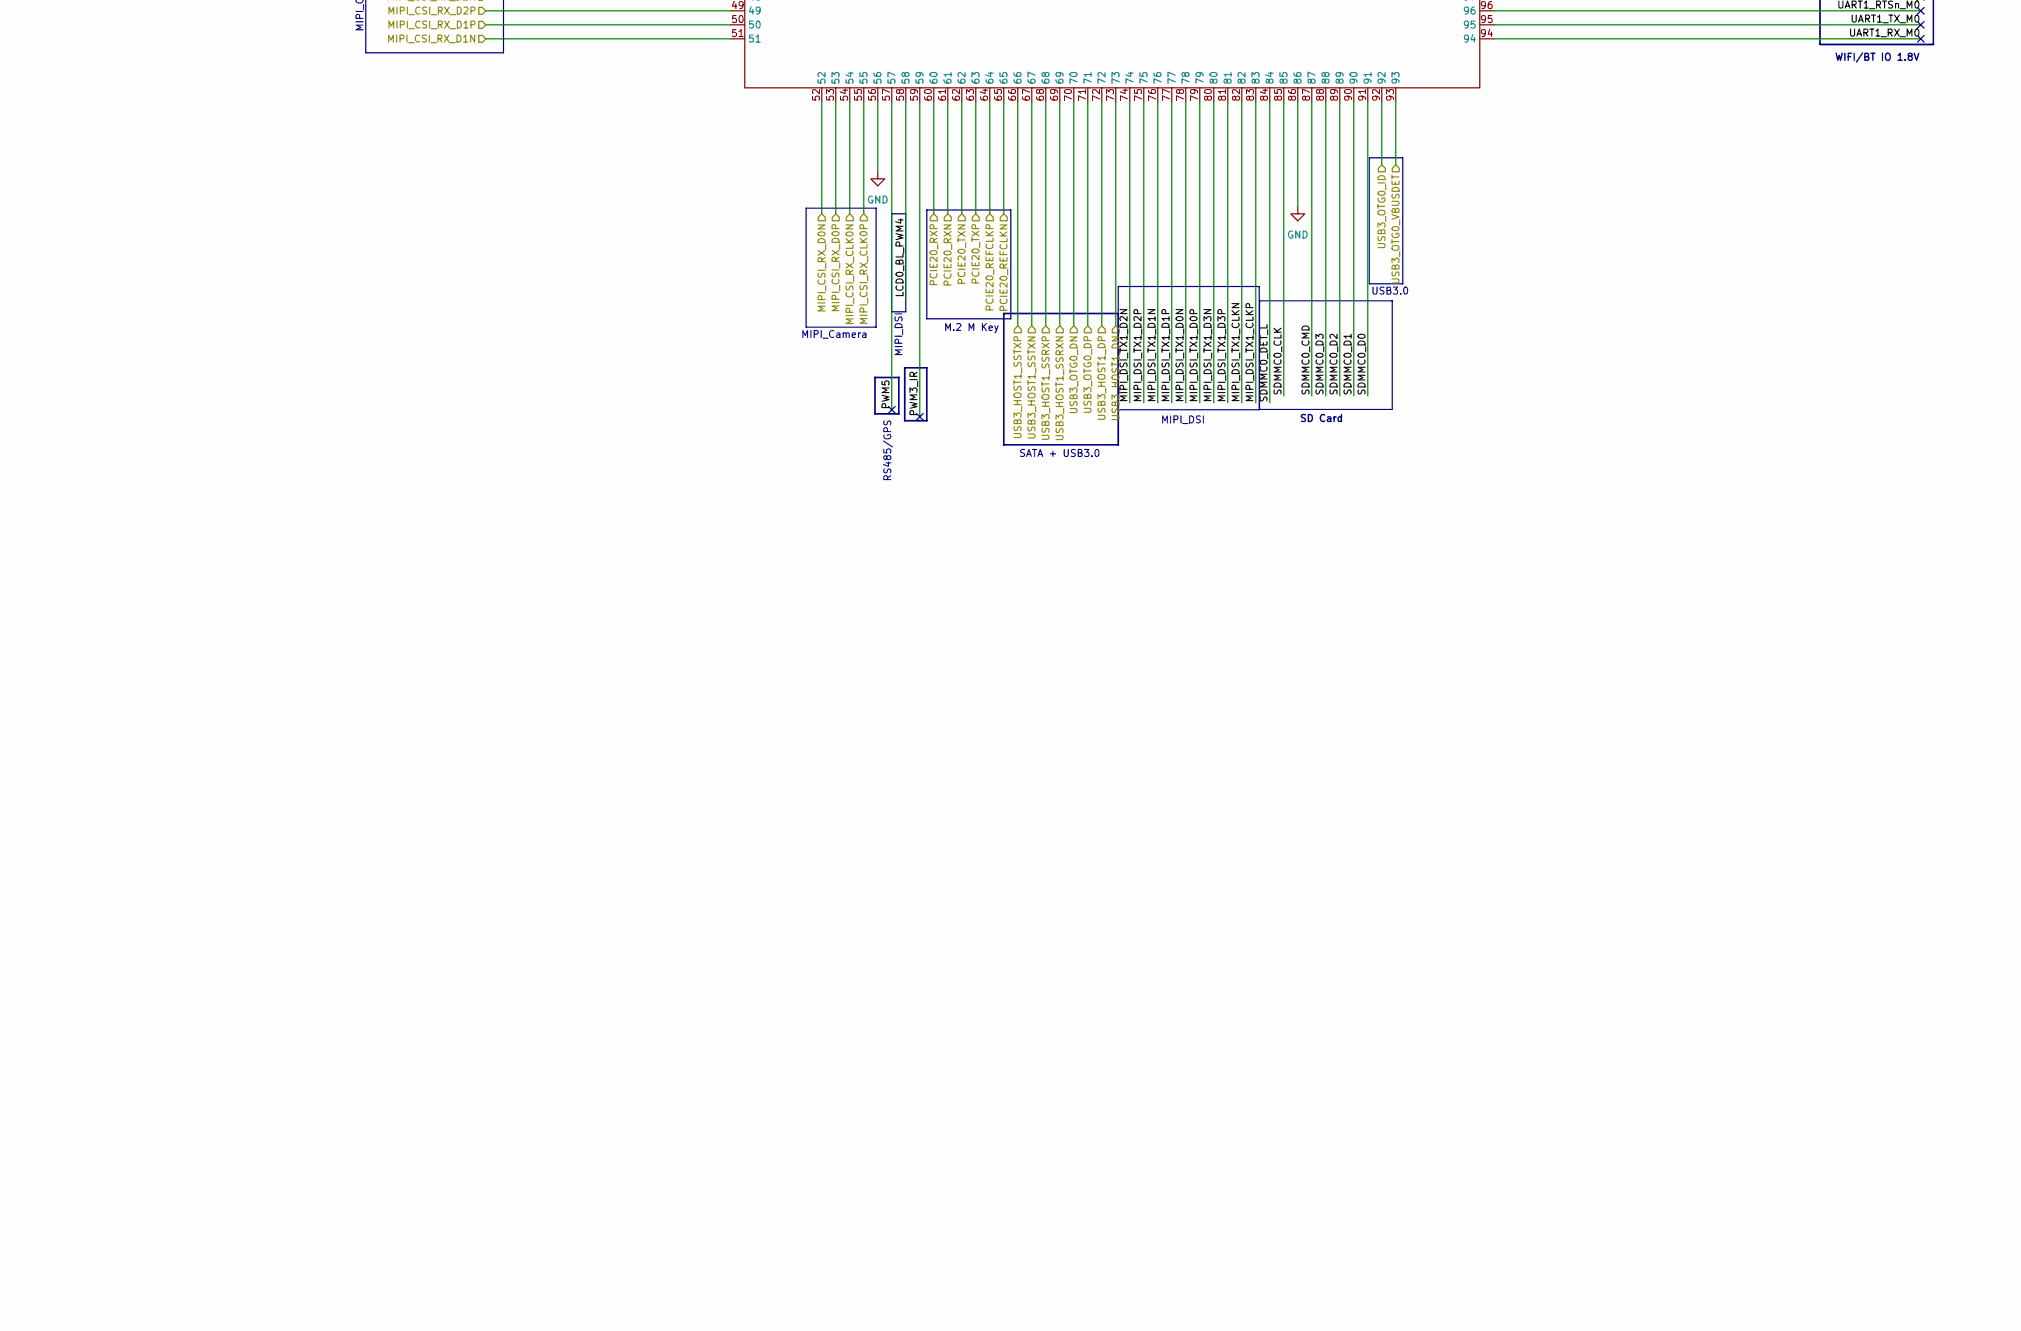
[picture p207: schematic 3566.kicad_sch, part in row 2, column 1]

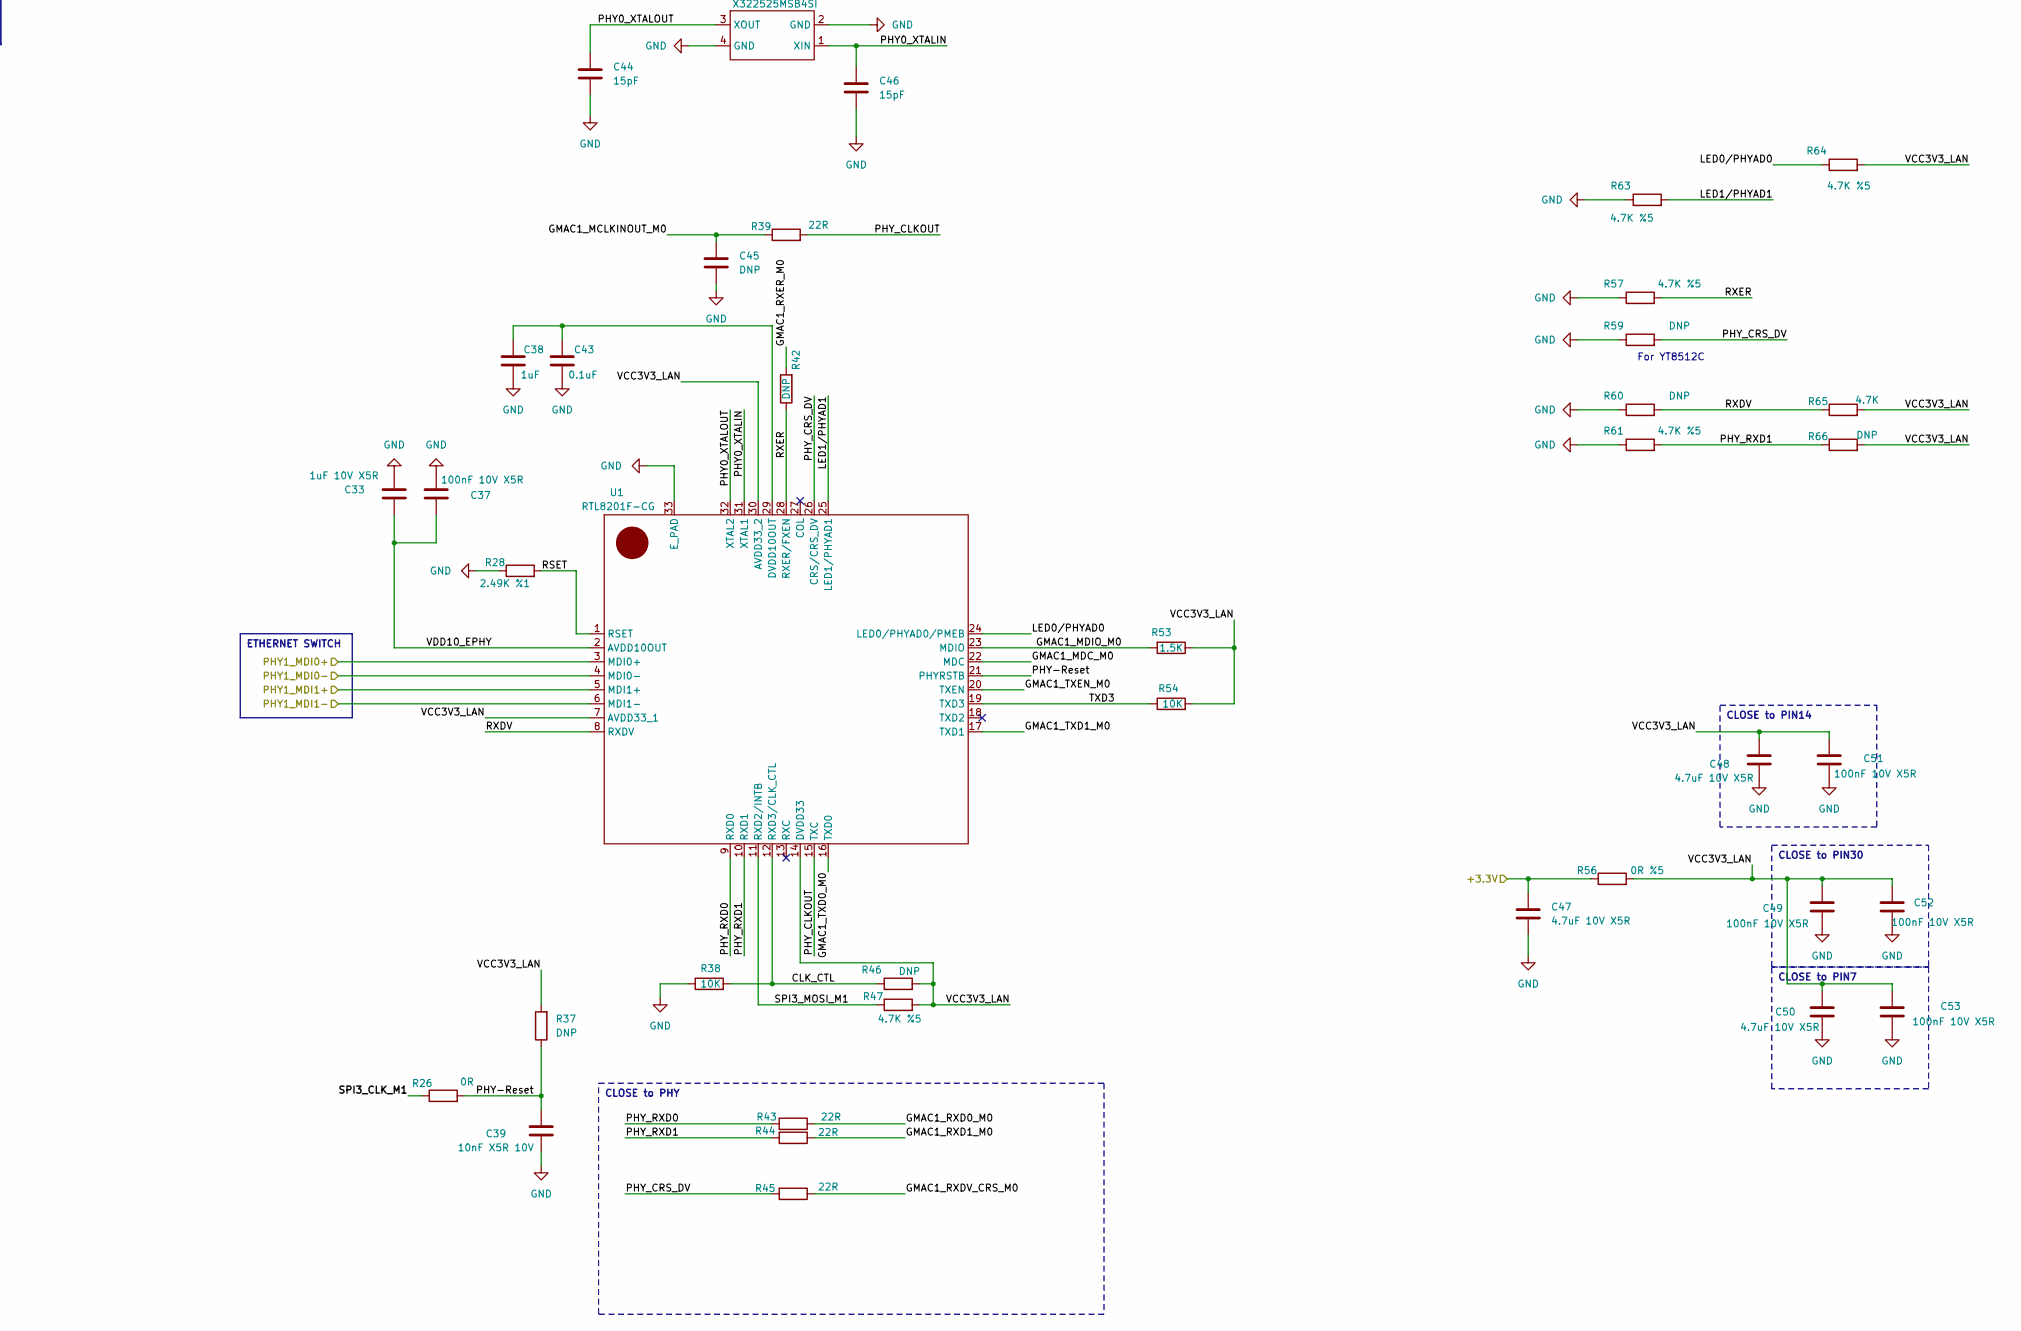
[picture p208: schematic 3566.kicad_sch, part in row 2, column 2]

Parts:
BT2: BS-12-B3AA003; MPN BS-12-B3AA003
C33: 1uF 10V X5R; C_0603_1608Metric
C37, C49, C51, C52, C53: 100nF 10V X5R; C_0402_1005Metric
C38: 1uF; C_0402_1005Metric
C39: 10nF X5R 10V; C_0402_1005Metric
C43: 0.1uF; C_0402_1005Metric
C44, C46: 15pF; C_0402_1005Metric
C45: DNP; C_0402_1005Metric
C47, C48, C50: 4.7uF 10V X5R; C_0603_1608Metric
D1: SS14 SOD-123FL; DIOM4325X250N; PARTREV O2102
FID1, FID2: DNP; Fiducial_0.5mm_Mask1mm; MPN Fiducial Marker
R3: 150R; R_0603_1608Metric
R24: 100R; R_0603_1608Metric
R26: 0R; R_0402_1005Metric
R28: 2.49K %1; R_0402_1005Metric
R37, R42, R46, R59, R60, R66: DNP; R_0402_1005Metric
R38, R54: 10K; R_0402_1005Metric
R39, R43, R44, R45: 22R; R_0402_1005Metric
R47, R57, R61, R63, R64: 4.7K %5; R_0402_1005Metric
R53: 1.5K; R_0402_1005Metric
R56: 0R %5; R_0402_1005Metric
R65: 4.7K; R_0402_1005Metric
S1: TS-1101-C-W; PARTREV F
U1: RTL8201F-CG; QFN50P500X500X100-33N; MPN RTL8211F-CG
U12: CM3566; MPN CM3566
Y2: X322525MSB4SI; Crystal_SMD_3225-4Pin_3.2x2.5mm; MPN X322525MSB4SI

Connections:
3V3_Sensor: D1.A
+3.3V: C47.1, R56.1, U12.1, U12.2, U12.3
BT_REG_ON_H: U12.98
BT_WAKE_HOST_H: U12.99
CAMERAB_RST_L: U12.150
CAMERAF_RST_L: U12.149
CIF_8BIT_CLKIN: U12.166
CIF_8BIT_D0: U12.158
CIF_8BIT_D1: U12.157
CIF_8BIT_D2: U12.156
CIF_8BIT_D3: U12.155
CIF_8BIT_D4: U12.154
CIF_8BIT_D5: U12.153
CIF_8BIT_D6: U12.152
CIF_8BIT_D7: U12.151
CIF_8BIT_HREF: U12.165
CIF_8BIT_VSYNC: U12.164
CIF_CLKOUT: U12.168
CLK_CTL: R38.2, R46.1, U1.12 (RXD3/CLK_CTL)
Earth: BT2.2 (-), C33.2, C37.2, C38.2, C39.2, C43.2, C44.2, C45.2, C46.2, C47.2, C48.2, C49.2, C50.2, C51.2, C52.2, C53.2, R28.1, R38.1, R57.1, R59.1, R60.1, R61.1, R63.1, S1.2, U1.33 (E_PAD), U12.6, U12.12, U12.56, U12.86, U12.113, U12.117, U12.130, U12.159, U12.167, U12.181, Y2.2 (GND), Y2.4 (GND)
GMAC1_MCLKINOUT_M0: C45.1, R39.1, U12.11
GMAC1_MDC_M0: U1.22 (MDC), U12.186
GMAC1_MDIO_M0: R53.2, U1.23 (MDIO), U12.185
GMAC1_RXCLK_M0: U12.21
GMAC1_RXD0_M0: R43.1, U12.18
GMAC1_RXD1_M0: R44.1, U12.17
GMAC1_RXD2_M0: U12.20
GMAC1_RXD3_M0: U12.19
GMAC1_RXDV_CRS_M0: R45.1, U12.16
GMAC1_RXER_M0: R42.2, U12.10
GMAC1_TXCLK_M0: U12.24
GMAC1_TXD0_M0: U1.16 (TXD0), U12.13
GMAC1_TXD1_M0: U1.17 (TXD1), U12.14
GMAC1_TXD2_M0: U12.22
GMAC1_TXD3_M0: U12.23
GMAC1_TXEN_M0: U1.20 (TXEN), U12.15
GPIO0_A0_d: U12.148
GPIO0_A3_u: U12.147
GPIO0_A5_d: U12.184
GPIO0_A6_d: U12.146
GPIO4_B5_d_1V8: U12.178
HDMITX_CEC_M0: U12.7
HDMITX_SCL: U12.9
HDMITX_SDA: U12.8
HDMI_TX0N: U12.38
HDMI_TX0P: U12.39
HDMI_TX1N: U12.40
HDMI_TX1P: U12.41
HDMI_TX2N: U12.42
HDMI_TX2P: U12.43
HDMI_TXCLKN_PORT: U12.36
HDMI_TXCLKP_PORT: U12.37
HDMI_TX_HPDIN: U12.35
HOST_WAKE_BT_H: U12.100
I2C1_SCL: U12.183
I2C1_SDA: U12.182
I2C2_SCL_M0: U12.134
I2C2_SDA_M0: U12.133
I2C4_SCL_M0_1V8: U12.180
I2C4_SDA_M0_1V8: U12.179
I2S1_LRCK_TX_M0_PMIC: U12.125
I2S1_MCLK_M0_PMIC: U12.129
I2S1_SCLK_TX_M0_PMIC: U12.127
I2S1_SDI0_M0/PDM_SDI0_M0_PMIC: U12.126
I2S1_SDO0_M0_PMIC: U12.128
I2S2_LRCK_TX_M0: U12.104
I2S2_SCLK_TX_M0: U12.103
I2S2_SDI_M0: U12.106
I2S2_SDO_M0: U12.105
LCD0_BL_PWM4: U12.58
LCD_PWREN_H: U12.139
LED0/PHYAD0: R64.1, U1.24 (LED0/PHYAD0/PMEB)
LED1/PHYAD1: R63.2, U1.25 (LED1/PHYAD1)
MIPI_CSI_RX_CLK0N: U12.54
MIPI_CSI_RX_CLK0P: U12.55
MIPI_CSI_RX_CLK1N: U12.44
MIPI_CSI_RX_CLK1P: U12.45
MIPI_CSI_RX_D0N: U12.52
MIPI_CSI_RX_D0P: U12.53
MIPI_CSI_RX_D1N: U12.51
MIPI_CSI_RX_D1P: U12.50
MIPI_CSI_RX_D2N: U12.48
MIPI_CSI_RX_D2P: U12.49
MIPI_CSI_RX_D3N: U12.46
MIPI_CSI_RX_D3P: U12.47
MIPI_DSI_TX0_CLKN: U12.33
MIPI_DSI_TX0_CLKP: U12.34
MIPI_DSI_TX0_D0N: U12.31
MIPI_DSI_TX0_D0P: U12.32
MIPI_DSI_TX0_D1N: U12.29
MIPI_DSI_TX0_D1P: U12.30
MIPI_DSI_TX0_D2N: U12.27
MIPI_DSI_TX0_D2P: U12.28
MIPI_DSI_TX0_D3N: U12.25
MIPI_DSI_TX0_D3P: U12.26
MIPI_DSI_TX1_CLKN: U12.82
MIPI_DSI_TX1_CLKP: U12.83
MIPI_DSI_TX1_D0N: U12.78
MIPI_DSI_TX1_D0P: U12.79
MIPI_DSI_TX1_D1N: U12.76
MIPI_DSI_TX1_D1P: U12.77
MIPI_DSI_TX1_D2N: U12.74
MIPI_DSI_TX1_D2P: U12.75
MIPI_DSI_TX1_D3N: U12.80
MIPI_DSI_TX1_D3P: U12.81
unnamed: C38.1, C43.1, U1.29 (DVDD10OUT)
unnamed: D1.C, R3.1
unnamed: R24.2, S1.1
PCIE20_CLKREQn_M2: U12.120
PCIE20_PERSTn_M2: U12.118
PCIE20_REFCLKN: U12.65
PCIE20_REFCLKP: U12.64
PCIE20_RXN: U12.61
PCIE20_RXP: U12.60
PCIE20_TXN: U12.62
PCIE20_TXP: U12.63
PCIE20_WAKEn_M2: U12.119
PHY0_XTALIN: C46.1, U1.31 (XTAL1), Y2.1 (XIN)
PHY0_XTALOUT: C44.1, U1.32 (XTAL2), Y2.3 (XOUT)
PHY1_MDI0+: U1.3 (MDI0+)
PHY1_MDI0-: U1.4 (MDI0-)
PHY1_MDI1+: U1.5 (MDI1+)
PHY1_MDI1-: U1.6 (MDI1-)
PHY-Reset: C39.1, R26.2, R37.1, U1.21 (PHYRSTB)
PHY_CLKOUT: R39.2, U1.15 (TXC)
PHY_CRS_DV: R45.2, R59.2, U1.26 (CRS/CRS_DV)
PHY_RXD0: R43.2, U1.9 (RXD0)
PHY_RXD1: R44.2, R61.2, R66.1, U1.10 (RXD1)
PMIC_32KOUT_SOC: U12.5
PWM0_M0: U12.140
PWM3_IR: U12.59
PWM5: U12.57
RSET: R28.2, U1.1 (RSET)
RXDV: R60.2, R65.1, U1.8 (RXDV)
RXER: R42.1, R57.2, U1.28 (RXER/FXEN)
SARADC_VIN0_KEY/RECOVERY: R24.1, U12.116
SARADC_VIN2_HP_HOOK: U12.115
SARADC_VIN3: U12.114
SDMMC0_CLK: U12.85
SDMMC0_CMD: U12.87
SDMMC0_D0: U12.91
SDMMC0_D1: U12.90
SDMMC0_D2: U12.89
SDMMC0_D3: U12.88
SDMMC0_DET_L: U12.84
SDMMC1_CLK: U12.112
SDMMC1_CMD: U12.111
SDMMC1_D0: U12.110
SDMMC1_D1: U12.109
SDMMC1_D2: U12.108
SDMMC1_D3: U12.107
SPDIF_TX_M2: U12.145
SPI3_CLK_M1: R26.1, U12.138
SPI3_CS0_M1: U12.135
SPI3_MISO_M1: U12.136
SPI3_MOSI_M1: R47.1, U1.11 (RXD2/INTB), U12.137
TP_INT_L_GPIO0_B5: U12.132
TP_RST_L_GPIO0_B6: U12.131
TXD3: R54.1, U1.19 (TXD3)
UART1_CTSn_M0: U12.97
UART1_RTSn_M0: U12.96
UART1_RX_M0: U12.94
UART1_TX_M0: U12.95
UART2_RX_M0_DEBUG: U12.143
UART2_TX_M0_DEBUG: U12.144
UART3_RX_M0: U12.121
UART3_TX_M0: U12.122
UART4_RX: U12.123
UART4_TX: U12.124
UART5_RX_M1: U12.141
UART5_TX_M1: U12.142
USB2_HOST2_DN: U12.160
USB2_HOST2_DP: U12.161
USB2_HOST3_DN: U12.163
USB2_HOST3_DP: U12.162
USB3_HOST1_DN: U12.73
USB3_HOST1_DP: U12.72
USB3_HOST1_SSRXN: U12.69
USB3_HOST1_SSRXP: U12.68
USB3_HOST1_SSTXN: U12.67
USB3_HOST1_SSTXP: U12.66
USB3_OTG0_DN: U12.70
USB3_OTG0_DP: U12.71
USB3_OTG0_ID: U12.92
USB3_OTG0_VBUSDET: U12.93
VCC3V3_LAN: C48.1, C49.1, C50.1, C51.1, C52.1, C53.1, R37.2, R46.2, R47.2, R53.1, R54.2, R56.2, R64.2, R65.2, R66.2, U1.7 (AVDD33_1), U1.14 (DVDD33), U1.30 (AVDD33_2)
VDD10_EPHY: C33.1, C37.1, U1.2 (AVDD10OUT)
VOP_BT656_CLK_M1: U12.177
VOP_BT656_D0_M1: U12.176
VOP_BT656_D1_M1: U12.175
VOP_BT656_D2_M1: U12.174
VOP_BT656_D3_M1: U12.173
VOP_BT656_D4_M1: U12.172
VOP_BT656_D5_M1: U12.171
VOP_BT656_D6_M1: U12.170
VOP_BT656_D7_M1: U12.169
VRTC: BT2.1 (+), R3.2, U12.4
WIFI_REG_ON_H: U12.102
WIFI_WAKE_HOST_H: U12.101

Notes on the sheet:
CLOSE to PIN30
CLOSE to PHY
CLOSE to PIN7
CLOSE to PIN14
ETHERNET SWITCH
PCIE
MIPI_Camera
WIFI/BT IO 1.8V
RTL8211
TP2855
M.2 M Key
CIF IO 1.8V
RTL8211
RP2040_RX/RP2040_TX
BT656 IO 1.8V
MIPI_DSI
USB3.0 And Sata power input controller
AUDIO CODEC
MIPI_DSI
USB2.0 And Sata power input controller
SD Card
Audio Codec
DBG
TP2855
RS485/GPS
MINI PCI-E CON
I2C
HDMI
For YT8512C
SPDIF-OUT
WİFİ
USB3.0
M2 input controller
GSM
SATA + USB3.0
