ihsanakyrk/Eski-Versionlar-Ve-Siparisler/Cam Tracker_3566/CamTracker_3566_V1.0-2024-01-22_131521/CAMERA.kicad_sch

## KiCad design Cam Tracker_3566/CamTracker_3566_V1.0-2024-01-22_131521/CAMERA.kicad_sch (2025-09-01)

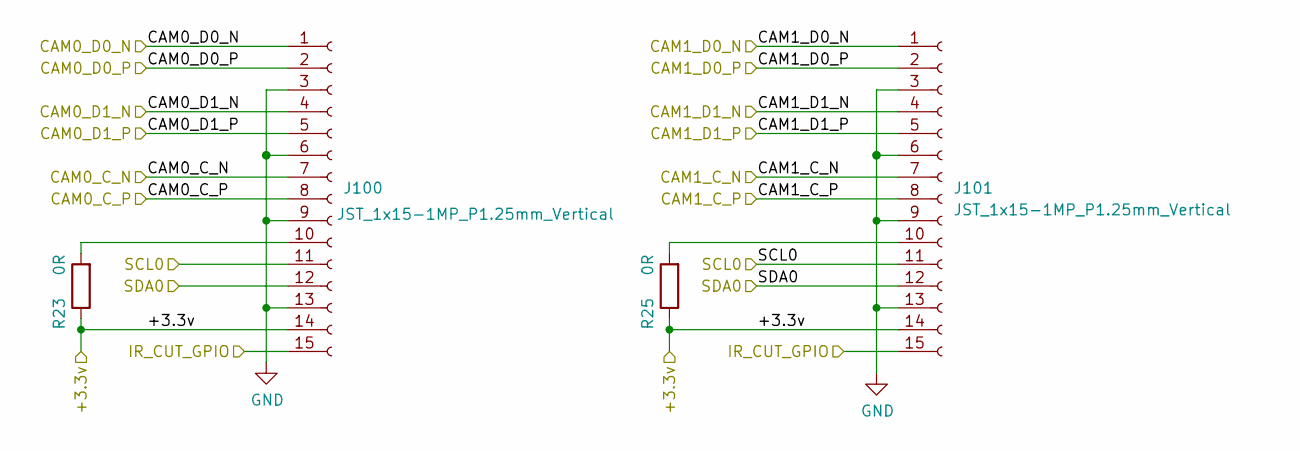
[picture p209: schematic CAMERA.kicad_sch]

Parts:
J100, J101: JST_1x15-1MP_P1.25mm_Vertical; MPN 1.25mm间距 立贴 1*15p
R23, R25: 0R; R_0603_1608Metric; Part Description Resistor 0R M2012 5%

Connections:
+3.3v: J100.14, J101.14, R23.1, R25.1
CAM0_C_N: J100.7
CAM0_C_P: J100.8
CAM0_D0_N: J100.1
CAM0_D0_P: J100.2
CAM0_D1_N: J100.4
CAM0_D1_P: J100.5
CAM1_C_N: J101.7
CAM1_C_P: J101.8
CAM1_D0_N: J101.1
CAM1_D0_P: J101.2
CAM1_D1_N: J101.4
CAM1_D1_P: J101.5
GND: J100.3, J100.6, J100.9, J100.13, J101.3, J101.6, J101.9, J101.13
IR_CUT_GPIO: J100.15, J101.15
unnamed: J100.10, R23.2
unnamed: J101.10, R25.2
SCL0: J100.11, J101.11
SDA0: J100.12, J101.12
