ihsanakyrk/Eski-Versionlar-Ve-Siparisler/Cam Tracker_3566/CamTracker_3566_V1.0-2024-01-22_131521/EC25_Sim.kicad_sch

## KiCad design Cam Tracker_3566/CamTracker_3566_V1.0-2024-01-22_131521/EC25_Sim.kicad_sch (2025-09-01)

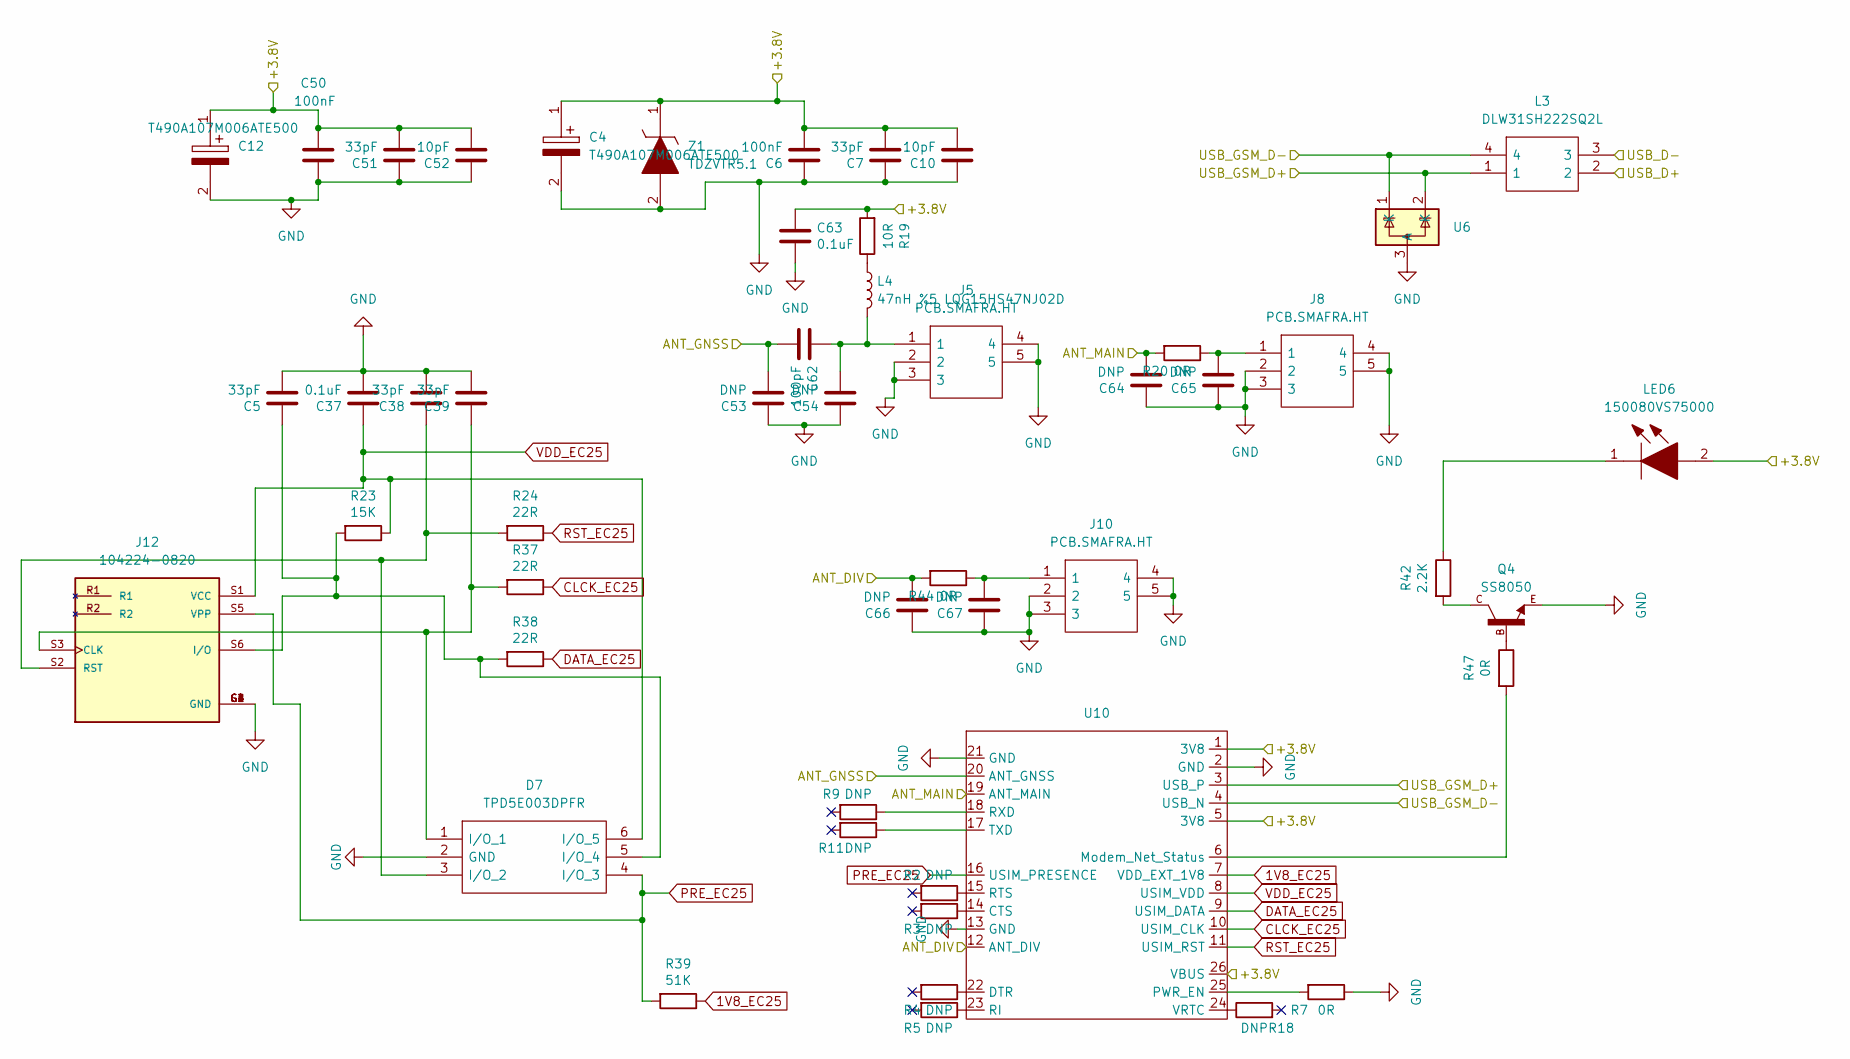
[picture p211: schematic EC25_Sim.kicad_sch]

Parts:
C4, C12: T490A107M006ATE500; T490A; Manufacturer_Part_Number T490A107M006ATE500; Mouser Part Number 80-T490A107M6ATE500
C5, C7, C38, C39, C51: 33pF; C_0603_1608Metric
C6, C50: 100nF; C_0603_1608Metric
C10, C52: 10pF; C_0603_1608Metric
C37, C63: 0.1uF; C_0603_1608Metric
C53, C54, C64, C65, C66, C67: DNP; C_0603_1608Metric
C62: 100pF; C_0603_1608Metric
D7: TPD5E003DPFR; SON35P100X100X40-6N; Manufacturer_Part_Number TPD5E003DPFR; Mouser Part Number 595-TPD5E003DPFR
J5, J8, J10: PCB.SMAFRA.HT; PCBSMAFRAHT; Manufacturer_Part_Number PCB.SMAFRA.HT; Mouser Part Number 960-PCB.SMAFRA.HT
J12: 104224-0820; MOLEX_104224-0820_etrafitemiz; PARTREV A
L3: DLW31SH222SQ2L; Manufacturer_Part_Number DLW31SH222SQ2L; Mouser Part Number 81-DLW31SH222SQ2L
L4: 47nH %5 LQG15HS47NJ02D; C_0402_1005Metric
LED6: 150080VS75000; LEDC2012X80N; Manufacturer_Part_Number 150080VS75000; Mouser Part Number 710-150080VS75000
Q4: SS8050; SOT-23_BEC
R2, R3, R4, R5, R9, R11, R18: DNP; R_0603_1608Metric
R7, R20, R44, R47: 0R; R_0603_1608Metric
R19: 10R; R_0603_1608Metric
R23: 15K; R_0603_1608Metric
R24, R37, R38: 22R; R_0603_1608Metric
R39: 51K; R_0603_1608Metric
R42: 2.2K; R_0603_1608Metric
U6: SOT-23-3
U10: GSM_SMD
Z1: TDZVTR5.1; TDZVTR51; Manufacturer_Part_Number TDZVTR5.1; Mouser Part Number 755-TDZVTR5.1

Connections:
1V8_EC25: R39.1, U10.7 (VDD_EXT_1V8)
+3.8V: C4.1, C6.2, C7.2, C10.2, C12.1, C50.2, C51.2, C52.2, C63.1, LED6.2, R19.2, U10.1 (3V8), U10.5 (3V8), U10.26 (VBUS), Z1.1
ANT_DIV: C66.2, R44.2, U10.12 (ANT_DIV)
ANT_GNSS: C53.2, C62.2, U10.20 (ANT_GNSS)
ANT_MAIN: C64.2, R20.2, U10.19 (ANT_MAIN)
CLCK_EC25: R37.1, U10.10 (USIM_CLK)
DATA_EC25: R38.1, U10.9 (USIM_DATA)
GND: C4.2, C5.2, C6.1, C7.1, C10.1, C12.2, C37.2, C38.2, C39.2, C50.1, C51.1, C52.1, C53.1, C54.1, C63.2, C64.1, C65.1, C66.1, C67.1, D7.2 (GND), J5.2, J5.3, J5.4, J5.5, J8.2, J8.3, J8.4, J8.5, J10.2, J10.3, J10.4, J10.5, J12.G1 (GND), J12.G2 (GND), J12.G3 (GND), J12.G4 (GND), J12.S4 (GND), Q4.E, R7.1, U6.3 (A), U10.2 (GND), U10.13 (GND), U10.21 (GND), Z1.2
unnamed: C5.1, D7.5 (I/O_4), J12.S6 (I/O), R23.2, R38.2
unnamed: C38.1, D7.3 (I/O_2), J12.S2 (RST), R24.2
unnamed: C39.1, D7.1 (I/O_1), J12.S3 (CLK), R37.2
unnamed: C54.2, C62.1, J5.1, L4.2
unnamed: C65.2, J8.1, R20.1
unnamed: C67.2, J10.1, R44.1
unnamed: L4.1, R19.1
unnamed: LED6.1, R42.1
unnamed: Q4.B, R47.1
unnamed: Q4.C, R42.2
unnamed: R2.1, U10.15 (RTS)
unnamed: R3.1, U10.14 (CTS)
unnamed: R4.1, U10.22 (DTR)
unnamed: R5.1, U10.23 (RI)
unnamed: R7.2, U10.25 (PWR_EN)
unnamed: R9.1, U10.18 (RXD)
unnamed: R11.1, U10.17 (TXD)
unnamed: R18.1, U10.24 (VRTC)
unnamed: R47.2, U10.6 (Modem_Net_Status)
PRE_EC25: D7.4 (I/O_3), J12.S5 (VPP), R39.2, U10.16 (USIM_PRESENCE)
RST_EC25: R24.1, U10.11 (USIM_RST)
USB_D+: L3.2
USB_D-: L3.3
USB_GSM_D+: L3.1, U6.2 (K), U10.3 (USB_P)
USB_GSM_D-: L3.4, U6.1 (K), U10.4 (USB_N)
VDD_EC25: C37.1, D7.6 (I/O_5), J12.S1 (VCC), R23.1, U10.8 (USIM_VDD)
