ihsanakyrk/Eski-Versionlar-Ve-Siparisler/Cam Tracker_3566/CamTracker_3566_V1.0-2024-01-22_131521/Ethernet.kicad_sch

## KiCad design Cam Tracker_3566/CamTracker_3566_V1.0-2024-01-22_131521/Ethernet.kicad_sch (2025-09-01)

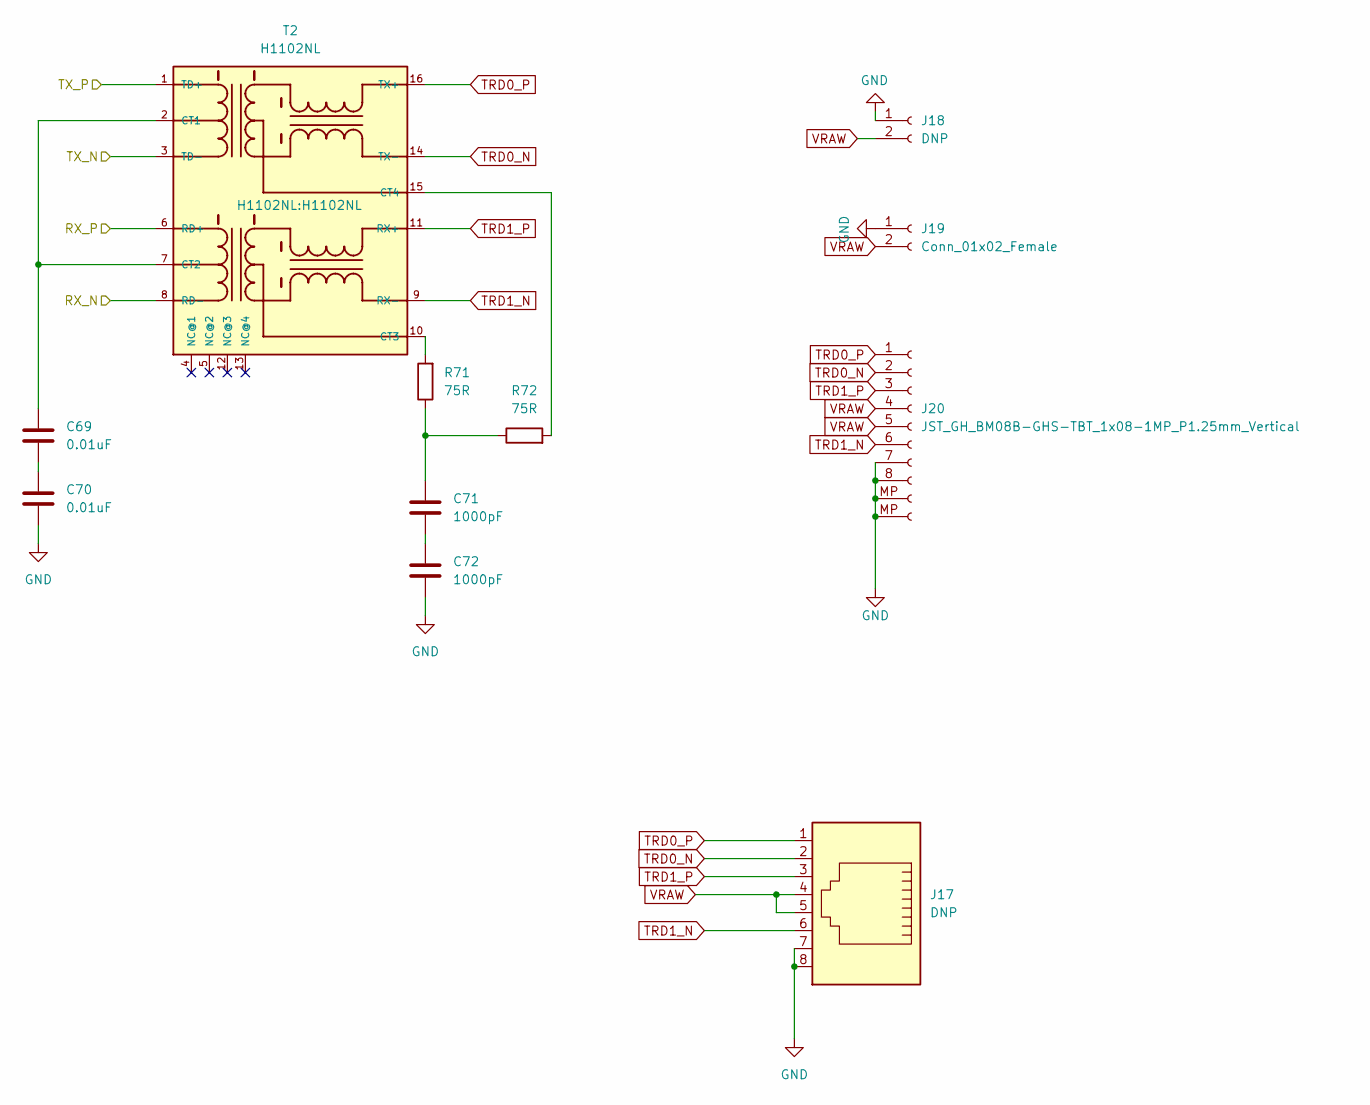
[picture p212: schematic Ethernet.kicad_sch]

Parts:
C69, C70: 0.01uF; C_0603_1608Metric
C71, C72: 1000pF; C_0603_1608Metric
J17: DNP; RJ45_Amphenol_54602-x08_Horizontal
J18: DNP; PhoenixContact_MSTBA_2,5_2-G-5,08_1x02_P5.08mm_Horizontal
J19: Conn_01x02_Female; JST_PH_B2B-PH-K_1x02_P2.00mm_Vertical
J20: JST_GH_BM08B-GHS-TBT_1x08-1MP_P1.25mm_Vertical
R71, R72: 75R; R_0603_1608Metric
T2: H1102NL

Connections:
GND: C70.2, C72.2, J17.7, J17.8, J18.1, J19.1, J20.7, J20.8, J20.MP
unnamed: C69.1, T2.2 (CT1), T2.7 (CT2)
unnamed: C69.2, C70.1
unnamed: C71.1, R71.1, R72.1
unnamed: C71.2, C72.1
unnamed: R71.2, T2.10 (CT3)
unnamed: R72.2, T2.15 (CT4)
RX_N: T2.8 (RD-)
RX_P: T2.6 (RD+)
TRD0_N: J17.2, J20.2, T2.14 (TX-)
TRD0_P: J17.1, J20.1, T2.16 (TX+)
TRD1_N: J17.6, J20.6, T2.9 (RX-)
TRD1_P: J17.3, J20.3, T2.11 (RX+)
TX_N: T2.3 (TD-)
TX_P: T2.1 (TD+)
VRAW: J17.4, J17.5, J18.2, J19.2, J20.4, J20.5
