ihsanakyrk/Eski-Versionlar-Ve-Siparisler/Cam Tracker_3566/CamTracker_3566_V1.0-2024-01-22_131521/I2C.kicad_sch

## KiCad design Cam Tracker_3566/CamTracker_3566_V1.0-2024-01-22_131521/I2C.kicad_sch (2025-09-01)

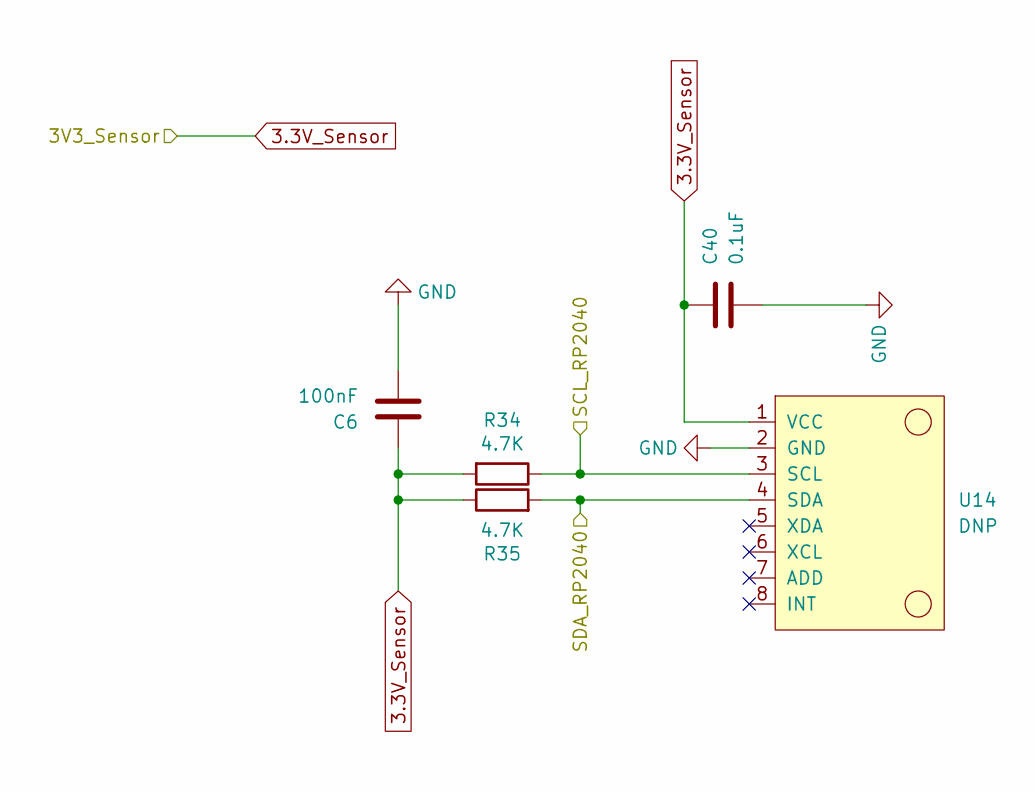
[picture p213: schematic I2C.kicad_sch]

Parts:
C6: 100nF; C_0603_1608Metric
C40: 0.1uF; C_0603_1608Metric
R34, R35: 4.7K; R_0603_1608Metric
U14: DNP; module_mpu6050

Connections:
3.3V_Sensor: C6.1, C40.1, R34.2, R35.1, U14.1 (VCC)
GND: C6.2, C40.2, U14.2 (GND)
SCL_RP2040: R34.1, U14.3 (SCL)
SDA_RP2040: R35.2, U14.4 (SDA)
