ihsanakyrk/Eski-Versionlar-Ve-Siparisler/Cam Tracker_3566/CamTracker_3566_V1.0-2024-01-22_131521/I2CDevice.kicad_sch

## KiCad design Cam Tracker_3566/CamTracker_3566_V1.0-2024-01-22_131521/I2CDevice.kicad_sch (2025-09-01)

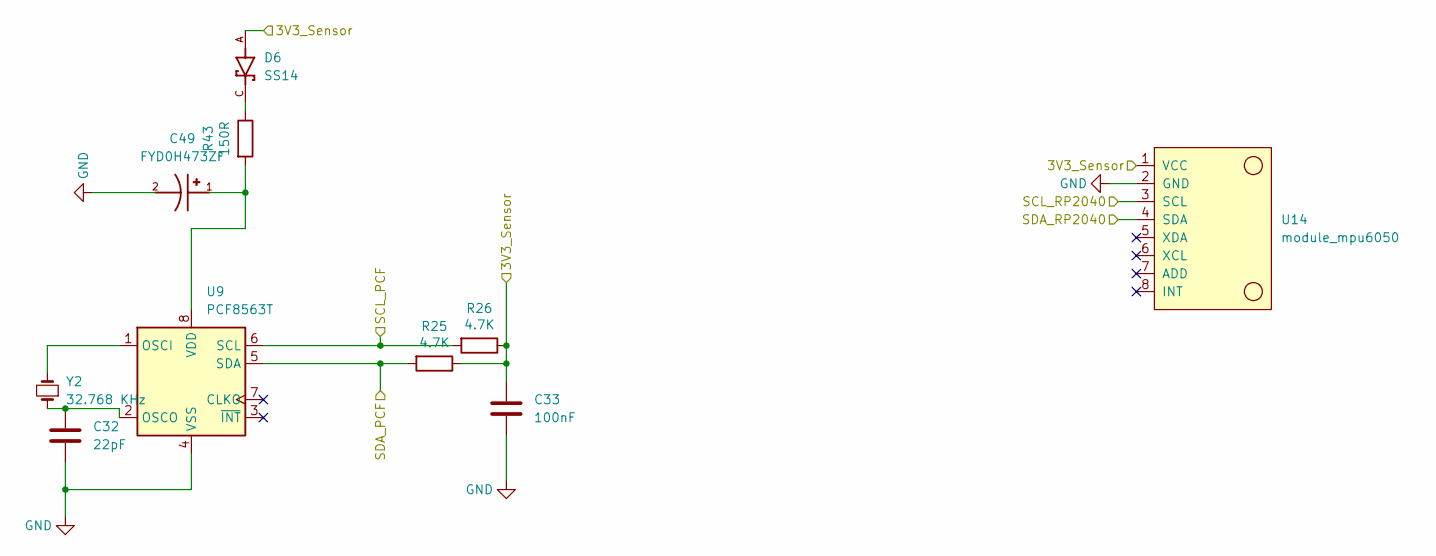
[picture p214: schematic I2CDevice.kicad_sch]

Parts:
C32: 22pF; C_0603_1608Metric
C33: 100nF; C_0603_1608Metric
C49: FYD0H473ZF; CAPPRD508W154D1200H850; PARTREV 7/17/2020
D6: SS14; DIOM4325X250N; PARTREV O2102
R25, R26: 4.7K; R_0603_1608Metric
R43: 150R; R_0603_1608Metric
U9: PCF8563T; SOIC-8_3.9x4.9mm_P1.27mm
U14: module_mpu6050
Y2: 32.768 KHz; Crystal_AT310_D3.0mm_L10.0mm_Horizontal; MPN CFS20632768DZFB

Connections:
3V3_Sensor: C33.1, D6.A, R25.1, R26.1, U14.1 (VCC)
GND: C32.2, C33.2, C49.2, U9.4 (VSS), U14.2 (GND)
unnamed: C32.1, U9.2 (OSCO), Y2.1
unnamed: C49.1, R43.2, U9.8 (VDD)
unnamed: D6.C, R43.1
unnamed: U9.1 (OSCI), Y2.2
SCL_PCF: R26.2, U9.6 (SCL)
SCL_RP2040: U14.3 (SCL)
SDA_PCF: R25.2, U9.5 (SDA)
SDA_RP2040: U14.4 (SDA)
