ihsanakyrk/Eski-Versionlar-Ve-Siparisler/Cam Tracker_3566/CamTracker_3566_V1.0-2024-01-22_131521/INMP441.kicad_sch

## KiCad design Cam Tracker_3566/CamTracker_3566_V1.0-2024-01-22_131521/INMP441.kicad_sch (2025-09-01)

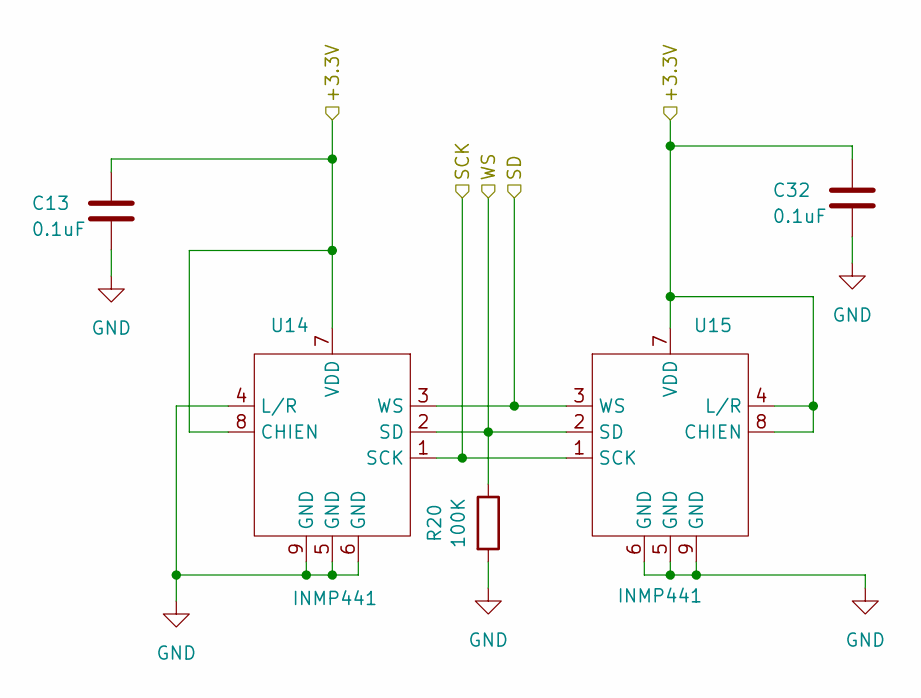
[picture p215: schematic INMP441.kicad_sch]

Parts:
C13, C32: 0.1uF; C_0603_1608Metric
R20: 100K; R_0603_1608Metric
U14, U15: INMP441

Connections:
+3.3V: C13.1, C32.1, U14.7 (VDD), U14.8 (CHIEN), U15.4 (L/R), U15.7 (VDD), U15.8 (CHIEN)
GND: C13.2, C32.2, R20.2, U14.4 (L/R), U14.5 (GND), U14.6 (GND), U14.9 (GND), U15.5 (GND), U15.6 (GND), U15.9 (GND)
SCK: U14.1 (SCK), U15.1 (SCK)
SD: U14.3 (WS), U15.3 (WS)
WS: R20.1, U14.2 (SD), U15.2 (SD)
