ihsanakyrk/Eski-Versionlar-Ve-Siparisler/Cam Tracker_3566/CamTracker_3566_V1.0-2024-01-22_131521/PCIE.kicad_sch

## KiCad design Cam Tracker_3566/CamTracker_3566_V1.0-2024-01-22_131521/PCIE.kicad_sch (2025-09-01)

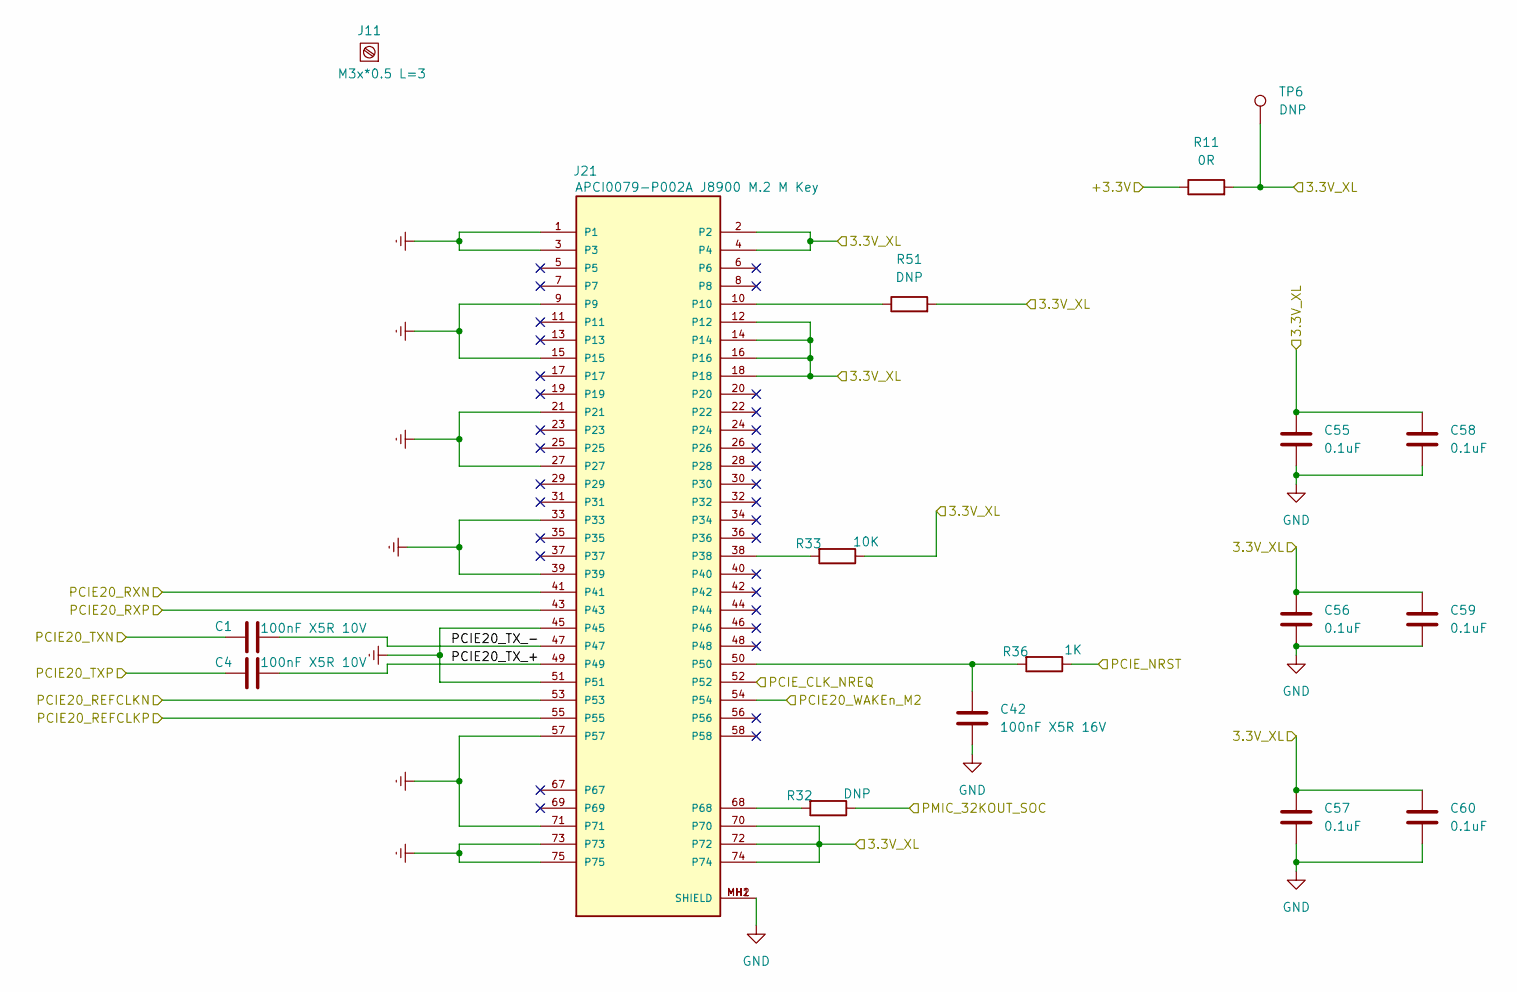
[picture p216: schematic PCIE.kicad_sch]

Parts:
C1, C4: 100nF X5R 10V; C_0402_1005Metric
C42: 100nF X5R 16V; C_0402_1005Metric
C55, C56, C57, C58, C59, C60: 0.1uF; C_0603_1608Metric
J11: M3x*0.5 L=3; Screw_terminal_shinbo; MPN SMTSO3030CTJ
J21: APCI0079-P002A J8900 M.2 M Key; 121992306; MPN APCI0079-P002A
R11: 0R; R_0603_1608Metric
R32, R51: DNP; R_0603_1608Metric
R33: 10K; R_0402_1005Metric
R36: 1K; R_0402_1005Metric
TP6: DNP; TestPoint_Pad_D1.0mm

Connections:
3.3V_XL: C55.1, C56.1, C57.1, C58.1, C59.1, C60.1, J21.2, J21.4, J21.12, J21.14, J21.16, J21.18, J21.70, J21.72, J21.74, R11.2, R33.1, R51.2, TP6.1
+3.3V: R11.1
Earth: J21.1, J21.3, J21.9, J21.15, J21.21, J21.27, J21.33, J21.39, J21.45, J21.51, J21.57, J21.71, J21.73, J21.75
GND: C42.2, C55.2, C56.2, C57.2, C58.2, C59.2, C60.2, J21.MH1 (SHIELD), J21.MH2 (SHIELD)
unnamed: C42.1, J21.50, R36.2
unnamed: J21.10, R51.1
unnamed: J21.38, R33.2
unnamed: J21.68, R32.2
PCIE20_REFCLKN: J21.53
PCIE20_REFCLKP: J21.55
PCIE20_RXN: J21.41
PCIE20_RXP: J21.43
PCIE20_TXN: C1.1
PCIE20_TXP: C4.1
PCIE20_TX_+: C4.2, J21.49
PCIE20_TX_-: C1.2, J21.47
PCIE20_WAKEn_M2: J21.54
PCIE_CLK_NREQ: J21.52
PCIE_NRST: R36.1
PMIC_32KOUT_SOC: R32.1
