ihsanakyrk/Eski-Versionlar-Ve-Siparisler/Cam Tracker_3566/CamTracker_3566_V1.0-2024-01-22_131521/Power_Unit.kicad_sch

## KiCad design Cam Tracker_3566/CamTracker_3566_V1.0-2024-01-22_131521/Power_Unit.kicad_sch (2025-09-01)

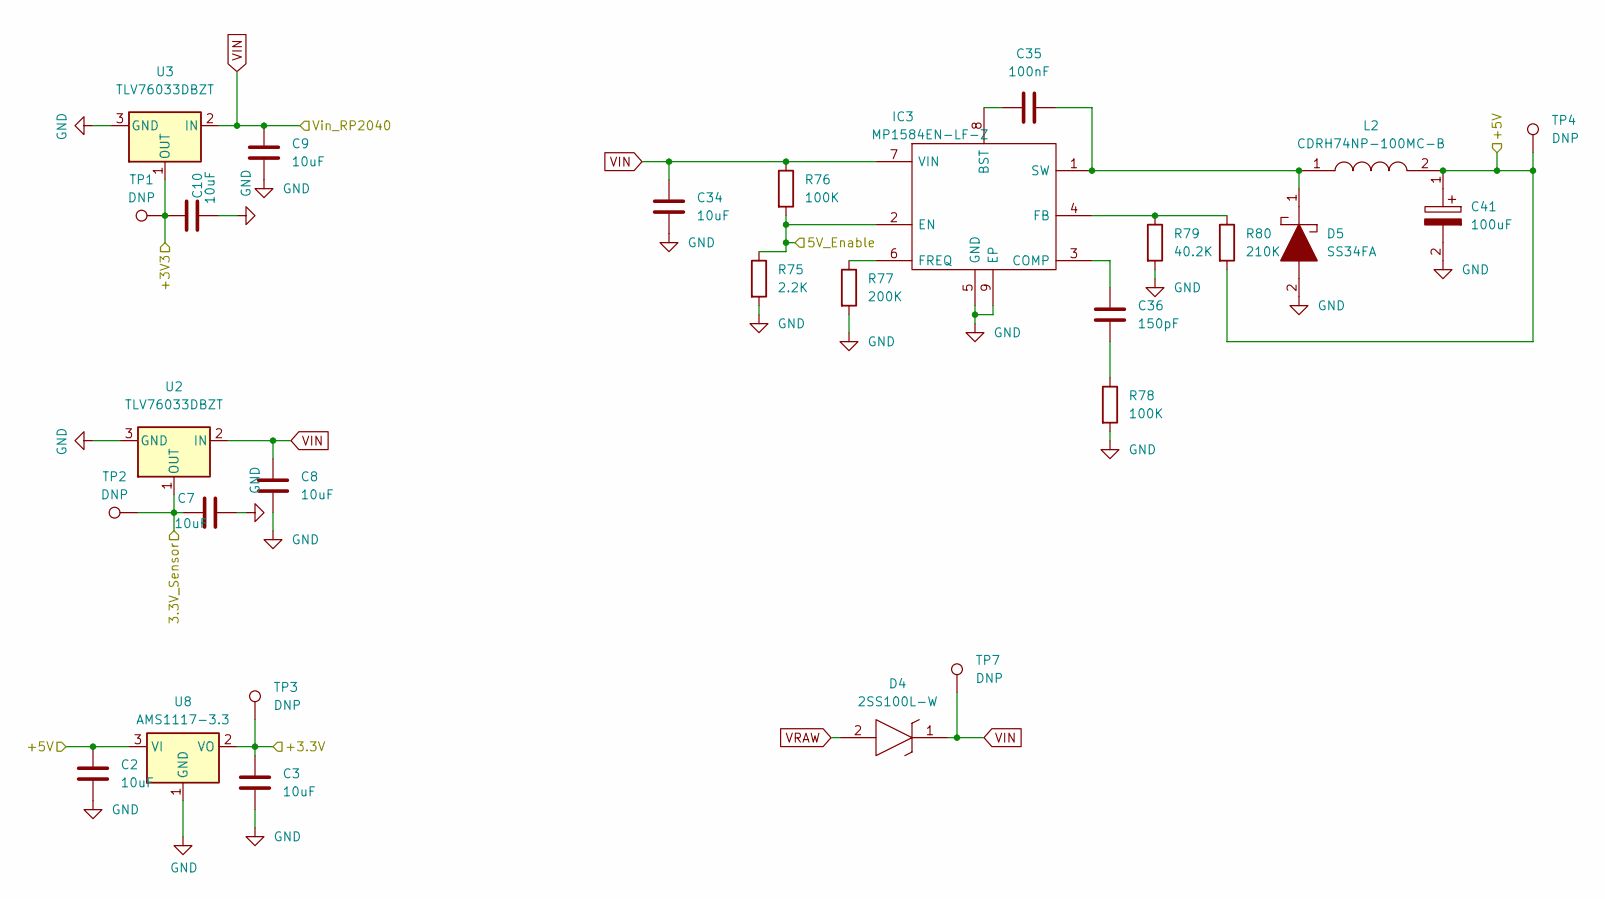
[picture p217: schematic Power_Unit.kicad_sch]

Parts:
C2, C3, C7, C8, C9, C10, C34: 10uF; C_0603_1608Metric
C35: 100nF; C_0603_1608Metric
C36: 150pF; C_0603_1608Metric
C41: 100uF; RST100UF10V002
D4: 2SS100L-W; 2SS100LW; Manufacturer_Part_Number 2SS100L-W; Mouser Part Number 583-2SS100L-W
D5: SS34FA; SODFL3618X143N; Manufacturer_Part_Number SS34FA; Mouser Part Number 512-SS34FA
IC3: MP1584EN-LF-Z; SOIC127P600X170-9N; MPN MP1584EN-LF-Z
L2: CDRH74NP-100MC-B; CDRH74NP100MCB; Manufacturer_Part_Number CDRH74NP-100MC-B; Mouser Part Number 851-CDRH74NP-100MC
R75: 2.2K; R_0603_1608Metric
R76, R78: 100K; R_0603_1608Metric
R77: 200K; R_0603_1608Metric
R79: 40.2K; R_0603_1608Metric
R80: 210K; R_0603_1608Metric
TP1, TP2, TP3, TP4, TP7: DNP; TestPoint_Pad_D1.0mm
U2, U3: TLV76033DBZT; SOT-23; MPN TLV76033DBZT
U8: AMS1117-3.3; SOT-223-3_TabPin2; MPN AMS1117-3.3

Connections:
3.3V_Sensor: C7.2, TP2.1, U2.1 (OUT)
5V_Enable: IC3.2 (EN), R75.1, R76.2
+3.3V: C3.2, TP3.1, U8.2 (VO)
+3V3: C10.2, TP1.1, U3.1 (OUT)
+5V: C2.2, C41.1, L2.2, R80.2, TP4.1, U8.3 (VI)
GND: C2.1, C3.1, C7.1, C8.1, C9.1, C10.1, C34.1, C41.2, D5.2, IC3.5 (GND), IC3.9 (EP), R75.2, R77.2, R78.2, R79.2, U2.3 (GND), U3.3 (GND), U8.1 (GND)
unnamed: C35.1, D5.1, IC3.1 (SW), L2.1
unnamed: C35.2, IC3.8 (BST)
unnamed: C36.1, R78.1
unnamed: C36.2, IC3.3 (COMP)
unnamed: IC3.4 (FB), R79.1, R80.1
unnamed: IC3.6 (FREQ), R77.1
VIN: C8.2, C9.2, C34.2, D4.1, IC3.7 (VIN), R76.1, TP7.1, U2.2 (IN), U3.2 (IN)
VRAW: D4.2
