ihsanakyrk/Eski-Versionlar-Ve-Siparisler/Cam Tracker_3566/CamTracker_3566_V1.0-2024-01-22_131521/RP2040.kicad_sch

## KiCad design Cam Tracker_3566/CamTracker_3566_V1.0-2024-01-22_131521/RP2040.kicad_sch (2025-09-01)

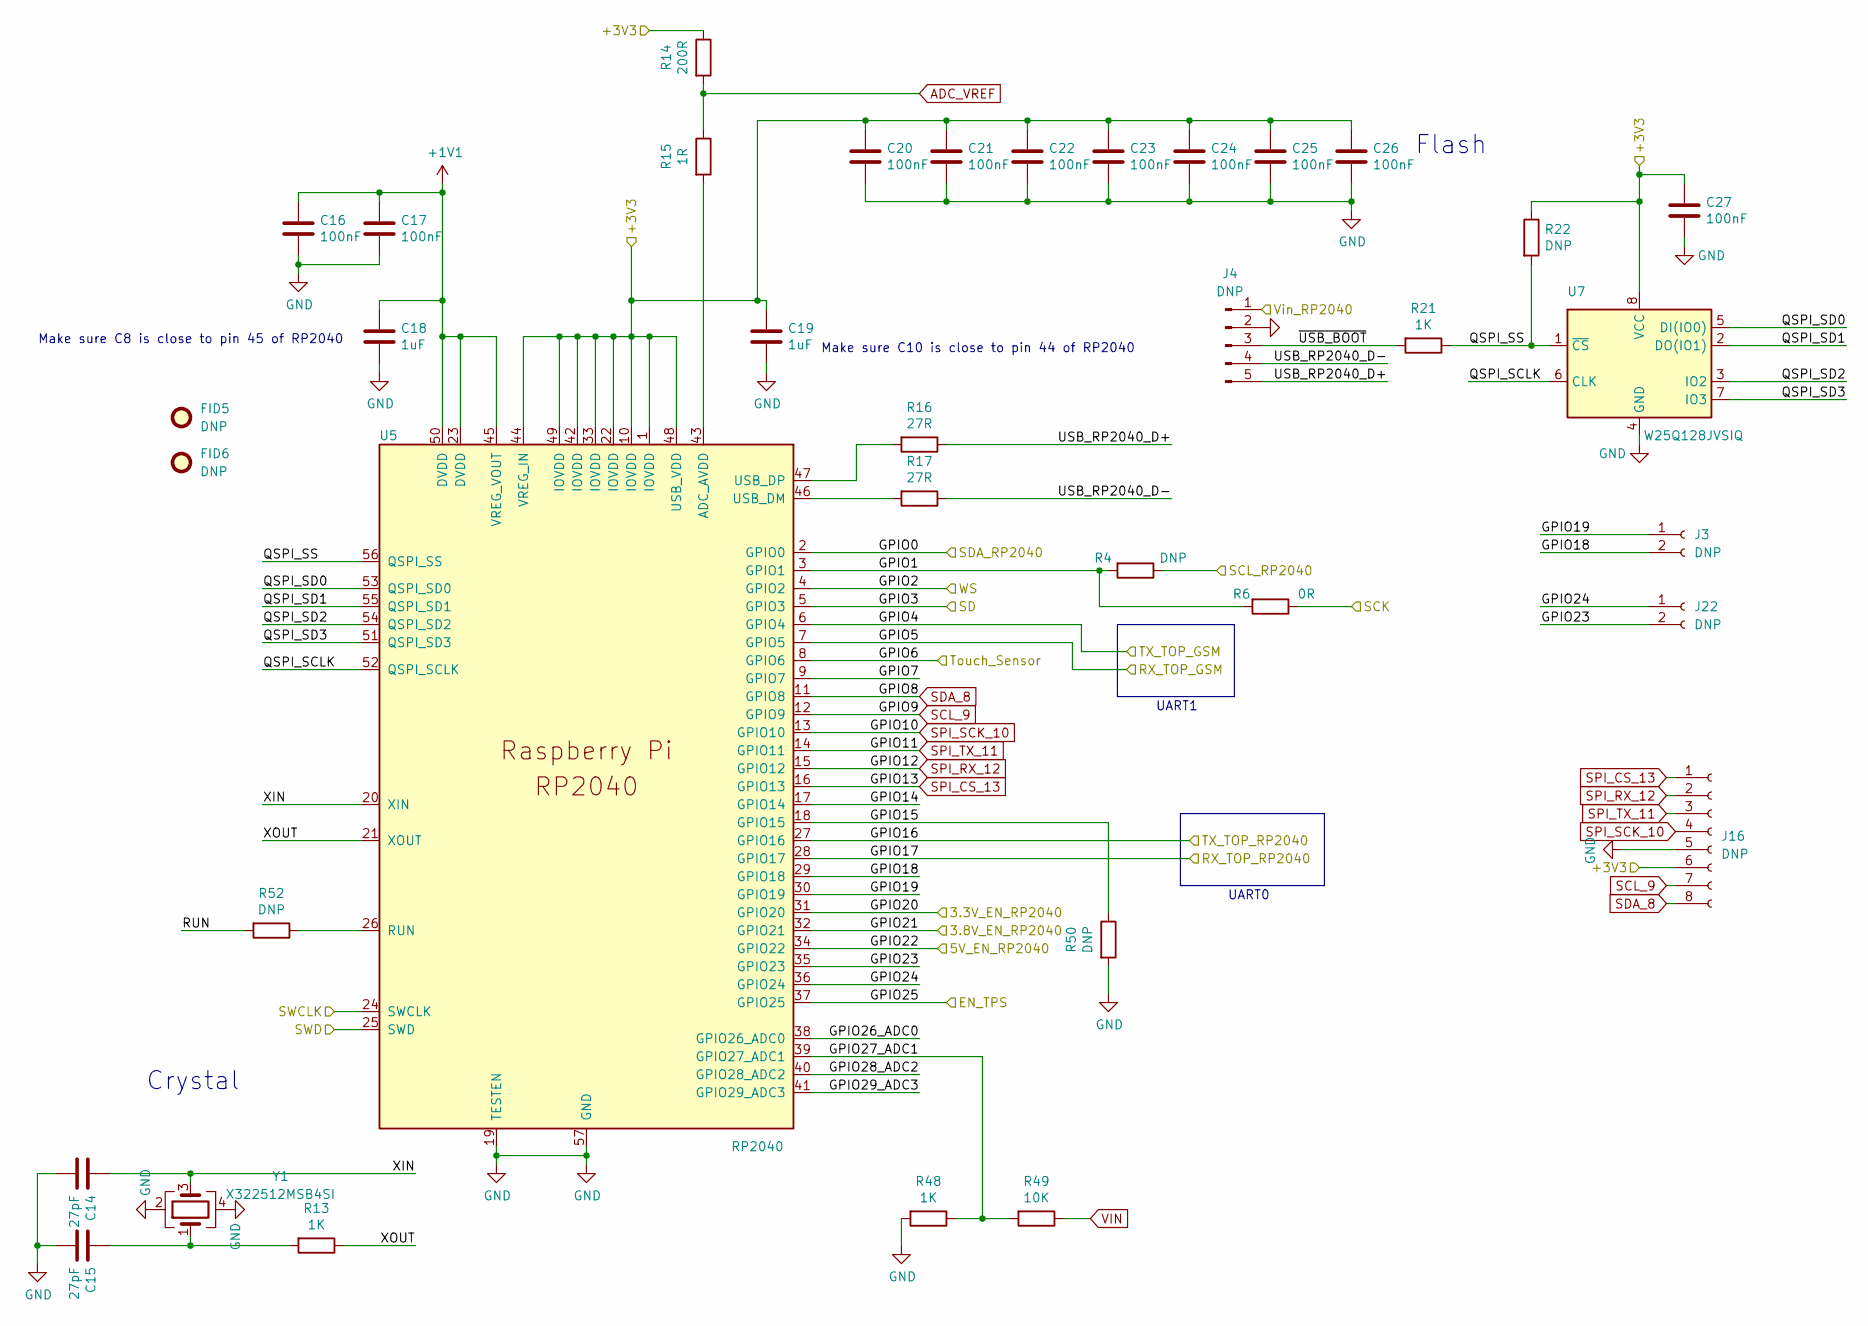
[picture p218: schematic RP2040.kicad_sch]

Parts:
C14, C15: 27pF; C_0402_1005Metric
C16, C17, C20, C21, C22, C23, C24, C25, C26, C27: 100nF; C_0402_1005Metric
C18, C19: 1uF; C_0402_1005Metric
FID5, FID6: DNP; Fiducial_0.5mm_Mask1mm; MPN Fiducial Marker
J3, J22: DNP; PinHeader_1x02_P2.00mm_Vertical; MPN 2.0mm 1*2p
J4: DNP; PinSocket_1x05_P2.00mm_Vertical; MPN 2.0mm 1*5p
J16: DNP; PinHeader_1x08_P2.54mm_Vertical; MPN 2.54mm 1*8p
R4, R22, R50, R52: DNP; R_0603_1608Metric
R6: 0R; R_0603_1608Metric
R13, R21, R48: 1K; R_0603_1608Metric
R14: 200R; R_0603_1608Metric
R15: 1R; R_0603_1608Metric
R16, R17: 27R; R_0603_1608Metric
R49: 10K; R_0603_1608Metric
U5: RP2040; RP2040-QFN-56; MPN RP2040
U7: W25Q128JVSIQ; SOIC-8_5.23x5.23mm_P1.27mm; MPN W25Q128JVSIQ
Y1: X322512MSB4SI; Crystal_SMD_3225-4Pin_3.2x2.5mm; MPN X322512MSB4SI

Connections:
3.3V_EN_RP2040: U5.31 (GPIO20)
3.8V_EN_RP2040: U5.32 (GPIO21)
5V_EN_RP2040: U5.34 (GPIO22)
+1V1: C16.1, C17.1, C18.1, U5.23 (DVDD), U5.45 (VREG_VOUT), U5.50 (DVDD)
+3V3: C19.1, C20.1, C21.1, C22.1, C23.1, C24.1, C25.1, C26.1, C27.1, J16.6, R14.1, R22.1, U5.1 (IOVDD), U5.10 (IOVDD), U5.22 (IOVDD), U5.33 (IOVDD), U5.42 (IOVDD), U5.44 (VREG_IN), U5.48 (USB_VDD), U5.49 (IOVDD), U7.8 (VCC)
ADC_VREF: R14.2, R15.1
EN_TPS: U5.37 (GPIO25)
GND: C14.2, C15.2, C16.2, C17.2, C18.2, C19.2, C20.2, C21.2, C22.2, C23.2, C24.2, C25.2, C26.2, C27.2, J4.2, J16.5, R48.2, R50.2, U5.19 (TESTEN), U5.57 (GND), U7.4 (GND), Y1.2, Y1.4
GPIO0: U5.2 (GPIO0)
GPIO1: R4.2, R6.2, U5.3 (GPIO1)
GPIO2: U5.4 (GPIO2)
GPIO3: U5.5 (GPIO3)
GPIO4: U5.6 (GPIO4)
GPIO5: U5.7 (GPIO5)
GPIO6: U5.8 (GPIO6)
GPIO7: U5.9 (GPIO7)
GPIO14: U5.17 (GPIO14)
GPIO15: R50.1, U5.18 (GPIO15)
GPIO16: U5.27 (GPIO16)
GPIO17: U5.28 (GPIO17)
GPIO18: J3.2, U5.29 (GPIO18)
GPIO19: J3.1, U5.30 (GPIO19)
GPIO23: J22.2, U5.35 (GPIO23)
GPIO24: J22.1, U5.36 (GPIO24)
GPIO26_ADC0: U5.38 (GPIO26_ADC0)
GPIO27_ADC1: R48.1, R49.2, U5.39 (GPIO27_ADC1)
GPIO28_ADC2: U5.40 (GPIO28_ADC2)
GPIO29_ADC3: U5.41 (GPIO29_ADC3)
unnamed: C15.1, R13.2, Y1.1
unnamed: R15.2, U5.43 (ADC_AVDD)
unnamed: R16.2, U5.47 (USB_DP)
unnamed: R17.2, U5.46 (USB_DM)
unnamed: R52.1, U5.26 (RUN)
QSPI_SCLK: U5.52 (QSPI_SCLK), U7.6 (CLK)
QSPI_SD0: U5.53 (QSPI_SD0), U7.5 (DI(IO0))
QSPI_SD1: U5.55 (QSPI_SD1), U7.2 (DO(IO1))
QSPI_SD2: U5.54 (QSPI_SD2), U7.3 (IO2)
QSPI_SD3: U5.51 (QSPI_SD3), U7.7 (IO3)
QSPI_SS: R21.1, R22.2, U5.56 (QSPI_SS), U7.1 (~CS)
RUN: R52.2
SCK: R6.1
SCL_9: J16.7, U5.12 (GPIO9)
SCL_RP2040: R4.1
SDA_8: J16.8, U5.11 (GPIO8)
SPI_CS_13: J16.1, U5.16 (GPIO13)
SPI_RX_12: J16.2, U5.15 (GPIO12)
SPI_SCK_10: J16.4, U5.13 (GPIO10)
SPI_TX_11: J16.3, U5.14 (GPIO11)
SWCLK: U5.24 (SWCLK)
SWD: U5.25 (SWD)
USB_RP2040_D+: J4.5, R16.1
USB_RP2040_D-: J4.4, R17.1
VIN: R49.1
Vin_RP2040: J4.1
XIN: C14.1, U5.20 (XIN), Y1.3
XOUT: R13.1, U5.21 (XOUT)
~USB_BOOT: J4.3, R21.2

Notes on the sheet:
Make sure C8 is close to pin 45 of RP2040
UART1
Make sure C10 is close to pin 44 of RP2040
UART0
Flash
Crystal
