ihsanakyrk/Eski-Versionlar-Ve-Siparisler/Cam Tracker_3566/CamTracker_3566_V1.0-2024-01-22_131521/TopBoard.kicad_sch

## KiCad design Cam Tracker_3566/CamTracker_3566_V1.0-2024-01-22_131521/TopBoard.kicad_sch (2025-09-01)

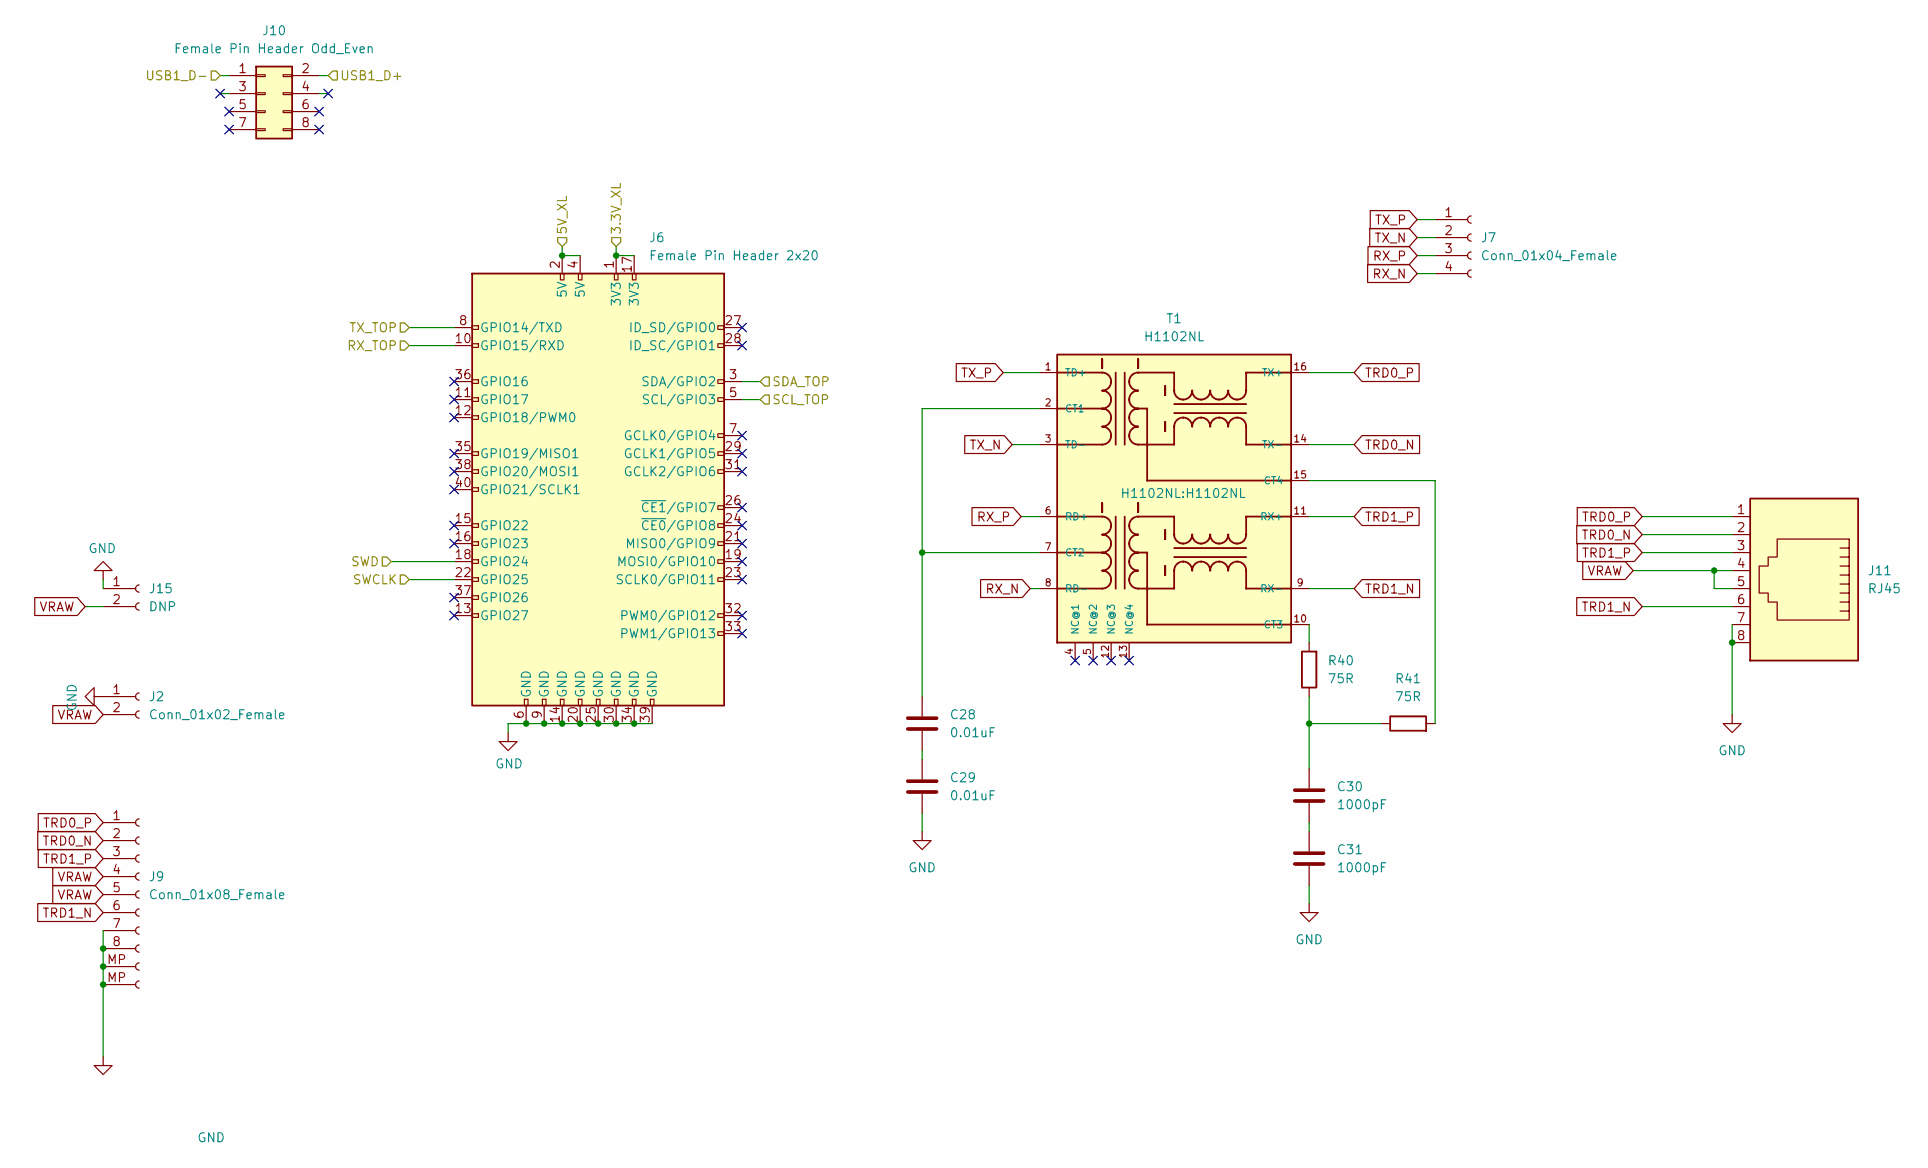
[picture p219: schematic TopBoard.kicad_sch]

Parts:
C28, C29: 0.01uF; C_0603_1608Metric
C30, C31: 1000pF; C_0603_1608Metric
J2: Conn_01x02_Female; JST_PH_B2B-PH-K_1x02_P2.00mm_Vertical
J6: Female Pin Header 2x20; PinHeader_2x20_P2.54mm_Vertical
J7: Conn_01x04_Female; PinHeader_2x02_P2.54mm_Vertical
J9: Conn_01x08_Female; JST_SH_BM08B-SRSS-TB_1x08-1MP_P1.00mm_Vertical
J10: Female Pin Header Odd_Even; PinHeader_2x04_P2.54mm_Vertical_SMD
J11: RJ45; RJ45_Amphenol_54602-x08_Horizontal_etrafitemiz
J15: DNP; PhoenixContact_MSTBA_2,5_2-G-5,08_1x02_P5.08mm_Horizontal
R40, R41: 75R; R_0603_1608Metric
T1: H1102NL

Connections:
3.3V_XL: J6.1 (3V3), J6.17 (3V3)
5V_XL: J6.2 (5V), J6.4 (5V)
GND: C29.2, C31.2, J2.1, J6.6 (GND), J6.9 (GND), J6.14 (GND), J6.20 (GND), J6.25 (GND), J6.30 (GND), J6.34 (GND), J6.39 (GND), J9.7, J9.8, J9.MP, J11.7, J11.8, J15.1
unnamed: C28.1, T1.2 (CT1), T1.7 (CT2)
unnamed: C28.2, C29.1
unnamed: C30.1, R40.1, R41.1
unnamed: C30.2, C31.1
unnamed: R40.2, T1.10 (CT3)
unnamed: R41.2, T1.15 (CT4)
RX_N: J7.4, T1.8 (RD-)
RX_P: J7.3, T1.6 (RD+)
RX_TOP: J6.10 (GPIO15/RXD)
SCL_TOP: J6.5 (SCL/GPIO3)
SDA_TOP: J6.3 (SDA/GPIO2)
SWCLK: J6.22 (GPIO25)
SWD: J6.18 (GPIO24)
TRD0_N: J9.2, J11.2, T1.14 (TX-)
TRD0_P: J9.1, J11.1, T1.16 (TX+)
TRD1_N: J9.6, J11.6, T1.9 (RX-)
TRD1_P: J9.3, J11.3, T1.11 (RX+)
TX_N: J7.2, T1.3 (TD-)
TX_P: J7.1, T1.1 (TD+)
TX_TOP: J6.8 (GPIO14/TXD)
USB1_D+: J10.2
USB1_D-: J10.1
VRAW: J2.2, J9.4, J9.5, J11.4, J11.5, J15.2
