ihsanakyrk/Eski-Versionlar-Ve-Siparisler/Cam Tracker_3566/CamTracker_3566_V1.0-2024-01-22_131521/TopBoard_Connection.kicad_sch

## KiCad design Cam Tracker_3566/CamTracker_3566_V1.0-2024-01-22_131521/TopBoard_Connection.kicad_sch (2025-09-01)

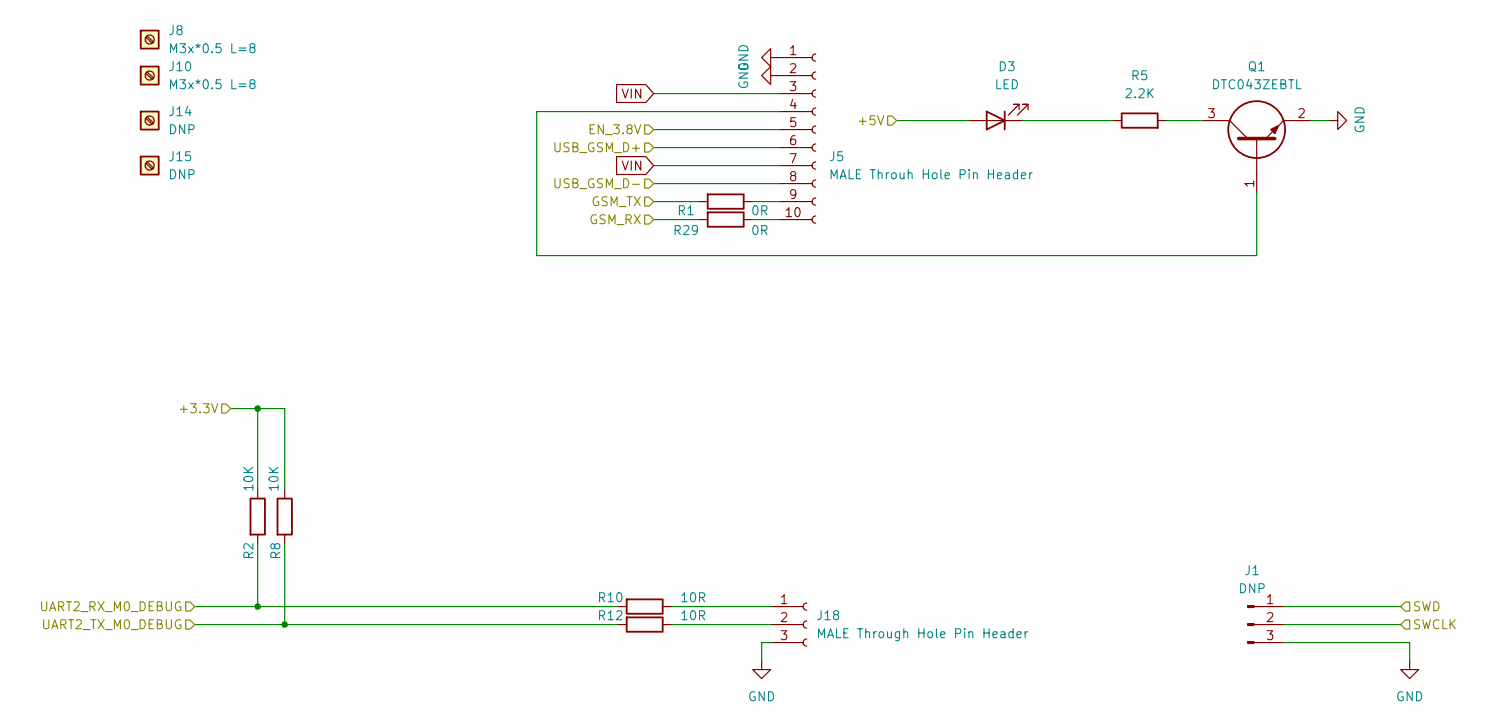
[picture p220: schematic TopBoard_Connection.kicad_sch]

Parts:
D3: LED; LEDC2012X80N
J1: DNP; PinHeader_1x03_P2.00mm_Vertical; MPN 2.0mm 1*3p
J5: MALE Throuh Hole Pin Header; PinSocket_2x05_P2.00mm_Vertical; MPN 2.0mm 2*5p
J8, J10: M3x*0.5 L=8; Screw_terminal_shinbo; MPN SMTSO3080CTJ
J14, J15: DNP; Screw_terminal_shinbo 3.5
J18: MALE Through Hole Pin Header; PinHeader_1x03_P2.00mm_Vertical; MPN 2.0mm 1*3p
Q1: DTC043ZEBTL; SOTFL50P160X85-3N; Manufacturer_Part_Number DTC043ZEBTL; Mouser Part Number 755-DTC043ZEBTL
R1, R29: 0R; R_0603_1608Metric
R2, R8: 10K; R_0402_1005Metric
R5: 2.2K; R_0603_1608Metric
R10, R12: 10R; R_0402_1005Metric

Connections:
+3.3V: R2.1, R8.1
+5V: D3.2 (A)
EN_3.8V: J5.5
GND: J1.3, J5.1, J5.2, J18.3, Q1.2
GSM_RX: R29.2
GSM_TX: R1.2
unnamed: D3.1 (K), R5.1
unnamed: J5.4, Q1.1
unnamed: J5.9, R1.1
unnamed: J5.10, R29.1
unnamed: J18.1, R10.1
unnamed: J18.2, R12.1
unnamed: Q1.3, R5.2
SWCLK: J1.2
SWD: J1.1
UART2_RX_M0_DEBUG: R2.2, R10.2
UART2_TX_M0_DEBUG: R8.2, R12.2
USB_GSM_D+: J5.6
USB_GSM_D-: J5.8
VIN: J5.3, J5.7
