ihsanakyrk/Eski-Versionlar-Ve-Siparisler/Cam Tracker_3566/CamTracker_3566_V1.0-2024-01-22_131521/Touch Sensor.kicad_sch

## KiCad design Cam Tracker_3566/CamTracker_3566_V1.0-2024-01-22_131521/Touch Sensor.kicad_sch (2025-09-01)

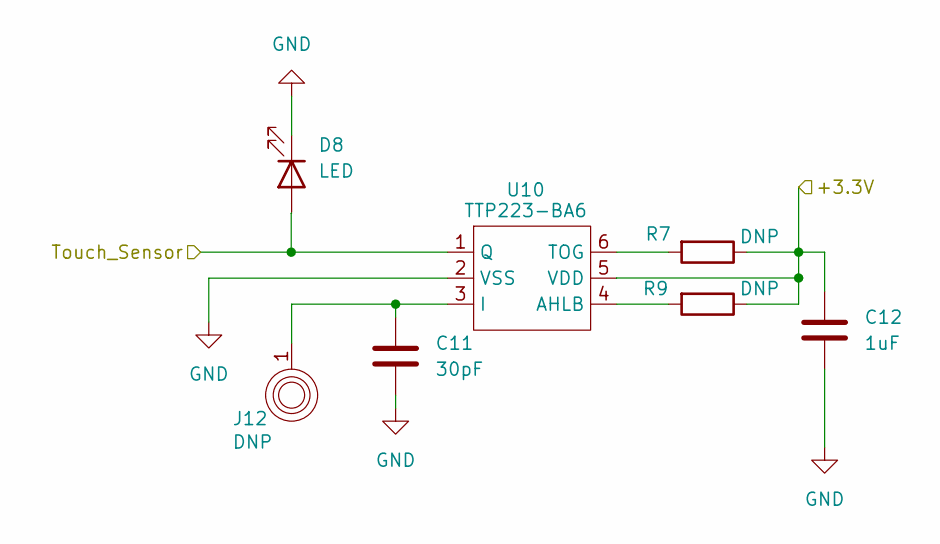
[picture p221: schematic Touch Sensor.kicad_sch]

Parts:
C11: 30pF; C_0603_1608Metric
C12: 1uF; C_0603_1608Metric
D8: LED; LED_0603_1608Metric; MPN NCD0603R1
J12: DNP; Touch Pad
R7, R9: DNP; R_0603_1608Metric
U10: TTP223-BA6; TTP223; MPN TTP223-BA6

Connections:
+3.3V: C12.1, R7.1, R9.1, U10.5 (VDD)
GND: C11.2, C12.2, D8.1 (K), U10.2 (VSS)
unnamed: C11.1, J12.1, U10.3 (I)
unnamed: R7.2, U10.6 (TOG)
unnamed: R9.2, U10.4 (AHLB)
Touch_Sensor: D8.2 (A), U10.1 (Q)
