ihsanakyrk/Eski-Versionlar-Ve-Siparisler/Cam Tracker_3566/CamTracker_3566_V1.0-2024-01-22_131521/USB.kicad_sch

## KiCad design Cam Tracker_3566/CamTracker_3566_V1.0-2024-01-22_131521/USB.kicad_sch (2025-09-01)

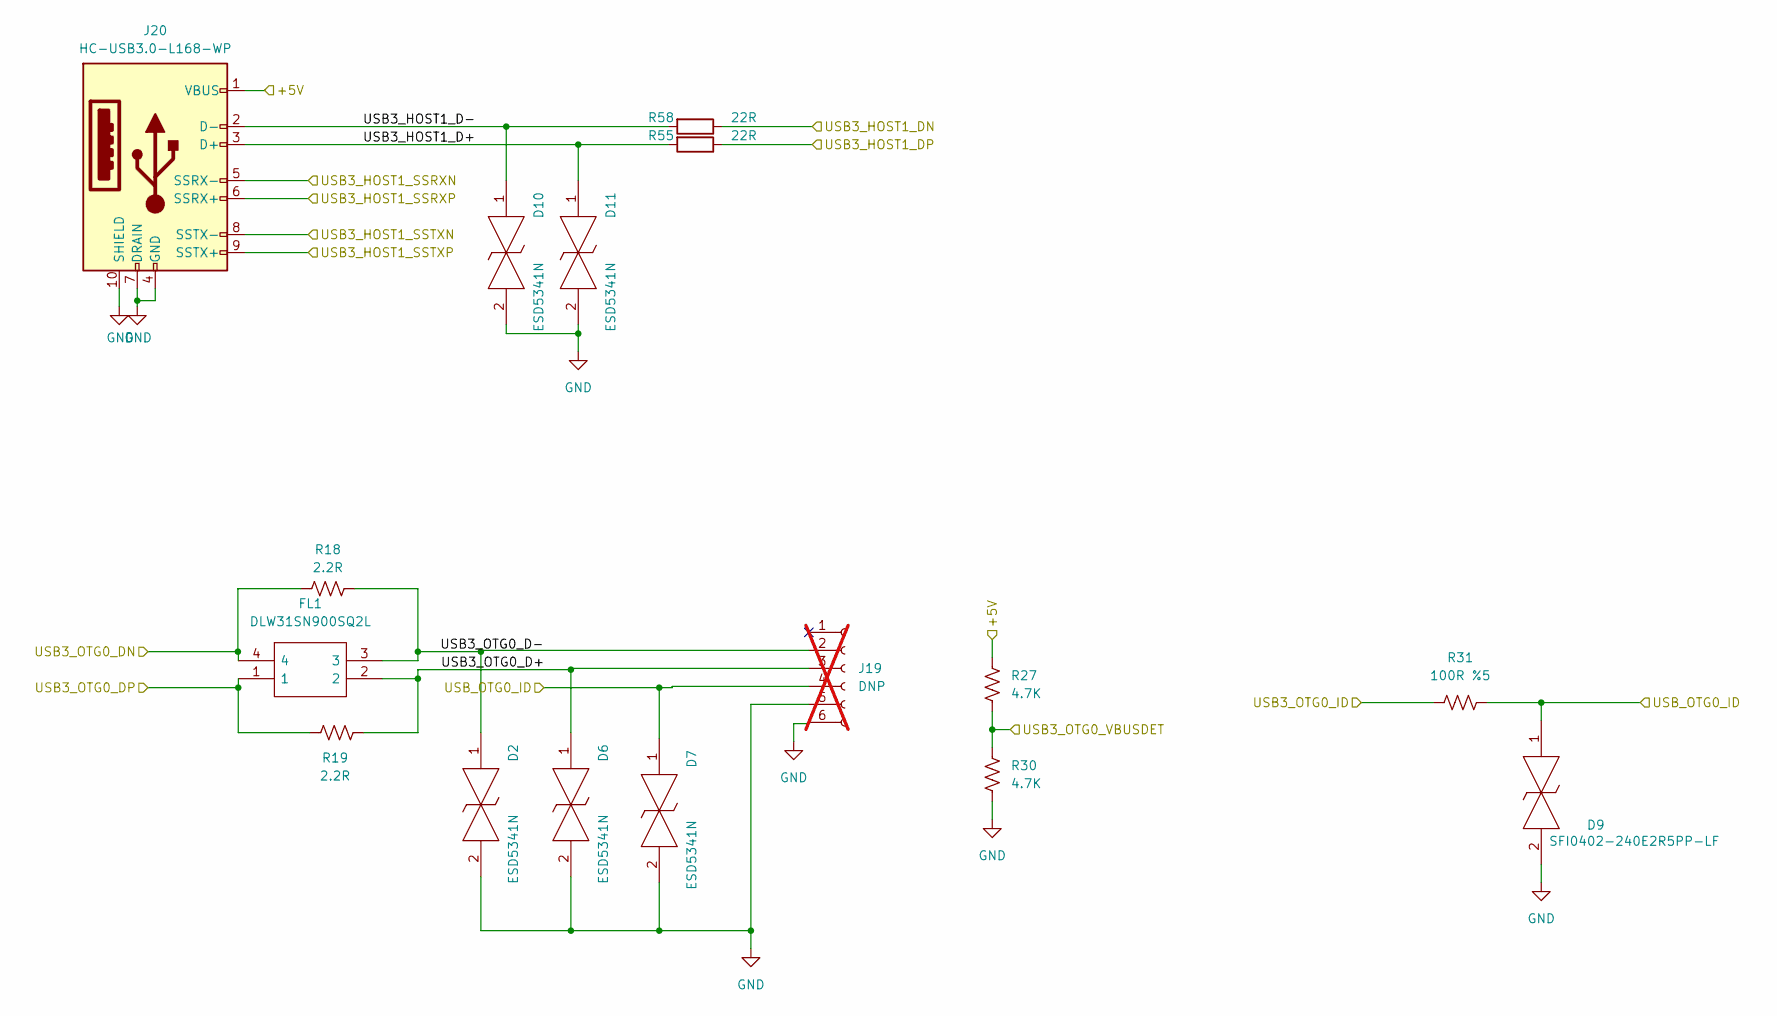
[picture p222: schematic USB.kicad_sch]

Parts:
D2, D6, D7, D10, D11: ESD5341N; MPN ESD5341N
D9: SFI0402-240E2R5PP-LF; D_0402_1005Metric; MPN SFI0402-240E2R5PP-LF
FL1: DLW31SN900SQ2L; MPN DLW31SN900SQ2L
J19: DNP; PinHeader_1x06_P2.00mm_Vertical; MPN 2.0mm 1*6p; not fitted
J20: HC-USB3.0-L168-WP; MPN HC-USB3.0-L168-WP
R18, R19: 2.2R; R_0402_1005Metric
R27, R30: 4.7K; R_0603_1608Metric
R31: 100R %5; R_0402_1005Metric
R55, R58: 22R; R_0402_1005Metric

Connections:
+5V: J20.1 (VBUS), R27.1
GND: D2.2, D6.2, D7.2, D9.2, D10.2, D11.2, J19.5, J19.6, J20.4 (GND), J20.7 (DRAIN), J20.10 (SHIELD), R30.2
USB3_HOST1_D+: D11.1, J20.3 (D+), R55.2
USB3_HOST1_D-: D10.1, J20.2 (D-), R58.2
USB3_HOST1_DN: R58.1
USB3_HOST1_DP: R55.1
USB3_HOST1_SSRXN: J20.5 (SSRX-)
USB3_HOST1_SSRXP: J20.6 (SSRX+)
USB3_HOST1_SSTXN: J20.8 (SSTX-)
USB3_HOST1_SSTXP: J20.9 (SSTX+)
USB3_OTG0_D+: D6.1, FL1.2, J19.3, R19.2
USB3_OTG0_D-: D2.1, FL1.3, J19.2, R18.2
USB3_OTG0_DN: FL1.4, R18.1
USB3_OTG0_DP: FL1.1, R19.1
USB3_OTG0_ID: R31.1
USB3_OTG0_VBUSDET: R27.2, R30.1
USB_OTG0_ID: D7.1, D9.1, J19.4, R31.2
