ihsanakyrk/Eski-Versionlar-Ve-Siparisler/Cam Tracker_3566/CamTracker_3566_V1.0-2024-01-22_131521/ethernet pin.kicad_sch

## KiCad design Cam Tracker_3566/CamTracker_3566_V1.0-2024-01-22_131521/ethernet pin.kicad_sch (2025-09-01)

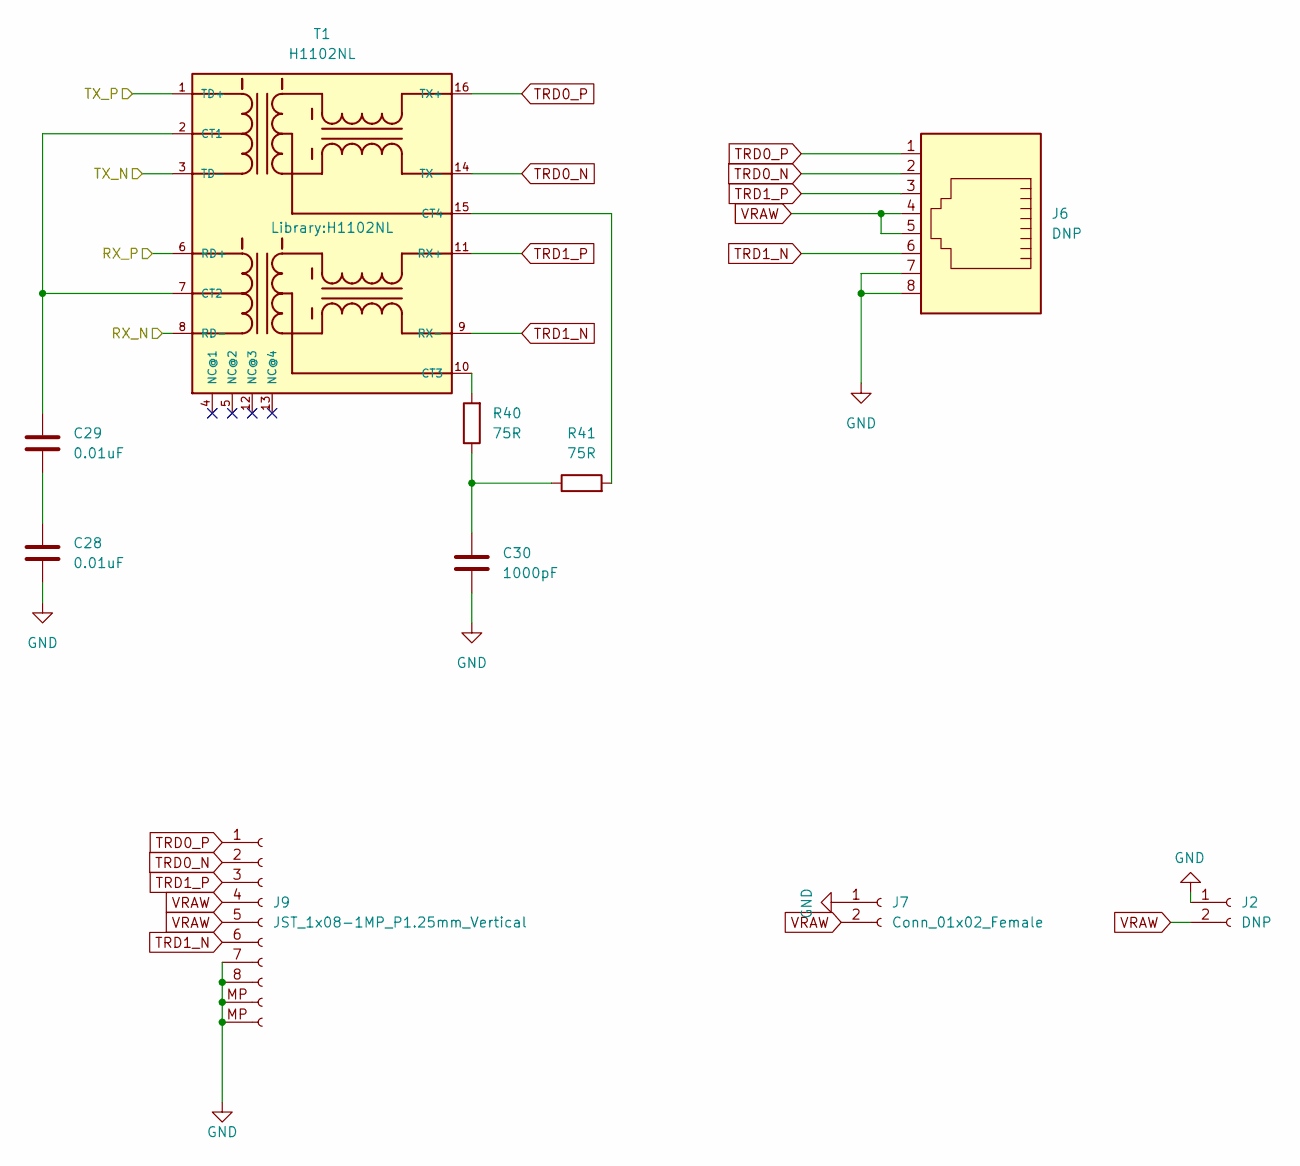
[picture p223: schematic ethernet pin.kicad_sch]

Parts:
C28, C29: 0.01uF; C_0603_1608Metric
C30: 1000pF; C_0603_1608Metric
J2: DNP; PhoenixContact_MSTBA_2,5_2-G-5,08_1x02_P5.08mm_Horizontal; MPN 5.08mm 1*2p
J6: DNP; RJ45_Amphenol_54602-x08_Horizontal; MPN RJ45
J7: Conn_01x02_Female; JST_PH_B2B-PH-K_1x02_P2.00mm_Vertical; MPN 2.0mm 1*2p
J9: JST_1x08-1MP_P1.25mm_Vertical; MPN 间距:1.25mm 1x8P
R40, R41: 75R; R_0603_1608Metric
T1: H1102NL; MPN H1102NL

Connections:
GND: C28.2, C30.2, J2.1, J6.7, J6.8, J7.1, J9.7, J9.8, J9.MP
unnamed: C28.1, C29.2
unnamed: C29.1, T1.2 (CT1), T1.7 (CT2)
unnamed: C30.1, R40.1, R41.1
unnamed: R40.2, T1.10 (CT3)
unnamed: R41.2, T1.15 (CT4)
RX_N: T1.8 (RD-)
RX_P: T1.6 (RD+)
TRD0_N: J6.2, J9.2, T1.14 (TX-)
TRD0_P: J6.1, J9.1, T1.16 (TX+)
TRD1_N: J6.6, J9.6, T1.9 (RX-)
TRD1_P: J6.3, J9.3, T1.11 (RX+)
TX_N: T1.3 (TD-)
TX_P: T1.1 (TD+)
VRAW: J2.2, J6.4, J6.5, J7.2, J9.4, J9.5
