ihsanakyrk/Eski-Versionlar-Ve-Siparisler/Movita_3568_AXV_Router_V3.0/MXVR_3.0/4_port_rj45.kicad_sch

## KiCad design Movita_3568_AXV_Router_V3.0/MXVR_3.0/4_port_rj45.kicad_sch (2025-09-01)

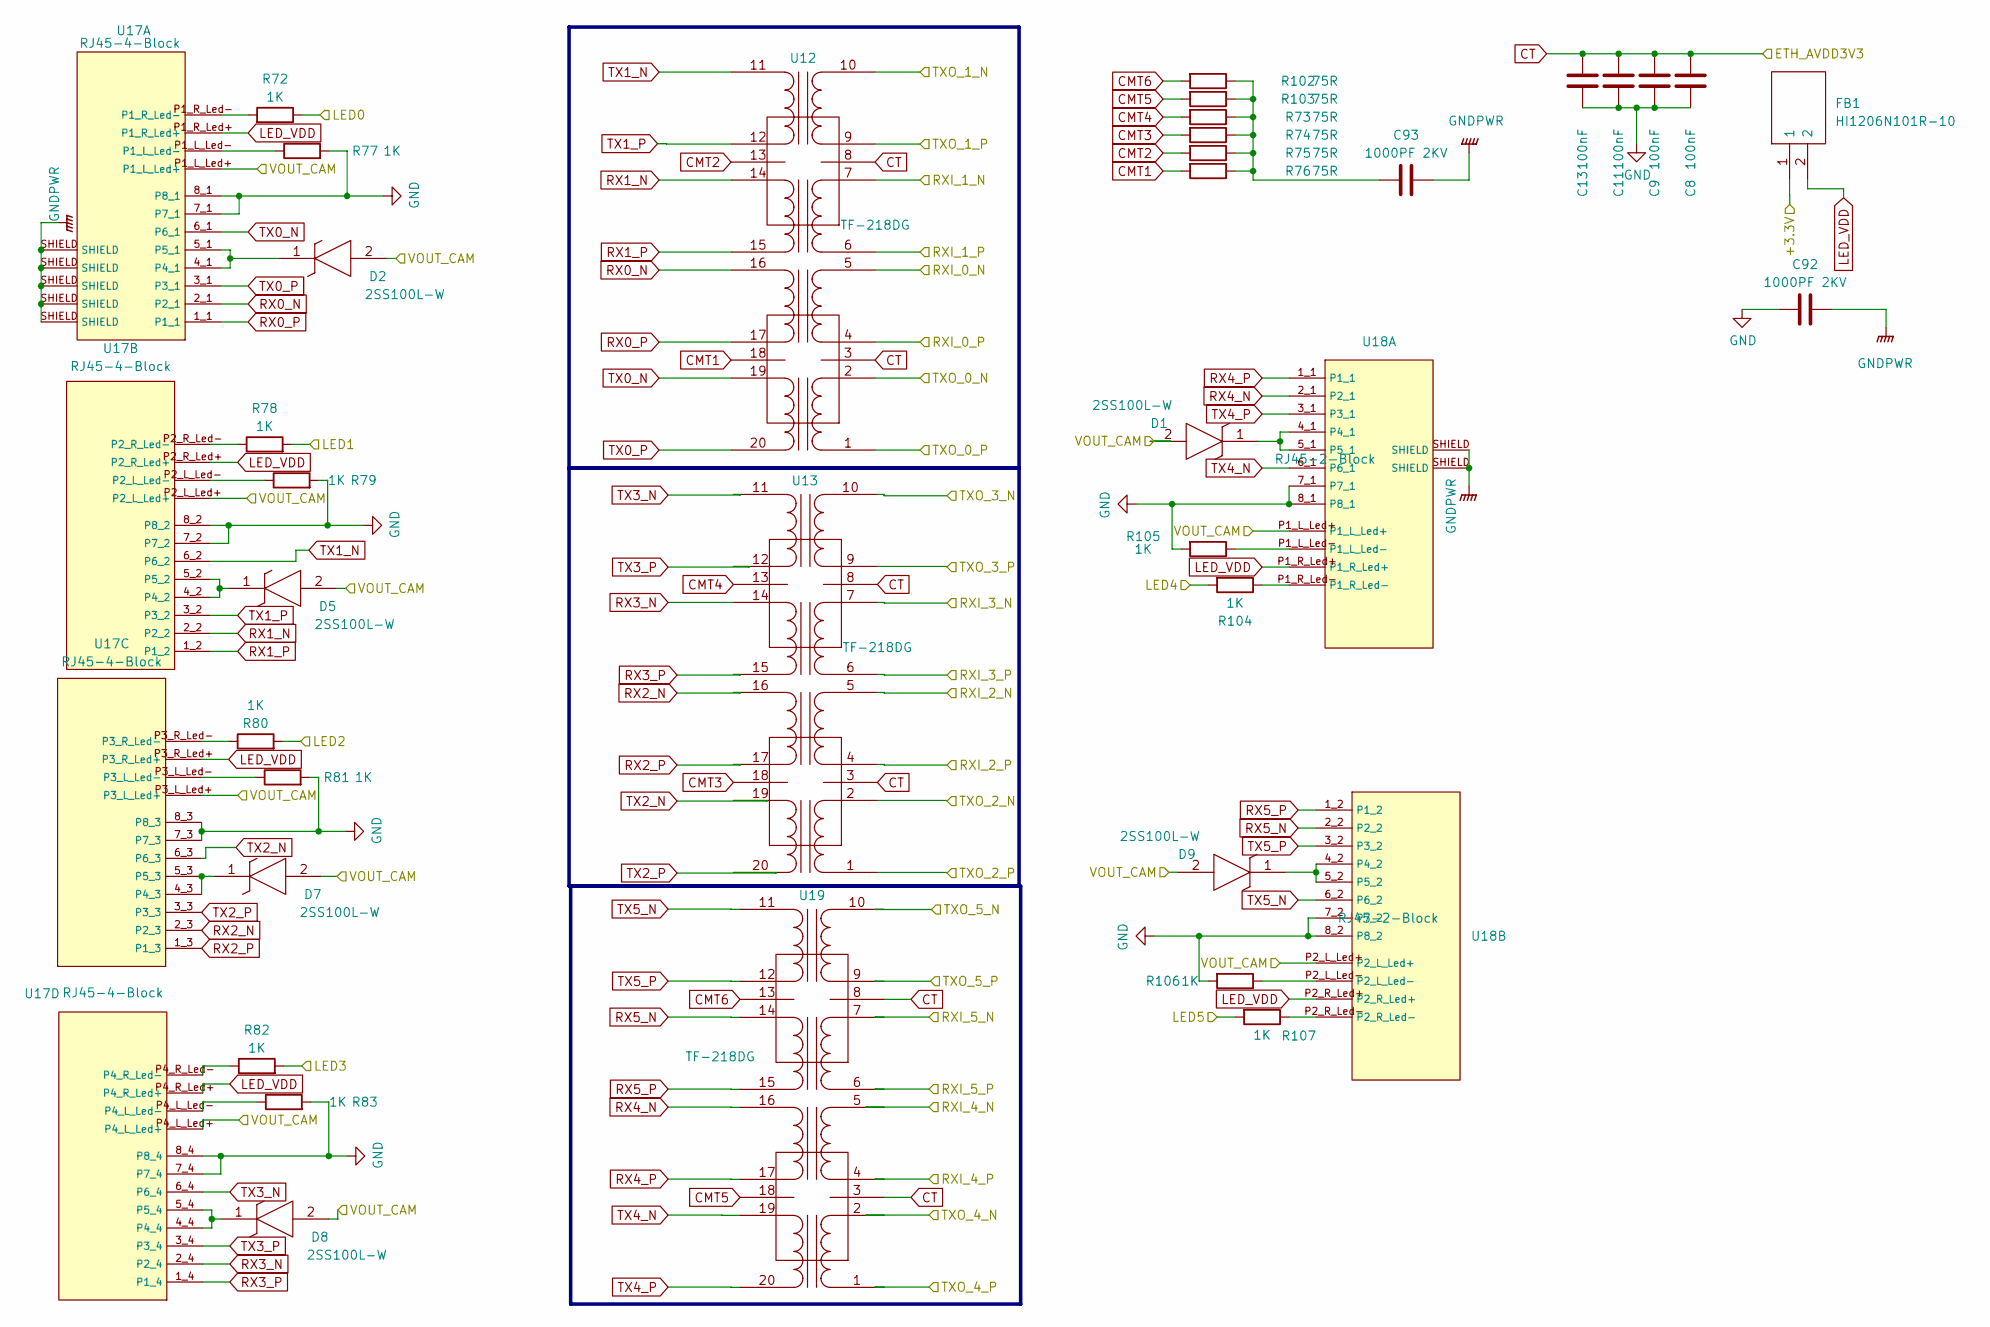
[picture p224: schematic 4_port_rj45.kicad_sch]

Parts:
C8, C9, C11, C13: 100nF; C_0402_1005Metric; MPN CC0402KRX7R7BB104
C92, C93: 1000PF 2KV; S102K33Y5PP63K5R; MPN Y5P102K2KV16CC0224
D1, D2, D5, D7, D8, D9: 2SS100L-W; 2SS100LW; Manufacturer_Part_Number 2SS100L-W; Mouser Part Number 583-2SS100L-W
FB1: HI1206N101R-10; BEADC3216X130N; Manufacturer_Part_Number HI1206N101R-10; Mouser Part Number N/A
R72, R77, R78, R79, R80, R81, R82, R83, R104, R105, R106, R107: 1K; R_0603_1608Metric; MPN 0603WAF1001T5E
R73, R74, R75, R76, R102, R103: 75R; R_0603_1608Metric; MPN 0603WAF750JT5E
U12, U13, U19: TF-218DG; RJ45_Transformer_2_Port; MPN TF-218DG
U17: RJ45-4-Block; 4_Block_RJ45; MPN RJ45 56 1*4 带灯
U18: RJ45-2-Block; 2_Block_RJ45; MPN RJ45 56 1*2 带灯

Connections:
+3.3V: FB1.1
CMT1: R76.2, U12.18
CMT2: R75.2, U12.13
CMT3: R74.2, U13.18
CMT4: R73.2, U13.13
CMT5: R103.2, U19.18
CMT6: R102.2, U19.13
CT: C8.1, C9.1, C11.1, C13.1, U12.3, U12.8, U13.3, U13.8, U19.3, U19.8
GND: C8.2, C9.2, C11.2, C13.2, C92.1, R77.2, R79.2, R81.2, R83.2, R105.2, R106.2, U17.7_1, U17.7_2, U17.7_3, U17.7_4, U17.8_1, U17.8_2, U17.8_3, U17.8_4, U18.7_1, U18.7_2, U18.8_1, U18.8_2
GNDPWR: C92.2, C93.2, U17.SHIELD, U18.SHIELD
LED0: R72.1
LED1: R78.2
LED2: R80.2
LED3: R82.2
LED4: R104.2
LED5: R107.2
LED_VDD: FB1.2, U17.P1_R_Led+, U17.P2_R_Led+, U17.P3_R_Led+, U17.P4_R_Led+, U18.P1_R_Led+, U18.P2_R_Led+
unnamed: C93.1, R73.1, R74.1, R75.1, R76.1, R102.1, R103.1
unnamed: D1.1, U18.4_1, U18.5_1
unnamed: D2.1, U17.4_1, U17.5_1
unnamed: D5.1, U17.4_2, U17.5_2
unnamed: D7.1, U17.4_3, U17.5_3
unnamed: D8.1, U17.4_4, U17.5_4
unnamed: D9.1, U18.4_2, U18.5_2
unnamed: R72.2, U17.P1_R_Led-
unnamed: R77.1, U17.P1_L_Led-
unnamed: R78.1, U17.P2_R_Led-
unnamed: R79.1, U17.P2_L_Led-
unnamed: R80.1, U17.P3_R_Led-
unnamed: R81.1, U17.P3_L_Led-
unnamed: R82.1, U17.P4_R_Led-
unnamed: R83.1, U17.P4_L_Led-
unnamed: R104.1, U18.P1_R_Led-
unnamed: R105.1, U18.P1_L_Led-
unnamed: R106.1, U18.P2_L_Led-
unnamed: R107.1, U18.P2_R_Led-
RX0_N: U12.16, U17.2_1
RX0_P: U12.17, U17.1_1
RX1_N: U12.14, U17.2_2
RX1_P: U12.15, U17.1_2
RX2_N: U13.16, U17.2_3
RX2_P: U13.17, U17.1_3
RX3_N: U13.14, U17.2_4
RX3_P: U13.15, U17.1_4
RX4_N: U18.2_1, U19.16
RX4_P: U18.1_1, U19.17
RX5_N: U18.2_2, U19.14
RX5_P: U18.1_2, U19.15
RXI_0_N: U12.5
RXI_0_P: U12.4
RXI_1_N: U12.7
RXI_1_P: U12.6
RXI_2_N: U13.5
RXI_2_P: U13.4
RXI_3_N: U13.7
RXI_3_P: U13.6
RXI_4_N: U19.5
RXI_4_P: U19.4
RXI_5_N: U19.7
RXI_5_P: U19.6
TX0_N: U12.19, U17.6_1
TX0_P: U12.20, U17.3_1
TX1_N: U12.11, U17.6_2
TX1_P: U12.12, U17.3_2
TX2_N: U13.19, U17.6_3
TX2_P: U13.20, U17.3_3
TX3_N: U13.11, U17.6_4
TX3_P: U13.12, U17.3_4
TX4_N: U18.6_1, U19.19
TX4_P: U18.3_1, U19.20
TX5_N: U18.6_2, U19.11
TX5_P: U18.3_2, U19.12
TXO_0_N: U12.2
TXO_0_P: U12.1
TXO_1_N: U12.10
TXO_1_P: U12.9
TXO_2_N: U13.2
TXO_2_P: U13.1
TXO_3_N: U13.10
TXO_3_P: U13.9
TXO_4_N: U19.2
TXO_4_P: U19.1
TXO_5_N: U19.10
TXO_5_P: U19.9
VOUT_CAM: D1.2, D2.2, D5.2, D7.2, D8.2, D9.2, U17.P1_L_Led+, U17.P2_L_Led+, U17.P3_L_Led+, U17.P4_L_Led+, U18.P1_L_Led+, U18.P2_L_Led+
