ihsanakyrk/Eski-Versionlar-Ve-Siparisler/Movita_3568_AXV_Router_V3.0/MXVR_3.0/CM3568.kicad_sch

## KiCad design Movita_3568_AXV_Router_V3.0/MXVR_3.0/CM3568.kicad_sch (2025-09-01)

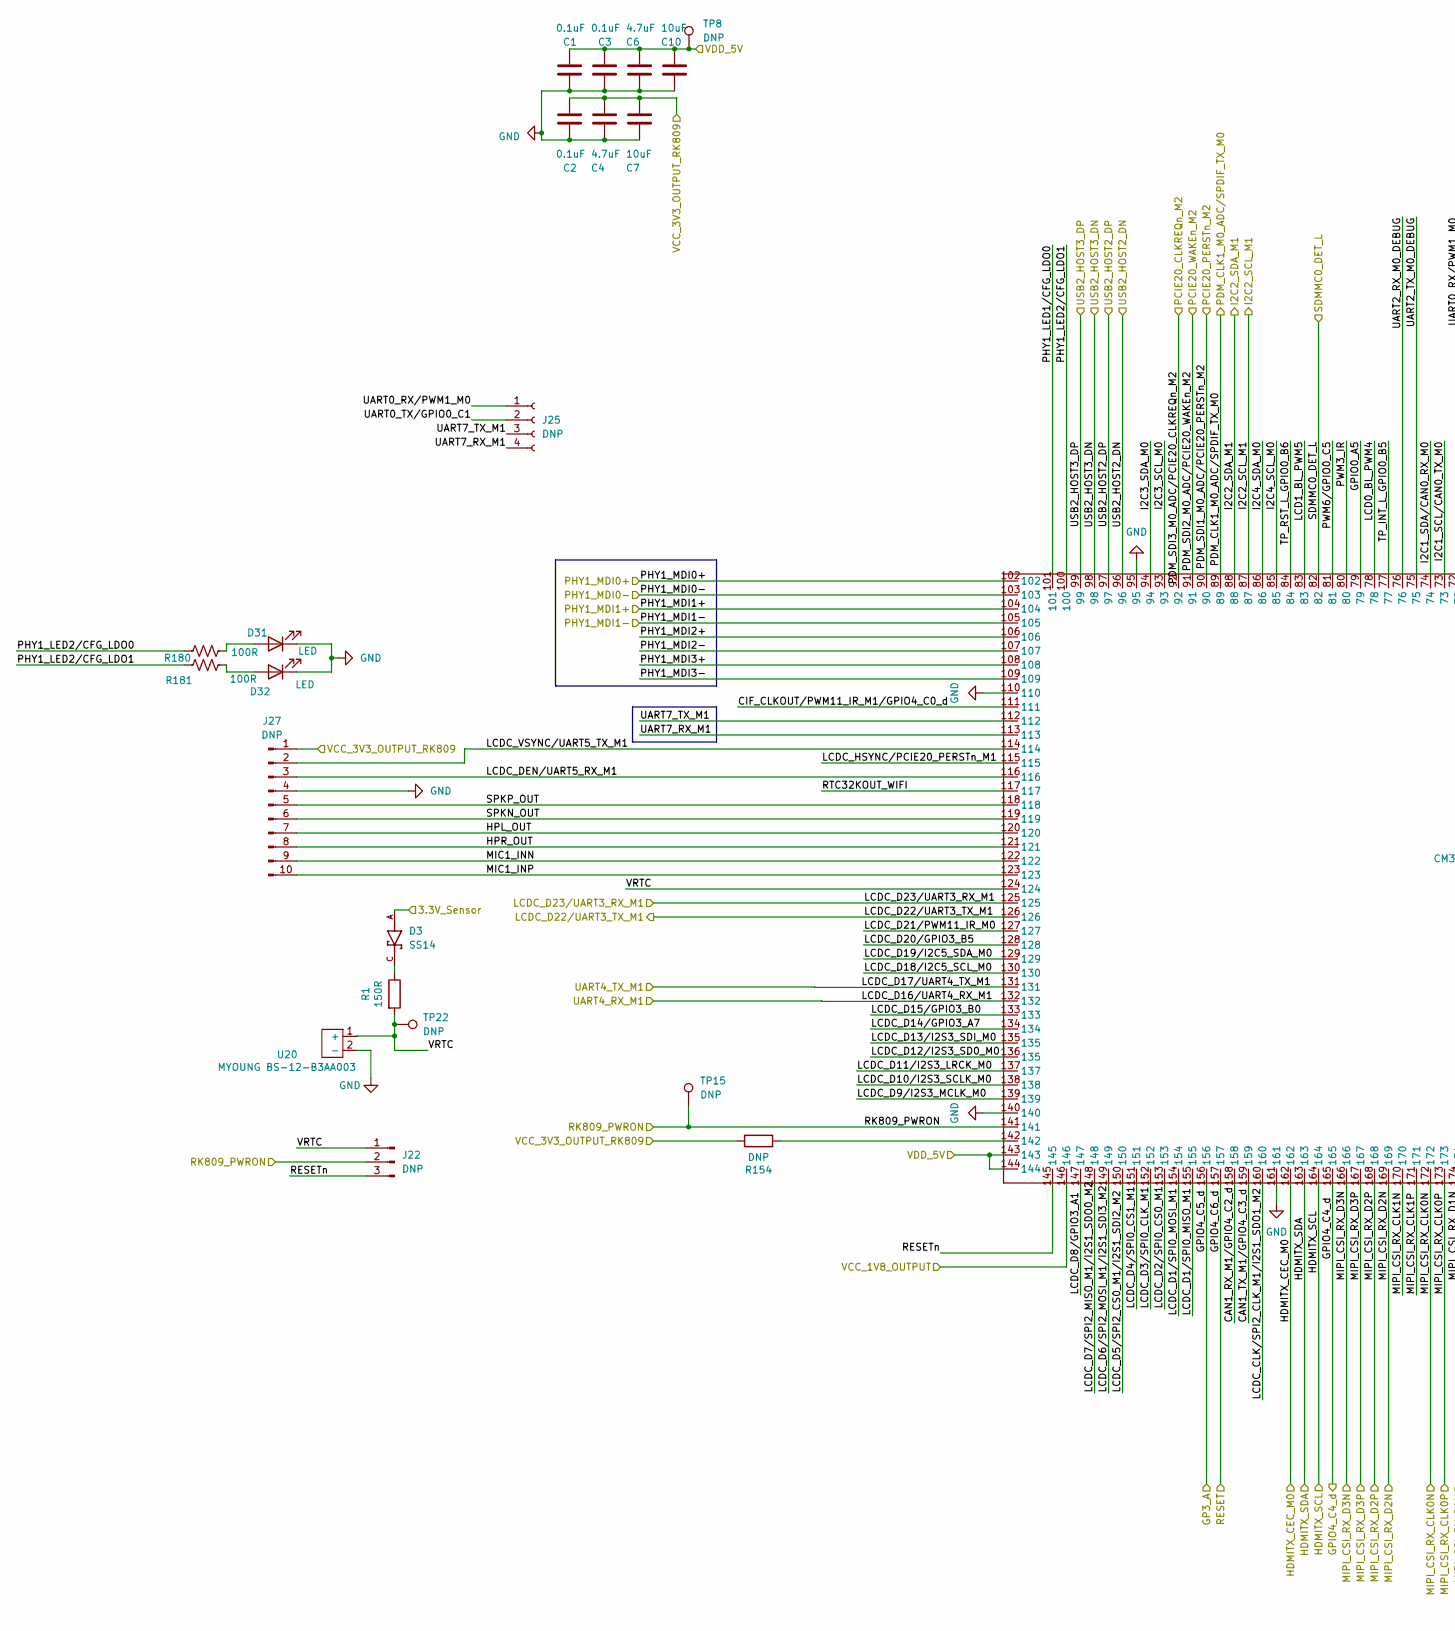
[picture p225: schematic CM3568.kicad_sch, part in row 1, column 1]

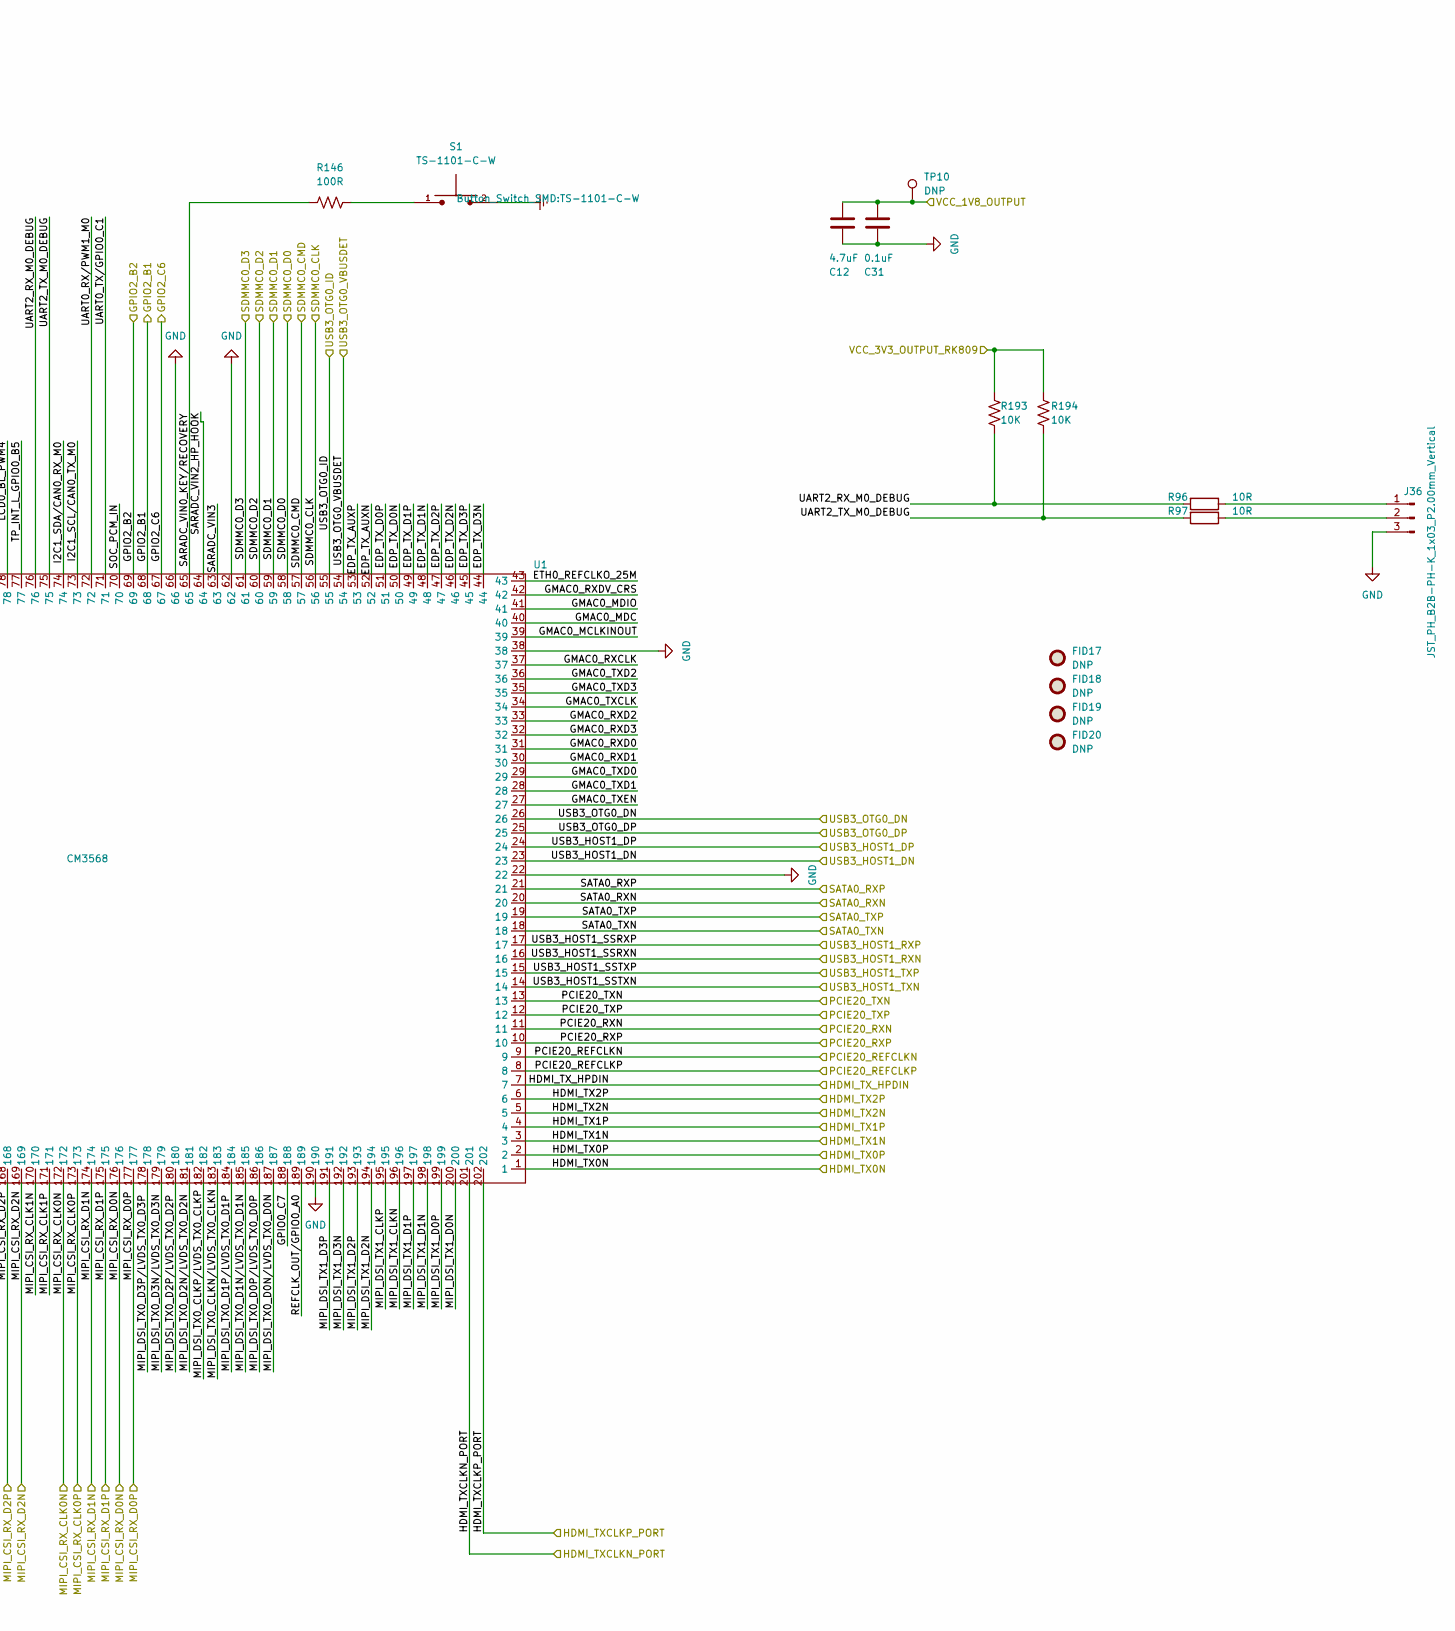
[picture p226: schematic CM3568.kicad_sch, part in row 1, column 2]

Parts:
C1, C2, C3, C31: 0.1uF; C_0603_1608Metric
C4, C6, C12: 4.7uF; C_0603_1608Metric; MPN CL10A475KO8NNNC
C7, C10: 10uF; C_0603_1608Metric; MPN CL10A106MO8NQNC
D3: SS14; DIOM4325X250N; PARTREV O2102
D31, D32: LED; LED_0402_1005Metric
FID17, FID18, FID19, FID20: DNP; Fiducial_0.5mm_Mask1mm
J22: DNP; PinHeader_1x03_P2.00mm_Vertical
J25: DNP; PinHeader_1x04_P2.00mm_Vertical
J27: DNP; PinHeader_1x10_P2.00mm_Vertical
J36: JST_PH_B2B-PH-K_1x03_P2.00mm_Vertical; JST_PH_B3B-PH-K_1x03_P2.00mm_Vertical; MPN JST_PH_B2B-PH-K_1x03_P2.00mm_Vertical
R1: 150R; R_0603_1608Metric; MPN 0603WAF1500T5E
R96, R97: 10R; R_0402_1005Metric; MPN 0402WGF100JTCE
R146, R180, R181: 100R; R_0603_1608Metric; MPN 0603WAF1000T5E
R154: DNP; R_0603_1608Metric
R193, R194: 10K; R_0603_1608Metric; MPN 0603WAF1002T5E
S1: TS-1101-C-W; PARTREV F
TP8, TP10, TP15, TP22: DNP; TestPoint_Pad_1.0x1.0mm
U1: CM3568; MPN CM3568
U20: MYOUNG BS-12-B3AA003; BS-12-B3AA003; MPN MYOUNG BS-12-B3AA003

Connections:
3.3V_Sensor: D3.A
CAN1_RX_M1/GPIO4_C2_d: U1.158
CAN1_TX_M1/GPIO4_C3_d: U1.159
CIF_CLKOUT/PWM11_IR_M1/GPIO4_C0_d: U1.111
EDP_TX_AUXN: U1.52
EDP_TX_AUXP: U1.53
EDP_TX_D0N: U1.50
EDP_TX_D0P: U1.51
EDP_TX_D1N: U1.48
EDP_TX_D1P: U1.49
EDP_TX_D2N: U1.46
EDP_TX_D2P: U1.47
EDP_TX_D3N: U1.44
EDP_TX_D3P: U1.45
ETH0_REFCLKO_25M: U1.43
Earth: S1.2
GMAC0_MCLKINOUT: U1.39
GMAC0_MDC: U1.40
GMAC0_MDIO: U1.41
GMAC0_RXCLK: U1.37
GMAC0_RXD0: U1.31
GMAC0_RXD1: U1.30
GMAC0_RXD2: U1.33
GMAC0_RXD3: U1.32
GMAC0_RXDV_CRS: U1.42
GMAC0_TXCLK: U1.34
GMAC0_TXD0: U1.29
GMAC0_TXD1: U1.28
GMAC0_TXD2: U1.36
GMAC0_TXD3: U1.35
GMAC0_TXEN: U1.27
GND: C1.2, C2.2, C3.2, C4.2, C6.2, C7.2, C10.2, C12.2, C31.2, D31.1 (K), D32.1 (K), J27.4, J36.3, U1.22, U1.38, U1.62, U1.66, U1.95, U1.110, U1.140, U1.161, U1.190, U20.2 (-)
GP3_A: U1.156
GPIO0_A5: U1.79
GPIO0_C7: U1.188
GPIO2_B1: U1.68
GPIO2_B2: U1.69
GPIO2_C6: U1.67
GPIO4_C4_d: U1.165
GPIO4_C6_d: U1.157
HDMITX_CEC_M0: U1.162
HDMITX_SCL: U1.164
HDMITX_SDA: U1.163
HDMI_TX0N: U1.1
HDMI_TX0P: U1.2
HDMI_TX1N: U1.3
HDMI_TX1P: U1.4
HDMI_TX2N: U1.5
HDMI_TX2P: U1.6
HDMI_TXCLKN_PORT: U1.201
HDMI_TXCLKP_PORT: U1.202
HDMI_TX_HPDIN: U1.7
HPL_OUT: J27.7, U1.120
HPR_OUT: J27.8, U1.121
I2C1_SCL/CAN0_TX_M0: U1.73
I2C1_SDA/CAN0_RX_M0: U1.74
I2C2_SCL_M1: U1.87
I2C2_SDA_M1: U1.88
I2C3_SCL_M0: U1.93
I2C3_SDA_M0: U1.94
I2C4_SCL_M0: U1.85
I2C4_SDA_M0: U1.86
LCD0_BL_PWM4: U1.78
LCD1_BL_PWM5: U1.83
LCDC_CLK/SPI2_CLK_M1/I2S1_SDO1_M2: U1.160
LCDC_D1/SPI0_MISO_M1: U1.155
LCDC_D1/SPI0_MOSI_M1: U1.154
LCDC_D2/SPI0_CS0_M1: U1.153
LCDC_D3/SPI0_CLK_M1: U1.152
LCDC_D4/SPI0_CS1_M1: U1.151
LCDC_D5/SPI2_CS0_M1/I2S1_SDI2_M2: U1.150
LCDC_D6/SPI2_MOSI_M1/I2S1_SDI3_M2: U1.149
LCDC_D7/SPI2_MISO_M1/I2S1_SDO0_M2: U1.148
LCDC_D8/GPIO3_A1: U1.147
LCDC_D9/I2S3_MCLK_M0: U1.139
LCDC_D10/I2S3_SCLK_M0: U1.138
LCDC_D11/I2S3_LRCK_M0: U1.137
LCDC_D12/I2S3_SD0_M0: U1.136 (135)
LCDC_D13/I2S3_SDI_M0: U1.135
LCDC_D14/GPIO3_A7: U1.134
LCDC_D15/GPIO3_B0: U1.133
LCDC_D16/UART4_RX_M1: U1.132
LCDC_D17/UART4_TX_M1: U1.131
LCDC_D18/I2C5_SCL_M0: U1.130
LCDC_D19/I2C5_SDA_M0: U1.129
LCDC_D20/GPIO3_B5: U1.128
LCDC_D21/PWM11_IR_M0: U1.127
LCDC_D22/UART3_TX_M1: U1.126
LCDC_D23/UART3_RX_M1: U1.125
LCDC_DEN/UART5_RX_M1: J27.3, U1.116
LCDC_HSYNC/PCIE20_PERSTn_M1: U1.115
LCDC_VSYNC/UART5_TX_M1: J27.2, U1.114
MIC1_INN: J27.9, U1.122
MIC1_INP: J27.10, U1.123
MIPI_CSI_RX_CLK0N: U1.172
MIPI_CSI_RX_CLK0P: U1.173
MIPI_CSI_RX_CLK1N: U1.170
MIPI_CSI_RX_CLK1P: U1.171
MIPI_CSI_RX_D0N: U1.176
MIPI_CSI_RX_D0P: U1.177
MIPI_CSI_RX_D1N: U1.174
MIPI_CSI_RX_D1P: U1.175
MIPI_CSI_RX_D2N: U1.169
MIPI_CSI_RX_D2P: U1.168
MIPI_CSI_RX_D3N: U1.166
MIPI_CSI_RX_D3P: U1.167
MIPI_DSI_TX0_CLKN/LVDS_TX0_CLKN: U1.183
MIPI_DSI_TX0_CLKP/LVDS_TX0_CLKP: U1.182
MIPI_DSI_TX0_D0N/LVDS_TX0_D0N: U1.187
MIPI_DSI_TX0_D0P/LVDS_TX0_D0P: U1.186
MIPI_DSI_TX0_D1N/LVDS_TX0_D1N: U1.185
MIPI_DSI_TX0_D1P/LVDS_TX0_D1P: U1.184
MIPI_DSI_TX0_D2N/LVDS_TX0_D2N: U1.181
MIPI_DSI_TX0_D2P/LVDS_TX0_D2P: U1.180
MIPI_DSI_TX0_D3N/LVDS_TX0_D3N: U1.179
MIPI_DSI_TX0_D3P/LVDS_TX0_D3P: U1.178
MIPI_DSI_TX1_CLKN: U1.196
MIPI_DSI_TX1_CLKP: U1.195
MIPI_DSI_TX1_D0N: U1.200
MIPI_DSI_TX1_D0P: U1.199
MIPI_DSI_TX1_D1N: U1.198
MIPI_DSI_TX1_D1P: U1.197
MIPI_DSI_TX1_D2N: U1.194
MIPI_DSI_TX1_D2P: U1.193
MIPI_DSI_TX1_D3N: U1.192
MIPI_DSI_TX1_D3P: U1.191
unnamed: D3.C, R1.1
unnamed: D31.2 (A), R180.2
unnamed: D32.2 (A), R181.2
unnamed: J36.1, R96.1
unnamed: J36.2, R97.1
unnamed: R146.2, S1.1
unnamed: R154.2, U1.142
PCIE20_CLKREQn_M2: U1.92
PCIE20_PERSTn_M2: U1.90
PCIE20_REFCLKN: U1.9
PCIE20_REFCLKP: U1.8
PCIE20_RXN: U1.11
PCIE20_RXP: U1.10
PCIE20_TXN: U1.13
PCIE20_TXP: U1.12
PCIE20_WAKEn_M2: U1.91
PDM_CLK1_M0_ADC/SPDIF_TX_M0: U1.89
PHY1_LED1/CFG_LDO0: U1.101
PHY1_LED2/CFG_LDO0: R180.1
PHY1_LED2/CFG_LDO1: R181.1, U1.100
PHY1_MDI0+: U1.102
PHY1_MDI0-: U1.103
PHY1_MDI1+: U1.104
PHY1_MDI1-: U1.105
PHY1_MDI2+: U1.106
PHY1_MDI2-: U1.107
PHY1_MDI3+: U1.108
PHY1_MDI3-: U1.109
PWM3_IR: U1.80
PWM6/GPIO0_C5: U1.81
REFCLK_OUT/GPIO0_A0: U1.189
RESETn: J22.3, U1.145
RK809_PWRON: J22.2, TP15.1, U1.141
RTC32KOUT_WIFI: U1.117
SARADC_VIN0_KEY/RECOVERY: R146.1, U1.65
SARADC_VIN2_HP_HOOK: U1.64
SARADC_VIN3: U1.63
SATA0_RXN: U1.20
SATA0_RXP: U1.21
SATA0_TXN: U1.18
SATA0_TXP: U1.19
SDMMC0_CLK: U1.56
SDMMC0_CMD: U1.57
SDMMC0_D0: U1.58
SDMMC0_D1: U1.59
SDMMC0_D2: U1.60
SDMMC0_D3: U1.61
SDMMC0_DET_L: U1.82
SOC_PCM_IN: U1.70
SPKN_OUT: J27.6, U1.119
SPKP_OUT: J27.5, U1.118
TP_INT_L_GPIO0_B5: U1.77
TP_RST_L_GPIO0_B6: U1.84
UART0_RX/PWM1_M0: J25.1, U1.72
UART0_TX/GPIO0_C1: J25.2, U1.71
UART2_RX_M0_DEBUG: R96.2, R193.1, U1.76
UART2_TX_M0_DEBUG: R97.2, R194.1, U1.75
UART7_RX_M1: J25.4, U1.113
UART7_TX_M1: J25.3, U1.112
USB2_HOST2_DN: U1.96
USB2_HOST2_DP: U1.97
USB2_HOST3_DN: U1.98
USB2_HOST3_DP: U1.99
USB3_HOST1_DN: U1.23
USB3_HOST1_DP: U1.24
USB3_HOST1_RXN: U1.16
USB3_HOST1_RXP: U1.17
USB3_HOST1_SSTXN: U1.14
USB3_HOST1_SSTXP: U1.15
USB3_OTG0_DN: U1.26
USB3_OTG0_DP: U1.25
USB3_OTG0_ID: U1.55
USB3_OTG0_VBUSDET: U1.54
VCC_1V8_OUTPUT: C12.1, C31.1, TP10.1, U1.146
VCC_3V3_OUTPUT_RK809: C2.1, C4.1, C7.1, J27.1, R154.1, R193.2, R194.2
VDD_5V: C1.1, C3.1, C6.1, C10.1, TP8.1, U1.143, U1.144
VRTC: J22.1, R1.2, TP22.1, U1.124, U20.1 (+)
