ihsanakyrk/Eski-Versionlar-Ve-Siparisler/Movita_3568_AXV_Router_V3.0/MXVR_3.0/CSI_AHD.kicad_sch

## KiCad design Movita_3568_AXV_Router_V3.0/MXVR_3.0/CSI_AHD.kicad_sch (2025-09-01)

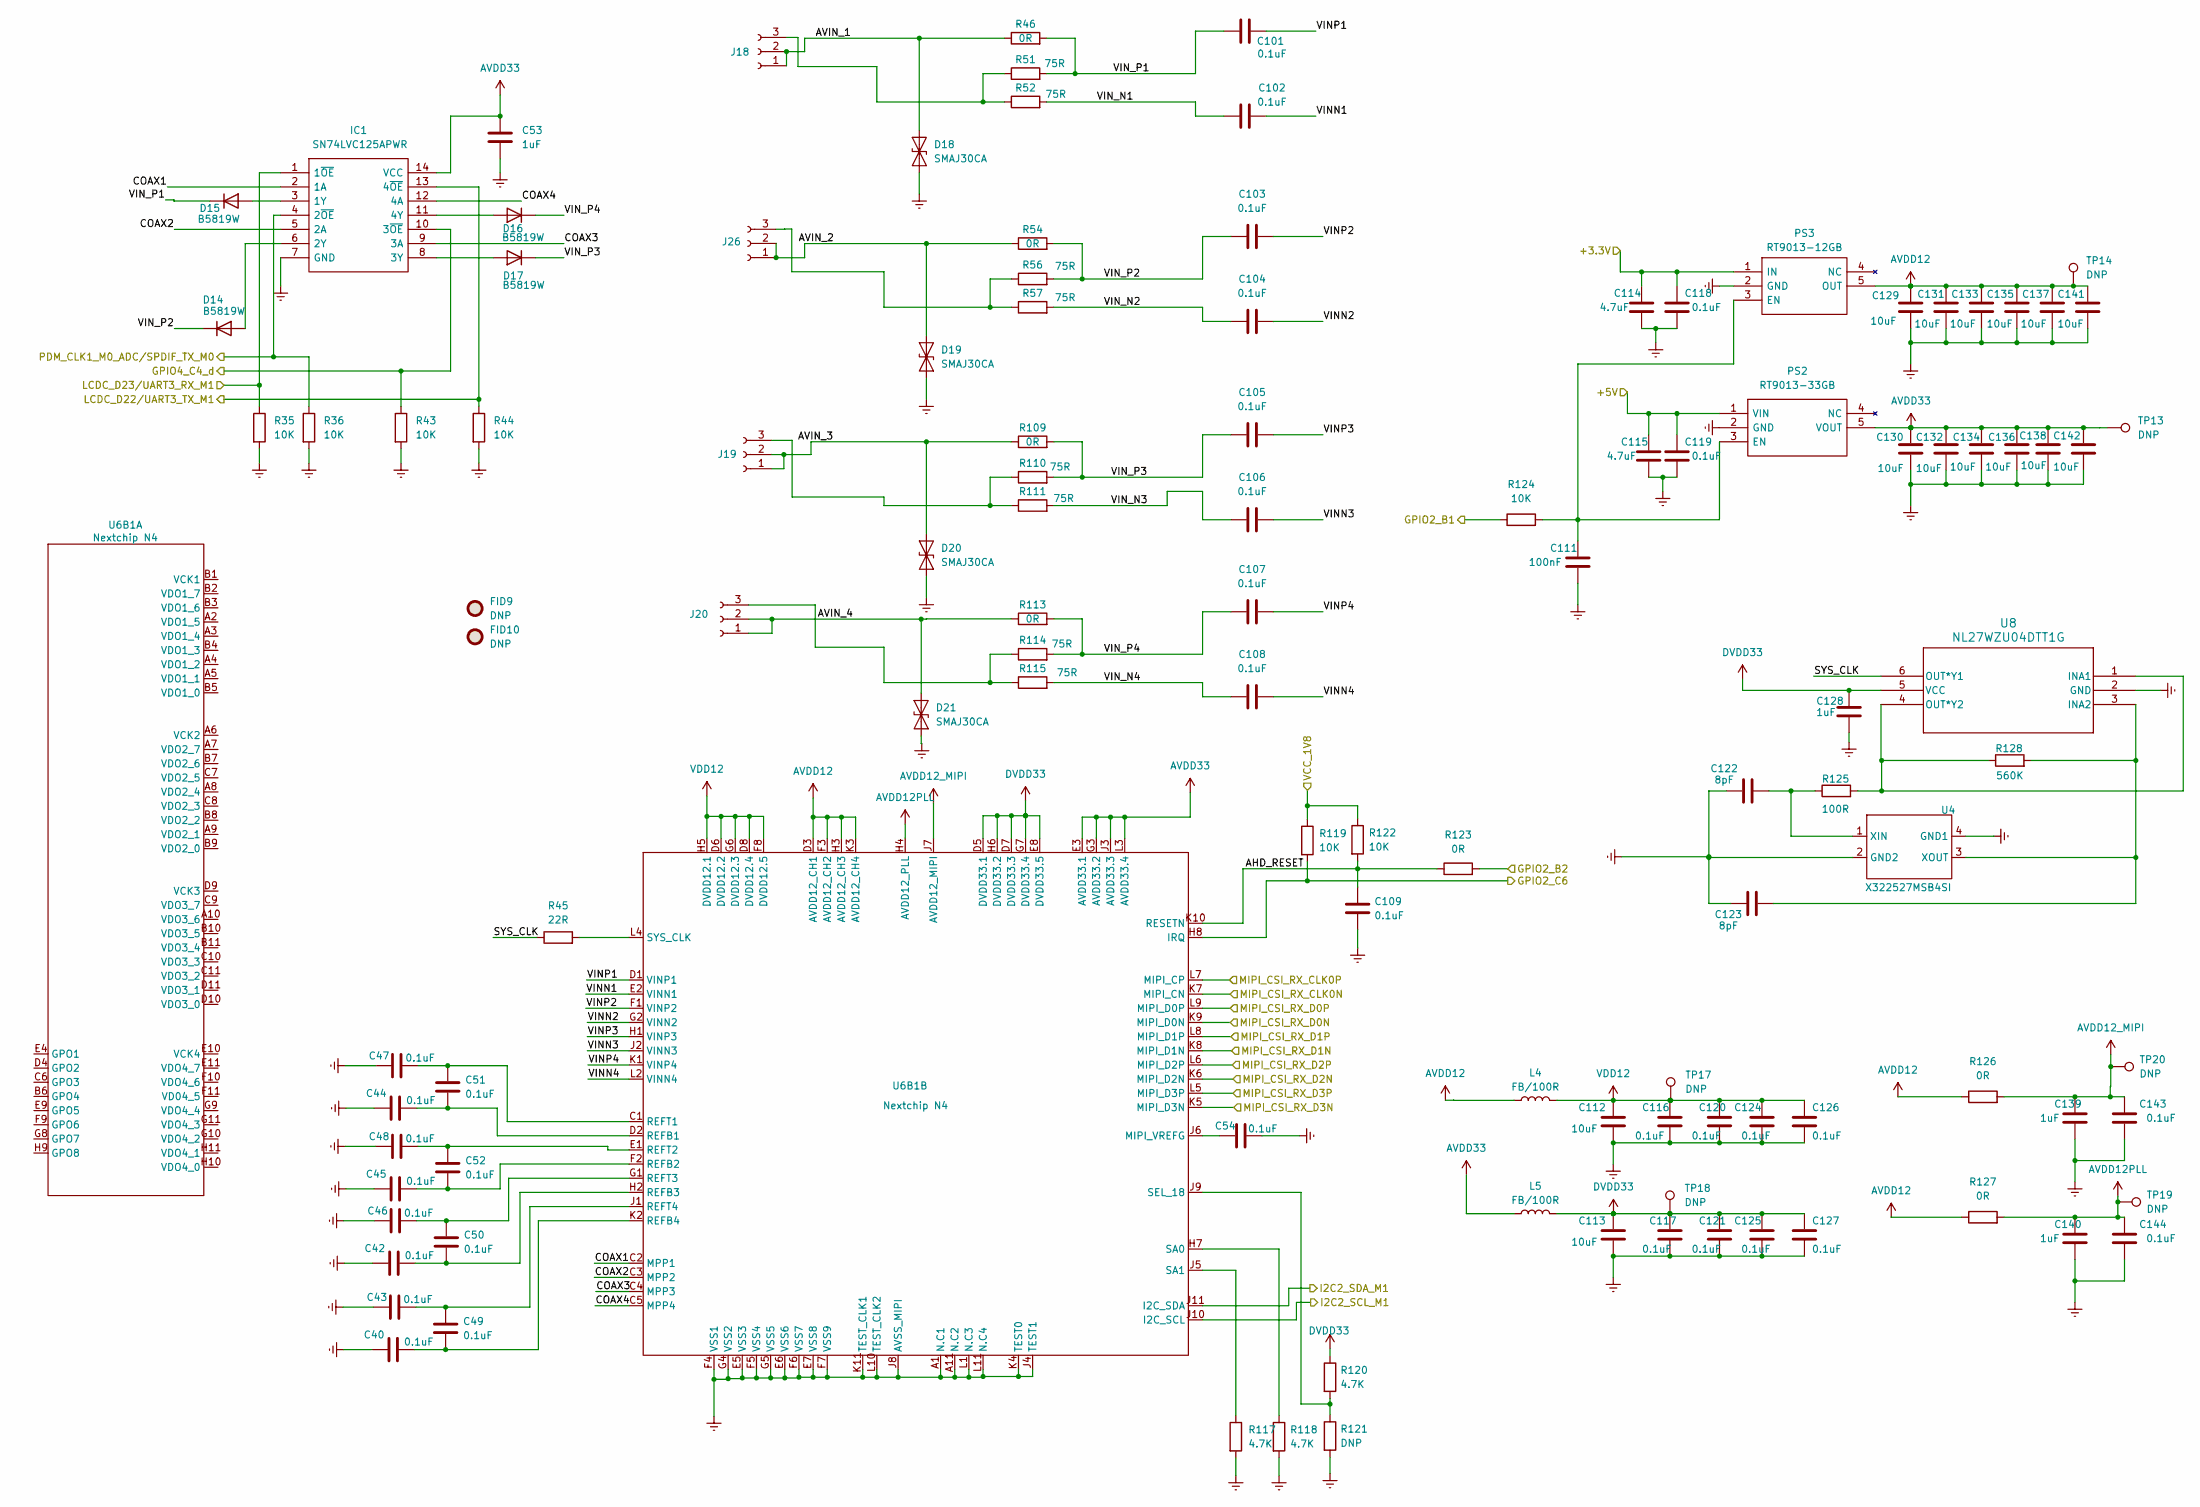
[picture p227: schematic CSI_AHD.kicad_sch]

Parts:
C40, C42, C43, C44, C45, C46, C47, C48, C49, C50, C51, C52, C54, C101, C102, C103, C104, C105, C106, C107, C108, C109, C116, C117, C118, C119, C120, C121, C124, C125, C126, C127, C143, C144: 0.1uF; C_0603_1608Metric
C53, C128, C139, C140: 1uF; C_0603_1608Metric; MPN CL10A105KB8NNNC
C111: 100nF; C_0603_1608Metric; MPN 0603B104K500NT
C112, C113, C129, C130, C131, C132, C133, C134, C135, C136, C137, C138, C141, C142: 10uF; C_0402_1005Metric; MPN CL05A106MQ5NUNC
C114, C115: 4.7uF; C_0402_1005Metric; MPN CL05A475KP5NRNC
C122, C123: 8pF; C_0603_1608Metric; MPN 0603CG8R0C500NT
D14, D15, D16, D17: B5819W; D_SOD-123; MPN B5819W
D18, D19, D20, D21: SMAJ30CA; D_SMA; MPN SMAJ30CA
FID9, FID10: DNP; Fiducial_0.5mm_Mask1mm
IC1: SN74LVC125APWR; Manufacturer_Part_Number SN74LVC125APWR; Mouser Part Number 595-SN74LVC125APWR
J18, J19, J20, J26: DNP; AV_CON
L4, L5: FB/100R; L_0603_1608Metric; MPN CBW160808U101T
PS2: RT9013-33GB; SOT94P279X130-5N; Manufacturer_Part_Number RT9013-33GB; Mouser Part Number 835-RT9013-33GB
PS3: RT9013-12GB; SOT-23-5; Manufacturer_Part_Number TLV75712PDBVR; Mouser Part Number 595-TLV75712PDBVR
R35, R36, R43, R44, R119, R122, R124: 10K; R_0603_1608Metric; MPN 0603WAF1002T5E
R45: 22R; R_0603_1608Metric; MPN 0603WAF220JT5E
R46, R54, R109, R113, R123, R126, R127: 0R; R_0603_1608Metric; MPN 0603WAF0000T5E
R51, R52, R56, R57, R110, R111, R114, R115: 75R; R_0603_1608Metric; MPN 0603WAF750JT5E
R117, R118, R120: 4.7K; R_0603_1608Metric; MPN 0603WAF270JT5E
R121: DNP; R_0402_1005Metric
R125: 100R; R_0603_1608Metric; MPN 0603WAF1000T5E
R128: 560K; R_0603_1608Metric; MPN 0603WAF5603T5E
TP13, TP14, TP17, TP18, TP19, TP20: DNP; TestPoint_Pad_1.0x1.0mm
U4: X322527MSB4SI; Crystal_SMD_3225-4Pin_3.2x2.5mm; MPN X322527MSB4SI
U6B1: Nextchip N4; N4; MPN Nextchip N4
U8: NL27WZU04DTT1G; SOP95P275X110-6N; MPN NL27WZU04DTT1G

Connections:
+3.3V: C114.1, C118.1, PS3.1 (IN)
+5V: C115.1, C119.1, PS2.1 (VIN)
AHD_RESET: C109.1, R122.2, R123.1, U6B1.K10 (RESETN)
AVDD12: C129.1, C131.1, C133.1, C135.1, C137.1, C141.1, L4.1, PS3.5 (OUT), R126.1, R127.1, TP14.1, U6B1.D3 (AVDD12_CH1), U6B1.F3 (AVDD12_CH2), U6B1.H3 (AVDD12_CH3), U6B1.K3 (AVDD12_CH4)
AVDD12PLL: C140.1, C144.1, R127.2, TP19.1, U6B1.H4 (AVDD12_PLL)
AVDD12_MIPI: C139.1, C143.1, R126.2, TP20.1, U6B1.J7 (AVDD12_MIPI)
AVDD33: C53.1, C130.1, C132.1, C134.1, C136.1, C138.1, C142.1, IC1.14 (VCC), L5.2, PS2.5 (VOUT), TP13.1, U6B1.E3 (AVDD33.1), U6B1.G3 (AVDD33.2), U6B1.J3 (AVDD33.3), U6B1.L3 (AVDD33.4)
AVIN_1: D18.2 (A2), J18.1, J18.2, R46.1
AVIN_2: D19.2 (A2), J26.1, J26.2, R54.1
AVIN_3: D20.2 (A2), J19.1, J19.2, R109.1
AVIN_4: D21.2 (A2), J20.1, J20.2, R113.1
COAX1: IC1.2 (1A), U6B1.C2 (MPP1)
COAX2: IC1.5 (2A), U6B1.C3 (MPP2)
COAX3: IC1.9 (3A), U6B1.C4 (MPP3)
COAX4: IC1.12 (4A), U6B1.C5 (MPP4)
DVDD33: C113.1, C117.1, C121.1, C125.1, C127.1, C128.1, L5.1, R120.1, TP18.1, U6B1.D5 (DVDD33.1), U6B1.D7 (DVDD33.3), U6B1.E8 (DVDD33.5), U6B1.G7 (DVDD33.4), U6B1.H6 (DVDD33.2), U8.5 (VCC)
Earth: C40.1, C42.1, C43.1, C44.1, C45.1, C46.1, C47.1, C48.1, C53.2, C54.2, C109.2, C111.2, C112.2, C113.2, C114.2, C115.2, C116.2, C117.2, C118.2, C119.2, C120.2, C121.2, C122.1, C123.1, C124.2, C125.2, C126.2, C127.2, C128.2, C129.2, C130.2, C131.2, C132.2, C133.2, C134.2, C135.2, C136.2, C137.2, C138.2, C139.2, C140.2, C141.2, C142.2, C143.2, C144.2, D18.1 (A1), D19.1 (A1), D20.1 (A1), D21.1 (A1), IC1.7 (GND), PS2.2 (GND), PS3.2 (GND), R35.2, R36.2, R43.2, R44.2, R117.2, R118.2, R121.2, U4.2 (GND2), U4.4 (GND1), U6B1.A1 (N.C1), U6B1.A11 (N.C2), U6B1.E5 (VSS3), U6B1.E6 (VSS6), U6B1.E7 (VSS8), U6B1.F4 (VSS1), U6B1.F5 (VSS4), U6B1.F6 (VSS7), U6B1.F7 (VSS9), U6B1.G4 (VSS2), U6B1.G5 (VSS5), U6B1.J4 (TEST1), U6B1.J8 (AVSS_MIPI), U6B1.K4 (TEST0), U6B1.K11 (TEST_CLK1), U6B1.L1 (N.C3), U6B1.L10 (TEST_CLK2), U6B1.L11 (N.C4), U8.2 (GND)
GPIO2_B1: R124.1
GPIO2_B2: R123.2
GPIO2_C6: R119.2, U6B1.H8 (IRQ)
GPIO4_C4_d: IC1.10 (3~OE), R43.1
I2C2_SCL_M1: U6B1.J10 (I2C_SCL)
I2C2_SDA_M1: U6B1.J11 (I2C_SDA)
LCDC_D22/UART3_TX_M1: IC1.13 (4~OE), R44.1
LCDC_D23/UART3_RX_M1: IC1.1 (1~OE), R35.1
MIPI_CSI_RX_CLK0N: U6B1.K7 (MIPI_CN)
MIPI_CSI_RX_CLK0P: U6B1.L7 (MIPI_CP)
MIPI_CSI_RX_D0N: U6B1.K9 (MIPI_D0N)
MIPI_CSI_RX_D0P: U6B1.L9 (MIPI_D0P)
MIPI_CSI_RX_D1N: U6B1.K8 (MIPI_D1N)
MIPI_CSI_RX_D1P: U6B1.L8 (MIPI_D1P)
MIPI_CSI_RX_D2N: U6B1.K6 (MIPI_D2N)
MIPI_CSI_RX_D2P: U6B1.L6 (MIPI_D2P)
MIPI_CSI_RX_D3N: U6B1.K5 (MIPI_D3N)
MIPI_CSI_RX_D3P: U6B1.L5 (MIPI_D3P)
unnamed: C40.2, C49.2, U6B1.K2 (REFB4)
unnamed: C42.2, C50.2, U6B1.H2 (REFB3)
unnamed: C43.2, C49.1, U6B1.J1 (REFT4)
unnamed: C44.2, C51.2, U6B1.D2 (REFB1)
unnamed: C45.2, C52.2, U6B1.F2 (REFB2)
unnamed: C46.2, C50.1, U6B1.G1 (REFT3)
unnamed: C47.2, C51.1, U6B1.C1 (REFT1)
unnamed: C48.2, C52.1, U6B1.E1 (REFT2)
unnamed: C54.1, U6B1.J6 (MIPI_VREFG)
unnamed: C111.1, PS2.3 (EN), PS3.3 (EN), R124.2
unnamed: C122.2, R125.1, U4.1 (XIN)
unnamed: C123.2, R128.2, U4.3 (XOUT), U8.3 (INA2)
unnamed: D14.2 (A), IC1.6 (2Y)
unnamed: D15.2 (A), IC1.3 (1Y)
unnamed: D16.2 (A), IC1.11 (4Y)
unnamed: D17.2 (A), IC1.8 (3Y)
unnamed: J18.3, R51.1, R52.1
unnamed: J19.3, R110.1, R111.1
unnamed: J20.3, R114.1, R115.1
unnamed: J26.3, R56.1, R57.1
unnamed: R45.2, U6B1.L4 (SYS_CLK)
unnamed: R117.1, U6B1.J5 (SA1)
unnamed: R118.1, U6B1.H7 (SA0)
unnamed: R120.2, R121.1, U6B1.J9 (SEL_18)
unnamed: R125.2, R128.1, U8.1 (INA1), U8.4 (OUT*Y2)
PDM_CLK1_M0_ADC/SPDIF_TX_M0: IC1.4 (2~OE), R36.1
SYS_CLK: R45.1, U8.6 (OUT*Y1)
VCC_1V8: R119.1, R122.1
VDD12: C112.1, C116.1, C120.1, C124.1, C126.1, L4.2, TP17.1, U6B1.D6 (DVDD12.2), U6B1.D8 (DVDD12.4), U6B1.F8 (DVDD12.5), U6B1.G6 (DVDD12.3), U6B1.H5 (DVDD12.1)
VINN1: C102.2, U6B1.E2 (VINN1)
VINN2: C104.2, U6B1.G2 (VINN2)
VINN3: C106.2, U6B1.J2 (VINN3)
VINN4: C108.2, U6B1.L2 (VINN4)
VINP1: C101.2, U6B1.D1 (VINP1)
VINP2: C103.2, U6B1.F1 (VINP2)
VINP3: C105.2, U6B1.H1 (VINP3)
VINP4: C107.2, U6B1.K1 (VINP4)
VIN_N1: C102.1, R52.2
VIN_N2: C104.1, R57.2
VIN_N3: C106.1, R111.2
VIN_N4: C108.1, R115.2
VIN_P1: C101.1, D15.1 (K), R46.2, R51.2
VIN_P2: C103.1, D14.1 (K), R54.2, R56.2
VIN_P3: C105.1, D17.1 (K), R109.2, R110.2
VIN_P4: C107.1, D16.1 (K), R113.2, R114.2
