ihsanakyrk/Eski-Versionlar-Ve-Siparisler/Movita_3568_AXV_Router_V3.0/MXVR_3.0/EC25_Sim.kicad_sch

## KiCad design Movita_3568_AXV_Router_V3.0/MXVR_3.0/EC25_Sim.kicad_sch (2025-09-01)

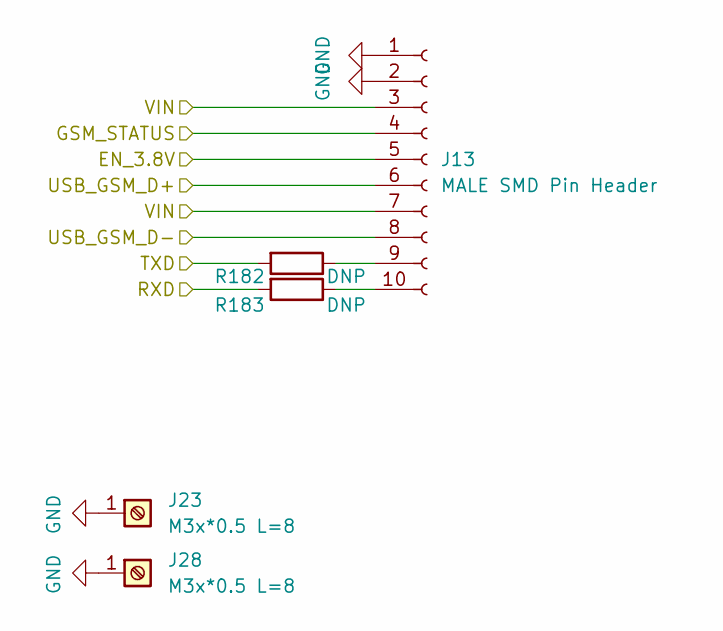
[picture p228: schematic EC25_Sim.kicad_sch]

Parts:
J13: MALE SMD Pin Header; PinSocket_2x05_P2.00mm_Vertical_SMD; MPN 2.0mm 2*5p 贴片排针
J23, J28: M3x*0.5 L=8; Screw Terminal Shinbo; MPN SMTSO-M3-8ET
R182, R183: DNP; R_0603_1608Metric

Connections:
EN_3.8V: J13.5
GND: J13.1, J13.2, J23.1, J28.1
GSM_STATUS: J13.4
unnamed: J13.9, R182.1
unnamed: J13.10, R183.1
RXD: R183.2
TXD: R182.2
USB_GSM_D+: J13.6
USB_GSM_D-: J13.8
VIN: J13.3, J13.7
