ihsanakyrk/Eski-Versionlar-Ve-Siparisler/Movita_3568_AXV_Router_V3.0/MXVR_3.0/HDMI 2.0.kicad_sch

## KiCad design Movita_3568_AXV_Router_V3.0/MXVR_3.0/HDMI 2.0.kicad_sch (2025-09-01)

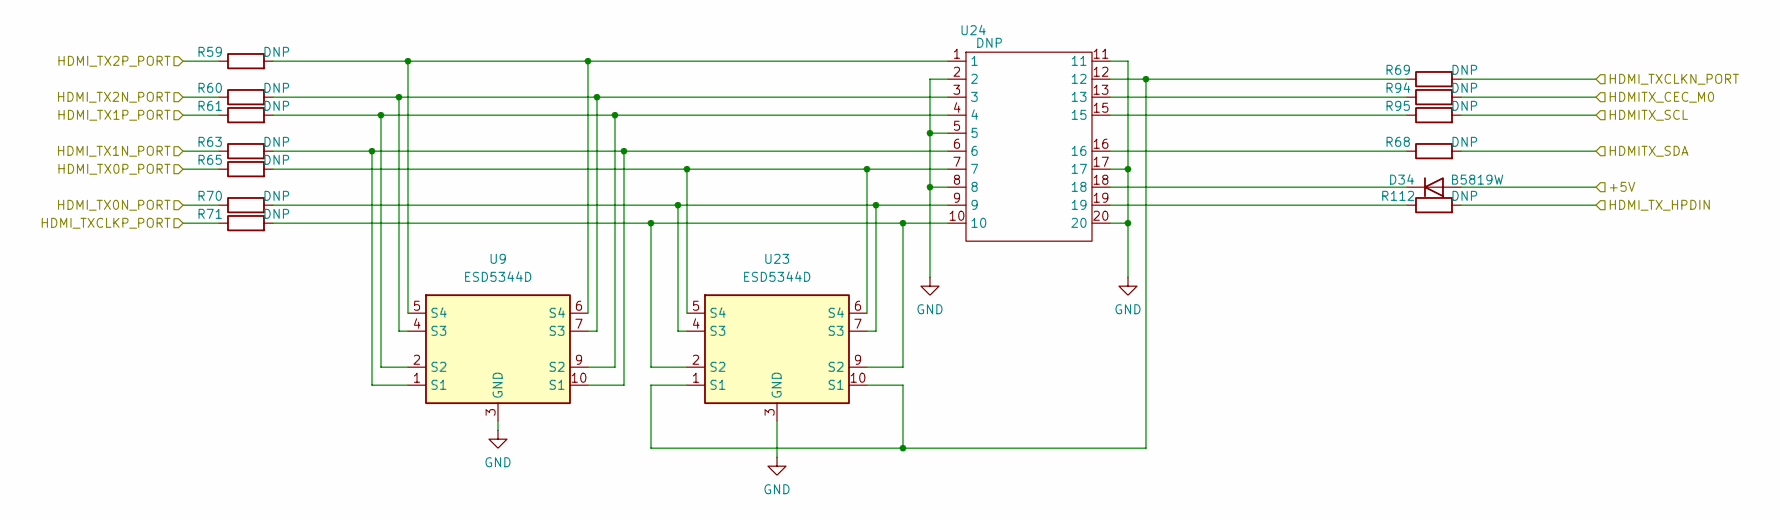
[picture p229: schematic HDMI 2.0.kicad_sch]

Parts:
D34: B5819W; D_SOD-123; MPN B5819W
R59, R60, R61, R63, R65, R68, R69, R70, R71, R94, R95, R112: DNP; R_0201_0603Metric
U9, U23: ESD5344D; MPN ESD5344D
U24: DNP; HDMI 19PIN

Connections:
+5V: D34.2 (A)
GND: U9.3 (GND), U23.3 (GND), U24.2, U24.5, U24.8, U24.11, U24.17, U24.20
HDMITX_CEC_M0: R94.2
HDMITX_SCL: R95.2
HDMITX_SDA: R68.2
HDMI_TX0N_PORT: R70.1
HDMI_TX0P_PORT: R65.1
HDMI_TX1N_PORT: R63.1
HDMI_TX1P_PORT: R61.1
HDMI_TX2N_PORT: R60.1
HDMI_TX2P_PORT: R59.1
HDMI_TXCLKN_PORT: R69.2
HDMI_TXCLKP_PORT: R71.1
HDMI_TX_HPDIN: R112.2
unnamed: D34.1 (K), U24.18
unnamed: R59.2, U9.5 (S4), U9.6 (S4), U24.1
unnamed: R60.2, U9.4 (S3), U9.7 (S3), U24.3
unnamed: R61.2, U9.2 (S2), U9.9 (S2), U24.4
unnamed: R63.2, U9.1 (S1), U9.10 (S1), U24.6
unnamed: R65.2, U23.5 (S4), U23.6 (S4), U24.7
unnamed: R68.1, U24.16
unnamed: R69.1, U23.1 (S1), U23.10 (S1), U24.12
unnamed: R70.2, U23.4 (S3), U23.7 (S3), U24.9
unnamed: R71.2, U23.2 (S2), U23.9 (S2), U24.10
unnamed: R94.1, U24.13
unnamed: R95.1, U24.15
unnamed: R112.1, U24.19
