ihsanakyrk/Eski-Versionlar-Ve-Siparisler/Movita_3568_AXV_Router_V3.0/MXVR_3.0/IO Connector.kicad_sch

## KiCad design Movita_3568_AXV_Router_V3.0/MXVR_3.0/IO Connector.kicad_sch (2025-09-01)

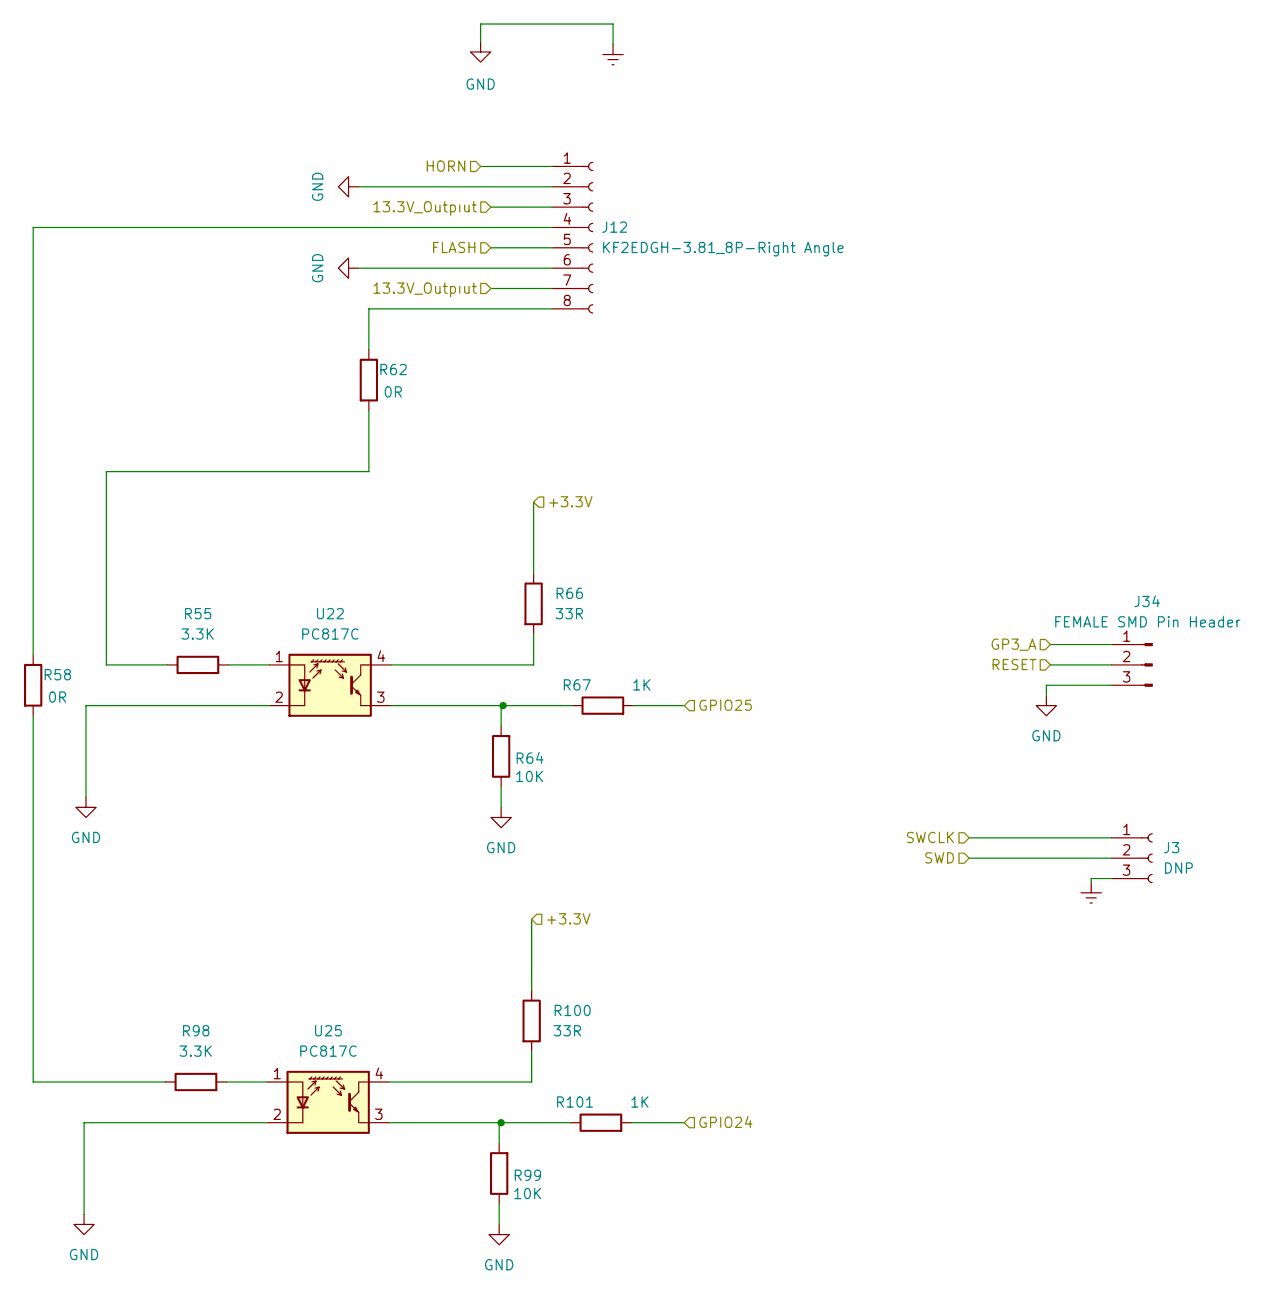
[picture p232: schematic IO Connector.kicad_sch]

Parts:
J3: DNP; PinHeader_1x03_P2.00mm_Vertical
J12: KF2EDGH-3.81_8P-Right Angle; KF2EDGH-3.81_8P; MPN 15EDGK-3.81 双层 2*4p
J34: FEMALE SMD Pin Header; PinSocket_1x03_P2.54mm_Vertical; MPN 1*3p 2.54 贴片排母
R55, R98: 3.3K; R_0603_1608Metric; MPN 0603WAF3301T5E
R58, R62: 0R; R_0603_1608Metric; MPN 0603WAF0000T5E
R64, R99: 10K; R_0603_1608Metric; MPN 0603WAF1002T5E
R66, R100: 33R; R_0603_1608Metric; MPN 0603WAF330JT5E
R67, R101: 1K; R_0603_1608Metric; MPN 0603WAF1001T5E
U22, U25: PC817C; PC817; MPN PC817C_4PIN_SMD

Connections:
13.3V_Outpıut: J12.3, J12.7
+3.3V: R66.1, R100.1
Earth: J3.3, J12.2, J12.6, J34.3, R64.1, R99.1, U22.2 (K), U25.2 (K)
FLASH: J12.5
GP3_A: J34.1
GPIO24: R101.2
GPIO25: R67.2
HORN: J12.1
unnamed: J12.4, R58.1
unnamed: J12.8, R62.1
unnamed: R55.1, R62.2
unnamed: R55.2, U22.1 (A)
unnamed: R58.2, R98.1
unnamed: R64.2, R67.1, U22.3 (E)
unnamed: R66.2, U22.4 (C)
unnamed: R98.2, U25.1 (A)
unnamed: R100.2, U25.4 (C)
unnamed: R99.2, R101.1, U25.3 (E)
RESET: J34.2
SWCLK: J3.1
SWD: J3.2
