ihsanakyrk/Eski-Versionlar-Ve-Siparisler/Movita_3568_AXV_Router_V3.0/MXVR_3.0/MIPI_DSI_TX0&LVDS .kicad_sch

## KiCad design Movita_3568_AXV_Router_V3.0/MXVR_3.0/MIPI_DSI_TX0&LVDS .kicad_sch (2025-09-01)

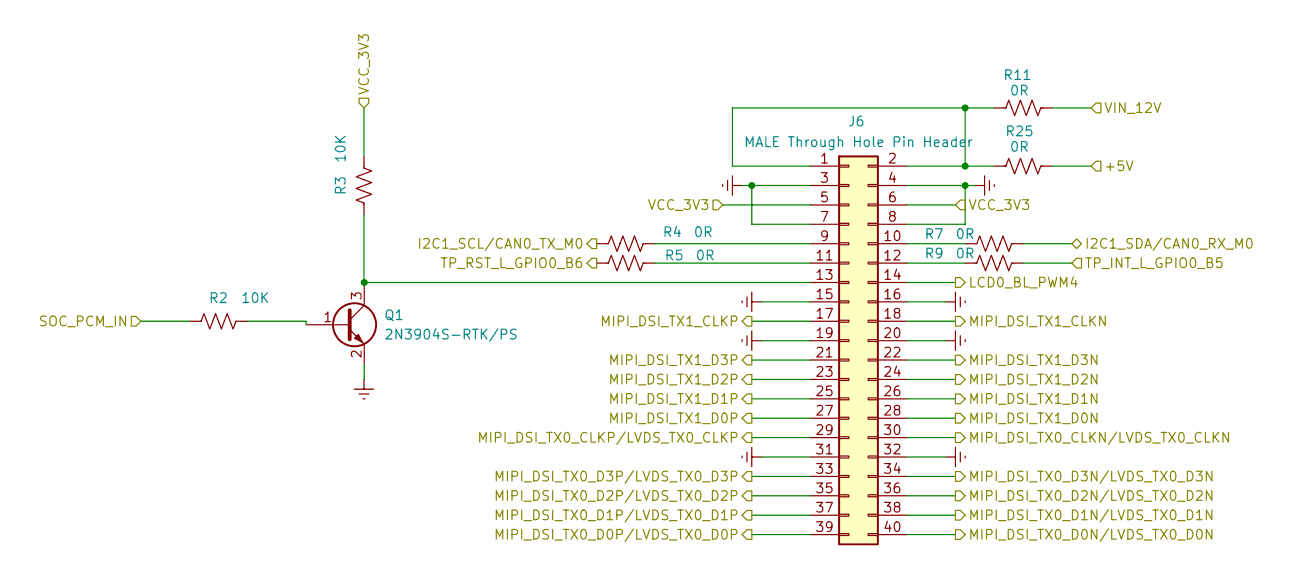
[picture p233: schematic MIPI_DSI_TX0&LVDS .kicad_sch]

Parts:
J6: MALE Through Hole Pin Header; PinHeader_2x20_P1.27mm_Vertical
Q1: 2N3904S-RTK/PS; 2N3904S-RTKPS
R2, R3: 10K; R_0603_1608Metric
R4, R5, R7, R9, R11, R25: 0R; R_0603_1608Metric

Connections:
+5V: R25.2
Earth: J6.3, J6.4, J6.7, J6.8, J6.15, J6.16, J6.19, J6.20, J6.31, J6.32, Q1.2 (E)
I2C1_SCL/CAN0_TX_M0: R4.1
I2C1_SDA/CAN0_RX_M0: R7.2
LCD0_BL_PWM4: J6.14
MIPI_DSI_TX0_CLKN/LVDS_TX0_CLKN: J6.30
MIPI_DSI_TX0_CLKP/LVDS_TX0_CLKP: J6.29
MIPI_DSI_TX0_D0N/LVDS_TX0_D0N: J6.40
MIPI_DSI_TX0_D0P/LVDS_TX0_D0P: J6.39
MIPI_DSI_TX0_D1N/LVDS_TX0_D1N: J6.38
MIPI_DSI_TX0_D1P/LVDS_TX0_D1P: J6.37
MIPI_DSI_TX0_D2N/LVDS_TX0_D2N: J6.36
MIPI_DSI_TX0_D2P/LVDS_TX0_D2P: J6.35
MIPI_DSI_TX0_D3N/LVDS_TX0_D3N: J6.34
MIPI_DSI_TX0_D3P/LVDS_TX0_D3P: J6.33
MIPI_DSI_TX1_CLKN: J6.18
MIPI_DSI_TX1_CLKP: J6.17
MIPI_DSI_TX1_D0N: J6.28
MIPI_DSI_TX1_D0P: J6.27
MIPI_DSI_TX1_D1N: J6.26
MIPI_DSI_TX1_D1P: J6.25
MIPI_DSI_TX1_D2N: J6.24
MIPI_DSI_TX1_D2P: J6.23
MIPI_DSI_TX1_D3N: J6.22
MIPI_DSI_TX1_D3P: J6.21
unnamed: J6.1, J6.2, R11.1, R25.1
unnamed: J6.9, R4.2
unnamed: J6.10, R7.1
unnamed: J6.11, R5.2
unnamed: J6.12, R9.1
unnamed: J6.13, Q1.3 (C), R3.1
unnamed: Q1.1 (B), R2.2
SOC_PCM_IN: R2.1
TP_INT_L_GPIO0_B5: R9.2
TP_RST_L_GPIO0_B6: R5.1
VCC_3V3: J6.5, J6.6, R3.2
VIN_12V: R11.2
