ihsanakyrk/Eski-Versionlar-Ve-Siparisler/Movita_3568_AXV_Router_V3.0/MXVR_3.0/PCIE.kicad_sch

## KiCad design Movita_3568_AXV_Router_V3.0/MXVR_3.0/PCIE.kicad_sch (2025-09-01)

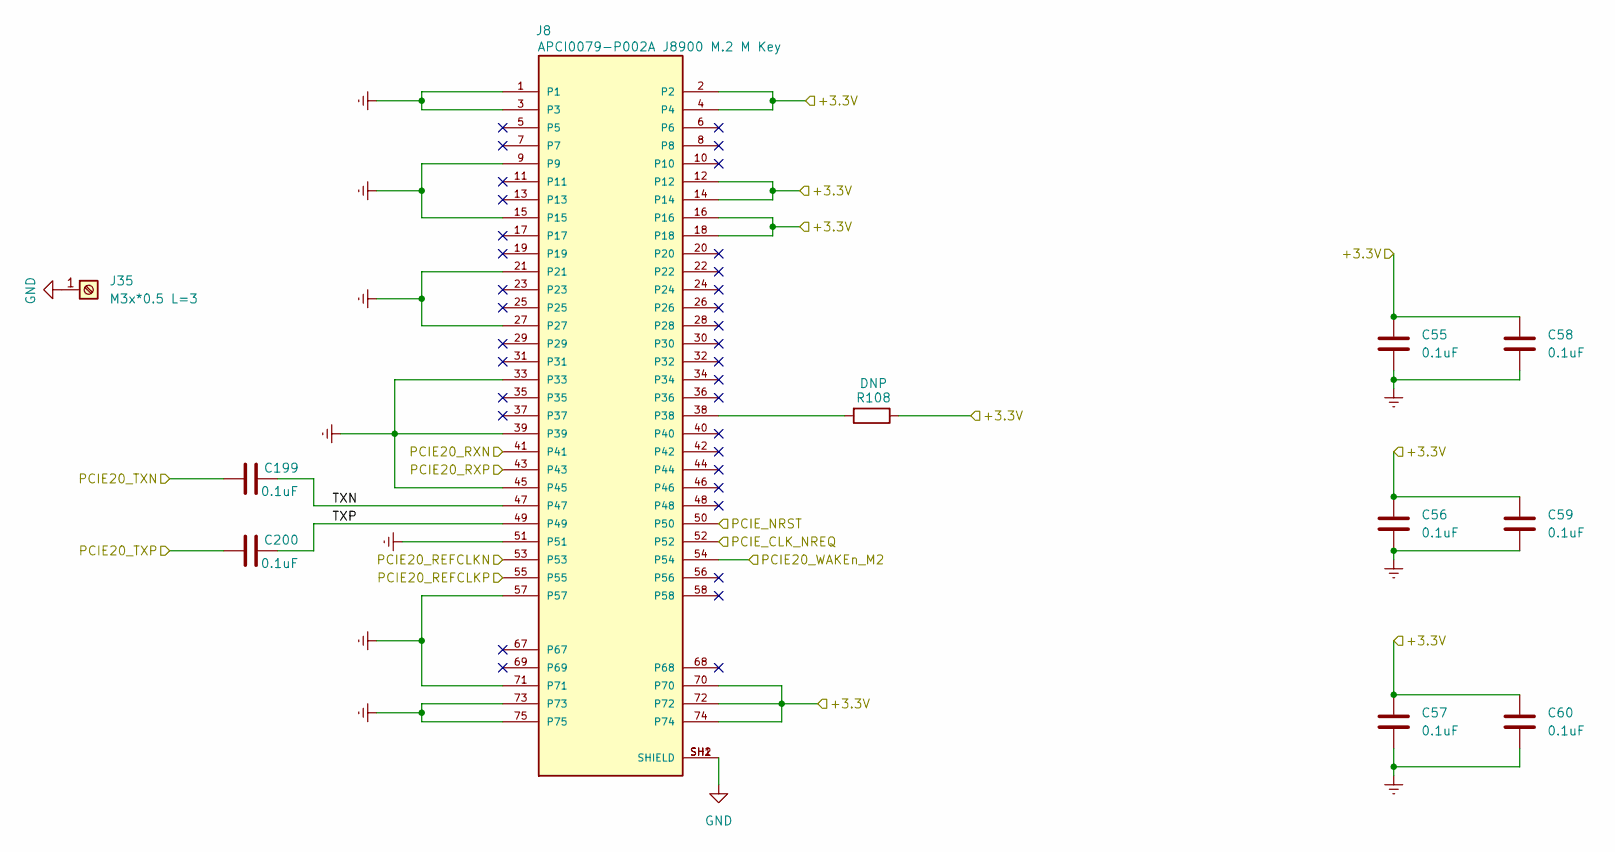
[picture p234: schematic PCIE.kicad_sch]

Parts:
C55, C56, C57, C58, C59, C60, C199, C200: 0.1uF; C_0603_1608Metric
J8: APCI0079-P002A J8900 M.2 M Key; MPN APCI0079-P002A J8900 M.2 M Key
J35: M3x*0.5 L=3; Screw Terminal Shinbo; MPN SMTSO-M3-3ET
R108: DNP; R_0603_1608Metric

Connections:
+3.3V: C55.1, C56.1, C57.1, C58.1, C59.1, C60.1, J8.2, J8.4, J8.12, J8.14, J8.16, J8.18, J8.70, J8.72, J8.74, R108.1
Earth: C55.2, C56.2, C57.2, C58.2, C59.2, C60.2, J8.1, J8.3, J8.9, J8.15, J8.21, J8.27, J8.33, J8.39, J8.45, J8.51, J8.57, J8.71, J8.73, J8.75
GND: J8.SH1 (SHIELD), J8.SH2 (SHIELD), J35.1
unnamed: J8.38, R108.2
PCIE20_REFCLKN: J8.53
PCIE20_REFCLKP: J8.55
PCIE20_RXN: J8.41
PCIE20_RXP: J8.43
PCIE20_TXN: C199.1
PCIE20_TXP: C200.1
PCIE20_WAKEn_M2: J8.54
PCIE_CLK_NREQ: J8.52
PCIE_NRST: J8.50
TXN: C199.2, J8.47
TXP: C200.2, J8.49
