ihsanakyrk/Eski-Versionlar-Ve-Siparisler/Movita_3568_AXV_Router_V3.0/MXVR_3.0/Power_Unit.kicad_sch

## KiCad design Movita_3568_AXV_Router_V3.0/MXVR_3.0/Power_Unit.kicad_sch (2025-09-01)

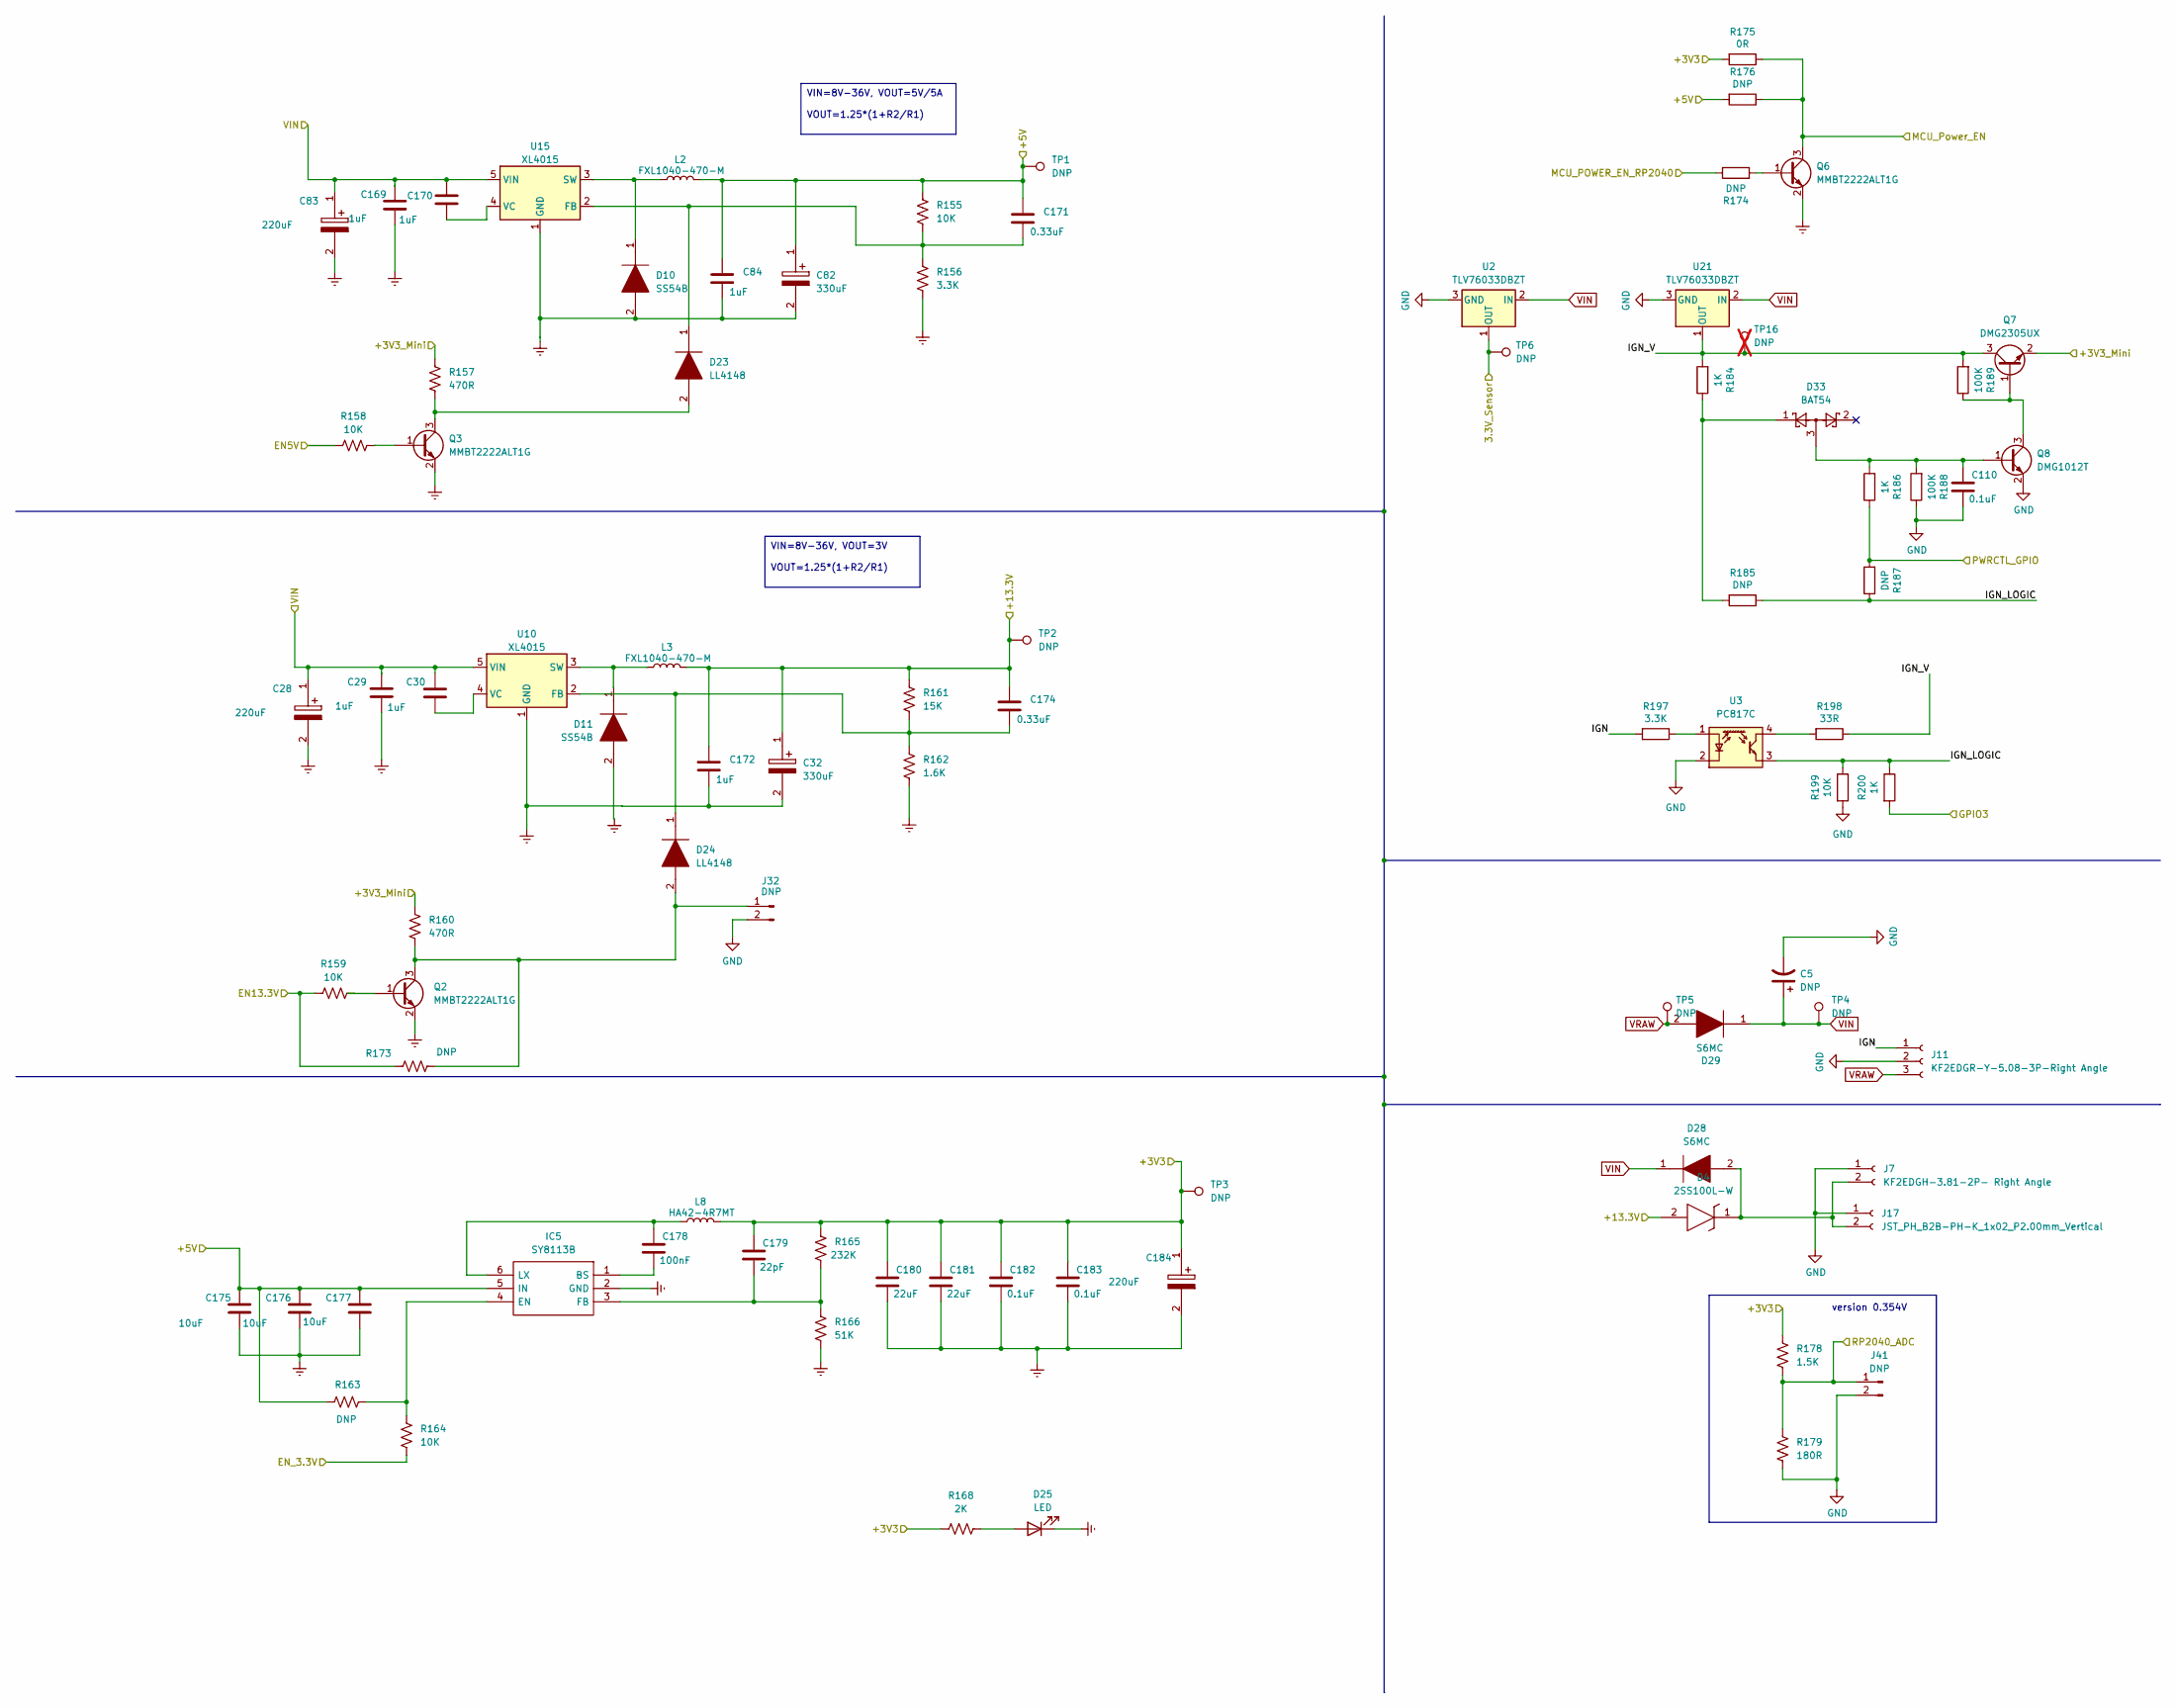
[picture p235: schematic Power_Unit.kicad_sch]

Parts:
C5: DNP; FYD0H473ZF
C28, C83: 220uF; C_Elec_10x10.2; Manufacturer_Part_Number RVT220UF50V67RV0021
C29, C30, C84, C169, C170, C172: 1uF; C_0603_1608Metric; MPN CL10A105KB8NNNC
C32, C82: 330uF; C_Elec_8x10.2; Manufacturer_Part_Number RVT330UF25V167RV0055
C110, C182, C183: 0.1uF; C_0603_1608Metric
C171, C174: 0.33uF; C_0603_1608Metric
C175, C176, C177: 10uF; C_0603_1608Metric; MPN CL10A106MO8NQNC
C178: 100nF; C_0603_1608Metric; MPN 0603B104K500NT
C179: 22pF; C_0603_1608Metric; MPN CL10C220JB8NNNC
C180, C181: 22uF; C_0603_1608Metric; MPN CL10A226MQ8NRNC
C184: 220uF; CP_Elec_6.3x7.7; Manufacturer_Part_Number RVT220UF16V67RV0015
D4: 2SS100L-W; 2SS100LW; Manufacturer_Part_Number 2SS100L-W; Mouser Part Number 583-2SS100L-W
D10, D11: SS54B; Manufacturer_Part_Number SS54B
D23, D24: LL4148; MPN LL4148
D25: LED; LED_0603_1608Metric; MPN 0603 翠绿色 LED
D28, D29: S6MC; Manufacturer_Part_Number SS54B; Mouser Part Number S6MC
D33: BAT54; SOT-23; MPN BAT54
IC5: SY8113B; Manufacturer_Part_Number SY8113B
J7: KF2EDGH-3.81-2P- Right Angle; KF2EDGH-3.81-2P; MPN KF2EDGV-3.81 2p 直针
J11: KF2EDGR-Y-5.08-3P-Right Angle; MPN KF2EDG -3P 5.08 封口 弯
J17: JST_PH_B2B-PH-K_1x02_P2.00mm_Vertical; MPN PH2.0 2P 直针
J32: DNP; PinHeader_1x02_P2.54mm_Vertical
J41: DNP; PinSocket_1x02_P2.54mm_Vertical_SMD_Pin1Left
L2, L3: FXL1040-470-M; L_Bourns_SRR1208_12.7x12.7mm; MPN HX CYA1050-47UH
L8: HA42-4R7MT; Inductor_0402_4.7uH; MPN HA42-4R7MT
Q2, Q3, Q6: MMBT2222ALT1G; MPN MMBT2222A
Q7: DMG2305UX; SOT-23; MPN DMG2305UX
Q8: DMG1012T; SOT-523; MPN DMG1012T
R155, R158, R159, R164, R199: 10K; R_0603_1608Metric; MPN 0603WAF1002T5E
R156, R197: 3.3K; R_0603_1608Metric; MPN 0603WAF3301T5E
R157, R160: 470R; R_0603_1608Metric; MPN 0603WAF4700T5E
R161: 15K; R_0603_1608Metric; MPN 0603WAF1502T5E
R162: 1.6K; R_0603_1608Metric; MPN 0603WAF1601T5E
R163, R173, R174, R176, R185, R187: DNP; R_0603_1608Metric
R165: 232K; R_0603_1608Metric; MPN FRC0603F2323TS
R166: 51K; R_0603_1608Metric; MPN 0603WAF5102T5E
R168: 2K; R_0603_1608Metric; MPN 0603WAF2001T5E
R175: 0R; R_0603_1608Metric; MPN 0603WAF0000T5E
R178: 1.5K; R_0603_1608Metric; MPN 0603WAF1501T5E
R179: 180R; R_0603_1608Metric; MPN 0603WAF1800T5E
R184, R186, R200: 1K; R_0603_1608Metric; MPN 0603WAF1001T5E
R188, R189: 100K; R_0603_1608Metric; MPN 0603WAF1003T5E
R198: 33R; R_0603_1608Metric; MPN 0603WAF330JT5E
TP1, TP2, TP3, TP4, TP5, TP6: DNP; TestPoint_Pad_1.0x1.0mm
TP16: DNP; TestPoint_Pad_1.0x1.0mm; not fitted
U2, U21: TLV76033DBZT; SOT-23; MPN TLV76033DBZT
U3: PC817C; PC817; MPN PC817C_4PIN_SMD
U10, U15: XL4015; TO-263-5_TabPin3; MPN XL4015

Connections:
3.3V_Sensor: TP6.1, U2.1 (OUT)
+3V3: C179.2, C180.2, C181.2, C182.2, C183.2, C184.1, L8.2, R165.1, R168.1, R175.2, R178.1, TP3.1
+3V3_Mini: Q7.2 (S), R157.1, R160.1
+5V: C82.1, C84.2, C171.2, C175.2, C176.2, C177.2, IC5.5 (IN), L2.2, R155.1, R163.1, R176.2, TP1.1
+13.3V: C32.1, C172.2, C174.2, D4.2, L3.2, R161.1, TP2.1
EN5V: R158.1
EN13.3V: R159.1, R173.1
EN_3.3V: R164.2
Earth: C28.2, C29.1, C32.2, C82.2, C83.2, C84.1, C169.1, C172.1, C175.1, C176.1, C177.1, C180.1, C181.1, C182.1, C183.1, C184.2, D10.2, D11.2, D25.1 (K), IC5.2 (GND), Q2.2 (E), Q3.2 (E), Q6.2 (E), R156.2, R162.2, R166.2, U10.1 (GND), U15.1 (GND)
GND: C5.2, C110.1, J7.1, J11.2, J17.1, J32.2, J41.2, Q8.2 (S), R179.2, R188.1, R199.2, U2.3 (GND), U3.2 (K), U21.3 (GND)
GPIO3: R200.2
IGN: J11.1, R197.2
IGN_LOGIC: R185.1, R187.1, R199.1, R200.1, U3.3 (E)
IGN_V: Q7.3 (D), R184.2, R189.2, R198.1, TP16.1, U21.1 (OUT)
MCU_POWER_EN_RP2040: R174.1
MCU_Power_EN: Q6.3 (C), R175.1, R176.1
unnamed: C30.1, U10.4 (VC)
unnamed: C110.2, D33.3, Q8.1 (G), R186.2, R188.2
unnamed: C170.1, U15.4 (VC)
unnamed: C171.1, D23.1, R155.2, R156.1, U15.2 (FB)
unnamed: C174.1, D24.1, R161.2, R162.1, U10.2 (FB)
unnamed: C178.1, IC5.1 (BS)
unnamed: C178.2, IC5.6 (LX), L8.1
unnamed: C179.1, IC5.3 (FB), R165.2, R166.1
unnamed: D10.1, L2.1, U15.3 (SW)
unnamed: D11.1, L3.1, U10.3 (SW)
unnamed: D23.2, Q3.3 (C), R157.2
unnamed: D24.2, J32.1, Q2.3 (C), R160.2, R173.2
unnamed: D25.2 (A), R168.2
unnamed: D4.1, D28.2, J7.2, J17.2
unnamed: D33.1, R184.1, R185.2
unnamed: IC5.4 (EN), R163.2, R164.1
unnamed: Q2.1 (B), R159.2
unnamed: Q3.1 (B), R158.2
unnamed: Q6.1 (B), R174.2
unnamed: Q7.1 (G), Q8.3 (D), R189.1
unnamed: R197.1, U3.1 (A)
unnamed: R198.2, U3.4 (C)
PWRCTL_GPIO: R186.1, R187.2
RP2040_ADC: J41.1, R178.2, R179.1
VIN: C5.1, C28.1, C29.2, C30.2, C83.1, C169.2, C170.2, D28.1, D29.1, TP4.1, U2.2 (IN), U10.5 (VIN), U15.5 (VIN), U21.2 (IN)
VRAW: D29.2, J11.3, TP5.1

Notes on the sheet:
VIN=8V-36V, VOUT=3V VOUT=1.25*(1+R2/R1)
VIN=8V-36V, VOUT=5V/5A VOUT=1.25*(1+R2/R1)
version 0.354V
