ihsanakyrk/Eski-Versionlar-Ve-Siparisler/Movita_3568_AXV_Router_V3.0/MXVR_3.0/RTL8309.kicad_sch

## KiCad design Movita_3568_AXV_Router_V3.0/MXVR_3.0/RTL8309.kicad_sch (2025-09-01)

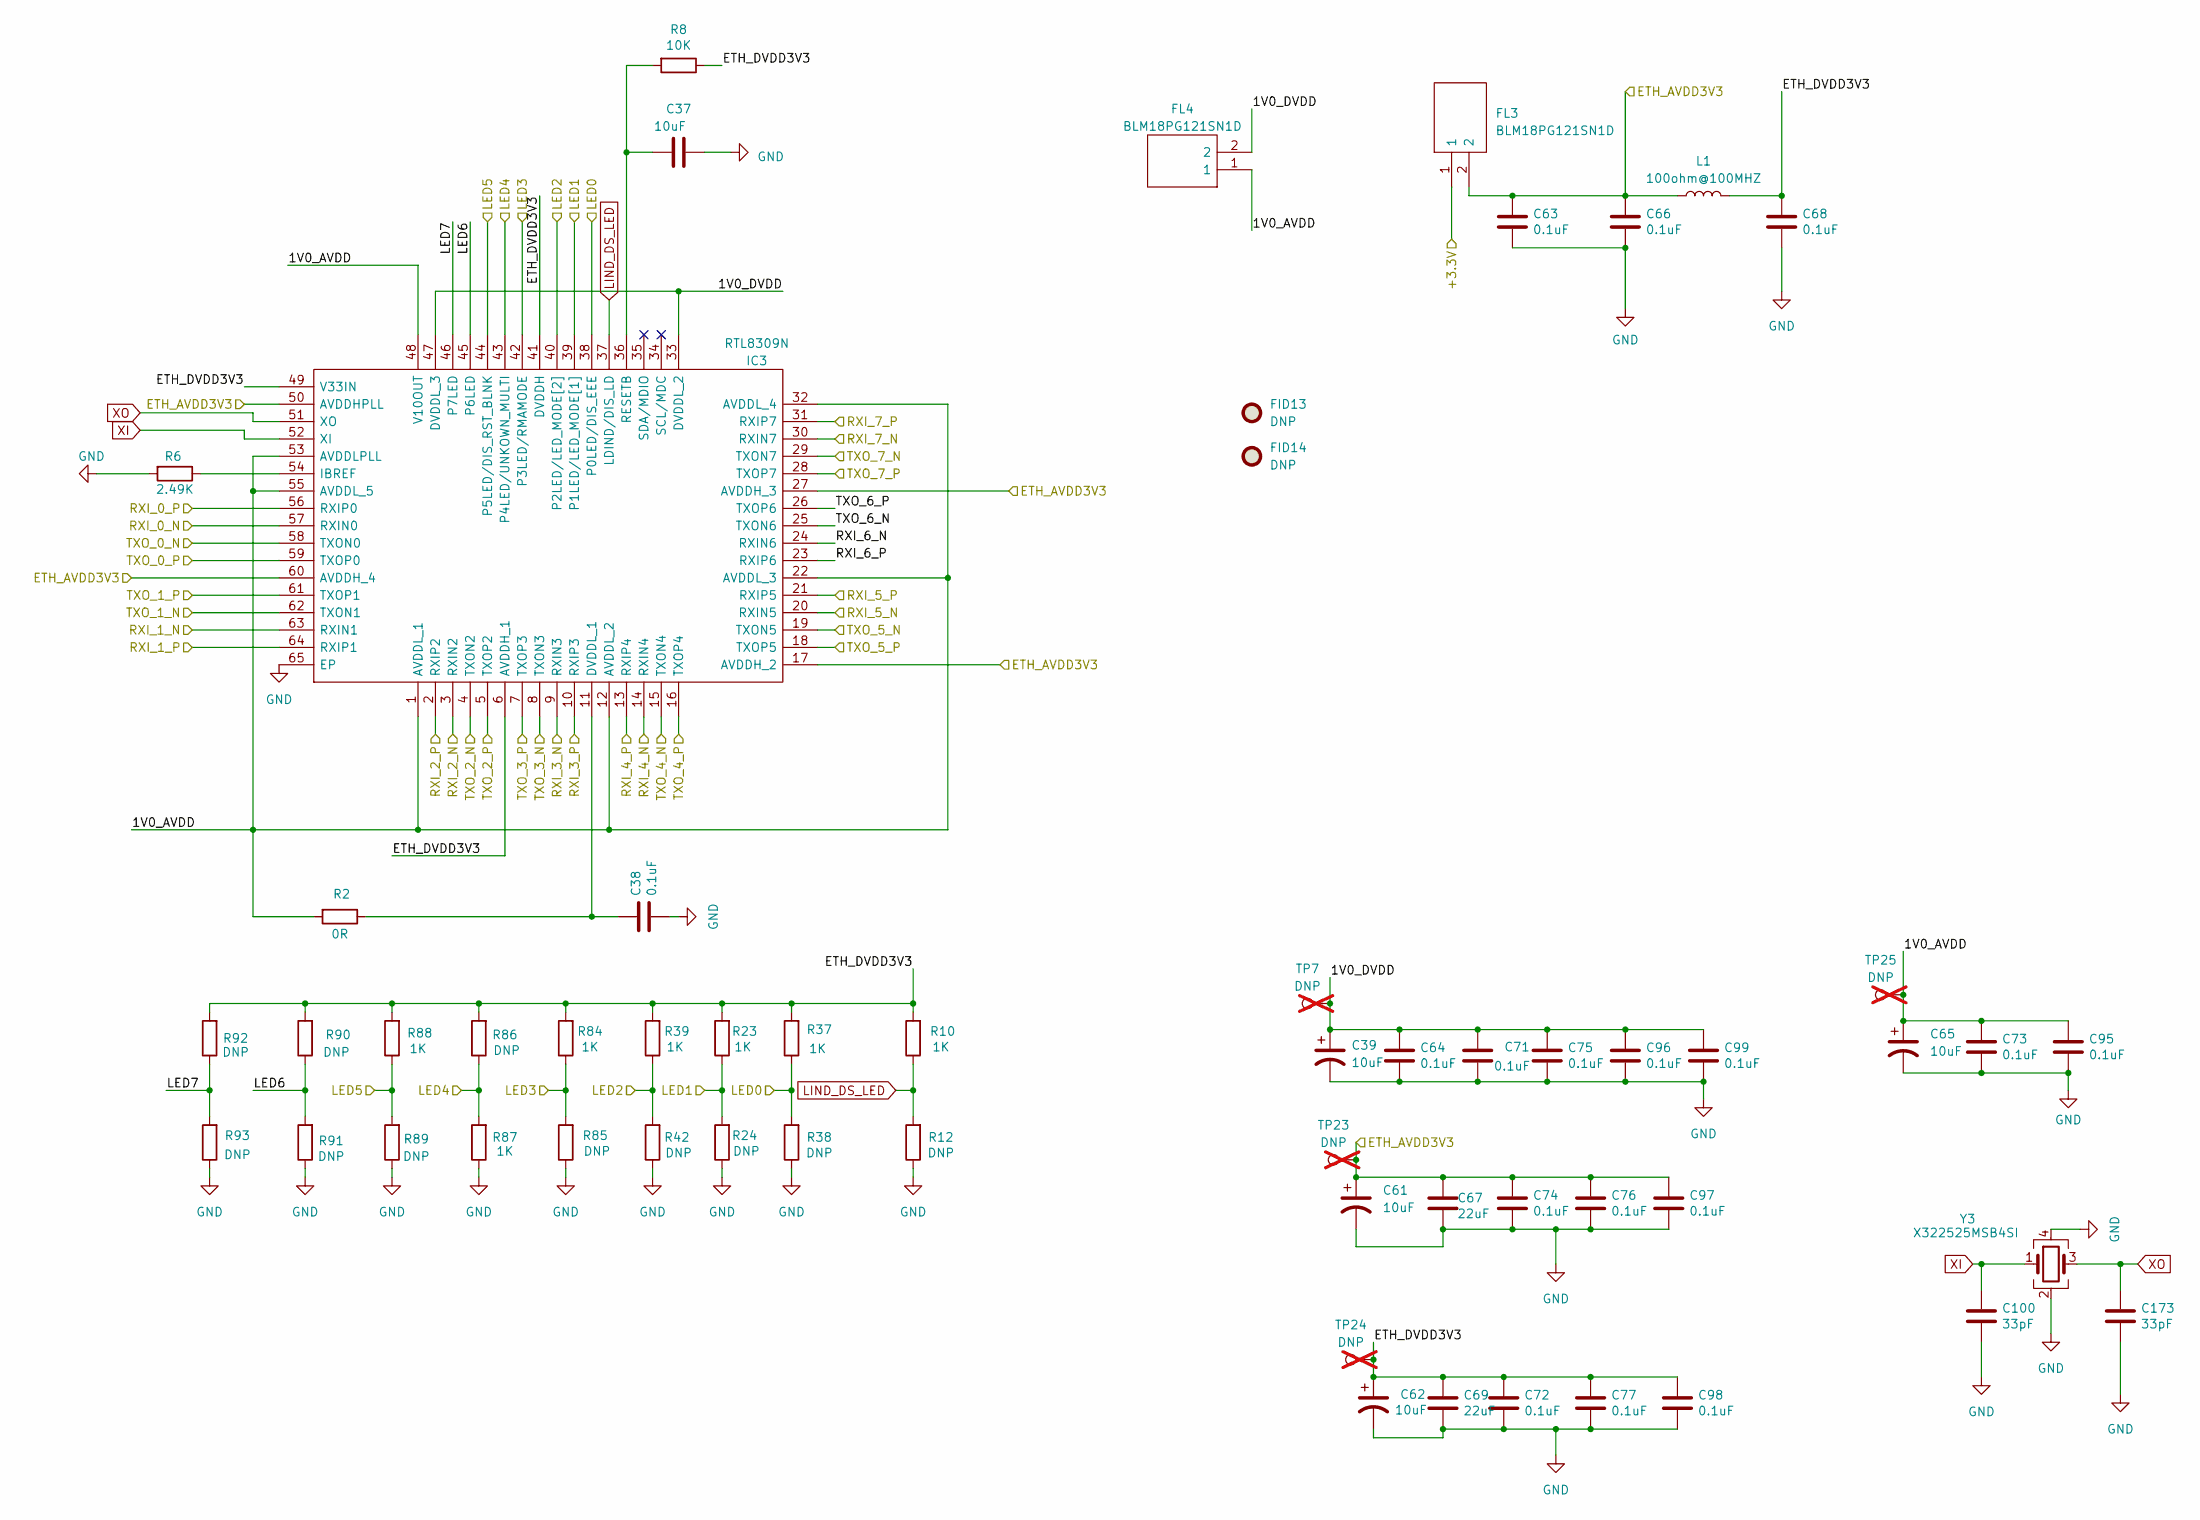
[picture p237: schematic RTL8309.kicad_sch]

Parts:
C37: 10uF; C_0603_1608Metric; MPN CL10A106MO8NQNC
C38, C63, C64, C66, C68, C71, C72, C73, C74, C75, C76, C77, C95, C96, C97, C98, C99: 0.1uF; C_0402_1005Metric
C39, C61, C62, C65: 10uF; C_Elec_3x5.4; MPN UWX1C100MCL2GB
C67, C69: 22uF; C_0603_1608Metric; MPN CL10A226MQ8NRNC
C100, C173: 33pF; C_0603_1608Metric; MPN CL10C330JB8NNNC
FID13, FID14: DNP; Fiducial_0.5mm_Mask1mm
FL3, FL4: BLM18PG121SN1D; Manufacturer_Part_Number BLM18PG121SN1D; Mouser Part Number 81-BLM18PG121SN1D
IC3: RTL8309N; Manufacturer_Part_Number RTL8309N
L1: 100ohm@100MHZ; L_0603_1608Metric; MPN CBW160808U101T
R2: 0R; R_0603_1608Metric; MPN 0603WAF0000T5E
R6: 2.49K; R_0603_1608Metric; MPN 0603WAF2491T5E
R8: 10K; R_0603_1608Metric; MPN 0603WAF1002T5E
R10, R23, R37, R39, R84, R87, R88: 1K; R_0603_1608Metric; MPN 0603WAF1001T5E
R12, R24, R38, R42, R85, R86, R89, R90, R91, R92, R93: DNP; R_0603_1608Metric
TP7, TP23, TP24, TP25: DNP; TestPoint_Pad_1.0x1.0mm; not fitted
Y3: X322525MSB4SI; Crystal_SMD_3225-4Pin_3.2x2.5mm; MPN X322525MSB4SI

Connections:
1V0_AVDD: C65.1, C73.1, C95.1, FL4.1, IC3.1 (AVDDL_1), IC3.12 (AVDDL_2), IC3.22 (AVDDL_3), IC3.32 (AVDDL_4), IC3.48 (V10OUT), IC3.53 (AVDDLPLL), IC3.55 (AVDDL_5), R2.2, TP25.1
1V0_DVDD: C39.1, C64.1, C71.1, C75.1, C96.1, C99.1, FL4.2, IC3.33 (DVDDL_2), IC3.47 (DVDDL_3), TP7.1
+3.3V: FL3.1
ETH_AVDD3V3: C61.1, C63.1, C66.1, C67.1, C74.1, C76.1, C97.1, FL3.2, IC3.17 (AVDDH_2), IC3.27 (AVDDH_3), IC3.50 (AVDDHPLL), IC3.60 (AVDDH_4), L1.1, TP23.1
ETH_DVDD3V3: C62.1, C68.1, C69.1, C72.1, C77.1, C98.1, IC3.6 (AVDDH_1), IC3.41 (DVDDH), IC3.49 (V33IN), L1.2, R8.1, R10.2, R23.2, R37.2, R39.2, R84.2, R86.2, R88.2, R90.2, R92.2, TP24.1
GND: C37.2, C38.2, C39.2, C61.2, C62.2, C63.2, C64.2, C65.2, C66.2, C67.2, C68.2, C69.2, C71.2, C72.2, C73.2, C74.2, C75.2, C76.2, C77.2, C95.2, C96.2, C97.2, C98.2, C99.2, C100.2, C173.2, IC3.65 (EP), R6.2, R12.1, R24.1, R38.1, R42.1, R85.1, R87.1, R89.1, R91.1, R93.1, Y3.2, Y3.4
LED0: IC3.38 (P0LED/DIS_EEE), R37.1, R38.2
LED1: IC3.39 (P1LED/LED_MODE[1]), R23.1, R24.2
LED2: IC3.40 (P2LED/LED_MODE[2]), R39.1, R42.2
LED3: IC3.42 (P3LED/RMAMODE), R84.1, R85.2
LED4: IC3.43 (P4LED/UNKOWN_MULTI), R86.1, R87.2
LED5: IC3.44 (P5LED/DIS_RST_BLNK), R88.1, R89.2
LED6: IC3.45 (P6LED), R90.1, R91.2
LED7: IC3.46 (P7LED), R92.1, R93.2
LIND_DS_LED: IC3.37 (LDIND/DIS_LD), R10.1, R12.2
unnamed: C37.1, IC3.36 (RESETB), R8.2
unnamed: C38.1, IC3.11 (DVDDL_1), R2.1
unnamed: IC3.54 (IBREF), R6.1
RXI_0_N: IC3.57 (RXIN0)
RXI_0_P: IC3.56 (RXIP0)
RXI_1_N: IC3.63 (RXIN1)
RXI_1_P: IC3.64 (RXIP1)
RXI_2_N: IC3.3 (RXIN2)
RXI_2_P: IC3.2 (RXIP2)
RXI_3_N: IC3.9 (RXIN3)
RXI_3_P: IC3.10 (RXIP3)
RXI_4_N: IC3.14 (RXIN4)
RXI_4_P: IC3.13 (RXIP4)
RXI_5_N: IC3.20 (RXIN5)
RXI_5_P: IC3.21 (RXIP5)
RXI_6_N: IC3.24 (RXIN6)
RXI_6_P: IC3.23 (RXIP6)
RXI_7_N: IC3.30 (RXIN7)
RXI_7_P: IC3.31 (RXIP7)
TXO_0_N: IC3.58 (TXON0)
TXO_0_P: IC3.59 (TXOP0)
TXO_1_N: IC3.62 (TXON1)
TXO_1_P: IC3.61 (TXOP1)
TXO_2_N: IC3.4 (TXON2)
TXO_2_P: IC3.5 (TXOP2)
TXO_3_N: IC3.8 (TXON3)
TXO_3_P: IC3.7 (TXOP3)
TXO_4_N: IC3.15 (TXON4)
TXO_4_P: IC3.16 (TXOP4)
TXO_5_N: IC3.19 (TXON5)
TXO_5_P: IC3.18 (TXOP5)
TXO_6_N: IC3.25 (TXON6)
TXO_6_P: IC3.26 (TXOP6)
TXO_7_N: IC3.29 (TXON7)
TXO_7_P: IC3.28 (TXOP7)
XI: C100.1, IC3.52 (XI), Y3.1
XO: C173.1, IC3.51 (XO), Y3.3
