ihsanakyrk/Eski-Versionlar-Ve-Siparisler/Movita_3568_AXV_Router_V3.0/MXVR_3.0/SATA_Con.kicad_sch

## KiCad design Movita_3568_AXV_Router_V3.0/MXVR_3.0/SATA_Con.kicad_sch (2025-09-01)

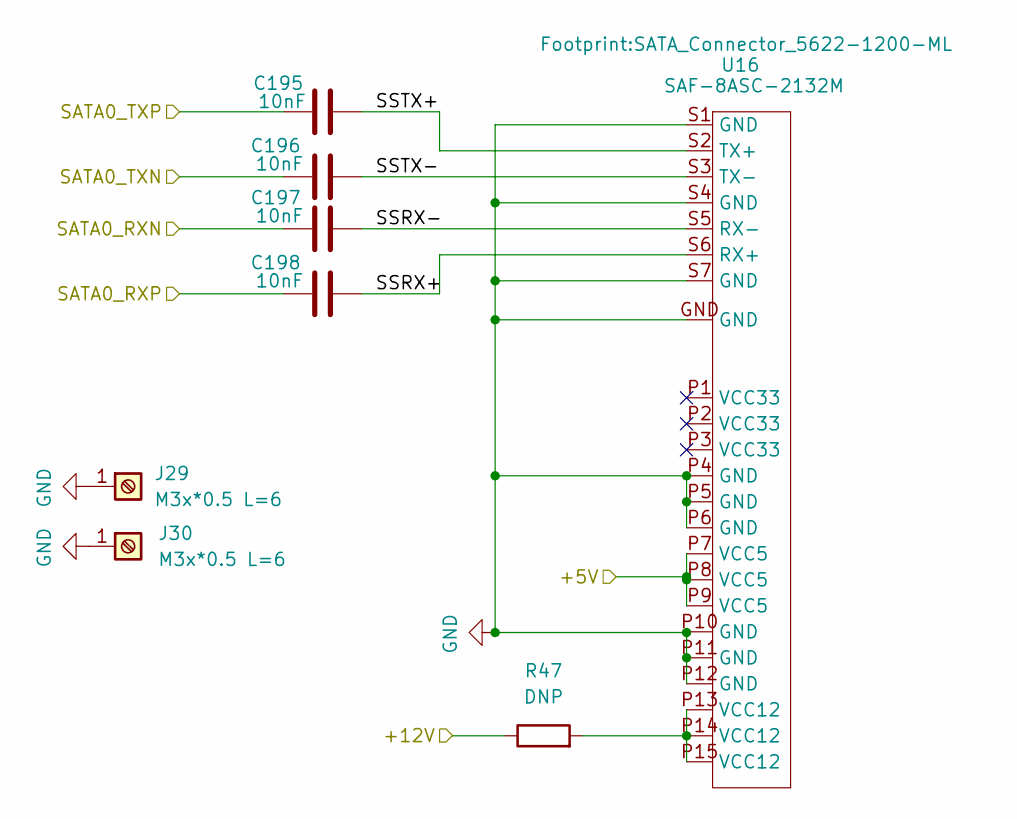
[picture p238: schematic SATA_Con.kicad_sch]

Parts:
C195, C196, C197, C198: 10nF; C_0603_1608Metric; MPN CL10C220JB8NNNC
J29, J30: M3x*0.5 L=6; Screw Terminal Shinbo; MPN SMTSO-M3-6ET
R47: DNP; R_0603_1608Metric
U16: SAF-8ASC-2132M; SATA_Connector_5622-1200-ML; MPN SAF-8ASC-2132M

Connections:
+5V: U16.P7 (VCC5), U16.P8 (VCC5), U16.P9 (VCC5)
+12V: R47.1
GND: J29.1, J30.1, U16.GND, U16.P4 (GND), U16.P5 (GND), U16.P6 (GND), U16.P10 (GND), U16.P11 (GND), U16.P12 (GND), U16.S1 (GND), U16.S4 (GND), U16.S7 (GND)
unnamed: R47.2, U16.P13 (VCC12), U16.P14 (VCC12), U16.P15 (VCC12)
SATA0_RXN: C197.1
SATA0_RXP: C198.1
SATA0_TXN: C196.1
SATA0_TXP: C195.1
SSRX+: C198.2, U16.S6 (RX+)
SSRX-: C197.2, U16.S5 (RX-)
SSTX+: C195.2, U16.S2 (TX+)
SSTX-: C196.2, U16.S3 (TX-)
