ihsanakyrk/Eski-Versionlar-Ve-Siparisler/Movita_3568_AXV_Router_V3.0/MXVR_3.0/SD CARD.kicad_sch

## KiCad design Movita_3568_AXV_Router_V3.0/MXVR_3.0/SD CARD.kicad_sch (2025-09-01)

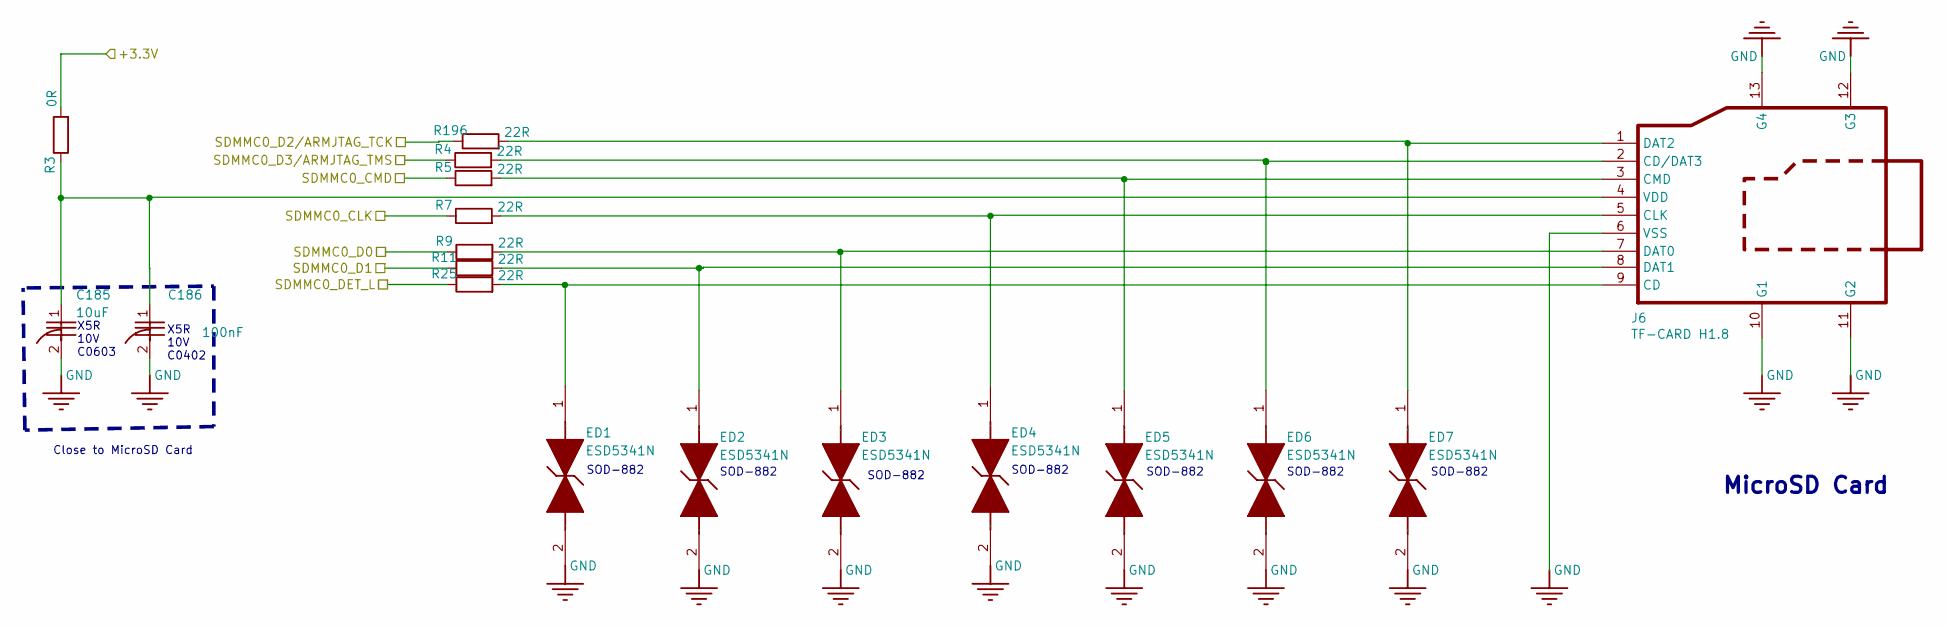
[picture p239: schematic SD CARD.kicad_sch]

Parts:
C185: 10uF; C_0603_1608Metric; MPN CL10A106MO8NQNC
C186: 100nF; C_0402_1005Metric; MPN CC0402KRX7R7BB104
ED1, ED2, ED3, ED4, ED5, ED6, ED7: ESD5341N; MPN ESD5341N
J6: TF-CARD H1.8; MANUFACTURER_PART_NUMBER TFP09-2-12B
R3: 0R; R_0603_1608Metric; MPN 0603WAF0000T5E
R4, R5, R7, R9, R11, R25, R196: 22R; R_0603_1608Metric; MPN 0603WAF220JT5E

Connections:
+3.3V: R3.2
GND: C185.2, C186.2, ED1.2, ED2.2, ED3.2, ED4.2, ED5.2, ED6.2, ED7.2, J6.6 (VSS), J6.10 (G1), J6.11 (G2), J6.12 (G3), J6.13 (G4)
unnamed: C185.1, C186.1, J6.4 (VDD), R3.1
unnamed: ED1.1, J6.9 (CD), R25.2
unnamed: ED2.1, J6.8 (DAT1), R11.2
unnamed: ED3.1, J6.7 (DAT0), R9.2
unnamed: ED4.1, J6.5 (CLK), R7.2
unnamed: ED5.1, J6.3 (CMD), R5.2
unnamed: ED6.1, J6.2 (CD/DAT3), R4.2
unnamed: ED7.1, J6.1 (DAT2), R196.2
SDMMC0_CLK: R7.1
SDMMC0_CMD: R5.1
SDMMC0_D0: R9.1
SDMMC0_D1: R11.1
SDMMC0_D2/ARMJTAG_TCK: R196.1
SDMMC0_D3/ARMJTAG_TMS: R4.1
SDMMC0_DET_L: R25.1

Notes on the sheet:
SOD-882
MicroSD Card
Close to MicroSD Card
X5R 10V C0603
X5R 10V C0402
