ihsanakyrk/Eski-Versionlar-Ve-Siparisler/Movita_3568_AXV_Router_V3.0/MXVR_3.0/USB2.0 OTG.kicad_sch

## KiCad design Movita_3568_AXV_Router_V3.0/MXVR_3.0/USB2.0 OTG.kicad_sch (2025-09-01)

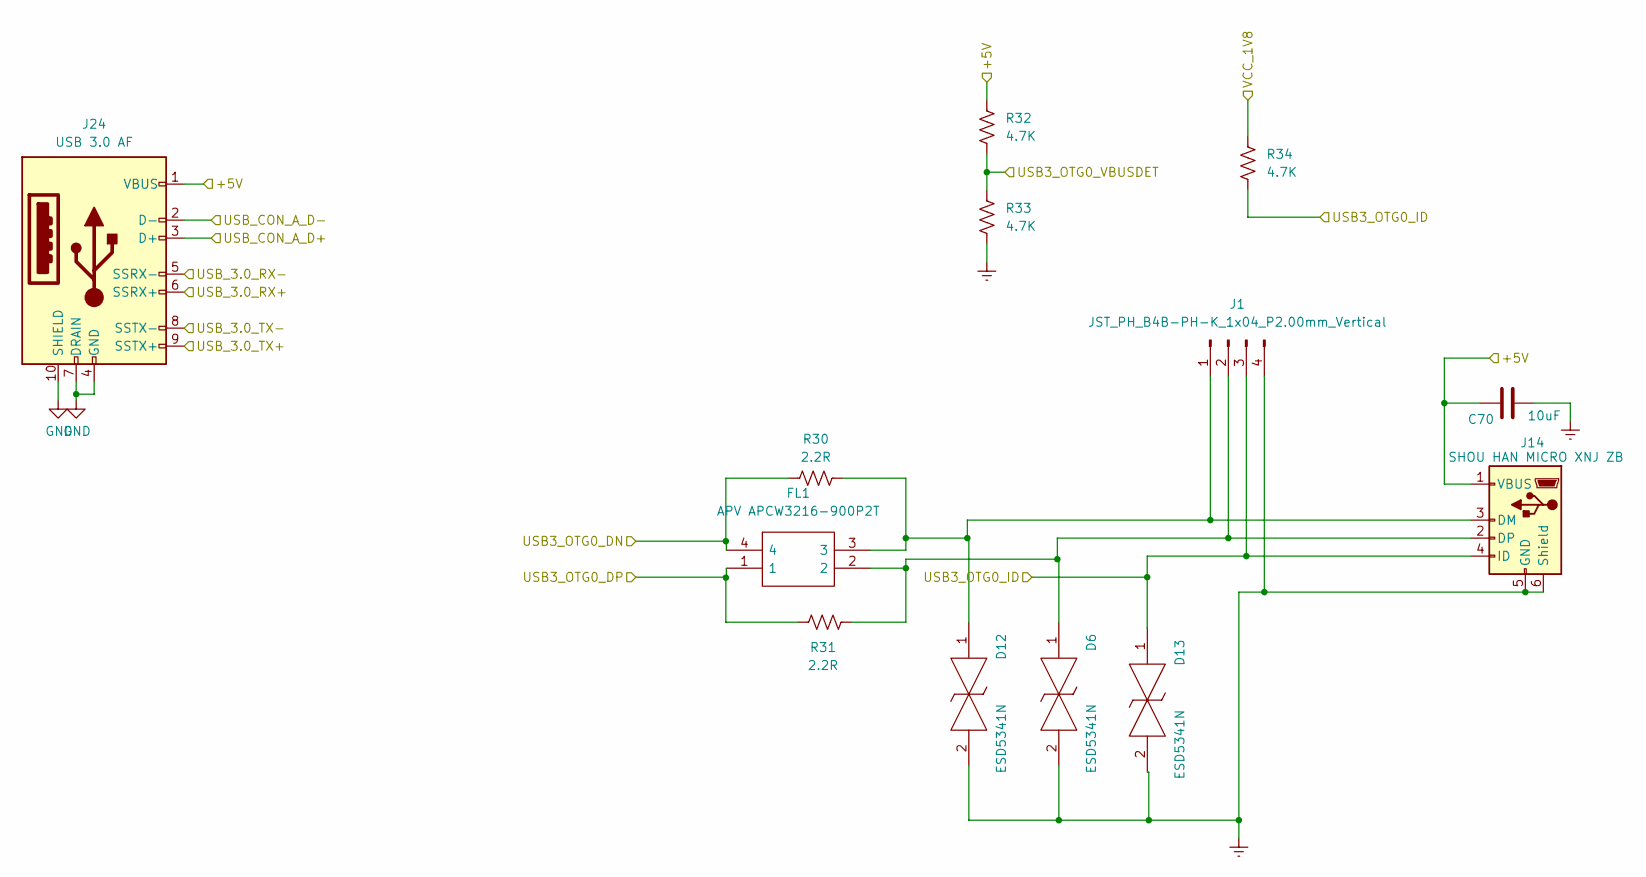
[picture p240: schematic USB2.0 OTG.kicad_sch]

Parts:
C70: 10uF; C_0603_1608Metric; MPN CL10A106MO8NQNC
D6, D12, D13: ESD5341N; Manufacturer_Part_Number SP0402B-ULC-01ETG; Mouser Part Number 576-SP0402BULC-01ETG
FL1: APV APCW3216-900P2T; DLW31SH222SQ2L; Manufacturer_Part_Number DLW31SN900SQ2L; Mouser Part Number 81-DLW31SN900SQ2L
J1: JST_PH_B4B-PH-K_1x04_P2.00mm_Vertical; MPN JST_PH_B4B-PH-K_1x04_P2.00mm_Vertical
J14: SHOU HAN MICRO XNJ ZB; Micro-B SMD; MPN SHOU HAN MICRO XNJ ZB
J24: USB 3.0 AF; CP-USB-3015; MPN USB3.0 侧插
R30, R31: 2.2R; R_0402_1005Metric; MPN 0402WGF220KTCE
R32, R33, R34: 4.7K; R_0603_1608Metric; MPN 0603WAF270JT5E

Connections:
+5V: C70.1, J14.1 (VBUS), J24.1 (VBUS), R32.1
Earth: C70.2, D6.2, D12.2, D13.2, J1.4, J14.5 (GND), J14.6 (Shield), R33.2
GND: J24.4 (GND), J24.7 (DRAIN), J24.10 (SHIELD)
unnamed: D6.1, FL1.2, J1.2, J14.2 (DP), R31.2
unnamed: D12.1, FL1.3, J1.1, J14.3 (DM), R30.2
USB3_OTG0_DN: FL1.4, R30.1
USB3_OTG0_DP: FL1.1, R31.1
USB3_OTG0_ID: D13.1, J1.3, J14.4 (ID), R34.2
USB3_OTG0_VBUSDET: R32.2, R33.1
USB_3.0_RX+: J24.6 (SSRX+)
USB_3.0_RX-: J24.5 (SSRX-)
USB_3.0_TX+: J24.9 (SSTX+)
USB_3.0_TX-: J24.8 (SSTX-)
USB_CON_A_D+: J24.3 (D+)
USB_CON_A_D-: J24.2 (D-)
VCC_1V8: R34.1
