ihsanakyrk/Eski-Versionlar-Ve-Siparisler/(commit log)

2025-09-01 ilk yükleme
    [3566.kicad_sch, 4_port_rj45.kicad_sch, 91228-3002.kicad_sch, A7602E-H (GSM).xlsx, AV connector.kicad_sch, BOM_1.xlsx, BOM_2.xlsx, BOM_4.xlsx]
2025-09-02 GSM güncellendi
    [91228-3002.kicad_sch, AV connector.kicad_sch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]
